ahmadreza221/aurora-cchp/docs/08_aurora1000_1MW_concept.md

# AURORA-1000: طرح مفهومی توربین گازی ۱ مگاواتی با گیربکس، متصل به شبکه

تاریخ: ۲۰۲۶-۱۰-۲۸ · محاسبه: `sim/mw1_concept_study.py` (نتایج: `sim/mw1_results.json`) · طرح: `sim/mw1_layout_sketch.py`
سایت: برازجان، ۵۰ m، گاز شهری (ایستگاه ۴ bar، حداقل ۳٫۵ bar، ظرفیت ۱۰۰۰ m³/h)، کار دائم ۲۴/۷

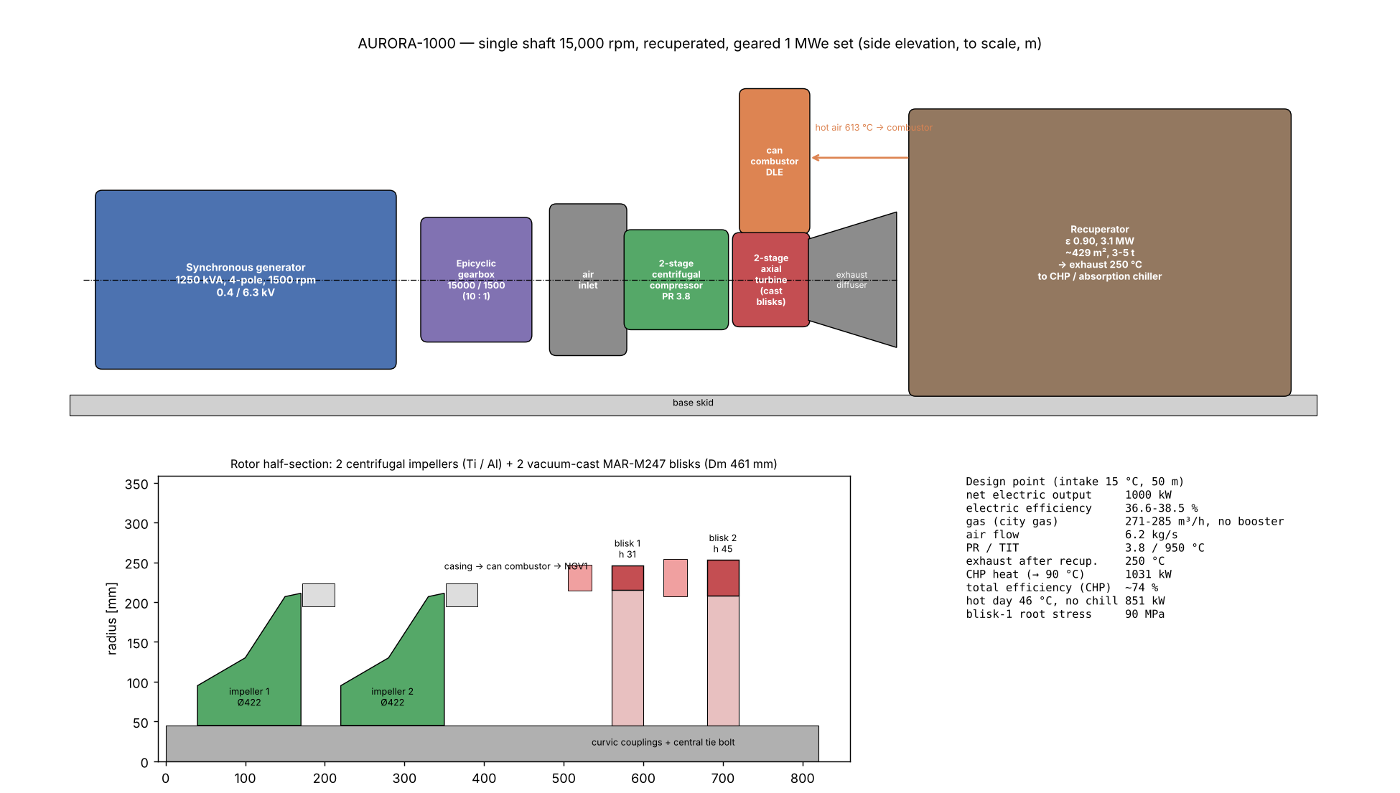
[picture p1: docs/img/mw1_layout.png]
چیدمان


## ۱. خلاصه و پیشنهاد

| | مقدار |
|---|---|
| معماری | **تک‌محور، با recuperator**، دور ثابت **۱۵٬۰۰۰ rpm**، گیربکس سیاره‌ای ۱۰:۱ به ژنراتور سنکرون ۱۵۰۰ rpm |
| کمپرسور | **دو پلهٔ گریز از مرکز** روی یک محور، Ø422 mm، نسبت فشار کل **۳٫۸** |
| توربین | **دو پلهٔ محوری**، هر پره و دیسک **یک‌تکه ریخته‌گری دقیق در خلأ** (blisk، MAR-M247)، Dm 463 mm؛ NGV1 ۴۸ / R1 ۵۹ / NGV2 ۲۴ / R2 ۳۶ پره (بخش ۱۲) |
| محفظهٔ احتراق | یک **محفظهٔ استوانه‌ای بیرونی (can)** با احتراق پیش‌مخلوط کم‌NOx (DLE)؛ ۷ پیش‌مخلوط‌کن، اسکرول دوشاخه با ۲۲ پرهٔ حذف چرخش، NOx ~۱۱ ppm (بخش ۱۶) |
| TIT | **۹۵۰ °C**، بدون خنک‌کاری پره‌ها |
| توان خالص برق | **۱۰۰۰ kW** (هوای ورودی خنک‌شده تا ۱۵ °C) |
| راندمان برق خالص | **۳۶٫۶ %** با بازده محتاطانهٔ اجزا؛ **۳۸٫۵ %** با بازده‌هایی که ابعادگذاری نشان می‌دهد |
| مصرف گاز | **۲۷۱–۲۸۵ m³/h** (حدود ۶٫۵–۶٫۹ هزار m³ در روز)؛ **بدون بوستر گاز** |
| گرمای قابل استفاده (CHP، اگزوز ۲۵۰ °C ← ۹۰ °C) | **~۹۴۰–۱۰۳۰ kW** ← راندمان کل **~۷۴ %** (چیلر جذبی یا آب گرم) |
| روز داغ ۴۶ °C بدون خنک‌کن ورودی | ~۸۵۰–۸۶۰ kW، ۳۳–۳۵ % |
| عمر پرهٔ پلهٔ اول (خزش، منحنی حداقل MAR-M247، ۱۰۰ MPa در ۸۶۵ °C) | **~۲٫۶×۱۰⁵ ساعت** (بیش از ۳۰ سال کار دائم؛ بخش ۱۲٫۳) |
| قطعات ریختگی خلأ | ۲ blisk توربین (۴۴ و ۵۳ kg) + ۲ حلقهٔ کامل NGV (۴۸ و ۲۴ پره) + لاینر محفظه (اختیاری) |
| ابعاد پکیج | ~۹ × ۲٫۵ × ۲٫۸ m (با recuperator)، حدود ۱۲–۱۶ تن |

**چرا این طرح؟**
- فشار گاز شهری شما (۳٫۵ bar) دقیقاً با سیکل recuperated با نسبت فشار ~۴ جور است. بیشترین فشار محفظه بدون بوستر **۳٫۶۷ bar** است و این طرح در **۳٫۵۵ bar** کار می‌کند. نسبت فشار بهینهٔ این سیکل ۴٫۴ است و ماندن روی ۳٫۸ فقط **۰٫۱۵ ٪** راندمان کم می‌کند (نمودار بخش ۲). پس کمپرسور گاز لازم نیست، که هم مصرف داخلی و هم قطعهٔ پرتعمیر را حذف می‌کند.
- دور ۱۵٬۰۰۰ rpm از توربین‌های هم‌کلاس پایین‌تر است: Kawasaki M1A-17 با ۲۲٬۰۰۰ و OPRA OP16 با ۲۶٬۰۰۰ rpm کار می‌کنند. همین دور پایین است که تنش ریشهٔ پرهٔ پلهٔ اول را به ۱۰۰ MPa نگه می‌دارد و بدون خنک‌کاری عمر بالا می‌دهد (برآورد مفهومی: در ۱۸٬۰۰۰ rpm عمر به ~۳×۱۰⁴ ساعت و در ۲۱٬۰۰۰ به ~۴×۱۰³ ساعت می‌افتد).
- بدون خنک‌کاری پره‌ها، ساخت ارزان است و قالب‌های ریخته‌گری ساده‌اند (بدون مغزهٔ سرامیکی کانال خنک‌کاری).

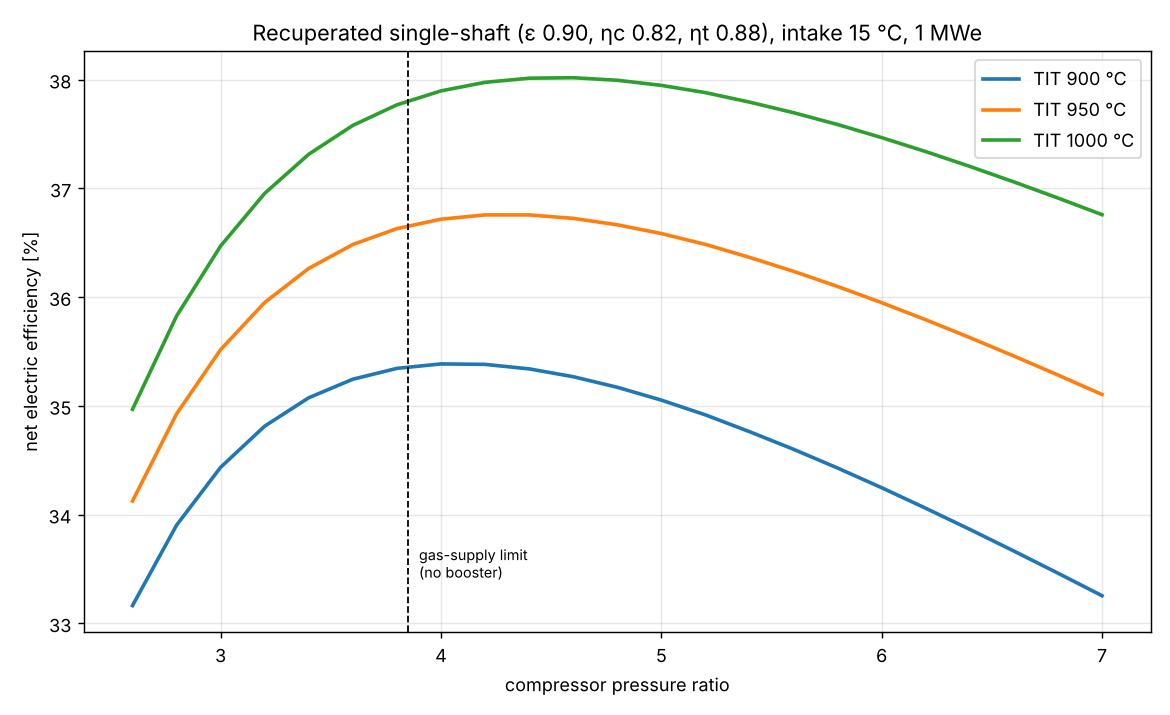
[picture p2: docs/img/mw1_eta_vs_pr.png]
راندمان در برابر نسبت فشار


## ۱٫۱ تصمیم‌های شما (۲۰۲۶-۱۰-۲۸) و اثرشان

| تصمیم | اثر |
|---|---|
| **۱ MW خالص** (کل مجموعه) | توربین گازی ~۹۲۴ kW + توربین بخار ~۷۶ kW؛ دبی هوا ۵٫۸ kg/s؛ ابعاد توربین ~۳ ٪ کوچک‌تر از جدول‌های بخش ۳ |
| **گرمای اضافه ← توربین بخار** | بهترین ترکیب: **recuperator کامل + بویلر بازیافت کم‌فشار (۵ bar) + توربین بخار کوچک** ← **۴۱٫۴ % برق خالص، ۲۵۲ m³/h گاز** (بخش ۸) |
| **شبکهٔ ۲۰ kV** | دو ژنراتور ۴۰۰ V روی یک تابلو LV، **یک ترانس ۱۶۰۰ kVA، 0.4/20 kV** و تابلو ۲۰ kV با حفاظت اتصال به شبکه (بخش ۳٫۴) |
| **recuperator خریداری می‌شود** | ε 0.90 (هرچه بیشتر بهتر: با ε 0.92 به ۴۲٫۱ ٪ می‌رسد) |

## ۲. مقایسهٔ معماری‌ها (۱۰۰۰ kW خالص، ورودی ۱۵ °C)

| معماری | دبی هوا kg/s | η برق | گاز m³/h | فشار محفظه bar | بوستر | دمای اگزوز | توضیح |
|---|---|---|---|---|---|---|---|
| سیکل ساده PR 10.5، TIT 1050 °C (مثل Kawasaki M1A-17 / OPRA OP16) | 4.4 | **26.2 %** | 398 | 10.1 | **20 kW لازم** | 560 °C | راندمان پایین، گاز ۴۰ ٪ بیشتر |
| **recuperated PR 3.8، TIT 950 °C (پیشنهادی)** | 6.6 | **36.6 %** | **285** | 3.55 | **ندارد** | 250 °C | ساده، ارزان، عمر بالا |
| recuperated PR 4.5 + بوستر | 6.2 | 36.7 % | 285 | 4.20 | 2 kW | 267 °C | +۰٫۱ ٪ ولی یک دستگاه اضافه |
| recuperated PR 3.8، TIT 1000 °C | 6.1 | 37.8 % | 276 | 3.55 | ندارد | 257 °C | +۱٫۲ ٪، ولی پوشش حرارتی و عمر کمتر |
| intercooled + recuperated، PR 7، دو محور (مثل Aurelia A400) | 4.5 | **40.0 %** | 261 | 6.5 | **7 kW** | 230 °C | بهترین راندمان، ولی ۲ محور، intercooler و بوستر |

**پیشنهاد:** نسل اول **recuperated تک‌محور PR 3.8** باشد. اگر بعداً راندمان بیشتر خواستید، همین کمپرسور دوپله جای intercooler بین دو پله را دارد. مسیر ارتقا به نسخهٔ intercooled (~۴۰ ٪) باز می‌ماند.

**مقایسهٔ صادقانه با موتور گازسوز (پیستونی):** موتورهای گازی ۱ MW (مثل Jenbacher و MWM) به **۴۰–۴۴ %** برق می‌رسند. برتری توربین در این‌هاست:
- تعمیرات خیلی کمتر: بدون تعویض روغن هر ۲–۴ هزار ساعت، بدون شمع و سرسیلندر؛ بازرسی بخش داغ هر ~۲۵–۳۰ هزار ساعت.
- لرزش کم، وزن و حجم کمتر.
- گرمای اگزوز تمیز و داغ برای چیلر جذبی.
- NOx پایین.
- کار دائم بی‌دردسر.

با CHP، راندمان کل هر دو در حدود ۷۵–۸۵ ٪ است.

## ۳. ساختار ماشین

### ۳٫۱ روتور (تک‌محور، دور ثابت ۱۵٬۰۰۰ rpm)

| بخش | مشخصه |
|---|---|
| کمپرسور پلهٔ ۱ | پروانهٔ گریز از مرکز Ø422 mm، U2 ≈ 332 m/s، Ns ≈ 0.70، فرز ۵ محوره از **Al 2618-T61** (طرح جزئی rev 1: Ø426 mm، U2 334 m/s، بخش ۱۳) |
| کمپرسور پلهٔ ۲ | همان قطر، دمای خروج ~۱۷۳ °C ← **Ti-6Al-4V** (آلومینیوم در کار دائم بالای ~۱۵۰ °C خزش دارد)؛ طرح جزئی rev 1: Ø476 mm، U2 374 m/s، بخش ۱۳ |
| دیفیوزر و کراس‌اوور | دیفیوزر پره‌دار، کانال برگشت بین دو پله (جای intercooler آینده) |
| بازده کمپرسور (برآورد) | η ≈ ۰٫۸۵ برای دو پله (۰٫۸۲۵ برای یک پلهٔ PR 3.8 با Ø607 mm و U2 477 m/s) |
| توربین | **۲ پلهٔ محوری**: ψ = 1.25، φ = 0.50، درجهٔ واکنش 0.45، Um = 364 m/s، Dm = 463 mm |
| ارتفاع پره | R1: ۳۵ mm (hub/tip 0.86)، R2: ۵۷ mm (hub/tip 0.78)؛ لقی نوک سرد ۰٫۵ / ۰٫۶ mm، در کار ۰٫۴۵ / ۰٫۵۵ mm |
| بازده توربین (برآورد) | η ≈ ۰٫۹۰–۰٫۹۲ |
| اتصال‌ها | blisk‌ها و پروانه‌ها با **کوپلینگ Curvic** و یک **پیچ مرکزی (tie bolt)** به هم بسته می‌شوند (روش Kawasaki و Solar) |
| یاتاقان‌ها | دو یاتاقان ژورنال **tilting-pad** روغنی + یاتاقان کف‌گرد (thrust) سمت سرد؛ روغن مشترک با گیربکس |

**چرا دو blisk جدا و نه یک قطعهٔ ریختگی دوپله؟** بین دو پلهٔ چرخان یک ردیف پرهٔ ثابت (NGV2) هست. اگر دو پله یک‌تکه ریخته شوند، NGV2 جای سوار شدن ندارد، مگر اینکه دوتکه و پیچی شود. این کار نشتی و پیچیدگی می‌آورد. روش رایج و ارزان‌تر این است: **دو blisk جدا، هر دو در یک ریخته‌گری خلأ و از یک بوته (یک ذوب و یک کیفیت)**، که بعد با کوپلینگ Curvic جفت می‌شوند. هر blisk حدود Ø۵۲۰ mm است و در توان ریخته‌گری‌های دقیق خلأ (investment casting) است.

### ۳٫۲ قطعات ثابت
- **NGV1 و NGV2:** ریخته‌گری خلأ از **MAR-M247**، **حلقهٔ کامل** (NGV1 ۴۸ پره، NGV2 ۲۴ پره؛ در صورت نیاز هر دو در ۸ سگمنت). NGV1 داغ‌ترین قطعه است؛ با پوشش آلومینایدی + TBC و بدون خنک‌کاری کار می‌کند (بخش ۱۲٫۹).
- **محفظهٔ احتراق:**
  - یک can بیرونی و عمودی (مثل Kawasaki M1A که یک can دارد)، احتراق پیش‌مخلوط کم‌NOx (DLE).
  - هوای ورودی ~۶۱۳ °C از recuperator می‌آید. هدف NOx زیر **۲۵ ppm** (۱۵ ٪ O2) است.
  - لاینر از Hastelloy X یا Haynes 230 با TBC.
  - خوبی can بیرونی: تعمیر و تعویض بدون باز کردن موتور.
- **بدنه:** چدن نشکن (کمپرسور) و فولاد مقاوم به حرارت (توربین، مثلاً 1.4828)؛ پوستهٔ توربین با عایق بیرونی.
- **recuperator:**
  - ۳٫۱ MW، ε = 0.90، NTU ≈ 7.3، سطح ~۴۳۰ m².
  - نوع **primary surface** یا plate-fin از فولاد ضدزنگ 347، وزن ۳–۵ تن.
  - **گران‌ترین قطعهٔ پکیج** است و باید از یک سازندهٔ مجرب خریده شود.

### ۳٫۳ گیربکس (مشخصات برای سفارش ساخت)

| مشخصه | مقدار |
|---|---|
| نوع | **سیاره‌ای ستاره‌ای (star epicyclic) یک‌پله**؛ یا دوپلهٔ موازی هلیکال دوبل (ارزان‌تر، بزرگ‌تر) |
| دور ورودی / خروجی | **15,000 / 1,500 rpm**، نسبت **10.0 : 1** |
| توان | **1,100 kW** پیوسته (۱٫۱۵ × توان شفت)، ضریب سرویس AGMA ≥ ۱٫۴ برای ژنراتور ۲۴/۷ |
| استاندارد | **API 613** (موازی) یا **API 677 / AGMA 6123** (سیاره‌ای) |
| راندمان | ≥ ۹۸٫۵ % (تلفات ~۱۶ kW به روغن) |
| یاتاقان‌ها | ژورنال هیدرودینامیک؛ روغن ISO VG 32 مشترک با توربین |
| کوپلینگ‌ها | ورودی: دیافراگمی یا دیسکی پرسرعت؛ خروجی: دیسکی |
| سازندگان نمونه | Flender، Renk، Allen Gears، Lufkin، ZF (گیربکس OPRA را ZF می‌سازد) |

### ۳٫۴ ژنراتور و اتصال به شبکه
- **ژنراتور سنکرون ۴ قطبی، ۱۲۵۰ kVA (cosφ 0.8)، ۱۵۰۰ rpm، ۵۰ Hz**، بدون جاروبک با AVR.
  - ولتاژ **۴۰۰ V**. توربین بخار هم یک ژنراتور ~۱۲۵ kVA و ۴۰۰ V دارد. هر دو روی یک تابلو LV (۲۵۰۰ A) جمع می‌شوند.
  - **ترانس افزاینده ۱۶۰۰ kVA، 0.4/20 kV، Dyn11، روغنی ONAN**.
  - **تابلو ۲۰ kV (RMU)** با دژنکتور، رلهٔ حفاظت اتصال به شبکه و کنتور دوطرفه.
  - ولتاژ ۶٫۳ kV برای ژنراتور لازم نیست. در این توان، ۴۰۰ V با ترانس ارزان‌تر و رایج‌تر است.
  - راندمان ~۹۷ ٪، خنک‌کاری هوا (IP23، یا IP54 برای گردوغبار برازجان).
- **سنکرون‌سازی و حفاظت:**
  - رلهٔ سنکرون (25)، حفاظت ولتاژ و فرکانس (27/59/81)، جریان معکوس توان (32)، اضافه‌جریان (50/51)، اتصال زمین (51N)، ROCOF و vector shift برای جزیره‌شدن.
  - مطابق الزامات اتصال شرکت توزیع (توانیر) و IEEE 1547.
- **بدون الکترونیک قدرت بزرگ:** ژنراتور مستقیم به شبکه وصل است. ساده و ارزان است و کیفیت برق عالی دارد. راه‌اندازی با **موتور استارتر AC + VFD کوچک** (~۶۰–۸۰ kW) روی گیربکس است، یا ژنراتور در حالت موتور با soft-start.

## ۴. عمر و دوام

| قطعه | شرایط | برآورد |
|---|---|---|
| blisk پلهٔ ۱ | تنش مقطع خالص ریشه ۱۰۰ MPa، فلز ~۸۶۵ °C | گسیختگی خزشی روی منحنی حداقل: **~۲٫۶×۱۰⁵ h** (مجاز ۱۰⁵ h: ۱۲۴ MPa) |
| blisk پلهٔ ۲ | تنش مقطع خالص ریشه ۱۸۸ MPa، فلز ~۷۲۳ °C | ~۲٫۷×۱۰⁷ h |
| NGV1 | داغ‌ترین قطعه، بدون تنش گریز از مرکز | عمر با **اکسیداسیون** و خستگی حرارتی محدود است؛ پوشش آلومینایدی + TBC؛ بازرسی و تعویض در ~۳۰ هزار ساعت |
| لاینر محفظه | | بازرسی ۸ هزار ساعت، تعویض ۲۵–۳۰ هزار ساعت |
| پروانه‌های کمپرسور | Ti / Al، U2 332 m/s | بیش از ۱۰۰ هزار ساعت (عمر ترک خستگی با تعداد روشن‌وخاموش) |
| گیربکس و یاتاقان‌ها | | بازرسی ۲۵ هزار ساعت، عمر طراحی ۱۰۰ هزار ساعت |
| **برنامهٔ تعمیرات** | | **بازرسی بخش داغ ~۲۵–۳۰ هزار ساعت، اورهال اساسی ~۶۰ هزار ساعت** (حدود ۷ سال کار دائم) |

- عددهای خزش از منحنی master Larson–Miller و منحنی حداقل MAR-M247 (بخش ۱۲٫۳) و FEA سه‌بعدی پره‌اند. برای سفارش ریخته‌گری باید با دادهٔ تأییدشدهٔ ریخته‌گر جایگزین شوند.
- ارتعاش پره‌ها و دیسک‌ها (مدل کامل cyclic)، دیسک‌ها و دینامیک روتور در **بخش ۱۲** (rev 5) بررسی شده‌اند.

## ۵. هزینه و زمان (برآورد اولیه، با عدم‌قطعیت ±۳۰–۵۰ ٪)

| بخش | نمونهٔ اول (دلار) | تولید سری (دلار) |
|---|---|---|
| هستهٔ موتور (روتور، ریخته‌گری‌ها، بدنه، محفظه، یاتاقان‌ها) | 300–450k | 150–220k |
| recuperator | 200–350k | 120–200k |
| گیربکس | 80–150k | 50–90k |
| ژنراتور، تابلو، سنکرون و حفاظت، ترانس | 120–200k | 90–140k |
| روغن، سوخت (DLE)، فیلتر و خنک‌کن ورودی، کنترل، پکیج و اگزوز | 150–250k | 100–150k |
| **جمع** | **~0.85–1.4 M$** | **~0.5–0.8 M$ (۵۰۰–۸۰۰ $/kW)** |

- **زمان:** طراحی جزئی و شبیه‌سازی ۶–۹ ماه؛ ساخت قطعات (ریخته‌گری خلأ ~۴–۶ ماه برای قالب و نمونه) و مونتاژ ۶–۹ ماه؛ تست ۳–۶ ماه. **جمعاً ~۱٫۵–۲ سال تا نمونهٔ کارکرده.**
- **ریسک‌های اصلی:**
  1. احتراق پیش‌مخلوط با هوای ۶۱۳ °C: ریسک flashback، نیاز به تست روی rig.
  2. رسیدن به بازده ۰٫۸۵ کمپرسور و ۰٫۹۰ توربین در نمونهٔ اول. واقع‌بینانه است که نمونهٔ اول **۳۳–۳۵ ٪** بدهد و بعد از بهینه‌سازی به ۳۶–۳۸ ٪ برسد.
  3. recuperator: عمر و نشتی در کار حرارتی دائم.
  4. تأیید اتصال به شبکه.

## ۶. استفاده از کارهای قبلی پروژه
- روش طراحی پره‌ها (مقاطع، فیلت، صاف‌سازی B-spline)، تحلیل FEA دیسک، خزش، ارتعاش (Campbell، تقارن چرخشی) و تحویل به فیوژن، همه از کار E1 آماده و آزموده‌اند.
- همین زنجیره برای blisk‌های AURORA-1000 اجرا می‌شود.
- طراحی CCHP (چیلر جذبی، برج خنک‌کن، خنک‌کن هوای ورودی) و برق و کنترل هم قابل استفادهٔ مستقیم است.

## ۷. قدم‌های بعدی پیشنهادی
1. **تأیید فرضیه‌ها با شما:**
   - توان دقیق (۱ MW خالص یا ناخالص؟)
   - CHP لازم است یا فقط برق؟
   - ولتاژ اتصال (۲۰ kV؟)
   - آیا سفارش recuperator از خارج ممکن است؟
2. طراحی meanline دقیق کمپرسور دوپله و توربین دوپله، با همان کیفیت E1.
3. طرح اولیهٔ محفظهٔ احتراق DLE و محاسبهٔ NOx.
4. دینامیک روتور (یاتاقان‌ها، سرعت بحرانی) و انتخاب نهایی ۱۵٬۰۰۰ rpm.
5. مدل سه‌بعدی، FEA blisk‌ها و ارتعاش، و تحویل به فیوژن.
6. درخواست قیمت از سازندگان گیربکس، recuperator و ژنراتور.

## ۸. توربین بخار برای گرمای اضافه (`sim/mw1_steam_bottoming.py`، بخار با IAPWS-97)

فرض‌ها:
- بویلر بازیافت (HRSG) یک‌فشاره با pinch 15 K و دودکش ≥ ۱۰۰ °C.
- توربین بخار کندانسی با η ایزنتروپیک 0.70 و چرخ‌دنده تا ۱۵۰۰ rpm.
- کندانسور ۵۰ °C با برج خنک‌کن (دمای مرطوب تابستان برازجان ~۲۸–۲۹ °C).
- مصرف پمپ‌ها و فن برج در حساب است.

همه برای **۱۰۰۰ kW خالص کل**:

| حالت | توربین گاز | توربین بخار | η برق | گاز m³/h | بخار | توضیح |
|---|---|---|---|---|---|---|
| A: فقط توربین گاز با recuperator | 1000 | — | 38.5 % | 271 | — | |
| **B: A + توربین بخار کوچک (پیشنهادی)** | **924** | **76** | **41.4 %** | **252** | **5 bar، 222 °C** | بویلر کم‌فشار، ساده |
| C: A + ORC به جای بخار (مقایسه) | 892 | 108 | 42.8 % | 244 | — | +۴۰ ٪ توان بیشتر از همان گرما، بدون آب و بویلر |
| D: recuperator نیمه (ε 0.6) + بخار | 778 | 222 | 35.2 % | 297 | 15 bar | بدتر |
| E: بدون recuperator، PR 3.8 + بخار | 564 | 436 | 34.3 % | 304 | 50 bar، 450 °C | سیکل ترکیبی کلاسیک: **بدتر** |
| F: بدون recuperator، PR 8 / 1000 °C + بوستر + بخار | 688 | 312 | 38.0 % | 274 | 50 bar | بویلر پرفشار + بوستر |
| G: بدون recuperator، PR 12 / 1100 °C (پرهٔ خنک‌شونده) + بخار | 701 | 299 | 38.8 % | 269 | 50 bar | پیچیده و گران |

**نتیجه‌ها:**
1. **سیکل ترکیبی کلاسیک (E، F، G) در این مقیاس بازنده است.** توربین بخار ۳۰۰–۴۰۰ کیلوواتی راندمان پایینی دارد، و بویلر ۵۰ bar و آب‌شیرین‌کن و اپراتور بویلر می‌خواهد. توربین گاز با recuperator به‌تنهایی (A) بهتر یا هم‌تراز است.
2. **بهترین راه: recuperator کامل و یک توربین بخار کوچک کم‌فشار** روی اگزوز ۲۵۰ °C (B). +۷۶ kW برق و **۷ ٪ گاز کمتر** (۲۵۲ به جای ۲۷۱ m³/h).
3. هرچه ε بیشتر، بهتر:

   | ε | 0.80 | 0.85 | 0.88 | 0.90 | 0.92 |
   |---|---|---|---|---|---|
   | η کل | 38.4 % | 39.7 % | 40.7 % | 41.4 % | 42.1 % |

   فشار بهینهٔ بخار در همهٔ این حالت‌ها ~۵ bar است.
4. **ORC از همان گرما ۴۰ ٪ برق بیشتر می‌دهد** (۱۰۸ در برابر ۷۶ kW) و آب، بویلر و تصفیه نمی‌خواهد. اگر قید «بخار» ندارید، ORC بهتر است. اگر بخار را ترجیح می‌دهید (مثلاً بعداً بخار فرایندی هم لازم دارید)، حالت B کاملاً عملی است.

**تجهیزات بخش بخار (حالت B):**

| تجهیز | مشخصه |
|---|---|
| بویلر بازیافت (HRSG) | لوله‌آتشی یا لوله‌آبی بسته‌ای، ~۶۰۰ kW حرارتی، ۵ bar، سوپرهیت ۲۲۰ °C، دودکش ~۱۲۰ °C |
| توربین بخار | ~۸۰–۹۰ kW ناخالص، کندانسی، تک‌پله یا اکسپندر پیچی بخار (screw expander)، با گیربکس به ۱۵۰۰ rpm. نمونه‌ها: Siemens SST-040 (از ~۷۵ kW)، اکسپندرهای پیچی Heliex و Kaishan |
| ژنراتور | ~۱۲۵ kVA، ۴۰۰ V، سنکرون یا آسنکرون، روی همان تابلو |
| کندانسور | آبی با برج خنک‌کن (مشترک با چیلر یا جدا) یا هواخنک (در برازجان کندانس ~۶۰ °C، توان ~۱۵ ٪ کمتر) |
| دی‌اریتور، پمپ تغذیه، تصفیهٔ آب (سختی‌گیر + RO) | استاندارد بویلرهای کم‌فشار |
| هزینهٔ تقریبی | **~۲۰۰–۳۰۰ هزار دلار** برای +۷۶ kW. صرفه‌اش به قیمت گاز و قیمت فروش برق بستگی دارد. ماژول ORC هم‌قیمت است، با توان بیشتر |

## ۹. تصمیم نهایی: فقط توربین گاز با recuperator + استفادهٔ مستقیم از گرما (CHP و CCHP)

تصمیم کاربر (۲۰۲۶-۱۰-۲۸): توربین بخار و ORC نمی‌صرفد. توربین گاز با recuperator می‌ماند و گرمای اگزوز مستقیم مصرف می‌شود.

- **راندمان برق** در این اندازه سقفی حدود ۳۸–۴۲ ٪ دارد. راندمان برق بالای ۵۵ ٪ فقط در نیروگاه‌های سیکل ترکیبی صدها مگاواتی دیده می‌شود.
- **هدف ۵۵ ٪+** با **راندمان کل** (برق + گرمای مفید، بر پایهٔ LHV سوخت) به دست می‌آید:

| گرمای اگزوز ۲۴۶ °C سرد تا | گرمای مفید | راندمان کل (برق ۳۸٫۵ ٪) |
|---|---|---|
| ۱۲۰ °C | 786 kW | 68.8 % |
| **۹۰ °C** (آب داغ ۹۵/۷۵ °C) | **970 kW** | **75.9 %** |
| ۷۰ °C | 1093 kW | 80.6 % |
| ۵۰ °C (مرحلهٔ دوم کم‌دما) | 1215 kW | 85.4 % |

- سوخت ۲۵۹۵ kW (LHV)، ۲۷۱ m³/h.
- میعان بخار آب اگزوز ممکن نیست، چون نقطهٔ شبنم ~۳۱ °C است و در برازجان آب سردتر از آن در دسترس نیست.
- با بازده محتاطانهٔ اجزا (برق ۳۶٫۶ ٪)، راندمان کل حدود ۱ ٪ کمتر است.

**طرح پیشنهادی استفاده از گرما:**
1. **مبدل اگزوز به آب داغ** (اکونومایزر لوله‌پره‌دار، آب تحت فشار ۹۵/۷۵ °C، ~۹۷۰ kW).
2. **تابستان: چیلر جذبی تک‌اثره LiBr، ~۶۵۰–۶۸۰ kW سرما (COP 0.7):**
   - **~۳۳۵ kW برای خنک کردن هوای ورودی توربین** از ۴۶ °C به ۱۵ °C. بدون این کار، توربین در روز داغ ۸۶۰ kW با ۳۵٫۲ ٪ می‌دهد؛ با آن، **۱۰۰۰ kW با ۳۸٫۵ ٪**. یعنی **+۱۴۰ kW برق** در گرم‌ترین ساعت‌ها، بیشتر از کل توربین بخار.
   - **~۳۲۰ kW سرمای اضافه** برای ساختمان، سردخانه یا فروش.
3. **زمستان:** آب داغ برای گرمایش یا شبکهٔ گرمایش (~۹۷۰ kW).
4. **همهٔ سال:** آب گرم مصرفی از مرحلهٔ دوم کم‌دما (تا ۵۰ °C، +~۲۵۰ kW).
5. **گزینهٔ ویژهٔ استان بوشهر:** آب‌شیرین‌کن حرارتی چنداثره (MED) با آب ۷۰ °C، ~۲۵۰–۳۰۰ m³ آب شیرین در روز.

**هزینهٔ تقریبی:**

| تجهیز | دلار |
|---|---|
| مبدل اگزوز | 40–70k |
| چیلر جذبی ۶۵۰ kW | 150–250k |
| برج خنک‌کن چیلر (~۱٫۶ MW دفع حرارت) | 40–60k |
| کویل و سیستم خنک‌کن ورودی | 20–30k |
| **جمع** | **~۲۵۰–۴۰۰k** |

با این هزینه، برق تابستان حفظ می‌شود و ~۳۲۰ kW سرمای اضافه می‌ماند، پس از بخش بخار بسیار باصرفه‌تر است.

## ۱۰. طرح انتخاب‌شده: AURORA-1000 CCHP با راندمان کل ~۷۵–۷۶ ٪ (`sim/mw1_meanline.py`)

تصمیم کاربر (۲۰۲۶-۱۰-۲۸): مدل ۷۶ ٪ اجرا می‌شود. سرمای چیلر جذبی برای خنک کردن هوای ورودی توربین و یک سردخانهٔ جدید مصرف می‌شود.

**ترازنامه** (توربین گاز ۱۰۲۰ kW خالص؛ ۲۰ kW آن برای پمپ‌ها و فن‌های CCHP، پس **۱۰۰۰ kW خالص به شبکه**):

| | مقدار |
|---|---|
| هوا / گاز | 6.32 kg/s / **276 m³/h** |
| راندمان برق | 38.5 % (هدف؛ محتاطانه ۳۶–۳۷ ٪) |
| آب داغ از اگزوز | **990 kW**، 11.8 kg/s، 95/75 °C |
| چیلر جذبی LiBr تک‌اثره | **~۶۹۰ kW سرما** (COP 0.70)، آب سرد 7/12 °C |
| خنک کردن هوای ورودی (۴۶ °C، ۳۰ ٪ ← ۱۵ °C) | پیک **338 kW** + **~۱۹۰ لیتر در ساعت آب میعان** (قابل استفاده) |
| سرمای سردخانه | **~۳۵۵ kW تابستان / ~۶۹۰ kW زمستان** |
| برج خنک‌کن | ~1.7 MW دفع حرارت |
| **راندمان کل** | **~۷۵ ٪** (برق ۱۰۰۰ + گرمای مفید ۹۹۰ kW بر سوخت ~۲۶۵۰ kW) |

**نکتهٔ سردخانه:** چیلر LiBr آب سرد را حداقل تا ~۵–۷ °C می‌رساند.

| نوع سردخانه | راه‌حل |
|---|---|
| **بالای صفر، +۸ تا +۱۳ °C** (موز، گوجه، مرکبات و سبزی‌های حساس به سرما) | مستقیم با همین آب سرد |
| **۰ تا +۴ °C** (میوه و خرما) یا **زیر صفر** (انجماد) | **۱)** چیلر جذبی **آمونیاک-آب** که با آب داغ ~۱۳۰–۱۵۰ °C از همان اگزوز کار می‌کند (تا −۳۰ °C، COP ~۰٫۵)؛ یا **۲)** کمپرسور برقی که کندانسورش با آب سرد LiBr خنک می‌شود (مصرف برقش ~۴۰–۵۰ ٪ کمتر) |

**طراحی اولیهٔ meanline در ۱۵٬۰۰۰ rpm:**

| بخش | مشخصه |
|---|---|
| کمپرسور پلهٔ ۱ (Al 2618) | PR 2.01، η 0.86، ورودی Ø256 mm (هاب Ø97)، Mrel نوک 0.71، خروجی Ø413 mm، U2 324 m/s، b2 35 mm، ۱۳ پره + ۱۳ اسپلیتر، backsweep 40° (طرح جزئی rev 1: **Ø426 mm، b2 33.5 mm**، ورودی Ø274 / هاب Ø120، بخش ۱۳) |
| کمپرسور پلهٔ ۲ (Ti-6Al-4V) | PR 1.92، η 0.85، ورودی Ø220 mm، Ø448 mm، U2 352 m/s، b2 19 mm، خروجی ۱۷۵ °C (طرح جزئی rev 1: **Ø476 mm، b2 16.5 mm**، ورودی Ø261 / هاب Ø160، بخش ۱۳) |
| توربین (۲ پله، ریختگی خلأ MAR-M247) | Dm 463 mm، Um 364 m/s، ψ 1.25، φ 0.50، درجهٔ واکنش 0.45، زاویهٔ خروج NGV 67° |
| پلهٔ ۱ | ۹۵۰ ← ۸۱۳ °C، ۳٫۵۵ ← ۲٫۰۴ bar، ارتفاع پره ۲۵/۳۱/۳۸ mm، **۴۷ NGV / ۵۹ پرهٔ روتور** (نهایی rev 5: **۴۸ NGV** با وتر محوری ۲۲ mm / ۵۹، بخش ۱۲)، گلوگاه ۱۷۷ cm² (طرح نهایی ۱۷۴)، دمای نسبی روتور ۸۷۷ °C |
| پلهٔ ۲ | ۸۱۳ ← ۶۷۲ °C، ۲٫۰۴ ← ۱٫۰۹ bar، ۳۸/۴۹/۶۳ mm، **۳۳ NGV / ۳۶ پره**، وتر ۳۷/۴۲ mm (نهایی rev 5: **۲۴ NGV** با وتر محوری ۴۹ mm / ۳۶ پره، بخش ۱۲) |

## ۱۱. سردخانهٔ مرکبات (تصمیم کاربر ۲۰۲۶-۱۰-۲۹)

**دمای نگهداری** (رطوبت نسبی ۸۵–۹۵ ٪): مرکبات به سرمازدگی حساس‌اند.

| محصول | دما |
|---|---|
| لیموترش و لیموی سبز | ۹–۱۳ °C |
| گریپ‌فروت | ۱۰–۱۵ °C |
| پرتقال | ۳–۹ °C (رقم‌های گرمسیری بیشتر ۵–۸ °C) |
| نارنگی | ۴–۷ °C |

**نتیجه:** چیلر جذبی LiBr کافی است و چیلر آمونیاکی لازم نیست.
- چیلر برای آب سرد **۵/۱۰ °C** سفارش داده شود (LiBr دمای پایین، COP ~۰٫۶۸).
- با کویل‌های هوای بزرگ و اختلاف دمای کم (برای حفظ رطوبت و جلوگیری از چروکیدگی میوه)، اتاق‌ها روی **+۷ تا +۱۲ °C** نگه داشته می‌شوند.
- برای اتاق‌های نارنگی و پرتقال ۴–۵ °C، یک چیلر برقی کوچک کمکی (~۵۰ kW) که کندانسورش با آب برج خنک می‌شود، فقط برای همان اتاق‌ها کافی است.

**هم‌زمانی خوب:** فصل برداشت مرکبات در جنوب (آبان تا اسفند) همان فصلی است که توربین به خنک‌کن ورودی نیاز ندارد. پس در اوج بار سردخانه **همهٔ ~۶۹۰ kW** سرما به سردخانه می‌رسد. در تابستان که هوا داغ است، سردخانه بار کمتری دارد و ~۳۵۵ kW کافی است.

**ظرفیت تقریبی:**
- بار نگهداری یک سردخانهٔ ۳۰۰۰ تنی در برازجان:
  - دیوار و سقف: ~۳۰ kW
  - تنفس میوه: ~۲۵ W/t، یعنی ~۷۵ kW
  - فن، در، روشنایی و افراد: ~۴۰ kW
  - **جمع ~۱۴۵ kW**
- پیش‌سرمایش میوهٔ ورودی (۳۰ ← ۸ °C، ~۸۴ kJ/kg) با ~۱۰۰ تن در روز در ۱۲ ساعت: **~۲۰۰ kW**.
- ← **سردخانهٔ ~۳۰۰۰–۴۰۰۰ تنی** با ورود روزانه تا ~۱۰۰ تن در فصل برداشت. در تابستان سردخانهٔ پر بدون ورود میوه هم با ۳۵۵ kW اداره می‌شود.

**منابع داده‌های مقایسه:** Kawasaki Technical Review No. 173 و بروشور M1A-17؛ برگهٔ مشخصات OPRA OP16؛ معرفی Aurelia A400 در Turbomachinery Magazine و پروژهٔ CORDIS FUTURBINE.

## ۱۲. طراحی دقیق توربین و تست‌های شبیه‌سازی (rev 5، ۲۰۲۶-۱۰-۳۰)

درخواست کاربر: «تمرکز روی خود توربین که کار دقیقی دربیاد و تست‌هایش زده شود؛ چیلر خریداری می‌شود.»

سیر بازنگری‌ها:
- **rev 3:** اولین طرح کامل با FEA پره، دیسک و روتور.
- **rev 4:** یک بازبینی مستقل ۳۶ یافتهٔ تأییدشده داشت. همه اصلاح شدند (بخش ۱۲٫۲): سینماتیک ردیف‌ها، گلوگاه‌ها، منحنی خزش، معیارهای LCF/Goodman/ترکیدن، نامیزانی API و غیره.
- **rev 5:** مدل کامل پره و دیسک (cyclic symmetry) برای همهٔ قطرهای گرهی حل شد. نشان داد تعداد پره‌های NGV که با مدل هاب صلب انتخاب شده بود (۴۳ / ۴۷) چهار تداخل دارد. تعداد پره‌ها به **NGV1 = ۴۸ و NGV2 = ۲۴** تغییر کرد (بخش ۱۲٫۴).
- **پاسخ اجباری R1 (۲۰۲۶-۱۰-۳۰):** CFD ناپایای سه ردیف + مودهای cyclic. EO96 بسته شد و NGV1 = ۴۸ می‌ماند. یک مورد تازه پیدا شد: EO24 روی مود flap اول R1 در راه‌اندازی (بخش ۱۲٫۴٫۱).
- **rev 6 (۲۰۲۶-۱۰-۳۰):** چهار راه‌حل EO24 با CFD در شرایط راه‌اندازی مقایسه شدند. **تصمیم: فاصلهٔ محوری R1 تا NGV2 به‌اندازهٔ ۲۵ mm بیشتر** (بخش ۱۲٫۴٫۲). عبورهای زیر باند حالا با نیروی راه‌اندازی و Goodman حالت عبور سنجیده می‌شوند. EO48 هم با این معیار قبول شد.
- **rev 6 در CAD (۲۰۲۶-۱۰-۳۰):** فاصلهٔ +۲۵ mm در توربین، روتور، بخش داغ و پکیج اعمال شد. CFD راه‌اندازی و نقطهٔ طراحی با هندسهٔ نهایی دوباره اجرا شدند (بخش ۱۲٫۴٫۳). روتور یک حلقهٔ فاصله‌انداز R1–R2 گرفت (بخش ۱۳٫۹) و پوستهٔ بخش داغ بلندتر شد (بخش ۱۴٫۱).

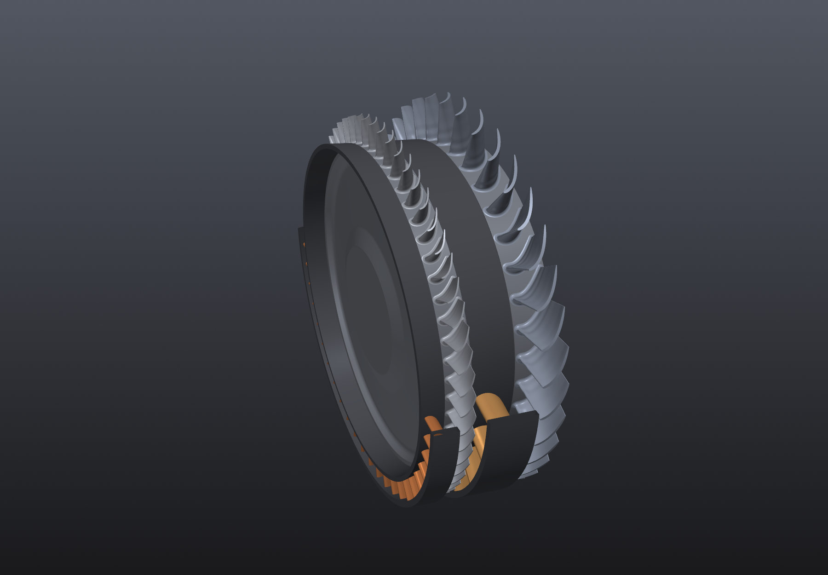
[picture p3: docs/img/a1000_turbine_render_iso.png]
توربین دوپله


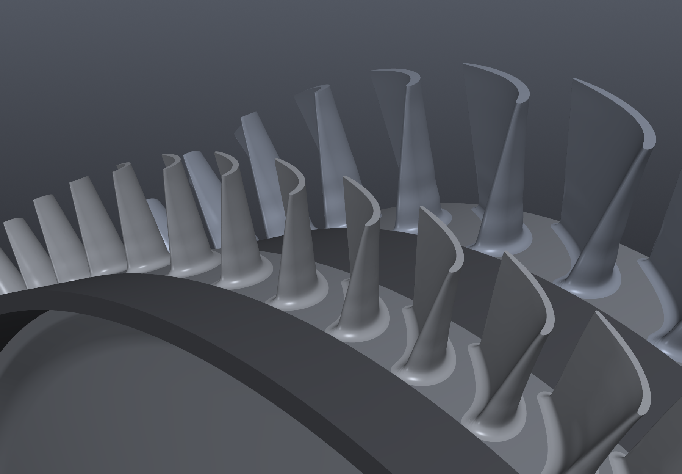
[picture p4: docs/img/a1000_turbine_render_blades.png]
پره‌های R1


### ۱۲٫۱ هندسهٔ نهایی ردیف‌ها (`cad/engine/a1000_turbine.py`، نتایج: `sim/a1000_turbine_design.json`)

| ردیف | تعداد | x LE–TE [mm] | شعاع هاب–نوک [mm] | وتر / ضخامت بیشینه | زاویهٔ جریان ورود / خروج | Zweifel | ماخ خروج |
|---|---|---|---|---|---|---|---|
| NGV1 (ثابت) | **48** | 0–22 | 218–246 | 33.8 / 6.8 mm | 0° / 68°→66° | 0.89–1.10 | 0.75–0.67 |
| R1 (blisk 1) | **59** | 30–56 | 214–249 | 31→30 / **7.5→1.8 mm** | 35°→2° / −64°→−66° | 0.94–1.09 | 0.59–0.67 |
| NGV2 (ثابت) | **24** | 65–114 | 210–254 | **72 / 14.4 mm** | −9° / 69°→65° | 0.80–1.11 | 0.83–0.69 |
| R2 (blisk 2) | **36** | 125–167 | 203–260 | 50→55 / **9.9→3.4 mm** | 43°→−9° / −63°→−67° | 0.96–1.02 | 0.60–0.75 |

- **سینماتیک:**
  - مرحلهٔ تکرارشونده در شعاع میانی: α1 = α3 = −8.5°، Cθ3 = −0.075 U، ψ = 1.25، درجهٔ واکنش 0.45، φ = 0.5.
  - گردابهٔ آزاد برای Cθ2 و Cθ3.
  - درجهٔ واکنش از هاب تا نوک: R1 از 0.36 تا 0.52، R2 از 0.28 تا 0.56.
- **گلوگاه‌ها:**
  - حل gauging با انحراف Ainley–Mathieson: با قانون کسینوس شروع می‌شود و بین ماخ 0.5 و 1 به آن نزدیک می‌شود.
  - ارتفاع خروجی NGV در لبهٔ فرار.
  - **NGV1:** ۱۷۴ cm² (meanline ۱۷۷)، ماخ گلوگاه **0.75**.
  - **NGV2:** ۲۷۸ cm² (۲۸۲)، ماخ **0.81**. هر دو با فاصلهٔ زیاد از خفگی.
- **لبهٔ فرار** همهٔ ردیف‌ها ۱٫۰ mm است، قابل ریخته‌گری.
- **جرم‌ها (MAR-M247، ۸٫۵۴ g/cc):**
  - پرهٔ R1 ۳۴٫۶ g و پرهٔ R2 ۱۳۹ g.
  - blisk 1: **۴۴٫۴ kg** و blisk 2: **۵۲٫۵ kg**.
  - NGV1: ۴۸ × ۴۱ g + حلقه‌ها ۵٫۳ kg = **۷٫۲ kg**.
  - NGV2: ۲۴ × ۲۹۰ g + حلقه‌ها ۱۰٫۱ kg = **۱۷٫۱ kg**.
- **طول مسیر گاز** از لبهٔ حملهٔ NGV1 تا لبهٔ فرار R2: **۱۶۷ mm**. نسبت به rev 4، ۱۹ mm بلندتر است: NGV1 ۴ mm کوتاه‌تر و NGV2 ۲۳ mm بلندتر.
- **اثر وترها روی بازده (ضریب نسبت ابعادی تلفات ثانویهٔ Kacker–Okapuu):**
  - NGV1 با ۴۸ پرهٔ کوتاه‌تر: h/c از 0.69 به 0.83، ضریب ×۰٫۸۵، حدود **+۰٫۳** واحد درصد بازده توربین.
  - NGV2 با ۲۴ پرهٔ بلند: h/c از 1.19 به 0.62، ضریب ×۱٫۷۵، حدود **−۰٫۸** واحد.
  - جمع: حدود **−۰٫۵ واحد درصد** بازده توربین، یعنی ~۰٫۳ واحد از راندمان برق. این مقدار به‌صورت گرمای بیشتر به CCHP می‌رسد.

### ۱۲٫۲ بازبینی مستقل rev 3 و اصلاح‌ها (فهرست کامل: `docs/a1000_review_rev3.json`)

| یافته‌ها | مشکل | اصلاح |
|---|---|---|
| 1 | ردیف‌ها چرخش خروجی روتور meanline را نداشتند: ψ واقعی 1.175 و درجهٔ واکنش 0.41 بود | سینماتیک مرحلهٔ تکرارشونده (α1 = α3 = −8.5°) ← ψ 1.25، R 0.45 |
| 2، 31 | گلوگاه‌ها ۵–۷٪ کوچک بودند (انحراف Carter) و NGVها نزدیک خفگی کار می‌کردند | انحراف Ainley–Mathieson و ارتفاع خروجی در لبهٔ فرار ← ماخ گلوگاه 0.75 / 0.81 |
| 3، 35 | لبهٔ فرار روتور ۰٫۷۵–۰٫۹۴ mm بود | لبهٔ فرار ثابت ۱٫۰ mm |
| 4، 19، 20، 28، 29 | مرتبهٔ ۲×NGV2 بالای همهٔ مودهای محاسبه‌شده بود («قبول» بدون چک)؛ روی R1 هم چک نمی‌شد | مرتبه‌های ضعیف در برابر همهٔ مودهای کوپل زیر ۱٫۰۵× مود ۶ پره، با شرط پوشش. میدان پتانسیل ۲×N2 روی R1 وقتی exp(−4πg/s) ≥ 0.05 است شمرده می‌شود (۲۴ پره: 0.16) |
| 5، 22 | حاشیه فقط در ۱۵٬۰۰۰ rpm چک می‌شد | حاشیه در کل باند شبکه، ۱۴٬۷۰۰ تا ۱۵٬۳۰۰ rpm |
| 6 | تنش مقطع خالص میانگین سادهٔ گره‌ها بود | P/A از سطح مقطع واقعی؛ بیشینهٔ دو عدد FE و P/A ملاک است |
| 7 | FE پرهٔ R2 روی CAD قدیمی اجرا شده بود | همهٔ FEها روی CAD rev 4. در rev 5 روتورها فقط محوری جابه‌جا شدند (جرم‌ها یکسان؛ تنش و فرکانس مستقل از جابه‌جایی) |
| 8، 10، 16، 21، 32 | شیار rim روی R1: سوراخ ته شیار چک نشده بود و خزش با تنش حرارتی فشاری حساب شده بود | **شیارها حذف شدند**. تنش حرارتی محیطی سکو به‌صورت LCF کرنش‌کنترل با Kt 1.3 چک می‌شود. خزش دیسک فقط با تنش مکانیکی (اولیه) |
| 9، 18 | تنش ترکیدن میانگین سادهٔ گره‌ها بود | میانگین سطحی تنش محیطی روی مقطع باربر |
| 11 | نامیزانی API نصف مقدار لازم بود | U = 6350 W/N در هر صفحه؛ برای مود اول، جمع بار دو یاتاقان |
| 12 | میرایی SFD خوش‌بینانه بود | حالت میرایی کم (۱٫۲×۱۰⁴ N·s/m) هم حل شد و قبول است |
| 13، 26، 30، 33، 34 | عددهای کهنه یا هاب صلب در گزارش؛ فهرست «کم‌حاشیه‌ترین‌ها» ناقص بود | گزارش بازنویسی شد. معیار ارتعاش مدل کامل پره و دیسک است |
| 14 | LCF بدون اثر تنش میانگین بود | Manson با تصحیح Morrow (ضریب ۲ روی کرنش و ۲۰ روی عمر)، مقایسه با حد پایین داده‌های Grainex |
| 15، 27 | برازش خزش خوش‌بینانه بود و ضریب ۱٫۵ بی‌صدا ۱٫۲۵ شده بود | منحنی master Larson–Miller و **منحنی حداقل** (۰٫۸× تنش، با ۱۰٪ کاهش بیشتر در P بالا). R1 باریک‌تر شد ← ۱۰۰ MPa در برابر مجاز ۱۲۴ MPa |
| 17 | Goodman با UTS در ۸۷۰ °C | نقطهٔ تقاطع = استحکام گسیختگی ۱۰⁵ ساعت (منحنی حداقل) |
| 23، 24 | تعداد خانواده‌ها چک نمی‌شد؛ ND حل‌نشده ۱۰۰٪ حاشیه می‌گرفت | پوشش فرکانسی چک می‌شود؛ ND حل‌نشده «نامعلوم» است |
| 25 | توضیح کد دربارهٔ EO86 غلط بود | اصلاح شد (rev 5 تعداد را عوض کرد) |
| 36 | سگمنت کردن NGV با تعداد اول پره‌ها نمی‌خواند | NGVها حلقهٔ کامل ریخته می‌شوند |

### ۱۲٫۳ تست ۱: تنش و خزش پره‌ها (`sim/engine/a1000_blade_fea.py`، CalculiX، C3D10)

مدل: پره روی سکوی صلب، NLGEOM گریز از مرکز، MAR-M247 در دمای نسبی گاز. ملاک خزش، تنش مقطع خالص ریشه در دمای T0 نسبی هاب است.

| در ۱۵٬۰۰۰ rpm | R1 | R2 |
|---|---|---|
| دمای فلز در ریشه (T0 نسبی هاب) | ۸۶۵ °C | ۷۲۳ °C |
| تنش مقطع خالص (P/A؛ FE باند بالای فیلت) | **100 MPa** (FE 94) | **188 MPa** (FE 181) |
| مجاز ۱۰⁵ ساعت (منحنی حداقل) | 124 MPa | 376 MPa |
| عمر گسیختگی خزشی (منحنی حداقل / تیپیک) | **2.6×10⁵ h** / 1.7×10⁶ h | 2.7×10⁷ h / 1.4×10⁸ h |
| von Mises بیشینه (موضعی، فیلت یا لبهٔ فرار) | 188 MPa ← حاشیهٔ تسلیم **3.6** | 362 MPa ← **2.1** |
| تنش ارتعاشی مجاز در ریشه (Goodman، HCF) | **32 MPa** | 85 MPa |
| خمش گازی (تخمین) | ~5 MPa | ~5 MPa |

- R1 در ریشه ۸۱٪ از ظرفیت خزشی ۱۰⁵ ساعت را مصرف می‌کند. برای همین تنش ارتعاشی مجازش فقط ۳۲ MPa است، و **دوری از تشدید روی R1 الزامی است**.
- **دادهٔ خزش MAR-M247:**
  - منحنی master از داده‌های منتشرشده بازسازی شده است. دسترسی شبکه به منابع اصلی (NASA، TMS، OSTI، DTIC) از این محیط بسته بود.
  - قبل از سفارش، باید **دادهٔ تأییدشدهٔ ریخته‌گر** گرفته شود: تست گسیختگی روی میله‌های هم‌ذوب HIP‌شده و روی نمونه‌های بریده از blisk.

### ۱۲٫۴ تست ۲: ارتعاش، مدل کامل پره و دیسک (`sim/engine/a1000_blisk_cyclic.py`) و انتخاب تعداد پرهٔ NGV

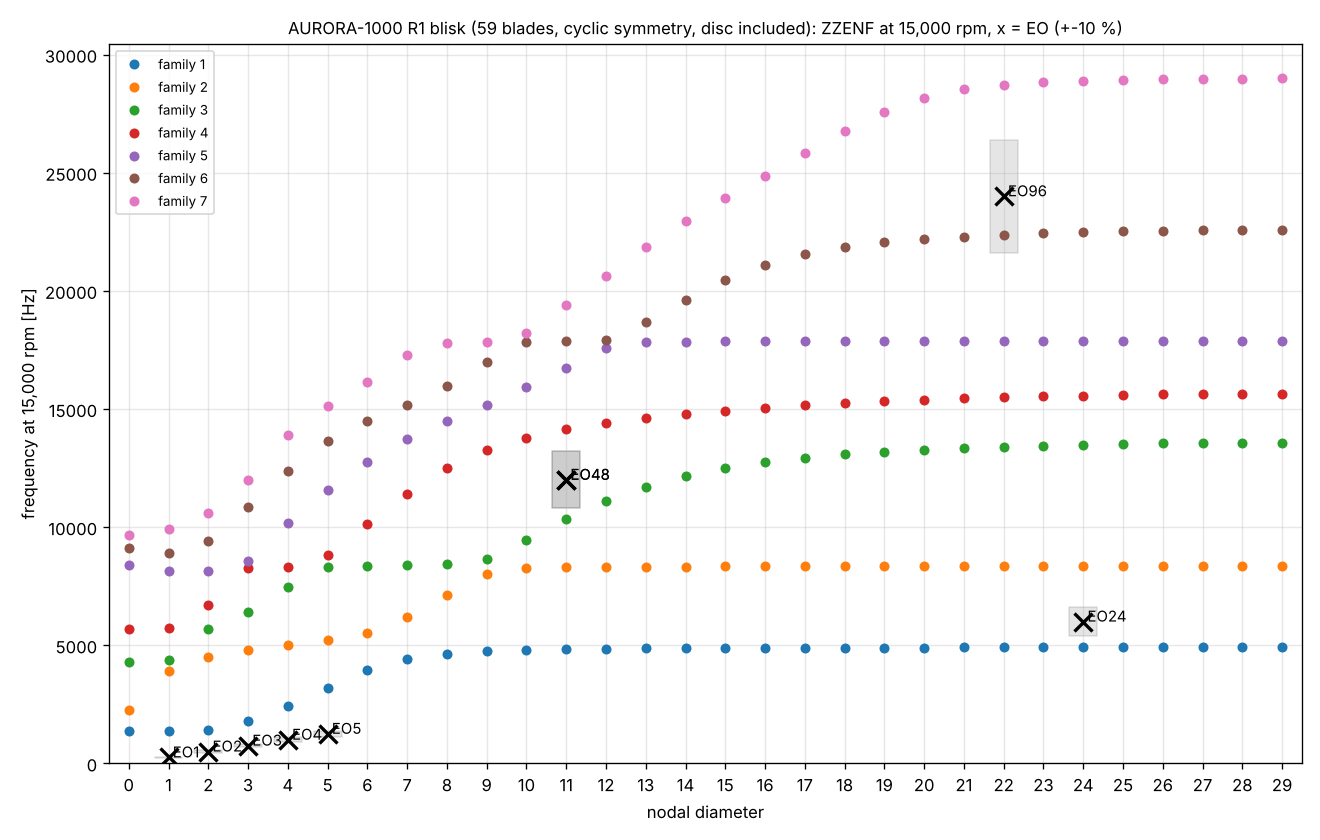
[picture p5: docs/img/a1000_R1_zzenf.png]
ZZENF R1


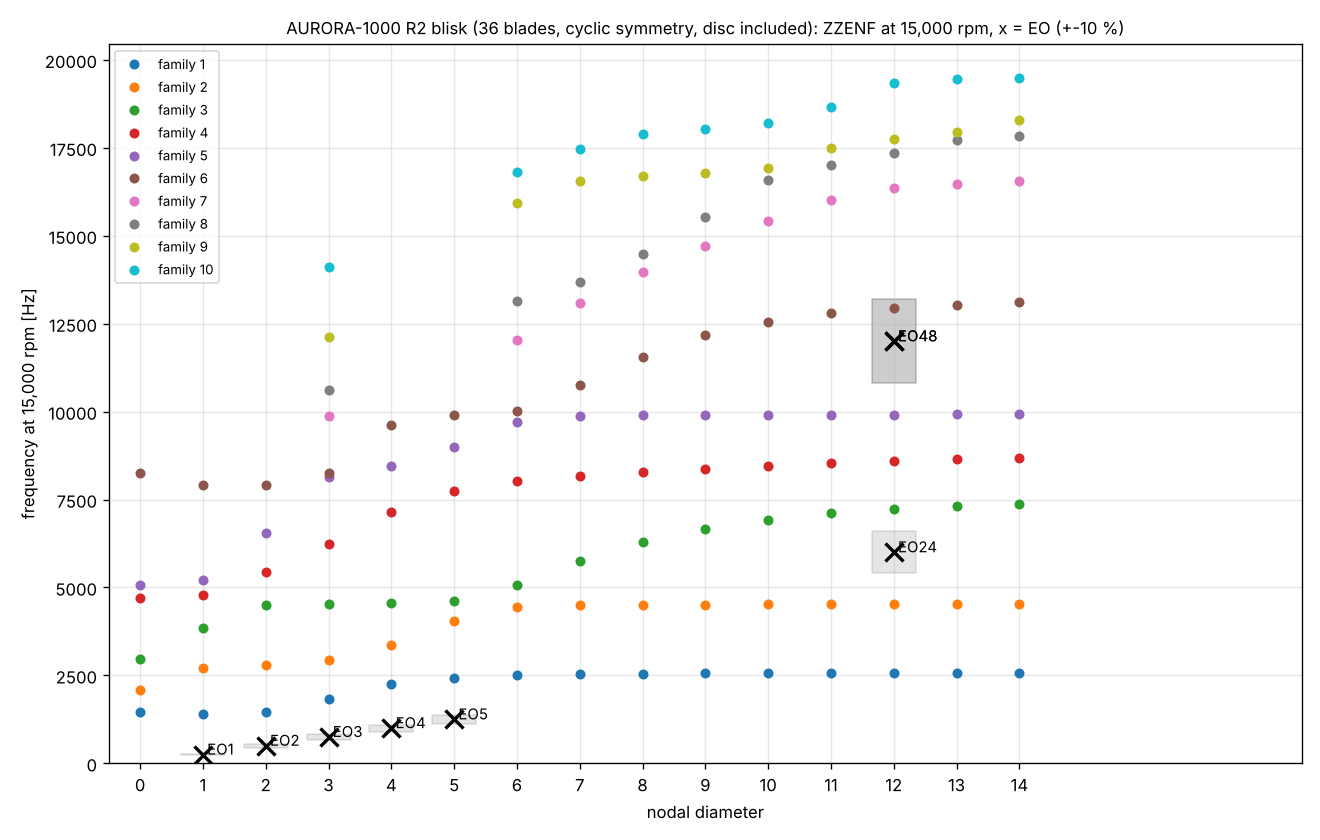
[picture p6: docs/img/a1000_R2_zzenf.png]
ZZENF R2


**مدل:**
- یک sector به اندازهٔ ۱/Z از دیسک (از r = 60 mm تا rim) همراه با سکو و پره.
- مش متناوب روی دو صفحهٔ برش و `*CYCLIC SYMMETRY MODEL`.
- پیش‌تنش NLGEOM در ۱۵٬۰۰۰ rpm، و E(T) برای میدان دمای دیسک و پره.
- **R1:** همهٔ قطرهای گرهی ND 0–29، هر کدام ۷ خانوادهٔ مود (ND1 با ۱۴ خانواده).
- **R2:** ND 0–14 با ۱۰ خانواده (ND 0–2 و ۴–۵ با ۶ خانواده).
- R1 در ND1 با ۱۴ و R2 در ND3 با ۱۰ خانواده دوباره حل شدند، تا مودهای پره‌ای ND پایین هم دیده شوند.
- اعتبارسنجی: مود flap با مدل تیر چک شد.
- دیسک فرکانس‌های ND پایین را تا ~۳ برابر کمتر از مدل هاب صلب می‌دهد. مدل هاب صلب (Campbell در `docs/img/a1000_R*_campbell.png`) فقط برای مقایسه نگه داشته شده است.

**معیارها** (حاشیه در کل باند شبکه، ۱۴٬۷۰۰ تا ۱۵٬۳۰۰ rpm؛ مرتبهٔ k در قطر گرهی n = k mod Z تحریک می‌کند):

| رده | مرتبه‌ها | حاشیهٔ لازم |
|---|---|---|
| قوی (۱×NPF ردیف کناری) | R1: N1 (دنباله)، N2 (میدان پتانسیل، فاصلهٔ ۹ mm)؛ R2: N2 | **۱۰٪ از همهٔ مودها** |
| ضعیف | ۲×NPF، دنبالهٔ N1 روی R2 (از دو ردیف گذشته)، ۲×N2 روی R1 (میدان پتانسیل ۲۴ پرهٔ بزرگ) | **۵٪** از مودهای زیر ۱٫۰۵× مود ۶ پره |
| برهم‌کنش دو ردیف ثابت | \|N1 − N2\| (دنبالهٔ N1 که پره‌های N2 خردش کرده‌اند) | بدون عبور در باند + تخمین پاسخ اجباری |
| EO 1–5 | محفظهٔ can، ورودی، ۵ پایهٔ اگزوز | ۱۰٪ |

**چرا تعداد پره‌ها عوض شد:** طرح ۴۳ / ۴۷ روی مدل کامل چهار تداخل داشت:
- R1 در EO47 فقط **−3.5%** با ND12 خانوادهٔ ۳ فاصله داشت.
- R1 در EO86 فقط **2.9%** با ND27 خانوادهٔ ۶ فاصله داشت.
- R2 در EO47 فقط **6.7%** با ND11 خانوادهٔ ۶ فاصله داشت.
- R2 در EO43 **0.0%**، یعنی تشدید، روی ND7 خانوادهٔ ۶.

ابزار `sim/engine/a1000_vane_count.py` همهٔ ترکیب‌های N1 و N2 از ۲۰ تا ۵۵ را بررسی کرد. در هر ترکیب وتر محوری طوری تنظیم شد که Zweifel ≤ 1.12 بماند. یافته‌ها:
- **NGV2 بین ۴۰ تا ۵۵ پره روی R2 ممکن نیست.** خانواده‌های ۵، ۶ و ۷ در ND 7–18 (۹٫۹، ۱۰٫۷–۱۳٫۲ و ۱۶–۱۷٫۵ kHz) پنجرهٔ ۱۰٪ برای EO 40–55 باقی نمی‌گذارند.
- **R2 یک خانوادهٔ مود پره‌ای تقریباً تخت در ۹٬۸۷ تا ۹٬۹۲ kHz در همهٔ ND ≥ 3 دارد** (ND3 خانوادهٔ ۷، ND5 خانوادهٔ ۶، ND7–14 خانوادهٔ ۵):
  - دنبالهٔ NGV1 که از دو ردیف گذشته به R2 می‌رسد، با ۳۷ تا ۴۲ پره در فاصلهٔ ۵٪ این خانواده می‌افتد (۳۹ پره: تشدید در ND3؛ ۴۰: −1.9%؛ ۴۲: −2.7%).
  - NGV1 با ۴۳ تا ۴۷ پره روی R1 رد می‌شود.
- **دو اصلاح روش در همین مرحله:**
  1. چک «ضعیف» اول روی ۶ خانوادهٔ اول هر ND انجام می‌شد. در ND پایین مودهای دیسک لابه‌لای مودهای پره می‌آیند، پس این روش مود پرهٔ R2 در ND3 (۹٬۸۷۳ Hz، خانوادهٔ ۷) و R1 در ND1 (۱۴٬۸۱۴ Hz، خانوادهٔ ۹) را نمی‌دید. حالا همهٔ مودهای زیر ۱٫۰۵× مود ۶ پره چک می‌شوند.
  2. مرتبهٔ برهم‌کنش |N1 − N2| اضافه شد.
  - با این اصلاح‌ها ترکیب میانی ۳۹ / ۲۹ (commit قبلی) رد شد: EO39 روی R2 در ND3 تشدید دارد و ۲×۲۹ = EO58 روی R1 در ND1 فقط ۰٫۲٪ فاصله دارد.
- **انتخاب: NGV1 = ۴۸ (وتر محوری ۲۲ mm) و NGV2 = ۲۴ (وتر محوری ۴۹ mm).** حاشیه‌ها در جدول زیر است.
  - ۴۸ = ۲×۲۴: هر کانال NGV2 دقیقاً دو دنبالهٔ NGV1 می‌گیرد، پس جای نسبی دو ردیف (clocking) را می‌شود برای بازده و کمترین تحریک تنظیم کرد.
  - مرتبهٔ برهم‌کنش |48 − 24| = 24 همان NPF ردیف دوم است و مرتبهٔ تازه‌ای نمی‌سازد.
- **تنها نقطهٔ مرزی:** ۲×N1 = EO96 روی R1، با خانوادهٔ ۶ در ND22 (۲۲٬۳۷۳ Hz).
  - حاشیه در لبهٔ باند **−4.9٪** و در ۱۵٬۰۰۰ rpm حدود ۶٫۸٪ است، در برابر ۵٪ لازم.
  - **با تحلیل پاسخ اجباری بسته شد (بخش ۱۲٫۴٫۱):** حتی در خود تشدید تنش ریشه ۱۰ MPa است، در برابر حد ۱۵٫۸ MPa. معیار این مرتبه حالا پاسخ اجباری است، نه حاشیهٔ فرکانسی.
  - همین تحلیل یک مشکل تازه نشان داد: **EO24 روی مود flap اول R1 در راه‌اندازی** (بخش ۱۲٫۴٫۱).
- **گزینه‌های دیگر:**
  - **۲۸ / ۲۴:** همهٔ چک‌های معلوم را قبول می‌کند، ولی NGV1 وتر محوری ۳۷ mm (h/c ~0.5) می‌خواهد و حدود ۰٫۶ واحد درصد بازده توربین بیشتر از دست می‌رود. چک ۲×N1 روی R1 در ND3 هم هنوز حل نشده است.
  - **۴۹ / ۲۴:** روی R2 در EO49 فقط ۴٫۴٪ و روی R1 در مرتبهٔ قوی ۱۰٫۳٪ حاشیه دارد. R1 به‌خاطر تنش ارتعاشی مجاز کمش (۳۲ MPa) ردیف حساس‌تر است.
- چون تعداد پره‌های NGV روی blisk‌ها اثری ندارد، اگر tip-timing نیاز نشان دهد، تغییر آن بعداً **فقط با ریختن دوبارهٔ NGVها** ممکن است. **blisk‌ها را می‌شود سفارش داد.**
  - استثنا: اگر برای EO24 روی R1 راه‌حل میرایی (شیار damper) انتخاب شود، نقشهٔ blisk R1 عوض می‌شود (بخش ۱۲٫۴٫۱).

**حاشیه‌های نهایی** (مدل کامل، باند ۱۴٬۷۰۰ تا ۱۵٬۳۰۰ rpm):

| ردیف | تحریک | EO | ND | نزدیک‌ترین مود | حاشیه | لازم |
|---|---|---|---|---|---|---|
| R1 | دنبالهٔ NGV1 (قوی) | 48 | 11 | خانوادهٔ ۳، ۱۰٬۳۴۲ Hz | −12.1% | 10% |
| R1 | میدان پتانسیل NGV2 (قوی) | 24 | 24 | خانوادهٔ ۱، ۴٬۹۰۸ Hz | −16.5% | 10% |
| R1 | ۲×NGV1 (ضعیف) | 96 | 22 | خانوادهٔ ۶، ۲۲٬۳۷۳ Hz | −4.9% (فقط برای مقایسه) | پاسخ اجباری: قبول |
| R1 | ۲×NGV2، میدان پتانسیل (ضعیف) | 48 | 11 | خانوادهٔ ۳ | −12.1% | 5% |
| R1 | EO 1–5 | 3 | 3 | خانوادهٔ ۱، ۱٬۷۷۹ Hz | 133% | 10% |
| R2 | دنبالهٔ NGV2 (قوی) | 24 | 12 | خانوادهٔ ۳، ۷٬۲۳۳ Hz (خانوادهٔ ۲: −23%) | +18.2% | 10% |
| R2 | دنبالهٔ NGV1 از دو ردیف + ۲×NGV2 (ضعیف) | 48 | 12 | خانوادهٔ ۶، ۱۲٬۹۴۴ Hz | +5.8% | 5% |
| R2 | EO 1–5 | 5 | 5 | خانوادهٔ ۱، ۲٬۴۳۵ Hz | 91% | 10% |

#### ۱۲٫۴٫۱ پاسخ اجباری R1 در EO24، EO48 و EO96 (۲۰۲۶-۱۰-۳۰)

> این بخش هندسهٔ rev 5 را توصیف می‌کند (فاصلهٔ R1–NGV2 ۹ تا ۱۷ mm). نیروی آن در `forcing_rev5.json` مانده است. دو تصویر زیر با هندسهٔ rev 6 (فاصلهٔ +۲۵ mm) به‌روز شده‌اند. نتایج rev 6 در بخش ۱۲٫۴٫۳ است.

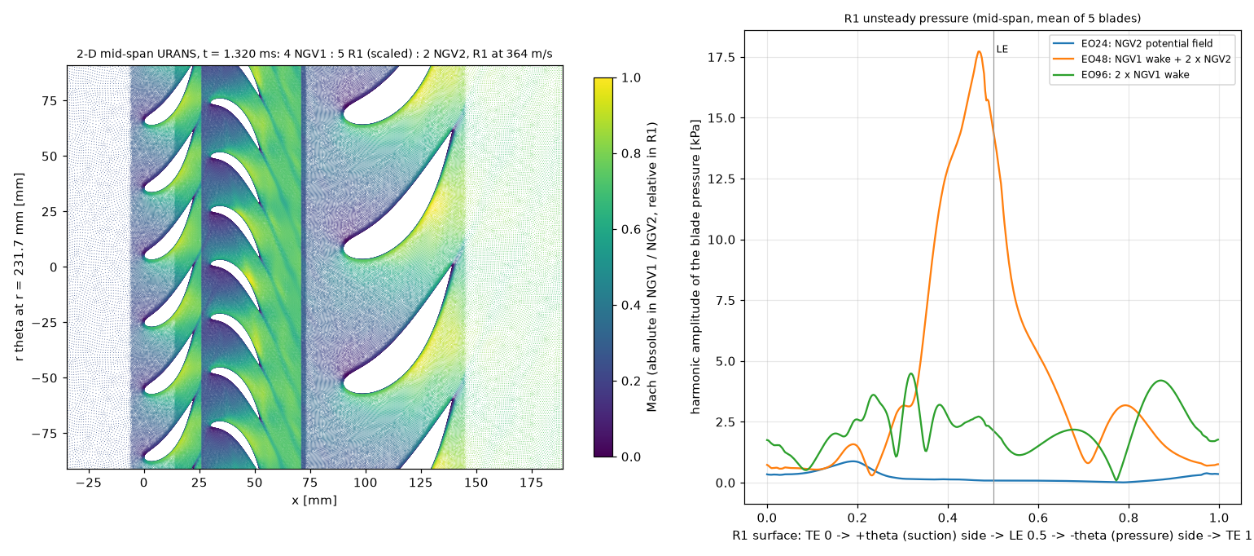
[picture p7: docs/img/a1000_r1_forcing_cfd.png]
CFD ناپایای سه ردیف و فشار ناپایا روی R1


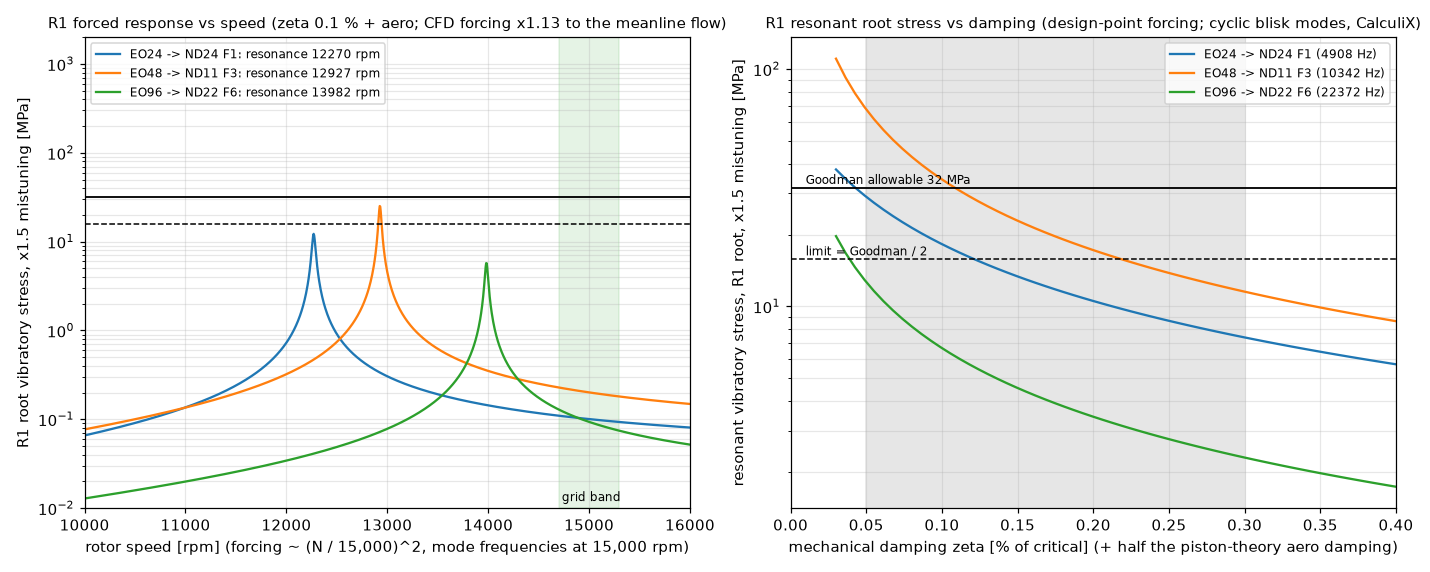
[picture p8: docs/img/a1000_R1_forced_response.png]
پاسخ اجباری R1


**روش، قدم ۱: نیروی ناپایا با CFD** (`sim/cfd/a1000_r1_forcing/make_case.py`):
- OpenFOAM v2606، `rhoPimpleFoam` (URANS تراکم‌پذیر، kOmegaSST).
- صفحهٔ پره‌به‌پره در شعاع میانی (۲۳۱٫۷ mm)، با سه ردیف NGV1، R1 و NGV2.
- سکتور ۳۰°: ۴ پرهٔ NGV1، ۵ پرهٔ R1 و ۲ پرهٔ NGV2.
  - گام R1 مقیاس شده است (۶۰ به‌جای ۵۹ پره، ۱٫۷٪ کوچک‌تر).
  - گام NGVها دقیق است، پس فرکانس‌های ۲۴، ۴۸ و ۹۶ برابر دور دقیق‌اند.
- R1 با ۳۶۴ m/s بین دو سطح لغزان (`cyclicPeriodicAMI`) حرکت می‌کند.
- شبه‌سه‌بعدی: ضخامت لایه به نسبت ارتفاع annulus بزرگ می‌شود، تا سرعت محوری مثل meanline بماند.
- ورودی 3.55 bar و 950 °C. فشار خروجی از meanline.
- مش ۲۲۹ هزار سلول شش‌وجهی. گام زمانی ۰٫۵ µs، یعنی ۸۳ گام در هر دورهٔ EO96.
- ۰٫۹۲ ms راه‌اندازی، بعد دو دورهٔ کامل EO24 (۰٫۳۴ ms) نمونه‌برداری. فشار سطح پره هر ۱ µs ثبت شد.
- نقطهٔ کار با طراحی می‌خواند:
  - ماخ خروج NGV1: 0.70 (طراحی 0.71).
  - زاویهٔ ورود نسبی R1: 22° (زاویهٔ فلز 19°).
  - زاویهٔ خروج نسبی R1: −65.6° (طراحی −65.1°).
- دبی معادل ۶٫۰۳ kg/s است، ۶٪ کمتر از meanline. نیرو با (۶٫۴۳ / ۶٫۰۳)² = ۱٫۱۳ بزرگ شد (محافظه‌کارانه).

**قدم ۲: مودها** (`sim/engine/a1000_r1_forced_response.py`):
- همان سکتور cyclic بخش ۱۲٫۴، با شکل مود و تنش برای ND24، ND11 و ND22.
- از هر جفت cos/sin، مود موج‌رونده با جهت درست ساخته شد. رابطهٔ cyclic جفت‌ها چک شد (خطا < ۱۰⁻⁴).
- جرم مودال با ماتریس جرم C3D10 خودمان حساب شد، مستقل از نرمال‌سازی CalculiX.

**قدم ۳: تصویر نیرو روی مود:**
- هارمونیک فشار مقطع میانی، روی همهٔ ارتفاع پره و هم‌فاز گذاشته شد. این برآورد بالاست.
- تنش ارتعاشی ریشه در تشدید = تنش مود × |Uᴴf| / (m · 2ζω²).

**قدم ۴: میرایی و معیار:**
- میرایی مکانیکی ۰٫۰۵ تا ۰٫۳٪ critical (blisk ریختگی، بدون اتصال اصطکاکی).
- به آن نصف میرایی آیرودینامیک piston theory اضافه شد (۰٫۰۱ تا ۰٫۰۷٪).
- ضریب mistuning ۱٫۵.
- حد: تنش ریشه ≤ Goodman / 2 = ۱۵٫۸ MPa (Goodman ریشه ۳۲ MPa، بخش ۱۲٫۳).
- **قبول** یعنی با کمترین میرایی هم زیر حد است. **رد** یعنی با بیشترین میرایی هم بالای حد است. بقیه **مرزی** است.

**نتیجه‌ها** (تنش ریشه با mistuning ×۱٫۵ و نیروی نقطهٔ طراحی):

| تحریک | دامنهٔ فشار روی پره (CFD) | مود | دور تشدید | در باند شبکه | در تشدید، ζ = ۰٫۰۵ / ۰٫۱ / ۰٫۳٪ | حکم |
|---|---|---|---|---|---|---|
| EO96: ۲×دنبالهٔ NGV1 | 2.2 kPa | ND22 F6، ۲۲٬۳۷۲ Hz | ۱۳٬۹۸۲ rpm | 0.11 MPa | **10** / 5.3 / 1.8 MPa | **قبول** |
| EO48: دنبالهٔ NGV1 + ۲×NGV2 | 6.4 kPa | ND11 F3، ۱۰٬۳۴۲ Hz | ۱۲٬۹۲۷ rpm | 0.20 MPa | 58 / 29 / 9.8 MPa | مرزی |
| EO24: میدان پتانسیل NGV2 | 4.9 kPa | ND24 F1 (flap)، ۴٬۹۰۸ Hz | ۱۲٬۲۷۰ rpm | 2.5 MPa | **644 / 407 / 165** MPa | **رد** |

- نیروی مماسی ناپایا نسبت به نیروی پایا: EO24 ۱۰٪، EO48 ۶٪، EO96 ۰٫۲٪. فشار EO96 در طول پره تغییر فاز می‌دهد و جمعش تقریباً صفر است.
- اختلاف دو دورهٔ نمونه‌برداری ۱۰ تا ۱۶٪ است. اختلاف بین ۵ پره ≤ ۳٪ است.
- بیشترین تنش EO96 در ۶۴٪ ارتفاع است (۱۴٫۵ MPa). آنجا تنش میانگین کمتر و تنش مجاز بیشتر است.
- هر سه تشدید پایین‌تر از باند شبکه‌اند و فقط در راه‌اندازی و توقف رد می‌شوند. در باند شبکه همهٔ تنش‌ها ≤ ۲٫۵ MPa است.

**تفسیر:**
- **EO96 بسته شد.** حتی در خود تشدید، با کمترین میرایی و نیروی نقطهٔ طراحی، تنش ۱۰ MPa است. پس حاشیهٔ ۴٫۹٪ مهم نیست.
  - تشدید در ۱۳٬۹۸۲ rpm است (شبکهٔ ۴۶٫۶ Hz). کار طولانی در فرکانس پایین شبکه هم مشکلی ندارد.
  - در برگهٔ چک، معیار EO96 از «حاشیهٔ ۵٪» به «پاسخ اجباری» عوض شد.
- **EO48 مرزی است.** با ζ ≥ ۰٫۱۸٪ قبول است. با نیروی کمتر هنگام راه‌اندازی (~(N/15000)² = ۰٫۷۴) با ζ ≥ ۰٫۱۴٪.
- **EO24 یک یافتهٔ تازه است.** مود flap اول R1 (ND24) در هر راه‌اندازی با ۱×NPF ردیف NGV2 تشدید دارد.
  - ۲۴ پرهٔ بزرگ NGV2 (گام ۶۱ mm، فاصله تا R1 از ۹ تا ۱۷ mm) میدان فشار قوی روی لبهٔ فرار R1 می‌سازند.
  - با نیروی راه‌اندازی (×۰٫۶۷) هم تنش 431 / 272 / 110 MPa است.
  - عبور سریع کمکی نمی‌کند. با میرایی ۰٫۱٪، دامنه در ~۲۵ ms ساخته می‌شود. با راه‌اندازی ۶۰ ثانیه‌ای بیش از ۹۵٪ تشدید پایا می‌رسد.
  - هر عبور ~۶۰۰ سیکل دارد. در ۱۰⁴ راه‌اندازی یعنی ~۱۰⁷ سیکل، که در محدودهٔ HCF است.
  - این مشکل به تعداد NGV1 ربطی ندارد. معیار قبلی (حاشیهٔ فرکانسی فقط در باند شبکه) عبورهای پایین‌تر از باند را چک نمی‌کرد.

**توصیه:**
1. **NGV1 = ۴۸ و NGV2 = ۲۴ از نظر EO96 بمانند.** تغییر تعداد NGV1 لازم نیست، و EO24 را هم حل نمی‌کند.
2. **EO24 روی R1 باید قبل از سفارش حلقهٔ NGV2 و فاصله‌انداز روتور بسته شود.** مقایسهٔ چهار راه‌حل و تصمیم در بخش ۱۲٫۴٫۲ است: **فاصلهٔ محوری R1 تا NGV2 به‌اندازهٔ ۲۵ mm بیشتر.**
3. **tip-timing در اولین راه‌اندازی** روی R1، با جاروی ۱۲٬۰۰۰ تا ۱۴٬۵۰۰ rpm.

#### ۱۲٫۴٫۲ EO24 روی R1: مقایسهٔ چهار راه‌حل و تصمیم (rev 6، ۲۰۲۶-۱۰-۳۰)

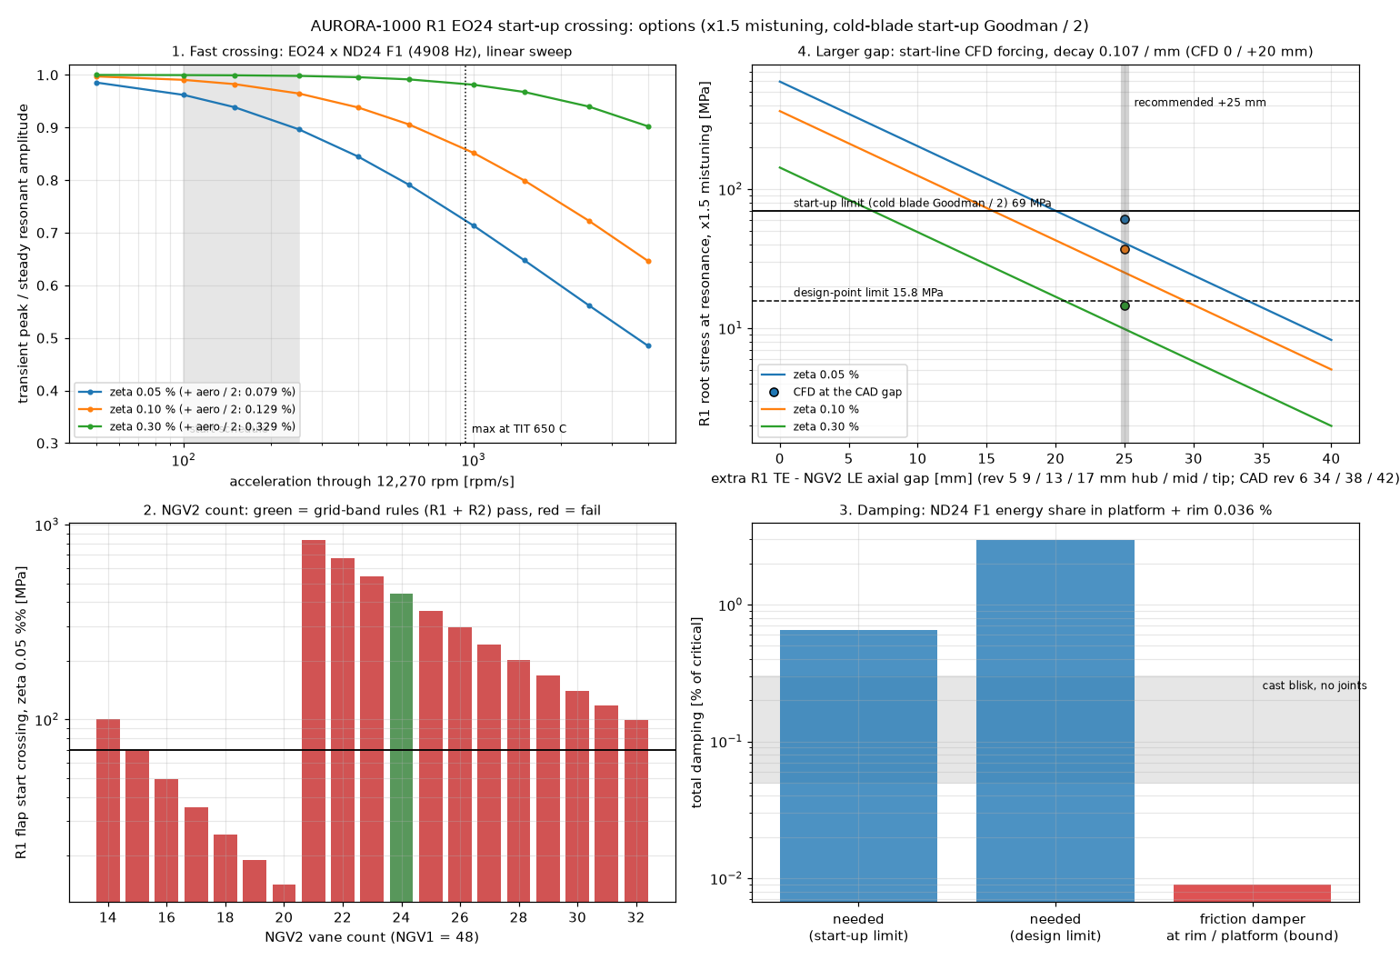
[picture p9: docs/img/a1000_R1_eo24_options.png]
گزینه‌های EO24


**ابزارها:**
- `sim/engine/a1000_startup.py`: خط راه‌اندازی. تطبیق کمپرسور و توربین بدون بار، با recuperator سرد.
  - کمپرسور: منحنی‌های سرعت عمومی یک جفت پروانهٔ backswept، مقیاس‌شده از نقطهٔ طراحی. نقشهٔ واقعی کمپرسور هنوز نیست.
  - توربین: meanline ردیف‌به‌ردیف (NGV1، R1، NGV2، R2) با زاویهٔ خروج ثابت، کالیبره با نقطهٔ طراحی (دبی و فشار خروج هر پله).
  - اینرسی روی محور سریع ۳٫۱ kg·m² (روتور + گیربکس + ژنراتور از راه ۱۰:۱).
- CFD در شرایط راه‌اندازی: همان `make_case.py`، با متغیرهای `A1000_CFD_*` برای دور، فشار و دمای ورودی، فشار خروجی و فاصلهٔ اضافه.
  - حالت `st`: فاصلهٔ فعلی. حالت `st_g20`: فاصلهٔ R1 تا NGV2 به‌اندازهٔ ۲۰ mm بیشتر.
  - هر دو روی مک مینی (OpenFOAM v2606، ۸ پردازنده) اجرا شدند. مک‌بوک با FEA جلسهٔ دیگر پر بود.
- `sim/engine/a1000_r1_eo24_options.py`: مقایسهٔ چهار گزینه، نمودار بالا و `fea/a1000_R1_eo24_options.json`.
- `sim/engine/a1000_vane_count.py --n1 48`: اسکن تعداد NGV2 با NGV1 = ۴۸.

**حالت عبور (۱۲٬۲۷۰ rpm روی خط راه‌اندازی، TIT ۶۵۰ °C):**
- فشار ورودی توربین ۲٫۴۷ bar (طراحی ۳٫۵۵) و فشار بعد از NGV2 ۱٫۱۹ bar.
- فشار دینامیکی NGV2 ۰٫۵۷ برابر طراحی است. حاشیهٔ surge ۲۰٪.
- توان اضافه ~۳۹۰ kW، یعنی شتاب تا ~۹۴۰ rpm/s. با TIT ۸۵۰ °C تا ~۱٬۴۰۰ rpm/s (حاشیهٔ surge ۹٪).
- در توقف (بعد از قطع سوخت) کاهش دور ~۲۸۰ rpm/s است و فشار دینامیکی ۰٫۸۸ برابر حالت راه‌اندازی.
- **CFD `st`:** همان مش ۲۲۹ هزار سلولی، R1 با ۲۹۸ m/s.
  - دبی معادل ۴٫۷۴ kg/s (meanline ۵٫۰۱؛ مثل طراحی ~۵٪ کمتر). ماخ خروج NGV1 ۰٫۶۷ و زاویهٔ ورود نسبی R1 ۲۳٫۴°.
  - EO24 روی R1: فشار ۳٫۶ kPa rms (طراحی ۴٫۹) و نیروی مماسی ۱۰۶ N/m (طراحی ۱۴۵).
  - **نیروی مودال ND24 F1 = ۰٫۶۳ برابر نقطهٔ طراحی.** فرض قبلی (N/15000)² = ۰٫۶۷ نزدیک بود. پس کم‌شدن فشار در راه‌اندازی مسئله را حل نمی‌کند.
  - EO48: ۳٫۸ kPa (طراحی ۶٫۴). EO96: ۱٫۸ kPa (طراحی ۲٫۲). اختلاف دو دورهٔ نمونه‌برداری ۷ تا ۱۶٪.
- نیروی EO24 بیشتر روی نیمهٔ جلویی پره است، نه فقط نزدیک لبهٔ فرار. یعنی میدان NGV2 از راه کانال R1 تا لبهٔ حمله هم می‌رسد. برای همین اثر فاصلهٔ بیشتر با CFD (`st_g20`) چک شد، نه فقط با تئوری.

**معیار تازهٔ عبورهای زیر باند:**
- تشدید زیر باند شبکه فقط در راه‌اندازی، توقف و trip دیده می‌شود. ژنراتور سنکرون است و زیر بار دور ثابت است. پس نیروی نقطهٔ طراحی هیچ‌وقت در این دور نمی‌رسد.
- Goodman نقطهٔ طراحی (۳۱٫۶ MPa) محور تنش متوسط را استحکام گسیختگی ۱۰⁵ ساعت گرفته است. این برای کار دائم درست است، نه برای عبور چندثانیه‌ای.
- معیار عبور: تنش ریشه در تشدید پایا (بدون اعتبار شتاب)، با mistuning ×۱٫۵ ≤ Goodman / 2 در همان حالت:
  - استحکام HCF پرهٔ ریختگی در دمای فلز (۱۵۲ MPa تا ۶۵۰ °C).
  - محور تنش متوسط = UTS. تنش متوسط ریشه ∝ N².
  - دمای فلز ۲۰ تا ۸۷۰ °C، از راه‌اندازی سرد تا trip داغ. پرهٔ سرد سفت‌تر است: F1 تا ۵٬۵۰۰ Hz، عبور تا ۱۳٬۷۵۰ rpm، با فشار دینامیکی ۱٫۳ برابر.
  - **حد: ۶۹ تا ۷۵ MPa** (به‌جای ۱۵٫۸ MPa).
- با این معیار و نیروی CFD راه‌اندازی:
  - **EO48 قبول شد:** ۵۷ / ۲۹ / ۱۰ MPa در برابر ۶۹. مورد «مرزی» بسته شد.
  - **EO96 قبول:** ۱۳ / ۷ / ۲ MPa.
  - **EO24 رد:** ۵۹۱ / ۳۶۳ / ۱۴۳ MPa با پرهٔ سرد و ۴۳۷ / ۲۶۸ / ۱۰۵ MPa با پرهٔ داغ.

**گزینهٔ ۱: عبور سریع و بدون بار از ۱۲٬۲۷۰ rpm**
- عبور خطی از تشدید با معادلهٔ پوش (envelope) نوسانگر مودال حل شد.

| شتاب [rpm/s] | قلهٔ گذرا / تشدید پایا (ζ = ۰٫۰۵ / ۰٫۱ / ۰٫۳٪) | سیکل بالای ۵۰٪ دامنهٔ پایا در هر عبور | زمان ماندن |
|---|---|---|---|
| ۱۵۰ (برنامهٔ عادی) | ۰٫۹۴ / ۰٫۹۸ / ۱٫۰۰ | ۱٬۱۵۰ / ۱٬۸۰۰ / ۴٬۶۰۰ | ۰٫۲۳ تا ۰٫۹۳ s |
| ۵۰۰ | ۰٫۸۲ / ۰٫۹۲ / ۰٫۹۹ | ۴۲۰ / ۵۸۰ / ۱٬۳۷۰ | ۰٫۰۹ تا ۰٫۲۸ s |
| ۱٬۰۰۰ (سریع) | ۰٫۷۱ / ۰٫۸۵ / ۰٫۹۸ | ۲۳۰ / ۳۳۰ / ۶۸۰ | ۰٫۰۵ تا ۰٫۱۴ s |
| ۱٬۵۰۰ (حد بالا) | ۰٫۶۵ / ۰٫۸۰ / ۰٫۹۷ | ۱۶۰ / ۲۴۰ / ۴۶۰ | ۰٫۰۳ تا ۰٫۰۹ s |

- در هر روشن‌وخاموش دو عبور هست (شتاب و توقف). در ۱۰⁴ بار یعنی ۰٫۳ تا ۹×۱۰⁷ سیکل بزرگ، یعنی ناحیهٔ HCF.
- حتی با ۱٬۵۰۰ rpm/s، قله فقط ۳ تا ۳۵٪ کم می‌شود. تنش هنوز ۱٫۴ تا ۸ برابر حد است.
- Miner (ضریب ۲ روی تنش، ۱۰⁴ راه‌اندازی): ۶ تا ۱۰⁹ (باید ≤ ۱ باشد).
- LCF: تنش ارتعاشی روی سیکل روشن‌وخاموش می‌نشیند. بازهٔ تنش ریشه به ۲۱۰ تا ۱٬۱۱۰ MPa می‌رسد. عمر LCF با ζ = ۰٫۰۵ تا ۰٫۱٪ فقط ۲۰۰ تا ۵٬۰۰۰ راه‌اندازی است (لازم ۱۰⁴).
- **نتیجه: رد.** شتاب سریع کمک کمی می‌کند، چون زمان ساخت دامنه (~۲۵ ms) از زمان عبور کوتاه‌تر است. شتاب بیشتر از ~۱٬۵۰۰ rpm/s هم با recuperator سرد و حاشیهٔ surge ممکن نیست.

**گزینهٔ ۲: تعداد پرهٔ NGV2 (NGV1 = ۴۸ ثابت)**
- اسکن NGV2 از ۱۴ تا ۳۲ پره. همهٔ قانون‌های باند شبکه برای R1 و R2 مثل قبل. EO96 با پاسخ اجباری بسته است.
- وتر محوری NGV2 با Zweifel تنظیم شد (۰٫۷۰ ≤ Zw ≤ ۱٫۱۲). برای بیش از ۲۷ پره وتر تا ×۰٫۸ کوتاه می‌شود.
- **فقط NGV2 = ۲۴ قانون‌های باند را قبول می‌کند.** بقیه رد می‌شوند:
  - ۱۸ تا ۲۳: EO N2 روی F1 خود R1 در باند (۶٫۶٪ تا ۰٪) یا 2×N2 روی R1 و R2.
  - ۲۵ تا ۳۲: 2×N2 روی R1، N2 روی R2 (۰ تا ۴٫۸٪)، یا مرتبهٔ |48 − N2|.
  - ۱۴ تا ۱۷: 2×N2 یا |48 − N2| در باند. وتر محوری هم ۶۸ تا ۸۳ mm می‌شود و تلفات ثانویه ×۱٫۴ تا ×۱٫۶.
- عبور F1 در راه‌اندازی (نیروی CFD راه‌اندازی، مقیاس‌شده با فاصلهٔ میرایی میدان پتانسیل و فشار دینامیکی در دور عبور):
  - N2 ≥ ۲۱ همیشه F1 را زیر باند رد می‌کند. با N2 بیشتر، عبور در دور کمتر است و میدان با گام کوچک‌تر سریع‌تر کم می‌شود. ولی تا ۳۲ پره هنوز بالای حد است.
  - N2 ≤ ۲۰ عبور هارمونیک اول ندارد. فقط ۲×N2 از F1 رد می‌شود: برای ۱۶ تا ۲۰ پره در ۷٬۳۰۰ تا ۹٬۲۰۰ rpm قبول است، برای ۱۴ و ۱۵ نه. ولی همین تعدادها قانون باند را رد می‌کنند.
- **نتیجه: با NGV1 = ۴۸ هیچ تعداد NGV2 هر دو شرط را ندارد. رد.**

**گزینهٔ ۳: میرایی اصطکاکی (damper زیر سکو، یا حلقهٔ damper در rim)**
- میرایی کل لازم: **۰٫۶۵٪** برای حد راه‌اندازی و **۲٫۹٪** برای حد نقطهٔ طراحی.
- مود ND24 F1 تقریباً فقط در پره است. سهم انرژی جنبشی سکو و rim **۰٫۰۳۶٪** و دیسک ۰٫۰۰۱٪ است. جابه‌جایی rim ۱٪ نوک پره است.
- سقف میرایی یک تماس اصطکاکی بهینه در این ناحیه ≈ ½ × ۰٫۵ × ۰٫۰۳۶٪ = **۰٫۰۰۹٪**. یعنی نزدیک صد برابر کمتر از لازم.
- damper زیر سکو در blisk فقط با شیار rim بین پره‌ها ممکن است: طراحی دوبارهٔ blisk، تمرکز تنش و LCF در ته شیار. حلقهٔ damper برای مودهای دیسک با ND پایین خوب است، نه برای flap پره با ND بالا.
- **نتیجه: رد.**

**گزینهٔ ۴: فاصلهٔ محوری بیشتر بین R1 و NGV2**
- فاصلهٔ فعلی: ۹ / ۱۳ / ۱۷ mm (هاب / میانه / نوک).
- **CFD `st_g20`** (۲۰ mm بیشتر، ۲۵۹ هزار سلول، همان شرایط راه‌اندازی):
  - نیروی مودال EO24 **×۰٫۱۲** شد، یعنی کاهش **۰٫۱۰۷ در هر mm**. تئوری میدان پتانسیل exp(−2πg/s) می‌گوید ۰٫۱۰۴. تطابق خوب است.
  - دامنهٔ باقی‌ماندهٔ EO24 (۰٫۴ kPa) نزدیک کف نویز CFD است (اختلاف دو دوره زیاد). پس ۰٫۱۲ حد بالای نسبت است.
  - EO48 و EO96 تقریباً عوض نشدند (۳٫۷ و ۱٫۶ kPa)، چون از دنبالهٔ NGV1 می‌آیند.
- فاصلهٔ اضافهٔ لازم (بدترین دمای پره):

| میرایی مکانیکی ζ | با حد راه‌اندازی (۶۹ MPa) | با حد نقطهٔ طراحی (۱۵٫۸ MPa) |
|---|---|---|
| ۰٫۰۵٪ | ۲۰ mm | ۳۴ mm |
| ۰٫۱٪ | ۱۵ mm | ۲۹ mm |
| ۰٫۳٪ | ۷ mm | ۲۱ mm |

- **انتخاب: +۲۵ mm**، یعنی فاصلهٔ ۳۴ / ۳۸ / ۴۲ mm (هاب / میانه / نوک). تنش ریشه با پرهٔ سرد: **۴۱ / ۲۵ / ۹٫۸ MPa** (ζ = ۰٫۰۵ / ۰٫۱ / ۰٫۳٪).
  - با کمترین میرایی زیر حد راه‌اندازی است.
  - با بیشترین میرایی حتی زیر حد سخت‌گیرانهٔ نقطهٔ طراحی (۱۵٫۸ MPa) است. این حاشیه برای عدم‌قطعیت CFD دوبعدی و دمای پره است.
  - **بعد از اعمال در CAD:** CFD با فاصلهٔ واقعی نیروی بیشتری داد: **۶۱ / ۳۷ / ۱۵ MPa**. هنوز قبول است (بخش ۱۲٫۴٫۳).
- اثر روی بقیهٔ طرح:
  - NGV2، R2، نیمهٔ عقبی پوسته، دیفیوزر اگزوز و یاتاقان عقب ۲۵ mm عقب‌تر می‌روند. موتور ۲۵ mm بلندتر می‌شود.
  - فاصله‌انداز R1–R2 روتور و دیافراگم NGV2 ۲۵ mm بلندتر. جرم روتور ~۲ kg بیشتر.
  - دینامیک روتور (مدل تیر `a1000_rotordynamics.py`، +۰ تا +۳۰ mm): مودهای صلب ۰٫۴ تا ۰٫۷٪ و مود خمشی **۳٫۶٪** پایین می‌آیند. روی مدل rev 1.1 (بخش ۱۳٫۸) یعنی مود سوم از ۲۱٬۶۲۰ به ~۲۰٬۸۰۰ rpm و حاشیه از ۳۷٪ به ~۳۲٪، در برابر ۲۱٪ لازم. قبول.
  - راندمان: اثر کمتر از ۰٫۱ واحد درصد (اصطکاک دیوارهٔ بیشتر در برابر برهم‌کنش ناپایای کمتر).
  - EO24 در باند شبکه هم از ۲٫۵ به ۰٫۲ MPa می‌رسد.
- **نتیجه: قبول. این راه‌حل پیشنهادی است.**

**جمع‌بندی:**

| گزینه | تنش ریشه در عبور (ζ = ۰٫۰۵ / ۰٫۳٪) | حد | هزینه | حکم |
|---|---|---|---|---|
| ۱. عبور سریع (۱٬۰۰۰ rpm/s) | ۴۲۲ / ۱۴۰ MPa | ۶۹ MPa | فقط کنترل | رد |
| ۲. تعداد NGV2 | هیچ تعدادی هر دو شرط را ندارد | | ریخته‌گری دوبارهٔ NGV2 | رد |
| ۳. damper اصطکاکی | ζ لازم ۰٫۶۵٪، ممکن ≤ ۰٫۰۱٪ | | blisk R1 جدید | رد |
| ۴. فاصلهٔ +۲۵ mm | ۴۱ / ۹٫۸ MPa (CFD با هندسهٔ CAD: ۶۱ / ۱۵) | ۶۹ (و ۱۵٫۸ با ζ = ۰٫۳٪) | ۲۵ mm طول، فاصله‌انداز و پوسته | **قبول** |

**یافتهٔ جانبی: عبورهای دیگر راه‌اندازی که هنوز حساب نشده‌اند** (از اسکن `--n1 48`):
- R1، دنبالهٔ NGV1 (EO48) روی ND11 F1 در ~۶٬۰۳۰ rpm و F2 در ~۱۰٬۳۷۰ rpm.
- R2، دنبالهٔ NGV2 (EO24، مرتبهٔ قوی) روی ND12 F1 در ~۶٬۴۴۰ rpm و F2 در ~۱۱٬۳۱۰ rpm. دنباله روی R2 معمولاً از میدان پتانسیل روی R1 قوی‌تر است.
- این‌ها به فاصلهٔ R1–NGV2 بستگی ندارند. پاسخ اجباری‌شان باید با CFD شامل R2 و مودهای F1 و F2 حساب شود (قدم بعد، بخش ۱۲٫۱۰).

#### ۱۲٫۴٫۳ اعمال فاصلهٔ +۲۵ mm در CAD و CFD با هندسهٔ نهایی (rev 6، ۲۰۲۶-۱۰-۳۰)

**هندسه** (`cad/engine/a1000_turbine.py`، `DGAP2 = 25`):
- NGV2 و R2 ۲۵ mm عقب‌تر رفتند. NGV2: x ۸۹٫۹۶ تا ۱۳۸٫۹۶ mm. R2: x ۱۴۹٫۹۶ تا ۱۹۱٫۹۶ mm.
- مقطع پره‌ها عوض نشد. CAD هر چهار ردیف همان rev 5 است و فقط جابه‌جا شده است.
- فاصله: **۳۴ / ۳۸ / ۴۲ mm** (هاب / میانه / نوک).
- مسیر جریان فقط روی فاصلهٔ باز کشیده شد: از وسط فاصلهٔ قبلی تا ۴ mm جلوی NGV2. شیب هاب و نوک در همین بخش کمتر شد.
  - روش اول (کشش از لبهٔ فرار R1 تا لبهٔ حمله NGV2) کنار گذاشته شد. مخروط نوک R1 را تا ۰٫۳۳ mm پایین می‌آورد و لبه‌های حلقهٔ NGV2 را ۰٫۳۴ mm کج می‌کرد.
  - `make_case.py` با فاصلهٔ CAD همین مسیر جریان را به کار می‌برد. با فاصله‌های دیگر (`A1000_CFD_DGAP`، مثلاً `st` و `st_g20`) همان کشش قبلی از لبهٔ فرار R1 تا NGV2 را نگه می‌دارد، تا آن نتیجه‌ها تکرارپذیر بمانند.
- `A.X_LE5`، `A.X_TE5` و `A.height5` هندسهٔ rev 5 را برای مقایسه نگه می‌دارند.

**CFD راه‌اندازی با هندسهٔ CAD** (`st_g25`، ۲۶۶ هزار سلول، همان شرایط `st`):
- جریان مثل `st`: ماخ خروج NGV1 ۰٫۶۷، زاویهٔ ورود نسبی R1 ۲۳٫۵° و دبی معادل ۴٫۷۴ kg/s.
- EO24 روی R1: فشار ۰٫۴۵ kPa rms و نیروی مماسی ۱۲ N/m. در `st` این عددها ۳٫۶ kPa و ۱۰۶ N/m بود.
- **نیروی مودال ND24 F1: ×۰٫۱۰۳ نسبت به `st`.** پیش‌بینی با کاهش ۰٫۱۰۷ در هر mm ×۰٫۰۶۹ بود. پس CFD ۱٫۵ برابر پیش‌بینی است (کاهش مؤثر ۰٫۰۹۱ در هر mm).
  - از ۲۰ به ۲۵ mm نیرو فقط ۱۳٪ کم شد. اختلاف دو دورهٔ نمونه‌برداری ۱۶۰٪ است. یعنی EO24 به کف نویز CFD رسیده است. عدد CFD حد بالاست.
- EO48 و EO96 عوض نشدند: ۳٫۷ و ۱٫۶ kPa.
- برگهٔ تست حالا تنش عبور EO24، EO48 و EO96 را مستقیم از همین نیرو (`forcing_st_g25.json`) حساب می‌کند، نه با نسبت.

**CFD نقطهٔ طراحی با هندسهٔ CAD** (`forcing.json`، ۲۶۶ هزار سلول، ۱۵٬۰۰۰ rpm):
- جریان مثل rev 5: ماخ خروج NGV1 ۰٫۷۰، زاویهٔ ورود نسبی R1 ۲۱٫۹° و دبی معادل ۶٫۰۳ kg/s.
- EO24: ۰٫۳۲ kPa و ۶٫۶ N/m (rev 5: ۴٫۹ kPa و ۱۴۵ N/m). این هم کف نویز است (اختلاف دو دوره ۳۴۰٪).
- EO48: ۶٫۴ kPa و EO96: ۲٫۴ kPa، مثل rev 5.
- فایل‌های rev 5 با نام `forcing_rev5.json` و `geometry_rev5.json` ماندند. بخش ۱۲٫۴٫۱ و اسکن تعداد پره (`a1000_vane_count.py`) از آن‌ها استفاده می‌کنند.

**تنش ریشه با هندسهٔ CAD** (mistuning ×۱٫۵، ζ = ۰٫۰۵ / ۰٫۱ / ۰٫۳٪):

| تحریک | عبور راه‌اندازی، پرهٔ سرد (`st_g25`) | حد | نیروی نقطهٔ طراحی، rev 6 (rev 5) | حکم |
|---|---|---|---|---|
| EO24 روی ND24 F1 | **۶۱ / ۳۷ / ۱۵ MPa** (پرهٔ داغ ۴۵ / ۲۸ / ۱۱ در برابر ۷۵) | ۶۹ MPa | ۲۹ / ۱۸ / ۷٫۴ (۶۴۴ / ۴۰۷ / ۱۶۵) | **قبول** |
| EO48 روی ND11 F3 | ۶۰ / ۳۰ / ۱۰ MPa | ۶۹ MPa | ۶۸ / ۳۴ / ۱۲ (۵۸ / ۲۹ / ۹٫۸) | قبول |
| EO96 روی ND22 F6 | ۱۲ / ۶٫۴ / ۲٫۲ MPa | ۶۷ MPa | ۱۳ / ۶٫۷ / ۲٫۳ (۱۰ / ۵٫۳ / ۱٫۸) | قبول |

- **EO24 با کمترین میرایی ۶۱ MPa در برابر ۶۹ MPa است.** حاشیه ۱۳٪ است، کمتر از ۴۱ MPa پیش‌بینی بخش ۱۲٫۴٫۲. با ζ = ۰٫۳٪ (۱۵ MPa) هنوز زیر حد نقطهٔ طراحی (۱۵٫۸ MPa) است.
- **EO48 کمی بیشتر شد:** در راه‌اندازی ۵۷ → ۶۰ MPa و در نقطهٔ طراحی ۱۷٪. فشار EO48 عوض نشد، ولی سهم ۲×NGV2 در فاصلهٔ کم بخشی از دنبالهٔ NGV1 را روی این مود خنثی می‌کرد. هنوز قبول است.
- در باند شبکه همهٔ تنش‌ها با mistuning ≤ ۰٫۲۴ MPa است. EO24 از ۲٫۵ به ۰٫۱ MPa رسید.
- چون EO24 در هر دو CFD به کف نویز رسیده، اندازه‌گیری tip-timing در اولین راه‌اندازی (بخش ۱۲٫۹، بند ۶) عدد واقعی را می‌دهد.

### ۱۲٫۵ تست ۳: دیسک‌ها (`sim/engine/a1000_disc_fea.py`، تقارن محوری CAX6)

مدل:
- نیروی گریز از مرکز + کشش پره‌ها + میدان دمای شعاعی (R1: ۴۵۰ ← ۸۰۰ °C؛ R2: ۴۲۰ ← ۶۹۰ °C).
- دو حل جدا: کل (با تنش حرارتی) و فقط مکانیکی (برای خزش).
- بدون شیار rim.

| | R1 | R2 |
|---|---|---|
| von Mises بیشینه در ۱۵k / trip ۱۶٫۵k | 460 / 521 MPa (۴۵۰ °C) | 466 / 524 MPa (۶۲۷ °C) |
| حاشیهٔ تسلیم در trip | **1.51** | **1.46** |
| ترکیدن (میانگین سطحی تنش محیطی، ۸۵٪ UTS) | **1.81×** دور کار | **1.74×** (لازم ≥ ۱٫۳۴×) |
| خزش (تنش مکانیکی، منحنی حداقل) | 173 MPa @ 800 °C ← **5.1×10⁵ h** | 240 MPa @ 690 °C ← 3.7×10⁷ h |
| LCF روشن‌وخاموش (Manson–Morrow، ضریب ۲ / ۲۰) | 1.7×10⁴ سیکل؛ سکو (Kt 1.3) 3.0×10⁴ | 1.5×10⁴؛ سکو 8.7×10⁵ (لازم ۱۰⁴) |
| رشد شعاعی rim (کل) | 1.94 mm | 1.63 mm |

### ۱۲٫۶ تست ۴: دینامیک روتور (`sim/engine/a1000_rotordynamics.py`)

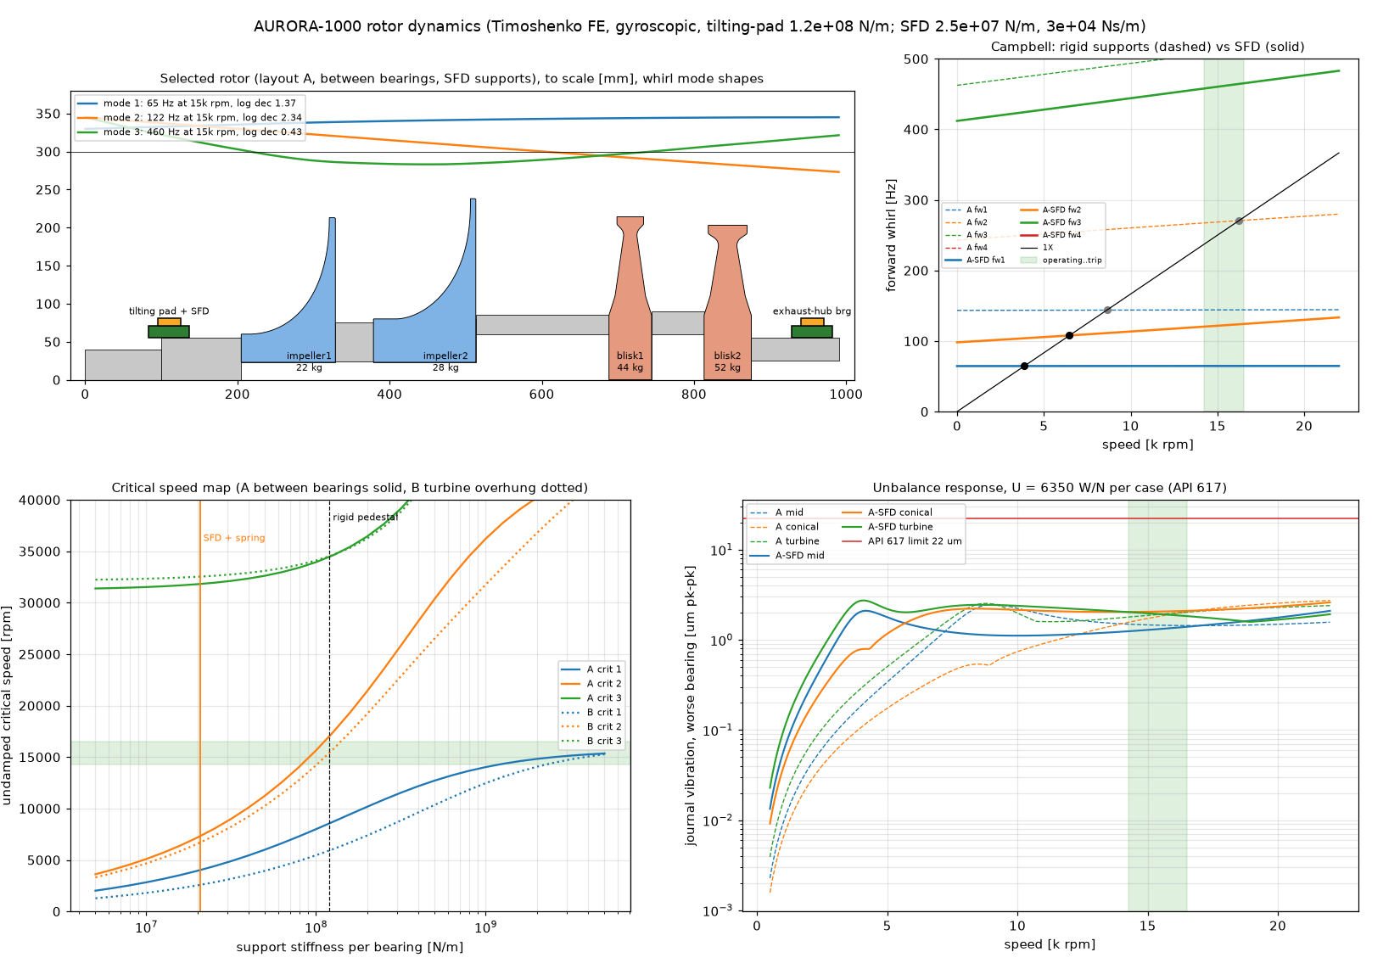
[picture p10: docs/img/a1000_rotordynamics.png]
دینامیک روتور


مدل:
- تیر Timoshenko با اثر ژیروسکوپی، در مختصات مختلط.
- روتور کامل **۱۹۶ kg**: کوپلینگ، collar کف‌گرد، دو پروانه، درام، دو blisk و پیچ مرکزی.
- دو یاتاقان tilting-pad Ø110×55 mm.
- در rev 5 فاصلهٔ دو blisk ۲۳ mm بیشتر شد (R1 ۴ mm جلوتر، R2 ۱۹ mm عقب‌تر).

| | A + SFD (**انتخاب**) | A + SFD با میرایی کم | A با تکیه‌گاه صلب | B: توربین آویزان |
|---|---|---|---|---|
| مودهای صلب [rpm] | 3,964 و 6,780 (AF 2.3 و 1.2) | 3,988 و 7,057 (AF 5.4 و 3.0) | 8,308 و **17,317** (فقط ۹٫۹٪ بالای MCS) | 5,902 و **17,124** (۸٫۷٪) |
| اولین مود خمشی | **23,191 rpm**، حاشیهٔ **۴۷٫۲٪** (API 617: ۲۳٫۹٪) | 22,846، ۴۵٫۱٪ (لازم ۲۵٫۷٪) | > 26,000 | 25,411 |
| ارتعاش نامیزانی API (۹۵٪ تا trip) | **2.5 µm** (حد ۲۲ µm) | 2.6 µm | 1.6 µm | 3.3 µm |

نتیجه: روتور نسبت به دو مود صلب **فوق‌بحرانی** است و هر دو را با میرایی زیاد هنگام راه‌اندازی رد می‌کند. نسبت به مود خمشی **زیربحرانی** است و فاصلهٔ زیادی دارد. مشخصات SFD: Ø150، طول ۳۰ mm، لقی ۰٫۱۵ mm، با فنر قفسه‌ای ۲٫۵×۱۰⁷ N/m.

### ۱۲٫۷ تست ۵: لقی نوک پره در کار

| | R1 | R2 |
|---|---|---|
| رشد rim دیسک (FEA، کل) | 1.94 mm | 1.63 mm |
| کشیدگی پره (FEA) + انبساط حرارتی پره | 0.02 + 0.44 mm | 0.07 + 0.58 mm |
| **رشد کل روتور** | **2.40 mm** | **2.28 mm** |
| لقی سرد / هدف در کار | 0.50 / 0.45 mm | 0.60 / 0.55 mm |
| دمای لازم حلقهٔ نگه‌دارندهٔ shroud (فولاد 1.4828) | **~۵۴۷ °C** | **~۴۹۷ °C** (حد ۶۰۰ °C) |

الزام: حلقهٔ shroud با هوای خروجی کمپرسور تا همین دماها گرم و کنترل شود. shroud از honeycomb سایشی (Hastelloy X) باشد تا برخورد سبک در گذرا بی‌خطر بماند.

### ۱۲٫۸ جمع‌بندی تست‌ها (`sim/engine/a1000_turbine_checks.py`)

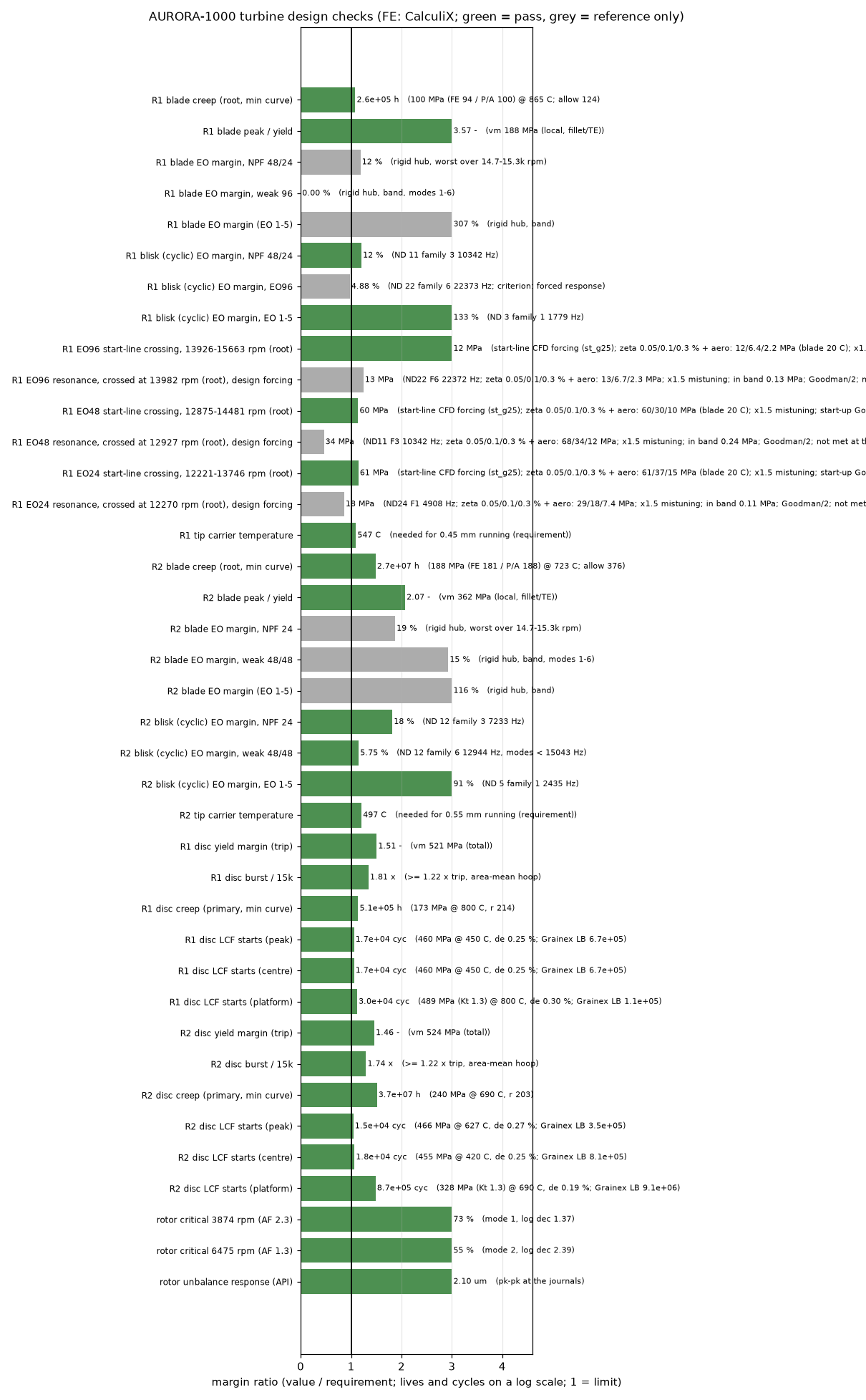
[picture p11: docs/img/a1000_turbine_checks.png]
برگهٔ تست‌ها


**همهٔ ۲۹ معیار قبول شدند** (rev 6 با هندسهٔ CAD، ۲۰۲۶-۱۰-۳۰). ردیف‌های خاکستری فقط برای مقایسه‌اند: حاشیه‌های مدل هاب صلب، حاشیهٔ فرکانسی EO96 و پاسخ با نیروی نقطهٔ طراحی برای عبورهای زیر باند.

- **عبورهای زیر باند (rev 6):** فقط در راه‌اندازی، توقف و trip رخ می‌دهند. با نیروی CFD راه‌اندازی در فاصلهٔ CAD (`st_g25`) و Goodman / 2 حالت عبور (۶۷ تا ۷۵ MPa) سنجیده می‌شوند (بخش ۱۲٫۴٫۲ و ۱۲٫۴٫۳).
- **EO24 روی R1:** ۶۱ / ۳۷ / ۱۵ MPa در برابر ۶۹ MPa. **قبول.** قبلاً با فاصلهٔ rev 5 تنها رد برگه بود (۱۴۳ MPa با بیشترین میرایی).
- **EO48 روی R1:** ۶۰ / ۳۰ / ۱۰ MPa در برابر ۶۹ MPa. قبول.
- **EO96 روی R1:** ۱۲ MPa در برابر ۶۷ MPa. قبول.
- **چرا ۲۹ معیار و نه ۳۰:**
  - ردیف «R1 cyclic، مرتبهٔ ضعیف ۴۸» حذف شد. این ردیف ۲×NGV2 را روی R1 می‌سنجید. میدان پتانسیل ۲×NGV2 در فاصلهٔ هاب ۳۴ mm به ۰٫۰۰۱ می‌رسد (با ۹ mm ۰٫۱۶ بود). زیر آستانهٔ ۰٫۰۵ دیگر مرتبه حساب نمی‌شود. EO48 روی R1 هنوز با ردیف NPF 48 (۱۰٪) و با پاسخ اجباری سنجیده می‌شود.
  - ردیف خاکستری «EO24 با فاصلهٔ پیشنهادی» هم حذف شد، چون حالا خود فاصلهٔ CAD است.
- سرعت‌های بحرانی برگه از مدل تیر (`a1000_rotordynamics.json`): ۳٬۸۷۴ و ۶٬۴۷۵ rpm. نامیزانی API ۲٫۱ µm. مود خمشی این مدل بالای ۲۶٬۰۰۰ rpm است. مدل جزئی روتور در بخش ۱۳٫۹ است.

کم‌حاشیه‌ترین‌ها:
1. R1 در EO24، عبور راه‌اندازی: ۶۱ در برابر ۶۹ MPa (حاشیهٔ ۱۳٪). عدد CFD حد بالاست (کف نویز). tip-timing در اولین راه‌اندازی آن را تأیید می‌کند.
2. R1 در EO48، عبور راه‌اندازی: ۶۰ در برابر ۶۹ MPa. با پرهٔ سرد عبور در ۱۴٬۴۸۰ rpm و نزدیک باند است.
3. R2 در EO48: ۵٫۸٪ در برابر ۵٪ (پاسخ اجباری R2 هنوز حساب نشده).
4. مرتبه‌های قوی: R1 ۱۲٫۱٪ و R2 ۱۸٫۲٪، در برابر ۱۰٪.
5. تنش ارتعاشی مجاز ریشهٔ R1 فقط ۳۲ MPa است، چون خزش ۸۱٪ ظرفیت را مصرف می‌کند.
6. عمر خزشی ریشهٔ R1: ۲٫۶×۱۰⁵ h در برابر هدف ۱۰⁵ (حساس به دادهٔ ماده).
7. LCF دیسک‌ها: R2 ۱٫۵×۱۰⁴ و R1 ۱٫۷×۱۰⁴ سیکل، در برابر ۱۰⁴ روشن‌وخاموش لازم.
8. حاشیهٔ تسلیم دیسک R2 در trip: ۱٫۴۶.

### ۱۲٫۹ الزامات ساخت و طراحی جزئی که از تست‌ها درآمد

1. **ریخته‌گری blisk‌ها:**
   - هر دو blisk از MAR-M247 equiaxed دانه‌ریز، ریخته‌گری دقیق در خلأ، از یک ذوب.
   - **HIP** برای بستن تخلخل.
   - بازرسی پرتونگاری و FPI ۱۰۰٪.
   - لبهٔ فرار ≥ ۱٫۰ mm و فیلت ریشهٔ ۳ / ۳٫۵ mm.
   - **دادهٔ تأییدشدهٔ خزش و LCF** از ریخته‌گر: میله‌های هم‌ذوب و نمونهٔ بریده از قطعه. عمر R1 (۲٫۶×۱۰⁵ h روی منحنی حداقل) به این داده حساس است.
2. **NGVها:**
   - **حلقهٔ کامل ریختگی:** NGV1 با ۴۸ پره (MAR-M247 + پوشش آلومینایدی + TBC) و NGV2 با ۲۴ پره.
   - اگر ریخته‌گر حلقهٔ کامل را نپذیرد، هر دو قابل سگمنت‌اند، مثلاً NGV1 در ۸ سگمنت ۶‌پره‌ای و NGV2 در ۸ سگمنت ۳‌پره‌ای. در این حالت درزهای سگمنت مسیر نشتی‌اند و آب‌بندی (strip seal) لازم دارند.
   - پره‌های NGV2 ضخیم‌اند (۱۴ mm). ترک خستگی حرارتی لبهٔ فرار در گذرا باید با تحلیل حرارتی گذرا چک شود.
3. **ماشین‌کاری:**
   - کوپلینگ‌های Curvic.
   - سنگ‌زنی نوک پره‌ها تا قطر نهایی.
   - بالانس دینامیکی هر blisk و بعد روتور کامل (G2.5).
   - **شیار rim لازم نیست.**
4. **هوای ثانویه:**
   - حلقهٔ shroud در ~۵۵۰ / ۵۰۰ °C نگه داشته شود.
   - دمای سکوی R1 ≤ ۸۰۰ °C (فرض FEA دیسک).
   - این دماها باید با تحلیل حرارتی مزدوج (CHT) تأیید شوند.
5. **یاتاقان‌ها:**
   - tilting-pad Ø110 با preload ~۰٫۳، روی SFD + فنر قفسه‌ای.
   - یاتاقان عقب در هاب دیفیوزر اگزوز با ۵ پایه.
6. **پایش و تست:**
   - دو پراب مجاورتی در هر یاتاقان؛ هشدار ~۲۵ µm و trip ~۴۰ µm (API 670).
   - در اولین تست موتور: **tip-timing روی هر دو blisk** (EO24، 48، 96 و EO 1–5) و جاروی دور ۱۴٬۵۰۰ تا ۱۵٬۵۰۰ rpm.
   - روی R1، tip-timing در راه‌اندازی هم لازم است: عبور EO24 در ~۱۲٬۲۲۰ تا ۱۳٬۷۵۰ (بسته به دمای پره)، EO48 در ~۱۲٬۹۰۰ تا ۱۴٬۴۸۰ و EO96 در ~۱۳٬۹۸۰ rpm (بخش ۱۲٫۴٫۲). روی R2 هم عبورهای EO24 در ~۶٬۴۴۰ و ~۱۱٬۳۱۰ rpm.
   - میرایی واقعی مود F1 از همین اندازه‌گیری درمی‌آید و حاشیهٔ فاصلهٔ +۲۵ mm را تأیید می‌کند.
7. **فاصلهٔ R1 تا NGV2 (rev 6):** ۲۵ mm بیشتر از rev 5، یعنی ۳۴ / ۳۸ / ۴۲ mm (هاب / میانه / نوک). **در CAD اعمال شد** (بخش ۱۲٫۴٫۳): توربین، روتور (فاصله‌انداز R1–R2، بخش ۱۳٫۹)، بخش داغ (بخش ۱۴٫۱) و پکیج.
   - تست ضربه (ping test) هر blisk بعد از ماشین‌کاری، برای مقایسه با فرکانس‌های این گزارش. هر دو blisk باید از نظر mistuning یکسان و کنترل‌شده باشند.

### ۱۲٫۱۰ محدودیت‌ها و قدم بعدی

- **داده‌های ماده:** تیپیک‌اند و منحنی خزش از داده‌های منتشرشده بازسازی شده است (بخش ۱۲٫۳). داده‌های تأییدشدهٔ ریخته‌گر جای آن را می‌گیرند.
- **میدان دما فرضی است:** پره در دمای نسبی گاز، دیسک با قانون توانی. CFD ردیف‌ها و CHT دیسک و shroud قدم بعدی است.
- **پاسخ اجباری R1 (بخش ۱۲٫۴٫۱)** با CFD دوبعدی مقطع میانی حساب شده است. محدودیت‌ها:
  - نیرو روی همهٔ ارتفاع پره یکسان و هم‌فاز فرض شده (برآورد بالا).
  - گام R1 در CFD ۱٫۷٪ کوچک‌تر است. اختلاف دو دورهٔ نمونه‌برداری ۱۰ تا ۱۶٪ است.
  - میرایی آیرودینامیک فقط با piston theory است (برای مود F1 احتمالاً کمتر از واقعی).
  - مودها بدون بازوهای فلنج rev 1 روتور (بخش ۱۳) حل شده‌اند. اثرشان روی ND 11، 22 و 24 کم است.
  - شرایط راه‌اندازی در rev 6 با CFD خود خط راه‌اندازی جایگزین شد (بخش ۱۲٫۴٫۲). خود خط راه‌اندازی با نقشهٔ عمومی کمپرسور ساخته شده و با نقشهٔ واقعی (بخش ۱۵) باید دوباره حساب شود.
  - اثر فاصلهٔ بیشتر با CFD دوبعدی مقطع میانی دیده شده است. در هاب گام NGV2 کوچک‌تر و فاصله کمتر است، در نوک برعکس.
  - پاسخ اجباری R2 (EO24، EO48) هنوز حساب نشده است.
- **EO24 روی R1 (rev 6):** فاصلهٔ +۲۵ mm انتخاب شد (بخش ۱۲٫۴٫۲) و در CAD اعمال شد (بخش ۱۲٫۴٫۳). CFD راه‌اندازی و نقطهٔ طراحی با هندسهٔ CAD دوباره اجرا شدند. مودهای cyclic R1 و R2 عوض نمی‌شوند، چون هندسهٔ blisk‌ها فقط جابه‌جا شده است. بستهٔ Fusion هنوز با هندسهٔ جدید ساخته نشده است (فایل‌های STEP آماده‌اند).
- **عبورهای راه‌اندازی که هنوز حساب نشده‌اند:** R1 در EO48 روی ND11 F1 و F2 (~۶٬۰۳۰ و ~۱۰٬۳۷۰ rpm)، و R2 در EO24 (دنبالهٔ NGV2) روی ND12 F1 و F2 (~۶٬۴۴۰ و ~۱۱٬۳۱۰ rpm). برای R2 یک CFD با ردیف R2 لازم است.
- **مودهای حل‌نشده:**
  - مودهای بالای R2 در ND 15–18 حل نشده‌اند، چون هیچ مرتبه‌ای از طرح فعلی به آن‌ها نمی‌رسد.
  - هارمونیک سوم NGV2 (۳×۲۴ = ۷۲ = ۲×۳۶) روی R2 قطر گرهی صفر را در ۱۸ kHz تحریک می‌کند. این بالای محدودهٔ چک ضعیف است و مودهای ND0 در این فرکانس حل نشده‌اند.
- **قدم بعد:**
  - CFD سه‌بعدی دو پله (راندمان، زاویه‌ها، گلوگاه، نیروی ناپایا).
  - CHT هوای ثانویه.
  - تحویل قطعات به فیوژن برای نقشه‌های ساخت (`fusion/A1000`، `fusion/HANDOFF.md`).

## ۱۳. روتور و یاتاقان‌ها، rev 1 (۲۰۲۶-۱۰-۳۰)

هندسه: `cad/engine/a1000_rotor.py` · محاسبه: `sim/engine/a1000_rotor_stack.py` (نتایج: `sim/engine/fea/a1000_rotor_stack.json`) · فیوژن: «AURORA-1000 Rotor and Bearings rev1» (کامل و نیم‌برش)

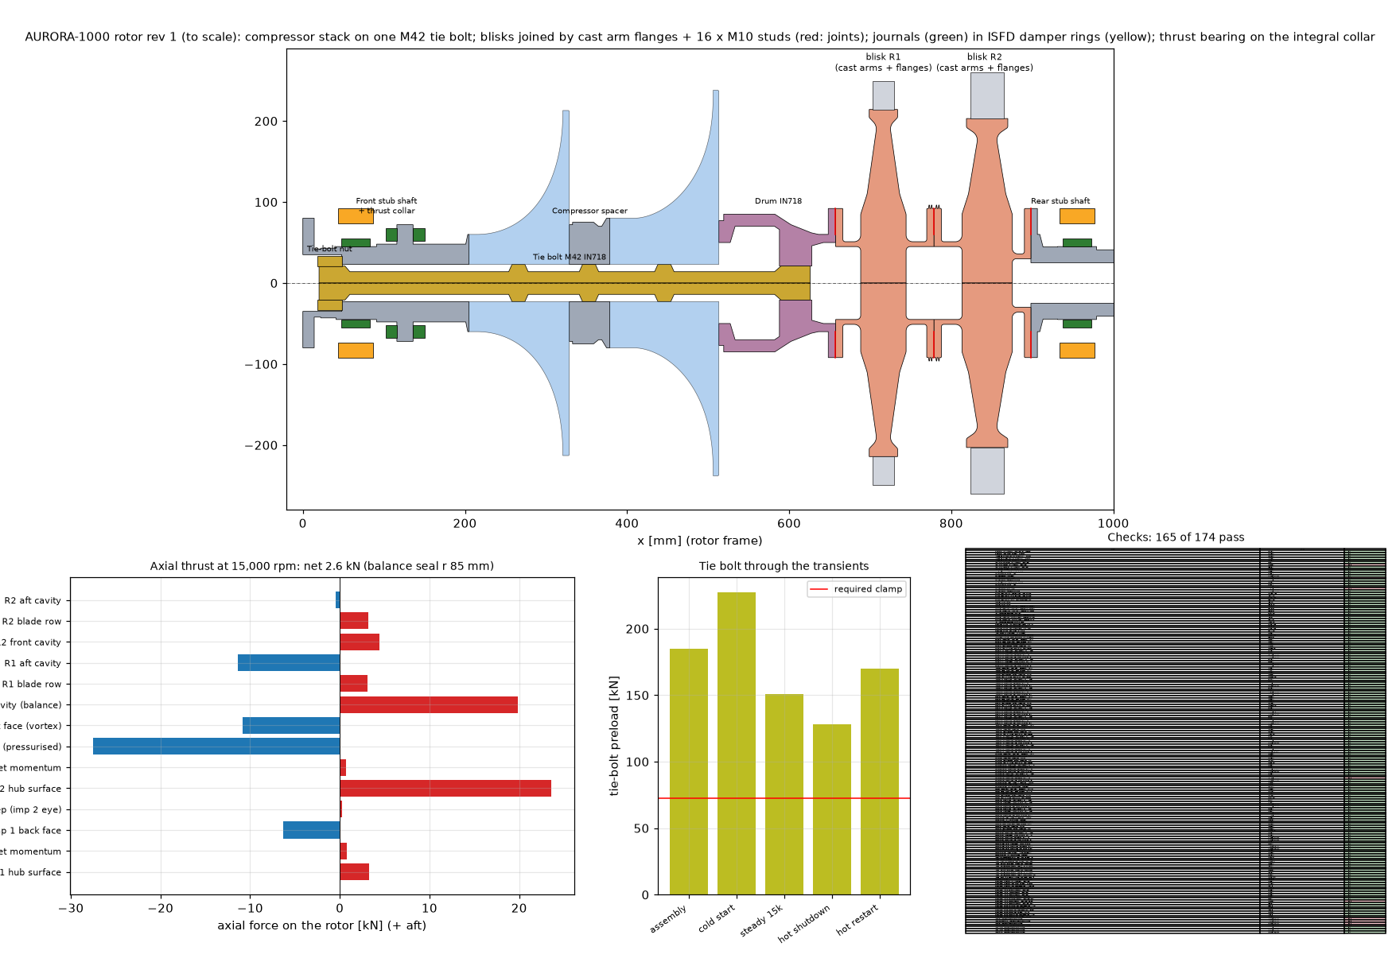
[picture p12: docs/img/a1000_rotor_stack.png]
روتور و چک‌ها


### ۱۳٫۱ مشکل اتصال blisk‌ها و راه‌حل

دیسک‌های rev 5 سوراخ وسط ندارند (bore-less). پس پیچ مرکزی نمی‌تواند از توربین رد شود. سوراخ‌دار کردن دیسک با FEA تست شد و رد شد:

| دیسک (۱۵٬۰۰۰ rpm) | تنش بیشینه | حاشیهٔ تسلیم در trip | عمر LCF |
|---|---|---|---|
| بدون سوراخ (rev 5) | ۴۵۸ / ۴۶۶ MPa | ۱٫۵۱ / ۱٫۴۶ | ۱٫۸×۱۰⁴ / ۱٫۵×۱۰⁴ |
| سوراخ Ø50 | ۹۱۹ / ۹۱۴ MPa | ۰٫۷۵ | ~۲۰۰ |
| سوراخ Ø50 + توپی ۳۰ mm پهن‌تر | ۷۷۱ / ۷۸۰ MPa | ۰٫۹۰ | ~۷۰۰ |

**راه‌حل:**
- هر blisk دو طرف هاب یک **بازوی کوتاه ریختگی** دارد (r 58–66) که به یک **فلنج** (r 58–92، ضخامت ۹ mm) می‌رسد.
- فلنج‌ها با **کوپلینگ Curvic پیچی** (۴۸ دندانه، r 62–90) و **۱۶ استاد M10 از IN718** به هم بسته می‌شوند: درام ← R1 ← R2 ← شفت عقب.
- مهره‌ها در فضای ۱۳ mm پشت هر فلنج‌اند و از بین ردیف پره‌ها شعاعی در دسترس‌اند. پس روتور بیرون از موتور مونتاژ و بالانس می‌شود.
- **نتیجه برای بقیهٔ طرح:** بدنهٔ توربین باید **افقی دوتکه** باشد و هر دو حلقهٔ NGV **دو نیمه** شوند. بخش ۱۲٫۹ اجازهٔ سگمنت را داده بود.
- جرم هر blisk حدود ۳٫۲ kg بیشتر می‌شود (R1 ۴۵٫۶، R2 ۵۰٫۷ kg برای دیسک با بازو).

FEA محوری دیسک با بازوها (CalculiX):

| | R1 | R2 | معیار |
|---|---|---|---|
| حاشیهٔ تسلیم در trip | ۱٫۳۹ | ۱٫۴۰ | ≥ ۱٫۰ |
| ترکیدن / ۱۵k | ۱٫۸۶ | ۱٫۷۸ | ≥ ۱٫۳۴ |
| LCF مرکز هاب | ۲٫۰×۱۰⁴ | ۲٫۰×۱۰⁴ | ≥ ۱۰⁴ |
| LCF ریشهٔ بازو (فیلت ۸ mm) | ۱٫۶×۱۰⁴ | ۱٫۶×۱۰⁴ | ≥ ۱۰⁴ |
| LCF سوراخ استاد (hoop ۱۲۲ MPa × Kt 2.6) | ۴×۱۰⁵ | ۳×۱۰⁵ | ≥ ۱۰⁴ |

### ۱۳٫۲ بخش کمپرسور: پیچ مرکزی

- **پیچ M42×3 از IN718** با ساق باریک‌شدهٔ Ø28 (برای انعطاف). از مهرهٔ جلوی شفت تا یک دیوارهٔ رزوه‌دار داخل درام می‌رود.
- **ترتیب قطعات:** شفت جلو (یاتاقان ۱ + فلنج کف‌گرد یکپارچه)، پروانهٔ ۱، فاصله‌انداز، پروانهٔ ۲، درام IN718.
- همهٔ اتصال‌ها **Curvic با ۳۶ دندانه** هستند. Curvic مرکزیت و گشتاور را منتقل می‌کند. سوراخ Ø46 پروانه‌ها چیزی را مرکز نمی‌کند.

| حالت | نیروی پیش‌بار |
|---|---|
| مونتاژ | ۱۸۵ kN |
| شروع سرد (پیچ هنوز سرد) | ۲۲۷ kN |
| کار دائم ۱۵k (با کوتاه‌شدن پواسونی هاب‌ها) | ۱۵۱ kN |
| خاموشی داغ | ۱۲۸ kN (کمترین) |
| **لازم** (گشتاور اتصال کوتاه ژنراتور ۵×، خمش ۳g، بار محوری) | **۷۱ kN** → ضریب ۱٫۸ |

- **تنها مورد رد:** Curvic جلوی **پروانهٔ ۱ اگر آلومینیومی بماند**: فشار دندانه ۲۳۲ MPa در برابر ۱۸۳ مجاز. با **Ti-6Al-4V** حاشیه کافی است (۰٫۴۷). پیشنهاد: پروانهٔ ۱ تیتانیوم، یا کوپلینگ محدودکنندهٔ گشتاور سمت ژنراتور. تصمیم با طراحی کمپرسور است.
- اندازهٔ Curvic‌ها با طراحی جزئی پروانه‌ها هماهنگ شد (هاب ورودی r 60 / 80).

### ۱۳٫۳ نیروی محوری و تعادل

- بدون تعادل، نیروی خالص **۱۲٫۵ kN** به عقب بود و یاتاقان کف‌گرد ۵۴ kW تلف می‌کرد.
- **راه‌حل:** پشت پروانهٔ ۲ یک لابیرنت در r 200 گذاشته شد. هوای خروجی کمپرسور در r 120 به حفرهٔ پشت پروانه دمیده می‌شود. همین هوا از آب‌بند درام (r 85) به حفرهٔ جلوی توربین می‌رود و purge لازم آن را هم می‌دهد.
- نیروی خالص: **۴٫۱ kN** در بار کامل، ۲٫۴ kN در ۶۰٪ و ۰٫۶ kN در بی‌باری.

### ۱۳٫۴ یاتاقان‌ها

| | مشخصه | نتیجه |
|---|---|---|
| ژورنال ۱ و ۲ | tilting-pad، ۵ پد، بار بین پدها، D100 × 45، preload 0.3، لقی ۷۰ µm (بخش ۱۳٫۱۰: D90 × 36؛ بخش ۱۹: **۴ پد × ۶۵°** تا درز افقی بین پدها بیفتد) | بار ۰٫۲۱ / ۰٫۳۵ MPa، فیلم ≥ ۶۴ µm، تلفات ۶٫۷ kW هر کدام، روغن ۱۲ l/min |
| دمپر | **ISFD** (حلقهٔ یکپارچهٔ واير‌کات با ۸ فنر S)، D160 × 35، لقی ۰٫۱۳ mm | سختی 3.1e7 N/m، میرایی 4.7e4 (فیلم کامل) / 2.4e4 Ns/m (π-film)، تنش فنر ۱۳۹ MPa متناوب |
| کف‌گرد | ۲ × ۸ پد، r 56–78، فلنج یکپارچه روی شفت جلو | ۰٫۸۲ MPa در ۱٫۵ × بار بیشینه، فیلم ۴۸ µm، تلفات ۱۳٫۴ kW |

- ژورنال ۱ پانزده mm جلوتر رفت (x 95) تا کف‌گرد پشتش جا شود.
- یاتاقان ۲ در هاب اگزوز است. محفظه‌اش باید عایق حرارتی و هوای بافر داشته باشد (طراحی بدنهٔ اگزوز).

### ۱۳٫۵ دینامیک روتور با هندسهٔ جزئی

روتور ۱۸۳ kg است. سختی پدها از مدل یاتاقان آمده و ISFD سری با آن است.

| حالت | سرعت‌های بحرانی | ارتعاش API |
|---|---|---|
| اسمی | ۴٬۱۰۰ (AF 2.3)، ۸٬۳۰۰، ۲۳٬۴۰۰ rpm (حاشیه ۴۹٪ / لازم ۲۴٪) | ۳٫۱ µm (حد ۲۲) |
| دمپر π-film | ۴٬۰۴۰، ۷٬۸۰۰، ۲۲٬۹۰۰ rpm (حاشیه ۴۵٪ / لازم ۲۵٪) | ۳٫۱ µm |

### ۱۳٫۶ تلفات و اثر بر راندمان

- تلفات یاتاقان‌ها و آب‌بندها **~۲۹ kW** است. اندازه‌های اولیه (یاتاقان‌های D110 و کف‌گرد بزرگ بدون تعادل) ۷۶ kW می‌دادند.
- محاسبهٔ سیکل (`eta_mech` = 0.994) فقط ~۶ kW در نظر گرفته بود. فرق آن حدود **۰٫۸ واحد درصد راندمان برق** است و باید در meanline اصلاح شود.
- روغن لازم برای یاتاقان‌ها ~۴۷ l/min است (بدون گیربکس).

### ۱۳٫۷ وضعیت و قدم بعد

- **۳۲ از ۳۳ چک قبول.** تنها رد: Curvic پروانهٔ ۱ با آلومینیوم (بخش ۱۳٫۲).
- **باز:**
  1. هندسهٔ CAD توربین (`cad/engine/a1000_turbine.py`) هنوز بازوها را ندارد. بازوها در `a1000_rotor.py` اضافه شده‌اند. تحلیل cyclic blisk‌ها با بازوها باید دوباره اجرا شود (اثر کم روی مودهای پره، اثر روی ND 0–1).
  2. بدنهٔ افقی دوتکه و NGVهای دونیمه.
  3. FEA سه‌بعدی Curvic‌ها و حلقهٔ ISFD.
  4. تحلیل حرارتی گذرا برای دمای پیچ مرکزی.
  5. بعد از آمدن هندسهٔ نهایی پروانه‌ها: دوباره اجرای نیروی محوری و دینامیک روتور.

## ۱۴. بخش داغ توربین، rev 1 (۲۰۲۶-۱۰-۳۰)

هندسه: `cad/engine/a1000_hot_section.py` · محاسبه: `sim/engine/a1000_hot_section_calc.py` (نتایج: `sim/engine/fea/a1000_hot_section.json`) · فیوژن: داخل «AURORA-1000 Package rev5»

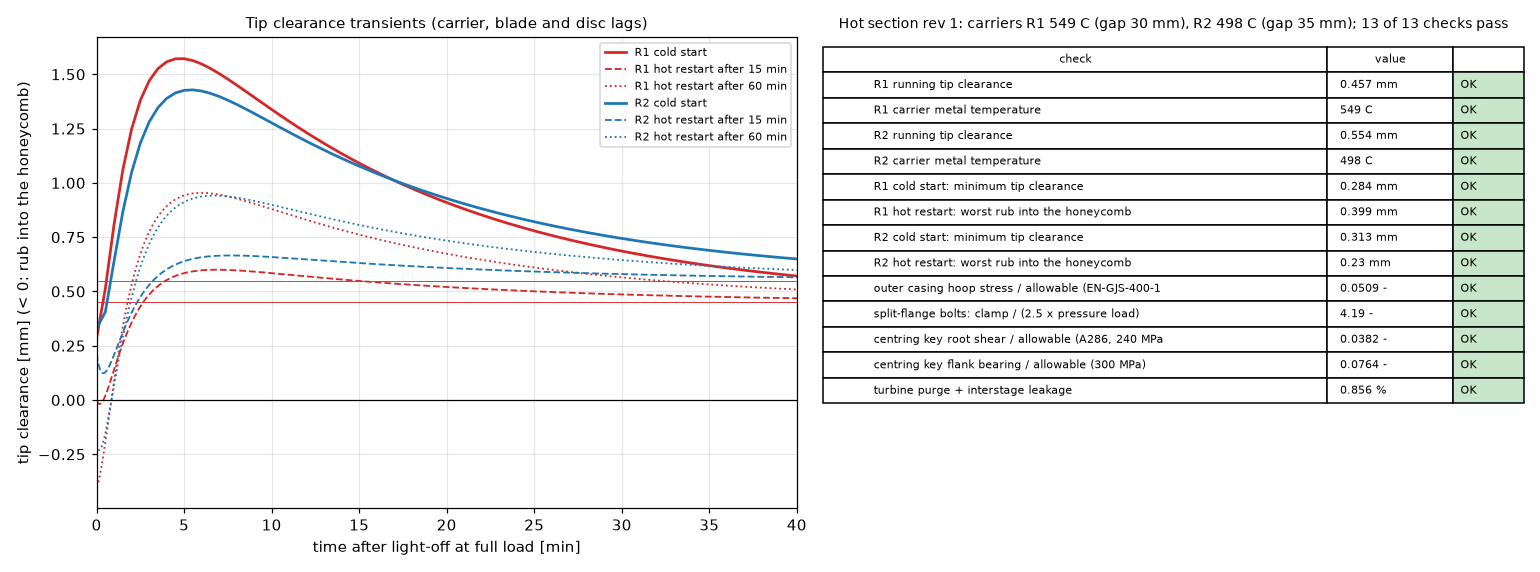
[picture p13: docs/img/a1000_hot_section.png]
بخش داغ


**چرا این شکل:** روتور rev 1 یکجا بیرون موتور مونتاژ و بالانس می‌شود (بخش ۱۳). پس بخش ثابت باید دورش باز شود.

| قطعه | جنس | کار |
|---|---|---|
| بدنهٔ بیرونی، **افقی دوتکه** (۲ × ۵۳ kg) | چدن نشکن EN-GJS-400-18LT | فشار، گشتاور NGVها و نیروی محوری را می‌گیرد. داخلش هوای خروجی کمپرسور (۳٫۸ bar، ۱۷۵ °C) در راه recuperator جریان دارد، پس بدنه سرد می‌ماند. |
| حلقه‌های نگه‌دارنده C1 و C2 (۱۲ و ۲۳ kg)، دونیمه | 1.4828 | NGV1 و shroud پلهٔ ۱ / NGV2 و shroud پلهٔ ۲. داغ کار می‌کنند و روی **۸ پین شعاعی** شناورند (بخش ۱۹: پین‌ها نصب‌شدنی نبودند؛ حالا **۴ کلید شعاعی**). |
| shroud لانه‌زنبوری ۴ mm روی پشت‌بند ۳ mm | Hastelloy X | سایش‌پذیر؛ در تماس پره‌ها خورده می‌شود و پره آسیب نمی‌بیند. |
| دیافراگم جلو و میانی، دونیمه | Hastelloy X | آب‌بند لانه‌زنبوری در r 93–96 روی فلنج‌های روتور |
| حلقه‌های NGV | | با وایرکات به دو نیمه بریده می‌شوند. درز با strip seal بسته می‌شود. |

**لقی نوک پره:**
- لقی کاری فقط وقتی به هدف (۰٫۴۵ / ۰٫۵۵ mm) می‌رسد که حلقه‌ها در **۵۴۷ و ۴۹۷ °C** کار کنند.
- بیرون حلقه‌ها کانالی است که هوای کمپرسور از آن رد می‌شود. پهنای کانال طوری انتخاب شد که این دماها دقیقاً حاصل شود: **۳۰ mm برای C1 و ۳۵ mm برای C2**.
- نتیجه: C1 در ۵۴۹ °C و لقی ۰٫۴۶ mm؛ C2 در ۴۹۸ °C و لقی ۰٫۵۵ mm. افت فشار هوای کمپرسور ۰٫۰۲–۰٫۰۴ ٪ است.

**گذرا:**
- **شروع سرد:** حلقه‌ها (ثابت زمانی ~۱۰۰ s) زودتر از دیسک (~۹۰۰ s) گرم می‌شوند. کمترین لقی ۰٫۲۸ mm است، پس تماسی نیست.
- **روشن کردن دوباره در حالت داغ:** اگر بین ۱۵ دقیقه تا ۲ ساعت بعد از خاموشی روشن شود، دیسک هنوز داغ است ولی حلقه سرد شده. پره حداکثر **۰٫۴ mm** در لانه‌زنبوری می‌ساید.
- **پیشنهاد:** در کنترل یک **مهلت قفل روشن‌شدن** گذاشته شود: بین ۱۵ دقیقه تا ۲ ساعت بعد از توقف، فقط بعد از چرخاندن خنک‌کننده با استارتر روشن شود. هر سایش، لقی کاری را دائم بیشتر می‌کند و راندمان را کم می‌کند.

**سایر چک‌ها (همه قبول، ۱۲ از ۱۲):**
- تنش حلقوی بدنهٔ بیرونی ۴ MPa.
- پیچ‌های درز افقی: ۳ × M16 در هر طرف (ضریب ۴٫۷).
- تنش برشی پین‌ها ۷ MPa. (بخش ۱۹: با ۴ کلید، برش ۹ MPa و فشار سطح ۲۳ MPa؛ ۱۳ از ۱۳.)
- حلقه‌ها در حالت داغ ۲٫۲ mm روی پین‌ها شعاعی جابه‌جا می‌شوند.
- نیروی محوری هر NGV ۳٫۴ kN و گشتاورشان ۶۵۰ / ۶۷۰ Nm است.

**هوای ثانویه (لابیرنت با لقی ۰٫۳ mm):**
- آب‌بند تعادل درام: ۰٫۵۸ ٪ هوا. همین هوا purge حفرهٔ جلوی توربین است.
- آب‌بند میانی: ۰٫۲۷ ٪.
- آب‌بند پشت پروانهٔ ۲: ۱٫۳۷ ٪. این هوا به خروجی پروانه برمی‌گردد و اتلافش کم است (~۲ kW).

**باز:**
1. منیفولد هوا در انتهای بدنه که هوای کمپرسور را به recuperator می‌برد (همراه طراحی اگزوز). **انجام شد: بخش ۱۸ (EX-401).**
2. شکل نهایی اسکرول ورودی NGV1 و اتصالش به C1.
3. تحلیل حرارتی دقیق (CHT) حلقه‌ها و دیافراگم‌ها.
4. strip seal درز NGVها.

### ۱۴٫۱ rev 6: فاصلهٔ +۲۵ mm بین R1 و NGV2 (۲۰۲۶-۱۰-۳۰)

- NGV2، shroud پلهٔ ۲ و C2 ۲۵ mm عقب رفتند.
- **بدنهٔ بیرونی:** x 678–878 ← **x 678–903**. هر نیمه ۵۳ ← ۵۸ kg.
- **C1 و پین‌ها جابه‌جا نشدند.** صفحهٔ پین در همان x 733.8 پشت R1 ماند. پس C1 همان قطعهٔ rev 1 است و C2 کل ۲۵ mm را می‌گیرد: x 734–875، ۲۳ ← ۲۷ kg. قلاب NGV2 روی حلقهٔ بیرونی NGV2 در جای جدیدش است.
- **دیوارهٔ مسیر گاز در فاصله:** فاصلهٔ باز بین shroud R1 و حلقهٔ NGV2 از ۲ به ۲۷ mm رسید. دو قطعهٔ جدید آن را می‌بندند:
  - **HS-222 پوشش بیرونی** (Hastelloy X، ۳ mm، ۲٫۰ kg) روی خط نوک، از shroud R1 تا حلقهٔ NGV2، با یک جان به سوراخ C2.
  - **HS-234 حلقهٔ داخلی** (Hastelloy X، ۳ mm، ۱٫۱ kg) روی خط هاب، ۱٫۵ mm پشت سکوی R1 (rim seal) تا حلقهٔ داخلی NGV2، با فلنج پیچی به جلوی آن.
  - ارتفاع کانال در فاصله تقریباً ثابت است (۳۸٫۱ ← ۳۸٫۲ mm). بقیهٔ مسیر همان rev 5 است (بخش ۱۲٫۴٫۳).
- **دیافراگم میانی:** آب‌بند لانه‌زنبوری حالا روی ۴ تیغهٔ حلقهٔ فاصله‌انداز روتور است (x 768–789، بخش ۱۳٫۹). همان r 92.6–96 و لقی ۰٫۳ mm. دیافراگم جلو تغییر نکرد.
- **بدنهٔ فشار اسکرول** (بخش ۱۶) به فلنج عقب همین بدنه پیچ می‌شود و ۲۵ mm بلندتر شد (x 430–928). خود اسکرول و NGV1 تکان نخوردند.
- **چک‌ها: ۱۲ از ۱۲ قبول.**
  - پیچ‌های درز افقی: باز هم ۳ × M16 در هر طرف. ضریب ۴٫۷ ← **۴٫۲** (نیروی درز ۱۲٫۵٪ بیشتر).
  - پین‌ها: وزن بخش داغ داخلی ۷۰ ← ۷۷ kg. تنش برشی ۷٫۵ ← ۷٫۶ MPa.
  - لقی نوک، گذراها، تنش بدنه و هوای ثانویه عوض نشدند.
- **تداخل** (FreeCAD، همهٔ قطعات روتور در برابر قطعات ثابت و NGVها): قطعات جدید یا جابه‌جاشده هیچ تداخلی ندارند.
  - یک تداخل قدیمی پیدا شد که به این تغییر ربطی ندارد: سکوی جلوی R1 و حلقهٔ داخلی NGV1 ۰٫۵ mm محوری روی هم می‌روند (از rev 5). علت: PLAT_OVH ۴٫۵ + ext حلقه ۴ = ۸٫۵ mm، بیشتر از GAP1 = ۸ mm.

## ۱۵. طراحی جزئی کمپرسور: دو پروانه با پرهٔ خط‌کشی‌شده، دیفیوزر و کانال برگشت (rev 1، ۲۰۲۶-۱۰-۳۰)

درخواست: کمپرسور از «پوستهٔ meanline» به طرح قابل ساخت برسد؛ قطعات ساده و مناسب CNC باشند و نتیجه در فیوژن دیده شود.

- **طراحی آیرودینامیکی:** `cad/engine/a1000_impeller.py` (نتایج: `sim/a1000_impeller_design.json`).
- **CAD در FreeCAD:** همان فایل با `--cad` و `--sector`.
- **تست‌ها با CalculiX:** `sim/engine/a1000_impeller_fea.py`.
- **دینامیک روتور:** `sim/engine/a1000_rotordynamics.py`.
- **فیوژن:** «AURORA-1000 Compressor rev1» و «AURORA-1000 Package rev5».
- رابط‌ها با پشتهٔ روتور بخش ۱۳ یکی است:
  - سوراخ Ø46 برای پیچ M42؛
  - Curvic پروانهٔ ۱: جلو r 44–58، عقب r 50–70؛
  - Curvic پروانهٔ ۲: جلو r 52–72، عقب r 55–75؛
  - سطوح x = 205.0 / 328.76 / 378.76 / 513.27.

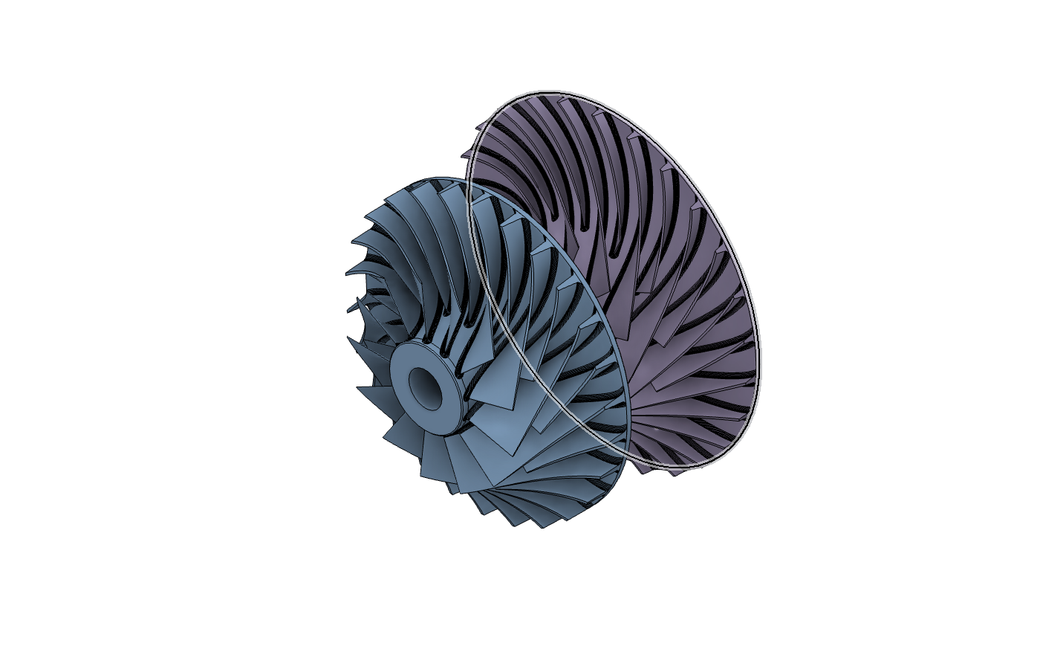
[picture p14: docs/img/a1000_impeller_fusion.png]
پروانه‌ها در فیوژن


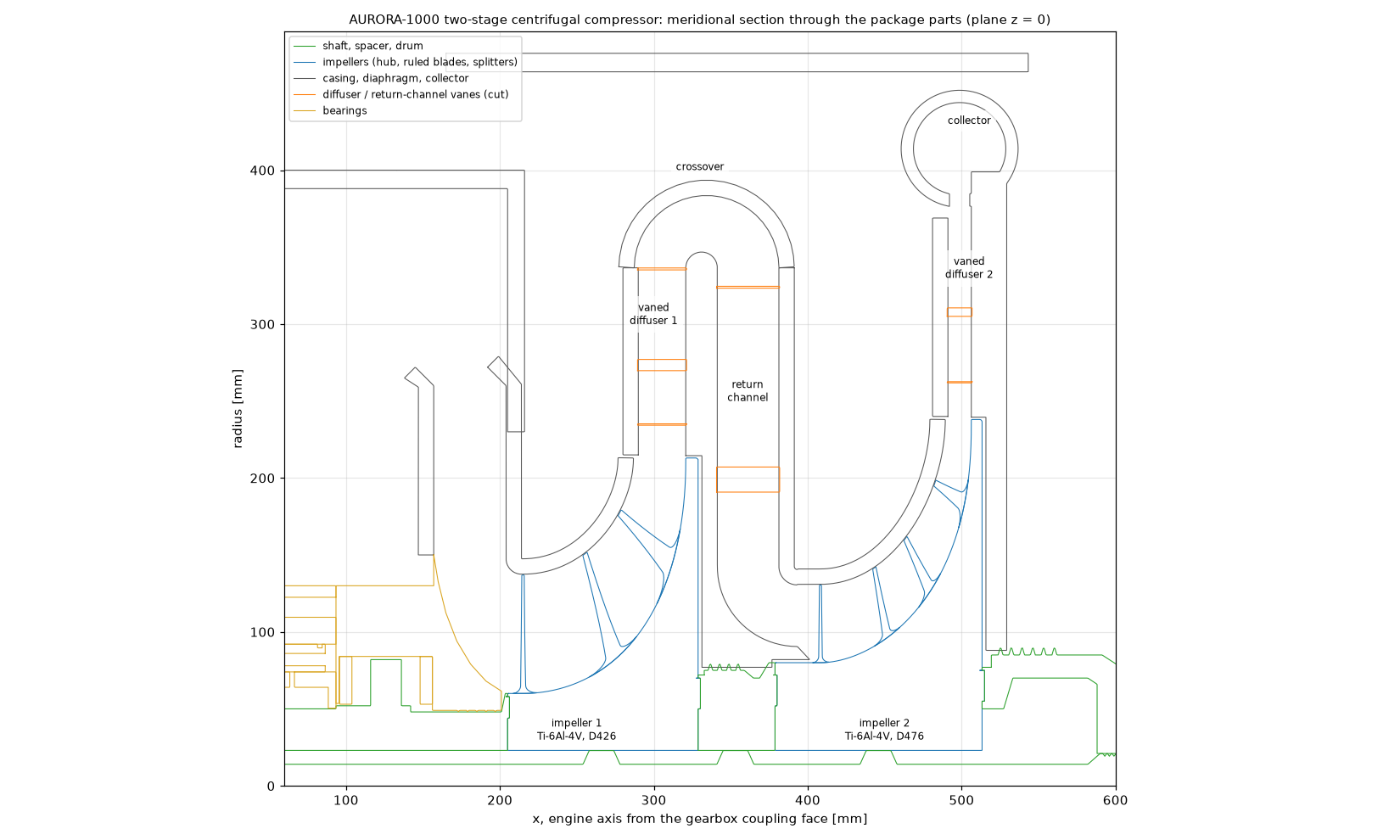
[picture p15: docs/img/a1000_compressor_section.png]
مقطع کمپرسور


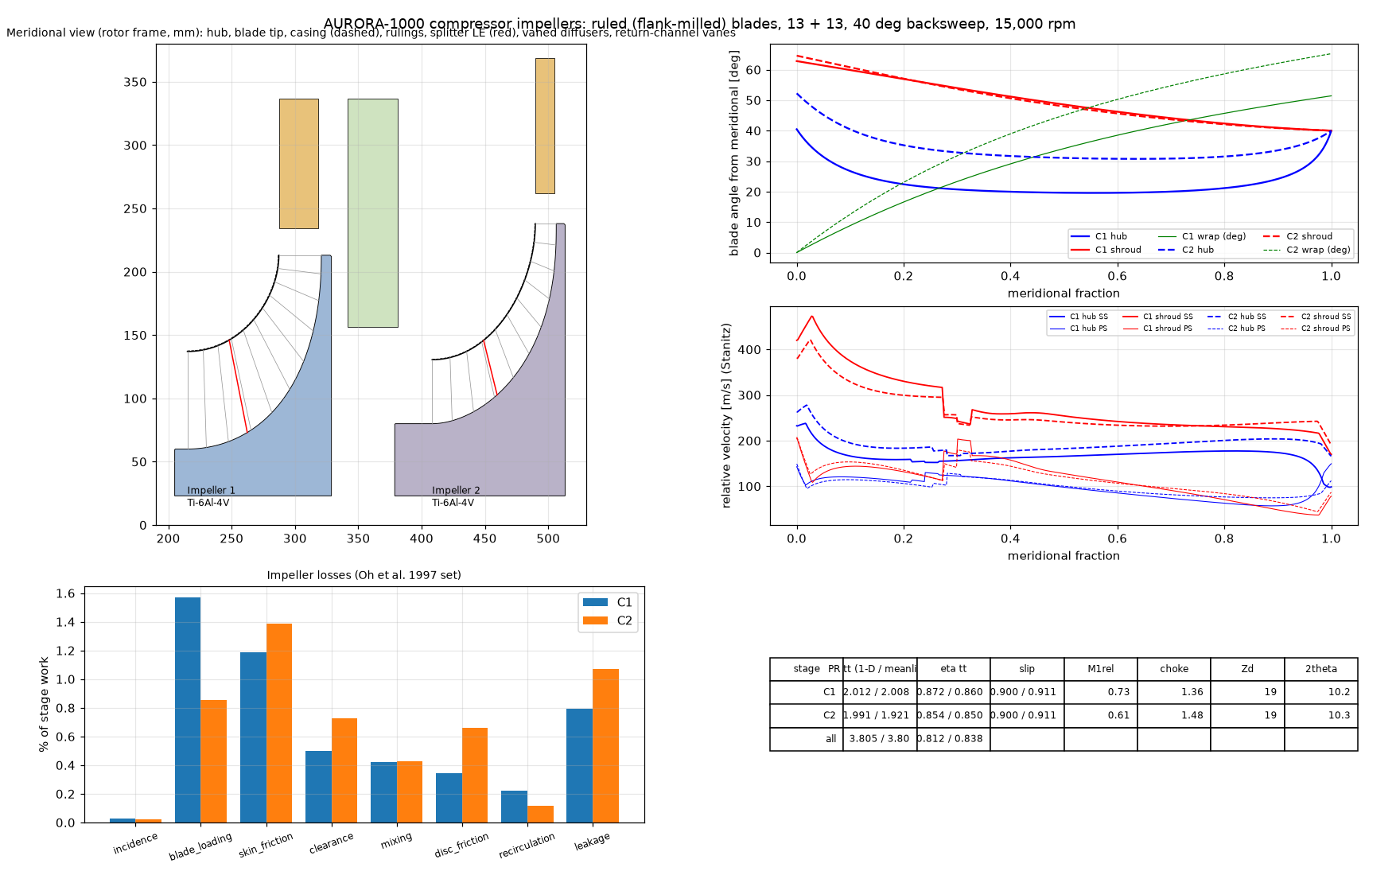
[picture p16: docs/img/a1000_impeller_design.png]
طراحی پروانه‌ها


### ۱۵٫۱ یافتهٔ اصلی ۱: با D2 مقدار meanline، نسبت فشار نمی‌رسد

- meanline کار پروانه را با `σ·(1 − φ2·tanβ2)` حساب کرده است.
- ضریب لغزش Wiesner این‌طور تعریف شده: `σ = 1 − c_slip/U2`، یعنی `c_θ2 = σ·U2 − c_m2·tanβ2`. در φ2 = 0.28 این حدود **۳٪ کار کمتر** می‌دهد.
- دو اثر دیگر:
  - splitterها از ۳۰٪ طول شروع می‌شوند، پس تعداد مؤثر پره ۲۲٫۱ است نه ۲۶ (σ = 0.900 به جای 0.911).
  - انسداد واقعی خروجی پره‌ها (ضخامت ۲٫۲ تا ۶ mm) حدود ۱۵٪ است نه ۸٪.
- نتیجه با D2 = 413 / 448 mm: نسبت فشار ۱٫۸۷ / ۱٫۸۳ و کل **۳٫۲۹ به جای ۳٫۸**.
- **تصمیم:** backsweep ۴۰°، ۱۳ + ۱۳ پره و ۱۵٬۰۰۰ rpm ثابت ماند. D2 آن‌قدر بزرگ شد که:
  - پلهٔ ۱ در خروج دیفیوزر به PR 2.008 برسد؛
  - فلنج کلکتور پلهٔ ۲ به ۳٫۸ برابر فشار ورودی برسد.
  - b2 از φ2 = c_m2/U2 = 0.30 به دست آمد.

| | meanline | طرح جزئی rev 1 |
|---|---|---|
| پلهٔ ۱ | D2 413، U2 324 m/s، b2 35.4 | **D2 426 mm، U2 334 m/s، b2 33.5 mm** |
| پلهٔ ۲ | D2 448، U2 352 m/s، b2 19.4 | **D2 476 mm، U2 374 m/s، b2 16.5 mm** |

بخش ۳٫۱ در مفهوم اولیه برای پلهٔ ۱ هم Ø422 mm و U2 ≈ 332 m/s داشت.

### ۱۵٫۲ یافتهٔ اصلی ۲: پروانهٔ ۱ از Ti-6Al-4V (به جای Al 2618-T61)

- در U2 = 334 m/s، سوراخ پیچ مرکزی در Al 2618 به تنش مماسی **۲۱۶ تا ۲۳۶ MPa** می‌رسد.
  - عمر روشن‌وخاموش (Manson–Morrow، ضریب ۲ روی کرنش و ۲۰ روی عمر) **۶٬۳۰۰ تا ۹٬۲۰۰ سیکل** است، در برابر ۱۰٬۰۰۰ لازم (بخش ۱۲).
  - Curvic جلوی پروانهٔ ۱ با آلومینیوم هم رد می‌شود (بخش ۱۳٫۲).
- یک گودی تراشکاری در سطح پشتی امتحان شد:
  - تنش سوراخ به ۱۶۶ MPa رسید؛
  - اما دیسک هاب نازک شد و خم شد: ۱٫۴ mm جابه‌جایی محوری نوک پره، ۲۶۶ MPa در کف گودی و حاشیهٔ تسلیم trip ۰٫۹۷.
  - کنار گذاشته شد.
- **با Ti-6Al-4V و همان هندسه:**
  - همهٔ چک‌های تنش با حاشیهٔ زیاد قبول‌اند (بخش ۱۵٫۷).
  - Curvic جلو ۰٫۴۷ مجاز است.
  - هزینه: جرم ۲۲٫۲ kg به جای ۱۳٫۸ و مادهٔ گران‌تر.
  - پره‌های تیتانیومی در ورودی در برابر ضربهٔ ذرات و سایش (غبار برازجان) هم مقاوم‌ترند.
- اگر تعداد روشن‌وخاموش واقعی سایت کمتر از ~۶٬۰۰۰ در عمر باشد (کار ۲۴/۷ با توقف کم)، آلومینیوم دوباره ممکن است. فقط پارامتر `mat` در `a1000_impeller.py` عوض می‌شود، ولی Curvic جلو باید جداگانه حل شود.

### ۱۵٫۳ هندسهٔ پروانه‌ها

- فضای هر دو پروانه همان قبلی است. پرهٔ پروانهٔ ۲ فقط ۱۰۰ mm طول محوری لازم دارد. بقیه یک دماغهٔ چرخان ۲۹٫۵ mm است که خم ۹۰° کانال برگشت روی آن قرار می‌گیرد.

| | پروانهٔ ۱ | پروانهٔ ۲ |
|---|---|---|
| جنس و ساخت | Ti-6Al-4V فورج، فرز ۵ محوره | Ti-6Al-4V فورج، فرز ۵ محوره |
| D2 / b2 | 426 / 33.5 mm | 476 / 16.5 mm |
| ورودی: شعاع هاب / نوک | 60 / 137 mm (meanline 48.6 / 128) | 80 / 130.5 mm (meanline 49.5 / 110) |
| طول محوری پره / D2 | 0.248 | 0.206 |
| زاویهٔ پیچش پره (wrap) | 51° | 65° |
| ضخامت پره هاب: LE / بیشینه / TE | 2.4 / 4.5 / 6.0 mm | 2.0 / 3.6 / 5.0 mm |
| ضخامت پره نوک: LE / بیشینه / TE | 1.4 / 2.4 / 2.2 mm | 1.2 / 2.0 / 1.8 mm |
| فیلت ریشه (= شعاع ساچمهٔ ابزار) | R5 | R4 |
| لقی سرد: ورودی شعاعی / خروجی محوری | 0.50 / 0.90 mm | 0.40 / 1.10 mm |
| جرم (هاب + ۱۳ پره + ۱۳ splitter) | **22.2 kg** | **28.4 kg** |

- **شعاع هاب ورودی:**
  - پروانهٔ ۱ پشت شفت جلو (r 60 در x 205) است.
  - پروانهٔ ۲ پشت خم کانال برگشت، روی فاصله‌انداز (r 80) است.
  - شعاع هاب meanline (48.6 / 49.5) با این‌ها جور نبود.
  - شعاع نوک دوباره برای کمترین ماخ نسبی بهینه شد: Mrel نوک ۰٫۷۳ / ۰٫۶۱ (meanline ۰٫۷۱ / ۰٫۵۵).
- **شکل پره، مناسب ساخت:**
  - هاب و shroud منحنی Bezier‌اند (هاب درجهٔ ۴ با یک قطب آزاد برای توزیع سطح مقطع). هر دو با یک پارامتر t پیش می‌روند.
  - **هر دو طرف پره خطوط راست از هاب به نوک‌اند** (ruled). کل سطح پره با پهلوی یک ابزار مخروطی ساچمه‌سر تراشیده می‌شود.
  - در القاگر خطوط پره شعاعی‌اند. پس نیروی گریز از مرکز ورودی پره را خم نمی‌کند، و زاویهٔ هاب مثل جریان با tanβ ∝ r عوض می‌شود.
  - در خروجی زاویهٔ هاب و نوک هر دو ۴۰° است، بدون rake.
  - پیچش نرمال‌ها در طول هر خط حداکثر ۳۴° / ۲۱° است. با ابزار R3 حدود ۰٫۱۳ / ۰٫۰۵ mm خطای flank milling می‌دهد، که CAM با تنظیم زاویهٔ ابزار کمتر می‌کند.
  - لبهٔ حمله بیضی ۲:۱ است.
  - لبهٔ فرار با استوانهٔ r2 بریده می‌شود: همان تراش قطر خارجی.
  - splitter همان خط میانی پرهٔ اصلی است، با نیم گام جابه‌جایی، و از ۳۰٪ طول نصف‌النهاری شروع می‌شود.
- **هاب قطعهٔ تراشکاری ساده است:**
  - دماغه (۱۰ / ۲۹٫۵ mm، هم‌سطح با شفت و فاصله‌انداز)؛
  - سطح جریان؛
  - نوار ۸ / ۷ mm در r2؛
  - سطح پشتی تخت؛
  - **دندانه‌های Curvic در دو سطح** (۳۶ دندانه، زاویهٔ فشار ۳۰°، هم‌جفت با قطعات روتور rev 1.1، نیم گام جابه‌جا). تداخل با شفت جلو، فاصله‌انداز و درام فقط ۴ تا ۹ mm³ تماس پهلوی دندانه است.

### ۱۵٫۴ القاگر، گلوگاه و بارگذاری پره

| | پروانهٔ ۱ | پروانهٔ ۲ |
|---|---|---|
| سرعت محوری ورودی c1 | 120 m/s | 106 m/s |
| زاویهٔ جریان / پره در هاب | 38.1° / 40.5° | 49.8° / 52.2° |
| زاویهٔ جریان / پره در نوک (incidence +2°) | 60.8° / 62.8° | 62.6° / 64.6° |
| ماخ نسبی نوک | 0.73 | 0.61 |
| سطح گلوگاه القاگر / سطح ورودی | 326 / 477 cm² | 205 / 334 cm² |
| گلوگاه / سطح capture (A1·cosβ1) | 1.17 | 1.16 |
| حاشیهٔ choke القاگر | **1.36** | **1.48** |
| حاشیهٔ choke گلوگاه دیفیوزر | 1.09 | 1.12 |
| Wss,max/W2 روی shroud (Stanitz، بعد از ۱۰٪ اول) | 2.38 | 1.91 |
| کمترین سرعت سمت فشار (هاب / shroud) | 57 / 37 m/s | 75 / 44 m/s |
| W1t/W2 | 1.60 | 1.34 |

- choke اول در گلوگاه دیفیوزر رخ می‌دهد. حاشیهٔ ۹ تا ۱۲٪ برای ماشین دور ثابت با ژنراتور شبکه کافی است.
- سطح مقطع نصف‌النهاری (با انسداد پره‌ها) بدون فرورفتگی کم می‌شود. کمینه در پلهٔ ۱ برابر ۰٫۸۷ است. در پلهٔ ۲ به ۰٫۷۱ می‌رسد، که همان نسبت سطح خروج به ورود است.

### ۱۵٫۵ عملکرد: لغزش و تلفات در برابر meanline (مدل یک‌بعدی)

**مدل‌ها:**
- لغزش: Wiesner با ۲۲٫۱ پرهٔ مؤثر.
- تلفات پروانه: مجموعهٔ Oh، Yoon و Chung (1997):
  - **داخلی:** برخورد، بارگذاری، اصطکاک (Haaland با Ra 1.6 µm)، لقی (Jansen)، اختلاط (Johnston–Dean).
  - **انگلی:** اصطکاک دیسک، بازگردش، نشتی (Aungier).
- فضای بدون پره: Stanitz با اصطکاک.
- دیفیوزر: کانال دوبعدی با بازده وابسته به 2θ.

| | پلهٔ ۱ | پلهٔ ۲ |
|---|---|---|
| ضریب لغزش σ (meanline) | 0.900 (0.911) | 0.900 (0.911) |
| کار اویلر / کل | 72.6 / 73.6 kJ/kg | 90.6 / 92.3 kJ/kg |
| بازده پروانه (tt) | 0.949 | 0.947 |
| ماخ / زاویهٔ خروج پروانه | 0.65 / 65.3° | 0.65 / 65.2° |
| **PR پله (tt، تا خروج دیفیوزر)** | **2.012** (meanline 2.008) | **1.991** (meanline 1.921؛ اضافه برای افت کلکتور) |
| **بازده پله (tt)** | **0.872** (meanline 0.860) | **0.854** (meanline 0.850) |
| دمای خروج | 87.7 °C | 178.4 °C |

**جمع کمپرسور تا فلنج کلکتور:**
- PR **3.805** (meanline ۳٫۸).
- بازده **0.812** در برابر ۰٫۸۳۸ meanline:
  - meanline فقط افت کانال برگشت (۱٫۵٪) را داشت؛ این‌جا ۲٫۰٪ است.
  - افت کلکتور ساده (۰٫۶ فشار دینامیکی خروج دیفیوزر) ۳٫۰٪ است و در meanline حساب نشده بود.
- **اثر روی چرخه:** راندمان برق از ۳۸٫۵٪ به **۳۷٫۴٪**، و توان خالص به ازای هر kg هوا ×0.97.
- **پیشنهاد:** یک ردیف پرهٔ deswirl پیش از کلکتور افت کلکتور را به حدود ۱٪ می‌رساند.
- بیشترین تلفات پروانه:
  - پلهٔ ۱: بارگذاری پره (۱٫۶٪ کار) و اصطکاک (۱٫۲٪).
  - پلهٔ ۲: اصطکاک (۱٫۴٪) و نشتی (۱٫۱٪)، چون b2 کوچک است.

### ۱۵٫۶ دیفیوزر پره‌دار، کانال برگشت و کلکتور

| | دیفیوزر ۱ | دیفیوزر ۲ |
|---|---|---|
| فضای بدون پره r3/r2، باریک‌شدن | 1.10، b3 = 0.92 b2 (30.8 mm) | 1.10، b3 = 15.2 mm |
| تعداد پره (بخش ۱۵٫۸) | **۱۹** | **۱۹** |
| پره: r3 → r4 | 234 → 337 mm | 262 → 369 mm |
| زاویهٔ پره ورود / خروج (از شعاع) | 67.6° / 53° | 66.7° / 53° |
| ماخ ورود / گلوگاه | 0.58 / 0.70 | 0.58 / 0.67 |
| AR، 2θ معادل، L/W1، solidity | 2.26، **10.2°**، 7.1، 2.6 | 2.11، **10.3°**، 6.2، 2.4 |
| Cp (ایده‌آل) | 0.62 (0.80) | 0.60 (0.78) |
| ساخت | پرهٔ ۲٫۵ محوره، یکپارچه با صفحهٔ دیفیوزر | همان |

**کانال برگشت (پلهٔ ۱ به ۲):**
- مسیر:
  - خم U (crossover) از r 337 با شعاع بیرونی ۴۷ mm؛
  - دیافراگم ۱۰ mm؛
  - کانال شعاعی ۴۰ mm (x 341 تا 381)؛
  - **۱۷ پرهٔ deswirl** از r ≈ 325 تا 157، با زاویهٔ ۶۲٫۵° تا صفر؛
  - خم ۹۰° (شعاع داخلی ۱۲ mm) به القاگر پلهٔ ۲.
- لبهٔ هاب ثابت دیافراگم با فاصلهٔ ۲ mm روی دماغهٔ چرخان پروانهٔ ۲ است. دیافراگم روی فاصله‌انداز (r 75) با لابیرنت آب‌بند می‌شود.
- افت فشار کل حدود **۲٫۰٪** است.

**کلکتور:** حلقوی دور خروج دیفیوزر ۲، با خروجی DN300 به recuperator.

**ورودی شعاعی پلهٔ ۱ (rev 1.1، با روتور rev 1.1):**
- یاتاقان‌های جلو جلوتر رفتند، و محفظهٔ کف‌گرد به یک **هاب ورودی** ختم می‌شود (`INLET_HUB` در `a1000_rotor.py`). این هاب از (x 157, r 150) تا (x 201, r 61.5) می‌رود و در x 205 به دماغهٔ پروانه (r 60) می‌رسد.
- **سمت shroud:**
  - دیوارهٔ شعاعی در x 204 با خم R10 به shroud القاگر (r 137.5) می‌رسد، پیش از لبهٔ حمله (x 215).
  - ورودی کانال در r 260 است، با لبهٔ گرد R12.
- **سمت هاب:** دیوارهٔ جلویی در x 157 از r 150 تا 260.
- plenum دور محفظه‌های یاتاقان جلو است و کانال بالای آن به فیلتر می‌رود.
- **سطح مقطع:**
  - در ورودی ۱٫۶۰ برابر سطح القاگر است.
  - در طول خم بین **۰٫۹۸ و ۱٫۰۱** می‌ماند: بدون کندشدن پیش از القاگر، c ≈ 120 m/s.
  - با هاب اول روتور rev 1.1 در r 95–130 تا ۰٫۹۱ کم می‌شد. هاب در آن ناحیه ۵ mm پُرتر شد (روتور d74155c).

### ۱۵٫۷ تست سازه‌ای با CalculiX: تنش، ترکیدن، خزش و LCF (`sim/engine/a1000_impeller_fea.py`)

**مدل:**
- قطاع ۱/۱۳ شامل هاب، یک پرهٔ اصلی و یک splitter با فیلت ریشه، با المان C3D10.
- مش تنش: ۲۳۳ / ۲۸۷ هزار گره. مش مودال: ۱۰۱ / ۱۲۱ هزار گره.
- **مرز قطاع:** پره‌ها ۵۱° تا ۶۵° می‌پیچند، پس صفحهٔ شعاعی از وسط پره‌ها رد می‌شد. مرز قطاع دو سطح پیچیده است که روی هاب وسط کانال بین splitter و پرهٔ اصلی می‌گذرد و هیچ پره‌ای را نمی‌برد. با `*CYCLIC SYMMETRY MODEL` بسته شده‌اند.
- **تکیه‌گاه:** رینگ Curvic عقب (شعاع‌های بخش ۱۳) جابه‌جایی محوری و مماسی را می‌گیرد؛ رشد شعاعی آزاد است.
- **دمای فلز (طراحی، ورودی ۱۵ °C):**
  - پروانهٔ ۱: سوراخ ۶۰ °C، نوک ۹۵ °C؛ پره ۲۰ تا ۸۸ °C.
  - پروانهٔ ۲: ۱۵۰ / ۱۸۵ °C؛ پره ۹۵ تا ۱۷۸ °C.
  - روز گرم بدون خنک‌کاری ورودی (۴۶ °C): ۳۹ تا ۵۰ K بیشتر.
- **حالت‌ها:**
  - ۱۵٬۰۰۰ rpm با و بدون کرنش حرارتی؛
  - روز گرم؛
  - trip ۱۶٬۵۰۰ rpm؛
  - تست چرخش ۱۱۵٪ MCS (۱۸٬۱۱۲ rpm) در ۲۰ °C.
- **ماده:** Ti-6Al-4V فورج، حداقل UTS 895 / YS 825 MPa در ۲۰ °C (۷۸۰ / ۶۹۰ در ۱۵۰ °C). خزش زیر ~۳۰۰ °C ناچیز است. معیار cold dwell: تنش پایدار محلی ≤ ۰٫۸ YS.
- **منحنی خزش Al 2618** (برای مقایسه در بخش ۱۵٫۲): Larson–Miller با C = 17.25، برازش‌شده روی ماتریس تست EN AW-2618A T61 از Han و همکاران (Data in Brief 62، 2025).

| | پروانهٔ ۱ (Ti) | پروانهٔ ۲ (Ti) | معیار |
|---|---|---|---|
| von Mises بیشینه در ۱۵k (محلی) | 378 MPa، ریشهٔ لبهٔ فرار پره، ۸۸ °C | 388 MPa، لبهٔ سوراخ، ۱۵۰ °C (پره 210) | |
| حاشیهٔ تسلیم محلی ۱۵k / **trip** | 1.99 / **1.64** | 1.78 / **1.48** | ≥ 1.0 |
| تنش مماسی سوراخ / میانگین مماسی هاب | 360 / 102 MPa | 389 / 100 MPa | |
| **ترکیدن / trip** (میانگین مماسی، ۸۵٪ UTS) | **2.44** (40,200 rpm) | **2.34** (38,600 rpm) | ≥ 1.22 |
| تست چرخش: YS / تنش حجمی (صدک ۹۹٫۵) | **2.59** (پیک محلی 563 MPa: 1.47) | **2.47** (پیک 551 MPa: 1.50) | ≥ 1.0 |
| **LCF روشن‌وخاموش** (Manson–Morrow، ۲ / ۲۰) | **3.6×10⁴** | **2.0×10⁴** | ≥ 10⁴ |
| cold dwell: پیک پایدار / YS در روز گرم | 0.54 | 0.59 | ≤ 0.8 |
| رشد نوک لبهٔ فرار در کار: شعاعی / محوری (trip) | +0.33 / **−0.25** (−0.29) mm | +0.47 / **−0.57** (−0.67) mm | |
| رشد شعاعی نوک لبهٔ حمله | 0.06 mm | 0.15 mm | |

**نکته‌ها:**
- پیک لبهٔ سوراخ و سطح پشتی، گوشهٔ تیز مدل است. در نقشه شعاع R2 گذاشته می‌شود.
- مدل FEA سطوح تخت دارد. دندانه‌های Curvic اثر موضعی دارند و فشار دندانه در بخش ۱۳٫۲ چک شده است.
- پیک ریشهٔ لبهٔ فرار جایی است که سطح بریدهٔ r2 به فیلت می‌رسد. لبه‌ها با R0.5 پرداخت می‌شوند.
- **لقی خروجی:** خم‌شدن پره زیر نیروی گریز از مرکز، نوک لبهٔ فرار را به shroud نزدیک می‌کند. پس لقی سرد محوری خروجی بیشتر از لقی ورودی است: **۰٫۹ / ۱٫۱ mm**. لقی در کار حدود ۰٫۵ تا ۰٫۶ mm می‌شود.

### ۱۵٫۸ ارتعاش: مودهای cyclic، Campbell/ZZENF و تعداد پره‌های دیفیوزر

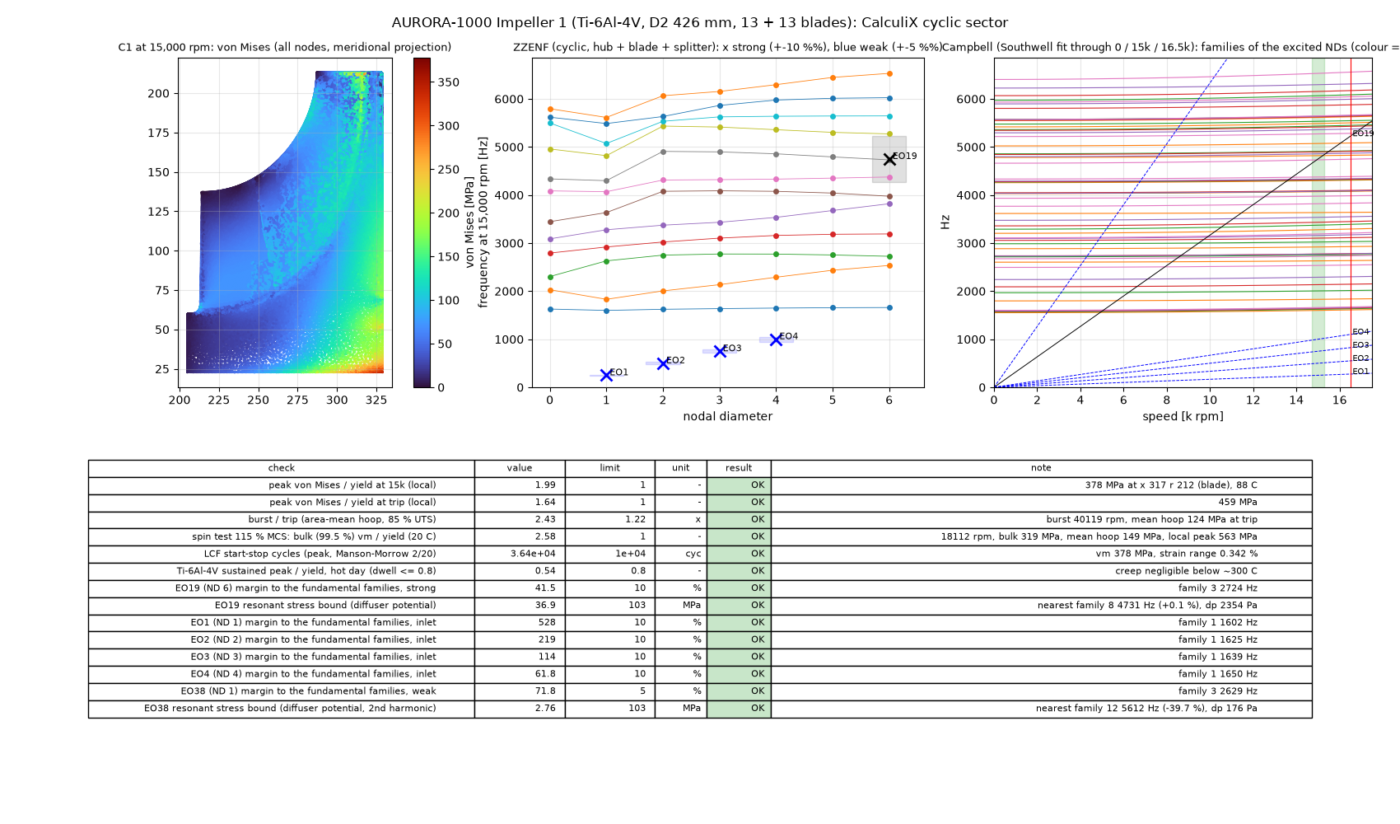
[picture p17: docs/img/a1000_impeller_C1_fea.png]
ZZENF و تست‌های پروانهٔ ۱


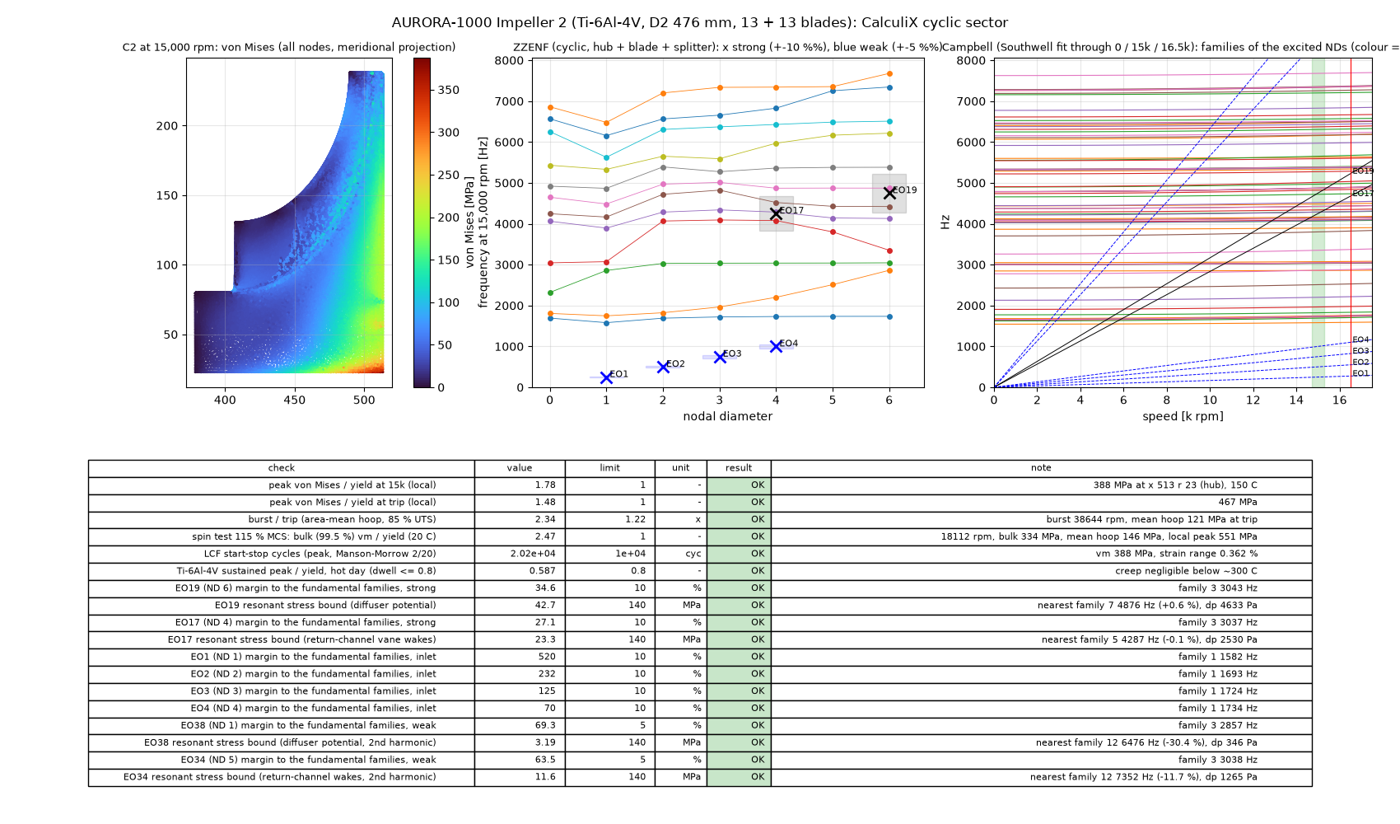
[picture p18: docs/img/a1000_impeller_C2_fea.png]
ZZENF و تست‌های پروانهٔ ۲


**مدل:**
- مودال با پیش‌تنش (NLGEOM)، ۱۲ خانواده برای هر قطر گرهی ND 0–6 (۱۳ قطاع)، در ۰ و ۱۵٬۰۰۰ rpm.
- Campbell بین این دو با Southwell رسم شده: `f² = f0² + S·N²`.
- پروانهٔ ۱:
  - ND 0 با Ti حل شد.
  - ND 1–6 از حل همان هندسه و مش با Al مقیاس شد: `√(E/ρ)`. جملهٔ سخت‌شدگی Southwell به ماده بستگی ندارد.
  - کنترل روی ND 0: اختلاف ۰ تا ۰٫۵٪.

**طیف:**
- خانوادهٔ اول (خمش اول پرهٔ اصلی) در همهٔ NDها **۱٫۶۰–۱٫۶۶ kHz** (پروانهٔ ۱) و **۱٫۵۸–۱٫۷۴ kHz** (پروانهٔ ۲) است.
- سخت‌شدگی دوران از ۰ تا ۱۵k حدود ۳ تا ۴٪ است.
- ۱۲ خانواده تا ۵٫۶–۶٫۵ / ۶٫۵–۷٫۴ kHz می‌رسند، یعنی حدود **۲٫۵ مود در هر kHz** در هر ND (پرهٔ اصلی، splitter و مودهای جفت‌شده با دیسک).
- **نتیجه:** هیچ تعداد پرهٔ دیفیوزر نیست که از همهٔ مودها ۱۰٪ فاصله بگیرد. در اسکن ۱۵ تا ۲۵ پره، بهترین فاصله تا نزدیک‌ترین مود ۰ تا ۸٪ است.

**معیارها** (هم‌روش برآورد پاسخ اجباری توربین، بخش ۱۲):
1. **فاصله از خانواده‌های پایه:** سه خانوادهٔ اول همان ND، یعنی خمش اول پره و splitter و اولین مود دیسک. لازم: ≥ ۱۰٪ برای مرتبه‌های قوی و ≥ ۵٪ برای ضعیف.
2. **کران بالای تنش ارتعاشی در تشدید با نزدیک‌ترین مود (هر خانواده‌ای)** ≤ نصف مجاز Goodman:
   - رابطه: `σ_vib = σ_TE × (Δp / q_cf) × 1/(2ζ) × 1.5`؛
   - σ_TE: تنش پایای ریشهٔ لبهٔ فرار از FEA؛
   - q_cf: بار گریز از مرکز صفحهٔ پره؛
   - Δp برای میدان پتانسیل دیفیوزر: `0.4 q3 exp(−k Z (r3/r2 − 1))`؛
   - Δp برای wake پره‌های بالادست: `0.05 q1`؛
   - میرایی ζ = 0.003، mistuning ×1.5، مشارکت مودی کامل.

**انتخاب:** **۱۹ پره برای هر دو دیفیوزر، ۱۷ پره برای کانال برگشت.**
- عدد اول‌اند.
- از ۱۲ تا ۱۴ و ۲۵ تا ۲۷ دور هستند، که ND 0–1 را تحریک می‌کنند (مودهای چتری و دیسک).
- از نظر آیرودینامیک بهینه‌اند (2θ ≈ ۱۰°).
- میدان پتانسیل در خروج پروانه به ۱۵٪ و هارمونیک دومش به ۲٪ کاهش می‌یابد.

| مرتبه (ND) | منبع | فاصله از خانواده‌های پایه (لازم) | نزدیک‌ترین مود در باند ±۲٪ | کران تنش ارتعاشی / مجاز |
|---|---|---|---|---|
| **پروانهٔ ۱** EO19 (6) | میدان پتانسیل دیفیوزر ۱ | 41 % (10 %) | خانوادهٔ ۸، 4,731 Hz (+0.1 %) | **37 / 103 MPa** |
| پروانهٔ ۱ EO38 (1) | هارمونیک دوم | 72 % (5 %) | خانوادهٔ ۱۲ (−40 %) | 2.8 / 103 MPa |
| پروانهٔ ۱ EO 1–4 | اعوجاج ورودی | ≥ 62 % (10 %) | زیر خانوادهٔ اول | — |
| **پروانهٔ ۲** EO19 (6) | میدان پتانسیل دیفیوزر ۲ (و wake دیفیوزر ۱) | 35 % (10 %) | خانوادهٔ ۷، 4,876 Hz (+0.6 %) | **43 / 140 MPa** |
| **پروانهٔ ۲** EO17 (4) | wake پره‌های کانال برگشت | 27 % (10 %) | خانوادهٔ ۵، 4,287 Hz (−0.1 %) | **23 / 140 MPa** |
| پروانهٔ ۲ EO34 (5) | هارمونیک دوم کانال برگشت | 64 % (5 %) | خانوادهٔ ۱۲ (−12 %) | 12 / 140 MPa |
| پروانهٔ ۲ EO38 (1) | هارمونیک دوم دیفیوزر ۲ | 69 % (5 %) | خانوادهٔ ۱۲ (−30 %) | 3 / 140 MPa |
| پروانهٔ ۲ EO 1–4 | اعوجاج ورودی | ≥ 70 % (10 %) | زیر خانوادهٔ اول | — |

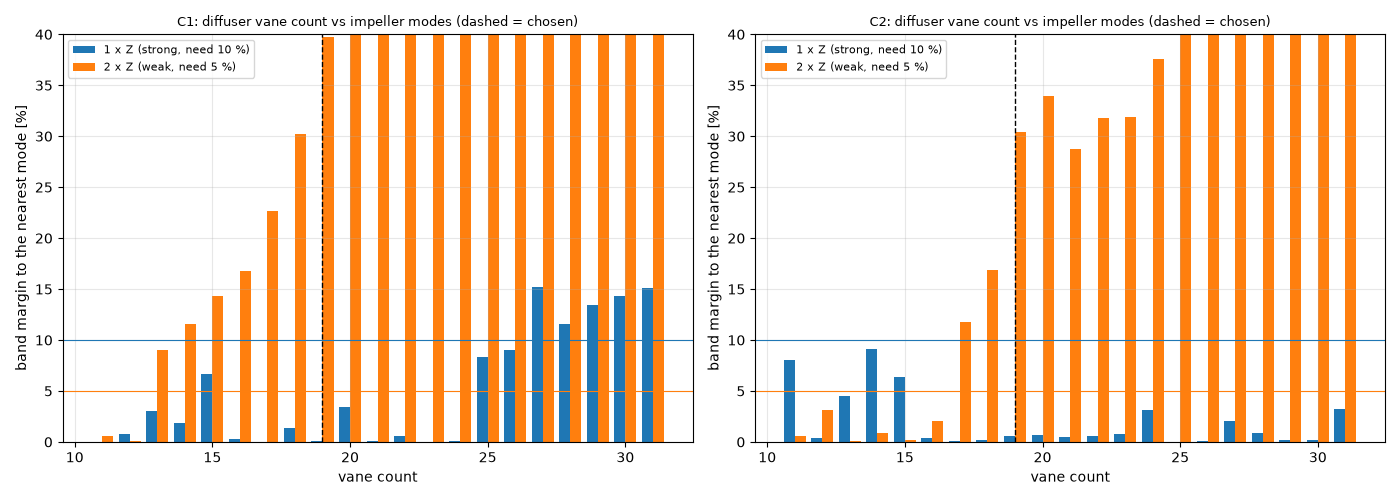
[picture p19: docs/img/a1000_impeller_vanes.png]
اسکن تعداد پره


**راه‌اندازی:** مرتبه‌های EO17 و EO19 خانواده‌های پایه را در **۵٬۲۰۰ تا ۸٬۶۰۰ rpm** قطع می‌کنند. در این بازه توقف نشود (دو بحرانی روتور هم در ۳٬۹۰۰ / ۶٬۵۰۰ rpm است). استارتر با شیب پیوسته از آن عبور می‌کند.

**کران تنش، برآورد بالا است، نه پاسخ اجباری واقعی.** تست ضربه، strain gauge یا tip-timing در اولین تست لازم است (بخش ۱۵٫۱۱).

### ۱۵٫۹ دینامیک روتور با پروانه‌های واقعی (`sim/engine/a1000_rotordynamics.py`)

**ورودی‌های مدل:**
- جرم، مرکز جرم و اینرسی پروانه‌ها از CAD گرفته می‌شود (`fusion/A1000C/parts.json`).
- بدنهٔ پروانه در مدل تیر، استوانه‌ای با قطر دماغه (2·r1h) روی سوراخ Ø46 است.
- مدل جزئی پشتهٔ روتور (بخش ۱۳٫۵، `a1000_rotor_stack.py`) همین ورودی را از `RD.rotor()` می‌گیرد و باید دوباره اجرا شود.

| آرایش A-SFD | پروانهٔ مفهومی (پیش از این) | پروانه‌های rev 1 (Ti / Ti) |
|---|---|---|
| جرم پروانه‌ها | 11.5 / 21.8 kg | 22.2 / 28.4 kg |
| جرم روتور | 196 kg | 213 kg |
| بحرانی ۱ (حاشیه / لازم API) | 3,964 rpm (72 % / 0) | **3,896 rpm (73 % / 0)** |
| بحرانی ۲ | 6,780 rpm (52 %) | **6,525 rpm (54 %)** |
| بحرانی خمشی ۳ | 23,191 rpm | **بالای 26,000 rpm** (whirl 473 Hz در 15k) |
| بیشینهٔ ارتعاش نامیزانی (95 % تا trip) | 2.5 µm | **2.1 µm** (حد API 22 µm) |

- حالت حساسیت (دمپر π-film) هم قبول است: 3,934 / 6,762 rpm.

### ۱۵٫۱۰ فیوژن و فایل‌ها

- **پروانه‌ها:**
  - مسیر: `a1000_impeller.py --cad` ← `python3 fusion/export_a1000_impellers.py` ← `fusion/A1000C/` (۶ قطعهٔ STEP و `parts.json`).
  - اسکریپت فیوژن: `fusion/AURORA1000_Compressor` ← طرح «AURORA-1000 Compressor rev1» (Default Project).
- **پکیج:**
  - `A1000_STEP=1 … a1000_viewer_export.py` پروانه‌ها را از `fusion/A1000C` می‌خواند.
  - پوستهٔ کمپرسور را از مسیر واقعی جریان می‌سازد: دیواره‌های shroud، دیفیوزرها، crossover، دیافراگم، کانال برگشت و کلکتور.
  - پره‌های دیفیوزر و کانال برگشت در گروه «Diffuser and return vanes» هستند.
  - قطعات روتور rev 1 و بخش داغ مثل قبل جایگزین می‌شوند.
- **شکل‌ها:**
  - مقطع: `cad/engine/a1000_compressor_section.py`.
  - تست‌ها: `docs/img/a1000_impeller_C1_fea.png`، `a1000_impeller_C2_fea.png` و `a1000_impeller_vanes.png`.

### ۱۵٫۱۱ محدودیت‌ها و قدم بعدی

1. **بازده کل کمپرسور ۰٫۸۱۲ است در برابر ۰٫۸۳۸ meanline** (بخش ۱۵٫۵):
   - حدود ۱٫۱ واحد درصد راندمان برق.
   - پیشنهاد: پرهٔ deswirl پیش از کلکتور، و CFD سه‌بعدی دو پله برای بازده، زاویه‌ها و حاشیهٔ surge/choke.
2. **دادهٔ ماده:** Ti-6Al-4V، مقادیر حداقل منتشرشده است. باید با دادهٔ تأییدشدهٔ فورج‌کار جایگزین شود: کشش، LCF و خستگی در ۲۰ تا ۲۵۰ °C.
3. **ورودی هوای پلهٔ ۱:**
   - تداخل محفظهٔ کف‌گرد با ورودی در روتور rev 1.1 حل شد (بخش ۱۵٫۶).
   - CFD ورودی و plenum (اعوجاج محیطی، EO 1–4) قدم بعد است.
4. **ارتعاش:** پاسخ اجباری فقط با یک کران بالای ساده تخمین زده شده (بخش ۱۵٫۸). لازم است:
   - تست ضربهٔ هر پروانه بعد از ماشین‌کاری؛
   - strain gauge یا tip-timing در اولین تست.
5. **ساخت:**
   - بالانس دینامیکی G2.5 و تست چرخش ۱۱۵٪ MCS (۱۸٬۱۱۲ rpm).
   - CMM پره (تلرانس پروفیل ±۰٫۰۵ mm).
   - FPI کامل.
   - شعاع R2 در لبهٔ سوراخ و سطح پشتی، و پرداخت R0.5 لبه‌های پره.

### ۱۳٫۸ به‌روزرسانی با پروانه‌های واقعی (۲۰۲۶-۱۰-۳۰، بعد از بخش ۱۵)

- **هر دو پروانه تیتانیوم شدند** (بخش ۱۵). Curvic جلوی پروانهٔ ۱ حالا قبول است (۰٫۴۷ حد مجاز). **۳۲ از ۳۲ چک قبول.**
- **نیروی محوری** با فشارهای واقعی پروانه‌ها: **۲٫۵ kN** به عقب. یاتاقان کف‌گرد در ۰٫۵ MPa کار می‌کند، با تلفات ۱۳ kW.
- **تداخل ورودی هوا حل شد:**
  - یاتاقان ۱ از x 95 به **x 65** و فلنج کف‌گرد از x 146 به **x 116–136** جلو رفتند.
  - پشت محفظهٔ کف‌گرد حالا **دماغهٔ هاب ورودی** است. از دیوارهٔ شعاعی در x 157 تا هاب القاگر (r 60) در x 201 خم می‌شود (`INLET_HUB` در `cad/engine/a1000_rotor.py`).
  - فاصلهٔ x 157–205 برای چرخش ورودی شعاعی به القاگر آزاد است. سمت بیرونی (bellmouth) بخش طراحی کمپرسور است.
- **دینامیک روتور** با پروانه‌های واقعی و یاتاقان جلوتر:
  - بحرانی‌ها **۳٬۹۱۰، ۸٬۱۱۰ و ۲۱٬۶۲۰ rpm**. حاشیهٔ مود سوم ۳۷٪ است، در برابر ۲۱٪ لازم.
  - ارتعاش API **۳٫۸ µm** است (حد ۲۲).
  - با دمپر π-film: ۳٬۸۵۰، ۷٬۶۰۰ و ۲۱٬۰۲۰ rpm، و ۴٫۰ µm.

### ۱۳٫۹ rev 1.2: حلقهٔ فاصله‌انداز R1–R2 برای فاصلهٔ +۲۵ mm توربین (۲۰۲۶-۱۰-۳۰)

- **علت:** در rev 6 توربین (بخش ۱۲٫۴٫۲) NGV2 و R2 ۲۵ mm عقب رفتند. فاصلهٔ وجه عقب هاب R1 تا وجه جلوی هاب R2 از ۴۴ به ۶۹ mm رسید.
- **دو راه مقایسه شد** (مدل جزئی روتور، SFD اسمی):

| | جرم روتور | مود خمشی |
|---|---|---|
| rev 1 (قبل از تغییر) | ۲۰۰٫۱ kg | ۲۱٬۶۲۰ rpm |
| بازوهای ریختگی، هر کدام ۱۲٫۵ mm بلندتر | ۲۰۰٫۸ kg | ۲۰٬۸۲۰ rpm |
| **حلقهٔ فاصله‌انداز IN718 (انتخاب)** | ۲۰۲٫۷ kg | ۲۰٬۹۱۰ rpm |

> در بخش ۲۱٫۱۱ (۲۰۲۶-۱۱-۰۱) این حلقه حذف شد. R1–R2 حالا یک اتصال با بازوهای بلندتر است.

- **انتخاب: حلقهٔ فاصله‌انداز RT-107.** دلیل‌ها:
  - blisk‌های ریختگی عوض نمی‌شوند. الگوی ریخته‌گری، FEA دیسک و مدل‌های cyclic و پاسخ اجباری معتبر می‌مانند.
  - مقطع حلقه (r 60–88) در خمش حدود ۵ برابر سفت‌تر از لولهٔ نازک بازو (r 58–66) است. مود خمشی کمتر پایین می‌آید، با وجود ۱٫۹ kg جرم بیشتر.
  - چهار تیغهٔ آب‌بند میانی روی یک قطعهٔ کارشده و قابل تعویض است، نه روی blisk.
  - حلقه و استادها هر دو IN718 هستند. پس در طول اضافه اختلاف انبساط ندارند.
  - هزینه: یک وجه Curvic بیشتر در استک و ~۱٫۹ kg بیشتر از راه بازوی بلندتر.
- **هندسهٔ حلقه** (`turbine_spacer_profile` در `cad/engine/a1000_rotor.py`):
  - IN718، طول ۲۵ mm بین دو وجه (x 766.3 تا 791.2).
  - دو وجه r 60–92 با Curvic ۴۸ دندانه (r 62–90)، مثل فلنج‌های blisk.
  - کمر r 60–88 با ۴ تیغهٔ آب‌بند تا r 92.3. لقی سرد ۰٫۳ mm تا honeycomb دیافراگم میانی (r 92.6).
  - ۱۶ سوراخ Ø10.5 روی PCD 152. جرم **۲٫۶ kg**.
- **استادهای R1–R2 باید بلندتر شوند:** از ۲۶ به **۵۱ mm** (طول گیر ۱۸ ← ۴۳ mm).
  - همان MJ10×1.25 از IN718 و همان پیش‌بار ۲۷ kN. استاد در Heli-Coil فلنج R2 بسته می‌شود، از حلقه و فلنج R1 رد می‌شود و مهره در حفرهٔ پشت R1 است، مثل قبل.
  - اختلاف انبساط فقط در دو فلنج MAR-M247 است. استاد بلندتر نرم‌تر است، پس افت دائمی نیرو ۲٫۸ ← **۱٫۴ kN** شد. افت گذرا (استاد ۶۰ K داغ‌تر) ۴٫۸ ← **۵٫۸ kN**.
  - کمترین گیره ۲۷۳ kN در برابر ۳۸ kN لازم: ضریب **۷٫۲** (rev 1: ۷٫۴؛ حد ۱٫۲۵). تنش استاد تغییر نکرد (۰٫۶۵ حد).
  - دو اتصال دیگر (درام–R1 و R2–شفت عقب) همان استاد ۲۶ mm را دارند.
- **FEA دیسک‌ها:** blisk‌ها و بازوها همان rev 1 هستند و نتایج عوض نشد (حاشیهٔ تسلیم در trip ۱٫۳۹ / ۱٫۴۰، LCF ریشهٔ بازو ۱٫۶×۱۰⁴).
- **دینامیک روتور:** روتور ۲۰۳ kg است (۲٫۹ kg بیشتر). یاتاقان ۲ از x 930 به **x 955** رفت.

| حالت | بحرانی‌ها [rpm] | حاشیهٔ مود خمشی / لازم (API 617) | ارتعاش API |
|---|---|---|---|
| اسمی، rev 1 | ۳٬۹۱۰ / ۸٬۱۱۰ / ۲۱٬۶۲۰ | ۳۷٫۳٪ / ۲۱٫۵٪ | ۳٫۸ µm |
| **اسمی، rev 1.2** | **۳٬۸۸۰ / ۸٬۰۱۰ / ۲۰٬۹۲۰** | **۳۲٫۸٪ / ۲۰٫۷٪** | **۴٫۰ µm** |
| π-film، rev 1.2 | ۳٬۸۲۰ / ۷٬۵۱۰ / ۲۰٬۳۰۰ | ۲۸٫۹٪ / ۲۳٫۲٪ | ۴٫۳ µm |

  - مود خمشی **۳٫۳٪** پایین آمد (با π-film ۳٫۴٪). برآورد جلسهٔ EO24 با مدل تیر ۳٫۶٪ بود (~۲۰٬۸۰۰ rpm و حاشیهٔ ~۳۲٪). نتیجهٔ مدل جزئی کمی بهتر از برآورد است.
  - مودهای صلب ۰٫۸ تا ۱٫۳٪ پایین آمدند و همچنان با میرایی زیاد رد می‌شوند.
  - حد ارتعاش API ۲۲ µm است. بیشترین مقدار ۴٫۳ µm است.
- **یاتاقان ۲:** بار ۱۲۱ ← ۱۲۲ kg، فیلم ۶۲ µm (بدون تغییر).
- **چک‌ها: ۳۲ از ۳۲ قبول.**

### ۱۳٫۱۰ rev 1.3: یاتاقان‌های کوچک‌تر برای کم کردن تلفات (۲۰۲۶-۱۰-۳۰)

- **علت:** تلفات یاتاقان‌ها و آب‌بندها ۲۸٫۶ kW بود. سیکل فقط ~۶ kW در نظر گرفته بود. با نتایج طراحی جزئی، موتور در TIT 970 °C (حد خزش R1) ۲۷ kW کم داشت (بخش ۱۷).
- **یاتاقان‌ها بزرگ‌تر از لازم بودند:** فشار ژورنال‌ها ۰٫۲۵ / ۰٫۳۷ MPa و کف‌گرد ۰٫۵ MPa بود. حد معمول پد بابیت ۲ MPa است.
- **روش:** روی مک‌بوک چند اندازه بررسی شد. برای هر ژورنال، مدل پد و دینامیک کامل روتور (دمپر کامل و π-film) اجرا شد.

**ژورنال‌ها (هر دو یکسان):**

| D × L [mm] | تلفات دو ژورنال | فشار ۱ / ۲ [MPa] | فیلم کمینه ۱ / ۲ [µm] | مود خمشی: حاشیه / لازم |
|---|---|---|---|---|
| ۱۰۰ × ۴۵ (rev 1.2) | ۱۳٫۵ kW | ۰٫۲۵ / ۰٫۳۷ | ۷۰ / ۶۲ | ۳۳٪ / ۲۱٪ |
| ۹۵ × ۴۰ | ۱۰٫۸ kW | ۰٫۲۹ / ۰٫۴۴ | ۶۶ / ۵۴ | ۳۴٪ / ۲۱٪ |
| ۹۰ × ۴۰ | ۹٫۷ kW | ۰٫۳۱ / ۰٫۴۶ | ۶۱ / ۵۰ | ۳۴٪ / ۲۱٪ |
| **۹۰ × ۳۶ (انتخاب)** | **۸٫۷ kW** | **۰٫۳۴ / ۰٫۵۲** | **۵۸ / ۴۷** | **۳۴٪ / ۲۲٪** |
| ۹۰ × ۳۲ | ۷٫۸ kW | ۰٫۳۸ / ۰٫۵۸ | ۵۵ / ۴۵ | ۳۴٪ / ۲۳٪ |
| ۸۵ × ۳۴ | ۷٫۴ kW | ۰٫۳۸ / ۰٫۵۸ | ۵۲ / ۴۲ | ۳۵٪ / ۲۲٪ |

- همهٔ گزینه‌ها چک فیلم (≥ ۲۵ µm) و حاشیهٔ سرعت‌های بحرانی را قبول می‌شوند.
- **D85 رد شد:** جیب مهرهٔ پیچ مرکزی (قطر ۷۰) زیر ژورنال ۱ است. دیوارهٔ آن به ۷٫۵ mm می‌رسید. با D90 دیواره ۱۰ mm است.
- **L/D = 0.4 انتخاب شد:** کوتاه‌تر از این برای ژورنال tilting-pad معمول نیست. L32 فقط ۰٫۹ kW کمتر می‌دهد.

**کف‌گرد (بار طراحی ۲٫۵ kN، اندازه برای ۱٫۵ برابر = ۳٫۷ kN):**

| پدها | تلفات | فشار در ۳٫۷ kN | فیلم در ۳٫۷ kN | بدون هوای پشت پروانه (۱۰٫۳ kN) |
|---|---|---|---|---|
| r 56–78، ۸ + ۸ (rev 1.2) | ۱۳٫۱ kW | ۰٫۵۰ MPa | ۶۲ µm | ۱٫۳۹ MPa، ۳۷ µm |
| r 56–78، ۸ + ۴ | ۱۰٫۰ kW | ۰٫۵۰ | ۶۲ | ۱٫۳۹، ۳۷ |
| r 54–72، ۸ + ۴ | ۶٫۶ kW | ۰٫۶۵ | ۵۱ | ۱٫۸۰، ۳۱ |
| **r 52–68، ۸ + ۴ (انتخاب)** | **۵٫۲ kW** | **۰٫۷۷** | **۴۵** | **۲٫۱۳، ۲۷** |
| r 50–66، ۸ + ۴ | ۴٫۸ kW | ۰٫۷۹ | ۴۲ | ۲٫۲۰، ۲۵ |

- **نیمی از تلفات کف‌گرد از سمت بی‌بار بود.** پدهای آن در لقی محوری ۰٫۳ mm کار می‌کنند و تقریباً همان تلفات سمت بار را دارند.
- نیرو در همهٔ حالت‌های کار به عقب است (طراحی، بار جزئی، idle). پس **سمت جلو فقط ۴ پد** دارد، با همان اندازه و فاصلهٔ ۹۰°. ظرفیت معکوس در ۲ MPa ۴٫۸ kN است، یعنی ~۲ برابر بار طراحی.
- r 50–66 فقط ۰٫۴ kW کمتر می‌دهد. شانهٔ شفت زیر پدها به r 46 می‌رسید، زیر آب‌بند ورودی (r 48).
- **حالت خرابی جدید در چک‌ها:**
  - اگر هوای پشت پروانهٔ ۲ قطع شود (شکستن لوله یا گرفتگی)، کل پشت پروانه تا آب‌بند تعادل یک حفرهٔ گردابی آزاد می‌شود. نیرو به **۱۰٫۳ kN** می‌رسد.
  - معیار: ≤ ۳٫۵ MPa و فیلم ≥ ۱۰ µm تا موتور trip کند (بدون ضریب ۱٫۵).
  - نتیجه: **۲٫۱۳ MPa و ۲۷ µm**.

**تغییرات هندسه (`cad/engine/a1000_rotor.py`):**

- ژورنال‌ها D90 × L36. لقی شعاعی یاتاقان ۶۳ µm و preload 0.3 (مثل قبل نسبت به شعاع).
- حلقهٔ ISFD و دمپر عوض نشدند (r 74–92، لقی ۰٫۱۳ mm).
- شفت جلو:
  - نشیمن آب‌بند جلوی ژورنال r 47 ← ۴۳.
  - گلوی پشت فلنج کوپلینگ r 45 ← ۴۲. دیوارهٔ جیب مهره آن‌جا ۷ mm است. تنش پیچشی ۱۱ MPa (اتصال کوتاه ژنراتور: ۶۳ MPa).
  - شانه‌های دو طرف فلنج کف‌گرد r 52 ← ۴۸.
  - فلنج کف‌گرد r 82 ← ۷۲ (۴ mm بالاتر از پدها).
- شفت عقب: گلو r 49.5 ← ۴۴٫۵، نشیمن آب‌بند عقب r 46 ← ۴۱.
- عوض نشدند: دماغهٔ هاب ورودی، دیوارهٔ عقب محفظهٔ کف‌گرد، محل فلنج کف‌گرد (x 116–136) و محل یاتاقان‌ها (x 65 و x 955).
- جرم روتور ۲۰۲٫۷ ← **۱۹۹٫۷ kg**.
- اسم قطعهٔ پدها: `TB thrust pads 8 + 4` (قبلاً `2 x 8`).

**نتیجه‌ها (`sim/engine/a1000_rotor_stack.py`):**

| | rev 1.2 | rev 1.3 |
|---|---|---|
| تلفات ژورنال‌ها | ۱۳٫۵ kW | ۸٫۷ kW |
| تلفات کف‌گرد | ۱۳٫۱ kW | ۵٫۲ kW |
| آب‌بندها (برآورد) | ۲٫۰ kW | ۲٫۰ kW |
| **جمع** | **۲۸٫۶ kW** | **۱۵٫۹ kW** |
| روغن یاتاقان‌ها | ۴۶ l/min | ۲۴ l/min |
| اثر بر راندمان برق در برابر سیکل | −۰٫۸۱ واحد | −۰٫۳۶ واحد |

| حالت | بحرانی‌ها [rpm] | حاشیهٔ مود خمشی / لازم | ارتعاش API |
|---|---|---|---|
| اسمی، rev 1.2 | ۳٬۸۸۰ / ۸٬۰۱۰ / ۲۰٬۹۲۰ | ۳۲٫۸٪ / ۲۰٫۷٪ | ۴٫۰ µm |
| **اسمی، rev 1.3** | **۳٬۷۶۰ / ۸٬۰۱۰ / ۲۱٬۲۵۰** | **۳۴٫۹٪ / ۲۱٫۸٪** | **۴٫۱ µm** |
| π-film، rev 1.3 | ۳٬۷۰۰ / ۷٬۴۶۰ / ۲۰٬۶۳۰ | ۳۱٫۰٪ / ۲۳٫۵٪ | ۴٫۴ µm |

- مود خمشی کمی بالا رفت، چون فلنج کف‌گرد و شفت‌ها سبک‌تر شدند.
- مود اول ۳٪ پایین آمد (پدها نرم‌تر شدند). همچنان با میرایی زیاد رد می‌شود (AF 2.8).
- **چک‌ها: ۳۴ از ۳۴ قبول.** دو چک جدید برای قطع هوای پشت پروانه اضافه شد.
- **باز:** برگشت لحظه‌ای نیروی محوری در trip (افت فشار کمپرسور زودتر از توربین) حساب نشده. ظرفیت سمت جلو (۴ پد) باید با یک مدل گذرا چک شود. ← انجام شد، بخش ۱۳٫۱۱.

### ۱۳٫۱۱ نیروی محوری گذرا و سمت جلوی کف‌گرد (۲۰۲۶-۱۰-۳۱)

مدل: `sim/engine/a1000_thrust_transient.py` (نتایج: `sim/engine/fea/a1000_thrust_transient.json`). `a1000_rotor_stack.py` آن را بعد از نتایج پایا اجرا می‌کند و چک‌هایش به فهرست چک روتور اضافه می‌شوند.

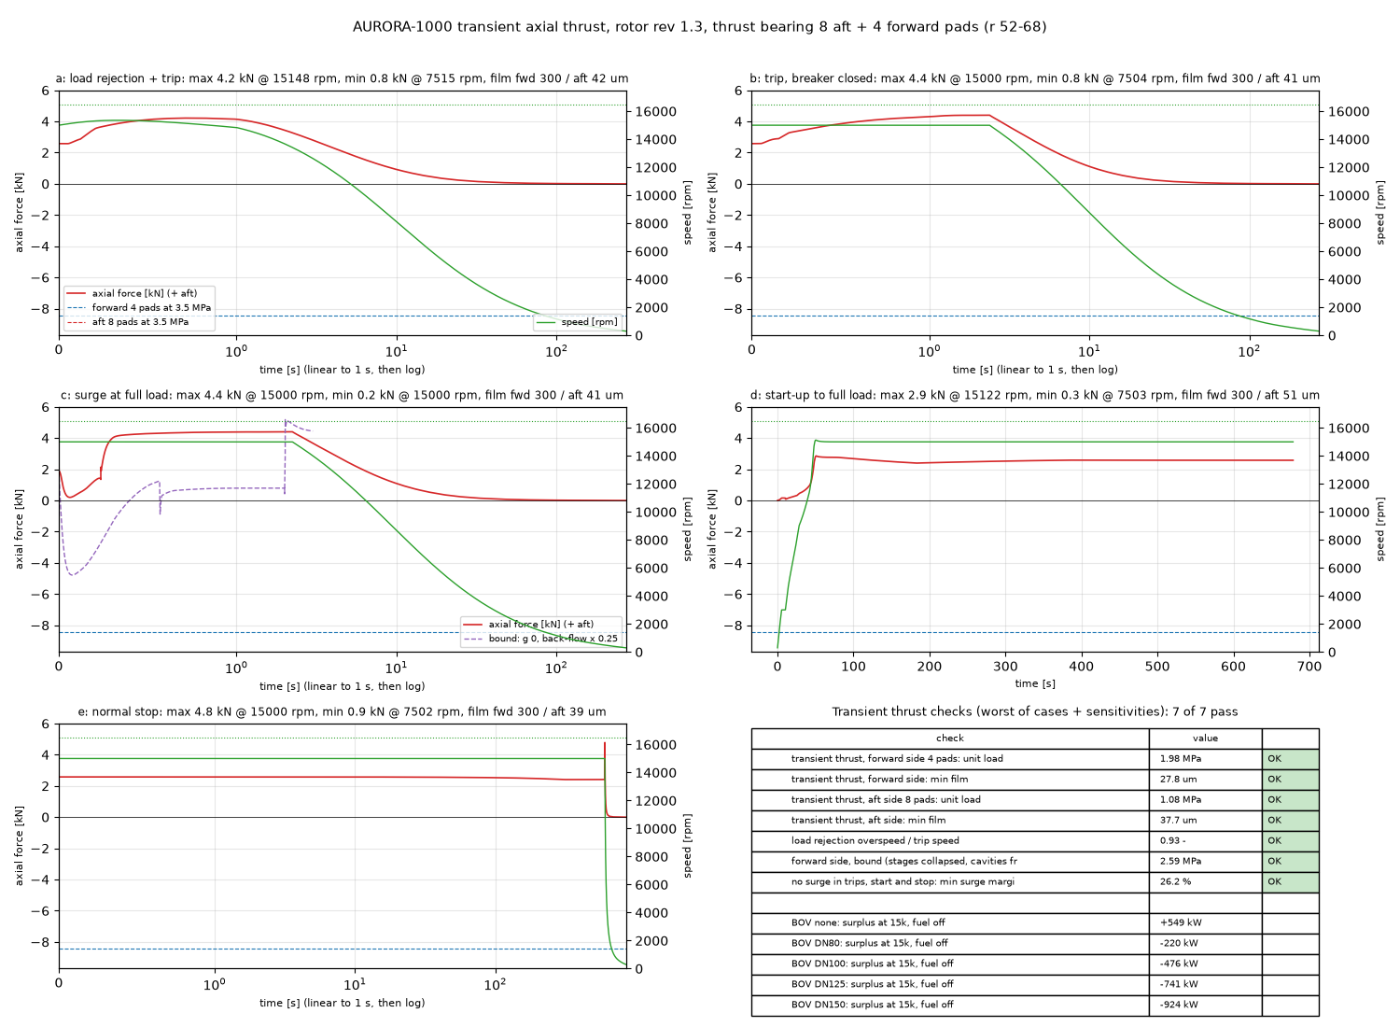
[picture p20: docs/img/a1000_thrust_transient.png]
نیروی محوری گذرا


- **سؤال (از بخش ۱۳٫۱۰):** در trip، surge، راه‌اندازی و توقف، نیروی محوری به جلو برمی‌گردد؟ سمت جلوی کف‌گرد با ۴ پد کافی است؟
- **مدل یکپارچه (lumped):**
  - کمپرسور: خطوط دور مدل راه‌اندازی، مقیاس‌شده به طراحی جزئی (PR 3.805). surge در قلهٔ خط دور. choke در گلوگاه دیفیوزرها (۱۱۰٪ دبی). فشار چشم و نوک هر پروانه از سهم طراحی آن از نسبت فشار کل.
  - دو حجم گاز:
    - A: کلکتور، بدنهٔ فشار اسکرول، بدنهٔ توربین و لوله تا recuperator، ~۰٫۹ m³.
    - B: سمت سرد recuperator، لولهٔ داغ، محفظه و اسکرول، ~۲٫۴ m³.
  - توربین: مدل ردیف‌به‌ردیف `a1000_startup.py`، جدول‌شده روی دور اصلاح‌شده و نسبت انبساط.
  - دو حفرهٔ روتور با حجم و جریان آب‌بندها، تا تأخیر حفره‌ها دیده شود:
    - پشت پروانهٔ ۲ (~۱ L): تغذیه از A، لابیرنت r 200 به نوک پروانه، آب‌بند تعادل r 85.
    - جلوی توربین (~۳ L): ورود از آب‌بند تعادل، خروج از rim seal به خروجی NGV1.
    - لابیرنت‌ها Martin هستند، مثل بخش ۱۴. سطح تغذیه و rim از فشارهای پایای بخش ۱۳٫۳ درآمد.
  - گرما: قطع سوخت (۳۰ ms تأخیر، ۶۰ ms تخلیهٔ لوله)، گرمای پس‌دادهٔ فلز اسکرول و لاینر، تأخیر ماتریس recuperator (~۷۵ s).
  - محور: J = ۳٫۱۰ kg m² (روتور، گیربکس و ژنراتور). با بریکر بسته، شبکه دور را ثابت نگه می‌دارد. رلهٔ توان معکوس: −۳٪ برای ۲ s.
  - نیرو: همان ۱۴ جملهٔ مدل پایا. هر جمله در نقطهٔ طراحی به مقدار پایایش مقیاس شد. ضریب‌ها ۰٫۹۲ تا ۱٫۰۳ هستند (فقط جملهٔ کوچک حفرهٔ پشت R2، ۱٫۳۶).
  - کنترل مدل: در ۹۵۰ °C نیرو همان **+۲٫۴۶ kN** است. در ۹۷۰ °C: **+۲٫۴۷ kN** و **۹۸۵ kW**. هوای recuperator ۶۲۶ °C است.
  - یاتاقان: بار واحد و فیلم سمت بارگرفته در **دور لحظه‌ای**. معیار گذرا برای هر دو سمت: ≤ ۳٫۵ MPa و ≥ ۱۰ µm (مثل حالت قطع هوای پشت پروانه).

**یافتهٔ اصلی: شیر تخلیهٔ کمپرسور (BOV) لازم است.**

- بعد از قطع سوخت، recuperator هنوز هوای ۶۲۶ °C می‌دهد. با همین هوا، توربین در ۱۵k **۵۴۹ kW بیشتر** از کمپرسور توان دارد.
- پس با بریکر باز، قطع سوخت موتور را نگه نمی‌دارد. بدون BOV دور در **۱٫۵ s به ۱۶٬۵۰۰ rpm** و در ۱۰ s به **۱۸٬۹۶۰ rpm** می‌رسد، و هنوز بالا می‌رود.
- **راه‌حل:** BOV از حجم A (کلکتور یا بدنهٔ فشار اسکرول) به دودکش، بعد از recuperator.

| BOV | توان اضافه در ۱۵k، بدون سوخت، recuperator داغ (گاز ۶۰ K گرم‌تر از هوای recuperator) | دبی تخلیه | فشار خروج کمپرسور |
|---|---|---|---|
| ندارد | **+۵۴۹ kW** (شتاب می‌گیرد) | — | ۳٫۶۴ bar |
| DN80 | −۲۲۰ kW | ۲٫۰ kg/s | ۲٫۶۶ bar |
| DN100 | −۴۷۶ kW | ۲٫۸ kg/s | ۲٫۳۰ bar |
| **DN125 (انتخاب)** | **−۷۴۱ kW** | **۳٫۶ kg/s** | **۱٫۹۰ bar** |
| DN150 | −۹۲۴ kW | ۴٫۲ kg/s | ۱٫۶۰ bar |

- DN125: تأخیر ۵۰ ms و باز شدن در ۱۵۰ ms. در هر trip و توقف باز می‌شود.
- در راه‌اندازی ۳۰٪ باز است و بین ۷۵ و ۸۵٪ دور بسته می‌شود (bleed راه‌اندازی). بدون آن، حاشیهٔ surge زیر ۵۰٪ دور به صفر می‌رسید.
- در بی‌باری با recuperator داغ، حتی سوخت صفر دور را نگه نمی‌دارد. پس governor بی‌باری باید BOV را هم باز کند. توقف عادی با بریکر بسته انجام می‌شود (حالت e).

**حالت‌ها:**

| حالت | شرح |
|---|---|
| a | قطع بار + trip در ۹۸۵ kW. بریکر باز، قطع سوخت و فرمان BOV، همه در t = 0. |
| b | trip با بریکر بسته. شبکه دور را نگه می‌دارد. توان معکوس در ۰٫۳۸ s، بریکر در ۲٫۳۸ s باز می‌شود، بعد توقف آزاد. |
| c | surge در بار کامل (بریکر بسته). افزایش فشار کمپرسور در ۲۰ ms تا ۴۰٪ می‌افتد. هوای plenum از کمپرسور برمی‌گردد. تشخیص، trip و BOV در ۰٫۱ s. بازیابی در ۰٫۲۴ s. |
| d | راه‌اندازی: استارتر تا ۲۰٪، purge، روشن شدن، شتاب با TIT ۶۵۰ °C، بی‌باری، سنکرون، افزایش بار در ۳۰۰ s تا ۹۸۵ kW. |
| e | توقف عادی: کاهش بار در ۳۰۰ s تا TIT ۶۵۰ °C، ۳۰۰ s خنک شدن، قطع سوخت و BOV با بریکر بسته، توان معکوس، توقف آزاد. |

**نتیجه‌ها (+ = به عقب):**

| حالت | بیشینهٔ نیرو | کمینهٔ نیرو (بالای ۵۰٪ دور) | بیشینهٔ دور | سمت عقب (۸ پد): فشار / فیلم | سمت جلو (۴ پد) |
|---|---|---|---|---|---|
| a | +۴٫۱۷ kN در ۱۵٬۱۰۰ rpm | +۰٫۷۶ kN در ۷٬۵۰۰ rpm | **۱۵٬۳۵۰ rpm** (۰٫۳۴ s) | ۰٫۸۶ MPa / ۴۲ µm | بار نمی‌گیرد |
| b | +۴٫۳۷ kN در ۱۵٬۰۰۰ | +۰٫۷۶ kN در ۷٬۵۰۰ | ۱۵٬۰۰۰ | ۰٫۹۱ / ۴۱ | بار نمی‌گیرد |
| c | +۴٫۳۸ kN در ۱۵٬۰۰۰ | **+۰٫۱۱ kN** در ۱۵٬۰۰۰ (۶۲ ms) | ۱۵٬۰۰۰ | ۰٫۹۱ / ۴۱ | بار نمی‌گیرد |
| d | +۲٫۷۷ kN در ۱۵٬۱۲۰ (بی‌باری، recuperator سرد) | +۰٫۲۷ kN در ۷٬۵۰۰ | ۱۵٬۱۳۰ | ۰٫۵۷ / ۵۲ | بار نمی‌گیرد |
| e | +۴٫۷۶ kN در ۱۵٬۰۰۰ | +۰٫۸۷ kN در ۷٬۵۰۰ | ۱۵٬۰۰۰ | ۰٫۹۹ / ۳۹ | بار نمی‌گیرد |

- زیر ۵۰٪ دور نیرو کمتر از ۰٫۹ kN است. فیلم کمینه همیشه در دور کامل است.
- **چرا نیرو به جلو برنمی‌گردد:**
  - در این روتور سهم کمپرسور رو به جلو است: پشت پروانهٔ ۲ با هوای فشرده −۲۷٫۵ kN.
  - سهم توربین رو به عقب است: حفرهٔ تعادل جلوی توربین +۱۹٫۹ kN.
  - در trip، BOV حجم A را خالی می‌کند. فشار پشت پروانه زودتر از حفرهٔ توربین می‌افتد، چون حفرهٔ توربین از حجم بزرگ B تغذیه می‌شود. پس نیرو **به عقب** می‌رود، نه جلو.
  - برگشت فقط در surge ممکن است: فشار داخل پروانه‌ها در چند ده ms می‌افتد، ولی پشت پروانهٔ ۲ هنوز از A پر است.
  - در surge پایه نیرو تا +۰٫۱۱ kN پایین می‌آید، ولی برنمی‌گردد. دلیل: حجم A هم از راه کمپرسور به عقب خالی می‌شود، و فشار پشت پروانه با آن پایین می‌آید.

**حساسیت (۳ ثانیهٔ اول a، b و c):**

| تغییر | کمینهٔ نیرو | سمت جلو: فشار / فیلم |
|---|---|---|
| حجم A یا B: ×۰٫۵ و ×۲ | a و b بدون تغییر؛ c از −۰٫۲۷ تا +۰٫۵۹ kN | ۰٫۱۱ MPa / ۱۱۸ µm |
| حجم حفره‌ها: ×۰٫۳۳ و ×۳ | c از −۰٫۱۳ تا +۰٫۷۷ kN | ناچیز |
| زمان باز شدن BOV: ۰٫۱ و ۰٫۴ s | بدون تغییر؛ دور بیشینه ۱۵٬۳۲۰ تا ۱۵٬۴۶۰ rpm | — |
| surge: سهم باقی‌ماندهٔ فشار ۰٫۶ / ۰٫۲ / ۰ | +۱٫۲۹ / −۱٫۲۲ / −۲٫۶۷ kN | ۰٫۵۰ / ۵۵ و ۱٫۱۱ / ۳۷ |
| surge: افت در ۱۰ / ۴۰ ms | −۰٫۱۶ / +۰٫۵۱ kN | ناچیز |
| surge: برگشت هوای plenum ×۰٫۲۵ | −۱٫۲۴ kN | ۰٫۵۱ / ۵۴ |
| **surge مرزی: فروپاشی کامل + برگشت ×۰٫۲۵** | **−۴٫۸۷ kN** | **۲٫۰۲ MPa / ۲۸ µm** |
| **کران بالا: فروپاشی کامل، plenum و حفره‌ها ثابت** | **−۶٫۳۷ kN** | **۲٫۶۴ MPa / ۲۴ µm** |

**نتیجه:**

- **سمت جلو با ۴ پد قبول است.** حتی در کران بالا: ۲٫۶۴ MPa (حد ۳٫۵) و ۲۴ µm (حد ۱۰). ظرفیت ۴ پد در ۳٫۵ MPa، ۸٫۴ kN است.
- سمت عقب: بدترین ۵٫۲ kN، ۱٫۰۸ MPa و ۳۸ µm.
- **روتور و یاتاقان عوض نشدند.** CAD، STEP و فیوژن دست نخوردند. پد بیشتر یا تغییر شعاع آب‌بند لازم نیست.
- BOV فقط در گذرا کار می‌کند. روی نقطهٔ کار و راندمان اثر ندارد.

**چک‌ها: ۷ چک گذرا به فهرست روتور اضافه شد. ۴۱ از ۴۱ قبول.**

| چک | مقدار | حد |
|---|---|---|
| بار واحد سمت جلو (بدترین حالت و حساسیت) | ۲٫۰۲ MPa | ≤ ۳٫۵ |
| فیلم سمت جلو | ۲۸ µm | ≥ ۱۰ |
| بار واحد سمت عقب | ۱٫۰۸ MPa | ≤ ۳٫۵ |
| فیلم سمت عقب | ۳۸ µm | ≥ ۱۰ |
| اضافه‌دور در قطع بار | ۱۵٬۳۵۰ rpm (۰٫۹۳) | ≤ ۱۶٬۵۰۰ |
| کران بالای سمت جلو | ۲٫۶۴ MPa، ۲۴ µm | ≤ ۳٫۵، ≥ ۱۰ |
| بدون surge در trip، راه‌اندازی و توقف | حاشیهٔ کمینه ۲۶٪ | > ۰ |

**باز:**

1. BOV DN125 و لولهٔ تخلیهٔ آن (۳٫۶ kg/s، با صداخفه‌کن) در طراحی اگزوز و کانال‌های recuperator دیده شود (فاز ۲). **انجام شد: بخش ۱۸ (EX-441).**
2. منطق کنترل: BOV در هر trip و توقف، bleed راه‌اندازی، governor بی‌باری با BOV، رلهٔ توان معکوس. در حالت b ژنراتور ۲ s با ~۷۵۰ kW موتوری کار می‌کند.
3. حجم‌ها، عمق surge و نقشهٔ کمپرسور فرض‌اند. بعد از فاز ۲ (حجم واقعی کانال‌ها) و فاز ۶ (نقشهٔ کمپرسور) دوباره اجرا شود.
4. حسگرها (فاز ۷): جابه‌جایی محوری روتور و دمای پد در هر دو سمت کف‌گرد.

## ۱۶. سیستم احتراق: محفظهٔ عمودی DLE و اسکرول ورودی NGV1، rev 1 (۲۰۲۶-۱۰-۳۰)

هندسه: `cad/engine/a1000_combustor.py` · محاسبه: `sim/engine/a1000_combustor.py` (نتایج: `sim/engine/fea/a1000_combustor.json`) · شیمی: `sim/engine/a1000_combustor_chem.py` (Cantera، GRI-Mech 3.0؛ نتایج: `sim/engine/fea/a1000_combustor_chem.json`) · فیوژن: `fusion/A1000_comb` (۱۶ قطعه) و داخل پکیج STEP

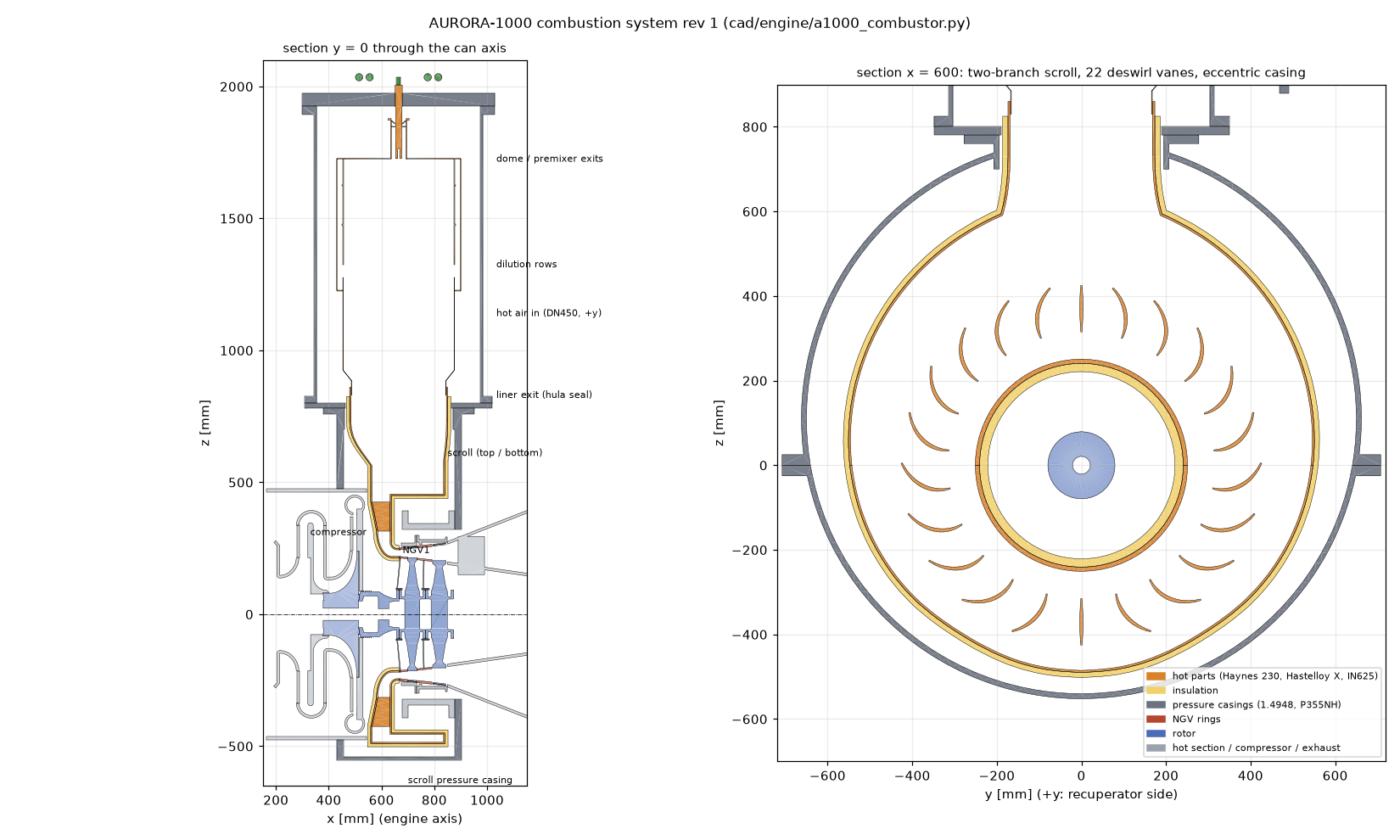
[picture p21: docs/img/a1000_combustor_section.png]
مقطع سیستم احتراق


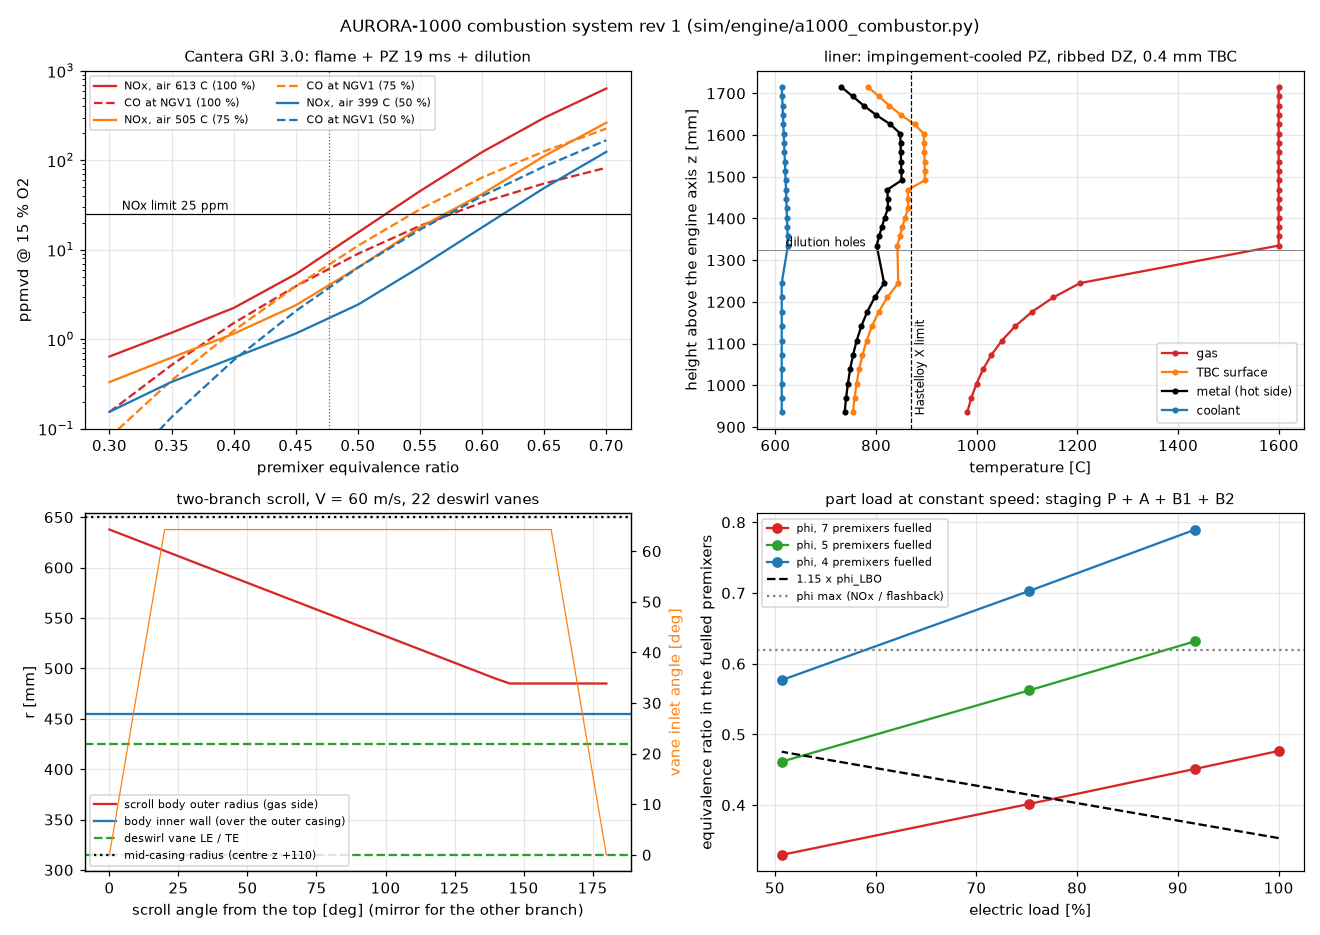
[picture p22: docs/img/a1000_combustor.png]
محاسبه‌ها


### ۱۶٫۱ نقطهٔ طراحی

| | مقدار |
|---|---|
| هوای ورودی محفظه (از recuperator) | **۶٫۲۲ kg/s، ۶۱۳ °C، ۳٫۶۹ bar** (۱٫۵٪ هوا قبل از recuperator به نشتی‌ها می‌رود) |
| فشار ورودی NGV1 (طراحی توربین) | ۳٫۵۴۷ bar، پس بودجهٔ افت فشار محفظه و اسکرول **۴٫۰٪** است |
| سوخت | ۰٫۰۵۸۹ kg/s، **۲۷۷ Sm³/h** گاز شهری، ۲۶۴۷ kW |
| نسبت هم‌ارزی کل | **۰٫۱۴۵** (افزایش دما فقط ۳۳۷ K است، چون هوا از recuperator داغ می‌آید) |
| ترکیب گاز (فرض) | CH4 ۸۷٫۵٪، C2H6 ۵٪، C3H8 ۲٪، N2 ۴٫۵٪، CO2 ۱٪ ← LHV ۳۴٫۴ MJ/Sm³ (مقدار پروژه ۳۴٫۵) |
| گاز «غنی» برای حساسیت | C2H6 ۱۰٪ و C3H8 ۵٪ (حالت بدتر برای اشتعال خودبه‌خودی و flashback) |

- آنالیز واقعی گاز سایت هنوز نیست. باید گرفته شود.

### ۱۶٫۲ چیدمان و دلیل هر انتخاب

**محفظه (can):**
- عمودی، بالای ورودی توربین، محور در x = 665.
- لاینر Ø420. ناحیهٔ اولیه (PZ) ۴۰۰ mm و ناحیهٔ رقیق‌سازی (DZ) ۴۰۰ mm است.
- **دیوارهٔ دوتایی دور لاینر:**
  - هوای داغ از پایین وارد می‌شود و در حلقهٔ بیرونی بالا می‌رود.
  - روی PZ، ۶۶٫۵٪ هوا از ۱۹۸۴ سوراخ Ø6 یک «پوستهٔ جت» (impingement sleeve) به پشت لاینر می‌خورد.
  - همین هوا در شکاف داخلی پایین می‌آید و از سوراخ‌های رقیق‌سازی وارد لاینر می‌شود.
  - بقیهٔ هوا (۳۰٫۵٪) به سر محفظه می‌رسد و به ۷ پیش‌مخلوط‌کن می‌رود.
- **چرا این شکل؟** هوای پیش‌مخلوط به لاینر داغ نمی‌خورد و گرم نمی‌شود. دمایش همان ۶۱۳ °C می‌ماند. این برای اشتعال خودبه‌خودی و flashback مهم است. در چیدمان معمول (یک حلقه، جریان معکوس) هوای پیش‌مخلوط حدود ۴۰ K گرم‌تر می‌شد.

**اسکرول (hot-gas casing):**
- گردن از خروجی لاینر پایین می‌آید و به یک **اسکرول دوشاخه** می‌رسد. هر شاخه از بالا تا پایین دور موتور می‌رود.
- اسکرول روی بدنهٔ بیرونی توربین (بخش ۱۴) نشسته است. فضای محوری جلوی NGV1 فقط ~۱۲۰ mm است (کمپرسور rev 1 تا x 543 می‌آید). پس بدنهٔ اسکرول به عقب و روی بدنهٔ توربین رفته است (x 564 تا 835).
- گاز از اسکرول از یک کانال شعاعی رو به داخل با **۲۲ پرهٔ حذف چرخش** می‌گذرد. بعد با یک خم شتاب‌دار وارد حلقهٔ NGV1 می‌شود (x 669، r 219–244).
- **چرا پره‌های حذف چرخش؟** NGV1 برای ورود محوری طراحی شده (بخش ۱۲). سرعت گاز در اسکرول عمدتاً محیطی است. بدون پره، گاز با زاویهٔ حدود ±۲۶° و در دو نیمه با جهت مخالف به NGV1 می‌رسید.
- جنس: Haynes 230، **بدون خنک‌کاری**. بیرونش ۱۲ mm عایق microporous در کاست فویلی است. دیواره نزدیک دمای گاز (~۹۴۵ °C) کار می‌کند. پس تنش حرارتی کم است.
- اسکرول و حلقهٔ پره‌ها **دو نیمهٔ افقی** دارند، مثل بدنهٔ توربین. روتور یکجا نصب می‌شود (بخش ۱۳).

**بدنهٔ فشار اسکرول (mid-casing):**
- استوانهٔ خارج از مرکز (R 650، مرکز ۱۱۰ mm بالاتر از محور)، P355NH، دوتکهٔ افقی. از x 430 (فلنج کمپرسور) تا x 903 (فلنج عقب بدنهٔ توربین) است.
- هوای کمپرسور (۱۷۵ °C، ۳٫۷۹ bar) از کلکتور وارد آن می‌شود و دور اسکرول می‌چرخد. بعد زیر بدنهٔ اسکرول در امتداد بدنهٔ توربین جلو می‌آید. سپس دور فلنج جلوی بدنهٔ توربین وارد کانال‌های C1 و C2 می‌شود.
- **نتیجه:** رابط بخش ۱۴ عوض نمی‌شود (همهٔ هوای کمپرسور از کانال‌ها رد می‌شود). دیوارهٔ داغ اسکرول فقط اختلاف فشار ~۰٫۲۴ bar را تحمل می‌کند. فشار ۲٫۸ bar(g) را بدنهٔ سرد می‌گیرد.
- بدنهٔ بیرونی توربین حالا داخل این بدنه است. دو طرفش فشار یکسان است.

### ۱۶٫۳ پیش‌مخلوط‌کن‌ها

| | مقدار |
|---|---|
| تعداد | **۷**: یک پیلوت در مرکز + ۶ اصلی روی دایرهٔ r 128 |
| نوع | چرخاننده (swirler) محوری ۱۰ پره با زاویهٔ ۳۵°، بدنهٔ مرکزی با جت هوای محوری |
| قطر خروج / بدنهٔ مرکزی | **Ø56 / Ø23 mm**، لولهٔ اختلاط ۱۲۳ mm |
| سرعت خروج، عدد چرخش | **۸۹ m/s**، S = 0.52 |
| افت فشار | **۲٫۸٪** |
| φ و دمای شعله در بار کامل | **۰٫۴۷۷**، T_ad = 1873 K (دمای مخلوط ۸۴۱ K) |
| زمان ماندن در پیش‌مخلوط‌کن | ۲٫۲۵ ms |
| تزریق سوخت | ۱۰ سوراخ Ø1.78 روی پره‌های چرخاننده، اختلاف فشار ۰٫۳ bar، نفوذ جت تا وسط کانال |
| حاشیهٔ فشار گاز بدون بوستر | **۰٫۱۳ bar** (ایستگاه حداقل ۳٫۵ barg، منهای ۰٫۴ bar شیرها) |
| جنس | IN625 |

- سوراخ‌ها کوچک‌اند. **فیلتر ۵ µm** روی خط گاز لازم است.

### ۱۶٫۴ flashback و اشتعال خودبه‌خودی (ریسک اصلی بخش ۵)

سرعت شعلهٔ آرام (S_L) با Cantera در هوای ۶۱۳ °C حساب شد:

| حالت | φ | S_L m/s | حاشیهٔ flashback لایهٔ مرزی | حاشیهٔ flashback هسته (U / S_T) |
|---|---|---|---|---|
| طراحی | 0.48 | 0.66 | ۹۰ | ۱۰٫۷ |
| اوج ناهمگنی (+۳σ) | 0.56 | 0.92 | ۴۵ | ۸٫۹ |
| روز داغ | 0.56 | 0.94 | ۴۴ | ۸٫۸ |
| گذرا (پرش سوخت) | 0.65 | 1.20 | ۲۷ | ۷٫۷ |
| **گاز غنی + گذرا** | 0.65 | 1.27 | **۲۴** | **۷٫۴** |
| معیار | | | ≥ ۳ | ≥ ۳ |

- معیار لایهٔ مرزی: گرادیان سرعت دیواره در برابر ۱۰ برابر مقدار Lewis–von Elbe (برای شعلهٔ محصور).
- عدد چرخش ۰٫۵۲ و جت هوای محوری بدنهٔ مرکزی، خطر CIVB را کم نگه می‌دارد.
- **قاعدهٔ طراحی:** در پیش‌مخلوط‌کن هیچ ناحیهٔ جریان برگشتی نباشد: لبهٔ پره‌ها تیز، دیواره‌ها صاف، نوک بدنهٔ مرکزی با جت هوا.

اشتعال خودبه‌خودی (کمترین زمان روی φ = 0.1 تا 1.0):

| هوا | گاز | τ اشتعال | نسبت به زمان ماندن | با فرض خطای ۱۰ برابری GRI |
|---|---|---|---|---|
| ۶۱۳ °C | معمولی | 2.1 s | ۹۳۴ | ۹۳ |
| ۶۱۹ °C (روز داغ) | غنی | 1.6 s | ۷۱۵ | ۷۱ |
| ۶۴۴ °C (روز داغ + ۲۵ K) | غنی | 0.85 s | ۳۷۸ | **۳۸** (معیار ≥ ۱۰) |

- GRI 3.0 زیر ۱۰۰۰ K برای گاز با C2+ زمان تأخیر را بلند پیش‌بینی می‌کند (۲ تا ۱۰ برابر). برای همین حاشیه با ضریب ۱۰ گزارش شد.
- **نکتهٔ ایمنی:** هوای recuperator بالای دمای اشتعال خودبه‌خودی گاز (~۵۴۰ °C) است. پس:
  - هیچ اتصال سوختی داخل محفظهٔ هوای داغ نباشد. منیفولدها روی درپوش بالا و بیرون‌اند.
  - بعد از trip، recuperator تا حدود یک ساعت داغ می‌ماند. روشن کردن دوباره فقط با purge کامل باشد و سوخت بدون شعله وارد نشود. این با مهلت قفل بخش ۱۴ هماهنگ شود.

### ۱۶٫۵ NOx و CO

مدل: شعلهٔ یک‌بعدی، بعد PFR در ناحیهٔ اولیه (۱۸٫۸ ms)، بعد رقیق‌سازی تا TIT و PFR در DZ و اسکرول (۲۵ ms). ناهمگنی مخلوط با توزیع گاوسی φ (S = σφ/φ) دیده شد.

| بار کامل | NOx ppm (۱۵٪ O2) | CO ppm |
|---|---|---|
| مخلوط کامل | 9.4 | 6.1 |
| S = 0.06 (هدف طراحی) | **11.3** | 6.7 |
| S = 0.10 | 15.5 | 7.7 |
| روز داغ، S = 0.10 | 15.1 | 7.6 |
| **هدف** | **< 25** | |

- **حساسیت به φ زیاد است:** در φ = 0.50 حدود ۱۵ ppm و در φ = 0.55 حدود ۴۲ ppm (۱۵ ms). علت NO حرارتی پس از شعله است. پس:
  - تقسیم سوخت بین پیش‌مخلوط‌کن‌ها باید یکنواخت باشد (±۳٪).
  - ناحیهٔ اولیه نباید بلندتر شود.
- شعلهٔ پیلوت انتشاری حدود **۲۵ g NOx/kg سوخت** می‌دهد. پس در بار ≥ ۵۰٪ سوخت انتشاری صفر است.

### ۱۶٫۶ خنک‌کاری و دمای لاینر

| | مقدار |
|---|---|
| لاینر | Hastelloy X 1.6 mm + TBC (YSZ) 0.4 mm |
| PZ | جت (impingement): ۱۹۸۴ × Ø6، x/d 2.9، z/d 3.7، ۶۴ m/s، افت ۰٫۸٪، h ≈ ۱۳۸۰ W/m²K (با کاهش ناشی از جریان عرضی) |
| DZ | جریان حلقهٔ بیرونی با رینگ‌های زبر، h ≈ ۲۴۰ W/m²K |
| **بیشترین دمای فلز** | **۸۵۱ °C** (حد ۸۷۰ °C) |
| بیشترین دمای سطح TBC | ۸۹۷ °C (حد ۱۱۵۰ °C) |
| گرمای گرفته‌شده از PZ | ۶۰ kW (هوای رقیق‌سازی ۱۲ K گرم می‌شود) |
| سوراخ‌های رقیق‌سازی | ۱۸ × Ø47 و ۱۸ × Ø33 در دو ردیف، افت ۱٫۹٪، J = 47 |

- حاشیهٔ دمای فلز فقط ۱۹ K است. نقطهٔ داغ در پایین PZ است، جایی که جریان عرضی جت‌ها را ضعیف می‌کند. اگر تست دمای بالاتری نشان دهد، افت فشار جت‌ها به ۱٫۰٪ برسد یا TBC به ۰٫۵ mm.

### ۱۶٫۷ افت فشار (درصد از ۳٫۶۹ bar)

| بخش | ٪ |
|---|---|
| نازل ورود هوای داغ DN450 | 0.16 |
| حلقهٔ بیرونی و چرخش سر محفظه | 0.04 |
| **پیش‌مخلوط‌کن‌ها** | **2.80** |
| گرما دادن در PZ و اختلاط جت‌های رقیق‌سازی | 0.28 |
| خروجی لاینر و گردن | 0.03 |
| تقسیم دوشاخهٔ اسکرول (با پرهٔ جداکننده) | 0.24 |
| اصطکاک اسکرول و حرکت گاز به جلو در بدنه | 0.19 |
| ۲۲ پرهٔ حذف چرخش | 0.05 |
| خم و ورود به NGV1 | 0.12 |
| **جمع** | **۳٫۹۰** (بودجه ۴٫۰۰؛ فشار NGV1 ۳٫۵۵۰ bar) |

### ۱۶٫۸ اسکرول: یکنواختی جریان و دما در NGV1

| | مقدار |
|---|---|
| دبی حجمی گاز | ۶٫۱۹ m³/s، سرعت محیطی اسکرول ۶۰ m/s |
| شعاع بیرونی بدنه | ۶۳۸ (بالا) ← ۵۴۳ (کنار) ← ۴۸۵ mm (پایین) |
| پره‌های حذف چرخش | ۲۲ عدد، r 425 → 315، ورود ۶۴°، خروج شعاعی (با جبران انحراف ۱۳°)، وتر ۱۳۰ mm، solidity 1.23، ضریب نفوذ Lieblein ۰٫۵۰، de Haller ۰٫۸۷ |
| اختلاف دبی دور حلقهٔ NGV1 | **۲٫۲٪** |
| چرخش باقی‌مانده در NGV1 | ۱٫۶° (اگر پره‌ها ۳° خطا داشته باشند) |
| pattern factor | خروجی لاینر ۰٫۱۰ ← ورودی NGV1 **۰٫۰۶۸** (اختلاط در اسکرول)؛ RTDF ≈ ۰٫۰۳۴ |
| داغ‌ترین نقطه در NGV1 | **~۹۷۳ °C** (میانگین ۹۵۰) |
| اتلاف گرما | اسکرول ۷٫۰ kW به هوای کمپرسور، محفظه ۱٫۲ kW؛ کمتر از ۰٫۵٪ مجاز سیکل، پس راندمان عوض نمی‌شود |

- **انتخاب تعداد پره (۲۲):**
  - نمودار Campbell blisk‌ها: EO22 حاشیهٔ ۱۰٫۸٪ با R1 و ۱۷٫۷٪ با R2 دارد.
  - EO24 عمداً کنار گذاشته شد (مشکل EO24 روی R1، بخش ۱۲٫۴٫۱).
  - یک پره در بالا (جداکنندهٔ دو شاخه) و یک پره در پایین است. هیچ پره‌ای روی خط جدایش افقی نیست.
- pattern factor با همبستگی Lefebvre و یک ضریب اختلاط برای اسکرول تخمین زده شد. **باید با CFD تأیید شود.**

### ۱۶٫۹ بار جزئی، مرحله‌بندی و روشن کردن

دور ثابت و دبی هوا ثابت است. پس با کم شدن بار، TIT پایین می‌آید و هوای recuperator هم سردتر می‌شود. سوخت در **چهار مدار** است: P (پیلوت مرکزی)، A (۳ اصلی یک‌درمیان)، B1 (۱ اصلی)، B2 (۲ اصلی).

| بار | TIT / هوا | پیش‌مخلوط‌کن روشن | φ | حد خاموشی ×۱٫۱۵ | NOx | CO |
|---|---|---|---|---|---|---|
| ۱۰۰٪ | 950 / 613 °C | ۷ (P+A+B1+B2) | 0.48 | 0.35 | 11.3 | 7 |
| ۹۲٪ | 900 / 577 °C | ۷ | 0.45 | 0.38 | 4.7 | 5 |
| ۷۵٪ | 800 / 505 °C | **۵** (P+A+B1) | 0.56 | 0.41 | 10.3 | 1 |
| ۵۱٪ | 650 / 399 °C | **۴** (P+A) | 0.58 | 0.48 | 8.0 | 0 |

- حد خاموشی از زمان خاموشی PSR (Cantera) آمده است. ناحیهٔ لنگر شعله ~۱٫۷ ms زمان ماندن دارد، با ضریب اطمینان ۳.
- حاشیهٔ خاموشی در بار کامل: φ / φ_LBO = **۱٫۵۵**.
- CO در CRN برای حالت‌های مرحله‌ای خیلی کم است. در عمل، CO در لبهٔ شعله‌های روشن کنار پیش‌مخلوط‌کن خاموش بیشتر می‌شود. باید در تست دیده شود.
- زیر ~۴۵٪ بار، سوخت انتشاری پیلوت کمک می‌کند. NOx آنجا تضمین نمی‌شود. برای CHP دائم، کار در ۷۰ تا ۱۰۰٪ است.
- **روشن کردن:**
  - در ~۲۰٪ دور. هوا ۱٫۲۶ kg/s، recuperator سرد.
  - نوک انتشاری پیلوت (φ محلی ~۱٫۵)، ~۲۴۰ kW سوخت، φ کل ۰٫۰۶۵.
  - جرقه‌زن در گوشهٔ گنبد، دو حسگر UV.
  - بعد شتاب تا دور کامل، بعد پیش‌مخلوط پیلوت، بعد A، B1، B2.

### ۱۶٫۱۰ سازه، انبساط و جرم

| قطعه | جنس | نتیجه |
|---|---|---|
| بدنهٔ محفظه، ID 620 × 10 mm | 1.4948 (304H) در ۶۴۰ °C | ضخامت لازم ۳٫۲ mm (خزش، R_u ~۶۰ MPa / ۱٫۵)؛ تنش حلقوی ۱۱ MPa |
| درپوش سر محفظه، ۵۰ mm | 1.4948 | لازم ۳۲ mm |
| لاینر | Hastelloy X | کمانش با فشار بیرونی: p_cr / Δp = ۱۰۲ (رینگ هر ۱۵۰ mm) |
| دیوارهٔ اسکرول ۵ mm با ریب هر ۷۰ mm | Haynes 230 در ۹۵۰ °C | خمش پنل ۲٫۳ MPa، غشایی ۲٫۶ MPa؛ مجاز (خزش ۱۰۵ h، فرض) ۳٫۰ MPa |
| بدنهٔ فشار اسکرول، ۱۲ mm | P355NH در ۲۰۰ °C | تنش حلقوی ۱۹ MPa؛ ۱۰ پیچ M20 10.9 در درز افقی |
| انبساط | | اسکرول شعاعی ۸٫۳ mm روی ۴ پین شعاعی؛ آب‌بند hula در خروجی لاینر: هم‌پوشانی ۳۰ mm سرد، ۴۲ mm گرم؛ فاصلهٔ مخروط لاینر تا گردن ۱۳ mm گرم؛ اختلاف شعاعی با حلقهٔ NGV1 ۰٫۴ mm (W-seal) |

**جرم (CAD):** کل ~۱٫۲۲ t. بدنهٔ فشار اسکرول ۵۵۵ kg، بدنهٔ محفظه + درپوش + کف ۴۳۷ kg، اسکرول و پره‌ها ۱۵۹ kg، لاینر و پوستهٔ جت ۳۲ kg، پیش‌مخلوط‌کن‌ها ۱۳ kg.

**تداخل CAD:** با روتور rev 1، بخش داغ rev 1، NGV1، کمپرسور rev 1.1، اگزوز و recuperator: **صفر** (فقط ۲–۳ mm³ خطای عددی بین اسکرول و عایق).

### ۱۶٫۱۱ رابط‌ها با بخش‌های دیگر

1. **کمپرسور (بخش ۱۵):**
   - کلکتور هوا را به جای خروجی DN300، از **دریچه‌هایی در بدنهٔ استوانه‌ای (x 455–540، r 476)** به بدنهٔ فشار اسکرول می‌دهد.
   - فلنج جلوی این بدنه در x 430، دور استوانهٔ کمپرسور (r 478) است.
   - کمپرسور باید عقب‌تر از x 543 نیاید. دیوارهٔ جلوی اسکرول با عایقش از x 547 شروع می‌شود.
2. **بخش داغ (بخش ۱۴):**
   - مسیر هوا عوض نشد.
   - صفحهٔ عقب بدنهٔ فشار اسکرول به فلنج عقب بدنهٔ توربین پیچ می‌شود (x_mc1 از CAS خوانده می‌شود).
   - **rev 6:** فلنج عقب بدنهٔ توربین از x 878 به **x 903** رفت (فاصلهٔ R1 تا NGV2 ۲۵ mm بیشتر، بخش ۱۴٫۱). بدنهٔ فشار اسکرول هم ۲۵ mm بلندتر شد (x 430 تا 928، ~۱۰ kg بیشتر). خود اسکرول (x 564 تا 835) و NGV1 جابه‌جا نشدند. محاسبه دوباره اجرا شد: باز هم ۳۰ از ۳۰ قبول؛ نیروی درز بدنهٔ فشار ۲۱۵ ← ۲۲۷ kN.
3. **recuperator:**
   - هوای کمپرسور حالا از انتهای اگزوز (منیفولد عقب، باز) به recuperator می‌رود. لوله در مدل مفهومی پکیج جابه‌جا شد (x 1080؛ در rev 6 همراه بدنه x 1105).
   - هوای داغ با **DN450** (۲۸ m/s) به نازل محفظه در z 1140 می‌رسد.
4. **ارتفاع پکیج:** بالای منیفولدهای سوخت در z ≈ ۲۰۶۵ mm است (بخش ۱۹: چهار مدار P، A، B1، B2؛ بالای خط B1 در z ≈ ۲۱۹۵). با کف skid در −۱۰۰۰، ارتفاع **~۳٫۱ m** می‌شود (طرح مفهومی ۲٫۸ m).

### ۱۶٫۱۲ چک‌ها: ۳۰ از ۳۰ قبول

افت فشار، حاشیهٔ فشار گاز، نفوذ جت سوخت، flashback (لایهٔ مرزی، هسته، CIVB)، اشتعال خودبه‌خودی، NOx و CO، حاشیهٔ خاموشی، پرهٔ حذف چرخش (DF و de Haller)، دمای فلز و TBC، نفوذ جت رقیق‌سازی، pattern factor، یکنواختی دبی، چرخش باقی‌مانده، اتلاف گرما، چهار نقطهٔ بار جزئی، ضخامت بدنه‌ها، کمانش لاینر، خزش دیوارهٔ اسکرول، و آب‌بند hula.

### ۱۶٫۱۳ محدودیت‌ها و قدم بعدی

1. **تست rig پیش‌مخلوط‌کن با هوای ۶۱۳ °C** (پیش از ساخت محفظهٔ کامل): flashback، خاموشی، NOx، و نوسان احتراق (acoustics، که این‌جا حساب نشده).
2. **CFD:**
   - اختلاط غیرواکنشی اسکرول و پره‌ها برای pattern factor واقعی و دبی دور حلقه.
   - CFD واکنشی برای PZ.
   - روی مک‌بوک با OpenFOAM.
3. **دادهٔ شیمی:** اشتعال خودبه‌خودی زیر ۱۰۰۰ K با مکانیزم جدیدتر (مثل AramcoMech) یا دادهٔ RCM دوباره چک شود.
4. **آنالیز گاز شهری سایت:** C2+، H2S، رطوبت، گردوغبار. عددهای گاز غنی بر اساس فرض‌اند.
5. **خزش Haynes 230 در ۹۵۰ °C:** داده با تأمین‌کننده تأیید شود. گزینهٔ ریخته‌گری 1.4852 با دیوارهٔ ضخیم‌تر هم هست.
6. **ارتعاش:** پاسخ اجباری EO22 از پره‌های حذف چرخش. همچنین مرتبهٔ تداخلی ۴۸ − ۲۲ = EO26، که حاشیه‌اش با R2 ND10 ۶٫۶٪ است (ضعیف ولی دیده شود).
7. **منطق کنترل:** چهار شیر مرحله‌بندی، purge، قفل روشن شدن در حالت داغ، و تشخیص flashback (ترموکوپل روی پیش‌مخلوط‌کن‌ها).
8. **فیوژن:** قطعه‌ها در `fusion/A1000_comb` و `pkg.json` هستند. سند «AURORA-1000 Package» در فیوژن هنوز دوباره ساخته نشده است.

## ۱۷. عملکرد نقطهٔ طراحی با نتایج طراحی جزئی (`sim/engine/a1000_performance.py`، ۲۰۲۶-۱۰-۳۰)

- **سؤال:** با نتایج واقعی کمپرسور، توربین، احتراق و یاتاقان‌ها، موتور هنوز ۱۰۰۰ kW می‌دهد؟
- **روش:**
  - سیکل `design_chilled` از `sim/mw1_concept_study.py`، با دبی هوای ثابت ۶٫۳۱۷ kg/s (اندازهٔ meanline).
  - هر قدم یک نتیجهٔ طراحی جزئی را جای فرض meanline می‌گذارد.
  - تلفات مکانیکی به kW وارد می‌شود، نه با `eta_mech`.
  - نتایج: `sim/engine/fea/a1000_performance.json`.

| قدم (تجمعی)، TIT 950 °C | توان به شبکه | راندمان برق (شبکه) | تغییر [واحد] |
|---|---|---|---|
| meanline (R38) | ۱۰۰۰٫۰ kW | ۳۷٫۷۷٪ | — |
| کمپرسور جزئی: PR 3.805، راندمان ۰٫۸۱۲ تا کلکتور (meanline ۰٫۸۳۸) | ۹۶۹٫۸ kW | ۳۶٫۶۷٪ | −۱٫۱۱ |
| توربین rev 5 (وتر بلندتر −۰٫۵ واحد)، فاصلهٔ +۲۵ mm (−۰٫۰۲) | ۹۵۸٫۲ kW | ۳۶٫۳۸٪ | −۰٫۲۸ |
| احتراق و اسکرول: افت فشار ۳٫۹۰٪ (فرض ۴٫۰٪) | ۹۵۹٫۷ kW | ۳۶٫۴۲٪ | +۰٫۰۴ |
| یاتاقان‌ها و آب‌بندها ۱۵٫۹ kW (rev 1.3، بخش ۱۳٫۱۰) | **۹۵۰٫۶ kW** | **۳۶٫۰۷٪** | −۰٫۳۵ |

- با یاتاقان‌های rev 1.2 (۲۸٫۶ kW) این عدد ۹۳۸٫۷ kW و ۳۵٫۶۲٪ بود.
- **بیشترین کمبود از کمپرسور است** (۳۰ kW). هر ۰٫۰۱ راندمان کمپرسور حدود ۱۰–۱۲ kW توان است.

**جبران با TIT، و حد خزش R1:**

- دمای ریشهٔ R1 با TIT بالا می‌رود. عمر خزش از منحنی کمینهٔ MAR-M247 است. هدف ۱۰۰٬۰۰۰ h است.

| | TIT | توان به شبکه | راندمان برق (شبکه) | ریشهٔ R1 | عمر خزش R1 |
|---|---|---|---|---|---|
| طراحی | ۹۵۰ °C | ۹۵۰٫۶ kW | ۳۶٫۰۷٪ | ۸۶۵ °C | ۲۶۰٬۰۰۰ h |
| **حد خزش** | **۹۷۰ °C** | **۹۸۵٫۰ kW** | **۳۶٫۵۸٪** | ۸۸۴ °C | ۱۰۰٬۰۰۰ h |
| ۱۰۰۰ kW | ۹۷۹ °C | ۱۰۰۰٫۰ kW | ۳۶٫۸۰٪ | ۸۹۳ °C | ۶۶٬۶۰۰ h |

- در ۹۷۰ °C: دمای اگزوز ۲۵۴ °C، گاز ۲۸۱ Sm³/h، آب گرم ۱۰۳۸ kW، سرمایش ۷۲۷ kW، راندمان کل ۷۵٫۱٪.
- **کمبود باقی‌مانده در حد خزش: ۱۵ kW** (پیش از rev 1.3 یاتاقان‌ها: ۲۷ kW).
- **گزینه‌ها:**
  1. بهبود راندمان کمپرسور (دیفیوزر و کانال برگشت، بخش ۱۵). ~۰٫۰۱۵ کافی است.
  2. روغن رقیق‌تر (VG22) یا روغن ورودی گرم‌تر: تلفات یاتاقان کمتر، ولی فیلم نازک‌تر. باید با مدل یاتاقان چک شود.
  3. TIT 979 °C با عمر ۶۶٬۶۰۰ h برای R1، یعنی تعویض R1 در بازرسی دوم بخش داغ.
  4. توان نامی ۹۸۵ kW.
- **تصمیم (۲۰۲۶-۱۰-۳۰): فعلاً گزینهٔ ۴.**
  - توان نامی **۹۸۵ kW** به شبکه، در TIT 970 °C.
  - کار روی بخش‌های دیگر ادامه پیدا می‌کند. گزینه‌های ۱ تا ۳ بعداً دوباره بررسی می‌شوند.

**هوای ثانویه:** سیکل ۱٫۵٪ نشت فرض کرده است. labyrinth‌های بخش داغ که از توربین رد می‌شوند ۰٫۸۴٪ هستند. ۰٫۶۶٪ برای اتصال‌ها و strip seal‌ها می‌ماند.

**هنوز در مدل نیست:**
- ~~افت plenum و خم ورودی شعاعی کمپرسور (افت ۱٫۰٪ سیکل نگه داشته شد).~~ **حساب شد: بخش ۲۰.**
- ~~دیفیوزر اگزوز و کانال‌های recuperator (۱٫۵٪ و ۲٫۵ / ۳٫۵٪ سیکل نگه داشته شد).~~ **حساب شد: بخش ۱۸.**
- اثر لقی نوک پره (۰٫۴۶ / ۰٫۵۵ mm) روی η_t. هنوز مدل تلفات ردیف‌به‌ردیف نداریم.
- اصطکاک دیسک‌ها در حفره‌های توربین.
- نشت strip seal نیمه‌های NGV (داخل سهم ۱٫۵٪).

## ۱۸. اگزوز: دیفیوزر، کلکتور و کانال‌های recuperator (فاز ۲، ۲۰۲۶-۱۰-۳۱)

طراحی و محاسبه: `sim/engine/a1000_exhaust.py` (نتایج: `sim/engine/fea/a1000_exhaust.json`) · CFD: `sim/cfd/a1000_exhaust/make_case.py` (OpenFOAM v2506؛ شبکهٔ درشت و متوسط روی مک‌بوک، شبکهٔ ریز روی سرور vast؛ نتایج: `sim/cfd/a1000_exhaust/results.json`) · CAD: `cad/engine/a1000_exhaust.py` → `fusion/A1000_exh/` (۱۵ قطعه، در `pkg.json`)

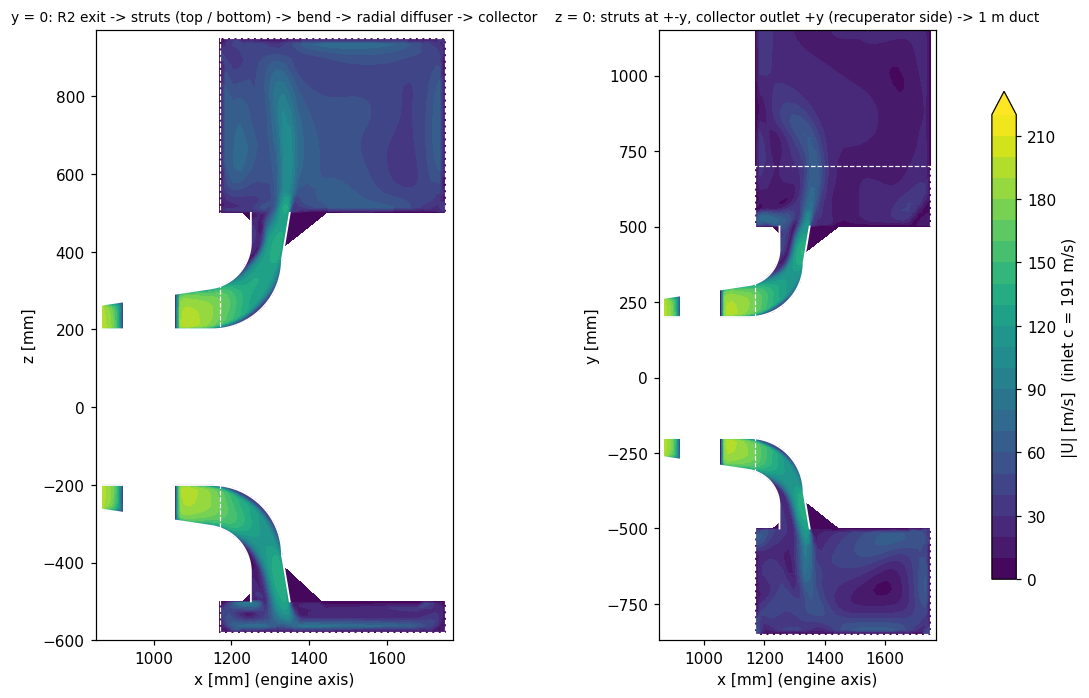
[picture p23: docs/img/a1000_exhaust_cfd.png]
CFD اگزوز: سرعت در صفحه‌های میانی


- **سؤال:** افت‌های فرضی سیکل واقعی‌اند؟ فرض‌ها: اگزوز ۱٫۵٪، سمت گاز recuperator ۳٫۵٪، سمت هوا ۲٫۵٪.
- **پاسخ کوتاه:**
  - دیفیوزر و کلکتور به‌تنهایی **۳٫۱۵ kPa** افت دارند (ζ = ۰٫۴۸۳ از فشار دینامیکی خروج R2). کل فرض اگزوز ۱٫۵۱ kPa بود.
  - سمت گاز در کل: **۵٫۹۵ kPa** به جای ۵٫۰۴ kPa. سمت هوا: **۲٫۷۷٪** به جای ۲٫۵٪.
  - توان به شبکه در TIT ۹۷۰ °C: **۹۸۵٫۰ ← ۹۶۸٫۵ kW**. راندمان برق: **۳۶٫۵۸ ← ۳۶٫۱۸٪**.

### ۱۸٫۱ شرایط خروج R2 (ایستگاه ۴، TIT ۹۷۰ °C)

| | مقدار |
|---|---|
| دبی گاز از توربین | ۶٫۲۷۶ kg/s (نشتی‌ها بعداً به گاز می‌پیوندند: ۶٫۳۷۰ kg/s در recuperator) |
| دما و فشار کل | ۶۸۸ °C، ۱٫۰۶۷ bar |
| حلقه (هاب / نوک) | r ۲۰۰٫۴ / ۲۶۴٫۰ mm، سطح ۰٫۰۹۲۸ m² |
| سرعت محوری | ۱۸۶ m/s |
| چرخش (swirl)، خلاف جهت دوران | −۱۱٫۸ تا −۱۰٫۳° (هاب تا نوک، از زاویه‌های خروج R2) |
| ماخ | ۰٫۳۱۳ |
| فشار دینامیکی q | **۶٫۵۳ kPa** (۶٫۱٪ از فشار کل) |
| فشار استاتیک | ۱٫۰۰۰ bar (زیر فشار محیط ۱٫۰۰۷ bar) |

- فشار دینامیکی خروج R2 بزرگ است: ۶٪ فشار. پس کیفیت دیفیوزر مستقیم روی توان اثر دارد.

### ۱۸٫۲ چیدمان و قطعات

**اصل‌ها:**
- قطعه‌های داغ آزاد رشد می‌کنند. موقعیت با پین شعاعی و spigot است، نه پیچ.
- کمترین قطعه و فلنج. همهٔ رابط‌ها ساده‌اند تا فاز ۷ (بدنهٔ یکپارچه) راحت باشد.
- هوای کمپرسور (۳٫۸ bar، ~۱۸۰ °C) از کانال‌های C1/C2 بخش داغ و سوراخ صفحهٔ عقب بدنهٔ اسکرول (r 322، x 928) بیرون می‌آید. **منیفولد هوا** همین‌جا آن را جمع می‌کند.

**مسیر گاز:**
1. خروج R2 (x 868): هاب r 200.4، نوک r 264.
2. **فریم اگزوز**: مخروط بیرونی ۸٫۵° با هاب استوانه‌ای، و **۴ پایهٔ توخالی** (x 920 تا 1145).
3. خم محوری به شعاعی: هاب R180 (سمت مقعر)، بدنه R120 (سمت محدب).
4. دیفیوزر شعاعی تا r 500 (پهنا ۸۰ ← ۱۰۰ mm).
5. **کلکتور** جعبه‌ای (x 1170 تا 1750)، باز به سمت +y، با کانال گذار و درز انبساط پارچه‌ای به recuperator.

- نسبت سطح: ورودی ۰٫۰۹۲۸، انتهای پایه‌ها ۰٫۱۶۶۸، خروج شعاعی ۰٫۳۱۴۲ m² (**AR ۳٫۳۹**).

| قطعه | جنس | جرم | کار |
|---|---|---|---|
| EX-401 منیفولد هوا | EN-GJS-400-18LT | ۱۳۸٫۱ kg | روی صفحهٔ عقب بدنهٔ اسکرول با ۲۴ × M16 و spigot. دریچهٔ ۱۵۰ × ۶۰۰ به لولهٔ DN350. حلقهٔ عقب با آب‌بند عقب. |
| EX-402 پین‌های شعاعی فریم ×۷ | A286 | ۶٫۴ kg | Ø24، از بیرون منیفولد در غلاف‌ها جا می‌روند. فریم را مرکز و محوری نگه می‌دارند. زیر دریچهٔ هوا پین نیست. |
| EX-410 فریم اگزوز (یک قطعه ریختگی) | 1.4848 | ۱۰۱٫۹ kg | مخروط، خم بدنه، فلنج شعاعی، ۴ پایهٔ توخالی، هاب و جای JB2. داغ و یکنواخت (~۶۸۰ °C). |
| EX-411 سپر حرارتی فریم | 1.4828 + کاغذ سرامیکی | ۲٫۲ kg | مخروط فریم را در هوای منیفولد داغ نگه می‌دارد تا با پایه‌ها هم‌دما بماند. |
| EX-412 حلقهٔ نگه‌دارندهٔ JB2 + ۸ خار | 1.4313 | ۹٫۴ kg | روی محفظهٔ کارتریج JB2 (r 130). خارها در شیارهای سرتاسری هاب می‌لغزند. |
| EX-413 آب‌بند ورقه‌ای جلو | Haynes 25 | ۱٫۱ kg | روی سطح عقب C2 (x 875). مثل CB-350. |
| EX-414 آب‌بند ورقه‌ای عقب | Haynes 25 | ۰٫۱ kg | بین حلقهٔ منیفولد و فلنج عقب فریم. |
| EX-420 کلکتور | 1.4828 ورق ۶ mm | ۴۴۶٫۸ kg | جعبه با دو چاه جلو و عقب، کلاهک هاب (خم R180 و دیوارهٔ عقب)، حلقهٔ جلو. روی خط مرکز تکیه دارد. |
| EX-421 درپوش دسترسی هاب | 1.4828 | ۵٫۶ kg | از چاه عقب باز می‌شود. بازدید JB2 بدون باز کردن کلکتور. |
| EX-430 کانال گذار + درز پارچه‌ای | 1.4828 + پارچه | ۱۳۰٫۵ kg | از دهانهٔ +y کلکتور تا ورودی گاز recuperator (y 1150). |
| EX-440 لولهٔ هوای سرد DN350 + سه‌راهی BOV | P265GH | ۱۹۷٫۹ kg | منیفولد ← recuperator. یک درز انبساط متعادل‌شده با فشار. |
| EX-441 BOV DN125 + لولهٔ تخلیهٔ DN200 | 1.4541 | ۱۸۱٫۰ kg | از لولهٔ سرد به پلنوم ورودی اکونومایزر (لولهٔ سوراخ‌دار داخل آن). |
| EX-450 لولهٔ هوای داغ DN450 | 1.4948 | ۳۳۸٫۲ kg | recuperator ← نازل محفظه (x 665، z 1140). جفت gimbal در ساق عمودی. |
| EX-460 recuperator (خریدنی) | AISI 347 | ~۲٬۵۰۰ kg | جای نازل‌ها تعیین شد. **۳۰۰ mm به سمت +y جابه‌جا شد** تا لوله‌ها جا شوند. |
| EX-470 اکونومایزر + دودکش DN800 (خریدنی) | — | ~۱٬۴۰۰ kg | روی خروجی گاز recuperator (بالای سر جلو). صداخفه‌کن در دودکش. |

- recuperator و اکونومایزر خریدنی‌اند. جرم آن‌ها برآورد است.

### ۱۸٫۳ پایه‌ها و یاتاقان JB2

**تعداد پایه‌ها:** میدان پتانسیل پایه‌ها روی R2 اثر می‌گذارد (EO = k × n). حاشیه از خانواده‌های اول تا سوم مدل cyclic R2، در باند ۱۴٬۷۰۰ تا ۱۵٬۳۰۰ rpm:

| پایه‌ها | EO n (لازم ۱۰٪) | EO 2n (۵٪) | EO 3n (۵٪) | EO 4n (۵٪) | نتیجه |
|---|---|---|---|---|---|
| ۴ | EO4: −۵۴٫۷٪ | EO8: −۲۰٫۰٪ | EO12: ۱۴٫۱٪ | EO16: −۹٫۹٪ | **قبول** |
| ۵ | EO5: −۴۷٫۶٪ | EO10: −۰٫۷٪ | EO15: −۱۵٫۵٪ | EO20: ۸٫۲٪ | رد |
| ۶ | EO6: −۳۸٫۹٪ | EO12: ۱۴٫۱٪ | EO18: ۱٫۴٪ | EO24: −۱۵٫۴٪ | رد |
| ۷ | EO7: −۲۹٫۶٪ | EO14: −۲۱٫۱٪ | EO21: ۱۳٫۷٪ | EO28: ۹٫۱٪ | **قبول** |
| ۸ | EO8: −۲۰٫۰٪ | EO16: −۹٫۹٪ | EO24: −۱۵٫۴٪ | EO32: ۷۱٫۹٪ | **قبول** |

- ۵ پایه (فرض قبلی پکیج) در EO10 با ND10 فقط ۰٫۷٪ فاصله دارد. ۶ پایه در EO18 فقط ۱٫۴٪.
- **۴ پایه** کمترین قطعه و کمترین انسداد را دارد و قبول است. هر ۴ پایه یک شکل‌اند.
- ND بالای ۱۴ در مدل cyclic حساب نشده بود. برای آن‌ها مقدار ND14 به کار رفت (خانواده‌ها از ND10 به بعد تخت‌اند).

**شکل پایه:** وتر ۲۲۵ mm، ضخامت ۴۹٫۵ mm (t/c ۰٫۲۲)، خمیده از −۱۲° (هم‌جهت با چرخش خروج R2) تا ۰° در لبهٔ فرار، لبهٔ فرار ۴ mm.

| پایه | سرویس |
|---|---|
| بالا (+z) | روغن ورودی DN15 به بوس ورودی JB2 (پدها + ISFD)، از سوراخ بالای حلقهٔ EX-412 |
| پایین (−z) | **خود حفرهٔ پایه، تخلیهٔ روغن JB2 است** (۳۶ × ~۱۲۰ mm، عمودی، بدون اوریفیس هوا). غلاف کوتاه DN25 از بوس تخلیه، و DN50 از ریشهٔ پایه به بیرون منیفولد. |
| −y | هواکش محفظهٔ یاتاقان DN25 به جداکنندهٔ مه روغن |
| +y | سیم‌های حسگر در لولهٔ ۱۲ mm (۲ پراب جابه‌جایی، ۲ ترموکوپل پد، یدکی) |
| +z، +y، −y | هوای بافر و خنک‌کاری از منیفولد: یک اوریفیس d 4 mm در ریشهٔ هر پایه |

- حفرهٔ داخلی پایه ۳۶٫۵ mm پهنا دارد و دیواره ۶٫۵ mm است. لوله‌ها در هوای بافر ~۱۸۰ °C هستند، نه در گاز.
- **بار:** ۵ برابر بار ایستای JB2 (۱٫۶۶ kN) و وزن هاب: ۱۰٫۰ kN. تنش در پایه‌ها ۲٫۳ MPa.
- **سختی تکیه‌گاه JB2** (پایه‌ها، خارها و پین‌ها سری): 6.5e+08 N/m، یعنی **۲۱ برابر ISFD** (3.1e7). پس مدل دینامیک روتور عوض نمی‌شود.
- **فریم شناور:** هوای کمپرسور بین دو آب‌بند فریم را **۲۵٫۳ kN** به عقب می‌راند (اختلاف فشار ۲٫۷۹ bar). هر پین ۸٫۳ kN، تنش برشی ۱۸٫۳ MPa.
- **هوای بافر هاب:** ۳ اوریفیس d 4 mm (خفه‌شده از P2): ۲۱٫۷ g/s، یعنی ۰٫۳۵٪ هوا. این مقدار داخل سهم ۰٫۶۶٪ درزها از نشتی ۱٫۵٪ سیکل است.
- خروج آن از یک لابیرنت ۵ دندانه روی فلنج عقب R2 (r 92، لانه‌زنبوری در دیوارهٔ جلوی هاب). فشار حفره: ۱٫۵۱ bar با لقی کاری ۰٫۲۵ mm و ۱٫۱۶ bar با ۰٫۵ mm. هدف جلسهٔ روغن‌کاری ۱٫۲–۱٫۵ bar است.
- محفظهٔ JB2 سرد می‌ماند: فاصلهٔ ۳۵ mm بین حلقه (r 150) و هاب داغ (r 185) با هوای بافر و عایق ۱۲ mm (طرف JB2) پر است.
- **زیر هر ۸ خار یک لایهٔ میکای ۳ mm** (k ≤ ۲ W/mK). خار فولادی بدون آن ~۱٫۹ kW از هاب ۶۴۰ °C به محفظه می‌برد و دیوارهٔ روغنی به ~۱۹۰ °C می‌رسد (بیشتر از حد ۱۵۰ °C). با میکا: ~۰٫۹ kW و ~۱۲۹ °C (محاسبهٔ جلسهٔ روغن‌کاری).

### ۱۸٫۴ CFD دیفیوزر و کلکتور

**روش:**
- simpleFoam پایا، تراکم‌ناپذیر، k-ω SST با تابع دیواره. ۳۶۰° کامل، چون کلکتور متقارن نیست.
- دامنه: خروج R2 ← ۴ پایه ← خم ← دیفیوزر شعاعی ← کلکتور ← ۱ m کانال مستقیم.
- ورودی: سرعت محوری یکنواخت از دبی، چرخش هر شعاع از زاویه‌های R2، شدت آشفتگی ۷٪. خروجی: فشار ثابت.
- خواص گاز در حالت استاتیک ایستگاه ۴. ماخ ورودی ۰٫۳۱ است. ضریب افت ζ نسبت به q ورودی است و روی q تراکم‌پذیر اعمال شد.
- شبکه: snappyHexMesh، سه سطح با نسبت ۱٫۳۳. نتیجه: میانگین ۳۰٪ آخر تکرارها، چون حل پایا کمی نوسان دارد.

**حلقهٔ طراحی (شبکهٔ درشت):**

| طرح | خم | AR | ζ | نتیجه |
|---|---|---|---|---|
| A | هاب R130، بدنه R35، خروج r 470 | ۳٫۸ | ۰٫۵۳۷ | جدایش در گوشهٔ محدب بدنه. جت در دیفیوزر شعاعی کنار دیوارهٔ عقب. |
| **B (انتخاب)** | هاب R180، بدنه R120، خروج r 500 | ۳٫۴ | **۰٫۴۶۴** | جدایش کمتر. جت هنوز کنار دیوارهٔ عقب است. |
| C | مثل B، با خم هم‌سطح، پهنای ۶۶ mm | ۲٫۲ | ۰٫۴۸۳ | جریان چسبیده‌تر، ولی سطح خروج کوچک‌تر. بدتر. |

**مطالعهٔ شبکه (طرح B):**

| شبکه | سلول | ζ | دامنهٔ نوسان | y+ میانگین (دیفیوزر / پایه‌ها) |
|---|---|---|---|---|
| درشت | ۳۵۴٬۲۰۴ | ۰٫۴۶۴ | ۰٫۴۵۰ تا ۰٫۴۷۱ | — |
| متوسط | ۸۳۲٬۰۲۴ | ۰٫۴۷۵ | ۰٫۴۶۱ تا ۰٫۴۹۰ | ۱۲۵ / ۸۱ |
| ریز | ۱٬۸۲۶٬۴۴۹ | ۰٫۴۸۳ | ۰٫۴۷۰ تا ۰٫۴۹۷ | ۹۲ / ۶۱ |

- همگرایی یکنواخت (مرتبهٔ ۱٫۲). مقدار برون‌یابی‌شده ۰٫۵۰۲، GCI شبکهٔ ریز ۴٫۸٪. **مقدار طراحی: ζ = ۰٫۴۸۳** (شبکهٔ ریز).
- با مقدار برون‌یابی‌شده، افت ۰٫۱۲ kPa بیشتر و توان ~۲ kW کمتر است. نوسان حل پایا (±۰٫۰۱۴) هم‌اندازهٔ همین است.

**مقطع‌ها (شبکهٔ ریز):**

| مقطع | ζ از ورودی | Cp | چرخش | سطح جریان برگشتی |
|---|---|---|---|---|
| x 900 | ۰٫۰۲۱ | ۰٫۱۱ | −۱۲٫۵° | ۰٪ |
| x 1000 | ۰٫۰۳۸ | ۰٫۱۵ | −۱۳٫۹° | ۱٪ |
| x 1148 | ۰٫۰۵۹ | ۰٫۳۲ | −۱۶٫۱° | ۱۱٪ |
| خروج کلکتور | ۰٫۴۸۳ | ۰٫۴۸ | — | — |

- تا انتهای پایه‌ها افت کم است (ζ ~۰٫۰۷). پایه‌ها فقط ~۰٫۰۳ به ζ اضافه می‌کنند.
- **بیشتر افت در خم و دیفیوزر شعاعی است.** جریان از سمت محدب بدنه جدا می‌شود و جت کنار دیوارهٔ عقب به کلکتور می‌ریزد.
- چرخش در دیفیوزر محوری از −۱۲ به −۱۶° می‌رسد. ۴ پایه با solidity ۰٫۶ آن را کامل نمی‌گیرند.
- **محافظه‌کارانه است:** ورودی یکنواخت است. جت نشتی نوک R2 که لایهٔ مرزی بدنه را انرژی می‌دهد مدل نشده. در توربین‌های صنعتی این جت جدایش بدنه را کم می‌کند.

### ۱۸٫۵ کانال‌ها و منیفولد هوا (همبستگی‌ها)

مراجع: Darcy-Weisbach با ضریب Haaland (زبری ۰٫۰۵ mm)؛ زانوها از Crane TP-410 (K = 14 f_T برای R/D 1.5 و 20 f_T برای R/D 1)؛ پلنوم، سه‌راهی و ورود به کانال از Idelchik (2008)؛ درز انبساط با غلاف داخلی از EJMA.

**سمت هوا** (P2 = ۳٫۷۹۵ bar، ۱۷۹ °C):

| بخش | K | q [Pa] | افت [Pa] |
|---|---|---|---|
| بدنهٔ اسکرول ← ورود کانال C1 (چرخش دور فلنج جلو) | ۰٫۵۰ | ۲٬۵۷۷ | ۱٬۲۸۹ |
| کانال‌های C1 و C2 (بخش ۱۴) | — | — | ۲۳۲ |
| خروج C2 ← منیفولد (حلقهٔ روی سپر حرارتی) | ۰٫۶۰ | ۱٬۵۰۷ | ۹۰۴ |
| منیفولد ← دریچهٔ ۱۵۰ × ۶۰۰ ← زانوی چهارگوش به گرد ← DN350 | ۱٫۸۰ | ۸۴۰ | ۱٬۵۱۳ |
| لولهٔ سرد DN350 (۲٫۰ m، زانو، سه‌راهی BOV، درز انبساط) | ۰٫۴۴ | ۸۴۰ | ۳۷۲ |
| لولهٔ داغ DN450 (۳٫۵ m، ۳ زانو، جفت gimbal)، ۲۹ m/s | ۰٫۹۶ | ۶۰۲ | ۵۷۶ |
| **کانال‌های ما** | | | **۴٬۸۸۵ (۱٫۲۹٪)** |
| هستهٔ recuperator، سمت هوا (فرض: ۱٫۵٪) | | | ۵٬۶۲۷ (۱٫۴۸٪) |

- بیشترین افت سمت هوا ورود به کانال C1 و جمع کردن هوا در منیفولد است، نه لوله‌ها. سرعت در کانال‌های بخش داغ ۳۴–۴۲ m/s است.
- ورود به C1 فقط برآورد است (K ۰٫۵). در فاز ۷ با CFD بدنهٔ یکپارچه چک شود.

**سمت گاز، پس از کلکتور:**

| بخش | افت [Pa] |
|---|---|
| هستهٔ recuperator، سمت گاز (فرض: ۲٫۰٪) | ۲٬۰۷۱ |
| اکونومایزر آب گرم (فرض) | ۵۰۰ |
| دودکش DN800 (۱۳٫۶ m/s) + صداخفه‌کن ۱۵۰ Pa + خروج، منهای مکش دودکش ۱۱ Pa | ۲۳۱ |

### ۱۸٫۶ افت فشار: فرض در برابر محاسبه

| | فرض سیکل | محاسبه | سهم ما (کانال، دیفیوزر، کلکتور) | سهم فروشنده (فرض) |
|---|---|---|---|---|
| سمت هوا dp_rec_c (از P2) | ۲٫۵٪ | **۲٫۷۷٪** | ۱٫۲۹٪ | ۱٫۴۸٪ (هستهٔ recuperator) |
| سمت گاز recuperator dp_rec_h (از P_atm) | ۳٫۵٪ | **۲٫۰۶٪** | — | ۲٫۰۶٪ (هسته) |
| اگزوز dp_exh (از P_atm) | ۱٫۵٪ | **۳٫۸۶٪** | ۳٫۳۶٪ (دیفیوزر + کلکتور ۳٫۱۳، دودکش ۰٫۲۳) | ۰٫۵۰٪ (اکونومایزر) |
| **کل سمت گاز** | ۵٫۰۴ kPa | **۵٫۹۵ kPa** | ۳٫۳۸ kPa | ۲٫۵۷ kPa |

- فرض ۱٫۵٪ اگزوز کم بود. خود دیفیوزر و کلکتور ۳٫۱٪ است.
- فرض ۳٫۵٪ برای recuperator گاز زیاد بود، اگر فروشنده ۲٫۰٪ بدهد. مجموع گاز ۰٫۹۲ kPa بیشتر شد.
- افت ورودی کمپرسور (۱٫۰٪) دست نخورد (فاز ۳).

### ۱۸٫۷ توان و راندمان (`sim/engine/a1000_performance.py`)

| | پیش از فاز ۲ | پس از فاز ۲ | تغییر |
|---|---|---|---|
| توان به شبکه در TIT ۹۷۰ °C | ۹۸۵٫۰ kW | **۹۶۸٫۵ kW** | −۱۶٫۵ kW |
| راندمان برق (شبکه) | ۳۶٫۵۸٪ | **۳۶٫۱۸٪** | −۰٫۴۰ واحد |
| دمای اگزوز به اکونومایزر | ۲۵۴ °C | ۲۵۴ °C | |
| گاز | ۲۸۱٫۵ Sm³/h | ۲۷۹٫۸ Sm³/h | |
| آب گرم / سرمایش | ۱٬۰۳۸ / ۷۲۷ kW | ۱٬۰۴۰ / ۷۲۸ kW | |
| راندمان کل | ۷۵٫۱٪ | ۷۵٫۰٪ | |
| TIT برای ۱٬۰۰۰ kW | ۹۷۹ °C (عمر R1 ۶۶٬۶۰۰ h) | ۹۸۹ °C (عمر R1 ۴۲٬۵۰۰ h) | |

- حساسیت: هر ۱ kPa افت بیشتر در سمت گاز **−۱۳٫۵ kW**. هر ۱٪ افت بیشتر در سمت هوا **−۱۵٫۰ kW**.
- توان نامی ۹۸۵ kW در TIT ۹۷۰ °C دیگر برقرار نیست. **کمبود ۱۷ kW** است. بعد از فاز ۶ (راندمان کمپرسور) دوباره تصمیم گرفته شود.

### ۱۸٫۸ انبساط حرارتی و درزهای انبساط

| رابط | راه‌حل | جابه‌جایی گرم [mm] |
|---|---|---|
| فریم ↔ منیفولد | ۷ پین شعاعی Ø24 (x 1085)، از بیرون. مرکز، گشتاور و نیروی محوری را می‌گیرند. | شعاعی ۳٫۳ |
| جلوی فریم ↔ سطح عقب C2 | آب‌بند ورقه‌ای Haynes 25، کورس ۴ mm | محوری ۲٫۹، شعاعی ۱٫۰ |
| فریم ↔ حلقهٔ عقب منیفولد | آب‌بند ورقه‌ای، لغزش شعاعی | شعاعی ۳٫۲ |
| فلنج فریم ↔ حلقهٔ جلوی کلکتور | spigot لغزان، درگیری ۲۵ mm، طناب سرامیکی | محوری ۳٫۷ |
| کلکتور ← ورودی گاز recuperator | درز پارچه‌ای چهارگوش ۵۴۰ × ۱۴۸۰، طول ۳۰۰ | y ۸ (کلکتور) + ~۱۰ (recuperator)، x ~۴ |
| لولهٔ سرد DN350 | یک درز متعادل‌شده با فشار (نیرویی به منیفولد نمی‌دهد) | محوری ~۸ |
| لولهٔ داغ DN450 | جفت gimbal (فشار ۳٫۶ bar را می‌گیرد) در ساق عمودی | رشد لوله ۳۷، نازل محفظه ۵٫۴ رو به بالا |
| لولهٔ تخلیهٔ BOV | یک درز جانبی مهارشده | کم (فقط در trip گرم می‌شود) |
| خروج گاز recuperator ← اکونومایزر | درز پارچه‌ای (فروشنده) | ~۱۰ |

- موتور: نقطهٔ ثابت جلو فرض شد (فاز ۷). فریم ۳٫۷ mm از پین‌ها به عقب و کلکتور از جلو ثابت است.
- کلکتور روی خط مرکز (z 0) دو بازو دارد و یک خار زیر آن. پس محور فریم و کلکتور در گرما هم‌مرکز می‌مانند.
- recuperator: نقطهٔ ثابت سمت عقب (کنار ورودی گاز و خروجی هوای داغ) پیشنهاد شد تا رابط‌های داغ کمترین حرکت را داشته باشند.

### ۱۸٫۹ مونتاژ و دمونتاژ

1. روتور با JB2 و حلقهٔ EX-412 در نیمه‌های پایین بدنه‌ها قرار می‌گیرد.
2. منیفولد (EX-401) با spigot و ۲۴ پیچ روی صفحهٔ عقب بدنهٔ اسکرول بسته می‌شود.
3. فریم (EX-410) با سپر و آب‌بند جلو از عقب به جلو سُر می‌خورد. خارهای JB2 در شیارهای هاب می‌روند. از حلقهٔ منیفولد رد می‌شود.
4. ۷ پین از بیرون منیفولد زده می‌شوند. درپوش‌های آن‌ها آب‌بند فشار هستند.
5. لوله‌های روغن و حسگر از بیرون در پایه‌ها جا می‌روند.
6. کلکتور (EX-420) از عقب جلو می‌آید: spigot روی فلنج فریم و لبهٔ کلاهک در هاب.
7. کانال گذار و درز پارچه‌ای، بعد لوله‌ها.

- دمونتاژ برعکس است. برای بازدید JB2 فقط درپوش EX-421 از چاه عقب باز می‌شود.
- برای بیرون آوردن روتور: کلکتور، پین‌ها و فریم به عقب. بعد نیمه‌های بالای بدنه‌ها.

### ۱۸٫۱۰ رابط‌ها و اثر روی بخش‌های دیگر

1. **صفحهٔ عقب بدنهٔ اسکرول (بخش ۱۶):** ۱۲ دندهٔ بیرونی آن (x 928–968) با منیفولد تداخل دارند. منیفولد حالا روی این صفحه است و داخل r 500 دو طرف صفحه هوای کمپرسور است. **دنده‌ها باید از r 565 شروع شوند** (فاز ۷). در CAD این تداخل هنوز دیده می‌شود.
2. **recuperator** ۳۰۰ mm به سمت +y رفت (y 1150–2350). کف skid زیر آن باید پهن‌تر شود (فاز ۷).
3. **نازل‌های recuperator** برای فروشنده: ورودی گاز در کنار سمت موتور، عقب (x 1110–1810)؛ خروجی گاز بالای سر جلو؛ ورودی هوا کنار، جلو (x −700، z −360)؛ خروجی هوای داغ بالای سر عقب (x 1500).
4. **سطح عقب C2** (x 875) سطح آب‌بند جلو است: صاف و سخت‌کاری‌شده.
5. **کارتریج JB2 (جلسهٔ بخش ۱۹):** قطر بیرونی ساده r 130 از x 911، شانه x 985–990 پشت حلقهٔ EX-412. بوس‌های تخلیه و هواکش پشت حلقه، در x ≥ 1004. سیم‌ها، روغن و هواکش در r 520 بیرون منیفولد به شیلنگ وصل می‌شوند.
6. **حجم‌ها برای مدل گذرای فاز ۱:** A ≈ ۰٫۵۵ m³ (منیفولد ۰٫۰۹، لولهٔ سرد ۰٫۲۱، بدنهٔ اسکرول ~۰٫۲۳). فرض فاز ۱ ۰٫۹ بود. حجم لولهٔ داغ در B ۰٫۵۳ m³ است. هر دو در بازهٔ حساسیت فاز ۱ (×۰٫۵ تا ×۲) هستند، پس نتیجهٔ نیروی محوری عوض نمی‌شود.
7. **BOV:** روی لولهٔ سرد، نزدیک recuperator (x −450). تخلیه به پلنوم اکونومایزر با لولهٔ سوراخ‌دار (کاهش صدا).

### ۱۸٫۱۱ چک‌ها

- تعداد پایه در برابر ارتعاش R2: قبول (جدول ۱۸٫۳).
- سختی تکیه‌گاه JB2: ۲۱ برابر ISFD. قبول (≥ ۱۰).
- تنش پایه‌ها و پین‌ها: ۲٫۳ و ۱۸٫۳ MPa. قبول.
- کورس آب‌بند جلو ۲٫۹ mm در برابر ۴ mm. قبول.
- تداخل CAD با روتور، بخش داغ و احتراق: ۴ مورد. همه از دنده‌های صفحهٔ عقب بدنهٔ اسکرول (رابط ۱). بین قطعه‌های اگزوز: ۰.

### ۱۸٫۱۲ باز

1. **افت فشار recuperator و اکونومایزر:** عدد فروشنده لازم است. فرض ۱٫۵٪ هوا، ۲٫۰٪ گاز و ۵۰۰ Pa.
2. **بهبود دیفیوزر:** CFD با پروفایل واقعی خروج R2 (جت نشتی نوک، دنبالهٔ پره‌ها) از CFD پله. گزینه‌ها: حلقهٔ تقسیم در خم، پایه‌های نازک‌تر، چرخش کمتر. هر ۰٫۱ در ζ حدود ۰٫۶۵ kPa و ۹ kW است.
3. **ورود به کانال C1 و منیفولد هوا:** CFD در فاز ۷ با بدنهٔ یکپارچه.
4. **دنده‌های صفحهٔ عقب بدنهٔ اسکرول** و **پهن کردن skid** (فاز ۷).
5. **مدل گذرای فاز ۱** با حجم‌های جدید دوباره اجرا شود، وقتی حجم سمت هوای recuperator از فروشنده آمد.
6. **صدا:** صداخفه‌کن دودکش و سوراخ‌های لولهٔ BOV طراحی شوند.
7. **پکیج فیوژن** هنوز با این قطعه‌ها دوباره ساخته نشده است. `pkg.json` به‌روز است.
8. **توان نامی:** با کمبود ۱۷ kW، تصمیم بخش ۱۷ بعد از فاز ۶ دوباره بررسی شود.

## ۱۹. بازبینی مونتاژ، روغن‌کاری و لوله‌کشی (۲۰۲۶-۱۰-۳۱)

مدل‌ها:
- بررسی مونتاژ: `cad/engine/a1000_assembly_check.py`، ترتیب جدید: `cad/engine/a1000_assembly_seq.py` (نتایج: `sim/engine/fea/a1000_assembly_check_new.json`، `a1000_assembly_check_v12.json`، `a1000_assembly_static.json`).
- روغن‌کاری، آب‌بندها و لوله‌ها: `sim/engine/a1000_lube_piping.py` (نتایج: `sim/engine/fea/a1000_lube_piping.json`).
- هندسه: `cad/engine/a1000_rotor.py` (یاتاقان‌ها)، `a1000_hot_section.py` (کلیدها)، `a1000_combustor.py` (سوخت، بوس‌ها، قلاب‌ها)، `a1000_turbine.py` (حلقهٔ NGV1)، `a1000_piping.py` (لوله‌ها، جدید).
- فیوژن: افزونهٔ `fusion/AURORA1000_Animate` با ترتیب جدید. بستهٔ فیوژن دوباره ساخته نشد (تصمیم با کاربر).

### ۱۹٫۱ روش

- برای هر قطعه جهت و مسیر نصب تعریف شد. قطعه روی این مسیر جابه‌جا می‌شود.
- در هر گام، حجم مشترک با همهٔ قطعه‌های نصب‌شده اندازه گرفته می‌شود. گام ۴۰ mm است و نزدیک انتها ۳۰، ۲۰، ۱۵، ۱۰، ۶، ۳، ۱٫۵ و ۰٫۵ mm.
- بیش از ۵ mm³ یعنی برخورد. پس فقط موقعیت نهایی چک نمی‌شود، کل مسیر چک می‌شود.
- قطعه‌هایی که در ماشین دونیمه‌اند (بدنه‌ها، حلقه‌های NGV، نگه‌دارنده‌ها، دیافراگم‌ها، یاتاقان‌های جلو) در صفحهٔ z = 0 بریده می‌شوند. هر نیمه مسیر خودش را دارد.
- قطعه‌های یکپارچه با هم چک نمی‌شوند: blisk با پره‌ها، NGV با پره‌ها، پروانه با پره‌ها، بدنهٔ کمپرسور با پره‌های دیفیوزر.
- مهره‌ها و پین‌ها می‌توانند شعاعی وارد شوند (هر قطعه در جهت شعاعی خودش).
- اجرا با FreeCAD. ترتیب قبلی افزونه (۴۰ حرکت) روی مک‌بوک اجرا شد. ترتیب جدید (۸۰ حرکت) و یک چک ایستا برای همهٔ جفت‌ها در موقعیت نهایی روی سرور vast اجرا شدند.

### ۱۹٫۲ عیب‌ها و اصلاح‌ها

| # | عیب | علت | اصلاح | وضعیت |
|---|---|---|---|---|
| 1 | لبهٔ جلوی سکوی دیسک R1 در حلقهٔ داخلی NGV1 فرو رفته است (۲٬۹۴۹ mm³، ۰٫۵ mm محوری). | بیرون‌زدگی سکو ۴٫۵ mm به‌اضافهٔ امتداد حلقه ۴ mm، در فاصلهٔ ۸ mm. | امتداد عقب حلقهٔ داخلی NGV1 از ۴ به ۲٫۵ mm. فاصلهٔ سرد ۱٫۰ mm است. در کار بازتر می‌شود و با لقی ۰٫۳ mm کف‌گرد هم ۰٫۷ mm می‌ماند. | اصلاح شد |
| 2 | محفظهٔ ژورنال ۱ یکپارچه بود و دیوارهٔ جلویش r 46 داشت. این محفظه بین فلنج کوپلینگ (r 80) و فلنج کف‌گرد (r 72) گیر است. حلقهٔ ISFD (r داخلی ۷۴) و صفحه‌های انتهایی نگه‌دارنده هم همین‌طور. محفظهٔ کف‌گرد هم فلنج کف‌گرد را از دو طرف می‌پوشاند. پس هیچ‌کدام نصب‌شدنی نبودند. | فلنج کوپلینگ و فلنج کف‌گرد هر دو با شفت جلو یکپارچه‌اند. | یک **محفظهٔ یاتاقان جلوی دوتکهٔ افقی** (FB-1 و FB-2) برای ژورنال ۱، کف‌گرد و دماغهٔ هاب ورودی. پایه‌ها در صفحهٔ درز هستند (تکیه روی خط مرکز). نگه‌دارندهٔ پدها، حلقهٔ ISFD و حلقه‌های کف‌گرد هم دونیمه‌اند. نیمه‌های پایین پیش از روتور سر جایشان هستند. | اصلاح شد |
| 3 | ژورنال‌های ۵ پدی: درز افقی همیشه یک پد را می‌بُرد (تعداد فرد). پدها در CAD هم ۱۸° از حالت «بار بین پدها» چرخیده بودند. | — | **۴ پد × ۶۵°، بار بین پدها**. درز از فاصلهٔ بین پدها رد می‌شود. چک‌های روتور دوباره اجرا شد (جدول ۱۹٫۶). | اصلاح شد |
| 4 | لقی آب‌بندهای روغن در CAD غلط بود: جلوی ژورنال ۱ ۲٫۲۵ mm، جلوی ژورنال ۲ ۰٫۷۵ mm، عقب ژورنال ۲ ۴٫۲۵ mm. باید ۰٫۲ mm باشد. | در rev 1.3 نشیمن‌های آب‌بند کوچک‌تر شدند (r 43 و r 44.5)، ولی دندانه‌ها هنوز برای r 45 ساخته می‌شدند. | آب‌بندها روی نشیمن واقعی دوباره ساخته شدند: ۰٫۲۰ / ۰٫۱۵ / ۰٫۲۰ mm. | اصلاح شد |
| 5 | مسیر روغن ناقص بود. سوراخ ورودی فقط به بیرون ISFD می‌رسید. کانالی به ۵ نازل بین پدها نبود. ورودی کف‌گرد و همهٔ بوس‌های تخلیه توپر بودند. | — | طراحی کامل تغذیه و تخلیه (بخش ۱۹٫۴). | اصلاح شد |
| 6 | آب‌بند عقب کف‌گرد هوای بافر نداشت. پشتش چشم پروانهٔ ۱ است که ۰٫۹۱ bar فشار دارد، یعنی کمتر از محیط. پس روغن به کمپرسور مکیده می‌شد. | — | آب‌بند بافردار: windback و ۳ دندانه، حلقهٔ بافر ۱٫۱۰ bar، ۴ دندانه. هوا از خروجی طبقهٔ ۱ کمپرسور می‌آید. | اصلاح شد |
| 7 | ژورنال ۲ در هاب داغ اگزوز بود، ولی سپر حرارتی و هوای خنک‌کن نداشت. آب‌بند عقبش باز بود. | — | محفظهٔ کارتریج قطر بیرونی سادهٔ r 130 دارد و در حلقهٔ EX-412 فاز ۲ می‌نشیند (شانه در x 985–990). سپر ۱۲ mm الیاف بین حلقه و هاب است. حلقهٔ آب‌بند جلو بافردار است و هوای هاب از ۴ روزنهٔ Ø5.5 به آن می‌رسد. درپوش انتهایی بسته است، چون شفت داخل محفظه تمام می‌شود. درگاه‌ها: روغن ورودی بالا (x 955)، تخلیه پایین و هواکش −y (x 1005، پشت حلقه). | اصلاح شد (با فاز ۲) |
| 8 | اگر آب‌بند جلوی ژورنال ۲ لقی درست داشته باشد، سوراخش از ژورنال کوچک‌تر می‌شود. پس محفظهٔ یکپارچه از عقب روی ژورنال نمی‌رفت. | نشیمن آب‌بند (r 44.5) جلوی ژورنال (r 45) است. | آب‌بند جلو یک **حلقهٔ جدای دونیمه** روی نشیمن است. محفظه از عقب رویش می‌لغزد. یک پله روی حلقه جلوی نصب برعکس را می‌گیرد. | اصلاح شد |
| 9 | ۸ پین شعاعی (HS-240) که نگه‌دارنده‌های C1 و C2 را مرکز می‌کنند نصب‌شدنی نبودند. هر پین ~۱۱۰ mm جابه‌جایی شعاعی لازم دارد، ولی اسکرول دور بدنهٔ توربین فقط ۹۹ mm جا می‌گذارد. پین‌ها ۲۲٫۵° از عمود فاصله دارند، پس نیمه‌ها نمی‌توانند عمودی پایین بیایند. | — | **۴ کلید شعاعی:** دو کلید عمودی روی نیمه‌های بدنه ریخته شده‌اند (بالا و پایین). دو کلید تکیه‌گاه در صفحهٔ درز به فلنج نگه‌دارندهٔ پایین پیچ شده‌اند. همه با پایین آمدن نیمه‌ها درگیر می‌شوند و از بیرون چیزی نصب نمی‌شود. یک لبهٔ مرکزکن (spigot) هم بین C1 و C2 گذاشته شد. چک بخش داغ: ۱۳ از ۱۳. | اصلاح شد |
| 10 | اتصال‌های پیچی توربین: استاد ۸ mm از فلنج بیرون می‌زند، مهره ۶ mm است و حفره ۱۳ mm. پس وقتی دیسک سر جایش است، مهره روی استاد سوار نمی‌شود. حرکت «استاد و مهره» در افزونه با فلنج R1 برخورد دارد (۲٬۰۴۲ mm³). | — | روش مونتاژ: دیسک ۶ mm عقب‌تر نگه داشته می‌شود. مهره‌ها شعاعی روی سر استادها سوار می‌شوند. بعد با سفت شدن مهره‌ها دیسک جلو می‌آید و Curvic درگیر می‌شود. در بررسی جدید چک شد. | اصلاح شد (روش، بدون تغییر هندسه) |
| 11 | ترتیب افزونه غلط بود: یاتاقان‌های جلو محوری از روی فلنج‌ها رد می‌شدند. نیمه‌های پایین اسکرول و بدنهٔ فشار بعد از نیمهٔ بالای بدنهٔ توربین می‌آمدند، در حالی که بیرون و زیر آن هستند. پین‌ها پیش از نیمهٔ بالا بودند. روتور سر جایش چیده می‌شد و پایین آورده نمی‌شد. | — | ترتیب جدید در ۶ مرحله (بخش ۱۹٫۳). روتور بالای پایه چیده و بالانس می‌شود و یکجا پایین می‌آید. | اصلاح شد |
| 12 | سوخت: CB-370 یک چنبره برای A و B داشت. ولی بخش ۱۶٫۹ چهار مدار دارد: P، A، B1 و B2. لوله‌های لنس هم به منیفولدها نمی‌رسیدند. | — | چهار مدار: حلقهٔ A، کمان B2 و خط‌های P و B1. روی هر لنس یک اتصال مخروطی ۲۴° است. صفحهٔ اتصال روی درپوش است. شیلنگ‌های فلزی تا بلوک شیرهای گاز می‌روند. | اصلاح شد |
| 13 | مخزن روغن (جعبهٔ ماژول روی skid، z −700 تا 0) بالاتر از تخلیهٔ یاتاقان‌ها بود (z −190 و −470). پس تخلیهٔ ثقلی ممکن نبود. تخلیهٔ گیربکس هم همین‌طور. | — | مخزن ۴۵۵ لیتری داخل شاسی، بین تیرهای x −540 و 200، با سطح بالای z −715. گیربکس مستقیم رو به پایین در آن تخلیه می‌شود. پمپ‌ها، فیلتر و خنک‌کن روی ماژول کنار skid می‌مانند. | اصلاح شد |
| 14 | قطعه‌های سنگین نقطهٔ بلند کردن نداشتند: CB-340 (۳۶۲ kg)، CB-341 (۲۱۷ kg)، CB-301 (۲۳۳ kg)، CB-303 (۱۶۳ kg)، HS-201 و HS-202 (۵۸ kg)، FB-1، محفظهٔ ژورنال ۲. | — | گوشواره، بوس پیچ چشمی و سوراخ رزوه‌دار اضافه شد. روتور (۲۰۰ kg، مرکز جرم در x 603) با تیر بلند می‌شود: جلو با آداپتور روی فلنج کوپلینگ (۱۲ × M12) و ۷۹ kg، عقب با طوقهٔ گیره روی r 41 شفت عقب و ۱۲۱ kg. | اصلاح شد |
| 15 | درزها جای‌گذاری نداشتند: درز بدنهٔ توربین، محفظهٔ جلو، نگه‌دارنده‌ها، حلقه‌های کف‌گرد و فلنج C1–C2. پیچ‌ها خودشان مرکز می‌کردند. | — | پین‌های راهنمای نامتقارن تا نیمه‌ها فقط یک‌جور جا بیفتند: Ø12/Ø16 در بدنه، Ø10/Ø12 در محفظهٔ جلو، Ø6/Ø8 در نگه‌دارنده. لبهٔ مرکزکن C1→C2. | اصلاح شد |
| 16 | پدها (محور گردش ۶۰٪ آفست) و حلقه‌های آب‌بند (windback جهت‌دار) می‌توانستند برعکس نصب شوند. | — | پین توقف هر پد ۱۲° پشت لبهٔ جلوست. حلقه‌های کف‌گرد پین آفست دارند. حلقهٔ آب‌بند ژورنال ۲ پله دارد. | اصلاح شد |
| 17 | در پیش‌نویس فاز ۲: تخلیهٔ ژورنال ۲ DN20 بود. این برای ~۱۲ l/min روغن کف‌دار ثقلی کوچک است. هواکش در +y بود، کنار لولهٔ DN350 هوای سرد. ۸ کلید فولادی حدود ۱٫۹ kW گرما از هاب ۶۴۰ °C به محفظه می‌بردند و دیوارهٔ زیر کلید به ۱۹۰ °C می‌رسید. | — | درخواست از فاز ۲ که در commit 6887ff7 اعمال شد: خود حفرهٔ استرات پایین تخلیه است (غلاف DN25 و DN50 تا بیرون). هواکش DN25 در −y است. زیر هر کلید ۳ mm میکا است، پس دیوارهٔ زیر کلید ۱۲۹ °C می‌شود. | اصلاح شد (فاز ۲) |
| 19 | رابط با ورودی فاز ۳ (بخش ۲۰): این قطعه‌های FB از x 141 عقب‌تر می‌رفتند و به دیوارهٔ هاب ورودی (x 143–157) یا شکاف ورودی شعاعی (x 157–204) می‌رسیدند: بوس تخلیه (r 38 در x 126) و پد آن (r 70)، بوس بلند کردن عقب (x 142)، گوشواره‌های درز (تا x 151)، بوس هواکش (x 132) و بوس هوای بافر (x 146). | — | قاعدهٔ مشترک: هیچ چیز FB در r > 130 عقب‌تر از x 141 نیست، جز سطح آب‌بند دماغه (x 157) و خود دماغه. تخلیه ۲ × DN40 در x 110 است. بوس هواکش در x 118، هوای بافر در x 125 و بوس‌های بلند کردن در (45، 0) و (118، ±60) هستند. گوشواره‌ها تا x 140 می‌روند. پایه‌ها سوراخ لوبیایی در جهت y و جای خار عرضی دارند، و FB-2 یک جای خار وسط پایین دارد. همهٔ لوله‌های FB از داخل تونل خشک plenum (r 284) به جلو می‌روند و در جلوی plenum بیرون می‌آیند. | اصلاح شد (با فاز ۳) |
| 18 | جاگیرها: بدنهٔ کمپرسور هنوز جاگیر است. از x 165 شروع می‌شود و با بدنهٔ ورودی (IN-501 و IN-502، هر کدام ~۱٬۰۱۵٬۰۰۰ mm³)، جعبهٔ plenum (IN-510 و IN-511، هر کدام ۹۹٬۰۰۰)، فاصله‌انداز RT-104 (۸٬۹۷۷) و درام (۸۶۳) هم‌پوشانی دارد. دنده‌های صفحهٔ عقب بدنهٔ اسکرول با منیفولد EX-401 (۱۴۲٬۰۰۰ و ۱۳۶٬۰۰۰) و لولهٔ EX-440 (۴۹٬۰۰۰) تداخل دارند (فاز ۲ هم ثبت کرد). plenum جاگیر حذف شد و قطعه‌های فاز ۳ جایش آمدند. | این‌ها هنوز مدل مفهومی‌اند و ساخته نشده‌اند. | بدنهٔ کمپرسور واقعی: سطح جلو x 222 برای r ≥ 150 و بوس spigot r 137.5–150 در x 214–222 (بخش ۲۰). دنده‌های اسکرول از r 565 شروع شوند. | باز (فاز ۷) |
| 20 | فایل STEP نیمهٔ پایین FB-2 خراب بود ("Invalid imbrication of wires"). booleanها روی آن شکست می‌خوردند، پس تداخل‌های FB-2 دیده نمی‌شد (فاز ۳ هم گزارش داد). | کانال محوری روغن کف‌گرد (r 100، d 8) درست روی لبهٔ سوراخ‌های d6 تغذیهٔ LEG تمام می‌شد. یعنی دو سطح مماس بودند. در حافظه سالم بود، ولی بعد از نوشتن STEP خراب شد. | کانال از هر طرف ۳ mm بلندتر شد. اسکریپت روتور حالا هر STEP را بعد از نوشتن دوباره می‌خواند و سالم بودنش را چک می‌کند. | اصلاح شد |
| 21 | تداخل‌هایی که پشت FB-2 خراب پنهان مانده بودند: بدنهٔ اتصال PL-02 و PL-03 داخل بوس‌های FB-2 بود (۴٬۴۰۶ و ۵٬۶۵۵ mm³). سر PL-07 هم ۱۲ mm داخل بوس هواکش FB-1 بود. | بدنهٔ اتصال روی سطح بوس مرکز شده بود، نه بیرون آن. ارتفاع بوس هواکش در اسکریپت لوله‌ها کهنه بود. | بدنهٔ اتصال (۱۱ mm) بیرون سطح بوس است و به براکت IN-502 نمی‌رسد. لوله از پنجرهٔ براکت رد می‌شود. PL-07 از روی بوس (z 154) شروع می‌شود. | اصلاح شد |
| 22 | لوله‌ها با هم و با ماژول: PL-09 جلوی plenum از روی رایزر PL-03 رد می‌شد (۲٬۳۰۱ mm³). سر PL-01 ۵ mm داخل ماژول روغن بود (۴٬۸۱۱ mm³). PL-05 به صفحهٔ جلوی plenum می‌چسبید (۵ mm³). | — | PL-09 در y −230 وارد تونل می‌شود و در x −120، داخل تونل، به سمت بوس می‌پیچد. PL-01 از سطح ماژول شروع می‌شود. PL-05 ۳ mm از صفحه فاصله دارد. | اصلاح شد |
| 23 | جرقه‌زن ۸٫۵° کج است، ولی در ترتیب مونتاژ همراه حسگرها عمودی پایین می‌آمد. ۲۰٬۹۶۹ mm³ از درپوش CB-303 عبور می‌کرد. | — | جرقه‌زن جدا و در امتداد محور خودش نصب می‌شود. حسگرهای UV عمودی‌اند. | اصلاح شد |
| 24 | ترتیب مونتاژ قطعه‌های ورودی فاز ۳ را نداشت. سه مانع داشت: نیمهٔ پایین plenum (IN-511) را نمی‌شود روی هسته پایین آورد؛ لوله‌های FB داخل تونل و زیر پایه‌های FB-2 هستند؛ و نیمهٔ پایین IN-502 نمی‌تواند عمودی روی نیمهٔ پایین spigot بدنهٔ کمپرسور بنشیند. | — | IN-502 ۱۵ mm جلوتر پایین می‌آید و بعد روی spigot عقب می‌رود. بعد FB-2 روی براکت‌ها می‌نشیند. IN-501 بعد از نیمهٔ بالای بدنهٔ کمپرسور می‌آید. در مرحلهٔ F هسته روی جرثقیل منتظر می‌ماند. اول شاسی، تکیه‌گاه لوله‌ها، ماژول روغن و IN-511 می‌آیند، بعد هسته. هر لولهٔ FB دو تکه است: تکهٔ تونل از دهانهٔ باز تونل وارد می‌شود (پیش از گیربکس)، و تکهٔ بیرونی از بالا. اتصال دو تکه در دهانهٔ تونل است. بعد گیربکس و ژنراتور، کوپلینگ‌ها از بالا از تونل باز، و IN-510. | اصلاح شد |
| 25 | چک‌کننده: جهت شعاعی هر قطعه از مرکز جعبهٔ دربرگیرنده حساب می‌شد. پین‌های EX-402 سر دارند، پس این جهت ۰٫۴° خطا داشت. روی لقی ۰٫۱ mm سوراخ، برخورد کاذب ۵۴۱ mm³ نشان می‌داد. | — | جهت از مرکز جرم حساب می‌شود. | اصلاح شد |
| 26 | اولین اجرای مرحلهٔ F شش مسیر نشدنی نشان داد. ۱) کوپلینگ پرسرعت که از بالا می‌آید از وسط PL-07 رد می‌شد (۱۲۹٬۶۴۲ mm³)، چون PL-07 روی کوپلینگ به جلو می‌رفت. ۲) سر برداشت PL-09 از بالا از وسط محفظهٔ احتراق می‌گذشت (۳۵٬۸۶۰ mm³). ۳) PL-06 از کنار به پایه‌های IN-511 و CB-341 می‌خورد. ۴) شیلنگ PL-04 بین دنده‌های CB-340 پایین می‌رود و از کنار جا نمی‌شد. ۵) بلوک شیر گاز زیر جمع‌کنندهٔ اگزوز است و از بالا نمی‌آمد. ۶) تکهٔ تونل PL-02 و PL-03 وقتی ۴۰ mm کنار می‌لغزید به براکت IN-502 می‌خورد. | — | ۱) PL-07 از بالای FB-1 فوراً به y 146 می‌رود: ۴ mm کنار کوپلینگ و ۷ mm زیر لبهٔ بدنهٔ ورودی. ۲) PL-09 چهار تکه است. سر برداشت با بلوک شیر از −y زیر کف محفظه وارد می‌شود. ۳) PL-06 پیش از plenum و هسته، از بالا روی تکیه‌گاه‌ها گذاشته می‌شود. ۴) و ۵) شیلنگ جدا؛ لولهٔ صلب PL-04 و بلوک شیر از −y. ۶) تکه‌های تونل در ارتفاع خودشان از پنجرهٔ براکت رد می‌شوند. | اصلاح شد |

### ۱۹٫۳ ترتیب مونتاژ جدید (`cad/engine/a1000_assembly_seq.py`)

| مرحله | کار |
|---|---|
| A | چیدن روتور روی میز، کنار موتور. شفت جلو، پروانهٔ ۱، فاصله‌انداز، پروانهٔ ۲، درام، پیچ مرکزی و مهره. استادهای درام–R1، بعد R1 تا ۶ mm مانده به جا. مهره‌ها شعاعی سوار می‌شوند و R1 را جلو می‌کشند. همین برای R1–R2 و R2–شفت عقب. بالانس روتور به‌صورت یک واحد. |
| B | پوستهٔ پایین روی پایه: CB-341، نیمهٔ پایین اسکرول و پره‌ها، پین‌های پایین اسکرول از بیرون، HS-202 (کلید پایین ریخته روی آن)، نیمهٔ پایین بدنهٔ کمپرسور، نیمهٔ پایین بدنهٔ ورودی IN-502 (۱۵ mm جلوتر پایین می‌آید و روی spigot عقب می‌رود)، FB-2 روی براکت‌های IN-502، نیمه‌های پایین ژورنال ۱ و کف‌گرد. بعد **نیم‌مجموعهٔ پایین** شامل C1، C2، NGV1، NGV2، shroudها، liner‌ها، دیافراگم‌ها و کلیدهای تکیه‌گاه. این نیم‌مجموعه روی میز سوار می‌شود: قلاب نگه‌دارنده‌ها محوری روی حلقه‌های NGV می‌لغزد. |
| C | روتور بالانس‌شده یکجا پایین می‌آید. جلویش روی پدهای پایین ژورنال ۱ می‌نشیند و عقبش روی ابزار نگه‌دارندهٔ محوری (tail-stock). |
| D | نیمه‌های بالا: ژورنال ۱ و کف‌گرد، FB-1، نیم‌مجموعهٔ بالا، بدنهٔ کمپرسور، IN-501، HS-201 (کلید بالا در شیار)، اسکرول، CB-340، پین‌های بالای اسکرول. بعد از عقب: منیفولد هوا و قاب اگزوز (فاز ۲) که روی میلهٔ ابزار می‌لغزد. حلقهٔ آب‌بند دونیمهٔ ژورنال ۲. کارتریج ژورنال ۲ همراه حلقهٔ نگه‌دارندهٔ فاز ۲. درپوش. جمع‌کنندهٔ اگزوز. |
| E | محفظهٔ احتراق از بالا: بدنه و کف، لاینر با پوستهٔ جت، درپوش با پیش‌مخلوط‌کن‌ها، جرقه‌زن در امتداد محور کج خودش، حسگرهای UV، منیفولدهای سوخت. |
| F | هسته روی جرثقیل منتظر می‌ماند. شاسی با مخزن، تکیه‌گاه لوله‌ها، ماژول روغن و نیمهٔ پایین plenum (IN-511) می‌آیند. هسته در IN-511 پایین می‌آید. بلوک روغن FB جلوی plenum. لوله‌های FB هر کدام دو تکه‌اند: تکهٔ تونل از دهانهٔ باز تونل و تکهٔ بیرونی از بالا. بعد گیربکس، استارتر، ژنراتور، کوپلینگ‌ها از بالا از تونل باز، نیمهٔ بالای plenum (IN-510) و IN-520، recuperator و کانال‌ها. در آخر بقیهٔ لوله‌ها. شیلنگ‌ها انعطاف دارند، پس فقط جای نهایی‌شان چک می‌شود. |

- ژورنال ۲ بدون باز کردن بدنه بیرون می‌آید: درپوش دسترسی هاب و درپوش انتهایی برداشته می‌شوند. ابزار tail-stock عقب روتور را نگه می‌دارد و کارتریج از عقب بیرون کشیده می‌شود.
- افزونهٔ فیوژن همین ترتیب را در ۶ مرحله نشان می‌دهد. قطعه‌هایی که در ماشین دونیمه‌اند در بستهٔ فعلی یکپارچه‌اند، پس یکپارچه نشان داده می‌شوند.

### ۱۹٫۴ روغن‌کاری (`sim/engine/a1000_lube_piping.py`، ۲۹ از ۲۹ قبول)

**روغن و ماژول:** ISO VG 32 در ۵۰ °C. فشار هدر در موتور ۲٫۰ bar(g)، با PCV روی ماژول. فیلتر دوقلو ۱۰ µm مطلق (β 200). خنک‌کن هوایی برای ۴۰ °C محیط. دو پمپ AC (اصلی و یدک) و یک پمپ DC برای توقف و روغن‌کاری بعد از خاموشی. روغن ماژول ۶۵ l/min است (توربین ۳۳ و گیربکس ۳۲). گرما ۳۲٫۶ kW.

| یاتاقان | گرما | روغن طراحی | تغذیه | روزنهٔ تنظیم دبی |
|---|---|---|---|---|
| ژورنال ۱ | ۴٫۳۶ kW | ۹٫۴ l/min | ۴ میلهٔ پاشش بین پدها × ۲ جت Ø1.5، ۱۰ m/s، رو به لبهٔ جلوی پد بعدی و ۱۵° رو به سطح | ۲ × Ø3.2 در لوله‌های انتقال |
| ژورنال ۲ | ۴٫۳۶ + ۱٫۲۹ kW (گرمای هاب و شفت) | ۱۱٫۹ l/min | ۴ × ۲ جت Ø1.7 | ۲ × Ø3.7 |
| کف‌گرد | ۶٫۰۴ kW | ۱۲٫۱ l/min | شیار لبهٔ جلو (LEG): ۸ پد بارگرفته Ø1.6 (۹٫۲ l/min) و ۴ پد بی‌بار Ø1.3 (۲٫۹ l/min) | Ø5.4 در اتصال ورودی |

- **کانال‌ها:** شیار ۱۰ × ۶ در محفظه، دور حلقهٔ ISFD و بین دو O-ring. از آن‌جا ۲ لولهٔ انتقال (Ø12/Ø8، با O-ring) از فاصلهٔ بین فنرهای S رد می‌شوند. روزنه‌ها داخل همین لوله‌ها هستند. بعد شیار ۸ × ۵ روی نگه‌دارنده و میله‌های پاشش با سوراخ Ø4. سرعت‌ها ≤ ۲ m/s.
- **ISFD:** از همان شیار با فشار خط تغذیه می‌شود: ۲ روزنهٔ Ø1.1 و ۰٫۶ l/min. دو انتهای سطح فیلم با رینگ پیستونی چدنی (لقی ۰٫۱۵ mm) بسته است. فشار سطح ۱٫۵۱ bar(g) است. فشار فشردگی در دو برابر دامنهٔ API ۱٫۳۴ bar است، پس فیلم کامل می‌ماند.
- **ضدچرخش (گشتاور × ۳ برای راه‌اندازی):** پد با پین محور و پین توقف Ø4 (۳ MPa). نگه‌دارنده در ISFD با پین شعاعی Ø6. ISFD در محفظه با پین Ø8. حلقه‌های کف‌گرد با ۲ پین Ø6. همه زیر ۳ MPa.
- **تخلیهٔ ثقلی (API 614: نیمه‌پر، ≤ ۰٫۳ m/s، شیب ≥ ۱:۵۰، با ۳۰٪ کف):**
  - محفظهٔ جلو: دو خروجی عمودی DN40 زیر حفرهٔ کف‌گرد، با ظرفیت ۱٫۹ برابر جریان طراحی وقتی عمق روغن کف حفره ۱۲ mm است. با این عمق، فلنج کف‌گرد در روغن نمی‌چرخد. بعد DN65 با شیب ۲٫۶٪ داخل تونل plenum، و عمودی به مخزن جلوی plenum. سرعت ۰٫۲۳ m/s است.
  - ژورنال ۲ DN50، ۰٫۲۱ m/s، شیب ۱۱٪.
  - داخل محفظهٔ جلو: سوراخ‌های محوری Ø16 در دیوارهٔ جداکننده و یک سوراخ Ø14 در کف، از حفرهٔ جلو تا حفرهٔ کف‌گرد.
- **هواکش:** هر حفره هواکش جدا از بالا به مخزن دارد: محفظهٔ جلو DN25 (۷٫۸ m/s)، ژورنال ۲ DN32 (۴٫۳ m/s). مخزن جداکنندهٔ مه روغن دارد (المنت coalescing و فن کوچک، ۱۰ mbar مکش). ۱۱٫۹ g/s هوا از آن بیرون می‌رود.
- **آب‌بندها:**

| جا | نوع | لقی | هوا به حفره |
|---|---|---|---|
| جلوی ژورنال ۱ (سمت کوپلینگ) | windback و ۳ دندانه، بدون بافر (حفره ۱۰ mbar زیر محیط است) | ۰٫۲۰ | ۱٫۸ g/s |
| عقب کف‌گرد (چشم پروانه، ۰٫۹۱ bar) | windback و ۳ دندانه، بافر ۱٫۱۰ bar، ۴ دندانه | ۰٫۱۵ | ۴٫۴ g/s (۵٫۲ g/s به ورودی) |
| جلوی ژورنال ۲ (حفرهٔ پشت R2، ۱٫۰۴ bar) | حلقهٔ دونیمه: ۳ دندانه، بافر ۱٫۱۵ bar، windback | ۰٫۲۰ | ۵٫۷ g/s |
| عقب ژورنال ۲ | درپوش بسته، آب‌بند شفت لازم نیست | — | ۰ |

  - هوای بافر کف‌گرد ۹٫۶ g/s از خروجی طبقهٔ ۱ است (۱٫۸ bar، ۸۹ °C).
  - بافر ژورنال ۲ از هوای هاب فاز ۲ می‌آید (۳ روزنهٔ d 4 از P2، ۲۱٫۷ g/s). فشار هاب ۱٫۱۶ bar است وقتی لابیرنت هاب ساییده شده و ۱٫۵۱ bar وقتی نو است.
  - ۴ روزنهٔ Ø5.5 فشار حلقهٔ بافر را ۱٫۰۸ تا ۱٫۲۶ bar نگه می‌دارند. این دست‌کم ۳٪ بالای حفرهٔ پشت R2 است.
  - هوای واردشده به حفرهٔ ژورنال ۲ ۴٫۱ تا ۷٫۵ g/s است. سرعتش در هواکش DN25 حداکثر ۹٫۴ m/s است.
  - حاشیهٔ ۸٪ در کل بازهٔ فشار هاب با هواکش DN25 ممکن نیست. پس اگر بافر ضعیف شد، لقی لابیرنت هاب در بازرسی دیده شود.
  - هزینهٔ کل هوای آب‌بندها ~۳٫۸ kW است (حد ۰٫۵٪ = ۴٫۹ kW). این مقدار در waterfall عملکرد نیست و باید در فاز ۶ وارد شود.
  - جهت windbackها: جلوی ژورنال ۱ و ژورنال ۲ راست‌گرد، عقب کف‌گرد چپ‌گرد (چرخش +θ). همه روغن را به داخل حفره برمی‌گردانند.
- **ژورنال ۲ در هاب داغ (با نشیمن فاز ۲):**
  - هاب ۶۴۰ °C است. هوای هاب از منیفولد قاب می‌آید (۱۷۵ °C). حدود ۱۵ g/s آن از کانال r 150–167 رد می‌شود. سپر ۱۲ mm الیاف سرامیکی در فویل 1.4828 است و در r 167–181 قرار دارد، با شیار برای ۸ کلید.
  - گرمای وارد به روغن: کلیدها ۰٫۹۳ kW (با لایهٔ عایق)، هوا ۰٫۰۷ kW، شفت ۰٫۲۸ kW.
  - دیوارهٔ خیس ۱۰۲ °C است و زیر کلید ۱۲۹ °C. حد کک شدن ۱۵۰ °C است. بدون لایهٔ عایق زیر کلید ۱۹۰ °C می‌شد.
  - بعد از خاموشی داغ، روغن‌کاری ۳ l/min برای ۴۰ دقیقه لازم است. با آن ۸۰ °C، بدون آن ~۱۵۲ °C.

### ۱۹٫۵ لوله‌ها (`cad/engine/a1000_piping.py`)

| خط | سرویس | اندازه و جنس | از → به | انعطاف | جداشدن |
|---|---|---|---|---|---|
| PL-01 | هدر روغن و بلوک توزیع FB | لوله ۳۵ × ۲، 1.4404 | ماژول → بلوک جلوی plenum (x −190، y −400، z −400) | — | اتصال ۲۴° |
| PL-02 / 03 | روغن ژورنال ۱ و کف‌گرد | ۱۵ × ۱٫۵ و ۱۸ × ۱٫۵ | بلوک → به جلو داخل تونل plenum (r 193 و 177) → بوس‌های FB-2 (سمت −y) | سرد، صلب | اتصال روی بوس و جلوی plenum |
| PL-04 | روغن ژورنال ۲ | ۱۸ × ۱٫۵ | نازل جدای ماژول → کنار −y → پشت دنده‌های CB-340 → استرات بالا (r 590) | شیلنگ فلزی در خروجی استرات (بین دنده‌ها پایین می‌رود؛ لولهٔ صلب از −y می‌آید) | شیلنگ |
| PL-05 | تخلیهٔ محفظهٔ جلو | ۲ × DN40 + DN65 | FB-2 → داخل تونل (۲٫۶٪) → عمودی به مخزن جلوی plenum | — | اتصال سوکتی روی FB-2 |
| PL-06 | تخلیهٔ ژورنال ۲ | DN50 (شیلنگ PTFE بیرون منیفولد) | حفرهٔ استرات پایین → مخزن، ۱۱٪ | شیلنگ | شیلنگ |
| PL-07 / 08 | هواکش‌ها | DN25 و DN32 | PL-07: از بالای FB-1 فوراً به کنار (y 146، کنار کوپلینگ که از بالا می‌آید و زیر لبهٔ بدنهٔ ورودی)، از تونل جلو، جلوی plenum پایین به مخزن. PL-08: استرات −y → مخزن. هر دو با شیب پیوسته. | شیلنگ در خروجی استرات −y | اتصال و شیلنگ |
| PL-09 | هوای بافر | لوله ۲۲ × ۱٫۵ | برداشت DN25 روی کانال برگشت → کنار plenum در سمت −y (y −720، z 560) → پایین جلوی plenum (x −170) → در y −230 داخل تونل → در x −120 به سمت بوس ۲۲۵° FB-2 | — | چهار تکه با اتصال: سر برداشت، مسیر کنار plenum، رایزر، تکهٔ تونل |
| PL-10 | سوخت P، A، B1، B2 | شیلنگ فلزی ۱۸ و ۲۸ | بلوک شیرهای گاز → انتهای لوله‌های پایین‌روی CB-370 (z 900) | شیلنگ (محفظه ۱۴ mm بالا می‌رود) | اتصال ۲۴° در z 900 و روی درپوش |
| PL-12 | تخلیهٔ محفظهٔ احتراق | ۱۸ × ۱٫۵ | کف اسکرول (غلاف لغزشی در CB-341) و کف CB-341 → ظرف تخلیه | غلاف لغزشی | اتصال |
| PL-13 | روغن گیربکس | ۲۸ × ۲ | ماژول → گیربکس | — | اتصال |
| LO-100 | مخزن روغن | ۴۵۵ l، 1.4301 | داخل شاسی | — | — |
| PL-90 | پایه‌ها | S235 | — | — | — |

- **سوخت:** افت خط و pigtail حداکثر ۰٫۰۵ bar است. حاشیهٔ فشار گاز بعد از این افت ۰٫۱۰ bar می‌ماند (لازم ≥ ۰٫۰۵). سرعت‌ها ≤ ۲۰ m/s.
- **BOV DN125:** همان EX-441 فاز ۲ است (انشعاب از لولهٔ DN350 هوای سرد). تکرار نشد.
- **هوای خنک‌کن دیسک:**
  - حفرهٔ جلوی توربین از آب‌بند تعادل درام تغذیه می‌شود (بخش ۱۳٫۳). لوله لازم نیست.
  - حفرهٔ پشت R2 از کانال سپر ژورنال ۲ تغذیه می‌شود (هوای منیفولد قاب).
- **قاعده‌ها:**
  - همهٔ لوله‌های روغن، سوخت و تخلیه در سمت −y و زیر موتورند. +y برای کانال‌های recuperator خالی می‌ماند.
  - لوله‌های یاتاقان جلو از داخل تونل خشک plenum به جلو می‌روند. هیچ لوله‌ای از هوای فیلترشده رد نمی‌شود.
  - هیچ لوله‌ای از مسیر بالا بردن نیمه‌های بالا رد نمی‌شود، جز آن‌هایی که به همان قطعه وصل‌اند و اول باز می‌شوند.
  - اتصال‌ها: لوله 1.4404 بدون درز (EN 10216-5) با اتصال مخروطی ۲۴° (ISO 8434-1، سری L). لوله‌های DN با فلنج EN 1092-1 PN16. شیلنگ‌ها ISO 10380.

### ۱۹٫۶ نتیجهٔ چک‌ها

| چک | نتیجه |
|---|---|
| روتور (`a1000_rotor_stack.py`) با ژورنال‌های ۴ پدی | **۴۱ از ۴۱**. فیلم ۶۳ / ۵۵ µm (قبلاً ۵۹ / ۴۷). تلفات همان ۸٫۷ kW. بحرانی‌ها ۳٬۸۹۵ / ۸٬۲۸۲ / ۲۱٬۲۰۲ rpm. حاشیهٔ مود خمشی ۳۴٫۶٪ (لازم ۲۰٫۲٪). API ۴٫۰ µm. |
| روغن‌کاری، آب‌بند و لوله | ۲۹ از ۲۹ (یک چک تازه: ظرفیت دو خروجی DN40 زیر FB-2) |
| بخش داغ با کلیدها | ۱۳ از ۱۳ (برش کلید ۹ MPa، فشار سطح ۲۳ MPa) |
| محفظهٔ احتراق | ۳۰ از ۳۰ (بدون تغییر) |
| تداخل ایستا (همهٔ جفت‌ها در موقعیت نهایی) | ۱۱۴ قطعه (با قطعه‌های ورودی فاز ۳). **هیچ تداخلی در قطعه‌های این بخش و قطعه‌های ورودی نماند.** ۱۳ جفت باقی‌اند: ۳ تماس طراحی‌شدهٔ دندانه‌های Curvic (۵–۹ mm³)؛ ۶ جفت جاگیر بدنهٔ کمپرسور با بدنهٔ ورودی، plenum، RT-104 و درام (فاز ۷)؛ ۴ جفت دنده‌های صفحهٔ عقب بدنهٔ اسکرول با منیفولد و لولهٔ فاز ۲ (فاز ۷). قبل از اصلاح: R1 و NGV1 ۲٬۹۴۹ mm³؛ در اولین چک طرح جدید ۳۵ جفت خطا در قطعه‌های جدید؛ و بعد از تغییر FB برای فاز ۳، تداخل‌های پنهان پشت FB-2 خراب و در لوله‌ها (بندهای ۲۰ تا ۲۲ جدول ۱۹٫۲). همه رفع شدند. زمان: ۲۶ دقیقه روی vast با ۱۰ پردازه. |
| مسیر مونتاژ، ترتیب قبلی (۶ حرکت از ۴۰ که عیب را نشان می‌دهند) | استاد و مهرهٔ درام–R1: ۲٬۰۴۲ mm³. کف‌گرد محوری از جلو: محفظه ۱۷۳٬۷۵۶، حلقه‌ها ۶۹٬۹۴۴، پدها ۷٬۸۴۱. ژورنال ۱ محوری از جلو: محفظه ۱۱۹٬۱۱۰، نگه‌دارنده ۶۵٬۰۶۸، ISFD ۲۸٬۰۹۰، پدها ۶٬۵۷۲. ژورنال ۲ از عقب: بدون برخورد. پین‌ها ا| مسیر مونتاژ، ترتیب جدید (۸۰ حرکت) | همهٔ ۸۰ حرکت چک شدند (`sim/engine/fea/a1000_assembly_check_new.json`). **در مسیر قطعه‌های این بخش، لوله‌ها و قطعه‌های ورودی هیچ برخوردی نماند.** ۸ حرکت در مسیر برخورد دارند. همه از جاگیر بدنهٔ کمپرسور یا موارد شناخته‌شدهٔ فاز ۷ هستند (بند ۱۸): B5b و D4b (بدنهٔ ورودی با جاگیر)؛ C1 و D4 (جاگیر با RT-104 و درام: ۳۵ و ۶ mm³ در مسیر، ۴٬۴۸۹ و ۴۳۲ mm³ در انتها)؛ F6 و F19 (plenum با جاگیر، ۱۷٬۶۲۵ mm³)؛ D9 (دنده‌های اسکرول با EX-401)؛ F20 (EX-440 با اسکرول). در انتهای A3 تا A5 فقط تماس دندانه‌های Curvic (۵–۹ mm³) هست. نیم‌مجموعهٔ بالای استاتور (D3) و نیمهٔ بالای اسکرول (D6) بدون برخورد گذشتند. ۲۹ حرکت مرحلهٔ F (پکیج، لوله‌ها، ورودی) با مسیر نهایی لوله‌ها دوباره اجرا شدند (بند ۲۶). |جدول اضافه می‌شود. |

### ۱۹٫۷ رابط‌ها و کارهای باز

1. **فاز ۲ (اگزوز):** بند ۱۷ جدول ۱۹٫۲ (تخلیه، هواکش، عایق زیر کلیدها). فشار کانال سپر ~۱٫۳۵ bar باشد.
2. **فاز ۳ و ۷ (بدنه و ورودی):** (بندهای ۱۸ و ۱۹ جدول ۱۹٫۲)
   - فاز ۳ (بخش ۲۰): بدنهٔ ورودی IN-501 و IN-502 دونیمه است. دیوارهٔ هاب روی قطر بیرونی FB است و روی سطح دماغه آب‌بند می‌شود. plenum تونل خشک r 284 دارد. براکت‌های L زیر پایه‌های FB-2 هستند.
   - خارهای پایه‌ها و خار وسط پایین روی IN-502 باشند.
   - بدنهٔ کمپرسور واقعی (فاز ۷) جای جاگیر فعلی را بگیرد.
   - بوس برداشت هوای طبقهٔ ۱ (DN25) روی کانال برگشت.
   - تکیه‌گاه‌های موتور روی شاسی.
3. **فاز ۸ (پیچ‌ها):** پیچ‌های درز FB (۳ × M12 هر طرف)، پایه‌ها (M16 در سوراخ لوبیایی)، درپوش ژورنال ۲ (M8)، کلیدهای تکیه‌گاه (۲ × M8)، فلنج C1–C2، دیوارهٔ داخل CB-341. ترتیب سفت کردن مهره‌های روتور (دیسک ۶ mm عقب، سفت کردن ضربدری).
4. **فاز ۹ (حسگرها):** پروب‌های ژورنال ۲ و ترموکوپل پدها از استرات +y. دمای تخلیهٔ هر حفره. فشار هدر. اختلاف فشار فیلتر. سطح مخزن. فشار حلقهٔ بافر.
5. **منطق کنترل:** روغن‌کاری قبل از راه‌اندازی، روغن‌کاری ۴۰ دقیقه بعد از خاموشی داغ، پمپ DC، trip با فشار کم هدر، شیرهای تخلیهٔ محفظهٔ احتراق (در روشن شدن بسته، fail-open).
6. **فیوژن:** بستهٔ v12 هنوز قطعه‌های قدیمی را دارد. `pkg.json` به‌روز است (۱۱۴ قطعه، با قطعه‌های ورودی فاز ۳). ساخت دوباره فقط با اجازهٔ کاربر. افزونه ترتیب تازه را دارد.

## ۲۰. ورودی هوا: plenum، کانال شعاعی با پایه‌ها، خم و دهانه تا چشم پروانهٔ ۱ (فاز ۳، ۲۰۲۶-۱۰-۳۱)

طراحی و محاسبه: `sim/engine/a1000_inlet.py` (نتایج: `sim/engine/fea/a1000_inlet.json`) · CFD: `sim/cfd/a1000_inlet/make_case.py` (OpenFOAM v2506 روی سرور ابری، NP 32، نتایج: `sim/cfd/a1000_inlet/results.json`) · CAD: `cad/engine/a1000_inlet.py` → `fusion/A1000_inl/` (۵ قطعه، در `pkg.json`)

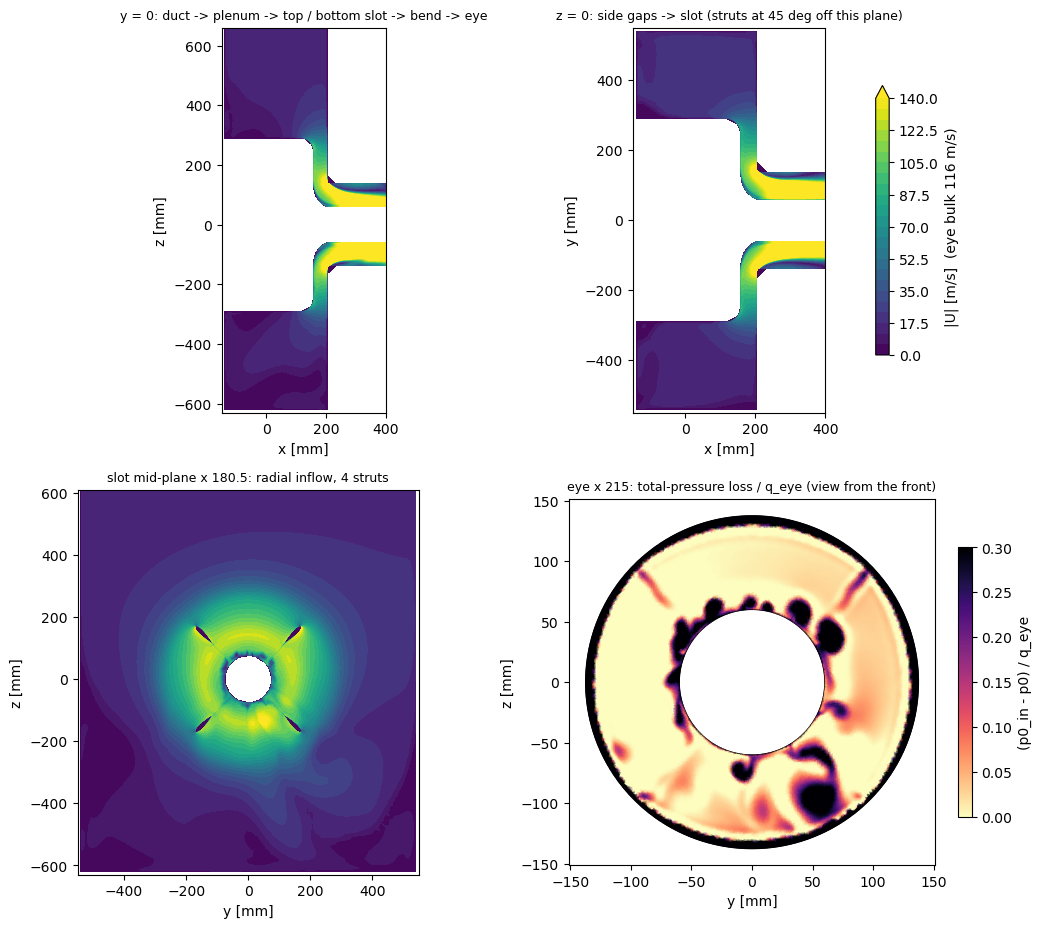
[picture p24: docs/img/a1000_inlet_cfd.png]
CFD ورودی: سرعت در صفحه‌های میانی و افت فشار کل در چشم


- **سؤال:** فرض ۱٫۰٪ افت ورودی سیکل واقعی است؟ شفت و کوپلینگ از جلو بیرون می‌روند، پس ورودی شعاعی است. این ورودی چطور ساخته شود؟
- **پاسخ کوتاه:**
  - سهم ما (plenum، کانال شعاعی، پایه‌ها، خم و دهانه): **ζ = ۰٫۰۷۱** از فشار دینامیکی چشم، یعنی **۵۶۰ Pa**.
  - سهم فروشنده (فرض): خانهٔ فیلتر F7 + F9، خنک‌کن هوای ورودی و صداخفه‌کن. ۶۰۰ Pa تمیز، ۱٬۰۳۰ Pa کثیف، **۸۱۵ Pa** در میانهٔ عمر فیلتر.
  - جمع: **۱٬۳۷۵ Pa = ۱٫۳۶٪** به جای ۱٫۰٪.
  - توان به شبکه در TIT ۹۷۰ °C: **۹۶۸٫۵ ← ۹۶۳٫۱ kW**. راندمان برق: **۳۶٫۱۸ ← ۳۶٫۰۵٪**.
  - **یافتهٔ اصلی:** خم شعاعی به محوری با چیدمان فعلی روتور خیلی تند است. بین دیوارهٔ جلوی کانال (x 157، پشت کف‌گرد) و لبهٔ حملهٔ پروانه (x 215) فقط ۵۸ mm جا هست. چشم ۷۷٫۵ mm ارتفاع دارد. گوشهٔ سمت shroud فقط R10 است. جریان در لبهٔ حمله نزدیک نوک هنوز ~۴۰° رو به داخل است و در CFD بدون پره روی shroud جدا می‌شود.
  - اگر یاتاقان‌های جلو و کوپلینگ ۲۵ mm جلوتر بروند (تغییر روتور، نسخهٔ E)، افت در مش درشت **۵۵٪ کمتر** است (ζ ۰٫۰۴۶ در برابر ۰٫۱۰۴) و زاویهٔ نوک ۲۵° می‌شود: **+۳ تا +۵ kW**. این تصمیم با کاربر است (بخش ۲۰٫۱۱).

### ۲۰٫۱ شرایط چشم پروانهٔ ۱ (ایستگاه ۱)

| | مقدار |
|---|---|
| دبی هوا | ۶٫۳۱۷ kg/s (۵٫۲۶ m³/s در plenum) |
| هوا | ۱۵ °C، رطوبت ۹۰٪ (بعد از خنک‌کن ورودی)، فشار محیط ۱٫۰۰۷ bar |
| چشم | هاب r 60، shroud r 137٫5، لبهٔ حمله x 215، سطح ۰٫۰۴۸۱ m² |
| سرعت محوری متوسط | ۱۱۶ m/s |
| ماخ | ۰٫۳۴۴ |
| چگالی استاتیک | ۱٫۱۳۳ kg/m³ |
| فشار دینامیکی q | **۷٫۸۵ kPa** (۷٫۸٪ از فشار کل) |

- q چشم بزرگ است. هر ۰٫۰۱ در ζ یعنی ۷۸ Pa و ۱٫۲ kW توان.

### ۲۰٫۲ چیدمان و قطعات

**اصل‌ها:**
- همهٔ قطعه‌ها در صفحهٔ z = 0 دونیمه‌اند، مثل یاتاقان جلو (FB-1 / FB-2). نیمه‌های بالا رو به بالا برداشته می‌شوند.
- موقعیت با spigot و پین است. رابط‌ها فلنجی و تخت‌اند تا فاز ۷ (بدنهٔ یکپارچه) ساده باشد.
- **تونل خشک:** دیوارهٔ داخلی plenum یک استوانهٔ r 290 دور FB و کوپلینگ است. فشار آن محیط است و جلویش (x −140) باز است. همهٔ لوله‌ها و سیم‌های FB از جلوی تونل بیرون می‌روند. هیچ لوله‌ای از هوای فیلترشده رد نمی‌شود. پس آب‌بند و پایهٔ توخالی لازم نیست.

**مسیر هوا:**
1. فلنج خانهٔ فیلتر روی سقف plenum (۱۰۸۰ × ۳۴۴ mm، ۱۴ m/s).
2. **plenum** جعبه‌ای: x −140 تا 204، y ±540، z −620 تا 600. هوا از دو طرف تونل پایین می‌آید (~۱۵ m/s).
3. لبهٔ گرد جلو R40 و **کانال شعاعی** بین دیوارهٔ هاب (x 157) و دیوارهٔ shroud (x 204)، پهنای ۴۷ mm. سطح ورود کانال (r 250) ۱٫۵۴ برابر چشم است.
4. **۴ پایه** در کانال (r 165 تا 240).
5. خم: سمت هاب همان دماغهٔ FB است (بخش ۱۵٫۶)، سمت shroud گوشهٔ R10 تا r 137٫5 در x 214.
6. چشم پروانه (x 215).

| قطعه | جنس | جرم | کار |
|---|---|---|---|
| IN-501 بدنهٔ ورودی، نیمهٔ بالا | EN-GJS-400-18 | ۵۶٫۶ kg | دیوارهٔ هاب x 143–157 (سوراخ r 130٫5 روی FB، O-ring طنابی روی سطح دماغهٔ FB)، لبهٔ R40 و حلقهٔ تونل، ۲ پایه (۴۵° و ۱۳۵°)، دیوارهٔ shroud x 204–222 با گوشهٔ R10 تا چشم، فرورفتگی spigot r 150 روی بدنهٔ کمپرسور، ۲۴ × M12 از پشت. |
| IN-502 بدنهٔ ورودی، نیمهٔ پایین | EN-GJS-400-18 | ۵۹٫۰ kg | مثل IN-501 با پایه‌های ۲۲۵° و ۳۱۵°، و **دو براکت L برای پایه‌های FB-2** (سطح z −20، هر کدام ۲ × M16، پنجره برای اتصال‌های روغن). |
| IN-510 جعبهٔ plenum، نیمهٔ بالا | S235JR ورق ۶ mm | ۸۴٫۲ kg | فلنج خانهٔ فیلتر روی سقف، نیم‌تونل r 290، فلنج‌های درز، ۲ گوشوارهٔ بلند کردن. روی لبهٔ بدنه (۲۴ × M10، هم‌سطح) و حلقهٔ تونل (۱۶ × M10) پیچ می‌شود. حلقهٔ فلنج تونل r 253–284 است. |
| IN-511 جعبهٔ plenum، نیمهٔ پایین | S235JR ورق ۶ mm | ۱۰۸٫۳ kg | نیم‌تونل پایین بدون هیچ سوراخ، ۴ پایه روی شاسی، تخلیهٔ آب در پایین‌ترین نقطه (شستشو و قطره‌های کویل). |
| IN-520 رابط خانهٔ فیلتر | S235JR + پارچه | ۵۱٫۸ kg | قاب ۳۰۰ mm با درز انبساط پارچه‌ای تا کانال فروشنده. |

- جمع جرم: **۳۶۰ kg**. سنگین‌ترین قطعه ۱۰۸ kg است.
- ریخته‌گری بدنه ساده است: دو دیوارهٔ تخت، یک لبهٔ گرد و ۴ پایهٔ توپر. ماشین‌کاری: spigot، سطح پشت، سطح آب‌بند روی FB، سطح براکت‌ها و سطح درز.

### ۲۰٫۳ پایه‌ها و یاتاقان جلو

**تعداد پایه:** wake و میدان پتانسیل پایه‌ها پروانهٔ ۱ را با EO = k × n تحریک می‌کنند. حاشیه از سه خانوادهٔ اول مدل cyclic پروانهٔ ۱ (بخش ۱۵٫۸)، در ۱۴٬۷۰۰ تا ۱۵٬۳۰۰ rpm:

| پایه‌ها | EO n (لازم ۱۰٪) | EO 2n (لازم ۵٪) | نتیجه |
|---|---|---|---|
| ۳ | EO3: −۵۳٫۳٪ | EO6: −۷٫۸٪ | قبول |
| **۴** | **EO4: −۳۸٫۱٪** | **EO8: −۱۶٫۲٪** | **قبول** |
| ۵ | EO5: −۲۳٫۰٪ | EO10: −۸٫۰٪ | قبول |
| ۶ | EO6: −۷٫۸٪ | EO12: +۱۱٫۸٪ | رد |
| ۷ | EO7: +۳٫۳٪ | EO14: +۳۰٫۴٪ | رد |
| ۸ | EO8: −۱۶٫۲٪ | EO16: +۴۱٫۴٪ | قبول |

- **۴ پایه** در ۴۵°، ۱۳۵°، ۲۲۵° و ۳۱۵°. صفحهٔ درز بین پایه‌ها می‌گذرد، پس هیچ پایه‌ای دونیمه نیست. هر نیمه دو پایه دارد و یک قطعهٔ صلب است.
- شکل: متقارن، وتر شعاعی ۷۵ mm (r 240 تا 165)، ضخامت ۱۵٫۸ mm (t/c ۰٫۲۱)، لبهٔ فرار ۲ mm. پهنای پایه همان پهنای کانال است (۴۷ mm). انسداد ۵٫۰٪.
- **بار:** ۵ برابر بار ایستای JB1 و وزن FB و نیم کوپلینگ: ۸٫۰ kN عمودی. نیروی محوری کف‌گرد (کران بالای فاز ۱): ۶٫۴ kN. تنش برشی پایه‌ها ۳٫۰ MPa و تنش محوری ۲٫۰ MPa.
- **سختی تکیه‌گاه FB** (پایه‌ها، براکت‌ها و حلقهٔ دیوارهٔ هاب سری؛ حلقه برآورد): 6.2e+08 N/m، یعنی **۲۰ برابر ISFD**. پس مدل دینامیک روتور عوض نمی‌شود.
- **پایه‌های FB-2:** روی دو براکت L نیمهٔ پایین (y ±160 تا 215، x 55 تا 143). FB حدود ۴۵ K گرم‌تر از بدنهٔ ورودی است. فاصلهٔ دو پایه ۰٫۱۸ mm رشد می‌کند. پس سوراخ‌های M16 در جهت y شیاری‌اند (جلسهٔ بخش ۱۹، commit a709525).
  - **موقعیت محوری:** زیر هر پایه یک خار عرضی ۱۶ × ۶ (x 87–103). شیار هم‌جفت آن روی سطح هر دو براکت IN-502 است.
  - **موقعیت جانبی:** جای خار وسط پایین FB-2 (x 40–80، y ±10). نگه‌دارندهٔ این خار روی IN-502 هنوز نیست. زیر FB-2 بوس‌های تخلیهٔ DN40 (y ±32، x 79–141) و خط هوای بافر (۲۲۵°) راه یک براکت از دیوارهٔ هاب را می‌گیرند. با فاز ۷ و ۸ طراحی شود.
- **سرویس‌ها:** پایه‌ها توپرند. روغن JB1 و کف‌گرد، هوای بافر، تخلیهٔ DN65، هواکش DN25 و سیم‌های حسگر از FB **رو به جلو در تونل** می‌روند. در x −140 تا −240 (جلوی plenum، پشت گیربکس) بیرون می‌آیند. تخلیه در تونل تا z ~−260 پایین می‌رود، با شیب ≥ ۱:۵۰ جلو می‌آید و جلوی plenum عمودی به مخزن می‌رود.
  - جلسهٔ بخش ۱۹ همین مسیر را پذیرفت (commit a709525): PL-01، 02، 03، 05، 07 و 09 در تونل (r 284) جلو می‌روند. تخلیه حالا ۲ × DN40 در x 110 است که به DN65 می‌رسد.

### ۲۰٫۴ CFD

**مدل:**
- RANS پایا، تراکم‌ناپذیر (simpleFoam)، k-ω SST با تابع دیواره، کل ۳۶۰°.
- دامنه: ۴۰۰ mm کانال بالای فلنج فیلتر (سرعت یکنواخت، شدت آشفتگی ۵٪، مقیاس ۵۰ mm)، plenum با تونل، کانال شعاعی با ۴ پایه، خم، و چشم بدون پره تا x 400 (فشار ثابت در خروجی).
- چگالی: چگالی استاتیک چشم. پس سرعت چشم درست است و سرعت‌های plenum ۶٪ بیشتر (محافظه‌کارانه). ζ از 0.5 c² چشم است و روی فشار دینامیکی تراکم‌پذیر چشم (۷٫۸۵ kPa) اعمال می‌شود.
- **ζ** = افت فشار کل جرمی از ورودی تا صفحهٔ لبهٔ حمله (x 215)، از مقدار سلول‌ها، میانگین ۳۰٪ آخر تکرارها (حل پایا نوسان دارد).
- مش snappyHexMesh. کانال و خم سطح ۳، دیواره‌های خم و پایه‌ها سطح ۴. سلول پایه ۲۸ / ۲۱ / ۱۵٫۷۵ mm (نسبت ۱٫۳۳).

**دور طراحی (مش درشت، ~۱٫۱ میلیون سلول):**

| نسخه | تغییر | ζ (بازهٔ نوسان) | DC60 | swirl قطاع‌ها | نتیجه |
|---|---|---|---|---|---|
| **A** | ۴ پایه، گوشهٔ R10 (هندسهٔ بخش ۱۵٫۶) | ۰٫۱۰۴ (۰٫۰۹۷–۰٫۱۱۲) | ۰٫۰۳۳ | −۱۱٫۸ تا +۸٫۰° | **انتخاب** |
| B | A + تیغهٔ جداکنندهٔ پایین plenum (y = 0) | ۰٫۱۰۸ | ۰٫۰۵۱ | −۸٫۶ تا +۸٫۲° | رد: افت و DC60 بیشتر |
| C | A + حلقهٔ هادی حلقوی در خم (روی پایه‌ها) | ۰٫۲۱۳ | ۰٫۰۵۸ | −۱۲٫۹ تا +۸٫۶° | رد: خود حلقه جدا می‌شود، جدایش shroud می‌ماند |
| E | **اگر FB و کف‌گرد ۲۵ mm جلوتر بروند** (دیوارهٔ هاب x 132، گوشهٔ R35) | ۰٫۰۴۶ (۰٫۰۳۷–۰٫۰۵۶) | ۰٫۰۵۷ | −۱۱٫۱ تا +۵٫۸° | بهترین، ولی تغییر روتور |

- نسخهٔ D (حلقهٔ بلندتر) بعد از نتیجهٔ C متوقف شد.
- **چرا خم تند است:**
  - سمت هاب ثابت است: دماغهٔ FB از (x 157، r 150) شروع می‌شود، چون کف‌گرد تا x 156 است.
  - سمت shroud تا لبهٔ حمله فقط ۱۰ mm جا دارد. گوشهٔ بزرگ‌تر یعنی کانال باریک‌تر (R20 → پهنای ۳۷ mm و سطح ۰٫۷۶ چشم).
  - در A (مش ریز)، در x 215 جریان در r 100 تا 135 با ۲۰ تا ۴۰° رو به داخل می‌آید (بالا ۳۳ تا ۴۰°، پایین ۱۹ تا ۳۴°). از x ~۲۲۰، در ۵ تا ۸ mm کنار shroud جریان برگشتی است (در چشم بدون پره).
  - به همین دلیل ζ تا خروجی (x 400) حدود ۰٫۳۵ است: در لولهٔ خالی بعد از چشم، جدایش shroud بزرگ می‌شود. این عدد واقعی نیست، چون آن‌جا پروانه است. ζ در لبهٔ حمله مبناست.
  - با پروانه، پره‌های القاگر جریان را می‌کشند. پس اندازهٔ واقعی جدایش را فقط CFD پله با پروانه نشان می‌دهد (فاز ۶).

**مطالعهٔ مش (نسخهٔ A):**

| مش | سلول‌ها | ζ (بازهٔ نوسان) | ζ تا خروجی x 400 | y+ میانگین خم |
|---|---|---|---|---|
| درشت | ۱٬۰۵۵٬۲۹۶ | ۰٫۱۰۴ (۰٫۰۹۷–۰٫۱۱۲) | ۰٫۳۵۳ | ۲۱۳ |
| متوسط | ۲٬۲۴۶٬۴۹۶ | ۰٫۰۸۰ (۰٫۰۷۴–۰٫۰۸۷) | ۰٫۳۵۶ | ۱۶۴ |
| ریز | ۴٬۸۰۷٬۹۱۶ | ۰٫۰۷۱ (۰٫۰۶۴–۰٫۰۷۸) | ۰٫۳۴۷ | ۱۲۲ |

- مش متوسط از جواب درشت و مش ریز از جواب متوسط شروع شدند (۱۵۰۰ و ۱۰۰۰ تکرار). مش ریز ۸ وجه با skewness بالای ۴ دارد (از ۴٫۸ میلیون).
- هم‌گرایی یکنوا. مرتبهٔ ظاهری ۳٫۲۵، مقدار Richardson ۰٫۰۶۵، GCI مش ریز ۱۰٫۳٪.
- **مقدار طراحی: ζ = ۰٫۰۷۱** (مش ریز).

**تفکیک افت (فشار کل جرمی روی استوانهٔ r 270، جلوی پایه‌ها):**

| بخش | ζ | Pa |
|---|---|---|
| plenum و لبهٔ ورود (تا r 270) | ۰٫۰۱۴ | ۱۱۰ |
| کانال شعاعی، پایه‌ها، خم و دهانه تا لبهٔ حمله | ۰٫۰۵۷ | ۴۵۰ |
| **جمع** | **۰٫۰۷۱** | **۵۶۰** |

- سهم plenum در هر سه مش ۰٫۰۱۳ تا ۰٫۰۱۶ است. پس plenum کوچک ولی کافی است. **بیشتر افت در کانال و خم است.**
- تفکیک کانال از خم روی استوانهٔ r 152 بین مش‌ها پایدار نبود (این استوانه از گوشهٔ shroud رد می‌شود). پس فقط جمع آن گزارش شد.

### ۲۰٫۵ اعوجاج در چشم (مش ریز، صفحهٔ x 215)

| معیار | مقدار | توضیح |
|---|---|---|
| DC60 | **۰٫۰۴۶** | (میانگین فشار کل − کمینهٔ میانگین قطاع ۶۰°) / q. حد معمول کمپرسور گریز از مرکز ~۰٫۱ تا ۰٫۲ |
| انحراف فشار کل قطاع‌های ۵° | −۰٫۱۶ تا +۰٫۱۵ q | |
| زاویهٔ swirl قطاع‌ها (جرمی، کل ارتفاع) | **−۱۰٫۷ تا +۹٫۰°** | + هم‌جهت چرخش. میانگین −۰٫۵° |
| swirl محلی (rms) | ۱۹٫۱° | |
| سرعت محوری قطاع‌ها / میانگین | ۰٫۹۱ تا ۱٫۱۳ | |
| شاخص یکنواختی سرعت محوری | ۰٫۹۰۶ | ۱ = کاملاً یکنواخت |
| سطح جریان برگشتی | ۱٫۴۷٪ | |

**نیم‌رخ شعاعی (میانگین محیطی، هاب ← نوک):**

| r [mm] | سرعت محوری / میانگین | افت فشار کل / q | swirl [°] |
|---|---|---|---|
| ۶۰–۷۵ | ۰٫۷۶ | +۰٫۰۲ | +۱٫۳ |
| ۷۶–۹۱ | ۰٫۹۳ | −۰٫۰۸ | +۱٫۵ |
| ۹۱–۱۰۶ | ۱٫۰۳ | −۰٫۰۷ | −۰٫۵ |
| ۱۰۷–۱۲۲ | ۱٫۱۵ | −۰٫۰۶ | −۱٫۰ |
| ۱۲۲–۱۳۷ | ۱٫۰۲ | +۰٫۲۲ | −۱٫۶ |

- **اعوجاج محیطی کم است** (DC60 ۰٫۰۴۶). تونل گرد است و هوا از دو طرف متقارن پایین می‌آید. swirl قطاع‌ها دو علامتی است: جریان پایین‌روندهٔ چپ و راست در کانال شعاعی دو گردابهٔ مخالف می‌سازد.
- مرتبه‌های پایین (EO 1 تا 4) از خانوادهٔ اول پروانهٔ ۱ ≥ ۶۲٪ دورند (بخش ۱۵٫۸). پس تحریک خطرناک نیست.
- **اعوجاج شعاعی بزرگ است:** نزدیک هاب (r 60–76) سرعت محوری ۲۴٪ کمتر از میانگین است و در r 107–122، ۱۵٪ بیشتر. در ۱۵ mm کنار shroud افت فشار کل ۰٫۲۲ q است. این یعنی incidence بیشتر در هاب، کمتر در میانهٔ نوک، و لایهٔ کم‌انرژی کنار shroud. جریان نزدیک نوک هنوز رو به داخل است. اثر آن روی بازده و حاشیهٔ surge باید در فاز ۶ با CFD پله دیده شود.
- swirl متوسط کوچک است: −۰٫۵° در مش ریز (−۱٫۹ و −۴٫۵° در درشت و متوسط، خلاف چرخش). جهت جریان زیر تونل ناپایدار است. بیشترین اثر (مش متوسط) کار پروانهٔ ۱ را ~۲٪ بیشتر می‌کند (U·cθ ≈ ۱٫۵ kJ/kg در شعاع rms). تیغهٔ پایین (B) آن را تقریباً صفر می‌کرد (−۰٫۴°)، ولی افت و DC60 بیشتری داشت. در فاز ۶ با CFD پله دیده شود.

### ۲۰٫۶ افت فشار: فرض در برابر محاسبه

**سهم فروشنده (فرض، در ۵٫۳ m³/s):**

| جزء | تمیز [Pa] | تعویض [Pa] | طراحی (میانهٔ عمر) [Pa] |
|---|---|---|---|
| کلاهک، لوور باران، توری | ۵۰ | ۵۰ | ۵۰ |
| مرحلهٔ ۱: F7 (ePM1 55٪) کیسه‌ای فشرده | ۹۰ | ۲۵۰ | ۱۷۰ |
| مرحلهٔ ۲: F9 (ePM1 85٪) V-cell | ۱۳۰ | ۴۰۰ | ۲۶۵ |
| خنک‌کن هوای ورودی (کویل آب سرد، ۱۵ °C) + قطره‌گیر | ۱۸۰ | ۱۸۰ | ۱۸۰ |
| صداخفه‌کن ورودی | ۱۰۰ | ۱۰۰ | ۱۰۰ |
| کانال، گذار و درز پارچه‌ای تا فلنج plenum | ۵۰ | ۵۰ | ۵۰ |
| **جمع** | **۶۰۰** | **۱٬۰۳۰** | **۸۱۵** |

- مبنای توان نامی: میانهٔ عمر فیلتر (تمیز + ۵۰٪ افزایش).

| | فرض سیکل | تمیز | طراحی | کثیف |
|---|---|---|---|---|
| فروشنده [Pa] | — | ۶۰۰ | ۸۱۵ | ۱٬۰۳۰ |
| سهم ما (CFD) [Pa] | — | ۵۶۰ | ۵۶۰ | ۵۶۰ |
| **dp_inlet** | **۱٫۰٪** | **۱٫۱۵٪** | **۱٫۳۶٪** | **۱٫۵۸٪** |

- فرض ۱٫۰٪ کم بود. خود plenum و خم ما ۰٫۵۶٪ است.

### ۲۰٫۷ توان و راندمان (`sim/engine/a1000_performance.py`)

| | پیش از فاز ۳ | پس از فاز ۳ | تغییر |
|---|---|---|---|
| dp_inlet | ۱٫۰٪ | ۱٫۳۶٪ | |
| توان به شبکه در TIT ۹۷۰ °C | ۹۶۸٫۵ kW | **۹۶۳٫۱ kW** | −۵٫۳ kW |
| راندمان برق (شبکه) | ۳۶٫۱۸٪ | **۳۶٫۰۵٪** | −۰٫۱۳ واحد |
| دمای اگزوز | ۲۵۴ °C | ۲۵۴ °C | |
| گاز | ۲۷۹٫۸ Sm³/h | ۲۷۹٫۳ Sm³/h | |
| راندمان کل | ۷۵٫۰٪ | ۷۵٫۰٪ | |
| TIT برای ۱٬۰۰۰ kW | ۹۸۹ °C | ۹۹۲ °C (عمر R1 ۳۶٬۷۸۲ h) | |

- حساسیت: هر ۰٫۱٪ افت ورودی بیشتر **−۱٫۵ kW** و −۰٫۰۴ واحد راندمان.
- فیلتر تمیز: ۹۶۶٫۳ kW. فیلتر در لحظهٔ تعویض: ۹۶۰٫۰ kW.
- **با نسخهٔ E** (یاتاقان‌ها ۲۵ mm جلوتر): ۹۶۶ kW با ζ مش درشت E (+۳ kW). اگر E هم مثل A با ریز شدن مش ۳۱٪ کم شود، +۵ kW.

### ۲۰٫۸ مونتاژ و دمونتاژ

1. شاسی: نیمهٔ پایین plenum (IN-511) روی شاسی، پیش از هستهٔ موتور (مرحلهٔ F بخش ۱۹٫۳).
2. هستهٔ موتور: نیمهٔ پایین بدنهٔ ورودی (IN-502) با spigot r 150 و ۱۲ پیچ از پشت روی نیمهٔ پایین بدنهٔ کمپرسور. بعد FB-2 روی براکت‌ها (مرحلهٔ B).
3. روتور پایین می‌آید. FB-1 و نیمه‌های بالای یاتاقان (مرحلهٔ D).
4. نیمهٔ بالای بدنهٔ ورودی (IN-501) از بالا، پیچ‌های درز (۲ × M12 جلو، ۲ × M10 روی حلقهٔ تونل) و ۱۲ پیچ از پشت.
5. هسته روی شاسی پایین می‌آید. نیمهٔ پایین بدنهٔ ورودی در U نیمهٔ پایین plenum می‌نشیند. پیچ‌های لبه و حلقهٔ تونل.
6. کوپلینگ از بالا، از داخل تونل باز.
7. نیمهٔ بالای plenum (IN-510) از بالا، فلنج‌های درز، بعد IN-520 و کانال فیلتر.

- **دسترسی به یاتاقان جلو و کوپلینگ:** IN-520 و IN-510 باز می‌شوند (فلنج سقف و فلنج‌های درز). کوپلینگ و بالای FB-1 در تونل باز دیده می‌شوند. بعد IN-501 و FB-1 بالا می‌روند. روتور برای این کار جابه‌جا نمی‌شود.
- برای بیرون آوردن روتور: نیمه‌های بالای plenum، بدنهٔ ورودی، FB و بدنه‌های دیگر (ترتیب بخش ۱۹٫۳).

### ۲۰٫۹ رابط‌ها و اثر روی بخش‌های دیگر

1. **FB-1 / FB-2 (جلسهٔ بخش ۱۹):** دیوارهٔ هاب x 143–157 است. **هیچ چیز FB در r > 130 عقب‌تر از x 141 نیست**، جز سطح دماغه.
   - در نسخهٔ اول FB، گوشوارهٔ عقب (تا x 160) وارد جریان خم می‌شد. لبه‌های درز، بوس هواکش، بوس هوای بافر و بوس و پد تخلیه هم با دیوارهٔ هاب یا کانال شعاعی تداخل داشتند.
   - جلسهٔ بخش ۱۹ همه را جلو برد (commit a709525). پایه‌ها شیار M16 در جهت y و جای خار عرضی دارند. FB-2 یک جای خار وسط پایین دارد.
   - جلسهٔ بخش ۱۹ فایل STEP خراب FB-2 را اصلاح کرد (commit b697b4f). تداخل CAD با FB-1 و FB-2 حالا صفر است.
2. **لوله‌های FB:** از تونل خشک جلو می‌روند و در x −140 تا −240 بیرون می‌آیند (بخش ۲۰٫۳).
   - شاخه‌های DN40 تخلیهٔ PL-05 در x 83–88 حدود ۱ mm داخل لبهٔ حلقهٔ فلنج تونل IN-511 (r 250) بودند (۵ mm³).
   - قطر داخلی حلقهٔ فلنج جعبه به r 253 رسید. حالا ۳ mm فاصله هست. حلقهٔ بدنهٔ ورودی همان r 250 می‌ماند.
   - تداخل لوله‌ها با قطعه‌های ورودی: صفر.
3. **بدنهٔ کمپرسور (فاز ۷):**
   - سطح جلو x 222 برای r ≥ 150، با برآمدگی spigot r 137٫5–150 در x 214–222. shroud القاگر از x 214، هم‌سطح انتهای دهانه (پلهٔ پایین‌دست، نه رو به جریان).
   - ۲۴ پیچ M12 روی r 440 از پشت.
   - جاگیر فعلی بدنهٔ کمپرسور از x 165 شروع می‌شود و با بدنهٔ ورودی و plenum تداخل دارد (~۱٫۰ میلیون mm³). در فاز ۷ حذف می‌شود.
4. **فضای اطراف:** لولهٔ DN350 هوای سرد (y 760، z −360) → plenum تا y ±540. ماژول روغن (x ≤ −150) → plenum از x −146، فلنج درز جلو تا |y| ≤ 440. گیربکس (x ≤ −240) → ۱۰۰ mm جا برای خروج لوله‌ها از تونل.
5. **خانهٔ فیلتر (فروشنده):** فلنج ۱۰۸۰ × ۳۴۴ mm روی z 612. فیلتر، کویل، قطره‌گیر و صداخفه‌کن طبق جدول ۲۰٫۶.
6. **آب:** هوای ۱۵ °C با رطوبت ۹۰٪ و قطره‌های کویل. تخلیهٔ پایین IN-511 به ظرف تخلیه. دمای استاتیک چشم ۸ °C است، پس یخ نمی‌زند.

### ۲۰٫۱۰ چک‌ها

- تعداد پایه در برابر ارتعاش پروانهٔ ۱: قبول (جدول ۲۰٫۳).
- سختی تکیه‌گاه FB: ۲۰ برابر ISFD. قبول (≥ ۱۰).
- تنش پایه‌ها: ۳٫۰ MPa برشی. قبول.
- مطالعهٔ مش: GCI مش ریز ۱۰٫۳٪.
- تداخل CAD بین قطعه‌های ورودی: ۰. با روتور، FB-1، FB-2، پروانه‌ها، لولهٔ DN350 و لوله‌های بخش ۱۹: ۰ (بعد از commit b697b4f و حلقهٔ r 253). تنها تداخل: جاگیر بدنهٔ کمپرسور (فاز ۷).

### ۲۰٫۱۱ باز

1. **خم تند (مهم‌ترین):**
   - با روتور فعلی چیزی در بخش ثابت آن را درست نمی‌کند. حلقهٔ هادی (C) و تیغهٔ پایین (B) امتحان شدند و بدتر بودند.
   - **گزینهٔ ۱ (پیشنهاد):** JB1، کف‌گرد و کوپلینگ ۲۵ mm جلوتر (شفت جلو ۲۵ mm بلندتر بین کف‌گرد و پروانه). افت در مش درشت ۵۵٪ کمتر (+۳ تا +۵ kW)، زاویهٔ نوک ۲۵°. دهانهٔ بزرگ‌تر (R35) و دماغهٔ کشیده‌تر. باید دینامیک روتور، FB و جای گیربکس دوباره دیده شوند.
   - **گزینهٔ ۲:** لبهٔ حملهٔ نوک القاگر ~۱۰ mm عقب‌تر (sweep). جا برای گوشهٔ R20 باز می‌شود. با فاز ۶.
   - در هر حال: CFD پله با پروانهٔ ۱ و این ورودی (فاز ۶)، برای اثر واقعی جدایش نوک روی بازده و surge.
2. **افت فروشنده:** عدد خانهٔ فیلتر، کویل و صداخفه‌کن از فروشنده.
3. ~~**FB-2:** فایل STEP نامعتبر است (چک بولی). بعد از اصلاح، چک تداخل دوباره اجرا شود.~~ **اصلاح شد** (b697b4f). چک دوباره اجرا شد و تداخل صفر است.
4. **فاز ۷ و ۸:** پیچ‌های درز بدنهٔ ورودی (M12 و M10)، ۲۴ × M12 به بدنهٔ کمپرسور، ۲۴ × M10 جعبه، خارهای عرضی پایه‌ها، و نگه‌دارندهٔ خار وسط پایین FB-2 روی IN-502 (بخش ۲۰٫۳).
5. **فیلت ریشهٔ پایه‌ها** (R5) برای کم کردن گردابه‌های نعل‌اسبی کنار هاب (۸ لکهٔ افت در چشم، دو تا پشت هر پایه).
6. **پکیج فیوژن** دوباره ساخته نشد. `pkg.json` به‌روز است.

## ۲۱. FEA سه‌بعدی اتصال‌های روتور و حلقه‌های ISFD (فاز ۴، ۲۰۲۶-۱۰-۳۱)

مدل و محاسبه: `sim/engine/a1000_joint_fea.py` (CalculiX 2.17 روی سرور ابری) · نتایج: `sim/engine/fea/a1000_joint_fea.json` · هندسه: `cad/engine/a1000_rotor.py` · چک‌ها در بخش ۹ فهرست `a1000_rotor_stack.py`

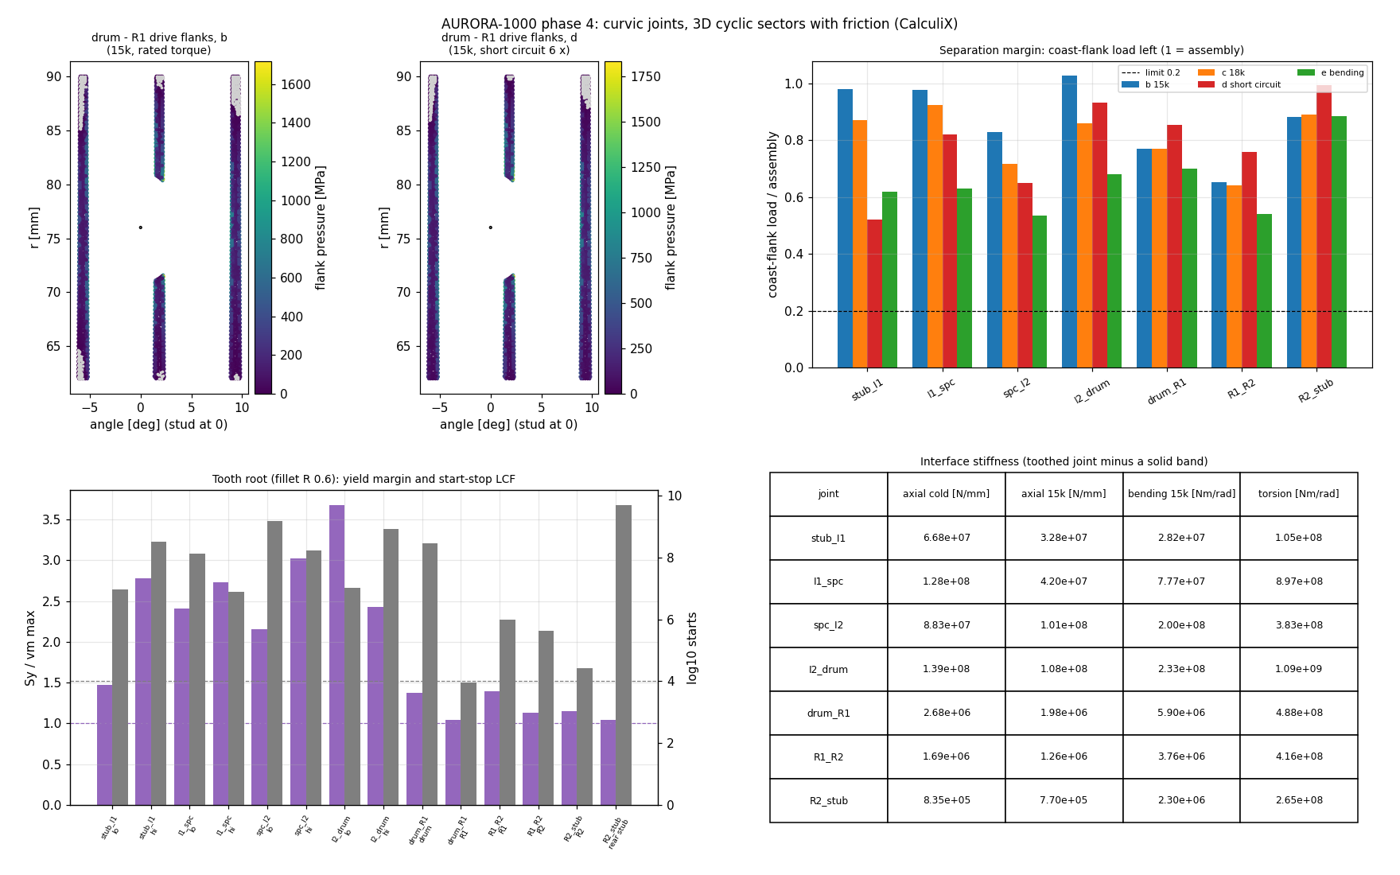
[picture p25: docs/img/a1000_joint_fea.png]
اتصال‌های Curvic: فشار پهلو، حاشیهٔ جدایش، تنش ریشه و سختی


- **سؤال:** اتصال‌های Curvic، فلنج‌های پیچی توربین و فنرهای ISFD با FEA سه‌بعدی قبول‌اند؟ سختی اتصال‌ها چقدر است؟
- **پاسخ کوتاه:**
  - **به‌روزرسانی ۲۰۲۶-۱۱-۰۱ (بخش ۲۱٫۱۱):** بازوها و فلنج‌های دیسک‌های ریختگی دوباره طراحی شدند و RT-107 حذف شد. R1–R2 و R2–شفت عقب حالا قبول‌اند (۱۰۹ از ۱۱۰ چک). drum–R1 با ۹٬۰۸۶ کمی کم است. گیرهٔ گذرای R1–R2 و LCF لبه و سکو هنوز بازند. بندهای زیر نتیجهٔ rev 6 است.
  - **ISFD رسم‌شده رد شد.** سختی آن ۱٫۳۶×۱۰⁹ N/m بود، یعنی ۴۳ برابر مقدار دینامیک روتور. فاصلهٔ فیلم دمپر هم نداشت. حالا **۴ فنر سنجاق‌سری و ۴ پد دمپر** دارد و سختی‌اش ۳٫۱۲×۱۰⁷ N/m است، در همان فضا (بخش ۲۱٫۶).
  - **Curvic شفت جلو–پروانهٔ ۱ رد شد.** باند r 44–58 روی لبهٔ مخروطی نازک نوک شفت می‌نشست. تماس به شعاع داخلی می‌رفت، تنش ریشه ۱٬۱۲۰ MPa و عمر ۳٬۱۰۰ راه‌اندازی بود. باند به **r 35–47** آمد و حالا قبول است.
  - **چهار Curvic کمپرسور** با هندسهٔ نهایی قبول‌اند. کمترین سهم بار باقی‌مانده روی پهلوی بی‌بار ۰٫۵۲ است (حد ۰٫۲).
  - **drum–R1 و R2–شفت عقب** از نظر جدایش، استاد و سختی قبول‌اند. ولی **عمر LCF ریشهٔ دندانهٔ فلنج‌های ریختگی MAR-M247** ۹٬۰۷۰ و ۷٬۴۰۰ راه‌اندازی است (حد ۱۰⁴). شعاع ریشهٔ بزرگ‌تر این را حل نمی‌کند (بخش ۲۱٫۳).
  - **R1–R2 در دمای واقعی محفظهٔ بین دو دیسک (~۷۱۰ °C، بخش ۲۲) رد می‌شود.** تماس به ۲۴ تا ۴۸٪ پهلو جمع می‌شود، تنش ریشه ۱٬۵۶۰ تا ۱٬۷۸۰ MPa است و عمر ۱٬۴۰۰ تا ۹٬۰۰۰ راه‌اندازی. این دو مورد آخر تغییر کوچک هندسه نیستند و به تصمیم بخش ۲۱٫۱۰ نیاز دارند.
  - سختی محوری سطح دندانه‌ها در کمپرسور ۳×۱۰⁷ تا ۱٫۴×۱۰⁸ N/mm است، یعنی ۲ تا ۷ برابر فرض قبلی (۲×۱۰⁷). در توربین ۷×۱۰⁶ تا ۳٫۵×۱۰⁷ N/mm است. با نرمی خمشی همهٔ اتصال‌ها، مود خمشی روتور از ۲۱٬۴۴۰ به **۲۰٬۵۵۰ rpm** می‌آید. حاشیه ۳۰٫۵٪ است (لازم ۱۸٫۴٪).

### ۲۱٫۱ مدل اتصال‌های Curvic

**هندسه:**
- قطاع چرخه‌ای سه‌بعدی با المان C3D10.
  - کمپرسور: یک گام دندانه (۱۰°، ۳۶ دندانه).
  - توربین: ۳ دندانه و ۱ استاد (۲۲٫۵°، ۴۸ دندانه، ۱۶ استاد).
- از هر طرف یک تکه از قطعه مدل شد:
  - کمپرسور: ۲۴ mm هاب. شفت جلو با پروفیل واقعی (لولهٔ r 23–48 و لبهٔ مخروطی تا r 60).
  - توربین: فلنج و بازوی ریختگی تا سطح هاب دیسک، درام تا گردن r 50–60، شفت عقب، و حلقهٔ RT-107 کامل (هر دو وجه Curvic در یک مدل).
- **دندانه:** پهلوی تخت با زاویهٔ ۳۰° به محور. ارتفاع کل h از CAD (۲٫۴ تا ۳٫۲ mm). ضخامت در صفحهٔ گام نصف گام. لقی ریشه ۰٫۳ mm، **فیلت ریشه R0.6**، پخ نوک ۰٫۱۵ mm.
- دندانه‌های CAD فقط نمادین‌اند: نوکشان روی کف طرف مقابل است و پهلوها به هم نمی‌رسند. نقشه باید فرم واقعی Curvic گلیسون را بدهد.
- هندسه در فضای «بازشده» (x، r، s = r θ) ساخته شد. در این فضا صفحهٔ پهلو و مرز قطاع هر دو صفحهٔ تخت‌اند. بعد هر گره به فضای واقعی برده شد. پس دو پهلوی جفت دقیقاً روی هم‌اند و تماس از اول بسته است.
- **استاد:** استوانهٔ هم‌سطح تنش M10 (Ø8.8). در سمت رزوه ۰٫۴ d درون فلنج جوش‌خورده است (مدل رزوه). مهره با معادله به سطح پشت فلنج بسته است. پیش‌بار با یک مقطع برش در وسط استاد (گره‌های دوتایی و معادله) اعمال و بعد قفل می‌شود.

**تماس و مرز:**
- تماس سطح‌به‌سطح با اصطکاک ۰٫۲ (پهلوی سنگ‌خورده، خشک). penalty ۲×۱۰⁶ N/mm³.
- مرزهای قطاع با معادلهٔ استوانه‌ای به هم بسته‌اند (مش متناوب).
- یک طرف در x و θ ثابت است. طرف دیگر نیروی گیره، نیروی محوری و گشتاور را می‌گیرد.
- **رشد شعاعی هر قطعه:**
  - دیسک‌ها: روی سطح برش، از FEA محوری دیسک با بازوها (بخش ۱۳٫۱).
  - بقیه: از دیسک چرخان.
  - پروانه‌ها: رشد کل پروانه به‌صورت انبساط مصنوعی در صفحه به کل تکهٔ هاب داده شد. اعمال آن فقط روی سطح برش، تکهٔ کوتاه هاب را مخروطی می‌کرد و تماس را به لبهٔ بیرونی دندانه می‌برد. این خطای مدل اول بود.

**مراحل بار (هر مدل یک مسیر، با اصطکاک):**

| حالت | شرح |
|---|---|
| a | مونتاژ سرد: گیرهٔ پیچ مرکزی ۱۸۵ kN، یا ۱۶ استاد × ۲۷ kN (R1–R2: Waspaloy × ۲۰ kN؛ تنش استاد به ۲۴ kN بخش ۲۲ مقیاس شد) |
| — | گام‌های کوچک برای سختی: کشش محوری اضافه (۱۰٪ گیرهٔ مونتاژ) و گشتاور کوچک، سرد و در ۱۵k |
| b | ۱۵٬۰۰۰ rpm، دمای طراحی، گشتاور نامی، نیروی محوری روتور؛ گیرهٔ پیچ مرکزی ۱۵۱ kN منهای سهم نیروی محوری |
| c | ۱۸٬۰۰۰ rpm (۱۲۰٪)؛ گیرهٔ پیچ مرکزی ۱۳۵ kN |
| d | ۱۵k و اتصال کوتاه ژنراتور: ۶ برابر گشتاور نامی کوپلینگ، بین اتصال‌ها به نسبت لختی |
| e | ۱۵k و خمش: عبور از بحرانی ۱ و ۲ با مدار دمپر برابر لقی آن (حد فیزیکی، دمپر می‌نشیند) + ۳ g؛ به‌صورت کشش معادل روی پرباربترین دندانه (M r_o A / I) |

- **دما:** دمای فلز در محل اتصال.
  - کمپرسور: ۶۰ تا ۲۳۰ °C، هر قطعه دمای خودش.
  - drum–R1: ۴۸۰ °C. فاز ۵ ~۳۹۰ °C داده است، پس این عدد محافظه‌کارانه است.
  - R1–R2: ۷۳۰ °C (فاز ۵: ۷۱۱ °C).
  - R2–شفت عقب: ۴۸۵ °C.
- ممان حالت e:

| اتصال | ممان دینامیکی [N·m] | ۳ g [N·m] | جمع |
|---|---|---|---|
| stub_I1 | ۷۵۴ | ۲۱۸ | ۹۷۲ |
| I1_spc | ۱٬۲۸۵ | ۴۰۰ | ۱٬۶۸۵ |
| spc_I2 | ۱٬۲۲۲ | ۴۵۱ | ۱٬۶۷۳ |
| I2_drum | ۱٬۲۳۱ | ۵۵۳ | ۱٬۷۸۵ |
| drum_R1 | ۱٬۱۳۳ | ۵۶۷ | ۱٬۷۰۰ |
| R1–R2 (دو وجه) | ۷۴۹ / ۷۱۸ | ۴۸۶ / ۴۴۷ | ۱٬۲۳۵ / ۱٬۱۶۵ |
| R2_stub | ۴۰۳ | ۱۹۱ | ۵۹۴ |

- **کمپرسور:** حالت e مستقیم با ممان واقعی حل شد.
- **توربین:** در اجراهای توربین ممان صفر وارد شده بود، چون فایل ممان هنوز روی سرور نبود. پس e از برهم‌نهی ساخته شد: e = b + (F_bend / ΔF)(b_ΔF − b). گام b_ΔF همان ۱۵k با کشش محوری اضافهٔ ΔF است و حل شده است. برای توربین این تقریباً درون‌یابی است (F_bend ≤ ۱٫۱۹ ΔF).
- آزمون در کمپرسور: با ۳٫۳ برابر برون‌یابی، برهم‌نهی افت پهلوی بی‌بار را ۱٫۷ برابر کمتر از حل مستقیم داد (۰٫۶۵ در برابر ۰٫۵۳ در spc_I2). برای همین کمپرسور مستقیم حل شد.

### ۲۱٫۲ تماس پهلوها و حاشیهٔ جدایش

- **حاشیهٔ جدایش** = بار پهلوی بی‌بار (coast) در هر حالت، تقسیم بر همان در مونتاژ. صفر یعنی دندانه از یک طرف جدا شده و مرکزیت از دست می‌رود. حد ۰٫۲.
- در اتصال‌های داغ، b افت پیش‌بار استاد در دمای کار را هم دارد.

| اتصال | فشار متوسط پهلو [MPa] (b / d) | p95 / p99 [MPa] | سهم لغزش در b | بار پهلوی بی‌بار باقی‌مانده: b / c / d / e | بدترین |
|---|---|---|---|---|---|
| stub_I1 | ۲۱۹ / ۲۰۳ | ۹۰۸ / ۱٬۴۳۷ | ۱۰۰٪ | ۰٫۹۸ / ۰٫۸۷ / ۰٫۵۲ / ۰٫۶۲ | **۰٫۵۲** |
| I1_spc | ۱۰۹ / ۱۱۶ | ۶۳۱ / ۹۰۷ | ۱۰۰٪ | ۰٫۹۸ / ۰٫۹۳ / ۰٫۸۲ / ۰٫۶۳ | **۰٫۶۳** |
| spc_I2 | ۱۱۷ / ۱۳۸ | ۷۷۵ / ۱٬۱۰۱ | ۱۰۰٪ | ۰٫۸۳ / ۰٫۷۲ / ۰٫۶۵ / ۰٫۵۳ | **۰٫۵۳** |
| I2_drum | ۱۰۸ / ۱۱۴ | ۸۱۸ / ۱٬۰۹۳ | ۱۰۰٪ | ۱٫۰۳ / ۰٫۸۶ / ۰٫۹۳ / ۰٫۶۸ | **۰٫۶۸** |
| drum_R1 | ۱۵۲ / ۱۷۵ | ۸۸۷ / ۱٬۱۸۲ | ۱۰۰٪ | ۰٫۷۲ / ۰٫۶۸ / ۰٫۷۹ / ۰٫۶۴ | **۰٫۶۴** |
| R1_R2 (وجه R1) | ۳۶۲ / ۳۶۸ | ۱٬۹۱۲ / ۳٬۲۶۵ | ۱۰۰٪ | ۱٫۲۱ / ۱٫۱۱ / ۱٫۲۳ / ۱٫۱۲ | ۱٫۱۱ |
| R1_R2 (وجه R2) | **۶۲۹** / ۶۲۳ | **۲٬۸۱۵** / ۴٬۰۹۳ | ۱۰۰٪ | ۱٫۰۲ / ۰٫۹۵ / ۱٫۰۲ / ۰٫۹۴ | ۰٫۹۴ |
| R2_stub | ۱۶۷ / ۱۸۷ | ۸۸۴ / ۱٬۳۳۵ | ۹۹٪ | ۰٫۸۷ / ۰٫۸۲ / ۰٫۹۸ / ۰٫۸۴ | **۰٫۸۲** |

- **فشار متوسط** در همهٔ اتصال‌ها جز R1–R2 زیر ۰٫۶ Sy است.
- **فشار لبه:** پهلوی تخت مدل در لبه‌های بالا و پایین ناحیهٔ تماس پیک دارد. p99 تا ۱٬۴۰۰ MPa است (R1–R2: ۴٬۰۹۰). این اثر هندسهٔ کامل بدون تاج است. Curvic سنگ‌خورده با جفت مقعر/محدب تماس وسط پهلو می‌دهد. نقشه باید تاج یا آزادسازی لبه بدهد. چک روی p95 است (≤ ۱٫۶ Sy).
- **لغزش:** در ۱۵k تقریباً همهٔ پهلوها لغزش شعاعی دارند. دلیل، رشد شعاعی متفاوت دو طرف است. مثلاً پروانهٔ ۲ و spacer: ۱۷۲ در برابر ۸۱ µm. دندانهٔ شعاعی برای همین ساخته شده است.
  - لغزش در هر راه‌اندازی تا ۱۰۲ µm است (spc_I2). در ۱۰⁴ راه‌اندازی، با پوشش پهلو، سایش چند µm است.
  - لغزش چرخه‌ای در هر دور (خمش ثقلی ۱ g، از گام باربرداری): صدک ۹۹ زیر ۰٫۱ µm است، جز موارد زیر:
    - I2_drum: ۷٫۵ µm در یک ناحیه. **پوشش ضد fretting روی پهلوهای تیتانیومی لازم است** (CuNiIn + MoS₂، حد ۲۵ µm).
    - drum–R1: ۱٫۴ µm.
    - R1–R2: ۱۱٫۸ µm.
- **مرکزیت:** spigot نداریم و دندانه‌های شعاعی مرکز می‌کنند. در همهٔ حالت‌ها هر دو پهلوی هر دندانه تماس دارند. کمترین سهم یک دندانه ۰٫۵۲ است. پس مرکزیت می‌ماند.

**Curvic شفت جلو–پروانهٔ ۱ (تغییر):**

| | باند r 44–58 (قبلی) | باند r 35–47 (جدید، مش متوسط) |
|---|---|---|
| توزیع فشار در مونتاژ | ۴۲۰ MPa در r 44 تا ۲۲۰ در r 58 | تقریباً یکنواخت |
| فشار متوسط پهلو در ۱۵k | ۳۶۵ MPa | ۲۱۹ MPa |
| تنش ریشهٔ شفت (vm، داخل دندانه) | ۱٬۱۲۰ MPa، حاشیه ۰٫۶۱ | ۴۶۴ MPa، حاشیه ۱٫۴۸ |
| LCF ریشهٔ شفت | ۳٬۱۰۰ راه‌اندازی | ۹٫۰×۱۰⁶ |
| کمترین سهم پهلوی بی‌بار | — | ۰٫۵۲ (اتصال کوتاه) |

### ۲۱٫۳ تنش ریشهٔ دندانه

- ارزیابی روی سطح فیلت، ۱ mm دورتر از لبه‌های تیز مدل (دو سر باند و لبهٔ سوراخ استاد). پیک روی این لبه‌ها تکین است. در نقشه این لبه‌ها R0.5 می‌گیرند.
- معیارها:
  - حالت‌های a، b و e با Sy مقایسه شدند.
  - حالت‌های یک‌باره (c اضافه‌دور و d اتصال کوتاه) با UTS مقایسه شدند، چون تسلیم موضعی در آن‌ها مجاز است.
  - LCF: Manson با تصحیح میانگین Morrow، ضریب ۲ روی کرنش و ۲۰ روی عمر، مثل بقیهٔ سند. دامنه a ← b برای هر راه‌اندازی است، و a ← d برای اتصال کوتاه (حد ۱۰۰ بار).

| قطعه | ماده، دما | تنش ریشه b (vm) | حاشیهٔ تسلیم (a، b، e) | c / d: vm و حاشیه تا UTS | LCF راه‌اندازی | LCF اتصال کوتاه |
|---|---|---|---|---|---|---|
| stub_I1 شفت | 34CrNiMo6، ۶۰ °C | ۴۶۴ MPa | ۱٫۴۸ | ۶۲۴ MPa، ۱٫۴۲ | ۹٫۰×۱۰⁶ | ۸٫۱×۱۰⁵ |
| stub_I1 پروانه | Ti64، ۷۵ °C | ۲۷۶ MPa | ۲٫۷۸ | ۳۷۰ MPa، ۲٫۲۹ | ۳٫۳×۱۰⁸ | ۲٫۴×۱۰⁴ |
| I1_spc پروانه | Ti64، ۷۵ °C | ۳۱۹ MPa | ۲٫۴۱ | ۲۷۹ MPa، ۳٫۰۴ | ۱٫۳×۱۰⁸ | ۳٫۲×۱۰⁶ |
| I1_spc spacer | 17-4PH، ۱۲۰ °C | ۳۴۷ MPa | ۲٫۷۳ | ۳۸۴ MPa، ۲٫۶۴ | ۷٫۹×۱۰⁶ | ۱٫۸×۱۰⁸ |
| spc_I2 spacer | 17-4PH، ۱۲۰ °C | ۴۴۰ MPa | ۲٫۱۵ | ۵۹۲ MPa، ۱٫۷۲ | ۱٫۵×۱۰⁹ | ۲٫۳×۱۰⁸ |
| spc_I2 پروانه | Ti64، ۱۶۰ °C | ۱۴۵ MPa | ۳٫۰۲ | ۲۶۷ MPa، ۲٫۸۸ | ۱٫۷×۱۰⁸ | ۲٫۱×۱۰⁵ |
| I2_drum پروانه | Ti64، ۱۶۰ °C | ۱۸۵ MPa | ۳٫۶۸ | ۲۲۱ MPa، ۳٫۴۸ | ۱٫۰×۱۰⁷ | ۱٫۰×۱۰⁶ |
| I2_drum درام | IN718، ۲۳۰ °C | ۴۱۲ MPa | ۲٫۴۳ | ۴۸۳ MPa، ۲٫۴۶ | ۸٫۵×۱۰⁸ | ۲٫۷×۱۰⁸ |
| drum_R1 درام | IN718، ۴۸۰ °C | ۵۹۲ MPa | ۱٫۴۵ | ۶۰۸ MPa، ۱٫۸۶ | ۹٫۸×۱۰⁶ | ۷٫۶×۱۰⁵ |
| **drum_R1 فلنج R1** | MAR-M247، ۴۸۰ °C | ۷۰۳ MPa | ۱٫۱۱ | ۸۱۹ MPa، ۱٫۲۱ | **۹٫۱×۱۰³** | ۲٫۵×۱۰³ |
| **R1_R2 فلنج R1** | MAR-M247، ۷۳۰ °C | ۱٬۵۶۳ MPa | **۰٫۴۸** | ۱٬۶۳۴ MPa، ۰٫۵۷ | **۱٫۹×۱۰³** | ۱٫۳×۱۰³ |
| **R1_R2 حلقه** | Waspaloy، ۷۳۰ °C | ۱٬۷۷۵ MPa | **۰٫۳۷** | ۱٬۸۱۲ MPa، ۰٫۵۶ | **۹٫۰×۱۰³** | ۸٫۰×۱۰³ |
| **R1_R2 فلنج R2** | MAR-M247، ۷۳۰ °C | ۱٬۶۲۸ MPa | **۰٫۴۶** | ۱٬۶۳۸ MPa، ۰٫۵۷ | **۱٫۴×۱۰³** | ۱٫۲×۱۰³ |
| **R2_stub فلنج R2** | MAR-M247، ۴۸۵ °C | ۵۷۳ MPa | ۱٫۳۶ | ۶۷۷ MPa، ۱٫۴۶ | **۷٫۴×۱۰³** | ۶٫۶×۱۰³ |
| R2_stub شفت عقب | IN718، ۴۸۵ °C | ۶۹۱ MPa | ۱٫۱۷ | ۶۹۶ MPa، ۱٫۶۳ | ۵٫۸×۱۰⁹ | ۴٫۳×۱۰⁸ |

- **مطالعهٔ شعاع ریشه (drum–R1، R1.0 در برابر R0.6، همان مش و بار):**
  - IN718: دامنه ×۰٫۸۶ و vm ×۰٫۵۹.
  - MAR-M247: دامنه فقط ×۰٫۹۴ است و پیک در ۱۵k ×۱٫۰۶ می‌شود.
  - پس در فلنج‌های ریختگی، تنش ریشه از فیلت نیست. از مخروطی شدن فلنج روی بازوی کوتاه (r 58–66، ۱۳ mm) و کشش محیطی آن است.
  - شعاع ریشه این عمر را درست نمی‌کند.
- **LCF ریشهٔ فلنج‌های MAR-M247** (۷٬۴۰۰ و ۹٬۰۷۰ راه‌اندازی) در همان حد عمر ریشهٔ بازو (بخش ۱۳٫۱: ۱٫۶×۱۰⁴) و عمر گذرای ریشهٔ بازو در بخش ۲۲ (۱٬۵۰۰ تا ۲٬۸۰۰) است. همه از یک ناحیه‌اند: بازو و فلنج ریختگی.

### ۲۱٫۴ فلنج‌های پیچی توربین: استادها، باز شدن فلنج، مرکزیت

| | drum–R1 (IN718، ۴۸۰ °C) | R2–شفت عقب (IN718، ۴۸۵ °C) | R1–R2 (Waspaloy، ۷۳۰ °C، به ۲۴ kN مقیاس شد) |
|---|---|---|---|
| نیروی استاد: مونتاژ / ۱۵k / ۱۸k | ۲۷٫۱ / ۲۰٫۶ / ۱۹٫۶ kN | ۲۷٫۱ / ۲۱٫۴ / ۲۰٫۵ kN | ۲۴٫۳ / ۲۴٫۱ / ۲۳٫۱ kN |
| تنش متوسط در ۱۵k | ۳۳۷ MPa | ۳۵۰ MPa | ۳۹۴ MPa |
| خمش استاد (بیشینه روی متوسط) | ۸۰ MPa (کنار مهره) | ۸۱ MPa | **۲۹۶ تا ۳۶۷ MPa** |
| پیک (متوسط + خمش) / ۰٫۹ Sy | ۵۶۰ MPa در مونتاژ، ۰٫۶۵ | ۵۵۳ MPa، ۰٫۶۴ | **۷۵۶ MPa، ۱٫۲۶** |
| تنش متوسط / (گسیختگی ۱۰⁵ h ÷ ۱٫۵) | ۰٫۶۹ | ۰٫۷۰ | بخش ۲۲ (آسودگی تنش و سفت کردن دوباره) |
| کمترین سهم پهلوی بی‌بار (کل / یک دندانه) | ۰٫۶۴ / ۰٫۵۹ | ۰٫۸۲ / ۰٫۷۳ | ۰٫۹۴ / ۰٫۷۱ |
| لغزش شعاعی در هر راه‌اندازی (صدک ۹۹) | ۱۲ µm | ۹ µm | ۹۲ µm |

- **افت پیش‌بار در کار:** استاد IN718 بیشتر از فلنج MAR-M247 منبسط می‌شود. در drum–R1 در ۴۸۰ °C نیروی استاد از ۲۷ به ۲۰٫۶ kN می‌رسد، یعنی ۲۴٪. محاسبهٔ سادهٔ بخش ۱۳٫۹ فقط ۱٫۴ kN افت می‌داد. ولی گیرهٔ باقی‌مانده هنوز بیش از ۵ برابر لازم است. فاز ۵ این سختی‌ها را به کار برده است.
- **باز شدن فلنج:** در هیچ حالتی تماس دندانه‌ها باز نمی‌شود. کمترین سهم پهلوی بی‌بار ۰٫۶۴ است.
- **spigot:** این اتصال‌ها spigot ندارند و Curvic مرکز می‌کند. لغزش شعاعی در هر راه‌اندازی کم است و دندانه‌ها درگیر می‌مانند.
- **خزش:** برای IN718 از Larson–Miller معمول (C = 20) استفاده شد. استحکام گسیختگی ۱۰⁵ ساعت در ۴۸۰ °C حدود ۹۸۰ MPa است (داده‌های معمول؛ داده‌های گواهی‌شدهٔ تأمین‌کننده جایگزین شوند).

### ۲۱٫۵ سختی اتصال‌ها (برای فاز ۵ و دینامیک روتور)

- سختی سطح تماس = مدل دندانه‌دار منهای همان مدل با باند توپر چسبیده. یعنی فقط نرمی دندانه‌ها و تماس. همهٔ اعداد برای کل حلقه‌اند. R1–R2 هر دو وجه را سری دارد.
- سختی خمشی = سختی محوری × (ri² + ro²) / 4. این برای توزیع خطی فشار روی حلقهٔ دندانه و دامنهٔ کوچک حول نقطهٔ کار است.

| اتصال | محوری سرد [N/mm] | محوری ۱۵k [N/mm] | خمشی ۱۵k [N·m/rad] | پیچشی [N·m/rad] |
|---|---|---|---|---|
| stub_I1 (r 35–47) | ۶٫۷×۱۰⁷ | ۳٫۳×۱۰⁷ | ۲٫۸×۱۰⁷ | ۱٫۱×۱۰⁸ |
| I1_spc | ۱٫۳×۱۰⁸ | ۴٫۲×۱۰⁷ | ۷٫۸×۱۰⁷ | ۹٫۰×۱۰⁸ |
| spc_I2 | ۸٫۸×۱۰⁷ | ۱٫۰×۱۰⁸ | ۲٫۰×۱۰⁸ | ۳٫۸×۱۰⁸ |
| I2_drum | ۱٫۴×۱۰⁸ | ۱٫۱×۱۰⁸ | ۲٫۳×۱۰⁸ | ۱٫۱×۱۰⁹ |
| drum_R1 | ۱٫۰×۱۰⁷ | ۶٫۷×۱۰⁶ | ۲٫۰×۱۰⁷ | ۷٫۴×۱۰⁸ |
| R1_R2 (دو وجه) | ۳٫۵×۱۰⁷ | ۱٫۸×۱۰⁷ | ۵٫۳×۱۰⁷ | ۶٫۳×۱۰⁸ |
| R2_stub | ۹٫۸×۱۰⁶ | ۱٫۳×۱۰⁷ | ۳٫۹×۱۰⁷ | ۷٫۶×۱۰⁸ |

- فرض قبلی پشتهٔ پیچ مرکزی (۰٫۵×۱۰⁻⁷ mm/N برای هر تماس، یعنی ۲×۱۰⁷ N/mm) برای کمپرسور ۲ تا ۷ برابر نرم‌تر از FE بود. فاز ۵ اعداد FE را به کار برده است (بخش ۲۲).
- اتصال‌های داغ نرم‌ترند، چون سوراخ استادها دندانه‌ها را قطع می‌کنند و فلنج‌ها نازک‌اند.
- **دینامیک روتور با این فنرها** (هر اتصال یک فنر خمشی ۲ mm در مدل تیر، تکیه‌گاه اسمی):

| | بحرانی ۱ | بحرانی ۲ | مود خمشی | حاشیه / لازم |
|---|---|---|---|---|
| اتصال‌های صلب | ۳٬۹۴۲ | ۸٬۹۲۱ | ۲۱٬۴۴۲ rpm | ۳۶٫۱٪ / ۱۹٫۵٪ |
| با فنر اتصال‌ها | ۳٬۹۰۱ | ۸٬۹۴۶ | **۲۰٬۵۵۰ rpm** | **۳۰٫۵٪ / ۱۸٫۴٪** |

### ۲۱٫۶ حلقه‌های ISFD یاتاقان‌های ۱ و ۲ (مدل دوبعدی، CPS6)

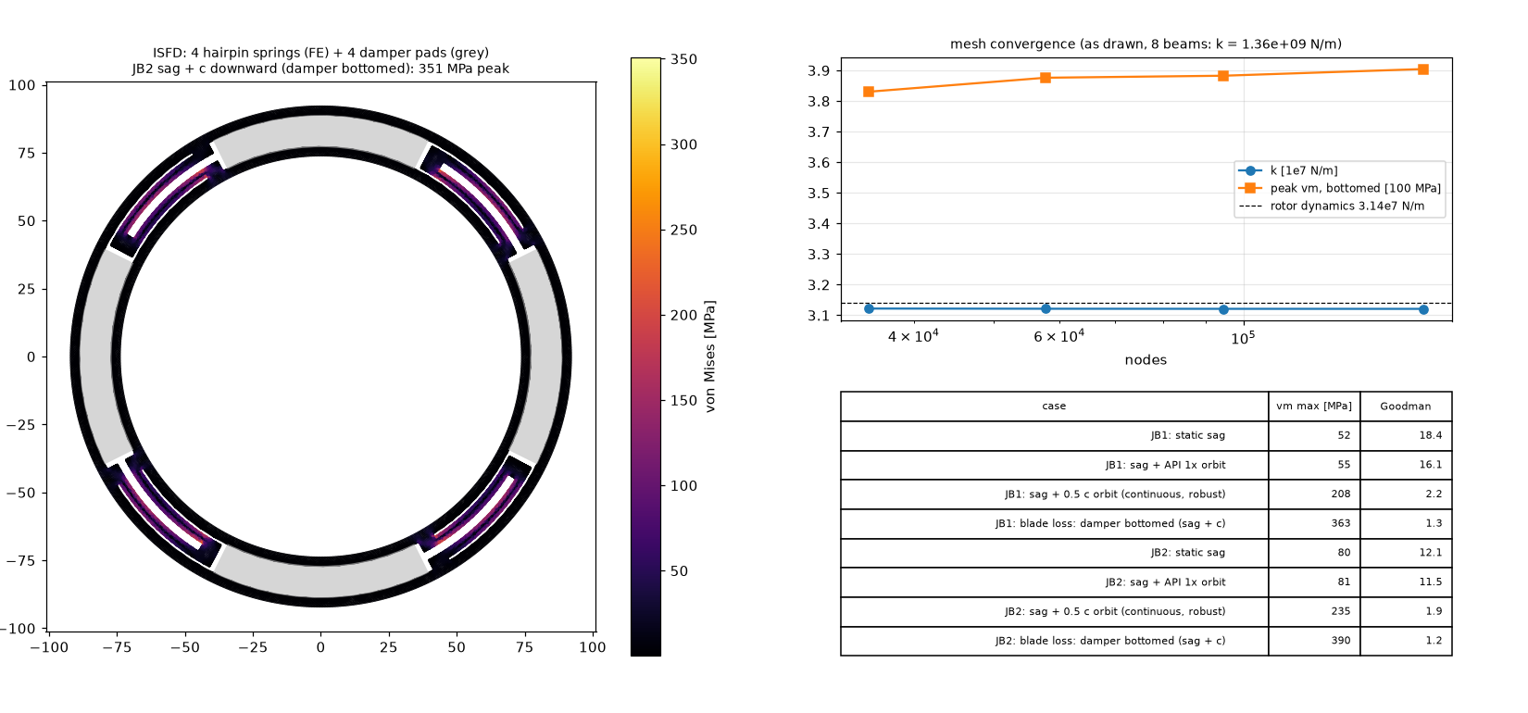
[picture p26: docs/img/a1000_isfd_fea.png]
ISFD با فنرهای سنجاق‌سری: تنش در حالت نشستن دمپر، همگرایی مش و حالت‌ها


**مدل:**
- مقطع حلقه در صفحهٔ عمود بر محور، تنش صفحه‌ای با ضخامت ۴۳ mm (طول حلقه). فنرها در طول محوری ثابت‌اند (وایرکات).
- قطر داخلی حلقهٔ داخلی صلب جابه‌جا می‌شود (نگه‌دارندهٔ پد سفت است). قطر بیرونی ثابت است (نشیمن در محفظه).
- فیلت ریشهٔ همهٔ گوشه‌های داخلی R0.8 (شعاع گوشهٔ وایرکات).
- ماده 17-4PH H1100: YS ۷۹۵، UTS ۹۶۵ MPa. حد خستگی طراحی ۳۰۰ MPa (۱۰⁷، R = −1؛ صاف ~۴۵۰ × ۰٫۷۵ سطح وایرکات با برش پرداخت × ۰٫۹ اندازه).

**یافتهٔ اصلی: حلقهٔ رسم‌شده ۴۳ برابر سفت‌تر است.**

| | حلقهٔ رسم‌شده (rev 1.3، بخش ۱۹) | مقدار دینامیک روتور |
|---|---|---|
| فنرها | ۸ تیر محیطی، t ۴٫۲، ۳۰°، اتصال کوتاه ۳° به هر حلقه | — |
| سختی شعاعی (FE) | **۱٫۳۶×۱۰⁹ N/m** | ۳٫۱۴×۱۰⁷ N/m (فرمول تیر) |
| تنش در نشستن دمپر | ۲٬۳۲۰ MPa | — |
| فاصلهٔ فیلم ۰٫۱۳ mm | **ندارد** (تیرها ۱٫۹ mm از هر دو حلقه فاصله دارند) | R80 × L35 × c0.13 |
| آب‌بند انتها | شیار رینگ پیستونی در حلقهٔ بیرونی؛ از فنرها رد نمی‌شود، پس چیزی را نمی‌بندد | — |

- **علت:** فرمول n/2 · E w t³/l³ فقط خمش تیر را می‌بیند. ولی وقتی حلقهٔ داخلی در جهت مماس بر یک فنر جابه‌جا می‌شود، آن تیر در طول خودش کشیده یا فشرده می‌شود. پس مثل میله کار می‌کند و خیلی سفت است.
- با این حلقه تکیه‌گاه عملاً صلب است. در بخش ۱۲٫۶ حالت «تکیه‌گاه صلب» دومین بحرانی را ۱۷٬۳۱۷ rpm داد، یعنی فقط ۱۰٪ بالای MCS. پس این حلقه قبول نیست.

**اصلاح (کمترین تغییر، همان فضای r 74–92 × ۴۳ mm، همان محفظه‌ها):**
- **۴ فنر سنجاق‌سری:** بازوی داخلی از یک پایه روی حلقهٔ داخلی شروع می‌شود، در انتهای ۳۴° برمی‌گردد (خم U) و بازوی بیرونی به پایه‌ای روی حلقهٔ بیرونی، در همان زاویهٔ شروع، می‌رسد. حالا بار شعاعی و بار مماسی هر دو بازوها را خم می‌کنند.
- بازو t ۲٫۵۶ mm، فاصلهٔ بازو تا حلقه ۱٫۶ mm، بین دو بازو ۳٫۷ mm. حلقه‌ها ۳ mm. مرکز فنرها در ۴۵، ۱۳۵، ۲۲۵ و ۳۱۵°.
- **۴ پد دمپر** روی حلقهٔ داخلی، بین فنرها (هر کدام ۵۳°، مرکز ۰، ۹۰، ۱۸۰ و ۲۷۰°). فیلم روی سوراخ حلقهٔ بیرونی است: **R89، L43، c0.13**. بار ثقل رو به وسط پد پایین است.
- انتهای پدها **باز** است. رینگ پیستونی لازم نیست. روغن از دو انتها به حفرهٔ یاتاقان می‌ریزد.
- درز افقی یاتاقان ۱ از وسط پدهای ۰ و ۱۸۰° می‌گذرد.
- لوله‌های انتقال روغن از وسط پدهای ۹۰ و ۲۷۰° رد می‌شوند. سوراخشان در حلقهٔ بیرونی Ø13 است تا پد بتواند c جابه‌جا شود.
- تغذیهٔ پدها: ۲ روزنهٔ Ø1.4 کنار درز. فشار سطح ۰٫۶ bar(g)، دبی ۲٫۱ l/min هر دمپر.
- جرم هر حلقه ۲٫۲۰ ← ۲٫۶۰ kg.

**نتیجه‌ها (FE ریزترین مش):**

| | JB1 | JB2 | معیار |
|---|---|---|---|
| سختی شعاعی | ۳٫۱۲×۱۰⁷ N/m (هر دو؛ ناهمسانی < ۰٫۰۰۱٪) | | ۳٫۱۴×۱۰⁷ ± ۱۰٪ |
| افتادگی استاتیک | ۲۵ µm | ۳۸ µm | — |
| تنش، افتادگی + مدار API (۱٫۰ / ۰٫۵ µm) | ۵۵ MPa، گودمن ۱۶٫۱ | ۸۱ MPa، گودمن ۱۱٫۵ | ≥ ۱٫۵ |
| تنش، افتادگی + مدار ۰٫۵ c پیوسته (محافظه‌کارانه) | ۲۰۸ MPa، گودمن ۲٫۱۹ | ۲۳۵ MPa، گودمن ۱٫۹۴ | ≥ ۱٫۵ |
| کندن پره: دمپر می‌نشیند (افتادگی + c) | ۳۶۳ MPa | ۳۹۰ MPa | ≤ ۰٫۹ YS = ۷۱۶ |
| میرایی (۴ پد، یاتاقان کوتاه) | فیلم کامل ۵٫۷×۱۰⁴، π-film ۲٫۹×۱۰⁴ N·s/m | | قبلاً ۴٫۷ / ۲٫۴×۱۰⁴ |

- **همگرایی مش:** از ۳۵ تا ۱۶۵ هزار گره، سختی ۰٫۰۳٪ و تنش بیشینه ۲٪ تغییر کرد.
- مدار API دمپر از مدل روتور (درجهٔ آزادی محفظه، ۹۵ تا ۱۱۰٪ دور) آمده است. این مدار خیلی کوچک‌تر از ارتعاش ژورنال است.
- در کندن پره، نیروی نامیزانی خیلی بیشتر از k·c است. پس دمپر می‌نشیند و جابه‌جایی فنر به افتادگی + c محدود می‌شود.

- **دینامیک روتور با ISFD جدید** (`a1000_rotor_stack.py`، اتصال‌های صلب): بحرانی‌ها ۳٬۹۴۲ / ۸٬۹۲۱ / ۲۱٬۴۴۲ rpm. حاشیهٔ مود خمشی ۳۶٫۱٪ است (لازم ۱۹٫۵٪) و پاسخ API ۳٫۹ µm. با π-film: ۲۰٬۶۹۰ rpm و ۳۱٫۴٪.
- **روغن‌کاری** (`a1000_lube_piping.py`): ۲۹ از ۲۹ قبول. روغن ماژول ۶۵ ← ۶۸ l/min. چک فیلم کامل حالا با مدار خود دمپر حساب می‌شود (۲ برابر پاسخ API در درجهٔ آزادی محفظه)، نه با ارتعاش ژورنال. فشار فشردگی ۰٫۳۹ bar است، در برابر ۰٫۶۰ bar سطح.

### ۲۱٫۷ همگرایی مش

| مدل | مش | گره | تنش اصلی ریشه در ۱۵k | فشار متوسط پهلو | سهم پهلوی بی‌بار در d |
|---|---|---|---|---|---|
| stub_I1 | درشت / متوسط | ۳۰٫۸ / ۶۳٫۶ هزار | ۲۶۴ / ۲۶۸ MPa (**۱٫۳٪**) | ۲۴۴ / ۲۱۹ MPa | ۰٫۴۷ / ۰٫۵۲ |
| drum_R1 | خیلی درشت / درشت | ۵۹ / ۱۱۵ هزار | ۷۶۲ / ۸۴۷ MPa (**۱۰٫۱٪**) | ۱۶۰ / ۱۵۲ MPa | ۰٫۸۱ / ۰٫۷۹ |
| ISFD (دوبعدی) | ۴ مش | ۳۵ تا ۱۶۵ هزار | سختی ۰٫۰۳٪، تنش بیشینه ۰٫۶٪ | — | — |

- کمپرسور همگراست. اعداد نهایی stub_I1 از مش متوسط‌اند و بقیهٔ کمپرسور از مش درشت. مش درشت vm بالاتری می‌دهد، پس محافظه‌کارانه است.
- **توربین همگرا نیست:** تنش ریشهٔ فلنج R1 در آخرین ریزسازی ۱۰٪ بالا رفت. پس عمر LCF فلنج‌های MAR-M247 در مش ریزتر از ۹٬۰۷۰ کمتر می‌شود. این نتیجهٔ بخش ۲۱٫۳ را بدتر می‌کند، نه بهتر.
- مدل‌های توربین به خاطر حافظه و زمان SPOOLES درشت‌اند. SPOOLES تنها حل‌کنندهٔ مستقیم این نسخهٔ CalculiX است و با اصطکاک نامتقارن کار می‌کند. هر تکرار نیوتن ۳ تا ۵ دقیقه و هر مدل ۲ تا ۵ ساعت طول کشید.

### ۲۱٫۸ تغییرات طراحی

| قطعه | قبل | بعد | دلیل |
|---|---|---|---|
| Curvic شفت جلو–پروانهٔ ۱ (`CURVIC_C['stub_I1']`) | r 44–58 | **r 35–47**، همان ۳۶ دندانه | دندانه‌های بیرونی روی لبهٔ نازک نوک شفت بودند (بخش ۲۱٫۲) |
| ISFD هر دو یاتاقان (`ISFD`, `SFD`, `ISFD_CLOCK`) | ۸ تیر محیطی t ۴٫۲، بدون فیلم | **۴ فنر سنجاق‌سری t ۲٫۵۶ + ۴ پد R89 × L43 × c0.13** | سختی ۴۳ برابر؛ فیلم نبود (بخش ۲۱٫۶) |
| تغذیهٔ ISFD (`a1000_lube_piping.py`) | رینگ پیستونی، ۰٫۶ l/min | پد باز، ۲ روزنهٔ Ø1.4، ۲٫۱ l/min، سطح ۰٫۶ bar(g) | — |
| پهلوهای Curvic تیتانیومی پروانه‌ها | — | پوشش CuNiIn + MoS₂ | لغزش چرخه‌ای I2_drum |

- STEP دوباره ساخته شد: `RT_101` (شفت جلو)، هاب پروانهٔ ۱ (`fusion/A1000C/A1000_C1_hub.step`)، دو حلقهٔ ISFD (نام جدید؛ دو فایل ۸ فنری حذف شدند). `parts.json` و `pkg.json` به‌روزند. بستهٔ فیوژن دوباره ساخته نشد (تصمیم با کاربر).
- محفظه‌ها (FB-1، FB-2، کارتریج JB2) عوض نشدند، چون ISFD همان r 74–92 × ۴۳ mm است.
- پیچ مرکزی با باند جدید: نیروی لازم stub_I1 از ۵۷ به ۷۱ kN رسید. بیشینهٔ لازم همچنان I2_drum با ۷۳ kN است. ضریب ۱٫۷۶ (حد ۱٫۲۵). فشار Curvic جلوی پروانهٔ ۱ ۰٫۷۲ حد است.
- **الزامات نقشه:**
  - فرم Curvic گلیسون با تاج یا آزادسازی لبه روی پهلو.
  - شعاع ریشه ≥ R0.6. لبه‌های انتهای دندانه‌ها و لبهٔ سوراخ استادها در باند دندانه R0.5.
  - پوشش ضدسایش روی پهلوهای تیتانیومی.
  - ISFD: وایرکات با برش پرداخت (لایهٔ ذوب‌شده برداشته شود)، فیلت R0.8 در همهٔ گوشه‌های داخلی، فاصلهٔ فیلم ۰٫۱۳ ± ۰٫۰۱ mm.

### ۲۱٫۹ چک‌ها: ۱۰۳ از ۱۲۰ قبول

| گروه | قبول | رد |
|---|---|---|
| Curvic کمپرسور (۴ اتصال: جدایش، تماس، فشار، لغزش، ریشه، LCF) | ۵۲ از ۵۲ | — |
| ISFD (سختی، همگرایی، کندن پره، گودمن، فیلم) | ۹ از ۹ | — |
| drum–R1 | ۱۵ از ۱۶ | LCF ریشهٔ فلنج R1: ۹٬۰۷۰ |
| R2–شفت عقب | ۱۵ از ۱۶ | LCF ریشهٔ فلنج R2: ۷٬۴۲۵ |
| R1–R2 | ۱۰ از ۲۴ | فشار پهلو، تسلیم و LCF ریشهٔ هر سه قطعه، خمش استاد، لغزش چرخه‌ای |
| همگرایی مش | ۱ از ۲ | drum_R1: ۱۰٫۱٪ |
| دینامیک روتور با فنر اتصال‌ها | ۱ از ۱ | — |

- **بعد از طراحی دوباره (بخش ۲۱٫۱۱): ۱۰۹ از ۱۱۰.** تنها رد: LCF ریشهٔ فلنج R1 در drum–R1 (۹٬۰۸۶). فهرست روتور: ۱۶۵ از ۱۷۴.
- این چک‌ها در بخش ۹ فهرست روتور (`a1000_rotor_stack.py`) هم هستند. کل فهرست روتور با چک‌های فاز ۵: ۱۶۵ از ۱۸۶. ۴ مورد دیگر LCF دیسک در بخش ۲۲ است.

### ۲۱٫۱۰ باز: تصمیم لازم و کارهای بعد

> بندهای ۱ تا ۳ با طراحی دوبارهٔ بخش ۲۱٫۱۱ جواب گرفتند. کارهای باقی‌مانده در انتهای بخش ۲۱٫۱۱ است.

1. **R1–R2 در ۷۱۰ °C (رد).**
   - علت: فلنج‌ها، حلقهٔ RT-107 و استادها در دمای محفظهٔ بین دو دیسک هستند، ولی روی هاب‌هایی نشسته‌اند که مثل دیسک ~۴۷۰ °C رشد می‌کنند. بازوی کوتاه (۱۳ mm) مخروطی می‌شود و تماس به لبهٔ پهلو جمع می‌شود.
   - مدل حرارتی فاز ۵ هم برای همین اتصال حاشیهٔ باز شدن منفی داده است.
   - مدل من بازو را هم در ۷۳۰ °C می‌گیرد و شیب دمای واقعی بازو را ندارد. پس عدد تنش احتمالاً بزرگ‌تر از واقعی است. ولی جهت نتیجه همین است.
   - **گزینه‌ها:** (الف) هوای purge بین دو دیسک، با TBC سکوی R1 که فاز ۵ اضافه کرد؛ (ب) طراحی دوبارهٔ اتصال R1–R2: بازوی بلندتر و نرم‌تر، یا اتصال در شعاع کمتر و سردتر؛ (ج) هر دو.
   - این با پیشنهاد طراحی دوبارهٔ دیسک در بخش ۲۲ (عمر ریشهٔ بازو) یکی است. باید با هم تصمیم گرفته شوند.
2. **LCF ریشهٔ دندانهٔ فلنج‌های ریختگی** (drum–R1: ۹٬۰۷۰، R2–شفت عقب: ۷٬۴۰۰، و در مش ریزتر کمتر).
   - شعاع ریشه کمک نمی‌کند. علت مخروطی شدن فلنج روی بازو است.
   - راه‌ها: فلنج ضخیم‌تر یا بازوی کوتاه‌تر و ضخیم‌تر (با طراحی دوبارهٔ دیسک)، یا حلقهٔ فلنج کارشده (IN718) جدا از ریخته‌گری.
   - هر دو تغییر الگوی ریخته‌گری‌اند. پس در همان تصمیم بند ۱ می‌آیند.
3. drum–R1 در ۴۸۰ °C حل شد. فاز ۵ ~۳۹۰ °C داده است. پس افت پیش‌بار استاد و اختلاف انبساط در واقعیت کمتر است. بعد از تصمیم بند ۱ و ۲ دوباره اجرا شود.
4. حالت e در توربین با برهم‌نهی است (بخش ۲۱٫۱). در اجرای بعدی مستقیم حل شود.
5. ماده‌ها: مقادیر معمول (IN718، MAR-M247، Ti-6Al-4V، 17-4PH، 34CrNiMo6، Waspaloy). داده‌های گواهی‌شدهٔ تأمین‌کننده جایگزین شوند.
6. مدل پایهٔ دینامیک روتور هنوز اتصال‌ها را صلب می‌گیرد. اثر فنر اتصال‌ها فقط در جدول ۲۱٫۵ است: ۴٪ پایین‌تر و همچنان قبول.
7. فاز ۸ (پیچ‌ها و ترتیب سفت کردن): گشتاور سفت کردن استادها و پیچ مرکزی، ترتیب ضربدری.

### ۲۱٫۱۱ طراحی دوبارهٔ بازوها و فلنج‌ها (تصمیم کاربر، ۲۰۲۶-۱۱-۰۱)

**سؤال:** با تغییر بازو و فلنج دیسک‌های ریختگی، سه مشکل حل می‌شود؟ (۱) R1–R2 در ۷۱۰ °C، (۲) LCF ریشهٔ دندانهٔ فلنج‌های MAR-M247، (۳) LCF گذرای ریشهٔ بازو در بخش ۲۲٫۱۲.

**پاسخ کوتاه:**
- **R1–R2 حل شد.** همهٔ چک‌های سه‌بعدی آن قبول‌اند. عمر ریشه از ۱٬۴۰۰ به ۴٫۴×۱۰⁵ رسید.
- **R2–شفت عقب حل شد.** عمر ریشهٔ فلنج R2 از ۷٬۴۰۰ به ۲٫۶×۱۰⁴ رسید.
- **drum–R1 تغییر نکرد:** ۹٬۰۸۶ (حد ۱۰⁴). قله در مونتاژ و کنار سوراخ استاد است.
- **LCF گذرای بدنه خیلی بهتر شد:** R1 از ۲٬۸۱۶ به ۶٬۸۶۴ و R2 از ۱٬۵۰۵ به ۵٬۸۷۷. حالا لبه (rim) حاکم است، نه بازو.
- **دو پسرفت:**
  - گیرهٔ گذرای R1–R2 از ۱٫۲۹ به ۰٫۸۸ رسید (حد ۱٫۲۵). علت حذف حلقهٔ Waspaloy از طول گیره است.
  - چک دوبعدی پایای ریشهٔ بازو از ۱٫۶×۱۰⁴ به ۸٬۶۰۰ (R1) و ۳٬۹۰۰ (R2) رسید. ریشه حالا در شعاع کمتر هاب است، جایی که تنش خود هاب بیشتر است.
- فهرست روتور: **۱۶۵ از ۱۷۴** قبول (قبلاً ۱۶۵ از ۱۸۶). ۹ رد باقی است.

**علت مشترک (تشخیص):**
- فلنج سنگین (r 58–92) روی بازوی لوله‌ای کوتاه و سفت (r 58–66، ۱۳ mm) بود.
- در گذرا، گاز حفره فلنج و بازو را در ۱–۲ دقیقه گرم یا سرد می‌کند. ثابت زمانی هاب توپر ۱۵ دقیقه است.
- رشد شعاعی فلنج داغ، یا انقباض فلنج سرد در توقف، با بازوی کوتاه به ریشه منتقل می‌شد. بازهٔ تنش در هر چهار ریشه ۵۳۴–۷۷۷ MPa بود.
- همین سازوکار در R1–R2 (۷۱۰ °C) فلنج‌ها را مخروطی می‌کرد.
- تنش ریشهٔ دندانه کنار سوراخ استادها از تنش محیطی خود فلنج می‌آید. بیشتر آن نیروی گریز از مرکز فلنج است. هر چه حلقهٔ فلنج کامل‌تر باشد (سوراخ کوچک‌تر)، این تنش کمتر است.

**غربال دوبعدی** (مدل محوری جدا، میدان دمای تقریبی قلهٔ راه‌اندازی: هاب سرد، بازو و فلنج داغ؛ ۱۵k):

| گونه | بازو: r داخلی، دیواره، طول [mm] | تنش ریشه (vm) [MPa] | مخروطی شدن فلنج [mrad] |
|---|---|---|---|
| rev 6 | r 58، ۸، ۱۳ | ۱٬۰۲۷ | ۱۰٫۵ |
| فقط شعاع کمتر | r 45، ۸، ۱۳ | ۹۳۷ | ۸٫۴ |
| شعاع کمتر، دیوارهٔ نازک | r 45، ۵، ۱۳ | ۸۰۲ | ۹٫۲ |
| مخروطی ۷۲ ← ۵۰ | —، —، ۱۳ | ۱٬۲۹۷ | ۹٫۱ |
| مخروطی ۴۲ ← ۶۰ | —، —، ۱۵ | ۷۵۹ | ۱۱٫۶ |
| **بازوی بلند** | r 45، ۵، **۲۵** | **۴۳۹** | ۴٫۷ |
| عقب R2 (جای محوری ۱۵ mm) | r 45، ۶، ۱۵ | ۷۵۸ | ۸٫۹ |
| **عقب R2 در شعاع کمتر** | **r 30**، ۵، ۱۵ | **۵۴۲** | ۴٫۷ |

- طول بازو اهرم اصلی است. مخروطی کردن در همان طول کمکی نکرد.
- شعاع فیلت ریشه اثری ندارد.
- پشت R2 فقط ۱۵ mm جای محوری دارد (JB2). پس بازوی عقب به شعاع کمتر رفت.

**هندسهٔ جدید** (`cad/engine/a1000_rotor.py`: `ARM`، `X_J`، `joint_side`، `arm_r`، `FIN12`، `STUD_R12`):

| | قبل (rev 6) | بعد |
|---|---|---|
| بازوی جلوی R1 | r 58–66، ۱۳ mm | **r 45–51، ۲۲ mm** (درام ۹ mm کوتاه‌تر) |
| R1–R2 | دو فلنج + حلقهٔ RT-107 (Waspaloy، ۴ تیغه) + دو Curvic | **یک اتصال.** بازوها r 45–51، هر کدام ۲۵٫۵ mm. RT-107 حذف شد. ۲ تیغهٔ آب‌بند روی لبهٔ هر فلنج (r 96.3). |
| بازوی عقب R2 | r 58–66، ۱۳ mm | **r 30–36، ۱۵ mm**. فلنج عقب R2 و فلنج شفت عقب ۸ mm. |
| فلنج‌ها | r 58–92 | r 45–92 (عقب R2: r 30–92). باند Curvic و استادها بدون تغییر: r 62–90، ۱۶ × M10 روی r 76. |
| مهرهٔ R1–R2 | مهرهٔ ساده | **مهرهٔ انبساطی** Waspaloy با دامن ۱۲ mm زیر رزوه (Ø15). استاد ۱۲ mm بلندتر و نرم‌تر می‌شود. دامن هم‌جنس استاد است، پس اختلاف انبساط اضافه ندارد. |
| دیافراگم میانی (HS-232/233) | honeycomb r 92.6 | honeycomb r 96.6–100 روی تیغه‌های لبهٔ فلنج‌ها (`SEAL12`) |

- جرم: R1 ۴۵٫۳ ← ۴۶٫۱ kg، R2 ۵۰٫۵ ← ۵۱٫۱ kg، درام ۱۳٫۳ ← ۱۲٫۱ kg، شفت عقب ۵٫۱ ← ۵٫۰ kg، RT-107 حذف. روتور ۱۹۸ kg.
- **ترتیب مونتاژ** (`a1000_assembly_seq.py`، گام‌های A12–A14):
  1. R2 با ۲۰ mm فاصله پارک می‌شود.
  2. مهره‌های انبساطی به‌صورت شعاعی پشت فلنج R1 گذاشته می‌شوند.
  3. R2 جلو می‌رود تا استادها به رزوه برسند. مهره‌ها R2 را تا جا می‌کشند.
- **چک مونتاژ:** حرکت روتور (۱۱ حرکت) بدون برخورد. چک ایستا تمیز است (فقط ۵ هم‌پوشانی قدیمی).
- **آب‌بند میانی** (`a1000_hot_section_calc.py`): نشتی ۰٫۲۶۶ ← ۰٫۲۷۸٪ هوا (شعاع بزرگ‌تر). ۱۳ از ۱۳ قبول.
- STEP دوباره ساخته شد: درام، شفت عقب، دو دیسک با بازو، استادهای RT-111/112/113، HS-230 تا ۲۳۳. `parts.json` و `pkg.json` به‌روزند. بستهٔ فیوژن دوباره ساخته نشد (تصمیم با کاربر).

**FEA سه‌بعدی اتصال‌ها روی هندسهٔ جدید** (همان مدل بخش ۲۱٫۱. دما از گذرای نهایی: drum–R1 ۳۸۱، R1–R2 ۷۲۲، R2–شفت عقب ۴۷۴ °C):

| | rev 6 | بعد |
|---|---|---|
| R1–R2: فشار متوسط پهلو | ۶۲۹ MPa (۱٫۵۸ حد) | ۲۰۳ MPa (۰٫۴۵) |
| R1–R2: p95 پهلو / ۱٫۶ Sy | ۲٫۶۵ | ۰٫۷۴ |
| R1–R2: حاشیهٔ تسلیم ریشه (R1 / R2) | ۰٫۴۸ / ۰٫۴۶ | ۱٫۴۰ / ۱٫۱۳ |
| R1–R2: LCF ریشه (R1 / R2) | ۱٬۸۷۴ / ۱٬۴۳۸ | ۹٫۶×۱۰⁵ / ۴٫۴×۱۰⁵ |
| R1–R2: استاد، پیک / ۰٫۹ Sy | ۱٫۲۶ | ۰٫۹۵ |
| R1–R2: لغزش در هر دور (صدک ۹۹) | ۱۱٫۸ µm | ۱٫۲ µm |
| R2–شفت عقب: LCF ریشهٔ فلنج R2 | ۷٬۴۲۵ | ۲٫۶×۱۰⁴ |
| drum–R1: LCF ریشهٔ فلنج R1 | ۹٬۰۷۰ | **۹٬۰۸۶ (رد)** |
| drum–R1: کمترین سهم پهلوی بی‌بار | ۰٫۶۴ | ۰٫۷۰ |
| مود خمشی با فنر اتصال‌ها | ۲۰٬۵۵۰ rpm، ۳۰٫۵٪ | ۱۹٬۹۷۷ rpm، ۲۶٫۸٪ (لازم ۲۰٫۰٪) |
| چک‌های فاز ۴ | ۱۰۳ از ۱۲۰ | **۱۰۹ از ۱۱۰** |

- تعداد چک‌ها کمتر شد، چون R1–R2 یک وجه و دو قطعه دارد. چک مش drum–R1 هم برای هندسهٔ جدید اجرا نشد.
- **drum–R1:** بازهٔ ریشه ۴۶۴ ← ۳۶۶ MPa کم شد. ولی vm در مونتاژ ۷۵۶ MPa است، کنار سوراخ استاد (پیش‌بار ۲۷ kN). تنش میانگین بالا عمر را نگه داشته است.
- **سختی اتصال‌های داغ** ۴ تا ۱۲ برابر نرم‌تر از rev 6 شد. علت: فلنج حالا بین بازو (r 45–51) و باند (r 62–90) مخروطی می‌شود. این نرمی در تفاضل «دندانه‌دار منهای توپر» آمده است.
  - دینامیک روتور این مقادیر را به کار برد (۱۹٬۹۷۷ rpm، قبول).
  - مدل دوبعدی فاز ۵ خودش فلنج را دارد. پس مقادیر محلی rev 6 را نگه داشت تا نرمی دو بار شمرده نشود (`model.k_joint_note` در JSON).

**گذرای فاز ۵ روی هندسهٔ جدید** (پیکربندی اصلاح، همان ۹ حالت و AS/BS؛ `sim/engine/fea/a1000_tiebolt_thermal.json`):

| | rev 6 (بخش ۲۲) | بعد |
|---|---|---|
| LCF بدنهٔ R1 (چرخهٔ استاندارد) | ۲٬۸۱۶ (ریشهٔ بازو) | **۶٬۸۶۴** (rim، r 213) |
| LCF بدنهٔ R2 | ۱٬۵۰۵ (ریشهٔ بازو) | **۵٬۸۷۷** (rim، r 202) |
| ناحیهٔ بازو و هاب (r < 110): R1 / R2 | — | ۱۰٬۶۴۶ (مرکز هاب) / ۷٬۵۱۵ (ریشهٔ بازوی عقب، r 41) |
| سکوی R1 / R2 | ۴٬۶۸۴ / ۳٬۳۴۳ | ۴٬۵۴۳ / ۳٬۲۲۰ |
| گیرهٔ R1–R2 / لازم (۵۰٪ آسودگی) | ۱٫۲۹ | **۰٫۸۸ (رد)** |
| دمای استاد R1–R2 | ۷۱۱ °C | ۷۲۲ °C (حد ۷۶۰) |
| پیچ مرکزی: کمترین / لازم | ۱٫۵۹ | ۱٫۵۸ |
| چک‌ها | ۲۲ از ۲۶ | ۱۹ از ۲۴ |

- **گیرهٔ R1–R2:**
  - نیروی پایای استاد در کار ۱۸٫۳ kN است (۷۶٪ پیش‌بار). افت E در ۷۲۰ °C حدود ۱۹٪ است و بقیه اختلاف انبساط.
  - در C2 (قطع بدون BOV، ۱۳۰ s) به ۱۴٫۰ kN می‌رسد.
  - قاعدهٔ فاز ۵ آسودگی را ۵۰٪ پیش‌بار مونتاژ می‌گیرد (۱۲ kN). پس ۲٫۰ kN برای هر استاد می‌ماند.
  - در rev 6 حلقهٔ Waspaloy هم‌جنس استاد در طول گیره بود و افت پایا کمتر بود.
  - اگر آسودگی ۵۰٪ نیروی داغ پایا باشد (آسودگی روی تنش داغ اتفاق می‌افتد)، ۴٫۸ kN می‌ماند و ضریب **۲٫۱** می‌شود. انتخاب قاعده تصمیم است.
  - راه طراحی بدون تغییر قاعده: ۱۶ × M12 Waspaloy. تخمین ضریب ۱٫۲۷ است. ولی سوراخ‌ها و دندانه‌ها عوض می‌شوند و فاز ۴ و ۵ باید دوباره اجرا شوند.
- **همگرایی:** مش ریز و نصف گام در گذر اول طراحی جدید چک شد (بازوی عقب r 45، مهرهٔ ساده). پیش‌بار ۰٫۰۸٪ و ۰٫۰۱٪ تغییر کرد. گذر نهایی دوباره چک نشد.

**فهرست روتور** (`a1000_rotor_stack.py`): ۱۶۵ از ۱۷۴. نُه رد:

| رد | مقدار | علت |
|---|---|---|
| گیرهٔ R1–R2 (پشته و گذرا، ۲ چک) | ۰٫۸۸ | بالا |
| LCF دوبعدی ریشهٔ بازوی R1 | ۸٬۶۲۶ | میدان دمای فرضی. ۵۰۷ MPa روی سطح هاب در انتهای فیلت (r 58) |
| LCF دوبعدی ریشهٔ بازوی R2 | ۳٬۹۳۵ | ۵۷۳ MPa در r 42 (بازوی عقب r 30). گذرای واقعی: ۷٬۵۱۵ |
| LCF ریشهٔ فلنج R1 در drum–R1 | ۹٬۰۸۶ | تنش میانگین کنار سوراخ استاد |
| LCF گذرای بدنه و سکوی R1 و R2 (۴ چک) | ۳٬۲۲۰ تا ۶٬۸۶۴ | rim و سکو (موضوع بخش ۲۲) |

- حاشیهٔ تسلیم در trip: R1 ۱٫۳۵، R2 ۱٫۱۹. ترکیدن: ۱٫۸۹ و ۱٫۸۱. LCF سوراخ استاد فلنج: بیش از ۳×۱۰⁷.
- دینامیک روتور (اتصال صلب): ۳٬۸۷۶ / ۸٬۸۹۰ / ۲۱٬۰۳۳ rpm. حاشیهٔ مود خمشی ۳۳٫۵٪ (لازم ۱۹٫۰٪).

**باز (برای جلسهٔ بعد):**
1. **rim و سکوی R1 و R2** (۳٬۲۲۰ تا ۶٬۸۶۴). حالا این‌ها حاکم‌اند. موضوع گذرای بخش ۲۲ است.
2. **ریشهٔ بازوی عقب R2:** گذرا ۷٬۵۱۵، دوبعدی ۳٬۹۳۵. جای محوری فقط ۱۵ mm است. ایده: شیار حلقوی در سطح عقب هاب R2 تا بازو بلندتر شود، بدون جابه‌جایی اتصال.
3. **گیرهٔ R1–R2:** تصمیم قاعدهٔ آسودگی، یا ۱۶ × M12.
4. **ریشهٔ فلنج R1 در drum–R1** (۹٬۰۸۶): پیش‌بار ۲۷ ← ۲۲ kN (ضریب گیره ۵٫۵ است)، یا فلنج ۹ ← ۱۰ mm. مدل سه‌بعدی باید دوباره اجرا شود.
5. همگرایی مش اتصال‌های داغ جدید اجرا نشد. در rev 6 آخرین ریزسازی ۱۰٪ تنش ریشه را بالا برد.
6. بستهٔ فیوژن دوباره ساخته نشد.

## ۲۲. تحلیل حرارتی–سازه‌ای گذرای روتور: پیش‌بار پیچ مرکزی، استادها و اتصال‌ها (فاز ۵، ۲۰۲۶-۱۰-۳۱)

مدل: `sim/engine/a1000_tiebolt_thermal.py` · نتایج: `sim/engine/fea/a1000_tiebolt_thermal.json` · چک‌ها در فهرست روتور (`a1000_rotor_stack.py`، بخش ۱۰)

> **توجه (۲۰۲۶-۱۱-۰۱):** اعداد متن این بخش برای rev 1.3 است، قبل از طراحی دوبارهٔ بازوها. نتیجهٔ گذرا روی هندسهٔ جدید در بخش ۲۱٫۱۱ است. دو نمودار زیر و JSON حالا هندسهٔ جدید را نشان می‌دهند. پیکربندی baseline در JSON همان rev 1.3 است و دوباره اجرا نشد.

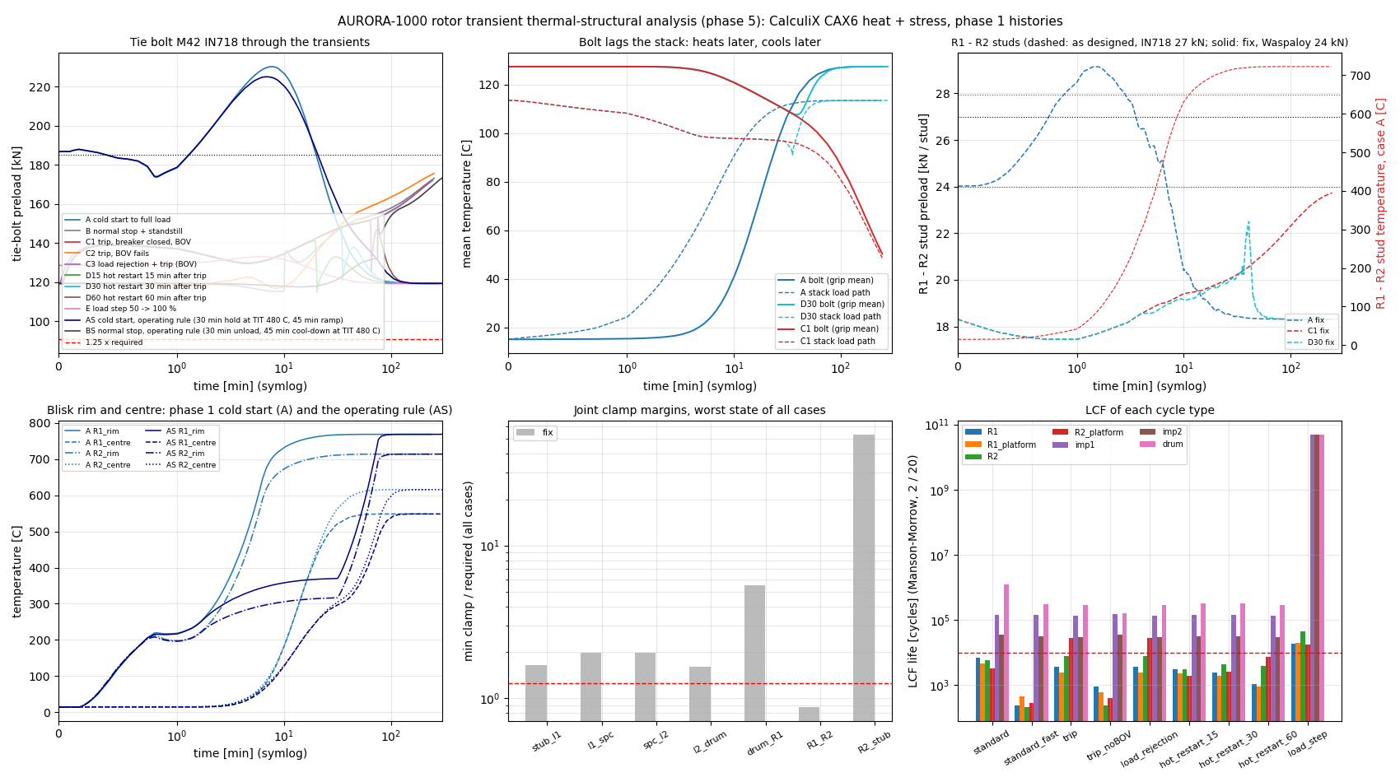
[picture p27: docs/img/a1000_tiebolt_thermal.png]
پیش‌بار، دما، حاشیهٔ اتصال‌ها و LCF در گذراها


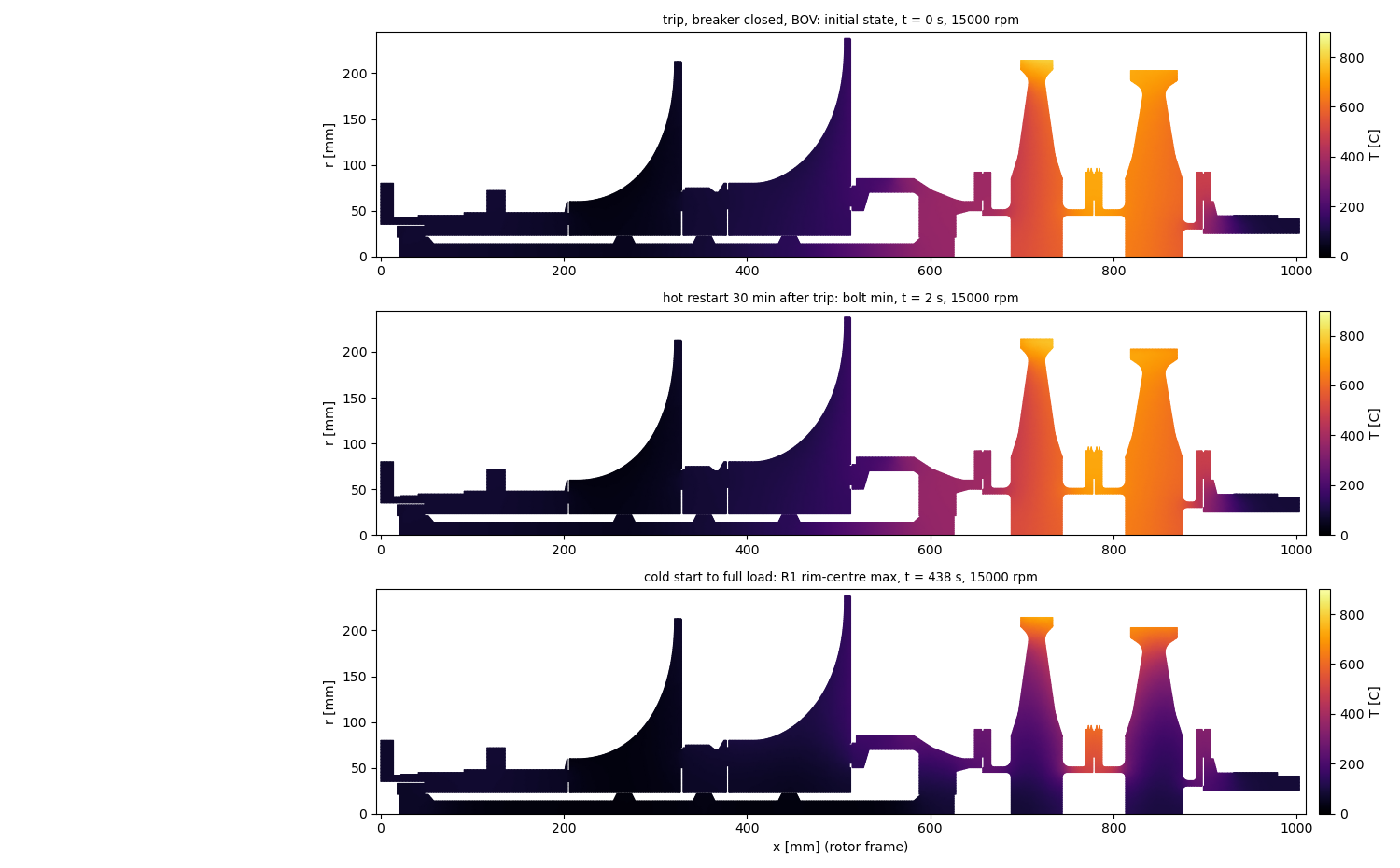
[picture p28: docs/img/a1000_tiebolt_fields.png]
میدان دما در سه لحظه


**نتیجه در چند خط:**

- **پیچ مرکزی در همهٔ گذراها قبول است.** کمترین پیش‌بار ۱۱۶ kN است، در خنک شدن پیش از توقف (لازم ۷۳ kN، ضریب ۱٫۵۹). بیشینه ۲۳۰ kN است، در راه‌اندازی سرد. روشن کردن داغ برای پیچ بحرانی نیست.
- **اتصال R1–R2 در ~۷۱۰ °C کار می‌کند.** حفره‌های میانی purge ندارند. استاد و حلقهٔ IN718 (حد ۶۵۰ °C) رد می‌شوند.
  - Waspaloy مشکل دمای پیچ را حل می‌کند. ولی مدل سه‌بعدی فاز ۴ نشان می‌دهد خود اتصال در این دما از نظر تنش رد است (بخش ۲۲٫۱۶). این هم به تصمیم سیستمی نیاز دارد.
- **خستگی سکوی R1 در کار پایا:** با میدان دمای واقعی ~۶٬۰۰۰ چرخه است (هدف ۱۰٬۰۰۰). با TBC ۱۵٬۰۰۰ می‌شود.
- **خستگی گذرای blisk‌ها رد است.** با راه‌اندازی سریع فاز ۱، عمر R1 و R2 فقط ۴۵–۴۴۰ شروع است. با قاعدهٔ کار انتخاب‌شده ۱٬۵۰۰–۴٬۷۰۰ شروع می‌شود. هدف ۱۰٬۰۰۰ است.
  - قله در چند دقیقهٔ اول بار کمینه است: بازوهای کوتاه و rim با گاز حفره گرم می‌شوند، ولی هاب توپر هنوز سرد است.
  - قاعدهٔ کار تا این حد کمک می‌کند. برای ۱۰٬۰۰۰ شروع، بازو و هاب دیسک باید دوباره طراحی شوند (کار جدید، بخش ۲۲٫۱۶).
- **اصلاح، بدون تغییر هندسه:**
  - استادها، مهره‌ها و حلقهٔ فاصله‌انداز R1–R2 از Waspaloy، با ۲۴ kN؛
  - پوشش TBC به ضخامت ۰٫۴ mm روی سکوی R1؛
  - قاعدهٔ راه‌اندازی و توقف برای سیستم کنترل (بخش ۲۲٫۱۳).
- purge میانی بررسی و رد شد، چون R1 را بدتر می‌کند.
- **چک‌ها:** ۲۲ از ۲۶ چک جدید قبول. چهار رد: LCF گذرای R1 و R2. فهرست روتور: ۶۳ از ۶۷.

### ۲۲٫۱ سؤال و روش

- **سؤال (از بخش ۱۳٫۷، باز ۴):** پیش‌بار پیچ مرکزی M42 و استادهای M10 در گذراها چقدر عوض می‌شود؟ گیرهٔ هر اتصال Curvic کافی می‌ماند؟ دیسک‌ها در هر چرخه چه تنش حرارتی می‌بینند؟
- مدل پایای بخش ۱۳٫۲ فقط چند حالت را با کسر دما حدس زده بود (مثلاً «پیچ ۸۵٪ داغ، استک ۴۰٪»). حالا دما از مدل گذرای کامل روتور می‌آید.
- **سه گام:**
  1. مدل حرارتی گذرای تقارن محوری کل روتور در CalculiX (CAX6، حدود ۶۴ هزار گره).
  2. پیش‌بار پیچ و استادها در هر لحظه، با دمای FE و مدل فنری اتصال.
  3. مدل تنش کامل (CalculiX، CAX6) در لحظه‌های بحرانی: میدان دما، نیروی گریز از مرکز، کشش پره‌ها و پیش‌بار پیچ.
- **محرک‌ها:** تاریخچهٔ زمانی فاز ۱ (`a1000_thrust_transient.py`): دور، دبی و دمای طبقه‌های کمپرسور، فشارها، دبی آب‌بند تعادل، TIT، دمای خروج توربین و دبی توربین.
- همهٔ اجراها روی سرور ابری انجام شد (`/root/runs/p5_work`). هر کار حرارتی و تنش یک تا چهار رشته داشت و ده‌ها کار هم‌زمان اجرا شدند.

### ۲۲٫۲ مدل حرارتی

| بخش مدل | چطور مدل شد |
|---|---|
| قطعه‌ها | شفت جلو، پروانهٔ ۱، فاصله‌انداز، پروانهٔ ۲، درام، R1 و R2 با بازوها، حلقهٔ فاصله‌انداز R1–R2، شفت عقب. پره‌ها مدل نشدند، اثرشان در ضریب انتقال حرارت سکو و هاب است. |
| Curvic‌ها | فقط از نوار دندانه به هم وصل‌اند: لایه‌ای به ارتفاع دندانه، رسانایی ۰٫۴ فلز (نیمی از سطح در تماس). بقیهٔ صفحهٔ اتصال شکاف است. |
| پیچ مرکزی + مهره | جسم جدا. فقط در سطح مهره (x 48) به شفت جلو و در رزوهٔ دیوارهٔ درام (x 590–626) به درام وصل است. |
| حفره‌های بسته | سوراخ پیچ، جیب مهره، داخل درام و حفره‌های زیر بازوهای توربین با گاز پر شدند. رسانایی معادل = هدایت گاز (Nu = 1) + تابش خطی بین دیواره‌ها (ε ۰٫۳۵–۰٫۶). |
| حرکت هوا در حفره‌ها | لحاظ نشد. کران پایدار، چون انتقال کمتر یعنی تأخیر بیشتر پیچ. |
| زمین‌های مرکزگیر پیچ | ۳ زمین با لقی ۰٫۱ mm (سرد) تا ~۰٫۲ mm (۱۵k). در مش ۱ mm پهن، با رسانایی شکاف ۰٫۱۵ mm. |
| مواد | k و cp تابع دما برای IN718، MAR-M247، Ti-6Al-4V، 17-4PH و 34CrNiMo6. |

### ۲۲٫۳ شرایط مرزی (۴۷ ناحیه روی سطح روتور)

| ناحیه | دمای مرجع | h در بار نامی [W/m²K] | رابطه |
|---|---|---|---|
| هاب پروانهٔ ۱ / ۲ (مسیر جریان) | دمای کل نسبی: T01 + (ωr)²/2cp (rothalpy) → ۲۳–۶۴ / ۱۰۰–۱۴۷ °C | ۱٬۵۰۰ × (ṁ/ṁ_d)^0.8 | کانال درهم (Dittus-Boelter، ~۶۵۰) × ۲٫۳ برای پره‌ها به‌صورت پره‌ی خنک‌کن (fin) |
| پشت پروانهٔ ۱ / ۲ (حفرهٔ روتور–استاتور) | هوای نوک پروانه + اصطکاک | ۳۲۰–۸۱۰ (تابع r) | دیسک آزاد درهم با چرخش هسته: Nu_r = 0.0238 Re_r^0.8، β ۰٫۴–۰٫۴۵ (Owen & Rogers) |
| پشت پروانهٔ ۲ زیر r 200 | هوای خروجی کمپرسور ۱۸۹ °C | ۶۱۰–۷۹۰ | همان |
| آب‌بند تعادل درام (r 85) | ۱۷۹ °C | ۱٬۵۲۰ | استوانهٔ چرخان: Nu_D = 0.133 Re_ω^(2/3) Pr^(1/3) (Becker / Kays-Bjorklund) × ۲ برای لابیرنت |
| حفرهٔ جلوی توربین (درام، جلوی R1) | هوای کمپرسور + ۴۰ K اصطکاک = ۲۱۹ °C (با موازنه ۳۸۵ °C) | ۴۱۰–۶۲۰ | دیسک آزاد / استوانهٔ چرخان |
| سکوی R1 / R2 | دمای کل نسبی گاز در هاب: TIT − ۸۵ K n² / خروج طبقهٔ ۱ − ۹۰ K n² → ۸۸۵ / ۷۳۸ °C | ۱٬۶۲۵ / ۱٬۴۲۵ × (ṁ/ṁ_d)^0.8 | دیوارهٔ کانال ۱٬۱۸۰ + پره‌ها به‌صورت fin (۵۹ / ۳۶ × √(hPkA)) |
| **حفره‌های میانی** (پشت R1، زیر NGV2، جلوی R2) | **بدون purge: گاز خروج طبقهٔ ۱ − ۳۰ K = ۷۹۸ °C** (با موازنه ۷۳۲ °C، بخش ۲۲٫۵) | ۲۲۰–۸۸۰ | دیسک آزاد / استوانهٔ چرخان × ۲ روی تیغه‌ها |
| حفرهٔ پشت R2 | هوای بافر هاب (۱۷۹ + ۴۵ °C) با ۴۰٪ گاز اگزوز = ۴۰۶ °C (با موازنه ۵۰۲ °C) | ۱۷۰–۳۰۰ | دیسک آزاد |
| ژورنال‌ها و فلنج کف‌گرد | فیلم روغن ۷۵ / ۸۰ / ۸۵ °C | ۳٬۰۰۰ | |
| مه روغن داخل محفظه‌ها | ۷۰–۸۵ °C | ۳۰۰ × n^0.7 | |

- **توقف:** روغن پس از توقف ۴۰ دقیقه با ۳ l/min (بخش ۱۹)، بعد قطع.
- **در حالت ایستاده:** هر ناحیه فقط جابه‌جایی طبیعی و تابش به قطعهٔ ثابت کنارش دارد (۶–۳۰ W/m²K).
- دمای قطعهٔ ثابت در کار با تأخیر ۳۰۰ s دنبال دمای مرجع می‌رود. بعد از توقف با ثابت زمانی ۲۵–۶۰ دقیقه به ۳۰ °C محفظه می‌رسد. پس بدنه و NGVهای داغ گرما را به روتور پس می‌دهند (soak-back).
- ورودی هوا ۱۵ °C (ISO، مثل فاز ۱).

### ۲۲٫۴ حالت‌ها

| حالت | شرح |
|---|---|
| A | راه‌اندازی سرد تا بار کامل (فاز ۱، حالت d): استارتر، purge، روشن شدن، شتاب، بی‌باری، سنکرون، افزایش بار در ۳۰۰ s. بعد ۴ h بار کامل. |
| B | توقف عادی (فاز ۱، حالت e): کاهش بار، ۳۰۰ s خنک شدن، قطع سوخت و BOV، توقف آزاد. بعد ۴ h ایستاده. |
| C1 | trip از بار کامل با بریکر بسته و BOV (فاز ۱، حالت b)، بعد ۴ h ایستاده. |
| C2 | همان، ولی BOV باز نمی‌شود. recuperator داغ توربین را می‌چرخاند. حدود ۳۰۰ s بعد توان معکوس، بریکر باز می‌شود. |
| C3 | قطع بار + trip با بریکر باز و BOV (فاز ۱، حالت a، اوج ۱۵٬۳۵۰ rpm). |
| D15 / D30 / D60 | روشن کردن داغ ۱۵ / ۳۰ / ۶۰ دقیقه بعد از trip C1. recuperator و دیواره‌های محفظه هنوز داغ‌اند (ثابت زمانی ۳ h و ۱ h در حالت ایستاده). توالی راه‌اندازی A، ولی بریکر در ۹۹٪ دور بسته می‌شود. |
| E | پلهٔ بار ۵۰ → ۱۰۰٪ (TIT از ۶۵۰ تا ۹۷۰ °C در ۱۰ s) از کار پایا در ۵۰٪. |
| AS / BS | قاعدهٔ کار (بخش ۲۲٫۱۳): راه‌اندازی سرد با ۳۰ دقیقه بار کمینه (TIT ۴۸۰ °C) و ۴۵ دقیقه افزایش بار؛ توقف با ۳۰ دقیقه کاهش بار و ۴۵ دقیقه خنک شدن در بار کمینه. |

- **دو پیکربندی:** «پایه» (طرح فعلی) و «اصلاح» (بخش ۲۲٫۷ و ۲۲٫۸). حالت‌های A تا E در هر دو حساب شدند. AS و BS فقط با اصلاح.

### ۲۲٫۵ دمای حفره‌ها: موازنهٔ انرژی

- در حفره‌های کم‌دبی، هوا از دیواره‌های روتور گرما می‌گیرد. پس دمای آن فقط با هوای ورودی تعیین نمی‌شود.
- مثال: حفرهٔ جلوی توربین ۳۷ g/s هوا دارد (m·cp ≈ ۳۷ W/K)، ولی hA دیواره‌های روتور ~۷۰ W/K است.
- **روش:** هوای کاملاً مخلوط، سمت استاتور بی‌دررو (کران پایین دمای هوا، یعنی سمت محافظه‌کار برای گرادیان R1):
  T_air = (ṁ cp T_in + W + Σ hA T_wall) / (ṁ cp + Σ hA)
- دمای دیواره از گذر اول (بدون موازنه) آمد. پاسخ دیواره به دمای هوا (dT_wall/dT_air) با دو حل پایا در بار نامی کالیبره شد. بعد گذر نهایی.
- حل سوم پایا چک است: اختلاف ۲–۷ K.

| حفره | دبی | هوای ورودی | بدون موازنه | **با موازنه** |
|---|---|---|---|---|
| جلوی توربین (FC) | ۳۷ g/s آب‌بند تعادل | ۱۷۹ °C + اصطکاک | ۲۱۹ °C | **۳۸۵ °C** |
| میانی (IS، بدون purge) | تبادل گاز در دو rim، ۳ × نشتی آب‌بند میانی | خروج طبقهٔ ۱: ۸۲۸ °C | ۷۹۸ °C | **۷۳۲ °C** |
| پشت R2 | ۱۴ g/s هوای بافر هاب + ۴۰٪ گاز | ۴۰۶ °C | ۴۰۶ °C | **۵۰۲ °C** |

### ۲۲٫۶ دمای پایا در بار نامی (TIT ۹۷۰ °C)

| قطعه | فرض قبلی | فاز ۵، طرح فعلی | فاز ۵، با اصلاح |
|---|---|---|---|
| پروانهٔ ۱ (سوراخ / نوک) | ۷۵ °C (بخش ۱۳٫۲) | ۳۷ / ۶۶ °C | همان |
| پروانهٔ ۲ (سوراخ / نوک) | ۱۶۰ °C | ۱۲۲ / ۱۵۱ °C | همان |
| درام (لوله / دیوارهٔ رزوه) | ۲۳۰ °C | ۲۵۴ / ۳۶۷ °C | همان |
| پیچ مرکزی (میانگین) / مسیر بار استک | ۱۱۶ °C | ۱۲۸ / ۱۱۶ °C | همان |
| R1: rim / مرکز | ۸۰۰ / ۴۵۰ °C (بخش ۱۲٫۵) | ۷۹۵ / ۵۵۶ °C | **۷۷۰** / ۵۵۴ °C |
| R2: rim / مرکز | ۶۹۰ / ۴۲۰ °C | ۷۱۴ / ۶۰۷ °C | همان |
| استادهای درام–R1 | ۴۸۰ °C (بخش ۱۳٫۹) | ۳۹۴ °C | همان |
| استادها و حلقهٔ R1–R2 | ۵۰۰ °C | **۷۱۲ °C** | ۷۱۱ °C (Waspaloy) |
| استادهای R2–شفت عقب | ۴۶۰ °C | ۴۸۱ °C | همان |

- دیوارهٔ رزوهٔ درام (۳۶۷ °C) داغ‌تر از فرض است. هوای حفرهٔ جلوی توربین (۳۸۵ °C با موازنه) آن را گرم می‌کند. سر عقب پیچ داغ است. ولی کل پیچ و استک تقریباً هم‌دما هستند.
- مرکز دیسک‌ها داغ‌تر از فرض بخش ۱۲٫۵ است: R1 ۱۰۶ K و R2 ۱۸۷ K. علت: حفره‌های جلو و میانی داغ‌اند.

### ۲۲٫۷ یافتهٔ ۱: اتصال R1–R2 در ~۷۱۰ °C است، نه ۵۰۰ °C

- حفره‌های دو طرف NGV2 هوای purge ندارند. نشتی آب‌بند میانی گاز داغ خروج R1 است (همان فرض `a1000_hot_section_calc.py`).
- با موازنهٔ انرژی، گاز حفره **۷۳۲ °C** است. حلقهٔ فاصله‌انداز و استادهای R1–R2 (IN718) به **۷۱۲ °C** می‌رسند.
- مدل پایای بخش ۱۳٫۹ ۵۰۰ °C فرض کرده بود. حد کار IN718 برای پیچ ۶۵۰ °C است. بالاتر از آن فاز δ تشکیل می‌شود و پیش‌بار با خزش شل می‌شود.
- **گیرهٔ این اتصال خیلی بیشتر از لازم است:** لازم ۳۸ kN، پیش‌بار ۴۳۲ kN (۱۶ × ۲۷).

**سه راه بررسی شد (حل پایا در بار نامی + گذر اول گذرا):**

| | پایه (طرح فعلی) | purge میانی (۰٫۴۵٪ هوا از هستهٔ پره‌های NGV2) | **اصلاح انتخاب‌شده** |
|---|---|---|---|
| گاز حفرهٔ میانی | ۷۳۲ °C | ۴۸۶ °C | ۷۳۱ °C |
| استاد و حلقهٔ R1–R2 | ۷۱۲ °C (IN718: رد) | ۴۸۱ °C | ۷۱۱ °C (Waspaloy: قبول) |
| دمای rim / مرکز R1 | ۷۹۵ / ۵۵۶ °C | ۷۵۲ / ۴۰۴ °C | ۷۶۹ / ۵۵۲ °C |
| بازهٔ تنش سکوی R1 (بدون Kt) | ۴۹۳ MPa | ۶۸۵ MPa | ۴۲۵ MPa |
| LCF سکوی R1 (Kt 1.3، روش بخش ۱۲٫۸) | ۶٬۰۰۰ | ۱٬۳۰۰ | **۱۵٬۰۰۰** |
| تغییر | — | پره‌های NGV2 با هسته، اوریفیس، دیافراگم با محفظه؛ ~−۷ kW | جنس دو قطعه + پوشش سکو |

- **purge رد شد.** اتصال را خنک می‌کند، ولی وجه پشت R1 را هم خنک می‌کند. گرادیان rim به مرکز R1 بیشتر می‌شود و عمر سکو به ۱٬۳۰۰ چرخه می‌رسد. تغییر استاتور هم لازم دارد.

- **اصلاح انتخاب‌شده برای اتصال:** جنس استادها، مهره‌ها و حلقه Waspaloy، با پیش‌بار ۲۴ kN. Waspaloy برای بستن تا ~۷۶۰ °C به کار می‌رود.
  - شل شدن ۵۰٪ در نظر گرفته شد. در هر بازرسی بخش داغ گشتاور دوباره بسته می‌شود.
  - گیرهٔ این اتصال آن‌قدر زیاد است که حتی با ۵۰٪ شل شدن کافی می‌ماند (بخش ۲۲٫۱۰).

### ۲۲٫۸ یافتهٔ ۲: عمر خستگی سکوی R1 با میدان دمای واقعی

- بخش ۱۲٫۵ یک میدان دمای فرضی ملایم داشت: مرکز ۴۵۰ °C، rim ۸۰۰ °C، سهمی. بازهٔ hoop سکو ۳۷۶ MPa بود و عمر ۳۰ هزار شروع.
- مدل فاز ۵ مرکز R1 را ۵۵۶ °C می‌دهد و جان را ۵۶۲ °C (داغ‌تر از فرض). ولی rim (۷۹۵ °C) سریع‌تر از متوسط دیسک گرم است: اختلاف ~۲۴۰ K. hoop سکو در کار پایا ۴۹۱− MPa است.
- **بازهٔ پایا (سکون ↔ بار کامل):** سکوی R1 ۴۹۳ MPa، با Kt 1.3 ۶۴۱ MPa در ۷۹۳ °C → **~۶٬۰۰۰ شروع** (هدف ۱۰٬۰۰۰).
- **اصلاح:** TBC به ضخامت ۰٫۴ mm (MCrAlY + 7YSZ، k ≈ ۱ W/mK) روی سکو و فیلت ریشهٔ پره‌ها. فرایند همان NGV1 است (بخش ۳٫۲).
  - ضریب انتقال حرارت مؤثر سکو ۱٬۶۲۵ → ۹۸۵ W/m²K. دمای rim ۷۹۵ → ۷۷۰ °C.

| TBC روی سکوی R1 | دمای rim / مرکز | بازهٔ hoop سکو | LCF سکو (Kt 1.3) | بیشینهٔ بدنه |
|---|---|---|---|---|
| ندارد | ۷۹۵ / ۵۵۶ °C | ۴۹۳ MPa | ۶٫۰×۱۰³ | ۴۷۲ MPa (زیر سکو)، ۷٫۹×۱۰³ |
| ۰٫۲۵ mm | ۷۷۸ / ۵۵۶ °C | ۴۴۸ MPa | ۱٫۱×۱۰⁴ | ۴۴۱ MPa (ریشهٔ بازو)، ۲٫۵×۱۰⁴ |
| **۰٫۴ mm (انتخاب)** | **۷۷۰ / ۵۵۶ °C** | **۴۲۵ MPa** | **۱٫۵×۱۰⁴** | ۴۳۹ MPa، ۲٫۶×۱۰⁴ |

### ۲۲٫۹ پیش‌بار پیچ مرکزی (پیکربندی اصلاح؛ پیچ در دو پیکربندی یکی است)

| حالت | کمینه [kN] (زمان) | بیشینه [kN] (زمان) | دمای پیچ [°C] |
|---|---|---|---|
| A راه‌اندازی سرد | ۱۲۰ (پایا) | **۲۳۰** (۴۶۰ s) | ۱۵–۱۲۸ |
| B توقف عادی | **۱۱۶** (۵۴۰ s) | ۱۷۲ (ایستاده) | ۵۰–۱۲۸ |
| C1 trip با BOV | ۱۲۰ (۲ s) | ۱۷۱ (ایستاده) | ۵۳–۱۲۸ |
| C2 trip بدون BOV | ۱۱۸ (۵۱۰ s) | ۱۷۵ | ۴۵–۱۲۸ |
| C3 قطع بار + trip | ۱۲۰ (۰ s) | ۱۷۱ | ۵۳–۱۲۸ |
| D15 / D30 / D60 روشن کردن داغ | ۱۱۶ / ۱۲۰ / ۱۲۰ | ۱۴۲ / ۱۴۷ / ۱۵۱ | ۱۰۳–۱۲۸ |
| E پلهٔ بار | ۱۲۰ | ۱۳۴ (۳۶۰ s) | ۱۱۳–۱۲۸ |
| AS / BS با قاعدهٔ کار | ۱۲۰ / ۱۱۹ (۹۰۰ s) | ۲۲۵ (۴۰۸ s) / ۱۷۴ | ۱۵–۱۲۷ |

- **ترکیب پیش‌بار در کار پایا:** مونتاژ ۱۸۵ kN. چرخش در ۱۵k ۲۴٫۴− kN (FE، کوتاه‌شدن پواسونی هاب‌ها). دما ۴۱− kN، چون پروانه‌های تیتانیوم کمتر از پیچ IN718 بلند می‌شوند. نتیجه **۱۲۰ kN**. مدل پایای بخش ۱۳٫۲ ۱۵۱ kN داده بود.
- **کمینه:** ۱۱۶ kN، وقتی موتور در بار کمینه خنک می‌شود (B، ۵۴۰ s). حاشیه ۱٫۵۹ در برابر ۷۳ kN لازم. در دور trip (۱۶٬۵۰۰ rpm) چرخش ۵٫۱ kN بیشتر کم می‌کند: ۱۱۱ kN، ضریب ۱٫۵۲.
- **بیشینه:** ۲۳۰ kN در راه‌اندازی سرد. استک زودتر از پیچ گرم می‌شود (۳۷۴ MPa در ساق، ۰٫۴۹ حد). نزدیک برآورد «شروع سرد» بخش ۱۳٫۲ (۲۲۷ kN).
- **چرا پیچ عقب نمی‌ماند:**
  - سه زمین مرکزگیر با لقی ~۰٫۱۵ mm، رزوهٔ دیوارهٔ درام و سطح مهره گرما را خوب می‌رسانند. ثابت زمانی پیچ ~۱۰ دقیقه است.
  - استک هم کند است (پروانه‌ها ~۱۰ دقیقه، درام ~۲۰ دقیقه).
  - در توقف و روشن کردن داغ، پیچ ۵–۱۵ K داغ‌تر از استک می‌ماند. ولی برداشته شدن بار چرخش (+۲۳ kN) اثر آن را پاک می‌کند.
  - پس روشن کردن داغ برای پیچ بحرانی نیست.
- **مدل فنری در برابر FE:** در ۱۰۰ لحظهٔ بحرانی حداکثر اختلاف ۴٫۹٪ است. کالیبره با FE: بستن ۰٫۹۲۱ mm برای ۱۸۵ kN.
- **خزش:** پیچ حداکثر ۱۲۸ °C است. شروع شل شدن IN718 ۵۹۳ °C است. خزش وجود ندارد.

### ۲۲٫۱۰ استادها و اتصال‌های داغ (پیکربندی اصلاح)

| اتصال | جنس، پیش‌بار | دمای پایا / بیشینه | پیش‌بار کمینه هر استاد | گیره پس از شل شدن / لازم | تنش بیشینه / 0.7 Sy |
|---|---|---|---|---|---|
| درام–R1 | IN718، ۲۷ kN | ۳۹۲ / ۴۳۵ °C | ۲۱٫۸ kN (D15) | **۵٫۱۷** (۱۰٪ شل شدن) | ۰٫۷۰ |
| R1–R2 | **Waspaloy، ۲۴ kN** | ۷۱۱ / ۷۱۱ °C (حد ۷۶۰) | ۱۵٫۰ kN (C2) | **۱٫۲۹** (۵۰٪ شل شدن) | ۰٫۹۴ |
| R2–شفت عقب | IN718، ۲۷ kN | ۴۸۱ / ۴۸۲ °C | ۲۲٫۲ kN | **۵۱** | ۰٫۷۰ |

- در طرح فعلی (IN718، ۲۷ kN) استادهای R1–R2 در ۷۱۲ °C کار می‌کنند. چک دمای ۶۵۰ °C رد است.
- بدترین حالت اتصال R1–R2 trip بدون BOV است (C2). recuperator داغ موتور را ۵ دقیقه در دور کامل نگه می‌دارد، ولی گاز سرد می‌شود. حلقه و فلنج‌ها زودتر از استادها سرد می‌شوند.
- تأخیر استاد در سوراخش ۴۵ s در نظر گرفته شد.
- مسیر بار استاد بر اساس محل محوری جدا شد (فلنج، نوار Curvic، حلقه)، نه بر اساس مش. مش ریز همان نتیجه را با ۰٫۰۲٪ اختلاف داد.

### ۲۲٫۱۱ Curvic‌ها: گیرهٔ باقی‌مانده، باز شدن و لغزش

| اتصال | گیرهٔ کمینه / لازم (معیار بخش ۱۳٫۲) | حالت | کسر گیرهٔ مونتاژ |
|---|---|---|---|
| شفت جلو–پروانهٔ ۱ | ۲٫۰۵ | B، ۵۴۰ s | ۶۳٪ |
| پروانهٔ ۱–فاصله‌انداز | ۱٫۹۹ | B، ۵۴۰ s | ۶۳٪ |
| فاصله‌انداز–پروانهٔ ۲ | ۱٫۹۹ | B، ۵۴۰ s | ۶۳٪ |
| پروانهٔ ۲–درام | ۱٫۶۱ | B، ۵۴۰ s | ۶۳٪ |
| درام–R1 | ۵٫۱۷ | D15 | ۸۱٪ |
| R1–R2 | ۱٫۲۹ | C2، ۱۴۰ s | ۶۳٪ |
| R2–شفت عقب | ۵۱ | C2 | ۸۲٪ |

- **همهٔ اتصال‌ها با معیار گیرهٔ کل قبول‌اند.** معیار: خمش 3g، جدا شدن دندانه با گشتاور اتصال کوتاه ۵×، و نیروی محوری.
- **سختی تماس از فاز ۴:** برای هر هفت اتصال، سختی محوری سطح تماس از مدل سه‌بعدی فاز ۴ آمد (`a1000_joint_fea.json`، میانگین سرد و ۱۵k).
  - Curvic‌های کمپرسور ۳٫۳×۱۰⁷ تا ۱٫۴×۱۰⁸ N/mm هستند، یعنی ۴٫۵ تا ۷ برابر برآورد قبلی (۲۴۵۰ N/mm بر mm²).
  - درام–R1 نرم‌تر است (۸٫۶×۱۰⁶ N/mm)، چون سوراخ استادها دندانه‌ها را بریده است.
  - R1–R2 (دو سطح سری) ۱٫۸–۳٫۵×۱۰⁷ و R2–شفت عقب ۱٫۰–۱٫۳×۱۰⁷ N/mm.
- **اثر سختی جدید:** سیستم پیچ–استک کمی سفت‌تر شد. پیش‌بار کمینه ۱۱۹ → ۱۱۶ kN، بیشینه ۲۲۸ → ۲۳۰ kN. حاشیهٔ Curvic‌ها ۰٫۰۴ کمتر شد.
- **پخش محلی تماس (مدل لایهٔ دوبعدی):** نوار Curvic یک لایهٔ چسبیده است. این مدل نشان می‌دهد تماس در شعاع یکنواخت نیست. با لایهٔ سفت‌تر، کشش موضعی بیشتر شد:

| اتصال | تماس محلی کمینه | حالت |
|---|---|---|
| شفت جلو–پروانهٔ ۱ | ۲− MPa | A، ۱۰ s |
| پروانهٔ ۱–فاصله‌انداز | ۲۳− MPa | B، ۵۴۰ s |
| فاصله‌انداز–پروانهٔ ۲ | ۳۲− MPa | A، ۱۰۰ s |
| پروانهٔ ۲–درام | ۶۴− MPa | C1، ۹۰۰ s (درام هنوز از R1 گرما می‌گیرد، پشت پروانهٔ ۲ سرد شده) |
| R1–R2 | ۱۲− MPa | C2، ۲۶۰ s |

- شفت جلو–پروانهٔ ۱ با نوار قبلی (r 44–58) حساب شد. **فاز ۴ نوار را به r 35–47 برد.**
- این مدل برای تماس دندانه معتبر نیست: لغزش و چرخش روی سطح ۳۰° را ندارد.
- مدل سه‌بعدی فاز ۴ در حالت‌های خودش (۱۵k، ۱۸k، اتصال کوتاه ۶×، خمش) حاشیهٔ جدا شدن ۰٫۵۲ تا ۱٫۰۳ می‌دهد. یعنی همه مثبت.
- **فاز ۴ باید این حاشیه‌ها را با گیرهٔ کمینهٔ فاز ۵ هم چک کند:** ۱۱۶ kN، یعنی ۶۳٪ گیرهٔ مونتاژ. سه حالت جدول بالا هم چک شوند.

### ۲۲٫۱۲ تنش حرارتی دیسک‌ها و LCF

**روش:**
- تنش کامل (دما + گریز از مرکز + پیش‌بار) در همهٔ لحظه‌های بحرانی هر چرخه، به‌علاوهٔ حالت سکون.
- برای هر گره، بیشترین بازهٔ von Mises بین هر دو حالت چرخه.
- عمر با Manson-Morrow و ضریب‌های ۲ روی کرنش و ۲۰ روی عمر (روش بخش ۱۲٫۸).
- سکو: Kt 1.3 در فیلت پره، بدون اصلاح تنش میانگین (TMF، مثل `a1000_turbine_checks.py`).
- گره‌های مصنوعی حذف شدند: گوشه‌های تیز شیار نوار Curvic (ریشهٔ دندانه کار فاز ۴ است)، دو گوشهٔ تیز انتهای سکو، و گره‌های مرز با گاز یا نوار.

**تنش‌های بیشینه (پیکربندی اصلاح):**

| حالت | مرکز R1 (vM) | سکوی R1 (hoop) | بیشینهٔ R1 (vM) | مرکز R2 | سکوی R2 (hoop) | بیشینهٔ R2 |
|---|---|---|---|---|---|---|
| کار پایا | ۳۵۸ | ۴۲۶− | ۴۳۶ | ۳۷۷ | ۶۴− | ۴۶۸ |
| A راه‌اندازی سرد (۴۶۰ s) | **۶۷۰** | **۸۰۳−** | **۱٬۰۱۵** (ریشهٔ بازوی عقب) | **۷۰۱** | ۶۶۷− | **۱٬۰۷۴** (ریشهٔ بازوی جلو) |
| B توقف (کاهش بار) | ۳۵۸ | +۱۳۸ (ایستاده) | ۵۲۴ | ۳۷۷ | **+۴۵۸** | ۵۱۹ |
| C2 trip بدون BOV | ۳۵۸ | +۴۵۰ | ۴۶۲ | ۳۷۷ | **+۸۰۹** | ۷۳۳ |
| E پلهٔ بار (۶۰ s) | ۳۷۳ | ۵۷۶− | ۵۷۶ | ۳۸۷ | ۳۴۶− | ۵۰۱ |
| AS قاعدهٔ کار (۴۰۸ s) | **۴۹۵** | ۴۳۰− (پایا) | **۵۶۲** (ریشهٔ بازو) | **۵۱۲** | ۲۶۷− (۱۰۰ s) | **۵۹۳** (ریشهٔ بازو) |
| BS قاعدهٔ کار (پایان کاهش بار) | ۳۵۸ | +۱۴۲ | ۴۶۵ | ۳۷۷ | **+۴۰۲** | ۴۸۱ |

(همه به MPa.)

**یافتهٔ ۳: راه‌اندازی سرد فاز ۱ برای دیسک‌های بی‌سوراخ خیلی سریع است.**
- در توالی فاز ۱ (حالت d)، از روشن شدن تا بار کامل ~۶ دقیقه طول می‌کشد. TIT در ۳۰۰ s از ۶۵۰ به ۹۷۰ °C می‌رسد.
- rim و بازوهای نازک (در گاز داغ میانی) در ۱–۲ دقیقه گرم می‌شوند. هاب ضخیم ۴۰–۴۶ mm ثابت زمانی ~۱۵ دقیقه دارد.
- اختلاف دمای rim و مرکز R1 تا **۶۶۰ K** می‌رسد. در کار پایا ۲۴۰ K است.
- در ۴۶۰ s ریشهٔ بازوها به ۱٬۰۱۵ / ۱٬۰۷۴ MPa می‌رسد. این بالاتر از تسلیم MAR-M247 (~۷۸۰) است.
- در توقف و trip برعکس است: rim زودتر سرد می‌شود و کشش می‌گیرد (سکوی R2 تا +۴۵۸، در C2 تا +۸۰۹ MPa).

| چرخه | R1 بدنه | سکوی R1 | R2 بدنه | سکوی R2 | پروانه‌ها، درام |
|---|---|---|---|---|---|
| فقط پایا (سکون → بار کامل) | ۲٫۸×۱۰⁴ | ۱٫۵×۱۰⁴ | ۱٫۶×۱۰⁴ | ۱٫۹×۱۰⁷ | ≥ ۳×۱۰⁴ |
| پایا + سکون بعد از توقف (soak) | ۵٫۰×۱۰³ | ۳٫۲×۱۰³ | ۱٫۶×۱۰⁴ | ۲٫۶×۱۰⁶ | |
| **A + B فاز ۱ (سریع)** | **۷۷** | **۴۴۰** | **۴۵** | **۳۱۰** | ≥ ۳٫۳×۱۰⁴ |
| AS + C1 / AS + C3 (trip با BOV) | ۴٫۲×۱۰³ | ۲٫۵×۱۰³ | ۲٫۱×۱۰³ | ۳٫۲×۱۰⁴ | |
| AS + C2 (BOV خراب) | ۹۶۰ | ۵۸۰ | ۴۲۰ | ۴۲۰ | |
| AS + D15 / D30 / D60 (روشن کردن داغ سریع فاز ۱) | ۱٫۶ / ۱٫۹ / ۱٫۱ ×۱۰³ | ۲٫۴ / ۲٫۰ / ۰٫۹ ×۱۰³ | ۱٫۳ / ۱٫۶ / ۲٫۲ ×۱۰³ | ۲٫۳ / ۳٫۲ / ۳٫۸ ×۱۰³ | |
| E پلهٔ بار ۵۰ ↔ ۱۰۰٪ | ۱٫۶×۱۰⁴ | ۲٫۰×۱۰⁴ | ۴٫۴×۱۰⁴ | ۱٫۷×۱۰⁴ | |
| قاعدهٔ ۱: بار کمینه TIT ۶۵۰ °C (۲۰ / ۳۰ / ۱۵ / ۲۰ دقیقه) | ۷۶۰ | ۲٬۷۸۰ | ۳۰۰ | ۱٬۴۵۰ | |
| قاعدهٔ ۲: TIT ۴۸۰ °C (۳۰ / ۴۵ / ۲۰ / ۳۰) | ۱٬۶۶۰ | ۳٬۵۳۰ | ۸۴۵ | ۲٬۱۳۰ | |
| قاعدهٔ ۳: TIT ۴۸۰ °C (۴۵ / ۶۰ / ۳۰ / ۴۵) | ۲٬۸۳۰ | ۴٬۶۸۰ | ۱٬۵۳۰ | ۳٬۳۴۰ | |
| **قاعدهٔ انتخاب‌شده: TIT ۴۸۰ °C (۳۰ / ۴۵ / ۳۰ / ۴۵)** | **۲٬۸۲۰** | **۴٬۶۸۰** | **۱٬۵۰۰** | **۳٬۳۴۰** | ≥ ۳×۱۰⁴ |

(اعداد قاعده: نگه‌داشتن در بار کمینه / افزایش بار / کاهش بار / خنک شدن، به دقیقه. قاعده‌های ۱ تا ۳ با سختی پنج اتصال فاز ۴ حساب شدند؛ ردیف انتخاب‌شده با هر هفت اتصال.)

- **بدون قاعده، عمر خستگی blisk‌ها ۲۰ تا ۲۰۰ برابر کمتر از هدف ۱۰٬۰۰۰ شروع است.** فقط با حالت‌های پایا، همه قبول‌اند (≥ ۱٫۵×۱۰⁴).
- **قاعدهٔ ۱ (بار کمینه با TIT ۶۵۰ °C) کم کمک کرد.** TIT ۶۵۰ °C حدود ۴۰٪ بار است. rim و بازوها باز هم در چند دقیقه داغ می‌شدند.
- **بار کمینهٔ واقعی TIT ~۴۸۰ °C است.** بی‌باری در دور کامل ~۴۴۰ °C است. پایین‌تر از آن در دور ثابت ممکن نیست.
- **قلهٔ راه‌اندازی در ۵–۷ دقیقهٔ اول بار کمینه است.** هاب هنوز ۱۵–۵۰ °C است، بازوها و rim ۳۰۰–۴۰۰ °C. پس نگه‌داشتن یا افزایش بار طولانی‌تر کمکی نمی‌کند. در قاعده‌های ۲ و ۳ همان لحظه‌ها حاکم‌اند.
- توقف کندتر کمک می‌کند: کشش معکوس rim در پایان کاهش بار کمتر می‌شود.
- حتی با توقف بی‌نهایت کند، قلهٔ راه‌اندازی به‌تنهایی عمر R2 را به ~۳٬۵۰۰ شروع محدود می‌کند (برآورد).
- **محل:** فیلت ریشهٔ بازوها روی وجه هاب (r 66). بازو لوله‌ای کوتاه است: ۱۳ mm طول، دیوارهٔ ۸ mm، فیلت ~۶ mm (طول بازو بیشتر از این اجازه نمی‌دهد). بازو با گاز حفره گرم می‌شود و هاب توپر ۴۰–۴۶ mm سرد می‌ماند.
- **پس برای ۱۰٬۰۰۰ شروع، طراحی دیسک باید عوض شود** (بخش ۲۲٫۱۶). این کار روی طراحی blisk، فاصله‌انداز R1–R2 و اتصال‌های فاز ۴ اثر دارد. در فاز ۵ انجام نشد.
- پروانه‌ها، درام، حلقهٔ فاصله‌انداز و شفت عقب در همهٔ چرخه‌ها قبول‌اند.

### ۲۲٫۱۳ اصلاح‌ها و قاعده‌های کار

**تغییر قطعه‌ها (هندسه عوض نشد، STEP لازم نیست):**

| قطعه | قبل | بعد | دلیل |
|---|---|---|---|
| استادها و مهره‌های R1–R2 (RT-112) | IN718 (مهره Waspaloy)، ۲۷ kN | **Waspaloy، ۲۴ kN** (۳۹۲ MPa)، ۵۰٪ شل شدن در نظر، گشتاور دوباره در بازرسی بخش داغ | اتصال در ۷۱۰ °C. حد بستن Waspaloy ~۷۶۰ °C است. |
| حلقهٔ فاصله‌انداز R1–R2 (RT-107) | IN718 | **Waspaloy** | همان دما. با استادها هم‌جنس است، پس در طول حلقه اختلاف انبساط ندارد. |
| Heli-Coil‌های فلنج R2 | — | Nimonic 90 | همان دما |
| سکوی R1 و فیلت ریشهٔ پره‌ها | بدون پوشش | **TBC ۰٫۴ mm** (MCrAlY + 7YSZ، همان فرایند NGV1) | rim ۷۹۵ → ۷۷۰ °C. LCF پایا ۶٬۰۰۰ → ۱۵٬۰۰۰. |

- در کد: `STUD_R12`، `TBC_R1` و `TSPC['mat']` در `cad/engine/a1000_rotor.py`.
- `a1000_rotor_stack.py` (بخش ۴) دمای اتصال‌ها و نوسان پیش‌بار استادها را از JSON فاز ۵ می‌خواند.

**قاعده‌های کار برای سیستم کنترل:**

| # | قاعده | دلیل |
|---|---|---|
| 1 | **راه‌اندازی:** بعد از سنکرون، **۳۰ دقیقه در بار کمینه** (TIT ≈ ۴۸۰ °C، کمی بالای بی‌باری). بعد افزایش بار تا نامی در **≥ ۴۵ دقیقه**. همین برای روشن کردن داغ. | LCF blisk‌ها (بخش ۲۲٫۱۲): قلهٔ بازوها ۱٬۰۱۵ → ۵۶۰ MPa |
| 2 | **توقف عادی:** کاهش بار در **≥ ۳۰ دقیقه**، بعد **۴۵ دقیقه خنک شدن** در بار کمینه، بعد قطع سوخت. | کشش معکوس rim در توقف |
| 2b | **شمارش:** کنترل شروع‌های سرد، روشن کردن داغ و tripها را بشمارد (نرم‌افزار، بدون حسگر). تا اصلاح دیسک، عمر blisk‌ها با قاعدهٔ ۱ و ۲ ~۱٬۵۰۰ شروع (R2) است. | عمر محدود blisk‌ها |
| 3 | **پلهٔ بار ۵۰ → ۱۰۰٪ در ۱۰ s مجاز است** (LCF هر دو blisk ≥ ۱٫۶×۱۰⁴). | حالت E |
| 4 | **برای پیچ و اتصال‌ها قفل روشن شدن لازم نیست.** قفل لقی نوک بخش ۱۴ (۱۵ دقیقه تا ۲ ساعت، یا چرخاندن خنک‌کننده) سر جایش می‌ماند. روشن کردن داغ هم با قاعدهٔ ۱: روشن کردن داغ سریع ۱٫۵ تا ۲٫۵ چرخهٔ استاندارد مصرف می‌کند. | حالت‌های D |
| 5 | **روشن کردن داغ:** با recuperator داغ، بی‌باری بدون BOV دور را نگه نمی‌دارد. سنکرون‌کننده بریکر را در ~۹۹٪ دور ببندد، یا governor بی‌باری BOV را باز کند. | دور تا ۱۰۶٪ رفت |
| 6 | **BOV در هر trip باید باز شود** (موقعیت شیر با feedback و تست دوره‌ای). هر trip بدون BOV ۳ تا ۸ چرخهٔ استاندارد از عمر blisk‌ها مصرف می‌کند. اتصال R1–R2 هم بدترین حالتش را آن‌جا دارد. | حالت C2 |
| 7 | **بازرسی بخش داغ:** گشتاور استادهای R1–R2 دوباره بسته شود. TBC سکوی R1 دیده شود. | ۵۰٪ شل شدن در نظر گرفته شده |
| 8 | حسگر جدید لازم نیست. | — |

### ۲۲٫۱۴ مش و گام زمانی

| چک (حالت E، گذر اول، ۱ ساعت اول) | تغییر پیش‌بار پیچ و استاد | تغییر دما |
|---|---|---|
| مش ریز (۱۰۹ هزار گره، ×۰٫۷۵ اندازهٔ المان) | ۰٫۰۶٪ | ≤ ۱٫۴ K |
| نصف گام زمانی و DELTMX ۵ K (به جای ۱۰) | ۰٫۰۱٪ | ≤ ۰٫۷ K |

- AS و BS (۵–۶ ساعت شبیه‌سازی) با گام درشت‌تر حساب شدند: ضریب گام ۶ (به جای ۲) و DELTMX ۳۰ K. همین تنظیم روی حالت E: تغییر پیش‌بار < ۰٫۰۲٪، دمای R1 ۲٫۶ K.

- مدل تنش: کالیبراسیون پیش‌بار، ۱۸۵٫۰ kN در مونتاژ. چرخش ۱۵k: ۲۴٫۴− kN. دور trip: ۲۹٫۵− kN.
- حساسیت لقی زمین‌های پیچ (کاملاً باز) اجرا نشد. سرور با فاز ۴ پر بود.
- برای کمینهٔ پیش‌بار مهم نیست، چون کمینه در کار پایا است.

### ۲۲٫۱۵ چک‌ها

| چک | مقدار | حد | نتیجه |
|---|---|---|---|
| پیچ مرکزی: پیش‌بار کمینه / لازم | ۱٫۵۹ | ≥ ۱٫۲۵ | قبول |
| پیچ مرکزی: تنش بیشینهٔ ساق / 0.75 Sy | ۰٫۴۹ | ≤ ۱ | قبول |
| پیچ مرکزی: دمای بیشینه (شروع شل شدن IN718) | ۱۲۸ °C | ≤ ۵۹۳ °C | قبول |
| مدل فنری در برابر FE | ۴٫۹٪ | ≤ ۱۰٪ | قبول |
| گیرهٔ کمینه / لازم: شفت جلو–پروانهٔ ۱ | ۲٫۰۵ | ≥ ۱٫۲۵ | قبول |
| گیرهٔ کمینه / لازم: پروانهٔ ۱–فاصله‌انداز | ۱٫۹۹ | ≥ ۱٫۲۵ | قبول |
| گیرهٔ کمینه / لازم: فاصله‌انداز–پروانهٔ ۲ | ۱٫۹۹ | ≥ ۱٫۲۵ | قبول |
| گیرهٔ کمینه / لازم: پروانهٔ ۲–درام | ۱٫۶۱ | ≥ ۱٫۲۵ | قبول |
| گیرهٔ کمینه / لازم: درام–R1 | ۵٫۱۷ | ≥ ۱٫۲۵ | قبول |
| گیرهٔ کمینه / لازم: R1–R2 | ۱٫۲۹ | ≥ ۱٫۲۵ | قبول |
| گیرهٔ کمینه / لازم: R2–شفت عقب | ۵۱٫۴۹ | ≥ ۱٫۲۵ | قبول |
| دمای استاد درام–R1 (IN718) | ۴۳۵ °C | ≤ ۶۵۰ °C | قبول |
| تنش استاد درام–R1 / 0.7 Sy (دوبعدی) | ۰٫۷۰ | ≤ ۱ | قبول |
| دمای استاد R1–R2 (Waspaloy) | ۷۱۱ °C | ≤ ۷۶۰ °C | قبول |
| تنش استاد R1–R2 / 0.7 Sy (دوبعدی) | ۰٫۹۴ | ≤ ۱ | قبول |
| دمای استاد R2–شفت عقب (IN718) | ۴۸۲ °C | ≤ ۶۵۰ °C | قبول |
| تنش استاد R2–شفت عقب / 0.7 Sy (دوبعدی) | ۰٫۷۰ | ≤ ۱ | قبول |
| LCF بدنهٔ R1 (شروع استاندارد با قاعدهٔ کار) | ۲٬۸۱۶ | ≥ ۱۰٬۰۰۰ | **رد** |
| LCF سکوی R1 (شروع استاندارد با قاعدهٔ کار) | ۴٬۶۸۴ | ≥ ۱۰٬۰۰۰ | **رد** |
| LCF بدنهٔ R2 (شروع استاندارد با قاعدهٔ کار) | ۱٬۵۰۵ | ≥ ۱۰٬۰۰۰ | **رد** |
| LCF سکوی R2 (شروع استاندارد با قاعدهٔ کار) | ۳٬۳۴۳ | ≥ ۱۰٬۰۰۰ | **رد** |
| LCF پروانهٔ ۱ (شروع استاندارد با قاعدهٔ کار) | ۱۴۶٬۲۸۸ | ≥ ۱۰٬۰۰۰ | قبول |
| LCF پروانهٔ ۲ (شروع استاندارد با قاعدهٔ کار) | ۳۵٬۸۴۱ | ≥ ۱۰٬۰۰۰ | قبول |
| LCF درام (شروع استاندارد با قاعدهٔ کار) | ۱٬۱۶۷٬۳۷۸ | ≥ ۱۰٬۰۰۰ | قبول |
| مش ریز: تغییر پیش‌بار | ۰٫۰۶٪ | ≤ ۳٪ | قبول |
| نصف گام زمانی: تغییر پیش‌بار | ۰٫۰۱٪ | ≤ ۳٪ | قبول |

- ۲۲ از ۲۶ چک فاز ۵ قبول‌اند. چهار چک LCF blisk‌ها رد‌اند (بخش ۲۲٫۱۲).
- چک دوبعدی تنش استاد R1–R2 قبول است، ولی مدل سه‌بعدی فاز ۴ با خمش فلنج ۱٫۲۶ × 0.9 Sy می‌دهد (بخش ۲۲٫۱۶).
- فهرست کامل روتور (`a1000_rotor_stack.py`، با بخش ۱۰): ۶۳ از ۶۷ قبول. چهار رد همان چک‌های LCF‌اند.

### ۲۲٫۱۶ رابط‌ها و باز

1. **فاز ۴ (نتیجهٔ سه‌بعدی اتصال R1–R2، بخش ۲۱):**
   - فلنج‌ها، حلقه و استادها در ۷۱۱–۷۳۰ °C روی هاب‌هایی با رشد ~۴۷۰ °C نشسته‌اند. بازوها مخروطی می‌شوند.
   - تماس دندانه به ۴۸٪ و ۲۴٪ دو سطح می‌رسد. ریشهٔ دندانه ۱٬۵۶۰–۱٬۷۸۰ MPa است، LCF ۱٬۴۰۰–۹٬۰۰۰ شروع.
   - اوج استاد ۷۵۶ MPa در ۲۴ kN است، ۱٫۲۶ × 0.9 Sy. چک دوبعدی این بخش (۰٫۹۴) خمش فلنج را ندارد.
   - جدا شدن نیست (بار سمت دیگر دندانه ≥ ۰٫۹۴). مشکل تنش است.
   - پس اصلاح Waspaloy فقط دمای پیچ را حل می‌کند. **اتصال R1–R2 هم مثل ریشهٔ بازوها به تصمیم سیستمی نیاز دارد** (بند ۲).
   - حاشیهٔ جدا شدن Curvic‌ها را با گیرهٔ کمینهٔ فاز ۵ (۱۱۶ kN، ۶۳٪ مونتاژ) و حالت‌های جدول بخش ۲۲٫۱۱ چک کند.
2. **حفرهٔ میانی و طراحی دیسک (کار جدید، لازم):** دو مشکل یک علت دارند: گاز داغ حفره‌ها بازوها و فلنج‌ها را سریع‌تر و بیشتر از هاب توپر گرم می‌کند.
   - LCF گذرای ریشهٔ بازوهای R1 و R2 با بهترین قاعدهٔ کار هم رد است (بخش ۲۲٫۱۲).
   - اتصال R1–R2 در مدل سه‌بعدی فاز ۴ رد است (بند ۱).
   - یک گزینه: purge میانی با TBC روی سکوی R1. purge به‌تنهایی سکوی R1 را بدتر کرد (بخش ۲۲٫۷)، ولی ترکیب آن با TBC حساب نشده است.
   - گزینه‌های دیگر:
     - بازوی بلندتر و نازک‌تر با فیلت بزرگ‌تر. فضای محوری از حلقهٔ فاصله‌انداز R1–R2، درام و شفت عقب گرفته می‌شود.
     - هاب سبک‌تر یا با سوراخ و مسیر هوا، تا هاب سریع‌تر گرم شود.
     - گرم کردن در دور کم (اینورتر دور متغیر دارد): TIT و h کمتر. مدل فاز ۱ فعلاً فقط دور ثابت را دارد.
   - بعد از تغییر، حالت‌های A، B، AS و BS این بخش و اتصال‌های داغ فاز ۴ دوباره اجرا شوند.
   - مرکز دیسک‌ها ۱۰۰–۱۹۰ K داغ‌تر از فرض بخش ۱۲٫۵ است. FEA دیسک (بخش ۱۲٫۵ و ۱۳٫۱) با میدان دمای این بخش دوباره اجرا شود.
   - CHT برای rim R1 و حفرهٔ جلوی توربین، تا گرمای ورودی rim و دمای هوای حفره تأیید شود.
3. **داده‌های purge:** پیکربندی purge (بخش ۲۲٫۷، برچسب `_p`) در کد هست (`CONFIGS['purge']`). نتایج حرارتی‌اش روی سرور ابری در `/root/runs/p5_work` مانده است (`meta_p*.json`، `p5_*_p*.frd`). برای بند ۲ قابل استفاده است.
4. **فاز ۶:** فعلاً اثری روی عملکرد نیست (purge نیست). TBC مسیر گاز را عوض نمی‌کند. اگر بند ۲ به purge برسد، ~۰٫۴۵٪ هوا و ~۷ kW کم می‌شود.
5. **فاز ۸:**
   - گشتاور استادهای Waspaloy برای ۲۴ kN؛
   - ترتیب بستن و گشتاور دوباره در بازرسی؛
   - Heli-Coil از Nimonic 90.
6. **فاز ۹:** حسگر جدید لازم نیست. برای تست نمونه، دمای حفرهٔ میانی و حفرهٔ جلوی توربین یک بار اندازه گرفته شود تا مدل تأیید شود.
