ahmadreza221/aurora-cchp/docs/06_master_design.md

# GR180-CCHP — طرح جامع (master design): مختصات، رابط‌ها، تقسیم کار، BOM

تاریخ: ۲۰۲۶-۱۰-۲۱ · هدف کاربر: «همهٔ قطعات (ساختنی و خریدنی) در مدل سه‌بعدی و فهرست خرید؛ طرح کامل».
باتری اصلی: **۲۰ kWh** (تصمیم کاربر) + باتری ۴۸ V کنترل.

## ۱. دستگاه‌های مختصات (برای همهٔ طراحان، اجباری)

| قاب | مبدأ | محورها | واحد |
|---|---|---|---|
| **ROOF** (قاب سایت) | گوشهٔ جنوب‌غربی بام، روی سطح تمام‌شدهٔ بام | x شرق، y شمال، z بالا | m |
| **ENG** (قاب موتور، همان `build_gr180.py`) | صفحهٔ جلویی زبانهٔ تونل (x = 0) روی محور موتور | x در جهت جریان (به شرق)، y شمال، z بالا | mm |
| **PKG** (اسکید پکیج موتور EP-1) | گوشهٔ جنوب‌غربی-پایین اسکید | مثل ROOF | m |

- **تبدیل ENG → ROOF:** `X = 1.680 + x/1000`، `Y = 7.850 + y/1000`، `Z = 0.600 + z/1000`. محور موتور افقی و شرقی است.
- **پکیج EP-1** در ROOF: x از ۱.۳۰ تا ۲.۷۰، y از ۷.۶۰ تا ۸.۵۰، z از ۰ تا ۱.۳۰ (`docs/hvac/04_roof_layout.md`). اگر لازم شد تا ۱.۶ × ۱.۰ m بزرگ‌تر می‌شود و جلسهٔ تأسیسات جانمایی را تطبیق می‌دهد.
- **ساختمان:** سالن ۱۰ × ۱۰ × ۲.۵ m زیر بام (کف سالن z ≈ −۲.۸، سقف عایق‌دار). اتاق برق داخل ساختمان با مسیر کابل ~۳۰ m تا بام (محل دقیق را جلسهٔ برق تعیین می‌کند).

## ۲. نقطهٔ طراحی پیوسته (همهٔ زیرسیستم‌ها بر این مبنا)
ورودی ۱۵ °C (کویل آب سرد)، ارتفاع ۵۰ m، 115k rpm، TIT ۸۰۰ °C (`sim/life_study.py`، `sim/gg_turbine_design.json`):

| ایستگاه | مقدار |
|---|---|
| دبی هوا / گاز | 0.395 / 0.397 kg/s |
| خروجی کمپرسور (رفت به recuperator) | 165 °C، P ≈ 3.10 × 1.0 bar، ~3.05 bar abs |
| خروجی سرد recuperator (ورود محفظه) | **566 °C**، ~2.98 bar abs |
| ورودی توربین هسته | 800 °C، 2.87 bar abs |
| خروجی توربین هسته (ورود interduct) | 667 °C، P0 1.48 bar، Cx ≈ 300 m/s، هاب r 19.0 / نوک r 35.15 mm، بدون swirl |
| توربین قدرت (FPT) | ورود 667 °C / ~1.46 bar، خروج ~1.06 bar، **۲۵.۶ kW شفت**، دور طراحی ~۶۰k rpm |
| خروج FPT = ورود گرم recuperator | **610 °C** |
| خروج گرم recuperator → D-101 → HX-1 | **262 °C** |
| recuperator | ۱۵۹ kW، ε = 0.90، Δp ≤ ۲.۵ % سرد / ۳.۵ % گرم |
| سوخت | **2.24 g/s ≈ 11.7 m³/h گاز شهری** (۱۱۲ kW) |
| ژنراتور PMG | ۳۰ kW نامی، ۶۰k rpm، خنک‌کاری گلیکول ۳۵–۴۰ °C |

## ۳. رابط‌های پکیج EP-1 (در قاب ROOF، m)

| رابط | محل | اندازه | طرف مقابل |
|---|---|---|---|
| ورود هوا از IF-1 | وجه غربی x = 1.30، y = 7.85، z = 0.60 | DN200 (یا ۲۰۰ × ۲۰۰) | IF-1 (تأسیسات) |
| خروج اگزوز (بعد از recuperator) | وجه شرقی x = 2.70، y = 8.25، z = 0.80 | DN250، فلنج PN6 | کانال داغ → D-101 (تأسیسات) |
| ورود گاز | وجه جنوبی x = 1.60، y = 7.60، z = 0.30 | DN20 | قطار گاز (پکیج) ← رایزر گاز |
| گلیکول رفت/برگشت | وجه جنوبی x = 2.40، y = 7.60، z = 0.25 / 0.40 | DN25 | DC-1 / HX-4 |
| خروجی برق PMG | جعبه ترمینال شرقی | ۳ فاز ~۳۶۰ V، ۱–۲ kHz | یکسوساز B3 در RP-1 روی اسکید (جلسهٔ برق) |
| نازل اطفای حریق | سقف پکیج | DN15 | سیستم اطفا (تأسیسات) |
| سیگنال‌ها | جعبه اتصال JB-E روی اسکید | طبق I/O | ECU (برق) |

## ۴. تقسیم کار و فایل‌ها

| زیرسیستم | مسئول | اسکریپت/مدل | خروجی STEP |
|---|---|---|---|
| E1 هستهٔ GR180 + **توربین و NGV جدید برای ریخته‌گری** + FEA | این جلسه | `build_gr180.py`، `cad/engine/gg_turbine.py` | `cad_out/v13A/`، `cad_out/engine/` |
| E2 محفظهٔ احتراق recuperated + بدنهٔ فشاری + collector کمپرسور | زیرعامل موتور | `cad/engine/combustor_casing.py` | `cad_out/engine/` |
| E3 interduct + FPT + یاتاقان و شفت + **PMG** + collector اگزوز | زیرعامل موتور | `cad/engine/fpt_pmg.py` | `cad_out/engine/` |
| E4 **recuperator** | زیرعامل موتور | `cad/engine/recuperator.py` | `cad_out/engine/` |
| E5 روغن مداربسته، استارتر پین‌دار، قطار گاز، اسکید، **جعبه با درها، HMI و حفاظ ترکیدن** | زیرعامل موتور (بعد از E2–E4) | `cad/engine/package.py` | `cad_out/engine/` |
| P تأسیسات بام (چیلرها، برج، پمپ‌ها، مخازن، لوله‌کشی، دانیج، **اطفای حریق**) | جلسهٔ تأسیسات | `cad/plant/*.py` | `cad_out/plant/` |
| EL تابلوها، اینورتر، **باتری ۲۰ kWh**، ۴۸ V، یکسوساز، بردها، HMI، سینی کابل | جلسهٔ برق | `cad/electrical/*.py`، `electronics/` | `cad_out/electrical/` |
| S مونتاژ سایت (ساختمان + بام + اتاق برق + مسیرها) | این جلسه | `cad/site/site_assembly.py` | `cad_out/site/` |

**قواعد مدل:**
- قطعات خریدنی با **مدل پوش (envelope)** از دیتاشیت: ابعاد بیرونی، فلنج‌ها، نقاط اتصال و وزن.
- هر اسکریپت یک فایل `*_interfaces.json` می‌نویسد (نام رابط، موقعیت در ROOF، جهت، اندازه).
- همه با FreeCAD (`freecadcmd`) و `LANG=en_US.UTF-8`.

## ۵. فهرست قطعات (BOM)

`docs/bom/<subsystem>_bom.csv` با ستون‌های زیر:

```
tag,description,qty,make_or_buy,material_or_spec,size_or_rating,supplier_candidates,mass_kg,model_file,notes
```

- **make:** روش ساخت (5-axis / تراش+سنگ / SLM-IN718 / SLM-AlSi10Mg / ریخته‌گری IN713LC / ورق+TIG / بازوی رباتیک / پرینت پلاستیک).
- **buy:** مشخصات خرید و تأمین‌کنندهٔ پیشنهادی (اروپایی/چینی/داخلی؛ **بدون آمریکایی**).
- BOM کلی: `docs/bom/MASTER_BOM.csv` (ادغام خودکار، `cad/site/merge_bom.py`).

## ۶. تعریف «تمام‌شده»
1. هر قطعه یک مدل در STEP و یک سطر در BOM دارد.
2. مونتاژ سایت بدون تداخل باشد. فاصله‌های سرویس رعایت شود (درها باز شوند، قطعات قابل بیرون‌کشیدن باشند).
3. محاسبات هر زیرسیستم (اسکریپت قابل اجرا) با نقطهٔ طراحی بخش ۲ هم‌خوان باشد.
4. نقشه/مقطع و تصویر رندر برای هر زیرسیستم و کل سایت.
