ahmadreza221/aurora-cchp/docs/variant_e/00_overview.md

# GR180 نسخهٔ E — توربین‌ژنراتور گازی تک‌شفت ۲۵۰ kW پیوسته (خلاصهٔ طرح)

تاریخ: 2026-10-24 · دستگاه مختصات: ENG (mm، x = محور موتور رو به پایین‌دست، **x = 0 نوک پروانهٔ کمپرسور**، z بالا، محور 950 mm بالای کف)

- **مبنا:** معماری D2 (پاد ژنراتور جلو + کوپلینگ quill شش‌گوش، پلنوم ورودی بسته، کمپرسور شعاعی، توربین شعاعی با چرخ خریدنی، دیفیوزر اگزوز، شاسی RHS روی ضربه‌گیر، یاتاقان هیبرید جت روغن روی SFD) در مقیاس ۱۰ برابر و با قطعات صنعتی.
- **اعداد ماشینی:**
  - `sim/variant_e/e_cycle.json`: چرخه، جدول دما، تطبیق 770/850 و بودجهٔ راندمان
  - `e_compressor.json`، `e_turbine.json`، `e_combustor.json`، `e_ducts.json`، `e_pmg.json`، `e_rotor.json`
  - خلاصهٔ CAD: `e_cad_summary.json`
- **مدل‌ها:** `cad/variant_e/e_layout.py` (همهٔ ابعاد) و `e_core.py`، `e_can.py`، `e_exhaust.py`، `e_generator.py`، `e_intake_frame.py`، `e_check.py`.
  - خروجی: `cad_out/variant_e/<SUBSYSTEM>/*.step`، یک فایل برای هر قطعه، به‌علاوهٔ `e_interfaces.json`.
- **BOM:** `docs/bom/variant_e_bom.csv` (۹۱ ردیف، ساخته‌شده با `sim/variant_e/e_bom.py`).
- علامت «(تخمین)» یعنی محاسبهٔ مهندسی ما، نه دادهٔ سازنده. ابعاد چرخ‌ها، یاتاقان‌ها و آهنرباها «پوش» هستند تا نقشهٔ سازنده برسد.

## ۱. خلاصه

- **نقطهٔ طراحی آیرودینامیک:**
  - 30 °C، ارتفاع 50 m، رطوبت 40 %
  - **TIT 770 °C**، PR 4.0، هوای **3.0 kg/s**، **35,000 rpm**
  - ژنراتور دوقطبی، **583 Hz**
- **برق خالص:**
  - **ریت: 250 kW پیوسته در 30 °C.**
  - با بازده‌های «انتظاری» همان سخت‌افزار در 770 °C حدود **285 kW** می‌دهد. پس 250 kW با **TIT ≈ 730 °C** به دست می‌آید (عمر بیشتر).
  - با بازده‌های «بدبینانه» برای 250 kW به **TIT ≈ 790 °C** نیاز است. این هنوز داخل ریت سخت‌افزار (850 °C) است.
- **راندمان برقی خالص** (بعد از همهٔ مصرف‌های جانبی، حتی بوستر گاز):
  - در 250 kW: **13.7 %**
  - در 770 °C: **14.6 %**
  - حالت بدبینانه در 30 °C: **12.0 %**؛ بدترین حالت (بدبینانه در 45 °C و 770 °C): **11.0 %**
  - هدف 10.8 % برآورده می‌شود: حاشیهٔ **3.8 واحد** (انتظاری)، **2.9** (کار در 250 kW) و **1.2** (بدبینانه در 30 °C).
- **گاز:** **190 m³/h** در 250 kW و 204 m³/h در 770 °C (LHV 34.5 MJ/m³). فشار لازم پشت اسکید **3.73 barg** است.
- **سخت‌افزار برای 850 °C** (حاشیهٔ هوای گرم و پیک):
  - مواد بخش داغ برای 850 °C انتخاب شده‌اند.
  - تطبیق نازل و توربین و حاشیهٔ سرج در هر دو دما چک شده است.
  - ژنراتور و مبدل **315 kW الکتریکی** دارند.
  - در 40–45 °C با TIT 842–850 °C، توان **300–311 kW** است.
- **ساده‌سازی اصلی نسبت به D2** (و نسبت به یک موتور جت کوچک):
  - **روتور کوتاه پشت‌به‌پشت** مثل CHRA توربوشارژر، به‌جای شفت بلند داخل محفظهٔ حلقوی.
  - **یک محفظهٔ احتراق قوطی‌ای عمودی** روی توربین.
  - **پوستهٔ فشاری سرد**: هوای کمپرسور (212 °C) دور قطعات داغ شناور جریان دارد.
  - **کلکتور متقارن محوری**: خم 90° + ۲۳ پرهٔ deswirl، بدون حلزونی و بدون لولهٔ رانش.
  - **یک نوع یاتاقان** (7008 هیبرید) در هر ۵ محل.
  - همهٔ پره‌های ساختنی **2.5D** هستند.
- **CAD:**
  - ۵۷ قطعه و **۰ هم‌پوشانی** در ۲۰۰ جفت بررسی‌شده (۷۳ سطح تماس).
  - ابعاد **4.37 × 1.90 × 2.25 m** (طول × عرض × ارتفاع از کف، بدون خانهٔ فیلتر).
  - جرم مدل **2.13 t**. با اقلام BOM خارج از CAD (کابینت درایو، روغن، گلیکول، گاز) **≈ 3.5 t**، بدون محفظهٔ آکوستیک.

## ۲. اعداد نقطهٔ طراحی (30 °C، 50 m، 770 °C، 35,000 rpm، بازده انتظاری)

| ایستگاه / مورد | مقدار |
|---|---|
| هوا | **3.000 kg/s** (2.62 m³/s جلوی کمپرسور)، رطوبت 0.0106 kg/kg |
| افت ورودی (فیلتر نیمه‌عمر + پلنوم + دهانه) | 252 Pa = **0.25 %** (تمیز 0.18 %، موقع تعویض 0.31 %) |
| کمپرسور | PR **4.00**، η_tt **0.80 در چرخه** (meanline 0.85)، T2 = 212 °C، P2 = 4.02 bar، توان 559 kW |
| مسیر پوستهٔ سرد + لاینر + ترانزیشن/پلنوم | `e_ducts`: 0.50 % + 3.0 % + 0.48 % = 4.0 %. چرخه محافظه‌کارانه 4.8 % فرض کرده ← ورود نازل **3.83 bar، 770 °C** |
| سوخت | **0.0411 kg/s = 204.0 m³/h**، 1955 kW (FAR 0.0138، η_b 0.995، تلفات حرارتی 0.6 %) |
| توربین | η_ts **0.81 در چرخه** (meanline 0.86)، PR_ts 3.95، توان 867 kW؛ خروج exducer: 198 m/s، p6 = 0.969 bar (Cp دیفیوزر 0.62) |
| اگزوز | **3.03 kg/s در 524 °C**؛ گرمای قابل‌بازیافت تا 90 °C: **1.45 MW** (CHP یا چیلر جذبی) |
| شفت به ژنراتور | **305.8 kW**، گشتاور 83 N·m (یاتاقان‌های هسته 2.4 kW کم شده) |
| ژنراتور / مبدل | تلفات 7.6 kW (η 0.976) / تلفات 9.0 kW (η 0.97) ← **برق ناخالص 289.2 kW** |
| مصرف جانبی | 4.3 kW: پمپ‌های روغن 0.7، پمپ گلیکول 0.4، فن‌های رادیاتور 1.1، فن محفظه 1.0، ECU/جرقه/شیرها 0.4، بوستر در 3.5 barg 0.7 |
| **برق خالص / راندمان** | **284.9 kW / 14.57 %** (ریت 250 kW با TIT 730 °C: 13.74 %، 190 m³/h) |
| ژنراتور: ریت پیوسته | 335 kW شفت = **315 kW الکتریکی** سمت شبکه (سقف کنترل) |

## ۳. توان در دماهای مختلف (برق خالص پس از همهٔ مصرف‌های جانبی؛ 50 m، 40 % RH)

**الف) TIT 770 °C، دور 100 %، سقف 315 kW الکتریکی.** بالاتر از سقف، TIT پایین می‌آید و دور ثابت می‌ماند.

| دمای هوا | 0 °C | 15 °C | **30 °C** | 40 °C | 45 °C |
|---|---|---|---|---|---|
| TIT (°C) | 684 (سقف) | 741 (سقف) | **770** | 770 | 770 |
| هوا (kg/s) / PR | 3.47 / 4.39 | 3.21 / 4.21 | **3.00 / 4.00** | 2.88 / 3.85 | 2.82 / 3.78 |
| **برق خالص (kW)** | **309.5** | **310.0** | **285.1** | **255.1** | **241.4** |
| بدون سقف ژنراتور (kW) | 396.8 | 336.6 | 285.1 | 255.1 | 241.4 |
| **گاز (m³/h)** | 207.0 | 210.4 | **204.1** | 194.3 | 190.0 |
| **راندمان برقی (%)** | 15.60 | 15.38 | **14.58** | 13.70 | 13.26 |
| اگزوز (°C / kg/s) | 440 / 3.49 | 492 / 3.24 | 524 / 3.03 | 531 / 2.91 | 534 / 2.85 |
| گرما تا 90 °C (kW) | 1343 | 1433 | 1446 | 1410 | 1393 |
| حاشیهٔ سرج (دور ثابت) | 21.8 % | 18.6 % | 17.0 % | 16.8 % | 16.7 % |

**ب) کار پیوسته با 250 kW** (پیشنهاد برای ۲۴/۷، عمر بالا): TIT همان مقداری است که 250 kW لازم دارد.

| دمای هوا | 0 °C | 15 °C | **30 °C** | 40 °C | 45 °C |
|---|---|---|---|---|---|
| TIT لازم (°C) | 630 | 679 | **730** | 764 | 781 |
| گاز (m³/h) | 185.8 | 187.3 | **189.9** | 192.2 | 193.6 |
| راندمان برقی (%) | 14.04 | 13.92 | **13.74** | 13.57 | 13.47 |
| اگزوز (°C) | 401 | 446 | 494 | 526 | 543 |
| حاشیهٔ سرج | 24.2 % | 21.0 % | 18.4 % | 17.0 % | 16.4 % |

**ج) پیک / هوای گرم با TIT تا 850 °C** (همان سخت‌افزار، سقف 315 kW):
- 30 °C: TIT 801، **310.5 kW**، 15.08 %
- 40 °C: TIT 842، **310.9 kW**، 14.82 %، اگزوز 586 °C
- 45 °C: TIT 850، **301.9 kW**، 14.53 %، 216.8 m³/h، اگزوز 596 °C، حاشیهٔ سرج 14.2 %

**د) حالت بدبینانه، با همان دبی طراحی** (η_c 0.78، η_ts 0.79، افت ورودی 0.4 %، لاینر 3.5 %، Cp دیفیوزر 0.50، فشار پشت CHP 1.8 kPa، تلفات +30 %):

| دمای هوا | 0 °C | 15 °C | 30 °C | 40 °C | 45 °C |
|---|---|---|---|---|---|
| برق خالص در 770 °C (kW) | 286.8 | 259.5 | 233.1 | 216.2 | 208.2 |
| راندمان (%) | 13.74 | 12.89 | 11.96 | 11.31 | 10.98 |

- با TIT 850 °C در 30 °C: 302 kW و 13.3 %.
- **پس 250 kW در 30 °C حتی با بدترین بازده‌ها با TIT ≈ 790 °C تأمین است.**

## ۴. بودجهٔ راندمان: چگونه به ≥ 10.8 % می‌رسیم

- برایتون ایده‌آل با گاز واقعی، PR 4 و 770 °C: **31.0 %**. طرح: **14.57 %**.
- سهم هر تلفات = راندمانی که اگر **فقط همان** تلفات حذف شود اضافه می‌شود:

| تلفات | سهم (واحد درصد) | توضیح |
|---|---|---|
| بازده توربین (η_ts 0.81) | 9.9 | بزرگ‌ترین بخش؛ هر 0.01 در η_t ≈ 0.5 واحد راندمان و ~10 kW |
| بازده کمپرسور (η_c 0.80) | 4.5 | هر 0.01 ≈ 0.2 واحد و ~7 kW |
| افت مسیر احتراق (4.8 %) | 1.24 | لاینر 3 % بزرگ‌ترین سهم |
| مبدل (3 %) | 0.46 | دیود + AFE |
| ژنراتور | 0.38 | باد 2.2، یاتاقان 1.7، آهن 1.6، مس 1.3، روتور 1.1 kW |
| فشار پشت CHP (1.2 kPa) | 0.34 | هر 1 kPa ≈ 0.28 واحد و ~2 % توان |
| نشتی آب‌بندها + هوای بافر | 0.24 | |
| جانبی‌ها | 0.22 | |
| احتراق + تلفات حرارتی پوسته | 0.16 | |
| یاتاقان‌های هسته | 0.12 | |
| افت ورودی (0.25 %) | 0.06 | در دبی ثابت. با کمپرسور واقعی دبی هم کم می‌شود، پس اثر واقعی بیشتر است |
| **دیفیوزر اگزوز** | **−1.37 اگر حذف شود** | دیفیوزر 10° (Cp 0.62) خودش 1.4 واحد سود دارد |

- **حاشیه تا 10.8 %:**
  - انتظاری 3.8 واحد
  - در 250 kW پیوسته 2.9 واحد
  - بدبینانه در 30 °C 1.2 واحد
  - بدبینانه در 45 °C 0.2 واحد
- **مقایسه با اسکن کاربر** (`concept_study.cycle`، PR 4، 850 °C، 0.78/0.84): راندمان شفت 14.8 % و برقی 13.4 %.
  - مدل ما با گاز واقعی، دیفیوزر واقعی، ژنراتور 0.976 و مبدل 0.97 در 770 °C و 0.80/0.81 به **14.6 %** می‌رسد.
  - همان ورودی‌ها در `concept_study` فقط 11.5 % می‌دهند. دلیل: cp_g 1148، η_b 0.97 + 2 % تلفات، ژنراتور × مبدل 0.912 و فشار خروج 1.02 بدون دیفیوزر.

## ۵. چیدمان (از جلو به عقب، ENG mm)

**مسیر هوا:**
1. خانهٔ فیلتر (کار تأسیسات) روی رابط 3×3 سلول بالای پلنوم
2. پلنوم 1.9 × 1.9 × 1.3 m (سرعت 0.7 m/s)
3. دور پاد ژنراتور
4. دهانهٔ بیضوی
5. کمپرسور
6. ۱۷ پرهٔ دیفیوزر
7. خم 90°
8. ۲۳ پرهٔ deswirl
9. حلقه r 261..305
10. **پوستهٔ فشاری سرد** دور پلنوم داغ
11. بالا رفتن در حلقهٔ محفظهٔ احتراق تا گنبد
12. لاینر
13. ترانزیشن مخروطی Ø210 → Ø270
14. پلنوم داغ ۳۶۰°
15. ۱۹ پرهٔ نازل
16. توربین
17. حلقهٔ شراود/دیفیوزر
18. مخروط 10° به طول 1074
19. زانوی پره‌دار DN450
20. فلنج DN450 PN6 رو به بالا، به CHP

| بخش | x (mm) | نکته |
|---|---|---|
| پلنوم ورودی | −2060 … −150 | جعبهٔ استیل 3 mm؛ دیوارهٔ عقب = فلنج دهانهٔ کمپرسور |
| پاد ژنراتور (روی دو زین، داخل پلنوم) | −900 … −370 | OD 320؛ یاتاقان‌ها x −830 و −400؛ quill Ø30 تا x −117 |
| محافظ quill (ثابت، Ø76 = ادامهٔ هاب) | −370 … −98 | |
| پروانهٔ کمپرسور D2 270 | −94 … +30 | لبهٔ ورود x −81 (Ø173/76)؛ نوک x 0 |
| دیفیوزر / خم / deswirl / پوستهٔ بیرونی | −7 … +115 | پایه‌های ثابت موتور: x 50..95، y ±(314..400) |
| محفظهٔ یاتاقان (هستهٔ کارتریج) | 45 … 235 | جفت tandem جلو x 60، یاتاقان عقب x 205 |
| سپر حرارتی، نازل، چرخ توربین D4 288 | 235 … 360 | پشت چرخ x 250، خروج exducer x 342 |
| پوستهٔ فشاری سرد OD 760 | 115 … 480 | پایه‌های لغزنده x 270..300 |
| محفظهٔ احتراق (عمودی، محور x 285) | z 440 … 1300 | DN300، لاینر Ø210 × 588 |
| دیفیوزر اگزوز + زانو | 485 … 2270 | خروجی فلنج DN450 در x 1950، z 492 |
| شاسی RHS 200×100 روی ۸ ضربه‌گیر | −2100 … 2250 | کف z −950 |

## ۶. اجزای اصلی، ساخت/خرید و تأمین‌کننده‌ها (بدون آمریکایی)

| جزء | انتخاب | خرید/ساخت | کاندیدا (تأیید با استعلام) |
|---|---|---|---|
| **چرخ کمپرسور** | Al 2618 فورج + فرز ۵محور، D2 ≈ 270 mm، 9+9 پره backswept −38°، Ns 0.78، M1t,rel 1.04، U2 493 m/s | **خرید** (قطعهٔ یدکی TC) و سوراخ H6 روی شفت Ø40 | Accelleron TPS52/57-F (CH)، MAN ES / PBS Turbo TCR16/18 (DE/CZ)، MHI MET18–22 (JP)، سازندگان چینی |
| **چرخ توربین** | ریختگی IN713LC (یا K418 / MAR-M247)، D4 ≈ 288، exducer 232/75، ۱۲ پره، U4 528 m/s | **خرید** + جوش اصطکاکی/EB به شفت ما توسط سازنده | Accelleron TPS57/61-F، MAN/PBST TCR18/20، MHI، IHI (JP)، Changzhou E&E Turbo-Power (CN) |
| **ژنراتور** | PM دوقطبی 335 kW، روتور Ø120 (220 m/s)، Sm2Co17 + غلاف کربن 6 mm، استاتور 125/240 × 190، ۲۴ شیار | طراحی ما؛ **«قطعات فعال» (استاتور سیم‌پیچی‌شده + روتور آهنربا) خرید** | e+a Elektromaschinen (CH)؛ گزینهٔ کامل: Safran GENeUS 300 (FR، 300 kW، 550–800 VDC، ~40k rpm؛ ریت ۲۴/۷ و صادرات پرسیده شود) |
| **مبدل** | پل دیودی ← باس DC 620–850 V ← **AFE صنعتی 400 V** + LCL؛ اینورتر استارت ≤ 500 Hz؛ chopper ترمز | **خرید** | ABB ACS880-207 / -104 (FI/CH)، Danfoss VACON NXA/NXI (DK/FI)، Siemens SINAMICS S120 (DE)، Ingeteam (ES)، Inovance / INVT (CN) |
| **یاتاقان‌ها** | ۵ × هیبرید 7008 (40×68×15): جفت tandem 25° جلو، 15° عقب، ژنراتور 25° + 15°؛ 78–82 % حد دور روغن | **خرید** | Schaeffler FAG HCB7008 (DE)، SKF (SE)، GMN (DE)، NSK (JP)، ZWZ/LYC (CN) |
| محفظهٔ احتراق | لولهٔ DN300 + فلنج‌های PN10 (استاندارد)، لاینر 2.4951، سوئیرلر محوری، لانس گاز مرکزی | ساخت (لوله/فلنج خرید) | ورق VDM Metals (DE)؛ شمع NGK (JP) + کویل MOTORTECH (DE)؛ UV: DURAG / Siemens (DE) |
| نازل ۱۹پره، پلنوم داغ، شراود | 2.4665 (alloy X) و 2.4856 | ساخت | VDM Metals (DE)، Aubert & Duval (FR) |
| روغن، گلیکول، گاز | پمپ‌ها، فیلتر 10 µm، آکومولاتور rundown، کولر صفحه‌ای، dry cooler 35 kW، قطار گاز EN 161 + بوستر on-demand | خرید | Rickmeier/KRACHT، HYDAC (DE)؛ Alfa Laval (SE)، Kelvion (DE)؛ Güntner (DE)، LU-VE (IT)؛ Dungs (DE)، Pietro Fiorentini، Madas (IT)؛ بوستر Haug (CH)، Mehrer (DE) |
| فیلتر هوا | ۹ × (G4 پنل + F7 V-cell 592×592) با 31 % دبی اسمی | خرید | Camfil (SE)، Freudenberg Viledon (DE)، MANN+HUMMEL (DE) |

**آمریکایی‌های حذف‌شده عمداً:**
- Napier: از 2013 متعلق به Wabtec آمریکا
- Garrett، BorgWarner، Cummins Holset، Calnetix
- Arnold Magnetics
- Haynes و Special Metals: به‌جای آن‌ها با شمارهٔ مواد DIN از VDM خرید می‌کنیم
- Honeywell / Elster / Kromschröder، Maxitrol
- SWEP (متعلق به Dover)
- Unifrax
- Woodward / Altronic

**دادهٔ تأییدشده از بازار:**
- Accelleron TPS-F: موتورهای 400–3300 kW، PR تا 5.2 با چرخ آلومینیومی، راندمان کمپرسور «بیش از 84 %»، توربین mixed-flow با رینگ نازل، یاتاقان لغزشی روی SFD. نمودار دبی حجمی، 2.6 m³/s را بین TPS52 و TPS57 می‌گذارد.
- MAN TCR: موتورهای 390–6700 kW، PR 4.7 تا 5.4. TCR22 برای ورودی توربین 650 °C ریت شده است.
- **قطر دقیق چرخ‌ها منتشر نشده و اعداد ما «تخمین» است.**

## ۷. ساده‌سازی برای CNC و مونتاژ آسان

1. **روتور مثل CHRA توربوشارژر**، دو چرخ overhung و دو محل یاتاقان بین آن‌ها:
   - دهانهٔ یاتاقان 145 mm است. نیازی به شفت بلند داخل محفظهٔ حلقوی نیست؛ آن در این اندازه زیر دور کار مود خمشی می‌داد.
   - «کارتریج هسته» (محفظهٔ یاتاقان + روتور + صفحهٔ پشت + سپر حرارتی) یک واحد بالانس‌شده و قابل تعویض است.
2. **قطعات تقریباً همه دوار-متقارن هستند** و با تراش CNC از دیسک/حلقهٔ فورج یا میله ساخته می‌شوند:
   - درپوش ورودی، پوستهٔ بیرونی، صفحهٔ پشت، محفظهٔ یاتاقان، کارتریج‌ها
   - پوستهٔ پاد و سپرهای انتهایی، شراود، نازل
3. **همهٔ پره‌های ساختنی 2.5D هستند:**
   - ۱۷ پرهٔ گوه‌ای دیفیوزر و ۱۹ پرهٔ نازل: فرز ۳محور، پاکت‌کاری
   - ۲۳ پرهٔ deswirl: محور چهارم
   - **فرز ۵محور فقط برای چرخ‌های خریدنی** لازم است.
4. **بدون حلزونی ریختگی و بدون لولهٔ رانش:** هوای کمپرسور با یک خم متقارن و پره‌های deswirl مستقیم وارد پوستهٔ سرد می‌شود. یک لوله، یک bellows و دو زانوی DN250 حذف شد.
5. **پوستهٔ فشاری سرد:**
   - قطعات داغ (پلنوم، نازل، ترانزیشن، لاینر) ورق نازک شناورند و فقط Δp محفظهٔ احتراق (~0.12–0.2 bar) را می‌بینند.
   - مخزن تحت فشار در 212 °C از ورق P265GH رول‌شده و لوله و فلنج استاندارد DN300 ساخته می‌شود.
   - هیچ ظرف تحت فشاری در 850 °C نداریم.
6. **یک نوع یاتاقان، یک قطر کارتریج SFD (84) و یک O-ring در هر ۵ محل.**
7. **ژنراتور روی پایه‌های خودش** با تراز معمولی مثل هر ماشین کوپل‌شده (شیم و jack bolt):
   - کوپلینگ: سوکت AF24 که روی شش‌گوش crowned دماغهٔ شفت هسته **می‌لغزد** (لقی محوری ±1 mm).
   - بدون تنظیم و بدون کوپلینگ گران.
   - quill با فلنج پیچ می‌شود و قطعهٔ یدکی ساده است.
8. **فرایندهای غیرمعمول فقط جایی که لازم است:**
   - جوش اصطکاکی/EB چرخ توربین: کار سازندهٔ چرخ، به روش توربوشارژر
   - نیتراته‌کردن شش‌گوش‌ها: سایش
   - پیچیدن غلاف کربن: نگه‌داشتن آهنربا در 220 m/s
   - ورق 0.20 mm: تلفات آهن در 583 Hz
   - بالانس G1: دور 35k
   - ساچمهٔ Si3N4 یاتاقان‌ها: خرید

## ۸. ترتیب مونتاژ و باز کردن

**مونتاژ:**
1. **شفت و چرخ:** سازنده چرخ توربین را به شفت E-R101 جوش می‌دهد. ژورنال‌ها نسبت به چرخ سنگ زده می‌شوند و spin test در 120 % (42,000 rpm) انجام می‌شود.
2. **کارتریج هسته (عمودی، توربین پایین):**
   - سپر حرارتی را از جلو روی شفت بیندازید تا پشت چرخ.
   - کارتریج SFD عقب و فنر موجی را از جلو در محفظهٔ یاتاقان بگذارید.
   - شفت را با فشرده‌کن رینگ‌های پیستونی از عقب وارد کنید. سپر را به فلنج عقب بپیچید (12 × M10 A286).
   - روی شفت به ترتیب: یاتاقان عقب (IR گرم، js5)، بوش فاصله، کارتریج جلو و جفت tandem، و حلقهٔ slinger.
   - صفحهٔ پشت (12 × M12)، پروانهٔ کمپرسور (H6/h5، گرم) و **مهرهٔ M33 با پیش‌بار 60 kN** (کشش هیدرولیکی).
   - بالانس کارتریج کامل (روش VSR توربوشارژر، G1). load washer تراست نصب شود.
3. **پشتهٔ داغ:** نازل روی سپر و شراود با شیم برای لقی نوک 0.55 mm. پلنوم داغ از عقب روی لبهٔ نازل و شراود می‌نشیند.
4. **پوسته‌ها:**
   - پوستهٔ بیرونی روی پایه‌های ثابت، سپس کارتریج هسته از عقب در آن، سپس درپوش ورودی (لقی نوک 0.45 mm با شیم).
   - پوستهٔ سرد از عقب روی پشتهٔ داغ، با 16 × M20 به پوستهٔ بیرونی. پدهای آن روی پایه‌های لغزنده قرار می‌گیرند.
5. **محفظهٔ احتراق:**
   - پوستهٔ DN300 روی stub.
   - ترانزیشن از بالا داخل دهانهٔ پلنوم (رینگ پیستونی).
   - لاینر با سه آویز، سوئیرلر، لانس، درپوش، شمع و UV.
6. **اگزوز:** مخروط با collar لغزان روی دنبالهٔ شراود، روی دو زین. زانو روی زین سوم. فلنج DN450 به CHP.
7. **پاد ژنراتور (جدا روی میز):**
   - ژاکت در پوسته؛ استاتور shrink شده در ژاکت.
   - روتور با یاتاقان‌ها و کارتریج‌ها؛ quill پیچ می‌شود.
   - spin test (42k) و تست الکتریکی (back-EMF، عایق).
   - روی دو زین داخل پلنوم: تراز با ساعت اندیکاتور (≤ 0.1 mm و ≤ 0.05°)، لغزاندن سوکت روی شش‌گوش، کنترل لقی ±1 mm، پیچ‌کردن فلنج محافظ.
8. **پلنوم و قاب فیلتر:** شاسی، ضربه‌گیرها، سپس سیستم‌های جانبی (روغن، گلیکول، قطار گاز، کابینت درایو) و کابل‌کشی.

**باز کردن برای سرویس:**

| کار | روش | زمان (تخمین) |
|---|---|---|
| **برداشتن ژنراتور** | باز کردن درِ پلنوم، فلنج محافظ و پیچ‌های زین. پاد ~150 mm جلو می‌لغزد (سوکت از شش‌گوش خارج می‌شود). بیرون آوردن از در یا از دهانهٔ فیلتر با جرثقیل | 2–3 h |
| **لاینر و لانس** | باز کردن درپوش DN300؛ درپوش + لانس + لاینر با هم بالا می‌آیند. پوسته و موتور دست نمی‌خورند | ~1 h |
| **بخش داغ** | برداشتن مخروط اگزوز (collar لغزان)، باز کردن فلنج جلوی پوستهٔ سرد و لغزاندن آن ~400 mm به عقب. پلنوم داغ، شراود و نازل از روی فلنج محفظهٔ یاتاقان برداشته می‌شوند. چرخ توربین روی روتور می‌ماند | ~1 شیفت |
| **کارتریج هسته** | پس از برداشتن بخش داغ: کارتریج کامل از عقبِ پوستهٔ بیرونی بیرون می‌آید. تعویض با کارتریج یدکی بالانس‌شده | ~1 شیفت |

## ۹. تطبیق 770/850 °C، حاشیهٔ سرج و عمر

- **تطبیق:**
  - گلوگاه نازل ثابت است (۱۹ پره، گلوگاه ~12 mm، M3 0.93).
  - با بالا رفتن TIT در دور ثابت، کمپرسور روی خط دور بالا می‌رود: دبی −1.5 %، PR از 4.00 به 4.09.
  - تابع دبی توربین تقریباً choked است.
- **حاشیهٔ سرج** (دور ثابت، (PR_s − PR)/PR، نقشهٔ عمومی TC با 14 % افزایش فشار تا سرج — **تخمین تا نقشهٔ سازنده**):

| حالت | حاشیهٔ سرج |
|---|---|
| 30 °C، 770 °C | **17.0 %** |
| 30 °C، 850 °C (بدون سقف) | **14.4 %** |
| 30 °C، سقف 315 kW (TIT 801) | 15.9 % |
| 45 °C، 850 °C | 14.2 % |
| هوای سرد با TIT کاهش‌یافته | 18.6–24 % |

- **قانون کنترل:** سقف توان با **کم کردن TIT** گرفته می‌شود، نه با کم کردن دور.
  - کم کردن دور در هوای سرد با T3/T1 بالا حاشیه را به ~5–10 % می‌رساند.
  - دور فقط برای بار جزئی کم می‌شود.

**عمر بخش داغ (تخمین، `e_turbine.json` و `e_combustor.json`):**

| قطعه / سازوکار | TIT 770 °C | TIT 850 °C | پایه |
|---|---|---|---|
| چرخ توربین، خزش (IN713LC، LMP، SF 1.25 روی تنش): ریشهٔ پره 544 MPa و لبهٔ دیسک 353 MPa | فلز 560/603 °C ← **≫ 100 kh** (محدود به LCF و تعداد استارت) | فلز 624/666 °C ← ~0.9 Mh | T0rel ورود روتور 628 / 691 °C |
| پرهٔ نازل، خزش (alloy X، SF 1.5) | ~8 Mh | **58 kh** | گاز اوج با PF 0.15: 854 / 946 °C |
| پرهٔ نازل، اکسایش/TMF (نصف شدن به‌ازای هر 30 K) | **~80 kh** | **~9.5 kh** | |
| لاینر، اکسایش/TMF (دیواره ~745 / 812 °C) | **~69 kh** | ~15 kh | |
| **اورهال بخش داغ** | **~60–70 kh** (بازرسی بوروسکوپ هر 8000 h) | **~10 kh** اگر پیوسته باشد | هر ساعت در 850 °C ≈ **7 ساعت** در 770 °C برای لاینر و نازل؛ برای خزش چرخ ≈ 97 ساعت ولی تعیین‌کننده نیست |

- **نتیجه:** با کار پیوسته در 730–770 °C عمر ~60–80 kh در دسترس است. اعداد کاربر (50–80 kh) تأیید می‌شود.
- 850 °C فقط برای ساعت‌های گرم یا پیک است (مثلاً 1000 h در سال ≈ 7000 h معادل).

## ۱۰. روتور، یاتاقان، تراست و کوپلینگ (`e_rotor.json`)

- **جرم روتورها:** هسته 26.6 kg (چرخ توربین 15، کمپرسور 5.6) و ژنراتور با quill 25.0 kg.
- **سرعت‌های بحرانی** (FE تیر + ژیروسکوپی، SFD با O-ring 3 N/µm، پین شش‌گوش):
  - همهٔ مودهای صلب **≤ 14.3k** (≤ 41 %) هستند.
  - اولین مود خمشی **53.7k** است، یعنی **+54 %** بالای دور کار.
  - **هیچ مودی در بازهٔ 55–108 % نیست** (با 1.5 تا 6 N/µm هم همین).
  - تحلیل میرا در 35k: نزدیک‌ترین مود بالا 45.7k با ζ 0.033.
- **تراست محوری:**
  - مقادیر: 770 °C: **−205 N**؛ 850 °C: −602 N؛ دور آرام: −182 N. همیشه رو به جلو.
  - فنر 300 N روی یاتاقان عقب هر دو محل را بارگذاری می‌کند.
  - تنظیم با شعاع labyrinth پشت پروانه (r 35؛ ±5 mm ≈ ∓100 N) و اندازه‌گیری با load washer.
- **یاتاقان‌ها** (7008 هیبرید، n·dm 1.89e6، 78–82 % حد دور روغن):

| محل | L10m (aISO 3) |
|---|---|
| جفت جلوی هسته | ≥ 390 kh (در 850 °C پیوسته 79 kh) |
| عقب هسته | 109 kh |
| ژنراتور | 146–191 kh |

  - اصطکاک ~0.8 kW برای هر یاتاقان.
  - **برنامه: تعویض هر ۵ عدد در 24,000 h** با روند ارتعاش.
  - **آکومولاتور rundown اجباری است:** ایستادن از 35k در قطع برق 3–5 دقیقه طول می‌کشد.
- **quill:** Ø30 × 208.
  - تنش برشی τ 17 MPa نامی و 86 MPa در اتصال کوتاه (×5).
  - مود خمشی 83k.
  - تماس شش‌گوش AF24: 26 MPa نامی و 132 MPa در خطا (نیتراته).
  - گشتاور ژنراتور فقط از شش‌گوش وارد شفت می‌شود، نه از مهره (قانون D2).
- **شفت هسته:**
  - گشتاور توربین در پیک 265 N·m، τ در Ø40 = 21 MPa.
  - گیرهٔ 60 kN ظرفیت اصطکاکی 423 N·m دارد، در برابر 152 N·m گشتاور کمپرسور.

## ۱۱. ژنراتور و تبدیل توان (`e_pmg.json`)

| مورد | مقدار |
|---|---|
| ریت | 335 kW شفت پیوسته (= 315 kW الکتریکی)، 2 قطب، **583 Hz**، 91 N·m |
| روتور | Ø120 (220 m/s)، آهنربای Sm2Co17 80/108 × 190 روی بدنهٔ یکپارچهٔ Ø80، غلاف کربن 6 mm (تنش 688 MPa در 100 % و 991 MPa در 120 %؛ SF 1.41) |
| استاتور | 125/240 × 190، ۲۴ شیار، ورق 0.20 NO20، Litz دو مسیر موازی، ژاکت گلیکول 30 L/min (ΔT 2 K) |
| الکتریکی | B گپ 0.63 T، E_LL 608 V، I 335 A، J 5.5 A/mm²، x 0.46 pu |
| تلفات (kW) | مس 1.3، آهن 1.6، روتور 1.1، باد 2.2، یاتاقان 1.7 ← η 0.977 (الکترومغناطیسی 0.988) |
| تبدیل | پل دیودی (از ~79 % دور هدایت می‌کند) ← DC 617–635 V در بار کامل و 820 V بی‌بار ← AFE 400 V. استارت: اینورتر ≤ 500 Hz تا 55 % دور (روشن‌شدن ~22 %) |

- **چرا 35,000 rpm و دوقطبی؟**
  - فرکانس خروجی ماشین زیر **600 Hz** می‌ماند.
  - مبدل‌های فرکانس ≥ 600 Hz کالای دو منظوره هستند (فهرست Wassenaar، 3A225)، و درایوهای صنعتی استاندارد هم ≤ 500–599 Hz دارند.
  - در طرح ما هیچ مبدلی بالای 600 Hz کار نمی‌کند: پل دیودی است و خروجی 50 Hz است.
  - Ns کمپرسور (0.78) و U/C0 توربین (0.63) هم در همین دور خوب هستند.

## ۱۲. ابعاد و جرم (`e_cad_summary.json`)

- **ابعاد کل:** **4370 × 1900 × 2250 mm** (طول شاسی تا زانو × عرض پلنوم × ارتفاع از کف تا اسکنر UV).
  - خانهٔ فیلتر و کلاهک روی رابط 1830 × 1830 حدود 0.6–0.9 m اضافه می‌کند.
  - محور 950 mm بالای کف است.

| زیرسیستم | جرم (kg) | زیرسیستم | جرم (kg) |
|---|---|---|---|
| ROTOR | 27 | GENERATOR (با دو زین 81 kg) | 245 |
| COMPRESSOR (کاور، صفحهٔ پشت، پوستهٔ بیرونی) | 143 | EXHAUST | 139 |
| BEARING | 47 | INTAKE (پلنوم 3 mm + قاب) | 369 |
| TURBINE (سپر، نازل، شراود، پلنوم، پوستهٔ سرد) | 192 | FRAME | 859 |
| COMBUSTOR | 104 | **جمع CAD** | **2125** |

- **خارج از CAD در BOM: ~1.39 t.**
  - کابینت درایو 450
  - dry cooler گلیکول 180
  - بوستر 120
  - واحد روغن ~110
  - فیلترها 90
  - کابل 60
  - عایق 45، و بقیه
- **جمع ≈ 3.5 t** بدون محفظهٔ آکوستیک (~1.5 t، طراحی نشده) و باتری اختیاری.
- **BOM:** ۹۱ ردیف (۵۷ قطعهٔ CAD + ۳۴ ردیف دیگر)؛ ۴۷ ساخت، ۴۲ خرید، ۲ سرویس.

## ۱۳. برنامهٔ تست (خلاصه)

1. **تست قطعات:**
   - spin چرخ‌ها 120 % و روتور ژنراتور 42k
   - بالانس کارتریج هسته (VSR) و پاد
   - سفتی O-ringهای SFD
   - تست نشتی قطار گاز
   - تست دبی لانس
   - تست لاینر روی سکوی احتراق اتمسفری و تحت فشار
2. **موتورکردن با اینورتر استارت تا 55 %** بدون سوخت: روغن، ارتعاش، عبور از مودهای ≤ 14k، تراست (load washer)، Δp ورودی.
3. **روشن‌شدن در ~22 %**، سپس افزایش دور با TIT ≤ 650 °C، سپس بار مقاومتی با TIT 700 → 730 → 770 °C.
   - اندازه‌گیری: نقشهٔ کمپرسور (خط کار و سرج)، Cp دیفیوزر، الگوی دما در دهانهٔ نازل، η.
4. **۱۰۰ h** در 250 kW، سپس بازرسی بوروسکوپ؛ **۱۰۰۰ h** با پایش، سپس کار ۲۴/۷. 850 °C فقط پس از تأیید الگوی دما و عمر.

## ۱۴. ریسک‌ها و کارهای باز

1. **تأمین چرخ‌ها:**
   - قطرها و پره‌ها تخمین هستند.
   - سازندگان TC ممکن است چرخ را برای کاربرد غیر توربوشارژر نفروشند.
   - داده‌های لازم: حداکثر دور مجاز در دمای فلز ~700 °C، burst/FEA، Campbell (۱۹ پرهٔ نازل، ۱۷ پرهٔ دیفیوزر، ۲۳ پرهٔ deswirl، ۱/rev داغ از قوطی تکی)، مدارک مواد.
   - **بدیل:** ریخته‌گری به نقشهٔ ما توسط سازندهٔ چینی یا ریخته‌گر کاربر.
2. **بازده چرخ‌ها خارج از نقطهٔ طراحی خودشان:**
   - چرخه 0.80 و 0.81 فرض کرده و meanline 0.85 و 0.86 می‌دهد.
   - حالت بدبینانه هنوز ≥ 11 % است.
   - **نقشهٔ واقعی کمپرسور و توربین لازم است.** حاشیهٔ سرج فعلاً از نقشهٔ عمومی است.
3. **قوطی تکی ← پلنوم ۳۶۰°:** نایکنواختی محیطی دما (hot streak) روی نازل و چرخ. **CFD با OpenFOAM** لازم است. طراحی سخت‌افزار با PF 0.15 است.
4. **ژنراتور:**
   - FEM الکترومغناطیسی لازم است: تلفات روتور با هارمونیک‌های پل دیودی، دمای آهنربا، اندوکتانس.
   - **پنجرهٔ ولتاژ DC (617–820 V) برای AFE 400 V تنگ است.** بدیل‌ها: سیم‌پیچی 12 پالسه، یا AFE 690 V + ترانس (−1 % راندمان).
5. **یاتاقان غلتشی در 35k برای ۲۴/۷:**
   - عمر وابسته به تمیزی روغن و تراست است.
   - **آکومولاتور rundown، سنسور ارتعاش و load washer اجباری‌اند.**
   - گزینهٔ نسل بعد: یاتاقان مغناطیسی یا foil.
6. **NOx:**
   - منطقهٔ اولیهٔ نفوذی با φ 0.65 و 1545 °C ← **60–120 ppm @15 % O2 (تخمین)**.
   - حد مجاز محل باید روشن شود. نسخهٔ بعد: سوئیرلر پیش‌مخلوط فقیر (≤ 25 ppm).
7. **فشار گاز:** پشت اسکید 3.73 barg لازم است. در حداقل 3.5 barg بوستر on-demand (~0.7 kW) کار می‌کند. **فشار واقعی سایت (gauge) تأیید شود.**
8. **جزئیات بعدی:**
   - اتصال صفحهٔ پشت به پوستهٔ بیرونی: چند پرهٔ deswirl ضخیم با پیچ شعاعی
   - مسیر لوله‌های روغن از داخل پره‌های بالا و پایین
   - پیچ‌ها، گشتاورها و O-ringها در مدل
   - محفظهٔ آکوستیک و اطفای حریق
   - خانهٔ فیلتر
   - هماهنگی فشار پشت CHP (≤ 1.2 kPa) با تأسیسات
9. **وزن پلنوم:** 369 kg، با ورق 3 mm. با ورق 2 mm و تقویت‌کننده به ~250 kg می‌رسد.
10. **صادرات و تحریم:** درایوها، AFE، یاتاقان‌ها و آهنرباها از تأمین‌کنندگان اروپایی، ژاپنی و چینی هستند. برای هر کدام بدیل چینی هم آمده است: Inovance/INVT، ZWZ/LYC و Ningbo.

## ۱۵. commitها (شاخهٔ main-smmbai)

- `f715c37` — چرخه: نقطهٔ طراحی، جدول دما، تطبیق، بودجهٔ راندمان
- `4904fc6` — اندازه‌گذاری اولیه: کمپرسور، توربین، محفظهٔ احتراق، کانال‌ها، ژنراتور، روتور
- `3b05f8e` — CAD: ۵۷ قطعه، ۰ هم‌پوشانی
- commit این سند و BOM
