ahmadreza221/aurora-cchp/docs/variant_c/00_concept.md

# نسخه‌ی C: توربو‌ژنراتور جمع‌وجور (چیدمان توربوپراپ، بدون استفاده از گرمای اگزوز)

تاریخ: ۲۰۲۶-۱۰-۲۳ · درخواست کاربر: «مثل KingTech K-60TP جمع‌وجور، برای کار دائم، برق برای شبکه، ساختار همان توربین نسخه‌ی اول».
طرح‌های A و B دست نخورده‌اند. سند فیوژن: **GR180-C Compact turbo-generator** (Default Project).

## ۱. چیدمان (از جلو به عقب، محور افقی)

| بخش | منبع | توضیح |
|---|---|---|
| هسته‌ی GR180 (دماغه، ورودی، کمپرسور، دیفیوزر، تونل، یاتاقان‌های 608، استارتر) | v13A | بدون تغییر |
| توربین و NGV هسته | E1 | بدون تغییر (IN713LC، شفت جوشی 42CrMo4) |
| محفظه‌ی احتراق ساده | E2-B | ۷ انژکتور گاز، ورودی هوای 165 °C، سوخت ~6 g/s |
| کانال رابط + توربین قدرت (FPT) + دیفیوزر شعاعی | E3 | بدون تغییر |
| **اگزوز جمع‌وجور** | `cad/variant_b/e3b_exhaust.py` با `sim/variant_c/c_exhaust_results.json` | جعبه‌ی مربعی 336 mm + کلاهک مستطیل‌به‌گرد + خروجی **DN200 رو به بالا** |
| **ژنراتور ۱ (PMG ۳۰ kW، ۶۰k rpm) جای گیربکس** | E3 | مستقیم روی شفت FPT، بدون گیربکس؛ یکسوساز + اینورتر برای شبکه |
| **شاسی کوتاه** | `cad/variant_c/c_frame.py` | سه پایه‌ی قبلی تا z −250 کوتاه شدند + دو ریل RHS 60×40 |

## ۲. ابعاد و جرم (تقریبی)

- طول: ~530 mm (دماغه تا درپوش ژنراتور) · ارتفاع: ~700 mm (زیر ریل تا فلنج خروجی) · محور تا زیر ریل 310 mm.
- جرم: ~75–85 kg (اگزوز با عایق ~32 kg، بخش E3 ~20 kg، E2-B ~10 kg، هسته و E1 ~6 kg، شاسی ~15 kg).
- مقایسه: کلکتور طرح A/B به‌تنهایی Ø470 × 375 mm بود.

## ۳. عملکرد (پیوسته، TIT 800 °C، 115k rpm)

| هوای ورودی | توان شفت FPT | برق خالص (PMG + اینورتر − مصرف جانبی) | گاز | راندمان برق |
|---|---|---|---|---|
| 15 °C | ~30.7 kW | **≈ 28 kW** | 31.6 m³/h | ~9 ٪ |
| 30 °C | ~26.2 kW | **≈ 24 kW** | 28.9 m³/h | ~8.5 ٪ |
| 40 °C | ~23.3 kW | **≈ 21 kW** | 27.3 m³/h | ~8 ٪ |

- افت فشار اگزوز جمع‌وجور 0.89 ٪ (حد سرعت جانبی کمی بالاتر از طرح B پذیرفته شد)؛ هزینه‌اش ~0.3–0.5 kW نسبت به جعبه‌ی بزرگ‌تر.
- اگزوز ~605 °C دور ریخته می‌شود؛ خروجی DN200 بعداً می‌تواند به آبگرم‌کن/بویلر برود.

## ۴. چرا بدون گیربکس

گیربکس ۲۰:۱ با ورودی ۶۰k rpm برای ۳۰ kW پیوسته سفارشی و پرسرویس است و ژنراتور ۳۰۰۰ rpm حدود ۱۵۰–۲۰۰ kg است؛ PMG مستقیم هم‌اندازه‌ی گیربکس قرمز K-60TP است.

## ۵. موارد باز (برای ساخت)

1. هم‌پوشانی کوچک داخلی 0.5 cm³ بین بدنه‌ی اگزوز و واحد عقب (E3B-110/112) باید رفع شود.
2. ضخامت عایق 70 mm برای پوسته‌ی 60 °C در محفظه‌ی 40 °C؛ اگر داخل جعبه‌ی تهویه‌دار باشد می‌شود نازک‌تر کرد.
3. لوله‌ی روغن، گاز، سیم‌کشی و جعبه‌ی تقسیم هنوز مدل نشده‌اند (مثل لوله‌های عکس K-60TP).
4. پایه‌ها فعلاً از طرح‌های قبلی کوتاه شده‌اند؛ یک شاسی یکپارچه‌ی تمیز در مرحله‌ی بعد.
