ahmadreza221/aurora-cchp/docs/electrical/00_electrical_control_architecture.md

# GR180-CCHP — معماری سیستم برق و کنترل (سند اصلی)

تاریخ: ۲۰۲۶-۱۰-۲۱ · وضعیت: **پیش‌نویس برای تأیید کاربر** · مبنا: `docs/03_system_spec.md` (v3.2) و `docs/02_concept_decision.md`

## ۰. نقشهٔ اسناد

| فایل | محتوا |
|---|---|
| **00** (همین) | مبنای طراحی، معماری بردها و تابلوها، شبکهٔ ارتباطی، تصمیم‌های کلیدی، هم‌خوانی با سند 03، **سؤال‌های باز** |
| [01_power_single_line.md](01_power_single_line.md) | تک‌خطی قدرت (rev 3): اینورتر هیبرید HV با **شبکهٔ پشتیبان خودکار و zero-export**، ATS و bypass، رفتار انتقال، باتری ۲۰ kWh، باس 48 V؛ حفاظت؛ ترمز FPT؛ بارهای واقعی و surge هر فاز؛ زمین با چاه ارت، صاعقه و SPD؛ صادرات بعدی |
| [02_io_list.md](02_io_list.md) + [02_io_list.csv](02_io_list.csv) | ~۱۹۶ نقطهٔ I/O در گروه‌های A تا L (L = آتش)، با برد و کانال و بودجهٔ کانال هر برد (تولیدشده از `calc/io_list.py`) |
| [03_control_philosophy.md](03_control_philosophy.md) | لایه‌های کنترل و ایمنی، ماشین حالت، توالی‌ها، گاورنرها، **load following با zero-export**، خاموشی‌ها، جدول trip (T01–T52)، SMCU (NXP S32K144)، SR1 (SI01–SI20، O1–O7)، life counter |
| [04_component_selection.md](04_component_selection.md) | **قطعات اروپایی** (جدول جایگزینی قطعات آمریکایی)، بردها با شمارهٔ LCSC، تجهیزات میدانی، اینورتر و باتری، پایش از راه دور (IP ثابت، Telegram و SMS)، آتش |
| [05_cable_schedule.md](05_cable_schedule.md) | جدول کابل‌ها: بام ↔ اتاق برق (~۳۰ m)، شبکه و ATS، باتری‌ها، چاه ارت و هم‌بندی، کابل‌های مقاوم در برابر آتش |
| [06_energy_management.md](06_energy_management.md) | **EMS:** مُدها و merit order، کار **بار-جزئی** در v1 (zero-export / backup) و صادرات در v2، **پایش و کنترل هر فاز** (§۷)، رابط با B6، قیود چیلر، هشدار Telegram و SMS |
| [07_fire_protection.md](07_fire_protection.md) | **اعلام و اطفای حریق (بخش برق):** ناحیه‌های FZ1–FZ3، پنل FCP (EN 54 / EN 12094-1)، توالی آزادسازی، abort و قفل، اینترلاک‌ها (گاز، موتور، تهویه، درها، باتری) |
| [08_b6_bop_controller.md](08_b6_bop_controller.md) | **B6: کنترلر HVAC/BOP خودمان** (ماژولار روی ریل DIN، بدون PLC)، پیکربندی B6-R/B6-E، HMI لمسی Riverdi + TouchGFX |
| [calc/electrical_sizing.py](calc/electrical_sizing.py) | PMG/یکسوساز، overspeed FPT، مقاومت ترمز، پیش‌شارژ، **surge هر فاز با بارهای واقعی**، باتری، UPS، افت ولتاژ → [خروجی](calc/electrical_sizing_out.txt) |
| [calc/ems_study.py](calc/ems_study.py) | مُدهای EMS روی مدل HVAC + **نقطهٔ کار بار-جزئی v1 و صادرات v2** → [خروجی](calc/ems_study_out.txt) |
| [`electronics/`](../../electronics/README.md) | KiCad: B1 ECU و بردهای دیگر (شماتیک با مولد netlist `electronics/tools/schgen.py`)، outline و STEP بردها |
| `cad/electrical/` → `cad_out/electrical/` | **مدل سه‌بعدی FreeCAD:** اتاق برق، تابلوهای بام RP-1/RP-2، RB-1، JB-E، سینی‌ها و رایزر، بردها داخل تابلوها؛ `electrical_interfaces.json`؛ رندرها و پلان‌ها |
| `docs/bom/electrical_bom.csv` | **BOM برق** (ستون‌های docs/06 §۵): همهٔ اقلام خریدنی، تابلوها، PCBها (با ارجاع به BOM قطعات)، کابل‌ها، سینی‌ها، تجهیزات میدانی |

**اجرا:**
```bash
python3 docs/electrical/calc/electrical_sizing.py
```
```bash
python3 docs/electrical/calc/io_list.py
```
```bash
LANG=en_US.UTF-8 /Applications/FreeCAD.app/Contents/Resources/bin/freecadcmd cad/electrical/el_build.py
```
```bash
python3 cad/electrical/el_bom.py
```

## ۱. مبنای طراحی (rev 3، با پاسخ‌های کاربر)

| موضوع | مقدار | مرجع |
|---|---|---|
| نقطهٔ کار طراحی | N1 = 115k rpm، TIT 800 °C، ورودی سرد‌شده تا 15 °C | 03 §۱، docs/06 §۲ |
| ITT / TOT / سوخت در نقطهٔ طراحی | ≈ 667 °C / ≈ 610 °C / 2.24 g/s | `sim/life_study.point` |
| توان شفت FPT / DC تحویلی | 25.6 kW / **24.0 kW** | calc §۱ |
| **بار واقعی سایت (کاربر)** | 1 پمپ 3 kW روی VFD، 3 کولر دیواری 12,000 BTU (~1.2 kWe هر کدام)، روشنایی، کامپیوترها، یخچال، تلویزیون: **~5 kW معمول، ~8 kW پیک**. بیشتر سرمایش را چیلرهای جذبی می‌دهند | کاربر، 06 §۵-ب |
| کمکی پلانت | HVAC ~3.3 kW (BALANCED، rev B) + کنترل ~0.3 kW | docs/hvac، ems_study |
| **کار v1** | **موازی با شبکه با zero-export**؛ شبکه منبع پشتیبان خودکار؛ در قطع شبکه، جزیره (backup) با باتری و توربین. توربین بار را دنبال می‌کند: **100k rpm، TIT 645–750 °C، 8.6–13.6 kW، η 12.6–17.5 %** | 01 §۳، 06 §۵-ب |
| **کار v2 (هدف نهایی)** | صادرات به شبکه پس از مجوز DG: 115k / 800 °C، صادرات ~11–14 kW؛ اینورتر قابل گواهی grid-tie | 01 §۳-ه |
| **باتری (تصمیم کاربر)** | **HV LFP ۲۰ kWh** (Deye BOS-G20) + باتری 48 V کنترل (~5 kWh) | docs/06، 01 §۷ |
| **قطعات (تصمیم کاربر)** | **اروپایی در همه‌جا؛ بدون قطعهٔ آمریکایی** | 04 §۰ |
| **زمین (کاربر)** | **چاه ارت اختصاصی** با هادی که کنار ژنراتور بالا آمده | 01 §۹ |
| **پایش (کاربر)** | اینترنت ثابت با **IP ثابت**؛ هشدار **Telegram و SMS** | 04 §۱۰، 06 §۱۱ |
| **BOP (کاربر)** | **بدون PLC:** برد B6 خودمان + نمایشگر لمسی خودمان | 08 |
| **آتش (کاربر)** | آشکارسازی و کنترل آزادسازی با ما؛ مخزن، لوله و نازل با HVAC | 07، docs/hvac/08 |
| صدا | قید نیست، کمتر بهتر | 01 §۱۰ |
| رِیتینگ ماژولار الکترونیک | **30 kW** | 03 §۰ |
| FPT / PMG | 55–65k rpm، ~30 kW، 2 قطب → 1.0 kHz در 60k، E_LL ≈ 360 V rms | calc §۱ |
| باس DC | **720–780 V** (PV emulation؛ چاپر 800–830 V؛ OVP 900 V) | 01 §۱ |
| سایت | بام بتن مسلح (مقاوم)، برازجان، تا ~46 °C، شرجی و نمکی؛ سالن عایق‌دار؛ **اتاق برق ~۳۰ m از بام** | کاربر |
| گاز | 4 bar (حداقل 3.5)، بدون بوستر | 03 §۰ |
| **یاتاقان‌های هسته (قطعی)** | 608 هیبرید سرامیکی با **روغن تحت فشار مدار بسته** (پمپ، فیلتر 10 µm، خنک‌کن OC-1 روی گلیکول، scavenge، breather) | 03 T15–T18c |
| **استارتر (قطعی)** | BLDC با کلاچ یک‌طرفه و پین در سوراخ عرضی Ø3 دماغه؛ **ساعت‌گرد از دید ورودی**؛ رزوهٔ جلو M6 چپ‌گرد؛ M5 هوای پشتیبان | 03 §۳-۴ |
| **CAD فاز ۱ (v13A)** | انجام شده؛ 115k rpm / TIT 800 °C | `docs/05_phase1_core_v13A.md` |

## ۲. معماری کلی و محل بردها

```
 ┌──────────────────────────── ROOF (بام، قاب ROOF) ───────────────────────────────┐
 │  EP-1 (x 1.3–2.7، y 7.6–8.5): سنسورها، استارتر، پمپ روغن، شیرها، جرقه، UV، PMG؛ JB-E روی وجه شمالی │
 │  قاب FR-E1 + سایه‌بان (x 1.25–2.95، y 9.28–9.80):                                   │
 │    RP-2 (PEB، IP66، cold plate گلیکول): B3 یکسوساز SiC + B3b + K-DC/K-PRE/K-BR + SPD-DC1 + DCD-1 │
 │    RP-1 (IP66، کنترل): B2 · B4 · SR1 (Pilz) · DC-DC 48→24 · سوییچ فیبر · SPD داده      │
 │    MEB-R (شینهٔ زمین + لینک تست) ◄── هادی چاه ارت (≥ 50 mm²)                         │
 │  RB-1 مقاومت‌های ترمز (x 5.95–6.55) · BOP-R (HVAC): B6-R + HMI Riverdi                │
 └───────────────┬─────── سینی T-R1 لبهٔ شمالی (قدرت | داده در لولهٔ فولادی) ───────────┘
                 │  ~30 m تا اتاق برق، مرز LPZ: SPD روی همهٔ کابل‌های فلزی؛ Ethernet فیبر
 ┌───────────────┴──────────── ELECTRICAL ROOM (اتاق برق، داخل، 3.5 × 3.0 m فرضی) ─────────┐
 │  CP-E: B1 (STM32H743 + NXP S32K144) · B5 (i.MX 8M Plus) + HMI 10.1" · سوییچ · روتر (IP ثابت + LTE/SMS) │
 │  HI-1 Deye SUN-30K-SG01HP3-EU-BM3 (GRID / LOAD / GEN / 2 BAT / 3 MPPT) · BAT-1 BOS-G20 20.48 kWh · DCJ-1 │
 │  MDB: ورودی شبکه، SPD T1+2، JT-920، CT zero-export، ATS-1 (I = LOAD، II = شبکه)، K-NPE، JT-901 │
 │  AUX-DB · B6-E · باس 48 V (2 شارژر + LFP 48 V 100 Ah) · MET · FCP (بیرون در)            │
 └───────────────┬──────────────────────────────────────────────────────────────────────┘
                 │ W005 / W109
 ┌───────────────┴──────────── HALL (سالن) ────────────────────────────────────────────┐
 │  تابلوی شرکت: K-LS1..4، K-SP1..3 (3 کولر)، JT-911..914، پمپ 3 kW (VFD)، یخچال، روشنایی، IT  │
 └──────────────────────────────────────────────────────────────────────────────────────┘
```

**چرا B2، B3 و B4 روی بام هستند؟** (بازنویسی دقیق «الکترونیک داخل ساختمان» در brief)

سند 03 §۹ فقط **اینورتر، باتری، ECU و HMI** را از بام منع کرده است. این‌ها همه داخل‌اند. سه برد دیگر روی بام می‌مانند:

| برد | دلیل ماندن روی بام |
|---|---|
| **B3** | باید کنار PMG باشد. کابل 1 kHz با PWM SiC (dv/dt بالا) در 30 m موج بازتابی روی سیم‌پیچ و EMI شدید می‌سازد. **DC 750 V** را راحت‌تر می‌شود پایین برد. |
| **B2** | ترموکوپل سیگنال µV دارد. 12 ترموکوپل × 30 m سیم جبرانی، هم گران است و هم نویزپذیر. دیجیتال‌کردن کنار سنسور و ارسال روی CAN-FD کیفیت بهتری دارد. |
| **B4** | جریان استارتر 48 V تا 60 A است و کابل‌های شیر و پمپ کوتاه می‌شوند. |

**محیط پنل‌های بام:**
- سایه‌بان، و IP55 (RP-1، BOP-R) / IP65 (PEB).
- **مبدل هوا-به-آب روی مدار گلیکول الکترونیک** (~35–40 °C؛ بالای نقطهٔ شبنم ~23 °C، پس بدون میعان)، با هدف دمای داخل پنل ≤ 50 °C.
- هیتر ضدمیعان با کنترل نقطهٔ شبنم.
- قطعات −40…+85/105 °C و **پوشش conformal روی همهٔ بردها** (03 §۹).
- پیچ‌ها و یراق از استیل 316.

## ۳. بردها و تابلوها (قطعات اروپایی، 04)

| برد/تابلو | محل | وظیفه | قطعات کلیدی | تغذیه | ارتباط |
|---|---|---|---|---|---|
| **B1 ECU** | CP-E (ER) | ماشین حالت، گاورنر N1/سوخت، محدودکننده‌ها، trip، life counter، EMS (شامل کنترل فازی)؛ **SMCU مستقل** (overspeed، شعله، watchdog) | STM32H743IIT6، **NXP S32K144**، 2× ST M95M04، STWD100، NXP TJA1052i ×2، ST485E + STISO621 ×3، ⚑ RTL8201F، Infineon ISO1I813T ×4، Finder ×16 | 24 V از باس 48 V | CAN-FD ×2 (#1 موتور، #2 BMS)، RS-485 ×3 (HI-1، کنتورها/VFD، JT-901)، Ethernet، 6 SPD-IN، 32 DI، 16 رله |
| **B2 I/O سنسور** | RP-1 | 12 TC، 16 RTD، 24 ورودی 4–20 mA، 8 کانال سریع/IEPE، 6 پالس، 32 DI؛ FFT ارتعاش؛ رأی‌گیری ITT | STM32H743VIT6، 2× **STM32F373** (AFE)، ISO1I813T ×4، ST26C31 | 24 V | CAN-FD، RS-422 (N1-A) |
| **B3 یکسوساز** | RP-2 | FOC PMG، حلقهٔ N2، PV emulation، چاپر، کنتاکتورها، Riso، OVP سخت‌افزاری | **STM32G474** (HRTIM)، 7× Infineon CoolSiC 1200 V، **Infineon 1ED3491**، RECOM، شانت Isabellenhütte، LEM | 24 V + خودتغذیه | CAN-FD، B3 HEALTHY |
| **B3b ترمز مستقل** | RP-2 | پل دیودی + چاپر IGBT + R_BR2 با K-BR NC؛ **بدون نرم‌افزار** | Semikron SKD 30/12، IKW40N120H3، ST STGAP2، ST VIPer26K | از PMG | وضعیت به B3 / B1 |
| **B4 درایورها** | RP-1 | استارتر BLDC (60 A)، پمپ روغن، scavenge، پمپ گلیکول، فن‌ها، شیرها (از SR1)، شیر تناسبی، جرقه | STM32G474RET6، **Infineon 6EDL7141** ×4، IPB017N10N5، ST VNI4140K / IPS1025H | 48 V | CAN-FD |
| **B5 HMI** | CP-E | نمایش، لاگ، آلارم، **Telegram و SMS**، دسترسی از راه دور، بهینه‌ساز اختیاری EMS | **NXP i.MX 8M Plus** (Toradex Verdin / Phytec)، 10.1" DATA MODUL / Distec، NVMe Swissbit | 24 V | Ethernet، CAN-FD (شنود) |
| **SR1** | RP-1 | زنجیرهٔ ایمنی سخت‌افزاری (PL e)، شامل K-EX، K-VS و ورودی‌های آتش | Pilz PNOZmulti 2 | 24 V | SI01–SI20، O1–O7 |
| **B6-R / B6-E** | BOP-R بام / ER | **کنترلر HVAC/BOP خودمان، بدون PLC** (08): ماژولار روی ریل DIN + HMI لمسی Riverdi | STM32H743 (CPU)، STM32F373 (AI)، STM32G0B1 (DI/DO)، STM32G474 (AO)، ISO1I813T، Finder | 24 V | Modbus TCP (B1 client)، RS-485 ×3، M-Bus |
| **FCP** | راهروی بیرون ER | اعلام و کنترل اطفای گواهی‌دار (07) | Siemens / Minimax / Bosch / Hekatron | 230 V + باتری EN 54-4 | رله‌ها به SR1 و B1؛ دیالر GSM |
| **MDB / AUX-DB / DCJ-1** | ER | ورودی شبکه، ATS، توزیع، کمکی‌ها، اتصال DC | ABB / Siemens / Hager / Socomec؛ Rittal | — | کنتورهای Modbus |

**شناسهٔ کانال‌ها** در I/O list دقیقاً همین تقسیم‌بندی را دنبال می‌کند. بودجهٔ کانال هر برد در انتهای [02_io_list.md](02_io_list.md) آمده است.

## ۴. شبکهٔ ارتباطی

```
                        ┌────────────── CAN-FD #1 «موتور» 1/5 Mbit/s (W101، ~40 m) ───────────────┐
  B1 ECU (ER) ═════════╪══ B2 (RP-1) ══ B4 (RP-1) ══ B3 (PEB) [ترمیناتور در B1 و B3]                │
    │  SPD-IN: N1-A (RS-422 از B2، W102a) · N1-B، N2-B، UV (مستقیم، تغذیه از SMCU، W102b)            │
    │  CAN #2 ──── BMS باتری HV ۲۰ kWh (listen-only روی باس BMS ↔ HI-1)، BMS 48 V
    │  Modbus TCP (B1 client) ── B6-E (ER) و B6-R (BOP-R بام، از فیبر W104)  [docs/hvac] + رجیسترهای EMS                                           │
    │  RS-485 #1 ── اینورتر هیبرید HI-1 (Modbus)  ·  RS-485 #3 ── JT-901 (4 Hz، کنترل فازی)        │
    │  RS-485 #2 ── کنتورها، VFDها، سنسور اتاق                                                     │
    │  Ethernet ─── سوییچ ER ── B5 HMI ── روتر (اینترنت ثابت + IP ثابت، LTE، SMS) ── WireGuard ── VPS (Telegram) │
    │                     └──── فیبر W104 ──── سوییچ بام ── مانیتور سرویس، کنترلر HVAC، سرویس بردها │
    └─ حلقهٔ ایمنی W103 ─── SR1 (RP-1)                                                          │
```

| مسیر | نرخ و محتوا | حفاظت داده |
|---|---|---|
| Modbus TCP ↔ B6-R/B6-E | وضعیت HVAC 1 Hz؛ ECU/EMS → B6: رجیسترهای EMS (06 §۴)، setpoint T1، وضعیت موتور؛ B6-R → ECU: موقعیت درخواستی D-101 | heartbeat؛ قطع > 5 s → D-101 به دودکش؛ > 60 s → B6-R حالت محلی امن و EMS آلارم T47 |
| CAN-FD #1 | B1 → B4: فرمان‌ها 1 kHz. B1 ↔ B3: P_ref، N2_ref، وضعیت 1 kHz. B2 → B1: TC 10 Hz، فشار 50 Hz، ویژگی‌های ارتعاش 100 Hz. heartbeat همه 100 Hz | CRC-16 + شمارنده + timeout در payload (E2E، به سبک AUTOSAR)؛ هر گره watchdog ارتباطی دارد و در قطع به حالت امن خودش می‌رود |
| ورودی‌های سرعت | capture مستقیم در H7 و SMCU (هر کدام گیرندهٔ جدا) | ایزولهٔ گالوانیک در B1 |
| RS-485 / Modbus | 1–5 Hz | timeout → آلارم و کنترل افتی محلی (droop) |
| Ethernet | Modbus TCP (فرمان/وضعیت)، UDP 100 Hz (روند)، HTTP (رکورد trip) | VLAN OT، فایروال، VPN؛ **غیرایمنی** |

**بودجهٔ زمانی گاورنر N1:**
- capture پالس: ≤ 0.5 ms (یک دور در 120k)
- محاسبه: 1 ms
- فرمان CAN به B4: ≤ 0.2 ms
- حلقهٔ جریان شیر: 0.2 ms
- **جمع ≤ 2 ms**، بسیار سریع‌تر از ثابت زمانی شیر و گاز (~30–100 ms).

## ۵. تغذیهٔ الکترونیک و دامنه‌های ایزوله

| باس | منبع | مصرف‌کننده‌ها |
|---|---|---|
| **48 V اضطراری** | 2× شارژر (N+1) + LFP 48 V 100 Ah، مستقل از باتری HV ۲۰ kWh و اینورتر | B4 (استارتر، روغن، خنک‌کن، فن‌ها)، منطق B3، DC-DC‌ها |
| **24 V بام** | DC-DC 48→24 در RP-1 | B2، شیرها (از مسیر SR1)، جرقه، سنسورها، SR1 |
| **24 V ER** | DC-DC 48→24 در ER | B1، B5، شبکه |

**دامنه‌های ایزوله:**
- B1: فیلدباس‌ها و ورودی‌های سرعت و DI
- B2: آنالوگ (SPI ایزوله) و DI
- B3: کنترلر روی پتانسیل DC−؛ ایزولاسیون تقویت‌شده فقط در ارتباط، تغذیه و رلهٔ HEALTHY؛ هر گیت 5.2 kV (RECOM)

**خودمختاری:** طبق calc §۷:
- **6.2 h** در حالت کار
- **10 h** در blackout (post-lube + تهویه + کنترل)
- استارتر: 50 Wh برای هر استارت

## ۶. تصمیم‌های کلیدی (خلاصه)

| # | تصمیم | سند |
|---|---|---|
| D1 | یکسوساز ما به **درگاه PV (MPPT) اینورتر هیبرید** با PV emulation وصل می‌شود؛ باتری HV روی درگاه باتری همان اینورتر است | 01 §۱ |
| D2 | **باس اضطراری 48 V** با باتری LFP جدا: کنترل، ایمنی، post-lube، تهویه و **استارتر**. black start سطح ۲ (بدون شبکه و با باتری HV خالی): توربین از 48 V استارت می‌شود و اینورتر از ورودی DC بیدار می‌شود | 01 §۳-ب |
| D3 | **ترمز FPT دولایه و سخت‌افزاری**: چاپر B3 + B3b مستقل با K-BR NC؛ R_BR1 ≥ 400 kJ. یافته: بدون ترمز، FPT در ~130 ms به 110 % می‌رسد | 01 §۵ |
| D4 | PMG **2 قطب**، E_LL ≈ 360 V در 60k؛ SiC 1200 V، f_sw ≈ 32–40 kHz | calc §۱ |
| D5 | **VFD برای پمپ 3 kW**؛ کولرهای 12,000 BTU بدون soft starter (LRA کوچک)، هر کدام روی یک فاز با رلهٔ مجوز K-SP؛ استارت پله‌ای | 01 §۶ |
| D6 | **HI-1 = Deye SUN-30K-SG01HP3-EU-BM3** (چین، غیرآمریکایی؛ تنها گزینهٔ این اندازه با درگاه LOAD بدون وقفه و 2× 50 A باتری) + **BAT-1 = Deye BOS-G20** (20.48 kWh HV LFP، تصمیم کاربر) → ~20 kW از باتری در backup. گزینهٔ اروپایی SMA Hybrid X 30 با انتقال ~2 s (سؤال باز ۱) | 01 §۱، §۷، 04 §۸ |
| D7 | **ایمنی سه‌لایه**: SR1 گواهی‌دار (PL e) → SMCU متنوع → ECU. شیرها فقط با اجازهٔ هر دو باز می‌شوند. هدف SIL 2 / PL d | 03 §۱، §۸، §۹ |
| D8 | آستانهٔ overspeed مستقل N1 = **120,000 rpm** (هرگز بالاتر از تست راتن)؛ N2 = **71,500 rpm** | 03 §۷ |
| D9 | life counter مبتنی بر **همان مدل LMP خزش `sim/life_study.py`** + LCF + recuperator + روغن، با EEPROM دوگانهٔ ST M95M04 (wear-leveling) و کپی در SMCU | 03 §۱۰ |
| D10 | B2، B3 و B4 روی بام (کنار سنسورها، PMG و عملگرها)؛ B1، B5، اینورتر و باتری داخل | §۲ |
| D11 | ارتباط بام ↔ ER: CAN-FD ایزوله + سیگنال‌های سرعت مستقل + حلقهٔ ایمنی + **فیبر برای Ethernet**؛ دو لولهٔ فولادی ارت‌شده؛ SPD در مرز LPZ | 05 |
| D12 | پایش از راه دور: **IP ثابت + WireGuard روی روتر سایت**؛ داده و آلارم روی B5؛ **Telegram از رلهٔ VPS خارج از کشور** و **SMS از مودم LTE روتر** (+ دیالر مستقل FCP)؛ اولویت‌های P1–P4 | 04 §۱۰، 06 §۱۱ |
| D13 | زمین با **چاه ارت اختصاصی** (MEB-R روی بام، هادی ≥ 50 mm²، MET در ER با 1×25)؛ داخل نیروگاه TN-S با یک پیوند N-PE (K-NPE در backup، از شبکه در حالت موازی)؛ ATS چهارپل؛ باس DC شناور با Riso؛ LPS با هادی‌های پایین‌روی جدا و هم‌بندی در پای ساختمان؛ SPD با مفهوم LPZ | 01 §۹ |
| D14 | هم‌ترازی با `docs/hvac` (قرارداد v3، 17:50): تگ‌ها همان `docs/hvac/io_list.csv`؛ ZC-101 روی B4 (مالک ECU) با موقعیت درخواستی از B6-R؛ K-EX = SR1-O6 با گروه D (TSHH/PSH/FSL-111) که موتور را متوقف نمی‌کند؛ B6 روی Modbus TCP؛ BMS روی CAN #2 | 03 §۵، §۹ |
| D15 | **مدیریت انرژی (EMS)** در B1 (قاعده‌محور، بدون پیش‌بینی) + بهینه‌ساز اختیاری روی B5: مُدهای AUTO / MAX-POWER / BALANCED / MAX-COOLING. در کمبود برق، اول سهم سالن و CH-2 و بعد T1 = 12 °C و peak TIT. **CH-1 برای کویل ورودی هرگز به‌خاطر برق خاموش نمی‌شود** (خاموشی کامل سرمایش −6.2 kW). حفاظت چیلرها با B6-R | 06 |
| D17 | **قطعات اروپایی در همه‌جا، بدون قطعهٔ آمریکایی:** ST، Infineon، NXP، Nexperia، RECOM، Würth، Finder، LEM و غیره. استثنای غیرآمریکایی آسیایی فقط برای PHY اترنت و فلش (⚑) | 04 §۰ |
| D18 | **شبکه = منبع پشتیبان خودکار با zero-export** تا مجوز DG: اینورتر هیبرید موازی با شبکه، درگاه LOAD در قطع شبکه جزیره می‌سازد؛ **ATS-1** (I = LOAD، II = شبکهٔ مستقیم) در خرابی اینورتر بار را به شبکه می‌برد؛ JT-920 مستقل صادرات را پایش می‌کند | 01 §۳ |
| D19 | **کار بار-جزئی در v1:** توربین بار واقعی (8.6–13.6 kW) را در 100k rpm و TIT 645–750 °C دنبال می‌کند؛ کمبود سرمایش سالن را کولرهای شرکت می‌پوشانند (حلقهٔ خودتنظیم). 115k / 800 °C فقط برای صادرات (v2) | 03 §۵، 06 §۵-ب |
| D20 | **کنترل هر فاز:** JT-901 در 4 Hz، سطوح ALM-1 / SHED-1 / SHED-2، رله‌های مجوز K-SP1..3 برای سه کولر (یکی در هر فاز) با آزادسازی پلکانی پس از برگشت برق | 06 §۷ |
| D21 | **B6 خودمان، بدون PLC:** CPU + ماژول‌های I/O روی ریل DIN با T-bus (CAN 1 Mbit/s)، B6-R = CPU + 11 ماژول، B6-E = CPU + 5 ماژول؛ HMI Riverdi 10.1" با TouchGFX | 08 |
| D22 | **آتش:** پنل گواهی‌دار FCP (EN 54-2/4 + EN 12094-1)؛ double-knock، تأخیر 30 s، abort، مهار با در باز، قفل سرویس؛ اینترلاک‌ها: SR1 SI19/SI20 (گروه A)، O7 (فن‌های جعبه)، قطع تهویهٔ ER، HI-1 OFF و ATS → 0 در FZ2؛ AT-885 (H₂/CO باتری) | 07 |
| D23 | **SMCU = NXP S32K144** (تنوع سازنده با ECU ST) | 03 §۸ |
| D24 | B6 ↔ B1 فقط **Modbus TCP**؛ CAN #2 فقط BMS؛ TE-GLY ALM 58 / FSD 65 °C؛ تگ‌های آتش FCP / FZ1–FZ3 / 87x–89x (توافق نهایی با HVAC) | 06 §۴، 07 |
| D25 | **مدل سه‌بعدی برق** در قاب ROOF (`cad/electrical/el_build.py`)، بدون تداخل با تجهیزات HVAC؛ BOM از همان دادهٔ `el_items.py` | docs/06 §۴–۶ |
| D16 | تصمیم‌های قطعی مکانیک در کنترل منعکس شد: روغن مدار بسته برای 608 هیبرید (PDT-703، PT-709، LT-707، TE-708، M-711)؛ استارتر BLDC با کلاچ یک‌طرفه و قفل جهت ساعت‌گرد؛ air-start M5 پشتیبان | 03 §۳-۴، §۷ |

## ۷. هم‌خوانی با سند 03

| مورد در 03 | در این مجموعه | وضعیت |
|---|---|---|
| §۵ «PMG → SiC rectifier → DC bus 700–800 V → hybrid inverter» | باس 720–780 V روی درگاه PV | ✔ (دقیق‌تر شد: درگاه PV) |
| §۵ «HV LiFePO4 10–15 kWh (BMS)» | روی درگاه باتری اینورتر؛ **۲۰ kWh** (تصمیم کاربر) | ✔ |
| §۵ «ECU <-CAN-> rectifier، inverter (Modbus/CAN)، BMS، HMI» | CAN-FD موتور، Modbus اینورتر، CAN BMS، Ethernet به HMI | ✔ |
| §۵ «hard-wired safety chain cuts gas on trip» | SR1 + SSV1/SSV2 + XV-610 | ✔ |
| §۵ جدول بردها B1–B5 | همان، به‌علاوهٔ B3b و SR1 | ✔ (+ اضافه) |
| §۵ B4 «پمپ خنک‌کن تبخیری» | خنک‌کن تبخیری در §۸ حذف شده (کویل آب سرد)؛ کویل از HVAC کنترل می‌شود | ✔ |
| §۶ جعبه: ناحیهٔ تابلوی برق IP54، کلید درها، E-stop و مانیتور روی در | RP-1/RP-2 با IP55، PEB با IP65؛ کلید درها در SR1؛ مانیتور سرویس IP65 | ✔ (IP بالاتر به‌خاطر بام، 03 §۹: IP55) |
| §۸ کابل 4×10 + ارت (~6 m)، CAN/RS485 شیلددار جدا | مسیر واقعی بام ↔ ER ~۳۰ m (کاربر)؛ W001 1×16 DC، W006 5G10، W007 2×25؛ مسیرهای c2 جدا | ✔ (طول به‌روز شد) |
| §۹ اینورتر، باتری، ECU و HMI روی بام نمی‌روند؛ مانیتور دوم روی بام؛ conformal coating؛ صاعقه‌گیر و ارت | همه رعایت شده | ✔ |
| §۴ life counter و کنترل گرم/سردشدن recuperator | 03-control §۱۰ و نرخ TOT ≤ 15 K/min | ✔ |
| `docs/hvac` (session موازی): تگ‌ها، D-101، K-EX، B6-R/B6-E، DC-1، EMS، آتش | تگ‌ها مطابق `docs/hvac/io_list.csv` (قرارداد v3، دور ۳)؛ ZC-101 روی B4 AO01 و ZT-101 روی B2 AI16 (HVAC اصلاح کرد)؛ B6 روی Modbus TCP؛ رجیسترهای EMS + افزوده‌های HVAC در 06 §۴؛ TE-GLY 58/65 °C؛ آتش: FCP و FZ1–FZ3 با تگ‌های 87x–89x، مخزن و نازل با HVAC (docs/hvac/08) | ✔ |
| §۱ حالت پیک 815 °C | peak mode با شمارش عمر | ✔ |

## ۸. استانداردهای مرجع

| حوزه | استانداردها |
|---|---|
| ایمنی ماشین و کنترل | IEC 60204-1، ISO 13849-1/2، IEC 62061، IEC 61508 |
| ایمنی توربین گازی | **ISO 21789** |
| احتراق و سوخت | EN 746-2 (قیاسی)، EN 161 / EN 16678، EN 1643، EN 1854، EN 676 (قیاسی برای TSA) |
| فضای قابل انفجار | IEC 60079-10-1 / -14 |
| صاعقه | IEC 62305-1..4 |
| تأسیسات برقی | IEC 60364، **مبحث ۱۳ مقررات ملی ساختمان** |
| گاز ساختمان | **مبحث ۱۷** و ضوابط شرکت گاز |
| کابل و اینورتر | EN 50618 (کابل DC)، IEC 62109 و EN 50549-1 / VDE-AR-N 4105 / IEC 62116 (اینورتر)، IEC 62619 (باتری) |
| آتش | EN 54 (اجزا)، **EN 12094-1** (کنترل اطفا)، ISO 14520 / NFPA 2001، CEN/TS 54-14، EN 50200 / IEC 60331 (کابل آتش)، مبحث ۳ |
| سوییچ و تابلو | IEC 61439-1/2/3، IEC 60947-6-1 (ATS) |
| EMC | IEC 61000-6-2/-4 |
| آلارم و امنیت OT | ISA-18.2، IEC 62443 |
| اتصال به شبکه (v2) | ضوابط اتصال تولید پراکندهٔ توانیر |

## ۹. کارهای بعدی

1. **تأیید کاربر** بر D17–D25 و سؤال‌های §۱۰.
2. **انتخاب نهایی اینورتر HI-1** (04 §۸): نمایندگی و سرویس در بوشهر، گواهی‌ها برای مجوز DG، و پذیرش انتقال backup (seamless یا چند ثانیه).
3. **KiCad:** تکمیل شماتیک‌های B1، B2، B3، B4 و B6 (مولد netlist)، layout، و بررسی مستقل طرح B3 توسط متخصص الکترونیک قدرت.
4. **firmware:** ماشین حالت روی STM32H7 + HIL با مدل‌های `sim/`؛ TouchGFX برای B6؛ B5 (Linux، gr180-notify).
5. **تست میز:** B3 + اینورتر + باتری (01 §۸)، شامل zero-export، انتقال backup، و تست فازی با کولرها (06 §۱۳).
6. **بازدید سایت:** مسیر کابل ~۳۰ m، محل و ابعاد اتاق برق، تابلوی شرکت، سیستم زمین شبکه، چاه ارت (مقاومت و مقطع هادی)، صاعقه‌گیر موجود.
7. **هماهنگی‌ها:**
   - HVAC: فضای ریل B6-R در BOP-R و برش در برای HMI (`electrical_interfaces.json`)، جدول حالت امن خروجی‌های B6، اتصال گلیکول RP-2.
   - پکیج موتور (E5): JB-E روی وجه شمالی EP-1، ترمینال PMG در وجه شرقی، سنسورهای N1-B و N2-B و پنجرهٔ UV، فن‌ها از طریق K-VS.
   - سایت (S): رایزر سقف ER و فضای اتاق برق.

## ۱۰. سؤال‌های باز برای کاربر

**پاسخ داده شد (این دور):** قطعات اروپایی؛ چاه ارت اختصاصی؛ کار ۲۴ ساعته با هدف صادرات؛ اینترنت ثابت با IP ثابت و هشدار Telegram و SMS؛ صدا؛ B6 و HMI خودمان؛ آشکارسازی و آزادسازی آتش با ما؛ بارهای واقعی؛ باتری ۲۰ kWh با شبکهٔ پشتیبان و zero-export؛ بام بتنی؛ اتاق برق ~۳۰ m؛ سالن عایق‌دار.

**باقی‌مانده:**
1. **اینورتر HI-1:** گزینهٔ مرجع (Deye، چینی، انتقال backup بدون وقفه، سرویس در ایران) یا گزینهٔ اروپایی (Kostal، SMA یا Fronius، با انتقال backup چندثانیه‌ای)؟ (04 §۸)
2. **اتصال موازی با شبکه در zero-export:** آیا شرکت توزیع برای کار موازی **بدون صادرات** هم مجوز می‌خواهد؟ زمان‌بندی مجوز DG برای صادرات؟
3. **سیستم زمین شبکه:** TN-C-S یا TT؟ (روی پیوند N-PE و RCDها اثر دارد، 01 §۹.)
4. **اتاق برق:** محل و ابعاد واقعی (فرض مدل: 3.5 × 3.0 m، ارتفاع آزاد 2.5 m، طبقهٔ همکف). محل تابلوی شرکت و فاصلهٔ آن از اتاق برق؟ (حجم اتاق، مقدار گاز اطفای FS-2 را تعیین می‌کند.)
5. **چاه ارت:** مقطع و جنس هادی موجود و آخرین اندازه‌گیری مقاومت؟ ساختمان صاعقه‌گیر دارد؟ زمین ساختمان به چاه هم‌بند شود؟ (توصیه: بله)
6. **بارها:** گروه‌بندی K-LS1..4 و **اولویت آسایش هر کولر** (کدام اتاق‌ها هرگز حذف نشوند)؟ فاز فعلی هر کولر؟
7. **فهرست کشیک** برای SMS و Telegram و escalation (P1 تا P4)؟
8. **FCP:** سازندهٔ ترجیحی با سرویس محلی (Siemens یا Bosch)؟ الزام آتش‌نشانی محلی به اتصال به مرکز پایش؟ در آتش اتاق برق، بارهای حیاتی شرکت فیدر مستقیم شبکه از بیرون ER بخواهند؟
9. **ایمنی عملکردی:** هدف SIL 2 / PL d، ارزیاب مستقل، و استارت از راه دور فقط در REMOTE؟
10. **FPT و PMG (تیم مکانیک):** PMG دو قطب با E_LL ≈ 360 V در 60k؟ J واقعی؟ spin test تا ≥ ۱۲۰ ٪؟ شیر bypass گاز قبل از FPT؟
11. **سیستم روغن:** فشار کار و حداقل مجاز، نوع روغن، دبی، حجم مخزن، دمای مجاز.
12. **استارتر:** موتور BLDC مشخص و نوع کلاچ sprag؛ دور cut-out ~45k؛ نصب کپسول هوای فشرده برای XV-021؟
13. **گاز:** فشار 4 bar نسبی؟ الزامات شرکت گاز (شیر قطع رایزر، double-block-and-bleed، کنترلر شعلهٔ گواهی‌دار)؟
14. **حداقل بار پایدار توربین (P_min):** با تست تعیین می‌شود (فرض ~6 kW در 100k / ~600 °C). در بار کمتر، کار پیوسته با مازاد به باتری و EH-950، یا توقف برنامه‌ریزی‌شده و برق از شبکه؟ (پیش‌فرض: کار پیوسته)
15. **EMS:** سؤال‌های [06](06_energy_management.md) §۱۴.
