ahmadreza221/aurora-cchp/docs/01_analysis_review_v12.md

# GR180 — آنالیز کامل، بازبینی طراحی v12 و مسیر تبدیل به ژنراتور برق

تاریخ: ۲۰۲۶-۱۰-۲۱ · مبنا: پوشه `GR180-v12-backup-20261021-1404` (= `build_gr180_v12.py` در `~/Desktop/GR180-3D`)
ابزارهای شبیه‌سازی: `sim/measure_geometry.py` (FreeCAD)، `sim/gr180_cycle.py` (سیکل ترمودینامیکی)، `sim/gr180_rotor.py` (دینامیک روتور)

---

## ۱. پروژه چیست

GR180 یک **توربوجت تک‌محوره (single-spool)** در کلاس ۱۸۰ نیوتن است که به‌صورت کامل و پارامتریک در FreeCAD با یک اسکریپت پایتون ساخته می‌شود.

| بخش | مشخصات در CAD v12 |
|---|---|
| کمپرسور | چرخ Schwitzer 316954 تراش‌خورده به Ø74، با ۷ پرهٔ اصلی و ۷ splitter، اینداکسر Ø55.9، **b2 = 2.9 mm** و جرم ۱۰۴ g |
| دیفیوزر | پره‌دار با ۱۳ پره، **ارتفاع کانال 7.0 mm**، گلوگاه اندازه‌گیری‌شده 13×6.65×7.0 = **605 mm²** |
| محفظهٔ احتراق | حلقوی، لاینر بیرونی Ø95.5 و درونی Ø41.7، ۱۲ لولهٔ vaporiser Ø6، سوخت گاز متان با مانیفولد ~۳ barg |
| NGV | ۱۵ پره، حلقه Ø44.5/Ø70.5، **گلوگاه اندازه‌گیری‌شده 1212 mm²** (زاویهٔ مؤثر خروج 58.9°) |
| توربین | Ø70.3 با ۲۳ پره و جرم ۹۱ g (Inconel)، گلوگاه روتور 1512 mm² |
| شفت و یاتاقان | شفت Ø8/Ø14 از silver steel، دو بلبرینگ هیبرید 608، فاصلهٔ یاتاقان‌ها 98.2 mm، کل روتور **۳۳۷ g** |
| دور طراحی | ~120,000 rpm (سرعت نوک کمپرسور 465 m/s و نوک توربین 442 m/s) |
| تجهیزات جانبی | استارتر Permax 280 با Bendix، سنسور دور Hall، جرقه‌زن 1/4-32، EGT نوع K، روغن‌کاری total-loss با دو حلقهٔ جت |

**ساختار فایل‌ها:** ۳۷ قطعه، هرکدام با خروجی `.FCStd`، `.step` و `.stl`. کل مدل را `build_gr180.py` می‌سازد (۷۷۷ خط). `verify_gr180.py` تداخل‌ها و چرخش روتور را بررسی می‌کند و `GR180Tools/` نوار ابزار انیمیشن مونتاژ است. نسخه‌های v6 تا v11 به‌صورت کپی فایل نگه داشته شده‌اند.

---

## ۲. یافته‌های بازبینی (به ترتیب اهمیت)

### 🔴 بحرانی: روی کارکرد موتور اثر مستقیم دارند

> **به‌روزرسانی ۲۰۲۶-۱۰-۲۱:** نقشهٔ اصلی (`~/Downloads/GR1802009/GR180 Compressor.pdf`) تأیید کرد که **b2 = 6.48 mm** است (ضخامت لبهٔ دیسک 1.2 و فاصلهٔ نوک تا پشت پروانه 7.68). پس C1 خطای خواندن نقشه در CAD بوده، نه طراحی. تراز محوری پروانه با intake و دیفیوزر باید در CAD اصلاح شود. جزئیات در `docs/02_concept_decision.md`.

**C1. ناسازگاری دبی کمپرسور، دیفیوزر و تراست.**
- در CAD، عرض خروجی پروانه **b2 = 2.9 mm** است ولی ارتفاع کانال دیفیوزر **7.0 mm** است (نسبت ۲٫۴؛ قاعدهٔ طراحی ۱٫۰ تا ۱٫۱۵). یعنی جریان بلافاصله بعد از پروانه یک انبساط ناگهانی (dump) دارد.
- شبیه‌سازی سیکل نشان می‌دهد برای ۱۷۶٫۵ N، با NGV و نازل فعلی، حدود **0.41 kg/s** هوا و PR≈3.2 لازم است.
- پروانه با b2=2.9 mm در φ2=0.3 فقط **~0.14 kg/s** عبور می‌دهد و حدود **0.24 kg/s** خفه می‌شود. برای 0.41 kg/s عرض b2 باید **~8.7 mm** باشد.
- در مقابل، گلوگاه دیفیوزر (605 mm²) با 0.41 kg/s به ماخ ~0.77 می‌رسد که با ابعاد فعلی دیفیوزر سازگار است.
- **نتیجه:** احتمالاً b2=2.9 در مدل اشتباه است. این عدد از تلاقی پوستهٔ intake با r=37 به‌دست آمده، نه از اندازه‌گیری مستقیم. **قبل از هر کاری b2 واقعی چرخ را اندازه بگیرید.**
- اگر b2 واقعاً 2.9 باشد، تراست واقعی تقریباً نصف است و ارتفاع دیفیوزر باید به ~3.0–3.2 mm کم شود.

**C2. یک مود خمشی/مخروطی نزدیک دور کاری.** طبق `sim/gr180_rotor.py`:

| یاتاقان | سرعت‌های بحرانی forward (rpm) |
|---|---|
| جلو نرم (O-ring، 0.5 N/µm) و عقب 10 N/µm | 13k، 70k، **115k** ← |
| هر دو 10 N/µm | 51k، 71k، **126k** ← |
| هر دو 30 N/µm | 69k، **114k** ←، 148k |

- مود سوم در بازهٔ **۱۱۰ تا ۱۲۶ هزار دور** است، یعنی در ±۲۰٪ دور کاری. Campbell را در `sim/gr180_campbell.png` ببینید.
- مدل تقریبی است: سختی مجموعه‌های clamp‌شده و سختی یاتاقان‌ها با قضاوت مهندسی انتخاب شده‌اند.
- **اقدام:**
  - روی شفت مونتاژشده تست ضربه بزنید (tap test با میکروفون یا شتاب‌سنج گوشی، به‌صورت free-free).
  - میراگر O-ring جلو را حتماً نگه دارید.
  - **هیچ جرمی به این شفت اضافه نکنید** (بخش ۴ را ببینید).

**C3. لقی نوک توربین در v12 فقط 0.10 mm است.** این مقدار برای Ø70 در 120k rpm با رشد حرارتی و گریز از مرکز کم است و معمولاً 0.2–0.3 mm لازم است.
- در `~/Desktop/GR180-3D/build_gr180.py` تغییرات v13 شروع شده و حفرهٔ NGV به Ø70.8 (لقی 0.25) رسیده است. **این فایل با این backup فرق دارد.**

**C4. توربین فقط روی 7.7 mm از نشیمن Ø8 مرکز می‌شود.**
- شفت Ø8 تا x=115 ادامه دارد ولی هاب توربین تا x=121.8 است، پس 6.8 mm از سوراخ Ø8 روی رزوهٔ M6 است.
- این وضعیت از اضافه‌شدن spacer 6.3 در v11 به‌وجود آمده.
- نتیجه: مرکزیت و تکرارپذیری بالانس ضعیف می‌شود.
- **پیشنهاد:** شروع رزوه را به ≥122 ببرید و شفت را بلندتر کنید، یا هاب را کوتاه‌تر کنید.

**C5. عمر یاتاقان‌ها برای کار ژنراتوری.**
- 608 در 120k rpm به n·dm ≈ **1.8×10⁶** می‌رسد.
- با روغن‌کاری total-loss، عمر معمول موتورهای مدلی چند ده ساعت است، در حالی که ژنراتور صدها تا هزاران ساعت کار می‌کند.

### 🟠 مهم

| # | مورد | جزئیات |
|---|---|---|
| I1 | چک کامل تداخل v12 انجام نشده | `verify_pair.log` بعد از جفت‌های بلبرینگ قطع شده و خط `pairwise done` ندارد. `run1` هم با exit 143 کشته شده. دیفیوزر، CC، NGV، اگزوز و casing در v12 جفت‌به‌جفت چک نشده‌اند (رزوه‌های helical، booleanها را خیلی کند کرده‌اند). |
| I2 | رزوهٔ M3 در Intake outer (PCD82) | گیر رزوه 1.9 mm (0.63d) است و طبق چک خود اسکریپت **FAIL** شده. راه‌حل: پیچ سرتاسری با مهره یا boss موضعی ضخیم‌تر. |
| I3 | ۱.۴ mm از لبهٔ فرار نوک پرهٔ توربین بدون shroud است | shroud NGV در x=118.8 تمام می‌شود ولی TE نوک پره در ~120.2 است. نتیجه نشت بیشتر روی نوک و ۱ تا ۲ درصد افت راندمان است. |
| I4 | زاویهٔ NGV در README گمراه‌کننده است | در README «68°/64°» نوشته شده (زاویهٔ camber فرضی)، ولی زاویهٔ مؤثر از گلوگاه اندازه‌گیری‌شده **58.9°** است. معیار تطبیق، همان مساحت 1212 mm² است. |
| I5 | فاصلهٔ محوری NGV تا روتور ~5.5 mm است | به‌خاطر sleeve فرضی Ø13×6 جلوی توربین. باید با نقشهٔ TW70 تأیید شود (مقدار معمول ۱ تا ۳ mm). |
| I6 | تأمین گاز | در تمام‌بار ~**31 Nm³/h** متان در ≥3 barg لازم است. گاز شهری معمولاً چند ده میلی‌بار است، پس کمپرسور booster یا CNG لازم است. |
| I7 | استارتر Permax 280 | برای روتور ۳۳۷ گرمی با کمپرسور Ø74 احتمالاً ضعیف است (کلاس 400/480 یا brushless متداول‌تر است). |
| I8 | تنش روتور | سرعت نوک توربین 442 m/s است که برای موتورهای مدلی (عمر ده‌ها ساعت) عادی است. برای کار دائم باید de-rate شود (دور و TIT پایین‌تر) و **حفاظ ترکیدن (containment)** اجباری است. |

### 🟡 فرایند و کد

- **P1. مسیر خروجی hard-coded است:** `OUT=~/Desktop/GR180-3D` در build، verify، `_v12/*.py` و `GR180Tools`. اجرای build از این backup **فایل‌های پوشهٔ اصلی را بازنویسی می‌کند**. همین الان دو نسخه داریم که از هم جدا شده‌اند (v13 در GR180-3D).
- **P2. git وجود ندارد.** نسخه‌ها با کپی فایل نگه داشته می‌شوند و حجم پروژه 312 MB است (tgzها و STLها).
- **P3. README قدیمی شده:** بخش اول هنوز یاتاقان جلو را در x 0–7 و spacer 1.5 را نشان می‌دهد که در v12 حذف شده‌اند.
- **P4.** اسکریپت ۷۷۷ خطی پر از عدد ثابت (magic number) است. فایل پارامتری مشترک بین CAD و شبیه‌سازی وجود ندارد.

---

## ۳. نتایج شبیه‌سازی (موتور فعلی)

نقطهٔ کار هم‌خوان با هندسهٔ CAD (NGV=1212 mm²، نازل Ø55.4) برای ۱۷۶٫۵ N:

| η کمپرسور | PR | هوا (kg/s) | TIT | EGT | متان (g/s) | توان سوخت |
|---|---|---|---|---|---|---|
| 0.68 | 3.18 | 0.400 | 864 °C | 718 °C | 6.60 | 330 kW |
| **0.72** | **3.20** | **0.412** | **800 °C** | **662 °C** | **6.26** | **313 kW** |
| 0.76 | 3.21 | 0.425 | 743 °C | 611 °C | 5.93 | 297 kW |

- ضریب کار μ≈0.73 است که برای پروانهٔ backswept قابل‌قبول است.
- ماخ نسبی نوک اینداکسر 1.23 است (transonic، در مرز).
- ماخ خروجی NGV 0.83 است، پس NGV خفه نیست.
- بار توربین ψ=1.17 است.
- ⚠️ بدون رفع C1 این اعداد فقط سقف تئوری‌اند.

---

## ۴. گزینه‌های تبدیل به ژنراتور

سوخت ورودی در تمام‌بار ~**۳۰۰ kW** است. چیزی که می‌شود از آن برق گرفت انرژی جت است (~37 kW جنبشی).

| معماری | توان شفت (تئوری) | برق | راندمان برق | چالش اصلی |
|---|---|---|---|---|
| **A.** ژنراتور PM روی همین شفت (بدون گیربکس) | 19–29 kW | 17–26 kW | 5.6–8.3 % | توربین جدید لازم است (ψ از 1.17 به 1.6)، جرم ژنراتور سرعت بحرانی را به **۱۱۸ تا ۱۲۷ هزار دور** می‌آورد، و محیط آن داغ است ❌ |
| **B.** توربین قدرت آزاد (FPT) + گیربکس دومرحله‌ای → 3000 rpm | 22–29 kW | 19–25 kW | 6.1–7.9 % | FPT با ~60–70k rpm نسبت **20 تا 23:1** لازم دارد. پینیون پرسرعت باید سنگ‌خورده باشد و روغن‌کاری جت داشته باشد. در عوض ژنراتور معمولی 50 Hz بدون اینورتر کار می‌کند. |
| **C.** FPT + ژنراتور پرسرعت PM (مستقیم، یا یک طبقه 2.5–3:1 به ~24k rpm) + یکسوساز/اینورتر | 22–29 kW | 20–26 kW | 6.4–8.3 % | سادگی مکانیکی. موتور BLDC کلاس RC/EV پرسرعت به‌عنوان ژنراتور کار می‌کند و پیچیدگی به الکترونیک منتقل می‌شود. ✅ برای نمونهٔ اول |
| **C + recuperator** | ~21 kW | ~19 kW | **~15 %** | مبدل حرارتی بزرگ (ε=0.85) لازم است و هوای ورودی محفظه به 550 °C می‌رسد، پس محفظه باید بازطراحی شود. |
| **CHP** (هر گزینه + مبدل آب گرم) | | | + ~200 kW حرارت | برای کاربرد گرمایشی منطقی‌ترین حالت است. |

> واقعیت: راندمان برق سیکل ساده **۶ تا ۸ درصد** است، در حالی که ژنراتور گازسوز پیستونی ۲۵ تا ۳۵ درصد راندمان دارد. اعداد بالا سقف تئوری‌اند. یک FPT کوچک در عمل η≈0.55–0.65 دارد، پس برای نمونهٔ اول **۱۰ تا ۱۸ kW برق** واقع‌بینانه است. مدل باید با تست روی استند (تراست، دور، EGT، P2، دبی سوخت) کالیبره شود.

**پیشنهاد:** معماری **B یا C (توربین قدرت آزاد)**.
- هستهٔ GR180 دست‌نخورده می‌ماند و فقط NGVِ FPT هم‌اندازهٔ نازل فعلی طراحی می‌شود تا نقطهٔ کار عوض نشود.
- شفت جدید FPT را می‌شود از اول با یاتاقان‌های بزرگ‌تر و عمر بیشتر طراحی کرد.
- اگر خروجی 50 Hz مستقیم بدون اینورتر مهم است، B (گیربکس) را انتخاب کنید. در غیر این صورت C ساده‌تر و ارزان‌تر است.

---

## ۵. نقشهٔ راه

0. **نظم پروژه:**
   - یک پوشهٔ اصلی و `git init`.
   - مسیر خروجی نسبی به‌جای `~/Desktop/GR180-3D`.
   - فایل `params` مشترک بین CAD و شبیه‌سازی.
   - تکمیل v13 و اجرای کامل چک تداخل.
1. **تأیید هسته:** اندازه‌گیری b2 و ارتفاع دیفیوزر، رفع C1، C3 و C4، و tap test روتور.
2. **مشخصات هدف:** توان برق، ولتاژ/فرکانس، ساعت کار، کاربرد CHP یا نه، منبع گاز.
3. **طراحی FPT:**
   - meanline، NGV هم‌سطح با A9=2411 mm²، و روتور.
   - CAD پارامتریک در همان اسکریپت و مدل روتور شفت جدید.
4. **انتقال قدرت:** گیربکس (نسبت، پینیون، روغن‌کاری) یا ژنراتور پرسرعت، به‌علاوهٔ الکترونیک قدرت.
5. **کنترل و ایمنی:**
   - ECU با گاورنر دور و محدودکنندهٔ EGT.
   - دو شیر قطع گاز، تشخیص شعله، حفاظ ترکیدن و استند تست.
6. **ساخت و تست** و کالیبره‌کردن مدل‌ها با داده‌های واقعی.

---

## ۶. اجرای شبیه‌سازی‌ها

```bash
GR180_ROOT="$PWD" /Applications/FreeCAD.app/Contents/Resources/bin/freecadcmd sim/measure_geometry.py   # ~4 min, read-only
uv run sim/gr180_cycle.py      # cycle + generator variants -> sim/gr180_cycle.png
uv run sim/gr180_rotor.py      # critical speeds + Campbell -> sim/gr180_campbell.png
```

همهٔ فرض‌ها در دیکشنری `A` (سیکل) و `cases` و `CLAMPED` (روتور) در بالای اسکریپت‌ها قابل‌تغییرند.
