ahmadreza221/aurora-cchp/docs/variant_e/02_generator.md

# GR180 نسخهٔ E — ژنراتور پرسرعت آهنربای دائم (ساخت خودمان): طراحی قابل‌ساخت

تاریخ: 2026-10-24 · دستگاه مختصات ENG (mm، x محور موتور رو به پایین‌دست، x = 0 نوک پروانهٔ کمپرسور، z بالا) · شاخهٔ `main-smmbai`

- **عدد اصلی همه‌چیز:** `cad/variant_e/eg_layout.py` (هندسهٔ الکترومغناطیسی، سیم‌پیچی، مکانیک، رابط‌ها).
- **تحلیل‌ها (`sim/variant_e/`):**
  - `eg_fem2d.py` (کتابخانهٔ FEM دوبعدی غیرخطی، مش gmsh) و `eg_bridge.py` (مدل زمانی ژنراتور + پل دیودی + لینک DC)
  - `eg_em.py` → `eg_em.json`: طراحی الکترومغناطیسی، FEM، پنجرهٔ DC، تلفات، اتصال کوتاه، دی‌مغناطیس
  - `eg_sleeve.py` → `eg_sleeve.json`: غلاف کربن در برابر Inconel 718
  - `eg_thermal.py` → `eg_thermal.json`: سیستم خنک‌کاری، شبکهٔ حرارتی، کنترل
  - `eg_rotor.py` → `eg_rotor.json`: روتوردینامیک در سیستم شفت E، پیچش، یاتاقان، بالانس
  - `eg_joints.py` → `eg_joints.json`: پیچ‌ها، گشتاورها، انطباق‌ها، O-ringها
  - `eg_bom.py` → `docs/bom/variant_e_generator_bom.csv` (۹۷ ردیف)
- **CAD:** `cad/variant_e/eg_generator.py` (۶۰ قطعه، هر قطعه یک STEP در `cad_out/variant_e/GENERATOR/E-G2xx_*.step`) و `eg_check.py` (بررسی تداخل).
  - کلید `GEN_DETAILED = True` در `e_layout.py`: `e_generator.py` به‌جای پاد پوشی قبلی این ژنراتور را می‌سازد و اعداد ژنراتور در `e_layout` (GEN، GSHAFT، POD، X_GF، X_GR، QUILL) جایگزین می‌شوند. زیرسیستم‌های دیگر دست نخورده‌اند. با `False` پاد قبلی (E-G1xx) برمی‌گردد.
- اجرای همه: `~/micromamba/envs/gr180/bin/python sim/variant_e/eg_em.py` (حدود ۸ دقیقه)، سپس `eg_sleeve`، `eg_thermal`، `eg_rotor`، `eg_joints`؛ `LANG=en_US.UTF-8 freecadcmd cad/variant_e/e_generator.py` و `eg_check.py`؛ در پایان `python3 sim/variant_e/eg_bom.py`.

## ۱. خلاصه

| مورد | مقدار |
|---|---|
| نوع | PM سطحی دوقطبی، **35,000 rpm، 583.3 Hz**، حلقهٔ Sm2Co17 با مغناطش موازی (قطری) |
| ریت | **335 kW شفت پیوسته** در هر دمای محیط 0–45 °C (طرح: 306 kW در 770 °C، 332.4 kW در پیک 850 °C/سقف 315 kW برق) |
| روتور | قطر 120 (سرعت نوک 220 m/s)، آهنربا 74/106 × 272، صفحهٔ ضد جریان گردابی CuCr1Zr به ضخامت 1.5 mm، غلاف کربن T800S به ضخامت 7 mm |
| استاتور | 126/262 × 270، ورق 0.10 mm NO10 چسبی، ۲۴ شیار باز 8.6 × 37 |
| سیم‌پیچی | دولایه، گام 1–11 (10/12)، ۲۴ کویل فرم‌دار × ۲ دور، ۲ مسیر موازی ← **۸ دور سری در هر فاز**؛ هادی Litz مستطیلی فشرده 1260 × 0.20 mm (39.6 mm² مس)، کلاس H، VPI |
| ولتاژ | E_LL = **624 V** در آهنربای 100 °C (642 V در 20 °C)، L_s = **98 µH** (پیچ انتهایی 10 µH)، x = 0.36 pu در 335 kW |
| تبدیل | پل دیودی ۶پالسه ← **AFE استاندارد 400 V**: V_dc = 682 / 696 / 714 V در 335 / 306 / 270 kW شفت (پنجرهٔ 660–760 V) |
| تلفات در 335 kW | **4.94 kW** ← **η = 98.53 %** (الکترومغناطیسی 99.38 %). در 306 kW: 4.77 kW و 98.44 % |
| دما (کنترل‌شده) | سیم‌پیچ داخل شیار 81–83 °C، سر سیم‌پیچ 96–98 °C (نقطهٔ داغ تخمینی ≤ 103 °C)، آهنربا 83–84 °C، یاتاقان 66 °C — **برای 0، 15، 30 و 45 °C محیط تقریباً یکسان** |
| خنک‌کاری | حلقهٔ گلیکول اختصاصی با تأمین ثابت **55 °C** (شیر سه‌راهه + خنک‌کن خشک EC)، هوای فیلترشدهٔ پلنوم با دمندهٔ EC با دور متغیر از فاصلهٔ هوایی |
| روتوردینامیک | هیچ مودی بین 14.0k و 57.2k rpm نیست (بازهٔ 55–108 % خالی). خمش آزاد روتور ژنراتور 99.6k (روتور صلب). پیچش quill 163 Hz |
| ابعاد پاد | 807 × 395 × 490 mm (از کلاهک هوا تا انتهای محافظ quill؛ با جعبه ترمینال)؛ OD بدنه 330 |
| جرم | پاد با روتور و محافظ: **171 kg** (روتور 26.6). با زین‌ها، تیر پایه و دمنده: **278 kg** |
| CAD | ۶۰ قطعه (با همهٔ پیچ‌ها، Helicoilها، پین‌ها و O-ringها) و **۰ هم‌پوشانی** در ۶۹۱ جفت (با خودش و با همهٔ قطعات دیگر E)، ۹۳ سطح تماس |

**تصمیم‌های اصلی**
1. **طول پشته 270 mm و ۸ دور سری** تا ولتاژ DC در همهٔ نقطه‌های کار وسط پنجرهٔ یک AFE استاندارد 400 V باشد (بخش ۴). با 250 یا 260 mm، ولتاژ در 332 kW به 620/651 V می‌رسد و زیر حد 660 V است.
2. **شیار باز + یک هادی Litz مستطیلی فشرده در هر دور** (ترانهاده از ساخت). گزینهٔ «۴ کابل Litz گرد موازی در شیار نیمه‌بسته» رد شد: اختلاف شار نشتی بین کابل‌های موازی جریان گردشی تا ~140 A می‌دهد. با گپ مغناطیسی 25 mm، شیار باز فقط 1.2 % EMF کم می‌کند.
3. **صفحهٔ CuCr1Zr 1.5 mm زیر آهنرباها:** هارمونیک‌های 5 و 7 جریان پل دیودی در قاب روتور با 6f (3.5 kHz) دیده می‌شوند. بدون صفحه، شفت فولادی **953 W** تلفات گردابی دارد (گرمایی که باید از غلاف کربن خارج شود). با صفحه: **55 W**.
4. **آهنربای لایه‌ای 2 mm:** تلفات آهنربا 947 W (۱۲ قطعهٔ تمام‌طول) ← 236 W (برش 10 mm) ← **14 W** (لایه‌های 2 mm).
5. **غلاف کربن، نه Inconel 718:** در 220 m/s، تنش خودی Inconel 396 MPa (570 در 120 %) است. برای هر ضخامتی که جا شود، von Mises در تست چرخش از Rp0.2 بیشتر می‌شود، و غلاف رسانا ~7 kW تلفات گردابی دارد (بخش ۷).
6. **توپی‌های فرورفته (re-entrant) در سپرها:** یاتاقان‌ها داخل محدودهٔ سر سیم‌پیچ‌اند. دهانهٔ یاتاقان 385 mm است (قبلاً 430) و شفت 468 mm (قبلاً 495).
7. **quill توخالی روی مخروط 1:10 شفت** با پیچ کشش مرکزی M12 که از داخل quill سفت می‌شود. چون یاتاقان عقب باید از انتهای شفت رد شود، فلنج پیچی قبلی با این آرایش سازگار نیست.
8. **دمای ثابت:** تأمین گلیکول همیشه 55 °C (در 45 °C محیط هنوز 8 K اختلاف دارد). دور دمنده دمای روتور را روی 85 °C نگه می‌دارد. بنابراین دمای استاتور و روتور به دمای محیط وابسته نیست (بخش ۹).

## ۲. نقطه‌های کار (از `e_cycle.json`)

| حالت | توان شفت (kW) | V_dc (V) آهنربای 100 °C | I_rms (A) | هارمونیک 5 / 7 | ریپل گشتاور 6f |
|---|---|---|---|---|---|
| 250 kW خالص (TIT 730، 30 °C) | 269.6 | 714 | 285 | 12.2 / 6.0 % | 8.8 % |
| 770 °C، 30 °C | 305.8 | 696 | 330 | 10.5 / 5.3 % | 8.2 % |
| پیک 850 °C / سقف 315 kW برق | 332.4 | 683 | 364 | 9.5 / 4.8 % | 7.9 % |
| ریت حرارتی | 335.0 | 682 | 367 | 9.4 / 4.8 % | 7.8 % |

- جریان سینوسی نیست. شکل شبه‌مربعی پل دیودی با هم‌پوشانی کموتاسیون بزرگ (حدود 33° تأخیر) است: THD 11–14 %، و ریپل گشتاور قله‌به‌قله 16 %.
- ریپل 6f در 3.5 kHz است، یعنی 21 برابر بالاتر از مود پیچشی quill (163 Hz)، پس عملاً منتقل نمی‌شود.

## ۳. طراحی الکترومغناطیسی و تأیید با FEM

### ۳.۱ هندسه

| بخش | اندازه |
|---|---|
| شفت 42CrMo4 QT زیر صفحه | Ø71 |
| صفحهٔ CuCr1Zr (43 MS/m) | 71/74 × 296، shrink 0.08–0.12 |
| آهنربا Sm2Co17 | 74.06/106 × 272 (۱ mm بیرون‌زدگی در هر طرف پشته)، ۱۲ قطعهٔ 30°، هر کدام از ۱۳۶ لایهٔ 2 mm |
| حلقه‌های انتهایی 1.4404 | 74/106 × 12 (صفحات بالانس) |
| غلاف | T800S/اپوکسی Tg ≥ 190 °C، 106/120 × 296 |
| فاصلهٔ هوایی مکانیکی | 3.0 mm (برای عبور هوا و رشد روتور) |
| استاتور | قطر داخلی 126، خارجی 262.24 (سنگ برای shrink)، پشته 270، یوغ 31 mm، دندانه 7.9 در دهانه تا 17.6 در ریشه |
| شیار | باز 8.6 × 37، ناحیهٔ گوه 3.8 mm با دو شیار دم‌چلچله‌ای برای گوهٔ EP GC 203 |

### ۳.۲ روش FEM (`eg_fem2d.py`)

- **مدل:** مقطع دوبعدی کامل 360°، المان مثلثی خطی (حدود ۱۷,۵۰۰ گره و ۳۵,۰۰۰ المان، 0.7 mm در فاصلهٔ هوایی)، و حل نیوتن-رافسون روی منحنی B-H.
  - ورق NO10 با ضریب انباشت 0.95، و شفت 42CrMo4.
  - آهنربای خطی با μr = 1.05.
- **چرخش روتور:** روتور (شفت، حلقهٔ کامل آهنربا و غلاف) متقارن محوری است. بنابراین چرخش روتور معادل چرخش بردار Br است: نه مش جدید لازم است و نه sliding band.
- **گشتاور:** به روش Arkkio در لایهٔ میانی فاصلهٔ هوایی. با جریان i_q، گشتاور FEM دقیقاً با 1.5·ψ·i_q برابر است (116.95 در برابر 117.00 N·m).
- **تلفات گردابی روتور:** حل هارمونیک-زمانی مختلط در قاب روتور، برای 6f، 12f و 18f (هارمونیک‌های 5/7، 11/13 و 17/19 جریان) با رسانایی صفحه، شفت و آهنربا.
- **پیچ انتهایی:** مدل رشته‌ای سه‌بعدی ۴۸ سر کویل (شکل الماسی، زاویهٔ 32°، بیرون‌زدگی 88 mm) با انتگرال‌های Neumann و تصویر 0.4 در سطح ورق‌ها:
  - **L_ew = 10.4 µH** (بازهٔ 9.5–11.8 برای تصویر 0 تا 1)
  - فرمول تجربی λ_w = 0.3 حدود 30 µH می‌داد که بیش از حد بدبینانه است.
- **طول مؤثر سه‌بعدی:** L_eff = L + 4 mm (پراکندگی انتهایی منهای نشت انتهای آهنربا به شفت)، با عدم قطعیت ±2 % روی EMF که در تست بی‌باری اندازه‌گیری می‌شود.

### ۳.۳ نتایج

| مورد | مقدار |
|---|---|
| B گپ (اصلی، وسط گپ) | 0.557 T؛ هارمونیک‌های 3/5/7 زیر 0.06 %؛ شیار 23/25: 11.5 % (فقط در سطح استاتور) |
| شار پیوندی (پیک فاز) | 0.1391 Wb-دور (دوبعدی 0.1371) |
| EMF | E_ph = 360.5 V، **E_LL = 624.4 V** (100 °C)؛ 642.4 V (20 °C)؛ 619.9 V (120 °C) |
| هارمونیک EMF | عملاً صفر. حلقهٔ موازی‌مغناطیس میدان دوقطبی خالص می‌دهد و هارمونیک شیار فقط در مؤلفهٔ اصلی EMF اثر دارد |
| گشتاور cogging | 0.004 N·m قله‌به‌قله (حلقهٔ کامل، بدون لبهٔ قطب) |
| ضریب سیم‌پیچی | k_w1 = 0.925، k_w5 = 0.053، k_w7 = 0.041 |
| اندوکتانس | L_d = L_q = 86.3 µH (دوبعدی) → L_s = 98.0 µH (با 3D و پیچ انتهایی)، X_s = 0.359 Ω |
| بار الکتریکی / چگالی جریان | A = 44.5 kA/m، J = 4.63 A/mm² در 335 kW |
| مقاومت | MLT = 1.104 m، R_ph = 2.07 mΩ (20 °C)، 2.64 mΩ در 90 °C (با کابل‌های خروجی) |
| بار 335 kW (FEM با جریان واقعی پل) | گشتاور −90.4 N·m (مدار: −90.3)، B ماکزیمم دندانه 1.40 T، صدک ۹۵: 0.97 T، یوغ 0.94–1.31 T |

**مطالعهٔ طول پشته** (همان مقطع، صفحهٔ 1.5 mm):

| پشته (mm) | E_LL (V) | V_dc در 270 kW | V_dc در 332 kW |
|---|---|---|---|
| 250 | 579 | 651 | 620 ✗ |
| 260 | 602 | 682 | 651 ✗ |
| **270** | **624** | **714** | **683 ✓** |
| 280 | 647 | 745 | 715 (نزدیک سقف در بار کم) |

## ۴. پل دیودی، پنجرهٔ ولتاژ DC و AFE

**پنجره:**
- AFE استاندارد کلاس 400 V، مثلاً ABB ACS880-207، Danfoss VACON NXA، Siemens S120 ALM یا Inovance (CN).
- برای صادرات به شبکهٔ 400 V با +10 % باید V_dc ≥ √2 × 440 × 1.06 = **660 V** باشد.
- سقف کاری **760 V** است (زیر آستانهٔ chopper ترمز ~780–800 V؛ با datasheet تأیید شود).

**مدل:** `eg_bridge.py`
- ژنراتور: EMF از FEM، L_s، R
- ۶ دیود (1.0 V + 1 mΩ)
- لینک DC سخت که AFE آن را نگه می‌دارد
- حل اویلر ضمنی با نیوتن در هر گام؛ پس از ۲۰ تناوب پایا است
- بدون چوک DC (اندوکتانس 98 µH ژنراتور کافی است)

| حالت | آهنربای 20 °C | آهنربای 100 °C | آهنربای 120 °C |
|---|---|---|---|
| 270 kW (250 خالص) | 741 V | 714 V | 707 V |
| 306 kW (770 °C) | 724 V | 696 V | 689 V |
| 332 kW (850 °C) | 712 V | 683 V | 676 V |
| 335 kW | 711 V | 682 V | 675 V |

- **نتیجه:** AFE استاندارد 400 V در هر سه نقطهٔ خواسته‌شده (770 °C، 850 °C و استارت) و در کل بازهٔ دمای آهنربا کار می‌کند. حاشیهٔ پایین ≥ 15 V و حاشیهٔ بالا ≥ 19 V است.
- **توان در 100 % دور برحسب V_dc** (آهنربای 100 °C):

| V_dc (V) | 660 | 680 | 700 | 720 | 740 | **760** | 780 | 800 | 840 |
|---|---|---|---|---|---|---|---|---|---|
| P_dc (kW) | 371 | 331 | 291 | 250 | 209 | **167** | 125 | 84 | 10 |

- **بار جزئی:** زیر ~167 kW در 100 % دور، V_dc باید از 760 V بیشتر شود، که مجاز نیست. پس دور کم می‌شود. این با قانون کنترل نسخهٔ E هم سازگار است، چون دور فقط برای بار جزئی کم می‌شود:
  - 150 kW در 99.1 % دور
  - 100 kW در 96.2 %
  - 60 kW در 93.8 %
  - بی‌باری (FSNL) حداکثر در **86 %** دور (√2·E = 883 V)
- **حلقهٔ کنترل:**
  - کنترل‌کنندهٔ دور، مقدار مرجع V_dc را به AFE می‌دهد. با پل دیودی، V_dc جریان و گشتاور ژنراتور را تعیین می‌کند.
  - کنترل‌کنندهٔ سوخت، TIT و توان را تعیین می‌کند.
- **استارت:**
  - K2 (اینورتر استارت + فیلتر سینوسی) بسته و K1 (پل) باز است. موتورکردن 0 → 55 % (321 Hz، ≤ 500 Hz) و روشن‌شدن در ~22 %.
  - ولتاژ لازم در 55 %: 356 V، در برابر 430 V که اینورتر از 660 V DC می‌دهد.
  - سپس K2 باز و K1 بسته می‌شود. پل خودبه‌خود قطع است: √2·E(55 %) = 500 V < 660 V.
  - GT با سوخت شتاب می‌گیرد در حالی که AFE ولتاژ را روی 760 V نگه می‌دارد. تا 86 % دور صادراتی نیست؛ بعد بار با دور بالا می‌رود.
  - **فیلتر سینوسی** اجباری است: بدون آن، لبه‌های PWM هم عایق Litz و هم تلفات روتور را زیاد می‌کنند.
- **گزینهٔ 690 V با ترانس** (برای مقایسه):

| | AFE 400 V (انتخاب) | AFE کلاس 690 V + ترانس 400/525 V |
|---|---|---|
| سیم‌پیچی | ۸ دور، پشته 270 | ۱۲ دور (۳ دور در کویل)، پشته 239 |
| E_LL | 624 V | 832 V |
| V_dc در 270/306/332 kW | 714 / 696 / 683 | 927 / 900 / 880 (پنجرهٔ 870–1100) |
| کمترین صادرات در 100 % دور | 167 kW | 29 kW |
| FSNL | ≤ 86 % دور | ≤ 93.5 % |
| هزینه | — | ترانس 350 kVA (~4 kW تلفات = −0.2 واحد راندمان خالص، ~1.1 t، قیمت)، AFE گران‌تر |

**توصیه:** AFE استاندارد 400 V + برنامهٔ دور در بار جزئی، چون کار پیوستهٔ ۲۴/۷ در 250–315 kW است. گزینهٔ 690 V فقط وقتی لازم است که کار طولانی در بار کم و دور کامل بخواهیم.

**اجزای سمت ژنراتور (BOM):**
- کنتاکتورهای K1 (500 A) و K2 (150 A) با قفل مکانیکی
- فیلتر سینوسی برای اینورتر استارت
- پایش عایق روی لینک DC، چون سیستم IT است (Bender iso685)
- chopper ترمز در BOM اصلی است (E-D102)

## ۵. مشخصات سفارش قطعات خریدنی

### ۵.۱ ورق‌های استاتور (E-G202)

- **فولاد:**
  - ورق NO 3 %Si با ضخامت **0.10 mm** و کاملاً پرداخت‌شده؛ مثلاً NO10 (Surahammar/Cogent SE)، Baosteel B10AV1200 (CN)، یا ورق نازک JFE / Nippon Steel (JP).
  - **تلفات تضمینی** (Epstein، IEC 60404-2): W10/400 ≤ 10 W/kg و W10/1000 ≤ 30 W/kg.
  - J5000 ≥ 1.60 T.
  - پوشش self-bonding (backlack) کلاس ≥ 180 °C.
- **برش:**
  - لیزر fine-cut با burr ≤ 0.02 mm؛ یا wire-EDM شیارها روی پشتهٔ چسبیده (بهترین گزینه).
  - هر ورق: OD 262.6 (برای سنگ)، قطر داخلی 126.00 ± 0.02، ۲۴ شیار 8.60 (+0.05/0) × 37.0 با دو شیار گوه 0.8 × 2.0.
- **پشته:**
  - 270.0 ± 0.3 mm (حدود ۲۸۰۰ ورق)، چسبیده روی ماندرل.
  - **بدون جوش، بدون interlock و بدون خار.**
  - تعامد پیشانی‌ها ≤ 0.1، هم‌خطی شیارها ≤ 0.05.
- **پس از چسب:** سنگ OD به 262.240 (0/−0.025). قطر داخلی بدون سنگ است (کنترل 126.00 +0.05/0).
- **کنترل:** گزارش Epstein بچ ورق، مقاومت بین‌لایه (IEC 60404-11) ≥ 10 Ω·cm²، تست تلفات حلقه‌ای پشته در 583 Hz و 1.0 T.
- **تأمین:** Kienle+Spiess (DE)، Euro Group (IT)، Surahammar/Cogent (SE)، JFE (JP)، Baosteel (CN).
- **بدیل:** NO20 (0.20 mm) فقط با +~0.8 kW تلفات آهن (حدود +0.25 واحد).

### ۵.۲ آهنرباها (E-G212)

- **گرید:**
  - Sm2Co17، کلاس YXG-32H: Br 1.10–1.13 T، HcJ ≥ 1990 kA/m (25 kOe)، (BH)max ≥ 230 kJ/m³.
  - α(Br) ≈ −0.035 %/K، β(HcJ) ≥ −0.20 %/K.
  - **squareness: Hk ≥ 0.70 HcJ** (برای اتصال کوتاه، بخش ۸).
  - T_max 300 °C یا بیشتر.
- **شکل:**
  - ۱۲ قطعهٔ کمانی 30° (29.4° + لایهٔ چسب)، شعاع داخلی 37.03 (+0.02/0)، شعاع خارجی 53.0 + 0.4 برای سنگ مخروطی پس از چسب.
  - طول 272 ± 0.1.
  - هر قطعه **از ۱۳۶ لایهٔ 2.00 ± 0.02 mm** با اپوکسی عایق ساخته می‌شود؛ مقاومت بین لایه‌ها ≥ 1 kΩ توسط سازنده گزارش شود.
- **مغناطش:**
  - حلقه موازی (قطری) است: هر قطعهٔ k (مرکز در θk = 15° + 30°k) جهت مغناطش 0° سراسری دارد، یعنی زاویهٔ −θk نسبت به خط شعاعی خودش.
  - ۶ زاویهٔ متمایز (15، 45، 75، 105، 135، 165°)، هر کدام ۲ عدد، با تلرانس ±1°.
  - قطعه‌ها پیش‌مغناطیس و شماره‌گذاری شده تحویل شوند، با علامت N.
- **کنترل:** Br و HcJ نمونهٔ هر بچ (هیسترزیس‌گراف، IEC 60404-5)، شار هر قطعه با Helmholtz (±1.5 %)، گزارش ابعاد و زاویه.
- **تأمین:** Shin-Etsu (JP)، Ningbo Yunsheng (CN)، Hangzhou Permanent Magnet Group (CN)، Xiamen Tungsten (CN)، VAC (DE).

### ۵.۳ غلاف کربن (E-G214) — بخش ۷

- **الیاف و رزین:** T800S (یا T700S) 24K، Vf 0.60 ± 0.02، اپوکسی Tg ≥ 190 °C (DMA)، تخلخل ≤ 1 %.
- **چیدمان:** 88 % حلقوی + 12 % ±15° (دو لایهٔ 0.4 mm در داخل و خارج).
- **ابعاد:** ID مخروطی 1:500 روی ماندرل سنگ‌خورده؛ پس از پرس، OD 120 h6 سنگ می‌شود؛ طول 296.
- **انطباق:** تداخل قطری 0.57 ± 0.02 mm.
- **کنترل:**
  - C-scan فراصوتی
  - تست کشش حلقوی split-disk روی ۲ حلقهٔ شاهد از همان پیچش
  - تست چرخش داغ (بخش ۱۸)
- **تأمین:** e+a (CH)، BUCCI Composites (IT)، CompoTech (CZ)؛ الیاف Toray (JP) یا Zhongfu Shenying (CN).

### ۵.۴ سیم Litz (E-G310)

- **ساختار:** 1260 × 0.20 mm (7 × 180)، مستطیلی فشرده.
  - لخت: 7.30 × 7.65، ضریب مس 0.71.
  - با عایق: 7.70 × 8.05 (نوار پلی‌ایمید 2 × 25 µm نیم‌پوش + روکش نخ شیشه).
- **رشته:** مینای grade 2، کلاس حرارتی 200 (IEC 60317-0-2).
- **مقاومت DC:** ≤ 0.443 mΩ/m در 20 °C.
- **طول:** حدود 65 m.
- **تأمین:** Elektrisola (DE)، Pack Feindrähte (DE)، Rudolf Pack (DE)، Furukawa (JP).

### ۵.۵ یاتاقان‌ها و قطعات استاندارد

- **یاتاقان‌ها:** 7008-E (جلو، locating) و 7008-C (عقب، شناور)، هیبرید با ساچمهٔ Si3N4، P4.
  - FAG HCB7008 (DE)، SKF (SE)، GMN (DE)، NSK (JP)، ZWZ/LYC (CN).
  - همان شمارهٔ هسته است.
  - ساچمهٔ سرامیکی جریان یاتاقان ناشی از ولتاژ مشترک AFE را هم قطع می‌کند.
- **مهره‌های دقیق:** M35×1.5 با OD 52 × 12 (Spieth MSF / SKF KMD 7).
- **فنر موجی:** 300 N (Lesjöfors، Scherdel).

## ۶. مشخصات سیم‌پیچی (برای کارگاه سیم‌پیچی)

| مورد | مشخصه |
|---|---|
| شیار / لایه | ۲۴ شیار باز، دولایه، در هر شیار ۴ هادی روی هم (۲ هادی در هر لایه = یک ضلع کویل ۲دوره) |
| کویل | ۲۴ کویل الماسی فرم‌دار، **۲ دور**، گام **1–11** (10 شیار = 150° الکتریکی) |
| گروه‌ها | فاز A: کویل‌های 1–4 (+) و 13–16 (−)؛ فاز B: 9–12 (+) و 21–24 (−)؛ فاز C: 17–20 (+) و 5–8 (−). شمارهٔ کویل = شیار ضلع بالایی |
| مسیرها | ۲ مسیر موازی (هر گروه قطبی یک مسیر، ۴ کویل سری = ۸ دور). دو مسیر در حلقهٔ اتصال جلو موازی می‌شوند |
| خروجی | ۶ سیم U1 V1 W1 / U2 V2 W2 (هر کدام 2 × 70 mm² سیلیکون 180 °C)؛ **ستاره در جعبه ترمینال** با شینهٔ مسی روی U2 V2 W2 (تست فاز به فاز ممکن است) |
| عایق شیار | لاینر U شکل APA (آرامید/پلی‌ایمید/آرامید) 0.31 mm با کاف 5 mm بیرون از پشته؛ جداکنندهٔ لایه‌ها APA 0.5؛ فیلر بالا 0.2؛ گوهٔ EP GC 203 به ضخامت 3 mm. **مواد با نام تجاری آمریکایی استفاده نمی‌شود:** آرامید Metastar (CN) یا Teijin (JP)، پلی‌ایمید Kaneka/Ube (JP)، لمینیت Krempel (DE) |
| سر سیم‌پیچ | بخش صاف 12 mm، زاویهٔ عبور 32°، دماغه ~68 mm، بیرون‌زدگی **88 mm**؛ کاغذ آرامید 0.25 بین گروه‌های فاز؛ ۲ حلقهٔ نگه‌دارندهٔ شیشه-اپوکسی در هر طرف با بند نخ شیشه |
| اتصال‌ها | سر Litz با جوش فراصوتی یا crimp + جوش مقاومتی در کفشک لوله‌ای مسی (Schunk Sonosystems، DE). لحیم معمولی روی مینای کلاس 200 کار نمی‌کند |
| PT100 | ۶ عدد در شیار (تخت 3 × 10 × 100، کلاس A، 3 سیمه، بین لایه‌ها در وسط پشته، ۲ عدد در هر فاز، در شیارهای 2/10/18 و 14/22/6؛ ۳ کاری + ۳ یدک) + ۴ عدد در سر سیم‌پیچ (۲ عدد در دماغهٔ عقب که داغ‌ترین نقطه است، ۲ عدد جلو)، چسبیده و بسته‌شده پیش از VPI |
| VPI | رزین کلاس H بدون حلال (Elantas / Von Roll)، ۲ سیکل و پخت 160 °C؛ کانال گلیکول ژاکت پیش از VPI بسته شود |
| ترتیب | اول stator در ژاکت shrink شود (بخش ۱۶)، بعد سیم‌پیچی؛ ۱۰ ضلع بالایی اول بلند نگه داشته شوند (lifting the throw) |
| تست‌ها | مقاومت هر کویل پیش از اتصال (±1 %)؛ پس از VPI: IR ≥ 1 GΩ در 1 kV DC (40 °C)؛ hipot 2.3 kV AC یک دقیقه (2U + 1 kV)؛ surge 3.5 kV (IEC 60034-15)؛ اختلاف مقاومت فازها ≤ 1 %؛ PD inception ≥ 1.5 kV |

## ۷. غلاف نگه‌دارنده: کربن در برابر Inconel 718 (`eg_sleeve.json`)

**مدل:**
- المان محدود محوری یک‌بعدی تنش-صفحه‌ای با چهار لایه: شفت، صفحهٔ مسی، آهنربای قطعه‌قطعه (بدون ظرفیت حلقوی کششی) و غلاف ارتوتروپیک.
- انطباق‌ها به‌صورت قید تماسی با ضریب لاگرانژ مدل شده‌اند. اگر فشار تماس کششی شود، قید آزاد و دوباره حل می‌شود.
- بارها: حرارتی و گریز از مرکز.

**معیارها:**
- تماس آهنربا/صفحه ≥ 10 MPa در 108 % (trip) با روتور سرد 0 °C؛ این حاشیه آسودگی خزش رزین را پوشش می‌دهد.
- تماس ≥ 0 در **تست چرخش داغ 120 %** (روتور 100 °C).
- تنش حلقوی ≤ 0.40 UTS_eff در 100 % داغ و ≤ 0.60 در تست.

| گزینه | تداخل قطری (mm) | تنش حلقوی 100 % داغ (MPa) | تست چرخش (MPa) | SF روی UTS |
|---|---|---|---|---|
| T700S، 6 mm | 0.797 | 1165 | 1203 | 1.93 |
| T700S، 7 mm | 0.643 | 991 | 1027 | 2.28 |
| T800S، 6 mm | 0.696 | 1191 | 1234 | 2.16 |
| **T800S، 7 mm (انتخاب)** | **0.563** | **1018 (40 % UTS_eff)** | **1060** | **2.53 / 2.43** |
| T800S، 8 mm | 0.464 | 890 | 930 | 2.89 (ولی گپ مغناطیسی +1 mm و −3 % EMF) |
| Inconel 718، 5 / 7 / 9 mm | 0.98 / 0.67 / 0.50 | von Mises 1955 / 1443 / 1157 | همان | **0.53 / 0.71 / 0.89 روی Rp0.2** ✗ |

**انتخاب T800S به ضخامت 7 mm:**
- تماس در trip سرد 14 MPa و در تست داغ 17 MPa است. در 120 % سرد (که شرط تست نیست) تماس باز می‌شود.
- فشار آهنربا روی صفحه بین 59 MPa (100 % داغ) و 159 MPa (ایستا داغ) است و همیشه فشاری می‌ماند.
- **Inconel:**
  - تنش خودی 396 MPa در 100 % و 570 MPa در 120 %.
  - تلفات گردابی غلاف رسانا ~0.4 kW از هارمونیک‌های جریان و **~6.8 kW** از هارمونیک شیار (چون غلاف در r = 60 نزدیک دندانه‌هاست).
  - بنابراین رد شد.

**مونتاژ غلاف** (پیمانکار غلاف):
1. ماندرل و OD روتور هر دو مخروطی 1:500.
2. روتور در بخار LN2 تا **−150 °C** سرد می‌شود (غوطه‌وری نه، به‌خاطر شوک حرارتی SmCo). این 0.18 mm انقباض قطری می‌دهد.
3. غلاف در 20 °C با پرس سروهیدرولیک فشار داده می‌شود، تا کورسی که تداخل را می‌سازد (~280 mm). نیرو و کورس ثبت می‌شود.
4. نیروی پرس ~**320 kN** است (μ 0.05 با فیلم خشک PTFE؛ بدون سرمایش 465 kN). تنش محوری در لبهٔ فشار 128 MPa است که با لایه‌های ±15° مجاز است.
5. حلقهٔ فشار دوتکه روی کل پیشانی غلاف می‌نشیند.
6. پس از گرم‌شدن: سنگ OD و کنترل تماس با فراصوت.

## ۸. تلفات، راندمان، اتصال کوتاه و دی‌مغناطیس

| تلفات (W) | 270 kW (250 خالص) | 306 kW (770 °C) | 332 kW (850 °C) | 335 kW |
|---|---|---|---|---|
| مس DC (90 °C، با هارمونیک‌ها) | 643 | 862 | 1047 | 1066 |
| مجاورت Litz (FEM میدان شیار) | 6 | 9 | 11 | 11 |
| آهن NO10 (برتوتی هارمونیکی، ×1.25 دندانه / ×1.15 یوغ) | 965 | 927 | 894 | 891 |
| آهنربا (لایهٔ 2 mm) | 16 | 17 | 17 | 17 |
| صفحهٔ Cu + شفت | 55 | 56 | 56 | 55 |
| غلاف/حلقه‌ها | 5 | 5 | 5 | 5 |
| باد (گپ 1194 + پیشانی‌ها 52 + پله‌ها/لابیرنت‌ها 61) | 1307 | 1307 | 1307 | 1307 |
| یاتاقان‌ها (2 × 7008، جت روغن) | 1586 | 1586 | 1586 | 1586 |
| **جمع** | **4584** | **4768** | **4922** | **4938** |
| **راندمان ژنراتور** | **98.30 %** | **98.44 %** | **98.52 %** | **98.53 %** |

**نکات:**
- تلفات آهن در بار کمتر از بی‌باری است (1076 W). علت: جریان پل دیودی ~33° پس‌فاز است و میدان آرمیچر مؤلفهٔ ضدمغناطیس دارد.
- **باد:**
  - فرمول اولیهٔ `e_pmg.py` ضریب ½ را نداشت. درست آن P = ½ C_M π ρ ω³ R⁴ L (Bilgen–Boulos) است و ضریب جریان محوری Yamada هم اعمال شده.
  - گپ 3 mm و سرعت هوای محوری 36 m/s.
- **مقایسه با بودجهٔ چرخه** (`e_cycle`، 7.55 kW در 305.8 kW): این طرح 4.77 kW تلفات دارد، یعنی **حدود +2.8 kW برق بیشتر**.

**اتصال کوتاه سه‌فاز ناگهانی در 35k** (حل بستهٔ dq):
- I_ss = 1004 A rms (2.75 pu)
- پیک گذرا 2807 A
- **گشتاور پیک 295 N·m (3.2 × ریت)** که با فرکانس 583 Hz متناوب است.
- ضریب انتقال به quill 0.08 است، پس τ quill = 26 MPa، با حد 5 × ریت = 103 MPa.

**دی‌مغناطیس:**
- **اتصال کوتاه دائم** در 150 °C: B∥ حداقل −0.07 T، **۰ % حجم زیر زانو**.
- **اولین پیک گذرای اتصال کوتاه ناگهانی** (i_d = −2Ψ/L، بدترین لحظه): 2.3 % حجم آهنربا (لایهٔ سطحی روی محور d) در 100 °C زیر زانوی تخمینی است (Hk = 0.7 HcJ). در 150 °C این عدد 9.7 % است.
- **نتیجه:**
  - squareness بالا (Hk ≥ 0.70 HcJ) سفارش شود.
  - دمای روتور زیر 100 °C نگه داشته شود (کنترل در 85 °C است).
  - پس از هر اتصال کوتاه، EMF در تست بی‌باری اندازه‌گیری شود.
  - افت تخمینی EMF در بدترین حالت ≤ 0.5 % است.

## ۹. سیستم خنک‌کاری و کنترل دما (`eg_thermal.json`)

### ۹.۱ مفهوم: دو حلقهٔ مستقل که دمای استاتور و روتور را ثابت نگه می‌دارند

- **استاتور: حلقهٔ گلیکول اختصاصی** (MEG 35 %، 30 L/min).
  - **دمای تأمین همیشه 55 °C.** این دما در 45 °C محیط (+2 K هوای برگشتی) با 8 K اختلاف هنوز قابل رسیدن است.
  - پس استاتور در 0 °C و در 45 °C همان سیال را می‌بیند.
  - حلقهٔ E-W100 اصلی (مبدل و روغن) جدا می‌ماند، چون مبدل‌ها معمولاً ≤ 40–45 °C ورودی می‌خواهند.
- **روتور، فاصلهٔ هوایی و سر سیم‌پیچ: هوای فیلترشدهٔ پلنوم.** هوای پلنوم از قبل G4 + F7 است و یک کارتریج F9 هم روی دمنده هست.
  - مسیر: دمندهٔ EC پرفشار ← کلاهک جلو ← ۱۲ سوراخ سپر جلو ← سر سیم‌پیچ جلو ← فاصلهٔ هوایی ← سر سیم‌پیچ عقب ← ۱۲ سوراخ سپر عقب ← پلنوم.
  - **دور دمنده عملگر دمای روتور است.**
  - **چرا نه هوای کمپرسور:** 212 °C است.
  - **چرا نه مکش دهانهٔ کمپرسور** (~10–15 kPa زیر فشار پلنوم):
    - حفرهٔ ژنراتور زیرفشار می‌شود و مه روغن یاتاقان‌ها را به سیم‌پیچ می‌کشد.
    - دبی قابل کنترل نیست.
    - در توقف و موتورکردن جریانی ندارد.
  - با دمنده، حفره ~3 kPa بالای محفظه‌های یاتاقان است. همین هوای بافر لابیرنت‌ها را تأمین می‌کند.
  - داخل محافظ quill با ۴ شکاف به پلنوم وصل است، پس مکش دهانه روی آب‌بند عقب اثر ندارد.
- **یاتاقان‌ها:** جت روغن از سیستم اصلی، ورودی 55 °C.

### ۹.۲ ژاکت گلیکول (E-G201)

- **کانال:**
  - مارپیچ **دوراهه** 18 × 8 mm، گام هر راه 46 mm، 6.5 دور، طول هر راه 5.8 m.
  - در هر دو سر یک شیار توزیع (manifold) دارد. ورودی عقب (سمت هوای داغ) و خروجی جلو است، پس جریان غیرهمسو با هوا است.
- **هیدرولیک:**
  - 15 L/min در هر راه: v = **1.74 m/s**، Re = 16,100.
  - Gnielinski × ضریب Dean 1.27 ← **h = 7200 W/m²K**. بازده فین دیواره‌ها 0.75.
  - Δp ژاکت **28 kPa**.
  - ΔT گلیکول در 335 kW فقط ~1 K است، یعنی ژاکت تقریباً هم‌دما است.
- **آب‌بندی:**
  - در هر سر ۲ O-ring EPDM و بینشان یک شیار نشتی 2 × 1 mm.
  - شیار نشتی با G1/8 به یک سوئیچ شناور وصل است: اگر O-ring نشت کند، گلیکول به‌جای استاتور به آشکارساز می‌رسد.

### ۹.۳ مسیر هوا و دمنده

| دبی (kg/s) | m³/h | Δp (Pa) | توان دمنده (W) | آهنربا در 45 °C، 335 kW (°C) | نقطهٔ داغ سیم‌پیچ (°C) |
|---|---|---|---|---|---|
| 0.015 | 46 | 466 | 14 | 104 | 119 |
| 0.025 | 76 | 1075 | 54 | 94 | 110 |
| 0.035 | 107 | 1897 | 134 | 86 | 104 |
| 0.045 | 137 | 2927 | 265 | 82 | 98 |
| 0.050 (حداکثر طراحی) | 152 | 3475 | 349 | — | — |

- **تجزیهٔ Δp در 0.05 kg/s:** گپ 2798، سوراخ‌های سپرها 275، F9 168 و کانال 234 Pa. سرعت محوری در گپ 39 m/s و h گپ ~520 W/m²K.
- **دمنده:** EC پرفشار 160 m³/h در 4 kPa با موتور 0.55 kW (ebm-papst، Elektror، Becker، FPZ). در کار عادی 42–78 % دور است، یعنی 25–170 W.

### ۹.۴ خنک‌کن خشک و پمپ

- **گرمای حلقه:** گرمای واقعی به گلیکول در 335 kW و 45 °C برابر 1.63 kW است. بقیه به هوا (1.5 kW)، روغن (1.6 kW) و پلنوم می‌رود.
- **خنک‌کن خشک:**
  - طراحی برای **150 %** = 2.4 kW، با هوای 47 °C و تأمین 55 °C.
  - UA ≥ 450 W/K، یک فن EC Ø450–500 (2000 m³/h، 150 W).
  - در 45 °C محیط فن روی 85 % و ~90 W کار می‌کند؛ در 30 °C روی 14 % (عملاً صفر W).
  - Güntner (DE)، LU-VE (IT)، Thermokey (IT)، Kelvion (DE).
- **پمپ:**
  - 30 L/min در 103 kPa (ژاکت 28، خنک‌کن 30، لوله‌ها 20، شیر 15، صافی 10).
  - ECM با سیگنال 0–10 V و ~150 W (Grundfos MAGNA3 25-120 یا Wilo Stratos MAXO).
- **سایر اجزای حلقه:** شیر سه‌راههٔ DN25 kvs 6.3 (ESBE/Belimo)، منبع انبساط 12 L، هیتر 2 kW (استارت سرد و جلوگیری از میعان)، و فلومتر vortex.

### ۹.۵ شبکهٔ حرارتی (۶۰ گره)

**ساختار:**
- ۵ برش محوری. در هر برش: گلیکول، دیوارهٔ ژاکت، یوغ، دندانه، مس لایهٔ پایین و بالا، هوای گپ، غلاف، آهنربا و شفت.
- در هر طرف: سر سیم‌پیچ، هوای فضای انتهایی، سپر، انتهای شفت و یاتاقان؛ به‌علاوهٔ بدنه.
- مقاومت‌ها: لاینر APA (k 0.2)، Litz با رزین (k_eq 1.5)، تماس shrink (3000 W/m²K)، CFRP عرضی (0.7) و چسب آهنربا.
- انتقال حرارت: گپ (Dittus-Boelter روی سرعت مؤثر × 1.2 تیلور)، سر سیم‌پیچ (41.4 + 6.22 v)، و دیسک دوار.
- تلفات مس وابسته به دما است.

**پایا، با کنترل فعال** (تأمین 55 °C و دمنده روی دمای روتور 85 °C):

| حالت | دمنده | مس شیار max | سر سیم‌پیچ جلو/عقب | نقطهٔ داغ تخمینی | آهنربا max | یاتاقان | هوای خروجی |
|---|---|---|---|---|---|---|---|
| 335 kW، 0 °C | 42 % | 81.4 | 60.0 / 97.5 | 102.5 | 82.8 | 64.8 | 87.6 |
| 335 kW، 15 °C | 49 % | 81.6 | 65.0 / 97.3 | 102.3 | 83.3 | 65.0 | 87.4 |
| 335 kW، 30 °C | 59 % | 81.9 | 70.3 / 96.9 | 101.9 | 83.7 | 65.3 | 87.2 |
| **335 kW، 45 °C** | **78 %** | **82.1** | **75.9 / 96.2** | **101.2** | **84.2** | **65.6** | **86.8** |
| 306 kW، 30 °C | 57 % | 79.6 | 66.7 / 92.8 | 97.8 | 83.5 | 65.3 | 86.4 |
| 270 kW، 30 °C | 54 % | 77.2 | 62.9 / 88.4 | 93.4 | 83.2 | 65.2 | 85.6 |
| 335 kW، 45 °C، **دمنده خراب** (فقط نشتی) | 8 % | 102.3 | 104.9 / 122.8 | 127.8 | 124.5 | 66.5 | 116.0 |
| 335 kW، 45 °C، **پمپ گلیکول خاموش** | 100 % | 114.4 | 89.8 / 117.3 | 122.3 | 91.6 | 67.1 | 97.6 |

- **نتیجه:** در کل بازهٔ 0–45 °C، سیم‌پیچ داخل شیار ±0.4 K، سر سیم‌پیچ ±0.7 K و آهنربا ±0.7 K تغییر می‌کند. **دمای ماشین مستقل از دمای محیط است.**
- حد کلاس H (180 °C) با بیش از 75 K و حد روتور (150 °C) با بیش از 65 K فاصله دارند.
- حتی با خرابی دمنده یا پمپ در 45 °C و بار کامل، ماشین زیر آلارم‌ها (130/140 °C) می‌ماند. بنابراین این خرابی‌ها «آلارم + کاهش بار کنترل‌شده» هستند، نه trip فوری.

### ۹.۶ گذرا

| سناریو | نتیجه |
|---|---|
| استارت سرد → 335 kW در 30 °C | ۹۰ % افزایش دما در 26–31 دقیقه؛ پایا: مس 81.4، سر سیم‌پیچ 95.7، آهنربا 83.7 °C |
| استارت سرد در 0 / 45 °C | پایای 3–4 ساعت: مس 80.6 / 81.9، آهنربا 82.9 / 84.1 |
| افزایش محیط 30 → 45 °C در 30 دقیقه در بار کامل | تغییر مس 0.8 K، سر سیم‌پیچ 0.7، آهنربا 0.7؛ دمای تأمین ≤ 0.6 K |
| بار 335 → 150 → 335 kW در 30 °C | بدون L3: مس 72–82 °C (9.4 K)؛ با L3: 76–84 °C (8.0 K)؛ آهنربا 3–4 K |
| خرابی دمنده در 2 h (45 °C) | آهنربا به 126 °C و سر سیم‌پیچ به 125 °C می‌رسد؛ در 1.5 h آلارم نمی‌خورد |
| خرابی پمپ در 2 h (45 °C) | مس در 2 h به 106 °C می‌رسد (پایا 114)؛ آلارم نمی‌خورد |

### ۹.۷ راهبرد کنترل

- **L1 دمای تأمین گلیکول:**
  - سنسور: PT100 TT-G03 پس از شیر سه‌راهه.
  - PI با kp 0.25 /K و Ti 60 s.
  - تقسیم بازه (split range): خروجی 0–1 شیر سه‌راهه است (bypass ← خنک‌کن) و 1–2 فن EC از 15 تا 100 %.
  - پمپ با دبی ثابت 30 L/min کار می‌کند (فلومتر FT-G01).
- **L2 دمای روتور:**
  - سنسورها: پیرومتر IR 8–14 µm روی پیشانی غلاف کربن (ε ≈ 0.9) از درگاه M12 سپر در r 58، و مشاهده‌گر EMF (V_dc، I_dc، دور ← E ← Br ← T؛ 1 % EMF ≈ 29 K).
  - PI با Ti 300 s روی دور دمنده (35–100 %)، با نقطهٔ تنظیم **85 °C**.
- **L3 کف دمای سیم‌پیچ (اختیاری، برای بار جزئی):**
  - SP گلیکول = 55 + 13 × (1 − (P/335)²) °C، به‌صورت پیش‌خور از توان AFE.
  - به‌علاوهٔ یک تریم PI کند (Ti 1200 s، ±5 K) روی بیشترین PT100 شیار به‌سمت 82 °C.
  - هدف: کاهش چرخهٔ حرارتی VPI و Litz.
- **قفل‌ها (interlock):**
  - شرط استارت: دبی گلیکول OK، دمنده روشن، و دمای تأمین > 20 °C (وگرنه هیتر 2 kW).
  - دمنده تا 15 دقیقه پس از توقف روشن می‌ماند.

### ۹.۸ سنسورها، آلارم و trip

| سیگنال | آلارم | trip / اقدام |
|---|---|---|
| PT100 شیار (۶، ۳ فعال) | 140 °C | 155 °C (کلاس H 180؛ مقدار کامل‌بار ~82 °C) |
| PT100 سر سیم‌پیچ (۴، ۲ فعال) | 140 °C | 155 °C |
| روتور (IR + EMF) | 130 °C | 150 °C (حد رزین CFRP و چسب آهنربا؛ SmCo خودش تا 300 °C) |
| PT100 حلقهٔ بیرونی یاتاقان (۲) | 100 °C | 110 °C |
| PT100 تخلیهٔ روغن (۲) | 90 °C | 100 °C |
| دمای تأمین گلیکول | 60 °C (کم: 40 °C) | 65 °C |
| دبی گلیکول | < 24 L/min | < 15 L/min به مدت 10 s ← کاهش بار به 40 % و سپس trip در 155 °C سیم‌پیچ |
| Δp هوا (فیلتر + ژنراتور) | < 60 % مقدار اسمیِ وابسته به دور، یا فیلتر > 200 Pa | trip از طریق سیگنال روتور |
| سطح منبع انبساط / شناور نشتی | پایین / هر نشتی | خیلی پایین |
| ارتعاش (۲ شتاب‌سنج روی سپرها) | 4.5 mm/s | 7.1 mm/s |
| عایق (IMD روی لینک DC) | 100 kΩ | 30 kΩ |

## ۱۰. قطعات، مواد خام و روش ساخت

| تگ | قطعه | مادهٔ خام | روش (CNC ۵محور کاربر مگر خلافش ذکر شود) | نکته |
|---|---|---|---|---|
| E-G200 | بدنه (24.5 kg) | 6082-T6 حلقهٔ فورج/لولهٔ ضخیم d340/280 × 480 | تراش: سوراخ‌های 290 H7 و 286 H7 **در یک بستن**؛ ۵محور برای پورت‌ها و سوراخ‌ها | هم‌محوری ≤ 0.02؛ ۳۲ Helicoil M10؛ پورت‌های G3/4 گلیکول (+y)، G1/8 نشتی، پنجرهٔ سیم، ۴ Helicoil M8 جعبه، سوراخ پین ضدچرخش ژاکت |
| E-G201 | ژاکت (6.6 kg) | لولهٔ 6082-T6 d300/250 × 350 | تراش؛ مارپیچ دوراهه تک‌ابزار (مثل رزوهٔ درشت) | ID 262 H6، OD 290 g6 روی لندها، ۴ شیار O-ring، ۲ شیار نشتی، ۲ رزوهٔ M10 بیرون‌کش |
| E-G202 | پشتهٔ استاتور (66.2 kg) | خرید (بخش ۵.۱) | — | OD سنگ‌خورده |
| E-G203 | صفحات انتهایی | ورق EP GC 203، 1.5 mm | فرز/واترجت | |
| E-G204/205/206 | سیم‌پیچی، سر سیم‌پیچ، گوه‌ها | خرید + کارگاه (بخش ۶) | — | |
| E-G210 | شفت (11.1 kg) | 42CrMo4 +QT، میلهٔ d80 × 500 (UT) | تراش؛ سنگ ژورنال‌ها، لندها و مخروط بین مرغک‌ها در یک نصب | run-out ≤ 2 µm؛ مخروط/ژورنال ≤ 3 µm؛ MPI |
| E-G211 | صفحهٔ مسی | CuCr1Zr (CW106C) d80/68 | تراش، shrink در 220 °C، سنگ OD 74 h5 روی شفت | |
| E-G212 | آهنرباها | خرید (بخش ۵.۲) | چسب روی صفحه با قالب Al غیرمغناطیسی؛ سنگ مخروطی OD | |
| E-G213 | حلقه‌های انتهایی | 1.4404 d110 | تراش؛ ۱۲ سوراخ اصلاح بالانس | |
| E-G214 | غلاف | پیمانکار (بخش ۵.۳) | — | |
| E-G217 | quill توخالی (1.9 kg) | 34CrNiMo6 +QT d60 × 280 | سوراخ عمیق d19، تراش و سنگ، لپ مخروط روی شفت، broach چرخشی AF24، نیتراته پلاسما، ساچمه‌زنی کمر | |
| E-G222/223 | کارتریج‌های SFD | 1.4542 H1025 d90 | تراش + سنگ داخل و خارج | مثل E-B120 هسته |
| E-G226 | شیم جلو | 1.4034 سخت | سنگ تخت به ضخامت لازم | |
| E-G227 | لولهٔ فاصله | 6082 | تراش | |
| E-G230/231 | سپرها (هر کدام 3.9 kg) | 6082-T6 دیسک فورج d340 × 110 | تراش (spigot و سوراخ توپی در یک بستن) + سوراخ‌کاری ۵محور: گالری روغن، درگاه‌های IR، ۱۲ سوراخ هوا | سوراخ 84.24 H6 هم‌محور با spigot ≤ 0.01؛ نوک دندانه‌های لابیرنت d50.60 |
| E-G232 | درپوش یاتاقان جلو | 6082 d110 × 70 | تراش | ۲ درگاه سنسور دور، O-ring شعاعی |
| E-G233 | درپوش آب‌بند عقب | CuSn12 (سایش‌پذیر) | تراش | لابیرنت ۵شیار روی توپی quill |
| E-G234 | کلاهک هوا | 6082 d290 | تراش (یا ورق 4 mm + بوس جوشی) | |
| E-G235 | محافظ quill | لولهٔ 1.4301 76.1 × 5 + فلنج | تراش + TIG | ۴ شکاف تهویه |
| E-G240/241 | جعبه ترمینال/درپوش | بلوک 6082 | فرز ۳محور (کف زینی با ball-end) | |
| E-G242 | بلوک ترمینال | PEEK + پیچ‌های برنجی M12 | فرز | creepage ≥ 12.5 |
| E-G260/261/262 | زین‌ها، تسمه‌ها، تیر پایه | S355، RHS 200×100×6.3 | جوش MAG + تراش cradle | تیر پایه از کف پلنوم به کراس‌های شاسی در x −1050، −600 و −200 پیچ می‌شود |

## ۱۱. اتصال‌ها: پیچ، گشتاور، Helicoil، پین و جک (`eg_joints.json`)

- **فرض‌ها:**
  - همهٔ پیچ‌های داخل آلومینیوم A4-80 هستند و در **HELICOIL plus** (Böllhoff، DE) بسته می‌شوند.
  - μ 0.12 با Loctite 243.
  - پیش‌بار k × Rp0.2 × A_s با k = 0.5 در Al و 0.6 در فولاد.

| اتصال | پیچ | تعداد | رزوهٔ مقابل | پیش‌بار (kN) | گشتاور (N·m) | قفل |
|---|---|---|---|---|---|---|
| سپر جلو/عقب ← بدنه | ISO 4762 M10×35 A4-80 | 2 × 16 | HELICOIL M10 × 1.5D، کور 22 | 17.4 | **29** (ضربدری، ۳ مرحله) | Loctite 243 |
| پین سپر/بدنه | ISO 8734 8 m6 × 24 | 4 | پرس در بدنه، F7 در سپر | — | — | — |
| جک سپرها | M10 (ابزار ISO 4017 M10×40) | 2 در هر سپر | رزوه در فلنج سپر | — | — | — |
| درپوش یاتاقان جلو | ISO 4762 M6×20 | 6 | HELICOIL M6 × 1.5D | 6.0 | **6.2** | Loctite 243 |
| درپوش عقب + فلنج محافظ | ISO 4762 M6×30 | 6 | HELICOIL M6 × 1.5D | 6.0 | **6.2** | Loctite 243 |
| کلاهک هوا | ISO 4762 M6×45 (از داخل بوس‌ها) | 8 | HELICOIL M6 × 1D | 4.8 | **5.0** | واشر فوم EPDM |
| جعبه ترمینال ← بدنه | ISO 4762 M8×25 | 4 | HELICOIL M8 × 1.5D | 11.0 | **14.9** | Loctite 243 + واشر سیلیکون |
| درپوش جعبه | ISO 7380-1 M5×10 A4-70 | 8 | HELICOIL M5 × 1.5D | 2.2 | **1.9** | واشر IP65 |
| بلوک PEEK | ISO 4762 M6×20 A4-70 | 4 | رزوهٔ مستقیم در Al (12) | 2.7 | 2.8 | Loctite 243 |
| کابلشوهای قدرت | مهرهٔ M12 برنجی + واشر بشقابی | 6 | پیچ برنجی پرسی در PEEK | — | **15** | واشر بشقابی |
| **پیچ کشش quill** | ISO 4762 **M12×1.25×25 12.9** | 1 | M12×1.25 در شفت، 24 عمق | **55.7** | **90.5** (MoS2) | drive-up 0.6 ± 0.1 mm |
| **مهره‌های دقیق یاتاقان** | M35×1.5، OD 52 × 12 | 2 | رزوهٔ 6g شفت | 9.0 | **47** | ۲ پیچ قفل شعاعی M5، 4 N·m |
| پیچ چرخ سرعت | ISO 4762 M8×16 12.9 | 1 | M8 در سر شفت | — | 30 | Nord-Lock |
| تسمه‌های زین | ISO 4017 M12×80 8.8 + مهره | 4 | سوراخ رد | 27 | **53** | Nord-Lock |
| زین ← تیر پایه | ISO 4017 M16×40 8.8 | 4 | مهره داخل RHS | 60 | **156** | پس از تراز |
| تیر پایه ← کف/شاسی | ISO 4017 M16×50 8.8 | 6 | از کف پلنوم + دابلر | 60 | **156** | Nord-Lock |
| پین ضدچرخش کارتریج | ISO 8734 4 m6 × 10 | 2 | پرس در شانهٔ توپی، شیار 4.2 در کارتریج | — | — | — |
| پین ضدچرخش ژاکت | ISO 8734 8 m6 × 18 (شعاعی) | 1 | بدنه ← شیار ژاکت | — | — | گشتاور استاتور را منتقل می‌کند |
| رزوه‌های جک | ژاکت 2 × M10، درپوش جلو 2 × M6، توپی quill M14 (از داخل quill)، کارتریج‌ها با پولی‌کش Kukko 21-5 | | | | | |

- **Helicoilها:** M10 × 1.5D (32)، M8 × 1.5D (4)، M6 × 1.5D (12)، M6 × 1D (8)، M5 × 1.5D (8)، M12×1 × 1.5D (درگاه‌های IR).

## ۱۲. انطباق‌ها (ISO 286)

| اتصال | سوراخ | محور | نتیجه |
|---|---|---|---|
| IR یاتاقان روی ژورنال d40 | P4 (0/−6) | 40 js4 (±3.5) | −3.5 … +9.5 µm (IR تا 80 °C گرم شود) |
| OR در کارتریج | 68 H4 (0/+8) | OR P4 (0/−7) | لقی 0 … 15 µm (عقب شناور؛ جلو با درپوش بسته) |
| لایهٔ SFD | 84.24 H6 | کارتریج 84.000 (0/−10) | فیلم شعاعی 0.120 … 0.136 mm |
| صفحهٔ Cu روی شفت | 71 H6 | 71 +0.120/+0.100 | تداخل 0.081 … 0.120؛ صفحه 220 °C |
| آهنربا روی صفحه | 74.06 (+0.02/0) | 74.00 h5 | فاصلهٔ چسب 0.06 … 0.093 (Loctite AA 326 + 7649، Henkel DE) |
| حلقه‌های انتهایی | 74 H7 | 74 h5 | Loctite 648 + گیرهٔ محوری غلاف |
| غلاف روی آهنربا | مخروط 1:500 | مخروط 1:500 | تداخل 0.57 ± 0.02 (کورس پرس) |
| استاتور در ژاکت (shrink) | 262.000 (+0.032/0) | 262.240 (0/−0.025) | 0.183 … 0.240؛ ژاکت 180 °C؛ در 60 °C هنوز 0.08 … 0.13 |
| ژاکت در بدنه | 290 H7 | 290 g6 | لقی 17 … 101 µm + O-ringها |
| spigot سپر جلو / عقب | 290 H7 / 286 H7 | 290 g6 / 286 g6 | لقی 17 … 101 + ۲ پین 8 m6 |
| quill روی مخروط | 1:10 لپ‌شده (تماس ≥ 85 %) | 1:10 سنگ | drive-up 0.6 mm ≈ تداخل قطری 0.06؛ ظرفیت 716 N·m |
| سوکت quill روی شش‌گوش هسته | AF 24.020 … 24.040 | AF 23.990 … 24.000 (crowned) | 0.020 … 0.050 روی تخت‌ها؛ لغزش ±1 mm |
| لابیرنت‌ها | d50.60 (+0.05/0) | 50 h6 | شعاعی 0.30 … 0.33 (orbit SFD + حرارت)؛ بیرونی: توپی quill 56 h6 در 56.60 |
| چرخ سرعت | 38 H6 / 30 H6 | k5 | گیره بین IR (یا مهره) و پیچ |

**موقعیت محوری:**
- یاتاقان جلو (7008-E) locating است. کارتریج آن با شیم E-G226 (0.5–2.0 mm) بین شانهٔ توپی و درپوش بسته می‌شود.
- مرکز آهنربا نسبت به مرکز پشته ±0.3 mm تنظیم می‌شود (اندازه‌گیری با عمق‌سنج از پیشانی درپوش عقب).
- OR یاتاقان عقب در کارتریج شناور است، با فنر موجی 300 N.
- رشد حرارتی روتور نسبت به بدنه ~+0.35 mm رو به عقب است. این را OR شناور و لغزش ±1 mm سوکت جذب می‌کنند.

## ۱۳. O-ringها (ISO 3601-1 کلاس A، شیار ISO 3601-2)

| آب‌بند | O-ring | ماده | تعداد | شیار | فشردگی / کشش |
|---|---|---|---|---|---|
| لندهای ژاکت (۲ + ۲، با شیار نشتی بینشان) | 280 × 3.55 | EPDM 70 (پراکسیدی، گلیکول) | 4 | کف d284.30، عرض 4.8 | 19.7 % / 1.5 % |
| spigot سپر جلو | 280 × 3.55 | FKM 75 | 1 | کف d284.30 | 19.7 % / 1.5 % |
| spigot سپر عقب | 275 × 3.55 | FKM 75 | 1 | کف d280.30 | 19.7 % / 1.9 % |
| کارتریج‌های SFD (۲ در هر کارتریج) | 77.5 × 2.65 | FKM 75 | 4 | کف d79.58، عرض 3.6 | **12.1 %** (فنر مرکزکننده ~3 N/µm؛ روی میز اندازه‌گیری شود) / 2.7 % |
| درپوش جلو و عقب (شعاعی روی spigot) | 80 × 1.78 | FKM 75 | 2 | کف d81.20، عرض 2.4 | 14.6 % / 1.5 % |
| اتصالات گلیکول G3/4 و نشتی G1/8 | ED-ring (ISO 1179-2 فرم E) | EPDM | 4 | — | — |

- برای EPDM فقط گریس سیلیکونی استفاده شود.

## ۱۴. روتوردینامیک (`eg_rotor.json`)

- **مدل:** تیر FE روتور هسته (`e_rotor.core_rotor`، بدون تغییر) + روتور ژنراتور جزئی:
  - صفحهٔ Cu با نیم سفتی
  - آهنربای لایه‌ای فقط جرم
  - CFRP با E محوری 12 GPa
  - quill توخالی 30/19
  - ژیروسکوپی، مفصل pin در شش‌گوش (x −128.5)، و ۴ تکیه‌گاه SFD با O-ring
- **روتور ژنراتور:** 26.7 kg (quill 1.93)، x_cg −568، دهانهٔ یاتاقان 385 mm، Ip/It = 0.072.
- **سرعت‌های بحرانی** (SFD 3 N/µm):

| مود | 3.0k | 4.7k | 5.8k | 14.0k | **57.2k** | 89.8k | 144k |
|---|---|---|---|---|---|---|---|
| محل | هسته (توربین) | ژنراتور جلو | quill | ژنراتور عقب | هسته (دماغه) | خمش ژنراتور | خمش دوم ژنراتور |

- **نتایج:**
  - **هیچ مودی در 19.25k–37.8k (55–108 %) نیست.** این برای سفتی SFD 1.5، 3 و 6 N/µm و با UMP هم برقرار است.
  - نزدیک‌ترین مود بالا 57.2k (+63 %) است. در 35k، مود میرا 46.6k (هسته) ζ 0.032 دارد و مودهای ژنراتور 72.8k ζ 0.013.
- **روتور صلب:** خمش آزاد بدون quill 99.6k = 2.85 × دور کار. بنابراین بالانس دوصفحه‌ای در دور کم معتبر است. با quill، اولین مود 17.2k است که مود کنسول quill است؛ در کار، سوکت روی شش‌گوش pin است.
- **کشش مغناطیسی نامتقارن (UMP):** سفتی منفی 0.13 N/µm، یعنی 13 N در 0.1 mm خروج از مرکز. ناچیز است.
- **پیچش:**
  - quill: k = 29.7 kN·m/rad.
  - J ژنراتور 0.0358، J هسته 0.139 kg·m².
  - **f = 163 Hz**، که 1× در 28 % دور هنگام استارت (موتورکردن، گشتاور کم) عبور می‌کند و 6f اینورتر در 4.6 % دور.
  - τ quill: 20.5 MPa نامی و 103 MPa در 5× (مجاز ~230 استاتیک).
- **مخروط quill:** پیش‌بار 56 kN، ظرفیت **716 N·m** (1.57 × پنج برابر ریت)، فشار تماس 125 MPa، تنش حلقوی توپی 247 MPa (34CrNiMo6 QT).
- **یاتاقان‌ها:**

| محل | Fr (N) | Fa (N) | L10m aISO 3 (h) | اصطکاک (W) |
|---|---|---|---|---|
| جلو (7008-E، locating) | 243 | 350 | 148,000 | 804 |
| عقب (7008-C، شناور) | 276 | 300 | 104,000 | 781 |

  - تعویض هر 24,000 h همراه با یاتاقان‌های هسته.
- **روغن:** ISO VG 32 سنتتیک، جت d1.2 با 2.5 L/min در 2.5 barg (رو به فاصلهٔ IR و قفسه، 15°)، و تغذیهٔ SFD از همان گالری.
  - مسیر تغذیه: پورت M10×1 بالای سپر ← سوراخ شعاعی ← گالری محوری d4 در دیوارهٔ توپی ← جت.
  - مسیر تخلیه: کف توپی ← گالری d8 ← G3/8 پایین سپر.

## ۱۵. بالانس (ISO 21940-11)

- **هدف:** **G1.0** برای روتور مونتاژ‌شده (شفت، صفحه، آهنربا، حلقه‌ها، غلاف، مهره‌ها، فاصله‌انداز، چرخ سرعت؛ با quill به‌عنوان کنترل).
  - U = **7.3 g·mm** (e_per 0.27 µm): جلو 3.0 و عقب 4.3 g·mm.
- **پذیرش پس از تست چرخش:** G2.5 (18.2 g·mm).
- **صفحه‌ها:** حلقه‌های انتهایی در x −734.5 و −450.5. اصلاح با ۱۲ سوراخ شعاعی d4 (حداکثر 3 عمق) در r 50 (یا وزنهٔ M5).
- **ترتیب:**
  1. شفت + صفحه، G2.5
  2. با آهنربا، حلقه‌ها و غلاف: G1 روی ژورنال‌ها (ماشین soft-bearing، 600–1500 rpm)
  3. quill روی مخروط با علامت زاویه: کنترل G1
  4. تست چرخش داغ
  5. کنترل دوباره و run-out سوکت ≤ 10 µm
- **ماشین:** Schenck (DE)، CIMAT (PL)، یا ماشین خودمان.

## ۱۶. ترتیب مونتاژ (کارگاه)

**آ. آماده‌سازی بدنه و سپرها**
1. Helicoilها: ۳۲ × M10 در پیشانی‌های بدنه، M8 جعبه، و M6/M12 روی سپرها. با تپ STI و ابزار Böllhoff؛ زبانه شکسته شود.
2. پرس ۴ پین 8 m6 در بدنه.
3. پرس پین‌های ضدچرخش 4 m6 در شانهٔ توپی‌ها.
4. فیتینگ‌های نشتی.
5. تست فشار بدنه و ژاکت در کارگاه بعداً انجام می‌شود (مرحلهٔ پ).

**ب. واحد استاتور**
1. ژاکت در فر تا **180 °C** (30 دقیقه) گرم شود.
2. پشتهٔ استاتور (20 °C، روی ماندرل بالابر) را تا وسط ژاکت پایین بیندازید. شیار پین ژاکت بالا باشد.
3. سرد شود. قطر داخلی را کنترل کنید (126 +0.05/0) و ببینید ورق‌ها باز نشده باشند.
4. کارگاه سیم‌پیچی (بخش ۶):
   - کانال گلیکول را بپوشانید.
   - لاینر، کویل‌ها (۱۰ ضلع بلند)، جداکننده، گوه‌ها، اتصال‌ها، سیم‌های خروجی، PT100ها و حلقه‌های نگه‌دارنده.
   - VPI در دو سیکل، سپس پخت.
5. تست‌های الکتریکی بخش ۶.

**پ. استاتور در بدنه**
1. O-ringهای EPDM را با گریس سیلیکونی جا بزنید.
2. واحد را از جلو با فیکسچر فشار روی پیشانی ژاکت وارد کنید (**هرگز روی سیم‌پیچی**)، تا پیشانی عقب ژاکت به شانهٔ x −422.5 برسد. شیار پین در بالا (+y) باشد.
3. پین شعاعی E-G208 را از بیرون بزنید و خار DIN 472 290 را جا بیندازید.
4. سیم‌ها از پنجره بالا بیرون می‌آیند.
5. **تست فشار حلقهٔ گلیکول:** 4.5 bar (1.5 × فشار شیر اطمینان 3 bar) به مدت 30 دقیقه؛ خروجی‌های نشتی باید خشک بمانند.

**ت. روتور** (کارگاه + پیمانکار)
1. کنترل شفت (MPI، ابعاد).
2. shrink صفحهٔ CuCr1Zr در 220 °C، سپس سنگ OD 74 h5 بین مرغک‌ها.
3. **چسب آهنرباها:**
   - ۱۲ قطعه به ترتیب شماره و زاویه، با قالب نگه‌دارندهٔ Al غیرمغناطیسی.
   - نیروهای مغناطیسی جذب شدید دارند: قطعه‌ها یکی‌یکی با اسلاید وارد شوند.
   - پخت چسب، سپس حلقه‌های انتهایی با Loctite 648.
4. سنگ OD آهنربا و حلقه‌ها به مخروط 1:500 (چرخ الماسی، خنک‌کاری).
5. پرس غلاف (بخش ۷)، سپس سنگ OD 120 h6.
6. پیش‌بالانس و **تست چرخش داغ 120 %** (بخش ۱۸)، بعد بالانس G1.
7. یاتاقان‌ها **روی شفت نصب نمی‌شوند**. توپی‌های فرورفته باید از روی ژورنال‌ها رد شوند؛ یاتاقان‌ها بعداً از بیرون نصب می‌شوند.

**ث. نصب روتور در پاد**
1. سپر عقب را روی بدنه ببندید: O-ring FKM، ۲ پین، ۱۶ × M10 به 29 N·m، ضربدری در ۳ مرحله.
2. **ورود روتور:**
   - غلاف PTFE 0.5 mm را در دهانهٔ استاتور بگذارید.
   - روتور با میلهٔ کنسول ابزار E-G371 (پیچ‌شده به سر جلو) و جرثقیل از جلو وارد شود.
   - انتهای عقب از لابیرنت توپی عقب (r 25.3 روی لند r 25) با بوش راهنما رد می‌شود.
3. بوش موقت عقب (84.24 g6 / 40 F7، با روکش PTFE) را از پشت در توپی عقب بگذارید.
4. سپر جلو را روی سر جلو بلغزانید (راهنما روی لند d50) و ببندید. بوش موقت جلو را بگذارید.
5. غلاف PTFE را بیرون بکشید. روتور اکنون روی دو بوش موقت است. کشش مغناطیسی 0.13 N/µm است.
6. **عقب:**
   - بوش موقت را بردارید.
   - کارتریج عقب (O-ringهای FKM، شیار روی پین) را از پشت وارد کنید، سپس فنر موجی.
   - یاتاقان 7008-C را با گرم‌کن القایی تا 80 °C روی ژورنال بلغزانید تا به شانه برسد. OR وارد کارتریج می‌شود.
   - مهرهٔ M35×1.5 را به 47 N·m ببندید، با پیچ‌های قفل 4 N·m.
   - لولهٔ فاصله را بگذارید، سپس درپوش عقب (O-ring شعاعی) با ۶ پیچ M6 موقت.
7. **جلو:**
   - بوش موقت را بردارید.
   - موقعیت محوری آهنربا نسبت به پشته را اندازه بگیرید و **شیم را سنگ بزنید**.
   - شیم + کارتریج جلو (O-ringها، پین) را بگذارید.
   - یاتاقان 7008-E را گرم کنید (جهت تماس علامت‌دار) و نصب کنید.
   - فاصله‌انداز E-G219، مهره 47 N·m، و چرخ سرعت + M8 با Nord-Lock.
   - درپوش جلو (O-ring شعاعی) با ۶ × M6 به 6.2 N·m. این درپوش کارتریج و OR را می‌بندد.
8. **کنترل‌ها:**
   - چرخش آزاد با آچار AF6 روی سر پیچ چرخ سرعت (از سوراخ d16 درپوش).
   - لقی محوری صفر (پیش‌بار).
   - IR، مقاومت و PT100ها.
9. **quill:**
   - مخروط‌ها را چربی‌زدایی کنید.
   - توپی را با علامت زاویه بنشانید.
   - پیچ M12×1.25×25 را از داخل quill بگذارید و با سری AF10 × 300 به **90 N·m** ببندید (MoS2).
   - drive-up را با ساعت اندیکاتور کنترل کنید (0.6 ± 0.1 mm). run-out سوکت باید ≤ 10 µm باشد.
10. محافظ quill را روی درپوش عقب ببندید (۶ × M6×30 از فلنج محافظ و درپوش، 6.2 N·m).
11. نصب کلاهک هوا، پیرومترها، سنسورهای دور، شتاب‌سنج‌ها، جعبه ترمینال (سیم‌ها روی پیچ‌های M12 به 15 N·m و شینهٔ ستاره)، فیتینگ‌ها، دمنده و فیلتر.
12. تست پاد: عایق، فشار گلیکول، دبی روغن جت‌ها روی میز، اجرای دمنده، و چرخش.

**ج. نصب روی موتور** (ابزار: جرثقیل 2 t پلنوم، ساعت اندیکاتور، آچارها)
1. تیر پایه را روی کف پلنوم به کراس‌های شاسی ببندید (۶ × M16، 156 N·m). زین‌ها را بگذارید.
2. پاد را روی زین‌ها بگذارید و تسمه‌ها را شل ببندید.
3. **تراز:** نسبت به شش‌گوش هسته با ساعت روی سوکت؛ هم‌محوری ≤ 0.1 mm و زاویه ≤ 0.05°. از jack bolt در x/y و شیم در z استفاده کنید.
4. روتور را با AF6 بچرخانید تا تخت‌ها هم‌راستا شوند. پاد را جلو بدهید تا سوکت 23 mm روی شش‌گوش بنشیند. لغزش ±1 mm را کنترل کنید.
5. پیچ‌های زین (156 N·m) و تسمه‌ها (53 N·m) را ببندید.
6. **اتصال‌ها:**
   - گلیکول: ۲ × G3/4
   - نشتی ← سوئیچ شناور
   - روغن: ۲ تغذیهٔ M10×1 و ۲ تخلیهٔ G3/8
   - کانال هوا
   - کابل‌های قدرت (6 × 95 mm² EMC، E-G190) و کابل‌های سنسور

## ۱۷. باز کردن و سرویس

| کار | روش | زمان (تخمین) |
|---|---|---|
| **برداشتن پاد** | LOTO (مبدل خاموش و ایزوله، ۵ دقیقه صبر خازن، روتور ایستاده)؛ بستن شیرهای گلیکول و روغن؛ قطع اتصال‌ها و درپوش روی دهانه‌ها؛ باز کردن تسمه‌ها و پیچ‌های زین؛ پاد **150 mm جلو** روی ریل‌های زین می‌لغزد و سوکت از شش‌گوش جدا می‌شود؛ بلند کردن 171 kg با جرثقیل از در یا دهانهٔ فیلتر؛ روی شش‌گوش هسته درپوش محافظ | 2–3 h |
| تعویض یاتاقان‌ها (24,000 h، روی میز) | جلو: درپوش ← چرخ سرعت ← مهره ← بوش موقت جلو از ابزار E-G371 نگه‌دارندهٔ روتور ← پولی‌کش یاتاقان. عقب: محافظ ← quill (M14 جک از داخل quill) ← درپوش عقب ← فاصله ← مهره ← یاتاقان. یاتاقان‌ها، O-ringهای SFD و فنر موجی نو شوند؛ شیم دوباره اندازه شود | 1 شیفت |
| بیرون آوردن روتور | پس از یاتاقان‌ها: سپر جلو (جک M10)، غلاف PTFE در گپ، بیرون کشیدن روتور با میلهٔ کنسول | 2 h |
| بیرون آوردن استاتور (نادر) | سپرها باز شوند؛ خار؛ پین شعاعی؛ کشیدن ژاکت + استاتور با ۲ × M10 جلو و جک هیدرولیک 2 t | 2 h |
| فیلتر F9 | با Δp > 200 Pa یا سالانه | 10 min |

## ۱۸. برنامهٔ تست

1. **قطعات:**
   - تلفات حلقه‌ای پشته (583 Hz، 1 T)
   - شار هر آهنربا
   - حلقه‌های شاهد غلاف (split-disk)
   - MPI شفت و quill، سختی نیتراته
   - تست فشار ژاکت و بدنه: 4.5 bar (1.5 × فشار شیر اطمینان 3 bar)
   - O-ringهای SFD: سفتی روی میز (هدف ~3 N/µm)
2. **تست چرخش روتور:**
   - روتور تا 100 °C پیش‌گرم شود، سپس در پیت خلأ **42,000 rpm (120 %) به مدت ۲ دقیقه**.
   - **پذیرش:** رشد دائم OD ≤ 5 µm (لیزر، پیش و پس)، تغییر بالانس < G1، و تماس آهنربا/غلاف با فراصوت سالم.
   - سرویس: Schenck RoTec (DE).
3. **تست‌های استاتور:** مقاومت، IR/PI، hipot 2.3 kV، surge 3.5 kV، PD inception، PT100ها و نشتی گلیکول.
4. **بی‌باری (back-EMF):**
   - پاد روی موتور (یا میز) با اینورتر استارت + فیلتر سینوسی تا 50 % دور موتور می‌شود، سپس K2 باز می‌شود.
   - در کاهش دور، ولتاژ ترمینال باز و دور ثبت می‌شود.
   - **پذیرش:** ثابت EMF ≥ 0.98 × FEM. در دمای آهنربای ثبت‌شده: 624 V در 35k و 100 °C، یا 642 V در 20 °C (اصلاح با −0.035 %/K). شکل موج THD < 1 %.
   - از کاهش دور، J·dω/dt تلفات باد و یاتاقان را می‌دهد.
5. **اتصال کوتاه:**
   - در 20–30 % دور با کنتاکتور اتصال کوتاه 1.2 kA، به مدت ≤ 5 s.
   - چون I_sc ≈ Ψ/L_s تقریباً مستقل از دور است، این تست L_s = 98 µH (±10 %) را می‌دهد.
   - سپس ثابت EMF دوباره کنترل شود (دی‌مغناطیس نشده باشد).
6. **heat run:** در موتور، 250 ← 306 ← 335 kW، هر کدام تا پایداری (< 1 K در 30 دقیقه).
   - ثبت همهٔ PT100ها، IR، گلیکول و هوا، و مقایسه با `eg_thermal`.
   - آزمون حلقه‌های کنترل: تغییر SP و قطع موقت دمنده.
7. **تست بار:**
   - راندمان به روش کالریمتری (گلیکول + روغن + هوا) و الکتریکی (V_dc·I_dc).
   - هارمونیک‌های جریان (5 و 7) با پروب.
   - **نقشهٔ V_dc برحسب بار و دور** (پنجرهٔ AFE).
   - load rejection در 50 % و سپس 100 % (chopper).
   - ارتعاش: ≤ 2.8 mm/s روی سپرها.
8. **۱۰۰ h** در 250 kW، سپس بازرسی (روغن، فیلتر، ارتعاش)؛ بعد کار ۲۴/۷.

## ۱۹. CAD و تداخل (`eg_check.py` ← `sim/variant_e/eg_check.json`)

- **قطعات:**
  - ۶۰ قطعهٔ STEP (۲۹ ساختنی، باقی خریدنی یا پیمانکاری)، همه valid.
  - پیچ‌ها (۳۲ × M10، ۲۰ × M6، ۵ × M8، ۴ × M16)، ۳۲ Helicoil، پین‌ها، O-ringها، سنسورها و فیتینگ‌ها همه بدنهٔ ساده دارند.
- **بررسی تداخل:**
  - ۶۹۱ جفت قطعه و ۲,۰۰۰+ جفت solid بررسی شد: ژنراتور با خودش و با همهٔ ۴۰ قطعهٔ دیگر E (روتور، کمپرسور، یاتاقان، توربین، محفظهٔ احتراق، اگزوز، ورودی، شاسی).
  - **۰ هم‌پوشانی** (> 1 mm³) و ۹۳ سطح تماس.
  - تماس با بیرون: سوکت quill با شش‌گوش هسته، و تیر پایه با کف پلنوم.
- **جرم:**
  - روتور 26.6 kg، استاتور و پاد 142.0، محافظ 2.3 ← **پاد 171 kg**
  - زین‌ها، تسمه‌ها و تیر 81.5، دمنده و فیلتر 25.7 ← **جمع 278 kg** (پاد قبلی با زین 245 kg)
- **ابعاد پاد:** x −905 … −98 (کلاهک هوا تا نوک محافظ)، y −181 … 214 (با فیتینگ‌ها)، z −190 … 300 (جعبه ترمینال).

## ۲۰. BOM (`docs/bom/variant_e_generator_bom.csv`)

- **۹۷ ردیف:** ۶۰ قطعهٔ CAD + ۳۷ ردیف دیگر:
  - مواد خام فورج و میله
  - Litz، عایق‌ها، رزین، کابل‌ها و PT100ها
  - خدمات: مغناطش و لایه‌ای کردن آهنربا، پیچش و پرس غلاف، تست چرخش، بالانس، سنگ پشته
  - حلقهٔ گلیکول: خنک‌کن، پمپ، شیر، منبع، فلومتر، لوله، MEG، سنسورها، نشتی
  - سنسورهای هوا
  - K1/K2، فیلتر سینوسی، IMD، گلندها
  - مواد مصرفی و ابزارهای مونتاژ
- **بدون تأمین‌کنندهٔ آمریکایی** و بدون نام تجاری آمریکایی (کنترل خودکار در `eg_bom.py`). مثلاً به‌جای آرامید و پلی‌ایمید با نام تجاری آمریکایی، Metastar/Teijin و Kaneka/Ube آمده است.
- **جایگزینی در BOM اصلی:** این فهرست ردیف‌های E-G110 … E-G180 و سهم ژنراتور از E-W100 در `variant_e_bom.csv` را جایگزین می‌کند. اجرای دوبارهٔ `e_check.py` و `e_bom.py` با کار یکپارچه‌سازی است و در این مرحله انجام نشد.

## ۲۱. ریسک‌ها و کارهای باز

1. **EMF سه‌بعدی (±2 %):**
   - فرض L + 4 mm است. حاشیهٔ V_dc در 332 kW تا 660 V فقط 23 V است.
   - چاره‌ها: گرید Br بالاتر (1.12 typ)، تریم دور +1 %، یا AFE کلاس 380–500 V.
   - در تست بی‌باری اندازه‌گیری شود.
2. **L_ew با مدل رشته‌ای (±30 %)** ← L_s ±3 %. در تست اتصال کوتاه اندازه‌گیری شود.
3. **غلاف کربن در 40 % UTS_eff** در کار پیوستهٔ داغ: کیفیت پیچش، حلقه‌های شاهد، خزش رزین و آسودگی تداخل (حاشیهٔ 10 MPa) مهم‌اند. پیمانکار باید سابقهٔ پرس مخروطی سرد (320 kN) داشته باشد.
4. **دی‌مغناطیس سطحی در اولین پیک اتصال کوتاه ناگهانی:** 2.3 % حجم در 100 °C. squareness گرید باید تضمین شود و روتور ≤ 100 °C بماند.
5. **Litz مستطیلی 1260 × 0.2 و کویل‌های فرم‌دار:** زمان تحویل و برگشت فنری Litz هنگام فرم‌دهی. یک کویل نمونه پیش از سفارش کامل ساخته شود.
6. **مدل دوبعدی تلفات روتور** (صفحهٔ Cu، اثر انتهایی): با IR و heat run کالیبره شود.
7. **مدل حرارتی** (k_eq Litz، تماس shrink، h سر سیم‌پیچ) با heat run کالیبره شود. هم‌اکنون حاشیهٔ حرارتی بیش از 75 K است.
8. **بار جزئی:** زیر 167 kW دور باید کم شود. هماهنگی کنترل سوخت و دور و حاشیهٔ سرج در دور کمتر (`00_overview` بخش ۹) لازم است. یا گزینهٔ 690 V با ترانس.
9. **رابط‌های جدید:**
   - محافظ quill جدید (فلنج روی درپوش عقب، x −337.5)
   - پاد از x −905 تا −345.5 (قبلاً −900 … −370)
   - تیر پایه با پیچ از کف پلنوم به کراس‌های x −1050/−600/−200 (سوراخ در کف و نقشهٔ INTAKE به‌روز شود)
   - حلقهٔ گلیکول جدا از E-W100
   - BOM اصلی و `e_check` به‌روز شوند
10. **یاتاقان غلتشی در 35k برای ۲۴/۷:** همان ریسک کل نسخهٔ E است (آکومولاتور rundown، پایش ارتعاش، تمیزی روغن).

## ۲۲. commitها (شاخهٔ main-smmbai)

- `fb4bc94` — طراحی EM + FEM (`eg_layout`، `eg_fem2d`، `eg_bridge`، `eg_em`)
- `89cda1f` — غلاف CFRP در برابر Inconel (`eg_sleeve`)
- `c9f9d10` — خنک‌کاری و شبکهٔ حرارتی (`eg_thermal`)
- `22bbfca` — روتوردینامیک، اتصال‌ها، چیدمان مکانیکی؛ به‌روزرسانی EM
- `cce6462` — CAD ۶۰ قطعه، تداخل ۰، BOM
- commit این سند
