ahmadreza221/aurora-cchp/docs/variant_d/03_rotor_turbine_generator.md

# GR180 نسخهٔ D2 — روتور، توربین شعاعی و ژنراتور (D2R)

تاریخ: 2026-10-23 · دستگاه مختصات: ENG (mm، x = محور موتور رو به عقب، z بالا) · مبنا: `01_research_decisions.md`
اعداد ماشینی: `sim/variant_d/d2r_turbine.json`، `d2r_rotor.json`، `d2r_pmg.json`، رابط‌ها: `sim/variant_d/d2r_interfaces.json`
مدل‌ها: `cad/variant_d/d2r_*.py` ← `cad_out/variant_d/D2/{TURBINE,ROTOR,GENERATOR}/*.step` · BOM: `docs/bom/variant_d2_rotor_bom.csv`
علامت «(تخمین)» یعنی محاسبهٔ مهندسی ما، نه دادهٔ سازنده.

## خلاصه

| موضوع | نتیجه |
|---|---|
| چرخ توربین | **خرید** چرخ توربوشارژر IN713C، **D4 78 / exducer 70/21 (trim 80)**، ۱۱ پره بدون splitter، U4 = 470 m/s |
| راندمان | η_ts = **0.755** (ورود نازل ← استاتیک exducer)، 0.745 با افت پلنوم، **0.80 با دیفیوزر خروجی** (Cp 0.5)، η_tt ≈ 0.89 |
| حلقهٔ نازل | **۱۷ پره** (اول، فرد، مضرب ۱۱ نیست، بدون 4/rev)، r 56.6 → 42.9، b = 14، α3 = 68°، گلوگاه 5.35 mm |
| برق خالص (چرخهٔ ساده، eps 0) | 0 °C: **32.9** · 15 °C: **27.6** · 30 °C: **23.0** · 40 °C: **20.3** · 45 °C: **19.0 kW** (بدون اعتبار دیفیوزر: 27.4 / 22.6 / 18.5 / 16.0 / 14.9) |
| سرعت‌های بحرانی (1–2 N/µm) | زیر دور کار: ≤ **73k** (مودهای صلب روی SFD، با میرایی) · بالای دور کار: **136–138k** (+19 %) · در باند 85–95k: **هیچ** |
| تراست محوری | **−40 N** (رو به جلو) در نقطهٔ طراحی؛ حساسیت −67 تا +42 N؛ قابل تنظیم روی میز تست |
| PMG | ۲ قطب SmCo، روتور Ø36 (آهنربا 20/30 + غلاف کربن 3 mm)، استاتور 39/88 × 80، ۱۲ شیار، 425 V خط به خط، 38 A، **28 kW پیوسته / 31 kW اوج**، η الکترومغناطیسی 0.99 |
| تداخل | ۰ هم‌پوشانی (به‌جز سطوح تماس) میان ۴۵ قطعهٔ D2R، هستهٔ v13A، پوستهٔ پاد و قطعات intake/exhaust/frame |

---

## ۱. توربین شعاعی برای چرخ خریدنی

### ۱.۱ چرا D4 78 با trim بالا

- در 115k rpm، Ø78 یعنی U4 = 470 m/s. این در محدودهٔ چرخ‌های توربوشارژر (~480 m/s) است.
- دبی حجمی خروجی زیاد است (~0.97 m³/s). پس **trim بالا لازم است**:

| چرخ | η_ts | با دیفیوزر | c6 (m/s) |
|---|---|---|---|
| 76/64.5 (HX40 استاندارد، trim 72) | exducer خفه می‌شود | — | — |
| 78/68 (trim 76) | 0.719 | 0.777 | 332 |
| **78/70 (trim 80) — انتخاب** | **0.755** | **0.803** | **297** |
| 78/71.5 (trim 84) | 0.776 | 0.819 | 276 |
| 80/69.7 | 0.753 | 0.803 | 300 |

- بزرگ‌ترین بخش افت، **انرژی جنبشی خروج** است: 44 kJ/kg (حدود 16 % از Δh_is). سهم بقیه:
  - گذرگاه روتور 14.3 · نازل 6.7 · برخورد 1.9 · لقی نوک 1.1 · لبهٔ فرار 0.7 · اصطکاک دیسک 0.4 kJ/kg
- پس **دیفیوزر خروجی مهم است**. شراود ما در x 176 با ID 70.7 تمام می‌شود. دیفیوزر 14° × L80 عامل اگزوز (rev 2، EX-110) درست پشت فلنج شروع می‌شود (Cp واقعی آن در تست کنترل شود؛ با Cp 0.35، η برابر 0.785 است).
- اگر چرخ trim 84 با سرعت مجاز ≥ 121k پیدا شد، بهتر است (+0.02 در η).

### ۱.۲ اعداد meanline (طراحی: 0.40 kg/s، 85 kW، TIT 800 °C، P0 هسته 2.87 bar)

- ψ = 0.965، φ = 0.63، U/C0 = 0.626، Ns = 0.97، b4 = 14 mm (b4/D4 = 0.18)
- ورود روتور: α4 = 67.6°، β4 = −5° (بهینه −24°)، M4 = 0.81، P4 = 1.83 bar، T4 = 695 °C
- خروج: c6 = 297 m/s، Mrel نوک = 0.90، T6 = 576 °C، P6 = 1.00 bar
- PR_ts لازم از خروج محفظه: 2.87 (موجود در چرخه 2.875)

### ۱.۳ حلقهٔ نازل و ارتعاش

- **۱۷ پره**، ورود 45° و خروج 68°، ضخامت بیشینه ~2.8 mm و TE 0.6 mm، وتر ~25 mm، صلبیت 1.57، M3 = 0.74.
- تحریک پره‌های چرخ: 17 × 1917 Hz = **32.6 kHz**.
- اندرکنش با ۱۱ پره:
  - |17 − 11| = 6 و |17 − 22| = 5 قطر گرهی (کم‌خطر).
  - فقط هارمونیک دوم پره‌های نازل (|34 − 33| = 1) ضعیف است.
- **۷ پایه** در پایهٔ یاتاقان عقب (عدد فرد، مضرب ۱۱ یا ۱۷ نیست)، در ناحیهٔ کم‌سرعت جلوی پلنوم.
- ⚠️ **دیاگرام کمپبل چرخ خریدنی (۷×، ۱۷× و ۳۴×) باید از سازنده گرفته شود.**

### ۱.۴ مسیر گاز و قطعات (پوشهٔ `TURBINE/`)

1. خروج محفظه: حلقهٔ r 22.25..35.35.
2. **T-116**، تکیه‌گاه سمت توربین: جای NGV در v13A را می‌گیرد. ۷ پایهٔ صاف، فلنج در درز فلنج عقب پوسته (x 116–118).
3. کانال برگشت بین دیوارهٔ جلوی **T-120** (x 118–121) و سپر حرارتی **T-115**.
4. پلنوم ۳۶۰° (پوستهٔ r 70..73 یعنی OD 146، x 118–155) با دو پد نگهدارنده در y ±(73..85)، و یک پیچ M10 عمودی در x 135، y ±79.
5. **T-110**، نازل ۱۷پره (x 135–149).
6. **T-101**، چرخ (پشت چرخ در x 133، صفحهٔ خروج x 169).
7. **T-121**، شراود exducer + فلنج پیچی OD 104، تا **x 176**.

| قطعه | جرم (kg) | ساخت |
|---|---|---|
| T-101 چرخ | 0.42 | خرید + جوش اصطکاکی به استاب Ø18 شفت ما توسط سازنده |
| T-110 نازل | 0.31 | فرز ۵محور IN718 یا SLM IN718 + HIP + ماشین‌کاری |
| T-115 سپر حرارتی | 0.18 | ورق IN625 1 mm، دوجداره با کاغذ سرامیکی |
| T-116 تکیه‌گاه ۷پایه | 0.21 | ریخته‌گری IN713LC (کاربر) یا SLM IN718؛ سنگ‌زنی spigot و سوراخ آب‌بند |
| T-120 پوسته/پلنوم | 0.90 | ریختهٔ 1.4848 یا ورق 1.4828 + TIG |
| T-121 شراود | 0.39 | تراش IN625، کانتور نوک ±0.02 |

**رابط اگزوز (قرار مشترک با عامل اگزوز، commit 7bd203a):** فلنج پیچی روی T-121 در **x 176**: سوراخ 70.7، OD 104، 6 × M6 روی PCD 94 (+ واشر گرافیت/میکا). EX-111 به آن پیچ می‌شود. خروج exducer در x 169 با ID 70.7 است.
**نگهداری:** پوستهٔ ورقی 0.3 mm هسته نباید بار انتهای داغ را بگیرد. پدهای T-120 (y ±79) روی پایه‌های لغزندهٔ FR-131 قاب می‌نشینند. `cad/variant_d/d2_interference.py` با این توربین ۰ هم‌پوشانی می‌دهد.

---

## ۲. روتور و یاتاقان‌ها (پوشهٔ `ROTOR/`)

### ۲.۱ شفت پیوسته (R-101)، از جلو به عقب

| بخش | x (mm) | قطر |
|---|---|---|
| شش‌گوش نر **crowned AF6** (نیتراته)، درایو quill | −56 … −44.5 | AF6 (گوشه Ø6.8) |
| رزوهٔ **M8×1 LH** (مهرهٔ R-105، AF13 × 7.5) | −44.5 … −37 | Ø8 |
| نشیمن واشر R-104 | −37 … −34.5 | Ø8 |
| **نشیمن کمپرسور، ژورنال‌ها، بخش کشش** | −34.5 … 103.8 | **Ø10** |
| رانر آب‌بند + شانهٔ IR (۴ دندانه تا Ø15.2) | 103.8 … 112 | Ø14 |
| استاب توربین (heat dam)، جوش به چرخ | 112 … 133 | Ø18 |

- **سوراخ کمپرسور: برقوی 7 → 10 H6، بدون بوش.**
  - نشیمن Ø10 سفتی خمشی را 2.4 برابر Ø8 می‌کند و مود خمشی دماغه را از ~100k (Ø8، درست زیر دور کار) به ≥ 136k می‌برد.
  - تنش حلقوی بور کمتر از 2 % بالا می‌رود.
  - دیوارهٔ spigot عقب (r 5..6.49) فقط نیروی clamp را می‌گیرد (~111 MPa).
  - کمپرسور حدود 4 g سبک می‌شود و دوباره بالانس می‌شود.
- **بدنهٔ «Ø16» یک بوش clamp‌شده است (R-102، Ø16/10 × 88، 17-4PH).**
  - شفت یکپارچهٔ Ø16 قابل مونتاژ نیست: چرخ به استاب جوش شده و سوراخ یاتاقان‌ها Ø10 است.
  - به روش توربوشارژر، همهٔ قطعات از دماغه سوار می‌شوند: کمپرسور ← شیم ← IR جلو ← بوش ← IR عقب ← شانهٔ Ø14.
  - مهرهٔ M8 LH با پیش‌بار **6 kN** همه را می‌بندد (~10 N·m؛ با کشش اندازه‌گیری شود).
- **مسیر گشتاور:**
  - گشتاور ژنراتور و استارت فقط از **شش‌گوش AF6** وارد شفت می‌شود، نه از مهره و نه از رزوهٔ LH.
  - کمپرسور مثل v13A با اصطکاک clamp می‌چرخد: ظرفیت 11 N·m در برابر 4.9 N·m لازم.
- **تنش‌ها:**
  - گشتاور توربین 7.06 N·m ← τ در ژورنال Ø10 = 36 MPa
  - کشش در Ø10 = 76 MPa، در ریشهٔ M8 = 173 MPa (42CrMo4 QT، Rp0.2 ≥ 750)

### ۲.۲ یاتاقان‌ها و SFD

- ۲ یاتاقان هیبرید 10×22×6 تماس‌زاویه‌ای 15° کلاس P4:
  - جلو در x 6.8: **locating** برای تراست رو به جلو.
  - عقب در x 100.8: شناور، با فنر موجی 40 N که شفت را رو به جلو هل می‌دهد. پس هر دو یاتاقان همیشه بار دارند.
- **کارتریج‌های SFD** (R-112 / R-113، 17-4PH):
  - land Ø27.80 در سوراخ 28 H6 تونل، یعنی لایهٔ روغن **0.10 mm**.
  - ۲ O-ring FKM (25 × 1.5) در هر کارتریج: سفتی تکیه‌گاه 1–2 N/µm (روی میز اندازه‌گیری شود).
  - سوراخ جت Ø0.8 بالا، تخلیه پایین، پین ضدچرخش.
- **کارتریج جلو:** OR بین لبهٔ جلوی کارتریج و حلقهٔ نگه‌دارنده (R-114) قفل است.
  - تراست جلو مسیر OR ← لبه ← حلقهٔ آب‌بند/نگه‌دارنده R-131 را طی می‌کند (پرس + Loctite 638؛ ظرفیت ~1.5 kN).
  - تراست عقب به شانهٔ تونل در x 11 می‌رسد.
- **میرایی SFD (تخمین):** 114 N·s/m (کوتاه، باز) تا 7400 N·s/m (بسته). در محاسبه 300 N·s/m فرض شد.
- **تونل جدید (R-120):**
  - فلنج و الگوی پیچ v13A حفظ شده است.
  - سوراخ‌های 28 H6 جلو (x 2–11) و عقب (x 95.8–107.3) و سوراخ میانی 18 در یک بستن سنگ زده می‌شوند (هم‌محوری 5 µm).
  - انتهای عقب (r 17.5) در spigot پایهٔ T-116 می‌نشیند.

### ۲.۳ آب‌بندها (labyrinth + هوای بافر)

جهت جریان هوا در همهٔ آب‌بندها **به داخل محفظهٔ روغن** است. محفظه با breather به مخزن و جداکنندهٔ مه تخلیه می‌شود.

| آب‌بند | جای | نشتی (g/s، تخمین) |
|---|---|---|
| جلوی هسته | ۳ دندانه، ID 22.4، دور boss کمپرسور (R-131)؛ بافر = هوای پشت کمپرسور | 3.4 |
| عقب هسته | ۴ دندانه روی رانر Ø14 در سوراخ T-116؛ بافر = هوای خروجی کمپرسور از ۶ سوراخ Ø2 در T-116 | 2.6 |
| ژنراتور جلو و عقب | ۳+۲ دندانه؛ بافر = هوای فیلترشدهٔ ورودی (~5 kPa) | 0.6 / 0.8 |

- جمع نشتی هسته ~6 g/s (حدود 1.5 % هوا). اگر در تست زیاد بود: لقی 0.15 mm یا رینگ پیستونی توربوشارژری روی استاب.
- هوای بافر عقب پشت چرخ را هم خنک می‌کند و از لبهٔ پشت چرخ وارد ورودی روتور می‌شود.

### ۲.۴ تراست محوری

- کمپرسور −243 N، توربین +202 N، **خالص −40 N (رو به جلو)**.
- حساسیت:
  - چرخش حفرهٔ کمپرسور 0.35 تا 0.55: −67 تا −7 N
  - فشار حفرهٔ پشت چرخ +0.05 تا +0.2 bar: −20 تا +42 N
- **قانون طراحی:** خالص رو به جلو در بازهٔ 20–80 N، در همهٔ نقاط.
  - تنظیم با سوراخ‌های T-116 (در صورت نیاز M4 با پیچ اوریفیس).
  - اندازه‌گیری با load washer (R-150) پشت کارتریج جلو.
- **عمر یاتاقان جلو** (C ≈ 3.0 kN، تخمین):

| Fa (N) | L10 پایه (h) |
|---|---|
| 60 | 6300 |
| 80 | 2840 (با aISO 4 ≈ 11,400) |
| 100 | 1500 |
| 140 | 580 |

  پس **|تراست| ≤ 60 N** شرط عمر 8000 ساعته است.
- اصطکاک لغزش شش‌گوش quill (μ 0.15) تا 53 N نیروی محوری اضافه می‌دهد. پوشش DLC و μ ≤ 0.1 لازم است.

### ۲.۵ دینامیک روتور (مدل جفت‌شدهٔ هسته + ژنراتور + quill)

- **روش:** تیر FE با ژیروسکوپی. quill در سر موتور مفصلی است (برش منتقل می‌شود، گشتاور خمشی نه). ۴ یاتاقان روی SFD.
- **جرم‌ها:** روتور هسته 0.80 kg (چرخ 0.45)، روتور ژنراتور با quill 0.67 kg.

| حالت | سرعت‌های بحرانی forward (k rpm) |
|---|---|
| **پایه 1 N/µm** | 8، 17، 20، 36، 70 ‖ **137**، 196 |
| **پایه 2 N/µm** | 11، 23، 27، 49، 73 ‖ **138**، 197 |
| stack شل (اثر بوش 0.3) | … 62 ‖ 129 (+12 %) |
| stack کامل (1.0) | … 78 ‖ 143 |
| چرخ 0.55 kg | … 73 ‖ 140 |
| کمپرسور clamp‌شده | … 77 ‖ 161 |
| مرجع: تکیه‌گاه سفت 10 N/µm | 20، 47، 48، **92**، **104** ← رد |

- **نتیجه:** با 1–2 N/µm همهٔ مودهای صلب **زیر 73k** هستند (عبور در استارت با میرایی SFD، ζ = 0.09–0.43). اولین مود بالای دور کار **136–138k** است (خمش quill و دماغه، +19 %).
- در باند **85–95k هیچ مودی نیست**. تحلیل میرا در 115k: نزدیک‌ترین مود 131–133k با ζ ≈ 0.05.
- اثر بستن stack مهم است. **آزمون ضربه (ping test) روتور مونتاژشده** لازم است. اگر مود بالایی زیر 130k شد، کمر quill از 58 به 50 mm کوتاه شود.
- **quill** (Ø6 × 58، 17-4PH H900، پرداخت + ساچمه‌زنی):
  - τ = 50 MPa نامی و 200 MPa در خطای ×4
  - خمش اول (مفصلی-گیردار) ~215k
  - سفتی محوری 100 N/µm؛ لقی محوری ±0.5 mm

---

## ۳. ژنراتور داخل پاد (پوشهٔ `GENERATOR/`)

> **به‌روزرسانی 2026-10-23:** جزئیات قابل‌ساخت پاد در `05_generator_detail.md` آمده است. پوستهٔ فنجانی، درپوش جلو، اتصال‌دهنده‌ها، انطباق‌ها، ترتیب مونتاژ و BOM `variant_d2_generator_bom.csv` را آن‌جا ببینید. طول کمر quill حالا 54 mm است.

### ۳.۱ اندازه و الکترومغناطیس (`sim/variant_d/d2r_pmg.py`)

| مورد | مقدار |
|---|---|
| توان شفت | **28 kW** پیوسته (سایت 30 °C؛ چرخه 25.9 kW) · **31 kW** اوج (ورودی 15 °C). بالاتر از آن TIT یا توان محدود شود |
| گشتاور | 2.33 N·m · 2 قطب · 1917 Hz |
| روتور | Ø36: آهنربای Sm2Co17 حلقهٔ 20/30 × 82 (۲ نیمه × ۴ قطعه، مغناطش قطری) روی حامل فولادی Ø20/10، غلاف کربن T700 به ضخامت 3 mm (تداخل 0.08)، حلقه‌های انتهایی Ti |
| سرعت سطح روتور | 217 m/s |
| استاتور | ID 39 / OD 88 × 80، ۱۲ شیار، ورق 0.10 mm (NO10 / 10JNEX900)، یوغ 7.2، دندانه 3.6 mm |
| فاصلهٔ هوایی | مکانیکی 1.5 mm |
| سیم‌پیچ | Litz، ۱۲ کویل × ۵ دور، ۲۰ دور در فاز، گام 5/6، کلاس H، رزین‌ریزی خلأ |
| میدان | B فاصلهٔ هوایی 0.52 T (Br در 150 °C = 1.03) |
| ولتاژ و جریان | **E خط به خط 425 V**، **I 38 A** (اوج 42)، A = 37 kA/m، J = 5.5 A/mm² |
| تلفات (W) | مس 107 · آهن 71 (تخمین) · گردابی روتور 80 · باد 289 · یاتاقان‌ها 360 |
| راندمان | الکترومغناطیسی 0.99؛ با باد و یاتاقان 0.97 (در چرخه 0.95 فرض شده: محافظه‌کارانه) |
| خنک‌کاری | ژاکت گلیکول ~360 W، 1.8 L/min، ΔT 3.4 K، ورود 35–40 °C؛ آهنربا ~130–150 °C (تخمین) |
| غلاف کربن | تنش حلقوی 417 MPa در 115k و 600 MPa در 138k؛ مجاز 1600 MPa؛ **SF 2.7** |

- **چرا کربن و نه Inconel:** با غلاف Inconel 718، تنش در 110 % سرعت ~900 MPa می‌شد (SF ~1.15) و تلفات گردابی هم داشت. سفتی خمشی روتور از حامل فولادی می‌آید. مود ژنراتور با کربن ≥ 196k است.
- **مبدل:** سمت ماشین AFE چهارربعی با FOC بدون سنسور (استارت با موتورکردن 5–8 kW)، f_out ≥ 2 kHz، کلیدزنی SiC ≥ 24 kHz، DC ~650–750 V.

### ۳.۲ ساختار مکانیکی

- **شفت سرتاسری Ø10 (G-224):** یقهٔ یکپارچه + کمر quill Ø6 × 58 + توپی سوکت OD 12 با شش‌گوش ماده AF6 (wire-EDM + نیتراته/DLC)، از x −277 تا −45.5.
  - یاتاقان‌ها، اسپیسرهای آب‌بند و حامل آهنربا **از جلو** سوار می‌شوند. مهرهٔ دقیق KM0 در جلو آن‌ها را به یقه می‌بندد.
  - دلیل: سر ژنراتور در این طرح یکپارچه است، نه «مخروط + مهره». پشت یاتاقان عقب تا صفحهٔ پشت پاد (x −123) جایی برای مهره نیست. یکپارچه بودن یعنی اتصالی که سایش (fretting) بخورد وجود ندارد.
- **یاتاقان‌ها:** 10×22×6 هیبرید در x −266 (locating) و −136 (شناور + فنر 40 N)، در کارتریج‌های SFD (G-232/233)، با جت روغن و تخلیه به کف پاد.
- **سپرهای انتهایی (Al 6082):**
  - G-202 جلو: x −272..−258
  - G-204 عقب: x −146..−123، صفحهٔ عقبش روی صفحهٔ پشت پاد می‌نشیند
  - G-203: درپوش محفظهٔ یاتاقان جلو با پیکاپ Hall سرعت و فاز (آهنربا در مهرهٔ KM0)
- **ژاکت گلیکول (G-201):** بوش Al با شیار مارپیچ 8 × 3 mm، ۹ دور، پرس‌شده در سوراخ 98 پاد، ۲ O-ring در هر سر. پاد OD 110 دیوارهٔ بیرونی ژاکت است.
- **جعبه ترمینال (G-240):** 64 × 52 × 30 روی پاد (x −232..−168): ۳ پیچ M6 روی PEEK، PT100/PTC، گلند M32 EMC. دو اتصال گلیکول G1/4 در x −250 و −152.
- **کوپلینگ سمت موتور:**
  - شش‌گوش نر **crowned AF6** روی دماغهٔ شفت موتور (x −56..−44.5) در سوکت ماده‌ی توپی quill (x −57.5..−45.5).
  - لقی محوری ±0.5 mm. فشار تماس 34 MPa نامی و 136 MPa در خطا.
  - درگیری 11.5 mm؛ فاصلهٔ توپی تا مهرهٔ M8: 1.8 mm.
- **G-150:** لولهٔ محافظ ثابت (Ø20) دور quill در دهانهٔ ورودی، از x −108 تا −64.
- **اصلاح پوستهٔ پاد (G-299):** سوراخ‌ها در STEP مفهومی D-101 بریده نشده‌اند و باید اضافه شوند:
  - ۲ پورت G1/4
  - سوراخ کابل M20
  - ۲ تخلیهٔ روغن G1/8 (x −266 و −136، پایین)
  - ۲ ورود جت از بالا

---

## ۴. بررسی تداخل

- **اسکریپت:** `cad/variant_d/d2r_check.py`
- **دامنه:** ۴۵ قطعهٔ D2R در برابر هم، در برابر هستهٔ v13A، پوستهٔ پاد (D-101، D-102) و ۱۶ قطعهٔ INTAKE/EXHAUST/FRAME عامل دیگر (rev 2). D-150 با INT-115 جایگزین شده است.
  - از هستهٔ v13A کنار گذاشته شده‌اند: Shaft، NoseCone، Turbine، TurbineNut، NGV، Exhaust، 608ها، O-ring، WaveSpring، ShaftTunnel، Starter، RPM_Magnet، Balance_Slug، EGT_Probe، Compressor (جایگزین R-100)، و دو لولهٔ روغن‌کاری 608 از SupplyLines.
- **نتیجه:** ۳۲۵ جفت بررسی شد: **۰ هم‌پوشانی** بالای 0.5 mm³ و ۶۹ سطح تماس (فیت‌ها و درزها). `d2_interference.py` عامل دیگر هم با توربین ما ۰ هم‌پوشانی می‌دهد.
- **خروجی:** `cad_out/variant_d/D2/d2r_check.json`

## ۵. ترتیب مونتاژ

1. **روتور هسته:**
   - سازنده چرخ را به استاب Ø18 شفت R-101 جوش می‌دهد. ژورنال‌ها نسبت به چرخ سنگ زده می‌شوند.
   - بالانس شفت+چرخ (G1، دو صفحه).
2. **زیرمونتاژها (روی میز):**
   - **عقب:** یاتاقان عقب و فنر R-117 از جلو در کارتریج R-113 (کارتریج جلو باز است و لبه فقط عقب دارد).
   - **جلو:** یاتاقان جلو در کارتریج R-112 بین لبهٔ جلو و حلقهٔ R-114. O-ringها روی هر دو کارتریج.
3. **روی شفت، از دماغه به ترتیب:**
   - سپر T-115 و تکیه‌گاه T-116 (سوراخ آب‌بند 15.7 از روی دندانه‌های Ø15.2 رد می‌شود).
   - زیرمونتاژ عقب (IR روی ژورنال، js5) تا شانهٔ x 103.8.
   - بوش R-102.
4. **ورود روتور به تونل:**
   - تونل R-120 از قبل به دیفیوزر/پوسته بسته شده است.
   - شفت از عقب وارد می‌شود: کارتریج عقب تا شانهٔ x 95.8، و spigot تکیه‌گاه T-116 روی انتهای تونل.
   - زیرمونتاژ جلو از جلو تا شانهٔ x 11، سپس حلقهٔ R-131 (پرس + Loctite).
   - شیم R-103 (برای لقی نوک کمپرسور انتخاب می‌شود)، کمپرسور R-100، واشر R-104، و مهرهٔ R-105 با 6 kN.
   - بالانس نهایی مونتاژ (G1) و علامت‌گذاری زاویه‌ها.
5. **سمت توربین:**
   - فلنج T-116 در درز پوسته (x 116).
   - نازل T-110 که از قبل با ۳ پیچ M4 به دیوارهٔ عقب T-120 بسته شده است.
   - T-120 با ۴ پیچ M5 A286 بلند (درز پوسته | T-116 | T-120).
   - T-121 با شیم برای لقی نوک 0.35 mm.
   - EX-111 با 6 پیچ M6 A286 و واشر به فلنج T-121.
6. **ژنراتور (جدا، روی میز):**
   - ژاکت G-201 در پاد. استاتور و سیم‌پیچ در ژاکت.
   - سپر عقب G-204 با کارتریج G-233 (جلو باز) و فنر G-234 در پاد.
   - روتور: روی G-224 از جلو به ترتیب یاتاقان عقب، اسپیسر G-227، حامل+آهنربا+غلاف، و اسپیسر G-226. بالانس جداگانهٔ G1.
   - روتور از جلو از سوراخ استاتور وارد می‌شود؛ یاتاقان عقب در G-233 می‌نشیند.
   - سپر جلو G-202 با زیرمونتاژ کارتریج G-232 و یاتاقان جلو روی ژورنال، سپس مهرهٔ KM0 و درپوش G-203.
   - تست چرخش تا 138k (spin proof) و تست الکتریکی (back-EMF، عایق).
7. **اتصال پاد به هسته:** پاد با سه پایه و spigot (هم‌محوری ≤ 0.05 mm، زاویه ≤ 0.1°). سوکت quill روی شش‌گوش دماغه، و لقی محوری ±0.5 بررسی شود. G-150 نصب شود.

## ۶. کارهای باز

1. **انتخاب چرخ مشخص** (78/70، trim ≥ 80، سرعت مجاز ≥ 121k، دادهٔ burst و نقشه) و اجرای دوبارهٔ `d2r_turbine.py` با b4 و زاویه‌های واقعی؛ دیاگرام کمپبل چرخ (۷×، ۱۷×، ۳۴×).
2. **CFD پلنوم ۳۶۰° و کانال برگشت:** یکنواختی ورود نازل و اثر ردّ ۷ پایه.
3. **تطبیق دبی (matching) گلوگاه نازل:** پارامتر m√T/P در طراحی 4.6e-5 و در چرخهٔ 15 °C 4.4e-5 است. سطح گلوگاه با نقشهٔ کمپرسور v13A تنظیم شود.
4. **اندازه‌گیری‌ها:** تراست (load washer) و سفتی O-ringهای SFD روی میز؛ ping test روتور مونتاژشده (اثر stack).
5. **مدار روغن کامل:** پمپ رفت 2.5 barg و ~1.2 L/min برای ۴ یاتاقان، پمپ برگشت، فیلتر 10 µm، کولر روی گلیکول، breather و جداکنندهٔ مه. مسیر لوله‌ها از پرهٔ دیفیوزر (مسیر SupplyLines در v13A).
6. **FEM الکترومغناطیسی PMG:** تلفات آهن در 1.9 kHz، تلفات گردابی آهنربا، دمای آهنربا. طول end-turn دوقطبی (~15 mm فرض شد) کنترل شود.
7. **پوشش شش‌گوش quill (DLC)** و آزمون سایش در هوای ورودی (بدون مه روغن).
   - اصطکاک لغزش (±35–53 N) روی روتور ژنراتور با فنر 40 N برابر است. یا فنر ژنراتور ~60 N شود، یا بعداً یک عضو نرم محوری (دیافراگم نازک) جای لغزش شش‌گوش را بگیرد.
8. **پاسخ نامیزانی (unbalance response)** و بهینه‌سازی لقی SFD برای ζ ≥ 0.1 در مود 131–138k.
9. **سوراخ‌کاری پوستهٔ پاد D-101** (G-299) و هماهنگی با عامل intake/frame: پدهای T-120 روی FR-131، فلنج اگزوز x 176، و فضای جعبه ترمینال و پورت‌های گلیکول در پلنوم ورودی rev 2.
10. **ریسک‌ها:**
    - η واقعی چرخ خریدنی ممکن است 0.02–0.04 کمتر باشد (هر 0.01 ≈ 1 kW)
    - راندمان برق چرخهٔ ساده فقط ~8–9 % است (بدون recuperator)
    - نشتی labyrinthها
    - عمر یاتاقان در صورت تراست بالای 60 N
