ahmadreza221/aurora-cchp/docs/variant_d/02_intake_exhaust_frame.md

# GR180 نسخهٔ D2 — ورودی هوا با جعبه‌فیلتر V-cell، اگزوز کوتاه و شاسی (ویرایش ۳)

تاریخ: ۲۰۲۶-۱۰-۲۳ · قاب ENG (mm؛ x محور موتور رو به پایین‌دست، z بالا).

**تغییرات ویرایش ۳ (نظر کاربر):**
1. **ورودی:** لولهٔ کناری DN150 حذف شد. یک **جعبه‌فیلتر کوچک با فیلتر V-cell F7 به ابعاد 592 × 592 × 292** مستقیم روی پلنوم ورودی نشست.
2. **اگزوز:** لوله و فلنج DN125 حذف شد. اگزوز در **خروجی دیفیوزر** با یک فلنج حلقه‌ای باریک (OD 128) تمام می‌شود.
3. **پاد ژنراتور:** یک تکیه‌گاه گهواره‌ای (فقط باربر وزن) گرفت.

| فایل | کار |
|---|---|
| `sim/variant_d/d2_intake_exhaust_calc.py` (+ `.json`) | افت فشار ورودی (پوسته + فیلتر تمیز و کثیف)، دیفیوزر و kW، جرم و مرکز ثقل پاد، رشد حرارتی، بار پایه‌ها |
| `cad/variant_d/d2_common.py` | توابع مشترک، مجموعهٔ قطعات مرجع D2 (شامل ROTOR/TURBINE/GENERATOR)، تست تداخل |
| `cad/variant_d/d2_intake.py` | INT → `cad_out/variant_d/D2/INTAKE/` |
| `cad/variant_d/d2_exhaust.py` | EX → `cad_out/variant_d/D2/EXHAUST/` |
| `cad/variant_d/d2_frame.py` | FR → `cad_out/variant_d/D2/FRAME/` (+ `d2_interfaces.json` با بخش keep_out) |
| `cad/variant_d/d2_interference.py` | تست تداخل → `D2/d2_interference.json` |
| `docs/bom/variant_d2_intake_exhaust_frame_bom.csv` | فهرست قطعات (بدون تأمین‌کنندهٔ آمریکایی) |

- **اجرا** (به همین ترتیب). هر اسکریپت STEPهای قدیمی پوشهٔ خودش را پاک می‌کند:

  ```
  python3 sim/variant_d/d2_intake_exhaust_calc.py
  LANG=en_US.UTF-8 freecadcmd cad/variant_d/d2_intake.py
  LANG=en_US.UTF-8 freecadcmd cad/variant_d/d2_exhaust.py
  LANG=en_US.UTF-8 freecadcmd cad/variant_d/d2_frame.py
  LANG=en_US.UTF-8 freecadcmd cad/variant_d/d2_interference.py
  ```

- همهٔ اعداد **تخمین** یک‌بعدی‌اند (±30 %؛ پلنوم با یک ورودی ±50 %).

---

## ۱. ورودی هوا و جعبه‌فیلتر (INT)

### پلنوم (همان ویرایش ۲، دهانه به بالا رفت)
- **پلنوم بسته:** قطر بیرونی 180 mm، از x = −130 تا x = −2.4، دور شکاف شعاعی بین پاد و دیسک (x = −108…−46.3).
- **دهانهٔ بالایی 112 × 170** در مرکز x = −71.
  - یک یقهٔ کوتاه (گردن صاف و هرم 45° تا 188 × 246) با فلنج 236 × 294 در z = 130.
  - طول دهانه را طول پلنوم محدود می‌کند. جلوتر از آن پورت گلیکول و جعبه ترمینال پاد هستند.
- ۳ استرات INT-115 (هیچ عضو چهارتایی نیست)، دیسک و دامن، حلقهٔ پشتی دوتکه با پایه (نقطهٔ ثابت)، و فرینگ دم پاد، مثل قبل.
- **بوش‌های عبور لوله‌ها** به زیر یقه منتقل شدند: سوخت 185° و 275°، کابل سنسور دور 300°.

### جهت جعبه: **بالا (+z)، سطح فیلتر رو به بالا**
- **فوت‌پرینت:** جعبهٔ 603 × 603 روی پاد و پلنوم، در همان پهنای پکیج می‌نشیند و جای کف اضافه نمی‌گیرد.
- **چرا نه کناری (+y)؟** مربع 592 کنار محوری که فقط 239 mm از کف بالاتر است جا نمی‌شود. جعبه باید روی کف بایستد و حدود 0.6 × 0.45 m به فوت‌پرینت اضافه می‌کرد.
- **آب‌بندی:** هدر فیلتر رو به بالاست. هم وزن و هم فشار سمت کثیف آن را روی واشر می‌فشارد.
- **تعویض:** ۴ قفل اهرمی باز، درپوش برداشته، فیلتر مستقیم بالا کشیده می‌شود. فیلتر نو در ۴ ریل گوشه می‌لغزد و روی واشر EPDM می‌نشیند. بدون ابزار.
- **جای جعبه:** جلو، روی پاد خنک (دیوارهٔ داخلی x −490 تا 110). محفظهٔ داغ توربین از x = 118 شروع می‌شود.
  - اگر محفظهٔ توربین عایق نباشد، یک ورق بازتابندهٔ 0.5 mm استیل روی دیوارهٔ پشتی جعبه لازم است.

### چیدمان جعبه (از بالا به پایین)

| بخش | z (mm) |
|---|---|
| درپوش با توری درشت آلومینیومی | 485–527 |
| لبهٔ جعبه | 497 |
| هدر V-cell (روی نشیمن نبشی با واشر 10 × 3) | 467–492 |
| بدنهٔ V | 200–467 |
| محفظهٔ تمیز (70 mm) | 131.5–200 |
| کف جعبه با دهانهٔ 188 × 246 (توری FOD) | 130 |

- **یقهٔ مخروطی 45°** به دهانهٔ پلنوم وصل می‌شود.
- **درین:** G1/4 در گوشهٔ جلوی کف.
- **ساختار:** جعبه و درپوش از آلومینیوم 5754 به ضخامت 1.5 mm (خم، پرچ و درزگیر).
- **تکیه‌گاه:** جعبه روی **۴ ستون شاسی** (FR-160) و ۲ ناودانی کف قرار می‌گیرد. **بارش روی پلنوم نیست.** فلنج یقه فقط آب‌بند (EPDM) است.
- **ابعاد کل جعبه:** x −493 تا 113، y ±303 (با قفل‌ها ±320)، z 105 تا 527. **بالای جعبه 527 mm بالای محور** است، یعنی **حدود 766 mm از کف**.
- **جرم:**

  | بخش | جرم |
  |---|---|
  | جعبه | 6.2 kg |
  | درپوش | 2.3 kg |
  | قفل‌ها | 0.7 kg |
  | فیلتر | ~5.5 kg |
  | ستون‌ها | 1.8 kg |
  | پلنوم و قطعات ورودی | 4.3 kg |

- **فاصله‌ها:**
  - کف جعبه (ناودانی‌ها از z = 105) تا بالای جعبه ترمینال پاد (z = 85): 20 mm. تا اتصالات گلیکول (z = 67): 38 mm.
  - فضای z 55–105 بالای پاد برای کابل و شیلنگ‌های پاد رزرو است.
  - تداخل با شاسی، جعبه ترمینال (G-240) و اتصالات گلیکول (G-241) صفر است.
- **فضای سرویس** (در `d2_interfaces.json` → `keep_out`، برای جلسهٔ تجهیزات جانبی):
  - بالای درپوش تا z = 887، در کل فوت‌پرینت جعبه + 100 mm.
  - حلقهٔ 100 mm دور جعبه در z 440–530 برای قفل‌ها.

### افت فشار (0.395 kg/s، 30 °C، 1228 m³/h؛ سرعت روی سطح فیلتر 0.97 m/s)

| جزء | Δp (Pa) |
|---|---|
| توری ورودی | 0.3 |
| **فیلتر F7 تمیز** (90 Pa در 3400 m³/h، خطی) | **33** |
| محفظهٔ تمیز → دهانهٔ یقه | 9 |
| توری FOD روی کف (K 0.34) | 11 |
| یقهٔ مخروطی 45° (K 0.1) | 19 |
| ورود ناگهانی یقه به پلنوم (K 1.0، 18 m/s) | 187 |
| توزیع دور پاد | 109 |
| چرخش به شکاف | 32 |
| ۳ استرات | 15 |
| چرخش دور لبه به چشم | 60 |
| **پوسته (بدون فیلتر)** | **441** |
| **کل با فیلتر تمیز** | **473 (0.47 %، ~0.16 kW)** |
| **کل با فیلتر کثیف** (تعویض در ~165 Pa، معادل 450 Pa در دبی نامی) | **603 (0.60 %، ~0.21 kW)** |

- بزرگ‌ترین جزء، ورود ناگهانی یقه به پلنوم است.
- ورودی یک‌طرفه در چشم اعوجاج دارد. با ۴ پراب و پورت فشار پلنوم (x = −110، 225°) در تست بررسی شود.

### ساخت و مونتاژ
1. **پلنوم INT-110:** استیل 2 mm. یقه از ۴ ورق خم‌شده TIG می‌شود.
2. **جعبهٔ INT-150 و درپوش INT-151:** لیزر و پرس‌برک آلومینیوم، پرچ و درزگیر MS. ناودانی‌های کف با رزوه‌پرچ M8.
3. **مونتاژ پلنوم و پاد:** ترتیب مثل ویرایش ۲ (بست حلقهٔ پشتی، دیسک و دامن، مدول پاد و استرات‌ها، پیچ‌های M6 استرات).
4. **نصب جعبه:**
   - ستون‌های FR-160 روی شاسی.
   - جعبه روی ستون‌ها (۸ پیچ M8 با واشر لاستیکی).
   - فلنج یقه با واشر EPDM و ۸ پیچ M6 به کف جعبه.
   - توری FOD روی کف.
   - فیلتر داخل، درپوش و ۴ قفل.
5. **درین:** شیلنگ به درین پکیج.

---

## ۲. اگزوز: فقط دیفیوزر کوتاه (EX)

- **مسیر:**
  - فلنج پیچی T-121 (x = 176، bore 70.7، 6×M6 روی PCD 94).
  - **دیفیوزر مخروطی 2θ = 18°، L = 80، Ø70.7 → Ø96.0.**
  - **فلنج حلقه‌ای باریک OD 128 × 6** (6×M6 روی PCD 116) در x = 264، برای وقتی که بعداً لوله لازم شد.
- **طول کل 88 mm** (x 176 تا 264). **بیشترین شعاع 64 mm** (فلنج انتهایی). هیچ چیز از دیفیوزر بیرون نمی‌زند.
- **روی دیفیوزر:**
  - دو پایهٔ خط مرکز نزدیک ورودی (x 194–218، تا y = ±100، شیار x).
  - ترموکوپل M14×1.5 در x = 229.
  - دو پورت فشار در x = 192 و x = 246.
  - درین G1/4 پایین در x = 246.
  - عایق 30 mm.

### افت و kW (q6 = 18.0 kPa در exducer)

| گزینه | Δp0 کل با تخلیه | Cp | هزینه در برابر ایده‌آل | سود در برابر meanline |
|---|---|---|---|---|
| **فقط دیفیوزر 18°/L80 (ویرایش ۳)** | 5.55 kPa (4.7 %) | 0.69 | **4.1 kW** | +9.2 kW |
| دیفیوزر + لولهٔ DN125 (ویرایش ۲) | 3.55 kPa | 0.80 | 2.6 kW | +10.7 kW |

- **سؤال کاربر («فرق چندانی ندارد؟»):** حذف لوله **حدود 1.5 kW** هزینه دارد، نه صفر.
  - انبساط ناگهانی به DN125 (نسبت سطح حدود 2) حدود نصف فشار دینامیکی خروج دیفیوزر (q حدود 3.7 kPa) را برمی‌گرداند (Borda).
  - اگر بعداً لوله‌ای حدود DN125 روی حلقه بسته شود، همین 1.5 kW برمی‌گردد.
- **هزینه بر حسب طول دیفیوزر:**

  | L (mm) | هزینه (kW) |
  |---|---|
  | 0 | 9.7 |
  | 40 | 5.2 |
  | 60 | 4.6 |
  | 80 | 4.1 |

- **هشدار:** جت خروجی حدود 135 m/s و 576 °C است. ناحیهٔ پشت آن (x 264 تا 664، r 150) باید خالی بماند، یا لوله/دودکش وصل شود.

---

## ۳. شاسی، تکیه‌گاه پاد و ستون‌های جعبه (FR)

### تکیه‌گاه‌های موتور
- **ثابت:** پایهٔ FR-120 زیر حلقهٔ پشتی ورودی (x = −2.4).
- **لغزنده، ستون‌های ساده FR-131:**
  - زیر پدهای محفظهٔ توربین (x = 135، y = ±79).
  - زیر پایه‌های دیفیوزر (x = 206).
  - رشد محوری 0.9 mm در توربین و 1.6 mm در دیفیوزر.

### تکیه‌گاه پاد ژنراتور (FR-170/171)
- **وضع پاد:**
  - جرم پاد **4.8 kg**، مرکز ثقل در **x ≈ −198**.
  - بدون تکیه‌گاه، ۳ استرات Ø8 گشتاور 4.3 N·m و همهٔ ارتعاش را تحمل می‌کردند.
- **انتخاب: تکیه‌گاه فقط باربر وزن، نرم در z و آزاد در x و y.**
  - **مکان:** گهوارهٔ 140° زیر پاد در x = −205 (مرکز ثقل)، با آستر PTFE/EPDM. از یاتاقان‌ها (x = −266 و −136)، جعبه ترمینال و پورت‌های گلیکول (همه بالا) دور است.
  - **پایه:** روی بالشتک الاستومری (~40 N/mm)، صفحهٔ لغزندهٔ PTFE و پیچ جک M16، روی ستونی بر تیر عرضی جلو.
  - **پیش‌بار** برابر وزن پاد (~47 N، فشردگی 1.2 mm) با پیچ جک تنظیم می‌شود.
- **چرا این گزینه، نه «تکیه‌گاه سفت + استرات سبک»؟**
  - ۳ استرات **تنها مکان‌دهندهٔ پاد** می‌مانند. زنجیرهٔ هم‌محوری پاد → استرات → حلقهٔ پشتی → هسته کوتاه و سفت است.
  - هم‌محوری quill (هدف 0.05 mm) یک بار روی میز تنظیم می‌شود.
  - گهواره نرم و لغزنده است، پس **هیچ درجهٔ آزادی‌ای دوبار مقید نمی‌شود**. خیز شاسی یا ضربه‌گیرها هم به quill نمی‌رسد: هر 0.1 mm حرکت فقط 4 N بار را عوض می‌کند.
  - گهوارهٔ سفت، هم‌محوری را به شاسی و ضربه‌گیرها وابسته می‌کرد و با استرات‌ها مقیدسازی دوباره می‌ساخت.
  - بالشتک الاستومری ارتعاش پاد را هم میرا می‌کند.

### ستون‌های جعبه‌فیلتر (FR-160)
- ۴ ستون:
  - جفت جلو RHS 30×30 روی تیر عرضی جلو در x = −205، y = ±130.
  - جفت عقب RHS 30×20 روی ریل‌ها در x = 100، y = ±90 (بیرون از ترانس جرقهٔ جلسهٔ تجهیزات جانبی، x ≤ 90).
- زیر ناودانی‌های کف جعبه (z = 105).

### شاسی
- **قاب:** RHS 60×40×3.
  - ریل‌ها در y = ±90، از x −185 تا 220.
  - تیر عرضی جلو در x −225 تا −185 (برای گهوارهٔ پاد و ستون‌های جعبه) و تیر عرضی عقب در x 220 تا 260، هر دو ±150. تیر میانی در x = 0.
  - **تغییر نسبت به ویرایش ۲:** تیرهای عرضی قبلاً در x −160 تا −120 و 300 تا 340 بودند. براکت‌های اسکید جانبی AX-610 باید به محل جدید منتقل شوند.
  - **بلند کردن:** با ۴ گوش در سر تیرهای عرضی (y = ±150)، **بعد از برداشتن جعبه‌فیلتر** (۸ پیچ M8 و ۸ پیچ M6). جعبه ±301.5 بیرون می‌زند و به اسلینگ می‌خورد.
- **ابعاد:** فوت‌پرینت شاسی x −225 تا 260 و y ±160 (جعبه‌فیلتر در ارتفاع z ≥ 105 تا y ±303 بیرون می‌زند). **محور 239 mm بالای کف.**
  - شاسی عقب کوتاه‌تر شد و حلقهٔ اگزوز (x = 264) فقط 4 mm بیرون می‌زند.
- **ضربه‌گیرها:** ۴ عدد، حدود 136 N هر کدام.
- **جرم:** شاسی و همهٔ تکیه‌گاه‌ها حدود 15.8 kg.

---

## ۴. تست تداخل
- `d2_interference.py` ۲۳ قطعهٔ جدید را با ۶۵ قطعهٔ مرجع بررسی می‌کند:
  - هستهٔ v13A بدون قطعات جایگزین‌شده.
  - پوستهٔ پاد D-101/D-102.
  - قطعات D2R در ROTOR، TURBINE و GENERATOR (فلنج پیچی x = 176 و پدها، commit 03352b0).
  - قطعات جدید با هم.
- **نتیجه: 0 تداخل.** فقط قطعات جایگزین‌شدهٔ D-160 و D-150 با قطعات نو هم‌پوشانی دارند.

## ۵. کارهای باز
1. **مدل V-cell:** اندازهٔ بدنه زیر هدر (≤ 570 × 570) با مدل انتخابی (Camfil یا Freudenberg) تأیید شود.
2. **پاد:** وجه پشتی پاد نقطهٔ اتصال ریشهٔ ۳ استرات و ۳ سوراخ M4 فرینگ لازم دارد. زیر پاد در x −220 تا −190 هیچ پورت درینی نباشد.
3. **تأسیسات / تجهیزات جانبی:**
   - ناحیه‌های keep_out در `d2_interfaces.json` رعایت شود: جعبه، فضای سرویس، مسیر سرویس پاد، جت اگزوز، ستون‌ها، گهواره و پایه‌ها.
   - اسکید AX-610 زیر لبهٔ بیرون‌زدهٔ جعبه (y −301…−160) باید زیر z = 105 بماند.
4. **تست:** اعوجاج ورودی (۴ پراب)، افت فیلتر (Δp بین بالا و پایین جعبه)، و Cp دیفیوزر (دو پورت).
