ahmadreza221/aurora-cchp/docs/variant_d/01_research_decisions.md

# GR180 نسخهٔ D2 — تحقیق و تصمیم‌ها (ساخت اول)

تاریخ: 2026-10-23 · اعداد ماشینی: `sim/variant_d/d_decisions.json` · دستگاه مختصات: ENG (mm، x = محور موتور)

**مبنا:** هستهٔ v13A (کمپرسور Ø74، 0.395 kg/s، PR 3.1، 115k rpm) + توربین شعاعی (طرح فعلی Ø96، ~1 kg، TIT 800 °C) + ژنراتور PM ~25 kW در پاد جلو.
کار توربین 85 kW = کمپرسور 59.5 + ژنراتور 25.5 kW. گشتاور در 115k: توربین **7.06 N·m**، ژنراتور **2.12 N·m**.
هوای سایت (30 °C، 50 m): ρ = 1.158 kg/m³ ← **0.341 m³/s = 1228 m³/h = 20.5 m³/min**.
علامت «(تخمین)» یعنی محاسبهٔ مهندسی ما است، نه دادهٔ سازنده.

## جدول تصمیم‌ها

| # | موضوع | تصمیم | عدد کلیدی |
|---|---|---|---|
| 1 | اتصال ژنراتور ↔ موتور | **شفت quill** (نه دیافراگم، نه مغناطیسی، نه یک‌روتوره) | کمر Ø6 × 58 mm، 17-4PH H900؛ τ = 50 MPa در گشتاور نامی؛ مود خمشی quill حدود 200k rpm (تخمین) |
| 2 | یاتاقان‌ها | **هیبرید سرامیکی تماس‌زاویه‌ای 15°، 10×22×6 (کلاس 71900)**، روی SFD نرم، **روغن‌کاری جت مداربسته** | ۴ عدد: هسته x 6.8 / 100.8، ژنراتور x −266 / −136؛ 85 % حد سرعت با روغن؛ n·dm = 1.84e6 |
| 2b | شفت | **608 و Ø8 کنار می‌روند.** ژورنال Ø10، بدنه Ø16، استاب توربین Ø18، نشیمن کمپرسور Ø8 | توربین با جوش اصطکاکی/EB به شفت (روش توربوشارژر) |
| 3 | چرخ توربین | **خرید چرخ آمادهٔ توربوشارژر (IN713C/K418) با D4 76–80 mm**، نه Ø96 سفارشی | U4 در 115k: 458–482 m/s (در برابر 578)؛ جرم 0.4–0.55 kg (تخمین) |
| 4 | ورودی و فیلتر | **کارتریج استوانه‌ای استاندارد توربین گازی، هم‌محور، دور پاد ژنراتور** | رابط: حلقهٔ tube-sheet با دهانهٔ **ID 324 mm** (کارتریج OD 445 × 660)؛ جفت F9: Δp اولیه ~70 Pa |
| 5 | اگزوز | **زانوی 90° رو به بالا، DN200**، فلنج EN 1092-1 PN6 | 28 m/s، کل افت با زانو و تخلیه 0.22 % (DN150: 0.65 %) |
| 6 | استارت | **موتورکردن ژنراتور با مبدل** (active front end)؛ دریچهٔ M5 فقط برای تست هسته | توان استارت حدود 5–8 kW کوتاه‌مدت (تخمین)؛ فرکانس خروجی ≥ 2 kHz |

---

## ۱. اتصال ژنراتور به موتور

| گزینه | دینامیک روتور در 115k | هم‌راستایی / رشد حرارتی | مونتاژ و سرویس | هزینه | نتیجه |
|---|---|---|---|---|---|
| (a) **شفت quill** | دو روتور جدا. هر کدام دو یاتاقان و بالانس خودش را دارد. quill از نظر جانبی نرم است و مودها را از هم جدا می‌کند | خطای هم‌مرکزی را با خمش جذب می‌کند. رشد محوری را سر لغزنده می‌گیرد | پاد و هسته جدا تست و تعویض می‌شوند | ارزان (یک قطعهٔ تراش + سنگ) | **انتخاب** |
| (b) کوپلینگ دیافراگمی/دیسکی | خوب، ولی جرم هاب‌ها overhung است | خیلی خوب | قطعهٔ کاتالوگی برای 115k نیست. Voith تا ~80k rpm می‌سازد [3] | سفارشی و گران | رد |
| (c) کوپلینگ مغناطیسی | آهنربا و غلاف اضافی در 115k، تلفات eddy | خوب (بدون تماس) | پیچیده | گران | رد: برای 2 N·m سودی ندارد |
| (d) یک روتور سرتاسری (سبک Capstone) | Capstone ژنراتور، کمپرسور و توربین را روی یک شفت و یاتاقان هوایی دارد [1][2] | ۳ یاتاقان یا بیشتر روی یک خط، یعنی over-constrained. نیاز به line-bore مشترک پاد و هسته | بالانس و تست جدای ژنراتور ممکن نیست. هسته باید از نو طراحی شود | زیاد | برای نسل بعد (با foil bearing) |

**مشخصات quill (تخمین):**
- گشتاور نامی 2.12 N·m، گشتاور طراحی خطا (اتصال کوتاه PMG) ×4 = 8.5 N·m.
- با کمر Ø6: τ = 50 MPa در نامی و 200 MPa در خطا. 17-4PH H900 یا 34CrNiMo6 QT، ساچمه‌زنی، شعاع کمر R ≥ 3.
- فرکانس خمشی اول quill (دو سر لولا، L = 58): حدود **215k rpm** (حدود 1.8× دور کار). Ø5 فقط ~180k می‌دهد.
- **سر ژنراتور** صلب است (مخروط + مهره). **سر موتور** شش‌گوش crowned با AF7 (نیتراته یا DLC) در سوکت شش‌گوش، با لقی محوری ±0.5 mm برای رشد حرارتی. روغن‌کاری با مه روغن محفظهٔ یاتاقان جلو.
  - دلیل: quill دو سر صلب از نظر محوری خیلی سفت است (EA/L ≈ 94 N/µm). 0.1 mm رشد حرارتی چند kN نیرو به یاتاقان‌ها می‌دهد. منبع [4] هم می‌گوید با یاتاقان معمولی، کوپلینگ باید آزادی محوری و زاویه‌ای داشته باشد.
- ⚠️ **گشتاور ژنراتور و استارت نباید از اصطکاک مهرهٔ کمپرسور یا رزوهٔ LH دماغه بگذرد** (هشدار سند 05). درایو مثبت لازم است: شفت جدید M8×1 LH + شش‌گوش AF7 روی دماغه، و سوراخ کمپرسور از Ø7 به Ø8 برقو شود.
- هدف هم‌راستایی پاد و هسته (سه پایه + spigot): خطای هم‌مرکزی ≤ 0.05 mm و زاویه ≤ 0.1°.

## ۲. یاتاقان‌ها و قطر شفت

**داده‌های سرعت** (GMN، تک‌یاتاقان با پیش‌بار فنری، روغن [5][6]):

| یاتاقان | d×D×B | حد روغن (HY) | حد گریس (HY) | 115k نسبت به حد روغن |
|---|---|---|---|---|
| S608 C | 8×22×7 | 145k | 110k | 79 % |
| **S61900 C (≈71900)** | **10×22×6** | **135k** | **100k** | **85 %** |
| S6000 C (≈7000) | 10×26×8 | 120k | 89k | 96 % ✗ |
| S61901 C (≈71901) | 12×24×6 | 120k (FAG HCB71901: 140k) | 91k | 96 % / 82 % |
| S61902 C (≈71902) | 15×28×7 | 99k (FAG HCB71902: 120k، C = 5.1 kN [7]) | 74k | ✗ |

- **تصمیم:** هیبرید 15° کلاس P4 با ابعاد **10×22×6**.
  - گزینه‌ها: FAG HCB71900-C-T-P4S (DE)، SKF 71900 CE/HCP4A (SE)، GMN HY S61900 C TA (DE)، NSK 7900C هیبرید (JP)، LYC/ZWZ/HRB B71900C (CN).
  - **OD 22 مثل 608 است.** پس قطر نشیمن فقط در حد کارتریج SFD تغییر می‌کند.
- **گریس ممنوع:** حد گریس هیبرید 100k کمتر از 115k است. هوا-روغن هم برای کار 24/7 به هوای فشرده و جداکنندهٔ مه نیاز دارد. **جت روغن مداربسته** انتخاب شد:
  - روغن سنتتیک توربین ISO VG 32، 2.5 barg، حدود 0.3 L/min برای هر یاتاقان (تخمین؛ E3: 1.29 L/min برای دو یاتاقان).
  - فیلتر 10 µm، کولر روغن روی گلیکول، پمپ برگشت. جت‌های Ø0.8 هستهٔ v13A حفظ می‌شوند.
- **عمر (تخمین):**
  - C ≈ 3.0 kN (برای 10×22×6؛ از روی 5.1 kN اندازهٔ 15 mm). با P ≈ 100 N: L10 پایه ≈ **3900 h**.
  - با ضریب aISO 3 تا 5 (روغن تمیز، هیبرید) ≈ 12,000–20,000 h.
  - **برنامه: تعویض یاتاقان هر 8000 h** (حدود یک سال کار 24/7) + پایش ارتعاش.
  - مقایسه: توربوجت‌های مدل TBO حدود 25 h دارند [8]. یاتاقان هیبرید با روغن جت در توربوشارژر تا 120k rpm تست شده است [9].
- **پیش‌بار و تراست:**
  - پیش‌بار سبک ~30 N (تخمین).
  - **یاتاقان جلو locating است**، چون لقی نوک کمپرسور 0.149 mm بحرانی است. یاتاقان عقب در کارتریج شناور است و فنر دارد.
  - تراست خالص آیرودینامیکی با طراحی back-face توربین **≤ 80 N رو به جلو** نگه داشته شود و در تست با load-washer اندازه‌گیری شود.
- **تکیه‌گاه:** کارتریج SFD با دو O-ring از جنس FKM (مثل B1/B2 در E3) و سفتی 1–2 N/µm.
- **Foil air bearing:** برای ساخت اول نه. نیاز به طراحی سفارشی، پوشش، یاتاقان تراست foil و تحمل سایش استارت/توقف دارد. مزیتش (بدون روغن، مناسب 24/7) برای فاز ۳ و همراه با روتور یکپارچه است [2].

**دینامیک روتور** (تخمین؛ همان روش `sim/gr180_rotor.py`: تیر FE + ژیروسکوپی، فقط هسته + چرخ). سرعت‌های بحرانی forward بر حسب rpm:

| حالت | سفتی تکیه‌گاه 1 N/µm | 2 N/µm | 10 N/µm |
|---|---|---|---|
| A: v13A، Ø8/608 + چرخ Ø96 1.0 kg | 5k، 21k، 67k، 224k | 7k، 29k، 74k، 228k | 9k، 52k، **109k**، 251k |
| B: Ø10/16/18 + چرخ Ø96 1.0 kg | 5k، 21k، 77k، 262k | 7k، 29k، 81k، 264k | 11k، 57k، **108k**، 283k |
| C: Ø10/16/18 + چرخ Ø82 0.55 kg، overhang 44 | 7k، 21k، 87k، **288k** | 10k، 29k، 91k، 290k | 17k، 57k، **115k** ✗، 306k |

- تکیه‌گاه سفت (≥ 5 N/µm) یک مود را دقیقاً روی 90–135k می‌گذارد.
- **تکیه‌گاه نرم و میرا (1–2 N/µm)** سه مود را زیر 91k می‌برد (عبور با میرایی SFD) و مود خمشی اول را به 2.5× دور کار می‌رساند (حالت C).
- **چرا Ø8/608 کنار می‌رود** (حتی با این‌که حالت A از نظر مود هم قابل قبول است):
  1. در D2 کل 85 kW از ژورنال عقب می‌گذرد: τ = 70 MPa در Ø8، در برابر 36 MPa در Ø10، به‌علاوهٔ خمش چرخ سنگین‌تر.
  2. چرخ شعاعی با جوش به استاب شفت وصل می‌شود، پس شفت به‌هرحال نو است.
  3. Ø10 سفتی خمشی ژورنال را 2.4 برابر می‌کند، در همان OD 22.
- **حداقل قطرها:** ژورنال Ø10 (k5)، بدنه Ø16، استاب توربین Ø18، نشیمن کمپرسور Ø8.
- **ژنراتور:** همان یاتاقان 10×22×6 هیبرید در x −266 و −136 (دهانه 130 mm)، با SFD و جت روغن از همان مدار.

## ۳. چرخ توربین شعاعی: خرید یا سفارشی؟

- **داده‌های بازار:**
  - BorgWarner S400 با چرخ 95.7/88 mm: حداکثر 96,445 rpm، یعنی U ≈ 483 m/s [10].
  - Holset HX40 Super با چرخ 76/64 mm: حداکثر 120,000 rpm، یعنی U ≈ 478 m/s [11] (داده از خرده‌فروش و فروم، تأییدنشده).
  - نتیجه: چرخ‌های توربوشارژر برای حدود **480 m/s** درجه‌بندی شده‌اند.
- **Ø96 در 115k = 578 m/s.** این 20 % سرعت و 44 % تنش گریز از مرکز بیشتر از هر چرخ آماده است، و برای IN713LC در 800 °C پرریسک است (یادداشت RT2 هم همین را می‌گوید).
- **تصمیم:** چرخ آمادهٔ توربوشارژر (به‌صورت shaft & wheel با جوش اصطکاکی، IN713C/K418) با **D4 76–80 mm، exducer 64–70 mm**:

| D4 | U4 (m/s) | ψ | U/C0 | η_ts (تخمین) |
|---|---|---|---|---|
| 76 | 458 | 1.01 | 0.63 | 0.76 |
| 80 | 482 | 0.92 | 0.66 | 0.78 |

  - بارگذاری بالاتر و η کمی پایین‌تر است، ولی چرخ آزموده، ارزان و سبک است (0.4–0.55 kg) و دینامیک روتور را بهتر می‌کند (حالت C).
- **خانواده‌های کاندید** (بدون شرکت آمریکایی برای خرید):
  - هندسهٔ کلاس HX40 (76/64): نسخهٔ IN713C/K418 ساخت سازندگان چینی.
  - MHI TD07/TD08 (JP) و IHI RHF/RHG بزرگ (JP): اندازه‌ها از نقشهٔ سازنده تأیید شود [12].
  - **Changzhou E&E Turbo-Power (CN):** چرخ 20–270 mm، IN713C، جوش اصطکاکی/EB، ریخته‌گری سفارشی هم دارد [13].
- **شرط خرید:**
  - حداکثر سرعت مجاز سازنده برای همان قطر ≥ **121k rpm**.
  - دادهٔ burst یا FEA از سازنده.
  - **spin proof در 120 % (138k)** پیش از نصب.
  - TIT اولیه ≤ 780 °C.
- **کار بعدی:** meanline و حلقهٔ نازل شعاعی برای D4 76–80 (α4 ≈ 75°) از نو حساب شود. Ø96 سفارشی فقط اگر η چرخ آماده کم درآمد.

## ۴. ورودی هوا و فیلتر

- **دبی:** 1228 m³/h. فیلترهای موتور دیزلی (مثل MANN+HUMMEL Entaron HD) برای 2–13 m³/min ساخته می‌شوند و افت چند kPa دارند [14]، که برای توربین گازی زیاد است.
- **کارتریج استوانه‌ای توربین گازی Camfil CamPulse GTC (SE)** [15]:
  - استوانهٔ OD 445 / ID 324 × 660 mm.
  - جفت Cyl/Cyl: 2500 m³/h با Δp اولیه 140 Pa، کلاس F9 (ePM1 85 %)، افت نهایی توصیه‌شده 1000 Pa.
  - Tenkay 34″ (Ø324 × 864): 1150 m³/h با 115 Pa.
- **تصمیم:** کارتریج **هم‌محور با موتور و دور پاد ژنراتور**. سمت تمیز کارتریج همان پلنوم ورودی است و هوای ورودی پاد را هم خنک می‌کند (مثل Capstone [1]).
  - **رابط: حلقهٔ tube-sheet با دهانهٔ ID 324 mm**، واشر PU/EPDM، یوغ و درپوش انتهایی. این قالب 324/445 × 660 در کارتریج‌های GT اروپایی (Camfil، MANN+HUMMEL Vokes، Freudenberg Viledon) رایج است؛ تطبیق دقیق با نقشهٔ سازنده تأیید شود.
  - **جفت F9 پیشنهاد می‌شود:** Δp اولیه حدود **70 Pa** (تخمین خطی از 140 Pa در 2500 m³/h)، تعویض در 500 Pa. بودجهٔ افت ورودی 1000 Pa (≈ 1 %).
  - یک استوانه هم کافی است: حدود 140 Pa (تخمین).
  - سرعت در حلقهٔ بین Ø324 و پاد Ø110: 4.7 m/s (q ≈ 13 Pa).
- **ساخت اول:** توری استیل FOD روی شکاف شعاعی + حلقهٔ tube-sheet آماده. کارتریج بعداً اضافه می‌شود.

## ۵. اگزوز

- دبی 0.4 kg/s در 600 °C ← ρ = 0.407 kg/m³، **Q = 0.983 m³/s**.

| خروجی | سرعت | فشار دینامیکی q | افت زانو (K = 0.25) | کل با 1 m لوله و تخلیه | درصد |
|---|---|---|---|---|---|
| DN150 | 48.7 m/s | 483 Pa | 121 Pa | 664 Pa | 0.65 % |
| **DN200** | **28.3 m/s** | **164 Pa** | **41 Pa** | **221 Pa** | **0.22 %** |
| DN250 | 18.1 m/s | 67 Pa | 17 Pa | 89 Pa | 0.09 % |

- **تصمیم: DN200.** زانوی 90° رو به بالا با R/D ≈ 1.0. فلنج EN 1092-1 PN6 DN200 (OD 320، PCD 280، 8×M16؛ از استاندارد، از حافظه).
  - DN150 به‌تنهایی 0.65 % افت دارد. با بازیافت حرارت CHP پایین‌دست، از سقف 1 % رد می‌شود.
  - هر 1 % فشار پشت توربین ≈ 1.2–1.5 % از 85 kW، یعنی حدود 1 kW از 25 kW خالص (تخمین).
- دیفیوزر فعلی (خروجی Ø144) مستقیم به زانو می‌رسد. افت انبساط ناگهانی Ø144 → Ø210 حدود 0.2 % است (تخمین). بهتر است دیفیوزر تا ورودی زانو ادامه یابد.
- بعد از زانو: **بلوز DN200 استیل** (محوری + جانبی؛ Witzenmann یا BOA، DE). وزن کانال روی تکیه‌گاه خودش است، نه روی موتور.
- جنس: 1.4828 / 1.4841 یا 321، عایق‌دار.

## ۶. استارت

- **تصمیم: موتورکردن PMG با مبدل.** همان روش میکروتوربین‌های تک‌شفت: اینورتر از ~2 Hz فرکانس را بالا می‌برد، ژنراتور در نقش استارتر است، و بعد از self-sustaining مبدل به حالت تولید برمی‌گردد [16][17].
- **مزایا:** بدون کمپرسور هوا و مخزن، قابل تکرار و خودکار (برای ری‌استارت 24/7 مهم است)، و بدون قطعهٔ اضافه روی روتور.
- **الزامات مبدل:**
  - مبدل سمت ماشین **چهارربعی (AFE، نه پل دیودی)** با FOC بدون سنسور.
  - فرکانس خروجی **≥ 2 kHz**: PMG دوقطبی در 115k = 1917 Hz.
  - توان استارت (تخمین، توان کمپرسور ∝ N³): در 25 % ← 0.9 kW، در 35 % ← 2.6 kW، در 50 % ← 7.4 kW.
  - light-off حدود 25 %، self-sustain حدود 45–55 % (تخمین). پس **5–8 kW کوتاه‌مدت** (چند ده ثانیه).
  - منبع DC برای استارت بدون شبکه (باتری/UPS).
  - دمای سیم‌پیچ و جریان استارت محدود شود.
- **دریچهٔ M5 استارت هوایی:** فقط برای تست هستهٔ v13A به‌صورت توربوجت، پیش از آماده‌شدن ژنراتور. در D2 با درپوش بسته شود.

## کارهای بعدی
1. meanline و نازل شعاعی برای چرخ آمادهٔ D4 76–80. انتخاب چرخ مشخص با نقشه و دادهٔ burst سازنده.
2. مدل کامل دینامیک روتور: شفت جدید + چرخ واقعی + SFD (تحلیل پاسخ نامیزانی، نه فقط مودها).
3. طراحی quill، سوکت شش‌گوش و درایو دماغه. اصلاح سوراخ کمپرسور به Ø8.
4. مدار روغن (۴ یاتاقان + کولر + پمپ برگشت).
5. CAD: tube-sheet با ID 324، زانوی DN200 رو به بالا، کارتریج‌های SFD.

## منابع
1. Capstone (ساختار تک‌شفت، ژنراتور با خنک‌کاری هوای ورودی): https://en.wikipedia.org/wiki/Capstone_Green_Energy (شرکت آمریکایی؛ فقط مرجع فنی، نه تأمین‌کننده)
2. Capstone، یاتاقان هوایی بدون روغن: https://ir.capstonegreenenergy.com/press-releases/detail/1554
3. Voith، کوپلینگ دیافراگمی تا 80,000 rpm: https://voith.com/corp-en/drives-transmissions/turbo-gear-units/diaphragm-couplings.html
4. ISMB3، انواع کوپلینگ و quill: https://www.magneticbearings.org/app/uploads/publications/ismb3/ismb3_submission_21.pdf · TAMU Turbomachinery Symp.، quill در برابر gear coupling: https://oaktrust.library.tamu.edu/bitstream/1969.1/163575/1/T18101-110.pdf
5. GMN، جدول یاتاقان‌های اسپیندل (سرعت روغن/گریس، HY): https://www.gmn.de/en/ball-bearings/standard-bearings/spindle-ball-bearings/
6. GMN، مبنای حد سرعت: https://www.gmn.de/wp-content/uploads/2015/08/Kugellager_Katalog_Tabelle_Drehzahlfaktoren_e.pdf
7. FAG HCB71902-C-T-P4S-UL (C 5.1 kN، 75k/120k): https://shop.rolling.hu/catalog-item/INA_MED/spindle-bearings/26512
8. عمر توربوجت مدل (~25 h تا اورهال؛ تأییدنشده): https://philip.greenspun.com/blog/2021/04/06/could-we-revive-family-four-seat-aircraft-with-crummier-jet-engines
9. یاتاقان هیبرید سرامیکی توربوشارژر تا 120,000 r/min: https://journals.nwpu.edu.cn:443/jxkxyjs/article/id/5555
10. S400 با چرخ 96/88 mm، حداکثر 96,445 rpm: https://www.full-race.com/borgwarner-airwerks-s480sx4-t6-80mm-s400sx4-11096-turbo
11. HX40 Super با چرخ 76/64 mm، حداکثر 120k: https://www.turbozentrum.de/Holset-Super-HX40-Turbo-14cm_1 · https://www.dsmtuners.com/threads/holset-turbos-faq.362444/
12. چرخ TD08H (MHI): https://www.leadturbo.ca/en/Product-Detail/49188-01813-TW-Turbine-Wheel-for-TD08H-Turbocharger-Isuzu-6WF1-CT-Hino
13. Changzhou E&E Turbo-Power: https://automechanika.messefrankfurt.com/frankfurt/en/exhibitor-search.detail.html/changzhou-ee-turbo-power-co-ltd/mf_1_0015027529_3969343_10000007202401.html
14. MANN+HUMMEL Entaron HD 13 (7.5–13 m³/min): https://oem.mann-hummel.com/en/shop/product.html/entaron-hd-13-4523192910.html
15. Camfil CamPulse GTC (445/324 × 660، 2500 m³/h / 140 Pa؛ Tenkay 1150 m³/h / 115 Pa): https://www.camfil.com/en-au/products/turbomachinery-filters/cartridge-filters/synthetic-gtc/campulse-gtc-_-15850
16. ژنراتور به‌عنوان استارتر با اینورتر (US6064122): https://image-ppubs.uspto.gov/dirsearch-public/print/downloadPdf/6064122
17. سیستم استارت میکروتوربین (EP1191207B1): https://patents.google.com/patent/EP1191207B1/en
