ahmadreza221/aurora-cchp/docs/engine/E3_fpt_pmg.md

# E3 — interduct، توربین قدرت آزاد (FPT)، روتور FPT/PMG، یاتاقان‌ها، ژنراتور ۳۰ kW و collector اگزوز

تاریخ: ۲۰۲۶-۱۰-۲۱ · زیرسیستم E3 از `docs/06_master_design.md` §۴ · قاب‌ها: ENG (mm) و ROOF (m) طبق §۱ همان سند.

| فایل | نقش |
|---|---|
| `sim/engine/e3_fpt_pmg_calc.py` | محاسبهٔ کامل (meanline، سازه، ارتعاش پره، تراست، PMG، غلاف، یاتاقان، rotordynamics، حرارت، آب‌بندی). **منبع واحد هندسه** برای CAD. اجرا: `uv run sim/engine/e3_fpt_pmg_calc.py` (بدون numpy هم اجرا می‌شود ولی تحلیل ویژه‌مقدار و نمودارها حذف می‌شوند) |
| `cad/engine/fpt_pmg.py` | مدل پارامتری FreeCAD (Part). اجرا: `LANG=en_US.UTF-8 …/freecadcmd cad/engine/fpt_pmg.py` |
| `cad_out/engine/E3/` | STEP هر قطعه (`E3-xxx_*.step`)، `E3_assembly.step` (ENG)، `E3_assembly_ROOF.step` (ROOF، mm)، `E3_assembly.FCStd`، `E3_interfaces.json`، `E3_section.png`، `E3_campbell.png`، `E3_unbalance.png`، `E3_blade_campbell.png`، `E3_calc_results.json`، `E3_calc_report.txt`، `E3_massprops.json`، `E3_checks.json` |
| `docs/bom/engine_E3_bom.csv` | BOM با ستون‌های §۵ سند 06 و جرم از CAD: ۴۴ سطر قطعهٔ مدل‌شده (`model_file` = STEP) + ۱۱ سطر اقلام بدون مدل (E3-601…611: گسکت، پیچ‌ها، O-ring، اوریفیس buffer، اتصالات روغن/گلیکول، هارنس، عایق، خدمات بالانس/spin) |

**ترتیب اجرا (دو مرحله‌ای):** calc → CAD (جرم و اینرسی واقعی روتور را در `E3_massprops.json` می‌نویسد) → دوباره calc (J و rotordynamics با جرم CAD) → دوباره CAD. اعداد این سند از مرحلهٔ دوم‌اند.

---

## ۰. خلاصهٔ طراحی

| موضوع | مقدار |
|---|---|
| دور طراحی / حداکثر گاورنر / trip / طراحی overspeed / spin test | **60k** / 65k / 71.5k / **72k (120 %)** / **78k** rpm |
| باند کار پیوسته N2 | **48–65k rpm** (0–48k فقط عبور در استارت؛ B3 روی بار N2 ≥ 48k نگه می‌دارد) |
| جهت چرخش FPT | **پادساعت‌گرد از دید ورودی** (خلاف GG، counter-rotating) |
| Interduct | L 70 mm، AR 1.35، 2θ_eq 7.9°، **افت P0 1.48 %** (مجاز سیکل 1.5 %) |
| FPT | تک‌طبقهٔ محوری، **NGV 23 (SLM IN718) / روتور 19 (blisk IN718)**، r_mean 42.5 mm، U 267 m/s، U/C0 0.66، ψ 0.92، φ 0.46 |
| راندمان | **η_tt 0.833؛ η_ts 0.783** (از P01 تا فشار استاتیک فلنج H1، شامل دیفیوزر و collector؛ هدف ≥ 0.78) |
| خروج | T0 611 °C، swirl صفر، Cx 127 m/s → دیفیوزر محوری-شعاعی AR 2.28 → plenum → DN250 (17.7 m/s) |
| توان | آیرودینامیک 25.41 kW − یاتاقان/آب‌بندی 0.54 kW = **شفت 24.86 kW** (سیکل 25.64 kW، −3.0 %؛ با فشار ورودی خودِ سیکل: 25.63 kW) → **ترمینال PMG 24.11 kW** |
| روتور | یک شفت: blisk (غرب) – B1 – PMG – B2 (شرق)؛ جرم 2.23 kg، طول 261 mm، **J = 6.47×10⁻⁴ kg·m²** |
| یاتاقان‌ها | B1: **71905 هیبرید** (locating)، B2: **7005 هیبرید** (floating، فنر 200 N)؛ هر دو روی **squeeze-film damper** با O-ring؛ جت روغن |
| بحرانی‌ها | **10.1k (conical، ζ 0.28) و 14.0k (cylindrical، ζ 0.44)** زیر باند؛ **خمشی اول 92.3k = 28 % بالای 72k** → طراحی supercritical با میرایی |
| PMG | **2 قطب، 1.0 kHz @ 60k**، SmCo + غلاف کربنی 3 mm، 24 شیار، E_LL 358 V، 49 A، **η 97.5 %**، ژاکت گلیکول SLM AlSi10Mg |
| خروجی اگزوز H1 | DN250 PN6 (OD 375، PCD 335، 12 × M16)، رو به **+y (شمال)**، مرکز فلنج **ENG (300, 250, 0)** = **ROOF (1.980, 8.100, 0.600)** |
| فلنج جلو E2/E3 (**مطابق E2**، `sim/engine/e2_design.json`) | سطح x = **116.0** (ROOF X 1.796)، OD 176، PCD 160، **16 × M8**، رینگ E3 IN718 به ضخامت 8 (x 116–124)، spigot نر Ø120 h7 × 3 (x 113–116)؛ piston ring آب‌بند slip در بدنهٔ E2 |
| ابعاد کلی E3 (CAD bbox) | ENG x 112.5…487.5 (لبهٔ OD فلنج H1 تا لبهٔ دیگر آن؛ spigot جلو در 113، درپوش انتهایی 467.6)، y −235…+250، z −400…+235 → **ROOF X 1.7925…2.1675، Y 7.615…8.100، Z 0.200…0.835 m** (درون x 1.30–2.70) |

---

## ۱. ورودی‌ها و فرض‌های مرزی

| ورودی | مقدار | منبع |
|---|---|---|
| خروج توربین هسته | ṁ 0.3972 kg/s، T0 940.2 K (667 °C)، P0 147,815 Pa، Cx 300 m/s، بدون swirl، هاب r 19.0 / پوسته r 35.35 mm، x ≈ 118.3 | `sim/gg_turbine_design.json` |
| مهرهٔ GG و انتهای شفت | x تا 126.8 / 127.8، 115k rpm، ساعت‌گرد از ورودی | `build_gr180.py`، `asm_parts` |
| فلنج عقب بدنهٔ فشاری E2 | رینگ x 106–116 (سطح مونتاژ **x 116.0**)، OD 176، PCD 160، 16 × M8، recess spigot Ø120 × 3، شیار piston ring x 112.5–114.5 (r 40)، گسکت Ø137 × 8؛ W 34.4 kN، سطح پیچ لازم 313 / موجود 525 mm² | `sim/engine/e2_design.json`، `e2_results.json` (flange_E2E3) |
| فشار پشت FPT (استاتیک فلنج H1) | 106,266 Pa = Pa(50 m) × (1 + 0.035 + 0.015 + 0.005) | `concept_study.cycle` |
| توان شفت لازم سیکل | 25.64 kW (η_pt 0.78، مکانیکی 0.985، P4 = P3·…·0.985) | `life_study.point(115k, 800 °C, 15 °C, 50 m)` |

**نکتهٔ هماهنگی با E1:** سیکل P4 = 146,981 Pa را با η_t هسته 0.82 فرض کرده، ولی meanline جدید E1 (η_tt 0.809) فشار P03 × 0.985 = 145,598 Pa می‌دهد (**0.94 % کمتر**). همین بخش اصلی کسری 3 % توان شفت است. FPT خودش هدف η_ts ≥ 0.78 را برآورده می‌کند.

---

## ۲. چیدمان محوری (ENG، mm؛ ROOF X = 1.680 + x/1000)

| x | جزء |
|---|---|
| 113.0–116.0 | spigot نر Ø120 h7 × 3 داخل recess بدنهٔ E2 (آب‌بند slip = piston ring در شیار E2، x 112.5–114.5، r 40) |
| 116.0–119.3 | بور slip ID 73.2 روی shroud نازل GG (OD 72.7؛ لقی شعاعی 0.25)؛ بدون رینگ در سمت E3 |
| 118.3 | لبهٔ فرار روتور E1 (هاب r 19.0) |
| **119.3** | ورود interduct = لبهٔ مخروط ثابت هاب (فاصلهٔ محوری 1.0 mm) |
| **116.0–124.0** | رینگ فلنج E2/E3 (IN718، 8 mm؛ OD 176، 16 × Ø9 روی PCD 160؛ مطابق E2) |
| 133.0 | ترموکوپل‌های ورود FPT (TE-510A/B) و tap فشار P45 (PT-524) |
| 139–145 / 145–151 | فلنج میانی interduct / درپوش غربی درام collector |
| **189.3–201.3** | NGV (23 پره، b_ax 12) |
| 193–199 | مهرهٔ FPT (M10×1.25 RH، 15 AF) |
| **204.8–216.8** | پره‌های روتور (19 پره)؛ رینگ دیسک 203.5–218.5 |
| 222.0 | سطح Hirth (24 دندانه) blisk ↔ heat-dam sleeve |
| 224.5–231.3 | ۴ دندانهٔ labyrinth (r 14.0، لقی 0.15) |
| 232–235 / 235–239 | حلقهٔ buffer air / windback روغن (لقی 0.15) |
| 231 / 253 | دیواره‌های غربی/شرقی دیفیوزر شعاعی (پهنا 22، تا r 125) |
| **244–253 (مرکز 248.5)** | **B1** 71905 در کارتریج SFD |
| 145–299 | درام collector (R 215) |
| 262–270 | دیوارهٔ جلوی هوزینگ PMG (آب‌بند روغن سمت PMG) |
| 278–313 / 376–411 | سرسیم‌پیچ جلو / عقب |
| **312.8–375.8** | پک استاتور (63 mm)؛ آهنربا 310.8–377.8؛ غلاف 306.8–381.8 |
| 336–342 | فلنج نگهدارندهٔ PMG برای مخروط مانع حرارتی |
| 412.6–418.6 | دیوارهٔ عقب / هوزینگ B2 |
| **423.6–435.6 (مرکز 429.6)** | **B2** 7005 در کارتریج SFD + فنر موجی 200 N |
| 436.6–442.6 / 444.6–450.6 | مهرهٔ قفل M20×1 / چرخ هدف N2 (۲ دندانه) |
| 441.6–467.6 | درپوش انتهایی + ۲ سنسور N2 |

فاصلهٔ یاتاقان‌ها 181.1 mm؛ overhang دیسک از B1: 38 mm.

---

## ۳. Interduct (داکت S شکل رو به بیرون)

- دیواره‌ها با منحنی هموار `3ξ² − 2ξ³` (شیب صفر در دو سر، ورودی و خروجی محوری). هاب r 19.0 → 31.0؛ پوسته r 35.35 → 46.5؛ طول 70 mm.
- **مخروط/بولت ثابت هاب:** خودِ دیوارهٔ داخلی (1.2 mm، SLM) است که از رینگ داخلی NGV کنسول به جلو آمده و حفره‌ای بسته دور مهره و انتهای شفت GG می‌سازد. لقی‌ها: لبه تا هاب روتور E1 در محور 1.0 mm (تا توربین v13A: 1.45 mm)، تا مهرهٔ GG 12.0 mm، تا شفت 13.8 mm. دیوارهٔ پشتی حفره در x 189.3–191.3.
- رشد حرارتی: دیوارهٔ بیرونی از فلنج به عقب و بولت از NGV به جلو تقریباً هم‌دما (~650 °C) رشد می‌کنند، پس جابه‌جایی لبه نسبت به فلنج تقریباً صفر است.

| معیار جدایش | مقدار | حد |
|---|---|---|
| AR (سطح عمود بر جریان) | 1.352 | — |
| زاویهٔ مخروط معادل کل 2θ_eq | **7.93°** | ≤ 8° |
| حداکثر زاویهٔ معادل موضعی | 11.9° | ≤ 12° |
| ΔR_mean/L | 0.165 | ≤ 0.35 (ITD متعارف) |
| L/h0 | 4.28 | — |
| حداکثر شیب دیواره | 14.4° | — |

M از 0.499 به 0.343 و V از 293 به 203 m/s می‌رسد. پروفیل در این ناحیه بدون جدایش است، با فرض جریان ورودی بدون swirl.

**افت:** K = اصطکاک 0.024 + diffusion (η_d = 0.85، Sovran–Klomp) 0.068 + انحنا 0.008 + حفرهٔ لبه 0.005 = **0.105 q_in → ΔP0 = 2,186 Pa = 1.48 %** → P01 = 145,629 Pa.

---

## ۴. FPT — طراحی meanline (سه شعاع، free vortex، swirl خروجی صفر)

روش و مدل افت مثل `sim/gg_turbine_meanline.py`: Soderberg + تصحیح aspect-ratio و Reynolds، blockage لبهٔ فرار، و تلفات لقی نوک (Δη = 1.5·δ/h). کار اویلر W طوری حل می‌شود که فشار استاتیک فلنج H1 برابر فشار پشت سیکل شود. η_ts هم از همان زنجیره به دست می‌آید.

**حلقهٔ جریان:** NGV: هاب 31.0؛ نوک 46.5 → 51.5. روتور: هاب 31.0 → 27.5؛ نوک 51.5 → 56.0 (flare شدید برای کم‌کردن انرژی جنبشی خروج). لقی نوک 0.30 mm. b_ax: NGV 12؛ روتور 13 (هاب) → 9 (نوک).

**تعداد پره‌ها (Zweifel 0.89 / 0.91):** **NGV 23، روتور 19.** هر دو اول‌اند، نسبت به هم اول‌اند، و عامل مشترکی با NGV 21 (3·7) و روتور 29 هسته ندارند.

| شعاع | r2 mm | U2 m/s | α2° | β2° | β3° | واکنش R | M2 | Mw2 | Mw3 | T0rel °C |
|---|---|---|---|---|---|---|---|---|---|---|
| hub | 31.0 | 195 | 64.5 | 41.2 | −53.6 | 0.068 | 0.640 | 0.366 | 0.370 | 627 |
| mean | 42.5 | 267 | 56.8 | −8.1 | −65.3 | 0.471 | 0.497 | 0.275 | 0.527 | 641 |
| tip | 51.5 | 324 | 51.6 | −37.3 | −70.1 | 0.617 | 0.436 | 0.341 | 0.646 | 656 |

(زاویه‌ها از محور، علامت + در جهت چرخش FPT.) Cx2 160 و Cx3 127 m/s. p2 121.1، p3 104.9، P03 108.4 kPa؛ T03 = 884.4 K (611 °C)، که با 610 °C ورود گرم recuperator می‌خواند.

| تلفات (kJ/kg) | مقدار |
|---|---|
| NGV (ζ 0.142، Re 4.8e4) | 6.05 |
| روتور (ζ 0.122، Re 4.6e4) | 5.66 |
| لقی نوک (1.8 %) | 1.20 |
| اصطکاک دیسک (22 W) | 0.06 |
| خروج (بعد از دیفیوزر و collector) | 4.93 |
| Δh_is,ts | 81.71 |

**η_tt = 0.833، η_ts = 0.783.** حساسیت به دور (مسیر ثابت، با تلفات incidence): 50k 0.771 · 55k 0.786 · 60k 0.783 · 65k 0.763. منحنی در 55–62k تخت است.

**بررسی متقابل:** نمودار Smith برای ψ ≈ 0.9 و φ ≈ 0.46 حدود η ≈ 0.92 می‌دهد (اندازهٔ بزرگ، بدون لقی). کسر اثر Re (~5 %) و لقی (~2 %) به ~0.85 می‌رسد که با Soderberg (0.833) هم‌خوان است. Soderberg در Re پایین محافظه‌کار است.

---

## ۵. دیفیوزر اگزوز و collector شعاعی، فلنج H1

- **دیفیوزر محوری-شعاعی:** دیوارهٔ shroud با خم R 10 به دیوارهٔ غربی x 231 می‌رسد. هاب با «زنگ» R 34 (پشت دیسک) به دیوارهٔ شرقی x 253 می‌رسد. کانال 22 mm تا r 125 ادامه دارد. AR = 2.28 و Cp = 0.60 × (1 − 1/AR²) = **0.484**. دادهٔ دیفیوزرهای محوری-شعاعی Cp/Cp_ideal = 0.55–0.75 است.
- **Plenum (درام):** R 215، x 151–299، سرعت محیطی ~45 m/s (K 0.5). درام دور NGV/shroud را هم می‌گیرد، پس پوستهٔ FPT در گاز ~610 °C یکنواخت می‌ماند و کنترل لقی نوک بهتر می‌شود.
- **خروجی:** دهانهٔ مستطیل گردگوشه 120 × 240 روی درام، transition مایل به یک لولهٔ DN250 (273 × 6.3) و فلنج **EN 1092-1 PN6 DN250 type 01** (OD 375، PCD 335، 12 × M16). سطح فلنج در **y = +250** است، یعنی **مرز E3/E4: ROOF y 8.100**. مرکز فلنج **x = 300**. سرعت 17.7 m/s و فشار استاتیک 106.27 kPa.
- **انتخاب x = 300 و y = 250:** E4 در `E4_interfaces.json` بدنهٔ اصلی خود را از ROOF y 8.10 شروع کرده و تا 8.04 فقط spool دارد. اگر فلنج در y 305 بود، 55 mm در بدنهٔ E4 فرو می‌رفت. y 190 هم ممکن نیست چون درام (R 215) تا y 215 می‌رسد. transition مایل است (دهانه x 225 → فلنج x 300) تا OD فلنج (375) از spoolهای C1 (x 15، z +137.5؛ فاصلهٔ لبه‌ها **72 mm**) و C2 (x 60، z −167.5؛ **35 mm**) طبق مختصات E4 رد شود. فاصلهٔ فلنج تا زانوی E4 (ROOF y 8.365) برابر 265 mm است (≥ 165 لازم). **bellows DN250 سمت E4** (رشد حرارتی E3 حدود +1.8 mm در x و +1.5 mm در y).
- **هشدار C1/C2:** E2 در `e2_design.json` نازل C1 را در (x −7، z −90) و C2 را در (x 68، z +72) گذاشته، یعنی برعکس E4 (C1 بالا z +137.5، C2 پایین z −167.5). اگر موقعیت E2 بماند، spool C2 (OD 140) در صفحهٔ y 230–250 حدود **14 mm با فلنج H1 هم‌پوشانی** دارد؛ C1 در موقعیت E2 با 75 mm فاصله مشکلی ندارد. راه‌حل‌ها: C2 طبق E4 در z منفی بماند (ترجیح E3)، یا H1 به x ≈ 336 برود (ممکن، transition مایل‌تر). **E2/E4 باید پیش از قطعی‌شدن H1 حل کنند.**
- مواد: ورق 1.4828 (کلاس 310S) 2.5–3 mm با TIG؛ زنگ هاب spun؛ فلنج 1.4541. جرم درام ~21 kg + درپوش 7.8 kg. **عایق بیرونی (E5)** لازم است: سطح 610 °C.

---

## ۶. سازهٔ blisk و NGV؛ مواد

**blisk:** IN718 (AMS 5662/5663؛ میله یا فورج از VDM Metals (DE)، Aubert & Duval (FR) یا GH4169 (CN)). 5-axis CNC، دیسک با سوراخ مرکزی Ø10.5، Hirth 24 دندانه در پشت، کلمپ با stud IN718 (M10، ~25 kN) که در شفت پیچ می‌شود. Hirth مرکزیت را با اختلاف انبساط IN718/فولاد حفظ می‌کند. جرم CAD 418 g. ضخامت پره: t/c 0.22 در ریشه تا 0.05 در نوک (نسبت سطح ~0.4).

| حالت | تنش ریشهٔ پره (cf + گاز) | دما | YS 0.2 % | SF |
|---|---|---|---|---|
| 60k | 264 + 11 = **275 MPa** | 627 °C | 876 | **3.18** |
| 72k (120 %) | 381 + 10 = **391 MPa** | 627 °C | 876 | **2.24** |
| 78k spin (RT) | **447 MPa** | 20 °C | 1034 | **2.31** |

| دیسک | hoop سوراخ | von Mises max | hoop متوسط (مکانیکی) | SF تسلیم | burst (Robinson، 0.85·UTS) |
|---|---|---|---|---|---|
| 60k (سوراخ 500 / رینگ 600 °C) | 321 | 321 | 140 | 2.90 | 155k = **2.15 × 72k** |
| 72k | 422 | 422 | 202 | 2.20 | 155k |
| 78k RT | 388 | 388 | 237 | 2.66 | 164k |

- **خزش (LMP، C = 20، تنش × 1.5):** ریشه در 627 °C → **7.8×10⁴ h**؛ میانهٔ پره 1.3×10⁶ h.
- **محدودیت دمایی IN718:** T0 نسبی در نوک لبهٔ حمله 656 °C (فلز ~654 °C) کمی بالای حد پایداری بلندمدت ~650 °C است (رشد γ″ و δ). تنش نوک تقریباً صفر و ریشه 627 °C است، پس قابل قبول است. ولی در **حالت پیک TIT 815 °C** دمای نوک ~+13 K بالا می‌رود: ECU ساعت‌های این حالت را می‌شمارد و حد آن را تعیین می‌کند. جایگزین در صورت نیاز: GH4738 (هم‌ارز Waspaloy، CN) ماشین‌کاری، یا چرخ ریختگی IN713LC از ریخته‌گر E1.
- **NGV (درون ماژول interduct):** SLM IN718 در iDesign3D. پره 23 تایی با t/c 0.22، TE 0.5 mm، تنش کم و دمای 667 °C. پرینت با محور عمودی و خروجی رو به پایین. سطح فشار پره‌ها ~25° overhang دارد که نیازمند ساپورت است و با wire-EDM + AFM برداشته می‌شود. تنش‌زدایی و سپس solution + aging (AMS 5662 HT). سطوح فلنج و آب‌بندی ماشین‌کاری می‌شوند. **HIP ندارد** (قطعهٔ ثابت است و مجاز).

---

## ۷. ارتعاش پره (مدل تیر مخروطی با سفتی گریز از مرکز)

| | 0 rpm | 60k | 72k |
|---|---|---|---|
| 1F | 3.19 kHz | 3.68 kHz | 3.87 kHz |
| 2F | 15.1 kHz | 15.6 kHz | 15.8 kHz |

- عبور گذر NGV (EO 23) از 2F در 40k و GG NGV (EO 21) در 44k: **هر دو بیرون باند پیوسته 48–65k** (فقط گذرای استارت). در 60k فاصلهٔ EO23 (23 kHz) از 2F برابر **47 %** است.
- **1F × EO4 در 53.8k** درون باند است. منبع EO4 در E3 عمداً وجود ندارد: strut ندارد، فقط ۲ TC در 180° و ۱ tap فشار، و collector EO1–2 می‌دهد. **E2** (`e2_design.json`) حالا **۷ انژکتور** دارد (۲۰۲۶-۱۰-۲۲؛ ۸ انژکتور با 2F پرهٔ توربین هسته در 113.8k تشدید داشت، `sim/engine/e1_blade_modal.py`): EO7 × 1F در ~31k (خارج باند) و در باند کاری EO7 = 5.6–7.6 kHz بین 1F و 2F می‌افتد؛ قابل قبول (درخواست قبلی «≠ 4 و 5» برآورده است).
- لازم: **FEA مودال blisk** (CalculiX؛ مدهای کوپل دیسک-پره، نمودار ZZENF، EO 23 → ND 4) + آزمون ping + tip-timing در استند.

---

## ۸. سیستم روتور

### ۸-۱ ساختار
یک شفت 34CrNiMo6 (1.6582، Q+T 1000–1100 MPa، سنگ‌زنی h5، لنگی ≤ 3 µm). شفت مسیر برگشت شار روتور 2 قطب هم هست. از غرب به شرق:
مهرهٔ FPT → blisk → Hirth → **heat-dam sleeve** (IN718، ۴ دندانهٔ labyrinth، slinger روغن) → حلقهٔ داخلی B1 → شانهٔ Ø30 → آهنرباها روی Ø30 → B2 → مهرهٔ قفل M20×1 → چرخ هدف N2 (۲ دندانه).
پشتهٔ کلمپ با stud IN718 به شانهٔ Ø30 فشرده می‌شود. اصطکاک (μ 0.2 × 25 kN × r 11 mm ≈ 55 N·m) بیش از ۱۰ برابر گشتاور نامی (4.8 N·m) را منتقل می‌کند. مرکزیت روی Hirth است.

### ۸-۲ آب‌بندی و تراست
- حفرهٔ جلوی دیسک: لبهٔ رینگ داخلی NGV با فاصلهٔ 0.5 mm. پشت دیسک: لبهٔ زنگ هاب با فاصلهٔ 0.5 mm.
- **سمت گاز:** labyrinth با ۴ دندانه (r 14.0، لقی 0.15) → **حلقهٔ buffer air در 1.15 bar** (bleed خروجی کمپرسور از E2، اوریفیس 2.4 mm + فیلتر 40 µm؛ 0.69 g/s به حفرهٔ پشت دیسک و 0.91 g/s به محفظهٔ B1) → windback روغن (لقی 0.15) → محفظهٔ B1.
- محفظهٔ PMG بین دو آب‌بند روغن (windback + labyrinth روی Ø30، لقی 0.15) خشک می‌ماند و هوای خنک‌کاری گپ کمی پرفشارش می‌کند.
- **تراست (+ = شرق):** پره‌ها +116، دیسک +10، labyrinth −6، آب‌بند روغن +12 → **+132 N**.
- آرایش **X (face-to-face)** با فنر در B2 که شفت را به غرب می‌راند: **B1 (locating) = 200 − 132 = 68 N**، **B2 = 200 N** (ثابت، فنر). کمینهٔ بار B1 حدود 45 N است و برقرار است. چون تراست از بار B1 کم می‌کند، بیشینهٔ بار هیچ یاتاقانی از نیروی فنر بالاتر نمی‌رود.

### ۸-۳ یاتاقان‌ها و روغن‌کاری

| | B1 (غرب، locating) | B2 (شرق، floating) |
|---|---|---|
| نوع | 71905 هیبرید (25×42×9، 15°، Si3N4، P4) | 7005 هیبرید (25×47×12، 15°، P4) |
| تأمین‌کننده (غیرآمریکایی) | GMN (DE)، FAG HCB71905 (DE)، SKF (SE)، ZYS (CN) | GMN، FAG HCB7005، SKF، ZYS |
| بار محوری / P | 68 N / 102 N | 200 N / 271 N |
| L10h / L_nm (a_ISO ≈ 6) | 85,000 / 513,000 h | **19,600 / 117,000 h** |
| n·dm (60k / 72k) | 2.01 / 2.41 ×10⁶ | 2.16 / 2.59 ×10⁶ |
| اصطکاک (جت کنترل‌شده، f0 1.5) | 220 W | 308 W |

- روغن: سنتتیک استری کلاس MIL-PRF-23699 (برند غیرآمریکایی، مثلاً Shell AeroShell 560، یا Sinopec 4109 چینی)، ~7 cSt در 90 °C. جت 3 × Ø0.8 به شکاف حلقهٔ داخلی و قفسه. **B1 0.64 + B2 0.65 = 1.29 L/min در 2.5 barg** (شامل 0.1 L/min تغذیهٔ SFD هر کدام)، ΔT 20 K، گرما 334 + 338 W.
- **برنامهٔ تعمیرات:** تعویض کارتریج یاتاقان‌ها و O-ringها در overhaul **24,000 h** (حدود ۳ سال کار ۲۴/۷)، با پایش روند ارتعاش، دمای یاتاقان و ذرات روغن.

### ۸-۴ Squeeze-film damper
هر یاتاقان در یک کارتریج 17-4PH (H1150) با land آب‌بندی SFD: B1 به قطر 50 و B2 به قطر 55، طول 12، لقی شعاعی 0.075. مرکزیت با ۲ O-ring FKM (~2 N/µm). میرایی π-film حدود 1,070 / 1,420 N·s/m. **چرا SFD:** روی housing صلب، مدهای صلب در 41k و 52k rpm وسط باند کاری می‌افتند. با SFD به 10–14k (زیر باند، با میرایی بالا) می‌روند.

### ۸-۵ مانع حرارتی FPT → یاتاقان/PMG
| مسیر گرما | مقدار |
|---|---|
| از سوراخ دیسک (500 °C) از طریق Hirth (تماس 50 %)، sleeve IN718 و شفت تا ناحیهٔ خنک‌شده با جت | 52 W → حلقهٔ داخلی B1 حدود **108 °C** |
| heat shield (1.4828 0.8 + کاغذ سرامیکی 3) پشت دیسک | 15 W |
| زنگ هاب داغ تا دماغهٔ هوزینگ B1 (کاغذ سرامیکی 3 + هوای 1.5) | 47 W |
| collector تا هوزینگ PMG از طریق مخروط IN625 (1.5 mm، ۶ پنجره) + اسپیسر میکا | **117 W** (به گلیکول) |

دمای فلز هوزینگ B1 حدود 110–130 °C است: برای O-ring از نوع FKM و سنسور PT1000 مناسب است.

---

## ۹. Rotordynamics

مدل: تیر Euler–Bernoulli با اینرسی دورانی و ماتریس gyroscopic (مثل `sim/gr180_rotor.py`)، دیسک‌های lumped با جرم از CAD، آهنربا و غلاف به‌صورت جرم بدون سفتی، UMP (سفتی منفی 0.13 N/µm). تکیه‌گاه هر طرف: یاتاقان 30 N/µm → جرم کارتریج → (O-ring ‖ SFD). مقدار ویژهٔ میرا در مختصات مختلط.

| مد | دور بحرانی رو به جلو | نوع | ζ / log dec | حاشیه |
|---|---|---|---|---|
| 1 | **10,100 rpm** | conical (دیسک) | 0.28 / 1.82 | 79 % زیر 48k |
| 2 | **14,000 rpm** | cylindrical | 0.44 / 3.07 | 71 % زیر 48k |
| 3 | **92,300 rpm** | خمشی اول (85 % انرژی کرنشی در شفت) | 0.10 / 0.63 | **28 % بالای 72k** |

- خمشی غیرچرخان (تکیه‌گاه آزاد): 80.8k (+12 %). اثر gyroscopic دیسک مد رو به جلو را تا 92.3k بالا می‌برد.
- **پاسخ نابالانسی G6.3 (بدتر از بالانس هدف G1):** پیک دامنهٔ دیسک **1.1 µm** در 11.5k. در 60k: 0.58 µm، خروج از مرکز SFD 0.007 و نیروی یاتاقان 4 N. این در برابر لقی نوک 300 µm، گپ PMG 1.5 mm و labyrinth 150 µm بسیار کوچک است.
- نمودارها: `E3_campbell.png`، `E3_unbalance.png`.

**داده برای تحلیل runaway برق (جایگزین فرض 8×10⁻⁴):**

| | مقدار |
|---|---|
| **J (FPT + PMG + شفت، از CAD)** | **6.47 × 10⁻⁴ kg·m²** (blisk 3.04e-4، آهنربا 1.61e-4، شفت 1.17e-4، غلاف و رینگ‌ها 0.39e-4) |
| انرژی جنبشی | 12.8 kJ @ 60k؛ 18.4 kJ @ 72k |
| زمان رسیدن به 105 / 110 / 120 % با 25.6 kW | **51 / 105 / 219 ms** (قبلاً 63 / 130 / 271) |
| همان با 30 kW | 44 / 89 / 187 ms |

---

## ۱۰. overspeed و spin test (مشخصات)

| آزمون | شرایط | پذیرش |
|---|---|---|
| **spin اثبات blisk** (بعد از ماشین‌کاری نهایی، قبل از بالانس نهایی) | چاله‌خلأ، دمای اتاق، **78,000 rpm** (130 % طراحی = 120 % حداکثر گاورنر 65k = 109 % trip)، شتاب ≤ 2 krpm/s، نگه‌داری 60 s، ۳ چرخه | رشد دائم قطر سوراخ و رینگ ≤ 0.02 mm (CMM قبل و بعد)، FPI تمیز، تغییر بالانس ≤ G1 |
| **spin روتور PM** (شفت + آهنربا + غلاف) | چاله با گرمکن، **150 °C**، 78k، 60 s | رشد دائم OD غلاف ≤ 5 µm، بدون جداشدن آهنربا، EMF بدون تغییر. در 78k/150 °C تماس‌ها مثبت‌اند (غلاف 642 MPa، مجاز 1100). **در RT به 78k نروید**: تماس شفت/آهنربا −14 MPa می‌شود و فقط چسب نگهش می‌دارد |
| بالانس | blisk G1.0 (دو صفحه)؛ روتور مونتاژشده G1.0؛ trim در 60k داخل هوزینگ با VE-011/012 و پالس N2 | ≤ 1.5 mm/s RMS روی هوزینگ |
| روی استند | trip SMCU در 71.5k با load rejection؛ تست ترمز B3b | N2 حداکثر < 72k |
| حاشیه‌ها | burst blisk 155k = 2.15 × 72k؛ پره در 72k SF 2.24؛ دیسک 2.20 | ≥ 1.4 / ≥ 1.2 |

**ورودی برای containment (E5):** انرژی دورانی blisk در 72k برابر **8.6 kJ** است. حلقهٔ containment برای ترکیدن سه‌قطعه‌ای دیسک (~1/3 انرژی به‌صورت انتقالی) در صفحهٔ x 199–222 طراحی شود. یادآوری از سند برق: **شیر bypass/dump گاز قبل از FPT** به‌عنوان لایهٔ سوم در برابر runaway به E2 و E5 پیشنهاد می‌شود.

---

## ۱۱. ژنراتور PMG (30 kW پیوسته @ 60k)

### ۱۱-۱ انتخاب ۲ قطب
- **2 قطب → 1.0 kHz @ 60k (1.19 kHz @ 71.5k).** با یکسوساز SiC در f_sw 32–40 kHz (≥ 30 f_e)، با `docs/electrical` (D4) هم‌خوان است.
- 4 قطب 2 kHz و f_sw ≥ 65 kHz لازم دارد. تلفات آهن تقریباً ۲.۵ برابر می‌شود (f^1.6) و PWM SiC در 1200 V سخت‌تر می‌شود. مزیتش (سرسیم‌پیچ و یوغ کوتاه‌تر) برای طول روتور کمتر از عیب‌هایش است.
- در 2 قطب، شفت فولادی مغناطیسی خود یوغ روتور است. آهنربای موازی-مغناطیسی هارمونیک فضایی ندارد (B کاملاً سینوسی).

### ۱۱-۲ ابعاد و پارامترها (تحلیلی، حل دقیق دوبعدی میدان 2 قطب بین شفت و استاتور آهنی)

| پارامتر | مقدار |
|---|---|
| روتور | شفت r 15 → Sm2Co17 (موازی، 8 × 8 قطعه، تا r 22) → غلاف CF (r 22–25) → گپ مکانیکی 1.5 → بور استاتور Ø53 |
| آهنربا | VACOMAX 225 HR (DE) یا Ningbo Ninggang / Chengdu Galaxy (CN)؛ Br 1.06 T (20 °C) و 1.019 T در 130 °C |
| B1 در گپ / دندانه / یوغ | 0.539 / 1.31 / 1.30 T |
| استاتور | 24 شیار، q = 4، دو لایه، گام 10/12، k_w 0.925؛ **7 هادی در شیار → 28 دور سری در هر فاز**؛ پک **63 mm**، OD **117.7** |
| لمینیشن | **0.10 mm NO10** (JFE 10JNEX900 (JP)، Baosteel B10AT (CN)، Cogent (UK))؛ گزینهٔ Co-Fe (VACOFLUX 48, DE) برای B بالاتر |
| سیم‌پیچ | Litz (~7 mm²/هادی، مثلاً 270 × 0.18)، کلاس H، VPI + پاتینگ سرسیم‌پیچ، 3 × PT1000 (TE-760…762) |
| EMF | **E_LL 358 V rms @ 60k** (هدف 360) |
| جریان | **I 49.2 A rms @ 30 kW**، J 7.0 A/mm²، بار الکتریکی 49.7 kA/m، تنش برشی 17.2 kPa، گشتاور 4.77 N·m |
| امپدانس | **L_s ≈ 322 µH** (X 2.02 Ω @ 1 kHz)، R_ph 37.9 mΩ (120 °C) |
| اتصال‌کوتاه / ولتاژ | I_sc ≈ 102 A (2.1 pu)؛ \|V_ph\| در بار نامی 228 V rms |
| دمغناطیس | H در اتصال‌کوتاه سه‌فاز 199 kA/m در برابر Hcj(130 °C) 1088 kA/m → **SF 5.5** |

**توجه به تیم برق:** فرض L_s = 100 µH در `electrical_sizing.py` باید به ~320 µH اصلاح شود. نتیجه: |E + jωLI| در 60k حدود 323 V پیک است و مدولاسیون ~0.78 (هنوز زیر حد 416 V). جریان اتصال‌کوتاه دائم هم کمتر می‌شود که برای سایز کابل بهتر است.

### ۱۱-۳ تلفات و راندمان

| | W |
|---|---|
| مس (DC + AC، k_ac 1.10) | 303 |
| آهن (Steinmetz برازش NO10، build factor 1.5) | 167 |
| windage (گپ Taylor–Couette + سطوح انتهایی + جریان هوای خنک‌کاری) | 188 |
| جریان گردابی روتور (SmCo قطعه‌ای، غلاف نارسانا) | 40 (برآورد؛ FEA) |
| stray | 60 |
| **جمع** | **758 → η_PMG = 97.5 %** |

یاتاقان‌ها (528 W) جداگانه به‌عنوان تلفات مکانیکی شمرده شده‌اند. زنجیرهٔ کامل: آیرو 25.41 → شفت 24.86 → ترمینال 24.11 kW. سیکل 0.985 × 0.95 = 0.936 را فرض کرده بود؛ اینجا 0.949 است.

### ۱۱-۴ خنک‌کاری
- **ژاکت SLM AlSi10Mg** (3dfast) با کانال مارپیچ داخلی 12 × 6 mm، ۶ دور با گام 15 (در CAD به‌صورت ۶ شیار حلقوی هم‌ارز مقطع). استاتور shrink-fit در بور ماشین‌کاری‌شده. تست نشتی 6 bar.
- گلیکول 30 % PG، **8 L/min، ورود 40 °C** (طراحی ۳۵–۴۰). گرما 844 W، ΔT 1.6 K، سرعت کانال 1.9 m/s، h ≈ 5,600 W/m²K، Δp ≈ 20 kPa.
- دمای سیم‌پیچ **74 °C**، نقطهٔ داغ سرسیم‌پیچ 89 °C. اگر ورود 55 °C باشد (DC-1 تابستان): 104 °C، با حاشیهٔ زیاد تا کلاس H (آلارم 140 / CSD 155 °C).
- **هوای گپ:** دمندهٔ EC ‏48 V (ebm-papst / Micronel) با 4 g/s از سمت شرق به گپ می‌دمد و از ۶ سوراخ Ø8 در x 274 خارج می‌شود. windage را می‌برد و دمای آهنربا و غلاف را ~120–130 °C نگه می‌دارد. اپوکسی غلاف باید high-Tg (≥ 180 °C) باشد.

### ۱۱-۵ غلاف کربنی (FE یک‌بعدی متقارن محوری: شفت | SmCo قطعه‌ای | CF ارتوتروپ)
T700S-class، hoop-wound، **3.0 mm، تداخل قطری 0.18 mm**؛ مجاز بلندمدت hoop 1100 MPa (UTS ~2200).

| حالت | hoop غلاف | تماس آهنربا/غلاف | تماس شفت/آهنربا |
|---|---|---|---|
| 0 rpm، 20 °C | 447 | 53.7 | 78.5 |
| 60k، 130 °C | 600 | 70.5 | 49.8 |
| **72k، 150 °C** | **635 (SF 1.73)** | 73.3 | 30.4 |
| 78k، 150 °C (spin) | 642 | 73.1 | 16.6 |
| 78k، 20 °C | 495 | 52.0 | −14.2 (→ spin گرم) |

### ۱۱-۶ خرید ژنراتور آماده به‌جای ساخت؟
| گزینه (غیرآمریکایی) | توضیح |
|---|---|
| **e+a Elektromaschinen und Antriebe (CH)** | ماشین‌های PM پرسرعت سفارشی، ده‌ها kW تا بیش از 100k rpm. **بهترین گزینهٔ اروپایی برای «کیت استاتور + روتور»** طبق نقشهٔ شفت ما |
| Aeristech (UK)، Turbo Power Systems (UK) | ماشین‌های 10–50 kW در 60–120k برای e-turbo و میکروتوربین؛ دسترسی و تحریم بررسی شود |
| IHI، Mitsubishi Heavy (JP) | موتورهای کمپرسور هوای fuel-cell (20–30 kW، > 80k rpm)؛ معمولاً به‌صورت مجموعهٔ کامل فروخته می‌شوند |
| سازندگان چینی موتور کمپرسور fuel-cell (20–40 kW، 80–120k rpm) و موتور دمندهٔ maglev (مثل Tianjin Emaging Technology) | قیمت و دسترسی خوب. اغلب روتور یکپارچه با یاتاقان هوایی یا مغناطیسی دارند؛ کیت جداگانه را باید استعلام کرد |
| Celeroton (CH)، SycoTec (DE) | سرعت مناسب ولی توان < 2–5 kW، **مناسب نیست** |

**توصیه:** روتور، شفت، یاتاقان و هوزینگ را خودمان بسازیم، چون شفت با FPT مشترک است و SFD و مانع حرارتی یکپارچه‌اند. ژنراتور مستقل یعنی کوپلینگ و ۲ یاتاقان اضافه، و حاشیهٔ rotordynamics کمتر. **استاتور پیچیده‌شده** (لمینیشن + Litz + VPI) و **آهنرباهای قطعه‌ای** را از متخصص بخریم: e+a، یا سازندهٔ چینی موتور پرسرعت طبق مشخصات بخش ۱۱-۲.

---

## ۱۲. درگاه‌ها، سنسورها و پایه‌ها (مختصات در `E3_interfaces.json`)

| تگ | محل (ENG mm) | توضیح |
|---|---|---|
| TE-510A/B (E3-501/502) | x 133، θ 45° / 225°، شعاع بیرونی 52 | ترموکوپل K کلاس 1، MI 1.5 Inconel 600، غوطه‌وری تا میانهٔ دهانه (ورود FPT) |
| PT-524 (E3-503) | x 133، θ 135° | tap استاتیک P45 (0–4 bar abs) |
| TE-505A/B (E3-504/505) | روی transition خروجی، y 214، z ±145 | TOT = ورود گرم recuperator؛ MI 3 mm، غوطه‌وری 60 mm |
| PT-525 (E3-506، **تگ جدید پیشنهادی**) | y 214، z +146 | فشار استاتیک خروج FPT/collector |
| SE-002B1/B2 (E3-507/508) | x 447.6، θ 45° / 135° | دو سنسور مستقل M12×1 (Hall یا القایی، کلاس Jaquet / Baumer)، چرخ ۲ دندانه → 2 ppr، 2.0 kHz @ 60k، گپ 1.0 mm |
| VE-011 (E3-509) | x 350، −y | شتاب‌سنج IEPE روی ژاکت PMG نزدیک B1 (MMF KS80D (DE) / Hansford (UK)) |
| VE-012 (E3-510) | x 429.6، −y | شتاب‌سنج روی هوزینگ B2 |
| TE-720 / TE-721 | B1 (کابل از پنجرهٔ مخروط) / B2 +y | PT1000 روی حلقهٔ بیرونی یاتاقان |
| TE-760…762 | داخل استاتور | PT1000 سیم‌پیچ، از جعبه ترمینال |
| روغن B1 تغذیه / تخلیه | x 266 بالا / پایین (دیوارهٔ جلوی PMG) | M10×1 / M16×1.5؛ لوله‌ها از پنجره‌های مخروط با شیب ≥ 5° برای تخلیه |
| روغن B2 تغذیه / تخلیه | x 429.6 بالا / پایین | همان |
| buffer air | x 266، θ 45° | 1.6 g/s از bleed کمپرسور (E2) |
| گلیکول ورود / خروج | x 392 پایین / x 298 بالا | G1/2 (خروج در نقطهٔ بالا برای هواگیری) |
| هوای گپ | x 415.6، +y | دمنده 48 V |
| جعبه ترمینال (E3-307) | x 380–448 روی سقف ژاکت (z 93–172)، گلند M40 رو به شرق (سطح گلند x 460، z +111) | سه فاز (3 × M8 روی بورد PEEK) + PE + کانکتور M12 برای RTDها |
| پایهٔ جلو (E3-401) | x 225 زیر درام | **flexure** 1.4828 با ضخامت 8 mm (کورس محوری ±2 mm)، base 48 × 260 با ۴ سوراخ M12 شیاردار |
| پایهٔ عقب (E3-402) | x 402.6 زیر PMG | flexure S355 با ضخامت 10، base 50 × 220 |

**فرض پایه:** سطح بالای ریل اسکید در ENG z = −400 (ROOF Z 0.200)؛ E5 تأیید کند. نقطهٔ ثابت محوری موتور = بدنهٔ E2. هر دو پایهٔ E3 در جهت محور انعطاف‌پذیرند (درام داغ ~1.3 mm رشد می‌کند).

---

## ۱۳. رابط‌ها و هماهنگی

| رابط | وضعیت |
|---|---|
| **فلنج E2/E3** | `cad_out/engine/E2/E2_interfaces.json` هنوز منتشر نشده، ولی E2 فلنج را در `sim/engine/e2_design.json` (۲۰۲۶-۱۰-۲۱) تعریف کرده و **E3 همان را اعمال کرد:** سطح مونتاژ **x = 116.0** (ROOF X 1.796)، OD 176، PCD 160، **16 × M8** (سوراخ Ø9، فاز 11.25° دو طرف خط قائم — E2 تأیید کند)، پیچ 1.4980/A286 یا IN718 با مهرهٔ نقره‌اندود، رینگ E3 از IN718 به ضخامت 8 mm (x 116–124)، spigot نر Ø120 h7 × 3 (x 113–116) داخل recess E2، گسکت Ø137 × 8 (KLINGER Milam PSS 1 mm / Thermiculite 815). محاسبهٔ E2: W 34.4 kN، سطح پیچ لازم 313 mm² / موجود 525 mm². **slip joint:** piston ring در شیار رینگ عقب E2 (x 112.5–114.5، r 40) روی shroud نازل GG؛ E3 فقط بور ID 73.2 (x 116–119.3، لقی شعاعی 0.25) دارد و رینگی ندارد. **پیشنهاد قبلی E3 (x 122، OD 150، PCD 135، 12 × M6) منسوخ شد** — سطح ریشهٔ پیچ آن (12 × 17.9 = 215 mm²) از 313 mm² لازم کمتر بود. **E2 باید درگاه bleed خروجی کمپرسور برای buffer air را اضافه کند.** |
| **H1 → E4** | E4 فرض کرده بود x 450 و سطح y 190. **E3 ثابت کرد: مرکز فلنج ENG (300, 250, 0) = ROOF (1.980, 8.100, 0.600)، نرمال +y، DN250 PN6 (OD 375، PCD 335، 12 × M16).** E4 باید spool و زانوی خود را جابه‌جا کند و bellows بگذارد؛ تعارض موقعیت C1/C2 بین E2 و E4 (بخش ۵) باید پیش از قطعی‌شدن H1 حل شود. |
| روغن و گلیکول (E5) | 1.29 L/min روغن در 2.5 barg، 0.67 kW گرما؛ گلیکول 8 L/min، 0.84 kW، Δp 20 kPa |
| برق (B3) | E_LL 358 V، 1.0 kHz، 49 A، L_s 322 µH، J 6.47e-4، N2-B با 2 ppr |
| containment و عایق (E5) | blisk در x 199–222 با 8.6 kJ در 72k؛ پوستهٔ collector 610 °C |

---

## ۱۴. مدل CAD و بررسی‌ها

- **اجزا:** ماژول interduct+NGV (E3-101)، shroud + دیوارهٔ غربی دیفیوزر (102)، blisk (103)، مهره (104)، stud (105)، heat-dam sleeve (106)، heat shield (107)، بدنهٔ collector (110)، درپوش غربی درام (111)، مخروط مانع حرارتی (112)، عایق (113)، شفت (201)، آهنربا (202)، غلاف CF (203)، رینگ‌های انتهایی (204)، B1 و B2 (205/206)، کارتریج‌های SFD (207/208)، فنر (209)، مهرهٔ قفل (210)، چرخ N2 (211)، هوزینگ B1 (301)، هوزینگ و ژاکت PMG (302)، هستهٔ استاتور (303)، سیم‌پیچ (304)، هوزینگ B2 (305)، درپوش انتهایی (306)، جعبه ترمینال (307)، پایه‌ها (401/402)، سنسورها (501–512)، دمنده (701).
- **اجرای نهایی CAD** (۲۰۲۶-۱۰-۲۱، پس از اعمال فلنج E2): ۴۴ قطعه همه `valid`، هر کدام یک STEP؛ `E3_assembly.step` (ENG)، `E3_assembly_ROOF.step`، `E3_assembly.FCStd`؛ خروجی بدون خطا (`E3_build.log`).
- **تداخل با هستهٔ GG** (`cad_out/v13A/asm_parts`، Shape.common): **Turbine، TurbineNut، NGV، Shaft، ShaftTunnel، Casing: بدون تداخل (0 mm³).** هم‌پوشانی فقط با قطعات جت قدیمی که E2/E3 جایگزینشان می‌کنند: Exhaust قدیمی با E3-101 (10.5 cm³، بیشترش رینگ فلنج جدید x 116–124) و با TCهای ورودی (0.9 mm³)، EGT_Probe با E3-101 (0.12 cm³)، Fasteners فلنج عقب قدیمی با رینگ فلنج E3-101 (0.10 cm³ — پیچ‌های قدیمی حذف می‌شوند و پیچ‌های E2 جایشان را می‌گیرند).
- **داخلی E3:** ۷ هم‌پوشانی > 1 mm³، همه عمدی (جوش درام/درپوش 1.9 cm³، درام/پایهٔ جلو 3.0 cm³، ژاکت/هوزینگ B2 و ژاکت/پایهٔ عقب و نشیمن سنسورها)؛ **هیچ تداخل غیرمنتظره‌ای نیست.**
- **لقی‌های کارکردی (CAD، mm):** نوک blisk / shroud **0.28**؛ رینگ blisk / لبهٔ رینگ داخلی NGV 0.50؛ رینگ / زنگ هاب 0.52؛ دندانه‌های labyrinth / هوزینگ B1 0.15؛ غلاف CF / بور استاتور 1.50؛ شفت / آب‌بند جلوی PMG 0.15؛ شفت / آب‌بند B2 0.15؛ هدف N2 / سنسور 4.0 (محوری؛ گپ کاری 1.0 شعاعی)؛ blisk / heat shield 0.86؛ مهرهٔ FPT / دیوارهٔ پشتی NGV 1.70؛ **بولت ثابت interduct تا مهرهٔ GG 12.0، تا توربین v13A 1.45 (تا TE هاب E1 در x 118.3: 1.0)، تا شفت GG 13.8**؛ بور slip تا shroud نازل GG 0.25 شعاعی.
- **روتور از CAD:** جرم 2.234 kg، **J = 6.466×10⁻⁴ kg·m²** (با حلقه‌های داخلی یاتاقان)؛ y_cg بلیسک −0.018 mm (عدم تقارن مش لافت؛ بالانس G1 آن را می‌پوشاند).
- جرم E3 (مدل‌ها + اقلام فهرست) **59.3 kg** (مدل‌ها 54.0 + اقلام 5.3). سنگین‌ترین: درام 19.2 kg، درپوش غربی 7.8، پایه‌ها 7.9، PMG (ژاکت+استاتور+سیم‌پیچ) 6.7، ماژول interduct+NGV 2.6.
- **برش نیم‌مقطع:** `E3_section.png` (z = 0؛ بالا: کل E3 با توربین/مهره/NGV/شفت GG به رنگ خاکستری؛ پایین: جزئیات خروج GG → interduct → NGV → blisk → دیفیوزر، heat shield، labyrinth، حلقهٔ buffer، کارتریج B1)؛ داده‌ها در `E3_section_xy.json`.

---

## ۱۵. ساخت و کنترل کیفیت (خلاصه)
| قطعه | روش |
|---|---|
| blisk | فورج IN718 → خشن‌تراشی → HT → 5-axis نهایی → FPI، CMM → spin 78k → بالانس G1 |
| ماژول interduct+NGV، هوزینگ B1 و B2 | SLM (IN718: iDesign3D؛ 316L: 3dfast) → تنش‌زدایی و HT → ماشین‌کاری نشیمن‌ها → تست نشتی (هوزینگ‌ها با روغن 6 bar) |
| ژاکت PMG | SLM AlSi10Mg (3dfast) → T6 → بور برای shrink fit → تست فشار گلیکول |
| شفت | تراش CNC → Q+T → سنگ‌زنی سیلندری h5، لنگی ≤ 3 µm |
| collector | ورق 1.4828 با ربات (برش و جوش) → تنش‌زدایی → تست نشتی 0.3 bar |
| مونتاژ روتور | آهنربا با چسب دمابالا → پرس یا shrink غلاف → مغناطیس‌کردن → spin گرم 78k → بالانس |

---

## ۱۶. فرض‌ها
1. مدل افت Soderberg (سبک پروژه)؛ η دیفیوزر محوری-شعاعی 0.60؛ K plenum 0.5؛ K_tip 1.5.
2. دماهای دیسک: سوراخ 500 °C و رینگ 600 °C (FEA حرارتی لازم است). خواص IN718 از کمینه‌های AMS 5662؛ منحنی LMP عمومی.
3. سفتی یاتاقان 30 N/µm؛ O-ring 2 N/µm (باید اندازه‌گیری شود)؛ لزجت روغن 7 cSt.
4. PMG: تحلیلی؛ تلفات گردابی روتور 40 W و build factor آهن 1.5 برآوردی‌اند.
5. ضریب‌های حرارتی (تماس Hirth 3000 W/m²K، جت روغن 3000 W/m²K) برآوردی‌اند.
6. پایه‌ها: سطح ریل اسکید z = −400 (ROOF 0.200).
7. هندسهٔ نهایی E1: TE در x 118.3 با هاب r 19.0. در صورت تغییر، لبهٔ interduct جابه‌جا می‌شود (پارامتر `X['id0']`).

## ۱۷. موارد باز (برای هماهنگی و فاز بعد)
1. **E2:** فلنج E2/E3 طبق `e2_design.json` در E3 اعمال شد (x 116، OD 176، PCD 160، 16 × M8، spigot Ø120 × 3، piston ring در E2). E2 باید `E2_interfaces.json` را منتشر کند و فاز زاویه‌ای پیچ‌ها (E3: 11.25°)، نوع گسکت و عمق recess را تأیید کند؛ درگاه bleed خروجی کمپرسور برای buffer air (1.6 g/s) هنوز در E2 نیست.
2. **E4:** جابه‌جایی H1 به (300, 250, 0) در ENG و افزودن bellows.
2b. **E2/E4:** تعارض موقعیت C1/C2 (E2: C1 در z −90، C2 در z +72؛ E4: C1 در z +137.5، C2 در z −167.5). اگر C2 در z مثبت بماند، spool آن ~14 mm با فلنج H1 هم‌پوشانی دارد → یا C2 طبق E4 پایین بماند یا H1 به x ≈ 336 برود.
3. **E1/سیکل:** کمبود 0.94 % P03 → توان شفت −3 %. با η_t هدف 0.82، توان به 25.6 kW برمی‌گردد.
4. **برق:** J = 6.47e-4، L_s ≈ 322 µH، E_LL 358 V؛ تکرار `electrical_sizing.py` §1–§3.
5. CFD (OpenFOAM) برای interduct، طبقه و دیفیوزر/collector؛ FEA مودال و حرارتی blisk (CalculiX)؛ FEA الکترومغناطیسی PMG.
6. اندازه‌گیری سفتی و میرایی O-ring و SFD؛ مدل Timoshenko + انعطاف Hirth.
7. دسترسی به چالهٔ spin (78k، گرم 150 °C) در ایران، یا خدمات خارجی (Schenck RoTec).
8. محدودیت دمای IN718 در نوک (656 °C) در حالت پیک: life counter.
9. اتصال‌ها: محاسبهٔ VDI 2230 برای stud FPT و پیچ‌های داغ.
10. مونتاژ: ماژول داغ (interduct + NGV + shroud + درپوش) از غرب داخل درام می‌رود؛ کارتریج سرد (PMG + یاتاقان‌ها + روتور) از شرق از راه مخروط.
