ahmadreza221/aurora-cchp/docs/electrical/02_io_list.md

# GR180-CCHP — فهرست ورودی/خروجی (I/O list)

تاریخ: ۲۰۲۶-۱۰-۲۱ · **فایل تولیدشده** از `docs/electrical/calc/io_list.py` (منبع واحد). نسخهٔ CSV: [`02_io_list.csv`](02_io_list.csv). معماری و بردها: [`00_electrical_control_architecture.md`](00_electrical_control_architecture.md)؛ آستانه‌های trip: [`03_control_philosophy.md`](03_control_philosophy.md)؛ کابل‌ها: [`05_cable_schedule.md`](05_cable_schedule.md).

**قواعد عمومی**

- همهٔ ترموکوپل‌ها **ungrounded** هستند (جلوگیری از حلقهٔ زمین با AFE غیرایزولهٔ STM32F373)؛ اتصال TC به مس فقط روی ترمینال‌های ایزوترمال B2، کنار CJC.
- سیگنال‌های 4–20 mA از B2 تغذیهٔ حلقه می‌گیرند (24 V محدود‌شده با PTC + TVS)؛ مقاومت شانت 50 Ω دقیق 0.1 %.
- تجهیزات داخل ناحیهٔ گاز در صورت طبقه‌بندی Zone 2 (IEC 60079-10-1) باید **Ex ec / Ex nA** یا ATEX Cat 3 باشند؛ هدف طراحی تهویه، ناحیهٔ «NE» است.
- «role»: C کنترل، P حفاظت (ارجاع به جدول trip)، M پایش/life counter.
- مکان: `R-ENG` = بام: ناحیهٔ موتور (داغ)؛ `R-GAS` = بام: ناحیهٔ گاز؛ `R-AIR` = بام: ورودی هوا؛ `R-CHP` = بام: ناحیهٔ آب/CHP؛ `R-ELC` = بام: تابلوی RP-1 روی اسکید؛ `R-ROOF` = بام: بیرون اسکید؛ `ER` = داخل: اتاق برق و باتری؛ `HALL` = داخل: سالن / تابلوی شرکت.

## A. سرعت روتورها و ارتعاش

| Tag | شرح | مکان | نوع سیگنال | رنج | دقت | نرخ نمونه | کانکتور | برد / کانال | نقش | یادداشت |
|---|---|---|---|---|---|---|---|---|---|---|
| `SE-001A` | N1-A: دور هستهٔ GR180 — Hall Melexis US5881 (جایگزین هم‌پایهٔ A1120 در v11) روی intake، آهنربای nose cone | R-ENG | پالس 1 ppr، open-collector 24 V → line driver RS-422 روی B2 | 0–2.0 kHz (0–120k rpm) | ±0.01 % (timer capture) | هر پالس؛ گاورنر 1 kHz | M8 3-pin → B2؛ RS-422 روی W102a | **B2** FI01 + RS422-OUT1 → B1 SPD-IN1 (H7 TIM + SMCU) | کنترل، حفاظت | گاورنر N1، trip N1 در ECU |
| `SE-001B` | N1-B: سنسور Hall دوم، ۱۸۰° از N1-A، تغذیه و کابل مستقل | R-ENG | پالس open-collector، تغذیهٔ 12 V از ناحیهٔ SMCU روی B1، pull-up در B1 (بدون الکترونیک فعال روی بام) | 0–2.0 kHz | ±0.01 % | هر پالس | M8 3-pin → کابل W102b | **B1** SPD-IN2 (SMCU اصلی + H7 مقایسه) | حفاظت | overspeed مستقل؛ اختلاف N1A/N1B > 2 % → trip |
| `SE-002A` | N2-A: دور FPT/PMG از فرکانس back-EMF (PLL در B3) | R-ELC | داخلی B3 → CAN-FD | 0–80k rpm | ±0.05 % | 10 kHz (B3)، 1 kHz روی CAN | — | **B3** internal | کنترل، حفاظت | حلقهٔ سرعت N2 در B3 |
| `SE-002B` | N2-B: سنسور مستقل دور FPT (Hall + آهنربا یا هدف ۲ دندانه روی انتهای سرد شفت PMG) | R-ENG | پالس open-collector 1–2 ppr، تغذیه از B1 (SMCU) | 0–2.6 kHz | ±0.01 % | هر پالس | M8 3-pin → کابل W102b | **B1** SPD-IN3 (SMCU اصلی + H7) | حفاظت | overspeed N2 مستقل از B3؛ اختلاف N2A/N2B > 3 % → trip |
| `M-020` | استارتر BLDC هسته (1.5–2 kW، Hall داخلی) با کلاچ یک‌طرفه و پین در سوراخ عرضی Ø3 دماغه؛ چرخش ساعت‌گرد از دید ورودی (قطعی) | R-ENG | درایو BLDC سه‌فاز 48 V، 60 A پیک، 3× Hall (تأیید جهت) | 0–50k rpm (سمت هسته) | ±1 % سرعت | حلقهٔ سرعت 1 kHz | کابل قدرت 3×6 mm² + Hall M12 (≤ 2 m) | **B4** MD1 | کنترل، حفاظت | جهت معکوس قفل؛ cut-out ~45k؛ گشتاور فقط از پین (نه اصطکاک، رزوهٔ M6 LH) |
| `XV-021` | شیر برقی air-start پشتیبان روی درگاه M5 (اختیاری؛ فقط در MAINT با کپسول هوا) | R-ENG | DO 24 V، NC | باز/بسته | — | — | EN 175301-803 | **B4** DO11 | کنترل | فقط اگر کپسول هوای فشرده نصب شود |
| `VE-010` | ارتعاش هسته (فلنج یاتاقان جلو/intake، سمت سرد) | R-ENG | IEPE 100 mV/g، 4 mA constant current | ±50 g، 2 Hz–10 kHz | ±5 % | 25.6 kS/s (FFT، 1× = 1.9 kHz) | M12 2-pin یا کابل یکپارچه | **B2** VIB1 (ADC H7، منبع جریان LM317) | حفاظت، پایش | trip و روند (trend)؛ دمای نصب ≤ 120 °C |
| `VE-011` | ارتعاش FPT/PMG (هوزینگ یاتاقان سمت توربین) | R-ENG | IEPE 100 mV/g | ±50 g، 2 Hz–10 kHz | ±5 % | 25.6 kS/s | M12 2-pin | **B2** VIB2 | حفاظت، پایش | 1× FPT = 1.0–1.1 kHz |
| `VE-012` | ارتعاش PMG سمت آزاد / محوری (رزرو) | R-ENG | IEPE 100 mV/g | ±50 g | ±5 % | 25.6 kS/s | M12 2-pin | **B2** VIB3 | پایش | رزرو |

## B. دماهای مسیر گاز و یاتاقان

| Tag | شرح | مکان | نوع سیگنال | رنج | دقت | نرخ نمونه | کانکتور | برد / کانال | نقش | یادداشت |
|---|---|---|---|---|---|---|---|---|---|---|
| `TE-502` | T2: دمای خروجی کمپرسور | R-ENG | TC type K class 1 (IEC 60584-1)، MI Ø1.5–3، غلاف Inconel 600، ungrounded | 0–300 °C (طراحی ~165) | ±1.5 K | 10 Hz | هد TC + کابل KX شیلددار → ترمینال ایزوترمال B2 | **B2** TC01 (AFE STM32F373) | پایش | راندمان کمپرسور، سرج |
| `TE-503` | T2r: خروجی سمت سرد recuperator / ورودی محفظه | R-ENG | TC type K class 1 (IEC 60584-1)، MI Ø1.5–3، غلاف Inconel 600، ungrounded | 0–700 °C (طراحی ~565) | ±1.5 K / 0.4 % | 10 Hz | هد TC + KX | **B2** TC02 | پایش، حفاظت | ε recuperator؛ آلارم > 600 °C |
| `TE-504A` | ITT-1: دمای بین‌توربینی (خروجی توربین هسته، محل EGT راتن) | R-ENG | TC type K class 1 (IEC 60584-1)، MI Ø1.5–3، غلاف Inconel 600، ungrounded، Ø1.5 (پاسخ سریع) | 0–1000 °C (طراحی ~667 @ TIT 800) | ±1.5 K / 0.4 % | 10 Hz | هد TC + KX | **B2** TC03 | کنترل، حفاظت | رأی‌گیری 2oo3 → محدودکنندهٔ ITT و trip |
| `TE-504B` | ITT-2 (۱۲۰°) | R-ENG | TC type K class 1 (IEC 60584-1)، MI Ø1.5–3، غلاف Inconel 600، ungrounded، Ø1.5 | 0–1000 °C | ±1.5 K / 0.4 % | 10 Hz | هد TC + KX | **B2** TC04 | کنترل، حفاظت |  |
| `TE-504C` | ITT-3 (۲۴۰°) | R-ENG | TC type K class 1 (IEC 60584-1)، MI Ø1.5–3، غلاف Inconel 600، ungrounded، Ø1.5 | 0–1000 °C | ±1.5 K / 0.4 % | 10 Hz | هد TC + KX | **B2** TC05 | کنترل، حفاظت | تشخیص light-off و flame-out از نرخ تغییر ITT |
| `TE-505` | TOT: خروجی FPT = ورودی سمت داغ recuperator | R-ENG | TC type K class 1 (IEC 60584-1)، MI Ø1.5–3، غلاف Inconel 600، ungrounded | 0–900 °C (طراحی ~610) | ±1.5 K / 0.4 % | 10 Hz | هد TC + KX | **B2** TC06 | کنترل، حفاظت | محدودیت نرخ گرم‌شدن recuperator؛ trip > 660 °C |
| `TE-101` | دمای گاز اگزوز ورودی HX-1، بعد از recuperator (تگ مشترک با docs/hvac) | R-CHP | TC type K class 1 (IEC 60584-1)، MI Ø1.5–3، غلاف Inconel 600، ungrounded | 0–600 °C (طراحی ~262) | ±1.5 K | 2 Hz | هد TC + KX | **B2** TC07 | حفاظت، پایش | H 320 °C = عیب recuperator (ALM)؛ محاسبهٔ گرما در EMS و B6-R |
| `TE-512` | رزرو (خروجی گاز HX-1 = TE-102 و دودکش مشترک = TE-103 روی B6-R هستند) | R-ENG | TC type K class 1 (IEC 60584-1)، MI Ø1.5–3، غلاف Inconel 600، ungrounded | — | — | — | — | **B2** TC08 | پایش | رزرو |
| `TE-508` | دمای هوزینگ یاتاقان عقب هسته (سمت داغ) | R-ENG | TC type K class 1 (IEC 60584-1)، MI Ø1.5–3، غلاف Inconel 600، ungrounded | 0–300 °C | ±1.5 K | 2 Hz | هد TC + KX | **B2** TC09 | حفاظت، پایش | آلارم 140 / trip 160 °C (موقت، با تست تأیید شود) |
| `TE-509` | دمای هوای ناحیهٔ داغ جعبه (کنار محفظه) | R-ENG | TC type K class 1 (IEC 60584-1)، MI Ø1.5–3، غلاف Inconel 600، ungrounded | 0–250 °C | ±1.5 K | 1 Hz | هد TC + KX | **B2** TC10 | حفاظت، پایش | آلارم نشتی گاز داغ / عایق |
| `TE-510` | رزرو: interduct/ورودی NGV FPT یا مسیر bypass | R-ENG | TC type K class 1 (IEC 60584-1)، MI Ø1.5–3، غلاف Inconel 600، ungrounded | 0–1000 °C | ±1.5 K | 10 Hz | هد TC + KX | **B2** TC11 | پایش | رزرو |
| `TE-511` | رزرو | R-ENG | TC type K class 1 (IEC 60584-1)، MI Ø1.5–3، غلاف Inconel 600، ungrounded | — | — | — | — | **B2** TC12 | پایش | رزرو |

## C. فشارهای مسیر هوا و گاز داغ

| Tag | شرح | مکان | نوع سیگنال | رنج | دقت | نرخ نمونه | کانکتور | برد / کانال | نقش | یادداشت |
|---|---|---|---|---|---|---|---|---|---|---|
| `PT-521` | P2: فشار خروجی کمپرسور (sense line ≥ 300 mm برای خنک‌شدن) | R-ENG | 4–20 mA، 2-wire (loop 24 V از B2)، پاسخ < 1 ms | 0–6 bar abs (طراحی ~3.1) | ±0.25 % FS | 2 kS/s (تشخیص سرج) | M12 4-pin A | **B2** FAI1 (ADC H7) | کنترل، حفاظت | سرج، برنامهٔ شتاب W_f/P2 |
| `PT-522` | P3: بعد از سمت سرد recuperator / ورودی محفظه | R-ENG | 4–20 mA، 2-wire (loop 24 V از B2) | 0–6 bar abs (~2.9) | ±0.25 % FS | 50 Hz | M12 4-pin A | **B2** AI01 (ADC H7) | پایش | ΔP recuperator و محفظه |
| `PT-524` | P45: فشار interduct (بین توربین هسته و FPT) | R-ENG | 4–20 mA، 2-wire (loop 24 V از B2) | 0–4 bar abs | ±0.25 % FS | 50 Hz | M12 4-pin A | **B2** AI02 | پایش | نسبت فشار FPT |
| `PT-101` | فشار برگشتی اگزوز بعد از recuperator، قبل از diverter D-101 (تگ مشترک با docs/hvac) | R-CHP | 4–20 mA، 2-wire (loop 24 V از B2) | −0.5…+2.5 kPa g | ±0.5 % FS | 10 Hz | M12 4-pin A | **B2** AI03 | حفاظت، پایش | ALM 1.0 kPa؛ FSD 1.5 kPa |
| `PDT-526` | ΔP دهانهٔ bellmouth ورودی کمپرسور (دبی جرمی هوا) | R-AIR | 4–20 mA، 2-wire (loop 24 V از B2) | 0–25 mbar | ±0.25 % FS | 10 Hz | M12 4-pin A | **B2** AI04 | پایش | heat-rate و پایش عملکرد |

## D. قطار سوخت گاز (fuel gas train) و جرقه/شعله

| Tag | شرح | مکان | نوع سیگنال | رنج | دقت | نرخ نمونه | کانکتور | برد / کانال | نقش | یادداشت |
|---|---|---|---|---|---|---|---|---|---|---|
| `XV-610` | شیر قطع اصلی گاز روی رایزر (بیرون جعبه)، NC، 24 VDC، EN 161 کلاس A | R-ROOF | DO 24 V، 0.5 A (از خروجی ایمن SR1 → B4) | باز/بسته | — | — | EN 175301-803 A | **B4** DO01 (via SR1-O3) | کنترل، حفاظت | روی نشت گاز، آتش و ESD بسته می‌شود |
| `ZSC-610` | سوییچ وضعیت بسته XV-610 | R-ROOF | DI 24 V (NC = closed) | — | — | 10 Hz | M12 | **B2** DI01 | پایش |  |
| `PT-601` | فشار گاز تغذیه (قبل از SSVها) | R-GAS | 4–20 mA، 2-wire (loop 24 V از B2)، سازگار با متان | 0–10 barg (طراحی 4، حداقل 3.5) | ±0.25 % FS | 10 Hz | M12 4-pin A | **B2** AI05 | حفاظت، پایش | آلارم < 3.5، start inhibit < 3.2 |
| `PSL-602` | کلید فشار پایین گاز (EN 1854)، تنظیم 3.0 barg | R-GAS | کنتاکت NC دوکاناله | — | — | سخت‌افزاری | EN 175301-803 | **SR1** SI07 + B2 DI02 (کپی) | حفاظت | زنجیرهٔ ایمنی |
| `PSH-603` | کلید فشار بالای گاز، تنظیم 5.0 barg (خرابی رگولاتور) | R-GAS | کنتاکت NC | — | — | سخت‌افزاری | EN 175301-803 | **SR1** SI07 (سری با PSL) + B2 DI03 | حفاظت | زنجیرهٔ ایمنی |
| `PT-604` | فشار بعد از رگولاتور (ورودی شیر تناسبی) | R-GAS | 4–20 mA، 2-wire (loop 24 V از B2) | 0–6 barg (~3.0) | ±0.25 % FS | 10 Hz | M12 4-pin A | **B2** AI06 | پایش |  |
| `XV-611` | SSV1: شیر قطع ایمنی اول (EN 161 کلاس A، pmax ≥ 6 bar، 24 VDC، بسته‌شدن < 1 s) | R-GAS | DO 24 V از SR1 کانال A در سری با B4 | باز/بسته | — | — | EN 175301-803 A | **B4** DO02 (via SR1-O1) | کنترل، حفاظت | double block |
| `XV-612` | SSV2: شیر قطع ایمنی دوم (مثل SSV1) | R-GAS | DO 24 V از SR1 کانال B در سری با B4 | باز/بسته | — | — | EN 175301-803 A | **B4** DO03 (via SR1-O2) | کنترل، حفاظت | double block |
| `ZSC-611` | proof-of-closure SSV1 | R-GAS | DI 24 V | — | — | 10 Hz | M12 | **B2** DI04 + SR1 SI08 (پایش) | حفاظت | پیش‌شرط استارت |
| `ZSC-612` | proof-of-closure SSV2 | R-GAS | DI 24 V | — | — | 10 Hz | M12 | **B2** DI05 + SR1 SI08 | حفاظت |  |
| `XV-621` | شیر vent بین SSV1 و SSV2 (NO، energize-to-close) → دودکش امن | R-GAS | DO 24 V از SR1 | باز/بسته | — | — | EN 175301-803 A | **B4** DO04 (via SR1-O1) | حفاظت | double-block-and-bleed |
| `PT-613` | فشار فضای بین SSV1 و SSV2 (آزمون نشتی شیرها، valve proving) | R-GAS | 4–20 mA، 2-wire (loop 24 V از B2) | 0–6 barg | ±0.25 % FS | 10 Hz | M12 4-pin A | **B2** AI07 | حفاظت | proving قبل از هر استارت و بعد از توقف |
| `FCV-620` | شیر تناسبی سوخت (metering) — PWM جریان‌کنترل | R-GAS | PWM 24 V، 0–1 A، dither 200 Hz | 0–100 % | ±1 % جریان | حلقهٔ جریان 5 kHz | EN 175301-803 / M12 | **B4** PO01 | کنترل | حلقهٔ بیرونی با FT-606 |
| `PT-605` | فشار مانیفولد گاز (بعد از شیر تناسبی، قبل از انژکتورها) | R-GAS | 4–20 mA، 2-wire (loop 24 V از B2) | 0–6 barg (~2.5) | ±0.25 % FS | 1 kS/s | M12 4-pin A | **B2** FAI2 | کنترل، پایش | تخمین دبی، تشخیص گرفتگی انژکتور |
| `FT-606` | دبی‌سنج جرمی حرارتی گاز (thermal MFM) | R-GAS | 4–20 mA (+ Modbus RTU) | 0–20 Nm³/h (0–4 g/s) | ±1 % RD | 50 Hz | M12 5-pin | **B2** AI08 | کنترل، پایش | طراحی 11.2 Nm³/h؛ heat-rate و life |
| `TE-607` | دمای گاز | R-GAS | PT1000 class A، 3-wire | -10–+70 °C | ±0.3 K | 1 Hz | M12 4-pin | **B2** RTD02 (AFE STM32F373) | پایش | جبران چگالی |
| `FQ-608` | کنتور گاز شرکت گاز (پالس LF reed) | R-ROOF | پالس خشک | 0.1 m³/پالس | کلاس کنتور | هر پالس | کابل کنتور | **B2** FI04 | پایش | حسابداری انرژی |
| `IGN-630` | اگزایتر جرقه (24 VDC، ≥ 8 kV، 50–200 جرقه/ثانیه) | R-ENG | DO 24 V، 2 A (از SR1-O4) | روشن/خاموش | — | — | M12 / ترمینال | **B4** DO05 | کنترل | کابل HV سیلیکونی ≤ 1 m، دور از سیگنال |
| `BE-631` | سنسور شعلهٔ UV پشت پنجرهٔ کوارتز: Durag D-LX 100 UV (آلمان)؛ رلهٔ شعلهٔ failsafe + 4–20 mA شدت | R-ENG | رلهٔ شعله (NO، تغذیهٔ 24 V از ناحیهٔ SMCU) + 4–20 mA شدت | شعله دارد/ندارد؛ 0–100 % شدت | — | پاسخ ≤ 1 s (تنظیمی) | M12 5-pin → کابل W102b | **B1** SPD-IN4 (SMCU + H7، به‌عنوان DI) + B2 AI21 (شدت) | کنترل، حفاظت | flame-out در SMCU و ECU؛ روند شدت برای تشخیص کثیفی پنجره |

## E. سیستم روغن

| Tag | شرح | مکان | نوع سیگنال | رنج | دقت | نرخ نمونه | کانکتور | برد / کانال | نقش | یادداشت |
|---|---|---|---|---|---|---|---|---|---|---|
| `PT-701` | فشار روغن تغذیه (بعد از فیلتر، به جت‌ها) | R-ENG | 4–20 mA، 2-wire (loop 24 V از B2) | 0–10 barg | ±0.25 % FS | 50 Hz | M12 4-pin A | **B2** AI09 | کنترل، حفاظت | PID سرعت پمپ روغن؛ آلارم/trip (مقادیر با طراحی سیستم روغن) |
| `PSL-702` | کلید فشار پایین روغن (مکانیکی، مستقل از PT-701) | R-ENG | کنتاکت NC | تنظیم ~1.0 barg (TBD) | — | سخت‌افزاری | EN 175301-803 | **SR1** SI09 + B2 DI06 | حفاظت | زنجیرهٔ ایمنی (Stop cat 0) |
| `PDT-703` | ΔP فیلتر روغن 10 µm (ترانسمیتر) | R-ENG | 4–20 mA، 2-wire (loop 24 V از B2) | 0–2.5 bar | ±0.5 % FS | 1 Hz | M12 4-pin A | **B2** AI17 | حفاظت، پایش | ALM 1.0 bar؛ CSD 1.5 bar (bypass فیلتر ~1.7 bar = روغن فیلترنشده) |
| `TE-704` | دمای مخزن روغن | R-ENG | PT1000 class A، 3-wire | -10–150 °C | ±0.3 K | 1 Hz | M12 4-pin | **B2** RTD03 | کنترل، حفاظت | گرمکن و مجوز استارت |
| `TE-705` | دمای روغن برگشتی یاتاقان‌های هسته | R-ENG | PT1000 class A، 3-wire | 0–200 °C | ±0.5 K | 2 Hz | M12 4-pin | **B2** RTD04 | حفاظت، پایش |  |
| `TE-706` | دمای روغن برگشتی یاتاقان‌های FPT/PMG | R-ENG | PT1000 class A، 3-wire | 0–200 °C | ±0.5 K | 2 Hz | M12 4-pin | **B2** RTD05 | حفاظت، پایش |  |
| `TE-708` | دمای روغن تغذیه بعد از خنک‌کن روغن-گلیکول (ورودی جت‌های یاتاقان؛ شیر ترموستاتیک مکانیکی) | R-ENG | PT1000 class A، 3-wire | 0–150 °C | ±0.3 K | 2 Hz | M12 4-pin | **B2** RTD12 | کنترل، حفاظت | ALM 75 °C، FSD 90 °C؛ مجوز استارت ≥ 10 °C |
| `PT-709` | فشار محفظهٔ یاتاقان‌ها / مخزن روغن (breather با جداکنندهٔ مه روغن) | R-ENG | 4–20 mA، 2-wire (loop 24 V از B2) | −50…+500 mbar g | ±0.5 % FS | 10 Hz | M12 4-pin A | **B2** AI18 | حفاظت، پایش | ALM 100 mbar، CSD 200 mbar (نشت هوای کمپرسور از آب‌بندی یا گرفتگی breather) |
| `LT-707` | سطح پیوستهٔ مخزن روغن | R-ENG | 4–20 mA، 2-wire (loop 24 V از B2) | 0–100 % | ±1 % FS | 1 Hz | M12 4-pin A | **B2** AI19 | حفاظت، پایش | روند مصرف روغن؛ افت سریع → ALM نشتی؛ افزایش در کار → خرابی scavenge → CSD |
| `LSL-707` | سطح پایین مخزن روغن (float) | R-ENG | DI 24 V | — | — | 1 Hz | M12 | **B2** DI08 | حفاظت | start inhibit / آلارم |
| `M-710` | پمپ روغن فشار (gear pump + BLDC 48 V) | R-ENG | درایو BLDC سه‌فاز 48 V، 10 A + Hall | 0–4000 rpm | — | حلقهٔ سرعت 1 kHz | M12 power + Hall | **B4** MD2 | کنترل | pre-lube، post-lube از UPS 48 V |
| `M-711` | پمپ scavenge: برگشت روغن از محفظه‌های یاتاقان به مخزن (gear pump + BLDC 48 V) | R-ENG | درایو BLDC 48 V، 5 A + tach | 0–4000 rpm | — | حلقهٔ سرعت 1 kHz | M12 power + Hall | **B4** MD4 | کنترل، حفاظت | دبی scavenge ≥ 2× دبی تغذیه؛ خرابی → ALM و CSD (با LT-707) |
| `EH-712` | گرمکن مخزن روغن 200 W | R-ENG | DO 24 V → SSR | روشن/خاموش | — | — | ترمینال | **B4** DO06 | کنترل | استارت زمستان |
| `TE-720` | دمای یاتاقان FPT سمت توربین (PT1000 جاسازی‌شده) | R-ENG | PT1000 class A، 3-wire | 0–200 °C | ±0.5 K | 2 Hz | M12 4-pin | **B2** RTD06 | حفاظت، پایش | آلارم 120 / trip 135 °C (موقت) |
| `TE-721` | دمای یاتاقان PMG سمت آزاد | R-ENG | PT1000 class A، 3-wire | 0–200 °C | ±0.5 K | 2 Hz | M12 4-pin | **B2** RTD07 | حفاظت، پایش |  |

## F. مدار خنک‌کاری PMG و الکترونیک قدرت + سیم‌پیچ ژنراتور

| Tag | شرح | مکان | نوع سیگنال | رنج | دقت | نرخ نمونه | کانکتور | برد / کانال | نقش | یادداشت |
|---|---|---|---|---|---|---|---|---|---|---|
| `M-751` | پمپ مدار بستهٔ خنک‌کاری PMG + B3 + خنک‌کن روغن (گلیکول ~30 %) | R-ENG | BLDC 48 V، PWM + tach | 0–100 % | — | 10 Hz | M12 5-pin | **B4** MD3 | کنترل | بعد از توقف 15 min ادامه |
| `FT-752` | دبی مدار خنک‌کاری (توربینی/vortex) | R-ENG | پالس 24 V | 1–30 L/min | ±2 % | هر پالس | M12 | **B2** FI03 | حفاظت | دبی کم → آلارم 5 s، CSD 30 s |
| `TE-GLY` | دمای رفت گلیکول مدار کمکی به PMG، B3 و خنک‌کن روغن (خروجی HX-4 / DC-1؛ تگ مشترک با docs/hvac) | R-ENG | PT1000 class A، 3-wire | 0–120 °C | ±0.3 K | 1 Hz | M12 4-pin | **B2** RTD08 | حفاظت، پایش | طراحی 55 °C (DC-1، docs/hvac)؛ ALM 58 °C؛ FSD 65 °C؛ گرمای مدار ~3.1 kW |
| `DC-1-FAN` | فن EC dry cooler مدار گلیکول DC-1 (تگ مشترک با docs/hvac) | R-CHP | تغذیه از BOP-R + فرمان 0–10 V و tach از B4 | 0–100 % | — | 1 Hz | M12 5-pin | **B4** FAN3 | کنترل | PI روی TE-GLY؛ DC-1 اصلی؛ HX-4 فقط trim اختیاری (XV-305 NC روی B6-R) وقتی برج کار می‌کند |
| `XV-307` | شیر برقی آب پدهای پیش‌سرمایش adiabatic در DC-1 (آب نرم‌شده؛ تگ مشترک با docs/hvac)، NC | R-CHP | DO 24 V، NC، ≤ 0.5 A | باز/بسته | — | — | EN 175301-803 A | **B4** DO12 | کنترل | باز وقتی TT-OA > 35 °C یا TE-GLY > 42 °C؛ بسته در یخ‌زدگی (TT-OA < 3 °C) و ESD |
| `TE-754` | دمای برگشت مایع خنک‌کن (بعد از PMG) | R-ENG | PT1000 class A، 3-wire | 0–100 °C | ±0.3 K | 1 Hz | M12 4-pin | **B2** RTD09 | پایش | تلفات PMG |
| `PT-755` | فشار مدار خنک‌کاری (تشخیص نشتی) | R-ENG | 4–20 mA، 2-wire (loop 24 V از B2) | 0–4 barg | ±0.5 % FS | 2 Hz | M12 4-pin A | **B2** AI10 | حفاظت، پایش |  |
| `LSL-756` | سطح پایین منبع انبساط | R-ENG | DI 24 V | — | — | 1 Hz | M12 | **B2** DI09 | حفاظت |  |
| `TE-760` | دمای سیم‌پیچ PMG فاز U (PT1000 جاسازی، عایق تقویت‌شده) | R-ENG | PT1000 class A، 3-wire، ورودی ایزولهٔ B3 | 0–220 °C | ±1 K | 2 Hz | کانکتور ترمینال ژنراتور | **B3** RTD-W1 | حفاظت | کلاس H: آلارم 140، CSD 155 °C |
| `TE-761` | دمای سیم‌پیچ PMG فاز V | R-ENG | PT1000 class A، 3-wire | 0–220 °C | ±1 K | 2 Hz | — | **B3** RTD-W2 | حفاظت |  |
| `TE-762` | دمای سیم‌پیچ PMG فاز W | R-ENG | PT1000 class A، 3-wire | 0–220 °C | ±1 K | 2 Hz | — | **B3** RTD-W3 | حفاظت |  |

## G. جعبه (enclosure)، ایمنی، نشت گاز، آتش، درها

| Tag | شرح | مکان | نوع سیگنال | رنج | دقت | نرخ نمونه | کانکتور | برد / کانال | نقش | یادداشت |
|---|---|---|---|---|---|---|---|---|---|---|
| `ESD-R` | E-stop روی بام: در جلوی جعبه + کنار تابلوی BOP-R، دو شستی سری (تگ مشترک با docs/hvac) | R-ELC | 2× NC دوکاناله | — | — | سخت‌افزاری | M12 8-pin | **SR1** SI01 + B2 DI10 (وضعیت) | حفاظت | Stop cat 0 |
| `ESD-E` | E-stop اتاق برق | ER | 2× NC دوکاناله | — | — | سخت‌افزاری | ترمینال | **SR1** SI02 (کابل W103) + B1 DI01 | حفاظت | Stop cat 0 |
| `ESD-H` | E-stop سالن/دفتر (اختیاری) | HALL | 2× NC | — | — | سخت‌افزاری | ترمینال | **SR1** SI03 (سری با SI02) | حفاظت |  |
| `ZS-811` | کلید درِ چپ جعبه (کدشدهٔ مغناطیسی، 2 کانال) | R-ENG | 2× OSSD/NC | — | — | سخت‌افزاری | M12 8-pin | **SR1** SI04 + B2 DI11 | حفاظت | Stop cat 1، تأخیر 3 s |
| `ZS-812` | کلید درِ راست جعبه | R-ENG | 2× OSSD/NC | — | — | سخت‌افزاری | M12 8-pin | **SR1** SI05 + B2 DI12 | حفاظت | Stop cat 1 |
| `ZS-813` | کلید سقف برداشتنی / دریچهٔ سرویس | R-ENG | 2× OSSD/NC | — | — | سخت‌افزاری | M12 8-pin | **SR1** SI06 + B2 DI13 | حفاظت | Stop cat 1 |
| `ZS-814` | درِ تابلوی برق RP-1 (قفل کلیدی، فقط آلارم) | R-ELC | DI 24 V | — | — | 1 Hz | M12 | **B2** DI14 | پایش | بدون trip؛ ثبت دسترسی |
| `AT-821` | آشکارساز متان NDIR — ناحیهٔ قطار گاز (بالا) | R-GAS | 4–20 mA + رله 10 % و 20 % LEL | 0–100 % LEL | ±3 % LEL | 2 Hz | M20 گلند / M12 | **B2** AI11 + DI15 (10 %) + SR1 SI10 (20 %) | حفاظت | 10 % → آلارم + تهویه max؛ 20 % → ESD + XV-610 |
| `AT-822` | آشکارساز متان NDIR — سقف ناحیهٔ موتور | R-ENG | 4–20 mA + رله 10/20 % | 0–100 % LEL | ±3 % LEL | 2 Hz | M20 / M12 | **B2** AI12 + DI16 + SR1 SI10 | حفاظت |  |
| `PDSL-831` | اثبات تهویهٔ جعبه (ΔP switch) | R-ENG | کنتاکت NC | تنظیم 50 Pa | — | سخت‌افزاری | M12 | **SR1** SI11 (تأخیر 10 s) + B2 DI17 | حفاظت | purge جعبه قبل از استارت |
| `M-832` | فن تهویهٔ جعبه 1 (EC 48 V) | R-ENG | تغذیهٔ 48 V سوییچ‌شده + 0–10 V + tach | 0–100 % | — | 1 Hz | M12 5-pin | **B4** FAN1 | کنترل | Ex ec در صورت طبقه‌بندی Zone 2 |
| `M-833` | فن تهویهٔ جعبه 2 (افزونه) | R-ENG | مثل M-832 | 0–100 % | — | 1 Hz | M12 5-pin | **B4** FAN2 | کنترل | N+1 |
| `TE-834` | دمای هوای جعبه (ناحیهٔ موتور) | R-ENG | PT1000 class A، 3-wire | 0–120 °C | ±0.5 K | 1 Hz | M12 4-pin | **B2** RTD10 | حفاظت، پایش | آلارم 60، CSD 70 °C |
| `TE-835` | دمای هوای تابلوی RP-1 | R-ELC | سنسور روی برد B2 | 0–85 °C | ±1 K | 1 Hz | — | **B2** internal | حفاظت، پایش | آلارم 50 °C |
| `TSH-836` | آشکارساز حرارتی آتش (ثابت 90 °C + rate-of-rise) | R-ENG | کنتاکت NC | — | — | سخت‌افزاری | ترمینال | **SR1** SI12 + B2 DI18 | حفاظت | ESD + بستن XV-610 |
| `XA-840` | چراغ وضعیت سه‌رنگ + آژیر روی جعبه | R-ELC | DO 24 V ×4 | — | — | — | M12 | **B4** DO07–DO10 | پایش |  |
| `HS-841` | کلید سلکتور کلیدی OFF / LOCAL / REMOTE / MAINT | R-ELC | DI 24 V ×2 (کدشده) | — | — | 10 Hz | ترمینال | **B2** DI19–DI20 | کنترل | استارت از راه دور فقط در REMOTE |
| `HS-842` | شستی reset ایمنی (محلی، روی بام) | R-ELC | NO | — | — | سخت‌افزاری | ترمینال | **SR1** RESET + B2 DI21 | حفاظت | reset تریپ‌های ایمنی فقط محلی |
| `XS-850` | B3 HEALTHY (سخت‌افزاری، dynamic) | R-ELC | خروجی رله/OSSD از B3 | — | — | سخت‌افزاری | ترمینال | **SR1** SI13 + B1 DI02 | حفاظت | افت → B3b ترمز + ESD |
| `XS-851` | SMCU PERMIT کانال A و B (پالسی، از B1) | ER | 2× خروجی dynamic → رله force-guided | — | — | سخت‌افزاری | کابل W103 | **SR1** SI14 | حفاظت | watchdog سخت‌افزاری |
| `XS-852` | ECU RUN PERMIT (H7 از طریق watchdog خارجی STWD100) | ER | خروجی رله | — | — | سخت‌افزاری | کابل W103 | **SR1** SI15 | حفاظت |  |
| `XS-853` | بازخورد وضعیت SR1 (خروجی‌های ایمن روشن/خاموش، خطا) | R-ELC | DO SR1 → DI | — | — | 100 Hz | کابل W103 | **B1** DI03–DI04 (H7 و SMCU) | حفاظت | تست دوره‌ای زنجیره |
| `TSH-860` | کلید حرارتی مقاومت ترمز (NC، 200 °C) | R-ROOF | کنتاکت NC | — | — | سخت‌افزاری | ترمینال | **B3** DI-R1 (+ مدل حرارتی) | حفاظت | آلارم → CSD |

## H. ورودی هوا و محیط

| Tag | شرح | مکان | نوع سیگنال | رنج | دقت | نرخ نمونه | کانکتور | برد / کانال | نقش | یادداشت |
|---|---|---|---|---|---|---|---|---|---|---|
| `TE-501` | T1: دمای هوای ورودی کمپرسور (پایین‌دست کویل CC-1، کنار bellmouth) | R-AIR | PT1000 class A، 3-wire | -20–+60 °C (طراحی 15) | ±0.3 K | 2 Hz | M12 4-pin | **B2** RTD01 | کنترل، پایش | دور اصلاح‌شده و P_max؛ جدا از TE-221 کنترل کویل (B6-R) |
| `PDT-222` | ΔP فیلترهای ورودی G4 و F8، دو کانال (تگ مشترک با docs/hvac) | R-AIR | 4–20 mA، 2-wire (loop 24 V از B2) | 0–500 Pa ×2 | ±1 % FS | 1 Hz | M12 4-pin A | **B2** AI13–AI14 | حفاظت، پایش | هر طبقه: ALM طبق docs/hvac؛ مجموع > 400 Pa → DRT، > 480 Pa → CSD |
| `MT-501` | رطوبت نسبی هوای ورودی کمپرسور بعد از کویل و قطره‌گیر (ترانسمیتر T/RH) | R-AIR | 4–20 mA، 2-wire (loop 24 V از B2) | 0–100 % RH | ±2 % RH | 1 Hz | M12 4-pin A | **B2** AI20 | کنترل، پایش | EMS: بار نهان کویل و نقطهٔ شبنم؛ RH > 98 % پایدار → ALM حمل قطره |
| `PDT-223` | ΔP سمت هوای کویل CC-1 و قطره‌گیر (تگ مشترک با docs/hvac) | R-AIR | 4–20 mA، 2-wire (loop 24 V از B2) | 0–500 Pa | ±1 % FS | 1 Hz | M12 4-pin A | **B2** AI15 | حفاظت، پایش | H 300 Pa → ALM؛ EMS: افت توان |
| `TE-221` | دمای هوای بعد از کویل CC-1 — کنترل TV-221 (HVAC؛ setpoint از EMS) | R-AIR | RTD روی B6-R → Modbus TCP | -10–+70 °C | ±0.3 K | 1 Hz | — | **B6-R** via Modbus TCP | پایش | T1 اصلی برای ECU همان TE-501 روی B2 است |
| `TE-104` | دمای هوای ورودی پشت لوور، قبل از کویل (تشخیص بازچرخش اگزوز؛ docs/hvac) | R-AIR | RTD روی B6-R → Modbus TCP | -10–+70 °C | ±0.3 K | 1 Hz | — | **B6-R** via Modbus TCP | پایش | TE-104 − TT-OA > 3 K → ALM بازچرخش؛ بار کویل در EMS |
| `TT-OA` | دمای هوای بیرون (radiation shield؛ docs/hvac) | R-ROOF | 4–20 mA روی B6-R → Modbus TCP | -20–+60 °C | ±0.3 K | 0.1 Hz | — | **B6-R** via Modbus TCP | کنترل، پایش | EMS: P_max(T)، نقطهٔ سربه‌سر کویل؛ HVAC: changeover فصلی |
| `MT-OA` | رطوبت نسبی هوای بیرون (docs/hvac) | R-ROOF | 4–20 mA روی B6-R → Modbus TCP | 0–100 % RH | ±2 % RH | 0.1 Hz | — | **B6-R** via Modbus TCP | کنترل، پایش | wet-bulb → ظرفیت چیلر و برج در EMS |

## I. اگزوز، بازیافت گرما و رابط HVAC/BOP (تگ‌ها و منطق طبق docs/hvac)

| Tag | شرح | مکان | نوع سیگنال | رنج | دقت | نرخ نمونه | کانکتور | برد / کانال | نقش | یادداشت |
|---|---|---|---|---|---|---|---|---|---|---|
| `ZC-101` | فرمان diverter D-101 (دودکش ↔ HX-1) — مالک ECU؛ موقعیت درخواستی از B6-R (PI روی TE-111) روی Modbus TCP | R-CHP | AO 0–10 V (اکچویتور 24 VAC spring-return، تغذیه از K-EX) | 0–100 % | ±2 % | 1 Hz | M12 5-pin | **B4** AO01 | کنترل | قطع Modbus > 5 s → دودکش؛ purge 50 %؛ light-off فقط در bypass |
| `ZT-101` | فیدبک موقعیت D-101 | R-CHP | AI 2–10 V | 0–100 % | ±2 % | 1 Hz | M12 | **B2** AI16 | حفاظت | اختلاف > 10 % برای 30 s → ALM |
| `ZSO-101` | D-101 کاملاً در مسیر دودکش (bypass) — کنتاکت ۱ به B2، کنتاکت ۲ به SR1 | R-CHP | DI 24 V + کنتاکت ایمن | — | — | 10 Hz | M12 | **B2** DI22 + SR1 SI16 | حفاظت | مجوز light-off؛ با ZSH-101: «هر دو مسیر بسته» → FSD |
| `ZSH-101` | D-101 کاملاً در مسیر HX-1 (روی B6-R، docs/hvac) | R-CHP | DI روی B6-R → Modbus TCP | — | — | 1 Hz | — | **B6-R** via Modbus TCP | حفاظت | ZSO-101 = 0 و ZSH-101 = 0 به‌مدت 30 s → ALM |
| `K-EX` | رلهٔ ایمنی تغذیهٔ 24 VAC اکچویتور D-101 (خروجی SR1-O6، گروه D) — افتادن = D-101 با فنر به دودکش | R-CHP | خروجی ایمن SR1 → کنتاکتور force-guided | — | — | سخت‌افزاری | ترمینال BOP-R / W116 | **SR1** O6 | حفاظت | قطع با TSHH-111، PSH-111، FSL-111 (10 s)، E-stop و هر trip موتور؛ گروه D موتور را متوقف نمی‌کند |
| `TSHH-111` | ترموستات حد بالای آب داغ 98 °C، reset دستی (docs/hvac) | R-CHP | کنتاکت NC (کنتاکت دوم: وضعیت به B6-R) | 98 °C | — | سخت‌افزاری | ترمینال BOP-R / W116 | **SR1** SI17 | حفاظت | گروه D → O6 (K-EX)؛ فقط بازیافت گرما قطع می‌شود |
| `PSH-111` | سوییچ فشار بالای مدار آب داغ 5.0 bar (docs/hvac) | R-CHP | کنتاکت NC | 5.0 bar | — | سخت‌افزاری | ترمینال BOP-R / W116 | **SR1** SI17 (سری با TSHH-111) | حفاظت | قبل از PSV 5.5 bar |
| `FSL-111` | فلوسوییچ مدار اولیهٔ آب داغ (docs/hvac) | R-CHP | کنتاکت NC | — | — | سخت‌افزاری | ترمینال BOP-R / W116 | **SR1** SI18 (تأخیر 10 s) | حفاظت | بی‌دبی → D-101 به دودکش؛ reset خودکار با برگشت دبی |
| `ENG-RUN` | سیگنال سخت‌افزاری «موتور روشن / گرما موجود» به B6-R (docs/hvac) | ER | کنتاکت خشک رله | — | — | — | W103 → W116 | **B1** RO08 | کنترل | پشتیبان Modbus TCP برای حالت محلی امن B6-R |
| `BOP-BUS` | بردهای BOP: B6-R (BOP-R روی بام) و B6-E (اتاق برق) طبق docs/hvac — همهٔ نقاط HVAC، وضعیت چیلرها، heat meterها، کویل ورودی، DHW | R-CHP | Modbus TCP روی شبکهٔ OT (فیبر W104 به بام، سوییچ ER) | — | — | 1 Hz | Ethernet | **B1** ETH (Modbus TCP client) | کنترل، پایش | فهرست کامل در docs/hvac/io_list.csv؛ نقاط مصرفی EMS در گروه K |
| `EH-950` | گرمکن برقی منبع DHW (TK-DHW داخل ساختمان؛ dump مفید، 6 kW، SSR سه‌فاز) — قلم جدید، به docs/hvac اضافه شود | ER | DO 24 V → SSR (برق از AUX-DB) | 0–6 kW (PWM 1 s) | — | 1 Hz | ترمینال | **B1** RO10 | کنترل | فقط وقتی SOC > 90 % و مازاد؛ قطع در TE-132 (B6-E) > 75 °C؛ کنتور JT-905 |

## J. برق: یکسوساز B3، اینورتر، باتری، UPS، کنتورها، load shedding

| Tag | شرح | مکان | نوع سیگنال | رنج | دقت | نرخ نمونه | کانکتور | برد / کانال | نقش | یادداشت |
|---|---|---|---|---|---|---|---|---|---|---|
| `B3-VDC` | ولتاژ باس DC یکسوساز (تقسیم‌کنندهٔ مستقیم روی پتانسیل DC− + LEM DVL 1000 مستقل) | R-ELC | داخلی B3 | 0–1000 V | ±0.5 % | 40 kHz (کنترل) | — | **B3** internal | کنترل، حفاظت | چاپر 800–830 V، OVP سخت‌افزاری 900 V |
| `B3-IPH` | جریان سه فاز PMG (شانت Isabellenhütte + TSZ122 → ADC STM32G474؛ LEM HO پایش مستقل) | R-ELC | داخلی B3 | ±150 A | ±0.5 % | 40 kHz | — | **B3** internal | کنترل، حفاظت | desat + OCP سخت‌افزاری |
| `B3-IDC` | جریان DC خروجی | R-ELC | داخلی B3 | ±60 A | ±0.5 % | 10 kHz | — | **B3** internal | کنترل، پایش | انرژی تولیدی |
| `B3-RISO` | مقاومت عایقی باس DC نسبت به زمین (اندازه‌گیری با مقاومت سوییچ‌شده) | R-ELC | داخلی B3 | 0–10 MΩ | ±10 % | قبل از وصل + هر 10 s | — | **B3** internal | حفاظت | < 100 kΩ آلارم، < 50 kΩ مانع وصل |
| `B3-K` | کنتاکتورهای DC اصلی (+/−) و پیش‌شارژ — فرمان و بازخورد | R-ELC | داخلی B3 | — | — | — | — | **B3** internal | کنترل |  |
| `B3-CHOP` | چاپر مقاومت ترمز (duty، دمای مدل‌شده) | R-ELC | داخلی B3 | 0–100 % | — | 40 kHz | — | **B3** internal | کنترل، حفاظت |  |
| `B3B-ST` | ترمز مستقل PMG (B3b): وضعیت کنتاکتور NC و چاپر | R-ELC | DI از B3b | — | — | 100 Hz | ترمینال | **B3** DI-B1 | حفاظت | مستقل از کنترلر B3 |
| `INV-MB` | اینورتر هیبرید HI-1: P/Q/I هر فاز در درگاه‌های GRID و LOAD، توان ورودی DC (B3)، V/I/SOC باتری، وضعیت رلهٔ شبکه، حالت (grid/backup)، حدها و خطاها | ER | Modbus RTU (RS-485) یا Modbus TCP / SunSpec (طبق مدل) | — | — | 1 Hz (توان‌ها 4 Hz) | ترمینال / RJ45 | **B1** RS485-1 | کنترل، پایش | load following، zero-export، SOC، کنترل فازی (06 §۷) |
| `INV-DO` | فرمان remote ON/OFF اینورتر HI-1 (کنتاکت خشک / DRM0) | ER | رله | — | — | — | ترمینال | **B1** RO05 | کنترل |  |
| `INV-DI` | رلهٔ خطای اینورتر HI-1 | ER | DI 24 V | — | — | 10 Hz | ترمینال | **B1** DI05 | حفاظت | load rejection |
| `BMS-CAN` | BMS باتری اصلی HV LFP ۲۰ kWh: SOC، SOH، CVL/CCL/DCL، دمای سلول، آلارم‌ها (باس CAN بین BMS و HI-1) | ER | CAN 500 kbit/s (listen-only) یا از رجیسترهای HI-1 | — | — | 1 Hz | RJ45/ترمینال | **B1** CAN2 | پایش |  |
| `BMS-WAKE` | روشن‌کردن BMS باتری HV (کنتاکت خشک موازی کلید باتری) | ER | رله | — | — | — | ترمینال | **B1** RO06 | کنترل | black start |
| `UPS-DCOK` | DC-OK دو شارژر 48 V | ER | DI 24 V ×2 | — | — | 1 Hz | ترمینال | **B1** DI06–DI07 | پایش |  |
| `UPS-BMS` | BMS باتری 48 V (SOC، ولتاژ، دما) | ER | CAN/RS-485 | — | — | 1 Hz | RJ45 | **B1** CAN2 | حفاظت، پایش | < 46 V → CSD |
| `XS-IPR` | trip رلهٔ حفاظت رابط شبکه (Ziehl UFR1001E / Bender GridGuard) — v2 grid-tie | HALL | DI 24 V | — | — | 10 Hz | کابل W106 | **B1** DI23 | حفاظت، پایش | v2: قطع AC-IN و ثبت رویداد |
| `JT-901` | کنتور درگاه LOAD اینورتر = کل بار پشتیبانی‌شده (هر فاز: I/P/Q)، Janitza UMG 96-PA کلاس 0.5S | ER | Modbus RTU (بخش اختصاصی، 38.4 kbit/s) | 3~، CT 100/5 A | ±0.5 % | 4 Hz | ترمینال | **B1** RS485-3 | کنترل، حفاظت، پایش | کنترل فازی 06 §۷ (U_ph، SHED) |
| `JT-902` | کنتور انرژی AUX-DB (مصرف داخلی) | ER | Modbus RTU | — | ±1 % | 1 Hz | ترمینال | **B1** RS485-2 | پایش | برق خالص |
| `VFD-P1..Pn` | VFD پمپ ۳ kW شرکت (Danfoss/ABB، سه‌فاز 400 V، Modbus RTU): فرمان، سرعت، جریان، خطا | HALL | Modbus RTU | — | — | 1 Hz | ترمینال | **B1** RS485-2 | کنترل، پایش | استارت فقط با مجوز فازی EMS (06 §۷-۴) |
| `K-LS1..4` | کنتاکتورهای load shedding تابلوی شرکت (۴ گروه) | HALL | RO → رله واسط 24 VDC | — | — | — | کابل W109 | **B1** RO01–RO04 | کنترل |  |
| `ZS-LS1..4` | کنتاکت کمکی کنتاکتورهای load shedding | HALL | DI 24 V ×4 | — | — | 10 Hz | کابل W109 | **B1** DI08–DI11 | پایش |  |
| `ZS-ATS` | موقعیت ATS-1 (I = درگاه LOAD اینورتر، II = شبکهٔ مستقیم / bypass، 0) — Socomec ATyS | ER | DI 24 V ×2 | — | — | 1 Hz | ترمینال | **B1** DI12–DI13 | پایش | روی II = بار بدون پشتیبان نیروگاه؛ آلارم P2 |
| `XA-ATS` | خطا یا حالت دستی ATS-1 | ER | DI 24 V | — | — | 1 Hz | ترمینال | **B1** DI25 | پایش | P2 |
| `ZS-NPE` | وضعیت کنتاکتور پیوند N-PE سمت LOAD در حالت backup (فرمان از سیگنال island اینورتر) | ER | DI 24 V | — | — | 10 Hz | ترمینال | **B1** DI24 | حفاظت، پایش | در backup باید بسته و در اتصال به شبکه باز باشد؛ مغایرت → P1 (01 §۹) |
| `XS-SPD` | وضعیت SPDها (همه با کنتاکت سیگنال) | ER | DI 24 V | — | — | 0.1 Hz | ترمینال | **B1** DI14 (ER) / B2 DI23 (بام) | پایش |  |
| `SD-E` | آتش تأییدشدهٔ FZ2 اتاق برق/باتری — خروجی رلهٔ FCP (تگ مشترک با docs/hvac) | ER | کنتاکت NC پایش‌شده | — | — | سخت‌افزاری | ترمینال | **SR1** SI20 + B1 DI15 | حفاظت | گروه A: ESD + قطع گاز؛ B1: HI-1 خاموش، BMS باز، ATS → 0 (07 §۴) |
| `TT-ER` | دما و رطوبت اتاق برق | ER | Modbus RTU | 0–50 °C | ±0.5 K | 0.1 Hz | ترمینال | **B1** RS485-2 | پایش | باتری ≤ 30 °C |
| `XS-GRID` | حضور و سلامت شبکه (رلهٔ پایش ولتاژ و فرکانس سه‌فاز سمت برق شهر) | HALL | DI 24 V | — | — | 10 Hz | ترمینال | **B1** DI16 | پایش |  |
| `XA-BLD` | آلارم مشترک به ساختمان / نگهبانی | ER | رله | — | — | — | ترمینال | **B1** RO07 | پایش |  |

## K. مدیریت انرژی (EMS): کنتورهای فیدر، کنترل هر فاز، نقاط HVAC مصرفی EMS و رجیسترهای فرمان (06_energy_management.md)

| Tag | شرح | مکان | نوع سیگنال | رنج | دقت | نرخ نمونه | کانکتور | برد / کانال | نقش | یادداشت |
|---|---|---|---|---|---|---|---|---|---|---|
| `JT-903` | کنتور فیدر فن‌کویل‌های سالن و ERV (AUX-DB) | ER | Modbus RTU (RS-485) | 1~/3~، تا 10 A | کلاس 1 | 1 Hz | ترمینال | **B1** RS485-2 | کنترل، پایش | هزینهٔ برق سرمایش سالن |
| `JT-904` | کنتور فیدر کمکی‌های داخلی B6-E (FCU-E، AC-E، EF-E، RO-1، P-7، P-9) | ER | Modbus RTU | 1~، تا 16 A | کلاس 1 | 1 Hz | ترمینال | **B1** RS485-2 | کنترل، پایش | بارهای قابل تعویق |
| `JT-905` | کنتور فیدر گرمکن EH-950 | ER | Modbus RTU | 3~، تا 10 A | کلاس 1 | 1 Hz | ترمینال | **B1** RS485-2 | پایش | انرژی dump مفید |
| `JT-911..914` | کنتورهای سه‌فاز گروه‌های بار شرکت، هم‌راستای K-LS1..4، جریان هر فاز (Carlo Gavazzi EM24، CT split-core در تابلوی شرکت) | HALL | Modbus RTU | 3~، CT 63/5 A | کلاس 1 | 1 Hz | کابل W106 | **B1** RS485-2 | کنترل، پایش | تقاضای واقعی هر گروه؛ مبنای EMS و load shedding |
| `JT-920` | کنتور ورودی شبکهٔ شهری (نقطهٔ اتصال): import/export هر فاز — پایش zero-export و بعداً صادرات | HALL | Modbus RTU | 3~، CT 100/5 A | کلاس 0.5S | 1 Hz | کابل W106 | **B1** RS485-2 | کنترل، پایش | export > 0 به‌مدت 5 s → P2 و کاهش P_ref (مستقل از CT اینورتر) |
| `K-SP1..3` | رله‌های مجوز کمپرسور سه کولر دیواری 12,000 BTU (کنتاکتور 16 A در تغذیهٔ یونیت بیرونی؛ هر کولر روی یک فاز) | HALL | RO → کنتاکتور 24 VDC | — | — | — | کابل W109 | **B1** RO09، RO11، RO12 | کنترل | بی‌برق = باز؛ آزادسازی پلکانی پس از برگشت برق و حذف در backup (06 §۷) |
| `ZS-SP1..3` | کنتاکت کمکی K-SP1..3 (بسته بودن با فرمان «باز» = کلید bypass دستی فعال → P3) | HALL | DI 24 V ×3 | — | — | 10 Hz | کابل W109 | **B1** DI26–DI28 | پایش |  |
| `EM-HVAC` | کنتور تابلوی BOP-R (پمپ‌ها، VFDها، برج، چیلرها) — docs/hvac | R-CHP | روی B6-R → Modbus TCP | 3~ | کلاس 1 | 1 Hz | — | **B6-R** via Modbus TCP | کنترل، پایش | P_aux HVAC در EMS |
| `HM-1/2/4` | کنتورهای انرژی حرارتی: HM-1 گرمای ورودی چیلرها، HM-2 سرمایش ساختمان، HM-4 سرمایش کویل ورودی — docs/hvac | R-CHP | M-Bus روی B6-R → Modbus TCP | kW، m³/h، °C | کلاس 2 (EN 1434) | 0.1 Hz | — | **B6-R** via Modbus TCP | کنترل، پایش | Q_COIL، Q_HALL، ظرفیت چیلر |
| `TE-211..213` | دماهای آب سرد: بالای TK-1 (رفت)، پایین TK-1، برگشت مصرف‌کننده‌ها — docs/hvac | R-CHP | RTD روی B6-R → Modbus TCP | -10–+60 °C | ±0.3 K | 1 Hz | — | **B6-R** via Modbus TCP | پایش | کمبود آب سرد → اولویت کویل |
| `FT-211` | دبی ثانویهٔ آب سرد — docs/hvac | R-CHP | روی B6-R → Modbus TCP | m³/h | ±1 % | 1 Hz | — | **B6-R** via Modbus TCP | پایش |  |
| `TE-301/302، FT-301` | دمای رفت/برگشت و دبی آب خنک‌کن — docs/hvac | R-CHP | روی B6-R → Modbus TCP | 0–60 °C، m³/h | ±0.3 K | 1 Hz | — | **B6-R** via Modbus TCP | پایش | ظرفیت چیلر و حد تبلور (≥ 26 °C) |
| `VFD-HVAC` | VFD و ECMهای HVAC (P-5، P-6، فن برج): دور، توان، خطا — docs/hvac | R-CHP | Modbus RTU bus-1 روی B6-R → Modbus TCP | kW، % | — | 1 Hz | — | **B6-R** via Modbus TCP | پایش | سود هر گام merit order |
| `TE-H1` | دما و رطوبت مرجع سالن — docs/hvac | HALL | Modbus RTU bus-2 روی B6-R → Modbus TCP | 0–50 °C، 0–100 % | ±0.3 K، ±3 % | 0.1 Hz | — | **B6-R** via Modbus TCP | کنترل، پایش | گارد آسایش e_H |
| `FCU-1..4` | کنترلرهای فن‌کویل سالن (دما، setpoint، فن، شیر) — docs/hvac | HALL | Modbus RTU bus-2 روی B6-R → Modbus TCP | — | — | 0.1 Hz | — | **B6-R** via Modbus TCP | کنترل | FCU_SHED_MASK |
| `CH-STATE` | وضعیت چیلرها CH-1/2: RUN/ALM + OFF / STARTING / RUN / DILUTION / LOCKOUT و زمان باقی‌ماندهٔ حداقل کار/توقف | R-CHP | روی B6-R → Modbus TCP | — | — | 1 Hz | — | **B6-R** via Modbus TCP | کنترل، حفاظت | EMS فقط درخواست می‌دهد |
| `EMS-CMD` | رجیسترهای فرمان EMS به B6: EMS_MODE، CH_STAGE_MAX، T1_SP، Q_HALL_MAX_PCT، FCU_SHED_MASK، AUX_P_MAX_KW، DEFER_EN، CW_SP_OFFSET، PURGE_POS_REQ، START_GRANT، HEARTBEAT | ER | Modbus TCP (B1 client → B6-R/B6-E) | 06 §۴ | — | 1 Hz (heartbeat) | Ethernet | **B1** ETH | کنترل | قطع > 60 s → حالت محلی B6 |
| `EMS-STS` | رجیسترهای وضعیت از B6: REQ_GRANTED، Q_COIL/Q_HALL/Q_CH_AVAIL، P_HVAC، P_HVAC_PRED/Q_HALL_PRED/T1_ACHIEVABLE[m]، CHW_RESERVE_KWH، WB_OUT/WB_TOWER، HALL_CO2، COP_CH1/2، START_REQ، HVAC_FAULT | ER | Modbus TCP | 06 §۴ | — | 1 Hz | Ethernet | **B1** ETH | کنترل، پایش |  |

## L. اعلام و اطفای حریق: پنل FCP (EN 54-2/4 + EN 12094-1)، دتکتورها، رهاسازی، abort و اینترلاک‌ها (07_fire_protection.md)

| Tag | شرح | مکان | نوع سیگنال | رنج | دقت | نرخ نمونه | کانکتور | برد / کانال | نقش | یادداشت |
|---|---|---|---|---|---|---|---|---|---|---|
| `TSH-871` | FZ1 جعبهٔ موتور: دتکتور حرارتی EN 54-5 کلاس CS (ثابت + ROR)، آدرس‌پذیر | R-ENG | حلقهٔ آدرس‌پذیر FCP | — | — | — | کابل W120 (FE180) | **FCP** LOOP1 | حفاظت | یک knock؛ با TSH-872 یا BS-873 = تأیید |
| `TSH-872` | FZ1 جعبهٔ موتور: دتکتور حرارتی دوم (سمت قطار گاز) | R-ENG | حلقهٔ آدرس‌پذیر FCP | — | — | — | کابل W120 | **FCP** LOOP1 | حفاظت |  |
| `BS-873` | FZ1 جعبهٔ موتور: دتکتور شعلهٔ IR3 (EN 54-10 کلاس 1، کور به سطوح داغ) | R-ENG | حلقهٔ آدرس‌پذیر FCP (ماژول ورودی) | — | — | — | کابل W120 | **FCP** LOOP1 | حفاظت | دید به محفظهٔ احتراق و قطار گاز |
| `SD-881` | FZ2 اتاق برق: دتکتور دود نوری EN 54-7 (۱) | ER | حلقهٔ آدرس‌پذیر FCP | — | — | — | کابل W120 | **FCP** LOOP2 | حفاظت | double-knock با SD-882 |
| `SD-882` | FZ2 اتاق برق: دتکتور دود نوری EN 54-7 (۲) | ER | حلقهٔ آدرس‌پذیر FCP | — | — | — | کابل W120 | **FCP** LOOP2 | حفاظت |  |
| `SD-883` | FZ2 ناحیهٔ باتری: دتکتور دود نوری EN 54-7 | ER | حلقهٔ آدرس‌پذیر FCP | — | — | — | کابل W120 | **FCP** LOOP2 | حفاظت |  |
| `TSH-884` | FZ2 اتاق برق: دتکتور حرارتی EN 54-5 A1R | ER | حلقهٔ آدرس‌پذیر FCP | — | — | — | کابل W120 | **FCP** LOOP2 | حفاظت |  |
| `AT-885` | گاز خروجی باتری H₂ + CO (هشدار زودهنگام thermal runaway) — Dräger Polytron 8100 EC (H₂) + CO | ER | 4–20 mA + دو رله | 0–100 % LEL H₂؛ 0–500 ppm CO | ±5 % | 1 Hz | ترمینال | **B1** DI22 (رلهٔ A1) + FCP LOOP2 (رلهٔ A2) + B6-E AI (4–20 mA) | حفاظت، پایش | A1: توقف شارژ (HI-1)، تهویهٔ باتری حداکثر، P1؛ A2: پیش‌آلارم FZ2 |
| `SD-886` | FZ3 تابلوهای بام RP-1 و BOP-R: دتکتور دود داخل تابلو (فقط اعلام) | R-ELC | حلقهٔ آدرس‌پذیر FCP | — | — | — | کابل W120 | **FCP** LOOP1 | حفاظت، پایش | تأیید → CSD موتور (XS-873) |
| `HS-891` | شستی‌های اعلام دستی قرمز EN 54-11 (درِ ER، دسترسی بام، سالن) | ER | حلقهٔ آدرس‌پذیر FCP | — | — | — | کابل W120 | **FCP** LOOP1/LOOP2 | حفاظت | آلارم عمومی؛ رهاسازی نمی‌کند |
| `ZS-897` | درِ اتاق برق باز (FZ2) — مهار رهاسازی خودکار | ER | کنتاکت مغناطیسی → ورودی FCP | — | — | — | کابل W121 | **FCP** EXT2-IN | حفاظت | در باز: فقط رهاسازی دستی |
| `ZS-898` | درهای جعبهٔ موتور باز (FZ1، کنتاکت سیگنال ZS-811..814 سری) — مهار رهاسازی خودکار | R-ENG | کنتاکت → ورودی FCP | — | — | — | کابل W121 | **FCP** EXT1-IN | حفاظت | در باز: فقط رهاسازی دستی |
| `XV-497` | دمپر موتوری کانال EF-E اتاق برق (spring-close) + ZSC-497 — docs/hvac/08 (تگ HVAC) | ER | DO 24 VAC + DI روی B6-E؛ تغذیه از طریق XS-874 | — | — | 1 Hz | — | **B6-E** via Modbus TCP | حفاظت | FCP با XS-874 تغذیه را مستقیم قطع می‌کند |
| `TE-499` | دمای کابینت سیلندرهای FS-1 روی بام — docs/hvac/08 (تگ HVAC) | R-ROOF | PT1000 روی B6-R → Modbus TCP | 0–80 °C | ±0.5 K | 0.1 Hz | — | **B6-R** via Modbus TCP | پایش | ALM 50 °C (حد نگهداری FK-5-1-12) |
| `HS-892` | شستی رهاسازی دستی زرد FZ1 (بیرون جعبه، مسیر دسترسی بام) | R-ROOF | ورودی پایش‌شدهٔ ماژول اطفای FCP | — | — | — | کابل W121 (FE180) | **FCP** EXT1-IN | حفاظت | شروع شمارش معکوس 30 s |
| `HS-893` | شستی رهاسازی دستی زرد FZ2 (بیرون درِ اتاق برق) | ER | ورودی پایش‌شدهٔ ماژول اطفای FCP | — | — | — | کابل W121 | **FCP** EXT2-IN | حفاظت |  |
| `HS-894` | شستی abort / hold آبی FZ1 (نگه‌داشتنی) | R-ROOF | ورودی پایش‌شدهٔ ماژول اطفای FCP | — | — | — | کابل W121 | **FCP** EXT1-IN | حفاظت | تا وقتی فشرده است شمارش متوقف می‌ماند |
| `HS-895` | شستی abort / hold آبی FZ2 | ER | ورودی پایش‌شدهٔ ماژول اطفای FCP | — | — | — | کابل W121 | **FCP** EXT2-IN | حفاظت |  |
| `HS-896` | کلید کلیدی حالت رهاسازی هر ناحیه: AUTO+MANUAL / فقط MANUAL / BLOCKED | ER | ورودی FCP | — | — | — | ترمینال | **FCP** EXT-MODE | حفاظت | BLOCKED → XS-876 (P2) |
| `XY-888A` | سولنوئید رهاسازی FS-1A، FZ1 شات اصلی (24 VDC، پایش‌شده؛ سیلندر، لوله و نازل: docs/hvac/08) | R-ROOF | خروجی رهاسازی ماژول اطفای FCP (EN 12094-1) | — | — | — | کابل W121 | **FCP** EXT1-REL | حفاظت | پس از شمارش 30 s |
| `XY-888B` | سولنوئید رهاسازی FS-2، FZ2 اتاق برق و باتری | ER | خروجی رهاسازی ماژول اطفای FCP | — | — | — | کابل W121 | **FCP** EXT2-REL | حفاظت |  |
| `PS-889A` | کلید فشار تخلیهٔ عامل FZ1 (agent released) | R-ROOF | ورودی FCP | — | — | — | کابل W121 | **FCP** EXT1-IN | حفاظت | تابلوی «گاز تخلیه شد، وارد نشوید» |
| `PS-889B` | کلید فشار تخلیهٔ عامل FZ2 | ER | ورودی FCP | — | — | — | کابل W121 | **FCP** EXT2-IN | حفاظت |  |
| `PSL-890A` | افت فشار سیلندر FS-1A (supervisory) | R-ROOF | ورودی FCP | — | — | — | کابل W121 | **FCP** EXT1-IN | پایش | P2 |
| `PSL-890B` | افت فشار سیلندر FS-2 (supervisory) | ER | ورودی FCP | — | — | — | کابل W121 | **FCP** EXT2-IN | پایش | P2 |
| `ZSC-899A` | شیر lock-off دستی FZ1 بسته (نگهداری) | R-ROOF | ورودی FCP | — | — | — | کابل W121 | **FCP** EXT1-IN | پایش | BLOCKED → XS-876 |
| `ZSC-899B` | شیر lock-off دستی FZ2 بسته | ER | ورودی FCP | — | — | — | کابل W121 | **FCP** EXT2-IN | پایش |  |
| `XY-888C` | سولنوئید رهاسازی FS-1B، FZ1 شات رزرو (پیشنهاد HVAC، پذیرفته) | R-ROOF | خروجی رهاسازی ماژول اطفای FCP | — | — | — | کابل W121 | **FCP** EXT1-REL2 | حفاظت | دستی، یا خودکار در re-flash پس از 10 min |
| `PSL-890C` | افت فشار سیلندر FS-1B (supervisory؛ پیشنهاد HVAC، پذیرفته) | R-ROOF | ورودی FCP | — | — | — | کابل W121 | **FCP** EXT1-IN | پایش | P2 |
| `FD-837` | دمپرهای تهویهٔ جعبهٔ موتور (فشار-عمل، با فشار گاز اطفا بسته می‌شوند؛ بدون برق) — کلید وضعیت بسته | R-ENG | کنتاکت → DI 24 V | باز/بسته | — | 1 Hz | M12 | **B2** DI24 | پایش | تأیید بسته‌شدن پس از تخلیه |
| `XA-879` | آژیر و فلاشر EN 54-3/23 و تابلوهای «گاز در حال تخلیه / وارد نشوید» هر ناحیه | ER | خروجی‌های پایش‌شدهٔ FCP | — | — | — | کابل W120 | **FCP** NAC1–NAC4 | حفاظت | لحن جدا برای پیش‌آلارم و رهاسازی |
| `K-VS` | قطع تهویهٔ جعبه برای اطفا: تغذیهٔ 48 V فن‌های M-832/833 | R-ELC | خروجی ایمن SR1 → کنتاکتور | — | — | سخت‌افزاری | ترمینال RP-1 | **SR1** O7 | حفاظت | فقط SI19 (آتش FZ1) آن را می‌اندازد؛ دمپرهای جعبه فشار-عمل‌اند (ZSC-496) |
| `XS-871` | FCP: پیش‌آلارم (یک knock در هر ناحیه) | ER | کنتاکت رلهٔ FCP | — | — | 1 Hz | ترمینال | **B1** DI17 | پایش | P2؛ ثبت رویداد |
| `XS-872` | FCP: آتش تأییدشدهٔ FZ1 جعبهٔ موتور (double-knock یا دستی) = شروع شمارش رهاسازی | R-ENG | کنتاکت NC پایش‌شدهٔ FCP | — | — | سخت‌افزاری | کابل W121 | **SR1** SI19 + B1 DI18 | حفاظت | گروه A: ESD + XV-610 + O7 (فن‌ها)؛ ECU: پمپ روغن تا N1 < 20 %، بدون post-lube |
| `XS-873` | FCP: آتش تأییدشدهٔ FZ3 (تابلوهای بام) | R-ELC | کنتاکت رلهٔ FCP | — | — | 1 Hz | ترمینال | **B1** DI19 | حفاظت | CSD موتور، قطع فیدر BOP-R پس از توقف |
| `XS-874` | FCP: قطع تهویهٔ ER در FZ2 (سخت‌افزاری در مدار کنتاکتورهای EF-E، FCU-E، AC-E و تغذیهٔ XV-497) | ER | کنتاکت رلهٔ FCP | — | — | — | ترمینال | **FCP** REL3 | حفاظت | مستقل از B6-E؛ XV-497 با فنر بسته می‌شود |
| `XS-875` | FCP: عامل اطفا تخلیه شد (هر ناحیه) | ER | کنتاکت رلهٔ FCP | — | — | 1 Hz | ترمینال | **B1** DI20 | حفاظت | P1؛ قفل استارت تا reset دستی |
| `XS-876` | FCP: خطا، ناحیهٔ غیرفعال، BLOCKED یا lock-off | ER | کنتاکت رلهٔ FCP | — | — | 1 Hz | ترمینال | **B1** DI21 | پایش | P2؛ استارت موتور با FCP خراب ممنوع |

## بودجهٔ کانال هر برد (شمرده‌شده از همین فهرست)

| نوع | کانال استفاده‌شده | ظرفیت برد | ذخیره |
|---|---|---|---|
| B2 TC (AFE STM32F373) | 12 | 12 | 0 |
| B2 RTD (AFE STM32F373) | 11 | 16 | 5 |
| B2 AI 4–20 mA (ADC H7) | 21 | 24 | 3 |
| B2 fast AI / IEPE (ADC H7) | 5 | 8 | 3 |
| B2 frequency/pulse | 3 | 6 | 3 |
| B2 DI 24 V (ISO1I813T ×4) | 23 | 32 | 9 |
| B4 DO 24 V high-side | 12 | 16 | 4 |
| B4 PWM current out | 1 | 4 | 3 |
| B4 AO 0–10 V | 1 | 4 | 3 |
| B4 BLDC drives (MD) + fans | 7 | 8 | 1 |
| B1 speed/pulse inputs SPD-IN (×2 MCU) | 4 | 6 | 2 |
| B1 DI 24 V (ISO1I813T ×4) | 28 | 32 | 4 |
| B1 relay out (Finder 34.51 + 2× ULN2803A) | 12 | 16 | 4 |
| SR1 safety inputs (2-ch) | 20 | 24 | 4 |
| SR1 safe outputs | 2 | 8 | 6 |
| تگ‌های مشترک با docs/hvac (هم‌نام) | 29 | — | — |

> ظرفیت‌ها حدود ۲۰–۳۰ ٪ ذخیره دارند. هر تغییر I/O فقط در `calc/io_list.py` انجام شود و فایل دوباره ساخته شود.
