ahmadreza221/aurora-cchp/docs/electrical/01_power_single_line.md

# GR180-CCHP — دیاگرام تک‌خطی قدرت (single-line)، حالت‌های کاری، حفاظت، زمین و صاعقه

تاریخ: ۲۰۲۶-۱۰-۲۱ (rev 3: **باتری HV ۲۰ kWh** و **شبکه به‌عنوان منبع پشتیبان خودکار با zero-export** (تصمیم کاربر)، بارهای واقعی، ATS، قطعات اروپایی، چاه ارت)

**مبنا و اسناد مرتبط:**
- مبنا: `docs/03_system_spec.md` §۵، §۸، §۹ و `docs/06_master_design.md`
- محاسبات: [`calc/electrical_sizing.py`](calc/electrical_sizing.py) → [`calc/electrical_sizing_out.txt`](calc/electrical_sizing_out.txt)؛ نقطهٔ کار: [`calc/ems_study.py`](calc/ems_study.py)
- سند اصلی: [`00_electrical_control_architecture.md`](00_electrical_control_architecture.md)
- مدل سه‌بعدی: `cad/electrical/el_build.py` → `cad_out/electrical/`

## ۱. تصمیم معماری (rev 3)

**خواستهٔ کاربر:**
- باتری اصلی **HV LFP ۲۰ kWh** + باتری 48 V کنترل
- **شبکه به‌عنوان منبع پشتیبان خودکار**، با **zero-export** تا صدور مجوز تولید پراکنده (DG)
- هدف نهایی: **صادرات به شبکه** (اینورتر قابل گواهی grid-tie)
- کار ۲۴ ساعته
- قطعات اروپایی تا جای ممکن، **بدون قطعهٔ آمریکایی**
- بارهای واقعی: 1 پمپ 3 kW روی VFD، 3 کولر دیواری 12,000 BTU، روشنایی، کامپیوترها، یخچال، تلویزیون. **~5 kW معمول و ~8 kW پیک.**

**معماری: اینورتر هیبرید HV با سه درگاه AC (GRID، LOAD، GEN) و ورودی DC.**

| بخش | انتخاب | چرا |
|---|---|---|
| **HI-1 اینورتر هیبرید** | **Deye SUN-30K-SG01HP3-EU-BM3** (چین، غیرآمریکایی؛ مرجع): 30 kW، درگاه GRID + **درگاه LOAD (UPS)** + GEN، 3 MPPT (150–850 V، بار کامل 360–850 V، 3× 36 A، حداکثر 1000 V)، **2 ورودی باتری 50 A** (160–800 V)، 100 % نامتعادل (هر فاز ≤ 50 % نامی)، پیک 1.5× نامی برای 10 s، zero-export با CT/meter، گواهی EN 50549 / VDE-AR-N 4105 / IEC 62116 / IEC 62109 | **تنها گزینهٔ این اندازه با درگاه LOAD بدون وقفه** (datasheet 09/2026؛ زمان انتقال در datasheet نیامده، فروشنده‌ها < 4 ms گفته‌اند، **باید تأیید شود**) |
| **BAT-1 باتری اصلی** | **Deye BOS-G20**: 4× BOS-GM5.1 (5.12 kWh، 51.2 V) + جعبهٔ کنترل HVB750V/100A-EU در رک 3U-LRACK؛ **20.48 kWh**، 204.8 V (166–234 V)، 100 A اسمی (125 A برای 2 min)، 530 × 1629 × 602 mm، 240 kg | در لیست سازگاری Deye؛ با دو ورودی 50 A موازی (طبق دفترچه، تأیید شود) → **~20 kW** از باتری (calc §۶) |
| **ATS-1** | Socomec ATyS p M 4P 63 A (فرانسه): منبع I = درگاه LOAD اینورتر، منبع II = شبکهٔ مستقیم | **bypass خودکار** در خرابی اینورتر؛ موقعیت 0 در آتش اتاق برق |
| باس اضطراری 48 V | LFP 48 V 100 Ah (Pylontech US5000) + 2× شارژر Victron Smart IP43 48/13 + DC-DC 48→24 V (PULS) | مستقل از HI-1 و BAT-1؛ کنترل، ایمنی، استارتر، post-lube |

**گزینه‌های اروپایی** (اگر کاربر انتقال backup چندثانیه‌ای را بپذیرد؛ 04 §۸):

| گزینه | انتقال backup | محدودیت |
|---|---|---|
| SMA Sunny Tripower Hybrid X 30 + SMA Backup (آلمان) | خودکار، **پس از 1–600 s** قطع شبکه (پیش‌فرض 2 s)؛ بدون وقفه نیست | فقط باتری‌های SMA (Home Storage، Storage M) در 20–30 kW |
| KOSTAL PLENTICORE G3 L 20 + BackUp Switch (آلمان) | < 5 s دستی، < 30 s با جعبهٔ خودکار | جریان باتری 30 A (با BYD HVM 22.1 حدود 12 kW)؛ درگاه backup جدا ندارد |
| Fronius GEN24 10 Plus / SMA STP Smart Energy 10 | ~10 s / 30 ms تا 10 s | **فقط 10 kW** |

**پیوستگی با طرح قبل:**
- **B3 دقیقاً همان می‌ماند.** با PV emulation (V_mp 720 V، V_oc 780 V) به دو MPPT موازی HI-1 می‌رود. 720 V داخل بازهٔ بار کامل 360–850 V است و V_oc < 850 V.
- **چاپر 800–830 V و OVP سخت‌افزاری 900 V < 1000 V** حداکثر ورودی اینورتر است.
- 24 kW در 720 V = 33 A، که در یک MPPT (36 A) جا می‌شود. دو MPPT موازی برای حاشیه استفاده می‌شوند.
- **کنترل توان:** در zero-export یا وقتی باتری پر است، HI-1 نقطهٔ MPPT را به سمت V_oc می‌برد. B3 این را می‌بیند (V_dc بالا می‌رود) و ECU سوخت را کم می‌کند (03 §۴). منطق قبلی بدون تغییر می‌ماند.

## ۲. دیاگرام تک‌خطی

```
═══════════════════════════════════ ROOF (قاب ROOF) — LPZ 0B، تابلوها LPZ 1 ═══════════════════════════════════
 GR180 → FPT ══shaft══ PMG ~30 kW، 2-pole، 1.0 kHz @60k، E_LL ≈ 360 V rms
                         │ 3~، W008 ≤ 3 m، بدون فیوز
           [K-BR NC] ────┤        ┌────────── RP-2 (PEB، IP66، cold plate گلیکول B3 → PMG → OC-1) ──────────┐
           B3b: SKD 30/12 →       │ B3: STM32G474 + 6× CoolSiC 1200 V + 1ED3491؛ DC link 600 µF (WIMA/EPCOS) │
                IGBT → R_BR2 8 Ω  │  ├─ chopper SiC → R_BR1 18–20 Ω (RB-1، ≥ 400 kJ)                       │
                                  │  ├─ Riso + فیلتر CM                                                    │
                                  │  └─ K-PRE (2× 50 Ω) ‖ K-DC+ / K-DC− (Schaltbau C195)                   │
                                  └────┬──────────────────────────────────────────────────────────────────┘
                                       │ DC 720–780 V
                 [DCD-1 1000 V 50 A، قفل‌شو] ── [SPD-DC1 T1+2] ── W001 2× 1×16 H1Z2Z2-K + PE، ~35 m، سینی T-R1
 RP-1: B2، B4، SR1، DC-DC 48→24 ◄── W007 2× 1×25 (باس 48 V)       BOP-R (HVAC) ◄── W006 5G10 (از AUX-DB)
 MEB-R ◄── هادی چاه ارت W118 (≥ 1×50، لینک تست) ── چاه ارت اختصاصی
═══════════════════════════════ ورود به ساختمان: SPD روی همهٔ کابل‌های فلزی؛ Ethernet فیبر ═══════════════════════════════
 ELECTRICAL ROOM (ER)               │
                 [DCJ-1: SPD-DC2 T2 + فیوز gPV 2P + ایزولاتور] ── W002 → MPPT1 ‖ MPPT2
                                    │
 شبکهٔ شهری ── کنتور شرکت برق ── W018 ── MDB ──┬── MCCB ورودی 63 A 4P ── SPD T1+2 ── JT-920 (کلاس 0.5S) ── CT zero-export
                                               │
                                               ├── W019 ── [MCB/RCD] ── GRID ┐
                                               │                     ┌───────┴────────────────────────────────┐
                                               │                     │ HI-1 Deye SUN-30K-SG01HP3-EU-BM3          │
                                               │                     │  رلهٔ شبکهٔ داخلی (anti-islanding)        │
                                               │                     │  BAT1 ‖ BAT2 ── W003 ── BAT-1 BOS-G20      │
                                               │                     │  (20.48 kWh، CAN BMS؛ B1 listen-only)      │
                                               │                     │  GEN: رزرو                                │
                                               │                     └───────┬────────────────────────────────┘
                                               │                        LOAD │ W004 ── MCCB 63 A ── JT-901 (4 Hz، هر فاز)
                                               │                             │
                                               └── W020 ── منبع II ──[ATS-1 4P 63 A]── منبع I ┘
                                                                      │  (break-before-make، قفل مکانیکی؛ position-0 از FCP)
                                                         K-NPE (پیوند N-PE در backup) ── MET
                                                                      │ باس پشتیبانی‌شده
                     ┌────────────────────────────────────────────────┼─────────────────────────────────┐
                Q1 50 A 4P ── W005 5G10 ~22 m ── تابلوی شرکت      Q2 32 A 4P ── AUX-DB (JT-902)
                  (K-LS1..4، JT-911..914، K-SP1..3 →                ├─ W006 → BOP-R بام (EM-HVAC)
                   سه کولر 12,000 BTU، یکی در هر فاز؛                ├─ 2× شارژر 48 V ── باس 48 V ── LFP 48 V 100 Ah
                   پمپ 3 kW روی VFD؛ یخچال، روشنایی، IT، TV)         │     ├─ DC-DC 48→24: B1، B5، شبکه
                                                                   │     └─ W007 → RP-1 بام
                                                                   ├─ FCU-E / EF-E / AC-E (JT-904)، فن‌کویل‌ها و ERV سالن (JT-903)
                                                                   ├─ EH-950 گرمکن 6 kW DHW (JT-905)
                                                                   └─ FCP (مدار اختصاصی قفل‌شده؛ باتری EN 54-4)
```

**نکات کلیدی:**
- **بدون فیوز بین PMG و B3.** بار ژنراتور تنها ترمز FPT است (§۵).
- **ATS-1 هرگز درگاه LOAD را با شبکه موازی نمی‌کند** (break-before-make). اینورتر شبکه را فقط از درگاه GRID خودش و با رلهٔ داخلی موازی می‌کند.
- **CT zero-export** در ورودی شبکه، بالادست هر دو شاخه (GRID و ATS منبع II) نصب می‌شود. پس حتی وقتی ATS روی II است، اینورتر صادرات را درست می‌بیند.
- **JT-920** صادرات را مستقل از CT اینورتر پایش می‌کند (03 T52).
- **کنتورها و EMS:** JT-901 (کل بار، 4 Hz)، JT-902..905، JT-911..914، JT-920، و Modbus اینورتر (06 §۳، §۷).

## ۳. حالت‌های کاری و رفتار انتقال

### ۳-الف. کار عادی v1: موازی با شبکه، zero-export

| موضوع | رفتار |
|---|---|
| مسیر توان | توربین → B3 → MPPT → درگاه LOAD (بار) + باتری؛ کمبود از شبکه (import)، **صادرات = 0** |
| نقطهٔ کار توربین | بار را دنبال می‌کند: 8.6–13.6 kW در **100k rpm و TIT 645–750 °C** (06 §۵-ب) |
| SOC | 60–80 % (ذخیره برای قطع شبکه) |
| گذراها و جریان هجومی | **شبکه** می‌گیرد |
| trip توربین | بار بدون وقفه از شبکه و باتری؛ ECU طبق 03 §۶ |
| ATS-1 | روی I |
| N-PE | از شبکه (TN-C-S) یا الکترود (TT)؛ K-NPE باز است |

### ۳-ب. قطع شبکه → backup (جزیره)

| # | رویداد | پاسخ |
|---|---|---|
| 1 | شبکه قطع می‌شود (ولتاژ، فرکانس یا ROCOF خارج از حد) | HI-1 رلهٔ شبکه را باز می‌کند (anti-islanding طبق EN 50549 / IEC 62116؛ ≤ 2 s) و درگاه LOAD را **بدون وقفه** (طبق فروشنده < 4 ms؛ تأیید شود) از باتری و توربین تغذیه می‌کند |
| 2 | پیوند N-PE | سیگنال island اینورتر K-NPE را می‌بندد (ZS-NPE → B1؛ مغایرت = P1) |
| 3 | EMS | SOC_target 80 %؛ کنترل فازی در حالت backup (06 §۷)؛ آلارم P2 «قطع شبکه» |
| 4 | توربین | ادامه با load following؛ کمبود → merit order (06 §۶-۲) |
| 5 | برگشت شبکه | HI-1 پس از پایداری شبکه (60–300 s طبق grid code) هم‌زمان‌سازی می‌کند و رله را می‌بندد؛ K-NPE باز می‌شود؛ بدون وقفه برای بار |

### ۳-ج. خرابی اینورتر

- **خرابی HI-1 یا قطع درگاه LOAD:** ATS-1 پس از 1–3 s (تنظیمی) به II می‌رود. بارها مستقیم از شبکه برق می‌گیرند و قطعی کوتاه است.
- **توربین:** خروجی DC جایی برای رفتن ندارد. چاپر B3 بار را می‌گیرد، ECU سوخت را به idle می‌برد و پس از 60 s خاموشی کنترل‌شده انجام می‌دهد (T36).
- **برگشت:** پس از رفع خطا، ATS برمی‌گردد. مدت برگشت قابل تنظیم است و یک قطعی کوتاه دارد.
- **اگر شبکه هم نباشد:** بارها بی‌برق می‌شوند تا تعمیر.

### ۳-د. Black start بدون شبکه

**سطح ۱ (باتری اصلی سالم):**
1. باس 48 V همیشه روشن است (B1، B5، SR1، B2/B4، FCP).
2. B1 با BMS-WAKE باتری HV را روشن می‌کند. HI-1 از باتری، درگاه LOAD را می‌سازد.
3. K-LS1..4 و K-SP1..3 باز می‌مانند.
4. استارت موتور (03 §۳)، سپس B3 → MPPT.
5. بارها پله‌ای وصل می‌شوند (06 §۷-۴).

**سطح ۲ (باتری HV خالی یا BMS خاموش، بدون شبکه):**
1. موتور با 48 V استارت می‌شود (استارتر، روغن و کنترل همه روی باس 48 V).
2. FPT ابتدا روی R_BR1 بار می‌شود (چاپر B3 در حالت تنظیم V_dc).
3. B3 باس DC را در V_oc نگه می‌دارد تا HI-1 **از ورودی DC بیدار شود** (Deye: استارت PV در 180 V).
4. HI-1 باتری را شارژ و بیدار می‌کند، سپس درگاه LOAD را می‌سازد.
5. **این رفتار باید در تست میز تأیید شود** (§۸). اگر HI-1 بدون باتری روشن نشود، bootstrap دستی لازم است: شارژ مستقیم BMS طبق دستور سازنده.
- **پیشگیری:** EMS نمی‌گذارد SOC زیر 20 % برود (در backup، حذف بار در 30 / 20 %) و ذخیرهٔ بیدارشدن BMS حفظ می‌شود.

### ۳-ه. پس‌زدن بار و trip

| رویداد | پاسخ سخت‌افزاری (< 20 ms) | پاسخ ECU / EMS |
|---|---|---|
| HI-1 ورودی DC را قطع می‌کند (خطا، اشباع باتری در backup) | V_dc بالا می‌رود → چاپر B3 (800 V روشن، 830 V کامل)؛ N2 با گشتاور B3 نگه داشته می‌شود | سوخت به idle؛ اگر تا 60 s برنگشت، CSD |
| B3 خراب | B3-HEALTHY می‌افتد → K-BR → B3b؛ SR1 → ESD | ثبت و خاموشی |
| trip توربین با شبکه | بار از شبکه (بدون وقفه) | ثبت؛ استارت دوباره طبق سیاست |
| trip توربین در backup | باتری (~20 kW از BOS-G20) کل بار را می‌گیرد | SOC < 30 % → گروه ۴ و ۳؛ < 20 % → فقط گروه ۱ |
| خطای HI-1 | ATS-1 → II (با شبکه) | §۳-ج |

### ۳-و. صادرات به شبکه (v2، هدف نهایی)

- **مجوز DG:** حد صادرات طبق مجوز در HI-1 (Export Limit) تنظیم می‌شود. توربین در 115k / 800 °C کار می‌کند و صادرات ~11–14 kW است (06 §۵-ب).
- **حفاظت رابط (NS protection):** حفاظت داخلی HI-1 (EN 50549-1 / VDE-AR-N 4105). اگر شرکت توزیع رلهٔ خارجی بخواهد: **Ziehl UFR1001E** یا **Bender VMD460-NA** (آلمان) با کلید کوپلاژ در MDB.
- **کنتور دوطرفه** شرکت برق، به‌علاوهٔ JT-920 خودمان.
- **عدم‌تعادل تزریق:** HI-1 متقارن تزریق می‌کند؛ عدم‌تعادل بار از شبکه تأمین می‌شود (06 §۷-۶).
- **گواهی‌ها:** EN 50549، VDE-AR-N 4105، IEC 62116، IEC 61727 و IEC 62109 در datasheet آمده‌اند. پذیرش آن‌ها با شرکت توزیع (توانیر) و ساتبا چک شود.

## ۴. تجهیزات حفاظتی

| تجهیز | محل | مشخصه | هدف |
|---|---|---|---|
| desat + OCP سخت‌افزاری B3 | RP-2 | گیت‌درایور Infineon 1ED3491 (DESAT، soft-off) یا ST STGAP2SiC؛ مقایسه‌گر جریان فاز 120 A پیک | حفاظت SiC |
| OVP سخت‌افزاری باس DC | RP-2 | مقایسه‌گر مستقل از MCU: چاپر کامل در 830 V، trip در 900 V | حداکثر ورودی HI-1 1000 V |
| چاپر + R_BR1 | RP-2 + RB-1 | 18 Ω، 36 kW/10 s، ≥ 400 kJ، 6 kW پیوسته، کلید حرارتی NC 200 °C (Danotherm/Frizlen/Cressall) | load rejection |
| K-BR (NC) + B3b + R_BR2 | RP-2 | پل دیودی Semikron 1200 V، IGBT Infineon IKW40N120H3، R_BR2 8 Ω | ترمز مستقل |
| K-PRE + R_PRE، K-DC± | RP-2 | Schaltbau C195 (≥ 1000 V DC)؛ 2× 50 Ω 50 W | پیش‌شارژ و جداسازی |
| Riso | B3 | مقاومت سوییچ‌شده؛ قبل از هر وصل و هر 10 s | باس DC شناور |
| DCD-1 / DCJ-1 | بام / ER | ایزولاتور DC-PV2 1000 V 50 A (ABB یا Santon)؛ فیوز gPV 1000 V 50 A (Mersen یا SIBA) | سرویس و حفاظت کابل |
| SPD-DC1 / DC2 | بام / ER | Type 1+2 / Type 2، Ucpv ≥ 1000 V (DEHN، Phoenix، OBO، Citel) | صاعقه |
| **حفاظت باتری HV** | ER | جعبهٔ کنترل HVB750V/100A-EU (کنتاکتور، فیوز و BMS داخلی) + کیت کابل سازنده (W003) | اتصال‌کوتاه DC |
| MCCB ورودی شبکه | MDB | 63 A 4P (یا طبق انشعاب) + SPD T1+2 | انشعاب و W018 |
| MCB/RCD درگاه GRID | MDB | طبق دستور سازنده (RCD نوع A/B طبق مدل) | W019 |
| MCCB درگاه LOAD | MDB | 63 A 4P | کابل W004 |
| Q1 فیدر شرکت | MDB | 50 A 4P، منحنی C | کابل 5G10 |
| **ATS-1** | MDB | Socomec ATyS p M 4P 63 A، break-before-make، I = LOAD، II = شبکه، 0 با فرمان FCP | bypass خودکار در خرابی اینورتر |
| K-NPE | MDB | کنتاکتور 2P، فقط در backup بسته (سیگنال island اینورتر)، وضعیت ZS-NPE | یک پیوند N-PE |
| RCD | AUX-DB، BOP-R، تابلوی شرکت | 30 mA نوع A برای سوکت‌ها و مدارهای تک‌فاز اپراتوری؛ نوع B 300 mA برای VFD؛ **در TT اجباری** (§۹) | ایمنی اشخاص |
| MPCB | BOP-R، تابلوی شرکت | برای هر موتور | اضافه‌بار |
| حفاظت 48 V اضطراری | ER و RP-1 | فیوز باتری 125 A، MCB DC دوپل برای هر انشعاب | اتصال‌کوتاه |
| SPD AC | MDB ورودی شبکه (Type 1+2)، BOP-R (Type 1+2)، تابلوی شرکت (Type 2) | Up ≤ 1.5 kV؛ DEHN DEHNshield / DEHNguard | ضربه |
| SPD داده | دو سر کابل‌های داده بام↔ER | CAN، RS-422، حلقهٔ ایمنی (DEHN BLITZDUCTOR، Phoenix TERMITRAB) | صاعقهٔ القایی |
| رلهٔ حفاظت رابط (v2، اگر لازم باشد) | MDB | Ziehl UFR1001E یا Bender VMD460-NA | grid code |

## ۵. ترمز FPT و خطر runaway — یافتهٔ مهم

نتیجهٔ `calc/electrical_sizing.py` §۲. فرض: J (FPT + PMG + شفت) = 8×10⁻⁴ kg·m²، تا وقتی CAD برسد.

| توان FPT | زمان رسیدن به ۱۰۵ ٪ | ۱۱۰ ٪ | ۱۲۰ ٪ |
|---|---|---|---|
| 25.6 kW (v1) | 63 ms | 130 ms | 271 ms |
| 30 kW | 54 ms | 111 ms | 232 ms |

بعد از قطع سوخت، recuperator داغ تا چند ثانیه توان می‌دهد (۲۶ / ۷۷ / ۲۵۶ kJ برای τ = 1 / 3 / 10 s).

**الزام‌ها:**
1. ترمز **سخت‌افزاری و محلی** باشد (< 20 ms).
2. **دولایه** باشد: چاپر B3 + B3b مستقل.
3. ظرفیت انرژی مقاومت‌ها **≥ ۴۰۰ kJ** باشد.
4. **برای تیم مکانیک:**
   - spin test و containment FPT تا ≥ ۱۲۰ ٪ (78k)
   - بررسی شیر bypass گاز قبل از FPT
   - استخراج J واقعی از CAD
5. پیک EMF یکسوشده در 71.5k = 607 V < 720 V است، پس ترمز «خودبه‌خود» دیودی وجود ندارد و B3b لازم است.

## ۶. بارهای واقعی، پمپ VFD، surge و عدم‌تعادل هر فاز

**بارها (کاربر):**
- 1 پمپ 3 kW روی **VFD** (سه‌فاز 400 V؛ جریان استارت ≤ 1.1× FLC؛ VFD اروپایی Danfoss FC 51 / ABB ACS380 با چوک DC و فیلتر C2؛ RCD نوع B)
- 3 کولر دیواری 12,000 BTU دور ثابت (~1.2 kWe؛ RLA ~5.5 A، LRA ~27 A)، **هر کدام روی یک فاز** با رلهٔ مجوز K-SP
- روشنایی، کامپیوترها، یخچال (LRA ~8 A)، تلویزیون
- **~5 kW معمول، ~8 kW پیک.** بیشتر سرمایش سالن با چیلرهای جذبی است.

**نتیجهٔ calc §۵** (حالت backup = بدترین؛ با شبکه، جریان هجومی را شبکه می‌گیرد):

| فاز | بار در حال کار | استارت دوبارهٔ کولر | دو کولر هم‌زمان روی یک فاز | پمپ VFD |
|---|---|---|---|---|
| L1 | 19.5 A | — | — | — |
| L2 | 19.7 A | — | — | — |
| L3 (بدترین) | 21.9 A | **43.4 A → در حد پیوسته** (Deye 30K: 43 A نامی، 60 A نامتعادل، 65 A پیک) | 70.4 A → **بیش از 0.85 × پیک** | 22.5 A → OK |

- **عدم‌تعادل در کار عادی:** 12 % (قاعده ≤ 30 %).
- **soft starter لازم نیست.** قاعدهٔ مهم: **فقط یک کولر در هر فاز** (06 §۷-۶) و آزادسازی پلکانی K-SP پس از برگشت برق (06 §۷-۴).
- **گزینه‌های اروپایی در backup:**
  - SMA Hybrid X: استارت کولر در حد پیوسته است، ولی ظرفیت پیک اعلام نشده.
  - Kostal G3 L 20: استارت کولر روی L3 **بیش از حد** است (35 A پیک)، پس کولر سوم باید روی فاز سبک‌تر برود یا در backup حذف شود.

## ۷. سایز اینورتر و باتری (calc §۵–۶)

- **HI-1 Deye SUN-30K-SG01HP3-EU-BM3:**
  - 30 kW / 33 kVA؛ هر فاز ≤ 15 kW (50 % نامی)؛ پیک 45 kW برای 10 s.
  - رِیتینگ ماژولار 30 kW. در v1 بار فقط ~12 kW است و ظرفیت برای صادرات v2 می‌ماند.
- **BAT-1 BOS-G20 (20.48 kWh):**
  - دو ورودی 50 A موازی (100 A × 205 V) → **~19.9 kW** از باتری.
  - بدترین حالت در backup (trip توربین، بار پیک + کمکی 11.6 kW) پوشش داده می‌شود.
  - انرژی قابل استفاده 18.4 kWh → **1.6 h** در 11.6 kW، **2.1 h** در 8.6 kW (بار معمول + کمکی) بدون توربین.
  - **SUN-25K-AM2** فقط یک ورودی 50 A دارد → ~10 kW → **کمبود** در همین حالت (calc §۶). به همین دلیل 30K-BM3 انتخاب شد.
- **باس 48 V (calc §۷):** 100 Ah → 6.2 h در کار، 10 h در blackout.

## ۸. تست‌های میز قبل از موتور

1. **B3 + HI-1:**
   - منبع DC قابل‌برنامه یا B3 با prime mover القایی
   - MPPT روی منحنی PV emulation و زمان اتصال
   - **zero-export:** کاهش MPPT و پاسخ B3/ECU
   - Riso و نشتی مود مشترک
2. **انتقال‌ها:**
   - قطع شبکه → backup: **اندازه‌گیری زمان انتقال درگاه LOAD** با آنالایزر کیفیت توان، و رفتار کولرها و کامپیوترها
   - برگشت شبکه
   - خرابی HI-1 → ATS-1 روی II
   - کنتاکتور K-NPE
3. **black start سطح ۱ و ۲.** سطح ۲ یعنی **بیدارشدن HI-1 از ورودی DC بدون باتری**؛ اگر ممکن نیست، روش bootstrap سازنده.
4. **load rejection:** قطع ورودی DC در 24 kW؛ ثبت V_dc، چاپر و N2.
5. **EMS:** قواعد کنترل فازی در backup با کولرها، یخچال و پمپ (06 §۱۳).

## ۹. زمین (earthing) با چاه ارت اختصاصی، هم‌پتانسیل، صاعقه و ضربه

**وضع موجود:** یک **چاه ارت اختصاصی** حفر شده و هادی آن کنار ژنراتور (روی بام) بالا آمده است.

**طرح:**
1. **شینهٔ اصلی زمین بام (MEB-R)** روی قاب FR-E1 کنار RP-2 (PEB):
   - هادی چاه ارت با یک **لینک تست قابل‌بازشدن** به آن وصل می‌شود.
   - هادی چاه: مس ≥ 50 mm² (اگر کوچک‌تر است، تعویض یا موازی شود) با محافظ مکانیکی در مسیر.
2. **هم‌پتانسیل روی بام (W119):** شاسی اسکید، RP-2، RP-1، قاب FR-E1، BOP-R، جعبهٔ مقاومت‌ها، چیلرها، برج، رایزر گاز (بعد از اتصال عایقی، طبق مبحث ۱۷) و سینی‌ها با Cu ≥ 16 mm² (اتصال LPS ≥ 50 mm²) به MEB-R وصل می‌شوند.
3. **اتاق برق:**
   - شینهٔ MET-ER با هادی ≥ 25 mm² (W113) موازی مسیر کابل‌ها به MEB-R وصل است.
   - شیلد کابل‌ها در دو سر به همین سیستم می‌رود.
4. **نوع سیستم (rev 3: موازی با شبکه، backup در قطع شبکه):**
   - **با شبکه:** پیوند N-PE از شبکه می‌آید: در TN-C-S، PEN در MET بسته می‌شود؛ در TT، نوترال شبکه زمین نمی‌شود و همهٔ مدارها RCD دارند. K-NPE باز است.
   - **در backup:** درگاه LOAD شبکه‌ای جدا می‌سازد. **K-NPE** (فرمان از سیگنال island اینورتر) نوترال را در MET به PE وصل می‌کند، پس داخل نیروگاه **TN-S** است. بدنه‌ها به چاه ارت زمین شده‌اند.
   - **هرگز دو پیوند N-PE هم‌زمان نباشد.** ZS-NPE وضعیت را به B1 می‌دهد (03 T51).
   - **توصیهٔ قوی:** زمین ساختمان یا شرکت و LPS به همین چاه **هم‌بند (bond)** شوند (IEC 60364-5-54، IEC 62305-3، مبحث ۱۳). یک سیستم زمین واحد یعنی بارهای شرکت هم TN-S می‌شوند.
   - **اگر زمین شرکت جدا بماند (TT):**
     - بارهای شرکت از دید منبع جزیره **TT** هستند و **RCD برای هر مدار شرکت اجباری** است (30 mA برای سوکت‌ها و تک‌فازها، 300 mA نوع B برای VFDها).
     - شرط: `R_A × I_Δn ≤ 50 V`.
     - پایش ولتاژ بین دو زمین در فرمان SPD لحاظ شود.
5. **مقاومت چاه:**
   - هدف ≤ 2 Ω (حداکثر 10 Ω برای LPS)
   - اندازه‌گیری با روش سه‌قطبی fall-of-potential یا clamp، **سالانه** و پس از هر تعمیر
   - ثبت در HMI
6. **DC 720–780 V:** شناور (IT) با پایش Riso. هیچ قطب زمین نمی‌شود. **باتری HV:** شناور طبق Deye (پایش عایق داخلی اینورتر). **باتری 48 V:** منفی در یک نقطه به PE.
7. **صاعقه (IEC 62305):**
   - ارزیابی ریسک IEC 62305-2؛ پیش‌فرض LPL II.
   - **سیستم صاعقه‌گیر ایزوله:** دکل‌های هوایی با فاصلهٔ جداسازی s از اسکید و چیلرها.
   - **هادی‌های پایین‌روی LPS** جدا از هادی چاه نیروگاه کشیده می‌شوند و در **پای ساختمان به چاه و حلقهٔ زمین هم‌بند** می‌شوند (یک سیستم زمین مشترک).
   - هادی چاه ارت به‌عنوان هادی پایین‌روی صاعقه استفاده نمی‌شود و ≥ 1 m از کابل‌های داده فاصله دارد.
8. **SPD (مفهوم LPZ):**
   - AC: Type 1+2 در ورودی شبکهٔ MDB و BOP-R؛ Type 2 در تابلوی شرکت
   - DC: Type 1+2 در بام و Type 2 در ER
   - داده: CAN، RS-422، حلقهٔ ایمنی
   - اتصال SPD به MEB-R یا MET با طول ≤ 0.5 m
   - Ethernet بام↔ER فیبر است.
   - SPD Type 1+2 در ورودی شبکهٔ MDB.
9. **صادرات (v2):**
   - ساختار زمین همان حالت موازی می‌ماند.
   - شرکت توزیع ممکن است اندازه‌گیری مقاومت زمین، رلهٔ رابط خارجی یا پایش جریان نشتی بخواهد.
   - هماهنگی RCDها با جریان نشتی اینورتر طبق دستور سازنده (Deye: RCD نوع A 300 mA یا نوع B).

## ۱۰. صدا

صدا قید نیست، ولی کمتر بهتر است:
- فرکانس سوییچینگ B3 در 32–40 kHz است و شنیده نمی‌شود.
- فن‌ها از نوع EC با کنترل دور هستند.
- HI-1 فن هوشمند دارد (Deye 30K: ≤ 65 dB). در اتاق برق خنک (25 °C) و روی دیوار جدا از اتاق‌های کار نصب می‌شود.
- جعبهٔ مقاومت ترمز بی‌صداست و فقط در گذرا گرم می‌شود.
