ahmadreza221/aurora-cchp/docs/electrical/05_cable_schedule.md

# GR180-CCHP — جدول کابل‌ها (بام ↔ اتاق برق، اتاق برق ↔ سالن، داخل اسکید)

تاریخ: ۲۰۲۶-۱۰-۲۱ (rev 3: اینورتر هیبرید HV با شبکهٔ پشتیبان و ATS، چاه ارت، کابل‌های آتش) · مبنا: [`01_power_single_line.md`](01_power_single_line.md)، [`02_io_list.md`](02_io_list.md) · افت ولتاژ: [`calc/electrical_sizing_out.txt`](calc/electrical_sizing_out.txt) §۸

**فرض‌ها (در بازدید سایت تأیید شود):**
- طول مسیر **پنل‌های بام (RP-1، RP-2، BOP-R) ↔ اتاق برق (ER): ~۳۰ m** (تأیید کاربر)، شامل رایزر. BOP-R تابلوی BOP روی بام در `docs/hvac` است. مسیر سه‌بعدی در `cad/electrical/cable_route.py`.
- **اتاق برق (فرض مدل سه‌بعدی):** 3.5 × 3.0 m، ارتفاع آزاد 2.5 m، طبقهٔ همکف هم‌تراز سالن (کف z = −2.8 در قاب ROOF)، در x −20.5 تا −17.0 و y 7.0 تا 10.0. مسیر: سینی بام در لبهٔ شمالی، سپس رایزر از سقف به ER.
- طول **ER ↔ تابلوی شرکت در سالن: ~۲۰ m** (از همان فرض؛ عدد قبلی ۶ m مربوط به وقتی بود که اتاق برق کنار سالن فرض می‌شد). **در بازدید تأیید شود.**
- **RP-2 = تابلوی یکسوساز (PEB)** شامل B3، B3b، کنتاکتورها، DCD-1 و SPD-DC1. **RP-1 = تابلوی کنترل بام** شامل B2، B4، SR1 و DC-DC. **RB-1 = جعبهٔ مقاومت‌های ترمز.**
- طول‌ها با ~۱۵ ٪ اضافه برای حلقه و سرکابل گرد شده‌اند.

## ۱. کلاس‌بندی و قواعد مسیر (EN 50174-2 / IEC 61000-5-2)

| کلاس | محتوا | قاعده |
|---|---|---|
| **c1** | آنالوگ حساس: TC، RTD، IEPE، 4–20 mA | دورترین از c4. شیلد TC و IEPE فقط در سمت B2 زمین می‌شود؛ 4–20 mA در دو سر |
| **c2** | داده: CAN، RS-485، سرعت (RS-422 / open-collector)، Ethernet مسی | جفت تابیده با شیلد کلی؛ شیلد در دو سر با گلند EMC 360°، به‌همراه هادی هم‌پتانسیل موازی |
| **c3** | DC 24/48 V کنترل و قدرت، حلقهٔ ایمنی | — |
| **c4** | AC 400 V، **DC 750 V**، **PMG 1 kHz با PWM SiC**، کابل چاپر | فاصله از c1/c2: **≥ 300 mm** در سینی باز، یا لولهٔ فولادی بسته جدا (آنگاه ≥ 50 mm)؛ از c3 ≥ 100 mm؛ تقاطع عمود |

**مسیر بام ↔ ER (مرز LPZ):** دو لولهٔ فولادی گالوانیزه (یا داکت درپوش‌دار دو خانه) که **در دو سر به سیستم هم‌پتانسیل وصل‌اند**:

| لوله | کلاس | کابل‌ها |
|---|---|---|
| A | c4 + c3 | W001، W006، W007 |
| B | c2 + c3 | W101، W102a، W102b، W103، W104 (فیبر) |

- **W102b** (سرعت ایمنی) کابلی جدا از W102a است (تنوع در برابر آسیب مشترک).
- هادی هم‌پتانسیل **W113** در طول مسیر کشیده می‌شود.
- **SPD** در ورود به ER برای همهٔ کابل‌های فلزی c2/c3/c4 (به‌جز فیبر) نصب می‌شود.

**روی بام:**
- ورود کابل به پنل‌ها **فقط از پایین**، با حلقهٔ چکه (drip loop)، گلند IP68 برنجی نیکل‌دار EMC برای شیلددارها و پلی‌آمید UV-پایدار برای بقیه. در Zone 2 گلند Ex.
- کابل‌های ناحیهٔ موتور برای ≥ 125–180 °C (سیلیکون / FEP / PTFE) و با ≥ 100 mm فاصله از پوستهٔ داغ و سپر حرارتی.
- کابل‌های بیرون جعبه روکش UV-پایدار (PE/PUR سیاه) دارند.
- **برچسب:** شمارهٔ کابل در دو سر (حرارتی UV-پایدار)، سرسیم (ferrule) روی همهٔ رشته‌ها، و نقشهٔ ترمینال برای هر پنل.

## ۲. کابل‌های قدرت

| ID | از → به | کارکرد | کلاس | نوع | رشته × مقطع | طول | بار / افت | یادداشت |
|---|---|---|---|---|---|---|---|---|
| W001 | RP-2/DCD-1 (بام) → DCJ-1 (ER) | DC اصلی 720–780 V | c4 | **H1Z2Z2-K** (EN 50618، 1.5 kV DC، UV و ازن، 90/120 °C) | 2× 1×**16** mm² + PE 1×16 | ~35 m | 41.7 A (30 kW)؛ ΔV 0.45 %، تلفات 134 W | لولهٔ A؛ سرکابل پرسی، **بدون MC4** در این مسیر؛ SPD-DC1/DC2 در دو سر |
| W002 | DCJ-1 → ورودی‌های DC (MPPT) اینورتر HI-1 | DC به 2 MPPT موازی | c4 | H1Z2Z2-K | 2× (2× 1×6 mm²) | ~3 m | ≤ 21 A برای هر MPPT در 30 kW | کانکتور PV طبق HI-1 (MC4-Evo2 / Stäubli)؛ فیوز gPV 25 A برای هر شاخه |
| W003 | HI-1 BAT ↔ جعبهٔ کنترل باتری HV (BMS) | DC باتری HV (160–800 V طبق مدل) | c4 | کیت کابل سازندهٔ باتری، 1 kV | 2× 1×35 | ≤ 3 m | ≤ 50 A (20 kW در ~400 V) | کیت سازنده + کابل CAN/RS-485 BMS (W107) |
| W004 | HI-1 LOAD (backup) → MCCB → ATS-1 منبع I (داخل MDB) | AC 400 V پشتیبانی‌شده | c4 | N2XH-J 0.6/1 kV (LSZH) | **5G16** | ~3 m | 43.5 A (30 kVA) | MCCB 63 A 4P در خروجی LOAD |
| W005 | MDB (Q1، بعد از ATS-1) → تابلوی شرکت (سالن) | فیدر شرکت | c4 | N2XH-J یا NYY-J 0.6/1 kV | **5G10** | ~22 m | بار واقعی ~8 kW پیک → 12 A؛ ΔV < 0.1 % | ظرفیت آینده تا 43 A |
| W018 | ورودی شبکه (کنتور شرکت برق) → تابلوی ورودی MDB-G | شبکهٔ شهری | c4 | NYY-J 0.6/1 kV | 5G16 (یا طبق انشعاب) | طبق سایت | انشعاب موجود | MCCB اصلی + SPD Type 1+2 + کنتور JT-920 + CT zero-export اینورتر |
| W019 | MDB-G → درگاه GRID اینورتر HI-1 | شبکه به HI-1 | c4 | N2XH-J | 5G16 | ~3 m | 43.5 A | MCB/RCD طبق دستور سازنده (RCD نوع A/B طبق مدل) |
| W020 | MDB-G → ATS-1 منبع II (bypass خودکار) | شبکهٔ مستقیم | c4 | N2XH-J | 5G16 | ~3 m | — | ATS قفل مکانیکی break-before-make؛ هرگز موازی با LOAD |
| W022 | باتری 48 V (100 Ah) → شینهٔ 48 V اضطراری | DC 48 V | c3 | H07RN-F | 2× 1×35 | ≤ 2 m | ≤ 100 A (استارتر از راه W007) | فیوز Class-T / NH 125 A کنار باتری |
| W006 | AUX-DB → BOP-R (بام) | AC کمکی HVAC (پمپ‌ها، VFDهای P-6 و برج، چیلرها، dry cooler DC-1، هیترها، B6-R) | c4 | NYY-J (روکش UV) در لولهٔ A | **5G10** | ~35 m | ~10 kW متصل، ~3.3 kW تابستان (docs/hvac rev B)؛ 20 A → ΔV 0.54 %؛ MCB 32 A | SPD Type 1+2 در BOP-R |
| W007 | باس 48 V (ER) → RP-1 | قدرت اضطراری 48 V | c3 | H07RN-F 1×25 (قرمز/آبی) | 2× 1×**25** | ~35 m | پیک استارتر 58 A → ΔV 6.0 %؛ دائم 15 A → 1.5 % | فیوز 80 A در ER؛ مبدل‌های بام 36–75 V را تحمل می‌کنند |
| W008 | RP-2 (B3) ↔ ترمینال PMG | 3~ PMG، 1 kHz + PWM 40 kHz | c4 | کابل سروو/VFD متقارن شیلددار مقاوم به حرارت (کلاس ÖLFLEX HEAT 180 EMC) | 3× 16 mm² + 3G2.5 + شیلد | ≤ 3 m | ~50 A rms | **کوتاه‌ترین مسیر**؛ شیلد 360° در دو سر؛ ≥ 500 mm از کابل‌های سنسور؛ **بدون فیوز** |
| W009 | RP-2 → RB-1 (R_BR1) | چاپر DC | c4 | سیلیکون/FEP 1.8 kV DC با بافت شیلد | 2× 1×6 + PE | ~6 m | 36 kW / 800 V ≈ 45 A پالسی | — |
| W010 | B3b (RP-2) → RB-1 (R_BR2) | چاپر ترمز مستقل | c4 | مثل W009 | 2× 1×6 + PE | ~6 m | — | — |
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
