ahmadreza221/aurora-cchp/_audit/Front.jpg

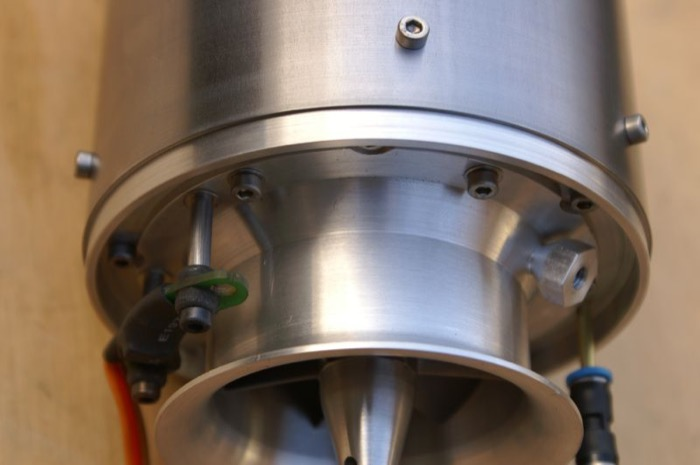
_audit/Front.jpg
