ahmadreza221/aurora-cchp/_audit/Oil lube 2.jpg

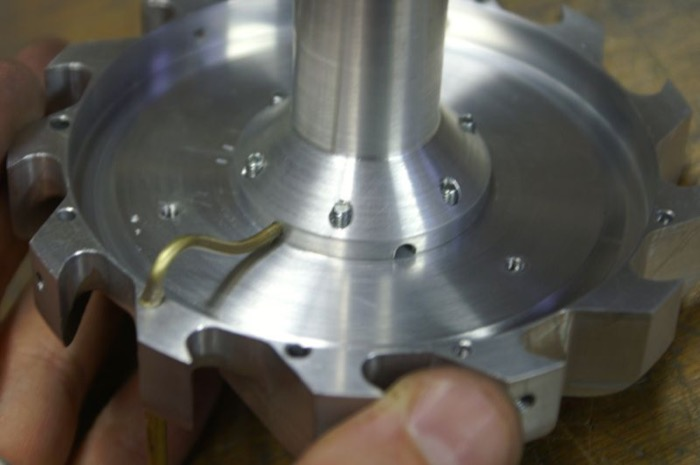
_audit/Oil lube 2.jpg
