ahmadreza221/aurora-cchp/_audit/Oil lube.jpg

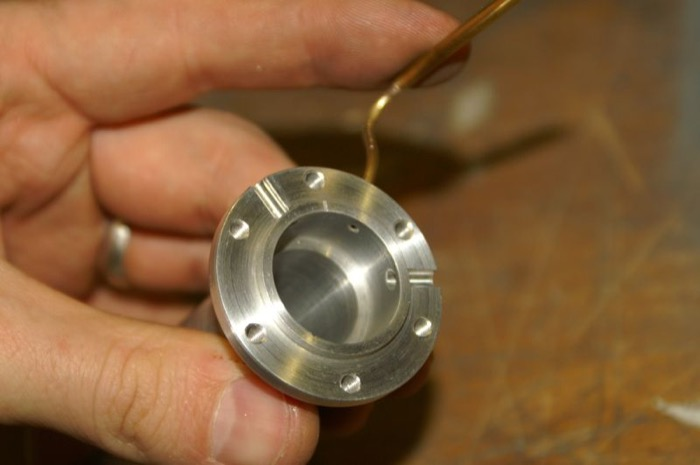
_audit/Oil lube.jpg
