ahmadreza221/aurora-cchp/_audit/Rear.jpg

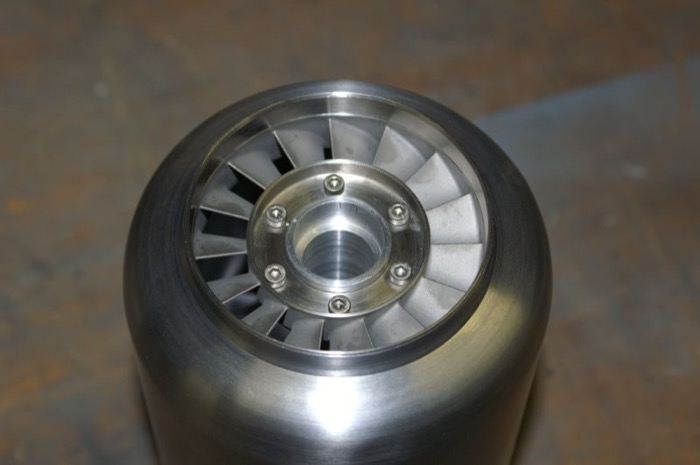
_audit/Rear.jpg
