ahmadreza221/aurora-cchp/docs/img/a1000_R1_campbell.png

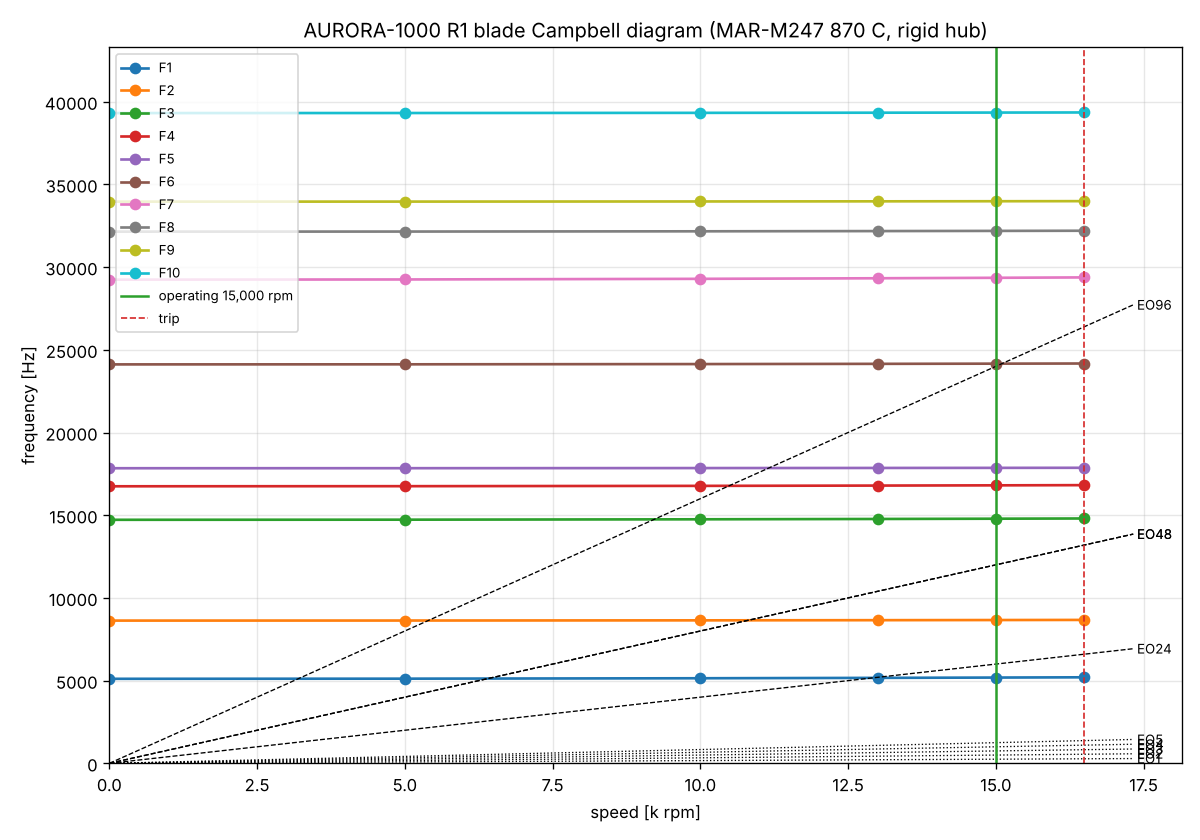
docs/img/a1000_R1_campbell.png
