ahmadreza221/aurora-cchp/previews/GR180_Exhaust_iso.png

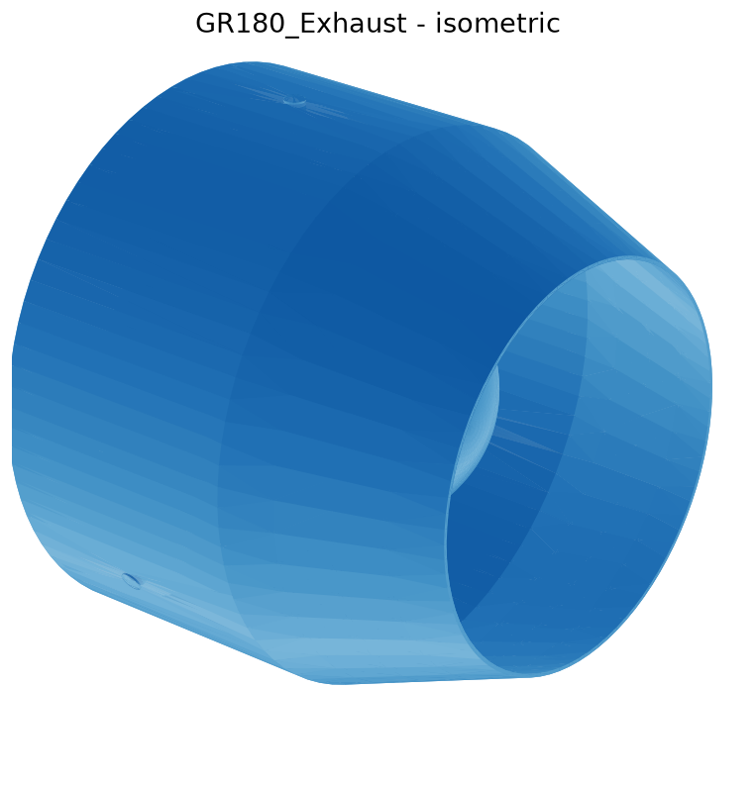
previews/GR180_Exhaust_iso.png
