ahmadreza221/aurora-cchp/previews/GR180_Exhaust_section.png

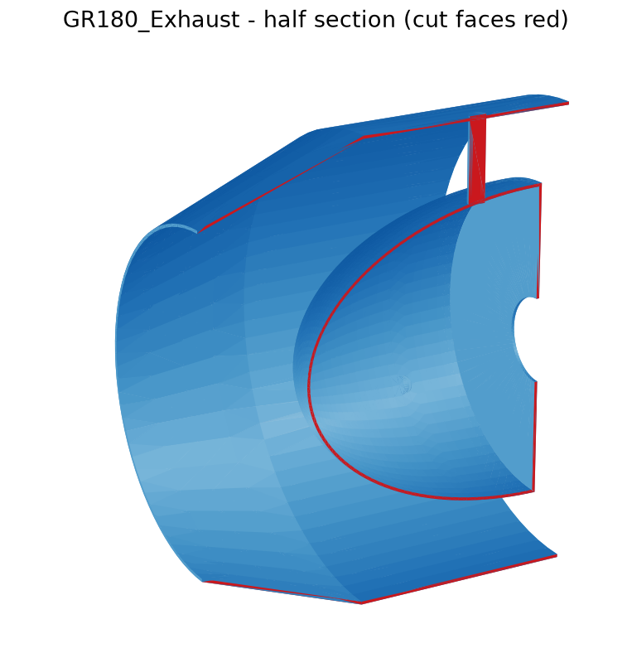
previews/GR180_Exhaust_section.png
