ahmadreza221/aurora-cchp/previews/GR180_fuel_system.png

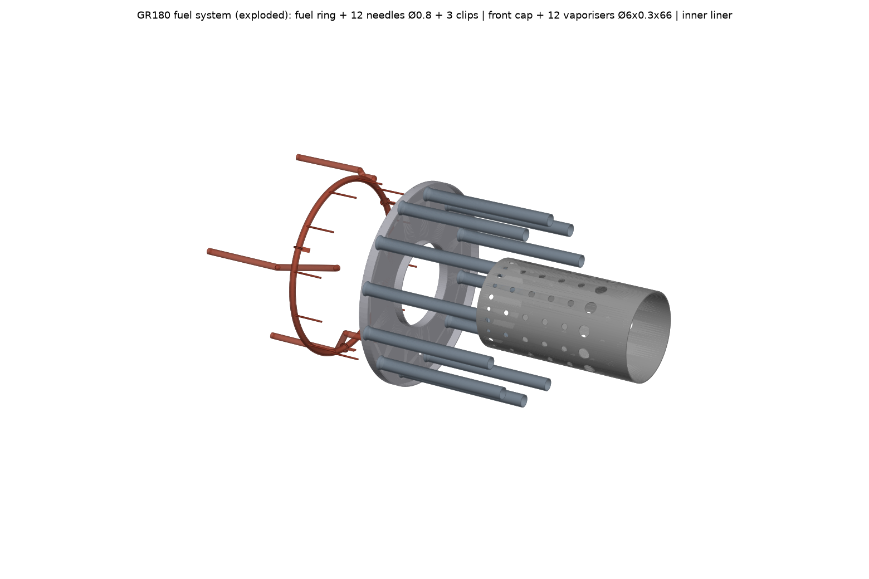
previews/GR180_fuel_system.png
