ahmadreza221/aurora-cchp/previews/GR180_full_iso.png

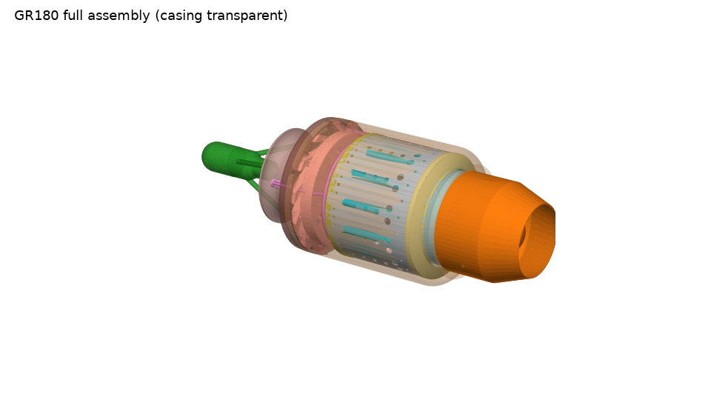
previews/GR180_full_iso.png
