ahmadreza221/aurora-cchp/previews/GR180_full_section.png

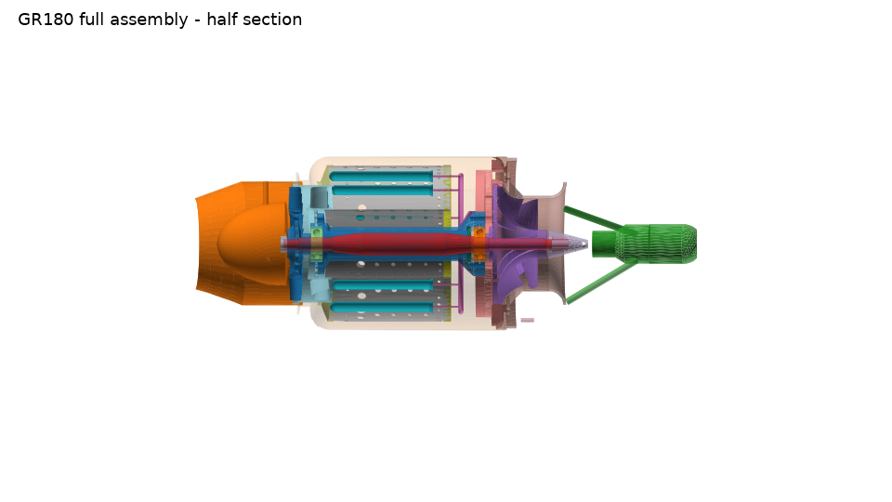
previews/GR180_full_section.png
