ahmadreza221/aurora-cchp/previews/GR180_NGV_placeholder_iso.png

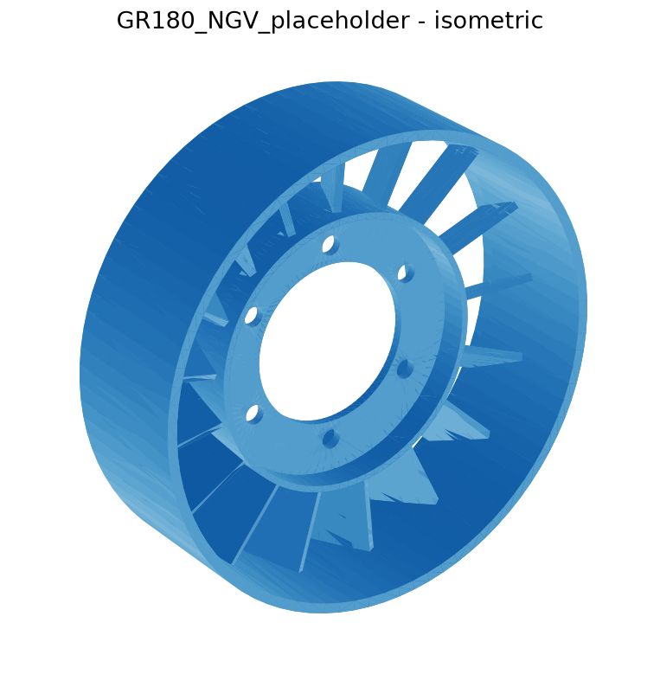
previews/GR180_NGV_placeholder_iso.png
