ahmadreza221/aurora-cchp/previews/GR180_NGV_placeholder_section.png

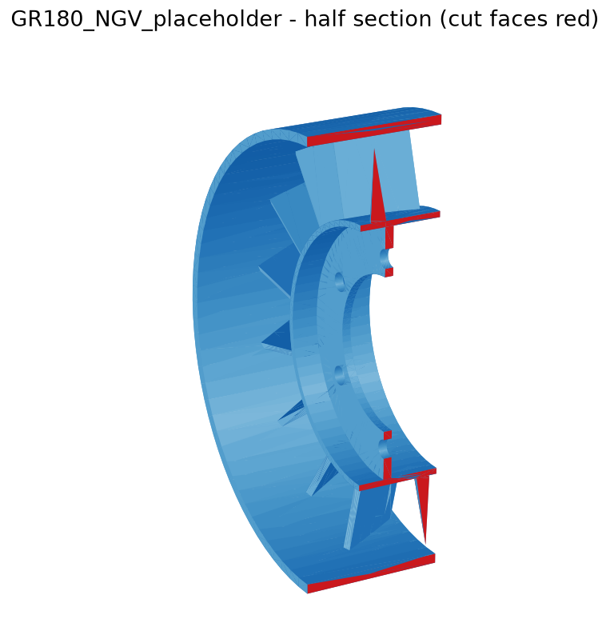
previews/GR180_NGV_placeholder_section.png
