ahmadreza221/aurora-cchp/previews/GR180_Starter_iso.png

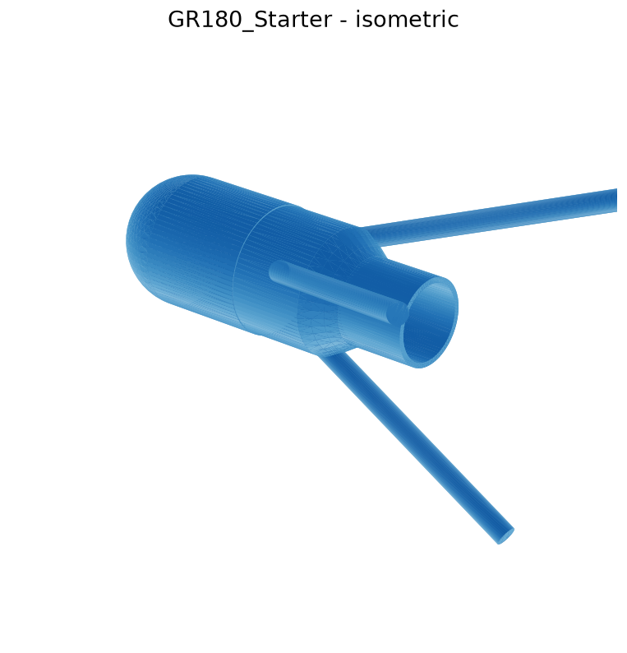
previews/GR180_Starter_iso.png
