ahmadreza221/aurora-cchp/previews/GR180_Starter_section.png

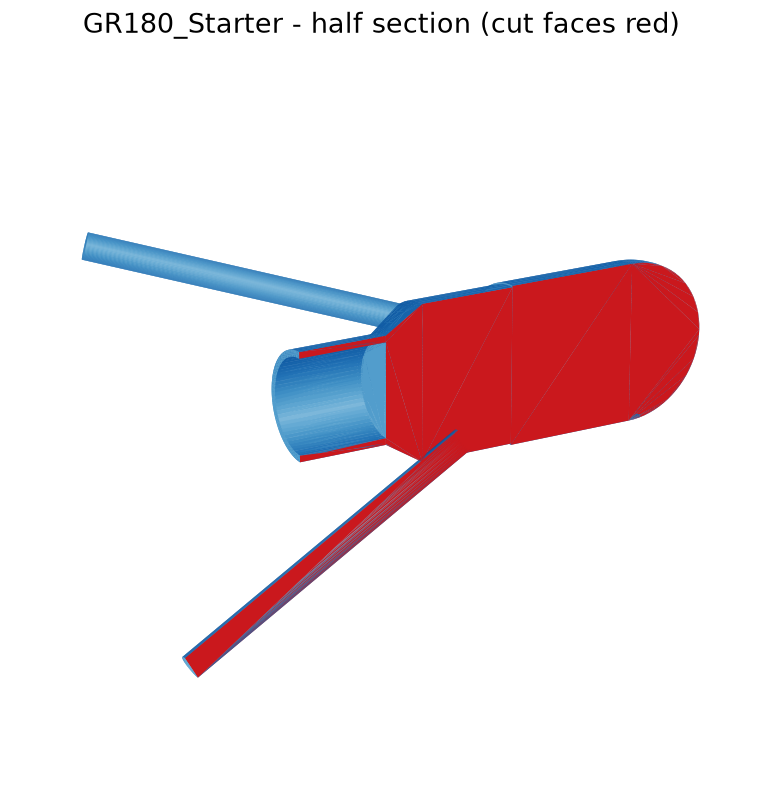
previews/GR180_Starter_section.png
