ahmadreza221/aurora-cchp/previews/GR180_Supply_lines_iso.png

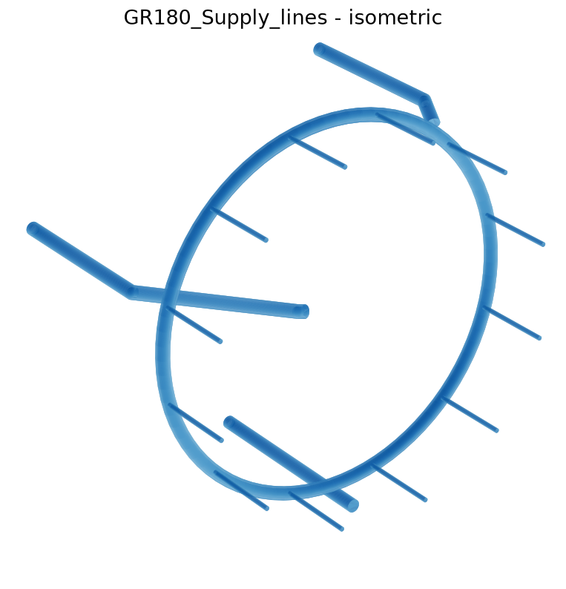
previews/GR180_Supply_lines_iso.png
