ahmadreza221/aurora-cchp/previews/GR180_Supply_lines_section.png

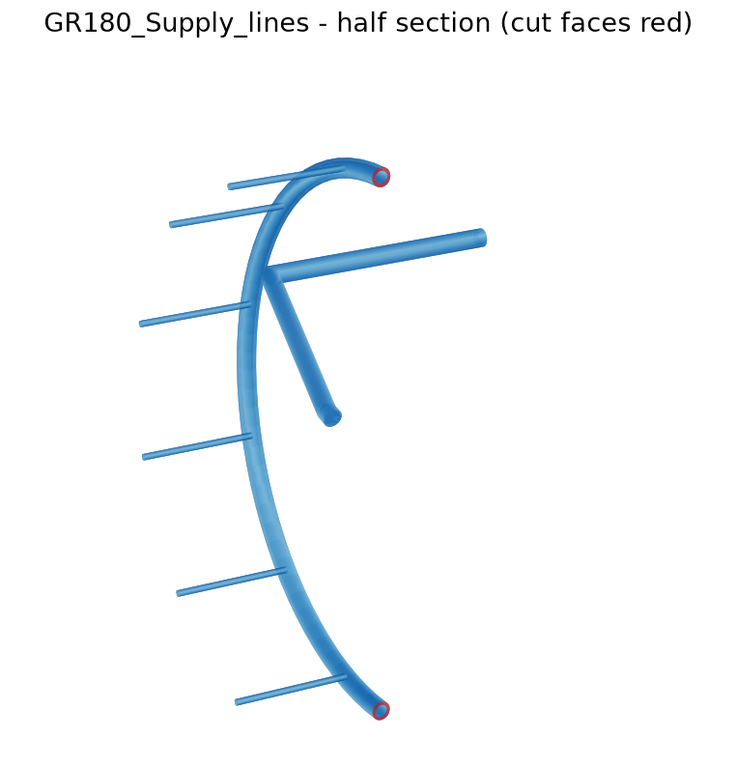
previews/GR180_Supply_lines_section.png
