ahmadreza221/aurora-cchp/previews/GR180_Turbine_placeholder_iso.png

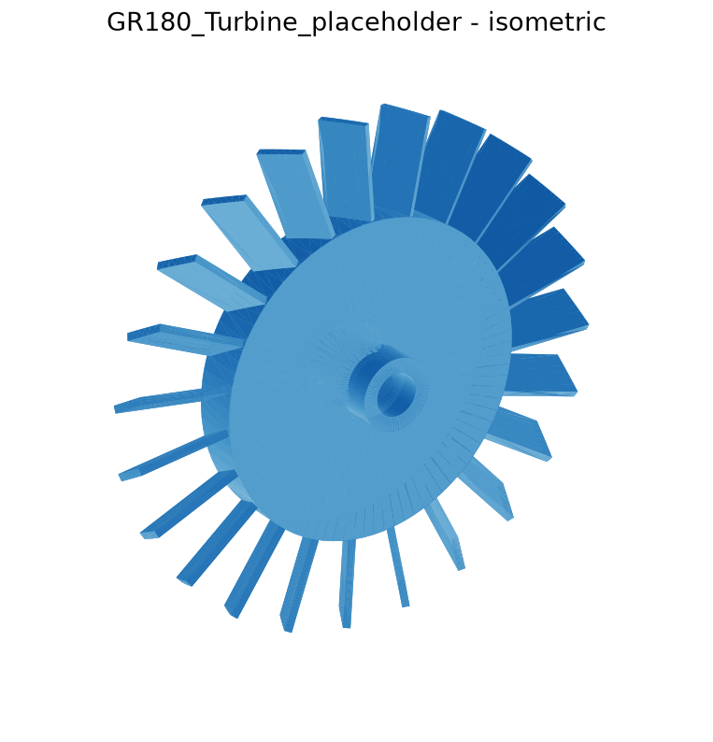
previews/GR180_Turbine_placeholder_iso.png
