ahmadreza221/aurora-cchp/previews/GR180_Turbine_placeholder_section.png

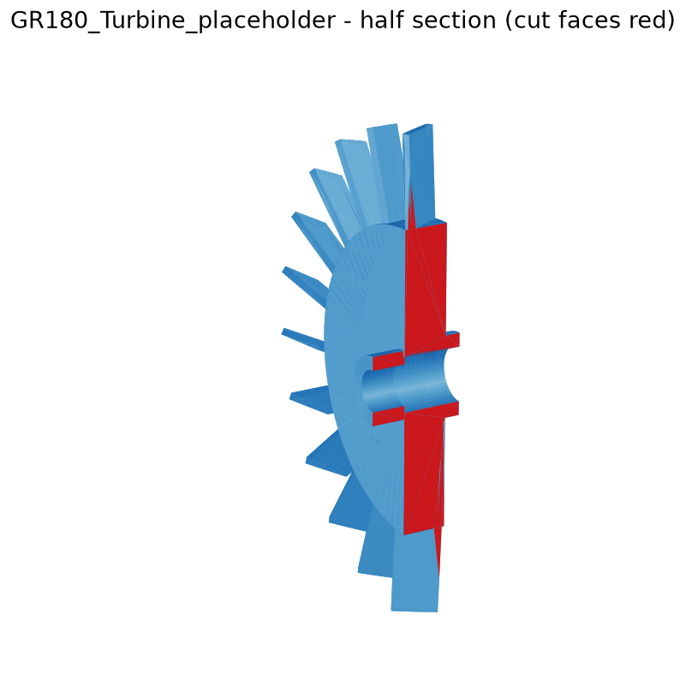
previews/GR180_Turbine_placeholder_section.png
