ahmadreza221/aurora-cchp/previews/grid.png

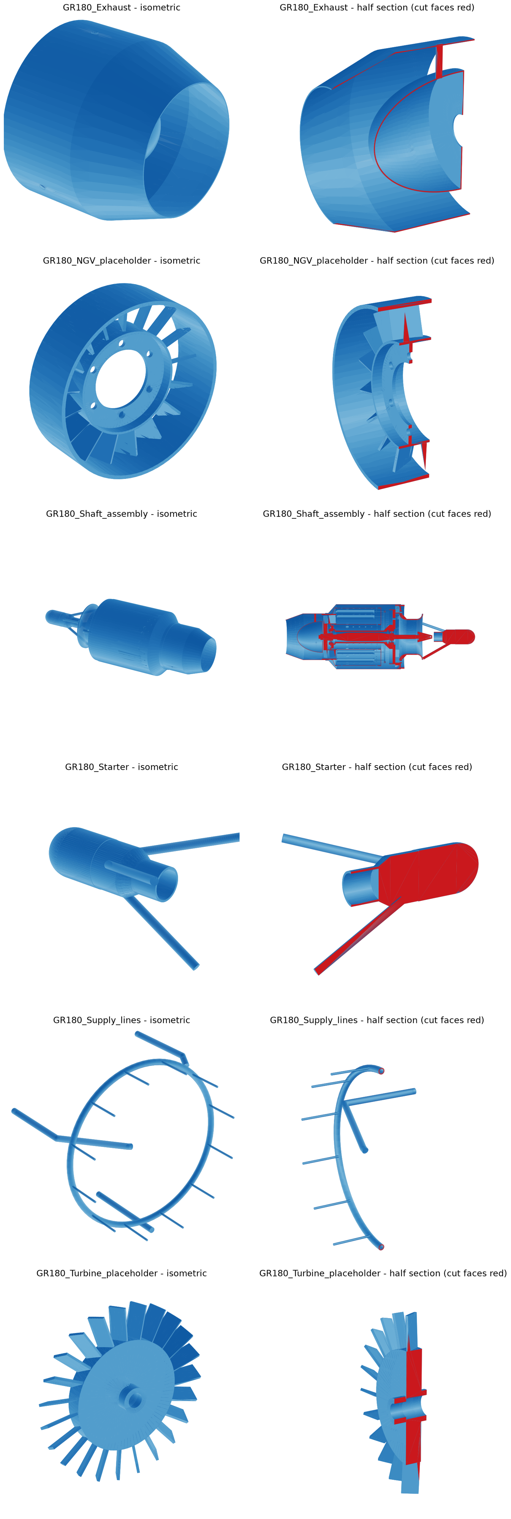
previews/grid.png
