ahmadreza221/aurora-cchp/sim/gr180_campbell.png

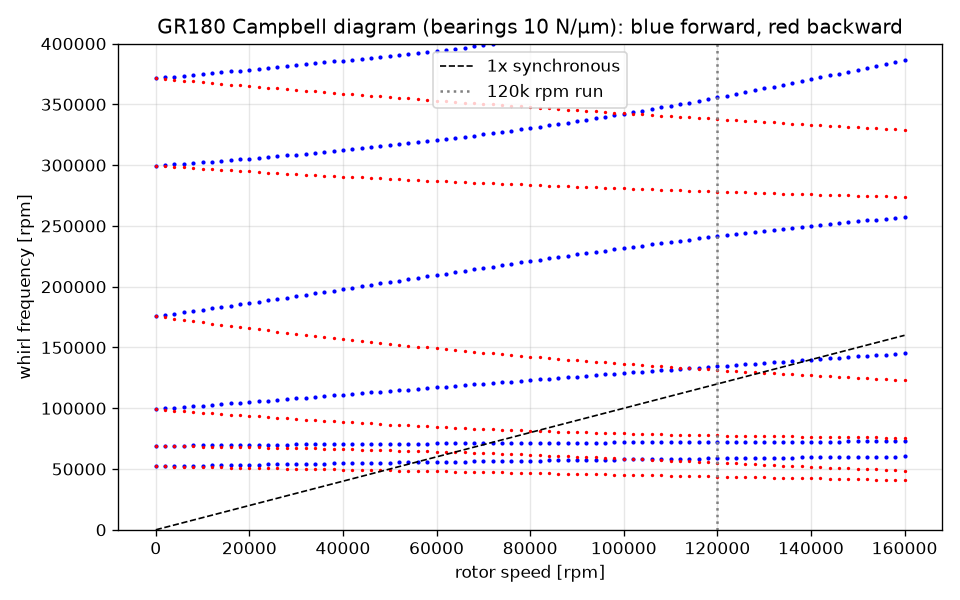
sim/gr180_campbell.png
