ahmadreza221/aurora-cchp/sim/gr180_cycle.png

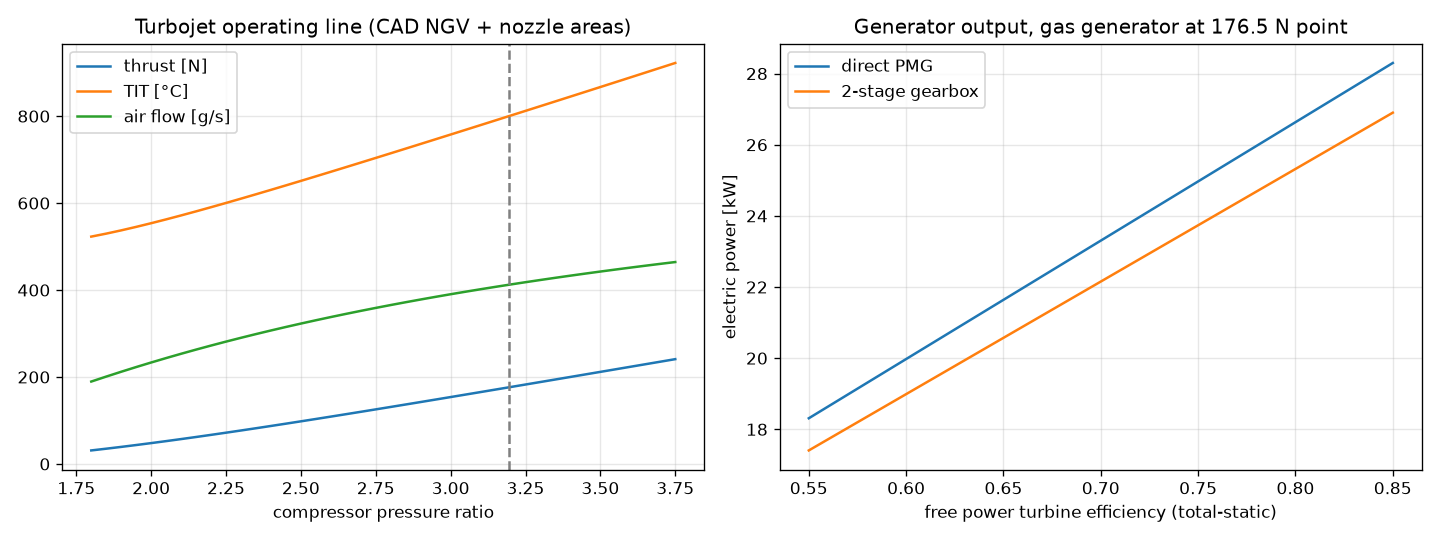
sim/gr180_cycle.png
