ahmadreza221/aurora-cchp/docs/bom/variant_e_generator_bom.csv

tag | description | qty | make_or_buy | material_or_spec | size_or_rating | supplier_candidates | mass_kg | model_file | notes
E-G200 | Pod Housing: pod housing: thick tube OD 330, bore 290 H7 (front, jacket seat) / 286 H7 (rear) turned in ONE setting (coaxial <= 0.02), jacket shoulder x -422.5, DIN 472 circlip groove, 2 x 16 HELICOIL M10 + 2 dowels per end face, glycol ports G3/4 (+y), leak-off G1/8 (low -y), lead window (top), 4 x HELICOIL M8 for the terminal box, jacket anti-rotation dowel hole | 1 | make: 6082-T6 forged ring / thick tube d340/280 x 480, CNC turning (both bores one clamping) + 5-axis for ports / holes | EN AW-6082-T6 | 466 x 343 x 330 mm (bbox) | own 5-axis CNC (user) | 24.48 | cad_out/variant_e/GENERATOR/E-G200_Pod_Housing.step | bores Ra 0.8, coaxiality 290 H7 / 286 H7 <= 0.02, end faces perpendicular <= 0.02; HELICOIL plus M10 x 1.5D; mass from CAD volume
E-G201 | Glycol Jacket: glycol jacket sleeve: ID 262 H6 (stator shrink 0.18-0.24), OD 290 g6 lands, double-start helical channel 18 x 8 lead 46 (2 x 6.5 turns), front / rear manifold grooves, 2 + 2 O-ring grooves (bottom d284.3) with leak-off grooves, 2 x M10 pull-out threads, anti-rotation dowel slot | 1 | make: 6082-T6 tube d300/250 x 350, CNC turning; helix single-point turned (2-start, like a coarse thread) | EN AW-6082-T6 | 340 x 290 x 290 mm (bbox) | own 5-axis CNC (user) | 6.55 | cad_out/variant_e/GENERATOR/E-G201_Glycol_Jacket.step | CAD shows the helix as 12 rings of the same section; h 7200 W/m2K, 28 kPa at 30 L/min (eg_thermal.json); mass from CAD volume
E-G207 | Jacket Circlip DIN472 290: internal circlip DIN 472 290 x 4 (axial stop of the jacket, front) | 1 | buy (Hugro DE / Wuerth DE) | steel (42CrMo4 QT / 34CrNiMo6 QT / S355 / 1.4034 per part) | 4 x 299 x 299 mm (bbox) |  | 0.35 | cad_out/variant_e/GENERATOR/E-G207_Jacket_Circlip_DIN472_290.step | mass from override (bought / envelope)
E-G208 | Jacket Dowel d8: radial anti-rotation dowel ISO 8734 8 m6 x 18 (housing -> jacket slot), reacts the stator torque | 1 | buy (Bossard CH, Halder DE) | steel (42CrMo4 QT / 34CrNiMo6 QT / S355 / 1.4034 per part) | 8 x 18 x 8 mm (bbox) |  | 0.01 | cad_out/variant_e/GENERATOR/E-G208_Jacket_Dowel_d8.step | mass from override (bought / envelope)
E-G202 | Stator Core NO10: stator core 24 open slots 8.6 x 37 (+ wedge notches), bore 126, OD 262.24 ground (shrink), stack 270 of 0.10 mm NO10, self-bonding varnish (backlack), no welds / keys | 1 | buy: bonded lamination stack to our drawing (laser cut + backlack bonded, OD ground) | NO10 0.10 mm, backlack bonded | 270 x 262 x 262 mm (bbox) | order spec docs/variant_e/02_generator.md section 5; Kienle+Spiess (DE), Euro Group (IT), Surahammar / Cogent (SE), JFE (JP), Baosteel (CN) | 66.17 | cad_out/variant_e/GENERATOR/E-G202_Stator_Core_NO10.step | mass from CAD volume
E-G203 | Stator End Plates x2: insulating end plates 1.5 mm (glass-epoxy EP GC 203), slotted like the core, protect the coils at the slot exits | 2 | make: CNC milled / waterjet from EP GC 203 sheet | glass-epoxy EP GC 203 (IEC 60893) | 273 x 258 x 258 mm (bbox) | own 5-axis CNC (user) | 0.18 | cad_out/variant_e/GENERATOR/E-G203_Stator_End_Plates_x2.step | mass from CAD volume
E-G204 | Winding Slot Conductors: winding, slot parts: 96 compacted rectangular Litz conductors 7.7 x 8.05 insulated (1260 x 0.20 mm, Cu 39.6 mm2) - 24 diamond coils x 2 turns, double layer, pitch 1-11, 2 parallel paths (pole groups), 8 series turns / phase; APA 0.31 liner, APA 0.5 separator | 1 | make: rewind shop (form-wound coils, VPI class H) | Cu Litz 1260 x 0.20 + insulation | 273 x 199 x 199 mm (bbox) | own 5-axis CNC (user) | 10.72 | cad_out/variant_e/GENERATOR/E-G204_Winding_Slot_Conductors.step | winding spec docs/variant_e/02_generator.md section 6; mass from CAD volume
E-G205 | Winding End Turns Leads: end windings (VPI baskets, overhang 88 mm), front connection ring (series / parallel connections, brazed Cu lugs, glass-tape bound), 6 leads 2 x 70 mm2 silicone (U1 V1 W1 U2 V2 W2) through the lead window; 6 slot + 4 end-winding PT100 embedded | 1 | make: rewind shop | Cu Litz + VPI resin | 446 x 236 x 294 mm (bbox) | own 5-axis CNC (user) | 15.15 | cad_out/variant_e/GENERATOR/E-G205_Winding_End_Turns_Leads.step | mass from CAD volume
E-G206 | Slot Wedges x24: 24 slot wedges glass-epoxy EP GC 203, dovetail 10.1 x 1.9 in the notches, 273 long, driven in before VPI | 24 | make: milled strip (wedge profile: Krempel DE / Von Roll CH) | glass-epoxy EP GC 203 (IEC 60893) | 273 x 133 x 133 mm (bbox) | own 5-axis CNC (user) | 0.4 | cad_out/variant_e/GENERATOR/E-G206_Slot_Wedges_x24.step | mass from CAD volume
E-G210 | Generator Shaft: generator shaft one piece: magnet body d71 (screen seat 71 +0.10/+0.12), seal lands d50 h6, journals d40 js4, threads M35x1.5 (2), spacer seat d38, speed-wheel stub d30 k5, rear 1:10 taper d33 -> d30.6 x 24 for the quill hub, M12x1.25 pull-bolt thread, centres | 1 | make: 42CrMo4 +QT (Rm 1000) bar d80, CNC turn, grind journals / lands / taper in one setting between centres | steel (42CrMo4 QT / 34CrNiMo6 QT / S355 / 1.4034 per part) | 468 x 71 x 71 mm (bbox) | own 5-axis CNC (user) | 11.09 | cad_out/variant_e/GENERATOR/E-G210_Generator_Shaft.step | run-out journals <= 2 um, taper / journals coaxial <= 3 um; magnetic particle test; balance as an assembly; mass from CAD volume
E-G211 | Cu Eddy Screen: eddy-current screen sleeve 71/74 x 296 CuCr1Zr (CW106C, 43 MS/m): screens the steel shaft from the 6f / 12f bridge harmonics (950 -> 55 W) | 1 | make: CuCr1Zr tube / bar (KME DE, Wieland DE, Aurubis DE), turn; shrink 0.08-0.12 at 220 C, OD finish-ground 74 h5 on the shaft | CuCr1Zr (CW106C) | 296 x 74 x 74 mm (bbox) | own 5-axis CNC (user) | 0.9 | cad_out/variant_e/GENERATOR/E-G211_Cu_Eddy_Screen.step | mass from CAD volume
E-G212 | Magnet Segments x12: 12 Sm2Co17 arc segments 30 deg, r 37.03-53.0 x 272, each laminated from 136 slices 2.0 mm (insulating bond), parallel (diametral) magnetisation of the ring = segment-specific magnetisation angle (marked), bonded on the screen | 12 | buy: magnet maker to our drawing (order spec section 5) | Sm2Co17 laminated | 272 x 106 x 106 mm (bbox) | VAC (DE) VACOMAX / Shin-Etsu (JP) / Ningbo Yunsheng, Hangzhou Permanent Magnet Group, Xiamen Tungsten (CN) | 10.11 | cad_out/variant_e/GENERATOR/E-G212_Magnet_Segments_x12.step | mass from CAD volume
E-G213 | Magnet End Rings x2: end rings 74/106 x 12 (1.4404, non-magnetic): axial stop of the magnet stack, sleeve support, balance planes (12 x d4 radial correction holes, <= 3 deep) | 2 | make: 1.4404 bar d110, CNC turn; OD ground with the magnets (1:500 taper) | 1.4301 / 1.4404 / A4 | 296 x 106 x 106 mm (bbox) | own 5-axis CNC (user) | 0.85 | cad_out/variant_e/GENERATOR/E-G213_Magnet_End_Rings_x2.step | mass from CAD volume
E-G214 | CFRP Sleeve: retention sleeve 106/120 x 296: T800S-class carbon / high-Tg epoxy (Tg >= 190 C), 88 % hoop + 12 % +/-15 deg, taper press-fit 0.57 mm diametral interference (rotor chilled to -150 C), OD ground 120 h6 after pressing | 1 | buy: CFRP winding shop to our spec (eg_sleeve.json) + hot spin test 42,000 rpm | T800S / high-Tg epoxy | 296 x 120 x 120 mm (bbox) | Toray T800S / T700S (JP) or Zhongfu Shenying SYT55 (CN) fibre; winding: e+a (CH), BUCCI Composites (IT), CompoTech (CZ) | 1.16 | cad_out/variant_e/GENERATOR/E-G214_CFRP_Sleeve.step | mass from CAD volume
E-G215 | Precision Locknuts M35x1.5 x2: precision lock nuts M35x1.5 OD 52 x 12 with 2 radial clamping screws (bearing IR clamp 9 kN, 47 N.m) | 2 | buy: Spieth MSF 35x1.5 (DE) / SKF KMD 7 (SE) / GMN (DE) | steel (42CrMo4 QT / 34CrNiMo6 QT / S355 / 1.4034 per part) | 432 x 52 x 52 mm (bbox) |  | 0.24 | cad_out/variant_e/GENERATOR/E-G215_Precision_Locknuts_M35x1.5_x2.step | mass from override (bought / envelope)
E-G216 | Speed Phase Wheel: speed / phase wheel d60 x 10, 4 notches (2.33 kHz) + 1 deeper phase notch, on the d30 k5 stub, M8 centre screw | 1 | make: 1.4057 QT, turn + mill | steel (42CrMo4 QT / 34CrNiMo6 QT / S355 / 1.4034 per part) | 10 x 60 x 60 mm (bbox) | own 5-axis CNC (user) | 0.16 | cad_out/variant_e/GENERATOR/E-G216_Speed_Phase_Wheel.step | mass from CAD volume
E-G216b | Speed Wheel Screw M8: ISO 4762 M8x16 12.9 + Nord-Lock (speed wheel) | 1 | buy | steel (42CrMo4 QT / 34CrNiMo6 QT / S355 / 1.4034 per part) | 20 x 13 x 13 mm (bbox) |  | 0.01 | cad_out/variant_e/GENERATOR/E-G216b_Speed_Wheel_Screw_M8.step | mass from override (bought / envelope)
E-G219 | Front IR Spacer: spacer ring 52/38 x 7.5 between the front bearing IR and the lock nut (ground faces) | 1 | make: 1.4034 hardened, ground | steel (42CrMo4 QT / 34CrNiMo6 QT / S355 / 1.4034 per part) | 8 x 52 x 52 mm (bbox) | own 5-axis CNC (user) | 0.06 | cad_out/variant_e/GENERATOR/E-G219_Front_IR_Spacer.step | mass from override (bought / envelope)
E-G217 | Quill Hollow Taper AF24: hollow quill d30/19 x 180 with taper hub (1:10 bore, OD 56) and AF24 socket (rotary-broached, plasma-nitrided), float +/-1 mm on the crowned core hex | 1 | make: 34CrNiMo6 QT bar d60, deep-drill d19, turn + grind, lap the taper to the shaft, broach the hex, nitride, shot-peen the waist | steel (42CrMo4 QT / 34CrNiMo6 QT / S355 / 1.4034 per part) | 262 x 56 x 56 mm (bbox) | own 5-axis CNC (user) | 1.87 | cad_out/variant_e/GENERATOR/E-G217_Quill_Hollow_Taper_AF24.step | eg_rotor.json: tau 20.5 MPa rated, 103 MPa at 5 x; taper T_cap 716 N.m; mass from CAD volume
E-G218 | Quill Pull Bolt M12x1.25: quill pull bolt ISO 4762 M12x1.25x25 12.9 (56 kN, 90 N.m with MoS2), head on the hub wall inside the quill bore, tightened through the hollow quill | 1 | buy (Bossard CH / Wuerth DE) | steel (42CrMo4 QT / 34CrNiMo6 QT / S355 / 1.4034 per part) | 36 x 18 x 18 mm (bbox) |  | 0.05 | cad_out/variant_e/GENERATOR/E-G218_Quill_Pull_Bolt_M12x1.25.step | mass from override (bought / envelope)
E-G220 | Bearing 7008E front: hybrid angular-contact 7008-E (25 deg) P4, locating | 1 | buy | hybrid: Si3N4 balls, 100Cr6 / Cronidur rings, P4 | 15 x 68 x 68 mm (bbox) |  | 0.21 | cad_out/variant_e/GENERATOR/E-G220_Bearing_7008E_front.step | FAG HCB7008-E/C-T-P4S hybrid (or SKF 7008 CE/HCP4A, GMN HY S 7008, NSK 7008 hybrid, ZWZ / LYC hybrid); mass from override (bought / envelope)
E-G221 | Bearing 7008C rear: hybrid angular-contact 7008-C (15 deg) P4, floating + 300 N wave spring | 1 | buy | hybrid: Si3N4 balls, 100Cr6 / Cronidur rings, P4 | 15 x 68 x 68 mm (bbox) |  | 0.21 | cad_out/variant_e/GENERATOR/E-G221_Bearing_7008C_rear.step | FAG HCB7008-E/C-T-P4S hybrid (or SKF 7008 CE/HCP4A, GMN HY S 7008, NSK 7008 hybrid, ZWZ / LYC hybrid); mass from override (bought / envelope)
E-G222 | SFD Cartridge Front: front SFD cartridge (locating): OD 84.000 (0/-10) in 84.24 H6 (film 0.12-0.136), bore 68 H4, lip, 2 FKM O-ring grooves, d1.2 jet / feed, drain slot, pin slot | 1 | make: 1.4542 (17-4PH) H1025 bar d90, turn + internal / external grinding (same family as the core E-B120) | 1.4542 (17-4PH) H1025 | 24 x 84 x 84 mm (bbox) | own 5-axis CNC (user) | 0.36 | cad_out/variant_e/GENERATOR/E-G222_SFD_Cartridge_Front.step | mass from CAD volume
E-G223 | SFD Cartridge Rear: rear SFD cartridge (floating bearing): same OD / O-rings, lip for the wave spring, pin slot | 1 | make: 1.4542 H1025, turn + grind | 1.4542 (17-4PH) H1025 | 27 x 84 x 84 mm (bbox) | own 5-axis CNC (user) | 0.38 | cad_out/variant_e/GENERATOR/E-G223_SFD_Cartridge_Rear.step | mass from CAD volume
E-G224 | Wave Spring 300N: crest-to-crest wave spring 300 N (rear outer ring preload) | 1 | buy: Lesjofors (SE) / Scherdel (DE) / TFC (UK) | steel (42CrMo4 QT / 34CrNiMo6 QT / S355 / 1.4034 per part) | 4 x 68 x 68 mm (bbox) |  | 0.01 | cad_out/variant_e/GENERATOR/E-G224_Wave_Spring_300N.step | mass from override (bought / envelope)
E-G226 | Front Cartridge Shim: ground shim 84/69 x 0.5-2.0 (set at assembly): axial rotor position (magnet centre +/-0.3 mm to the stack) | 1 | make: 1.4034 hardened, surface-ground | 1.4301 / 1.4404 / A4 | 1 x 84 x 84 mm (bbox) | own 5-axis CNC (user) | 0.01 | cad_out/variant_e/GENERATOR/E-G226_Front_Cartridge_Shim.step | mass from override (bought / envelope)
E-G227 | Rear Spacer Tube: rear spacer tube 84/60 x 24.5: clamps the rear cartridge between the hub shoulder and the rear seal cap | 1 | make: 6082-T6, turn | EN AW-6082-T6 | 24 x 84 x 84 mm (bbox) | own 5-axis CNC (user) | 0.18 | cad_out/variant_e/GENERATOR/E-G227_Rear_Spacer_Tube.step | mass from CAD volume
E-G230 | Front End Bell: front end bell: disk + re-entrant hub (SFD bore 84.24 H6, 5-tooth labyrinth on the d50 land), spigot 290 g6 + FKM O-ring, 16 x d11 + 2 dowels + 2 x M10 jacking, 12 x d22 cooling-air inlets, 2 IR-pyrometer ports M12x1, oil feed (top, M10x1 ISO 6149) -> axial gallery -> jet, oil drain (bottom, G3/8), HELICOILs for cap / hood | 1 | make: 6082-T6 forged disc d340 x 110, CNC turning (spigot + hub bore one clamping) + 5-axis drilling | EN AW-6082-T6 | 93 x 330 x 330 mm (bbox) | own 5-axis CNC (user) | 3.86 | cad_out/variant_e/GENERATOR/E-G230_Front_End_Bell.step | hub bore 84.24 H6 coaxial to the spigot <= 0.01; labyrinth teeth tips d50.60; mass from CAD volume
E-G231 | Rear End Bell: rear end bell: disk + re-entrant hub (SFD bore 84.24 H6 for the floating bearing, labyrinth nose), spigot 286 g6 + O-ring, 16 x d11 + 2 dowels + 2 x M10 jacking, 12 x d22 cooling-air outlets to the plenum, 2 IR ports, oil feed / drain galleries, 6 x HELICOIL M6 for the seal cap + guard | 1 | make: 6082-T6 forged disc d340 x 110, CNC turning + 5-axis drilling | EN AW-6082-T6 | 93 x 330 x 330 mm (bbox) | own 5-axis CNC (user) | 3.9 | cad_out/variant_e/GENERATOR/E-G231_Rear_End_Bell.step | mass from CAD volume
E-G232 | Front Bearing Cap: front bearing cap: spigot clamps the front cartridge + bearing OR, covers nut / speed wheel, 2 axial speed-probe ports M12x1, d16 turning access, spigot O-ring 80 x 1.78, 6 x M6 | 1 | make: 6082-T6 bar d110 x 70, CNC turning | EN AW-6082-T6 | 59 x 102 x 102 mm (bbox) | own 5-axis CNC (user) | 0.57 | cad_out/variant_e/GENERATOR/E-G232_Front_Bearing_Cap.step | mass from CAD volume
E-G233 | Rear Seal Cap: rear seal cap: spigot clamps spacer + rear cartridge, 5-groove labyrinth on the quill hub d56 (0.30 radial), flange shared with the guard (6 x M6x30), spigot O-ring 80 x 1.78 | 1 | make: CuSn12 (rub-tolerant), CNC turning | CuSn12 | 24 x 102 x 102 mm (bbox) | own 5-axis CNC (user) | 0.81 | cad_out/variant_e/GENERATOR/E-G233_Rear_Seal_Cap.step | mass from CAD volume
E-G234 | Air Inlet Hood: cooling-air inlet hood: annular chamber r 66-138 over the 12 front air inlets, axial DN80 spigot, 8 internal bosses, 8 x M6x45 to the front end bell, EPDM foam gasket | 1 | make: 6082-T6 turned from bar d290 (or spun 4 mm + welded bosses) | EN AW-6082-T6 | 66 x 276 x 280 mm (bbox) | own 5-axis CNC (user) | 1.27 | cad_out/variant_e/GENERATOR/E-G234_Air_Inlet_Hood.step | mass from CAD volume
E-G235 | Quill Guard Tube: stationary quill guard d76/66 to x -98 (continues the impeller hub line) with flange on the rear seal cap and 4 vent slots 40 x 15 (guard interior at plenum pressure: no compressor-eye suction on the rear seal) | 1 | make: 1.4301 tube 76.1 x 5 + turned flange, TIG | 1.4301 / 1.4404 / A4 | 240 x 102 x 102 mm (bbox) | own 5-axis CNC (user) | 2.29 | cad_out/variant_e/GENERATOR/E-G235_Quill_Guard_Tube.step | mass from CAD volume
E-G270 | Screws ISO4762 M10x35 x32: ISO 4762 M10x35 A4-80, end bells -> housing (2 x 16), 29 N.m, Loctite 243 | 32 | buy (Bossard CH / Wuerth DE / Boellhoff DE) | 1.4301 / 1.4404 / A4 | 514 x 320 x 320 mm (bbox) |  | 0.96 | cad_out/variant_e/GENERATOR/E-G270_Screws_ISO4762_M10x35_x32.step | mass from override (bought / envelope)
E-G271 | HELICOIL M10 1.5D x32: HELICOIL plus M10 x 1.5D 1.4301 in the housing end faces | 32 | buy (Boellhoff DE) | 1.4301 / 1.4404 / A4 | 466 x 315 x 315 mm (bbox) |  | 0.1 | cad_out/variant_e/GENERATOR/E-G271_HELICOIL_M10_1.5D_x32.step | mass from override (bought / envelope)
E-G272 | Dowels ISO8734 8x24 x4: ISO 8734 8 m6 x 24 (1.4034 hardened) end bell / housing location | 4 | buy (Bossard CH / Halder DE) | steel (42CrMo4 QT / 34CrNiMo6 QT / S355 / 1.4034 per part) | 482 x 38 x 316 mm (bbox) |  | 0.04 | cad_out/variant_e/GENERATOR/E-G272_Dowels_ISO8734_8x24_x4.step | mass from override (bought / envelope)
E-G273 | Screws M6x20 front cap x6: ISO 4762 M6x20 A4-80 (front bearing cap), 6.0 N.m, HELICOIL M6 x 1.5D | 6 | buy | 1.4301 / 1.4404 / A4 | 26 x 91 x 104 mm (bbox) |  | 0.04 | cad_out/variant_e/GENERATOR/E-G273_Screws_M6x20_front_cap_x6.step | mass from override (bought / envelope)
E-G274 | Screws M6x30 rear cap guard x6: ISO 4762 M6x30 A4-80 (guard flange + rear seal cap -> rear hub), 6.0 N.m, HELICOIL M6 x 1.5D | 6 | buy | 1.4301 / 1.4404 / A4 | 34 x 91 x 104 mm (bbox) |  | 0.05 | cad_out/variant_e/GENERATOR/E-G274_Screws_M6x30_rear_cap_guard_x6.step | mass from override (bought / envelope)
E-G276 | Screws M6x45 hood x8: ISO 4762 M6x45 A4-80 (hood through its bosses into the front end bell), 4.5 N.m, HELICOIL M6 x 1D | 8 | buy | 1.4301 / 1.4404 / A4 | 52 x 239 x 239 mm (bbox) |  | 0.1 | cad_out/variant_e/GENERATOR/E-G276_Screws_M6x45_hood_x8.step | mass from override (bought / envelope)
E-G280 | O-rings Jacket 280x3.55 EPDM x4: ISO 3601-1 280 x 3.55 EPDM 70 (glycol), jacket lands, squeeze 19.7 %, stretch 1.5 % | 4 | buy (Freudenberg DE / Trelleborg SE / COG DE) | EPDM 70 (peroxide) | 335 x 290 x 290 mm (bbox) |  | 0.05 | cad_out/variant_e/GENERATOR/E-G280_O-rings_Jacket_280x3.55_EPDM_x4.step | mass from override (bought / envelope)
E-G281 | O-rings Spigots FKM x2: ISO 3601-1 280 x 3.55 (front) / 275 x 3.55 (rear) FKM 75, end-bell spigots | 2 | buy | FKM 75 | 457 x 290 x 290 mm (bbox) |  | 0.03 | cad_out/variant_e/GENERATOR/E-G281_O-rings_Spigots_FKM_x2.step | mass from override (bought / envelope)
E-G282 | O-rings SFD 77.5x2.65 FKM x4: ISO 3601-1 77.5 x 2.65 FKM 75, SFD centring (squeeze 12 %, ~3 N/um per cartridge - measure) | 4 | buy | FKM 75 | 401 x 84 x 84 mm (bbox) |  | 0.01 | cad_out/variant_e/GENERATOR/E-G282_O-rings_SFD_77.5x2.65_FKM_x4.step | mass from override (bought / envelope)
E-G283 | O-rings Caps 80x1.78 FKM x2: ISO 3601-1 80 x 1.78 FKM 75, radial on the front bearing cap / rear seal cap spigots (squeeze 14.6 %, stretch 1.5 %) | 2 | buy | FKM 75 | 489 x 84 x 84 mm (bbox) |  | 0.0 | cad_out/variant_e/GENERATOR/E-G283_O-rings_Caps_80x1.78_FKM_x2.step | mass from override (bought / envelope)
E-G284 | Cartridge Pins ISO8734 4x10 x2: ISO 8734 4 m6 x 10 anti-rotation pins (cartridges) | 2 | buy | steel (42CrMo4 QT / 34CrNiMo6 QT / S355 / 1.4034 per part) | 360 x 4 x 4 mm (bbox) |  | 0.0 | cad_out/variant_e/GENERATOR/E-G284_Cartridge_Pins_ISO8734_4x10_x2.step | mass from override (bought / envelope)
E-G240 | Terminal Box: terminal box 130 x 200 x 135 with a 10 mm saddle floor (r 165), 3 x M40 EMC glands (+y) for 6 x 95 mm2 cables, 2 x M25 signal glands, star bar, IP65 | 1 | make: 6082-T6 block, 3-axis milling (saddle face by ball-end) | EN AW-6082-T6 | 130 x 200 x 154 mm (bbox) | own 5-axis CNC (user) | 2.43 | cad_out/variant_e/GENERATOR/E-G240_Terminal_Box.step | mounted on 4 HELICOIL M8 in the housing; flat silicone gasket; mass from CAD volume
E-G241 | Terminal Box Lid: terminal box lid 6 mm, 8 x M5, IP65 gasket | 1 | make: 6082 plate, laser + mill | EN AW-6082-T6 | 130 x 200 x 6 mm (bbox) | own 5-axis CNC (user) | 0.42 | cad_out/variant_e/GENERATOR/E-G241_Terminal_Box_Lid.step | mass from CAD volume
E-G242 | PEEK Terminal Block 6 Studs: PEEK terminal block 100 x 120 x 20 with 6 brass studs M12 (U1 V1 W1 / U2 V2 W2), star bar on U2 V2 W2, creepage >= 12.5 mm | 1 | make: PEEK plate milled + CuZn39Pb3 studs | PEEK + CuZn39Pb3 | 100 x 120 x 60 mm (bbox) | own 5-axis CNC (user) | 0.35 | cad_out/variant_e/GENERATOR/E-G242_PEEK_Terminal_Block_6_Studs.step | mass from CAD volume
E-G243 | Screws M8 terminal box x4: ISO 4762 M8x25 A4-80, terminal box -> housing, 14 N.m, HELICOIL M8 x 1.5D | 4 | buy | 1.4301 / 1.4404 / A4 | 103 x 167 x 32 mm (bbox) |  | 0.06 | cad_out/variant_e/GENERATOR/E-G243_Screws_M8_terminal_box_x4.step | mass from override (bought / envelope)
E-G250 | Cooling Air Blower EC: EC high-pressure radial blower 160 m3/h at 4 kPa, 0.55 kW, integrated EC drive 0-10 V (speed = rotor-temperature actuator), outlet DN80 axial | 1 | buy: ebm-papst (DE) / Elektror (DE) / Becker (DE) / FPZ (IT) | steel (42CrMo4 QT / 34CrNiMo6 QT / S355 / 1.4034 per part) | 235 x 300 x 300 mm (bbox) |  | 18.0 | cad_out/variant_e/GENERATOR/E-G250_Cooling_Air_Blower_EC.step | mass from override (bought / envelope)
E-G250b | Blower Stand: blower stand (S355 angle frame 40 x 4) on the saddle base beam, 4 x M8 | 1 | make: S355, MAG | steel (42CrMo4 QT / 34CrNiMo6 QT / S355 / 1.4034 per part) | 190 x 220 x 397 mm (bbox) | own 5-axis CNC (user) | 6.0 | cad_out/variant_e/GENERATOR/E-G250b_Blower_Stand.step | mass from override (bought / envelope)
E-G251 | F9 Filter Cartridge: ePM1 80 % (F9) filter cartridge d200 x 230 on the blower inlet (plenum air already G4 + F7), dp switch | 1 | buy: Camfil (SE) / Freudenberg Viledon (DE) / MANN+HUMMEL (DE) | ePM1 80 % (F9) | 230 x 200 x 200 mm (bbox) |  | 1.2 | cad_out/variant_e/GENERATOR/E-G251_F9_Filter_Cartridge.step | mass from override (bought / envelope)
E-G252 | Air Bellows DN80: DN80 stainless bellows + 2 hose clamps (blower -> hood, decouples blower vibration) | 1 | buy: Witzenmann (DE) / BOA (DE) | 1.4301 / 1.4404 / A4 | 10 x 84 x 84 mm (bbox) |  | 0.5 | cad_out/variant_e/GENERATOR/E-G252_Air_Bellows_DN80.step | mass from override (bought / envelope)
E-G253 | IR Pyrometers x4: 4 IR pyrometers 8-14 um (2 per end, 1 used + 1 spare) on the CFRP sleeve ends, M12x1 heads, 4-20 mA | 4 | buy: Optris CSmicro LT (DE) / Calex PyroMini (UK) | 1.4301 / 1.4404 / A4 | 584 x 94 x 94 mm (bbox) |  | 0.2 | cad_out/variant_e/GENERATOR/E-G253_IR_Pyrometers_x4.step | mass from override (bought / envelope)
E-G254 | Speed Probes x2: 2 eddy-current speed + phase probes M12x1 (axial, gap 1.5 mm to the speed wheel) | 2 | buy: Jaquet (CH) DSE / Braun (DE) A5S | 1.4301 / 1.4404 / A4 | 66 x 12 x 60 mm (bbox) |  | 0.12 | cad_out/variant_e/GENERATOR/E-G254_Speed_Probes_x2.step | mass from override (bought / envelope)
E-G255 | Accelerometers x2: 2 IEPE accelerometers 100 mV/g on the end-bell rims (+y), M6 studs | 2 | buy: Bruel & Kjaer (DK) / Hansford (UK) / MMF (DE) | 1.4301 / 1.4404 / A4 | 506 x 40 x 22 mm (bbox) |  | 0.1 | cad_out/variant_e/GENERATOR/E-G255_Accelerometers_x2.step | mass from override (bought / envelope)
E-G256 | Fittings Glycol Oil x8: fittings: 2 x G3/4 glycol (ISO 1179-2 ED), 2 x G1/8 leak-off to the float switch, 2 x M10x1 oil feed (ISO 6149-3), 2 x G3/8 oil drain | 8 | buy: Hydac (DE) / Voss (DE) / Ham-Let (IL) | 1.4301 / 1.4404 / A4 | 502 x 395 x 385 mm (bbox) |  | 1.2 | cad_out/variant_e/GENERATOR/E-G256_Fittings_Glycol_Oil_x8.step | mass from override (bought / envelope)
E-G260 | Saddles x2: 2 saddles (S355 plate welded, cradle r 165 machined, shim packs under the feet, x / y jack bolts M16, x-slots for the 150 mm slide-out) | 2 | make: S355J2 plate 12/15, MAG, machine cradle + feet | steel (42CrMo4 QT / 34CrNiMo6 QT / S355 / 1.4034 per part) | 320 x 300 x 427 mm (bbox) | own 5-axis CNC (user) | 50.11 | cad_out/variant_e/GENERATOR/E-G260_Saddles_x2.step | mass from CAD volume
E-G261 | Saddle Clamp Straps x2: 2 clamp straps 50 x 6 (S355) with ears, 2 x M12 each (strap preload limited: Al housing) | 2 | make: S355 strip, rolled + welded ears | steel (42CrMo4 QT / 34CrNiMo6 QT / S355 / 1.4034 per part) | 300 x 350 x 272 mm (bbox) | own 5-axis CNC (user) | 3.2 | cad_out/variant_e/GENERATOR/E-G261_Saddle_Clamp_Straps_x2.step | mass from override (bought / envelope)
E-G262 | Saddle Base Beam: saddle base beam RHS 200 x 100 x 6.3 (S355J2H) x 970 on the plenum floor, bolted through the floor onto the frame cross members x -1050 / -600 / -200, carries saddles + blower | 1 | make: RHS cut + plates, MAG, galvanised | steel (42CrMo4 QT / 34CrNiMo6 QT / S355 / 1.4034 per part) | 970 x 200 x 100 mm (bbox) | own 5-axis CNC (user) | 27.53 | cad_out/variant_e/GENERATOR/E-G262_Saddle_Base_Beam.step | mass from CAD volume
E-G263 | Saddle Bolts M16 x4: ISO 4017 M16x40 8.8 + nuts inside the RHS (hand holes) + Nord-Lock (saddles -> base beam, 2 per saddle at y +/-60), 156 N.m | 4 | buy | steel (42CrMo4 QT / 34CrNiMo6 QT / S355 / 1.4034 per part) | 286 x 146 x 36 mm (bbox) |  | 0.64 | cad_out/variant_e/GENERATOR/E-G263_Saddle_Bolts_M16_x4.step | mass from override (bought / envelope)
E-G300 | raw material: 6082-T6 forged ring d340/280 x 480 (housing) + 2 forged discs d340 x 110 (end bells) + tube d300/250 x 350 (jacket) + bar d130 (caps, hood, box) | 1 | buy | EN AW-6082-T6 (EN 755 / EN 586 forgings) | ~160 kg stock | Hydro (NO), Constellium (FR), Otto Fuchs (DE), AMAG (AT) | 160.0 |  | machined on the user 5-axis CNC; ~25 % yield
E-G301 | raw material: 42CrMo4 +QT bar d80 x 500 (shaft), 34CrNiMo6 +QT d60 x 280 (quill), 1.4404 d110 x 40 (end rings), 1.4542 d90 x 80 (cartridges) | 1 | buy | EN 10083-3, ultrasonic tested (EN 10228-3 class 3) | see description | Deutsche Edelstahlwerke (DE), Saarstahl (DE), Ugitech (FR), Ovako (SE) | 35.0 |  | 3.1 certificates
E-G302 | raw material: CuCr1Zr (CW106C) tube / bar d80/68 x 310, solution annealed + aged | 1 | buy | EN 12163 / 12167, 75 % IACS, Rp0.2 >= 270 | d80 x 310 | KME (DE), Wieland (DE), Aurubis (DE) | 3.5
E-G310 | compacted rectangular Litz conductor 1260 x 0.20 mm (7 x 180 bunches), bare 7.30 x 7.65, insulated 7.70 x 8.05 (polyimide tape 2 x 25 um half-lap + glass serving) | 65 | buy | strands IEC 60317-0-2 grade 2, thermal class 200; Cu fill 0.71; DC R <= 0.443 mOhm/m at 20 C | m | Elektrisola (DE), Pack Feindraehte (DE), Rudolf Pack (DE), Furukawa Magnet Wire (JP) | 25.5 |  | length = 24 coils x 2 turns x MLT 1.104 m + 12 % + leads; polyimide film Kaneka Apical / Ube Upilex (JP)
E-G311 | slot liner + layer separator: aramid / polyimide / aramid (APA) laminate 0.31 mm (liners) and 0.50 mm (separators), class H 180 | 2 | buy | IEC 60626-3, class H | 2 m2 | Krempel (DE) AKAFLEX APA with Yantai Tayho Metastar (CN) / Teijin (JP) aramid + Kaneka (JP) polyimide; Von Roll (CH) | 1.2 |  | US trademark aramid / polyimide papers excluded on purpose
E-G312 | end-winding insulation: aramid paper 0.25 phase separators, glass-fibre tape (bands), polyester-free glass lacing cord, Litz lead sleeving (glass / silicone) | 1 | buy | class H | set | Krempel (DE), Von Roll (CH), Isovolta (AT) | 1.5
E-G313 | VPI resin class H (solvent-free epoxy / polyesterimide), 2 cycles + bake 160 C | 1 | buy / service | IEC 60455, class H 180 | ~20 kg in tank / 3 kg retained | Elantas (DE) Elmotherm / Von Roll (CH) Damisol, at the rewind shop | 3.0 |  | stator wound in the jacket after the shrink fit
E-G314 | lead cables 6 x 2 x 70 mm2 silicone (SiHF / Radox 180 C) 1 m + Cu tube lugs brazed to the coil ends, star bar Cu 30 x 5 | 1 | buy | EN 50525, 1.8 / 3 kV | 6 x 2 x 70 mm2 x 1 m | Huber+Suhner (CH) Radox, Lapp (DE) Oelflex Heat, Klauke (DE) lugs | 9.0
E-G315 | winding PT100: 6 slot RTDs (flat 3 x 10 x 100, class A, 3-wire, between the layers at mid-stack, 2 per phase) + 4 end-winding RTDs (coil noses) | 10 | buy | IEC 60751 class A, 3-wire, PTFE / glass leads 1.5 m | -50..200 C | Jumo (DE), WIKA (DE), Heraeus Nexensos (DE) | 0.2 |  | 3 slot + 2 end-winding duty, rest spare
E-G320 | magnetising + laminating of the 12 Sm2Co17 arc segments (136 x 2 mm slices each, insulating epoxy >= 1 kOhm, ground to arc 37.03 / 53.0 + taper allowance), marked magnetisation angle | 1 | service (magnet maker) | Br 1.10-1.13 T, HcJ >= 1990 kA/m, Hk/HcJ >= 0.70, (BH)max >= 230 kJ/m3, tol. arc +/-0.02, length +/-0.05 | 12 segments | Shin-Etsu (JP), Ningbo Yunsheng (CN), Hangzhou Permanent Magnet Group (CN), VAC (DE) | 0.0 |  | order spec docs/variant_e/02_generator.md section 5
E-G321 | CFRP sleeve winding on a 1:500 tapered mandrel + post-cure + ID / OD grinding, rotor press-fit (rotor chilled -150 C, 320 kN press, stroke-controlled interference 0.57 +/-0.02) | 1 | service | T800S (or T700S) / epoxy Tg >= 190 C, Vf 0.60, 88 % hoop + 12 % +/-15 deg | ID 106 x 7 x 296 | e+a Elektromaschinen (CH), BUCCI Composites (IT), CompoTech (CZ), Toray (JP) fibre | 0.0 |  | eg_sleeve.json
E-G322 | hot spin test 120 % (42,000 rpm, rotor 100 C, vacuum pit, 2 min) + OD growth / balance check before / after | 1 | service | IEC 60034-1 clause 9.7 / API 541-like | 42,000 rpm | Schenck RoTec (DE) spin test centre, e+a (CH) | 0.0 |  | acceptance: no permanent OD growth > 5 um, balance change < G1
E-G323 | balancing of the rotor assembly G1 (2 planes, soft-bearing machine), re-check after the spin test (acceptance G2.5) | 1 | service | ISO 21940-11 | U_G1 = 7.3 g mm | Schenck (DE), CIMAT (PL), own machine | 0.0 |  | eg_rotor.json
E-G324 | stator stack: OD cylindrical grinding after bonding (262.240 0/-0.025) | 1 | service | Ra 0.8 | d262 x 270 | lamination maker or local grinding shop | 0.0
E-G330 | dry cooler for the generator loop: dry cooler, 1 x EC axial fan d450-500 (2000 m3/h, 150 W), Cu tube / Al fin coil 2 rows ~0.6 m2 face, UA >= 450 W/K at full fan, MEG 35 %, dp <= 30 kPa at 30 L/min; candidates Guentner (DE) GDF / GFH compact, LU-VE (IT) EHL, Thermokey (IT), Kelvion (DE) | 1 | buy | design duty 2439 W at 47 C air, glycol 55 C supply | UA >= 450 W/K | Guentner (DE), LU-VE (IT), Thermokey (IT), Kelvion (DE) | 45.0 |  | replaces the generator share of E-W100
E-G331 | glycol pump ECM wet-rotor 30 L/min at 105 kPa, 0-10 V speed | 1 | buy | PN10, 110 C | 147 W | Grundfos (DK) MAGNA3 25-120 / Wilo (DE) Stratos MAXO | 9.0
E-G332 | 3-way mixing valve DN25 kvs 6.3 + modulating actuator 0-10 V (30 s) | 1 | buy | PN10 | DN25 | ESBE (SE) VRG131 + ARA, Belimo (CH) | 3.0 |  | L1 supply-temperature loop
E-G333 | expansion vessel 12 L + safety valve 3 bar + fill / drain + automatic air vent + Y-strainer 0.5 mm + 2 kW immersion heater (cold start / anti-condensation) | 1 | buy | PN6 | 12 L | Reflex (DE), Flamco (NL), Afriso (DE) | 12.0
E-G334 | glycol vortex flow meter + flow switch, 4-20 mA | 1 | buy | 5-60 L/min | DN20 | Huba Control (CH) 210, SIKA (DE) VVX | 0.6 |  | FT-G01
E-G335 | glycol piping DN25 stainless 1.4404 press-fit (2 x 10 m) + insulated hoses to the pod (2 x 1.5 m, EPDM), isolating ball valves | 1 | buy | PN10 | 2 x 10 m | Geberit Mapress (CH), Viega (DE) | 25.0
E-G336 | MEG 35 % vol inhibited (first fill ~30 L) | 30 | buy | Antifrogen N / Glysantin G48 | L | Clariant (CH/DE), BASF (DE) | 31.0
E-G337 | glycol PT100 sensors (pod in / out, supply after the valve, return) in thermowells | 4 | buy | IEC 60751 class A, 4-wire | G1/2 thermowell | Jumo (DE), WIKA (DE) | 0.6 |  | TT-G01..04
E-G338 | leak detection: expansion-tank level switch + float switch on the pod leak-off drains | 2 | buy | 24 V dc | - | Jola (DE), Kobold (DE) | 0.4 |  | LS-G01 / LS-G02
E-G340 | cooling-air dp transmitter (filter + generator) 0-5 kPa + filter dp switch | 2 | buy | 4-20 mA | 0-5 kPa | Huba Control (CH) 699, Kalinsky (DE) | 0.4 |  | PDT-A01
E-G341 | cooling-air PT100 (blower outlet, generator air outlet) | 2 | buy | class A | M10 probe | Jumo (DE) | 0.2
E-G350 | contactor K1 (generator -> diode bridge) 500 A AC-1 / 690 V and K2 (generator -> start inverter) 150 A, mechanically interlocked | 1 | buy | IEC 60947-4-1 | 500 A + 150 A | ABB (CH/SE) AF-series, Siemens (DE) 3RT | 12.0 |  | K2 opens before K1 closes at 55 % speed
E-G351 | sine filter for the start inverter (<= 500 Hz output, 150 A, f_sw 4-8 kHz): protects the Litz winding from PWM edges and keeps the start rotor losses low | 1 | buy | dU/dt < 500 V/us, THD_u < 5 % | 150 A, 690 V | Schaffner (CH) FN5040HV, Block (DE), Mdexx (DE) | 45.0 |  | only in the start path
E-G352 | insulation monitoring device on the IT DC link (generator + bridge + AFE) | 1 | buy | IEC 61557-8 | 0-1000 V dc | Bender (DE) iso685 | 0.5 |  | alarm 100 kOhm / trip 30 kOhm
E-G353 | cable glands M40 EMC (3) + M25 signal (2) + EMC screen clamps | 5 | buy | IP68 | M40 / M25 | Pflitsch (DE) blueglobe, Lapp (DE) Skintop | 0.6 |  | power cables: E-G190 of variant_e_bom.csv
E-G354 | signal cabling: 22 x PT100 / IR / speed / vibration cores, screened, to the ECU / PLC | 1 | buy | LiYCY | ~25 m | Lapp (DE), Helukabel (DE) | 4.0
E-G360 | adhesives / locking: Loctite AA 326 + 7649 (magnets), 648 (end rings), 243 (screws), MoS2 paste (pull bolt), PTFE dry film (sleeve press), silicone grease (EPDM O-rings) | 1 | buy | - | set | Henkel (DE), Klueber Lubrication (DE), OKS (DE) | 1.0
E-G361 | oil-jet nozzles d1.2 (2) + oil hoses DN8 / DN12 to the lube unit (feed 2 x, drain 2 x) | 1 | make / buy | 1.4404, ISO 6149-3 | set | own CNC; hoses Hydac (DE) | 1.5 |  | generator jets 2.5 L/min each at 2.5 barg from E-L100
E-G370 | tool: stator shrink oven / heater ring 180 C for the jacket + lifting mandrel for the stator stack | 1 | make / buy | - | d300 | local | 0.0
E-G371 | tool: rotor insertion guide (PTFE film 0.5 mm in the gap + guide plates on both spigots with bronze bushes on the journals) - magnetic pull 0.13 N/um | 1 | make | Al + PTFE | - | own CNC | 0.0
E-G372 | tool: LN2-vapour chill box for the rotor (-150 C) + 100 t servo press with stroke / force recording + split push ring for the sleeve | 1 | service / make | - | - | sleeve supplier or local press shop | 0.0
E-G373 | tool: AF10 x 300 hex bit + torque wrench 20-200 N.m (pull bolt through the hollow quill), M14 jacking screw, KMD hook spanner, bearing induction heater 80 C | 1 | buy | - | - | Hazet (DE), Gedore (DE), SKF (SE) TIH | 0.0
E-G374 | tool: pod slide-out rails + 2 t chain hoist / jib in the plenum, alignment dial-indicator bracket on the quill socket | 1 | make | S355 | - | own | 0.0
