ahmadreza221/aurora-cchp/docs/bom/variant_e_bom.csv

tag | description | qty | make_or_buy | material_or_spec | size_or_rating | supplier_candidates | mass_kg | model_file | notes
E-B110 | Bearing Housing: bearing housing: front flange to the back plate (12 x M12), bores 84.24 H6 for the SFD cartridges ground in one setting, rear flange for the heat shield / nozzle stack (12 x M10), seal bore d50.8 (piston rings), oil-jet drillings, drain d16 at the bottom | 1 | make (42CrMo4 forged bar d340 x 200, CNC turning + drilling) | steel (42CrMo4 QT / P265GH / S355 per part) | 190 x 330 x 330 mm (bbox) | precision CNC turning + internal grinding | 46.11 | cad_out/variant_e/BEARING/E-B110_Bearing_Housing.step | subsystem BEARING, mass from CAD volume
E-B120 | SFD Cartridge Front: front SFD cartridge for the tandem pair: OD 84 (0.12 mm film), 2 O-ring grooves (FKM 84x3), jet holes, anti-rotation pin | 1 | make | 1.4542 (17-4PH) H1025 | 32 x 84 x 84 mm (bbox) | precision CNC turning + internal grinding | 0.49 | cad_out/variant_e/BEARING/E-B120_SFD_Cartridge_Front.step | subsystem BEARING, mass from CAD volume
E-B121 | SFD Cartridge Rear: rear SFD cartridge (floating bearing), same OD/O-rings as the front | 1 | make | 1.4542 (17-4PH) H1025 | 26 x 84 x 84 mm (bbox) | precision CNC turning + internal grinding | 0.4 | cad_out/variant_e/BEARING/E-B121_SFD_Cartridge_Rear.step | subsystem BEARING, mass from CAD volume
E-B122 | Wave Spring Rear: wave spring 300 N preload on the rear bearing outer ring (envelope) | 1 | buy | steel (42CrMo4 QT / P265GH / S355 per part) | 6 x 68 x 68 mm (bbox) | Lesjofors (SE), Scherdel (DE) | 0.02 | cad_out/variant_e/BEARING/E-B122_Wave_Spring_Rear.step | crest-to-crest wave spring, Lesjofors (SE) / Scherdel (DE); subsystem BEARING, mass from override (bought / envelope)
E-K110 | Combustor Casing DN300: can casing DN300 (323.9 x 7.1) z 460..1160 + 2 weld-neck flanges PN10 (OD 445, 12 x M20), igniter boss M18x1.5 | 1 | make (EN 10216-2 P265GH pipe + EN 1092-1 flanges, welded; PED) | steel (42CrMo4 QT / P265GH / S355 per part) | 445 x 445 x 740 mm (bbox) | pipe / flange fabrication (PED), sheet laser + rolling + TIG; alloy sheet VDM Metals (DE) | 62.76 | cad_out/variant_e/COMBUSTOR/E-K110_Combustor_Casing_DN300.step | subsystem COMBUSTOR, mass from CAD volume
E-K111 | Top Cover: blind-flange top cover DN300 PN10 with the gas-lance bore d32, UV sight port, 3 liner hanger seats; lift off with the liner + injector for inspection (no engine strip) | 1 | make (EN 1092-1 blind flange, drilled) | steel (42CrMo4 QT / P265GH / S355 per part) | 445 x 445 x 25 mm (bbox) | pipe / flange fabrication (PED), sheet laser + rolling + TIG; alloy sheet VDM Metals (DE) | 29.38 | cad_out/variant_e/COMBUSTOR/E-K111_Top_Cover.step | subsystem COMBUSTOR, mass from CAD volume
E-K120 | Liner D210: liner d210 x 1.5, L 588 + dome: primary 8 x d23.3, secondary 12 x d17.4, dilution 10 x d28, 4 film-cooling rows | 1 | make (2.4951 alloy 75 (VDM) sheet, flat patterns laser-cut, rolled + TIG; dome turned) | 2.4951 (alloy 75) | 210 x 210 x 591 mm (bbox) | pipe / flange fabrication (PED), sheet laser + rolling + TIG; alloy sheet VDM Metals (DE) | 5.28 | cad_out/variant_e/COMBUSTOR/E-K120_Liner_D210.step | subsystem COMBUSTOR, mass from CAD volume
E-K121 | Axial Swirler: axial swirler hub 50 / tip 110, 12 flat vanes 45 deg (envelope) | 1 | make (turned rings + laser-cut vanes, brazed) | 2.4665 (alloy X) | 110 x 110 x 16 mm (bbox) | pipe / flange fabrication (PED), sheet laser + rolling + TIG; alloy sheet VDM Metals (DE) | 0.99 | cad_out/variant_e/COMBUSTOR/E-K121_Axial_Swirler.step | subsystem COMBUSTOR, mass from CAD volume
E-K122 | Liner Hangers x3: 3 liner hanger rods d12 from the dome to the cover (liner hangs, grows downward into the transition collar) | 3 | make | 2.4665 (alloy X) | 151 x 132 x 69 mm (bbox) | pipe / flange fabrication (PED), sheet laser + rolling + TIG; alloy sheet VDM Metals (DE) | 0.19 | cad_out/variant_e/COMBUSTOR/E-K122_Liner_Hangers_x3.step | subsystem COMBUSTOR, mass from CAD volume
E-K130 | Transition Cone: diffusing conical transition d210 -> d270 (2 mm alloy X), collar slides over the liner, piston-ring seal in the hot-plenum inlet | 1 | make (rolled cone + turned collar, TIG) | 2.4665 (alloy X) | 274 x 274 x 215 mm (bbox) | pipe / flange fabrication (PED), sheet laser + rolling + TIG; alloy sheet VDM Metals (DE) | 2.64 | cad_out/variant_e/COMBUSTOR/E-K130_Transition_Cone.step | subsystem COMBUSTOR, mass from CAD volume
E-K140 | Gas Lance: central gas lance d30: 8 radial jets d4.5 into the swirler exit, flanged head with G3/4 gas inlet | 1 | make (1.4404 + 2.4665 tip) | 1.4301 / 1.4404 | 60 x 110 x 170 mm (bbox) | pipe / flange fabrication (PED), sheet laser + rolling + TIG; alloy sheet VDM Metals (DE) | 2.0 | cad_out/variant_e/COMBUSTOR/E-K140_Gas_Lance.step | subsystem COMBUSTOR, mass from CAD volume
E-K150 | Igniter: spark igniter M18x1.5 in a cooled sleeve, primary zone | 1 | buy (industrial gas-engine plug NGK / MOTORTECH + HV capacitive coil) | 1.4301 / 1.4404 | 18 x 150 x 18 mm (bbox) | NGK (JP) industrial plug + MOTORTECH (DE) coil | 0.4 | cad_out/variant_e/COMBUSTOR/E-K150_Igniter.step | subsystem COMBUSTOR, mass from override (bought / envelope)
E-K160 | UV Flame Scanner: UV flame scanner on the cover sight port (envelope) | 1 | buy (DURAG D-LX 100 class / Siemens QRA) | EN AW-6082-T6 (wheel: 2618-T61) | 50 x 50 x 95 mm (bbox) | DURAG (DE), Siemens (DE) | 0.8 | cad_out/variant_e/COMBUSTOR/E-K160_UV_Flame_Scanner.step | subsystem COMBUSTOR, mass from override (bought / envelope)
E-C110 | Inlet Shroud Cover: inlet cover: elliptic bellmouth (r 305 -> 92), shroud contour (0.45 mm tip gap), diffuser front wall x -7.4, front flange to the plenum rear wall (16 x M12) | 1 | make (6082-T6 forged disc d660 x 150, CNC turning; shroud finish-turned with the wheel drawing) | EN AW-6082-T6 (wheel: 2618-T61) | 143 x 660 x 660 mm (bbox) | CNC turning + 4-axis milling shop; forgings: local or Otto Fuchs (DE) | 49.5 | cad_out/variant_e/COMPRESSOR/E-C110_Inlet_Shroud_Cover.step | subsystem COMPRESSOR, mass from CAD volume
E-C130 | Back Plate Diffuser Deswirl: back plate: wheel back-face wall (2 mm gap), 17 straight wedge diffuser vanes (r 146 -> 236, 2.5D), inner wall of the bend, 23 deswirl vanes in the annulus r 261..305 (4th-axis 2.5D), back-face labyrinth bore r 36 | 1 | make (6082-T6 forged disc d620 x 120, CNC turning + 2.5D / 4-axis milling) | EN AW-6082-T6 (wheel: 2618-T61) | 119 x 610 x 608 mm (bbox) | CNC turning + 4-axis milling shop; forgings: local or Otto Fuchs (DE) | 26.77 | cad_out/variant_e/COMPRESSOR/E-C130_Back_Plate_Diffuser_Deswirl.step | subsystem COMPRESSOR, mass from CAD volume
E-C150 | Outer Casing Bend: outer casing: outer wall of the 90 deg bend (R60) + annulus r 305, rear flange to the cool casing (16 x M20), front spigot on the inlet cover; 2 trunnion pads = FIXED engine support | 1 | make (P355NL1 forged ring d820 x 160, CNC turning + milling of the pads) | steel (42CrMo4 QT / P265GH / S355 per part) | 155 x 800 x 800 mm (bbox) | CNC turning + 4-axis milling shop; forgings: local or Otto Fuchs (DE) | 66.33 | cad_out/variant_e/COMPRESSOR/E-C150_Outer_Casing_Bend.step | subsystem COMPRESSOR, mass from CAD volume
E-X110 | Diffuser Cone: 10 deg conical diffuser d262 -> d428 (3 mm 1.4828), slip collar d282 with piston ring over the shroud tail, end flange; outside 100 mm ceramic blanket + 1.4301 cladding (not modelled) | 1 | make (rolled 1.4828 sheet + turned collar / flange, TIG) | 1.4828 (309-type heat resistant) | 990 x 540 x 540 mm (bbox) | sheet fabrication (1.4828), local | 38.88 | cad_out/variant_e/EXHAUST/E-X110_Diffuser_Cone.step | subsystem EXHAUST, mass from CAD volume
E-X120 | Elbow DN450 Flange: 90 deg elbow DN450 (457 x 6.3), R 450, inlet flange to the cone, outlet flange DN450 PN6 EN 1092-1 (verify: OD 640, PCD 585, 16 x M20) facing up | 1 | make (5-segment mitred 1.4828 pipe or bought EN 10253 elbow + flanges) | 1.4828 (309-type heat resistant) | 795 x 640 x 773 mm (bbox) | sheet fabrication (1.4828), local | 87.2 | cad_out/variant_e/EXHAUST/E-X120_Elbow_DN450_Flange.step | subsystem EXHAUST, mass from CAD volume
E-X121 | Elbow Turning Vanes x2: 2 turning vanes in the elbow (3 mm, at R 370 / 530), welded to the elbow sides | 2 | make (rolled strip) | 1.4828 (309-type heat resistant) | 532 x 390 x 532 mm (bbox) | sheet fabrication (1.4828), local | 13.07 | cad_out/variant_e/EXHAUST/E-X121_Elbow_Turning_Vanes_x2.step | subsystem EXHAUST, mass from CAD volume
E-F110 | Base Frame RHS: welded base frame RHS 200 x 100 x 6.3 (S355J2H, EN 10219): 2 rails x -2100..2250 at y +/-550, 5 outriggers under the plenum, 6 cross members; lifting at the 4 rail ends (lugs not modelled) | 1 | make (MAG on a table, hot-dip galvanised) | steel (42CrMo4 QT / P265GH / S355 per part) | 4350 x 1900 x 200 mm (bbox) | steel fabrication shop, hot-dip galvanising | 695.14 | cad_out/variant_e/FRAME/E-F110_Base_Frame_RHS.step | subsystem FRAME, mass from CAD volume
E-F120 | Fixed Pedestals x2: 2 FIXED pedestals under the outer-casing trunnion pads (x 50..95): 2 x M20 + 2 dowels each | 2 | make (S355 plate box) | steel (42CrMo4 QT / P265GH / S355 per part) | 45 x 800 x 620 mm (bbox) | steel fabrication shop, hot-dip galvanising | 12.39 | cad_out/variant_e/FRAME/E-F120_Fixed_Pedestals_x2.step | subsystem FRAME, mass from CAD volume
E-F121 | Sliding Pedestals x2: 2 SLIDING pedestals under the cool-casing pads: PTFE / bronze slide plate, M20 shoulder bolts in x-slots (thermal growth ~2 mm) | 2 | make (S355) | steel (42CrMo4 QT / P265GH / S355 per part) | 30 x 840 x 630 mm (bbox) | steel fabrication shop, hot-dip galvanising | 10.39 | cad_out/variant_e/FRAME/E-F121_Sliding_Pedestals_x2.step | subsystem FRAME, mass from CAD volume
E-F122 | Exhaust Saddles x3: 3 saddles under the diffuser cone (2) and the elbow (1): slide plates, insulated pads | 3 | make (S355) | steel (42CrMo4 QT / P265GH / S355 per part) | 762 x 320 x 524 mm (bbox) | steel fabrication shop, hot-dip galvanising | 112.94 | cad_out/variant_e/FRAME/E-F122_Exhaust_Saddles_x3.step | subsystem FRAME, mass from CAD volume
E-F130 | AV Mounts x8: 8 rubber-metal AV mounts (~800 kg rated each, f_n ~10 Hz), M16 | 8 | buy (Trelleborg SE / Freudenberg (Vibracoustic) DE / Getzner AT) | NR / steel | 4270 x 1220 x 100 mm (bbox) | Trelleborg (SE), Vibracoustic (DE), Getzner (AT) | 28.0 | cad_out/variant_e/FRAME/E-F130_AV_Mounts_x8.step | subsystem FRAME, mass from override (bought / envelope)
E-G110 | Pod Housing: pod housing tube OD 320 / bore 280 H7 with 2 glycol ports G1/2 | 1 | make (6082-T6 thick tube or forged ring, CNC turning) | EN AW-6082-T6 (wheel: 2618-T61) | 365 x 320 x 345 mm (bbox) | CNC turning shop; Al bar / tube local | 18.64 | cad_out/variant_e/GENERATOR/E-G110_Pod_Housing.step | subsystem GENERATOR, mass from CAD volume
E-G111 | Front End Bell: front end bell: SFD bore 84.24 (locating bearing), oil jet + drain, Hall speed pickup, spigot into the housing | 1 | make (6082-T6 bar d330, CNC turning) | EN AW-6082-T6 (wheel: 2618-T61) | 100 x 320 x 320 mm (bbox) | CNC turning shop; Al bar / tube local | 20.5 | cad_out/variant_e/GENERATOR/E-G111_Front_End_Bell.step | subsystem GENERATOR, mass from CAD volume
E-G112 | Glycol Jacket: glycol jacket sleeve (helical groove 12 x 6, 4 O-rings), stator shrunk in | 1 | make (6082 tube, turned) | EN AW-6082-T6 (wheel: 2618-T61) | 345 x 280 x 280 mm (bbox) | CNC turning shop; Al bar / tube local | 15.22 | cad_out/variant_e/GENERATOR/E-G112_Glycol_Jacket.step | subsystem GENERATOR, mass from CAD volume
E-G113 | Rear End Bell: rear end bell: SFD bore (floating bearing + wave spring), labyrinth to the rotor, guard-tube flange face | 1 | make (6082-T6, CNC turning) | EN AW-6082-T6 (wheel: 2618-T61) | 65 x 320 x 320 mm (bbox) | CNC turning shop; Al bar / tube local | 13.3 | cad_out/variant_e/GENERATOR/E-G113_Rear_End_Bell.step | subsystem GENERATOR, mass from CAD volume
E-G120 | Stator Core: stator core 24 slots, bore 125, OD 240, stack 190 (0.20 mm NO20 laminations, bonded) | 1 | buy (lamination stack from a motor-lamination maker: Surahammar SE / Kienle+Spiess DE / Baosteel CN) | 0.20 mm NO20 electrical steel | 190 x 240 x 240 mm (bbox) | Surahammars Bruk (SE), Kienle+Spiess (DE), Euro Group (IT), Baosteel (CN) | 38.33 | cad_out/variant_e/GENERATOR/E-G120_Stator_Core.step | subsystem GENERATOR, mass from CAD volume
E-G121 | Winding End Turns: Litz winding 3-ph, 2 parallel paths, end turns (envelopes), VPI class H, 3 x PT100 | 1 | make (winding shop) - or with the active-parts kit (e+a CH) | Cu Litz, class H | 345 x 236 x 236 mm (bbox) | winding shop (local) or e+a (CH) active-parts kit | 21.54 | cad_out/variant_e/GENERATOR/E-G121_Winding_End_Turns.step | subsystem GENERATOR, mass from CAD volume
E-G130 | Generator Shaft: generator shaft, integral d80 magnet body, d40 journals, quill flange face (6 x M8 + 2 dowels) | 1 | make (42CrMo4 QT, turn + grind) | steel (42CrMo4 QT / P265GH / S355 per part) | 495 x 80 x 80 mm (bbox) | CNC turning shop; Al bar / tube local | 14.25 | cad_out/variant_e/GENERATOR/E-G130_Generator_Shaft.step | subsystem GENERATOR, mass from CAD volume
E-G131 | Magnets Sleeve: Sm2Co17 segments 80/108 x 190 + T700 carbon sleeve 6 mm (OD 120) + 1.4404 end rings (envelope) | 1 | buy magnets (VAC DE / Shin-Etsu JP / Chinese 2:17) + sleeve winding (e+a CH or local CFRP shop) | Sm2Co17 + carbon/epoxy | 214 x 120 x 120 mm (bbox) | magnets VAC (DE) / Shin-Etsu (JP) / Ningbo Ketian (CN); sleeve: e+a (CH) or a CFRP winding shop; Toray T700 fibre (JP) | 9.41 | cad_out/variant_e/GENERATOR/E-G131_Magnets_Sleeve.step | subsystem GENERATOR, mass from CAD volume
E-G135 | KM7 Nut Speed Wheel: precision locknut KM7 + 2-tooth speed / phase wheel | 1 | buy nut (SKF KMT 7 / FAG) + make wheel | steel (42CrMo4 QT / P265GH / S355 per part) | 32 x 70 x 70 mm (bbox) | SKF (SE) / FAG (DE) KM7 locknut | 0.35 | cad_out/variant_e/GENERATOR/E-G135_KM7_Nut_Speed_Wheel.step | subsystem GENERATOR, mass from override (bought / envelope)
E-G140 | Bearing 7008E front: hybrid 7008-E locating | 1 | buy | hybrid: Si3N4 balls, 100Cr6 / Cronidur rings, P4 | 15 x 68 x 68 mm (bbox) | same as E-R110a | 0.21 | cad_out/variant_e/GENERATOR/E-G140_Bearing_7008E_front.step | FAG HCB7008-C/E-T-P4S (or SKF 7008 CE/HCP4A, GMN HY, NSK 7008 hybrid); subsystem GENERATOR, mass from override (bought / envelope)
E-G141 | Bearing 7008C rear: hybrid 7008-C floating + wave spring | 1 | buy | hybrid: Si3N4 balls, 100Cr6 / Cronidur rings, P4 | 15 x 68 x 68 mm (bbox) | same as E-R110a | 0.21 | cad_out/variant_e/GENERATOR/E-G141_Bearing_7008C_rear.step | FAG HCB7008-C/E-T-P4S (or SKF 7008 CE/HCP4A, GMN HY, NSK 7008 hybrid); subsystem GENERATOR, mass from override (bought / envelope)
E-G142 | SFD Cartridge Front: front SFD cartridge (same OD as the core cartridges) | 1 | make | 1.4542 (17-4PH) H1025 | 30 x 84 x 84 mm (bbox) | CNC turning shop; Al bar / tube local | 0.47 | cad_out/variant_e/GENERATOR/E-G142_SFD_Cartridge_Front.step | subsystem GENERATOR, mass from CAD volume
E-G143 | SFD Cartridge Rear: rear SFD cartridge | 1 | make | 1.4542 (17-4PH) H1025 | 27 x 84 x 84 mm (bbox) | CNC turning shop; Al bar / tube local | 0.42 | cad_out/variant_e/GENERATOR/E-G143_SFD_Cartridge_Rear.step | subsystem GENERATOR, mass from CAD volume
E-G150 | Quill AF24 Socket: quill d30 x 208 with flange (6 x M8 12.9 + 2 dowels to the shaft) and AF24 socket (rotary-broached, nitrided), float +/-1 mm | 1 | make (34CrNiMo6 QT, turn + grind + broach; shot-peened waist) | steel (42CrMo4 QT / P265GH / S355 per part) | 268 x 70 x 70 mm (bbox) | CNC turning shop; Al bar / tube local | 2.3 | cad_out/variant_e/GENERATOR/E-G150_Quill_AF24_Socket.step | subsystem GENERATOR, mass from CAD volume
E-G160 | Quill Guard Tube: stationary quill guard d76 (continues the impeller hub line), flanged to the rear end bell | 1 | make (1.4301 tube + turned flange) | 1.4301 / 1.4404 | 272 x 120 x 120 mm (bbox) | CNC turning shop; Al bar / tube local | 2.93 | cad_out/variant_e/GENERATOR/E-G160_Quill_Guard_Tube.step | subsystem GENERATOR, mass from CAD volume
E-G170 | Terminal Box: terminal box: 3 power studs M12 on PEEK, PT100 / PTC, M50 EMC glands for 3 x 240 mm2 (or 2 x 120 per phase) | 1 | make (6082 block, milled) | EN AW-6082-T6 (wheel: 2618-T61) | 140 x 160 x 121 mm (bbox) | CNC turning shop; Al bar / tube local | 6.47 | cad_out/variant_e/GENERATOR/E-G170_Terminal_Box.step | subsystem GENERATOR, mass from CAD volume
E-G180 | Pod Saddles x2: 2 saddle feet on the plenum floor (shims + jack bolts for alignment to the core shaft; slide-out rails for removal) | 2 | make (S355 plate, welded) | steel (42CrMo4 QT / P265GH / S355 per part) | 380 x 240 x 537 mm (bbox) | CNC turning shop; Al bar / tube local | 80.58 | cad_out/variant_e/GENERATOR/E-G180_Pod_Saddles_x2.step | subsystem GENERATOR, mass from CAD volume
E-I110 | Intake Plenum: clean-air plenum 1910 x 1900 x 1300 (3 mm 1.4301, stiffened), rear wall with the bellmouth opening d644, top opening 1830 x 1830; V ~0.7 m/s inside; generator pod on its feet inside; access door (not modelled) | 1 | make (sheet metal, laser + brake + MAG, bolted panels) | 1.4301 / 1.4404 | 1910 x 1900 x 1300 mm (bbox) | sheet-metal shop (laser, brake, MAG) | 318.25 | cad_out/variant_e/INTAKE/E-I110_Intake_Plenum.step | subsystem INTAKE, mass from CAD volume
E-I120 | Filter Interface Frame: filter-bank interface: 3 x 3 holding-frame grid 610 pitch for 592 x 592 cells (G4 panel + F7 V-cell), knife-edge seal face; filter house / weather hood bolts on top (plant scope) | 1 | make (flat bar + angle, welded) | 1.4301 / 1.4404 | 1910 x 1900 x 15 mm (bbox) | sheet-metal shop (laser, brake, MAG) | 50.35 | cad_out/variant_e/INTAKE/E-I120_Filter_Interface_Frame.step | subsystem INTAKE, mass from CAD volume
E-R100 | Compressor Wheel D270 env: compressor impeller D2 270, inducer 173/76, b2 15.5, 9+9 backswept -38 deg (ENVELOPE, blades filled) | 1 | buy (TC-class spare wheel, bored H6 to d40) | EN AW-6082-T6 (wheel: 2618-T61) | 124 x 270 x 270 mm (bbox) | Accelleron (CH) TPS52/57-F spare wheel; MAN ES / PBS Turbo (DE/CZ) TCR16/18; MHI-MME (JP) MET18-22; Chinese TC makers (milled 2618 wheels) | 5.6 | cad_out/variant_e/ROTOR/E-R100_Compressor_Wheel_D270_env.step | Al 2618-T61; Accelleron TPS52/57-F, MAN/PBST TCR16/18, MHI MET18-22 class (diameter ESTIMATE); subsystem ROTOR, mass from override (bought / envelope)
E-R101 | Core Shaft: core shaft: crowned AF24 drive hex, M33x2 clamp thread, d40 seat + journals, d50 seal runner (3 piston-ring grooves), d50/30 heat dam; 42CrMo4 QT, journals ground, hex gas-nitrided; turbine wheel friction-welded at x 248 by the supplier | 1 | make (turn + grind) / weld by wheel supplier | steel (42CrMo4 QT / P265GH / S355 per part) | 388 x 50 x 50 mm (bbox) | precision CNC turning + grinding shop (user), heat treat + nitriding (local) | 3.75 | cad_out/variant_e/ROTOR/E-R101_Core_Shaft.step | subsystem ROTOR, mass from CAD volume
E-R102 | Spacer Sleeve: clamped spacer sleeve d60/40 x 122.5 between the bearings (stiffens the stack) | 1 | make (turn + grind faces) | 1.4542 (17-4PH) H1025 | 122 x 60 x 60 mm (bbox) | precision CNC turning + grinding shop (user), heat treat + nitriding (local) | 1.5 | cad_out/variant_e/ROTOR/E-R102_Spacer_Sleeve.step | subsystem ROTOR, mass from CAD volume
E-R103 | Slinger Seal Ring: oil slinger + back-face labyrinth ring d70/40 x 15 (r_seal 35, thrust trim) | 1 | make | 1.4542 (17-4PH) H1025 | 15 x 70 x 70 mm (bbox) | precision CNC turning + grinding shop (user), heat treat + nitriding (local) | 0.3 | cad_out/variant_e/ROTOR/E-R103_Slinger_Seal_Ring.step | subsystem ROTOR, mass from CAD volume
E-R104 | Clamp Nut M33: clamp nut M33x2, OD 56 x 18, 60 kN preload (hydraulic stretch or heat) | 1 | make (34CrNiMo6) | steel (42CrMo4 QT / P265GH / S355 per part) | 18 x 56 x 56 mm (bbox) | precision CNC turning + grinding shop (user), heat treat + nitriding (local) | 0.24 | cad_out/variant_e/ROTOR/E-R104_Clamp_Nut_M33.step | subsystem ROTOR, mass from CAD volume
E-R110a | Bearing 7008E front1: hybrid ceramic angular-contact spindle bearing 40x68x15, front tandem pair #1 (envelope) | 1 | buy | hybrid: Si3N4 balls, 100Cr6 / Cronidur rings, P4 | 15 x 68 x 68 mm (bbox) | Schaeffler FAG (DE), SKF (SE), GMN (DE), NSK (JP), ZWZ / LYC (CN) | 0.21 | cad_out/variant_e/ROTOR/E-R110a_Bearing_7008E_front1.step | FAG HCB7008-C/E-T-P4S (or SKF 7008 CE/HCP4A, GMN HY, NSK 7008 hybrid); subsystem ROTOR, mass from override (bought / envelope)
E-R110b | Bearing 7008E front2: hybrid ceramic angular-contact spindle bearing 40x68x15, front tandem pair #2 (envelope) | 1 | buy | hybrid: Si3N4 balls, 100Cr6 / Cronidur rings, P4 | 15 x 68 x 68 mm (bbox) | same as E-R110a | 0.21 | cad_out/variant_e/ROTOR/E-R110b_Bearing_7008E_front2.step | FAG HCB7008-C/E-T-P4S (or SKF 7008 CE/HCP4A, GMN HY, NSK 7008 hybrid); subsystem ROTOR, mass from override (bought / envelope)
E-R111 | Bearing 7008C rear: hybrid ceramic angular-contact spindle bearing 40x68x15, rear floating (envelope) | 1 | buy | hybrid: Si3N4 balls, 100Cr6 / Cronidur rings, P4 | 15 x 68 x 68 mm (bbox) | same as E-R110a | 0.21 | cad_out/variant_e/ROTOR/E-R111_Bearing_7008C_rear.step | FAG HCB7008-C/E-T-P4S (or SKF 7008 CE/HCP4A, GMN HY, NSK 7008 hybrid); subsystem ROTOR, mass from override (bought / envelope)
E-T101 | Turbine Wheel D288 env: radial/mixed-flow turbine wheel D4 288, b4 30, exducer 232/75, 12 blades, nose cone (ENVELOPE, blades filled) | 1 | buy (TC-class cast wheel, friction-welded to E-R101 by the supplier) | IN713LC / K418 cast | 112 x 288 x 288 mm (bbox) | Accelleron (CH) TPS57/61-F; MAN ES / PBST (DE/CZ) TCR18/20; MHI (JP); IHI (JP); Changzhou E&E Turbo-Power (CN, cast K418 + friction welding) | 15.0 | cad_out/variant_e/ROTOR/E-T101_Turbine_Wheel_D288_env.step | cast IN713LC / K418 (MAR-M247 option); TPS57/61-F, TCR18/20 class (ESTIMATE); subsystem ROTOR, mass from override (bought / envelope)
E-T110 | Heat Shield Support: turbine-end heat shield + nozzle support: 2 x 1.5 mm IN625 discs with ceramic paper, bolted to the bearing-housing rear flange; bore r 27 round the seal runner | 1 | make (sheet + TIG, turned rims) | 2.4856 | 12 x 428 x 428 mm (bbox) | CNC shop; alloy plate / forgings VDM Metals (DE), Aubert & Duval (FR); sheet fabrication + TIG (local) | 4.5 | cad_out/variant_e/TURBINE/E-T110_Heat_Shield_Support.step | subsystem TURBINE, mass from override (bought / envelope)
E-T120 | Nozzle Ring 19v: 19-vane radial nozzle ring: straight 2.5D vanes (r 206 -> 158, alpha3 75 deg, throat ~12 mm, b 30) between two side plates | 1 | make (2.4665 forged ring, 3-axis pocket milling; cover plate bolted) | 2.4665 (alloy X) | 36 x 428 x 428 mm (bbox) | CNC shop; alloy plate / forgings VDM Metals (DE), Aubert & Duval (FR); sheet fabrication + TIG (local) | 5.27 | cad_out/variant_e/TURBINE/E-T120_Nozzle_Ring_19v.step | subsystem TURBINE, mass from CAD volume
E-T130 | Shroud Diffuser Inlet: turbine shroud (0.55 mm tip gap, shimmed) + diffuser inlet ring to x 495 (5 deg); piston-ring seal in the cool-casing rear wall; flange to the nozzle front plate | 1 | make (2.4856 forged ring, CNC turning) | 2.4856 | 214 x 428 x 428 mm (bbox) | CNC shop; alloy plate / forgings VDM Metals (DE), Aubert & Duval (FR); sheet fabrication + TIG (local) | 35.47 | cad_out/variant_e/TURBINE/E-T130_Shroud_Diffuser_Inlet.step | subsystem TURBINE, mass from CAD volume
E-T140 | Hot Plenum: floating 360 deg hot plenum (3 mm alloy X): round top inlet d280 for the transition (piston ring), inner slot feeding the nozzle ring; radially free inside the cool casing | 1 | make (rolled + pressed sheet, TIG; inner rings turned) | 2.4665 (alloy X) | 290 x 690 x 690 mm (bbox) | CNC shop; alloy plate / forgings VDM Metals (DE), Aubert & Duval (FR); sheet fabrication + TIG (local) | 33.2 | cad_out/variant_e/TURBINE/E-T140_Hot_Plenum.step | subsystem TURBINE, mass from CAD volume
E-T150 | Cool Pressure Casing: cool pressure casing OD 760 x 8 (compressor air ~212 C, 4 bar round the hot parts): front flange to the outer casing, rear wall with the shroud seal bore, DN300 PN10 combustor stub, 2 SLIDING support pads | 1 | make (P265GH plate rolled + welded, flanges turned; PED cat. II) | steel (42CrMo4 QT / P265GH / S355 per part) | 445 x 840 x 840 mm (bbox) | CNC shop; alloy plate / forgings VDM Metals (DE), Aubert & Duval (FR); sheet fabrication + TIG (local) | 113.93 | cad_out/variant_e/TURBINE/E-T150_Cool_Pressure_Casing.step | subsystem TURBINE, mass from CAD volume
E-R105 | piston rings for the turbine-end seal runner d50 (3 grooves) | 3 | buy | TC piston ring, spheroidal cast iron / Ni-resist | d50.8 x 2 | TC maker spare (Accelleron / MAN-PBST), Chinese TC aftermarket | 0.01 |  | seal bore E-B110 x 222..235
E-R106 | balancing: rotor G1 (core) / G1 (generator) as assemblies, high-speed balance of the core stack | 1 | service | ISO 21940-11 G1 | 35,000 rpm | Schenck (DE) service / own balancing machine | 0.0 |  | mark angles; re-balance after any wheel change
E-R107 | friction / EB weld of the turbine wheel to E-R101 + journals ground to the wheel | 1 | service | turbo practice | - | wheel supplier (Changzhou E&E CN / TC maker) | 0.0 |  | spin test 120 % (42,000 rpm) after welding
E-B130 | O-rings for the 4 SFD cartridges | 8 | buy | FKM 75 ShA | 84 x 3 (ID 78) | Freudenberg (DE), Trelleborg (SE), ERIKS (NL) | 0.01 |  | stiffness ~3 N/um per cartridge - measure on a rig
E-B131 | oil-jet nozzles (core 3, generator 2) + gallery plugs | 5 | make | 1.4404, d1.2 jets | M8x1 | precision CNC | 0.01 |  | 2.5 barg, ~2.5 L/min per bearing
E-B132 | anti-rotation pins for the cartridges | 4 | buy | ISO 8734 hardened dowel | d4 x 12 | Bossard (CH), Wurth (DE) | 0.0
E-B133 | load washer behind the front cartridge (thrust measurement, rig + field) | 1 | buy | piezo / strain-gauge ring | ID 70 OD 84, 5 kN | Kistler (CH), HBK (DE) | 0.05 |  | net thrust must stay forward at all points
E-H100 | flange bolts: inlet cover / plenum (16 x M12), outer casing / cool casing (16 x M20 A193 B16 + nuts), BH / back plate (12 x M12), BH / heat shield (12 x M10 A286) | 1 | buy | ISO 4762 / 4014 12.9, A193 B16, A286 hot | set | Bossard (CH), Wurth (DE), Bohlhoff (DE) | 8.0 |  | torques in the assembly procedure (docs/variant_e/00 section 7)
E-H101 | gaskets: cool-casing flange (spiral wound), DN300 PN10 x 2 (spiral wound), DN450 PN6 exhaust (graphite / mica), cone/elbow flange | 5 | buy | EN 1514-2 spiral wound 1.4541/graphite | DN300, DN450, d800 | Klinger (AT), Frenzelit (DE) | 3.0
E-H102 | piston-ring seals hot side: transition / plenum (d274), shroud / cool-casing rear wall (d282), cone collar (d282) | 3 | buy / make | 2.4665 split ring | d274-282 x 3 | local CNC | 0.2 |  | allow 2-4 mm thermal growth
E-H103 | thermal insulation: hot plenum / cool casing inside (ceramic paper), exhaust cone + elbow outside (100 mm blanket + 1.4301 cladding) | 1 | buy | AES / PCW blanket 128 kg/m3 | ~8 m2 | Morgan Thermal Ceramics (UK), Promat (BE), RATH (AT) | 45.0 |  | touch temperature < 60 C
E-L100 | lube-oil unit: 80 L tank, pressure + scavenge gear-pump set 30 L/min (motor 0.75 kW), duplex 10 um filter, relief / pressure-control valve, heater 1 kW | 1 | buy | ISO VG 32 synthetic turbine oil | 30 L/min, 2.5 barg | Rickmeier / KRACHT (DE) pumps, HYDAC / Argo-Hytos (DE) filters | 85.0 |  | feed/drain lines through the top / bottom deswirl vanes; breather to a mist separator
E-L101 | rundown oil accumulator / gravity tank for coast-down after a black-out (35k -> 0 in ~3-5 min) | 1 | buy | bladder accumulator 10 L + check valve | 10 L, 4 bar | HYDAC (DE), Bosch Rexroth (DE) | 15.0 |  | mandatory for rolling bearings at 35k without grid
E-L102 | oil / glycol plate heat exchanger (~8 kW) + thermostatic valve | 1 | buy | brazed plate 1.4401 | 8 kW | Alfa Laval (SE), Kelvion (DE), Funke (DE) | 6.0
E-L103 | oil-mist separator on the bearing-chamber vent | 1 | buy | coalescer | 100 L/min air | Hengst (DE), UT99 (CH) | 4.0
E-L104 | synthetic turbine oil first fill | 90 | buy | ISO VG 32 (Shell Turbo T32 / Castrol Perfecto T32 / TotalEnergies Preslia GT) | L | Shell (NL/UK), Castrol (UK), TotalEnergies (FR) | 78.0 |  | change by analysis, ~8000 h
E-W100 | glycol loop: pump (0.4 kW), 3-way valve, expansion vessel, dry cooler ~35 kW (PMG 4 + converter 10 + oil 8 kW + margin) with EC fans | 1 | buy | MEG 35 % | 30-60 L/min, inlet <= 45 C | Grundfos (DK) / Wilo (DE); Guntner (DE), LU-VE (IT), Thermokey (IT) | 180.0 |  | fans ~1.1 kW in the aux budget
E-G190 | power cables PMG -> drive cabinet (3 x 2 x 120 mm2, EMC screened, 1 kV) + glands | 1 | buy | NSGAFOU / EMC | ~15 m | Nexans (FR), Lapp (DE), Prysmian (IT) | 60.0
E-D100 | drive cabinet: 6-pulse diode bridge (or 12-pulse) 500 A, DC link, 400 V-class IGBT active front end supply unit + LCL filter (~350 kVA), DC fuses, main breaker | 1 | buy | 400 V 50 Hz grid side, DC 620-850 V | 315 kW continuous, eta 0.97 | ABB ACS880-207 (FI/CH), Danfoss VACON NXA (DK/FI), Siemens SINAMICS S120 ALM (DE), Ingeteam (ES), Inovance (CN); diodes Semikron Danfoss / Infineon (DE) | 450.0 |  | no frequency changer >= 600 Hz (dual-use 3A225); grid code / protection relay per the utility
E-D101 | start inverter module on the DC bus (<= 500 Hz, ~45-75 kW) + contactor to the PMG terminals | 1 | buy | standard inverter unit | 45-75 kW, f_out <= 320 Hz | ABB ACS880-104, Danfoss VACON NXI, Siemens S120 Motor Module | 60.0 |  | motors to ~55 % speed, light-off ~22 %, opens before the diode bridge conducts (~79 %)
E-D102 | braking chopper + resistor (load rejection, ~350 kW for 3 s) | 1 | buy | IGBT chopper + air resistor | 350 kW / 3 s | Danotherm (DK), Cressall (UK), ABB / Danfoss option | 90.0 |  | clamps the DC bus at ~860 V, fuel cut within 0.1 s
E-D103 | black-start battery on the DC bus (optional) | 1 | buy | LFP 50 kWh, 650-800 V | 50 kWh | BYD (CN), CATL (CN), Northvolt (SE) | 450.0 |  | only if the site must start without the grid
E-C100 | engine control unit (own board, KiCad) + safety PLC: speed / TIT / overspeed / flame / gas / oil / vibration trips, sequencer, power control | 1 | make + buy | own STM32-class ECU + SIL2 safety relay / PLC | - | own design; PLC: Siemens S7-1500F (DE), B&R (AT), Pilz (DE) | 15.0 |  | overspeed trip 37,800 rpm (108 %) independent of the ECU
E-S100 | speed pickups (2 core on the nut wheel / 2 generator on the speed wheel) | 4 | buy | eddy-current / Hall, 1-4 kHz | M12 x 1 | Jaquet (CH), Braun (DE) | 0.4
E-S101 | EGT thermocouples in the diffuser inlet (TIT calculated from EGT + P3) | 6 | buy | type K mineral-insulated d3, 2.4816 sheath | 0-1000 C | JUMO (DE), Endress+Hauser (CH), Thermo-Electra (NL) | 0.6
E-S102 | pressure transmitters: P1 (plenum), P2, P3, P4 (nozzle), p6, filter dp, gas, oil | 8 | buy | 4-20 mA, 0.25 % | various | WIKA (DE), Keller (CH), Danfoss (DK) | 2.0
E-S103 | vibration: 2 accelerometers on the bearing housing, 2 on the pod; bearing RTDs PT100 x 5 | 9 | buy | IEPE 100 mV/g; PT100 class A | - | Hansford (UK), Bruel & Kjaer Vibro (DE/DK), IFM (DE) | 1.0 |  | trend for the bearing exchange plan
E-S104 | gas flow meter (thermal mass or Coriolis), gas temperature | 1 | buy | DN25-40 | 0-300 m3/h | Endress+Hauser (CH), KROHNE (DE) | 6.0 |  | heat-rate monitoring
E-F100 | gas train: ball valve, filter 50 um, 2 safety shut-off valves (class A), pressure regulator, metering valve (actuated), pressure switches, vent valve, flame arrestor | 1 | buy | EN 161 / EN 88-1 / EN 746-2 | DN40, 200-240 m3/h, 3.5-5 barg in | Dungs (DE), Pietro Fiorentini (IT), Madas (IT), Siemens (DE) VGD + SKP actuators | 45.0 |  | leak test 1.5 x; gas need 3.73 barg at the skid
E-F101 | gas booster (on demand when the supply < 3.8 barg), oil-free, with bypass | 1 | buy | oil-free piston / scroll gas compressor, ATEX | ~240 m3/h, +0.5..1 bar, ~1-3 kW | Haug Kompressoren (CH), Mehrer (DE), Bauer (DE) | 120.0 |  | runs ~never at 4 barg nominal supply
E-I130 | filter cells: 9 x G4 panel 592 x 592 x 48 + 9 x F7 (ISO ePM1 55 %) V-cell 592 x 592 x 292 | 18 | buy | EN ISO 16890 | 3400 m3/h rated each (used at 31 %) | Camfil (SE), Freudenberg Viledon (DE), MANN+HUMMEL (DE) | 90.0 |  | change F7 at ~120 Pa (our flow); filter house + weather hood = plant scope
E-I131 | plenum access door with seal + latch, intake silencer splitters (optional) | 1 | make | 1.4301 | 600 x 1000 | sheet-metal shop | 25.0 |  | pod removal path
E-P100 | acoustic / weather enclosure with ventilation fan (~1 kW) and fire detection | 1 | make / buy | galvanised steel + mineral wool | ~5 x 2.6 x 3 m | local package builder | 1500.0 |  | NEXT STEP - not designed in this round
E-P101 | exhaust CHP heat exchanger / absorption-chiller generator (DN450 inlet), stack | 1 | buy | ~1.4 MW at 525 C -> 90 C | 3.0 kg/s | plant scope (docs/hvac) | 0.0 |  | back pressure <= 1.2 kPa (cycle basis)
