ahmadreza221/aurora-cchp/docs/bom/variant_d2_generator_bom.csv

tag | description | qty | make_or_buy | material_or_spec | size_or_rating | supplier_candidates | mass_kg | model_file | notes
G-200 | Pod housing (cup): OD 110, front flange OD 128, jacket bore 98 H7 / 96 H7, integral rear wall with the rear bearing seat 28 H6, labyrinth bores, quill-guard counterbore, port bosses, lead-out slot, strut / fairing / box threads | 1 | make: CNC lathe (bores 98/96/28 and the 28 H6 seat in ONE clamping from the front) + 4th-axis milling of the bosses and holes | EN AW-6082-T6 (AlSi1MgMn), bar d130 x 160 (or forged ring d130/40 x 160) | d128 x 152 (x -260..-108) | bar: Hydro (NO), Constellium (FR), Alu Menziken (CH); machining: precision CNC shop | 1.4624 | cad_out/variant_d/D2/POD/G-200_Pod_Housing.step | coaxiality 28 H6 to 98 H7 <= 0.01; Helicoils: 6 x M5 (flange), 3 x M6 2D (struts), 3 x M4 (fairing), 4 x M4 (box), 1 x M6 (VE-012); hard-anodise not needed; O-ring bores Ra 0.8, edges of cross holes deburred R0.3
G-202 | Front cover / end bell: front bearing seat 28 H6, chamber for the locknut, labyrinth bore, M16x1.5 access plug, oil jet / drain, PT100, accelerometer pad, Hall sensor port, face O-ring groove, 6 x d5.5 + 2 dowels + 2 x M5 jack-off threads | 1 | make: CNC lathe (28 H6 seat and d98 g6 spigot in one clamping) + 4th-axis milling of bosses / holes; inclined d2 jet drilling | EN AW-6082-T6, bar d130 x 32 | d128 x 28 (x -286..-258) | bar: Hydro (NO), Constellium (FR); machining: precision CNC shop | 0.6979 | cad_out/variant_d/D2/POD/G-202_Front_Cover.step | replaces front end shield + bearing cover + nose cap (3 parts -> 1); spigot d98 g6 x 2 + 2 dowels -> front/rear bearing seats coaxial <= 0.015
G-201 | Glycol jacket sleeve: helical groove 8 x 3 mm, pitch 10.5, 8 turns (thread-milled / single-point turned), 2 O-ring grooves; stator shrunk in | 1 | make: CNC lathe (helix single-point turned like a coarse thread) | EN AW-6082-T6, tube d100/80 x 100 (or bar d100) | d98 / 96 / ID 88 H6 x 96 | tube: Alu Menziken (CH), Hydro (NO) | 0.2079 | cad_out/variant_d/D2/GENERATOR/G-201_Glycol_Jacket_Sleeve.step | press fit in G-200: d98 n6 / H7 (front land) and d96 n6 / H7 (rear land); stator shrink fit 0.10-0.13 mm diametral (heat sleeve to 130 C)
G-210 | Stator core 12 slots, ID 39 / OD 88 x 80, self-bonding laminations (no welding seams, no key) | 1 | buy as a bonded stack (laser cut 0.10 mm + backlack bonding) to our drawing | NO10 / 10JNEX900 0.10 mm, backlack bonded | 88 h6 / 39 x 80 | Kienle + Spiess (DE), Euro Group (IT); steel Cogent / Surahammar (SE), JFE (JP) | 1.672 | cad_out/variant_d/D2/GENERATOR/G-210_Stator_Core_12slot.step | OD ground 88.110-88.130 after bonding (shrink fit 0.098-0.130 in 88 H6)
G-211 | Stator winding: 3-ph double layer, 12 coils x 5 turns, 5/6 pitch, Litz, slot liners Nomex 0.2, vacuum-potted end turns, 3 x PT100 + 1 PTC in the end turns, leads 3 x 6 mm2 + 8 signal wires out through the lead-out slot | 1 | make: local motor-rewind shop (wound after the core is shrunk into G-201) | Litz 0.1 mm strands, class H | 20 turns/phase, 425 V ll at 115k, 38 A | Litz: Pack Feindraehte (DE), Elektrisola (DE); resin Elantas (DE); Nomex alt.: Krempel (DE) | 0.6859 | cad_out/variant_d/D2/GENERATOR/G-211_Stator_Winding_Litz.step | end-turn envelope modelled solid
G-230 | SFD bearing cartridge (identical part front / rear): bore 22 H5, land 27.80 g5 (0.10 mm film in the 28 H6 seat), 2 O-ring grooves, d0.8 oil jet from the land, 3 mm drain slot, lip with an anti-rotation slot | 2 | make: lathe + internal / external grinding | 17-4PH H1025 (1.4542) bar d30 | d27.8 / 22 x 9.5 | bar: Deutsche Edelstahlwerke (DE), Ugitech (FR); precision CNC shop | 0.0127 | cad_out/variant_d/D2/GENERATOR/G-230_SFD_Cartridge_x2.step | front: lip forward + 1.5 mm ground shim G-232 (locating by the rear spring preload); rear: lip rearward + wave spring G-233
G-232 | Ground shim 22/19.2 x 1.5 (front cartridge, between the lip and the outer ring; grind to set the rotor axial position) | 1 | make: surface-ground washer | 1.4034 hardened or 100Cr6 | 22 / 19.2 x 1.50 (+/-0.005) | precision CNC shop | 0.0011 | cad_out/variant_d/D2/GENERATOR/G-232_Front_Bearing_Shim.step | set the magnet-to-stator axial centring to +/-0.3 mm
G-233 | Single-turn wave spring OD 21.8 / ID 19.2, 60 N at 1.5 mm working height (rear bearing preload) | 1 | buy | 17-7PH / 1.4568 | bore 22, 60 N | TFC (UK) Crest-to-Crest, Gutekunst (DE) | 0.0011 | cad_out/variant_d/D2/GENERATOR/G-233_Wave_Spring_Rear_60N.step | constant-force preload; replace with the bearings
G-231 | Spindle bearing 10x22x6 hybrid (Si3N4 balls) 15 deg, P4, single, universal | 2 | buy | rings 100Cr6, balls Si3N4, PEEK/phenolic cage | 71900 C / P4, n.dm 1.84e6 | FAG HCB71900-C-T-P4S (DE), SKF 71900 CE/HCP4A (SE), GMN HY S61900 C TA (DE), NSK (JP) | 0.0086 | cad_out/variant_d/D2/GENERATOR/G-231_Bearing_71900_hybrid_x2.step | shaft d10 js4, cartridge bore 22 H5; replace every 8000 h
G-234 | Anti-rotation pin, cartridge -> housing / cover | 2 | buy | ISO 8734 2 m6 x 6, 1.4034 hardened | d2 x 6 | Bossard (CH), Boellhoff (DE), Halder (DE) | 0.0001 | cad_out/variant_d/D2/GENERATOR/G-234_Dowel_ISO8734_2x6_x2.step | pressed into the housing / cover, 1 mm into the lip slot
G-235 | SFD centring O-rings (4 = 2 per cartridge) | 4 | buy | ISO 3601-1 23.6 x 1.80 class A, FKM 75 ShA | groove d24.9 x 2.4 wide, squeeze 14 %, stretch 5.5 % | Freudenberg (DE), Trelleborg (SE), COG (DE) | 0.0005 | cad_out/variant_d/D2/GENERATOR/G-235_O-ring_23.6x1.8_FKM_x4.step | sets 1-2 N/um support stiffness (measure); replace at every bearing change
G-236 | Jacket O-rings: front 92.5 x 2.65 (bore 98), rear 90 x 2.65 (bore 96; stepped bore so no O-ring crosses a port) | 2 | buy | ISO 3601-1 92.5 x 2.65 + 90 x 2.65 class A, EPDM 70 (glycol) | groove depth 2.05, width 3.6, squeeze 23 % | Freudenberg (DE), Trelleborg (SE), COG (DE) | 0.0024 | cad_out/variant_d/D2/GENERATOR/G-236_O-rings_Jacket_92.5x2.65_90x2.65.step
G-237 | Face O-ring front cover / housing (seals the rotor cavity) | 1 | buy | ISO 3601-1 103 x 1.80 class A, FKM 75 | groove d102.6 / 107.8 x 1.30 deep | Freudenberg (DE), COG (DE) | 0.0019 | cad_out/variant_d/D2/GENERATOR/G-237_O-ring_Face_103x1.8.step
G-220 | Magnet carrier d20 / bore 10 x 112 | 1 | make: lathe + cylindrical grind (OD 20 h5, bore 10 H5) | 42CrMo4 QT (1.7225), bar d22 | d20/10 x 112 | Ovako (SE), DEW (DE); precision CNC shop | 0.2072 | cad_out/variant_d/D2/GENERATOR/G-220_Magnet_Carrier.step | bore 10 -0.004/-0.010 on the shaft 10 js4 (2.8-11.3 um interference): heat the carrier assembly to 150 C; 60 N.m slip torque
G-221 | Rotor magnets Sm2Co17, ring 20/30 x 82 as 2 half shells x 4 axial pieces, diametral (2-pole) magnetisation | 1 | buy | Sm2Co17, Br >= 1.08 T, Hcj >= 1800 kA/m, Ni-free (bonded) | ID 20.05 / OD 30.08 (ground for the sleeve) x 82 | VAC VACOMAX (DE), Magnetfabrik Bonn (DE), Shin-Etsu (JP) | 0.2705 | cad_out/variant_d/D2/GENERATOR/G-221_Magnets_Sm2Co17.step | bonded with Loctite AA 326 + activator 7649 (Henkel DE)
G-222 | Retaining sleeve, hoop-wound carbon fibre 3 mm, pressed on the ground magnets (0.08 mm diametral interference) | 1 | buy (wound tube, ID ground) + press on a 1:200 conical mandrel | T700 / T800 carbon-epoxy, Tg >= 180 C | ID 30.00 / OD 36.00 x 88 | fibre Toray (JP); tubes CG Tec (DE), Carbon-Werke (DE) | 0.0438 | cad_out/variant_d/D2/GENERATOR/G-222_Carbon_Sleeve.step | hoop 417 MPa at 115k / 600 MPa at 138k, allowable 1600 MPa; OD finish-ground after pressing
G-223 | Magnet end rings = balance planes 1 / 2 (radial d2 balance drillings, max 1.5 deep) | 2 | make: lathe | 1.4404 (non-magnetic), bar d32 | d30/20 x 3 | precision CNC shop | 0.0094 | cad_out/variant_d/D2/GENERATOR/G-223_End_Rings_x2.step | pressed on the carrier, Loctite 648
G-224 | Generator through-shaft d10 + collar d14 (3 teeth) + quill waist d6 x 54 + socket hub OD 12 with internal AF6 x 12 (30 deg lead-in) + AF5 turning socket in the front end; one piece | 1 | make: lathe + cylindrical grinding (journals d10 js4, waist polished Ra 0.2, R3 fillets, shot-peened); AF6 and AF5 rotary-broached; socket plasma-nitrided | 17-4PH H1025 (1.4542), bar d16 x 245 | d14 / 10 / 6 x 235.5 | bar: DEW (DE), Ugitech (FR); rotary broach Hommel+Keller (DE); nitriding Buderus / Bodycote-EU (DE) | 0.1262 | cad_out/variant_d/D2/GENERATOR/G-224_Gen_Shaft_Quill_d6x54.step | the quill is a fuse: tau 50 MPa rated, 200 MPa at a x4 fault; a broken quill = replace this part (rebalance the rotor)
G-225 | Rotor locknut M10x0.75, OD 18 x 6 with AF16 flats, 2 radial M3 locking set screws (ISO 4026 M3x4 A4 with a brass pad), 2 x Sm2Co5 d3 x 2 Hall-target magnets bonded in the front face at r 7 | 1 | make: lathe + mill flats (OD 18 passes the cartridge lip; standard KM0 + MB0 washer would not) | 17-4PH H1025, bar d20 | M10x0.75 6H, 10 N.m (stack clamp ~6 kN), set screws 0.6 N.m | precision CNC shop; set screws Bossard (CH) | 0.0067 | cad_out/variant_d/D2/GENERATOR/G-225_Locknut_M10x0.75_OD18.step | right-hand thread is fine (no drive torque through it)
G-226 | Seal spacer d14 / 10 x 6 with 3 labyrinth teeth d15.2 (identical front / rear) | 2 | make: lathe + grind faces | 17-4PH H1025, bar d16 | d15.2/10 x 6 | precision CNC shop | 0.0039 | cad_out/variant_d/D2/GENERATOR/G-226_Seal_Spacer_x2.step | faces parallel 2 um (stack element); radial clearance to the d15.7 bores 0.25
G-150 | Quill guard: plain tube 20 x 1.5 x 52, pressed 8 mm into the housing rear-face counterbore (Loctite 638), stationary | 1 | make: cut from tube + face | EN AW-6060-T66 tube 20 x 1.5 | d20 x 1.5 x 52 | Alu Menziken (CH), local | 0.0122 | cad_out/variant_d/D2/GENERATOR/G-150_Quill_Guard_Tube.step | was a flanged part with 3 screws
G-240 | Terminal box body: milled pocket 58 x 46 x 32, 3 mm walls, saddle r 56 underside, opening over the lead-out slot, 4 corner columns (M3 Helicoil for the lid), 4 x d4.5 floor holes, M25 + M16 gland holes in the front face | 1 | make: 3-axis CNC mill from a block | EN AW-6082-T6, block 70 x 55 x 50 | 64 x 52 x 36 | precision CNC shop | 0.1017 | cad_out/variant_d/D2/GENERATOR/G-240_Terminal_Box_Body.step | IP66 with gaskets G-243 / G-244
G-241 | Terminal box lid 64 x 52 x 3 | 1 | make: laser / mill | EN AW-5754 sheet 3 mm | 64 x 52 x 3 | local | 0.0267 | cad_out/variant_d/D2/GENERATOR/G-241_Terminal_Box_Lid.step | 4 x d3.4
G-242 | Phase terminal block 28 x 32 x 10 with 3 pressed-in M6 brass studs (G-251, triangle pitch 14-17), 2 x M4 to the box floor | 1 | make: mill | PEEK natural (or PA66-GF30) | 28 x 32 x 10 | Ensinger (DE), Roechling (DE) | 0.0103 | cad_out/variant_d/D2/GENERATOR/G-242_Terminal_Block_PEEK.step
G-243 | Box base gasket, 1 mm EPDM die-cut frame (saddle) | 1 | buy (die-cut) | EPDM 60 ShA sheet 1 mm | 64 x 52 frame 3 wide | Freudenberg (DE), local gasket cutter | 0.0009 | cad_out/variant_d/D2/GENERATOR/G-243_Gasket_Box_Base.step
G-244 | Lid gasket 1 mm EPDM die-cut | 1 | buy (die-cut) | EPDM 60 ShA 1 mm | 64 x 52 | local gasket cutter | 0.0009 | cad_out/variant_d/D2/GENERATOR/G-244_Gasket_Box_Lid.step
G-245 | Lead-out seal: silicone potting in the 8 x 24 slot round the 3 phase leads + signal wires | 1 | make in place (pot after winding) | RTV-2 silicone, 200 C | 8 x 24 x 6 | Wacker Elastosil RT 601 (DE) | 0.0015 | cad_out/variant_d/D2/GENERATOR/G-245_Lead-out_Seal.step
G-250 | Front cover -> housing: 6 x ISO 4762 M5 x 12 A4-80 + 6 x Helicoil M5 x 1.5D (free-running, 1.4301) in G-200 | 6 | buy | ISO 4762 A4-80 + HELICOIL plus free-running M5 x 1.5D (DIN 8140, 1.4301) | 4.2 N.m (preload ~4.3 kN), Loctite 243 | Bossard (CH), Boellhoff (DE), Wuerth (DE) | 0.0041 | cad_out/variant_d/D2/GENERATOR/G-250_Screws_ISO4762_M5x12_x6.step | tighten crosswise in 2 steps
G-252 | Cover / housing alignment dowels | 2 | buy | ISO 8734 4 m6 x 12, 1.4034 hardened | d4 x 12 (8 in G-200, 4 in G-202) | Bossard (CH), Halder (DE) | 0.0012 | cad_out/variant_d/D2/GENERATOR/G-252_Dowels_ISO8734_4x12_x2.step | pressed in G-200 (H7), slip in G-202 (H7)
G-253 | Terminal box -> housing: 4 x ISO 7380 M4 x 10 A4-80 + 4 x Helicoil M4 x 1D (blind 5.0) in G-200 | 4 | buy | ISO 7380-1 A4-80, Helicoil M4 x 4 | 1.7 N.m, Loctite 243 | Bossard (CH), Wuerth (DE) | 0.0018 | cad_out/variant_d/D2/GENERATOR/G-253_Screws_ISO7380_M4x10_x4.step
G-254 | Lid screws 4 x ISO 7380 M3 x 8 A4-80 + 4 x Helicoil M3 x 1.5D in the box columns | 4 | buy | ISO 7380-1 A4-80 | 0.6 N.m | Bossard (CH), Wuerth (DE) | 0.0008 | cad_out/variant_d/D2/GENERATOR/G-254_Screws_ISO7380_M3x8_x4.step
G-255 | PEEK block -> box floor: 2 x ISO 7380 M4 x 14 A2-70, tapped direct in the 4 mm Al floor, Loctite 243 | 2 | buy | ISO 7380-1 A2-70 | 0.8 N.m | Bossard (CH), Wuerth (DE) | 0.0021 | cad_out/variant_d/D2/GENERATOR/G-255_Screws_ISO7380_M4x12_x2.step
G-251 | 3 x M6 x 20 brass studs (knurled, pressed in G-242) + 6 x ISO 4032 M6 brass nuts + 6 x ISO 7089 washers + 3 spring washers; winding leads and the power cable on DIN 46234 M6 ring lugs | 3 | buy | CuZn39Pb3 brass studs / nuts, Sn-plated | M6, nuts 2.0 N.m | Wuerth (DE), Bossard (CH); lugs Klauke (DE) | 0.0076 | cad_out/variant_d/D2/GENERATOR/G-251_Phase_Studs_M6_x3.step
G-256 | EMC cable glands: M25 x 1.5 (power, clamping 11-17, 360 deg shield contact) + M16 x 1.5 (PT100/PTC signal) with lock nuts | 2 | buy | nickel-plated brass, IP68 | M25x1.5 / M16x1.5 | Lapp SKINTOP MS-SC-M (DE), Pflitsch blueglobe (DE) | 0.0261 | cad_out/variant_d/D2/GENERATOR/G-256_Cable_Glands_M25_M16.step | power cable 3 x 6 mm2 + PE shielded (e.g. Lapp OELFLEX SERVO 2YSLCY-JB 4G6) -> AUX EL-513 re-route to the front face z 76
G-257 | Glycol ports: 2 x straight hose nipple G1/4 male (ISO 228-1, ED seal ISO 1179-2 form E) for 8 mm ID hose + hose clips | 2 | buy | 1.4404 or nickel-plated brass, EPDM ED ring | G1/4 - 8 mm, 15 N.m | Landefeld (DE), Riegler (DE); clips Oetiker (CH) | 0.021 | cad_out/variant_d/D2/GENERATOR/G-257_Glycol_Hose_Nipples_G14_x2.step | at 135 deg, x -244 (in) / -170.5 (out), towards the AUX skid
G-258 | Front access plug DIN 908 M16 x 1.5 with ED sealing ring: remove to turn the rotor with an AF5 key (hex alignment) or to push the front cartridge out | 1 | buy | DIN 908 steel zinc-plated + ED ring NBR/FKM | M16x1.5, 25 N.m | Landefeld (DE), Riegler (DE) | 0.0153 | cad_out/variant_d/D2/GENERATOR/G-258_Plug_DIN908_M16x1.5.step
G-259 | 2 x ISO 4026 M5 x 6 A4 set screws + Loctite 542 sealing the jacket jack-out holes in the rear face | 2 | buy | ISO 4026 A4 | M5 x 6, 1.3 N.m | Bossard (CH), Wuerth (DE) | 0.0009 | cad_out/variant_d/D2/GENERATOR/G-259_Jack-hole_Plugs_M5_x2.step | remove only to push the jacket + stator out
G-260 | Helicoil plus free-running inserts (1.4301): 6 x M5x1.5D (flange), 3 x M6x2D (struts), 3 x M4x1.5D (fairing), 4 x M4x1D (box), 2 x M6x1D (VE-011/012), 4 x M3x1.5D (lid), 2 x M5x1.5D (jack-off, G-202) | 24 | buy | DIN 8140, 1.4301 | M3..M6 | Boellhoff HELICOIL (DE) | 0.01 |  | install with the Boellhoff hand tool, break the tang; tap STI per Boellhoff table
G-261 | Adhesives / thread-lockers: Loctite 243 (screws), 638 (guard tube), 648 (end rings), 542 (jack plugs), AA 326 + 7649 (magnets) | 1 | buy | Henkel Loctite |  | Henkel (DE) | 0
G-262 | Hall target magnets in the locknut: 2 x Sm2Co5 d3 x 2 (N/S opposite), bonded Loctite AA 326 | 2 | buy | SmCo5 | d3 x 2 | VAC (DE), Magnetfabrik Bonn (DE) | 0.0003 |  | 2 pulses/rev; balance-neutral pair
G-263 | Ring lugs DIN 46234 M6 for 6 mm2 (3 winding + 3 cable) + 8-pole spring terminal block for 3 x PT100 + PTC (Phoenix Contact PTFIX / WAGO 2002) | 1 | buy | Sn-plated Cu / PA |  | Klauke (DE), Phoenix Contact (DE), WAGO (DE) | 0.03
G-265 | Locknut locking set screws ISO 4026 M3 x 4 A4 with brass pads (2 per G-225) | 2 | buy | ISO 4026 A4 + brass pad | M3, 0.6 N.m | Bossard (CH), Wuerth (DE) | 0.0003
G-266 | Assembly greases: silicone grease for EPDM / FKM O-rings (Kluber Unisilkon L 250 L) and press paste for the carbon sleeve (Kluber Altemp Q NB 50) | 1 | buy | Kluber Lubrication |  | Kluber (DE) | 0 |  | no mineral grease on EPDM
G-264 | Generator rotor balancing service: 2 planes (G-223 end rings), G1 target / G2.5 limit at 115k, on its own bearings | 1 | service | ISO 21940-11 | U_per <= 0.056 g.mm total (G1) | Schenck RoTec (DE) machine or local turbo-balancing shop | 0 |  | re-balance after any magnet / sleeve / shaft work
