ahmadreza221/aurora-cchp/docs/bom/variant_d2_rotor_bom.csv

tag | description | qty | make_or_buy | material_or_spec | size_or_rating | supplier_candidates | mass_kg | model_file | notes
T-101 | Turbine shaft&wheel, radial inflow D4 78 / exducer 70 (trim 80), 11 blades, no splitters | 1 | buy (catalogue turbo wheel) + friction/EB weld to our R-101 d18 stub by the supplier | IN713C or K418 investment cast, HIP optional; weld per turbo practice | D4 78, b4 ~14, D6 70/21, rated >= 121k rpm (U4 470 m/s), spin proof 138k (120 %) | Changzhou E&E Turbo-Power (CN, wheels + friction welding); MHI TD08-class / IHI RHF-class wheels (JP) via EU distributors; Kinugawa (JP) | 0.416 | cad_out/variant_d/D2/TURBINE/T-101_Turbine_Wheel_D78_11bl.step | buy condition: supplier max speed >= 121k for this diameter, burst/FEA data, drawing of b4/blade angles -> re-run sim/variant_d/d2r_turbine.py; balance G1 with R-101
T-110 | Radial nozzle ring, 17 vanes (r 56.6 -> 42.9, b 14, alpha3 68 deg, throat 5.35) with front and rear side plates | 1 | make: 5-axis milling from forged bar (or SLM IN718 + HIP + finish machining) | IN718 (AMS 5662) aged | OD 116, ID 80, 20 mm | SLM: iDesign3D Tehran (IN718), Madatech (Ni alloy); bar: VDM Metals (DE), Aubert & Duval (FR); 5-axis: user precision CNC shop | 0.306 | cad_out/variant_d/D2/TURBINE/T-110_Radial_Nozzle_Ring_17v.step | vane count 17: prime, not a multiple of the 11 blades, no 4/rev; 3 x M4 A286 to the housing rear wall (T-130)
T-115 | Heat shield: turning-duct inner wall + nozzle back wall (1 mm air gap to T-110) | 1 | make: spun / deep-drawn sheet + TIG, ceramic-paper filled double wall | IN625 sheet 1.0 mm (2.4856) | OD 116, x 118-131 | VDM Metals (DE) sheet; local metal spinning | 0.179 | cad_out/variant_d/D2/TURBINE/T-115_Heat_Shield.step | inner rim slides on T-116 (thermal growth); 3 spacer tabs to T-110
T-116 | Turbine-end bearing support (replaces the v13A NGV): inner/outer rings, 7 straight struts, hub spigot on the tunnel, rear labyrinth stator d15.7, flange in the casing joint | 1 | make: investment cast IN713LC (user arranges castings) or SLM IN718 + HIP, then turning/grinding of the spigot, seal bore and flange | IN713LC / IN718 | OD 96 flange, x 95-118 | castings via the user; SLM iDesign3D (IR); grinding: precision CNC shop | 0.205 | cad_out/variant_d/D2/TURBINE/T-116_Turbine_End_Support_7struts.step | 6 x d2 buffer/cooling-air holes in the hub (re-drill to M4 orifice screws if thrust trim is needed); 7 struts (odd, not 11/17)
T-120 | Turbine housing / 360 deg plenum (shell OD 146 x 37, 2 support pads y +/-79 with M10, front wall bolted in the casing rear-flange joint, rear wall carries T-110 and T-121, TIT boss) | 1 | make: investment or sand cast + machining, or fabricated 3 mm sheet + TIG and machined rings | GX40CrNiSi25-20 (1.4848) cast or 1.4828 sheet | OD 146 x 37 (x 118-155), pads to y +/-85 | foundry via the user; sheet Outokumpu 253MA (FI/SE); local TIG shop | 0.895 | cad_out/variant_d/D2/TURBINE/T-120_Turbine_Housing_Plenum.step | pads sit on the FRAME slide pedestals FR-131 (x slides); insulate 50 mm
T-121 | Exducer shroud with the exhaust flange at x 176 (bore 70.7, OD 104, 6 x M6 PCD 94); collar 6 x M5 to T-120 | 1 | make: lathe + CNC contour turning, tip contour to +/-0.02 | IN625 bar or 1.4848 | OD 104, x 149-176 | VDM Metals (DE) bar; precision CNC shop | 0.387 | cad_out/variant_d/D2/TURBINE/T-121_Exducer_Shroud_Exhaust_Flange.step | tip clearance 0.35 mm set by shims under the collar; exhaust EX-111 bolts to the x 176 flange
T-130 | Bolts: 4 x M5x20 (casing / T-116 / T-120 joint), 6 x M5x12 (shroud collar), 3 x M4x10 (nozzle ring) | 13 | buy | A286 (1.4980) + silver-plated nuts | M5 / M4 | Bossard (CH), Boellhoff (DE), Wuerth (DE) | 0.05 |  | replace the 4 v13A rear-flange bolts (longer stack)
T-131 | Exhaust flange bolts 6 x M6x25 + nuts + graphite/mica gasket OD 104 / ID 72 | 1 | buy | A286 bolts, silver-plated nuts, graphite-laminate 1.4401 insert gasket | M6, PCD 94 | Bossard (CH), Boellhoff (DE); gasket Frenzelit (DE) | 0.06 |  | joint T-121 <-> EX-111
T-132 | TIT thermocouple, K type, 3 mm sheathed, M8x1 gland, tip in the plenum | 2 | buy | Inconel 600 sheath, class 1 | 0-1100 C | Roessel Messtechnik (DE), TC Mess- und Regeltechnik (DE) | 0.03 |  | one spare; replaces the v13A EGT probe
T-133 | Ceramic insulation paper 3 mm for T-115 and the housing gasket | 1 | buy | AES/PCW paper 1260 C | 0.1 m2 | Morgan Advanced Materials Superwool (UK), Rath (AT) | 0.02
R-100 | v13A compressor rework: bore reamed 7 -> 10 H6, faces re-trued, re-balanced | 1 | make (rework) | as-built compressor (2618-T61 / 7075-T6) | bore 10 H6, Ra 0.4 | precision CNC shop + balancing service (Schenck RoTec (DE) machine or local) | 0.081 | cad_out/variant_d/D2/ROTOR/R-100_Compressor_v13A_bored_d10.step | no sleeve: d10 seat raises the nose bending mode from ~100k (d8) to >=136k; bore hoop stress +<2 %
R-101 | Engine shaft: crowned AF6 nose hex, M8x1 LH, d10 seat/journals, d14 seal runner with 4 labyrinth teeth, d18 stub (welded to T-101) | 1 | make: lathe + cylindrical grinding (journals k5, runout 2 um), hex milled + crowned + nitrided; weld by the wheel supplier, final grind after welding | 42CrMo4 QT (1.7225) or 17-4PH H1025 | d10 x 189 (x -56..133) | bar: Deutsche Edelstahlwerke (DE), Ovako (SE); grinding: precision CNC shop | 0.1443 | cad_out/variant_d/D2/ROTOR/R-101_Engine_Shaft_d10.step | all rotor parts slide on from the nose; generator torque enters at the AF6 hex only
R-102 | Body sleeve d16/d10 x 88 (clamped between the bearing inner rings = the d16 body) | 1 | make: lathe + grind faces parallel 2 um | 17-4PH H1025 | d16/10 x 88 | precision CNC shop | 0.0841 | cad_out/variant_d/D2/ROTOR/R-102_Body_Sleeve_d16.step | tie-bolt stack effectiveness to be confirmed by a ping test
R-103 | Shim compressor -> front IR | 1 | make: ground washer | 100Cr6 hardened | d13/10 x 0.5 | precision CNC shop | 0.0002 | cad_out/variant_d/D2/ROTOR/R-103_Shim_IR_Spacer.step | select thickness for the compressor tip clearance
R-104 | Clamp washer under the nut | 1 | make: ground washer | 17-4PH H900 | d17.8/8.2 x 1.5 | precision CNC shop | 0.0023 | cad_out/variant_d/D2/ROTOR/R-104_Clamp_Washer.step
R-105 | Clamp nut M8x1 LH, AF13 x 7.5, RPM magnet pocket + balance slug | 1 | make | A286 or 17-4PH | M8x1 LH | precision CNC shop | 0.0056 | cad_out/variant_d/D2/ROTOR/R-105_Clamp_Nut_M8x1_LH.step | preload 6 kN (~10 N.m, measure stretch); friction capacity 11 N.m vs compressor 4.9 N.m
R-110 | Bearing 10x22x6 hybrid angular contact 15 deg P4 (core front locating + core rear floating) | 2 | buy | Si3N4 balls, 100Cr6/M50 rings, phenolic/PEEK cage | 71900 C, n.dm 1.84e6, oil-jet limit ~135k | FAG HCB71900-C-T-P4S (DE), SKF 71900 CE/HCP4A (SE), GMN HY S61900 C TA (DE), NSK 7900C hybrid (JP), ZWZ/LYC B71900C hybrid (CN) | 0.0087 | cad_out/variant_d/D2/ROTOR/R-110_Bearing_Front_71900_hybrid.step | same part as G-230; replace at 8000 h
R-112 | SFD cartridge front (bore 22 H5 locating, land 27.80, 2 O-ring grooves, jet + drain holes) | 1 | make: lathe + internal/external grinding | 17-4PH H1025 | d27.8/22 x 8.2 | precision CNC shop | 0.013 | cad_out/variant_d/D2/ROTOR/R-112_SFD_Cartridge_Front.step | film 0.10 mm in the tunnel bore 28 H6; anti-rotation pin
R-113 | SFD cartridge rear (bore 22 H5/h5 sliding, land 27.80) | 1 | make: lathe + grinding | 17-4PH H1025 | d27.8/22 x 11.5 | precision CNC shop | 0.0196 | cad_out/variant_d/D2/ROTOR/R-113_SFD_Cartridge_Rear.step
R-114 | Retaining ring for the locating outer ring (bore 22) | 1 | buy | spring steel, spiral flat-wire ring | bore 22 | TFC (UK), Seeger-Orbis (DE) | 0.0006 | cad_out/variant_d/D2/ROTOR/R-114_Retaining_Ring_Front_OR.step
R-116 | SFD O-rings (2 per cartridge, core) | 4 | buy | FKM 75 ShA | 25.0 x 1.5 | Freudenberg (DE), Trelleborg (SE), COG (DE) | 0.001 | cad_out/variant_d/D2/ROTOR/R-116_SFD_O-rings_FKM_x4.step | set the 1-2 N/um support stiffness; measure on a rig; same for G-232/233 (4 more)
R-117 | Wave spring core rear (preload 40 N forward) | 1 | buy | 17-7PH | 22 x 19.2, 40 N at 1.5 mm | TFC (UK), Gutekunst (DE) | 0.0011 | cad_out/variant_d/D2/ROTOR/R-117_Wave_Spring_Rear_40N.step
R-120 | Shaft tunnel D2: v13A front flange/bolt pattern, cartridge bores 28 H6 front (x 2-11) and rear (x 95.8-107.3), mid bore 18, oil drillings | 1 | make: lathe, bores ground coaxial 5 um in one setting | 1.4057 or 17-4PH | OD 40 flange, L 105 | precision CNC shop | 0.1711 | cad_out/variant_d/D2/ROTOR/R-120_Shaft_Tunnel_D2.step | replaces v13A ShaftTunnel; x 0 datum now on the R-131 front face (x -0.2)
R-121 | Rear-bearing oil feed tube along the tunnel top (compressor-air annulus) | 1 | make: bent + brazed | 1.4571 tube 4 x 0.5 | L 75 | tube Alleima (SE); fittings Voss (DE) | 0.0032 | cad_out/variant_d/D2/ROTOR/R-121_Rear_Oil_Feed_Tube_d4.step | replaces the v13A lube lines (SupplyLines x 2)
R-122 | Rear-bearing scavenge tube along the tunnel bottom | 1 | make: bent + brazed | 1.4571 tube 6 x 0.5 | L 75 | tube Alleima (SE); fittings Voss (DE) | 0.005 | cad_out/variant_d/D2/ROTOR/R-122_Rear_Scavenge_Tube_d6.step | to the scavenge pump
R-131 | Front seal & retainer ring: 3-tooth labyrinth ID 22.4 round the compressor boss, retains the front cartridge | 1 | make: lathe | 17-4PH | d27.9/22.4 x 3 | precision CNC shop | 0.0034 | cad_out/variant_d/D2/ROTOR/R-131_Front_Seal_Retainer_Ring.step | pressed + Loctite 638 (Henkel, DE)
R-140 | Rotor balancing: engine rotor (shaft+wheel, then + compressor + nut) G1, two planes | 1 | service | ISO 21940 G1 | 115k service speed | Schenck RoTec (DE) or local turbo-balancing shop | 0 |  | mark angular positions; balance generator rotor separately (G-220..G-227)
R-150 | Load washer for the thrust measurement behind the front cartridge (test rig only) | 1 | buy | piezo load washer | 0-2 kN | Kistler 9001A (CH), HBM/HBK KMR (DE) | 0.01 |  | set the T-116 orifice screws for -20..-80 N net
G-* | Generator pod (all G- parts, fasteners and seals): superseded here, see docs/bom/variant_d2_generator_bom.csv (d2g rev 2026-10-23) | 0 | see generator BOM |  |  |  | 0
