ahmadreza221/aurora-cchp/docs/bom/variant_d2_intake_exhaust_frame_bom.csv

tag | description | qty | make_or_buy | material_or_spec | size_or_rating | supplier_candidates | mass_kg | model_file | notes
INT-110 | Plenum can + top collar weldment | 1 | make | 1.4301 2 mm: rolled can OD180 x 122 (x -128..-8.4) + 2 mm laser front wall ID112 + 6 mm inner bolt ring (6 x M5 clearance r84); top opening 112 x 170 with straight collar + 45 deg frustum to 188 x 246 (4 folded plates) + 2 mm flange 236 x 294 (8 x M6); 3 bulkhead bosses d16 (185/275/300 deg) + P-tap (225 deg); TIG, pickled | OD180 x 122; collar flange top z 130 | local sheet-metal + TIG shop; sheet Outokumpu (FI) / Aperam (BE) / Acerinox (ES) | 2.43 | cad_out/variant_d/D2/INTAKE/INT-110_Plenum_Can_TopCollar.step | replaces D-160; the collar flange only seals (EPDM), the box is carried by FR-160
INT-111 | Dish + skirt weldment | 1 | make | 1.4301 2 mm spun dish r47.5..68 flush with the v13A intake flange (x -46.3), rolled R6 rim lip; rolled 2 mm skirt D124 + 3 mm ring r54..70 (6 x M5); 3 strut holes d9.5; 3 strut-screw bosses d12 (M6 clearance, x -23); 3 bulkhead bosses d16; TIG | D142 x 38 | local spinning + TIG | 0.53 | cad_out/variant_d/D2/INTAKE/INT-111_Dish_Skirt.step
INT-112 | Rear ring 2 halves + foot (fixed support) | 1 | make | 1.4301 6 mm laser-cut, split at z 0 (2 side ears M6), bore 107.7 H9 on the casing / IntakeOuter lap joint with 0.5 mm graphite tape, 6 + 6 x M5 tapped (skirt r63, can r84); lower half with foot 80 x 34, 2 x M10 to FR-120 | OD180, foot to z -114 | local laser + CNC | 0.87 | cad_out/variant_d/D2/INTAKE/INT-112_Rear_Ring_2halves_Foot.step | = the FIXED point of the engine (x -5)
INT-115 | Pod struts x3 (replace D-150) | 1 | make | 3 x d8 17-4PH H1025 (or 1.4301) rods on the D-150 axes (90/210/330 deg), root on the pod rear plate x -108 (M5 stud or TIG), trimmed at x -18; end blocks 10 x 12 x 10.5 TIG-welded, M6 tapped radially at x -23 | 3 x d8 x ~92 | local CNC + TIG | 0.12 | cad_out/variant_d/D2/INTAKE/INT-115_Pod_Struts_x3.step | the ONLY locator of the pod (FR-170 is weight relief); 3, never 4
INT-120 | Pod tail fairing (3 segments) | 1 | make | 1.4301 1.5 mm spun quarter-torus R15 + foot ring r44.5..46, cut into 3 at the struts, 3 x M4 countersunk into the pod rear face | D122 x 24 | local spinning | 0.15 | cad_out/variant_d/D2/INTAKE/INT-120_Pod_Tail_Fairing.step
INT-140 | FOD guard panel (box floor) | 1 | make | woven 1.4301 mesh 8 mm opening / 1.0 mm wire (f 0.79) on a 3 x 15 flat frame 208 x 266, 6 x M5 into the box floor over the collar opening | 208 x 266 | mesh: GKD (DE) / Haver & Boecker (DE) / Chinese Anping makers | 0.18 | cad_out/variant_d/D2/INTAKE/INT-140_FOD_Guard_Panel.step | K 0.34, ~11 Pa; catches anything dropped while the cell is out
INT-150 | Filter box body | 1 | make | aluminium 5754 H22 1.5 mm folded box 603 x 603, walls z 131.5..497, floor with collar opening 188 x 246 + 8 x M6; angle seat 13 mm at z 464 with EPDM 10 x 3 gasket; 4 corner guide rails L12 x 12 x 2; 2 floor channels (x -220..-190 and 85..110, 25 high, M8 rivnuts) for FR-160; G1/4 drain boss at the floor corner; blind rivets + MS-polymer seal | 603 x 603 x 392 (inner 600 x 600), x -491.5..111.5 | local sheet-metal shop (laser + press brake); alu sheet Hydro (NO) / Novelis Koblenz (DE) / Chinese | 6.19 | cad_out/variant_d/D2/INTAKE/INT-150_Filter_Box.step | ON TOP of the plenum, forward over the cool pod; rear wall 6.5 mm in x from the turbine housing - add a 0.5 mm stainless reflector if the housing is not insulated
INT-151 | Lid with inlet grille | 1 | make | aluminium 1.5 mm lid 607 x 607 x 42: skirt over the box rim, EPDM rim gasket, inner pressing lip with 10 mm EPDM foam on the cell header, coarse expanded-alu grille 10 x 5 (~70 % open) | 607 x 607 x 42 | local sheet-metal shop; expanded metal Metall-Ziegler (DE) / RMIG (DK) | 2.34 | cad_out/variant_d/D2/INTAKE/INT-151_Lid_Grille.step | lift off after opening the 4 latches
INT-152 | F7 V-cell filter | 1 | buy | V-cell with header, ISO 16890 ePM1 50-65 % (F7), 4 V-banks, plastic frame, 592 x 592 x 292, body <= 570 x 570 (verify) | ~3400 m3/h at ~90 Pa initial; at 1228 m3/h ~33 Pa clean, change at ~165 Pa | Camfil Opakfil / CamCube (SE), Freudenberg Viledon MaxiPleat / MV (DE), MANN+HUMMEL (DE), Nordic Air Filtration (DK) | 5.54 | cad_out/variant_d/D2/INTAKE/INT-152_V-Cell_F7_592x592x292_env.step | envelope; header up
INT-153 | Toggle latches x4 | 4 | buy | stainless over-centre toggle latch ~500 N with keeper, riveted on the box walls, hooks on the lid skirt | 4 x ~40 x 18 x 32 | Elesa+Ganter GN 831 (DE/IT), Kipp (DE) | 0.73 | cad_out/variant_d/D2/INTAKE/INT-153_Toggle_Latches_x4_env.step | no tools
INT-160 | Seals + gaskets (intake) | 1 | buy | EPDM lip seal ring 110 x 2 (front wall on the pod shell); EPDM 3 mm flat gasket for the collar flange 236 x 294; EPDM 10 x 3 seat gasket (2.4 m); EPDM foam 10 x 10 lid lip (2.3 m); graphite tape 0.5 mm | set | Freudenberg Simrit (DE), Trelleborg (SE), Klinger (AT) | 0.2
INT-161 | Intake fasteners and bulkheads | 1 | buy | A4-70: 12 x M5 (skirt/can to rear ring), 2 x M6 ears, 3 x M6 strut screws, 3 x M4 fairing, 8 x M6 collar flange, 6 x M5 guard; 2 x G1/4 bulkhead unions (fuel lines) + 1 x M12 cable gland (RPM sensor); alu blind rivets + M8 rivnuts | set | Bossard (CH) / Würth (DE); Hy-Lok (KR), Ham-Let (IL); Lapp (DE) | 0.5
EX-110 | Diffuser weldment (coaxial) | 1 | make | 1.4828 2 mm: diffuser cone 2theta 18 deg L80 (D70.7 -> D96.0) rolled from a laser blank; bosses TC M14x1.5 (x 229), 2 static taps M8 (x 192 / 246), drain G1/4 at the bottom (x 246); TIG full penetration, stress relief, leak test 0.3 bar | D100 x 80 | local rolling + TIG; sheet Outokumpu 253MA / 1.4828 (FI/SE) | 0.41 | cad_out/variant_d/D2/EXHAUST/EX-110_Diffuser_Weldment.step | exhaust ends here (x 264): Cp_system 0.69, cost vs ideal 4.1 kW, +9.2 kW vs the meanline dump
EX-111 | Inlet flange 6 x M6 (to T-121) | 1 | make | 1.4828 8 mm laser + turned, bore 70.7, OD 104, 6 x d6.6 on PCD 94 (30 deg start) = T-121 pattern; A286 M6 x 25 + Thermiculite 866 / mica gasket | OD104 x 8 | local laser + lathe | 0.28 | cad_out/variant_d/D2/EXHAUST/EX-111_Inlet_Flange_6xM6.step | bore follows the turbine (GR180_D2_EXD_D)
EX-112 | End ring flange (slim) | 1 | make | 1.4828 6 mm laser-cut ring OD128, 6 x d6.6 on PCD 116 (30 deg), fillet-welded on the diffuser exit | OD128 x 6 | local laser | 0.23 | cad_out/variant_d/D2/EXHAUST/EX-112_End_Ring_Flange.step | blank = free discharge; a pipe (ideally DN125: +1.5 kW back) can be bolted on later
EX-113 | Support lugs (centre-line) | 1 | make | 2 x 10 mm 1.4828 laser plates 24 x ~60, contoured to the cone, TIG near the diffuser inlet (x 194..218), x-slot 16 x 11 at y +/-90 | x 194..218, y to +/-100 | local laser + TIG | 0.2 | cad_out/variant_d/D2/EXHAUST/EX-113_Support_Lugs.step | slide in x on FR-131 (growth ~1.6 mm)
EX-120 | Insulation jacket (removable) | 1 | buy | 30 mm AES / ceramic-fibre blanket on the diffuser, 1.4301 foil + mesh skin, lacing hooks, split at y 0; cut-outs for lugs, pedestals, TC, taps, drain | x 188..255, D157 | Morgan Thermal Ceramics (UK) / Rath (AT) / Chinese AES blanket makers | 0.19 | cad_out/variant_d/D2/EXHAUST/EX-120_Insulation_Jacket_env.step
EX-130 | Exhaust gaskets + bolts | 1 | buy | Thermiculite 866 ring 104/71 (inlet); 6 x M6 A286 (inlet) + 6 x M6 A286 spare set for the end ring | set | Flexitallic (UK) / Klinger (AT); Bossard (CH) | 0.08
EX-132 | Thermocouple + taps | 1 | buy | K-type 3 mm MI thermocouple with M14x1.5 gland; 2 x M8 static taps with 1/8 tube; G1/4 drain plug / small valve | EGT after the diffuser | TC Direct (UK), Rössel Messtechnik (DE), JUMO (DE) | 0.1
FR-110 | Base frame (welded RHS) | 1 | make | S355 RHS 60x40x3 (EN 10219): 2 rails L405 at y +/-90, front cross member L300 (x -225..-185), rear cross member L300 (x 220..260), mid member at x 0; 4 x 8 mm mount pads (M10); MAG on a flat table (1 mm), galvanised or 2K epoxy | 485 x 300 x 68 | local fabricator / robot weld cell; RHS ArcelorMittal (LU) / Tata Steel EU (NL) | 9.11 | cad_out/variant_d/D2/FRAME/FR-110_Base_Frame_RHS.step | frame top z -126, floor z -239: axis 239 mm above the floor
FR-120 | Front pedestal (fixed) | 1 | make | S355 12 mm plate 90 x 46 + 2 x 8 mm gussets, welded on the mid member; 2 x M10 8.8 into the INT-112 foot (face x -2.4) | 90 x 50 x 46 | local laser + MAG | 0.45 | cad_out/variant_d/D2/FRAME/FR-120_Front_Pedestal_Fixed.step | axial / lateral / vertical FIXED point
FR-131 | Slide pedestals x4 (plain) | 1 | make | 4 x RHS 40x40x3 S355 posts on the rails + 12 mm top: 6 mm calcium-silicate board (Promat / Skamol) + 2 mm PTFE or graphite-bronze slide plate on S355; 2 under the D2R turbine pads (x-slot 12 x 11 at x 135, y +/-79), 2 under the diffuser lugs (x 206, M10 hole) | posts 40 x 40 x ~110 | local + slide plates igus (DE) / Federal-Mogul DEVA (DE) / Ampep (UK) | 2.03 | cad_out/variant_d/D2/FRAME/FR-131_Slide_Pedestals_x4.step | M10 A286 shoulder bolts + Belleville washers, hand-tight
FR-140 | Anti-vibration mounts x4 | 4 | buy | cylindrical rubber-metal mount D50 x 35 with base flange, M10, natural rubber ~55 Sh, ~40 kg rated (136 N static per mount est) | f_n ~11 Hz (est), run 1917 Hz | Paulstra / Hutchinson (FR), AMC Mecanocaucho (ES), Getzner (AT), Chinese equivalents | 0.5 | cad_out/variant_d/D2/FRAME/FR-140_AV_Mounts_x4_env.step | plus an earth strap across one mount
FR-150 | Lifting lugs x4 | 1 | make | S355 10 mm plates 40 x 90, hole D25 (0.5 t bow shackle) at the cross member ends (y +/-150) | 4 x 40 x 90 x 10 | local | 0.98 | cad_out/variant_d/D2/FRAME/FR-150_Lifting_Lugs_x4.step | lift with the filter box removed (its overhang would touch the slings); 4-leg sling + spreader
FR-160 | Filter box posts x4 | 1 | make | front pair RHS 30x30x2 S355 on the front cross member (x -205, y +/-130), rear pair RHS 30x20x2 on the rails (x 100, y +/-90, clear of the AUX ignition transformer); 5 mm top plates 25 x 50, 2 x M8 each into the box floor-channel rivnuts with rubber washers | posts 30 x 30 x 226 | local | 1.8 | cad_out/variant_d/D2/FRAME/FR-160_Filter_Box_Posts_x4.step | carry box + lid + cell (~15 kg)
FR-170 | Pod cradle (weight relief) | 1 | make | 1.4301 6 mm rolled 140 deg saddle band 30 wide + 50 x 18 base block, lined with 1 mm PTFE-faced EPDM (r 55.1), at the pod CG x -205 | R55 x 30 | local rolling + TIG | 0.38 | cad_out/variant_d/D2/FRAME/FR-170_Pod_Cradle.step | under the pod; clear of bearings (x -266 / -136), terminal box and glycol ports (top)
FR-171 | Pod weight-relief pedestal | 1 | make | RHS 40x40x3 S355 post on the front cross member + 8 mm top plate with M16 jack screw + lock nut; NR 50 Sh elastomer pad D50 x 15 (~40 N/mm) + 2 mm PTFE slide disc; preload = pod weight ~47 N (1.2 mm squeeze) | 60 x 60 x 52 | local + elastomer pad Getzner / Paulstra | 0.59 | cad_out/variant_d/D2/FRAME/FR-171_Pod_Weight_Relief_Pedestal.step | free in x / y, soft in z: no double constraint with the struts
FR-180 | Frame fasteners | 1 | buy | 8.8 zinc-flake: 2 x M10 front pedestal, 4 x M10 mount nuts, 8 x M8 box posts; A286: 4 x M10 shoulder bolts + Belleville stacks for the slide pedestals; M16 jack screw + nut | set | Bossard (CH) / Würth (DE) / Böllhoff (DE) | 0.5
