ahmadreza221/aurora-cchp/docs/bom/variant_c_exhaust_bom.csv

tag | description | qty | make_or_buy | material_or_spec | size_or_rating | supplier_candidates | mass_kg | model_file | notes
E3B-110 | Collector Body | 1 | make | laser cut + press-brake (U-shell 3 mm, 2 bends R20; end plates 3 mm), hood rect-to-round 2 halves bump-bent, stub rolled 219.1 x 3 or 1.4828 welded tube, PN6 flange; TIG / robot MAG-free (TIG or plasma) welding, captive A286 M8 studs; stress relief 900 C, leak test 0.3 bar | 345 x 560 x 573 mm (bbox) | local sheet-metal + robot weld shop; sheet Outokumpu 153MA/253MA or 1.4828 (FI/SE), Aperam (BE); flange EU/IR | 15.923 | cad_out/variant_b/E3B/E3B-110_Collector_Body.step | insulate outside (E3B-114)
E3B-111 | West Cover 2halves | 1 | make | 1.4828 plate 5 mm laser cut in 2 halves, drilled; split joint mica strip + 2 bolted straps | 5 x 330 x 330 mm (bbox) | local laser | 3.049 | cad_out/variant_b/E3B/E3B-111_West_Cover_2halves.step | fitted round the interduct before the body
E3B-112 | Rear Unit Bell Disc Cone | 1 | make | hub bell 1.4828 2.5 mm metal-spun (as E3-110 bell), disc 4 mm laser + faced, cone IN625 1.5 mm spun, 6 windows laser; TIG; face disc after welding | 117 x 344 x 344 mm (bbox) | local spinning + TIG; IN625 sheet VDM Metals (DE) | 3.409 | cad_out/variant_b/E3B/E3B-112_Rear_Unit_Bell_Disc_Cone.step | carried by the cold cartridge; nuts from the east (accessible)
E3B-113 | Rear HeatShield | 1 | buy | ceramic-fibre paper 2.5 mm (1260 C grade) + 0.1 mm 1.4828 foil, 4 notches | 3 x 232 x 232 mm (bbox) | Unifrax / Morgan Thermal Ceramics (EU), Chinese | 0.017 | cad_out/variant_b/E3B/E3B-113_Rear_HeatShield.step
E3B-401 | Front Support Portal | 1 | make | S355J2 (or 1.4301) plate 8 mm laser-cut portal + 2 pads 10 mm + base 10 mm, MAG/TIG; M12 tapped pads | 60 x 568 x 400 mm (bbox) | local | 6.126 | cad_out/variant_b/E3B/E3B-401_Front_Support_Portal.step | centre-line support: axis stays put when the box grows 2 mm
E3B-504 | TE-505A FPT exit TOT | 1 | buy | type K class 1, MI 3 mm Inconel 600, ungrounded, immersion 60 mm, compression fitting on a 1/2" nipple (TOT = HRSG inlet) | 16 x 160 x 16 mm (bbox) | Roessel / Electronic Sensor (DE), Jaquet / Baumer (CH), WIKA (DE), Endress+Hauser (CH) | 0.016 | cad_out/variant_b/E3B/E3B-504_TE-505A_FPT_exit_TOT.step | moved from E3-504/505/506
E3B-505 | TE-505B FPT exit TOT | 1 | buy | type K class 1, MI 3 mm Inconel 600, ungrounded, immersion 60 mm, compression fitting on a 1/2" nipple (TOT = HRSG inlet) | 16 x 160 x 16 mm (bbox) | Roessel / Electronic Sensor (DE), Jaquet / Baumer (CH), WIKA (DE), Endress+Hauser (CH) | 0.016 | cad_out/variant_b/E3B/E3B-505_TE-505B_FPT_exit_TOT.step | moved from E3-504/505/506
E3B-506 | PT-525 FPT exit tap | 1 | buy | static tap 1.6 mm + 1/4" tube to PT-525 (FPT exit / HRSG inlet static, 0-1.2 bar abs or dp to ambient) | 22 x 6 x 6 mm (bbox) | Roessel / Electronic Sensor (DE), Jaquet / Baumer (CH), WIKA (DE), Endress+Hauser (CH) | 0.002 | cad_out/variant_b/E3B/E3B-506_PT-525_FPT_exit_tap.step | moved from E3-504/505/506
E3B-114 | Insulation Jacket | 1 | buy | microporous panels 70 mm in 0.5 mm 1.4301 cassettes with quick-release latches; inner face ceramic paper | 359 x 476 x 573 mm (bbox) | Promat MICROTHERM (BE), Morgan WDS (DE/UK), Chinese microporous | 9.67 | cad_out/variant_b/E3B/E3B-114_Insulation_Jacket.step | skin <= 60 C at 40 C enclosure air (calc)
E3B-601 | gasket west cover / box west plate (ring OD 330 x ID 280, 1 mm) | 1 | buy | Thermiculite 815 / KLINGER Milam PSS | 1 mm | Flexitallic (UK) / Klinger (AT) | 0.05
E3B-602 | gasket box east plate / rear disc (ring OD 344 x ID 300, 1 mm) | 1 | buy | Thermiculite 815 / KLINGER Milam PSS | 1 mm | Flexitallic (UK) / Klinger (AT) | 0.05
E3B-603 | gasket cover / E3-101 mid flange (ring OD 150 x ID 85, 1 mm) | 1 | buy | KLINGER Milam PSS (mica) | 1 mm | Klinger (AT) | 0.01
E3B-604 | outlet flange gasket DN200 PN6 | 1 | buy | Thermiculite 815 / Milam PSS ring | DN200 PN6, 1.5 mm | Flexitallic (UK) / Klinger (AT) | 0.05 |  | HRSG/stack side
E3B-605 | hot nuts M8 for the 32 captive studs + washers | 32 | buy | 1.4980 (A286-class) silver-plated nuts | M8 | Boellhoff (DE) / Chinese GH2132 | 0.25 |  | anti-seize Ni
E3B-606 | cover-to-mid-flange screws M6 x 16 | 12 | buy | 1.4980 / A286-class | M6 x 16 | Boellhoff (DE) | 0.06 |  | into tapped E3-101 mid flange
E3B-607 | cone-to-PMG screws M5 x 12 + mica spacer ring 3 mm | 12 | buy | A4-70 screws, phlogopite mica ring OD 86 / ID 76 | M5 | Wuerth (DE); mica Elmelin (UK) | 0.05 |  | thermal barrier
E3B-608 | split-joint strap set (2 straps + 4 x M6 + mica strip) | 1 | make | 1.4828 strip 3 x 30 |  | local | 0.1 |  | west cover split line
E3B-609 | support bolting: 4 x M12 base (skid), 2 x M12 lug + 2 mica/Monolux washers | 1 | buy | 8.8 Zn-flake / A4-70 | M12 | Wuerth (DE) | 0.4 |  | lug slots let the box grow in y
E3B-610 | drain plug G1/2 + seal | 1 | buy | 1.4571 + graphite seal | G1/2 | Voss (DE) / Hy-Lok (KR) | 0.05
E3B-611 | outlet bolting M16 (HRSG side) studs + nuts | 8 | buy | 1.4980/A286-class studs, silver-plated nuts | M16 x 70 | Boellhoff (DE) | 0.9 |  | supplied with the HRSG duct
