ahmadreza221/aurora-cchp/docs/bom/plant_bom.csv

tag | description | qty | make_or_buy | material_or_spec | size_or_rating | supplier_candidates | mass_kg | model_file | notes
IF-1 | engine air intake module: acoustic rain louver, lined plenum, G4 + F8 filters, CHW coil CC-1 (10 rows, 21 kW to 12 C), droplet eliminator, SS304 drain pan with LSH-221, DN200 outlet + flexible connector | 1 | buy | galvanised + powder-coated casing, Cu/Cu or epoxy-coated Al-fin coil, 50 mm acoustic lining | 0.37 m3/s, coil 0.40 x 0.40 m face, 21 kW | Trox / Gebhardt (DE) casing; Lu-Ve (IT) or domestic coil makers; Camfil (SE) filters | 150 | cad_out/plant/items/IF-1.step | CC-1 coil + filters inside; PDT-222/223, TE-221/222, MT-501 ports
EP-1 | engine package GR180 + FPT + PMG + recuperator + enclosure (PLACEHOLDER box; model by engine-package session, cad_out/engine/) | 1 | make | see docs/06_master_design.md section 4 (E1-E5) | 1.40 x 0.90 x 1.30 m envelope | engine package session | 450 | cad_out/plant/items/EP-1.step | not counted in plant BOM mass; interfaces per docs/06 section 3
D-101 | exhaust diverter damper, 3-way single blade, DN250, 650 C, leakage <= 1 %, 24 VAC modulating actuator with spring return to BYPASS <= 15 s, dual limit switches (ZSO-101), heat-break shaft | 1 | buy | body 316L fabricated; actuator Belimo-class spring-return | DN250 / 650 C / ZC-101 2-10 V | body: domestic stainless fabricator; actuator Belimo (CH), Siemens (DE) | 60 | cad_out/plant/items/D-101.step
HX-1 | exhaust/water economiser, spiral finned-tube, 8 tubes x 15 rows x 0.6 m, 42 m2, vertical up-flow, headers outside gas, inspection door, condensate drain, PSV-111 DN20 5.5 bar on outlet header; + stack support frame | 1 | buy | all 316L, tube 25.4 x 1.65, fin 11 x 0.8 mm 5 fpi HF-welded; casing 100 mm rock wool + Al | 69 kW, gas 400 C design / water PN10 120 C | domestic boiler/HX makers (316L finned tube imported); Kelvion (DE), Bosal (BE) | 429 | cad_out/plant/items/HX-1.step | thermal design sim/hvac/hvac_design.py section [2]; frame 80 kg
ST-1 | stack DN250 double wall with bypass tee, sampling port (TE-103), drain, top +4.2 m; incl. absorptive straight-through silencer SL-101 (1.2 m, IL 15-20 dB(A), dp <= 50 Pa) | 1 | buy | inner 316L, 50 mm insulation, outer 1.4301; silencer: perforated 316L + basalt wool 650 C | DN250, +4.2 m above roof | Jeremias, Schiedel (DE), Kemper (DE); domestic stainless fabricators | 140 | cad_out/plant/items/ST-1.step
NP-1 | condensate neutraliser pot (MgO / limestone granulate), to roof drain | 1 | buy | PP/316L body | 10 L | Neutrakon (DE) or domestic | 15 | cad_out/plant/items/NP-1.step
LLH-1 | hydraulic separator (low-loss header) DN65 with integral air vent, dirt leg and drain (light option; replaces 200 L buffer) | 1 | buy | steel PN10, 50 mm stone wool + Al | DN65 / 13 m3/h / body DN200 x 1.0 m | Reflex, Sinusverteiler (DE), Caleffi (IT); domestic | 45 | cad_out/plant/items/LLH-1.step
ET-1 | HW expansion set: diaphragm vessel 35 L / 10 bar + 20 L intermediate (cooling) vessel, cap valve, drain | 1 | buy | EN 13831 | 35 L + 20 L | Reflex (N 35 + V 20), Zilmet (IT), Flamco (NL), Varem (IT) | 45 | cad_out/plant/items/ET-1.step
PS-1 | hydronic pump skid PS-1: galvanised frame on spring isolators, carrying P-2A/B, P-5A/B, FT-211, HM-2/4, AS-2, ET-2 25 L, closed-loop fill unit FU-1 (BA backflow preventer, FQ-410, XV-410, dosing pot), JB-PS1 | 1 | make | S235 galvanised UPN120 frame, prefabricated and pressure-tested | 2.8 x 1.1 m | domestic HVAC skid fabricator | 180 | cad_out/plant/items/PS-1.step | pumps, valves and pipes listed separately
PS-3 | changeover + DHW/heating module PS-3 (prefabricated): P-3 (ECM 1.3 m3/h), TV-131 3-way limiter, V-PRI DHW priority, HX-3 heating PHE 15 kW, V-CO1/V-CO2 summer/winter 3-way DN50 with end switches, HM-3 port | 1 | buy | insulated sheet housing, SS316 brazed PHE, Belimo-class valves | 0.60 x 0.40 x 1.20 m | domestic HVAC module builders; components Grundfos (DK), Belimo (CH), SWEP (SE) | 120 | cad_out/plant/items/PS-3.step
CH-1 | single-effect LiBr absorption chiller, hot-water driven, outdoor, SC10 class 35 kW; Modbus (generator T, crystallisation margin, dilution state); rev B purchase spec: dp HW <= 50 / CHW <= 40 / CW <= 50 kPa, CW 80-85 % flow allowed | 1 | buy | factory package | SC10 class 35 kW | Yazaki WFC-SC10/SC5 (JP, reference); EAW Wegracal SE 30/15 (DE); Thermax (IN); Broad, Shuangliang (CN) | 560 | cad_out/plant/items/CH-1.step | nozzle sizes per final datasheet; reducers at nozzles counted in fittings
CH-2 | single-effect LiBr absorption chiller, hot-water driven, outdoor, SC5 class 17.6 kW; Modbus (generator T, crystallisation margin, dilution state); rev B purchase spec: dp HW <= 50 / CHW <= 40 / CW <= 50 kPa, CW 80-85 % flow allowed | 1 | buy | factory package | SC5 class 17.6 kW | Yazaki WFC-SC10/SC5 (JP, reference); EAW Wegracal SE 30/15 (DE); Thermax (IN); Broad, Shuangliang (CN) | 420 | cad_out/plant/items/CH-2.step | nozzle sizes per final datasheet; reducers at nozzles counted in fittings
TK-1 | CHW buffer / decoupler 300 L (light option; base 500 L), 6 nozzles, TE-211/212/214 wells, vent, drain | 1 | buy | steel PN10, 50 mm elastomeric + Al | 300 L, Ø0.55 m | Reflex (DE), Caleffi (IT); domestic pressure-vessel makers | 430 | cad_out/plant/items/TK-1.step
CT-1 | cooling tower, FRP round counterflow, 60 ton class, low-head distribution (<= 25 kPa), low-noise EC/VFD fan 1.5 kW (wide blades), basin splash mats, drift <= 0.002 %, vibration switch VS-301, covered basin, EH-301 1.5 kW basin heater, LT-301/LSLL-301/TE-303 | 1 | buy | FRP UV-resistant, SS304 fittings | 111 kW @ 35.8/31.8 C, WB 28.5, 60 % fan, 24.2 m3/h | Liang Chi LBC-60, Kuken, Shinwa (TW); Truwater (MY); Gohl, Jaeggi (EU); domestic FRP towers | 820 | cad_out/plant/items/CT-1.step
PS-2 | condenser-water pump skid PS-2: galvanised frame on spring isolators, P-6A/B, IP55 VFD cabinet (2 x 1.5 kW HVAC VFD, Modbus, DC choke), HX-4 bracket | 1 | make | S235 galvanised, prefabricated | 1.35 x 0.9 m | domestic skid fabricator; VFD Danfoss FC 102 (DK), ABB ACH580 (FI), Siemens G120P (DE) | 120 | cad_out/plant/items/PS-2.step
HX-4 | glycol/condenser-water brazed PHE, optional trim (XV-305 NC); glycol 45/40 C, CW 32/35 C | 1 | buy | SS316 brazed | 2.7 kW, 0.9 m3/h CW | SWEP (SE), Alfa Laval (SE), Kaori (TW) | 15 | cad_out/plant/items/HX-4.step | on PS-2 west end
WT-1 | cooling-water treatment skid: chemical bund, 3 x 60 L drums, DP-1..3 diaphragm dosing pumps, EC/pH/ORP controller WT-1 (AIT-301/302/303), sample cell, coupon rack, F-SS centrifugal separator 2.2 m3/h with XV-303 purge, XV-302 blowdown + FQ-302 | 1 | buy | PP/PE bund, SS fittings | 1.2 x 0.7 x 1.3 m | ProMinent DULCOMETER (DE), Emec, Seko (IT); Netafim/Arkal or Amiad (separator); domestic skid | 300 | cad_out/plant/items/WT-1.step
DC-1 | engine glycol dry cooler, 2 EC fans (fan on B4 FAN3), coastal-coated Cu/Al coil, adiabatic pre-cooling pads both long sides with XV-307 + drain | 1 | buy | Cu/Al epoxy coil, galvanised casing | 4.0 kW @ 46 C dry (glycol 52 C) / 38.5 C with pads; 2600 m3/h | Guentner (DE), LU-VE (IT), Alfa Laval (SE); domestic air-cooler makers | 90 | cad_out/plant/items/DC-1.step | interface with engine glycol loop M-751 (docs/electrical)
RS-1 | roof penetration: insulated upstand curb 0.7 x 0.7 m + weather hood open to the west, sealing boots per pipe | 1 | make | concrete/steel upstand, galvanised hood, EPDM boots | 0.7 x 0.7 m, 8 pipes | site contractor | 60 | cad_out/plant/items/RS-1.step
BOP-R | roof BOP/MCC panel envelope (B6-R + touch display, PSU 24 V, meters EM-HVAC / JT-191..196, MCB/MCCB, SPD, RCD) with sun canopy; contents per docs/electrical | 1 | buy | IP55, filtered fan, canopy | 1.2 x 0.45 x 2.0 m | Rittal (DE) or domestic panel builder; switchgear Schneider, ABB, Siemens | 220 | cad_out/plant/items/BOP-R.step
FS-1 | FZ1 cylinder cabinet: 2 x FK-5-1-12 cylinders 8 L (>= 1.52 kg each, N2 25 bar) main + reserve, solenoid + manual actuators, discharge hoses, check valves, manifold, PSL-890A/C, lock-off valve (ZSC-899A), TE-499 | 1 | buy | galvanised + white, 25 mm insulation, vented, shaded | 0.60 x 0.45 x 1.40 m | listed systems: Siemens Sinorix 1230 (DE), Minimax MX 1230 (DE); listed Chinese makers | 80 | cad_out/plant/items/FS-1.step
FCU-1 | under-ceiling exposed fan coil 600 CFM class, EC motor, 2-pipe, drain pan + condensate pump-free gravity drain, Modbus room controller with RH (FCU-1..4 controllers) | 1 | buy | galvanised casing, Cu/Al coil | 5.9 kW nominal / 5.1 kW site, 0.76 m3/h | Saravel, Iran Radiator (IR); Gree, Midea (CN); Daikin (JP), Sabiana (IT) | 30 | cad_out/plant/items/FCU-1.step
FCU-2 | under-ceiling exposed fan coil 600 CFM class, EC motor, 2-pipe, drain pan + condensate pump-free gravity drain, Modbus room controller with RH (FCU-1..4 controllers) | 1 | buy | galvanised casing, Cu/Al coil | 5.9 kW nominal / 5.1 kW site, 0.76 m3/h | Saravel, Iran Radiator (IR); Gree, Midea (CN); Daikin (JP), Sabiana (IT) | 30 | cad_out/plant/items/FCU-2.step
FCU-3 | under-ceiling exposed fan coil 600 CFM class, EC motor, 2-pipe, drain pan + condensate pump-free gravity drain, Modbus room controller with RH (FCU-1..4 controllers) | 1 | buy | galvanised casing, Cu/Al coil | 5.9 kW nominal / 5.1 kW site, 0.76 m3/h | Saravel, Iran Radiator (IR); Gree, Midea (CN); Daikin (JP), Sabiana (IT) | 30 | cad_out/plant/items/FCU-3.step
FCU-4 | under-ceiling exposed fan coil 600 CFM class, EC motor, 2-pipe, drain pan + condensate pump-free gravity drain, Modbus room controller with RH (FCU-1..4 controllers) | 1 | buy | galvanised casing, Cu/Al coil | 5.9 kW nominal / 5.1 kW site, 0.76 m3/h | Saravel, Iran Radiator (IR); Gree, Midea (CN); Daikin (JP), Sabiana (IT) | 30 | cad_out/plant/items/FCU-4.step
EJ-101 | exhaust expansion joint DN250, 316L multi-ply, 650 C, DN250, on L-EX-01 (exhaust EP-1 -> D-101) | 1 | buy | exhaust expansion joint DN250, 316L multi-ply, 650 C | DN250 | Witzenmann (DE), Kompaflex (CH); domestic | 13.5 | cad_out/plant/piping/HD-1.step | inline on route HD-1
AS-1 | microbubble + dirt + magnetic separator, DN50, on L-HW-01 (HW primary supply HX-1 -> LLH-1) | 1 | buy | microbubble + dirt + magnetic separator | DN50 | Spirotech SpiroCombi (NL), Caleffi DISCALDIRT (IT), Flamco (NL) | 13.5 | cad_out/plant/piping/HW-01S.step | inline on route HW-01S
P-1A/B | twin in-line circulator ECM, duty/standby, Modbus, DN50, on L-HW-01 (HW primary return LLH-1 -> P-1 -> HX-1) | 1 | buy | twin in-line circulator ECM, duty/standby, Modbus | DN50 | Grundfos MAGNA3 D (DK), Wilo Stratos MAXO-D (DE) | 36.5 | cad_out/plant/piping/HW-01R.step | inline on route HW-01R
FT-111 | electromagnetic flow meter, 4-20 mA + Modbus, DN50, on L-HW-01 (HW primary return LLH-1 -> P-1 -> HX-1) | 1 | buy | electromagnetic flow meter, 4-20 mA + Modbus | DN50 | Endress+Hauser (CH/DE), Krohne (DE), Siemens SITRANS FM (DE) | 10.0 | cad_out/plant/piping/HW-01R.step | inline on route HW-01R
HM-1 | ultrasonic thermal energy meter with pair of PT500 sensors, M-Bus, DN50, on L-HW-01 (HW primary return LLH-1 -> P-1 -> HX-1) | 1 | buy | ultrasonic thermal energy meter with pair of PT500 sensors, M-Bus | DN50 | Kamstrup MULTICAL 603 (DK), Siemens UH50 (DE), Danfoss Sonometer (DK) | 3.5 | cad_out/plant/piping/HW-01R.step | inline on route HW-01R
P-2A | in-line wet-rotor/dry-runner circulator, ECM, Modbus, DN50, on L-HW-03 (HW supply CH-1 generator (P-2A)) | 1 | buy | in-line wet-rotor/dry-runner circulator, ECM, Modbus | DN50 | Grundfos MAGNA3 / TPE3 (DK), Wilo Stratos MAXO (DE), DAB (IT) | 18.5 | cad_out/plant/piping/HWS-1.step | inline on route HWS-1
HM-11 | ultrasonic thermal energy meter with pair of PT500 sensors, M-Bus, DN50, on L-HW-03 (HW return CH-1 generator) | 1 | buy | ultrasonic thermal energy meter with pair of PT500 sensors, M-Bus | DN50 | Kamstrup MULTICAL 603 (DK), Siemens UH50 (DE), Danfoss Sonometer (DK) | 3.5 | cad_out/plant/piping/HWR-1.step | inline on route HWR-1
P-2B | in-line wet-rotor/dry-runner circulator, ECM, Modbus, DN40, on L-HW-04 (HW supply CH-2 generator (P-2B)) | 1 | buy | in-line wet-rotor/dry-runner circulator, ECM, Modbus | DN40 | Grundfos MAGNA3 / TPE3 (DK), Wilo Stratos MAXO (DE), DAB (IT) | 16.0 | cad_out/plant/piping/HWS-2.step | inline on route HWS-2
HM-12 | ultrasonic thermal energy meter with pair of PT500 sensors, M-Bus, DN40, on L-HW-04 (HW return CH-2 generator) | 1 | buy | ultrasonic thermal energy meter with pair of PT500 sensors, M-Bus | DN40 | Kamstrup MULTICAL 603 (DK), Siemens UH50 (DE), Danfoss Sonometer (DK) | 3.0 | cad_out/plant/piping/HWR-2.step | inline on route HWR-2
MV-CH1E | motorised ball valve on/off with end switches, 24 VAC, DN50, on L-CH-01 (CHW CH-1 evaporator out -> TK-1) | 1 | buy | motorised ball valve on/off with end switches, 24 VAC | DN50 | Belimo (CH), Siemens (DE) | 3.5 | cad_out/plant/piping/CHP-1O.step | inline on route CHP-1O
HM-21 | ultrasonic thermal energy meter with pair of PT500 sensors, M-Bus, DN50, on L-CH-01 (CHW CH-1 evaporator out -> TK-1) | 1 | buy | ultrasonic thermal energy meter with pair of PT500 sensors, M-Bus | DN50 | Kamstrup MULTICAL 603 (DK), Siemens UH50 (DE), Danfoss Sonometer (DK) | 3.5 | cad_out/plant/piping/CHP-1O.step | inline on route CHP-1O
P-4A | in-line wet-rotor/dry-runner circulator, ECM, Modbus, DN50, on L-CH-01 (CHW TK-1 -> P-4A -> CH-1 evaporator) | 1 | buy | in-line wet-rotor/dry-runner circulator, ECM, Modbus | DN50 | Grundfos MAGNA3 / TPE3 (DK), Wilo Stratos MAXO (DE), DAB (IT) | 18.5 | cad_out/plant/piping/CHP-1I.step | inline on route CHP-1I
MV-CH2E | motorised ball valve on/off with end switches, 24 VAC, DN40, on L-CH-02 (CHW CH-2 evaporator out -> TK-1) | 1 | buy | motorised ball valve on/off with end switches, 24 VAC | DN40 | Belimo (CH), Siemens (DE) | 3.0 | cad_out/plant/piping/CHP-2O.step | inline on route CHP-2O
HM-22 | ultrasonic thermal energy meter with pair of PT500 sensors, M-Bus, DN40, on L-CH-02 (CHW CH-2 evaporator out -> TK-1) | 1 | buy | ultrasonic thermal energy meter with pair of PT500 sensors, M-Bus | DN40 | Kamstrup MULTICAL 603 (DK), Siemens UH50 (DE), Danfoss Sonometer (DK) | 3.0 | cad_out/plant/piping/CHP-2O.step | inline on route CHP-2O
P-4B | in-line wet-rotor/dry-runner circulator, ECM, Modbus, DN40, on L-CH-02 (CHW TK-1 -> P-4B -> CH-2 evaporator) | 1 | buy | in-line wet-rotor/dry-runner circulator, ECM, Modbus | DN40 | Grundfos MAGNA3 / TPE3 (DK), Wilo Stratos MAXO (DE), DAB (IT) | 16.0 | cad_out/plant/piping/CHP-2I.step | inline on route CHP-2I
P-5A/B | twin in-line circulator ECM, duty/standby, Modbus, DN50, on L-CH-03 (CHW secondary supply header PS-3 -> P-5 -> PS-1) | 1 | buy | twin in-line circulator ECM, duty/standby, Modbus | DN50 | Grundfos MAGNA3 D (DK), Wilo Stratos MAXO-D (DE) | 36.5 | cad_out/plant/piping/CHW-S.step | inline on route CHW-S
FT-211 | electromagnetic flow meter, 4-20 mA + Modbus, DN50, on L-CH-03 (CHW secondary supply header PS-3 -> P-5 -> PS-1) | 1 | buy | electromagnetic flow meter, 4-20 mA + Modbus | DN50 | Endress+Hauser (CH/DE), Krohne (DE), Siemens SITRANS FM (DE) | 10.0 | cad_out/plant/piping/CHW-S.step | inline on route CHW-S
HM-2 | ultrasonic thermal energy meter with pair of PT500 sensors, M-Bus, DN50, on L-CH-03 (CHW secondary return header PS-1 -> PS-3) | 1 | buy | ultrasonic thermal energy meter with pair of PT500 sensors, M-Bus | DN50 | Kamstrup MULTICAL 603 (DK), Siemens UH50 (DE), Danfoss Sonometer (DK) | 3.5 | cad_out/plant/piping/CHW-R.step | inline on route CHW-R
AS-2 | microbubble + dirt + magnetic separator, DN50, on L-CH-03 (CHW secondary return header PS-1 -> PS-3) | 1 | buy | microbubble + dirt + magnetic separator | DN50 | Spirotech SpiroCombi (NL), Caleffi DISCALDIRT (IT), Flamco (NL) | 13.5 | cad_out/plant/piping/CHW-R.step | inline on route CHW-R
TV-221 | pressure-independent control valve, 0-10 V actuator with feedback, DN25, on L-CH-04 (CHW to intake coil CC-1) | 1 | buy | pressure-independent control valve, 0-10 V actuator with feedback | DN25 | Belimo EPIV/PIQCV (CH), Danfoss AB-QM + NovoCon (DK), IMI TA (CH) | 2.2 | cad_out/plant/piping/CC-S.step | inline on route CC-S
HM-4 | ultrasonic thermal energy meter with pair of PT500 sensors, M-Bus, DN40, on L-CH-04 (CHW return from CC-1) | 1 | buy | ultrasonic thermal energy meter with pair of PT500 sensors, M-Bus | DN40 | Kamstrup MULTICAL 603 (DK), Siemens UH50 (DE), Danfoss Sonometer (DK) | 3.0 | cad_out/plant/piping/CC-R.step | inline on route CC-R
FQ-301 | water meter with pulse output, DN20, on L-MU-01 (tower make-up (softened / RO blend) RS-1 -> CT-1) | 1 | buy | water meter with pulse output | DN20 | Zenner (DE), Diehl Metering (DE), B Meters (IT) | 2.0 | cad_out/plant/piping/MU-1.step | inline on route MU-1
XV-301 | motorised ball valve on/off with end switches, 24 VAC, DN20, on L-MU-01 (tower make-up (softened / RO blend) RS-1 -> CT-1) | 1 | buy | motorised ball valve on/off with end switches, 24 VAC | DN20 | Belimo (CH), Siemens (DE) | 2.0 | cad_out/plant/piping/MU-1.step | inline on route MU-1
XV-307 | motorised ball valve on/off with end switches, 24 VAC, DN15, on L-MU-02 (softened water to DC-1 pads + closed-loop fill) | 1 | buy | motorised ball valve on/off with end switches, 24 VAC | DN15 | Belimo (CH), Siemens (DE) | 1.8 | cad_out/plant/piping/PW-1.step | inline on route PW-1
BS-1 | basket strainer DN100 with dp gauge, DN100, on L-CW-01 (CW tower basin -> PS-2 suction header) | 1 | buy | basket strainer DN100 with dp gauge | DN100 | Zetkama (PL), Genebre (ES); domestic | 45 | cad_out/plant/piping/CW-S.step | inline on route CW-S
FT-301 | electromagnetic flow meter, 4-20 mA + Modbus, DN100, on L-CW-01 (CW tower basin -> PS-2 suction header) | 1 | buy | electromagnetic flow meter, 4-20 mA + Modbus | DN100 | Endress+Hauser (CH/DE), Krohne (DE), Siemens SITRANS FM (DE) | 16.0 | cad_out/plant/piping/CW-S.step | inline on route CW-S
P-6A | in-line wet-rotor/dry-runner circulator, ECM, Modbus, DN65, on L-CW-01 (CW pump branch P-6A) | 1 | buy | in-line wet-rotor/dry-runner circulator, ECM, Modbus | DN65 | Grundfos MAGNA3 / TPE3 (DK), Wilo Stratos MAXO (DE), DAB (IT) | 22.2 | cad_out/plant/piping/CW-P-6A.step | inline on route CW-P-6A
P-6B | in-line wet-rotor/dry-runner circulator, ECM, Modbus, DN65, on L-CW-01 (CW pump branch P-6B) | 1 | buy | in-line wet-rotor/dry-runner circulator, ECM, Modbus | DN65 | Grundfos MAGNA3 / TPE3 (DK), Wilo Stratos MAXO (DE), DAB (IT) | 22.2 | cad_out/plant/piping/CW-P-6B.step | inline on route CW-P-6B
MV-CH2C | motorised butterfly valve on/off with end switches (staging), DN65, on L-CW-03 (CW return CH-2 (MV-CH2C)) | 1 | buy | motorised butterfly valve on/off with end switches (staging) | DN65 | Belimo (CH), Siemens (DE), Genebre (ES) | 4.2 | cad_out/plant/piping/CW-2R.step | inline on route CW-2R
MV-CH1C | motorised butterfly valve on/off with end switches (staging), DN80, on L-CW-01 (CW return CH-1 -> TV-301 -> tower) | 1 | buy | motorised butterfly valve on/off with end switches (staging) | DN80 | Belimo (CH), Siemens (DE), Genebre (ES) | 5.0 | cad_out/plant/piping/CW-R.step | inline on route CW-R
TV-301 | 3-way modulating valve (tower bypass), 0-10 V, DN100, on L-CW-01 (CW return CH-1 -> TV-301 -> tower) | 1 | buy | 3-way modulating valve (tower bypass), 0-10 V | DN100 | Belimo (CH), Siemens (DE) | 26.0 | cad_out/plant/piping/CW-R.step | inline on route CW-R
XV-305 | motorised ball valve on/off with end switches, 24 VAC, DN25, on L-CW-05 (HX-4 -> XV-305 -> CW discharge) | 1 | buy | motorised ball valve on/off with end switches, 24 VAC | DN25 | Belimo (CH), Siemens (DE) | 2.2 | cad_out/plant/piping/CW-H4O.step | inline on route CW-H4O
HV-601 (manual, yellow) | ball valve, full bore, PN16, lever, DN20, on L-NG-01 (natural gas from building riser stub -> EP-1 gas train) | 1 | buy | ball valve, full bore, PN16, lever | DN20 | Genebre (ES), Giacomini (IT), KSB (DE); domestic | 2.0 | cad_out/plant/piping/GAS-1.step | inline on route GAS-1
PS-889A | discharge pressure switch (FK-5-1-12 released), DN15, on L-FS-01 (FK-5-1-12 discharge FS-1 -> EP-1 roof (FZ1)) | 1 | buy | discharge pressure switch (FK-5-1-12 released) | DN15 | per listed fire system | 1.8 | cad_out/plant/piping/FZ1.step | inline on route FZ1
PICV-FCU-1 | pressure-independent control valve, 0-10 V actuator with feedback, DN20, on L-CH-06/07 (hall branch supply FCU-1) | 1 | buy | pressure-independent control valve, 0-10 V actuator with feedback | DN20 | Belimo EPIV/PIQCV (CH), Danfoss AB-QM + NovoCon (DK), IMI TA (CH) | 2.0 | cad_out/plant/piping/FCU-1-S.step | inline on route FCU-1-S
PICV-FCU-2 | pressure-independent control valve, 0-10 V actuator with feedback, DN20, on L-CH-06/07 (hall branch supply FCU-2) | 1 | buy | pressure-independent control valve, 0-10 V actuator with feedback | DN20 | Belimo EPIV/PIQCV (CH), Danfoss AB-QM + NovoCon (DK), IMI TA (CH) | 2.0 | cad_out/plant/piping/FCU-2-S.step | inline on route FCU-2-S
PICV-FCU-3 | pressure-independent control valve, 0-10 V actuator with feedback, DN20, on L-CH-06/07 (hall branch supply FCU-3) | 1 | buy | pressure-independent control valve, 0-10 V actuator with feedback | DN20 | Belimo EPIV/PIQCV (CH), Danfoss AB-QM + NovoCon (DK), IMI TA (CH) | 2.0 | cad_out/plant/piping/FCU-3-S.step | inline on route FCU-3-S
PICV-FCU-4 | pressure-independent control valve, 0-10 V actuator with feedback, DN20, on L-CH-06/07 (hall branch supply FCU-4) | 1 | buy | pressure-independent control valve, 0-10 V actuator with feedback | DN20 | Belimo EPIV/PIQCV (CH), Danfoss AB-QM + NovoCon (DK), IMI TA (CH) | 2.0 | cad_out/plant/piping/FCU-4-S.step | inline on route FCU-4-S
V-BALL-DN20-H | ball valve, full bore, PN16, lever, DN20 (untagged isolation/strainer items) | 8 | buy | ball valve, full bore, PN16, lever | DN20 PN16 | Genebre (ES), Giacomini (IT), KSB (DE); domestic | 17.6 | cad_out/plant/piping/ | routes: FCU-1-R, FCU-1-S, FCU-2-R, FCU-2-S, FCU-3-R, FCU-3-S, FCU-4-R, FCU-4-S
V-BALL-DN40 | ball valve, full bore, PN16, lever, DN40 (untagged isolation/strainer items) | 4 | buy | ball valve, full bore, PN16, lever | DN40 PN16 | Genebre (ES), Giacomini (IT), KSB (DE); domestic | 13.6 | cad_out/plant/piping/ | routes: CC-R, CC-S, HWR-2, HWS-2
V-BALL-DN50 | ball valve, full bore, PN16, lever, DN50 (untagged isolation/strainer items) | 2 | buy | ball valve, full bore, PN16, lever | DN50 PN16 | Genebre (ES), Giacomini (IT), KSB (DE); domestic | 8.0 | cad_out/plant/piping/ | routes: HWR-1, HWS-1
V-BUTT-DN65 | butterfly valve, lug type, EPDM liner, lever/gear, PN16, DN65 (untagged isolation/strainer items) | 3 | buy | butterfly valve, lug type, EPDM liner, lever/gear, PN16 | DN65 PN16 | Genebre (ES), Zetkama (PL), KSB (DE) | 14.7 | cad_out/plant/piping/ | routes: CW-2, CW-P-6A, CW-P-6B
V-BUTT-DN80 | butterfly valve, lug type, EPDM liner, lever/gear, PN16, DN80 (untagged isolation/strainer items) | 1 | buy | butterfly valve, lug type, EPDM liner, lever/gear, PN16 | DN80 PN16 | Genebre (ES), Zetkama (PL), KSB (DE) | 5.8 | cad_out/plant/piping/ | routes: CW-1
V-CHEC-DN65 | silent check valve, wafer, PN16, DN65 (untagged isolation/strainer items) | 2 | buy | silent check valve, wafer, PN16 | DN65 PN16 | Genebre (ES), Zetkama (PL), Socla (FR) | 9.8 | cad_out/plant/piping/ | routes: CW-P-6A, CW-P-6B
V-FLEX-DN20 | flexible connector (stainless braided / gas-approved), DN20 (untagged isolation/strainer items) | 1 | buy | flexible connector (stainless braided / gas-approved) | DN20 PN16 | Witzenmann (DE), domestic | 2.2 | cad_out/plant/piping/ | routes: GAS-1
V-YSTR-DN40 | Y-strainer 1 mm (20 mesh), PN16, with drain plug, DN40 (untagged isolation/strainer items) | 2 | buy | Y-strainer 1 mm (20 mesh), PN16, with drain plug | DN40 PN16 | Genebre (ES), Zetkama (PL); domestic | 6.8 | cad_out/plant/piping/ | routes: CHP-2I, HWS-2
V-YSTR-DN50 | Y-strainer 1 mm (20 mesh), PN16, with drain plug, DN50 (untagged isolation/strainer items) | 2 | buy | Y-strainer 1 mm (20 mesh), PN16, with drain plug | DN50 PN16 | Genebre (ES), Zetkama (PL); domestic | 8.0 | cad_out/plant/piping/ | routes: CHP-1I, HWS-1
PIPE-CS40-DN20 | pipe CS40 DN20 (length incl. 5 % cut allowance) | 17.4 | buy | carbon steel EN 10216-2 P235GH / A106 Gr.B, Sch40 seamless, welded, PN16 | DN20 / OD 26.9 mm | domestic mills (Safa, Isfahan) / EU | 29.4 | cad_out/plant/piping/ | unit: m
PIPE-CS40-DN25 | pipe CS40 DN25 (length incl. 5 % cut allowance) | 58.0 | buy | carbon steel EN 10216-2 P235GH / A106 Gr.B, Sch40 seamless, welded, PN16 | DN25 / OD 33.7 mm | domestic mills (Safa, Isfahan) / EU | 145.0 | cad_out/plant/piping/ | unit: m
PIPE-CS40-DN32 | pipe CS40 DN32 (length incl. 5 % cut allowance) | 2.4 | buy | carbon steel EN 10216-2 P235GH / A106 Gr.B, Sch40 seamless, welded, PN16 | DN32 / OD 42.4 mm | domestic mills (Safa, Isfahan) / EU | 8.2 | cad_out/plant/piping/ | unit: m
PIPE-CS40-DN40 | pipe CS40 DN40 (length incl. 5 % cut allowance) | 51.9 | buy | carbon steel EN 10216-2 P235GH / A106 Gr.B, Sch40 seamless, welded, PN16 | DN40 / OD 48.3 mm | domestic mills (Safa, Isfahan) / EU | 210.1 | cad_out/plant/piping/ | unit: m
PIPE-CS40-DN50 | pipe CS40 DN50 (length incl. 5 % cut allowance) | 22.5 | buy | carbon steel EN 10216-2 P235GH / A106 Gr.B, Sch40 seamless, welded, PN16 | DN50 / OD 60.3 mm | domestic mills (Safa, Isfahan) / EU | 122.6 | cad_out/plant/piping/ | unit: m
PIPE-CS40-DN65 | pipe CS40 DN65 (length incl. 5 % cut allowance) | 10.6 | buy | carbon steel EN 10216-2 P235GH / A106 Gr.B, Sch40 seamless, welded, PN16 | DN65 / OD 76.1 mm | domestic mills (Safa, Isfahan) / EU | 91.7 | cad_out/plant/piping/ | unit: m
PIPE-DUCT-DN250 | pipe DUCT DN250 (length incl. 5 % cut allowance) | 3.8 | buy | exhaust duct DN250, inner 316L 0.8 mm + 50 mm mineral wool + 1.4301 outer skin, clamp-band joints | DN250 / OD 273.0 mm | Jeremias, Schiedel (DE); domestic | 107.3 | cad_out/plant/piping/ | unit: m
PIPE-GAS-DN20 | pipe GAS DN20 (length incl. 5 % cut allowance) | 2.6 | buy | carbon steel Sch40 seamless, welded, yellow (EN 1775 / national gas code) | DN20 / OD 26.9 mm | domestic mills | 4.3 | cad_out/plant/piping/ | unit: m
PIPE-PE100-DN65 | pipe PE100 DN65 (length incl. 5 % cut allowance) | 7.1 | buy | PE100 SDR11 PN16 black, UV-stabilised, butt/electro-fusion; steel spools at valves | DN65 / OD 75.0 mm | domestic PE pipe makers | 10.4 | cad_out/plant/piping/ | unit: m
PIPE-PE100-DN80 | pipe PE100 DN80 (length incl. 5 % cut allowance) | 2.1 | buy | PE100 SDR11 PN16 black, UV-stabilised, butt/electro-fusion; steel spools at valves | DN80 / OD 90.0 mm | domestic PE pipe makers | 4.5 | cad_out/plant/piping/ | unit: m
PIPE-PE100-DN100 | pipe PE100 DN100 (length incl. 5 % cut allowance) | 10.4 | buy | PE100 SDR11 PN16 black, UV-stabilised, butt/electro-fusion; steel spools at valves | DN100 / OD 110.0 mm | domestic PE pipe makers | 32.6 | cad_out/plant/piping/ | unit: m
PIPE-PPR-DN15 | pipe PPR DN15 (length incl. 5 % cut allowance) | 10.0 | buy | PP-R PN16 (EN ISO 15874), fusion-welded | DN15 / OD 20.0 mm | domestic PP-R makers; Aquatherm (DE) | 1.7 | cad_out/plant/piping/ | unit: m
PIPE-PPR-DN20 | pipe PPR DN20 (length incl. 5 % cut allowance) | 10.8 | buy | PP-R PN16 (EN ISO 15874), fusion-welded | DN20 / OD 25.0 mm | domestic PP-R makers; Aquatherm (DE) | 2.5 | cad_out/plant/piping/ | unit: m
PIPE-PVC-DN20 | pipe PVC DN20 (length incl. 5 % cut allowance) | 12.2 | buy | PVC-U drain pipe, solvent-cemented, fall >= 1 % | DN20 / OD 25.0 mm | domestic | 2.4 | cad_out/plant/piping/ | unit: m
PIPE-PVC-DN25 | pipe PVC DN25 (length incl. 5 % cut allowance) | 2.6 | buy | PVC-U drain pipe, solvent-cemented, fall >= 1 % | DN25 / OD 32.0 mm | domestic | 0.8 | cad_out/plant/piping/ | unit: m
PIPE-PVC-DN50 | pipe PVC DN50 (length incl. 5 % cut allowance) | 1.4 | buy | PVC-U drain pipe, solvent-cemented, fall >= 1 % | DN50 / OD 63.0 mm | domestic | 1.1 | cad_out/plant/piping/ | unit: m
PIPE-SS304-DN25 | pipe SS304 DN25 (length incl. 5 % cut allowance) | 29.5 | buy | stainless 1.4301 press-fit system (EN 10312), EPDM seals, glycol 40 % | DN25 / OD 33.7 mm | Geberit Mapress (CH/DE), Viega Sanpress (DE) | 25.1 | cad_out/plant/piping/ | unit: m
PIPE-SS316D-DN25 | pipe SS316D DN25 (length incl. 5 % cut allowance) | 0.6 | buy | stainless 316L Sch10S, TIG-welded (acidic start-up condensate) | DN25 / OD 33.7 mm | domestic stainless fabricators | 0.8 | cad_out/plant/piping/ | unit: m
PIPE-SS316F-DN15 | pipe SS316F DN15 (length incl. 5 % cut allowance) | 3.3 | buy | stainless 316 Sch80 seamless, listed threaded/press fittings, FK-5-1-12 system pressure | DN15 / OD 21.3 mm | per listed fire system | 5.3 | cad_out/plant/piping/ | unit: m
ELB-CS40-DN20-90 | elbow 90 deg, CS40 DN20 (long radius 1.5D / PE moulded) | 9 | buy | carbon steel EN 10216-2 P235GH / A106 Gr.B, Sch40 seamless, welded, PN16 | DN20 | as pipe | 2.2 | cad_out/plant/piping/
ELB-CS40-DN25-90 | elbow 90 deg, CS40 DN25 (long radius 1.5D / PE moulded) | 25 | buy | carbon steel EN 10216-2 P235GH / A106 Gr.B, Sch40 seamless, welded, PN16 | DN25 | as pipe | 7.5 | cad_out/plant/piping/
ELB-CS40-DN32-90 | elbow 90 deg, CS40 DN32 (long radius 1.5D / PE moulded) | 7 | buy | carbon steel EN 10216-2 P235GH / A106 Gr.B, Sch40 seamless, welded, PN16 | DN32 | as pipe | 2.7 | cad_out/plant/piping/
ELB-CS40-DN40-90 | elbow 90 deg, CS40 DN40 (long radius 1.5D / PE moulded) | 35 | buy | carbon steel EN 10216-2 P235GH / A106 Gr.B, Sch40 seamless, welded, PN16 | DN40 | as pipe | 16.8 | cad_out/plant/piping/
ELB-CS40-DN50-90 | elbow 90 deg, CS40 DN50 (long radius 1.5D / PE moulded) | 19 | buy | carbon steel EN 10216-2 P235GH / A106 Gr.B, Sch40 seamless, welded, PN16 | DN50 | as pipe | 11.4 | cad_out/plant/piping/
ELB-CS40-DN65-90 | elbow 90 deg, CS40 DN65 (long radius 1.5D / PE moulded) | 2 | buy | carbon steel EN 10216-2 P235GH / A106 Gr.B, Sch40 seamless, welded, PN16 | DN65 | as pipe | 1.6 | cad_out/plant/piping/
ELB-DUCT-DN250-90 | elbow 90 deg, DUCT DN250 (long radius 1.5D / PE moulded) | 1 | buy | exhaust duct DN250, inner 316L 0.8 mm + 50 mm mineral wool + 1.4301 outer skin, clamp-band joints | DN250 | as pipe | 3.0 | cad_out/plant/piping/
ELB-GAS-DN20-90 | elbow 90 deg, GAS DN20 (long radius 1.5D / PE moulded) | 3 | buy | carbon steel Sch40 seamless, welded, yellow (EN 1775 / national gas code) | DN20 | as pipe | 0.7 | cad_out/plant/piping/
ELB-PE100-DN65-90 | elbow 90 deg, PE100 DN65 (long radius 1.5D / PE moulded) | 6 | buy | PE100 SDR11 PN16 black, UV-stabilised, butt/electro-fusion; steel spools at valves | DN65 | as pipe | 4.7 | cad_out/plant/piping/
ELB-PE100-DN80-90 | elbow 90 deg, PE100 DN80 (long radius 1.5D / PE moulded) | 1 | buy | PE100 SDR11 PN16 black, UV-stabilised, butt/electro-fusion; steel spools at valves | DN80 | as pipe | 1.0 | cad_out/plant/piping/
ELB-PE100-DN100-90 | elbow 90 deg, PE100 DN100 (long radius 1.5D / PE moulded) | 6 | buy | PE100 SDR11 PN16 black, UV-stabilised, butt/electro-fusion; steel spools at valves | DN100 | as pipe | 7.2 | cad_out/plant/piping/
ELB-PPR-DN15-90 | elbow 90 deg, PPR DN15 (long radius 1.5D / PE moulded) | 6 | buy | PP-R PN16 (EN ISO 15874), fusion-welded | DN15 | as pipe | 1.1 | cad_out/plant/piping/
ELB-PPR-DN20-90 | elbow 90 deg, PPR DN20 (long radius 1.5D / PE moulded) | 9 | buy | PP-R PN16 (EN ISO 15874), fusion-welded | DN20 | as pipe | 2.2 | cad_out/plant/piping/
ELB-PVC-DN20-90 | elbow 90 deg, PVC DN20 (long radius 1.5D / PE moulded) | 8 | buy | PVC-U drain pipe, solvent-cemented, fall >= 1 % | DN20 | as pipe | 1.9 | cad_out/plant/piping/
ELB-PVC-DN25-90 | elbow 90 deg, PVC DN25 (long radius 1.5D / PE moulded) | 4 | buy | PVC-U drain pipe, solvent-cemented, fall >= 1 % | DN25 | as pipe | 1.2 | cad_out/plant/piping/
ELB-PVC-DN50-65 | elbow 65 deg, PVC DN50 (long radius 1.5D / PE moulded) | 1 | buy | PVC-U drain pipe, solvent-cemented, fall >= 1 % | DN50 | as pipe | 0.6 | cad_out/plant/piping/
ELB-PVC-DN50-90 | elbow 90 deg, PVC DN50 (long radius 1.5D / PE moulded) | 1 | buy | PVC-U drain pipe, solvent-cemented, fall >= 1 % | DN50 | as pipe | 0.6 | cad_out/plant/piping/
ELB-SS304-DN25-90 | elbow 90 deg, SS304 DN25 (long radius 1.5D / PE moulded) | 16 | buy | stainless 1.4301 press-fit system (EN 10312), EPDM seals, glycol 40 % | DN25 | as pipe | 4.8 | cad_out/plant/piping/
ELB-SS316D-DN25-90 | elbow 90 deg, SS316D DN25 (long radius 1.5D / PE moulded) | 1 | buy | stainless 316L Sch10S, TIG-welded (acidic start-up condensate) | DN25 | as pipe | 0.3 | cad_out/plant/piping/
ELB-SS316F-DN15-90 | elbow 90 deg, SS316F DN15 (long radius 1.5D / PE moulded) | 3 | buy | stainless 316 Sch80 seamless, listed threaded/press fittings, FK-5-1-12 system pressure | DN15 | as pipe | 0.5 | cad_out/plant/piping/
TEE-CS40-DN40x20 | reducing tee CS40 DN40 x DN20 | 1 | buy | carbon steel EN 10216-2 P235GH / A106 Gr.B, Sch40 seamless, welded, PN16 | DN40xDN20 | as pipe | 0.8 | cad_out/plant/piping/
TEE-CS40-DN40x25 | reducing tee CS40 DN40 x DN25 | 8 | buy | carbon steel EN 10216-2 P235GH / A106 Gr.B, Sch40 seamless, welded, PN16 | DN40xDN25 | as pipe | 6.4 | cad_out/plant/piping/
TEE-CS40-DN40x40 | equal tee CS40 DN40 x DN40 | 2 | buy | carbon steel EN 10216-2 P235GH / A106 Gr.B, Sch40 seamless, welded, PN16 | DN40xDN40 | as pipe | 1.6 | cad_out/plant/piping/
TEE-CS40-DN50x20 | reducing tee CS40 DN50 x DN20 | 2 | buy | carbon steel EN 10216-2 P235GH / A106 Gr.B, Sch40 seamless, welded, PN16 | DN50xDN20 | as pipe | 2.0 | cad_out/plant/piping/
TEE-CS40-DN50x40 | reducing tee CS40 DN50 x DN40 | 4 | buy | carbon steel EN 10216-2 P235GH / A106 Gr.B, Sch40 seamless, welded, PN16 | DN50xDN40 | as pipe | 4.0 | cad_out/plant/piping/
TEE-CS40-DN65x25 | reducing tee CS40 DN65 x DN25 | 2 | buy | carbon steel EN 10216-2 P235GH / A106 Gr.B, Sch40 seamless, welded, PN16 | DN65xDN25 | as pipe | 2.6 | cad_out/plant/piping/
TEE-CS40-DN65x40 | reducing tee CS40 DN65 x DN40 | 2 | buy | carbon steel EN 10216-2 P235GH / A106 Gr.B, Sch40 seamless, welded, PN16 | DN65xDN40 | as pipe | 2.6 | cad_out/plant/piping/
TEE-CS40-DN65x50 | reducing tee CS40 DN65 x DN50 | 2 | buy | carbon steel EN 10216-2 P235GH / A106 Gr.B, Sch40 seamless, welded, PN16 | DN65xDN50 | as pipe | 2.6 | cad_out/plant/piping/
TEE-PE100-DN100x100 | equal tee PE100 DN100 x DN100 | 1 | buy | PE100 SDR11 PN16 black, UV-stabilised, butt/electro-fusion; steel spools at valves | DN100xDN100 | as pipe | 2.0 | cad_out/plant/piping/
TEE-PE100-DN100x25 | reducing tee PE100 DN100 x DN25 | 2 | buy | PE100 SDR11 PN16 black, UV-stabilised, butt/electro-fusion; steel spools at valves | DN100xDN25 | as pipe | 4.0 | cad_out/plant/piping/
TEE-PE100-DN100x32 | reducing tee PE100 DN100 x DN32 | 2 | buy | PE100 SDR11 PN16 black, UV-stabilised, butt/electro-fusion; steel spools at valves | DN100xDN32 | as pipe | 4.0 | cad_out/plant/piping/
TEE-PE100-DN100x65 | reducing tee PE100 DN100 x DN65 | 6 | buy | PE100 SDR11 PN16 black, UV-stabilised, butt/electro-fusion; steel spools at valves | DN100xDN65 | as pipe | 12.0 | cad_out/plant/piping/
TEE-PE100-DN100x80 | reducing tee PE100 DN100 x DN80 | 1 | buy | PE100 SDR11 PN16 black, UV-stabilised, butt/electro-fusion; steel spools at valves | DN100xDN80 | as pipe | 2.0 | cad_out/plant/piping/
TEE-PPR-DN20x15 | reducing tee PPR DN20 x DN15 | 1 | buy | PP-R PN16 (EN ISO 15874), fusion-welded | DN20xDN15 | as pipe | 0.4 | cad_out/plant/piping/
RED-CS40-DN40x25 | concentric reducer CS40 DN40 x DN25 at equipment nozzle | 2 | buy | carbon steel EN 10216-2 P235GH / A106 Gr.B, Sch40 seamless, welded, PN16 | DN40xDN25 | as pipe | 0.8 | cad_out/plant/piping/ | final nozzle sizes per datasheets
RED-PE100-DN100x80 | concentric reducer PE100 DN100 x DN80 at equipment nozzle | 1 | buy | PE100 SDR11 PN16 black, UV-stabilised, butt/electro-fusion; steel spools at valves | DN100xDN80 | as pipe | 0.4 | cad_out/plant/piping/ | final nozzle sizes per datasheets
FLG-DN32-weld-neck | flange set DN32 weld-neck PN16 + gasket + bolt set (A4 or galv.) | 2 | buy | EN 1092-1 PN16, EPDM/graphite gasket | DN32 | domestic / EU | 0.8 | cad_out/plant/piping/
FLG-DN40-weld-neck | flange set DN40 weld-neck PN16 + gasket + bolt set (A4 or galv.) | 32 | buy | EN 1092-1 PN16, EPDM/graphite gasket | DN40 | domestic / EU | 15.4 | cad_out/plant/piping/
FLG-DN50-weld-neck | flange set DN50 weld-neck PN16 + gasket + bolt set (A4 or galv.) | 51 | buy | EN 1092-1 PN16, EPDM/graphite gasket | DN50 | domestic / EU | 30.6 | cad_out/plant/piping/
FLG-DN65-PE | flange set DN65 PE stub-end + backing ring + gasket + bolt set (A4 or galv.) | 6 | buy | EN 1092-1 PN16, EPDM/graphite gasket | DN65 | domestic / EU | 4.7 | cad_out/plant/piping/
FLG-DN65-weld-neck | flange set DN65 weld-neck PN16 + gasket + bolt set (A4 or galv.) | 14 | buy | EN 1092-1 PN16, EPDM/graphite gasket | DN65 | domestic / EU | 10.9 | cad_out/plant/piping/
FLG-DN80-PE | flange set DN80 PE stub-end + backing ring + gasket + bolt set (A4 or galv.) | 5 | buy | EN 1092-1 PN16, EPDM/graphite gasket | DN80 | domestic / EU | 4.8 | cad_out/plant/piping/
FLG-DN100-PE | flange set DN100 PE stub-end + backing ring + gasket + bolt set (A4 or galv.) | 10 | buy | EN 1092-1 PN16, EPDM/graphite gasket | DN100 | domestic / EU | 12.0 | cad_out/plant/piping/
INS-DW50-DN250 | pipe insulation integral double-wall insulation (part of the duct) on DN250 | 3.9 | buy | integral double-wall insulation (part of the duct) | DN250, 48 mm | Rockwool, Isover (EU) / Armacell, K-Flex (EU); domestic equivalents | 0.0 | cad_out/plant/piping/ | unit: m incl. 8 % for fittings
INS-EL19-DN25 | pipe insulation elastomeric (k <= 0.036) 19 mm, indoor on DN25 | 42.8 | buy | elastomeric (k <= 0.036) 19 mm, indoor | DN25, 19 mm | Rockwool, Isover (EU) / Armacell, K-Flex (EU); domestic equivalents | 8.1 | cad_out/plant/piping/ | unit: m incl. 8 % for fittings
INS-EL19-DN40 | pipe insulation elastomeric (k <= 0.036) 19 mm, indoor on DN40 | 10.8 | buy | elastomeric (k <= 0.036) 19 mm, indoor | DN40, 19 mm | Rockwool, Isover (EU) / Armacell, K-Flex (EU); domestic equivalents | 2.6 | cad_out/plant/piping/ | unit: m incl. 8 % for fittings
INS-EL25H-DN15 | pipe insulation elastomeric 25 mm over self-regulating heat tracing 20 W/m + aluminium cladding on DN15 | 10.3 | buy | elastomeric 25 mm over self-regulating heat tracing 20 W/m + aluminium cladding | DN15, 25 mm | Rockwool, Isover (EU) / Armacell, K-Flex (EU); domestic equivalents | 6.5 | cad_out/plant/piping/ | unit: m incl. 8 % for fittings
INS-EL25H-DN20 | pipe insulation elastomeric 25 mm over self-regulating heat tracing 20 W/m + aluminium cladding on DN20 | 11.1 | buy | elastomeric 25 mm over self-regulating heat tracing 20 W/m + aluminium cladding | DN20, 25 mm | Rockwool, Isover (EU) / Armacell, K-Flex (EU); domestic equivalents | 7.6 | cad_out/plant/piping/ | unit: m incl. 8 % for fittings
INS-EL40-DN20 | pipe insulation elastomeric (k <= 0.036) 40 mm + 0.8 mm aluminium / GRP cladding, roof on DN20 | 17.0 | buy | elastomeric (k <= 0.036) 40 mm + 0.8 mm aluminium / GRP cladding, roof | DN20, 40 mm | Rockwool, Isover (EU) / Armacell, K-Flex (EU); domestic equivalents | 19.4 | cad_out/plant/piping/ | unit: m incl. 8 % for fittings
INS-EL40-DN40 | pipe insulation elastomeric (k <= 0.036) 40 mm + 0.8 mm aluminium / GRP cladding, roof on DN40 | 33.3 | buy | elastomeric (k <= 0.036) 40 mm + 0.8 mm aluminium / GRP cladding, roof | DN40, 40 mm | Rockwool, Isover (EU) / Armacell, K-Flex (EU); domestic equivalents | 47.5 | cad_out/plant/piping/ | unit: m incl. 8 % for fittings
INS-EL40-DN50 | pipe insulation elastomeric (k <= 0.036) 40 mm + 0.8 mm aluminium / GRP cladding, roof on DN50 | 10.6 | buy | elastomeric (k <= 0.036) 40 mm + 0.8 mm aluminium / GRP cladding, roof | DN50, 40 mm | Rockwool, Isover (EU) / Armacell, K-Flex (EU); domestic equivalents | 16.9 | cad_out/plant/piping/ | unit: m incl. 8 % for fittings
INS-MW50-DN25 | pipe insulation stone wool pipe section 50 mm, 100 kg/m3, + 0.6 mm aluminium cladding on DN25 | 14.8 | buy | stone wool pipe section 50 mm, 100 kg/m3, + 0.6 mm aluminium cladding | DN25, 50 mm | Rockwool, Isover (EU) / Armacell, K-Flex (EU); domestic equivalents | 31.2 | cad_out/plant/piping/ | unit: m incl. 8 % for fittings
INS-MW50-DN40 | pipe insulation stone wool pipe section 50 mm, 100 kg/m3, + 0.6 mm aluminium cladding on DN40 | 9.3 | buy | stone wool pipe section 50 mm, 100 kg/m3, + 0.6 mm aluminium cladding | DN40, 50 mm | Rockwool, Isover (EU) / Armacell, K-Flex (EU); domestic equivalents | 22.5 | cad_out/plant/piping/ | unit: m incl. 8 % for fittings
INS-MW50-DN50 | pipe insulation stone wool pipe section 50 mm, 100 kg/m3, + 0.6 mm aluminium cladding on DN50 | 12.5 | buy | stone wool pipe section 50 mm, 100 kg/m3, + 0.6 mm aluminium cladding | DN50, 50 mm | Rockwool, Isover (EU) / Armacell, K-Flex (EU); domestic equivalents | 33.6 | cad_out/plant/piping/ | unit: m incl. 8 % for fittings
INS-MW50-DN65 | pipe insulation stone wool pipe section 50 mm, 100 kg/m3, + 0.6 mm aluminium cladding on DN65 | 9.5 | buy | stone wool pipe section 50 mm, 100 kg/m3, + 0.6 mm aluminium cladding | DN65, 50 mm | Rockwool, Isover (EU) / Armacell, K-Flex (EU); domestic equivalents | 28.7 | cad_out/plant/piping/ | unit: m incl. 8 % for fittings
HT-1 | self-regulating heat tracing 20 W/m + controller + RCD 30 mA (make-up, pad/fill water) | 22.8 | buy | self-regulating cable, IP67 kit, ambient thermostat 3 C | 20 W/m | Eltherm (DE), Heat Trace Ltd (UK); Chinese | 3.0 | cad_out/plant/piping/ | unit: m
SUP-147 | hall hanger M10 rod + insulated clamp DN20 | 3 | buy | recycled-rubber base / galvanised post, U-bolt, EPDM liner (CHW: insulated support block) | - | Big Foot Systems (UK), Kee Safety (UK), Sikla (DE); domestic | 24 | cad_out/plant/structure.step | auto-placed
SUP-148 | hall hanger M10 rod + insulated clamp DN25 | 19 | buy | recycled-rubber base / galvanised post, U-bolt, EPDM liner (CHW: insulated support block) | - | Big Foot Systems (UK), Kee Safety (UK), Sikla (DE); domestic | 152 | cad_out/plant/structure.step | auto-placed
SUP-149 | hall hanger M10 rod + insulated clamp DN40 | 3 | buy | recycled-rubber base / galvanised post, U-bolt, EPDM liner (CHW: insulated support block) | - | Big Foot Systems (UK), Kee Safety (UK), Sikla (DE); domestic | 24 | cad_out/plant/structure.step | auto-placed
SUP-150 | roof pipe stand, rubber base + galv. post + U-bolt, h 0.6 m | 1 | buy | recycled-rubber base / galvanised post, U-bolt, EPDM liner (CHW: insulated support block) | - | Big Foot Systems (UK), Kee Safety (UK), Sikla (DE); domestic | 8 | cad_out/plant/structure.step | auto-placed
SUP-151 | roof pipe stand, rubber base + galv. post + U-bolt, h 0.7 m | 5 | buy | recycled-rubber base / galvanised post, U-bolt, EPDM liner (CHW: insulated support block) | - | Big Foot Systems (UK), Kee Safety (UK), Sikla (DE); domestic | 40 | cad_out/plant/structure.step | auto-placed
SUP-152 | roof pipe stand, rubber base + galv. post + U-bolt, h 0.9 m | 2 | buy | recycled-rubber base / galvanised post, U-bolt, EPDM liner (CHW: insulated support block) | - | Big Foot Systems (UK), Kee Safety (UK), Sikla (DE); domestic | 16 | cad_out/plant/structure.step | auto-placed
SUP-153 | roof pipe support, recycled-rubber base + galv. post/clamp, h <= 0.6 m | 41 | buy | recycled-rubber base / galvanised post, U-bolt, EPDM liner (CHW: insulated support block) | - | Big Foot Systems (UK), Kee Safety (UK), Sikla (DE); domestic | 328 | cad_out/plant/structure.step | auto-placed
DUN-HEA140 | roof dunnage beams HEA140 under all equipment, hot-dip galvanised, on EPDM bearing pads; structural engineer to confirm bearing points over RC beams | 43.1 | make | S275 HEA140, HDG | 24.7 kg/m | domestic steel; galvaniser | 1066 | cad_out/plant/structure.step | unit: m
DUN-PAD | EPDM bearing pad 200 x 200 x 22 mm under dunnage | 72 | buy | EPDM 60 ShA | 200x200x22 | domestic | 86.4 | cad_out/plant/structure.step
ISO-SPR | spring isolator, 25 mm static deflection, levelling bolt, seismic restraint (PS-1, PS-2, CT-1 ring) | 20 | buy | housed open spring + neoprene cup | 150-400 kg each | Getzner (AT), Christie & Grey (UK); domestic | 60 | cad_out/plant/items/ | +6 under CT-1 base ring
ISO-PAD | neoprene/ribbed isolation pad under equipment feet | 16 | buy | neoprene 2-layer ribbed | 160x160x25 | Getzner (AT); domestic | 12.8 | cad_out/plant/items/
WALK | GRP walkway grating tiles on adjustable roof pads (anti-slip, yellow) | 8.6 | buy | GRP 38 mm moulded grating | m2 | Fibrelite (UK), Kee Safety (UK); domestic GRP | 155 | cad_out/plant/structure.step | unit: m2
STILE-0 | GRP step-over stile with handrail over pipe crossing | 1 | buy | GRP grating 38 mm, SS fixings, h 0.50 m | 0.82 x 0.62 m deck | Kee Safety (UK), Fibrelite (UK), domestic GRP fabricators | 41 | cad_out/plant/structure.step | auto-placed where low pipes cross a walkway
STILE-1 | GRP step-over stile with handrail over pipe crossing | 1 | buy | GRP grating 38 mm, SS fixings, h 0.50 m | 1.32 x 0.62 m deck | Kee Safety (UK), Fibrelite (UK), domestic GRP fabricators | 51 | cad_out/plant/structure.step | auto-placed where low pipes cross a walkway
STILE-2 | GRP step-over stile with handrail over pipe crossing | 1 | buy | GRP grating 38 mm, SS fixings, h 0.50 m | 0.96 x 0.70 m deck | Kee Safety (UK), Fibrelite (UK), domestic GRP fabricators | 44 | cad_out/plant/structure.step | auto-placed where low pipes cross a walkway
STILE-3 | GRP step-over stile with handrail over pipe crossing | 1 | buy | GRP grating 38 mm, SS fixings, h 0.50 m | 0.98 x 0.70 m deck | Kee Safety (UK), Fibrelite (UK), domestic GRP fabricators | 45 | cad_out/plant/structure.step | auto-placed where low pipes cross a walkway
STILE-4 | GRP step-over stile with handrail over pipe crossing | 1 | buy | GRP grating 38 mm, SS fixings, h 0.50 m | 0.90 x 0.70 m deck | Kee Safety (UK), Fibrelite (UK), domestic GRP fabricators | 43 | cad_out/plant/structure.step | auto-placed where low pipes cross a walkway
TE-101 | instrument: دمای گاز اگزوز ورودی HX-1 (بعد از recuperator) | 1 | buy | type K, Inconel sheath | 0-600 °C | WIKA, JUMO, Endress+Hauser (DE/CH), Huba (CH), Vaisala (FI), Kobold (DE) | 0.5 | not modelled (installed on line/equipment; < 1 kg) | location: duct before D-101; board B2 (io_list.csv)
TE-102 | instrument: دمای گاز خروجی HX-1 | 1 | buy | type K, Inconel sheath | 0-400 °C | WIKA, JUMO, Endress+Hauser (DE/CH), Huba (CH), Vaisala (FI), Kobold (DE) | 0.5 | not modelled (installed on line/equipment; < 1 kg) | location: HX-1 outlet; board B6-R (io_list.csv)
TE-103 | instrument: دمای دودکش مشترک | 1 | buy | type K, Inconel sheath | 0-600 °C | WIKA, JUMO, Endress+Hauser (DE/CH), Huba (CH), Vaisala (FI), Kobold (DE) | 0.5 | not modelled (installed on line/equipment; < 1 kg) | location: ST-1; board B6-R (io_list.csv)
PT-101 | instrument: فشار برگشتی اگزوز قبل از diverter D-101 | 1 | buy | 4-20 mA transmitter | -0.5..+2.5 kPa | WIKA, JUMO, Endress+Hauser (DE/CH), Huba (CH), Vaisala (FI), Kobold (DE) | 0.5 | not modelled (installed on line/equipment; < 1 kg) | location: duct before D-101; board B2 (io_list.csv)
PDT-102 | instrument: افت فشار سمت گاز HX-1 | 1 | buy | 4-20 mA transmitter | 0-1 kPa | WIKA, JUMO, Endress+Hauser (DE/CH), Huba (CH), Vaisala (FI), Kobold (DE) | 0.5 | not modelled (installed on line/equipment; < 1 kg) | location: across HX-1; board B6-R (io_list.csv)
ZT-101 | instrument: فیدبک موقعیت D-101 | 1 | buy | AI-V | 2-10 V = 0-100 % | WIKA, JUMO, Endress+Hauser (DE/CH), Huba (CH), Vaisala (FI), Kobold (DE) | 0.5 | not modelled (installed on line/equipment; < 1 kg) | location: D-101; board B2 (io_list.csv)
TE-104 | instrument: دمای هوای ورودی موتور پشت لوور (تشخیص recirculation) | 1 | buy | PT1000 class A, 316 thermowell, 3-wire | -10..+70 °C | WIKA, JUMO, Endress+Hauser (DE/CH), Huba (CH), Vaisala (FI), Kobold (DE) | 0.5 | not modelled (installed on line/equipment; < 1 kg) | location: IF-1 inlet; board B6-R (io_list.csv)
TE-111 | instrument: دمای رفت آب داغ (خروجی HX-1) | 1 | buy | PT1000 class A, 316 thermowell, 3-wire | 0-150 °C | WIKA, JUMO, Endress+Hauser (DE/CH), Huba (CH), Vaisala (FI), Kobold (DE) | 0.5 | not modelled (installed on line/equipment; < 1 kg) | location: HX-1 outlet; board B6-R (io_list.csv)
TSHH-111 | instrument: ترموستات حد بالا آب داغ 98 °C (manual reset) | 1 | buy | SAFE-DI | NC contact x2 | WIKA, JUMO, Endress+Hauser (DE/CH), Huba (CH), Vaisala (FI), Kobold (DE) | 0.5 | not modelled (installed on line/equipment; < 1 kg) | location: HX-1 outlet; board SR1 (io_list.csv)
PSH-111 | instrument: سوئیچ فشار بالای مدار آب داغ 5.0 bar | 1 | buy | SAFE-DI | NC contact | WIKA, JUMO, Endress+Hauser (DE/CH), Huba (CH), Vaisala (FI), Kobold (DE) | 0.5 | not modelled (installed on line/equipment; < 1 kg) | location: HX-1 outlet; board SR1 (io_list.csv)
TE-112 | instrument: دمای برگشت آب به HX-1 | 1 | buy | PT1000 class A, 316 thermowell, 3-wire | 0-150 °C | WIKA, JUMO, Endress+Hauser (DE/CH), Huba (CH), Vaisala (FI), Kobold (DE) | 0.5 | not modelled (installed on line/equipment; < 1 kg) | location: HX-1 inlet; board B6-R (io_list.csv)
PT-111 | instrument: فشار استاتیک مدار آب داغ | 1 | buy | 4-20 mA transmitter | 0-10 bar | WIKA, JUMO, Endress+Hauser (DE/CH), Huba (CH), Vaisala (FI), Kobold (DE) | 0.5 | not modelled (installed on line/equipment; < 1 kg) | location: P-1 suction; board B6-R (io_list.csv)
FSL-111 | instrument: فلوسوئیچ مدار اولیه (paddle/thermal) | 1 | buy | SAFE-DI | NC contact | WIKA, JUMO, Endress+Hauser (DE/CH), Huba (CH), Vaisala (FI), Kobold (DE) | 0.5 | not modelled (installed on line/equipment; < 1 kg) | location: HX-1 inlet; board SR1 (io_list.csv)
TE-113 | instrument: دمای بالای LLH-1 | 1 | buy | PT1000 class A, 316 thermowell, 3-wire | 0-150 °C | WIKA, JUMO, Endress+Hauser (DE/CH), Huba (CH), Vaisala (FI), Kobold (DE) | 0.5 | not modelled (installed on line/equipment; < 1 kg) | location: LLH-1; board B6-R (io_list.csv)
TE-114 | instrument: دمای برگشت مصرف‌کننده‌ها به LLH-1 | 1 | buy | PT1000 class A, 316 thermowell, 3-wire | 0-150 °C | WIKA, JUMO, Endress+Hauser (DE/CH), Huba (CH), Vaisala (FI), Kobold (DE) | 0.5 | not modelled (installed on line/equipment; < 1 kg) | location: LLH-1; board B6-R (io_list.csv)
TE-131 | instrument: دمای رفت شاخهٔ DHW/گرمایش | 1 | buy | PT1000 class A, 316 thermowell, 3-wire | 0-150 °C | WIKA, JUMO, Endress+Hauser (DE/CH), Huba (CH), Vaisala (FI), Kobold (DE) | 0.5 | not modelled (installed on line/equipment; < 1 kg) | location: PS-1; board B6-R (io_list.csv)
TE-132 | instrument: دمای بالای مخزن DHW | 1 | buy | PT1000 class A, 316 thermowell, 3-wire | 0-100 °C | WIKA, JUMO, Endress+Hauser (DE/CH), Huba (CH), Vaisala (FI), Kobold (DE) | 0.5 | not modelled (installed on line/equipment; < 1 kg) | location: DHW tank (indoor); board B6-E (io_list.csv)
TE-133 | instrument: دمای پایین مخزن DHW | 1 | buy | PT1000 class A, 316 thermowell, 3-wire | 0-100 °C | WIKA, JUMO, Endress+Hauser (DE/CH), Huba (CH), Vaisala (FI), Kobold (DE) | 0.5 | not modelled (installed on line/equipment; < 1 kg) | location: DHW tank (indoor); board B6-E (io_list.csv)
TE-231 | instrument: دمای رفت گرمایش (ثانویهٔ HX-3) | 1 | buy | PT1000 class A, 316 thermowell, 3-wire | 0-100 °C | WIKA, JUMO, Endress+Hauser (DE/CH), Huba (CH), Vaisala (FI), Kobold (DE) | 0.5 | not modelled (installed on line/equipment; < 1 kg) | location: PS-1; board B6-R (io_list.csv)
TE-201 | instrument: دمای خروجی آب سرد CH-1 | 1 | buy | PT1000 class A, 316 thermowell, 3-wire | -10..+60 °C | WIKA, JUMO, Endress+Hauser (DE/CH), Huba (CH), Vaisala (FI), Kobold (DE) | 0.5 | not modelled (installed on line/equipment; < 1 kg) | location: CH-1; board B6-R (io_list.csv)
TE-202 | instrument: دمای خروجی آب سرد CH-2 | 1 | buy | PT1000 class A, 316 thermowell, 3-wire | -10..+60 °C | WIKA, JUMO, Endress+Hauser (DE/CH), Huba (CH), Vaisala (FI), Kobold (DE) | 0.5 | not modelled (installed on line/equipment; < 1 kg) | location: CH-2; board B6-R (io_list.csv)
TE-203 | instrument: دمای خروجی آب خنک‌کن CH-1 | 1 | buy | PT1000 class A, 316 thermowell, 3-wire | 0-60 °C | WIKA, JUMO, Endress+Hauser (DE/CH), Huba (CH), Vaisala (FI), Kobold (DE) | 0.5 | not modelled (installed on line/equipment; < 1 kg) | location: CH-1; board B6-R (io_list.csv)
TE-204 | instrument: دمای خروجی آب خنک‌کن CH-2 | 1 | buy | PT1000 class A, 316 thermowell, 3-wire | 0-60 °C | WIKA, JUMO, Endress+Hauser (DE/CH), Huba (CH), Vaisala (FI), Kobold (DE) | 0.5 | not modelled (installed on line/equipment; < 1 kg) | location: CH-2; board B6-R (io_list.csv)
FS-201 | instrument: فلوسوئیچ آب سرد CH-1 | 1 | buy | switch, dry contact | dry contact | WIKA, JUMO, Endress+Hauser (DE/CH), Huba (CH), Vaisala (FI), Kobold (DE) | 0.5 | not modelled (installed on line/equipment; < 1 kg) | location: CH-1; board B6-R (io_list.csv)
FS-202 | instrument: فلوسوئیچ آب سرد CH-2 | 1 | buy | switch, dry contact | dry contact | WIKA, JUMO, Endress+Hauser (DE/CH), Huba (CH), Vaisala (FI), Kobold (DE) | 0.5 | not modelled (installed on line/equipment; < 1 kg) | location: CH-2; board B6-R (io_list.csv)
FS-301 | instrument: فلوسوئیچ آب خنک‌کن CH-1 | 1 | buy | switch, dry contact | dry contact | WIKA, JUMO, Endress+Hauser (DE/CH), Huba (CH), Vaisala (FI), Kobold (DE) | 0.5 | not modelled (installed on line/equipment; < 1 kg) | location: CH-1; board B6-R (io_list.csv)
FS-302 | instrument: فلوسوئیچ آب خنک‌کن CH-2 | 1 | buy | switch, dry contact | dry contact | WIKA, JUMO, Endress+Hauser (DE/CH), Huba (CH), Vaisala (FI), Kobold (DE) | 0.5 | not modelled (installed on line/equipment; < 1 kg) | location: CH-2; board B6-R (io_list.csv)
TE-211 | instrument: دمای بالای مخزن TK-1 (رفت به مصرف) | 1 | buy | PT1000 class A, 316 thermowell, 3-wire | -10..+60 °C | WIKA, JUMO, Endress+Hauser (DE/CH), Huba (CH), Vaisala (FI), Kobold (DE) | 0.5 | not modelled (installed on line/equipment; < 1 kg) | location: TK-1; board B6-R (io_list.csv)
TE-212 | instrument: دمای پایین مخزن TK-1 | 1 | buy | PT1000 class A, 316 thermowell, 3-wire | -10..+60 °C | WIKA, JUMO, Endress+Hauser (DE/CH), Huba (CH), Vaisala (FI), Kobold (DE) | 0.5 | not modelled (installed on line/equipment; < 1 kg) | location: TK-1; board B6-R (io_list.csv)
TE-213 | instrument: دمای برگشت آب سرد از مصرف‌کننده‌ها | 1 | buy | PT1000 class A, 316 thermowell, 3-wire | -10..+60 °C | WIKA, JUMO, Endress+Hauser (DE/CH), Huba (CH), Vaisala (FI), Kobold (DE) | 0.5 | not modelled (installed on line/equipment; < 1 kg) | location: header; board B6-R (io_list.csv)
TE-214 | instrument: دمای وسط مخزن TK-1 (لایه‌بندی، ذخیرهٔ سرما) | 1 | buy | PT1000 class A, 316 thermowell, 3-wire | -10..+60 °C | WIKA, JUMO, Endress+Hauser (DE/CH), Huba (CH), Vaisala (FI), Kobold (DE) | 0.5 | not modelled (installed on line/equipment; < 1 kg) | location: TK-1; board B6-R (io_list.csv)
PT-211 | instrument: فشار استاتیک مدار آب سرد | 1 | buy | 4-20 mA transmitter | 0-10 bar | WIKA, JUMO, Endress+Hauser (DE/CH), Huba (CH), Vaisala (FI), Kobold (DE) | 0.5 | not modelled (installed on line/equipment; < 1 kg) | location: P-5 suction; board B6-R (io_list.csv)
DPT-211 | instrument: اختلاف فشار index (پای رایزر سالن) | 1 | buy | 4-20 mA transmitter | 0-2.5 bar | WIKA, JUMO, Endress+Hauser (DE/CH), Huba (CH), Vaisala (FI), Kobold (DE) | 0.5 | not modelled (installed on line/equipment; < 1 kg) | location: hall riser; board B6-R (io_list.csv)
ZT-221 | instrument: فیدبک موقعیت TV-221 | 1 | buy | AI-V | 2-10 V | WIKA, JUMO, Endress+Hauser (DE/CH), Huba (CH), Vaisala (FI), Kobold (DE) | 0.5 | not modelled (installed on line/equipment; < 1 kg) | location: CC-1; board B6-R (io_list.csv)
TE-221 | instrument: دمای هوای بعد از کویل CC-1 | 1 | buy | PT1000 class A, 316 thermowell, 3-wire | -10..+70 °C | WIKA, JUMO, Endress+Hauser (DE/CH), Huba (CH), Vaisala (FI), Kobold (DE) | 0.5 | not modelled (installed on line/equipment; < 1 kg) | location: IF-1 after coil; board B6-R (io_list.csv)
TE-222 | instrument: دمای آب خروجی کویل CC-1 | 1 | buy | PT1000 class A, 316 thermowell, 3-wire | -10..+60 °C | WIKA, JUMO, Endress+Hauser (DE/CH), Huba (CH), Vaisala (FI), Kobold (DE) | 0.5 | not modelled (installed on line/equipment; < 1 kg) | location: CC-1; board B6-R (io_list.csv)
MT-501 | instrument: رطوبت نسبی هوای بعد از کویل CC-1 | 1 | buy | 4-20 mA transmitter | 0-100 % | WIKA, JUMO, Endress+Hauser (DE/CH), Huba (CH), Vaisala (FI), Kobold (DE) | 0.5 | not modelled (installed on line/equipment; < 1 kg) | location: IF-1 after coil; board B2 (io_list.csv)
LSH-221 | instrument: سطح بالای سینی کندانس CC-1 (float) | 1 | buy | switch, dry contact | dry contact | WIKA, JUMO, Endress+Hauser (DE/CH), Huba (CH), Vaisala (FI), Kobold (DE) | 0.5 | not modelled (installed on line/equipment; < 1 kg) | location: CC-1; board B6-R (io_list.csv)
PDT-222 | instrument: افت فشار فیلترهای G4 و F8 ورودی هوا | 1 | buy | 4-20 mA transmitter | 0-500 Pa (x2) | WIKA, JUMO, Endress+Hauser (DE/CH), Huba (CH), Vaisala (FI), Kobold (DE) | 0.5 | not modelled (installed on line/equipment; < 1 kg) | location: IF-1; board B2 (io_list.csv)
PDT-223 | instrument: افت فشار سمت هوای کویل CC-1 | 1 | buy | 4-20 mA transmitter | 0-500 Pa | WIKA, JUMO, Endress+Hauser (DE/CH), Huba (CH), Vaisala (FI), Kobold (DE) | 0.5 | not modelled (installed on line/equipment; < 1 kg) | location: IF-1; board B2 (io_list.csv)
TT-OA | instrument: دمای هوای بیرون (radiation shield، سایه) | 1 | buy | 4-20 mA transmitter | -20..+60 °C | WIKA, JUMO, Endress+Hauser (DE/CH), Huba (CH), Vaisala (FI), Kobold (DE) | 0.5 | not modelled (installed on line/equipment; < 1 kg) | location: roof north side; board B6-R (io_list.csv)
MT-OA | instrument: رطوبت نسبی هوای بیرون | 1 | buy | 4-20 mA transmitter | 0-100 % | WIKA, JUMO, Endress+Hauser (DE/CH), Huba (CH), Vaisala (FI), Kobold (DE) | 0.5 | not modelled (installed on line/equipment; < 1 kg) | location: roof north side; board B6-R (io_list.csv)
TE-H1 | instrument: دما/رطوبت مرجع سالن | 1 | buy | BUS | Modbus RTU bus-2 | WIKA, JUMO, Endress+Hauser (DE/CH), Huba (CH), Vaisala (FI), Kobold (DE) | 0.5 | not modelled (installed on line/equipment; < 1 kg) | location: hall; board B6-R (io_list.csv)
AT-H1 | instrument: CO2 سالن (NDIR) | 1 | buy | BUS | Modbus RTU bus-2 | WIKA, JUMO, Endress+Hauser (DE/CH), Huba (CH), Vaisala (FI), Kobold (DE) | 0.5 | not modelled (installed on line/equipment; < 1 kg) | location: hall; board B6-R (io_list.csv)
TE-301 | instrument: دمای آب خنک‌کن رفت به چیلرها (خروجی برج) | 1 | buy | PT1000 class A, 316 thermowell, 3-wire | 0-60 °C | WIKA, JUMO, Endress+Hauser (DE/CH), Huba (CH), Vaisala (FI), Kobold (DE) | 0.5 | not modelled (installed on line/equipment; < 1 kg) | location: PS-2; board B6-R (io_list.csv)
TE-302 | instrument: دمای برگشت آب خنک‌کن به برج | 1 | buy | PT1000 class A, 316 thermowell, 3-wire | 0-60 °C | WIKA, JUMO, Endress+Hauser (DE/CH), Huba (CH), Vaisala (FI), Kobold (DE) | 0.5 | not modelled (installed on line/equipment; < 1 kg) | location: CT-1 inlet; board B6-R (io_list.csv)
TE-303 | instrument: دمای حوضچهٔ برج | 1 | buy | PT1000 class A, 316 thermowell, 3-wire | -10..+60 °C | WIKA, JUMO, Endress+Hauser (DE/CH), Huba (CH), Vaisala (FI), Kobold (DE) | 0.5 | not modelled (installed on line/equipment; < 1 kg) | location: CT-1 basin; board B6-R (io_list.csv)
TT-306 | instrument: دمای هوای ورودی برج (سایه، کنار لوور برج) | 1 | buy | 4-20 mA transmitter | -20..+60 °C | WIKA, JUMO, Endress+Hauser (DE/CH), Huba (CH), Vaisala (FI), Kobold (DE) | 0.5 | not modelled (installed on line/equipment; < 1 kg) | location: CT-1 inlet; board B6-R (io_list.csv)
MT-306 | instrument: رطوبت نسبی هوای ورودی برج | 1 | buy | 4-20 mA transmitter | 0-100 % | WIKA, JUMO, Endress+Hauser (DE/CH), Huba (CH), Vaisala (FI), Kobold (DE) | 0.5 | not modelled (installed on line/equipment; < 1 kg) | location: CT-1 inlet; board B6-R (io_list.csv)
VS-301 | instrument: سوئیچ ارتعاش فن برج | 1 | buy | switch, dry contact | dry contact | WIKA, JUMO, Endress+Hauser (DE/CH), Huba (CH), Vaisala (FI), Kobold (DE) | 0.5 | not modelled (installed on line/equipment; < 1 kg) | location: CT-1; board B6-R (io_list.csv)
LT-301 | instrument: سطح حوضچهٔ برج (hydrostatic) | 1 | buy | 4-20 mA transmitter | 0-500 mm | WIKA, JUMO, Endress+Hauser (DE/CH), Huba (CH), Vaisala (FI), Kobold (DE) | 0.5 | not modelled (installed on line/equipment; < 1 kg) | location: CT-1 basin; board B6-R (io_list.csv)
LSLL-301 | instrument: سطح خیلی پایین حوضچه (float) | 1 | buy | switch, dry contact | dry contact | WIKA, JUMO, Endress+Hauser (DE/CH), Huba (CH), Vaisala (FI), Kobold (DE) | 0.5 | not modelled (installed on line/equipment; < 1 kg) | location: CT-1 basin; board B6-R (io_list.csv)
AIT-301 | instrument: هدایت الکتریکی آب برج (کنترلر) | 1 | buy | 4-20 mA transmitter | 0-5000 µS/cm | WIKA, JUMO, Endress+Hauser (DE/CH), Huba (CH), Vaisala (FI), Kobold (DE) | 0.5 | not modelled (installed on line/equipment; < 1 kg) | location: side-stream; board B6-R (io_list.csv)
AIT-302 | instrument: ORP / کلر آزاد | 1 | buy | 4-20 mA transmitter | 0-1000 mV | WIKA, JUMO, Endress+Hauser (DE/CH), Huba (CH), Vaisala (FI), Kobold (DE) | 0.5 | not modelled (installed on line/equipment; < 1 kg) | location: side-stream; board B6-R (io_list.csv)
AIT-303 | instrument: pH آب برج | 1 | buy | 4-20 mA transmitter | 0-14 | WIKA, JUMO, Endress+Hauser (DE/CH), Huba (CH), Vaisala (FI), Kobold (DE) | 0.5 | not modelled (installed on line/equipment; < 1 kg) | location: side-stream; board B6-R (io_list.csv)
LSL-DP | instrument: سطح پایین مخازن مواد شیمیایی (x3) | 1 | buy | switch, dry contact | dry contact (x3) | WIKA, JUMO, Endress+Hauser (DE/CH), Huba (CH), Vaisala (FI), Kobold (DE) | 0.5 | not modelled (installed on line/equipment; < 1 kg) | location: WT-1; board B6-R (io_list.csv)
AIT-401 | instrument: هدایت permeate | 1 | buy | 4-20 mA transmitter | 0-200 µS/cm | WIKA, JUMO, Endress+Hauser (DE/CH), Huba (CH), Vaisala (FI), Kobold (DE) | 0.5 | not modelled (installed on line/equipment; < 1 kg) | location: RO-1; board B6-E (io_list.csv)
AIT-402 | instrument: هدایت آب جبرانی blend | 1 | buy | 4-20 mA transmitter | 0-2000 µS/cm | WIKA, JUMO, Endress+Hauser (DE/CH), Huba (CH), Vaisala (FI), Kobold (DE) | 0.5 | not modelled (installed on line/equipment; < 1 kg) | location: blend tank; board B6-E (io_list.csv)
LT-401 | instrument: سطح مخزن blend/permeate | 1 | buy | 4-20 mA transmitter | 0-1.5 m | WIKA, JUMO, Endress+Hauser (DE/CH), Huba (CH), Vaisala (FI), Kobold (DE) | 0.5 | not modelled (installed on line/equipment; < 1 kg) | location: blend tank; board B6-E (io_list.csv)
LSL-400 | instrument: سطح پایین مخزن آب شهری | 1 | buy | switch, dry contact | dry contact | WIKA, JUMO, Endress+Hauser (DE/CH), Huba (CH), Vaisala (FI), Kobold (DE) | 0.5 | not modelled (installed on line/equipment; < 1 kg) | location: city tank; board B6-E (io_list.csv)
LSL-403 | instrument: سطح پایین نمک مخزن brine سختی‌گیر | 1 | buy | switch, dry contact | dry contact | WIKA, JUMO, Endress+Hauser (DE/CH), Huba (CH), Vaisala (FI), Kobold (DE) | 0.5 | not modelled (installed on line/equipment; < 1 kg) | location: water room; board B6-E (io_list.csv)
TE-499 | instrument: دمای کابینت سیلندرهای FS-1 روی بام | 1 | buy | PT1000 class A, 316 thermowell, 3-wire | 0-80 °C | WIKA, JUMO, Endress+Hauser (DE/CH), Huba (CH), Vaisala (FI), Kobold (DE) | 0.5 | not modelled (installed on line/equipment; < 1 kg) | location: FS-1 cabinet; board B6-R (io_list.csv)
TE-GLY | instrument: دمای رفت گلیکول به PMG / B3 / خنک‌کن روغن | 1 | buy | PT1000 class A, 316 thermowell, 3-wire | 0-120 °C | WIKA, JUMO, Endress+Hauser (DE/CH), Huba (CH), Vaisala (FI), Kobold (DE) | 0.5 | not modelled (installed on line/equipment; < 1 kg) | location: DC-1 outlet; board B2 (io_list.csv)
SOFT-1 | twin alternating water softener, meter-initiated, 2 x 25 L resin, brine tank 100 L (LSL-403), 50 um prefilter; hardness < 100 ppm (pref. < 17), regeneration waste to sewer | 1 | buy | FRP vessels, Runxin/Canature valve | 0.5 m3/h | BWT (AT); Runxin, Canature (CN); resin Lanxess Lewatit (DE); domestic assemblers | 120 | cad_out/plant/indoor_water_dhw.step | indoor, local frame; position by site / electrical session
RO-1 | RO unit 400 L/h permeate, ULP membranes, VFD pump, 5 um cartridge, antiscalant dosing (only if chiller maker requires <= 800 uS/cm) | 1 | buy | skid, SS/PVC | 400 L/h, ~0.7 kWh/m3 | Toray (JP), LG Chem (KR), Vontron (CN) membranes; domestic skid | 90 | cad_out/plant/indoor_water_dhw.step | indoor, local frame; position by site / electrical session
TK-401 | blend / make-up tank 500 L with LT-401, AIT-402, TV-401 blend valve | 1 | buy | PE tank | 500 L | domestic | 540 | cad_out/plant/indoor_water_dhw.step | indoor, local frame; position by site / electrical session
P-9 | make-up booster pump with pressure vessel, ECM/VFD (to roof) | 1 | buy | multistage | 0.5 m3/h @ 25 m | Grundfos SCALA2/CMBE (DK), Wilo (DE), DAB (IT) | 25 | cad_out/plant/indoor_water_dhw.step | indoor, local frame; position by site / electrical session
TK-DHW | DHW storage tank 500 L, 316L or enamelled, T&P valve, potable expansion vessel, TMV 50 C | 1 | buy | EN 12897 | 500 L | domestic tank makers; Caleffi TMV (IT) | 650 | cad_out/plant/indoor_water_dhw.step | indoor, local frame; position by site / electrical session
HX-2 | double-wall DHW charging PHE 30 kW, 90/70 -> 50/62 C | 1 | buy | SS316 double wall | 30 kW | Alfa Laval (SE), SWEP (SE), Kelvion (DE) | 40 | cad_out/plant/indoor_water_dhw.step | indoor, local frame; position by site / electrical session
P-7 | DHW charging / circulation pump, bronze or stainless | 1 | buy | ECM | 1 m3/h | Grundfos COMFORT/UP-B (DK), Wilo Star-Z (DE) | 5 | cad_out/plant/indoor_water_dhw.step | indoor, local frame; position by site / electrical session
FCU-E | electrical-room wall fan coil 400 CFM, EC, drain pan + condensate pump, 2-way valve; NOT above electrical equipment | 1 | buy | hydronic | 3.9 kW nominal | as FCU-1..4 | 25 | cad_out/plant/indoor_electrical_room.step | indoor, local frame; position by site / electrical session
AC-E | standby DX split 12 kBTU/h, T3 compressor (52 C), dry-contact enable | 1 | buy | inverter split | 3.5 kW | Gree, Midea (CN), LG, Samsung (KR) | 45 | cad_out/plant/indoor_electrical_room.step | indoor, local frame; position by site / electrical session
EF-E | electrical-room / battery exhaust fan with XV-497 spring-close damper + ZSC-497 | 1 | buy | EC fan + damper | 300 m3/h | ebm-papst (DE), Systemair (SE); Belimo damper | 12 | cad_out/plant/indoor_electrical_room.step | indoor, local frame; position by site / electrical session
LD-E | leak-detection cable under FCU-E and pipes + module | 1 | buy | sensing cable | 10 m | TTK FG-SYS (FR); Chinese | 2 | cad_out/plant/indoor_electrical_room.step | indoor, local frame; position by site / electrical session
FS-2 | FZ2 cylinder ~25 kg FK-5-1-12 (40 L class) with solenoid + manual actuator, PSL-890B, LLI, lock-off ZSC-899B, wall bracket | 1 | buy | listed system | 24.7 kg agent for 31.5 m3 (ASSUMED room) | Siemens Sinorix 1230, Minimax MX 1230 (DE) | 60 | cad_out/plant/indoor_electrical_room.step | indoor, local frame; position by site / electrical session
FZ2-PIPE | FZ2 discharge piping DN25 Sch80 316 (~6 m) + 1 x 360 deg nozzle at ceiling centre + pressure relief vent | 1 | buy | listed fittings | DN25 | per listed system | 25 | cad_out/plant/indoor_electrical_room.step | indoor, local frame; position by site / electrical session
FX-1..3 | portable extinguishers: roof 1 x CO2 5 kg + 1 x ABC 6 kg; electrical room 1 x CO2 5 kg | 1 | buy | EN 3 | 3 pcs | domestic certified | 40 | cad_out/plant/indoor_electrical_room.step | indoor, local frame; position by site / electrical session
CHEM | water-treatment chemicals (phosphonate/polymer/TTA inhibitor, BCDMH or NaOCl+NaBr, isothiazolinone/DBNPA, molybdate for closed loops, MgO granulate) - first fill + 3 months | 1 | buy | service contract | lot | Kurita (JP), BWA (UK); domestic | 200 | cad_out/plant/indoor_water_dhw.step | indoor, local frame; position by site / electrical session
GLY | propylene glycol 40 % premix for engine loop (~60 L incl. perimeter piping) | 1 | buy | inhibited MPG | 60 L | Clariant Antifrogen (DE); domestic | 62 | not modelled (fluid)
