ahmadreza221/aurora-cchp/docs/bom/engine_E3_bom.csv

tag | description | qty | make_or_buy | material_or_spec | size_or_rating | supplier_candidates | mass_kg | model_file | notes
E3-101 | Interduct NGV module | 1 | make | SLM IN718 (iDesign3D, Tehran); stress relief + solution/age AMS 5662; flanges & seal lands machined 5-axis | 90 x 176 x 176 mm | iDesign3D (IR) | 2.633 | cad_out/engine/E3/E3-101_Interduct_NGV_module.step | NGV 23 vanes; integral stationary hub cone over the GG nut; 2 TC + 1 P boss
E3-102 | Shroud DiffuserWestWall | 1 | make | IN718 ring (5-axis/turn) + IN625 1.5-3 mm radial wall, EB/TIG weld | 30 x 250 x 250 mm | local 5-axis shop; IN718 bar VDM Metals (DE) / GH4169 (CN) | 1.409 | cad_out/engine/E3/E3-102_Shroud_DiffuserWestWall.step | tip gap 0.30 mm cold (0.35 at assembly, check growth)
E3-110 | Collector Body | 1 | make | 1.4828/310S sheet 2.5-3 mm, TIG; DN250 PN6 flange 1.4541; hub bell spun | 375 x 485 x 470 mm | local fabrication (robotic weld OK) | 19.23 | cad_out/engine/E3/E3-110_Collector_Body.step | insulate outside (E5): 610 C surface
E3-111 | Collector WestCover | 1 | make | 1.4828 plate 6 mm laser + machined, 24 x M8 to drum flange | 6 x 470 x 470 mm | local | 7.763 | cad_out/engine/E3/E3-111_Collector_WestCover.step | hot module (interduct+NGV+shroud) slides in from the west
E3-112 | Support Cone | 1 | make | IN625 1.5 mm spun cone + flange, 6 windows; mica spacer 3 mm | 37 x 199 x 199 mm | local spinning | 0.416 | cad_out/engine/E3/E3-112_Support_Cone.step | thermal barrier hot collector -> cold PMG housing; ~120 W
E3-113 | Insulation HubCylinder | 1 | buy | microporous panel 6 mm (+ 3 mm ceramic paper on the hub bell, not modelled) | 40 x 195 x 195 mm | Promat (BE) / Morgan Thermal Ceramics (UK) / Chinese | 0.045 | cad_out/engine/E3/E3-113_Insulation_HubCylinder.step
E3-107 | Heat Shield | 1 | make | 1.4828 0.8 mm + ceramic paper 3 mm (Unifrax/Thermal Ceramics EU) | 1 x 48 x 48 mm | local sheet | 0.006 | cad_out/engine/E3/E3-107_Heat_Shield.step
E3-103 | FPT Blisk | 1 | make | IN718 forged disc AMS 5662/5663 (VDM Metals DE, Aubert & Duval FR, GH4169 CN); 5-axis CNC; Hirth 24T; balance G1.0; spin test 78k | 23 x 113 x 113 mm | local 5-axis + balancing service | 0.418 | cad_out/engine/E3/E3-103_FPT_Blisk.step | 19 blades; FPI + CMM; spin-pit proof test 78k rpm RT
E3-104 | FPT Nut | 1 | make | IN718, M10x1.25 RH, 15 AF, silver plated | 6 x 15 x 17 mm | local | 0.006 | cad_out/engine/E3/E3-104_FPT_Nut.step | drag tightens (CCW rotor seen from intake, nut at the west end)
E3-105 | Tie Stud | 1 | make | IN718 stud M10x1.25 rolled thread, stretch-controlled preload ~25 kN | 46 x 10 x 10 mm | local | 0.03 | cad_out/engine/E3/E3-105_Tie_Stud.step
E3-106 | HeatDam Sleeve | 1 | make | IN718, Hirth 24T, 4 labyrinth teeth r 14.0, slinger | 22 x 35 x 35 mm | local 5-axis/turn | 0.054 | cad_out/engine/E3/E3-106_HeatDam_Sleeve.step | heat dam between blisk and B1
E3-201 | Shaft | 1 | make | 34CrNiMo6 (1.6582) Q+T, CNC turn + cylindrical grind (h5, runout <= 3 um) | 231 x 30 x 30 mm | local | 1.109 | cad_out/engine/E3/E3-201_Shaft.step | magnetic return path of the 2-pole rotor
E3-202 | PM Magnets | 1 | buy | Sm2Co17 (VACOMAX 225 HR class), 8 axial x 8 segments, parallel (2-pole) magnetised | 67 x 44 x 44 mm | Vacuumschmelze VACOMAX 225 HR (DE); Ningbo Ninggang / Chengdu Galaxy (CN) | 0.453 | cad_out/engine/E3/E3-202_PM_Magnets.step | magnetise after assembly or assemble with fixture
E3-203 | CF Sleeve | 1 | make | T700S-class carbon / high-Tg epoxy, hoop wound, 3 mm, 0.18 mm interference (press/thermal) | 75 x 50 x 50 mm | Toray T700S (JP) / Zhongfu SYT49 (CN); local filament winding | 0.052 | cad_out/engine/E3/E3-203_CF_Sleeve.step | spin test with PM rotor 78k
E3-204 | Magnet EndRings | 1 | make | Ti-6Al-4V rings, bonded | 75 x 44 x 44 mm | local | 0.029 | cad_out/engine/E3/E3-204_Magnet_EndRings.step
E3-205 | Bearing B1 71905 hybrid | 1 | buy | 71905 class 25x42x9, 15 deg, hybrid Si3N4 balls, P4, outer-ring-guided PEEK/phenolic cage (locating) | 9 x 42 x 42 mm | GMN (DE) HY series, Schaeffler FAG HCB71905 (DE), SKF 71905 CE/HCP4A (SE), ZYS H71905C (CN) | 0.043 | cad_out/engine/E3/E3-205_Bearing_B1_71905_hybrid.step | locating bearing; ~68 N axial
E3-206 | Bearing B2 7005 hybrid | 1 | buy | 7005 class 25x47x12, 15 deg, hybrid Si3N4 balls, P4, outer-ring-guided cage (floating, spring preloaded) | 12 x 47 x 47 mm | GMN (DE), FAG HCB7005 (DE), SKF 7005 CE/HCP4A (SE), ZYS (CN) | 0.081 | cad_out/engine/E3/E3-206_Bearing_B2_7005_hybrid.step | floating, 200 N spring preload; L10 19560 h, Lnm ~117359 h
E3-210 | B2 Locknut | 1 | buy | precision locknut M20x1 (KMT/KMD 4 class) | 6 x 32 x 32 mm | SKF (SE) / GMN (DE) / Chinese | 0.023 | cad_out/engine/E3/E3-210_B2_Locknut.step
E3-211 | N2 Target 2tooth | 1 | make | 1.4542 2-tooth target wheel | 6 x 28 x 34 mm | local | 0.019 | cad_out/engine/E3/E3-211_N2_Target_2tooth.step | 2 ppr -> 2.0 kHz @ 60k (SE-002B)
E3-207 | B1 SFD Cartridge | 1 | make | 1.4542 (17-4PH H1150), SFD land OD 50 g5 (c 0.075), 2 FKM O-rings 2.62 | 17 x 50 x 50 mm | local | 0.074 | cad_out/engine/E3/E3-207_B1_SFD_Cartridge.step | O-ring centring ~2 N/um
E3-208 | B2 SFD Cartridge | 1 | make | 1.4542 (17-4PH H1150), SFD land OD 55 g5 | 21 x 55 x 55 mm | local | 0.105 | cad_out/engine/E3/E3-208_B2_SFD_Cartridge.step
E3-209 | B2 Preload WaveSpring | 1 | buy | wave spring 17-7PH, 200 N at 3.0 mm | 3 x 47 x 47 mm | TFC (UK) / Chinese wave-spring makers | 0.009 | cad_out/engine/E3/E3-209_B2_Preload_WaveSpring.step
E3-301 | B1 Bearing Housing | 1 | make | SLM 316L (3dfast) with oil/buffer galleries + jets, stress relieved, bores machined | 39 x 120 x 120 mm | 3dfast (IR) | 0.636 | cad_out/engine/E3/E3-301_B1_Bearing_Housing.step | labyrinth lands r 14.15, windback r 13.65, buffer annulus
E3-302 | PMG Housing Jacket | 1 | make | SLM AlSi10Mg (3dfast), internal helical channel 12x6 (6 turns), T6, bore for stator shrink fit | 155 x 168 x 168 mm | 3dfast (IR) | 1.849 | cad_out/engine/E3/E3-302_PMG_Housing_Jacket.step | glycol 8 L/min; leak test 6 bar
E3-303 | Stator Core | 1 | buy | 0.10 mm NO10 Si-steel (JFE 10JNEX900 / Baosteel B10AT class), bonded stack 63 mm, 24 slots | 63 x 118 x 118 mm | JFE 10JNEX900 (JP), Baosteel B10AT (CN), Cogent (UK) | 2.63 | cad_out/engine/E3/E3-303_Stator_Core.step | or Co-Fe (VACOFLUX 48, DE) for higher B
E3-304 | Stator Winding | 1 | make | Litz wire (e.g. 270 x 0.18 mm, ~7 mm2) class H, 2-layer lap 10/12, VPI + potting, 3 x PT1000 | 133 x 94 x 94 mm | Elektrisola / Rudolf Pack (DE); local winding shop | 2.244 | cad_out/engine/E3/E3-304_Stator_Winding.step | or buy stator wound to spec (see doc)
E3-305 | B2 Housing EndShield | 1 | make | SLM 316L (3dfast), oil galleries, bores machined | 35 x 161 x 152 mm | 3dfast (IR) | 1.172 | cad_out/engine/E3/E3-305_B2_Housing_EndShield.step
E3-306 | End Cover | 1 | make | AlSi10Mg / 6082-T6, 2 x M12x1 sensor bosses | 28 x 85 x 82 mm | local | 0.089 | cad_out/engine/E3/E3-306_End_Cover.step
E3-307 | Terminal Box | 1 | buy | AlSi10Mg cast / Al box IP66, 3 x M8 studs on PEEK board, PT1000 connector, M40 EMC gland (east) | 80 x 100 x 79 mm | Rittal/ Spelsberg (DE), Phoenix Contact (DE), Lapp (DE) | 0.269 | cad_out/engine/E3/E3-307_Terminal_Box.step
E3-401 | Foot Front Flexure | 1 | make | 1.4828 flexure plate 8 mm + base 10 mm | 48 x 260 x 207 mm | local | 2.99 | cad_out/engine/E3/E3-401_Foot_Front_Flexure.step | axially compliant (+-2 mm)
E3-402 | Foot Rear Flexure | 1 | make | S355J2 plate 10 mm flexure + base, clamp band | 50 x 220 x 340 mm | local | 4.926 | cad_out/engine/E3/E3-402_Foot_Rear_Flexure.step
E3-501 | TE-510A FPT inlet TC | 1 | buy | type K class 1, MI 1.5 mm Inconel 600, ungrounded, immersion mid-span (Roessel / Electronic Sensor) | 10 x 35 x 35 mm | Roessel / Electronic Sensor (DE), Jaquet / Baumer (CH), MMF (DE), Hansford (UK) | 0.005 | cad_out/engine/E3/E3-501_TE-510A_FPT_inlet_TC.step | tag per docs/electrical/02_io_list
E3-502 | TE-510B FPT inlet TC | 1 | buy | type K class 1, MI 1.5 mm Inconel 600, ungrounded, immersion mid-span (Roessel / Electronic Sensor) | 10 x 35 x 35 mm | Roessel / Electronic Sensor (DE), Jaquet / Baumer (CH), MMF (DE), Hansford (UK) | 0.005 | cad_out/engine/E3/E3-502_TE-510B_FPT_inlet_TC.step | tag per docs/electrical/02_io_list
E3-503 | PT-524 P45 tap | 1 | buy | static tap 1.6 mm + 1/8" tube to PT-524 (0-4 bar abs) | 8 x 18 x 18 mm | Roessel / Electronic Sensor (DE), Jaquet / Baumer (CH), MMF (DE), Hansford (UK) | 0.003 | cad_out/engine/E3/E3-503_PT-524_P45_tap.step | tag per docs/electrical/02_io_list
E3-504 | TE-505A FPT exit TOT | 1 | buy | type K class 1, MI 3 mm Inconel 600, immersion 60 mm (TOT = recuperator hot inlet) | 10 x 10 x 90 mm | Roessel / Electronic Sensor (DE), Jaquet / Baumer (CH), MMF (DE), Hansford (UK) | 0.005 | cad_out/engine/E3/E3-504_TE-505A_FPT_exit_TOT.step | tag per docs/electrical/02_io_list
E3-505 | TE-505B FPT exit TOT | 1 | buy | type K class 1, MI 3 mm Inconel 600, immersion 60 mm (TOT = recuperator hot inlet) | 10 x 10 x 90 mm | Roessel / Electronic Sensor (DE), Jaquet / Baumer (CH), MMF (DE), Hansford (UK) | 0.005 | cad_out/engine/E3/E3-505_TE-505B_FPT_exit_TOT.step | tag per docs/electrical/02_io_list
E3-506 | PT-525 FPT exit tap | 1 | buy | static tap (proposed new tag PT-525, FPT exit/collector static) | 8 x 8 x 18 mm | Roessel / Electronic Sensor (DE), Jaquet / Baumer (CH), MMF (DE), Hansford (UK) | 0.003 | cad_out/engine/E3/E3-506_PT-525_FPT_exit_tap.step | tag per docs/electrical/02_io_list
E3-507 | SE-002B1 N2 speed | 1 | buy | M12x1 Hall/inductive speed sensor, 2 ppr on the 2-tooth target, gap 1.0 mm (Jaquet DSD / Baumer class) | 14 x 51 x 51 mm | Roessel / Electronic Sensor (DE), Jaquet / Baumer (CH), MMF (DE), Hansford (UK) | 0.023 | cad_out/engine/E3/E3-507_SE-002B1_N2_speed.step | tag per docs/electrical/02_io_list
E3-508 | SE-002B2 N2 speed | 1 | buy | M12x1 Hall/inductive speed sensor, 2 ppr on the 2-tooth target, gap 1.0 mm (Jaquet DSD / Baumer class) | 14 x 51 x 51 mm | Roessel / Electronic Sensor (DE), Jaquet / Baumer (CH), MMF (DE), Hansford (UK) | 0.023 | cad_out/engine/E3/E3-508_SE-002B2_N2_speed.step | tag per docs/electrical/02_io_list
E3-509 | VE-011 vib FPT side | 1 | buy | IEPE 100 mV/g accelerometer, M5 stud (MMF KS80D / Hansford HS-100 class), radial horizontal | 20 x 25 x 20 mm | Roessel / Electronic Sensor (DE), Jaquet / Baumer (CH), MMF (DE), Hansford (UK) | 0.024 | cad_out/engine/E3/E3-509_VE-011_vib_FPT_side.step | tag per docs/electrical/02_io_list
E3-510 | VE-012 vib PMG end | 1 | buy | IEPE 100 mV/g accelerometer, radial horizontal at B2 | 20 x 25 x 20 mm | Roessel / Electronic Sensor (DE), Jaquet / Baumer (CH), MMF (DE), Hansford (UK) | 0.024 | cad_out/engine/E3/E3-510_VE-012_vib_PMG_end.step | tag per docs/electrical/02_io_list
E3-511 | TE-721 B2 RTD | 1 | buy | PT1000 class A, 3-wire, spring-loaded on the B2 outer ring | 10 x 32 x 10 mm | Roessel / Electronic Sensor (DE), Jaquet / Baumer (CH), MMF (DE), Hansford (UK) | 0.004 | cad_out/engine/E3/E3-511_TE-721_B2_RTD.step | tag per docs/electrical/02_io_list
E3-512 | TE-720 B1 RTD | 1 | buy | PT1000 class A, 3-wire, embedded in the B1 housing at the outer ring, lead via cone window | 5 x 14 x 5 mm | Roessel / Electronic Sensor (DE), Jaquet / Baumer (CH), MMF (DE), Hansford (UK) | 0.001 | cad_out/engine/E3/E3-512_TE-720_B1_RTD.step | tag per docs/electrical/02_io_list
E3-701 | GapAir Fan 48V | 1 | buy | 48 V EC radial blower 4 g/s @ 2 kPa + G4 filter (ebm-papst / Micronel class) | 60 x 30 x 60 mm | ebm-papst (DE) / Micronel (CH) | 0.076 | cad_out/engine/E3/E3-701_GapAir_Fan_48V.step | PMG gap cooling + seal pressurisation of the PMG cavity
E3-601 | flange gaskets (E2/E3, mid-flange, NGV/shroud, drum cover, H1) | 6 | buy | KLINGER Milam PSS 1 mm (mica) / Thermiculite 815 | per flange | Klinger (AT) / Flexitallic (UK) | 0.3
E3-602 | hot bolting M5/M6/M8/M16 + nuts (incl. E2/E3 flange 16 x M8 x 45 per E2) | 144 | buy | 1.4980 (A286-equiv.) / IN718 studs, silver-plated nuts | M5-M16 | Boellhoff (DE) / Chinese GH2132 | 1.7 |  | torque per VDI 2230 (calc pending)
E3-603 | cold bolting (PMG/B1/B2/cover/box/feet) | 60 | buy | A4-70 / 8.8 Zn-flake | M5-M12 | Wuerth (DE) | 0.6
E3-604 | FKM O-rings (SFD centring 4, housings/ports 12) | 16 | buy | FKM 75 Sh A, 200 C | various | Freudenberg (DE) / Trelleborg (SE) | 0.05 |  | replace at bearing overhaul
E3-605 | E2/E3 flange gasket (mean dia 137 x 8 wide, per E2 flange calc) | 1 | buy | KLINGER Milam PSS 1 mm (mica) / Thermiculite 815 | ID 129 / OD 145 | Klinger (AT) / Flexitallic (UK) | 0.01 |  | slip-joint piston ring is E2 scope (E2 rear-ring groove x 112.5-114.5)
E3-606 | buffer-air orifice 2.4 mm + 40 um filter + check valve | 1 | buy | SS316 | 1/4" tube | Hy-Lok (KR) / Voss (DE) | 0.15 |  | from E2 compressor-delivery port
E3-607 | oil fittings + tubes (2 supply, 2 scavenge, 2 buffer) | 1 | buy | SS316 compression fittings, 6/12 mm tube |  | Hy-Lok (KR) / Voss (DE) / Dk-Lok (KR) | 0.8 |  | routed through cone windows (B1)
E3-608 | glycol fittings G1/2 + hose | 2 | buy | brass/SS, EPDM hose | G1/2 | Voss (DE) / Gates EU | 0.3
E3-609 | phase leads + PT1000 harness inside PMG | 1 | buy | silicone/PTFE 16 mm2 class H, PT1000 3-wire |  | Lapp (DE) / HELUKABEL (DE) | 0.4
E3-610 | external insulation blanket collector + interduct (E5 scope, listed for mass) | 1 | buy | removable blanket, silica fabric + 50 mm |  | EU/Chinese | 4.0 |  | surface < 60 C in the enclosure
E3-611 | balancing / spin-test / NDT services (blisk, PM rotor, assembled rotor) | 1 | buy | G1.0 two-plane balance; spin pit 78k; FPI; CMM |  | Schenck RoTec (DE) / local service | 0 |  | see doc section spin test
