ahmadreza221/aurora-cchp/docs/bom/electrical_bom.csv

tag | description | qty | make_or_buy | material_or_spec | size_or_rating | supplier_candidates | mass_kg | model_file | notes
HI-1 | three-phase hybrid inverter: GRID port (zero export via CT/meter), backup LOAD port (UPS), GEN port, 2 HV battery inputs, 3 MPPT (B3 DC, PV emulation 720 V) | 1 | buy | EN 50549, VDE-AR-N 4105, IEC 62116/61727, IEC 62109-1/2; 100 % unbalanced (each phase <= 50 % rated); peak 1.5x rated 10 s; MPPT 150-850 V (full load 360-850 V), 1000 V max, 3x 36 A; battery 160-800 V, 2x 50 A; IP65 | 30 kW / 33 kVA, grid pass-through 200 A | Deye SUN-30K-SG01HP3-EU-BM3 (CN; reference - only candidate with a seamless LOAD port at this size). European alternatives with non-seamless backup: SMA Sunny Tripower Hybrid X 30 + SMA Backup (DE), KOSTAL PLENTICORE G3 L 20 + BackUp Switch (DE) | 80.0 | cad_out/electrical/EL_ER.step | datasheet: Deye SUN-30K-SG01HP3-EU-BM3 527x894x294 mm, 80 kg (09/2026); UPS transfer time not in the datasheet (retailers: < 4 ms) - verify; both battery inputs paralleled to the one BOS-G20 stack per the Deye manual (verify)
BAT-1 | main battery HV LFP 20.48 kWh (user decision): 4x BOS-GM5.1 + HV control box HVB750V/100A-EU in 3U-LRACK | 1 | buy | LFP, 204.8 V nominal (166-234 V), 100 A nominal / 125 A 2 min, >= 6000 cycles, IEC 62619, VDE 2510-50, UN38.3, CAN to HI-1 | 20.48 kWh, ~20 kW | Deye BOS-G20 (CN, on the Deye compatibility list); alt. BYD Battery-Box Premium HVM 22.1 (CN) only with Kostal/Fronius/SMA | 240.0 | cad_out/electrical/EL_ER.step | datasheet: Deye BOS-G20 = 4x BOS-GM5.1 + HVB750V/100A-EU in 3U-LRACK, 530x1629x602 mm, 240 kg
BAT-2 | 48 V essential-bus battery (controls, safety, post-lube, starter) in steel box with Class-T fuse | 1 | buy | LFP 48 V 100 Ah, CAN/RS-485 BMS | 4.8-5.1 kWh | Pylontech US5000 (CN); Victron Lithium NG 2x 25.6 V 100 Ah (NL); BMZ (DE) | 55.0 | cad_out/electrical/EL_ER.step
CHG-48 | 48 V battery chargers 230 VAC -> 54 V, N+1 with ORing (wall, next to BAT-2) | 2 | buy | LFP charge profile, relay/Bluetooth status | 13 A each | Victron Smart IP43 Charger 48/13 (NL) | 2.7 | cad_out/electrical/EL_ER.step | datasheet: Victron Smart IP43 Charger 48/13 (249x180x116 mm)
DCDC-24 | DC-DC 48 V -> 24 V DIN rail (ER and RP-1) | 2 | buy | input 36-75 V, isolated | 24 V 10 A | PULS CD10.242 (DE); Traco TEP (CH) | 0.52 | cad_out/electrical/EL_ER.step, cad_out/electrical/EL_ROOF.step
MDB | main distribution board: grid incomer MCCB 63 A 4P, SPD T1+2, zero-export CT, JT-920, HI-1 GRID MCB/RCD, LOAD MCCB 63 A, ATS-1, K-NPE, Q1 50 A, Q2 32 A, JT-901 | 1 | make | Rittal AX 1213.000 1000x1200x300 + IEC 61439-2 assembly | 400/230 V 63 A, Icw per site | Rittal; ABB / Siemens / Schneider / Hager devices | 110.0 | cad_out/electrical/EL_ER.step
ATS-1 | automatic transfer switch, source I = HI-1 LOAD port, source II = grid (bypass on inverter fault), position 0 on FZ2 fire | 1 | buy | IEC 60947-6-1, mechanically interlocked break-before-make, position-0 input | 63 A 4P | Socomec ATyS p M 4P 63 A 9384 4006 (FR); ABB TruONE (CH/SE) | 4.3 | cad_out/electrical/EL_ER.step | dims 324x245 mm (distributor; depth to confirm)
K-NPE | N-PE bonding contactor on the LOAD side in backup mode (driven by the inverter island signal) | 1 | buy | AC-1, aux contact | 40 A 2P | Siemens 3RT / ABB AF / Schneider TeSys | 0.4 | cad_out/electrical/EL_ER.step | 01 §9
AUX-DB | plant auxiliary board: BOP-R feeder 32 A + RCD, FCP circuit (locked), chargers, FCU-E/EF-E/AC-E, EH-950 SSR feeder, JT-902..905 | 1 | make | Rittal AX 1058.000 600x800x250 + IEC 61439-3 | 32 A | Rittal; ABB / Siemens / Hager | 50.0 | cad_out/electrical/EL_ER.step
DCJ-1 | DC junction: SPD-DC2 Type 2 1000 V, gPV fuses 2P, isolator, W001 -> W002 split to 2 MPPT | 1 | make | Rittal AX 400x500x200 | 1000 V DC 50 A | Mersen / SIBA fuses; DEHN / Phoenix / OBO / Citel SPD | 9.0 | cad_out/electrical/EL_ER.step
SPD-AC | AC surge protective devices: T1+2 at MDB grid incomer and BOP-R/RP-2, T2 at company DB | 3 | buy | IEC 61643-11, TN-S 3+1 | Iimp 12.5 kA/pole (T1) | DEHN DEHNcombo / DEHNguard; Phoenix FLT-SEC; OBO; Citel | 1.0 | cad_out/electrical/EL_ER.step
SPD-DC | PV DC surge protective devices 1000 V: SPD-DC1 T1+2 (RP-2), SPD-DC2 T2 (DCJ-1) | 2 | buy | EN 50539-11 / IEC 61643-31 | Ucpv >= 1000 V | DEHN DEHNcombo YPV; Phoenix VAL-MS DC-PV | 0.6 | cad_out/electrical/EL_ER.step, cad_out/electrical/EL_ROOF.step
SPD-DATA | data / safety-loop SPDs at both ends of roof <-> ER copper cables (CAN, RS-422, W103 safety loop) | 12 | buy | IEC 61643-21 | — | DEHN BLITZDUCTOR XT; Phoenix TERMITRAB / PLUGTRAB | 0.1
JT-901 | meter HI-1 LOAD port (all loads), per-phase I/P/Q at 4 Hz | 1 | buy | class 0.5S, Modbus RTU | 3~ CT 100/5 A | Janitza UMG 96-PA (DE) | 0.5 | cad_out/electrical/EL_ER.step
JT-920 | grid incomer meter (zero-export supervision, later export) | 1 | buy | class 0.5S, bidirectional, Modbus RTU | 3~ CT 100/5 A | Janitza UMG 96-PA (DE); Carlo Gavazzi EM24 (CH/IT) | 0.5 | cad_out/electrical/EL_ER.step
JT-902..905 | sub-meters AUX-DB (total), hall FCU+ERV, indoor HVAC aux, EH-950 | 4 | buy | class 1, Modbus RTU, DIN | 1~/3~ | Carlo Gavazzi EM340 / EM111; ABB B23 | 0.3 | cad_out/electrical/EL_ER.step
JT-911..914 | company load-group meters with split-core CTs (per phase) | 4 | buy | class 1, Modbus RTU | 3~ CT 63/5 A | Carlo Gavazzi EM24-DIN + CTV split-core | 0.4 |  | in the company DB (hall)
CT-ZE | zero-export CT / smart meter of the hybrid inverter at the grid incomer | 1 | buy | per inverter make | 3~ | inverter make (CHNT DTSU666 for Deye; KOSTAL Smart Energy Meter for Kostal) | 0.5 | cad_out/electrical/EL_ER.step
IPR-1 | interface protection relay (NS protection) for grid export, v2 | 1 | buy | EN 50549-1 / VDE-AR-N 4105, 27/59/81, ROCOF | 3~ | Ziehl UFR1001E (DE); Bender GridGuard (DE) | 0.3 |  | v2 only, if the DSO requires an external relay
MON-GRID | grid presence / phase monitoring relay (XS-GRID) | 1 | buy | 3~ U/f window relay | 400 V | Finder 70.31 (IT); Ziehl (DE) | 0.1 | cad_out/electrical/EL_ER.step
K-LS1..4 | load-shedding contactors in the company DB | 4 | buy | AC-3 + aux contact, 24 VDC coil | 25-40 A 4P | Siemens 3RT / ABB AF / Schneider TeSys | 0.5 |  | company DB (hall)
K-SP1..3 | start-permission contactors for the 3 wall split ACs (outdoor unit supply), with manual bypass switch | 3 | buy | AC-3, 24 VDC coil, aux contact | 16 A 2P | Finder 22.32 / Siemens 5TT | 0.2 |  | company DB (hall); 06 §7
MET | main earth terminal bar ER | 1 | buy | Cu bar on insulators | 500x50x10 | DEHN / OBO | 3.0 | cad_out/electrical/EL_ER.step
CP-E | ECU cabinet: B1, B5, HMI-B5 on door, chargers, DC-DC, switch, router, relays, 48 V MCBs, terminals | 1 | make | Rittal VX25 600x2000x500 IP55 + IEC 61439 | 24/48 VDC | Rittal; Phoenix / Weidmüller / WAGO terminals; Finder relays | 180.0 | cad_out/electrical/EL_ER.step
RP-1 | roof control cabinet: B2, B4, SR1 (Pilz PNOZmulti 2), DC-DC 48/24, fibre switch, data SPD, terminals | 1 | make | Rittal AX 600x800x400 (stainless 1.4301 variant) IP66, under the FR-E1 canopy | 24/48 VDC | Rittal; Pilz; Phoenix | 65.0 | cad_out/electrical/EL_ROOF.step
RP-2 | roof PEB rectifier cabinet: B3 power stage on glycol cold plate, B3 controller, B3b, K-DC+/K-DC-/K-PRE, K-BR, CM choke, SPD-DC1 | 1 | make | Rittal AX 800x1000x300 (stainless variant) IP66 + glycol cold plate | 30 kW, 1000 V DC | Rittal; Schaltbau; Semikron; Infineon | 120.0 | cad_out/electrical/EL_ROOF.step
B6-E-BOX | B6-E indoor HVAC controller enclosure with DIN rail, 24 V PSU, terminals | 1 | make | Rittal AX 600x600x210 | 24 VDC | Rittal; Phoenix | 25.0 | cad_out/electrical/EL_ER.step
SR1 | configurable safety relay PL e: PNOZ m B0 base (772100) + 2x PNOZ m EF 16DI (772140) + PNOZ m EF 4DI4DOR (772143): SI01..SI24, O1..O8 | 1 | buy | EN ISO 13849 PL e / IEC 62061 SIL CL 3 | 24 V | Pilz PNOZmulti 2 (DE); Phoenix PSR-TRISAFE; Siemens 3SK2 | 0.85 | cad_out/electrical/EL_ROOF.step
K-VS | enclosure-fan cut-off contactor for extinguishing (SR1 O7) | 1 | buy | force-guided aux, 24 VDC | 48 VDC 20 A | Finder / Siemens 3RT DC | 0.3 | cad_out/electrical/EL_ROOF.step
B1 | PCB assembly — ECU: STM32H743 + NXP S32K144 SMCU, 4-layer | 1 | make | FR-4 Tg170, ENIG, IPC-A-610 class 2, conformal coat IPC-CC-830 (roof boards); European parts (04) | 220 x 160 mm | JLCPCB / Eurocircuits (BE) / Würth Elektronik (DE) PCB + assembly; consigned EU parts | 0.13 | cad_out/electrical/EL_ER.step | component BOM: electronics/b1_ecu/out/*_bom.csv; KiCad project electronics/b1_ecu
B2 | PCB assembly — sensor I/O: STM32H743 + 2x STM32F373 AFE | 1 | make | FR-4 Tg170, ENIG, IPC-A-610 class 2, conformal coat IPC-CC-830 (roof boards); European parts (04) | 220 x 160 mm | JLCPCB / Eurocircuits (BE) / Würth Elektronik (DE) PCB + assembly; consigned EU parts | 0.13 | cad_out/electrical/EL_ROOF.step | component BOM: electronics/b2_sio/out/*_bom.csv; KiCad project electronics/b2_sio
B4 | PCB assembly — drivers: STM32G474 + 4x 6EDL7141 BLDC + 16 HS outputs | 1 | make | FR-4 Tg170, ENIG, IPC-A-610 class 2, conformal coat IPC-CC-830 (roof boards); European parts (04) | 200 x 160 mm | JLCPCB / Eurocircuits (BE) / Würth Elektronik (DE) PCB + assembly; consigned EU parts | 0.12 | cad_out/electrical/EL_ROOF.step | component BOM: electronics/b4_drv/out/*_bom.csv; KiCad project electronics/b4_drv
B3-CTRL | PCB assembly — rectifier controller on DC- potential: STM32G474 (HRTIM) | 1 | make | FR-4 Tg170, ENIG, IPC-A-610 class 2, conformal coat IPC-CC-830 (roof boards); European parts (04) | 160 x 100 mm | JLCPCB / Eurocircuits (BE) / Würth Elektronik (DE) PCB + assembly; consigned EU parts | 0.09 | cad_out/electrical/EL_ROOF.step | component BOM: electronics/b3_rect/out/*_bom.csv; KiCad project electronics/b3_rect
B3-PWR | PCB assembly — SiC power stage: 7x IMZA120R020M1H on cold plate, DC link, gate drivers | 1 | make | FR-4 Tg170, ENIG, IPC-A-610 class 2, conformal coat IPC-CC-830 (roof boards); European parts (04) | 300 x 220 mm | JLCPCB / Eurocircuits (BE) / Würth Elektronik (DE) PCB + assembly; consigned EU parts | 0.2 | cad_out/electrical/EL_ROOF.step | component BOM: electronics/b3_rect/out/*_bom.csv; KiCad project electronics/b3_rect
B3B | PCB assembly — independent brake: Semikron SKD 30/12 + IGBT + STGAP2 | 1 | make | FR-4 Tg170, ENIG, IPC-A-610 class 2, conformal coat IPC-CC-830 (roof boards); European parts (04) | 200 x 120 mm | JLCPCB / Eurocircuits (BE) / Würth Elektronik (DE) PCB + assembly; consigned EU parts | 0.1 | cad_out/electrical/EL_ROOF.step | component BOM: electronics/b3_rect/out/*_bom.csv; KiCad project electronics/b3_rect
B5 | HMI: Toradex Verdin iMX8M Plus SoM on Toradex Mallow carrier (bought for v1; custom carrier later) | 1 | buy | Toradex Mallow carrier board (Verdin), 24 V input via DIN DC-DC | 100 x 72 mm | Toradex (CH) | 0.15 | cad_out/electrical/EL_ER.step | v1 bought; custom KiCad carrier in a later revision
B6-CPU | PCB assembly — B6 CPU module, 90 mm DIN housing | 2 | make | FR-4 Tg170, ENIG, IPC-A-610 class 2, conformal coat IPC-CC-830 (roof boards); European parts (04) | 100 x 90 mm | JLCPCB / Eurocircuits (BE) / Würth Elektronik (DE) PCB + assembly; consigned EU parts | 0.07 | cad_out/electrical/EL_ROOF.step | component BOM: electronics/b6_bop/out/*_bom.csv; KiCad project electronics/b6_bop
B6-AIT16 | PCB assembly — B6 16x RTD/TC module | 3 | make | FR-4 Tg170, ENIG, IPC-A-610 class 2, conformal coat IPC-CC-830 (roof boards); European parts (04) | 100 x 45 mm | JLCPCB / Eurocircuits (BE) / Würth Elektronik (DE) PCB + assembly; consigned EU parts | 0.06 | cad_out/electrical/EL_ROOF.step | component BOM: electronics/b6_bop/out/*_bom.csv; KiCad project electronics/b6_bop
B6-AIU16 | PCB assembly — B6 16x 4-20 mA / 0-10 V module | 3 | make | FR-4 Tg170, ENIG, IPC-A-610 class 2, conformal coat IPC-CC-830 (roof boards); European parts (04) | 100 x 45 mm | JLCPCB / Eurocircuits (BE) / Würth Elektronik (DE) PCB + assembly; consigned EU parts | 0.06 | cad_out/electrical/EL_ROOF.step | component BOM: electronics/b6_bop/out/*_bom.csv; KiCad project electronics/b6_bop
B6-DI16 | PCB assembly — B6 16x DI module | 4 | make | FR-4 Tg170, ENIG, IPC-A-610 class 2, conformal coat IPC-CC-830 (roof boards); European parts (04) | 100 x 45 mm | JLCPCB / Eurocircuits (BE) / Würth Elektronik (DE) PCB + assembly; consigned EU parts | 0.06 | cad_out/electrical/EL_ROOF.step | component BOM: electronics/b6_bop/out/*_bom.csv; KiCad project electronics/b6_bop
B6-DO16 | PCB assembly — B6 16x relay module | 4 | make | FR-4 Tg170, ENIG, IPC-A-610 class 2, conformal coat IPC-CC-830 (roof boards); European parts (04) | 100 x 67 mm | JLCPCB / Eurocircuits (BE) / Würth Elektronik (DE) PCB + assembly; consigned EU parts | 0.06 | cad_out/electrical/EL_ROOF.step | component BOM: electronics/b6_bop/out/*_bom.csv; KiCad project electronics/b6_bop
B6-AO8 | PCB assembly — B6 8x AO module | 2 | make | FR-4 Tg170, ENIG, IPC-A-610 class 2, conformal coat IPC-CC-830 (roof boards); European parts (04) | 100 x 45 mm | JLCPCB / Eurocircuits (BE) / Würth Elektronik (DE) PCB + assembly; consigned EU parts | 0.06 | cad_out/electrical/EL_ROOF.step | component BOM: electronics/b6_bop/out/*_bom.csv; KiCad project electronics/b6_bop
DIN-HSG-B6 | B6 module DIN housings with T-bus connectors (90 / 67.5 / 45 mm) | 18 | buy | Phoenix Contact ICS / ME-MAX housings + ME 22,5 TBUS | per module width | Phoenix Contact (DE) | 0.08 | cad_out/electrical/EL_ROOF.step, cad_out/electrical/EL_ER.step
HMI-B5 | 10.1" industrial touch display on CP-E door (B5 HMI) | 1 | buy | IPS 1280x800 LVDS, PCAP, optical bonding, >= 500 nit | 10.1" | DATA MODUL easyTOUCH eTD101W3201 (DE); Distec POS-PRO 10.1 (DE) | 0.93 | cad_out/electrical/EL_ER.step | datasheet: DATA MODUL easyTOUCH 10.1" eTD101W3201 259x177x18.9 mm
SOM-B5 | NXP i.MX 8M Plus system-on-module for B5 (4 GB, 32 GB eMMC, industrial temp.) | 1 | buy | Toradex Verdin iMX8M Plus Q 4GB IT | SODIMM-260 | Toradex (CH); Phytec phyCORE-i.MX 8M Plus (DE) | 0.02 | cad_out/electrical/EL_ER.step
NVME-B5 | industrial NVMe SSD with power-loss protection | 1 | buy | M.2 2280 | 256 GB | Swissbit (CH) | 0.01 | cad_out/electrical/EL_ER.step
HMI-B6R | B6 touch HMI on BOP-R door: STM32 embedded display, TouchGFX firmware (ours) | 1 | buy | STM32H757, IPS 1280x800, PCAP, optical bonding | 10.1" | Riverdi RVT101HVSNWC00-B (PL) | 0.52 | cad_out/electrical/EL_ROOF.step | datasheet: Riverdi RVT101HVSNWC00-B 257.96x168.6x15.5 mm (sun-readable variant to confirm)
NET-SW | managed industrial Ethernet switch with SFP (ER and RP-1) | 2 | buy | VLAN, -40..+70 C | 4-5 ports + SFP | Westermo Lynx L205-S1 (SE); Phoenix FL SWITCH 2105 (DE) | 0.7 | cad_out/electrical/EL_ER.step, cad_out/electrical/EL_ROOF.step
RTR-1 | router: fixed internet (static IP) WAN + LTE failover, WireGuard server, SMS modem | 1 | buy | Teltonika RUTX11 | LTE Cat 6 | Teltonika (LT) | 0.5 | cad_out/electrical/EL_ER.step
VPS | VPS outside Iran: Telegram relay + data mirror + backup (service) | 1 | buy | Linux VPS, 2 vCPU | yearly | Hetzner (DE); OVH (FR) | 0 |  | service
RB-1 | braking resistors R_BR1 18-20 ohm (>= 400 kJ, 36 kW/10 s, 6 kW cont.) + R_BR2 8 ohm in one IP23 enclosure with rain hood, thermal switch TSH-860 | 1 | make | stainless edge-wound / grid elements, 1000 V DC insulation; reference envelope Schneider VW3A7790 (3x6.7 ohm, 20 kW, IP23) | 1000 V DC | Danotherm (DK); Frizlen (DE); Cressall (UK); Schneider VW3A7790 (FR) as R_BR1 basis | 95.0 | cad_out/electrical/EL_ROOF.step | make: R_BR1 + R_BR2 resistor banks in one IP23 enclosure; footprint from Schneider VW3A7790 (1060x565x540, 3x6.7 ohm 20 kW IP23) + R_BR2 tier — confirm with Danotherm / Frizlen
DCD-1 | DC isolator 1000 V 50 A 2P lockable IP66 (roof, before W001) | 1 | buy | IEC 60947-3 DC-PV2 | 1000 V 50 A | ABB OTDC; Santon (NL) | 4.0 | cad_out/electrical/EL_ROOF.step
K-DC | DC main contactors K-DC+ / K-DC- and pre-charge K-PRE | 3 | buy | C195 A/24EV, 24 V DC coil, aux contact | >= 1000 V DC 50 A | Schaltbau C195 (DE) | 2.0 | cad_out/electrical/EL_ROOF.step | datasheet 143x142x68 mm
K-BR | PMG brake contactor with NC main contacts (independent brake B3b) | 1 | buy | AC-1 NC | 400 V 63 A | Siemens 3RT / ABB / Schneider | 0.9 | cad_out/electrical/EL_ROOF.step
JB-E | junction box on EP-1 north face (sensor / valve wiring, M12 bulkheads) | 1 | make | Rittal KX stainless 400x300x150 IP66 | — | Rittal; Phoenix; Lapp | 8.0 | cad_out/electrical/EL_ROOF.step | package interface docs/06 §3
MEB-R | roof main earth bar with test link for the earth-well conductor | 1 | buy | Cu bar + disconnecting test link | 400x50x10 | DEHN / OBO | 2.5 | cad_out/electrical/EL_ROOF.step
FR-E1 | support frame + 4 mm sun canopy for RP-1 / RP-2 / DCD-1 / MEB-R | 1 | make | hot-dip galvanised steel S235, 60x60 posts, C-channel rails, bolted to concrete blocks (no roof penetration) | 1.7 x 0.5 x 2.05 m | local fabrication | 85.0 | cad_out/electrical/EL_ROOF.step
T-R1 | roof tray 200x60 with divider along the north edge (behind the FR-E1 posts), supports every 1.5 m; c2 data cables in a separate earthed 50 mm steel conduit strapped to the tray (05 §1) | 22.1 | buy | perforated cable tray HDG, with divider and lid on the roof | 200 x 60 mm | OBO Bettermann MKS 620/630 FS, ladder LG 60 NS FS 300 (DE); Niedax (DE) | 80.4 | cad_out/electrical/EL_ROUTE.step | qty in m (+10 %)
T-R2 | roof tray east: RB-1 (W009/W010), BOP-R (W006, W115, W116), FS-1 (W121) | 4.9 | buy | perforated cable tray HDG, with divider and lid on the roof | 150 x 60 mm | OBO Bettermann MKS 620/630 FS, ladder LG 60 NS FS 300 (DE); Niedax (DE) | 17.8 | cad_out/electrical/EL_ROUTE.step | qty in m (+10 %)
C-R3 | walk-over cable cover across the EP-1 service strip: RP-1 -> JB-E, RP-2 -> PMG terminal (W008, W011) | 0.9 | buy | walk-over cable cover, aluminium, anti-slip | 300 x 50 mm | OBO Bettermann MKS 620/630 FS, ladder LG 60 NS FS 300 (DE); Niedax (DE) | 2.4 | cad_out/electrical/EL_ROUTE.step | qty in m (+10 %)
V-R4 | roof penetration sleeve with rain cap into the ER ceiling | 1 | buy | roof penetration sleeve 300x300 with rain cap + fire-stop | 300 x 300 mm | OBO Bettermann MKS 620/630 FS, ladder LG 60 NS FS 300 (DE); Niedax (DE) | 9.2 | cad_out/electrical/EL_ROUTE.step
L-E1 | ER cable ladder under the ceiling, drops to HI-1, BAT-1, DCJ-1, MDB, CP-E | 3.4 | buy | cable ladder HDG | 300 x 60 mm | OBO Bettermann MKS 620/630 FS, ladder LG 60 NS FS 300 (DE); Niedax (DE) | 15.5 | cad_out/electrical/EL_ROUTE.step | qty in m (+10 %)
L-E2 | ER cable ladder, west wall | 2.7 | buy | cable ladder HDG | 300 x 60 mm | OBO Bettermann MKS 620/630 FS, ladder LG 60 NS FS 300 (DE); Niedax (DE) | 12.2 | cad_out/electrical/EL_ROUTE.step | qty in m (+10 %)
T-H1 | ER -> hall company DB (W005, W109) in the corridor ceiling | 20.1 | buy | perforated cable tray HDG, with divider and lid on the roof | 200 x 60 mm | OBO Bettermann MKS 620/630 FS, ladder LG 60 NS FS 300 (DE); Niedax (DE) | 73.0 | cad_out/electrical/EL_ROUTE.step | qty in m (+10 %)
CND-C2 | separate earthed steel conduit for c2 data cables along T-R1 (05 §1) | 25 | buy | galvanised steel conduit EN 61386 | 50 mm | OBO; Dietzel (AT) | 30.0 |  | qty in m
W001 | H1Z2Z2-K 1x16 (DC 720-780 V roof -> ER) | 80 | buy | EN 50618, 1.5 kV DC | 1x16 mm2 | Lapp (DE); Helukabel (DE); Prysmian (IT); Nexans (FR) |  |  | qty in m incl. 15 % (05 §6)
W002/W009/W010 | H1Z2Z2-K / silicone 1x6 | 30 | buy | EN 50618 | 1x6 mm2 | Lapp (DE); Helukabel (DE); Prysmian (IT); Nexans (FR) |  |  | qty in m incl. 15 % (05 §6)
W003 | HV battery cable kit (manufacturer) | 1 | buy | kit | 2x 1x35 mm2 | Lapp (DE); Helukabel (DE); Prysmian (IT); Nexans (FR) |  |  | kit
W004/W019/W020 | N2XH-J 5G16 LSZH | 15 | buy | 0.6/1 kV | 5G16 | Lapp (DE); Helukabel (DE); Prysmian (IT); Nexans (FR) |  |  | qty in m incl. 15 % (05 §6)
W018 | NYY-J 5G16 grid incomer (per site) | 10 | buy | 0.6/1 kV | 5G16 | Lapp (DE); Helukabel (DE); Prysmian (IT); Nexans (FR) |  |  | qty in m incl. 15 % (05 §6)
W005 | N2XH-J / NYY-J 5G10 to company DB | 25 | buy | 0.6/1 kV | 5G10 | Lapp (DE); Helukabel (DE); Prysmian (IT); Nexans (FR) |  |  | qty in m incl. 15 % (05 §6)
W006 | NYY-J 5G10 UV-resistant AUX-DB -> BOP-R | 40 | buy | 0.6/1 kV | 5G10 | Lapp (DE); Helukabel (DE); Prysmian (IT); Nexans (FR) |  |  | qty in m incl. 15 % (05 §6)
W007 | H07RN-F 1x25 48 V roof feeder | 80 | buy | 450/750 V | 1x25 | Lapp (DE); Helukabel (DE); Prysmian (IT); Nexans (FR) |  |  | qty in m incl. 15 % (05 §6)
W022 | H07RN-F 1x35 48 V battery | 5 | buy | 450/750 V | 1x35 | Lapp (DE); Helukabel (DE); Prysmian (IT); Nexans (FR) |  |  | qty in m incl. 15 % (05 §6)
W008 | symmetric shielded VFD/servo cable, heat resistant (PMG) | 4 | buy | ÖLFLEX HEAT 180 EMC class | 3x16 + 3G2.5 | Lapp (DE); Helukabel (DE); Prysmian (IT); Nexans (FR) |  |  | qty in m incl. 15 % (05 §6)
W011 | silicone shielded 1x10 (PMG -> K-BR -> B3b) | 6 | buy | 1.8 kV | 1x10 | Lapp (DE); Helukabel (DE); Prysmian (IT); Nexans (FR) |  |  | qty in m incl. 15 % (05 §6)
W012-W016 | engine package power/control cables (BLDC, valves, igniter, fans) | 40 | buy | oil/UV resistant, shielded | 3G1.0..3x6 | Lapp (DE); Helukabel (DE); Prysmian (IT); Nexans (FR) |  |  | qty in m incl. 15 % (05 §6)
W113 | H07V-K green-yellow 1x25 (MEB-R -> MET) | 45 | buy | 450/750 V | 1x25 | Lapp (DE); Helukabel (DE); Prysmian (IT); Nexans (FR) |  |  | qty in m incl. 15 % (05 §6)
W118 | earth-well conductor Cu 1x50 + mechanical protection | 10 | buy | bare / H07V-K | 1x50 | Lapp (DE); Helukabel (DE); Prysmian (IT); Nexans (FR) |  |  | qty in m incl. 15 % (05 §6)
W119 | H07V-K green-yellow 1x16 roof bonding | 30 | buy | 450/750 V | 1x16 | Lapp (DE); Helukabel (DE); Prysmian (IT); Nexans (FR) |  |  | qty in m incl. 15 % (05 §6)
W101 | CAN cable 120 ohm 2x2x0.5 shielded | 100 | buy | UNITRONIC BUS CAN class | 2x2x0.5 | Lapp (DE); Helukabel (DE); Prysmian (IT); Nexans (FR) |  |  | qty in m incl. 15 % (05 §6)
W102/W105/W106/W123 | LiYCY-TP 2x2x0.5 / 4x2x0.5 | 130 | buy | shielded twisted pair | 2x2x0.5, 4x2x0.5 | Lapp (DE); Helukabel (DE); Prysmian (IT); Nexans (FR) |  |  | qty in m incl. 15 % (05 §6)
W103 | LiYCY 12x1.0 safety loop | 40 | buy | shielded | 12x1.0 | Lapp (DE); Helukabel (DE); Prysmian (IT); Nexans (FR) |  |  | qty in m incl. 15 % (05 §6)
W116 | LiYCY 18x1.0 RP-1 <-> BOP-R | 15 | buy | shielded | 18x1.0 | Lapp (DE); Helukabel (DE); Prysmian (IT); Nexans (FR) |  |  | qty in m incl. 15 % (05 §6)
W109/W124 | LiYCY 25x0.75 + 12x0.75 | 35 | buy | shielded | 25x0.75 | Lapp (DE); Helukabel (DE); Prysmian (IT); Nexans (FR) |  |  | qty in m incl. 15 % (05 §6)
W104 | fibre OM3 4-core armoured outdoor | 45 | buy | LC duplex | 4 x 50/125 | Lapp (DE); Helukabel (DE); Prysmian (IT); Nexans (FR) |  |  | qty in m incl. 15 % (05 §6)
W112/W115 | Cat6A S/FTP | 30 | buy | LSZH | Cat6A | Lapp (DE); Helukabel (DE); Prysmian (IT); Nexans (FR) |  |  | qty in m incl. 15 % (05 §6)
W120 | fire-resistant cable PH120 2x1.5 shielded (FCP loops) | 250 | buy | EN 50200 PH120 / IEC 60331 | 2x1.5 | Lapp (DE); Helukabel (DE); Prysmian (IT); Nexans (FR) |  |  | qty in m incl. 15 % (05 §6)
W121 | fire-resistant cable PH120 2x1.5 / 4x1.5 (release circuits, interface relays) | 150 | buy | EN 50200 PH120 | 2x1.5, 4x1.5 | Lapp (DE); Helukabel (DE); Prysmian (IT); Nexans (FR) |  |  | qty in m incl. 15 % (05 §6)
KX | thermocouple extension KX class 1 2x0.5, FEP in hot zone | 60 | buy | IEC 60584-3 | 2x0.5 | Lapp (DE); Helukabel (DE); Prysmian (IT); Nexans (FR) |  |  | qty in m incl. 15 % (05 §6)
FCP | fire detection + extinguishing control panel (2 extinguishing zones FZ1/FZ2 + detection zone FZ3), GSM/IP dialler | 1 | buy | EN 54-2/4 + EN 12094-1, addressable, 2 loops | 230 VAC + 2x 12 V battery | Siemens Sinteso XC10 (DE/CH, reference) or FC2020 + extinguishing module; Minimax FMZ 5000 (DE); Bosch FPA-1000 (DE); Hekatron Integral (DE) | 6.5 | cad_out/electrical/EL_ER.step | datasheet: Siemens Sinteso XC10 extinguishing control panel 505x375x125 mm
SE-001A | N1-A: دور هستهٔ GR180 — Hall Melexis US5881 (جایگزین هم‌پایهٔ A1120 در v11) روی intake، آهنربای nose cone | 1 | buy | پالس 1 ppr، open-collector 24 V → line driver RS-422 روی B2 | 0–2.0 kHz (0–120k rpm) | Melexis US5881 (BE) / Micro-Epsilon DZ140 (DE) |  | in the EP-1 package model (E5) | field device per 02_io_list (B2 FI01 + RS422-OUT1 → B1 SPD-IN1 (H7 TIM + SMCU)); supplied by EL, installed by E5/HVAC; their BOMs must not duplicate
SE-001B | N1-B: سنسور Hall دوم، ۱۸۰° از N1-A، تغذیه و کابل مستقل | 1 | buy | پالس open-collector، تغذیهٔ 12 V از ناحیهٔ SMCU روی B1، pull-up در B1 (بدون الکترونیک فعال روی بام) | 0–2.0 kHz | Melexis US5881 (BE) / Micro-Epsilon DZ140 (DE) |  | in the EP-1 package model (E5) | field device per 02_io_list (B1 SPD-IN2 (SMCU اصلی + H7 مقایسه)); supplied by EL, installed by E5/HVAC; their BOMs must not duplicate
SE-002B | N2-B: سنسور مستقل دور FPT (Hall + آهنربا یا هدف ۲ دندانه روی انتهای سرد شفت PMG) | 1 | buy | پالس open-collector 1–2 ppr، تغذیه از B1 (SMCU) | 0–2.6 kHz | Melexis US5881 (BE) / Micro-Epsilon DZ140 (DE) |  | in the EP-1 package model (E5) | field device per 02_io_list (B1 SPD-IN3 (SMCU اصلی + H7)); supplied by EL, installed by E5/HVAC; their BOMs must not duplicate
VE-010 | ارتعاش هسته (فلنج یاتاقان جلو/intake، سمت سرد) | 1 | buy | IEPE 100 mV/g، 4 mA constant current | ±50 g، 2 Hz–10 kHz | Hansford HS-100 (UK); IFM VSA (DE) |  | in the EP-1 package model (E5) | field device per 02_io_list (B2 VIB1 (ADC H7، منبع جریان LM317)); supplied by EL, installed by E5/HVAC; their BOMs must not duplicate
VE-011 | ارتعاش FPT/PMG (هوزینگ یاتاقان سمت توربین) | 1 | buy | IEPE 100 mV/g | ±50 g، 2 Hz–10 kHz | Hansford HS-100 (UK); IFM VSA (DE) |  | in the EP-1 package model (E5) | field device per 02_io_list (B2 VIB2); supplied by EL, installed by E5/HVAC; their BOMs must not duplicate
VE-012 | ارتعاش PMG سمت آزاد / محوری (رزرو) | 1 | buy | IEPE 100 mV/g | ±50 g | Hansford HS-100 (UK); IFM VSA (DE) |  | in the EP-1 package model (E5) | field device per 02_io_list (B2 VIB3); supplied by EL, installed by E5/HVAC; their BOMs must not duplicate
TE-502 | T2: دمای خروجی کمپرسور | 1 | buy | TC type K class 1 (IEC 60584-1)، MI Ø1.5–3، غلاف Inconel 600، ungrounded | 0–300 °C (طراحی ~165) | WIKA TC80 (DE); Rössel (DE); JUMO (DE); TC Direct (UK) |  | in the EP-1 package model (E5) | field device per 02_io_list (B2 TC01 (AFE STM32F373)); supplied by EL, installed by E5/HVAC; their BOMs must not duplicate
TE-503 | T2r: خروجی سمت سرد recuperator / ورودی محفظه | 1 | buy | TC type K class 1 (IEC 60584-1)، MI Ø1.5–3، غلاف Inconel 600، ungrounded | 0–700 °C (طراحی ~565) | WIKA TC80 (DE); Rössel (DE); JUMO (DE); TC Direct (UK) |  | in the EP-1 package model (E5) | field device per 02_io_list (B2 TC02); supplied by EL, installed by E5/HVAC; their BOMs must not duplicate
TE-504A | ITT-1: دمای بین‌توربینی (خروجی توربین هسته، محل EGT راتن) | 1 | buy | TC type K class 1 (IEC 60584-1)، MI Ø1.5–3، غلاف Inconel 600، ungrounded، Ø1.5 (پاسخ سریع) | 0–1000 °C (طراحی ~667 @ TIT 800) | WIKA TC80 (DE); Rössel (DE); JUMO (DE); TC Direct (UK) |  | in the EP-1 package model (E5) | field device per 02_io_list (B2 TC03); supplied by EL, installed by E5/HVAC; their BOMs must not duplicate
TE-504B | ITT-2 (۱۲۰°) | 1 | buy | TC type K class 1 (IEC 60584-1)، MI Ø1.5–3، غلاف Inconel 600، ungrounded، Ø1.5 | 0–1000 °C | WIKA TC80 (DE); Rössel (DE); JUMO (DE); TC Direct (UK) |  | in the EP-1 package model (E5) | field device per 02_io_list (B2 TC04); supplied by EL, installed by E5/HVAC; their BOMs must not duplicate
TE-504C | ITT-3 (۲۴۰°) | 1 | buy | TC type K class 1 (IEC 60584-1)، MI Ø1.5–3، غلاف Inconel 600، ungrounded، Ø1.5 | 0–1000 °C | WIKA TC80 (DE); Rössel (DE); JUMO (DE); TC Direct (UK) |  | in the EP-1 package model (E5) | field device per 02_io_list (B2 TC05); supplied by EL, installed by E5/HVAC; their BOMs must not duplicate
TE-505 | TOT: خروجی FPT = ورودی سمت داغ recuperator | 1 | buy | TC type K class 1 (IEC 60584-1)، MI Ø1.5–3، غلاف Inconel 600، ungrounded | 0–900 °C (طراحی ~610) | WIKA TC80 (DE); Rössel (DE); JUMO (DE); TC Direct (UK) |  | in the EP-1 package model (E5) | field device per 02_io_list (B2 TC06); supplied by EL, installed by E5/HVAC; their BOMs must not duplicate
TE-101 | دمای گاز اگزوز ورودی HX-1، بعد از recuperator (تگ مشترک با docs/hvac) | 1 | buy | TC type K class 1 (IEC 60584-1)، MI Ø1.5–3، غلاف Inconel 600، ungrounded | 0–600 °C (طراحی ~262) | WIKA TC80 (DE); Rössel (DE); JUMO (DE); TC Direct (UK) |  | in the EP-1 package model (E5) | field device per 02_io_list (B2 TC07); supplied by EL, installed by E5/HVAC; their BOMs must not duplicate
TE-512 | رزرو (خروجی گاز HX-1 = TE-102 و دودکش مشترک = TE-103 روی B6-R هستند) | 1 | buy | TC type K class 1 (IEC 60584-1)، MI Ø1.5–3، غلاف Inconel 600، ungrounded | — | WIKA TC80 (DE); Rössel (DE); JUMO (DE); TC Direct (UK) |  | in the EP-1 package model (E5) | field device per 02_io_list (B2 TC08); supplied by EL, installed by E5/HVAC; their BOMs must not duplicate
TE-508 | دمای هوزینگ یاتاقان عقب هسته (سمت داغ) | 1 | buy | TC type K class 1 (IEC 60584-1)، MI Ø1.5–3، غلاف Inconel 600، ungrounded | 0–300 °C | WIKA TC80 (DE); Rössel (DE); JUMO (DE); TC Direct (UK) |  | in the EP-1 package model (E5) | field device per 02_io_list (B2 TC09); supplied by EL, installed by E5/HVAC; their BOMs must not duplicate
TE-509 | دمای هوای ناحیهٔ داغ جعبه (کنار محفظه) | 1 | buy | TC type K class 1 (IEC 60584-1)، MI Ø1.5–3، غلاف Inconel 600، ungrounded | 0–250 °C | WIKA TC80 (DE); Rössel (DE); JUMO (DE); TC Direct (UK) |  | in the EP-1 package model (E5) | field device per 02_io_list (B2 TC10); supplied by EL, installed by E5/HVAC; their BOMs must not duplicate
TE-510 | رزرو: interduct/ورودی NGV FPT یا مسیر bypass | 1 | buy | TC type K class 1 (IEC 60584-1)، MI Ø1.5–3، غلاف Inconel 600، ungrounded | 0–1000 °C | WIKA TC80 (DE); Rössel (DE); JUMO (DE); TC Direct (UK) |  | in the EP-1 package model (E5) | field device per 02_io_list (B2 TC11); supplied by EL, installed by E5/HVAC; their BOMs must not duplicate
TE-511 | رزرو | 1 | buy | TC type K class 1 (IEC 60584-1)، MI Ø1.5–3، غلاف Inconel 600، ungrounded | — | WIKA TC80 (DE); Rössel (DE); JUMO (DE); TC Direct (UK) |  | in the EP-1 package model (E5) | field device per 02_io_list (B2 TC12); supplied by EL, installed by E5/HVAC; their BOMs must not duplicate
PT-521 | P2: فشار خروجی کمپرسور (sense line ≥ 300 mm برای خنک‌شدن) | 1 | buy | 4–20 mA، 2-wire (loop 24 V از B2)، پاسخ < 1 ms | 0–6 bar abs (طراحی ~3.1) | Keller (CH); WIKA (DE); Danfoss (DK); Huba (CH) |  | in the EP-1 package model (E5) | field device per 02_io_list (B2 FAI1 (ADC H7)); supplied by EL, installed by E5/HVAC; their BOMs must not duplicate
PT-522 | P3: بعد از سمت سرد recuperator / ورودی محفظه | 1 | buy | 4–20 mA، 2-wire (loop 24 V از B2) | 0–6 bar abs (~2.9) | Keller (CH); WIKA (DE); Danfoss (DK); Huba (CH) |  | in the EP-1 package model (E5) | field device per 02_io_list (B2 AI01 (ADC H7)); supplied by EL, installed by E5/HVAC; their BOMs must not duplicate
PT-524 | P45: فشار interduct (بین توربین هسته و FPT) | 1 | buy | 4–20 mA، 2-wire (loop 24 V از B2) | 0–4 bar abs | Keller (CH); WIKA (DE); Danfoss (DK); Huba (CH) |  | in the EP-1 package model (E5) | field device per 02_io_list (B2 AI02); supplied by EL, installed by E5/HVAC; their BOMs must not duplicate
PT-101 | فشار برگشتی اگزوز بعد از recuperator، قبل از diverter D-101 (تگ مشترک با docs/hvac) | 1 | buy | 4–20 mA، 2-wire (loop 24 V از B2) | −0.5…+2.5 kPa g | Keller (CH); WIKA (DE); Danfoss (DK); Huba (CH) |  | in the EP-1 package model (E5) | field device per 02_io_list (B2 AI03); supplied by EL, installed by E5/HVAC; their BOMs must not duplicate
PDT-526 | ΔP دهانهٔ bellmouth ورودی کمپرسور (دبی جرمی هوا) | 1 | buy | 4–20 mA، 2-wire (loop 24 V از B2) | 0–25 mbar | Keller (CH); WIKA (DE); Danfoss (DK); Huba (CH) |  |  | field device per 02_io_list (B2 AI04); supplied by EL, installed by E5/HVAC; their BOMs must not duplicate
ZSC-610 | سوییچ وضعیت بسته XV-610 | 1 | buy | DI 24 V (NC = closed) | — | per 04 §7 |  |  | field device per 02_io_list (B2 DI01); supplied by EL, installed by E5/HVAC; their BOMs must not duplicate
PT-601 | فشار گاز تغذیه (قبل از SSVها) | 1 | buy | 4–20 mA، 2-wire (loop 24 V از B2)، سازگار با متان | 0–10 barg (طراحی 4، حداقل 3.5) | Keller (CH); WIKA (DE); Danfoss (DK); Huba (CH) |  | in the EP-1 package model (E5) | field device per 02_io_list (B2 AI05); supplied by EL, installed by E5/HVAC; their BOMs must not duplicate
PSL-602 | کلید فشار پایین گاز (EN 1854)، تنظیم 3.0 barg | 1 | buy | کنتاکت NC دوکاناله | — | Keller (CH); WIKA (DE); Danfoss (DK); Huba (CH) |  | in the EP-1 package model (E5) | field device per 02_io_list (SR1 SI07 + B2 DI02 (کپی)); supplied by EL, installed by E5/HVAC; their BOMs must not duplicate
PSH-603 | کلید فشار بالای گاز، تنظیم 5.0 barg (خرابی رگولاتور) | 1 | buy | کنتاکت NC | — | Keller (CH); WIKA (DE); Danfoss (DK); Huba (CH) |  | in the EP-1 package model (E5) | field device per 02_io_list (SR1 SI07 (سری با PSL) + B2 DI03); supplied by EL, installed by E5/HVAC; their BOMs must not duplicate
PT-604 | فشار بعد از رگولاتور (ورودی شیر تناسبی) | 1 | buy | 4–20 mA، 2-wire (loop 24 V از B2) | 0–6 barg (~3.0) | Keller (CH); WIKA (DE); Danfoss (DK); Huba (CH) |  | in the EP-1 package model (E5) | field device per 02_io_list (B2 AI06); supplied by EL, installed by E5/HVAC; their BOMs must not duplicate
ZSC-611 | proof-of-closure SSV1 | 1 | buy | DI 24 V | — | per 04 §7 |  | in the EP-1 package model (E5) | field device per 02_io_list (B2 DI04 + SR1 SI08 (پایش)); supplied by EL, installed by E5/HVAC; their BOMs must not duplicate
ZSC-612 | proof-of-closure SSV2 | 1 | buy | DI 24 V | — | per 04 §7 |  | in the EP-1 package model (E5) | field device per 02_io_list (B2 DI05 + SR1 SI08); supplied by EL, installed by E5/HVAC; their BOMs must not duplicate
PT-613 | فشار فضای بین SSV1 و SSV2 (آزمون نشتی شیرها، valve proving) | 1 | buy | 4–20 mA، 2-wire (loop 24 V از B2) | 0–6 barg | Keller (CH); WIKA (DE); Danfoss (DK); Huba (CH) |  | in the EP-1 package model (E5) | field device per 02_io_list (B2 AI07); supplied by EL, installed by E5/HVAC; their BOMs must not duplicate
PT-605 | فشار مانیفولد گاز (بعد از شیر تناسبی، قبل از انژکتورها) | 1 | buy | 4–20 mA، 2-wire (loop 24 V از B2) | 0–6 barg (~2.5) | Keller (CH); WIKA (DE); Danfoss (DK); Huba (CH) |  | in the EP-1 package model (E5) | field device per 02_io_list (B2 FAI2); supplied by EL, installed by E5/HVAC; their BOMs must not duplicate
TE-607 | دمای گاز | 1 | buy | PT1000 class A، 3-wire | -10–+70 °C | WIKA (DE); JUMO (DE) |  | in the EP-1 package model (E5) | field device per 02_io_list (B2 RTD02 (AFE STM32F373)); supplied by EL, installed by E5/HVAC; their BOMs must not duplicate
FQ-608 | کنتور گاز شرکت گاز (پالس LF reed) | 1 | buy | پالس خشک | 0.1 m³/پالس | Bürkert 8746 (DE); E+H t-mass (CH) |  |  | field device per 02_io_list (B2 FI04); supplied by EL, installed by E5/HVAC; their BOMs must not duplicate
BE-631 | سنسور شعلهٔ UV پشت پنجرهٔ کوارتز: Durag D-LX 100 UV (آلمان)؛ رلهٔ شعلهٔ failsafe + 4–20 mA شدت | 1 | buy | رلهٔ شعله (NO، تغذیهٔ 24 V از ناحیهٔ SMCU) + 4–20 mA شدت | شعله دارد/ندارد؛ 0–100 % شدت | Durag D-LX 100 UV (DE); Siemens QRA2 (DE) |  | in the EP-1 package model (E5) | field device per 02_io_list (B1 SPD-IN4 (SMCU + H7، به‌عنوان DI) + B2 AI21 (شدت)); supplied by EL, installed by E5/HVAC; their BOMs must not duplicate
PT-701 | فشار روغن تغذیه (بعد از فیلتر، به جت‌ها) | 1 | buy | 4–20 mA، 2-wire (loop 24 V از B2) | 0–10 barg | Keller (CH); WIKA (DE); Danfoss (DK); Huba (CH) |  | in the EP-1 package model (E5) | field device per 02_io_list (B2 AI09); supplied by EL, installed by E5/HVAC; their BOMs must not duplicate
PSL-702 | کلید فشار پایین روغن (مکانیکی، مستقل از PT-701) | 1 | buy | کنتاکت NC | تنظیم ~1.0 barg (TBD) | Keller (CH); WIKA (DE); Danfoss (DK); Huba (CH) |  | in the EP-1 package model (E5) | field device per 02_io_list (SR1 SI09 + B2 DI06); supplied by EL, installed by E5/HVAC; their BOMs must not duplicate
PDT-703 | ΔP فیلتر روغن 10 µm (ترانسمیتر) | 1 | buy | 4–20 mA، 2-wire (loop 24 V از B2) | 0–2.5 bar | Keller (CH); WIKA (DE); Danfoss (DK); Huba (CH) |  | in the EP-1 package model (E5) | field device per 02_io_list (B2 AI17); supplied by EL, installed by E5/HVAC; their BOMs must not duplicate
TE-704 | دمای مخزن روغن | 1 | buy | PT1000 class A، 3-wire | -10–150 °C | WIKA (DE); JUMO (DE) |  | in the EP-1 package model (E5) | field device per 02_io_list (B2 RTD03); supplied by EL, installed by E5/HVAC; their BOMs must not duplicate
TE-705 | دمای روغن برگشتی یاتاقان‌های هسته | 1 | buy | PT1000 class A، 3-wire | 0–200 °C | WIKA (DE); JUMO (DE) |  | in the EP-1 package model (E5) | field device per 02_io_list (B2 RTD04); supplied by EL, installed by E5/HVAC; their BOMs must not duplicate
TE-706 | دمای روغن برگشتی یاتاقان‌های FPT/PMG | 1 | buy | PT1000 class A، 3-wire | 0–200 °C | WIKA (DE); JUMO (DE) |  | in the EP-1 package model (E5) | field device per 02_io_list (B2 RTD05); supplied by EL, installed by E5/HVAC; their BOMs must not duplicate
TE-708 | دمای روغن تغذیه بعد از خنک‌کن روغن-گلیکول (ورودی جت‌های یاتاقان؛ شیر ترموستاتیک مکانیکی) | 1 | buy | PT1000 class A، 3-wire | 0–150 °C | WIKA (DE); JUMO (DE) |  | in the EP-1 package model (E5) | field device per 02_io_list (B2 RTD12); supplied by EL, installed by E5/HVAC; their BOMs must not duplicate
PT-709 | فشار محفظهٔ یاتاقان‌ها / مخزن روغن (breather با جداکنندهٔ مه روغن) | 1 | buy | 4–20 mA، 2-wire (loop 24 V از B2) | −50…+500 mbar g | Keller (CH); WIKA (DE); Danfoss (DK); Huba (CH) |  | in the EP-1 package model (E5) | field device per 02_io_list (B2 AI18); supplied by EL, installed by E5/HVAC; their BOMs must not duplicate
LT-707 | سطح پیوستهٔ مخزن روغن | 1 | buy | 4–20 mA، 2-wire (loop 24 V از B2) | 0–100 % | Baumer (CH); Gems-free: WIKA (DE) |  | in the EP-1 package model (E5) | field device per 02_io_list (B2 AI19); supplied by EL, installed by E5/HVAC; their BOMs must not duplicate
LSL-707 | سطح پایین مخزن روغن (float) | 1 | buy | DI 24 V | — | Baumer (CH); Gems-free: WIKA (DE) |  | in the EP-1 package model (E5) | field device per 02_io_list (B2 DI08); supplied by EL, installed by E5/HVAC; their BOMs must not duplicate
TE-720 | دمای یاتاقان FPT سمت توربین (PT1000 جاسازی‌شده) | 1 | buy | PT1000 class A، 3-wire | 0–200 °C | WIKA (DE); JUMO (DE) |  | in the EP-1 package model (E5) | field device per 02_io_list (B2 RTD06); supplied by EL, installed by E5/HVAC; their BOMs must not duplicate
TE-721 | دمای یاتاقان PMG سمت آزاد | 1 | buy | PT1000 class A، 3-wire | 0–200 °C | WIKA (DE); JUMO (DE) |  | in the EP-1 package model (E5) | field device per 02_io_list (B2 RTD07); supplied by EL, installed by E5/HVAC; their BOMs must not duplicate
FT-752 | دبی مدار خنک‌کاری (توربینی/vortex) | 1 | buy | پالس 24 V | 1–30 L/min | IFM SM (DE); Bürkert (DE) |  | in the EP-1 package model (E5) | field device per 02_io_list (B2 FI03); supplied by EL, installed by E5/HVAC; their BOMs must not duplicate
TE-GLY | دمای رفت گلیکول مدار کمکی به PMG، B3 و خنک‌کن روغن (خروجی HX-4 / DC-1؛ تگ مشترک با docs/hvac) | 1 | buy | PT1000 class A، 3-wire | 0–120 °C | WIKA (DE); JUMO (DE) |  | in the EP-1 package model (E5) | field device per 02_io_list (B2 RTD08); supplied by EL, installed by E5/HVAC; their BOMs must not duplicate
TE-754 | دمای برگشت مایع خنک‌کن (بعد از PMG) | 1 | buy | PT1000 class A، 3-wire | 0–100 °C | WIKA (DE); JUMO (DE) |  | in the EP-1 package model (E5) | field device per 02_io_list (B2 RTD09); supplied by EL, installed by E5/HVAC; their BOMs must not duplicate
PT-755 | فشار مدار خنک‌کاری (تشخیص نشتی) | 1 | buy | 4–20 mA، 2-wire (loop 24 V از B2) | 0–4 barg | Keller (CH); WIKA (DE); Danfoss (DK); Huba (CH) |  | in the EP-1 package model (E5) | field device per 02_io_list (B2 AI10); supplied by EL, installed by E5/HVAC; their BOMs must not duplicate
LSL-756 | سطح پایین منبع انبساط | 1 | buy | DI 24 V | — | Baumer (CH); Gems-free: WIKA (DE) |  | in the EP-1 package model (E5) | field device per 02_io_list (B2 DI09); supplied by EL, installed by E5/HVAC; their BOMs must not duplicate
TE-760 | دمای سیم‌پیچ PMG فاز U (PT1000 جاسازی، عایق تقویت‌شده) | 1 | buy | PT1000 class A، 3-wire، ورودی ایزولهٔ B3 | 0–220 °C | WIKA (DE); JUMO (DE) |  | in the EP-1 package model (E5) | field device per 02_io_list (B3 RTD-W1); supplied by EL, installed by E5/HVAC; their BOMs must not duplicate
TE-761 | دمای سیم‌پیچ PMG فاز V | 1 | buy | PT1000 class A، 3-wire | 0–220 °C | WIKA (DE); JUMO (DE) |  | in the EP-1 package model (E5) | field device per 02_io_list (B3 RTD-W2); supplied by EL, installed by E5/HVAC; their BOMs must not duplicate
TE-762 | دمای سیم‌پیچ PMG فاز W | 1 | buy | PT1000 class A، 3-wire | 0–220 °C | WIKA (DE); JUMO (DE) |  | in the EP-1 package model (E5) | field device per 02_io_list (B3 RTD-W3); supplied by EL, installed by E5/HVAC; their BOMs must not duplicate
ESD-R | E-stop روی بام: در جلوی جعبه + کنار تابلوی BOP-R، دو شستی سری (تگ مشترک با docs/hvac) | 1 | buy | 2× NC دوکاناله | — | Schmersal (DE); Euchner (DE); Pilz (DE); Siemens 3SU1 |  |  | field device per 02_io_list (SR1 SI01 + B2 DI10 (وضعیت)); supplied by EL, installed by E5/HVAC; their BOMs must not duplicate
ESD-E | E-stop اتاق برق | 1 | buy | 2× NC دوکاناله | — | Schmersal (DE); Euchner (DE); Pilz (DE); Siemens 3SU1 |  |  | field device per 02_io_list (SR1 SI02 (کابل W103) + B1 DI01); supplied by EL, installed by E5/HVAC; their BOMs must not duplicate
ESD-H | E-stop سالن/دفتر (اختیاری) | 1 | buy | 2× NC | — | Schmersal (DE); Euchner (DE); Pilz (DE); Siemens 3SU1 |  |  | field device per 02_io_list (SR1 SI03 (سری با SI02)); supplied by EL, installed by E5/HVAC; their BOMs must not duplicate
ZS-811 | کلید درِ چپ جعبه (کدشدهٔ مغناطیسی، 2 کانال) | 1 | buy | 2× OSSD/NC | — | Schmersal (DE); Euchner (DE); Pilz (DE); Siemens 3SU1 |  | in the EP-1 package model (E5) | field device per 02_io_list (SR1 SI04 + B2 DI11); supplied by EL, installed by E5/HVAC; their BOMs must not duplicate
ZS-812 | کلید درِ راست جعبه | 1 | buy | 2× OSSD/NC | — | Schmersal (DE); Euchner (DE); Pilz (DE); Siemens 3SU1 |  | in the EP-1 package model (E5) | field device per 02_io_list (SR1 SI05 + B2 DI12); supplied by EL, installed by E5/HVAC; their BOMs must not duplicate
ZS-813 | کلید سقف برداشتنی / دریچهٔ سرویس | 1 | buy | 2× OSSD/NC | — | Schmersal (DE); Euchner (DE); Pilz (DE); Siemens 3SU1 |  | in the EP-1 package model (E5) | field device per 02_io_list (SR1 SI06 + B2 DI13); supplied by EL, installed by E5/HVAC; their BOMs must not duplicate
ZS-814 | درِ تابلوی برق RP-1 (قفل کلیدی، فقط آلارم) | 1 | buy | DI 24 V | — | Schmersal (DE); Euchner (DE); Pilz (DE); Siemens 3SU1 |  |  | field device per 02_io_list (B2 DI14); supplied by EL, installed by E5/HVAC; their BOMs must not duplicate
AT-821 | آشکارساز متان NDIR — ناحیهٔ قطار گاز (بالا) | 1 | buy | 4–20 mA + رله 10 % و 20 % LEL | 0–100 % LEL | Dräger Polytron 5310 (DE); Crowcon Xgard IQ (UK) |  | in the EP-1 package model (E5) | field device per 02_io_list (B2 AI11 + DI15 (10 %) + SR1 SI10 (20 %)); supplied by EL, installed by E5/HVAC; their BOMs must not duplicate
AT-822 | آشکارساز متان NDIR — سقف ناحیهٔ موتور | 1 | buy | 4–20 mA + رله 10/20 % | 0–100 % LEL | Dräger Polytron 5310 (DE); Crowcon Xgard IQ (UK) |  | in the EP-1 package model (E5) | field device per 02_io_list (B2 AI12 + DI16 + SR1 SI10); supplied by EL, installed by E5/HVAC; their BOMs must not duplicate
PDSL-831 | اثبات تهویهٔ جعبه (ΔP switch) | 1 | buy | کنتاکت NC | تنظیم 50 Pa | Keller (CH); WIKA (DE); Danfoss (DK); Huba (CH) |  | in the EP-1 package model (E5) | field device per 02_io_list (SR1 SI11 (تأخیر 10 s) + B2 DI17); supplied by EL, installed by E5/HVAC; their BOMs must not duplicate
TE-834 | دمای هوای جعبه (ناحیهٔ موتور) | 1 | buy | PT1000 class A، 3-wire | 0–120 °C | WIKA (DE); JUMO (DE) |  | in the EP-1 package model (E5) | field device per 02_io_list (B2 RTD10); supplied by EL, installed by E5/HVAC; their BOMs must not duplicate
TSH-836 | آشکارساز حرارتی آتش (ثابت 90 °C + rate-of-rise) | 1 | buy | کنتاکت NC | — | per 04 §7 |  | in the EP-1 package model (E5) | field device per 02_io_list (SR1 SI12 + B2 DI18); supplied by EL, installed by E5/HVAC; their BOMs must not duplicate
XA-840 | چراغ وضعیت سه‌رنگ + آژیر روی جعبه | 1 | buy | DO 24 V ×4 | — | Werma (DE); Pfannenberg (DE) |  |  | field device per 02_io_list (B4 DO07–DO10); supplied by EL, installed by E5/HVAC; their BOMs must not duplicate
HS-841 | کلید سلکتور کلیدی OFF / LOCAL / REMOTE / MAINT | 1 | buy | DI 24 V ×2 (کدشده) | — | Schmersal (DE); Euchner (DE); Pilz (DE); Siemens 3SU1 |  |  | field device per 02_io_list (B2 DI19–DI20); supplied by EL, installed by E5/HVAC; their BOMs must not duplicate
HS-842 | شستی reset ایمنی (محلی، روی بام) | 1 | buy | NO | — | Schmersal (DE); Euchner (DE); Pilz (DE); Siemens 3SU1 |  |  | field device per 02_io_list (SR1 RESET + B2 DI21); supplied by EL, installed by E5/HVAC; their BOMs must not duplicate
TSH-860 | کلید حرارتی مقاومت ترمز (NC، 200 °C) | 1 | buy | کنتاکت NC | — | per 04 §7 |  |  | field device per 02_io_list (B3 DI-R1 (+ مدل حرارتی)); supplied by EL, installed by E5/HVAC; their BOMs must not duplicate
TE-501 | T1: دمای هوای ورودی کمپرسور (پایین‌دست کویل CC-1، کنار bellmouth) | 1 | buy | PT1000 class A، 3-wire | -20–+60 °C (طراحی 15) | WIKA (DE); JUMO (DE) |  |  | field device per 02_io_list (B2 RTD01); supplied by EL, installed by E5/HVAC; their BOMs must not duplicate
PDT-222 | ΔP فیلترهای ورودی G4 و F8، دو کانال (تگ مشترک با docs/hvac) | 1 | buy | 4–20 mA، 2-wire (loop 24 V از B2) | 0–500 Pa ×2 | Keller (CH); WIKA (DE); Danfoss (DK); Huba (CH) |  |  | field device per 02_io_list (B2 AI13–AI14); supplied by EL, installed by E5/HVAC; their BOMs must not duplicate
MT-501 | رطوبت نسبی هوای ورودی کمپرسور بعد از کویل و قطره‌گیر (ترانسمیتر T/RH) | 1 | buy | 4–20 mA، 2-wire (loop 24 V از B2) | 0–100 % RH | E+E EE33 (AT); Vaisala HMP7 (FI) |  |  | field device per 02_io_list (B2 AI20); supplied by EL, installed by E5/HVAC; their BOMs must not duplicate
PDT-223 | ΔP سمت هوای کویل CC-1 و قطره‌گیر (تگ مشترک با docs/hvac) | 1 | buy | 4–20 mA، 2-wire (loop 24 V از B2) | 0–500 Pa | Keller (CH); WIKA (DE); Danfoss (DK); Huba (CH) |  |  | field device per 02_io_list (B2 AI15); supplied by EL, installed by E5/HVAC; their BOMs must not duplicate
TSH-871 | FZ1 جعبهٔ موتور: دتکتور حرارتی EN 54-5 کلاس CS (ثابت + ROR)، آدرس‌پذیر | 1 | buy | حلقهٔ آدرس‌پذیر FCP | — | EN 54-5 heat detector (FCP make) |  | in the EP-1 package model (E5) | field device per 02_io_list (FCP LOOP1); supplied by EL, installed by E5/HVAC; their BOMs must not duplicate
TSH-872 | FZ1 جعبهٔ موتور: دتکتور حرارتی دوم (سمت قطار گاز) | 1 | buy | حلقهٔ آدرس‌پذیر FCP | — | EN 54-5 heat detector (FCP make) |  | in the EP-1 package model (E5) | field device per 02_io_list (FCP LOOP1); supplied by EL, installed by E5/HVAC; their BOMs must not duplicate
BS-873 | FZ1 جعبهٔ موتور: دتکتور شعلهٔ IR3 (EN 54-10 کلاس 1، کور به سطوح داغ) | 1 | buy | حلقهٔ آدرس‌پذیر FCP (ماژول ورودی) | — | IR3 flame detector EN 54-10 (Siemens / Bosch / Hekatron) |  | in the EP-1 package model (E5) | field device per 02_io_list (FCP LOOP1); supplied by EL, installed by E5/HVAC; their BOMs must not duplicate
SD-881 | FZ2 اتاق برق: دتکتور دود نوری EN 54-7 (۱) | 1 | buy | حلقهٔ آدرس‌پذیر FCP | — | EN 54-7 optical smoke detector (FCP make) |  |  | field device per 02_io_list (FCP LOOP2); supplied by EL, installed by E5/HVAC; their BOMs must not duplicate
SD-882 | FZ2 اتاق برق: دتکتور دود نوری EN 54-7 (۲) | 1 | buy | حلقهٔ آدرس‌پذیر FCP | — | EN 54-7 optical smoke detector (FCP make) |  |  | field device per 02_io_list (FCP LOOP2); supplied by EL, installed by E5/HVAC; their BOMs must not duplicate
SD-883 | FZ2 ناحیهٔ باتری: دتکتور دود نوری EN 54-7 | 1 | buy | حلقهٔ آدرس‌پذیر FCP | — | EN 54-7 optical smoke detector (FCP make) |  |  | field device per 02_io_list (FCP LOOP2); supplied by EL, installed by E5/HVAC; their BOMs must not duplicate
TSH-884 | FZ2 اتاق برق: دتکتور حرارتی EN 54-5 A1R | 1 | buy | حلقهٔ آدرس‌پذیر FCP | — | EN 54-5 heat detector (FCP make) |  |  | field device per 02_io_list (FCP LOOP2); supplied by EL, installed by E5/HVAC; their BOMs must not duplicate
AT-885 | گاز خروجی باتری H₂ + CO (هشدار زودهنگام thermal runaway) — Dräger Polytron 8000 | 1 | buy | 4–20 mA + دو رله | 0–100 % LEL H₂؛ 0–500 ppm CO | Dräger Polytron 8000 H2 + CO (DE) |  |  | field device per 02_io_list (B1 DI22 (رلهٔ A1) + FCP LOOP2 (رلهٔ A2) + B6-E AI (4–20 mA)); supplied by EL, installed by E5/HVAC; their BOMs must not duplicate
SD-886 | FZ3 تابلوهای بام RP-1 و BOP-R: دتکتور دود داخل تابلو (فقط اعلام) | 1 | buy | حلقهٔ آدرس‌پذیر FCP | — | EN 54-7 optical smoke detector (FCP make) |  |  | field device per 02_io_list (FCP LOOP1); supplied by EL, installed by E5/HVAC; their BOMs must not duplicate
HS-891 | شستی‌های اعلام دستی قرمز EN 54-11 (درِ ER، دسترسی بام، سالن) | 1 | buy | حلقهٔ آدرس‌پذیر FCP | — | EN 54-11 / EN 12094-3 manual stations (FCP make) |  |  | field device per 02_io_list (FCP LOOP1/LOOP2); supplied by EL, installed by E5/HVAC; their BOMs must not duplicate
ZS-897 | درِ اتاق برق باز (FZ2) — مهار رهاسازی خودکار | 1 | buy | کنتاکت مغناطیسی → ورودی FCP | — | per 04 §7 |  |  | field device per 02_io_list (FCP EXT2-IN); supplied by EL, installed by E5/HVAC; their BOMs must not duplicate
ZS-898 | درهای جعبهٔ موتور باز (FZ1، کنتاکت سیگنال ZS-811..814 سری) — مهار رهاسازی خودکار | 1 | buy | کنتاکت → ورودی FCP | — | per 04 §7 |  | in the EP-1 package model (E5) | field device per 02_io_list (FCP EXT1-IN); supplied by EL, installed by E5/HVAC; their BOMs must not duplicate
HS-892 | شستی رهاسازی دستی زرد FZ1 (بیرون جعبه، مسیر دسترسی بام) | 1 | buy | ورودی پایش‌شدهٔ ماژول اطفای FCP | — | EN 54-11 / EN 12094-3 manual stations (FCP make) |  |  | field device per 02_io_list (FCP EXT1-IN); supplied by EL, installed by E5/HVAC; their BOMs must not duplicate
HS-893 | شستی رهاسازی دستی زرد FZ2 (بیرون درِ اتاق برق) | 1 | buy | ورودی پایش‌شدهٔ ماژول اطفای FCP | — | EN 54-11 / EN 12094-3 manual stations (FCP make) |  |  | field device per 02_io_list (FCP EXT2-IN); supplied by EL, installed by E5/HVAC; their BOMs must not duplicate
HS-894 | شستی abort / hold آبی FZ1 (نگه‌داشتنی) | 1 | buy | ورودی پایش‌شدهٔ ماژول اطفای FCP | — | EN 54-11 / EN 12094-3 manual stations (FCP make) |  |  | field device per 02_io_list (FCP EXT1-IN); supplied by EL, installed by E5/HVAC; their BOMs must not duplicate
HS-895 | شستی abort / hold آبی FZ2 | 1 | buy | ورودی پایش‌شدهٔ ماژول اطفای FCP | — | EN 54-11 / EN 12094-3 manual stations (FCP make) |  |  | field device per 02_io_list (FCP EXT2-IN); supplied by EL, installed by E5/HVAC; their BOMs must not duplicate
HS-896 | کلید کلیدی حالت رهاسازی هر ناحیه: AUTO+MANUAL / فقط MANUAL / BLOCKED | 1 | buy | ورودی FCP | — | EN 54-11 / EN 12094-3 manual stations (FCP make) |  |  | field device per 02_io_list (FCP EXT-MODE); supplied by EL, installed by E5/HVAC; their BOMs must not duplicate
XA-879 | آژیر و فلاشر EN 54-3/23 و تابلوهای «گاز در حال تخلیه / وارد نشوید» هر ناحیه | 1 | buy | خروجی‌های پایش‌شدهٔ FCP | — | Werma (DE); Pfannenberg (DE) |  |  | field device per 02_io_list (FCP NAC1–NAC4); supplied by EL, installed by E5/HVAC; their BOMs must not duplicate
