ahmadreza221/aurora-cchp/docs/bom/engine_E4_bom.csv

tag | description | qty | make_or_buy | material_or_spec | size_or_rating | supplier_candidates | mass_kg | model_file | notes
E4-CORE-A | Recuperator core module A, brazed plate-fin, 40 cold + 41 hot layers, counterflow + crossflow cold windows | 1 | make: fin forming + stacking + vacuum braze BNi-2 1040 C + He leak test | 347H (1.4912/UNS S34709) sheets, 347 fins | 268x280x420 mm | IR: MAPNA turbine-blade vacuum-furnace shop (PARTO) - confirm; CN: stainless PFHE brazers (Hangzhou/Wuxi) to our drawing | 70.8 | E4_core.step | eps_net 0.905 with module B; 3.5 barg design, 5.3 barg hydro
E4-CORE-B | Recuperator core module B (identical to A) | 1 | make: as A | as A | as A | as A | 70.8 | E4_core.step | interchangeable
E4-FIN-C | Cold offset-strip fin stock p 1.2 / t 0.10 / h 2.0 / strip 3.0 mm | 9.9 m2 | make: OSF fin-forming die (5-axis/wire-EDM tool) or buy formed fin | 347 foil 0.10 mm (EN 1.4550) |  | foil: Outokumpu (FI), Aperam (FR/BE), TISCO (CN) | 0 | E4_core_detail_sample.step | mass 9.8 kg included in E4-CORE-A/B
E4-FIN-H | Hot offset-strip fin stock p 1.6 / t 0.12 / h 3.8 / strip 3.2 mm | 10.0 m2 | make: OSF fin-forming die | 347 foil 0.12 mm |  | as E4-FIN-C | 0 | E4_core_detail_sample.step | mass 29.0 kg included in E4-CORE-A/B; 0.12 mm = oxidation allowance
E4-FIN-D | Cold distributor fin (plain, 45 deg cut) p 2.0 / t 0.15 mm | 4.2 m2 | make: fin-forming die | 347 foil 0.15 mm |  | as E4-FIN-C | 0 |  | mass 8.4 kg included in E4-CORE-A/B
E4-PS | Parting sheets 0.40 mm, cap sheets 2.0 mm, side/end bars 5 mm | set | make: laser cut, flattened, degreased | 347H |  | Outokumpu, Aperam, Acerinox (ES) | 0 |  | mass 89.6 kg included in E4-CORE-A/B
E4-BRZ | Braze filler BNi-2 amorphous foil 38 um (AWS A5.8 BNi-2 / ISO 17672 Ni 620) | 37.9 m2 | buy | BNi-2 | 38 um | Vacuumschmelze VITROBRAZE (DE), AT&M/Antai (CN) | 0 |  | mass 4.8 kg included in E4-CORE-A/B; stop-off on bars
E4-HDR-CI | cold-inlet header R55 x 1.5 (165 C) | 1 | make: rolled half-pipe + TIG to core end bars | 347H 1.5 mm | R55 x 536 | IR sheet-metal + TIG shop (precision fabrication), material Outokumpu/Aperam/Acerinox | 1.3 | E4_headers_plenums.step
E4-HDR-CO | cold-outlet header R55 x 1.5 (566 C) | 1 | make: rolled half-pipe + TIG, PWHT none (stabilised) | 347H 1.5 mm | R55 x 536 | IR sheet-metal + TIG shop (precision fabrication), material Outokumpu/Aperam/Acerinox | 1.2 | E4_headers_plenums.step
E4-PLN | hot-inlet plenum 3 mm 347H with ribs (610 C) | 1 | make: laser-cut sheet + TIG, ribs | 347H 3 mm | 926x286x178 | IR sheet-metal + TIG shop (precision fabrication), material Outokumpu/Aperam/Acerinox | 19.0 | E4_headers_plenums.step
E4-SKT-H | hot-end U-skirt 1.2 mm 347H (compliant core/plenum joint) | 1 | make: formed U-lip 1.2 mm + TIG | 347H 1.2 mm | ring 548x292 | IR sheet-metal + TIG shop (precision fabrication), material Outokumpu/Aperam/Acerinox | 0.4 | E4_headers_plenums.step
E4-PPL | perforated distributor plate 2 mm, phi 0.55 (holes not modelled) | 1 | make: laser-perforated sheet | 347H 2 mm, phi 0.55 | 536x280 | IR sheet-metal + TIG shop (precision fabrication), material Outokumpu/Aperam/Acerinox | 2.4 | E4_headers_plenums.step
E4-VAN | turning vanes x3, 2.5 mm IN625 | 1 | make: formed plates | IN625 2.5 mm | 3 vanes | IR sheet-metal + TIG shop (precision fabrication), material Outokumpu/Aperam/Acerinox | 2.5 | E4_headers_plenums.step
E4-HOD | outlet hood 3 mm 347H (215 C) | 1 | make: sheet + TIG | 347H 3 mm | 542x286x295 | IR sheet-metal + TIG shop (precision fabrication), material Outokumpu/Aperam/Acerinox | 13.8 | E4_headers_plenums.step
E4-SKT-C | cold-end skirt 1.2 mm 347H | 1 | make: formed 1.2 mm + TIG | 347H 1.2 mm | ring | IR sheet-metal + TIG shop (precision fabrication), material Outokumpu/Aperam/Acerinox | 0.4 | E4_headers_plenums.step
E4-SP-C1 | cold-inlet spool DN100: flange PN16 + 2-ply bellows 321 + stub | 1 | make spool; buy bellows | 321/1.4541 pipe 114.3x2, 2-ply 321 bellows with liner | DN100 PN16, 250 C, bellows axial +-5 / lateral +-11 mm | Witzenmann (DE), BOA (DE), Kompaflex (CH), Belman (DK), Aerosun (CN) | 5.8 | E4_ducts.step
E4-SP-C2 | cold-outlet spool DN125: flange PN16 + 2-ply bellows IN625 + stub | 1 | make spool; buy bellows | 347H pipe 139.7x2, 2-ply IN625 bellows with liner | DN125 PN16, 620 C, bellows axial +-6 / lateral +-11 mm | Witzenmann (DE), BOA (DE), Kompaflex (CH), Belman (DK), Aerosun (CN) | 7.6 | E4_ducts.step
E4-SP-H1 | hot-inlet spool DN250: flange PN6, collar, 2-ply IN625 bellows, 3-piece elbow R190, stub (321H) | 1 | make spool + 3-piece mitre elbow; buy bellows | 321H pipe 273x3, 2-ply IN625 bellows with liner | DN250 PN6, 680 C, bellows axial +-7 / lateral +-7 mm | Witzenmann (DE), BOA (DE), Kompaflex (CH), Belman (DK), Aerosun (CN) | 19.8 | E4_ducts.step
E4-SP-EX | exhaust duct DN250 x3 321: 2 mitred bends R200, 2-ply 321 bellows, flange PN6 | 1 | make duct; buy bellows | 321H pipe 273x3, 2-ply 321 bellows with liner | DN250 PN6, 450 C, axial +-10 / lateral +-10 mm | Witzenmann (DE), BOA (DE), Kompaflex (CH), Belman (DK), Aerosun (CN) | 27.6 | E4_ducts.step
E4-SUP-1 | FIXED leg (pinned, under H1): SHS 50x4 347H + pad + base plate | 1 | make (welded SHS, plates); buy pad + slide plate | 347H SHS 50x4 + lug; S355 galv base 150x150x12; calcium-silicate pad 25 mm; graphite-bronze slide plate (sliding legs) | static ~881 N | pads: Skamol (DK), Promat (DE); slide plates: KS Gleitlager (DE) | 6.5 | E4_supports.step
E4-SUP-2 | guided leg (x free): SHS 50x4 347H + pad + base plate | 1 | make (welded SHS, plates); buy pad + slide plate | 347H SHS 50x4 + lug; S355 galv base 150x150x12; calcium-silicate pad 25 mm; graphite-bronze slide plate (sliding legs) | static ~881 N | pads: Skamol (DK), Promat (DE); slide plates: KS Gleitlager (DE) | 6.5 | E4_supports.step
E4-SUP-3 | sliding leg: SHS 50x4 347H + pad + base plate | 1 | make (welded SHS, plates); buy pad + slide plate | 347H SHS 50x4 + lug; S355 galv base 150x150x12; calcium-silicate pad 25 mm; graphite-bronze slide plate (sliding legs) | static ~881 N | pads: Skamol (DK), Promat (DE); slide plates: KS Gleitlager (DE) | 6.5 | E4_supports.step
E4-SUP-4 | sliding leg: SHS 50x4 347H + pad + base plate | 1 | make (welded SHS, plates); buy pad + slide plate | 347H SHS 50x4 + lug; S355 galv base 150x150x12; calcium-silicate pad 25 mm; graphite-bronze slide plate (sliding legs) | static ~881 N | pads: Skamol (DK), Promat (DE); slide plates: KS Gleitlager (DE) | 6.5 | E4_supports.step
E4-SUP-S1 | sway strut M16 + clevis to E5 frame at y 8600 (free in z) | 1 | make (rod + clevis lug); buy clevis pins | A4-70 rod M16, 347H lug on hood | L ~90 mm | local machining; clevis: Würth (DE) | 0.8 | E4_supports.step | E5 provides the frame member at y 8.600
E4-SUP-S2 | sway strut M16 + clevis to E5 frame at y 8600 (free in z) | 1 | make (rod + clevis lug); buy clevis pins | A4-70 rod M16, 347H lug on hood | L ~90 mm | local machining; clevis: Würth (DE) | 0.8 | E4_supports.step | E5 provides the frame member at y 8.600
TE-502 | T2 cold-in TC boss M14x1.5 (top header) | 1 | make boss; buy instrument (per docs/electrical) | 347H/316L |  | TC: Rössel (DE), TC Mess- und Regeltechnik (DE), local IR; bosses machined | 0.47 | E4_ports.step
TE-503 | T2r cold-out TC boss M14x1.5 (bottom header) | 1 | make boss; buy instrument (per docs/electrical) | 347H/316L |  | TC: Rössel (DE), TC Mess- und Regeltechnik (DE), local IR; bosses machined | 0.47 | E4_ports.step
TE-505 | TOT hot-in TC boss M14x1.5 (H1 collar, top) | 1 | make boss; buy instrument (per docs/electrical) | 347H/316L |  | TC: Rössel (DE), TC Mess- und Regeltechnik (DE), local IR; bosses machined | 0.47 | E4_ports.step
TE-512 | hot-out TC boss M14x1.5 (exhaust duct, top) | 1 | make boss; buy instrument (per docs/electrical) | 347H/316L |  | TC: Rössel (DE), TC Mess- und Regeltechnik (DE), local IR; bosses machined | 0.29 | E4_ports.step
PT-E4-1 | cold-in pressure tap 1/4 (top header) | 1 | make boss; buy instrument (per docs/electrical) | 347H/316L |  | local machining; DN15/DN50 fittings EN stock | 0.19 | E4_ports.step
PT-E4-2 | cold-out pressure tap 1/4 (bottom header) | 1 | make boss; buy instrument (per docs/electrical) | 347H/316L |  | local machining; DN15/DN50 fittings EN stock | 0.19 | E4_ports.step
PT-E4-3 | hot-in pressure tap 1/4 (plenum south wall) | 1 | make boss; buy instrument (per docs/electrical) | 347H/316L |  | local machining; DN15/DN50 fittings EN stock | 0.19 | E4_ports.step
PT-E4-4 | hot-out pressure tap 1/4 (hood north wall) | 1 | make boss; buy instrument (per docs/electrical) | 347H/316L |  | local machining; DN15/DN50 fittings EN stock | 0.19 | E4_ports.step
DR-E4-H | hot-side drain DN15 + cap (plenum low point, bottom-flush, to north) | 1 | make | 347H/316L |  | local machining; DN15/DN50 fittings EN stock | 0.16 | E4_ports.step
DR-E4-C | cold-side drain DN15 + cap (header low point, 45 deg down-south) | 1 | make | 347H/316L |  | local machining; DN15/DN50 fittings EN stock | 0.25 | E4_ports.step
BS-E4-1 | borescope port DN50 + blind (hot face, plenum) | 1 | make | 347H/316L |  | local machining; DN15/DN50 fittings EN stock | 5.59 | E4_ports.step
BS-E4-2 | borescope port DN50 + blind (cold face, hood) | 1 | make | 347H/316L |  | local machining; DN15/DN50 fittings EN stock | 5.59 | E4_ports.step
E4-INS | microporous insulation (MICROTHERM class) | 1 | buy + fit (removable boxes on flanges/bellows) | microporous silica, 0.5 mm 1.4301 cladding | 70/70/20 mm (610/core/215 C) | Promat MICROTHERM/PROMALIGHT (BE/DE), Luyang (CN); cladding local IR | 58.6 | E4_insulation.step | skin <= 60 C at 40 C enclosure air
E4-CLD | cladding 0.5 mm 1.4301 | 1 | buy + fit (removable boxes on flanges/bellows) | 1.4301 0.5 mm | 70/70/20 mm (610/core/215 C) | Promat MICROTHERM/PROMALIGHT (BE/DE), Luyang (CN); cladding local IR | 15.5 | E4_insulation.step | skin <= 60 C at 40 C enclosure air
E4-BLT | Bolting kits for 4 flanged joints (C1 8xM16, C2 8xM16, H1 12xM16, EXH 12xM16) + 2 borescope blinds 8xM16 | 6 | buy | studs 1.7709 (21CrMoV5-7) + nuts 1.7258 on H1/C2 (hot), A4-70 on C1/EXH/blinds; nickel anti-seize | EN 1092-1 / EN 1515 | Würth (DE), Bossard (CH), IR fastener stockists | 3.5 | E4_ducts.step | mating flanges on the engine side belong to E2/E3, on EXH to HVAC
E4-GSK | Gaskets spiral-wound 321 + mica (H1, C2) / graphite (C1, EXH) | 4 | buy | EN 1514-2 | DN100/125/250 | Klinger (AT), Kempchen (DE), Donit (SI) | 1.2 |  | spares: 2 sets
E4-TC | Thermocouples type K class 1 MI 3 mm Inconel 600 sheath (TE-502, TE-503, TE-505, TE-512) | 4 | buy (electrical scope) | IEC 60584-1 | 0-900 C | see docs/electrical/02_io_list | 0 | E4_ports.step | counted in the electrical BOM (mass 0 here)
E4-PDT | Differential pressure transmitters cold side (PT-E4-1/2) and hot side (PT-E4-3/4) | 2 | buy (electrical scope, NEW I/O) | 4-20 mA, 0-10 kPa / 0-5 kPa |  | Endress+Hauser (CH/DE), WIKA (DE), Keller (CH) | 1.6 |  | add to docs/electrical I/O list: fouling + leak monitoring
