ahmadreza221/aurora-cchp/electronics/b1_ecu/out/b1_ecu_bom.csv

Refs | Value | Footprint | MPN | Manufacturer | LCSC | Qty | DNP
BT1 | CR2032 | Battery:BatteryHolder_Keystone_3034_1x20mm | CR2032 | Renata (CH) |  | 1
C1 | 100u/50V | Capacitor_THT:CP_Radial_D8.0mm_P3.50mm | 860020675017 | Wuerth |  | 1
C2 | 1u/50V | Capacitor_SMD:C_0805_2012Metric |  |  |  | 1
C3,C82,C90,C92,C94,C96 | 100n/50V | Capacitor_SMD:C_0603_1608Metric |  |  |  | 6
C4,C16,C99,C102 | 10n | Capacitor_SMD:C_0402_1005Metric |  |  |  | 4
C5,C85,C86,C87 | 1n | Capacitor_SMD:C_0402_1005Metric |  |  |  | 4
C6,C13 | 10u/50V | Capacitor_SMD:C_1206_3216Metric |  |  |  | 2
C7 | 22u/10V | Capacitor_SMD:C_0805_2012Metric |  |  |  | 1
C8,C10,C12,C18,C19,C20,C21,C22,C23,C24,C25,C26,C27,C28,C29,C30,C38,C39,C40,C41,C42,C43,C44,C45,C49,C50,C53,C54,C58,C59,C62,C63,C64,C67,C68,C69,C72,C73,C74,C76,C77,C84,C88,C89,C91,C93,C95,C97,C100,C103 | 100n | Capacitor_SMD:C_0402_1005Metric |  |  |  | 50
C9,C11 | 10u/10V | Capacitor_SMD:C_0805_2012Metric |  |  |  | 2
C14 | 22u/25V | Capacitor_SMD:C_1206_3216Metric |  |  |  | 1
C15 | 1u | Capacitor_SMD:C_0402_1005Metric |  |  |  | 1
C17 | 1000u/6.3V hold-up | Capacitor_THT:CP_Radial_D10.0mm_P5.00mm | 860080675015 | Wuerth |  | 1
C31 | 10u | Capacitor_SMD:C_0805_2012Metric |  |  |  | 1
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
