ahmadreza221/aurora-cchp/fusion/A1000_comb/CB_310_Premixers_x7__pilot___6_mains__IN625.step

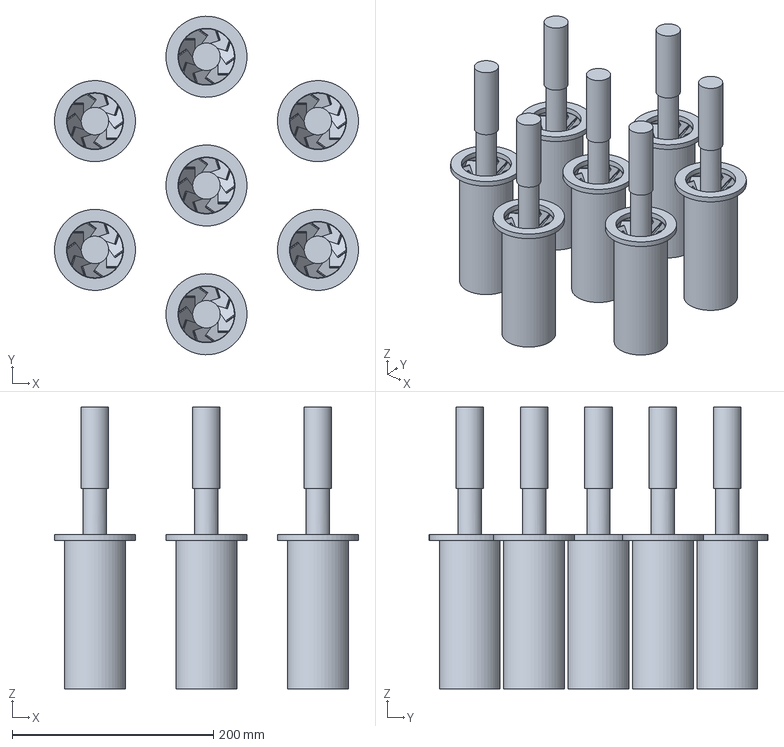
[picture p51: CAD file, 2026-10-30]
fusion/A1000_comb/CB_310_Premixers_x7__pilot___6_mains__IN625.step
302.2 x 336.6 x 280.0 mm
