ahmadreza221/aurora-cchp/fusion/A1000/A1000_N1_rings.step

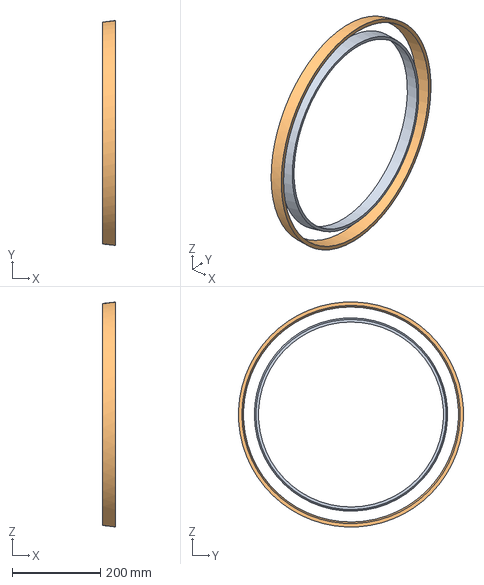
[picture p52: CAD file, 2026-10-31]
fusion/A1000/A1000_N1_rings.step
30.0 x 510.9 x 510.9 mm
