ahmadreza221/aurora-cchp/fusion/A1000_comb/CB_341_Scroll_pressure_casing_lower_half__P355NH.step

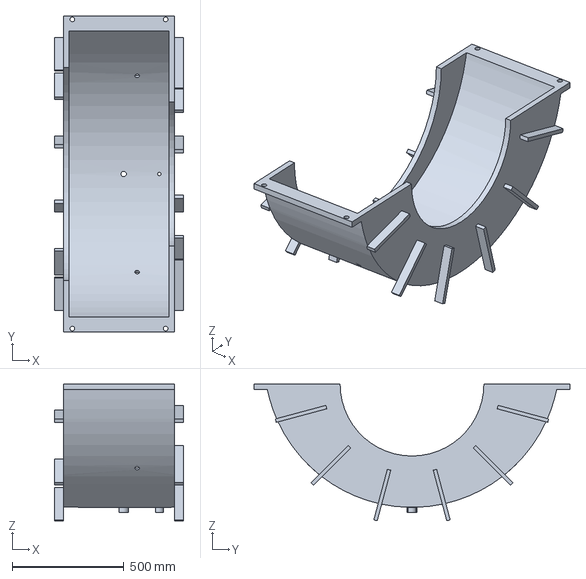
[picture p53: CAD file, 2026-10-31]
fusion/A1000_comb/CB_341_Scroll_pressure_casing_lower_half__P355NH.step
578.0 x 1415.2 x 612.5 mm
