ahmadreza221/aurora-cchp/fusion/A1000_exh/EX_411_Frame_heat_shield__1_4828.step

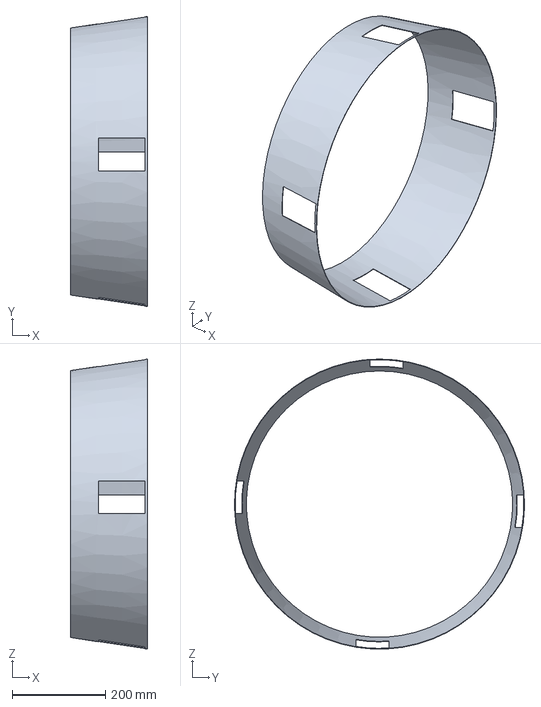
[picture p54: CAD file, 2026-10-31]
fusion/A1000_exh/EX_411_Frame_heat_shield__1_4828.step
165.0 x 623.6 x 623.3 mm
