ahmadreza221/aurora-cchp/fusion/A1000_hot/HS_233_Interstage_seal_honeycomb.step

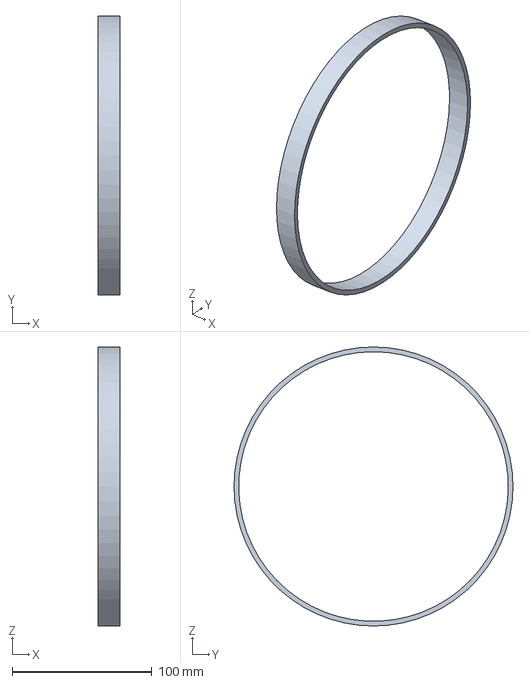
[picture p55: CAD file, 2026-11-01]
fusion/A1000_hot/HS_233_Interstage_seal_honeycomb.step
16.0 x 200.0 x 200.0 mm
