ahmadreza221/aurora-cchp/fusion/A1000_inl/IN_511_Plenum_box__lower_half___feet__S235JR.step

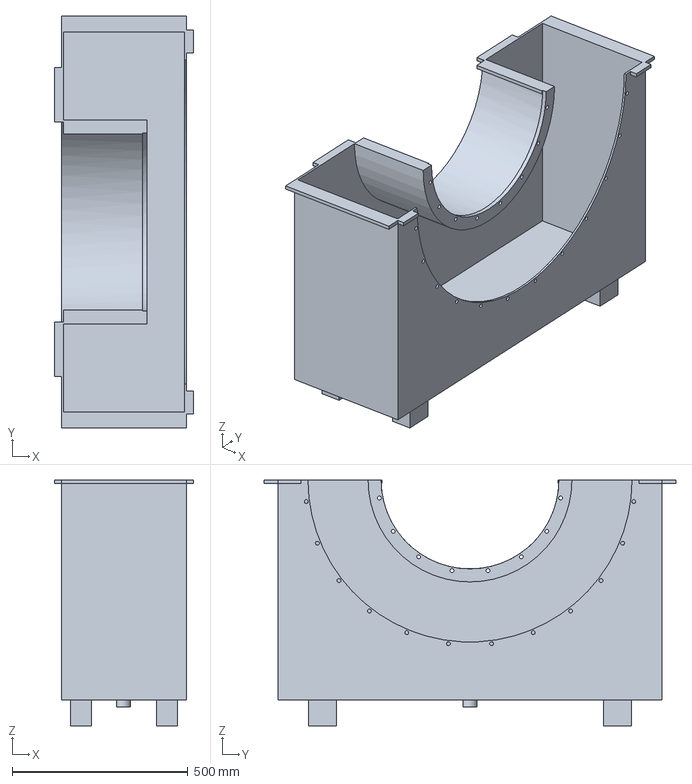
[picture p56: CAD file, 2026-10-31]
fusion/A1000_inl/IN_511_Plenum_box__lower_half___feet__S235JR.step
396.0 x 1172.0 x 700.0 mm
