ahmadreza221/aurora-cchp/fusion/A1000_pipe/PL_03_Oil_to_TB__tube_18_x_1_5__orifice_5_4_mm.step

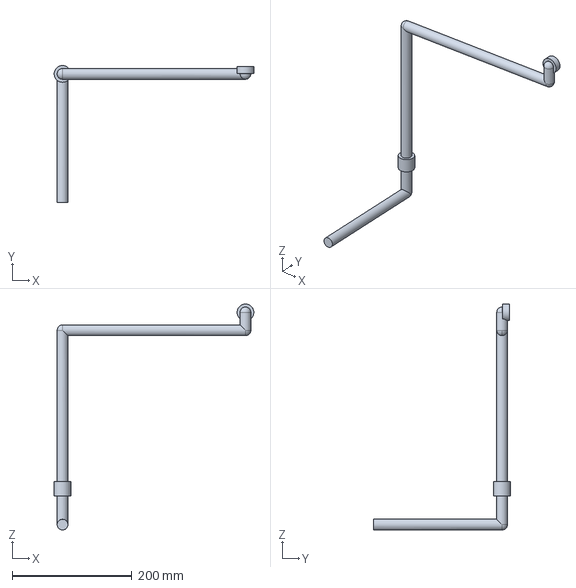
[picture p57: CAD file, 2026-10-31]
fusion/A1000_pipe/PL_03_Oil_to_TB__tube_18_x_1_5__orifice_5_4_mm.step
334.0 x 229.0 x 378.0 mm
