ahmadreza221/aurora-cchp/fusion/A1000_pkg/Turbine_casing___shroud_carrier.step

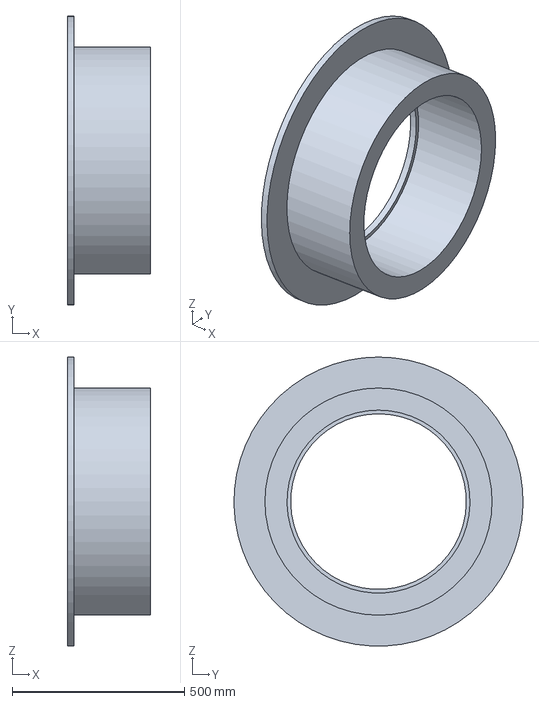
[picture p58: CAD file, 2026-10-30]
fusion/A1000_pkg/Turbine_casing___shroud_carrier.step
242.0 x 839.7 x 839.4 mm
