ahmadreza221/aurora-cchp/fusion/A1000_rotor/RT_111_Studs___nuts_drum___R1__16_x_M10.step

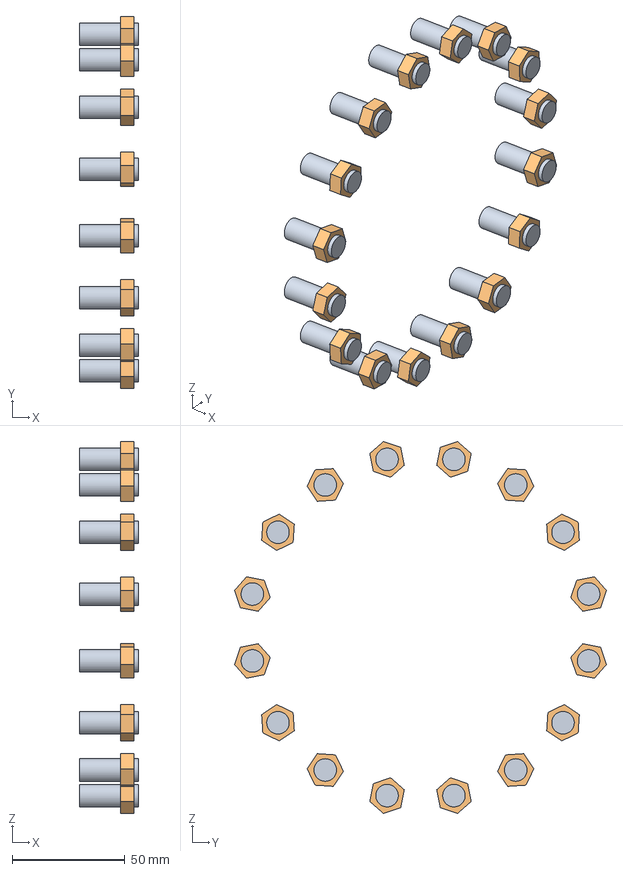
[picture p59: CAD file, 2026-11-01]
fusion/A1000_rotor/RT_111_Studs___nuts_drum___R1__16_x_M10.step
26.0 x 164.9 x 164.9 mm
