ahmadreza221/aurora-cchp/fusion/A1000C/A1000_C1_hub.step

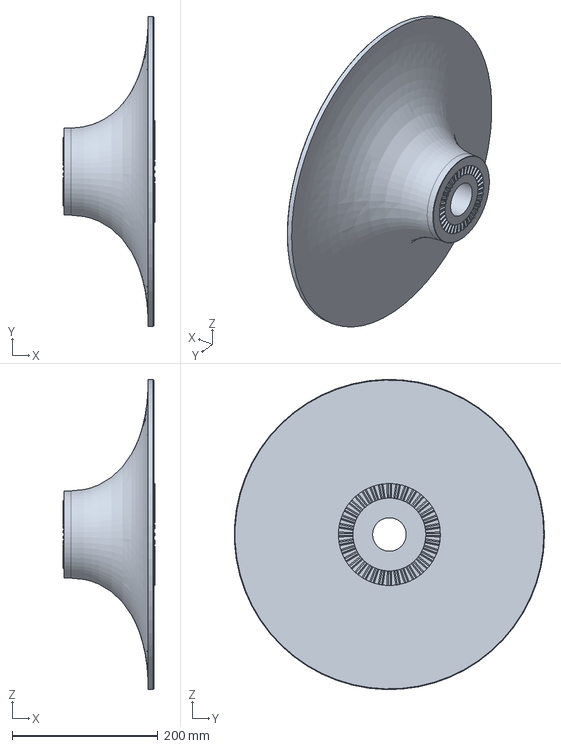
[picture p60: CAD file, 2026-10-31]
fusion/A1000C/A1000_C1_hub.step
126.5 x 425.7 x 425.8 mm
