ahmadreza221/aurora-cchp/fusion/E1/E1_ngv_rings_cast.step

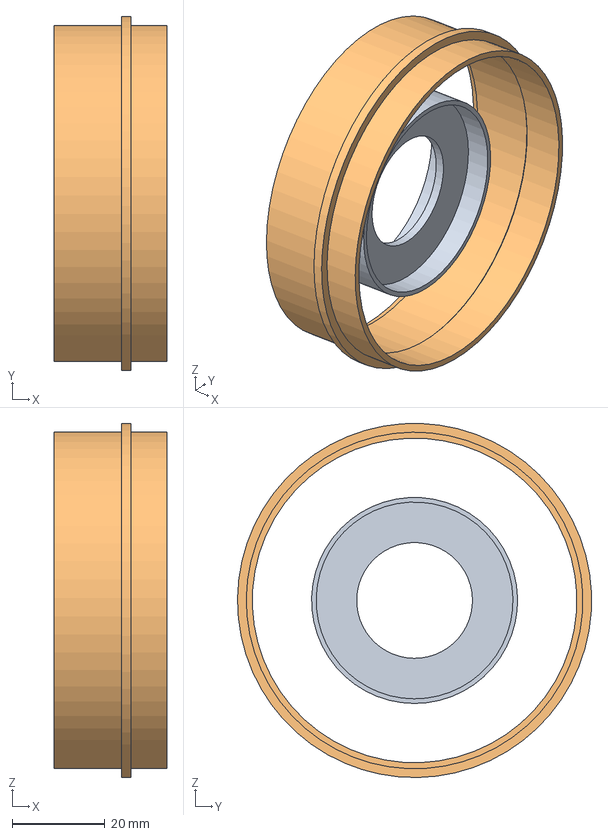
[picture p61: CAD file, 2026-10-23]
fusion/E1/E1_ngv_rings_cast.step
24.3 x 76.5 x 76.5 mm
