ahmadreza221/aurora-cchp/fusion/A1000/A1000_N2_rings.step

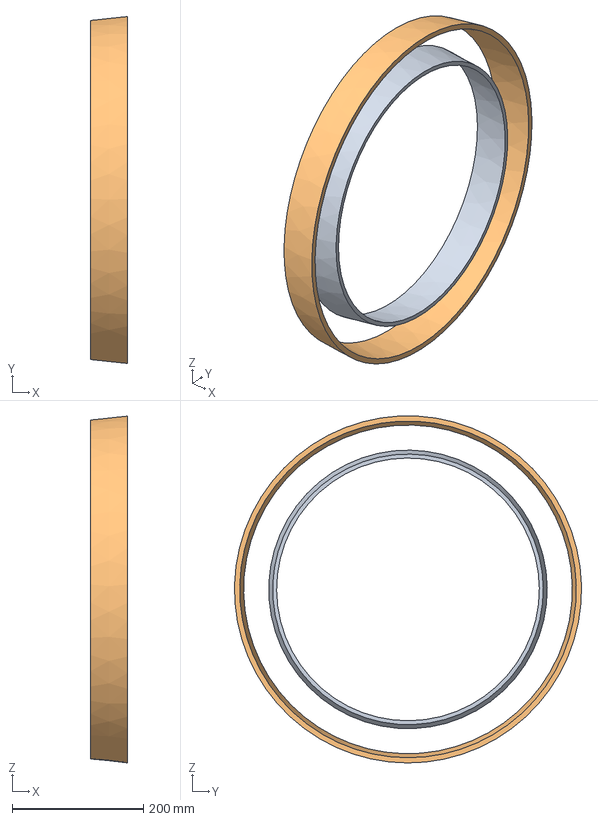
[picture p62: CAD file, 2026-10-30]
fusion/A1000/A1000_N2_rings.step
57.0 x 529.7 x 529.5 mm
