ahmadreza221/aurora-cchp/fusion/A1000_comb/CB_303_Head_cover__1_4948.step

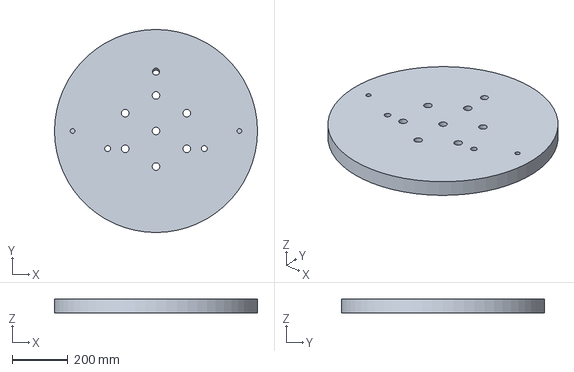
[picture p63: CAD file, 2026-10-31]
fusion/A1000_comb/CB_303_Head_cover__1_4948.step
730.0 x 730.0 x 50.0 mm
