ahmadreza221/aurora-cchp/fusion/A1000_exh/EX_420_Exhaust_collector__1_4828.step

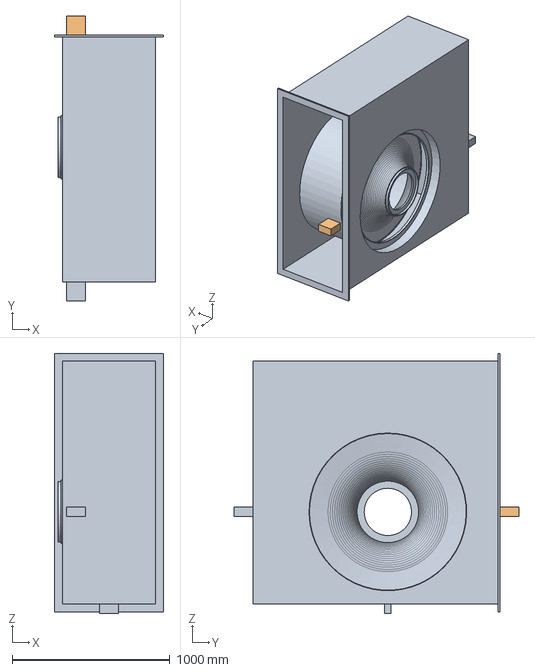
[picture p64: CAD file, 2026-10-31]
fusion/A1000_exh/EX_420_Exhaust_collector__1_4828.step
692.0 x 1808.0 x 1652.0 mm
