ahmadreza221/aurora-cchp/fusion/A1000_hot/HS_231_Front_seal_honeycomb.step

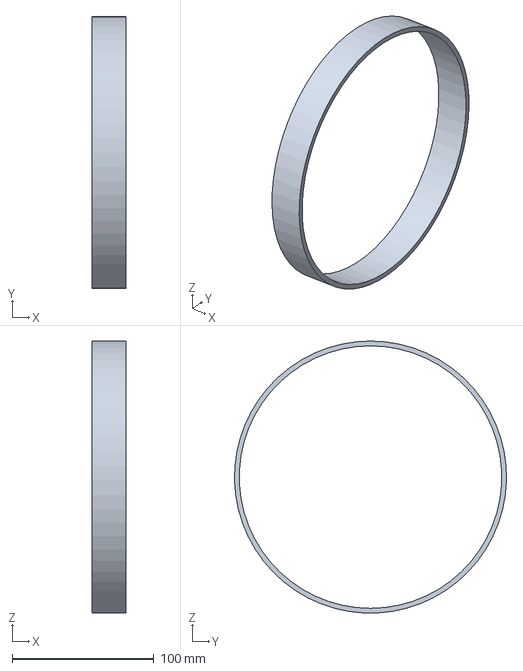
[picture p65: CAD file, 2026-11-01]
fusion/A1000_hot/HS_231_Front_seal_honeycomb.step
24.0 x 191.9 x 191.9 mm
