ahmadreza221/aurora-cchp/fusion/A1000_inl/IN_510_Plenum_box__upper_half___filter_house_flange__S235JR.step

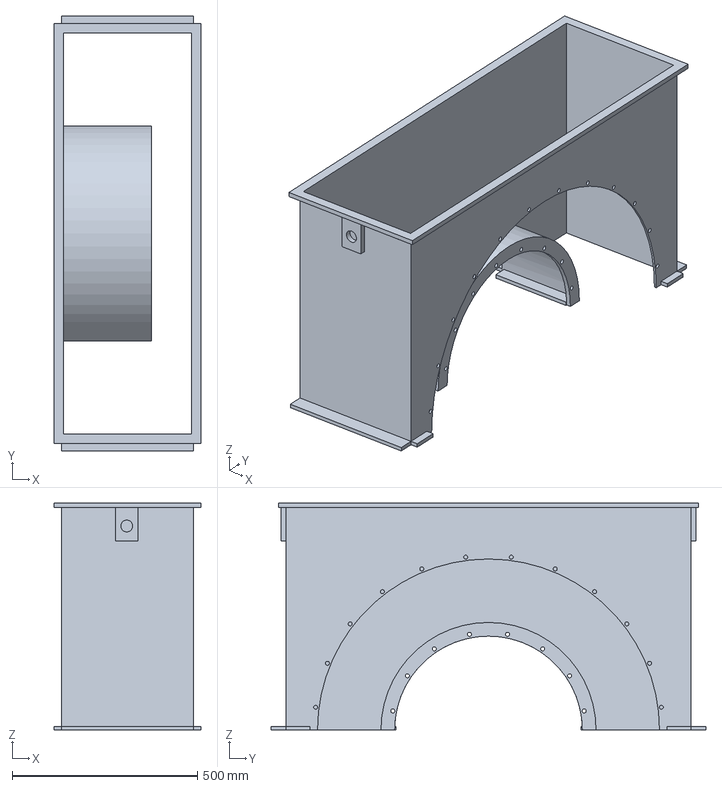
[picture p66: CAD file, 2026-10-31]
fusion/A1000_inl/IN_510_Plenum_box__upper_half___filter_house_flange__S235JR.step
396.0 x 1172.0 x 612.0 mm
