ahmadreza221/aurora-cchp/fusion/A1000_pipe/PL_01_Oil_supply_header___FB_distribution_block__tube_35_x_2.step

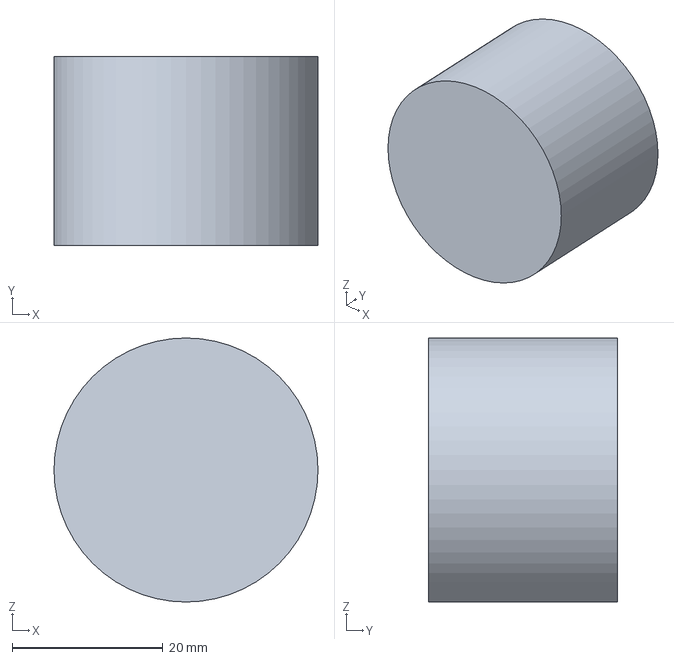
[picture p67: CAD file, 2026-10-31]
fusion/A1000_pipe/PL_01_Oil_supply_header___FB_distribution_block__tube_35_x_2.step
35.0 x 25.0 x 35.0 mm
