ahmadreza221/aurora-cchp/fusion/A1000_pkg/Turbine_interstage_spacer.step

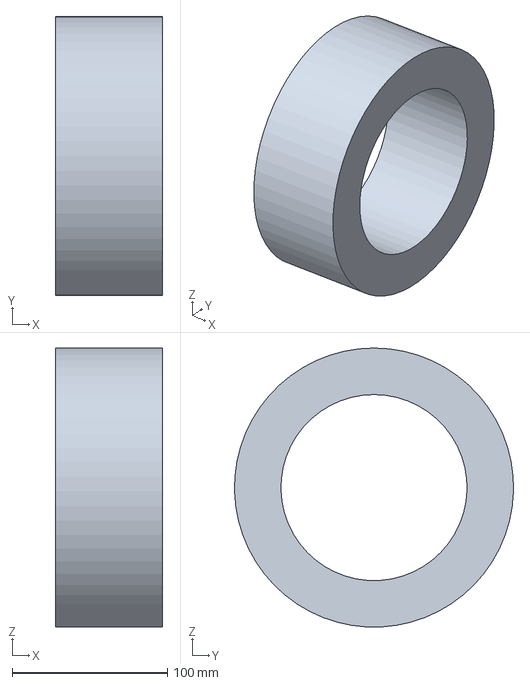
[picture p68: CAD file, 2026-10-30]
fusion/A1000_pkg/Turbine_interstage_spacer.step
69.0 x 179.9 x 179.9 mm
