ahmadreza221/aurora-cchp/fusion/A1000_rotor/RT_112_Studs___nuts_R1___R2__16_x_M10.step

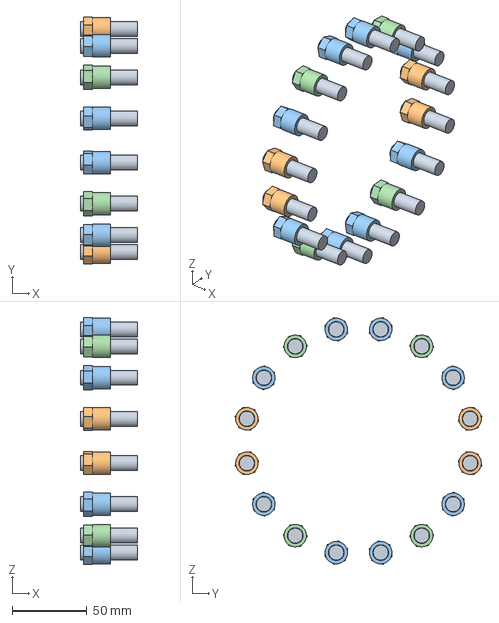
[picture p69: CAD file, 2026-11-01]
fusion/A1000_rotor/RT_112_Studs___nuts_R1___R2__16_x_M10.step
38.0 x 164.9 x 164.9 mm
