ahmadreza221/aurora-cchp/fusion/A1000C/A1000_C2_hub.step

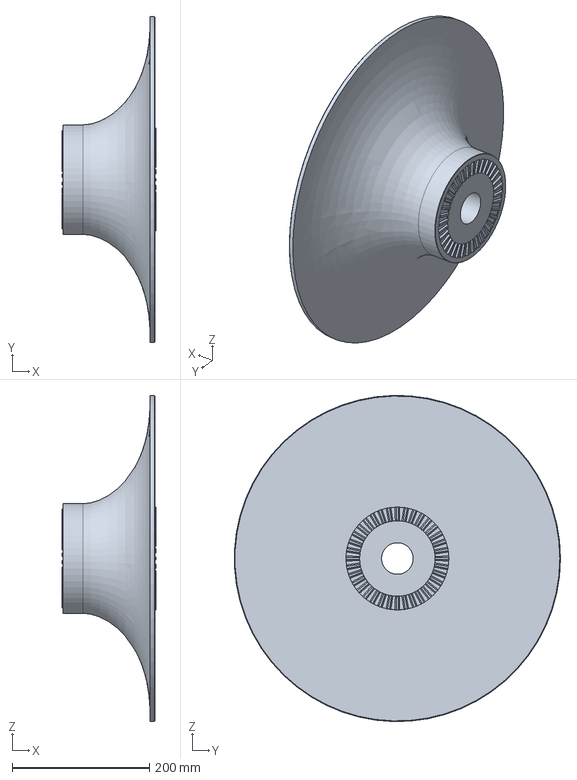
[picture p70: CAD file, 2026-10-30]
fusion/A1000C/A1000_C2_hub.step
137.4 x 475.7 x 475.8 mm
