ahmadreza221/aurora-cchp/fusion/E1/E1_ngv_vane_cast.step

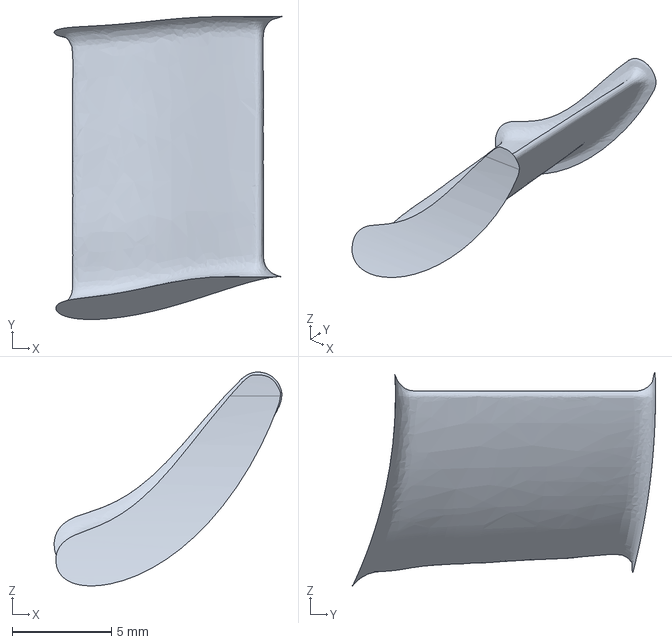
[picture p71: CAD file, 2026-10-23]
fusion/E1/E1_ngv_vane_cast.step
11.5 x 15.3 x 10.8 mm
