ahmadreza221/aurora-cchp/fusion/A1000/A1000_N2_vane.step

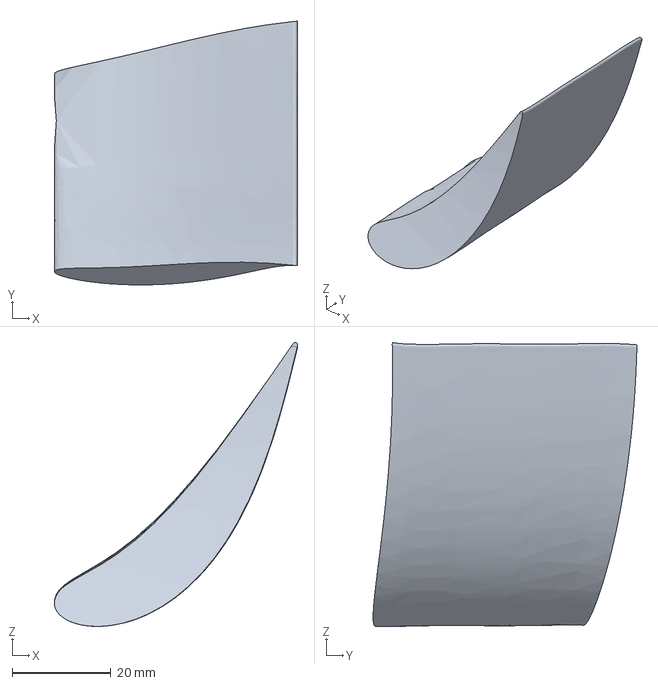
[picture p72: CAD file, 2026-10-30]
fusion/A1000/A1000_N2_vane.step
49.3 x 53.5 x 57.6 mm
