ahmadreza221/aurora-cchp/fusion/A1000_comb/CB_301_Can_casing__1_4948.step

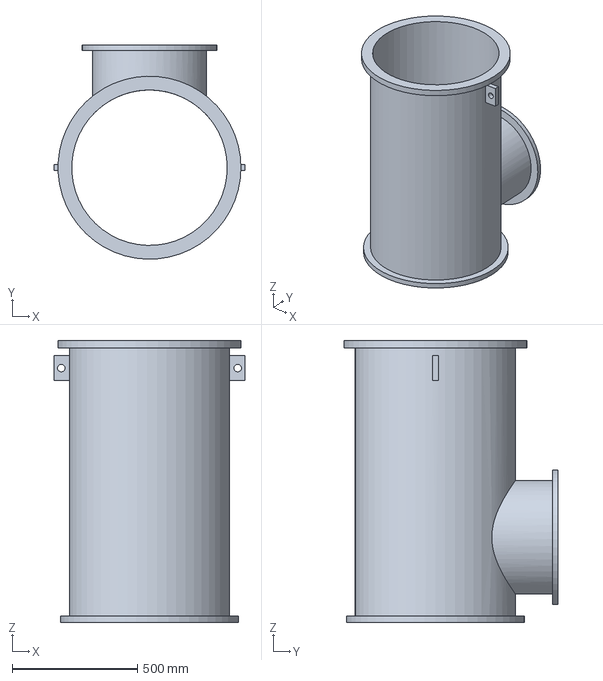
[picture p73: CAD file, 2026-10-31]
fusion/A1000_comb/CB_301_Can_casing__1_4948.step
760.0 x 854.8 x 1125.0 mm
