ahmadreza221/aurora-cchp/fusion/A1000_exh/EX_401_Air_manifold_casing__EN_GJS_400_18LT.step

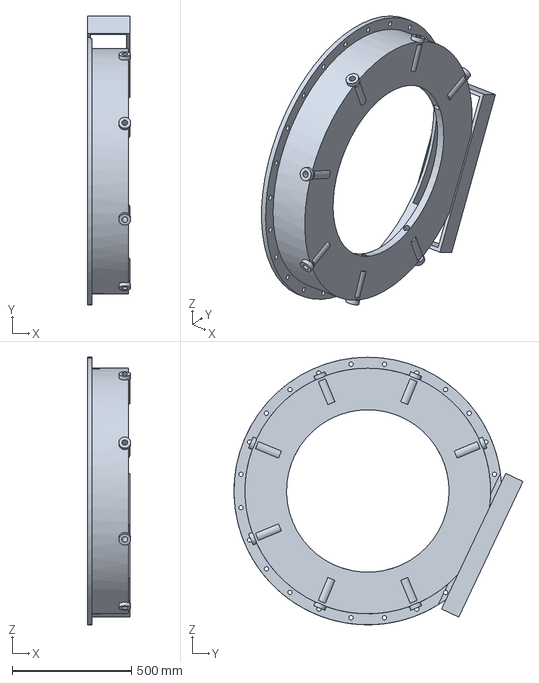
[picture p74: CAD file, 2026-10-31]
fusion/A1000_exh/EX_401_Air_manifold_casing__EN_GJS_400_18LT.step
182.0 x 1209.5 x 1119.9 mm
