ahmadreza221/aurora-cchp/fusion/A1000_hot/HS_230_Front_diaphragm__Hastelloy_X.step

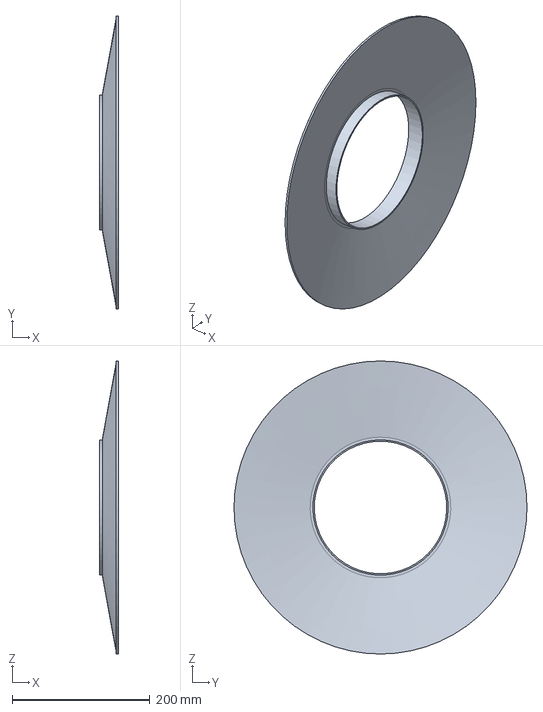
[picture p75: CAD file, 2026-11-01]
fusion/A1000_hot/HS_230_Front_diaphragm__Hastelloy_X.step
27.0 x 424.8 x 424.8 mm
