ahmadreza221/aurora-cchp/fusion/A1000_inl/IN_502_Inlet_casing__lower_half___FB_2_foot_brackets__EN_GJS_400_18.step

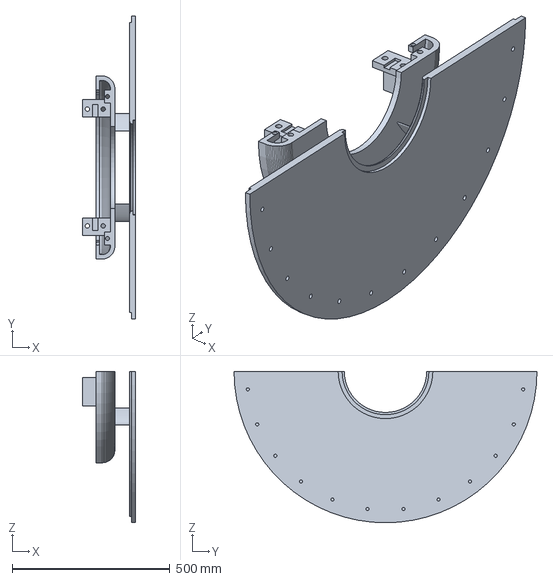
[picture p76: CAD file, 2026-10-31]
fusion/A1000_inl/IN_502_Inlet_casing__lower_half___FB_2_foot_brackets__EN_GJS_400_18.step
167.0 x 960.0 x 480.0 mm
