ahmadreza221/aurora-cchp/fusion/A1000_pipe/PL_07_FBH_vent_DN25__forward_through_the_tunnel__to_the_reservoir.step

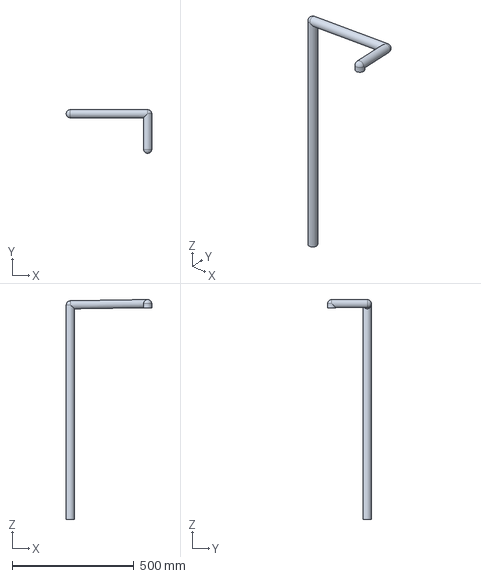
[picture p77: CAD file, 2026-10-31]
fusion/A1000_pipe/PL_07_FBH_vent_DN25__forward_through_the_tunnel__to_the_reservoir.step
351.7 x 179.7 x 903.9 mm
