ahmadreza221/aurora-cchp/fusion/A1000_pkg/Turbine_casing_insulation.step

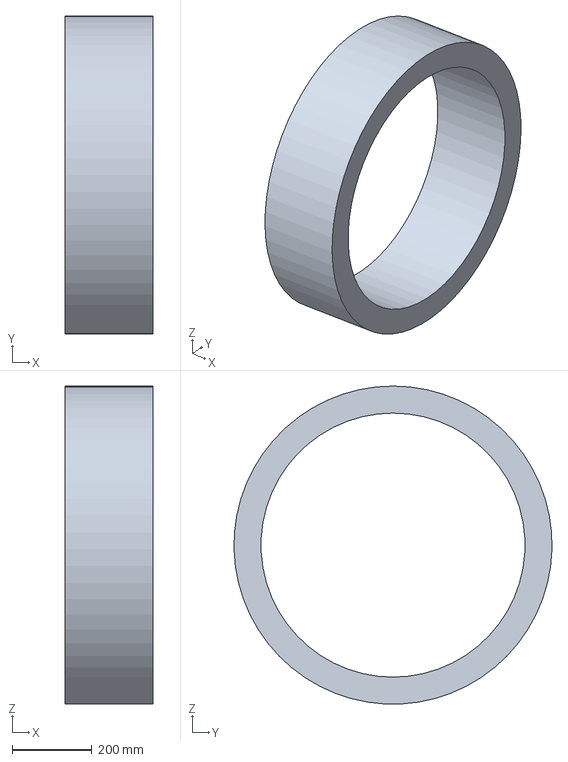
[picture p78: CAD file, 2026-10-30]
fusion/A1000_pkg/Turbine_casing_insulation.step
222.0 x 799.7 x 799.4 mm
