ahmadreza221/aurora-cchp/fusion/A1000_rotor/A1000_R2_disc_with_arms__cast_MAR_M247.step

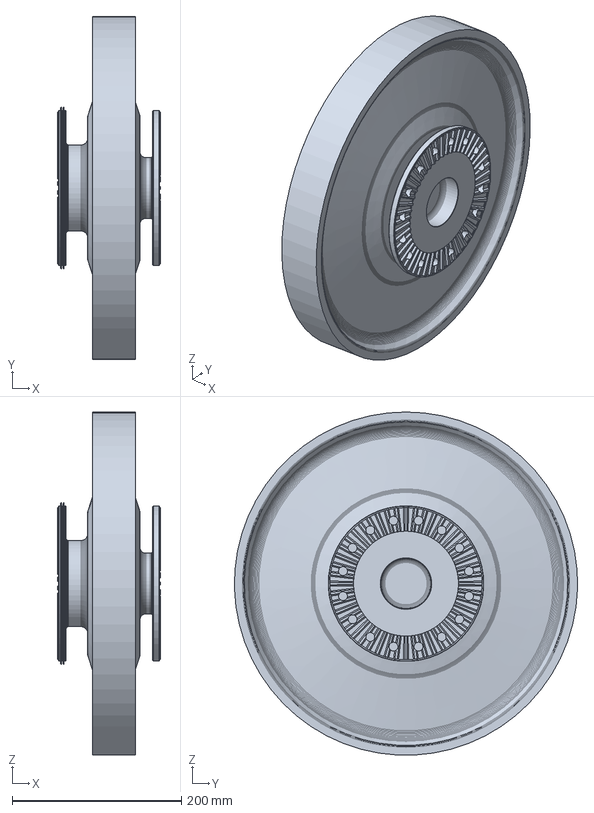
[picture p79: CAD file, 2026-11-01]
fusion/A1000_rotor/A1000_R2_disc_with_arms__cast_MAR_M247.step
122.1 x 405.9 x 405.8 mm
