ahmadreza221/aurora-cchp/fusion/A1000C/A1000_C2_blade.step

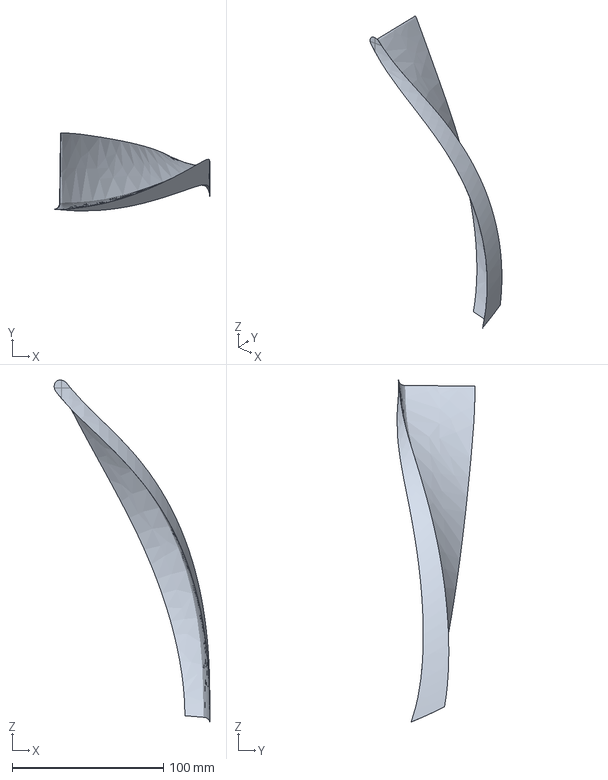
[picture p80: CAD file, 2026-10-30]
fusion/A1000C/A1000_C2_blade.step
103.0 x 51.6 x 226.2 mm
