ahmadreza221/aurora-cchp/fusion/E1/E1_blade_cast.step

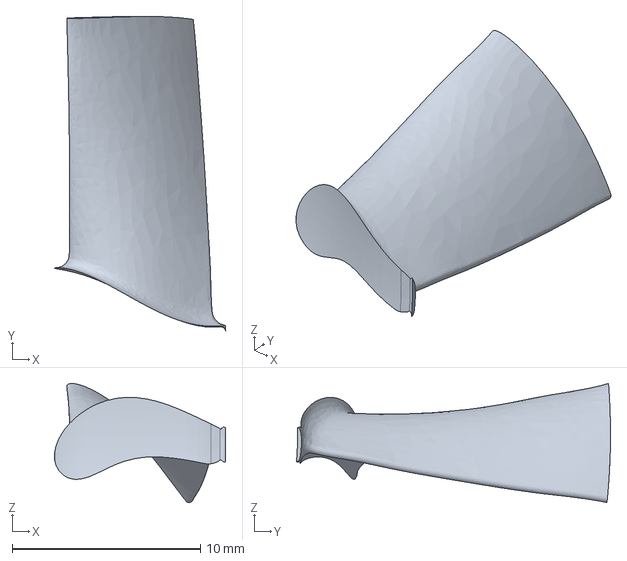
[picture p81: CAD file, 2026-10-22]
fusion/E1/E1_blade_cast.step
9.09 x 16.7 x 6.33 mm
