ahmadreza221/aurora-cchp/fusion/A1000/A1000_R2_blade.step

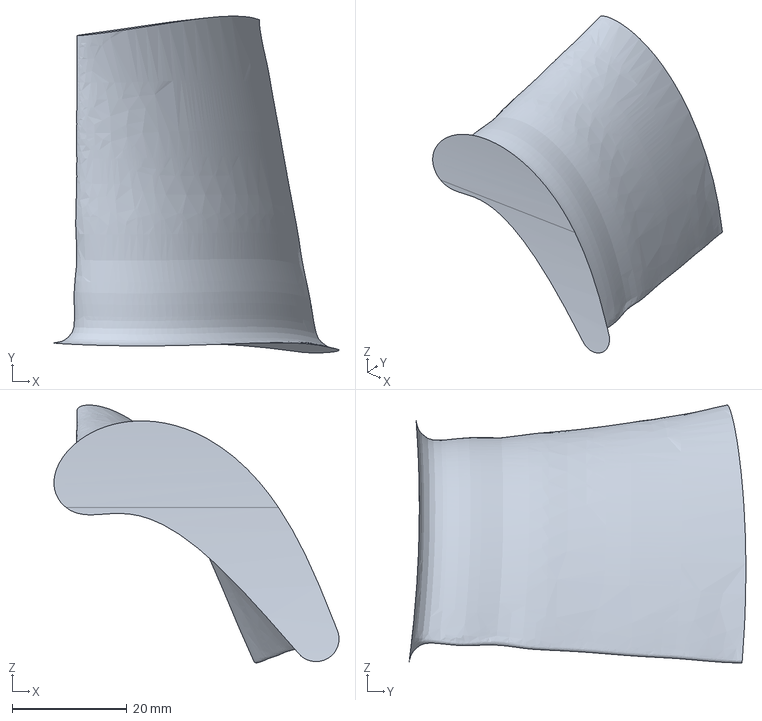
[picture p82: CAD file, 2026-10-30]
fusion/A1000/A1000_R2_blade.step
49.7 x 58.8 x 45.0 mm
