ahmadreza221/aurora-cchp/fusion/A1000_comb/CB_340_Scroll_pressure_casing_upper_half__P355NH.step

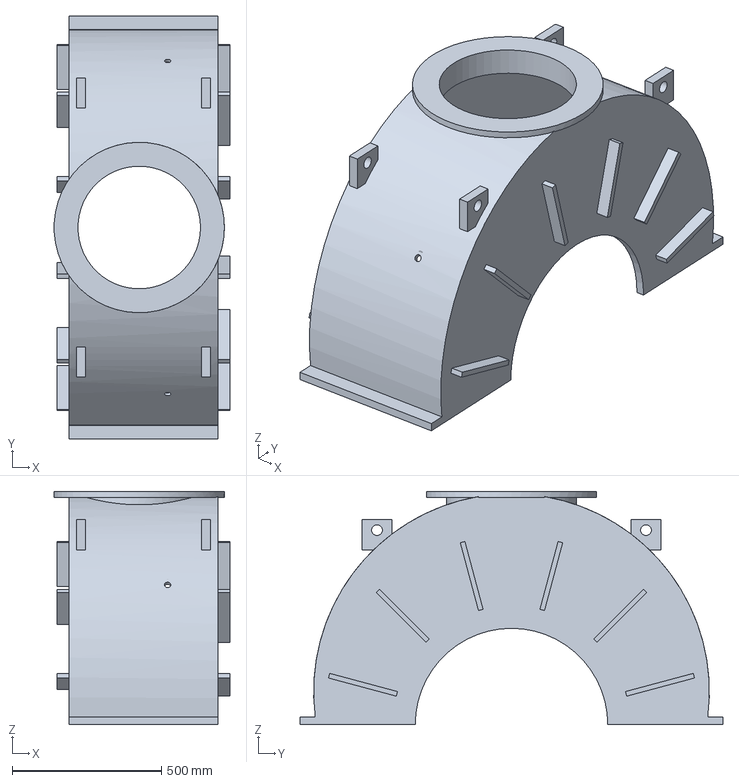
[picture p83: CAD file, 2026-10-31]
fusion/A1000_comb/CB_340_Scroll_pressure_casing_upper_half__P355NH.step
587.5 x 1415.2 x 780.0 mm
