ahmadreza221/aurora-cchp/fusion/A1000_exh/EX_450_Hot_air_pipe_DN450___gimbal_pair__1_4948.step

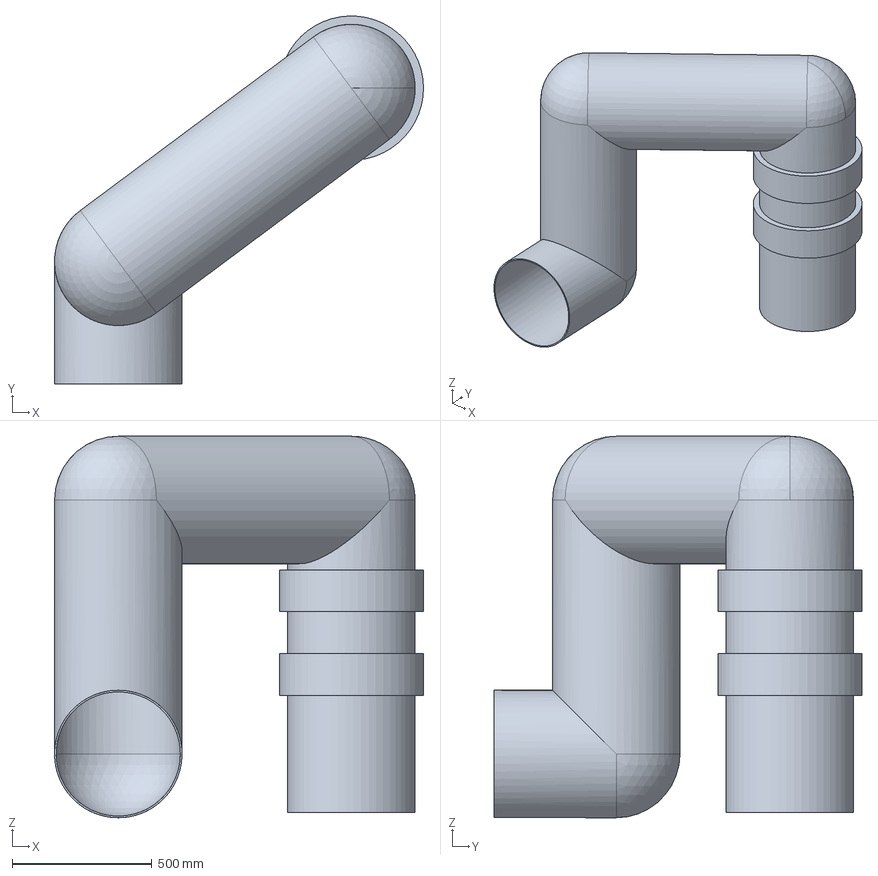
[picture p84: CAD file, 2026-10-31]
fusion/A1000_exh/EX_450_Hot_air_pipe_DN450___gimbal_pair__1_4948.step
1322.0 x 1318.4 x 1367.0 mm
