ahmadreza221/aurora-cchp/fusion/A1000_hot/HS_232_Interstage_diaphragm__Hastelloy_X.step

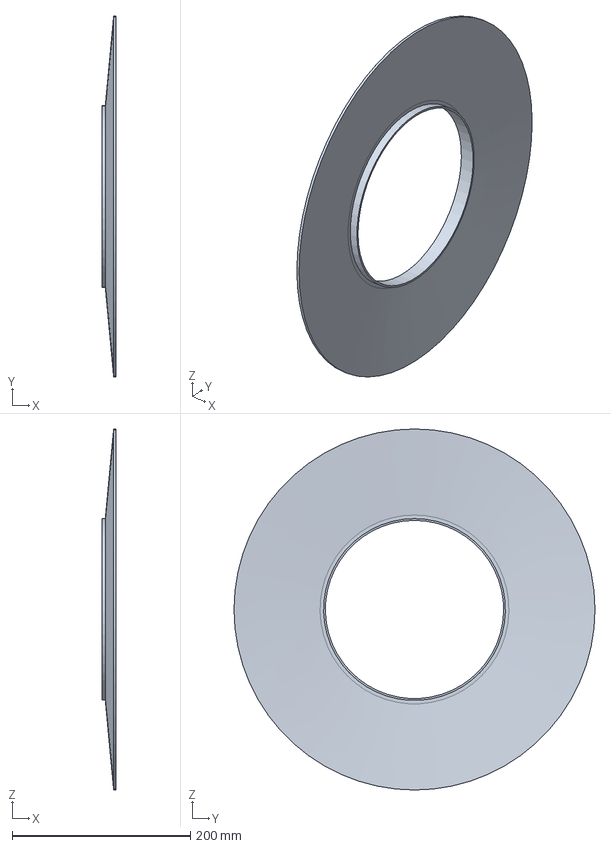
[picture p85: CAD file, 2026-11-01]
fusion/A1000_hot/HS_232_Interstage_diaphragm__Hastelloy_X.step
16.0 x 405.2 x 405.2 mm
