ahmadreza221/aurora-cchp/fusion/A1000_inl/IN_520_Filter_house_adapter___fabric_joint.step

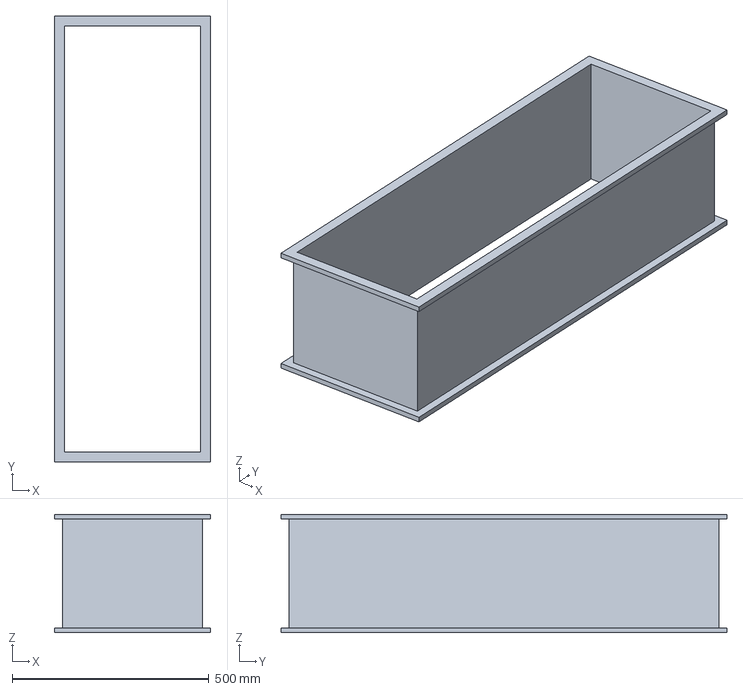
[picture p86: CAD file, 2026-10-31]
fusion/A1000_inl/IN_520_Filter_house_adapter___fabric_joint.step
396.0 x 1132.0 x 300.0 mm
