ahmadreza221/aurora-cchp/fusion/A1000_pipe/PL_02_Oil_to_JB1__tube_15_x_1_5__orifice_3_2_mm.step

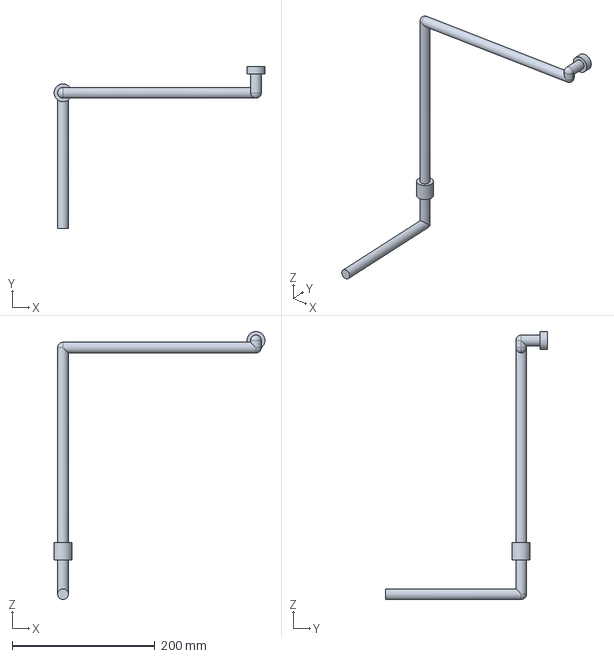
[picture p87: CAD file, 2026-10-31]
fusion/A1000_pipe/PL_02_Oil_to_JB1__tube_15_x_1_5__orifice_3_2_mm.step
295.0 x 227.0 x 375.0 mm
