ahmadreza221/aurora-cchp/fusion/A1000_pkg/Recuperator_ducts.step

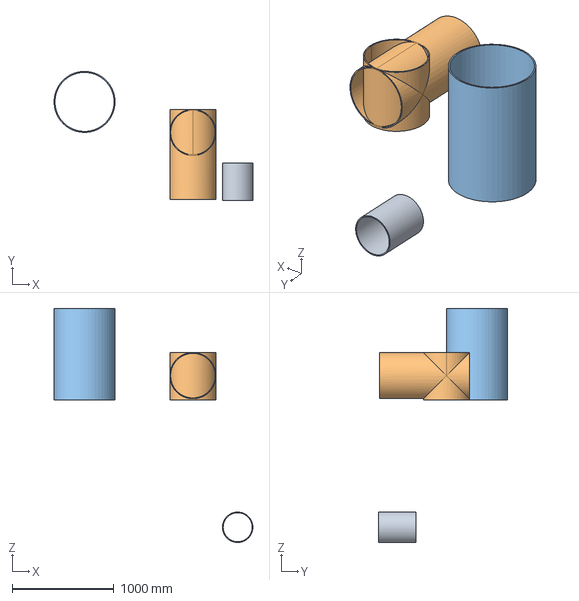
[picture p88: CAD file, 2026-10-30]
fusion/A1000_pkg/Recuperator_ducts.step
1954.4 x 1269.9 x 2299.7 mm
