ahmadreza221/aurora-cchp/fusion/A1000_rotor/RT_105_Drum_IN718.step

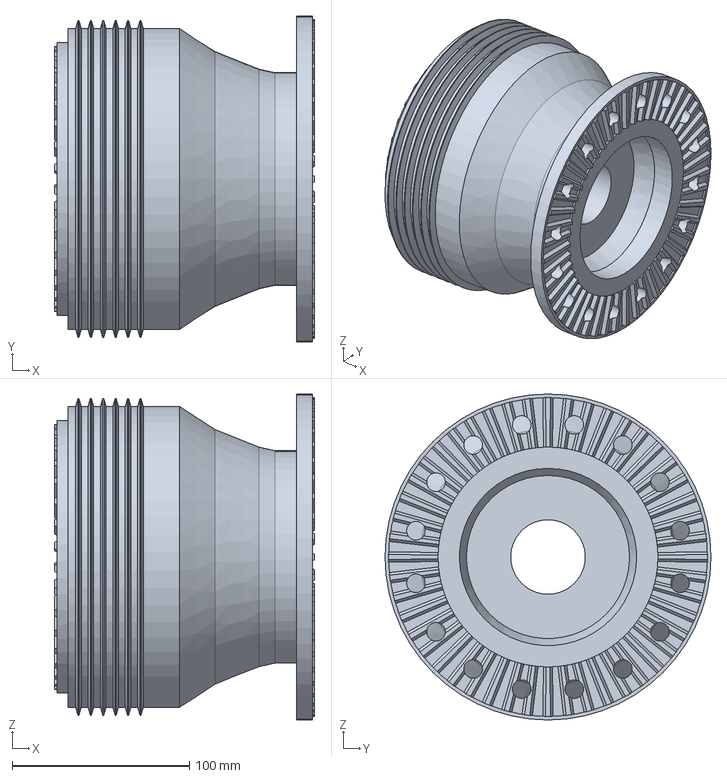
[picture p89: CAD file, 2026-11-01]
fusion/A1000_rotor/RT_105_Drum_IN718.step
146.9 x 184.0 x 184.0 mm
