ahmadreza221/aurora-cchp/fusion/A1000C/A1000_C1_splitter.step

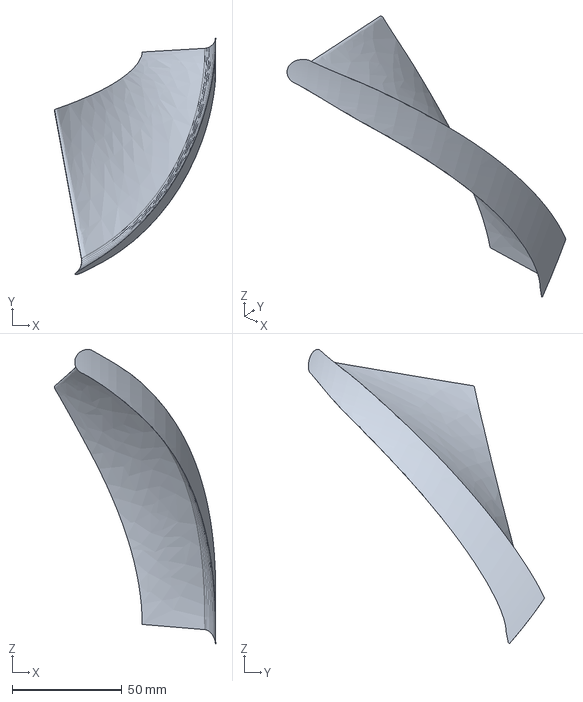
[picture p90: CAD file, 2026-10-30]
fusion/A1000C/A1000_C1_splitter.step
73.5 x 107.6 x 133.9 mm
