ahmadreza221/aurora-cchp/fusion/E1/E1_disc_boreless_cast.step

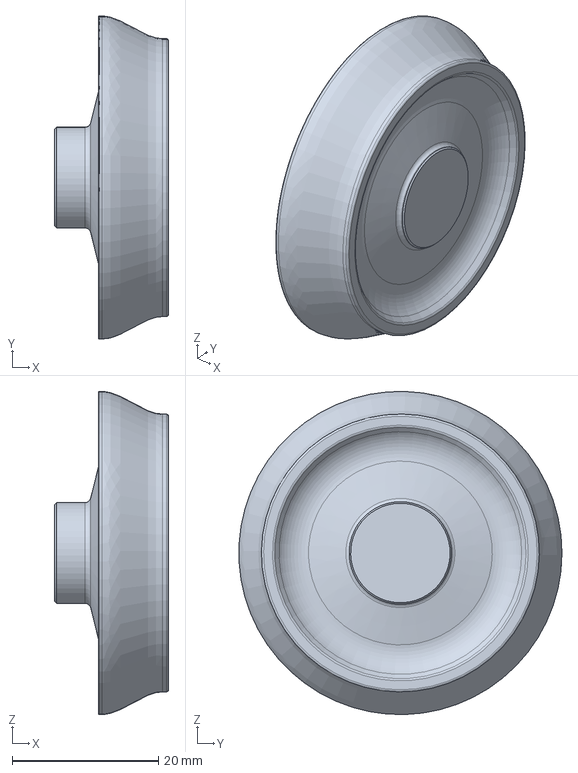
[picture p91: CAD file, 2026-10-22]
fusion/E1/E1_disc_boreless_cast.step
15.6 x 44.2 x 44.2 mm
