ahmadreza221/aurora-cchp/fusion/A1000/A1000_R2_disc.step

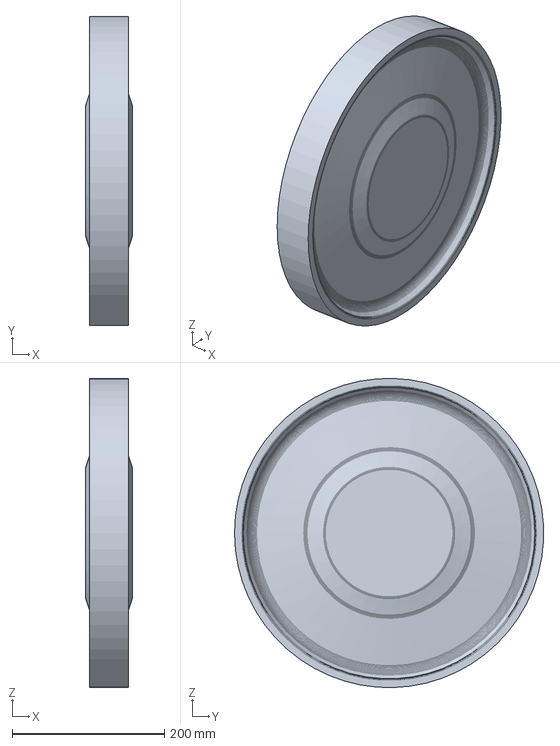
[picture p92: CAD file, 2026-10-30]
fusion/A1000/A1000_R2_disc.step
62.0 x 405.8 x 405.9 mm
