ahmadreza221/aurora-cchp/fusion/A1000_comb/CB_370_Fuel_manifolds_P___A___B1___B2__pigtails__bulkhead__1_4404.step

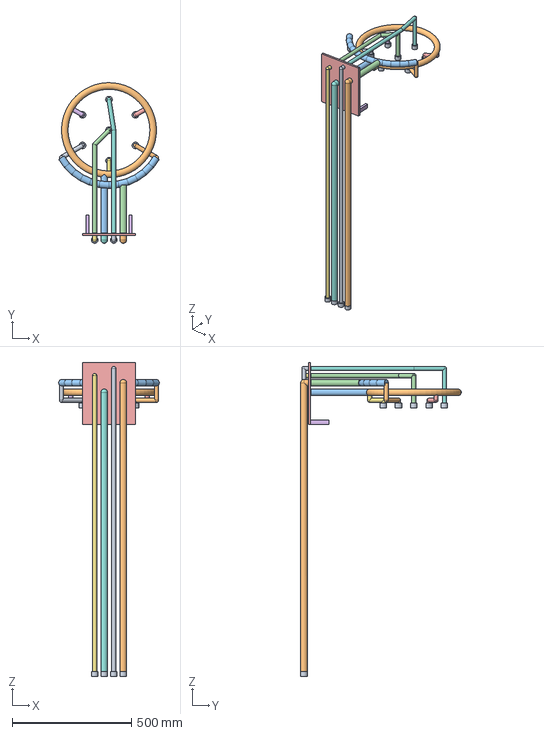
[picture p93: CAD file, 2026-10-31]
fusion/A1000_comb/CB_370_Fuel_manifolds_P___A___B1___B2__pigtails__bulkhead__1_4404.step
421.3 x 672.9 x 1315.0 mm
