ahmadreza221/aurora-cchp/fusion/A1000_exh/EX_421_Hub_access_cover__1_4828.step

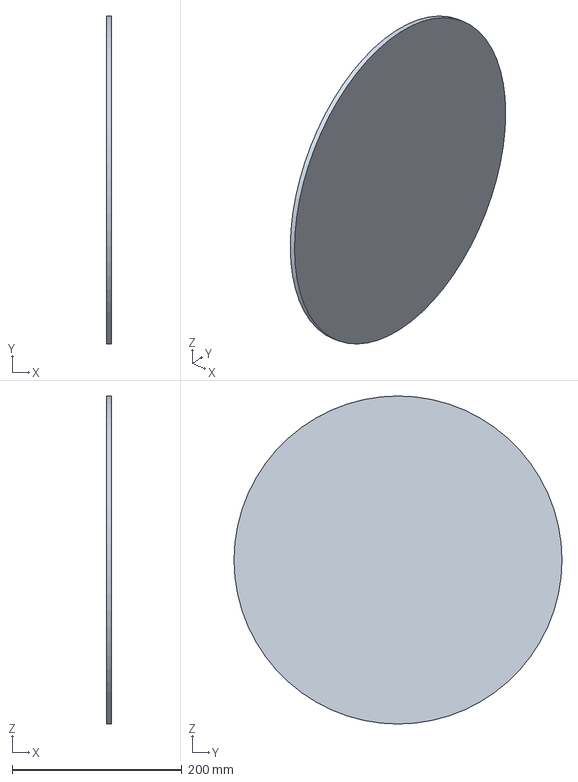
[picture p94: CAD file, 2026-10-31]
fusion/A1000_exh/EX_421_Hub_access_cover__1_4828.step
6.00 x 386.8 x 386.8 mm
