ahmadreza221/aurora-cchp/fusion/A1000_hot/HS_202_Outer_casing_lower_half__EN_GJS_400_18LT.step

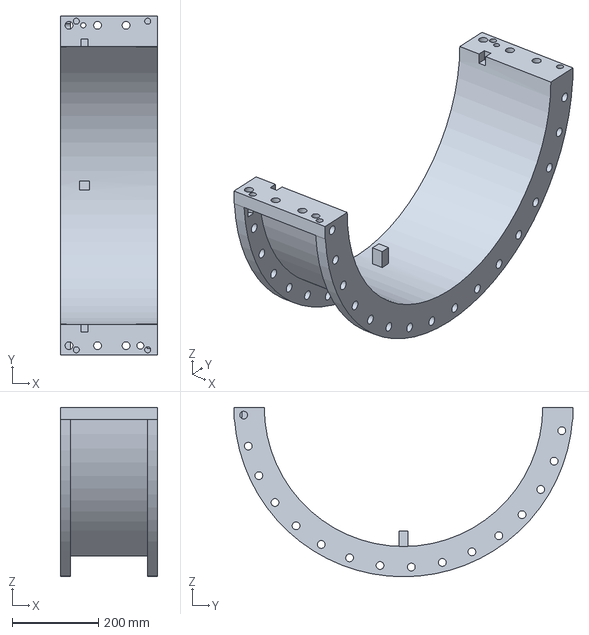
[picture p95: CAD file, 2026-10-31]
fusion/A1000_hot/HS_202_Outer_casing_lower_half__EN_GJS_400_18LT.step
225.0 x 784.0 x 392.0 mm
