ahmadreza221/aurora-cchp/fusion/A1000_inl/IN_501_Inlet_casing__upper_half__EN_GJS_400_18.step

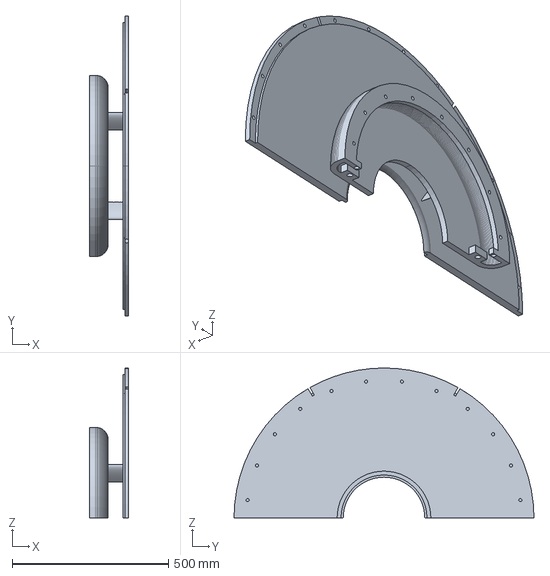
[picture p96: CAD file, 2026-10-31]
fusion/A1000_inl/IN_501_Inlet_casing__upper_half__EN_GJS_400_18.step
125.0 x 960.0 x 480.0 mm
