ahmadreza221/aurora-cchp/fusion/A1000_pipe/PL_09_Buffer_air_from_stage_1_to_the_TB_rear_seal__tube_22.step

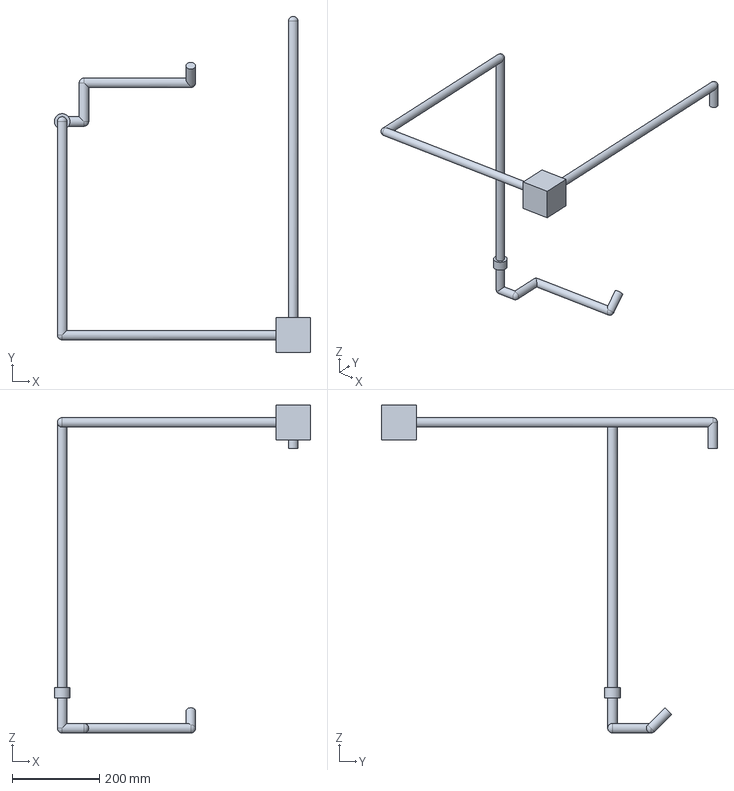
[picture p97: CAD file, 2026-10-31]
fusion/A1000_pipe/PL_09_Buffer_air_from_stage_1_to_the_TB_rear_seal__tube_22.step
588.0 x 771.0 x 752.4 mm
