ahmadreza221/aurora-cchp/fusion/A1000_pkg/Exhaust_collector.step

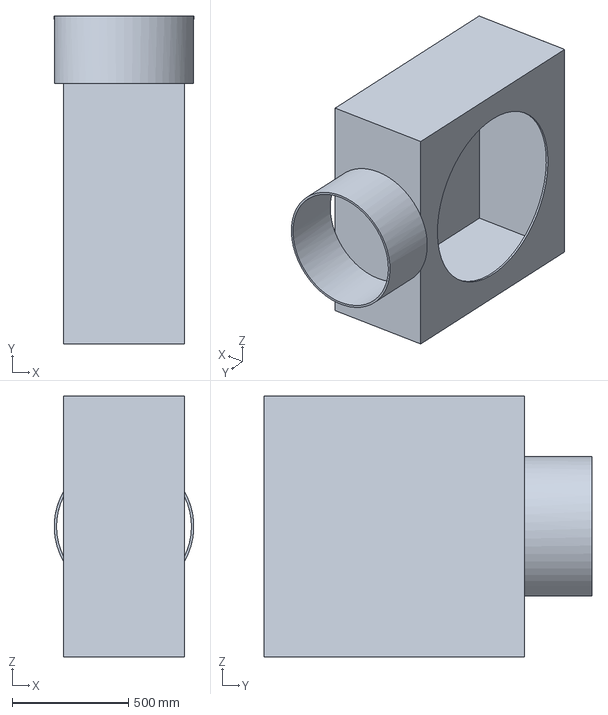
[picture p98: CAD file, 2026-10-30]
fusion/A1000_pkg/Exhaust_collector.step
599.7 x 1410.0 x 1120.0 mm
