ahmadreza221/aurora-cchp/fusion/A1000_rotor/RT_106_Rear_stub_shaft.step

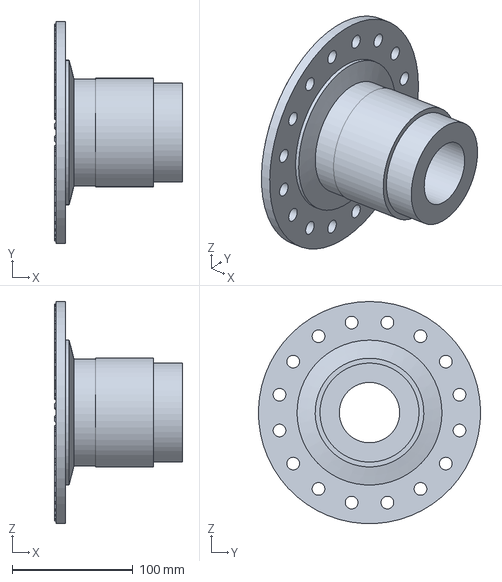
[picture p99: CAD file, 2026-11-01]
fusion/A1000_rotor/RT_106_Rear_stub_shaft.step
106.3 x 183.9 x 183.9 mm
