ahmadreza221/aurora-cchp/fusion/A1000C/A1000_C2_splitter.step

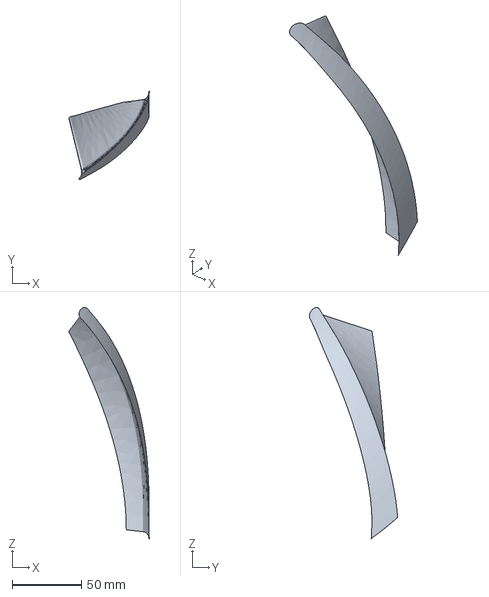
[picture p100: CAD file, 2026-10-30]
fusion/A1000C/A1000_C2_splitter.step
57.9 x 63.6 x 166.5 mm
