ahmadreza221/aurora-cchp/fusion/E1/E1_blade_final.step

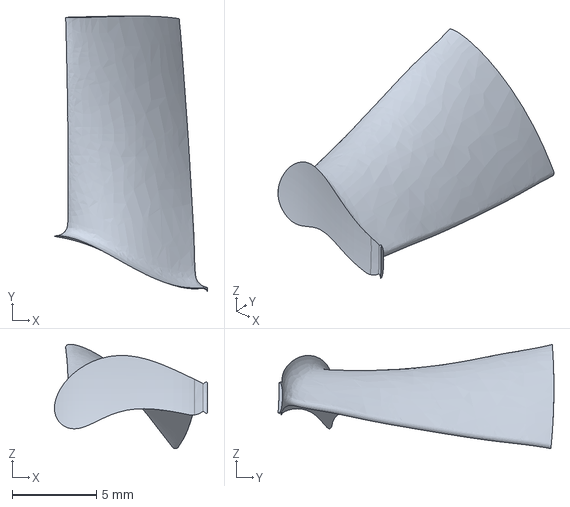
[picture p101: CAD file, 2026-10-22]
fusion/E1/E1_blade_final.step
9.09 x 16.4 x 6.20 mm
