ahmadreza221/aurora-cchp/fusion/A1000/A1000_R1_disc.step

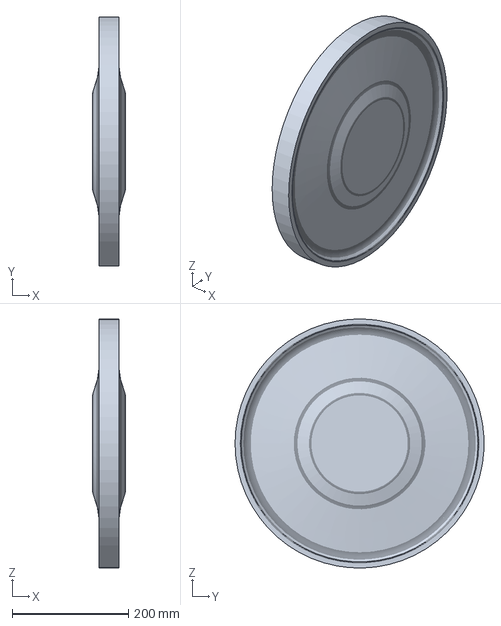
[picture p102: CAD file, 2026-10-29]
fusion/A1000/A1000_R1_disc.step
56.0 x 428.2 x 428.3 mm
