ahmadreza221/aurora-cchp/fusion/A1000_comb/CB_320_Liner__Hastelloy_X___TBC.step

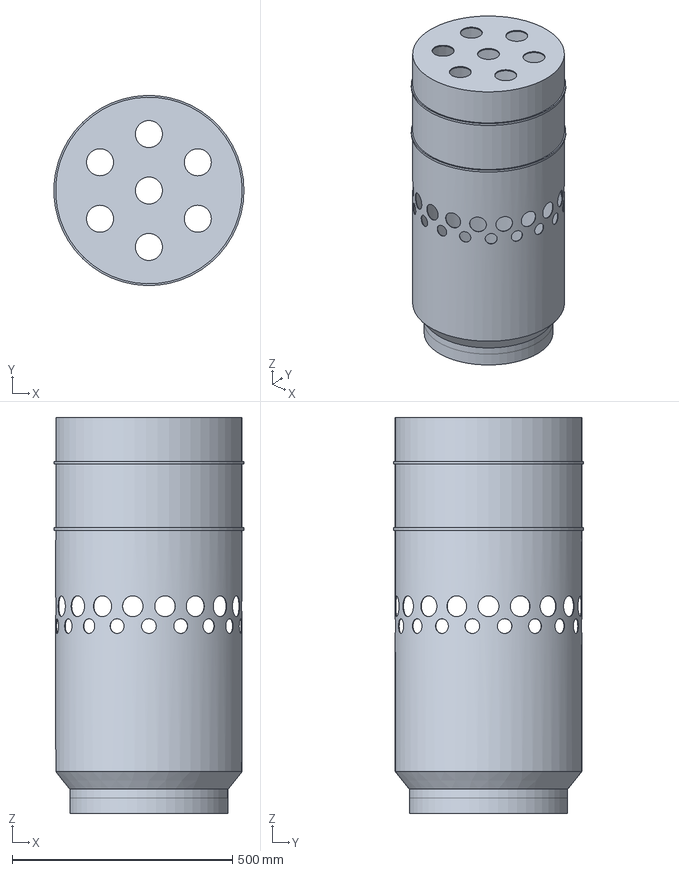
[picture p103: CAD file, 2026-10-30]
fusion/A1000_comb/CB_320_Liner__Hastelloy_X___TBC.step
430.8 x 431.0 x 898.0 mm
