ahmadreza221/aurora-cchp/fusion/A1000_exh/EX_460_Recuperator__bought_in.step

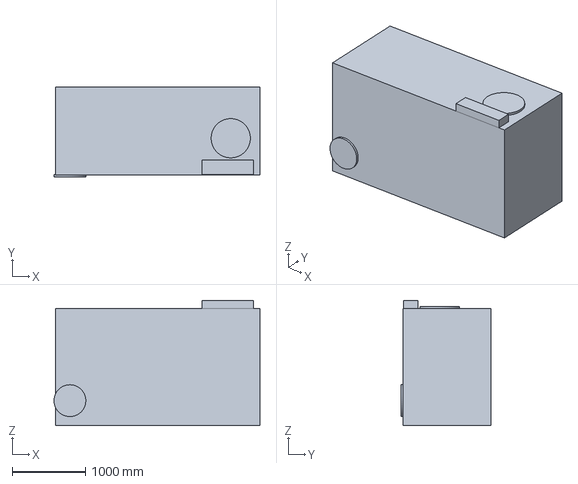
[picture p104: CAD file, 2026-10-31]
fusion/A1000_exh/EX_460_Recuperator__bought_in.step
2817.7 x 1230.0 x 1710.0 mm
