ahmadreza221/aurora-cchp/fusion/A1000_pipe/PL_05_FBH_drain_2_x_DN40___DN65__forward_through_the_tunnel_to_the_reservoir.step

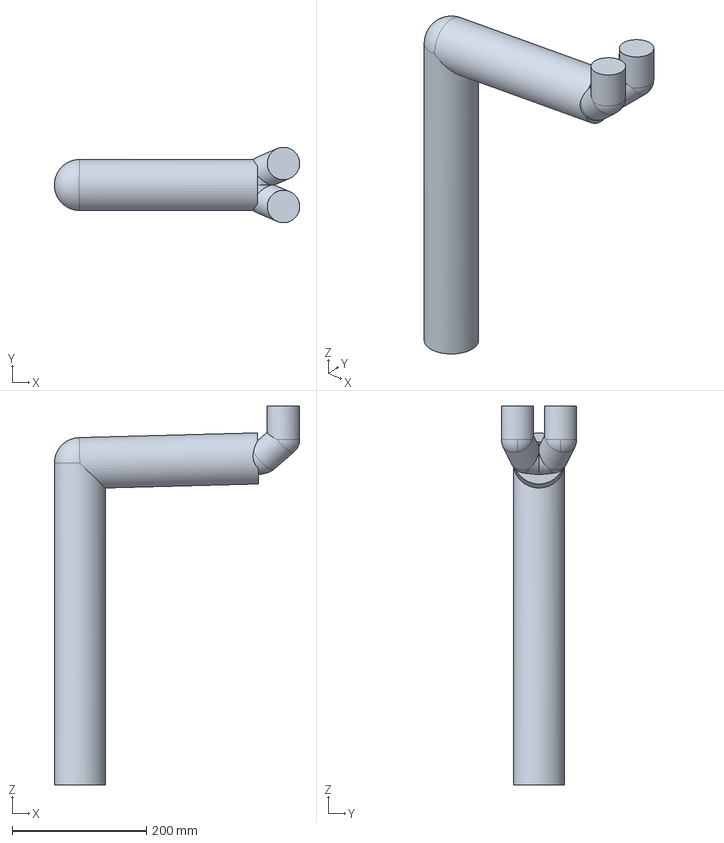
[picture p105: CAD file, 2026-10-31]
fusion/A1000_pipe/PL_05_FBH_drain_2_x_DN40___DN65__forward_through_the_tunnel_to_the_reservoir.step
365.2 x 112.3 x 564.0 mm
