ahmadreza221/aurora-cchp/fusion/A1000_pkg/Rear_stub_shaft.step

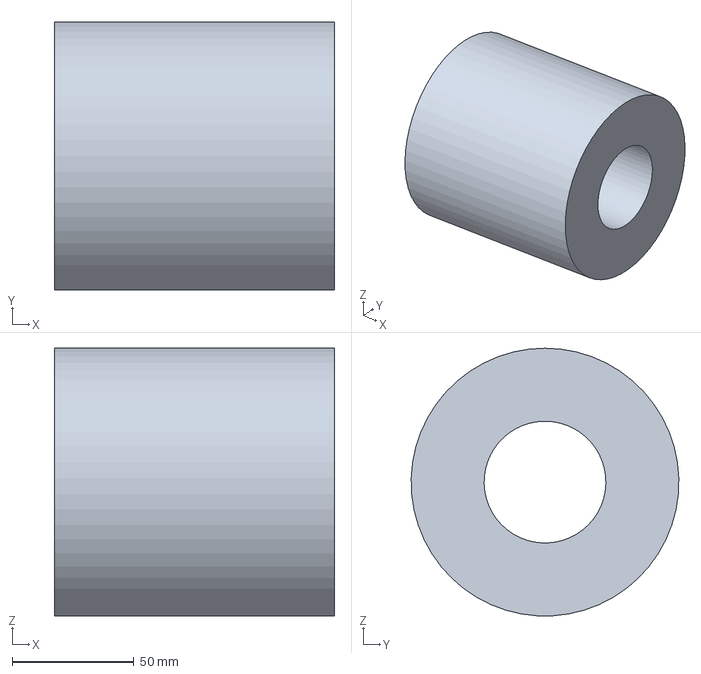
[picture p106: CAD file, 2026-10-30]
fusion/A1000_pkg/Rear_stub_shaft.step
115.0 x 110.0 x 109.9 mm
