ahmadreza221/aurora-cchp/fusion/A1000_rotor/A1000_R1_disc_with_arms__cast_MAR_M247.step

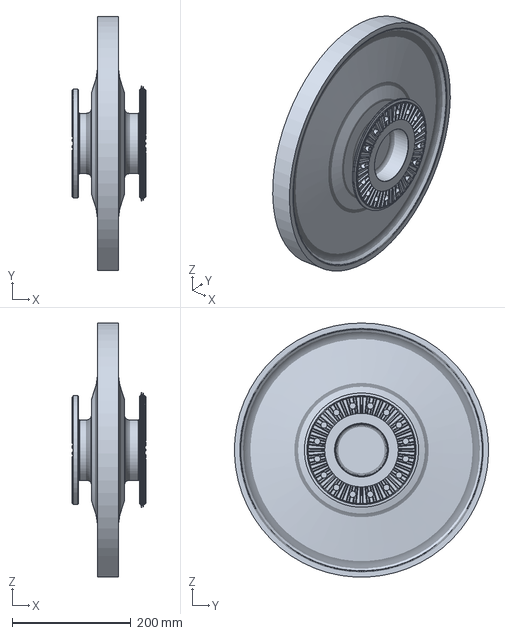
[picture p107: CAD file, 2026-11-01]
fusion/A1000_rotor/A1000_R1_disc_with_arms__cast_MAR_M247.step
124.1 x 428.3 x 428.2 mm
