ahmadreza221/aurora-cchp/fusion/A1000C/A1000_C1_blade.step

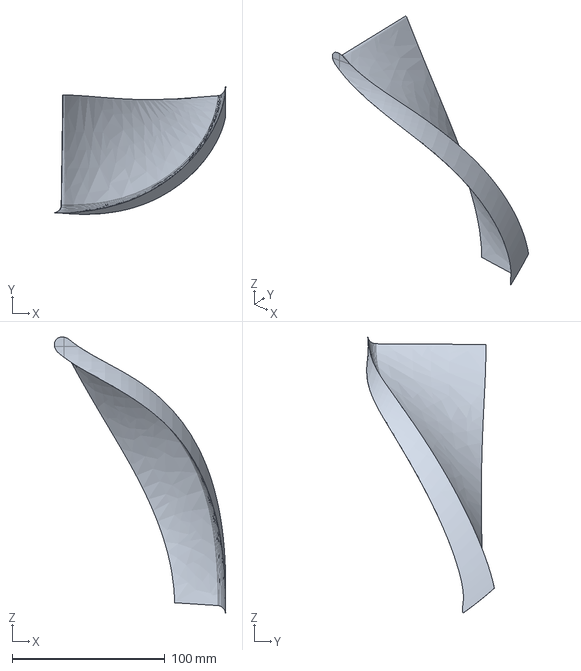
[picture p108: CAD file, 2026-10-30]
fusion/A1000C/A1000_C1_blade.step
112.1 x 83.7 x 180.7 mm
