ahmadreza221/aurora-cchp/fusion/E1/E1_disc_boreless_final.step

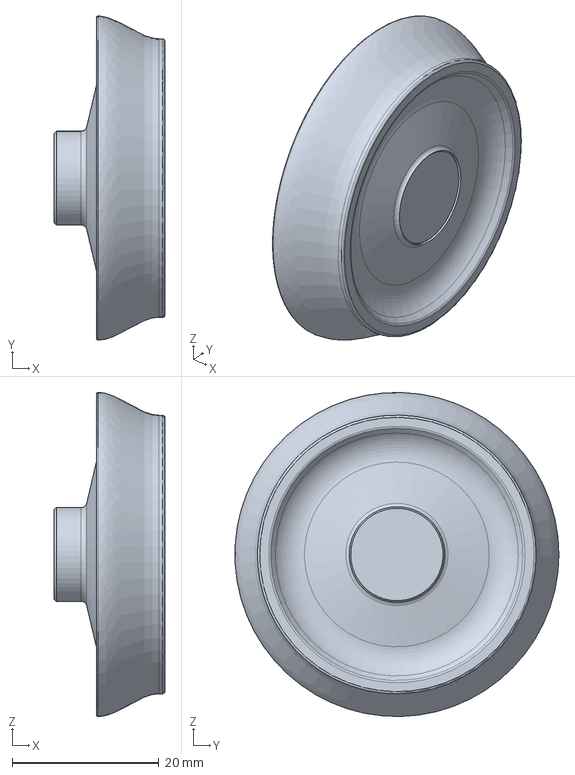
[picture p109: CAD file, 2026-10-22]
fusion/E1/E1_disc_boreless_final.step
15.1 x 44.2 x 44.2 mm
