ahmadreza221/aurora-cchp/fusion/A1000/A1000_R1_blade.step

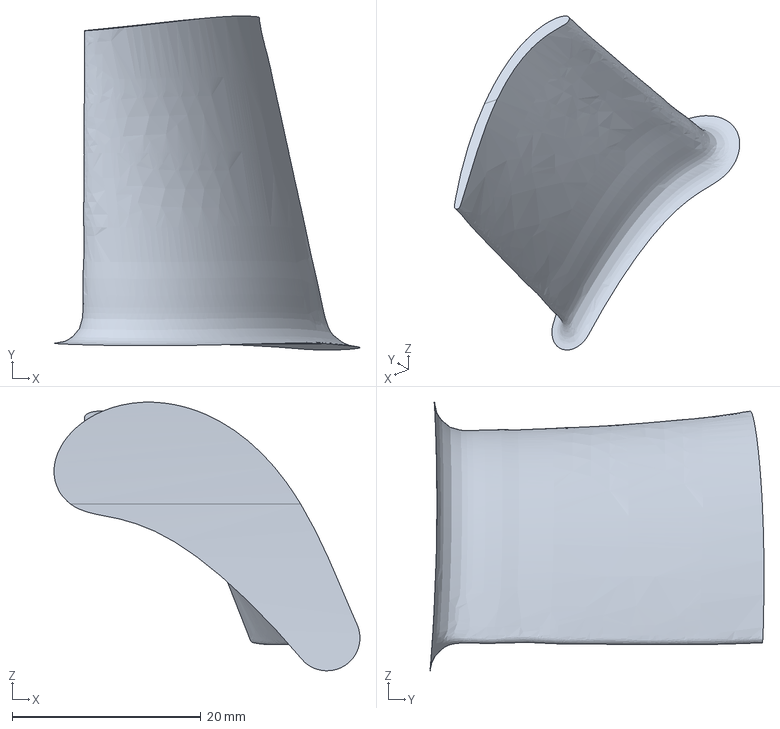
[picture p110: CAD file, 2026-10-29]
fusion/A1000/A1000_R1_blade.step
32.4 x 35.4 x 28.4 mm
