ahmadreza221/aurora-cchp/fusion/A1000_comb/CB_333_Scroll_insulation_cassettes.step

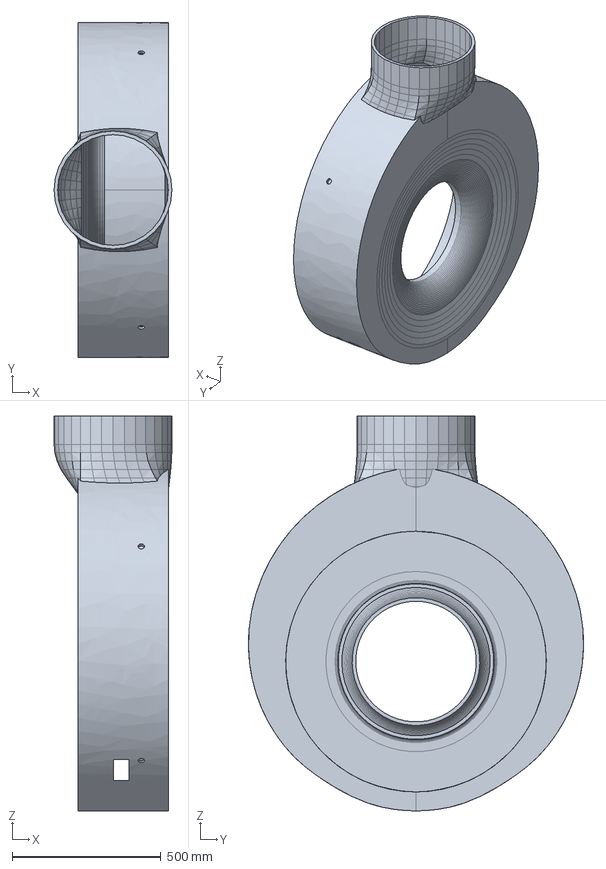
[picture p111: CAD file, 2026-10-30]
fusion/A1000_comb/CB_333_Scroll_insulation_cassettes.step
395.9 x 1125.7 x 1327.0 mm
