ahmadreza221/aurora-cchp/fusion/A1000_exh/EX_414_Rear_leaf_seal__Haynes_25.step

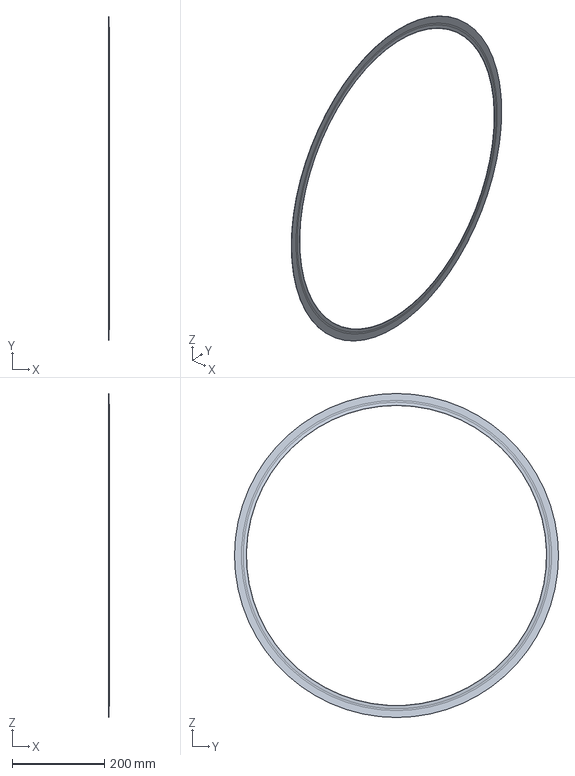
[picture p112: CAD file, 2026-10-31]
fusion/A1000_exh/EX_414_Rear_leaf_seal__Haynes_25.step
1.90 x 704.0 x 704.0 mm
