ahmadreza221/aurora-cchp/fusion/A1000_hot/HS_220_Shroud_carrier_C2__NGV2___R2__1_4828.step

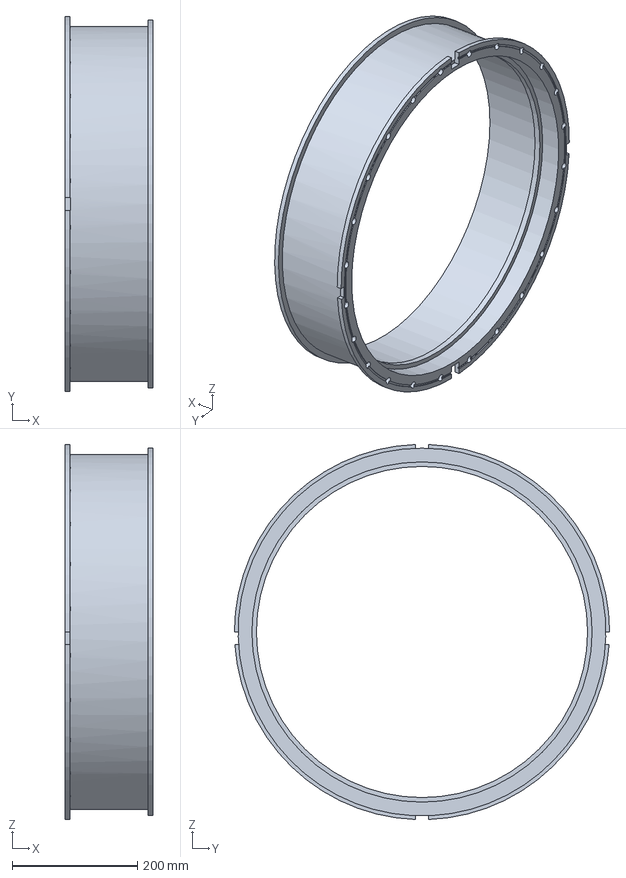
[picture p113: CAD file, 2026-10-31]
fusion/A1000_hot/HS_220_Shroud_carrier_C2__NGV2___R2__1_4828.step
141.3 x 600.0 x 599.7 mm
