ahmadreza221/aurora-cchp/fusion/A1000_pipe/PL_12_Combustor_drains_DN15___drain_pot.step

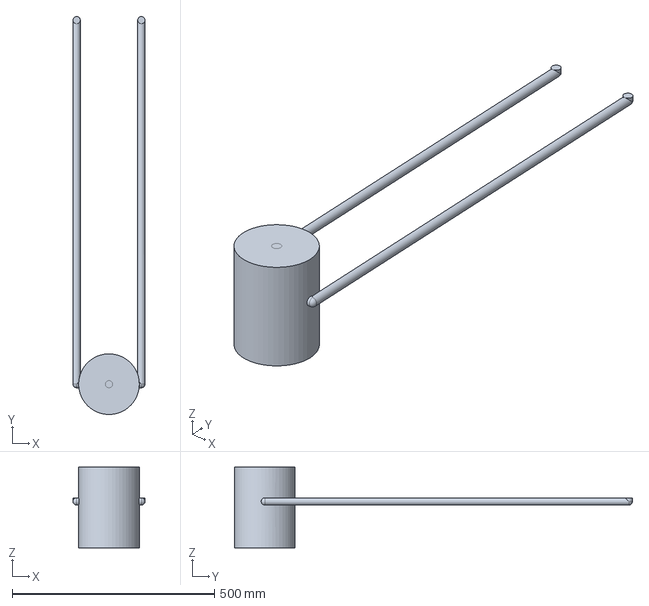
[picture p114: CAD file, 2026-10-31]
fusion/A1000_pipe/PL_12_Combustor_drains_DN15___drain_pot.step
178.0 x 984.0 x 200.0 mm
