ahmadreza221/aurora-cchp/fusion/A1000_pkg/Journal_bearing_2__tilting_pad___SFD.step

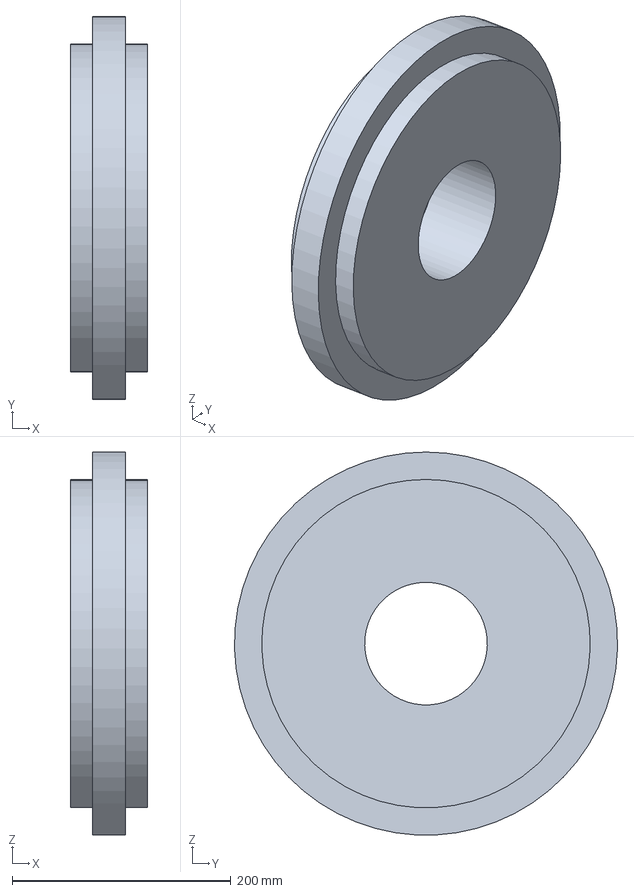
[picture p115: CAD file, 2026-10-30]
fusion/A1000_pkg/Journal_bearing_2__tilting_pad___SFD.step
70.0 x 349.9 x 349.8 mm
