ahmadreza221/aurora-cchp/fusion/A1000_rotor/RT_113_Studs___nuts_R2___rear_stub__16_x_M10.step

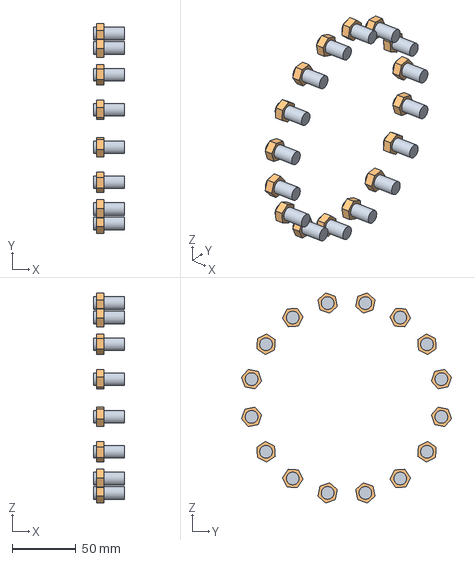
[picture p116: CAD file, 2026-11-01]
fusion/A1000_rotor/RT_113_Studs___nuts_R2___rear_stub__16_x_M10.step
24.0 x 164.9 x 164.9 mm
