ahmadreza221/aurora-cchp/fusion/A1000/A1000_N1_vane.step

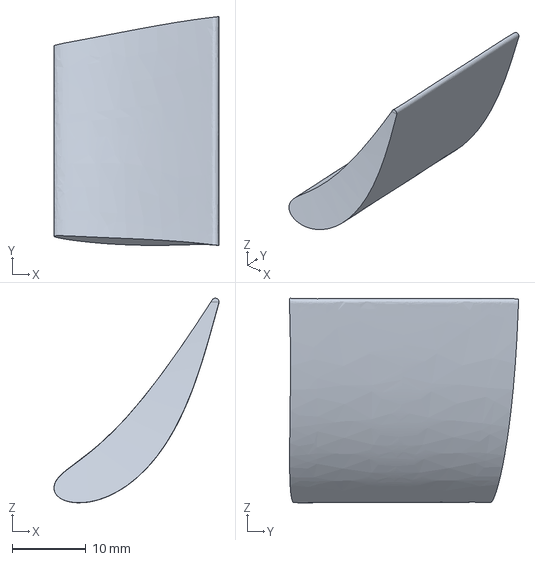
[picture p117: CAD file, 2026-10-29]
fusion/A1000/A1000_N1_vane.step
22.3 x 30.9 x 27.7 mm
