ahmadreza221/aurora-cchp/fusion/A1000_comb/CB_371_Igniter___2_UV_flame_scanners.step

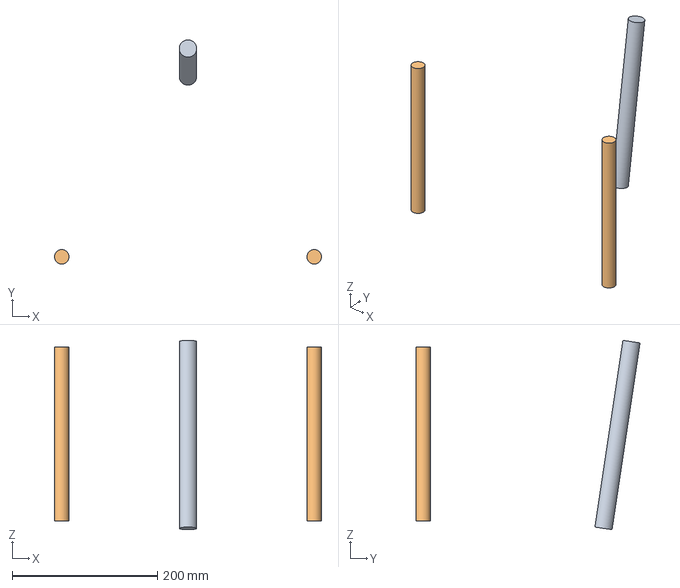
[picture p118: CAD file, 2026-10-30]
fusion/A1000_comb/CB_371_Igniter___2_UV_flame_scanners.step
367.7 x 308.7 x 260.7 mm
