ahmadreza221/aurora-cchp/fusion/A1000_exh/EX_402_Frame_pins_x7__A286.step

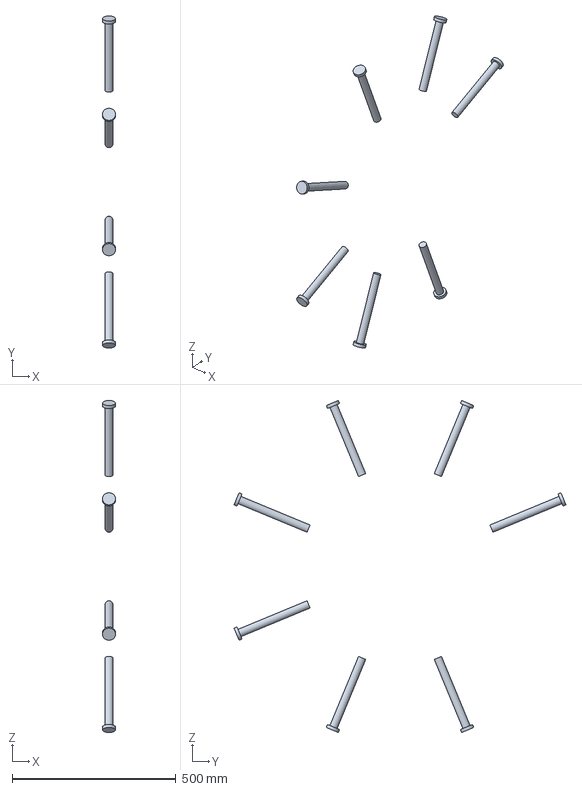
[picture p119: CAD file, 2026-10-31]
fusion/A1000_exh/EX_402_Frame_pins_x7__A286.step
40.0 x 1013.1 x 1013.1 mm
