ahmadreza221/aurora-cchp/fusion/A1000_hot/HS_240_Support_keys_x2_at_the_split__1_4980.step

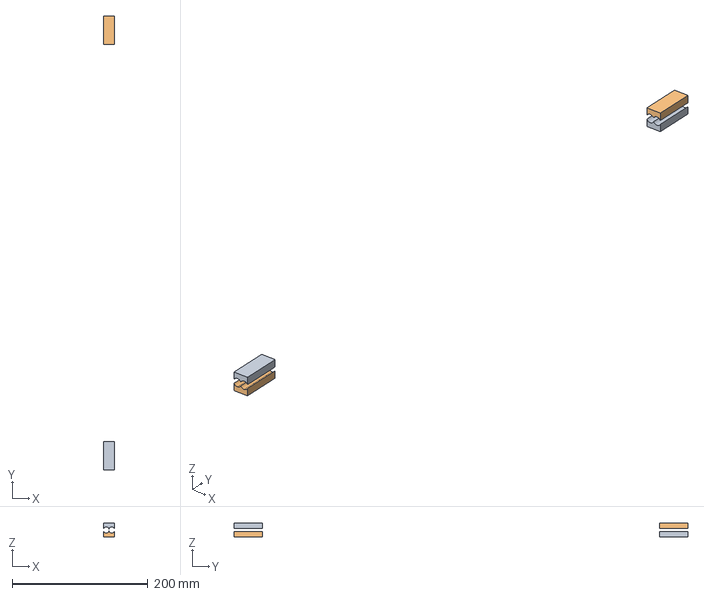
[picture p120: CAD file, 2026-10-31]
fusion/A1000_hot/HS_240_Support_keys_x2_at_the_split__1_4980.step
16.0 x 668.0 x 20.0 mm
