ahmadreza221/aurora-cchp/fusion/A1000_pipe/PL_90_Pipe_supports__posts_to_the_base_frame.step

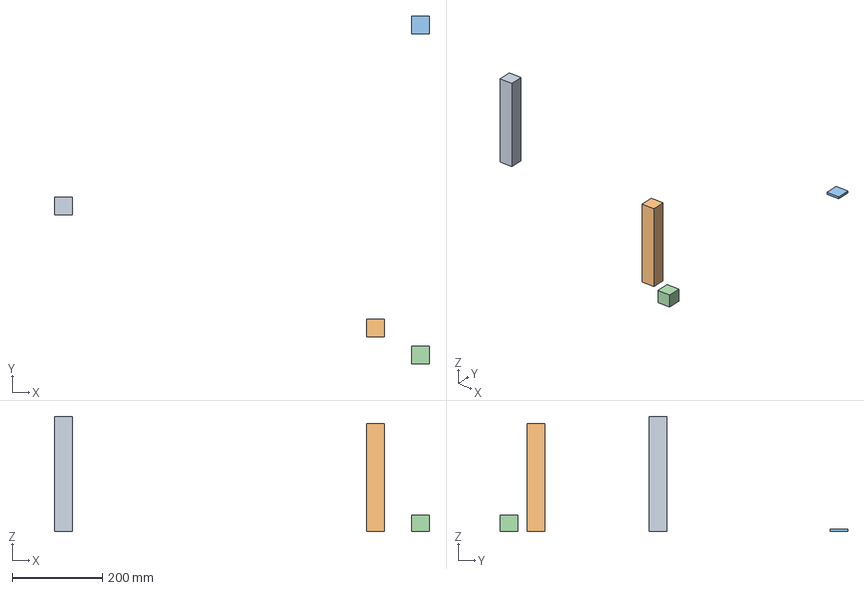
[picture p121: CAD file, 2026-10-31]
fusion/A1000_pipe/PL_90_Pipe_supports__posts_to_the_base_frame.step
830.0 x 770.0 x 255.5 mm
