ahmadreza221/aurora-cchp/fusion/A1000_pkg/Exhaust_diffuser___5_struts.step

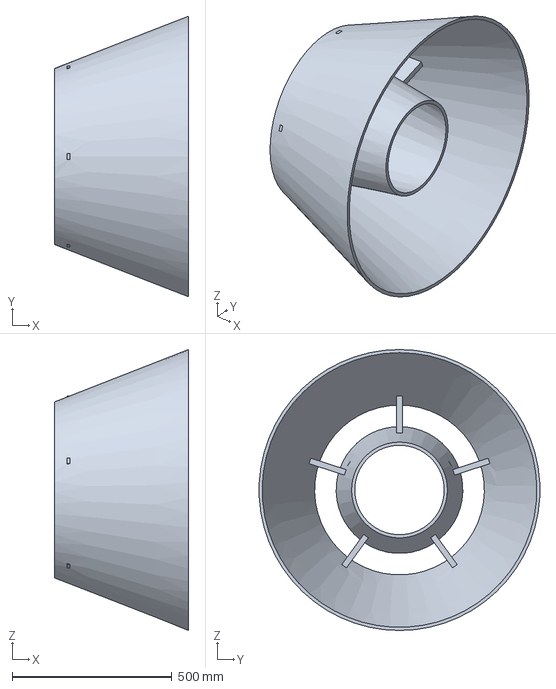
[picture p122: CAD file, 2026-10-30]
fusion/A1000_pkg/Exhaust_diffuser___5_struts.step
420.0 x 878.7 x 880.0 mm
