ahmadreza221/aurora-cchp/fusion/A1000_rotor/JB2_integral_hairpin_spring_damper_ring__ISFD__4_springs___4_pads__split____transfer_tubes.step

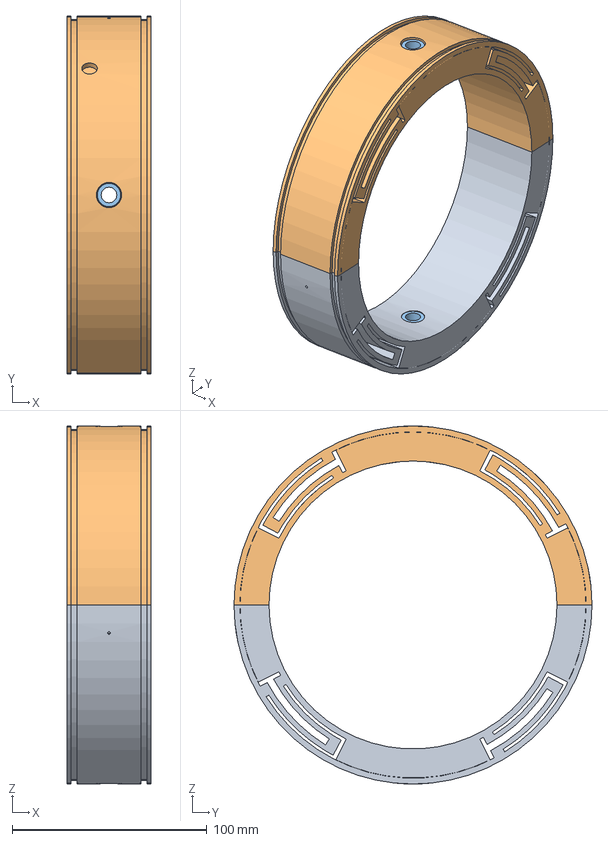
[picture p123: CAD file, 2026-10-31]
fusion/A1000_rotor/JB2_integral_hairpin_spring_damper_ring__ISFD__4_springs___4_pads__split____transfer_tubes.step
43.0 x 184.0 x 184.0 mm
