ahmadreza221/aurora-cchp/fusion/A1000_comb/CB_331_Hot_gas_casing_lower_half__Haynes_230.step

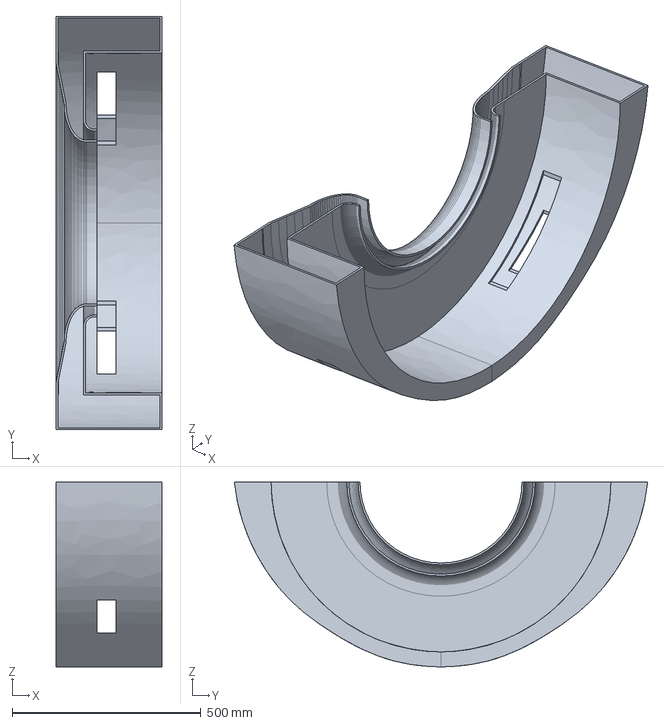
[picture p124: CAD file, 2026-10-30]
fusion/A1000_comb/CB_331_Hot_gas_casing_lower_half__Haynes_230.step
281.0 x 1095.2 x 490.0 mm
