ahmadreza221/aurora-cchp/fusion/A1000_exh/EX_410_Exhaust_frame__4_struts__1_4848_cast.step

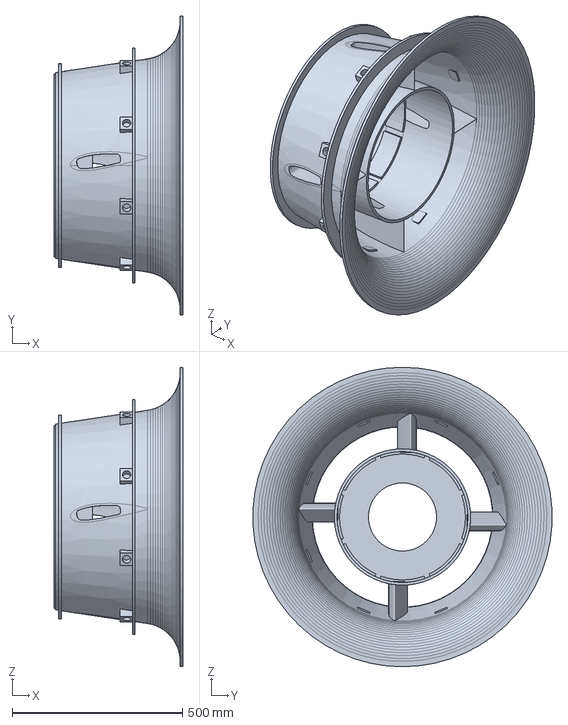
[picture p125: CAD file, 2026-10-31]
fusion/A1000_exh/EX_410_Exhaust_frame__4_struts__1_4848_cast.step
378.0 x 878.7 x 880.0 mm
