ahmadreza221/aurora-cchp/fusion/A1000_hot/HS_210_Shroud_carrier_C1__NGV1___R1__1_4828.step

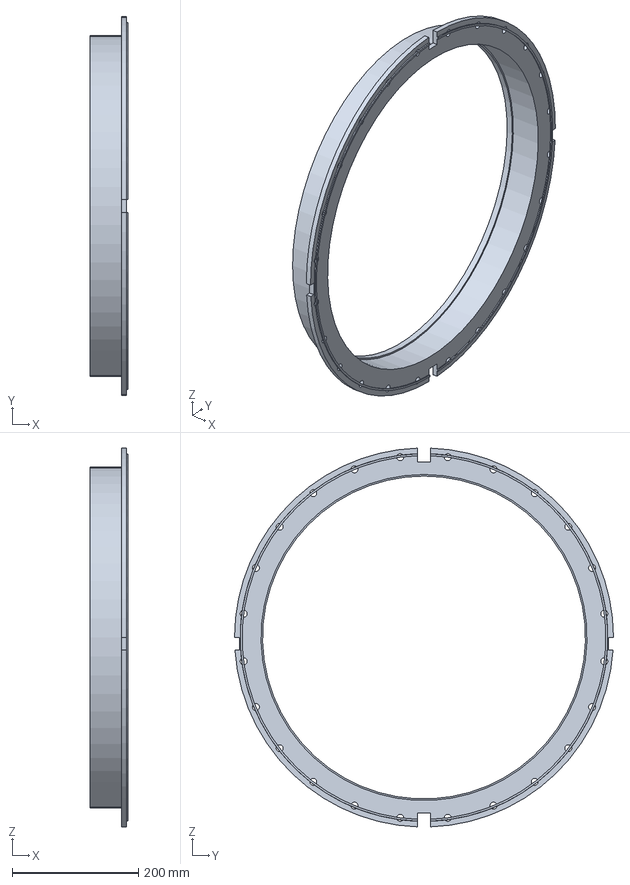
[picture p126: CAD file, 2026-10-31]
fusion/A1000_hot/HS_210_Shroud_carrier_C1__NGV1___R1__1_4828.step
59.7 x 600.0 x 599.7 mm
