ahmadreza221/aurora-cchp/fusion/A1000_pipe/PL_04_Oil_to_JB2__tube_18_x_1_5__hose_at_the_top_strut.step

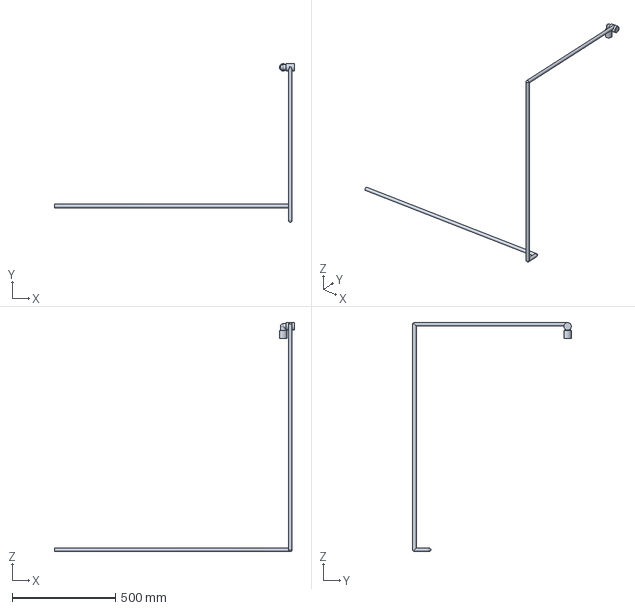
[picture p127: CAD file, 2026-10-31]
fusion/A1000_pipe/PL_04_Oil_to_JB2__tube_18_x_1_5__hose_at_the_top_strut.step
1160.0 x 767.0 x 1108.0 mm
