ahmadreza221/aurora-cchp/fusion/A1000_pkg/Compressor_casing.step

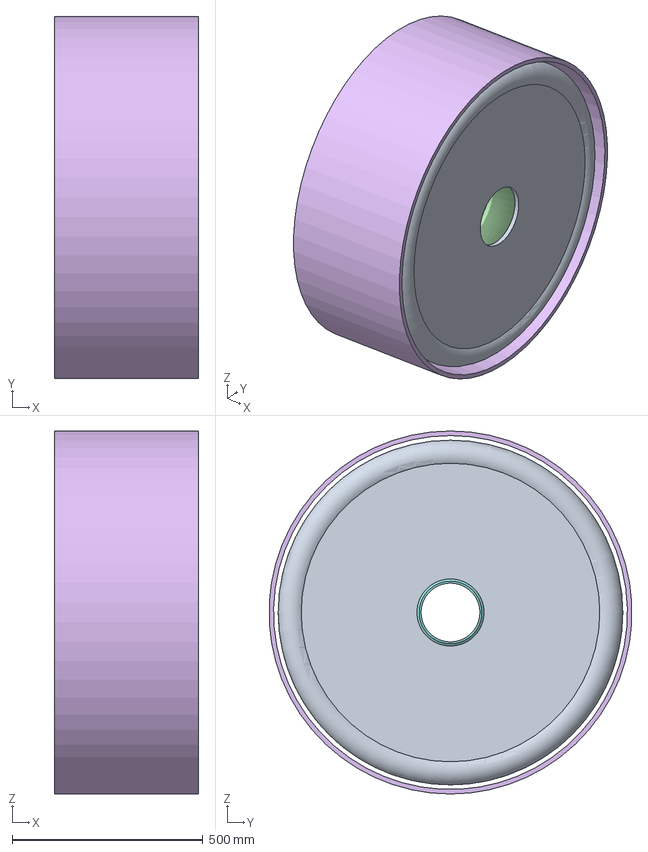
[picture p128: CAD file, 2026-10-30]
fusion/A1000_pkg/Compressor_casing.step
378.3 x 950.4 x 951.8 mm
