ahmadreza221/aurora-cchp/fusion/E1/E1_shaft_welded.step

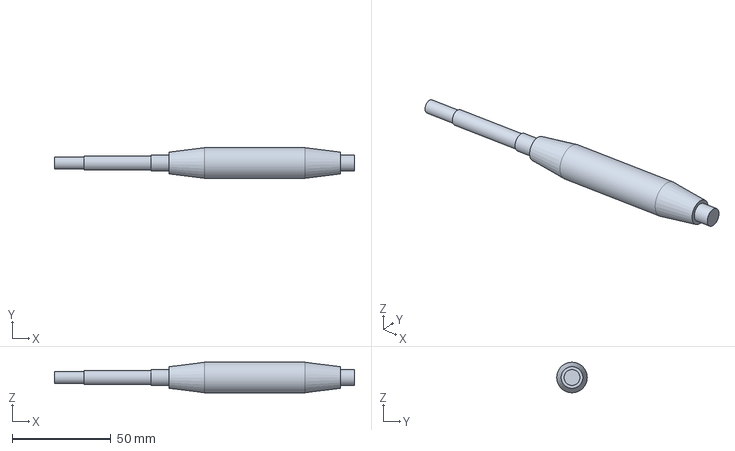
[picture p129: CAD file, 2026-10-22]
fusion/E1/E1_shaft_welded.step
152.0 x 15.5 x 15.5 mm
