ahmadreza221/aurora-cchp/fusion/A1000_comb/CB_332_Deswirl_vanes_x22__Haynes_230.step

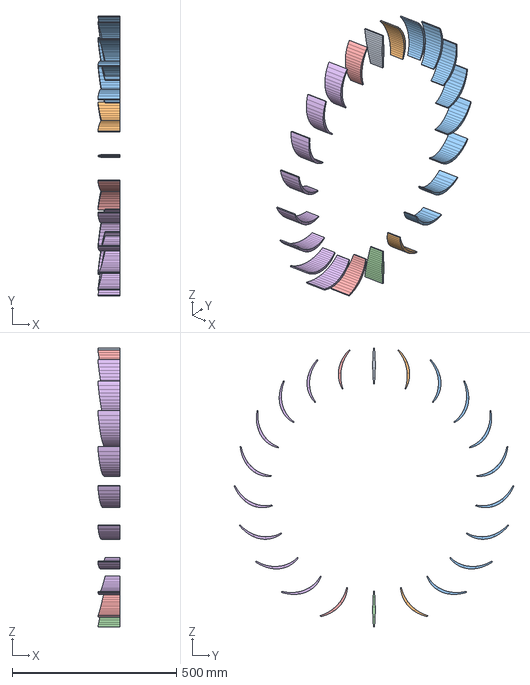
[picture p130: CAD file, 2026-10-30]
fusion/A1000_comb/CB_332_Deswirl_vanes_x22__Haynes_230.step
68.0 x 852.9 x 850.0 mm
