ahmadreza221/aurora-cchp/fusion/A1000_exh/EX_470_Economizer___stack_DN800__bought_in.step

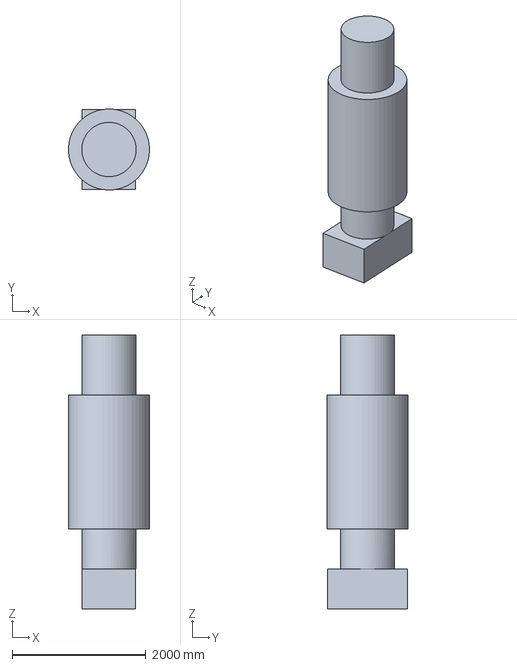
[picture p131: CAD file, 2026-10-31]
fusion/A1000_exh/EX_470_Economizer___stack_DN800__bought_in.step
1211.8 x 1212.4 x 4100.0 mm
