ahmadreza221/aurora-cchp/fusion/A1000_hot/HS_221_Shroud_backing_R2.step

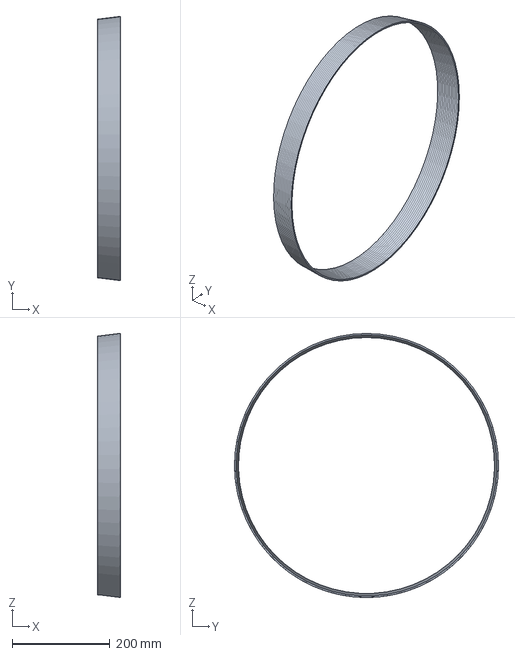
[picture p132: CAD file, 2026-10-30]
fusion/A1000_hot/HS_221_Shroud_backing_R2.step
48.0 x 541.2 x 541.2 mm
