ahmadreza221/aurora-cchp/fusion/A1000_pipe/PL_10_Fuel_hoses_P___A___B1___B2___gas_valve_block__bought_in.step

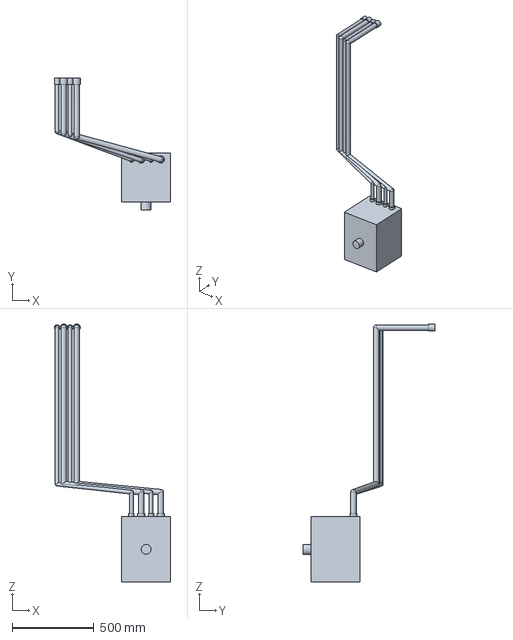
[picture p133: CAD file, 2026-10-31]
fusion/A1000_pipe/PL_10_Fuel_hoses_P___A___B1___B2___gas_valve_block__bought_in.step
712.0 x 810.0 x 1580.0 mm
