ahmadreza221/aurora-cchp/fusion/A1000_pkg/Air_inlet_plenum___bellmouth.step

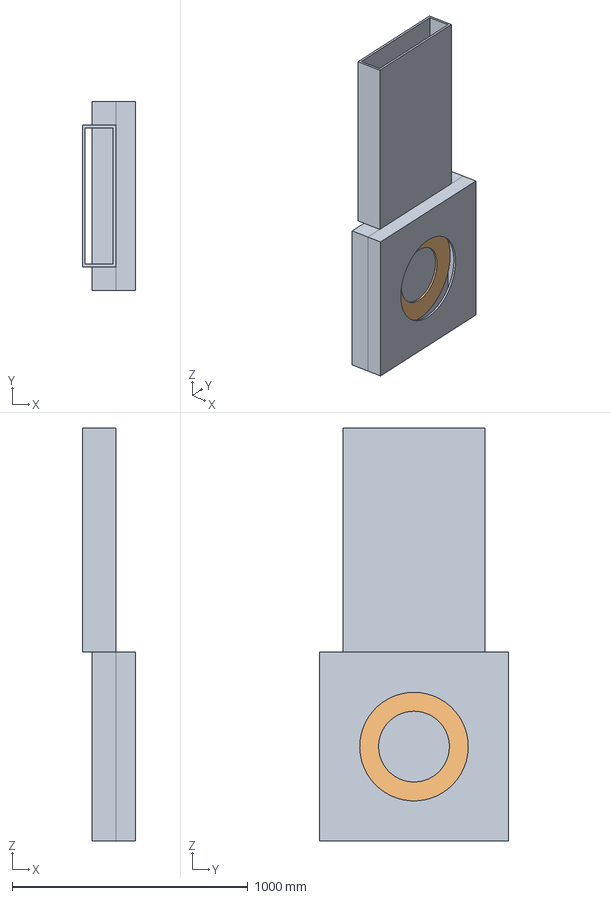
[picture p134: CAD file, 2026-10-30]
fusion/A1000_pkg/Air_inlet_plenum___bellmouth.step
226.0 x 800.0 x 1750.0 mm
