ahmadreza221/aurora-cchp/fusion/A1000_rotor/RT_101_Front_stub_shaft___thrust_collar.step

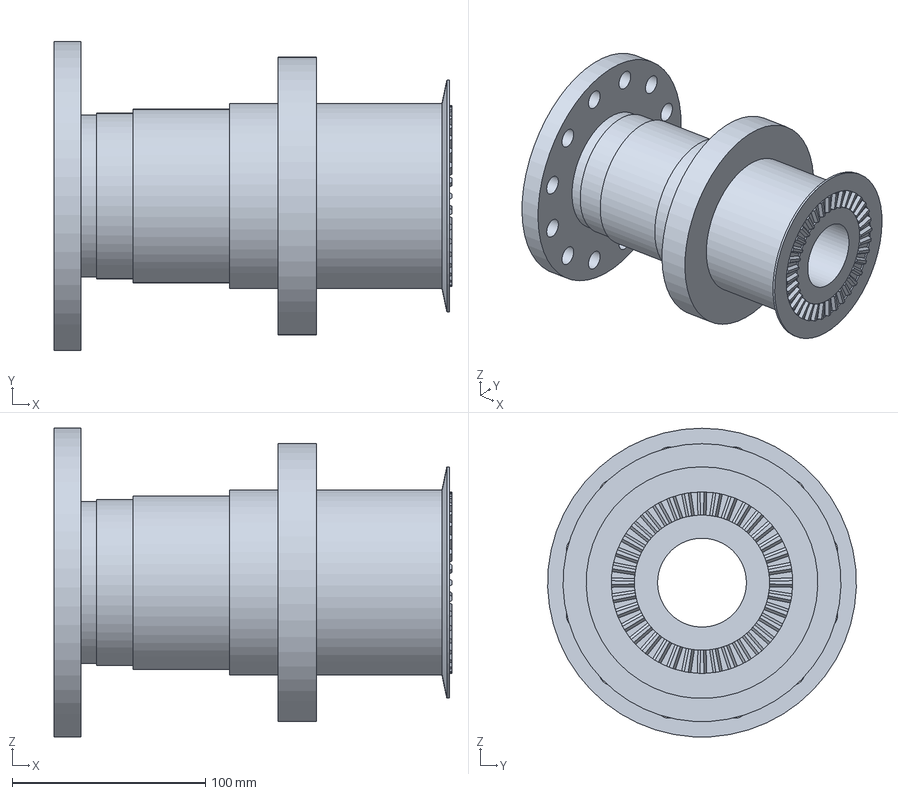
[picture p135: CAD file, 2026-10-31]
fusion/A1000_rotor/RT_101_Front_stub_shaft___thrust_collar.step
206.2 x 159.9 x 159.8 mm
