ahmadreza221/aurora-cchp/fusion/A1000_comb/CB_302_Can_base_plate__1_4948.step

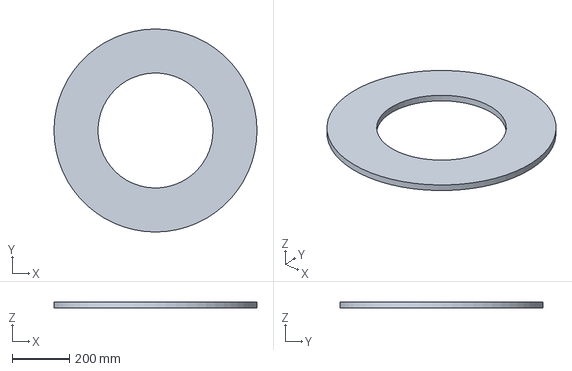
[picture p136: CAD file, 2026-10-30]
fusion/A1000_comb/CB_302_Can_base_plate__1_4948.step
710.0 x 710.0 x 20.0 mm
