ahmadreza221/aurora-cchp/fusion/A1000_exh/EX_430_Exhaust_transition___fabric_joint.step

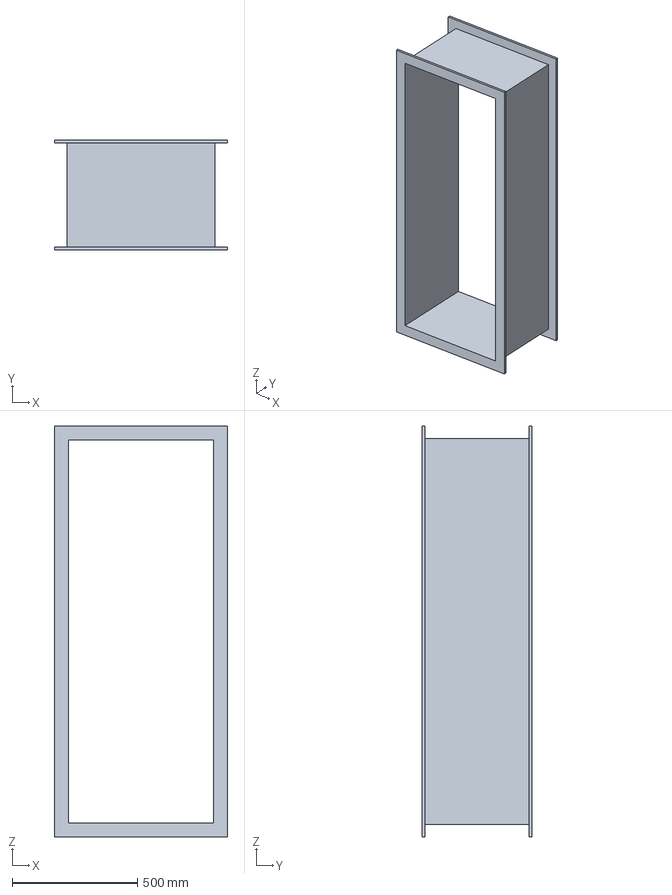
[picture p137: CAD file, 2026-10-31]
fusion/A1000_exh/EX_430_Exhaust_transition___fabric_joint.step
692.0 x 438.0 x 1642.0 mm
