ahmadreza221/aurora-cchp/fusion/A1000_pipe/PL_06_JB2_drain_DN50__hose_at_the_bottom_strut__11___fall.step

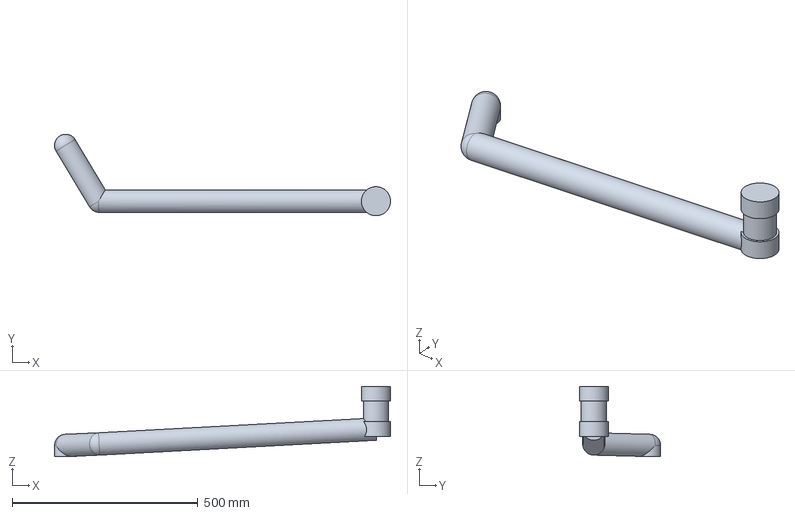
[picture p138: CAD file, 2026-10-31]
fusion/A1000_pipe/PL_06_JB2_drain_DN50__hose_at_the_bottom_strut__11___fall.step
904.3 x 219.3 x 189.1 mm
