ahmadreza221/aurora-cchp/fusion/A1000_pkg/Return_channel_vane_x17.step

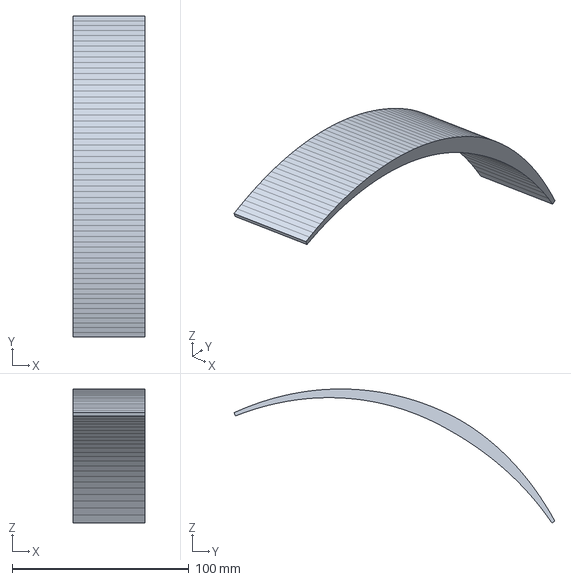
[picture p139: CAD file, 2026-10-30]
fusion/A1000_pkg/Return_channel_vane_x17.step
41.0 x 181.5 x 75.8 mm
