ahmadreza221/aurora-cchp/fusion/A1000_rotor/FB_2_Front_bearing_housing__lower_half__JB1___thrust__EN_GJS_400_18.step

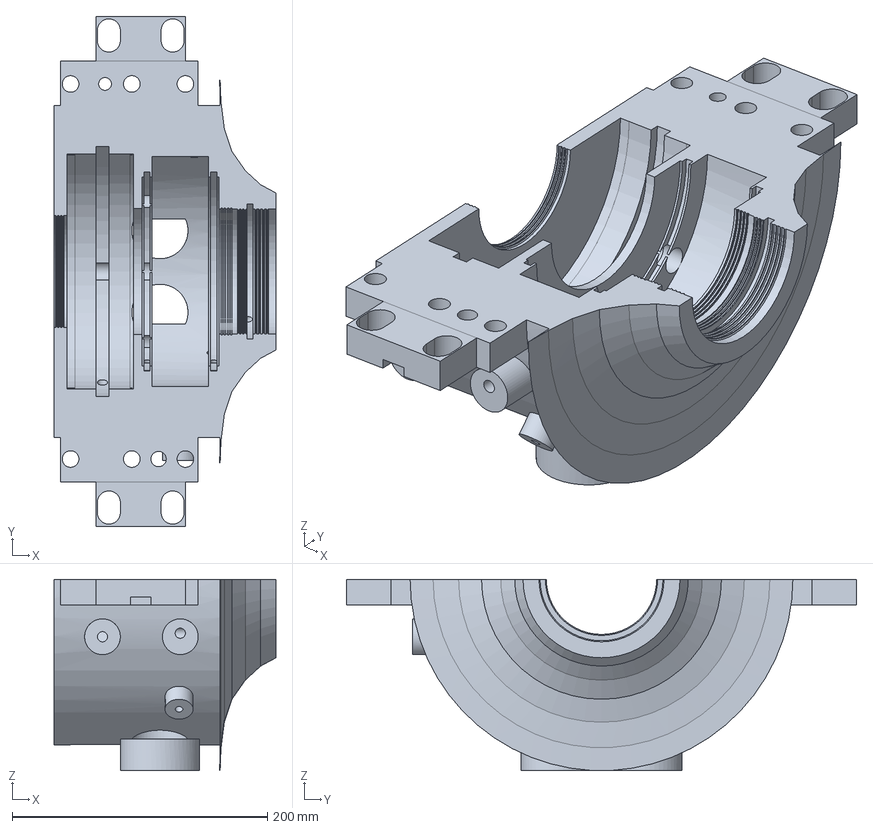
[picture p140: CAD file, 2026-10-31]
fusion/A1000_rotor/FB_2_Front_bearing_housing__lower_half__JB1___thrust__EN_GJS_400_18.step
174.0 x 400.0 x 150.0 mm
