ahmadreza221/aurora-cchp/fusion/A1000_comb/CB_350_NGV1_interface_leaf_seals.step

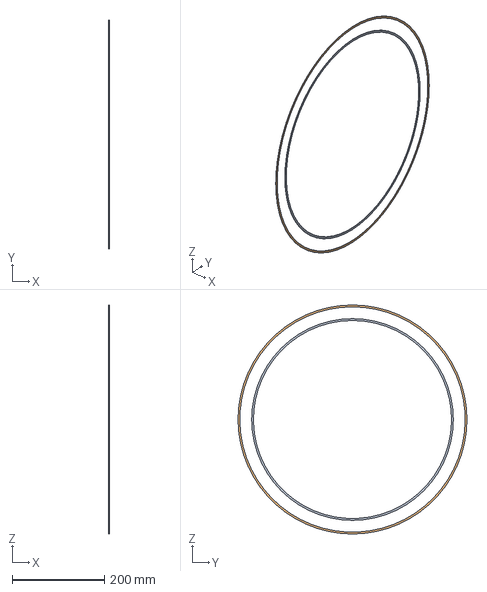
[picture p141: CAD file, 2026-10-30]
fusion/A1000_comb/CB_350_NGV1_interface_leaf_seals.step
0.8 x 497.0 x 497.0 mm
