ahmadreza221/aurora-cchp/fusion/A1000_exh/EX_413_Front_leaf_seal__Haynes_25.step

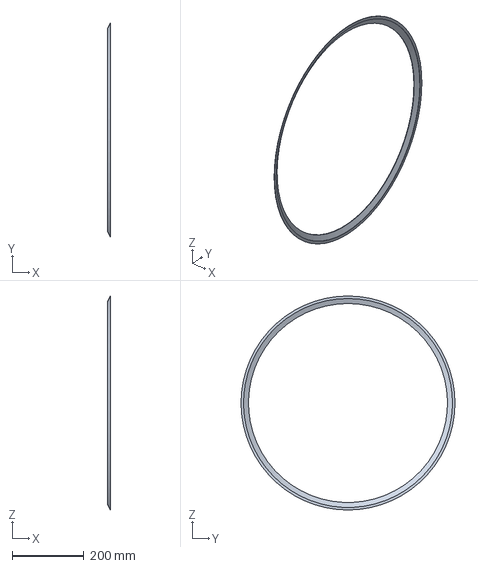
[picture p142: CAD file, 2026-10-31]
fusion/A1000_exh/EX_413_Front_leaf_seal__Haynes_25.step
9.00 x 598.0 x 598.0 mm
