ahmadreza221/aurora-cchp/fusion/A1000_hot/HS_222_Gap_liner_R1___NGV2__outer__Hastelloy_X.step

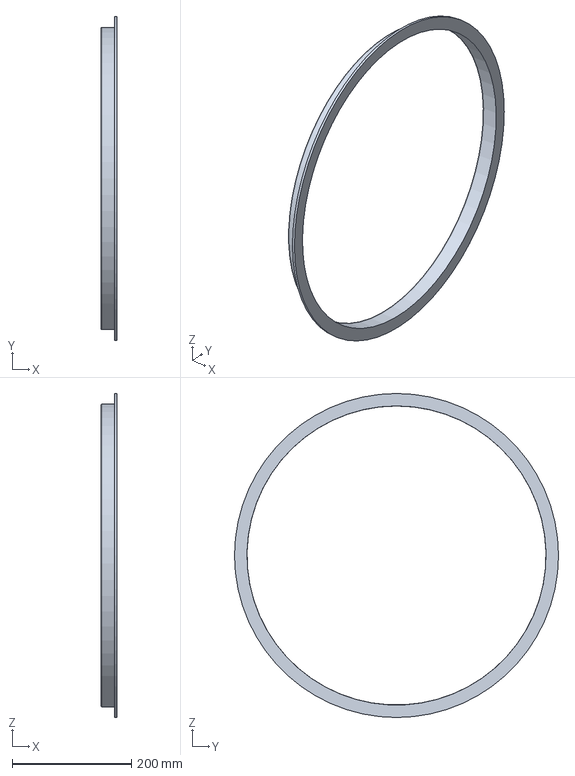
[picture p143: CAD file, 2026-10-30]
fusion/A1000_hot/HS_222_Gap_liner_R1___NGV2__outer__Hastelloy_X.step
26.0 x 543.4 x 543.4 mm
