ahmadreza221/aurora-cchp/fusion/A1000_pipe/PL_13_Gearbox_oil_feed__tube_35_x_2.step

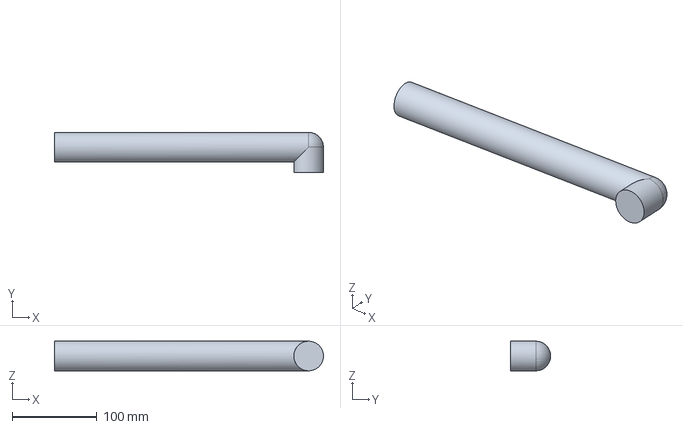
[picture p144: CAD file, 2026-10-31]
fusion/A1000_pipe/PL_13_Gearbox_oil_feed__tube_35_x_2.step
317.5 x 47.5 x 35.0 mm
