ahmadreza221/aurora-cchp/fusion/A1000_pkg/Diffuser_1_vane_x19.step

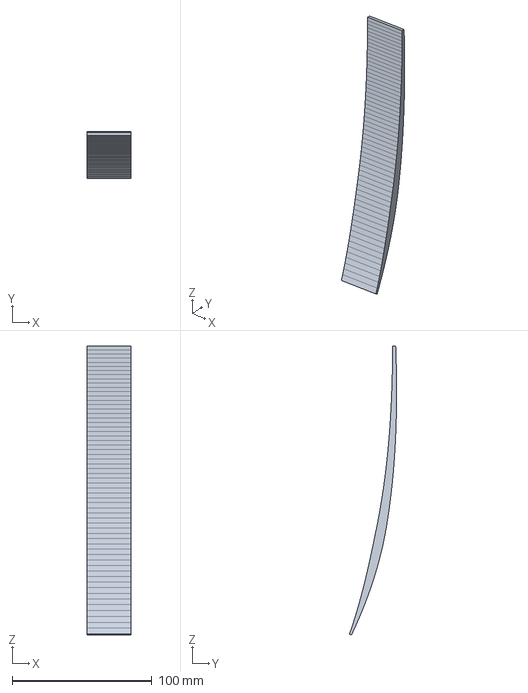
[picture p145: CAD file, 2026-10-30]
fusion/A1000_pkg/Diffuser_1_vane_x19.step
31.8 x 33.8 x 207.0 mm
