ahmadreza221/aurora-cchp/fusion/A1000_rotor/FB_1_Front_bearing_housing__upper_half__JB1___thrust__EN_GJS_400_18.step

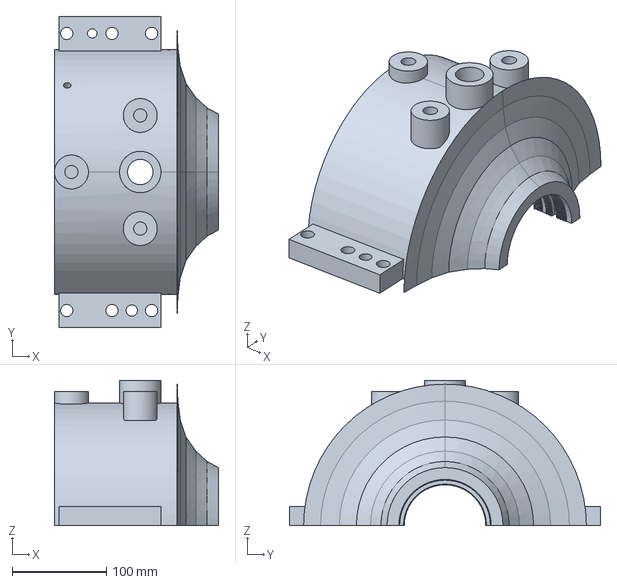
[picture p146: CAD file, 2026-10-31]
fusion/A1000_rotor/FB_1_Front_bearing_housing__upper_half__JB1___thrust__EN_GJS_400_18.step
174.0 x 330.0 x 154.0 mm
