ahmadreza221/aurora-cchp/fusion/A1000_comb/CB_321_Impingement_sleeve__Hastelloy_X.step

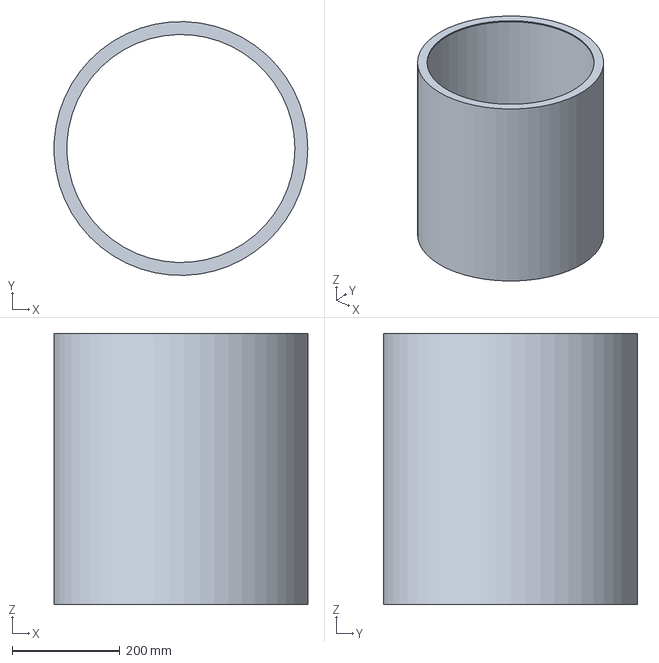
[picture p147: CAD file, 2026-10-30]
fusion/A1000_comb/CB_321_Impingement_sleeve__Hastelloy_X.step
470.8 x 471.0 x 503.0 mm
