ahmadreza221/aurora-cchp/fusion/A1000_exh/EX_441_BOV_DN125___dump_line_DN200.step

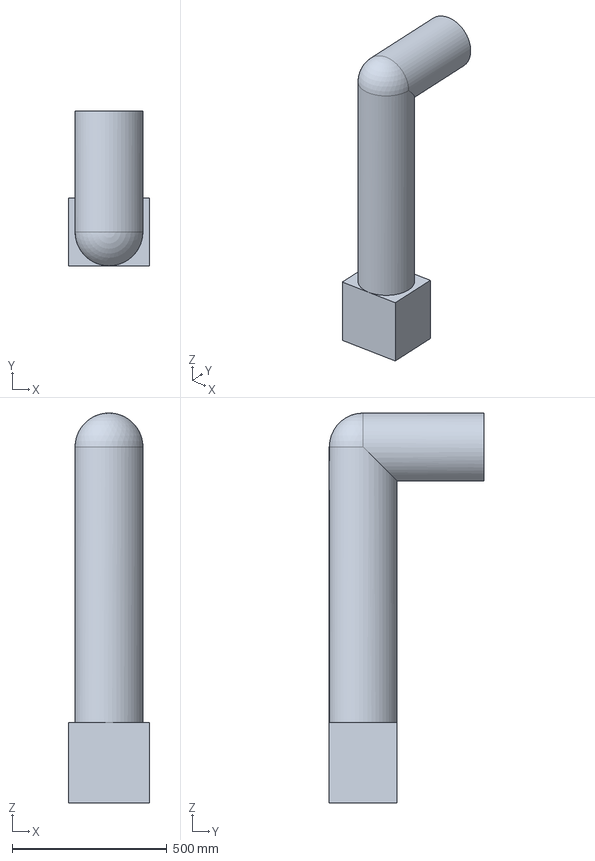
[picture p148: CAD file, 2026-10-31]
fusion/A1000_exh/EX_441_BOV_DN125___dump_line_DN200.step
260.0 x 500.0 x 1259.5 mm
