ahmadreza221/aurora-cchp/fusion/A1000_hot/HS_234_Gap_ring_R1___NGV2__inner__Hastelloy_X.step

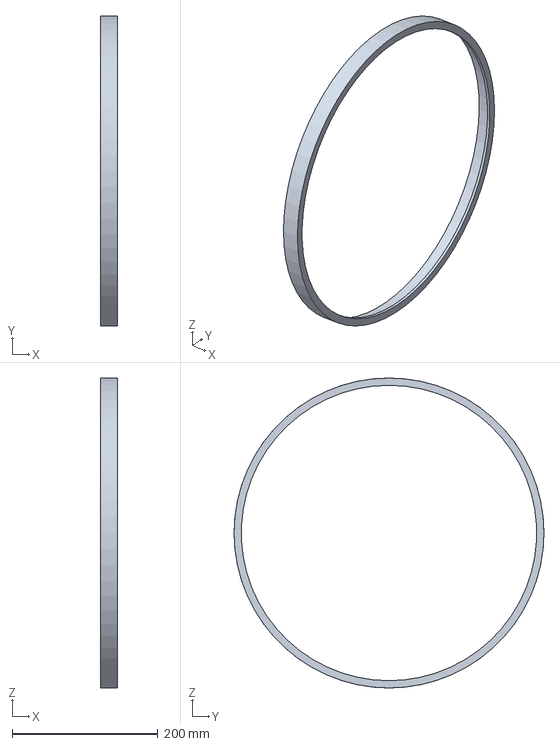
[picture p149: CAD file, 2026-10-30]
fusion/A1000_hot/HS_234_Gap_ring_R1___NGV2__inner__Hastelloy_X.step
23.5 x 425.3 x 425.3 mm
