ahmadreza221/aurora-cchp/fusion/A1000_pipe/PL_08_JB2_vent_DN32__hose_at_the__y_strut__falls_to_the_reservoir.step

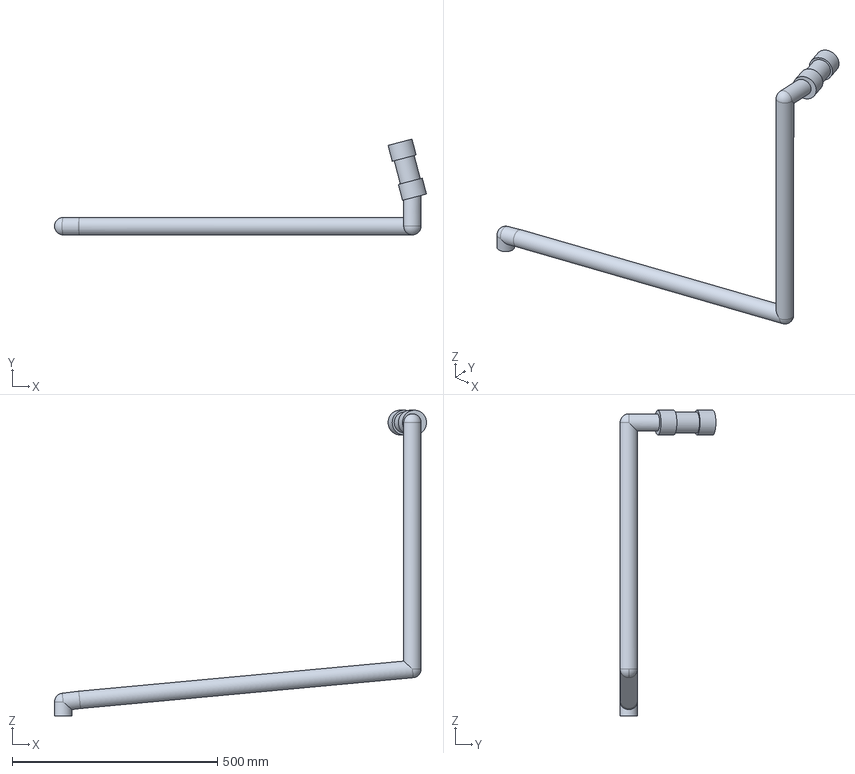
[picture p150: CAD file, 2026-10-31]
fusion/A1000_pipe/PL_08_JB2_vent_DN32__hose_at_the__y_strut__falls_to_the_reservoir.step
905.5 x 233.2 x 744.2 mm
