ahmadreza221/aurora-cchp/fusion/A1000_pkg/Diffuser_2_vane_x19.step

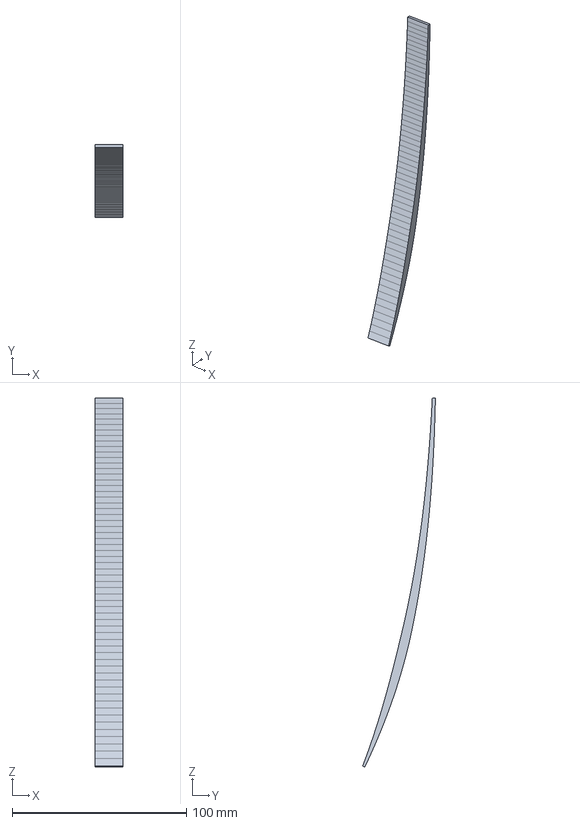
[picture p151: CAD file, 2026-10-30]
fusion/A1000_pkg/Diffuser_2_vane_x19.step
16.2 x 41.8 x 212.0 mm
