ahmadreza221/aurora-cchp/fusion/A1000_rotor/JB2_pad_carrier___end_plates__split.step

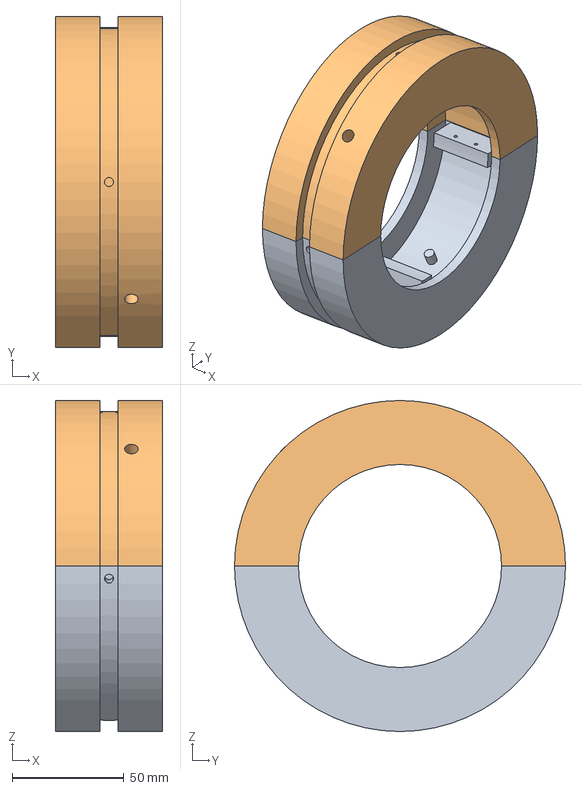
[picture p152: CAD file, 2026-10-31]
fusion/A1000_rotor/JB2_pad_carrier___end_plates__split.step
48.0 x 148.0 x 148.0 mm
