ahmadreza221/aurora-cchp/fusion/A1000_exh/EX_440_Cold_air_pipe_DN350___BOV_tee__P265GH.step

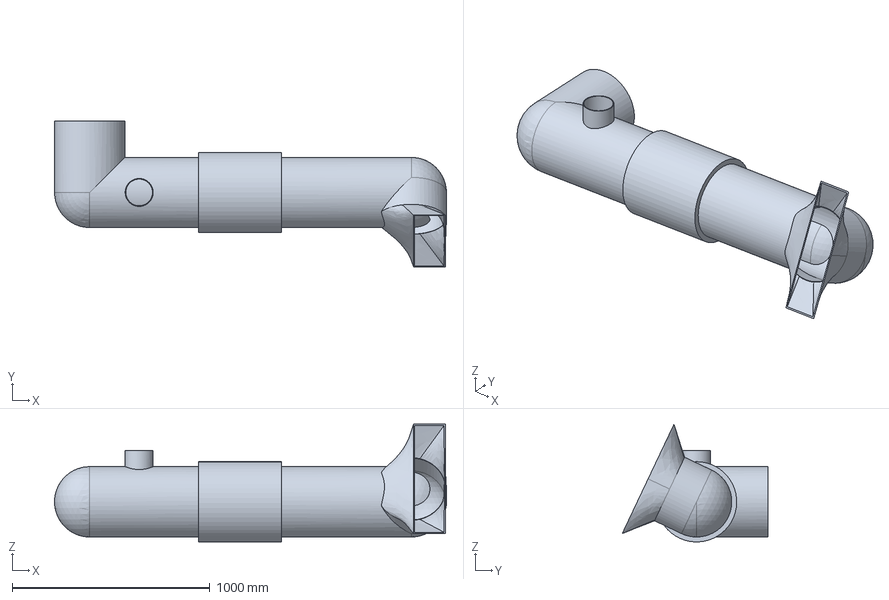
[picture p153: CAD file, 2026-10-31]
fusion/A1000_exh/EX_440_Cold_air_pipe_DN350___BOV_tee__P265GH.step
1980.6 x 735.9 x 594.9 mm
