ahmadreza221/aurora-cchp/fusion/A1000_hot/HS_211_Shroud_backing_R1.step

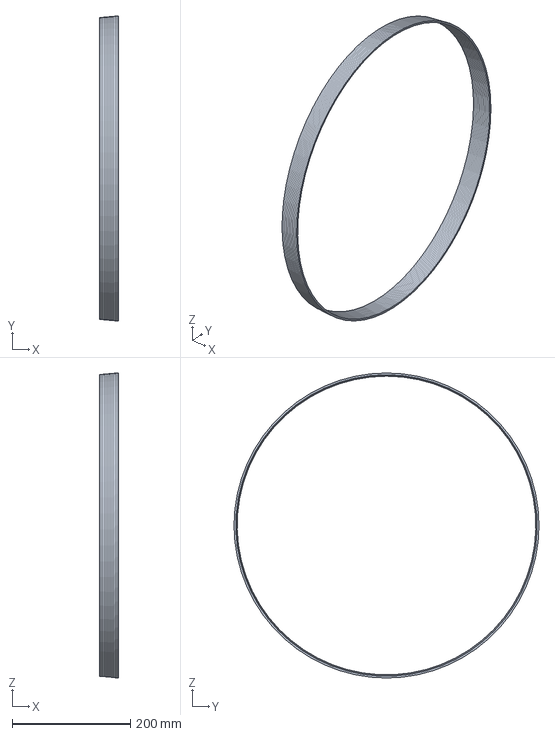
[picture p154: CAD file, 2026-10-30]
fusion/A1000_hot/HS_211_Shroud_backing_R1.step
32.0 x 515.7 x 515.7 mm
