ahmadreza221/aurora-cchp/fusion/A1000_pipe/LO_100_Oil_reservoir_in_the_base_frame__338_l.step

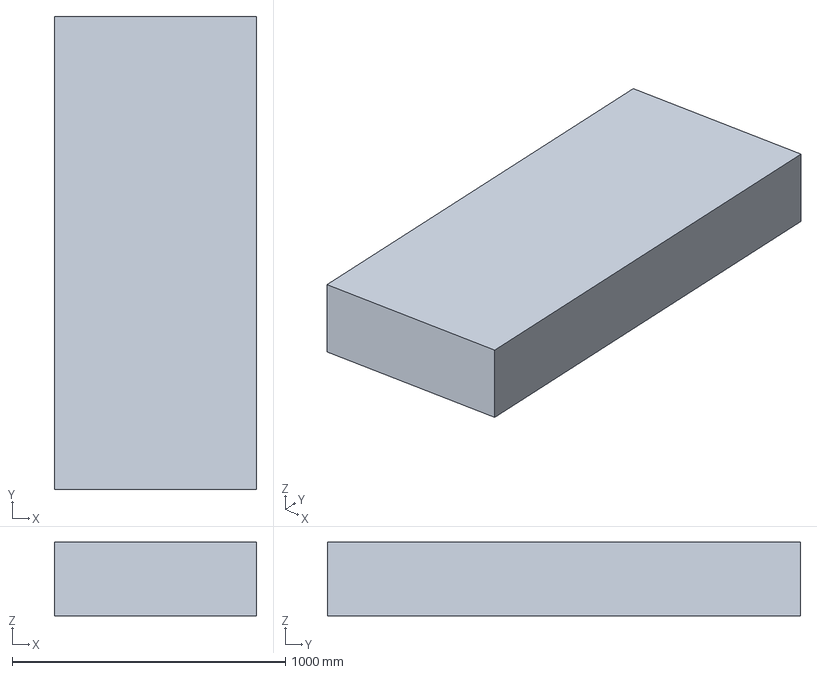
[picture p155: CAD file, 2026-10-31]
fusion/A1000_pipe/LO_100_Oil_reservoir_in_the_base_frame__338_l.step
740.0 x 1730.0 x 270.0 mm
