ahmadreza221/aurora-cchp/fusion/A1000_pkg/Coupling_shaft.step

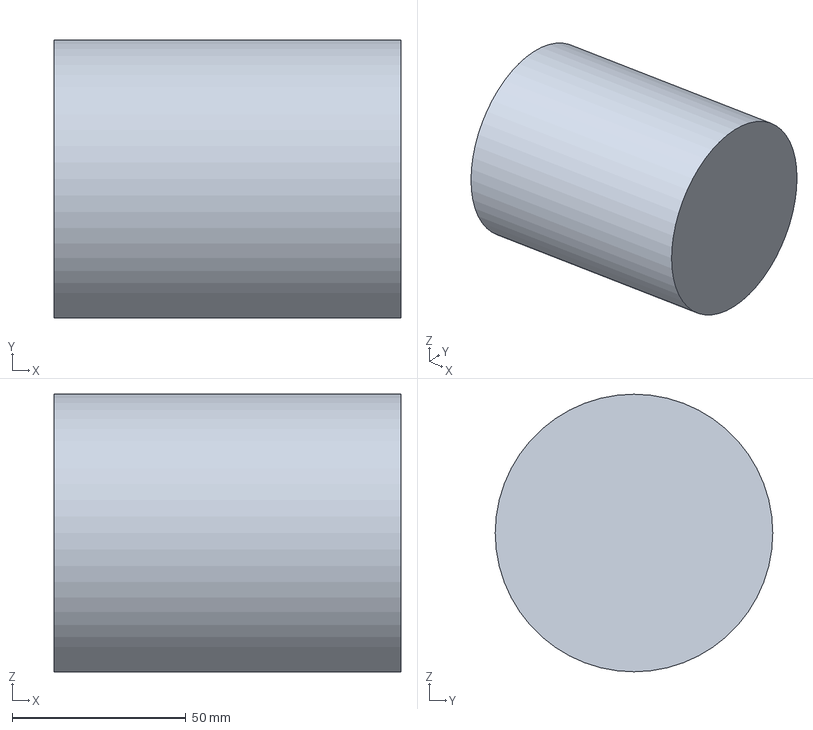
[picture p156: CAD file, 2026-10-30]
fusion/A1000_pkg/Coupling_shaft.step
100.0 x 80.0 x 80.0 mm
