ahmadreza221/aurora-cchp/fusion/A1000_rotor/JB2_front_seal_ring__split__labyrinth___buffer___windback.step

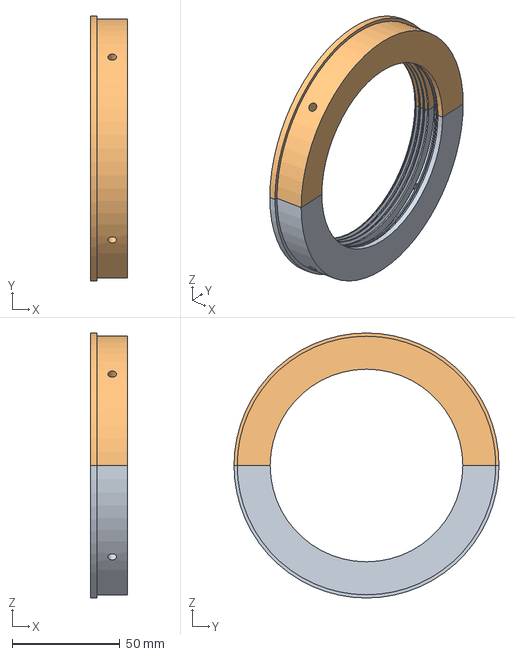
[picture p157: CAD file, 2026-10-31]
fusion/A1000_rotor/JB2_front_seal_ring__split__labyrinth___buffer___windback.step
17.0 x 123.0 x 123.0 mm
