ahmadreza221/aurora-cchp/fusion/A1000_comb/CB_330_Hot_gas_casing_upper_half__Haynes_230.step

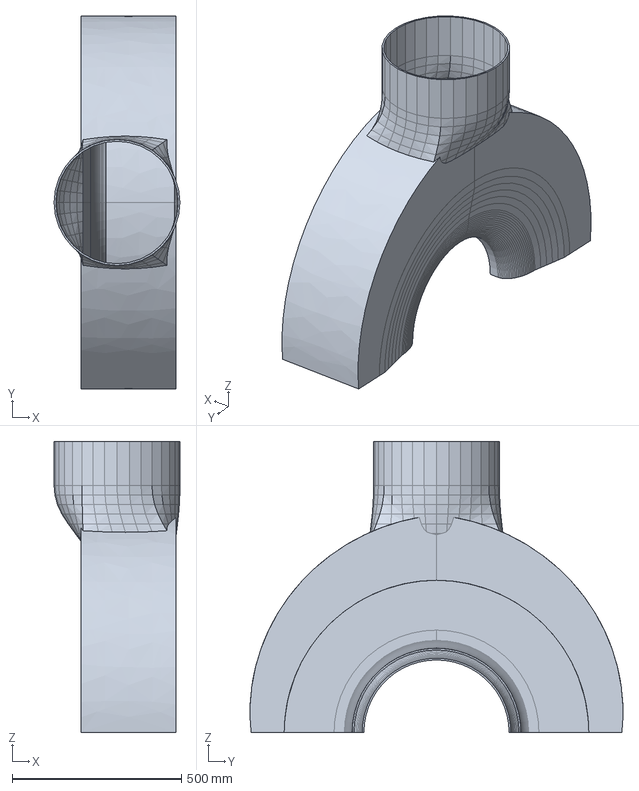
[picture p158: CAD file, 2026-10-30]
fusion/A1000_comb/CB_330_Hot_gas_casing_upper_half__Haynes_230.step
371.8 x 1101.8 x 860.0 mm
