ahmadreza221/aurora-cchp/fusion/A1000_exh/EX_412_JB2_support_ring___8_keys__1_4313.step

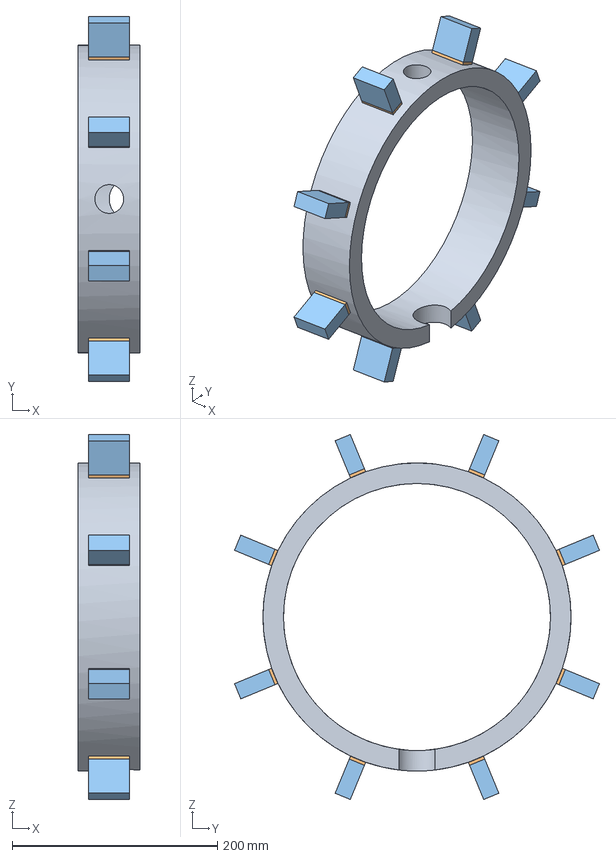
[picture p159: CAD file, 2026-10-31]
fusion/A1000_exh/EX_412_JB2_support_ring___8_keys__1_4313.step
60.0 x 355.3 x 355.3 mm
