ahmadreza221/aurora-cchp/fusion/A1000_hot/HS_211_Honeycomb_shroud_R1__Hastelloy_X.step

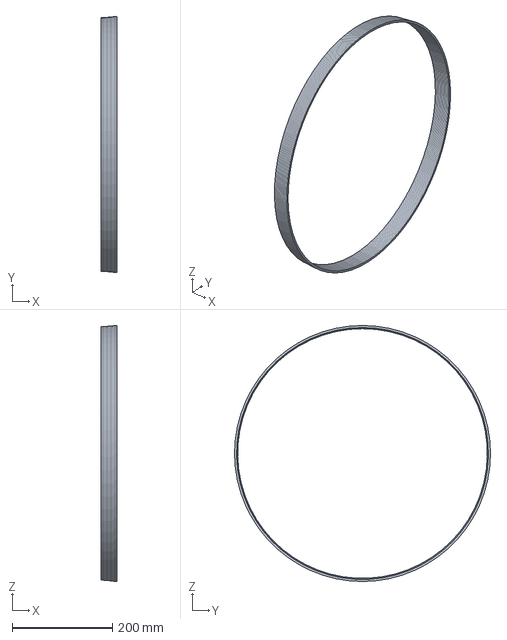
[picture p160: CAD file, 2026-10-30]
fusion/A1000_hot/HS_211_Honeycomb_shroud_R1__Hastelloy_X.step
32.0 x 509.7 x 509.7 mm
