ahmadreza221/aurora-cchp/fusion/A1000_pipe/PL_01_Oil_supply_header___distribution_block__tube_35_x_2.step

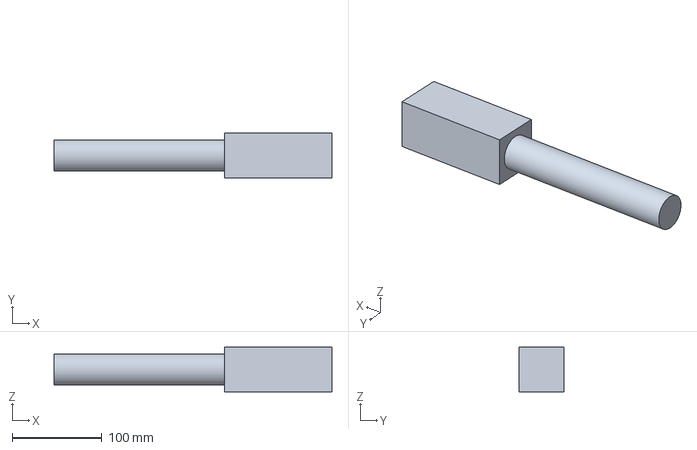
[picture p161: CAD file, 2026-10-31]
fusion/A1000_pipe/PL_01_Oil_supply_header___distribution_block__tube_35_x_2.step
310.0 x 50.0 x 50.0 mm
