ahmadreza221/aurora-cchp/fusion/A1000_pkg/Synchronous_generator.step

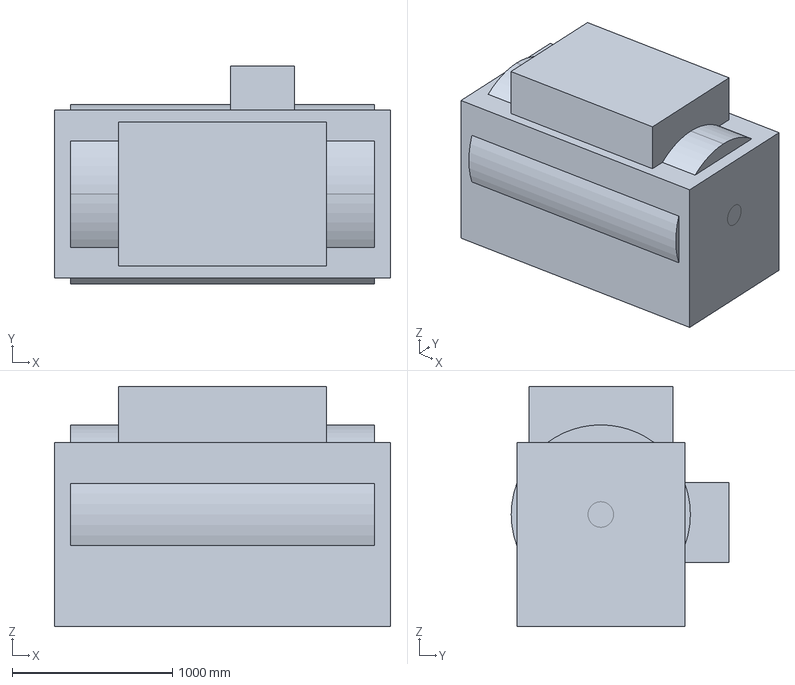
[picture p162: CAD file, 2026-10-30]
fusion/A1000_pkg/Synchronous_generator.step
2100.0 x 1360.0 x 1500.0 mm
