ahmadreza221/aurora-cchp/fusion/A1000_rotor/JB1_tilting_pads_x4__steel___babbitt.step

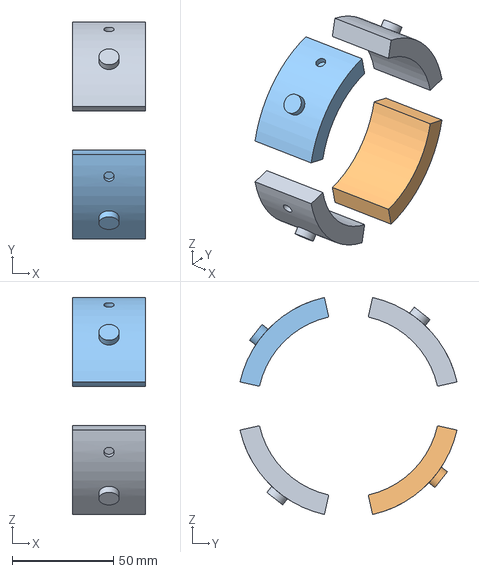
[picture p163: CAD file, 2026-10-31]
fusion/A1000_rotor/JB1_tilting_pads_x4__steel___babbitt.step
36.0 x 107.4 x 107.4 mm
