ahmadreza221/aurora-cchp/fusion/A1000_comb/CB_360_Scroll_support_pins_x4__1_4980.step

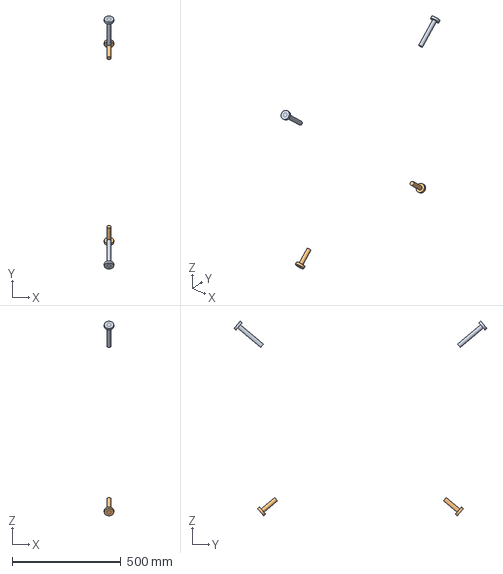
[picture p164: CAD file, 2026-10-30]
fusion/A1000_comb/CB_360_Scroll_support_pins_x4__1_4980.step
44.0 x 1165.4 x 897.0 mm
