ahmadreza221/aurora-cchp/fusion/A1000_pkg/Base_frame__skid.step

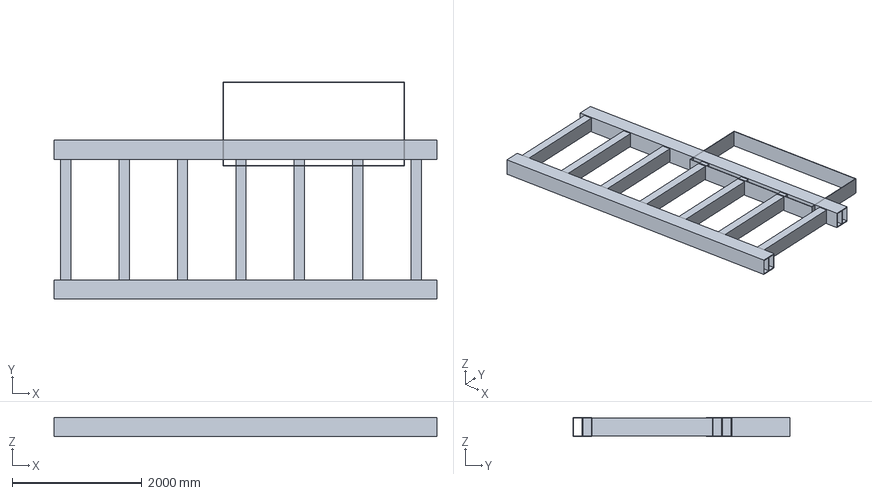
[picture p165: CAD file, 2026-10-30]
fusion/A1000_pkg/Base_frame__skid.step
5900.0 x 3350.0 x 300.0 mm
