ahmadreza221/aurora-cchp/fusion/A1000_rotor/JB2_bearing_cartridge_housing__one_piece__from_the_rear.step

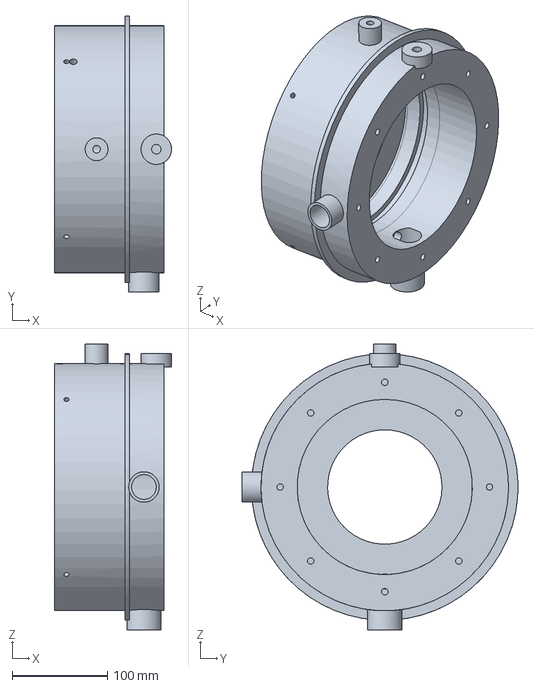
[picture p166: CAD file, 2026-10-31]
fusion/A1000_rotor/JB2_bearing_cartridge_housing__one_piece__from_the_rear.step
123.0 x 289.9 x 300.0 mm
