ahmadreza221/aurora-cchp/fusion/A1000_pkg/Low_speed_coupling.step

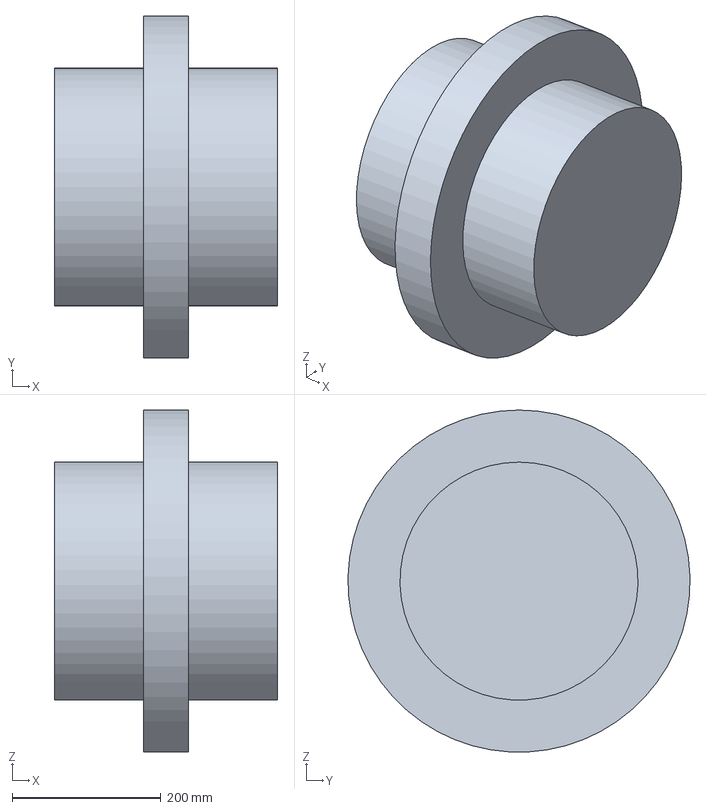
[picture p167: CAD file, 2026-10-30]
fusion/A1000_pkg/Low_speed_coupling.step
300.0 x 459.8 x 459.7 mm
