ahmadreza221/aurora-cchp/fusion/A1000_pkg/Thrust_collar.step

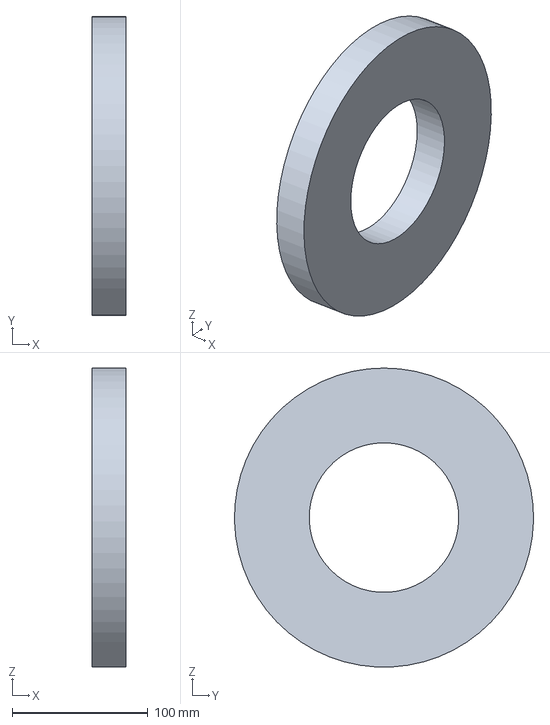
[picture p168: CAD file, 2026-10-30]
fusion/A1000_pkg/Thrust_collar.step
25.0 x 219.9 x 219.8 mm
