ahmadreza221/aurora-cchp/fusion/A1000_rotor/TB_carrier_rings__split.step

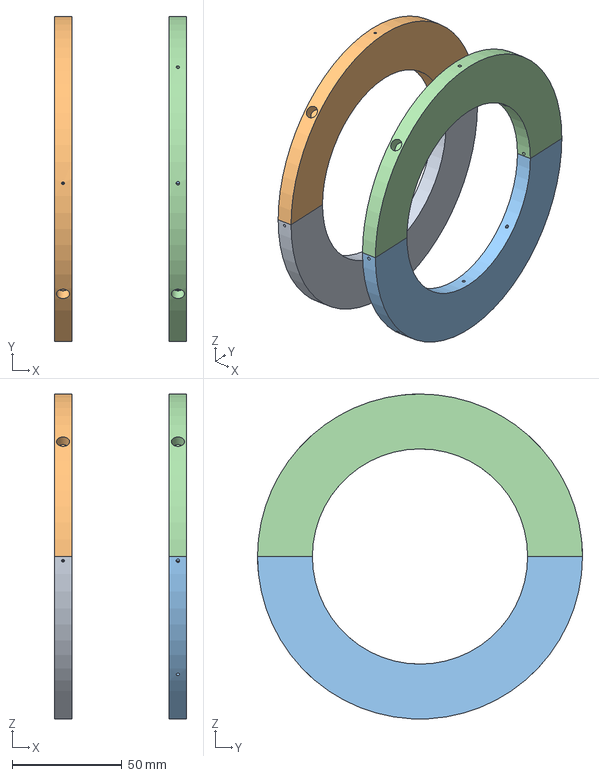
[picture p169: CAD file, 2026-10-31]
fusion/A1000_rotor/TB_carrier_rings__split.step
60.3 x 148.0 x 148.0 mm
