ahmadreza221/aurora-cchp/fusion/A1000_rotor/JB2_end_cover.step

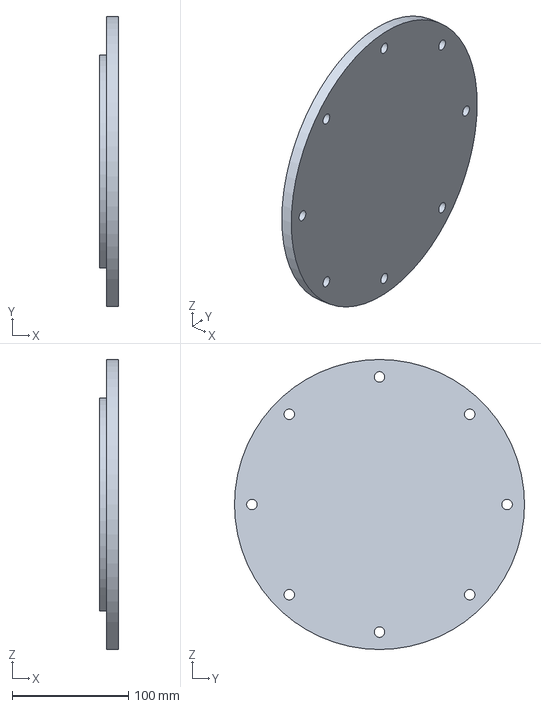
[picture p170: CAD file, 2026-10-31]
fusion/A1000_rotor/JB2_end_cover.step
16.0 x 250.0 x 250.0 mm
