ahmadreza221/aurora-cchp/fusion/A1000_pkg/Interstage_spacer.step

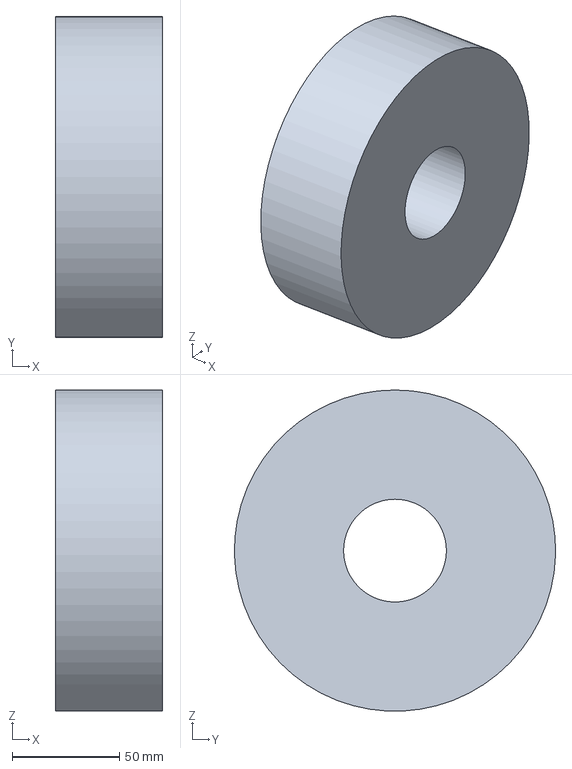
[picture p171: CAD file, 2026-10-30]
fusion/A1000_pkg/Interstage_spacer.step
50.0 x 149.9 x 149.9 mm
