ahmadreza221/aurora-cchp/fusion/A1000_pkg/Starter_motor.step

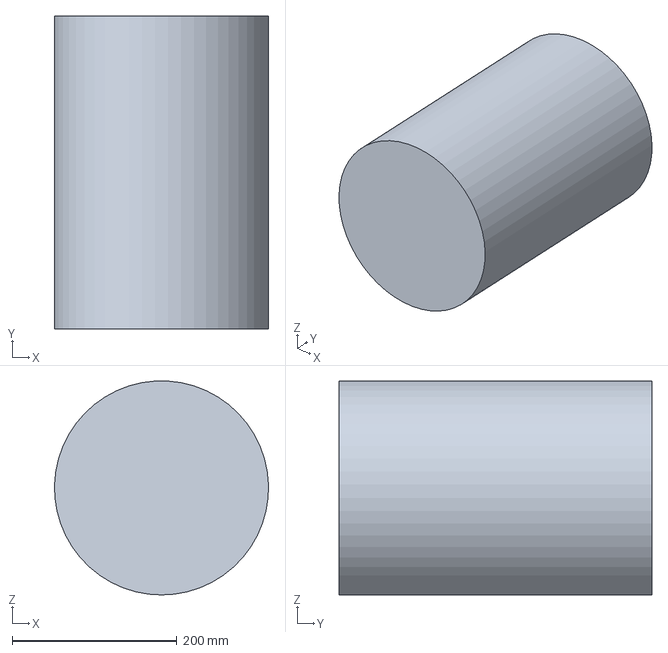
[picture p172: CAD file, 2026-10-30]
fusion/A1000_pkg/Starter_motor.step
259.9 x 380.0 x 259.8 mm
