ahmadreza221/aurora-cchp/fusion/A1000_rotor/JB2_heat_shield__ceramic_fibre_in_1_4828_foil.step

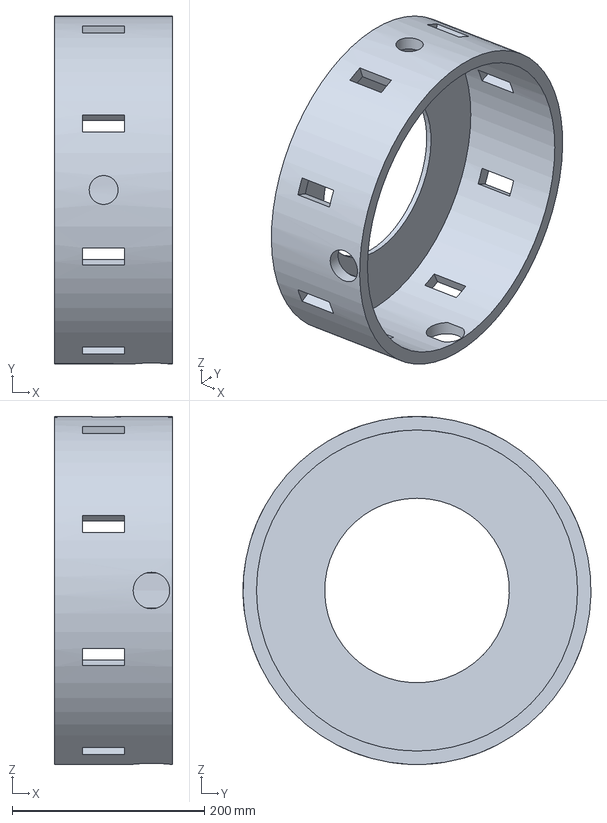
[picture p173: CAD file, 2026-10-31]
fusion/A1000_rotor/JB2_heat_shield__ceramic_fibre_in_1_4828_foil.step
123.0 x 361.9 x 362.0 mm
