ahmadreza221/aurora-cchp/fusion/A1000_pkg/Recuperator__bought_in.step

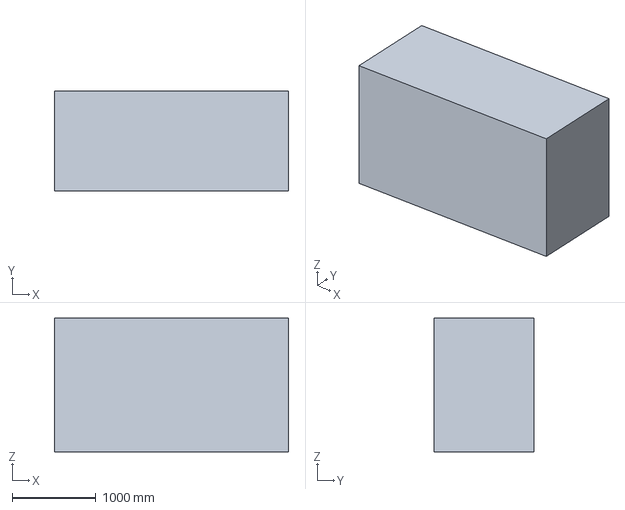
[picture p174: CAD file, 2026-10-30]
fusion/A1000_pkg/Recuperator__bought_in.step
2800.0 x 1200.0 x 1600.0 mm
