ahmadreza221/aurora-cchp/fusion/A1000_pkg/Compressor_turbine_drum.step

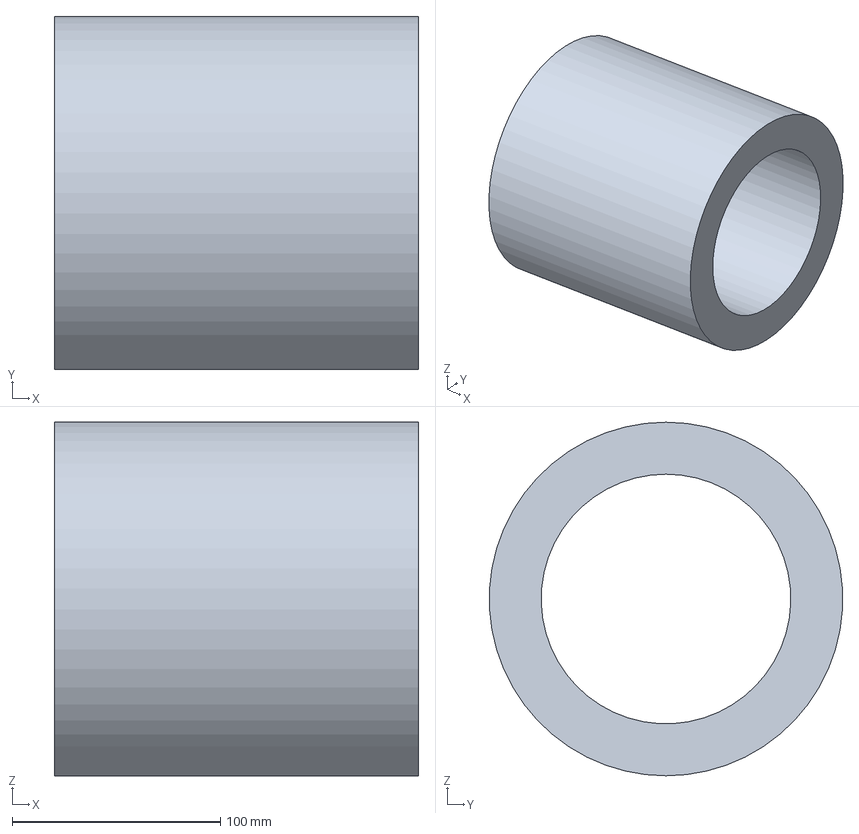
[picture p175: CAD file, 2026-10-30]
fusion/A1000_pkg/Compressor_turbine_drum.step
175.0 x 169.7 x 170.0 mm
