ahmadreza221/aurora-cchp/fusion/A1000_rotor/TB_thrust_pads_8___4__steel___babbitt.step

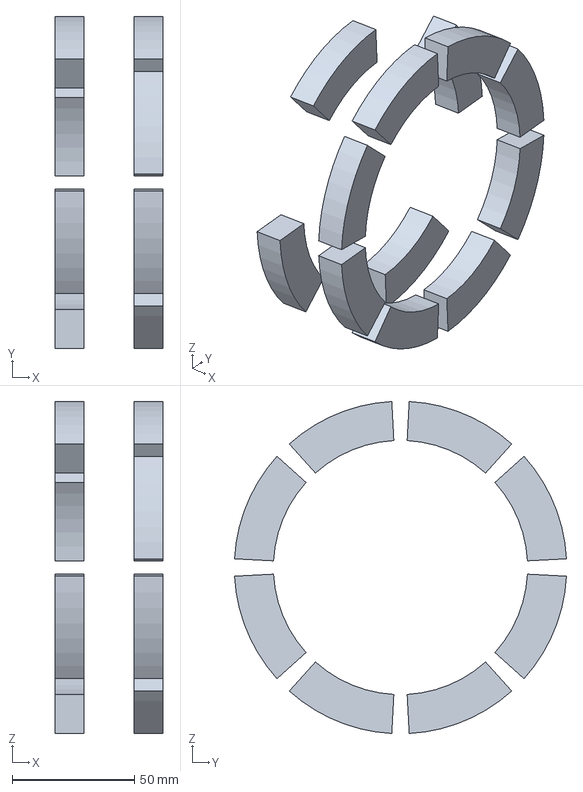
[picture p176: CAD file, 2026-10-30]
fusion/A1000_rotor/TB_thrust_pads_8___4__steel___babbitt.step
44.3 x 135.8 x 135.8 mm
