ahmadreza221/aurora-cchp/fusion/A1000_pkg/Lube_oil_module.step

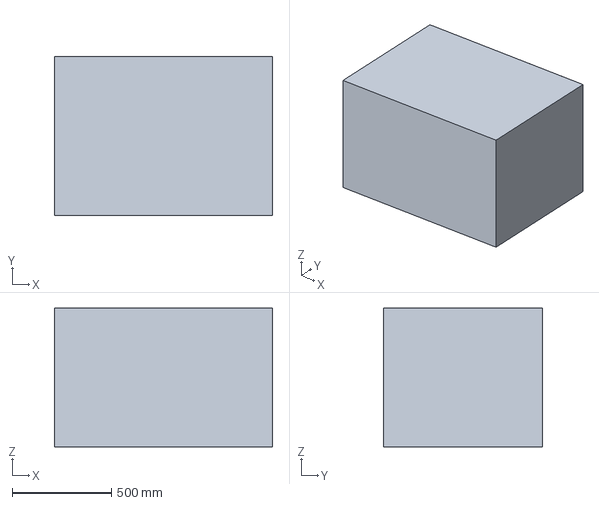
[picture p177: CAD file, 2026-10-30]
fusion/A1000_pkg/Lube_oil_module.step
1100.0 x 800.0 x 700.0 mm
