ahmadreza221/aurora-cchp/fusion/A1000_rotor/RT_104_Compressor_spacer.step

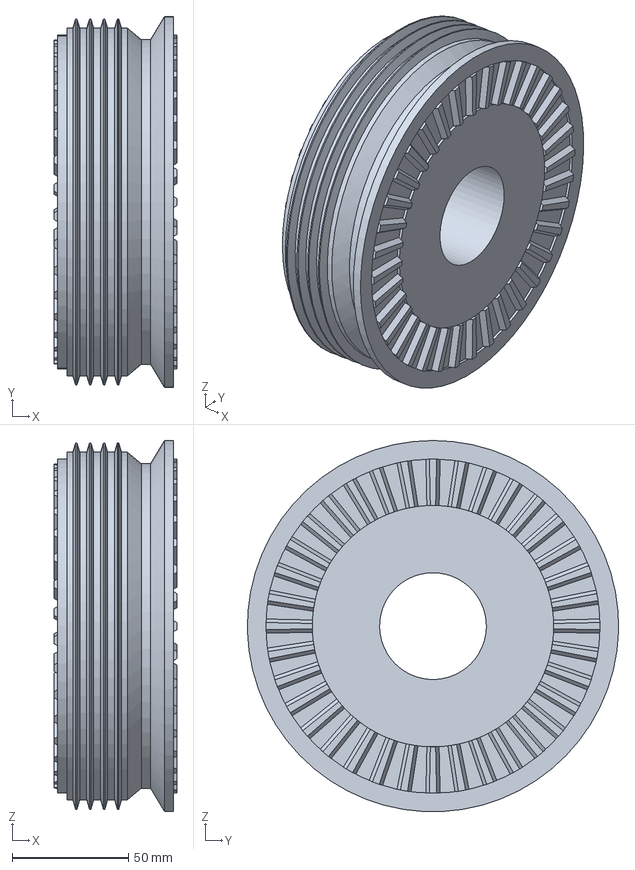
[picture p178: CAD file, 2026-10-30]
fusion/A1000_rotor/RT_104_Compressor_spacer.step
52.8 x 159.9 x 159.9 mm
