ahmadreza221/aurora-cchp/fusion/A1000_pkg/Epicyclic_gearbox_10_1.step

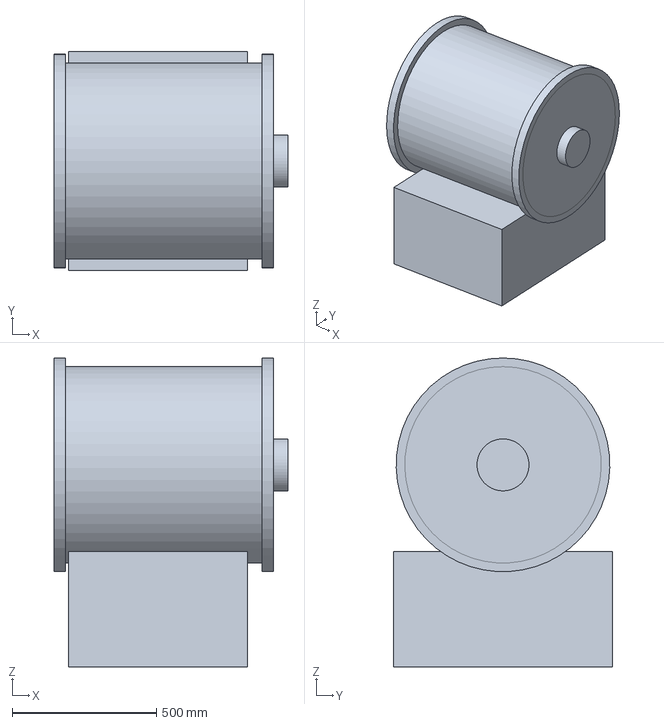
[picture p179: CAD file, 2026-10-30]
fusion/A1000_pkg/Epicyclic_gearbox_10_1.step
810.0 x 760.0 x 1070.0 mm
