ahmadreza221/aurora-cchp/fusion/A1000_pkg/High_speed_coupling.step

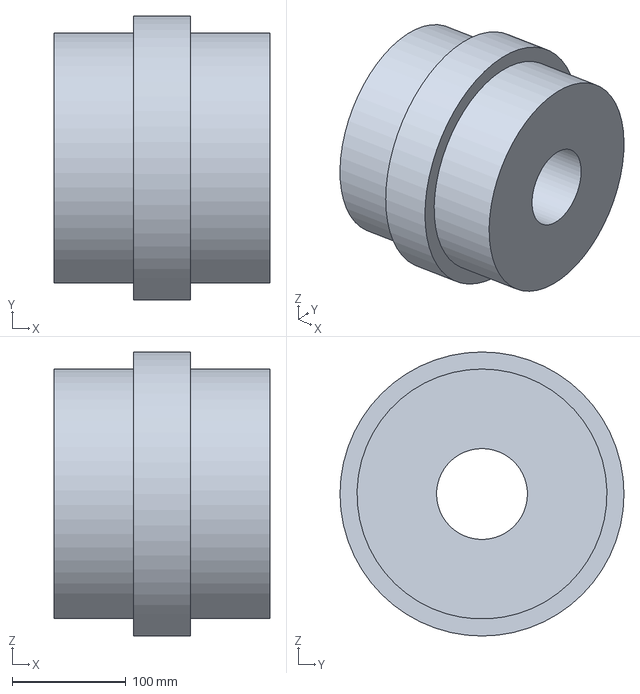
[picture p180: CAD file, 2026-10-30]
fusion/A1000_pkg/High_speed_coupling.step
190.0 x 250.0 x 250.0 mm
