ahmadreza221/aurora-cchp/fusion/A1000_rotor/TB_thrust_pads_2_x_8__steel___babbitt.step

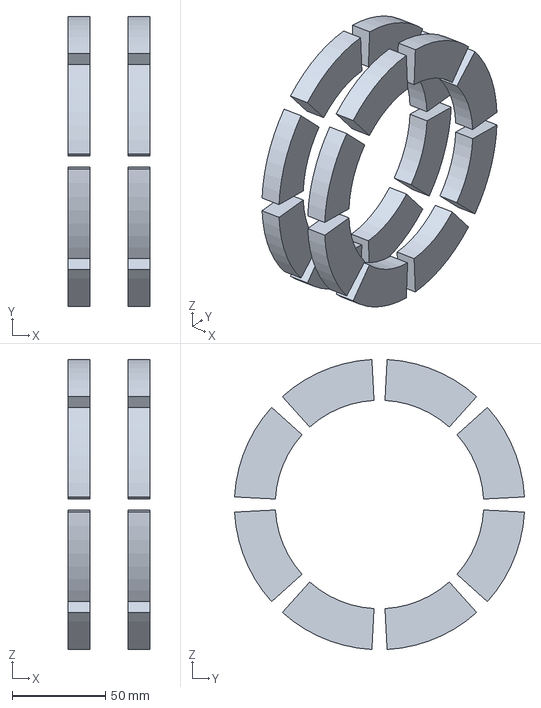
[picture p181: CAD file, 2026-10-30]
fusion/A1000_rotor/TB_thrust_pads_2_x_8__steel___babbitt.step
44.3 x 155.8 x 155.8 mm
