ahmadreza221/aurora-cchp/fusion/A1000_pkg/Journal___thrust_shaft.step

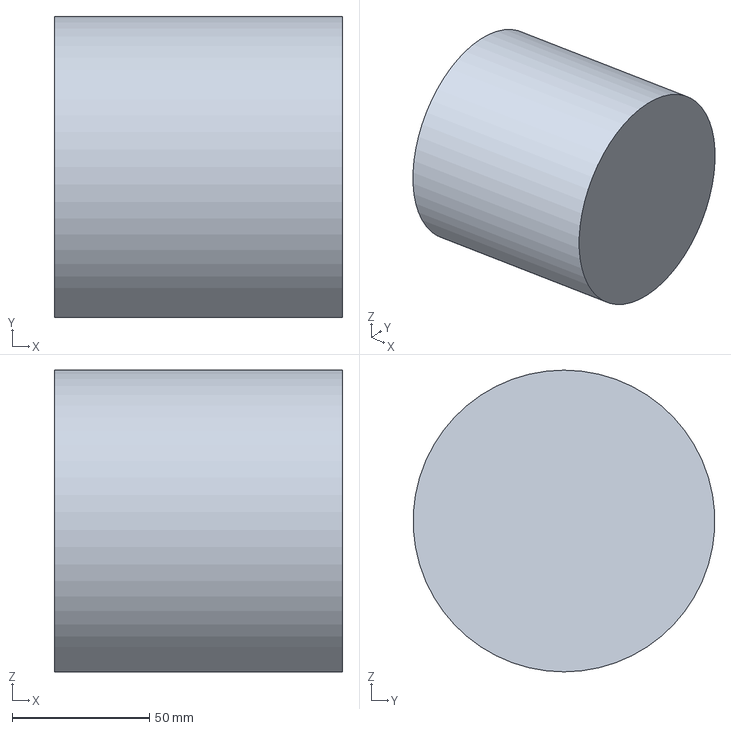
[picture p182: CAD file, 2026-10-30]
fusion/A1000_pkg/Journal___thrust_shaft.step
105.0 x 109.8 x 110.0 mm
