ahmadreza221/aurora-cchp/fusion/A1000_pkg/Thrust_bearing.step

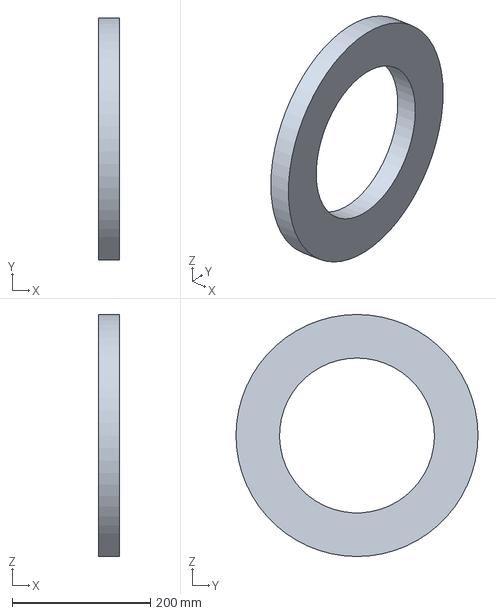
[picture p183: CAD file, 2026-10-30]
fusion/A1000_pkg/Thrust_bearing.step
31.0 x 350.0 x 350.0 mm
