ahmadreza221/aurora-cchp/(list of files, cad)

Other CAD files:
fusion/A1000_hot/HS_201_Outer_casing_upper_half__EN_GJS_400_18LT.step
fusion/E1/E1_ngv_vane_final.step
fusion/E1/E1_ngv_rings_final.step
fusion/A1000_rotor/JB1_integral_hairpin_spring_damper_ring__ISFD__4_springs___4_pads__split____transfer_tubes.step
fusion/A1000_hot/HS_221_Honeycomb_shroud_R2__Hastelloy_X.step
fusion/A1000_rotor/JB2_tilting_pads_x4__steel___babbitt.step
fusion/A1000_pkg/Journal_bearing_1__tilting_pad___SFD.step
fusion/A1000_rotor/JB1_pad_carrier___end_plates__split.step
fusion/A1000_pkg/Tie_bolt.step
fusion/A1000_rotor/RT_102_Tie_bolt_M42_IN718.step
fusion/A1000_rotor/RT_103_Tie_bolt_nut.step
