ahmadreza221/aurora-cchp/docs/engine/E1_manufacturing.md

# E1 — مشخصات ساخت پلهٔ توربین: نقشه‌ها، تلورانس‌ها، جوش اصطکاکی، بالانس، CAM

تاریخ: ۲۰۲۶-۱۰-۲۳ · مبنا: `cad/engine/gg_turbine.py` (هندسه)، `docs/engine/E1_gg_turbine.md` (طراحی و تأیید Fusion بخش ۵)، `sim/gr180_rotor.py` (دینامیک روتور) · مدل‌های Fusion: **GR180 E1 Turbine** (ماشین‌کاری‌شده) و **GR180 E1 Turbine (cast blanks)** (ریختگی با اضافه‌تراش)

> این سند متن نقشه‌هاست (یادداشت‌ها، داتوم‌ها، تلورانس‌ها). نقشه‌های Fusion از همین سند پر می‌شوند. همهٔ ابعاد mm، قاب ENG (x محور موتور، مثبت به سمت اگزوز). تلورانس‌های نوشته‌نشده: ISO 2768-fH (ماشین‌کاری)، ISO 8062-3 CT6 (ریختگی دقیق).

## ۱. قطعات و روند ساخت

| قطعه | ماده | روند | مدل |
|---|---|---|---|
| **چرخ blisk (۲۹ پره)** | IN713LC، ریخته‌گری دقیق خلأ (قالب موم)، ρ = 8.00 g/cc | ریختگی با اضافه‌تراش → HIP (توصیه) → بازرسی → ماشین‌کاری هاب و سکوها → **جوش اصطکاکی به شفت** → تراش زائده و شیار رهایی → PWHT → سنگ journalها → سنگ نوک پره‌ها Ø70.30 → بالانس | `E1_disc_boreless_*` + `E1_blade_*` |
| **حلقهٔ NGV (۲۱ وین)** | IN713LC، ریختگی دقیق خلأ | ریختگی یک‌تکه (حلقه‌ها + وین‌ها) → HIP (توصیه) → بازرسی → تراش بور shroud، OD، لبهٔ جلو، بور جان، فلنج (rib) | `E1_ngv_rings_*` + `E1_ngv_vane_*` |
| **شفت** | 42CrMo4 (1.7225) کوئنچ‌تمپر 1000–1200 MPa (HRC 32–38) | تراش کامل با ۱٫۵ mm اضافه در انتهای جوش → جوش → سنگ journalها بعد از PWHT | `E1_shaft_welded` |

**اضافه‌تراش ریختگی (`kind='cast'` در کد):** هاب: ۰٫۵ روی سطح جلوی آستین (x 104.3 → 103.8)، ۰٫۵ روی قطر آستین Ø12.8 و قطر بوس Ø13، ۰٫۵ روی سطح بوس عقب؛ سکوی جلو ۰٫۳ (x 110.1 → 109.8)؛ نوک پره ۰٫۳ شعاعی (r 35.15 → 35.45). NGV: بور shroud ۰٫۳ شعاعی **فقط پشت وین‌ها** (x 109.8..118.8، با شیب ۴۵° از بور نهایی؛ `CAST_SHROUD_STOCK_U0`)، سطح جلو ۰٫۳، جان و فلنج ۰٫۳–۰٫۵. بور shroud و OD حلقهٔ داخلی بین وین‌ها و پخ ورودی **ریختگی نهایی** هستند، چون ابزار تراش بین وین‌ها نمی‌رسد (یافتهٔ CAM در Fusion، ۲۰۲۶-۱۰-۲۳). بدون سوراخ پیلوت (دیسک بدون سوراخ، جوشی).

## ۲. نقشهٔ چرخ ماشین‌کاری‌شده (بعد از جوش به شفت = «واحد روتور توربین»)

**داتوم‌ها**
- **A:** journal عقب بلبرینگ 608، Ø8 k5، x 97.30..104.30 (روی شفت، کنار چرخ).
- **B:** journal جلو، Ø8 k5، x 3.30..10.30. محور مرجع **A–B**.
- **C:** سطح جلوی آستین هاب در x 104.30 (نشیمن رینگ داخلی 608 عقب) — پس از جوش و تراش زائده.

| ویژگی | اندازه | تلورانس | توضیح |
|---|---|---|---|
| قطر نوک پره‌ها (سنگ بعد از جوش و بالانس اولیه) | Ø70.30 | 0 / −0.03؛ لنگی به A–B ≤ 0.02 | لقی سرد 0.20 به بور Ø70.70 |
| سطح جلوی سکو (x 110.10) | 5.80 از C | ±0.03؛ تعامد به A–B 0.02 | لقی 0.30 به انتهای حلقهٔ داخلی NGV (x 109.8) |
| سطح عقب سکو (x 119.40) | 15.10 از C | ±0.05 | — |
| آستین جلو | Ø12.8 h7 × 4.3 | هم‌محوری به A 0.01 | شانهٔ رینگ داخلی 608 |
| نشیمن رینگ داخلی روی C | حلقهٔ Ø9.5..Ø12.8 | تختی 0.005؛ تعامد به A 0.01؛ Ra 0.4 | **شیار رهایی Ø9.5 × 0.5 عمق** روی سطح C داخل تماس رینگ: زائدهٔ جوش را بیرون از نشیمن نگه می‌دارد |
| بوس عقب | Ø13 h8، سطح در x 118.81 | ±0.10 | بدون رزوه و مهره (جوشی)؛ زمین بالانس |
| جان دیسک | ضخامت 6.0 (x 110.6..116.6)، فیلت R4 | ریختگی ±0.15، فیلت R4 +0.3/−0 | **ماشین‌کاری نشود** (ناحیهٔ ۶۱۵ MPa؛ برداشت بالانس ممنوع) |
| پره‌ها (ریختگی) | پروفیل طبق مدل `E1_blade_final` | پروفیل ±0.10؛ ضخامت لبهٔ فرار 0.45..0.48 ±0.05؛ شعاع لبهٔ حمله ±0.05؛ فیلت ریشه R0.8 ±0.2 | گام زاویه‌ای ۲۹ پره ±0.15°؛ انحراف لبهٔ فرار از سکو ≤ 0.1 |
| هاب بین پره‌ها (flare r 22.1 → 19.0) | طبق مدل | ±0.15 | ریختگی |
| لنگی محوری سطح جلوی سکو به C | — | 0.03 | — |
| ناراستی (runout) شعاعی سکوی جلو Ø44.2 به A–B | — | 0.03 | — |

**یادداشت‌های ریختگی چرخ و NGV:** ریخته‌گری دقیق خلأ IN713LC، دانه‌بندی هم‌محور. **HIP** (پیشنهاد: 1180 °C / 100 MPa / 4 h، یا طبق تأییدیهٔ ریخته‌گر برای IN713LC) برای بستن تخلخل. بازرسی: FPI (نفوذ فلورسنت) ۱۰۰ ٪، رادیوگرافی ۱۰۰ ٪ (ASTM E192، ریزتخلخل کلاس ≤ 2، بدون ترک و inclusion در جان و ریشهٔ پره)، آنالیز شیمیایی هر ذوب، نمونهٔ کشش هر ذوب (حداقل Rp0.2 ≥ 690 MPa در 20 °C). سطح ریختگی Ra ≤ 3.2 µm روی پره‌ها (بدون سندبلاست روی لبه‌ها). ماشین‌کاری فقط در نواحی جدول؛ پره و هاب as-cast.

## ۳. نقشهٔ حلقهٔ NGV ماشین‌کاری‌شده

**داتوم‌ها:** **D** = بور جان Ø26.0 H7 (r 13.0، x 103.3..104.8؛ روی لبهٔ تونل شفت می‌نشیند)؛ **E** = سطح جلوی حلقهٔ بیرونی x 94.80 (land).

| ویژگی | اندازه | تلورانس |
|---|---|---|
| بور shroud، ناحیهٔ وین‌ها (ریختگی) | Ø70.70 (r 35.35)، x 96.24..109.80 | ±0.15 ریختگی؛ قالب موم پس از نمونهٔ اول اصلاح شود؛ اندازه‌گیری CMM |
| بور shroud، ناحیهٔ نوک روتور (تراش) | Ø70.70 (r 35.35)، x 109.80..118.80 | +0.03 / 0؛ هم‌محوری به D 0.03؛ Ra 1.6؛ پلهٔ اتصال به بور ریختگی در x 109.8 ≤ 0.08 شعاعی |
| OD حلقهٔ بیرونی | Ø72.70 (r 36.35) | h7؛ هم‌محوری به D 0.03 |
| فلنج (rib) | Ø75.90 (r 37.95)، x 109.30..110.80 (پهنا 1.50) | ±0.03 روی پهنا؛ سطح عقب فلنج (x 110.80) تا E: 16.00 ±0.03؛ تعامد 0.02 |
| حلقهٔ داخلی | Ø44.50 / Ø42.50 (r 22.25 / 21.25)، x 94.80..109.80 | Ø44.50 بین وین‌ها ریختگی ±0.10، بقیه ±0.05؛ **سطح انتهایی x 109.80: 15.00 ±0.03 از E** (لقی 0.30 به سکوی چرخ) |
| جان | x 103.3..104.8، r 13.0..21.3 | بور D: H7؛ سطح‌ها ±0.05 |
| پخ ورودی shroud | 26° از x 94.8 تا شروع بور (x 96.24) | ریختگی |
| وین‌ها (۲۱) | پروفیل طبق `E1_ngv_vane_final`؛ لبهٔ فرار در x 108.30 (+کلاهک 0.1) | پروفیل ±0.10؛ لبهٔ فرار 0.45 ±0.05؛ فیلت R1.0 |
| **گلوگاه هر پاساژ** | مجموع ۱۱۷۵ mm² (طراحی) | هر پاساژ ±3 ٪، مجموع ±1.5 ٪ (کنترل با گیج گلوگاه؛ مبحث CFD بخش ۴ رکورد E1) |

## ۴. نقشهٔ شفت 42CrMo4

| ویژگی | اندازه | تلورانس |
|---|---|---|
| journal عقب (A) | Ø8 k5 (+0.001/+0.007)، x 97.30..104.30 | گردی 0.002، استوانه‌ای 0.003، Ra 0.2 (سنگ بعد از PWHT) |
| journal جلو (B) | Ø8 k5، x 3.30..10.30 | همان؛ لنگی A نسبت به B ≤ 0.005 |
| بدنه | Ø15.5 h8، x 28.3..79.3 | لنگی به A–B 0.01 |
| شانه‌ها | Ø11، x 10.3..28.3 و 79.3..97.3 (مخروط 18 mm بین Ø11 و Ø15.5) | ±0.05 |
| جلو | Ø7 / Ø6 پله‌ای (x −47.7..−32.7..1.3)، رزوهٔ مهرهٔ دماغه طبق `build_gr180.py` | — |
| انتهای جوش | Ø8.0، سطح در x 104.30 (بعد از جوش)؛ **بلانک: +1.5 mm طول برای burn-off** | سطح جوش تخت، Ra 1.6، بدون پخ |
| سختی | 32–38 HRC، تمپر ≥ 600 °C (بالاتر از PWHT) | گواهی ۳٫۱ |

## ۵. مشخصات جوش اصطکاکی/اینرسی IN713LC ↔ 42CrMo4

- **نوع:** جوش اصطکاکی اینرسی (ترجیح) یا درایو مستقیم؛ چرخ ثابت، شفت چرخان؛ سطح تماس Ø8 (50 mm²).
- **آماده‌سازی:** سطح جوش چرخ (x 104.30 + 0.5 اضافه → بلانک x 103.8) و انتهای شفت (+1.5 mm) تراش Ra 1.6، چربی‌زدایی با استون، بدون پخ. چرخ در فیکسچر روی بور ریختگی آستین (Ø12.8 +0.5) و سطح عقب بوس گرفته می‌شود.
- **پارامترها (شروع؛ تأیید با کوپن):** فشار اصطکاک 120–180 MPa، فشار آهنگری (forge) 250–350 MPa، burn-off کل 1.5–2.5 mm (عمدتاً از سمت فولاد)، انرژی اینرسی طبق تأمین‌کننده برای Ø8 Ni-cast/فولاد. **کوپن‌های مقدماتی:** ۳ جوش با همان ماده‌ها؛ ماکرو (بدون نفوذ ناقص، بدون ترک HAZ سمت IN713LC)، سختی عرضی، پیچش تا شکست (باید خارج از جوش بشکند).
- **بعد از جوش:** تراش زائده (flash) در دو طرف؛ **شیار رهایی Ø9.5 × 0.5** روی سطح C داخل تماس رینگ داخلی 608؛ **PWHT تنش‌زدایی 580 ±10 °C / 2 h در خلأ یا آرگون** (زیر دمای تمپر شفت؛ بی‌اثر بر IN713LC)؛ سپس سنگ journalها و نوک پره‌ها.
- **بازرسی هر قطعه:** FPI سطح جوش بعد از تراش زائده؛ **UT** (فرکانس بالا ۱۰–۱۵ MHz، از انتهای شفت در راستای محور، سطح مرجع Ø8: بدون بازتاب > ۲۰ ٪ از سوراخ مرجع Ø0.4)؛ لنگی چرخ نسبت به A بعد از جوش ≤ 0.05 (قبل از سنگ نوک)؛ **تست پیچش اثباتی** روی قطعهٔ اول هر سری: ۲× گشتاور انتقالی توربین به کمپرسور. در نقطهٔ طراحی (`sim/cycle_results.json`: کار ویژهٔ کمپرسور 158 kJ/kg × 0.41 kg/s ≈ 65 kW در 115k rpm) گشتاور ≈ **5.4 N·m**؛ تست اثباتی **11 N·m** بدون چرخش دائمی (شکست در کوپن باید خارج از جوش باشد؛ گشتاور شکست مورد انتظار Ø8 فولاد Q+T ≈ 100 N·m).
- **شناسایی:** شمارهٔ ذوب چرخ + شمارهٔ شفت + شمارهٔ جوش، حک لیزری روی سطح بوس عقب.

## ۶. مشخصات بالانس

روتور کامل (شفت + چرخ جوشی + کمپرسور + رینگ‌ها و اسپیسرها) ≈ **380 g** (`sim/gr180_rotor.py`: ۲۱۶ g دیسک‌های لامپ با چرخ قدیمی ۹۱ g + شفت ۱۳۵ g؛ چرخ جدید ۱۱۷ g). دور کار 115k rpm (ω = 12 043 rad/s)، باند 100–120k.

| درجه (ISO 21940-11) | e_per | U_per کل | هر صفحه (۲ صفحه) |
|---|---|---|---|
| G2.5 | 0.21 µm | 0.079 g·mm | 0.040 g·mm |
| **G1 (هدف docs/03)** | 0.083 µm | **0.032 g·mm** | 0.016 g·mm |
| G0.4 | 0.033 µm | 0.013 g·mm | 0.006 g·mm |

1. **واحد توربین (شفت + چرخ جوشی)، قبل از سنگ نوک:** بالانس دوصفحه‌ای روی journalهای A و B، هدف ≤ 0.02 g·mm در هر صفحه. صفحه‌های اصلاح: **سطح بوس عقب x 118.6..118.8 (Ø10..Ø13)** و **پیشانی آستین جلو (Ø9.5..Ø12.8 بیرون از نشیمن 608، عمق ≤ 0.3)**. **برداشت از جان، فیلت‌ها و پره‌ها ممنوع.** سپس سنگ نوک Ø70.30 (مرکز: A–B) و کنترل دوباره.
2. **کمپرسور** جداگانه (موجود): بالانس روی مندرل.
3. **روتور کامل** بعد از مونتاژ با رینگ‌های داخلی 608، اسپیسر و شیم: بالانس نهایی دوصفحه‌ای به **G1 (≤ 0.016 g·mm هر صفحه)** روی ماشین بالانس سرعت پایین با درایو هوا، اصلاح روی **slug بالانس دماغه (x −38.9)** و بوس عقب چرخ.
4. **تأیید در دور کار:** روی استند با چرخش هوا (VSR) تا 115k rpm: شتاب محفظهٔ یاتاقان ≤ 2 g (0–پیک) در باند 100–120k، بدون جهش در عبور از مد سوم (~98–163k طبق سفتی یاتاقان؛ میراگر O-ring جلو الزامی). جفت‌شدن قطعات (match-marking) چرخ/کمپرسور/شفت ثبت شود.

## ۷. طرح CAM (برای مرحلهٔ Fusion Manufacture)

| قطعه | عملیات | ماشین | نکته |
|---|---|---|---|
| واحد روتور (بعد از جوش) | تراش زائده، شیار رهایی Ø9.5×0.5، پیشانی C، آستین Ø12.8، بوس Ø13 و سطح x 118.81، سکوی جلو x 110.10 و عقب x 119.40 | تراش CNC، گیرش روی Ø15.5 با لونت در دماغه | سکوی جلو: ابزار پخ ۳۵° کوچک؛ فاصله تا فیلت ریشه فقط 0.18 mm → حرکت فقط در r 19.7..22.0 |
| واحد روتور | سنگ journalها Ø8 k5 (بین مرغک)، سنگ نوک Ø70.30 | سنگ‌زنی | خارج از Fusion |
| چرخ (در صورت نیاز) | فرز ۵ محوره فقط برای **تصحیح موضعی** نوک/سکو یا ساخت نمونهٔ آلومینیومی برای تست چیدمان | ۵ محوره (3+2 کافی است) | پره‌ها as-cast می‌مانند |
| حلقهٔ NGV | تراش: سطح E، OD Ø72.70، بور Ø70.70 **فقط x 109.8..118.8** (داخل‌تراش از عقب؛ بین وین‌ها ریختگی)، فلنج، بور جان Ø26 H7 (از جلو)، سطح انتهایی حلقهٔ داخلی x 109.80 (از عقب) | تراش CNC دو گیرش | گیرش ۱: روی OD ریختگی، تراش E و بور جان؛ گیرش ۲: روی بور جان، باقی |
| شفت | تراش کامل، رزوهٔ دماغه، پیش‌تراش journalها با 0.15 اضافه | تراش CNC | journalها سنگ نهایی |

## ۸. وضعیت و کارهای بعدی
- [x] تلورانس‌ها و داتوم‌ها (این سند)
- [ ] نقشه‌های Fusion (چرخ ریختگی، چرخ ماشین‌کاری، NGV ریختگی و ماشین‌کاری، شفت، جزئیات جوش) با این یادداشت‌ها
- [ ] CAM در Fusion (تراش روتور و NGV؛ ۳+۲ برای تصحیح) و شبیه‌سازی برخورد
- [x] گشتاور انتقالی برای تست پیچش: 5.4 N·m طراحی، 11 N·m اثباتی
- [ ] تطبیق HIP/PWHT با تأمین‌کنندهٔ ریخته‌گری و جوش

## ۹. برنامهٔ تست پذیرش (ping، spin، tip timing)

**۹-۱. تست ضربه (ping) روی چرخ ماشین‌کاری‌شده، پیش از جوش و بعد از آن**
- چرخ آزاد (روی فوم) و بعد واحد جوشی آویزان از journal جلو؛ چکش مینیاتوری (نوک فلزی، پهنای باند ≥ 100 kHz) روی نوک هر پره؛ میکروفن یا وایبرومتر لیزری؛ FFT تا 100 kHz، رزولوشن ≤ 5 Hz.
- هدف: (الف) فرکانس‌های خانوادهٔ پره در دمای اتاق برای کالیبرهٔ مدل؛ (ب) پراکندگی پره‌به‌پره (mistuning) — انحراف معیار F1 بین ۲۹ پره **≤ ۱٫۵ ٪**، هیچ پره‌ای > ۳ ٪ از میانگین (پرهٔ خارج از حد = عیب ریختگی یا ضخامت؛ FPI و اندازه‌گیری ضخامت).
- مرجع (مدل تک‌پره روی هاب صلب، `sim/engine/e1_blade_modal.py`؛ مقادیر 730 °C × 1.105 برای مدول دمای اتاق؛ مقدار اندازه‌گیری‌شده به‌خاطر انعطاف دیسک برای F1 چند درصد کمتر از مدل هاب صلب است):

| مد | 0 rpm، 730 °C (kHz) | 0 rpm، 20 °C (kHz) |
|---|---|---|
| F1 | 6.35 | 7.01 |
| F2 | 14.74 | 16.29 |
| F3 | 20.11 | 22.22 |
| F4 | 31.85 | 35.20 |
| F5 | 46.31 | 51.18 |
| F6 | 49.00 | 54.15 |
| F7 | 55.03 | 60.82 |
| F8 | 76.01 | 84.01 |

**مدهای کل چرخ (تقارن چرخشی، 0 rpm، دمای داغ در مدل؛ ×1.105 برای دمای اتاق):**

| قطر گرهی | خانواده‌های ۱..۳ (kHz، داغ) | دمای اتاق (kHz) |
|---|---|---|
| 1 | 3.54 / 6.27 / 12.66 | 3.92 / 6.93 / 13.99 |
| 2 | 6.15 / 11.15 / 16.32 | 6.80 / 12.33 / 18.04 |
| 3 | 6.17 / 13.26 / 17.94 | 6.82 / 14.66 / 19.83 |
| 4 | 6.17 / 13.80 / 18.69 | 6.82 / 15.25 / 20.65 |
| 7 | 6.17 / 14.13 / 19.23 | 6.82 / 15.62 / 21.26 |
| 8 | 6.17 / 14.16 / 19.29 | 6.82 / 15.65 / 21.32 |
| 13 | 6.18 / 14.23 / 19.40 | 6.83 / 15.72 / 21.45 |

- معیار پذیرش ساخت: میانگین F1 اندازه‌گیری‌شده در بازهٔ **−8 ٪ تا +3 ٪** مدل دمای اتاق (کمتر = دیسک انعطاف‌پذیر و خطای مدل؛ بیشتر از +3 ٪ = پرهٔ کلفت‌تر از نقشه → کنترل ابعادی). اگر میانگین F1 بیش از این بازه جابه‌جا شد، نقشهٔ Campbell با مقدار اندازه‌گیری‌شده بازسازی شود (`--plot` با ضریب).

**۹-۲. تست چرخش با بار اضافه (spin test)، واحد جوشی بعد از بالانس اولیه**
- در محفظهٔ خلأ یا اتاقک spin با درایو هوا/الکتریکی؛ دمای اتاق؛ **138k rpm (1.20 × طراحی، 1.15 × trip)** به مدت ۶۰ s، سه سیکل 0 → 138k → 0؛ مدل: 138k سرد = حالت `138c` در `e1_sector_stress.py` (تنش کمتر از تسلیم).
- پیش و پس از تست: اندازه‌گیری قطر نوک (۴ جهت) و قطر بوس Ø13 با دقت 2 µm — **رشد ماندگار ≤ 5 µm**؛ FPI کامل چرخ و ناحیهٔ جوش بعد از تست؛ ping دوباره (تغییر F1 ≤ 0.5 ٪).
- بالانس بعد از spin دوباره کنترل شود (تغییر ≤ 0.01 g·mm).

**۹-۳. اندازه‌گیری ارتعاش نوک پره (tip timing) روی استند**
- ۴ پروب نوری/خازنی در shroud NGV (سوراخ‌های Ø2 در حلقهٔ بیرونی، بین x 112 و 117، زاویه‌های نامساوی مثلاً 0°، 47°، 101°، 163° برای شناسایی EO بالا) + یک پروب مرجع یک‌پالس‌دردور روی شفت.
- جاروب آهستهٔ دور **90k → 120k rpm با 200 rpm/s** در دو جهت، در دمای کار؛ پردازش: دامنهٔ هم‌زمان (synchronous) هر پره در عبور از تقاطع‌های پیش‌بینی‌شده:
  - **F1 × EO4 در ~105k** (منبع EO4 نباید وجود داشته باشد؛ دامنهٔ هم‌زمان > 50 µm = ناهمگنی ۴تایی در مسیر گاز → پیدا و حذف شود)،
  - **F8 × EO42 در ~110k** و تلاقی خانواده‌های بالای چرخ با EO42 در **107k و 118k** (`e1_blisk_cyclic`)؛
  - EO7 (انژکتورها) و EO21 (NGV) در کل باند.
- معیار: دامنهٔ نوک هم‌زمان ≤ 100 µm (0–پیک) و تنش معادل از مدل مد (دامنه × نسبت تنش/جابه‌جایی مد) ≤ ۱/۳ حد خستگی پرتکرار IN713LC در 730 °C (~ 200 MPa) → **≤ 65 MPa دینامیکی**. فراتر از آن: میرایی اصطکاکی، تغییر فاصلهٔ NGV–چرخ (2.65 mm) یا تغییر تعداد پره.
- ثبت هم‌زمان: دور، T4، فشار، ارتعاش محفظه (شتاب‌سنج روی تونل)، تا اطلاعات tip timing با پاسخ اجباری CFD مقایسه شود.

**۹-۴. ترتیب پذیرش هر چرخ:** ابعاد و FPI/X-ray ریختگی → ماشین‌کاری → ping (الف) → جوش → UT جوش → تراش نهایی و بالانس اولیه → spin 138k → FPI + ابعاد + ping (ب) → سنگ نوک → بالانس نهایی روتور → استند با tip timing.
