ahmadreza221/aurora-cchp/previews/GR180_Shaft_assembly_iso.png

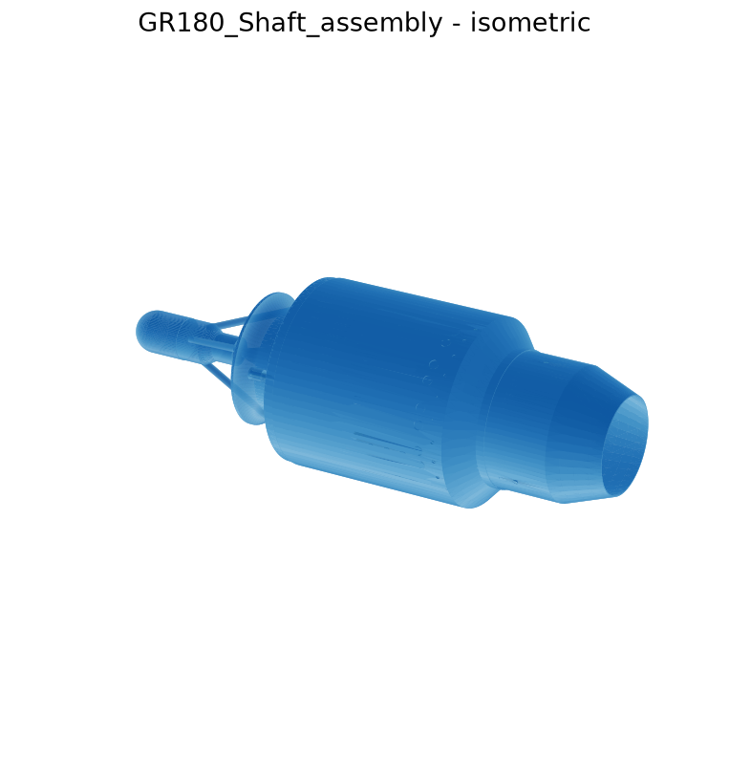
previews/GR180_Shaft_assembly_iso.png
