ahmadreza221/aurora-cchp/previews/GR180_Shaft_assembly_section.png

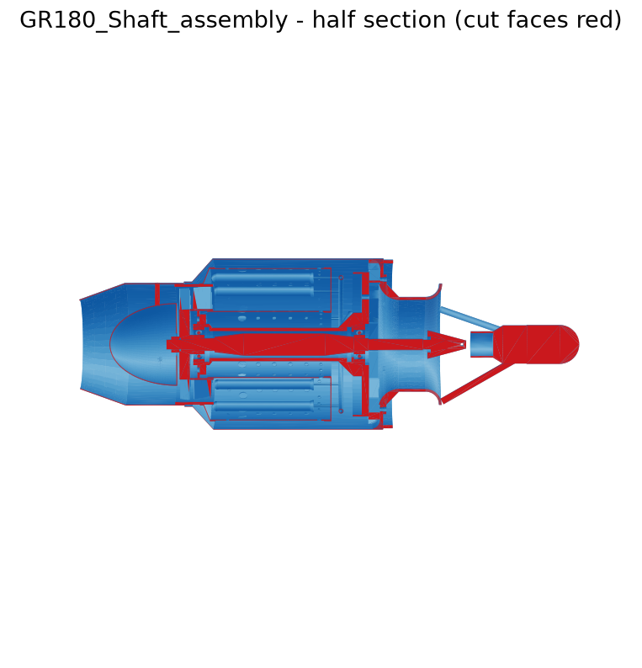
previews/GR180_Shaft_assembly_section.png
