ahmadreza221/aurora-cchp/electronics/b1_ecu/out/b1_ecu.pdf

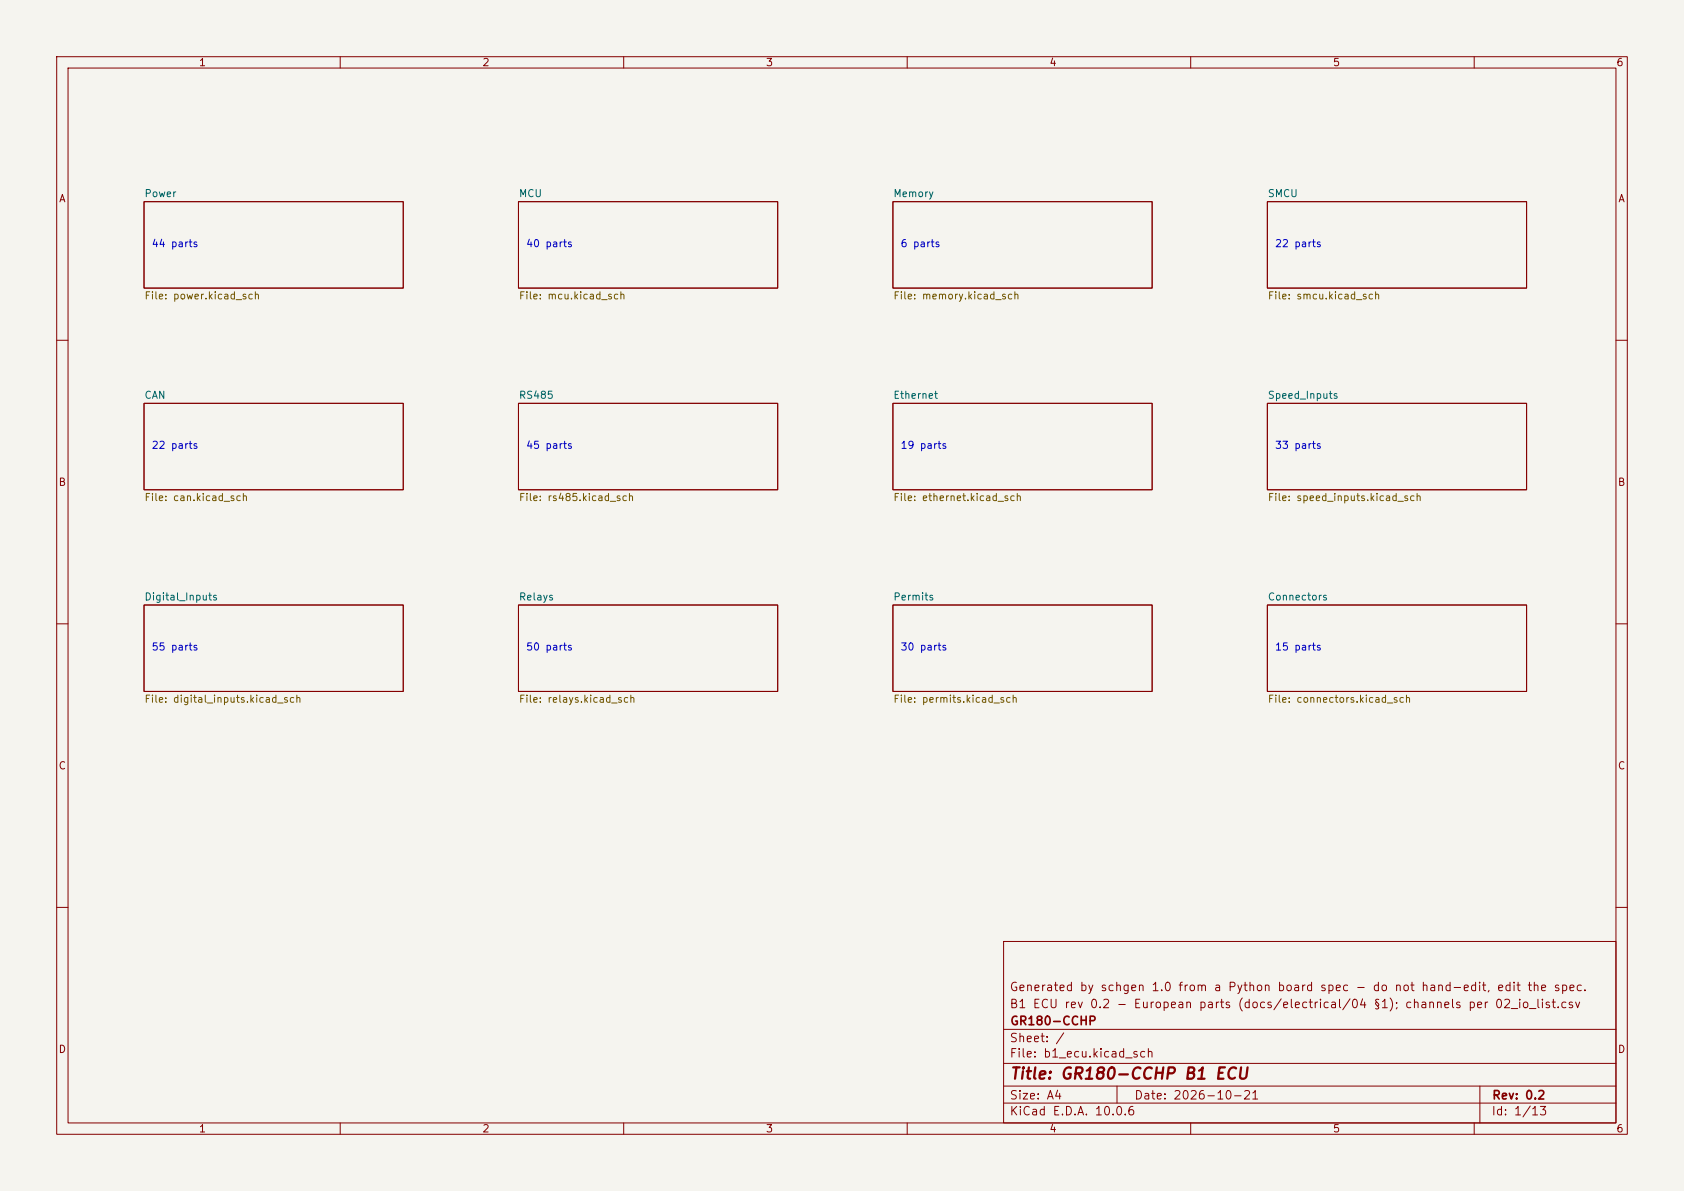
[picture p186: page 1]

Power File: power.kicad_sch CAN

File: smcu.kicad_sch Speed_Inputs File: speed_inputs.kicad_sch Connectors File: connectors.kicad_sch MCU

Generated by schgen 1.0 from a Python board spec - do not hand-edit, edit the spec.
B1 ECU rev 0.2 - European parts (docs/electrical/04 §1); channels per 02_io_list.csv
GR180-CCHP
Sheet: /
File: b1_ecu.kicad_sch
Title: GR180-CCHP B1 ECU

Size: A4 | Rev: 0.2
KiCad E.D.A. 10.0.6 | Id: 1/13

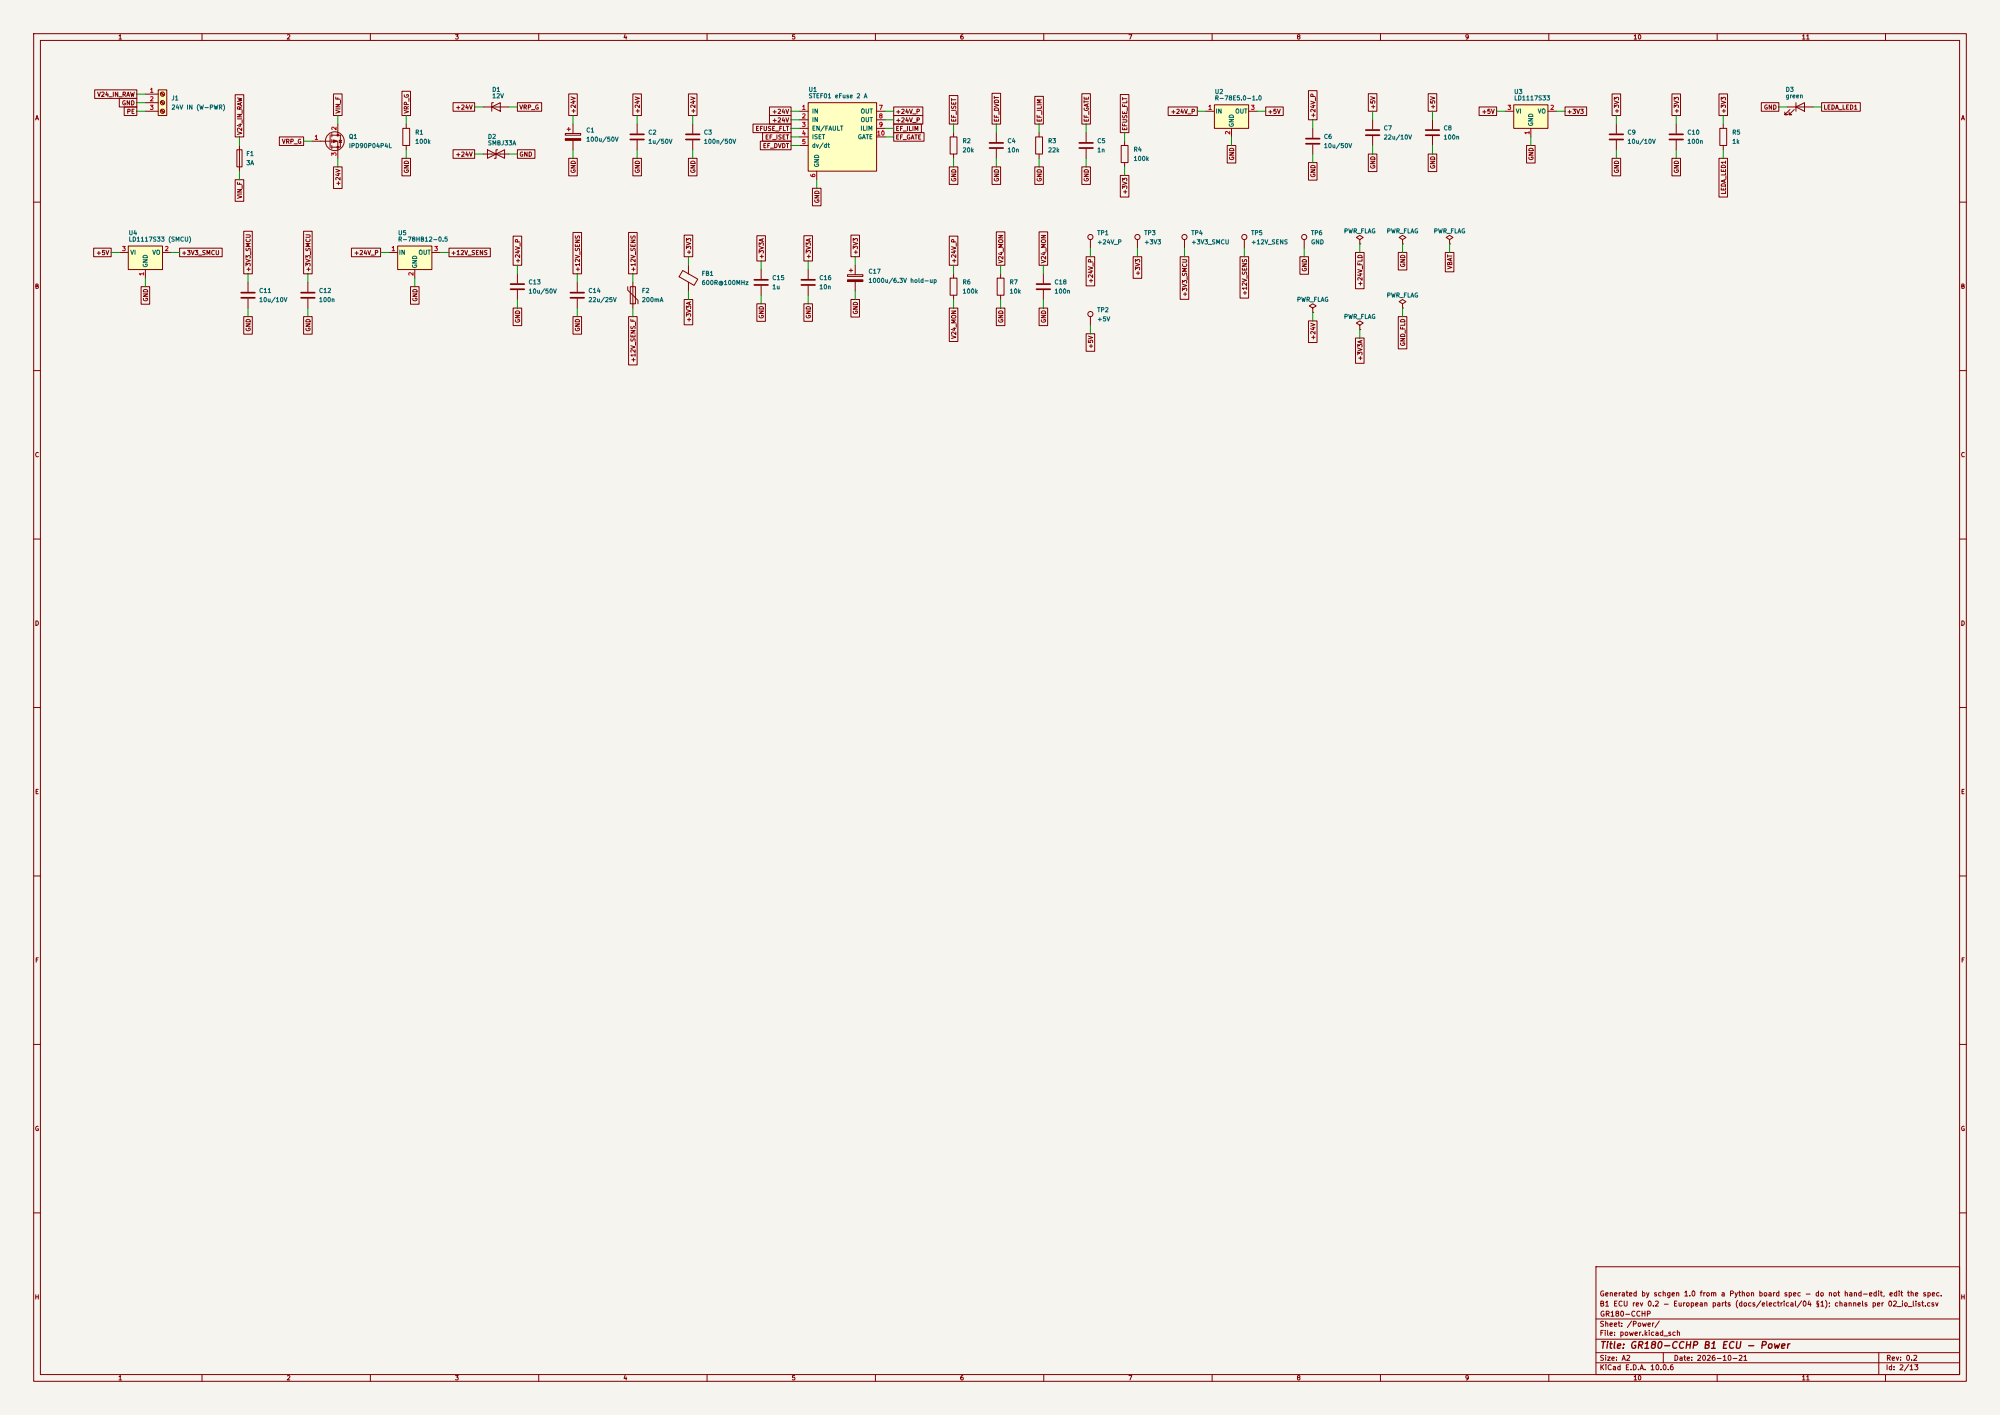
[picture p187: page 2]

Generated by schgen 1.0 from a Python board spec - do not hand-edit, edit the spec.
B1 ECU rev 0.2 - European parts (docs/electrical/04 §1); channels per 02_io_list.csv
GR180-CCHP
Sheet: /Power/
File: power.kicad_sch
Title: GR180-CCHP B1 ECU - Power

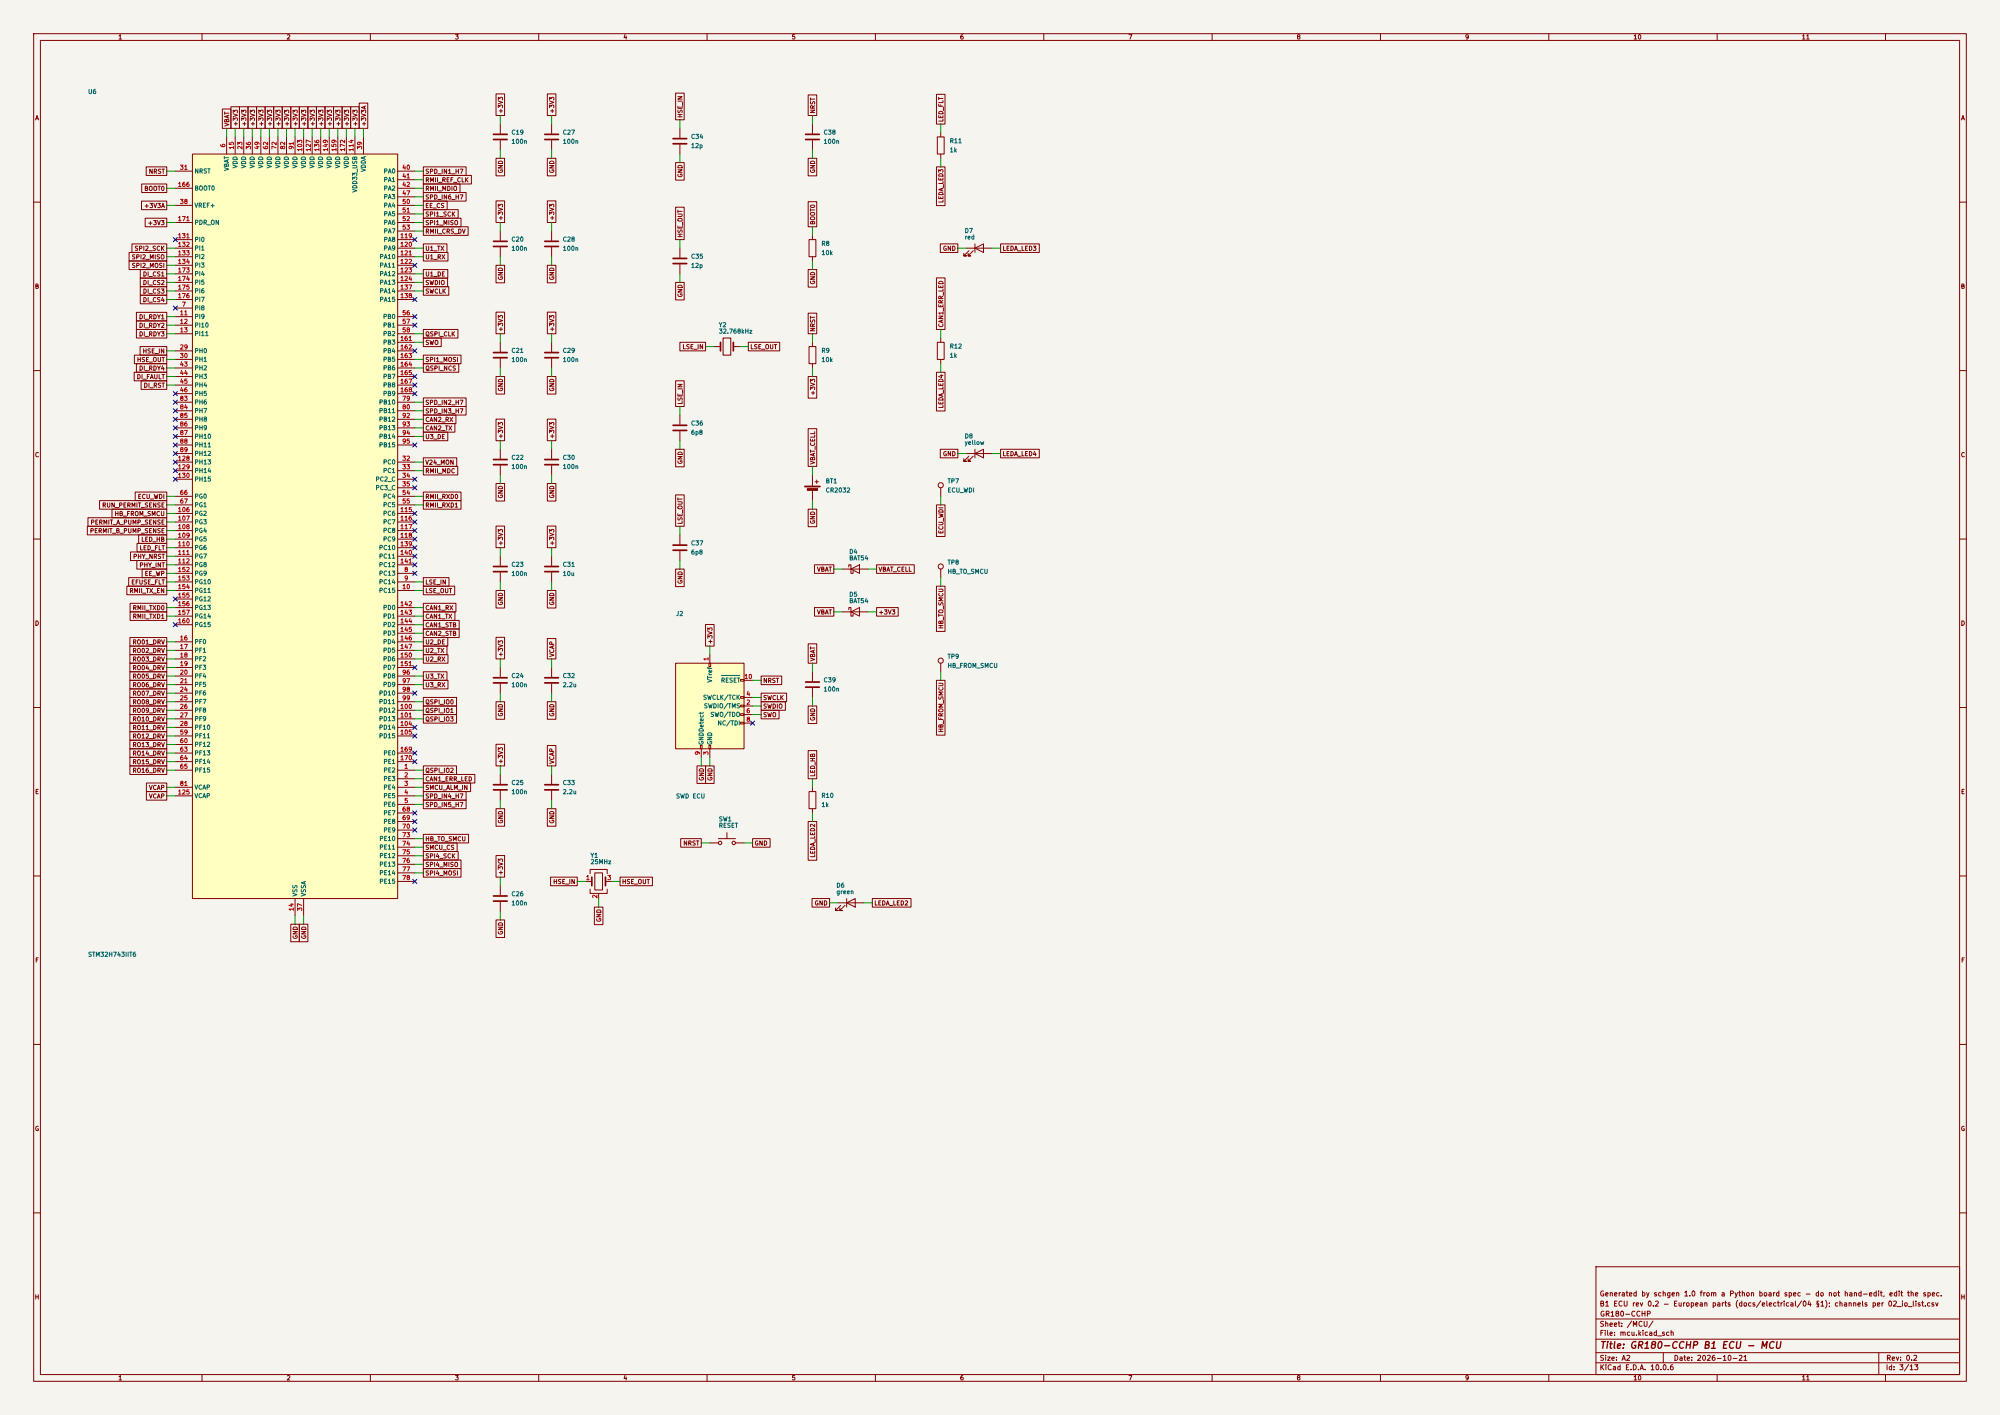
[picture p188: page 3]

Sheet: /MCU/
File: mcu.kicad_sch
Title: GR180-CCHP B1 ECU - MCU

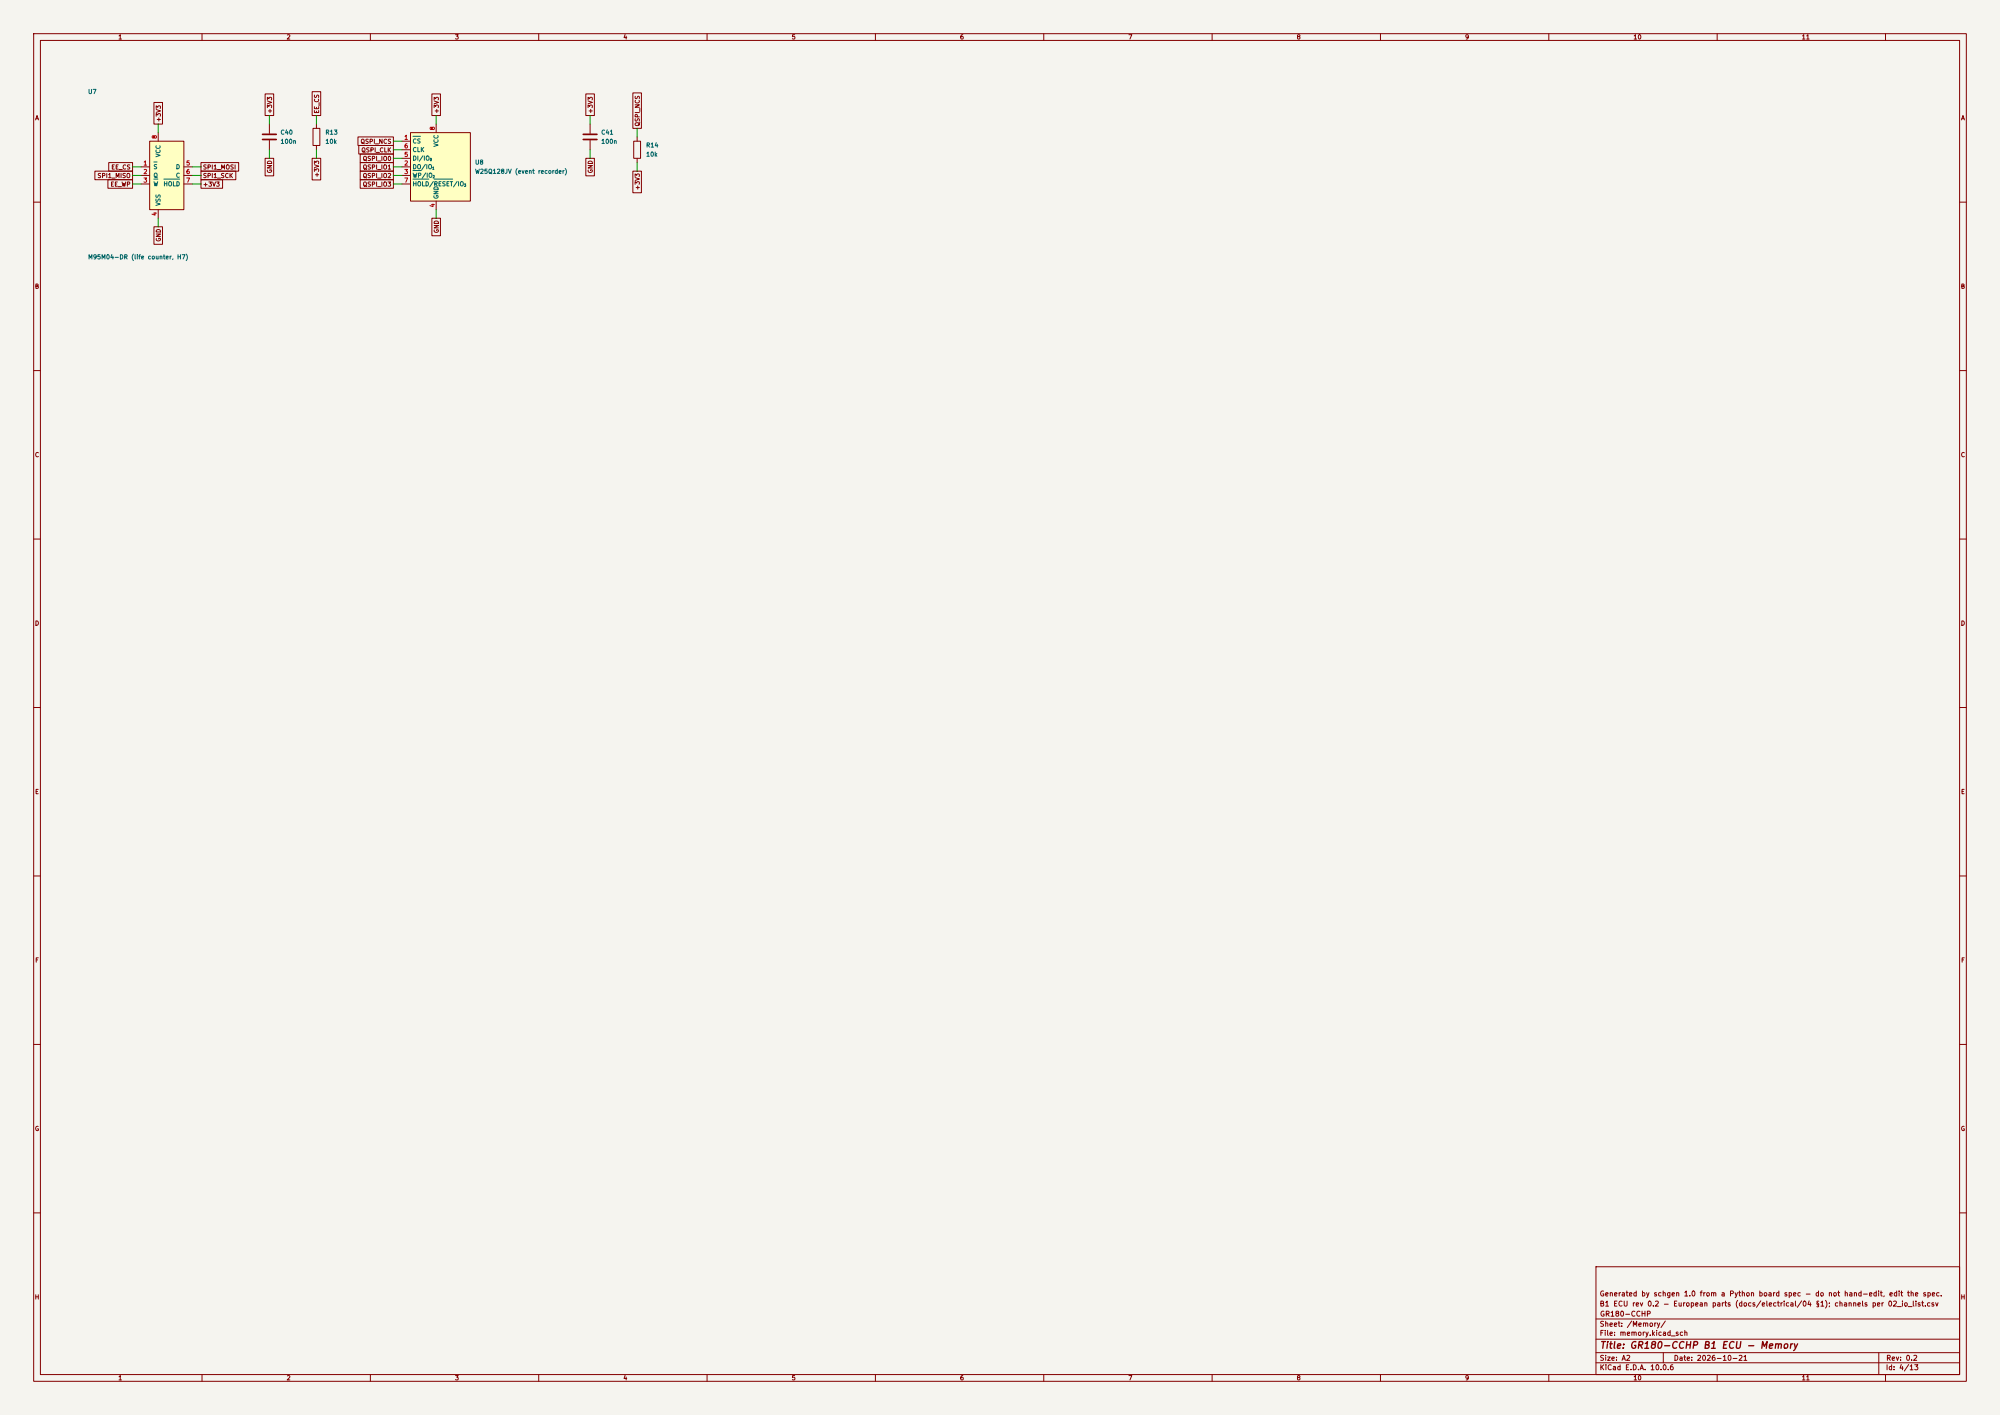
[picture p189: page 4]

4 DI/IO0 5 CLK 6 HOLD/RESET/IO3 7 VCC

Sheet: /Memory/
File: memory.kicad_sch
Title: GR180-CCHP B1 ECU - Memory

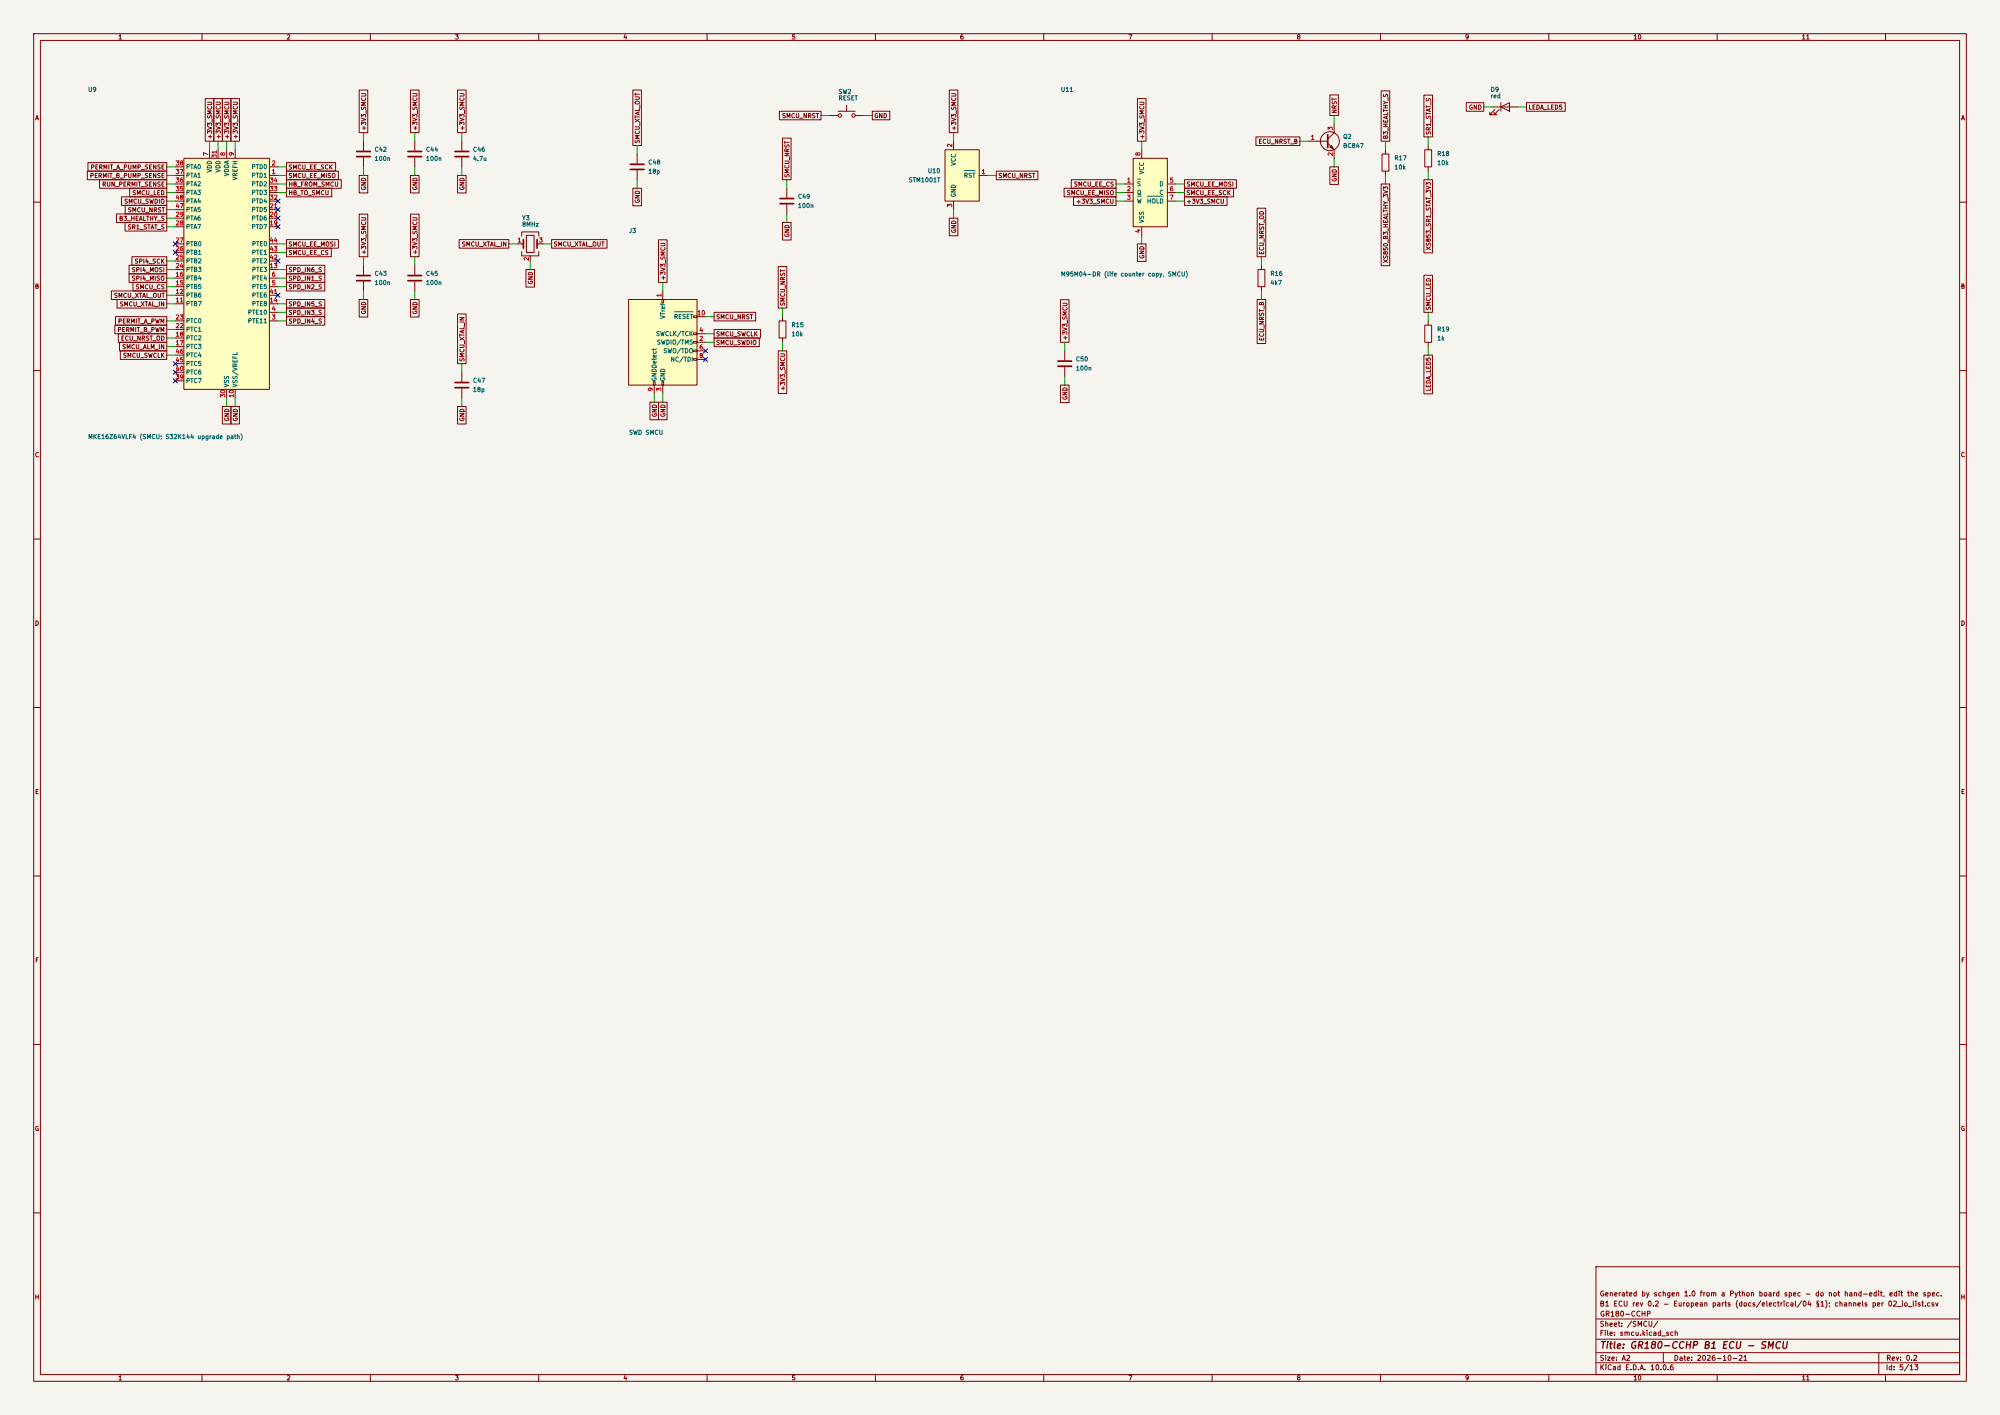
[picture p190: page 5]

9 VSS/VREFL 10 PTB7 11 PTB6 12 PTE3 13 PTE8 14 PTB5 15 PTB4 16 PTC3 17 PTC2 18 PTD7 19 PTD6 20 PTD5 21 PTC1 22 PTC0 23 PTB3 24 PTB2 25 PTB1 26 PTB0 27 PTA7 28 PTA6 29 VSS 30 VDD 31 PTD4 32 PTD3 33 PTD2 34 PTA3 35 PTA2 36 PTA1 37 PTA0 38 PTC7 39 PTC6 40 PTE6 41 PTE2 42 PTE1 43 PTE0 44 PTC5 45 PTC4 46 PTA5 47 PTA4 48 U9MKE16Z64VLF4 (SMCU; S32K144 upgrade path) SPD_IN3_S

8 U11 M95M04-DR (life counter copy, SMCU) C50

Sheet: /SMCU/
File: smcu.kicad_sch
Title: GR180-CCHP B1 ECU - SMCU

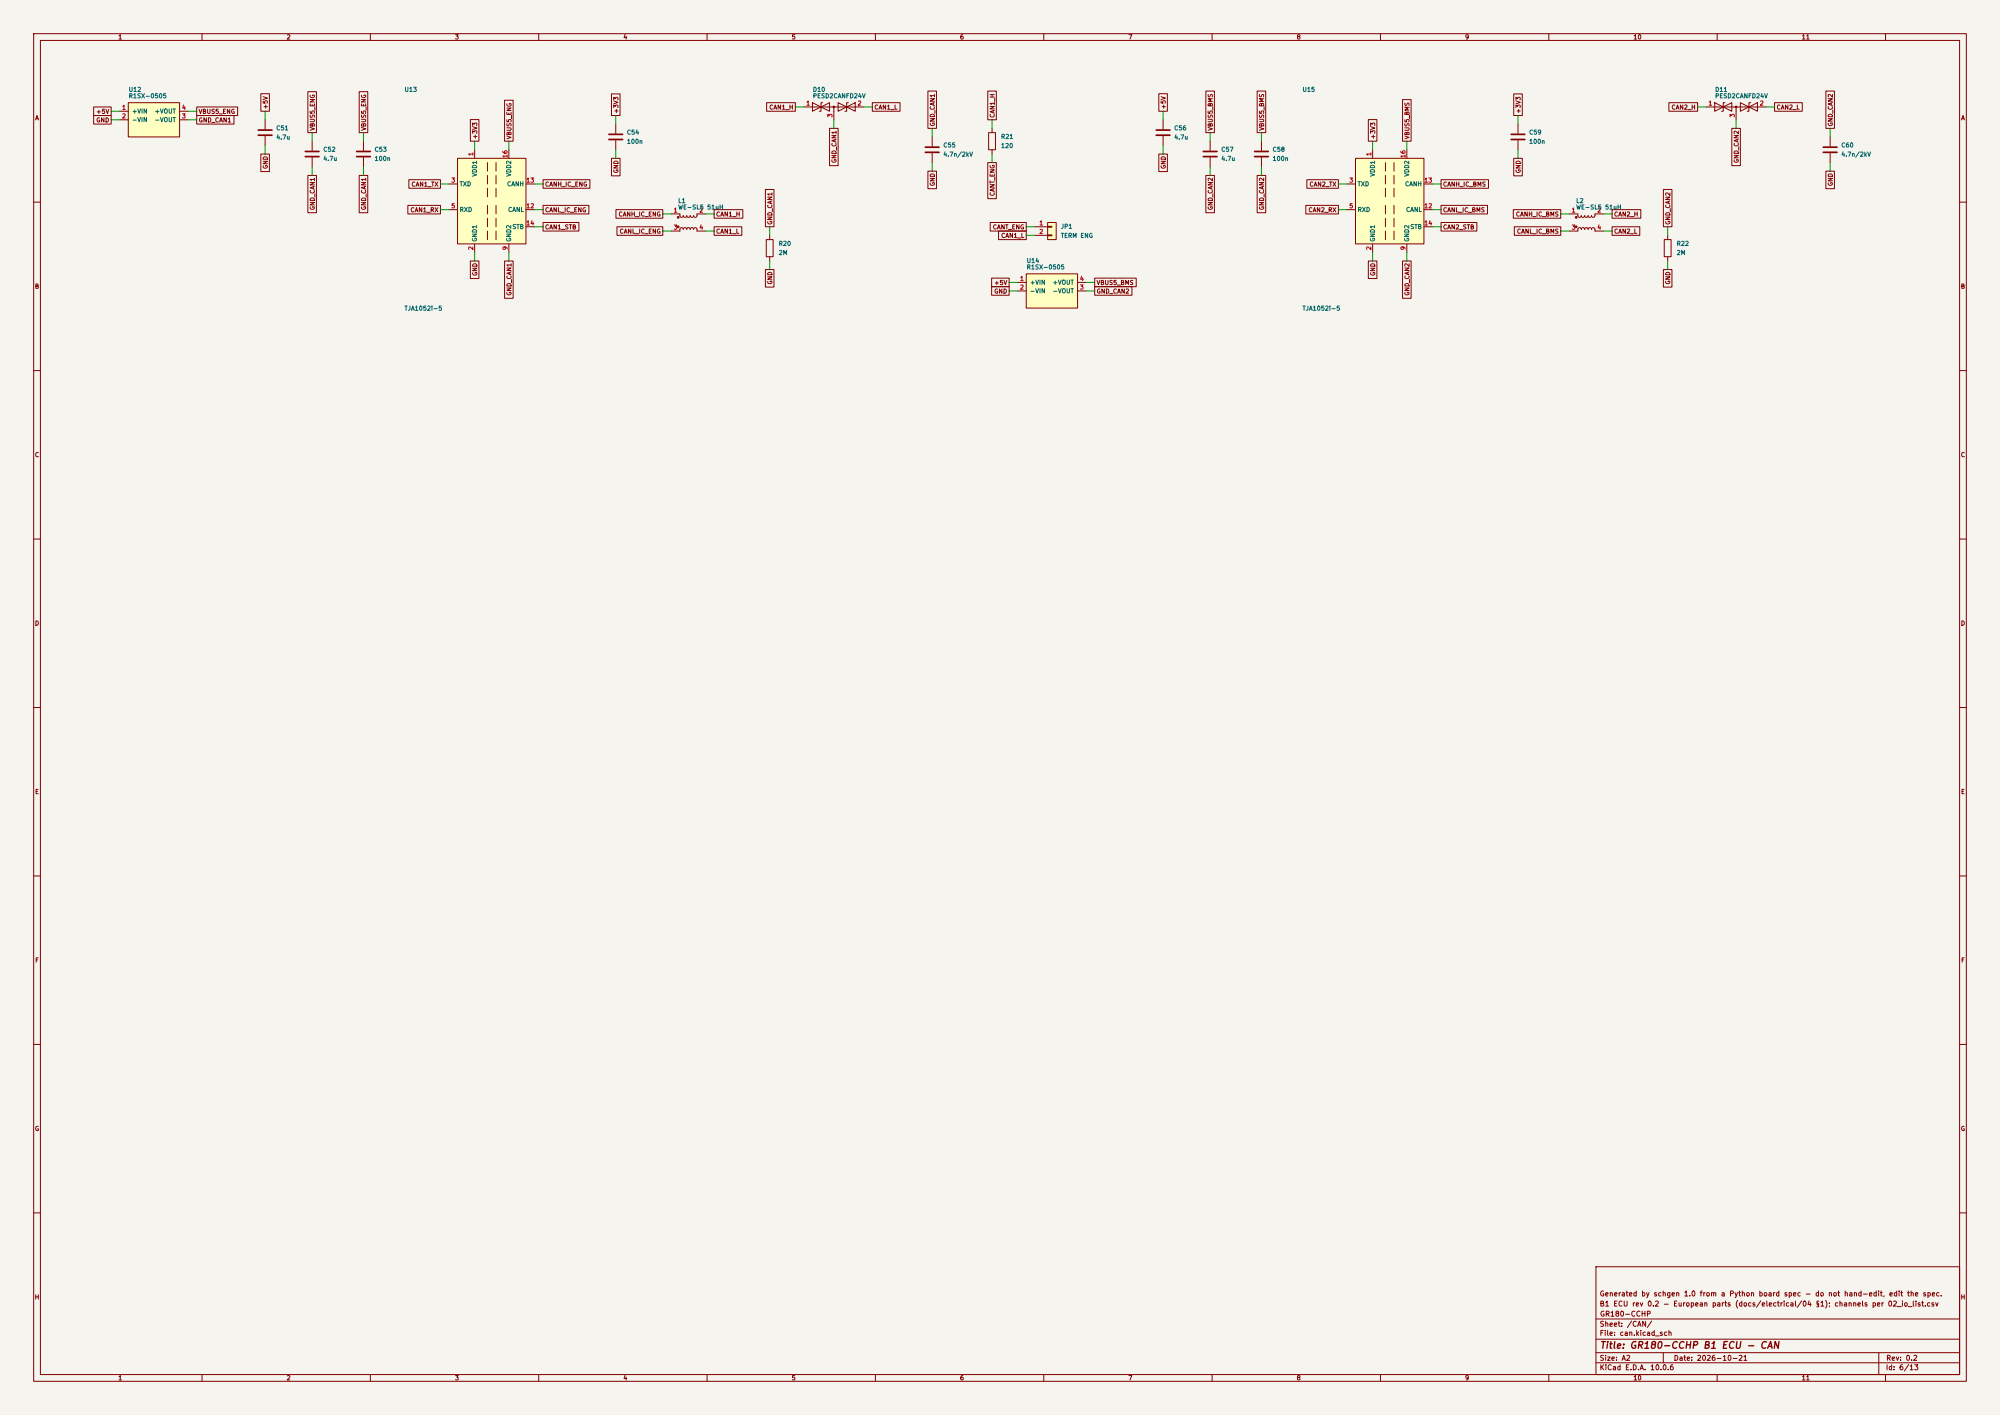
[picture p191: page 6]

Sheet: /CAN/
File: can.kicad_sch
Title: GR180-CCHP B1 ECU - CAN

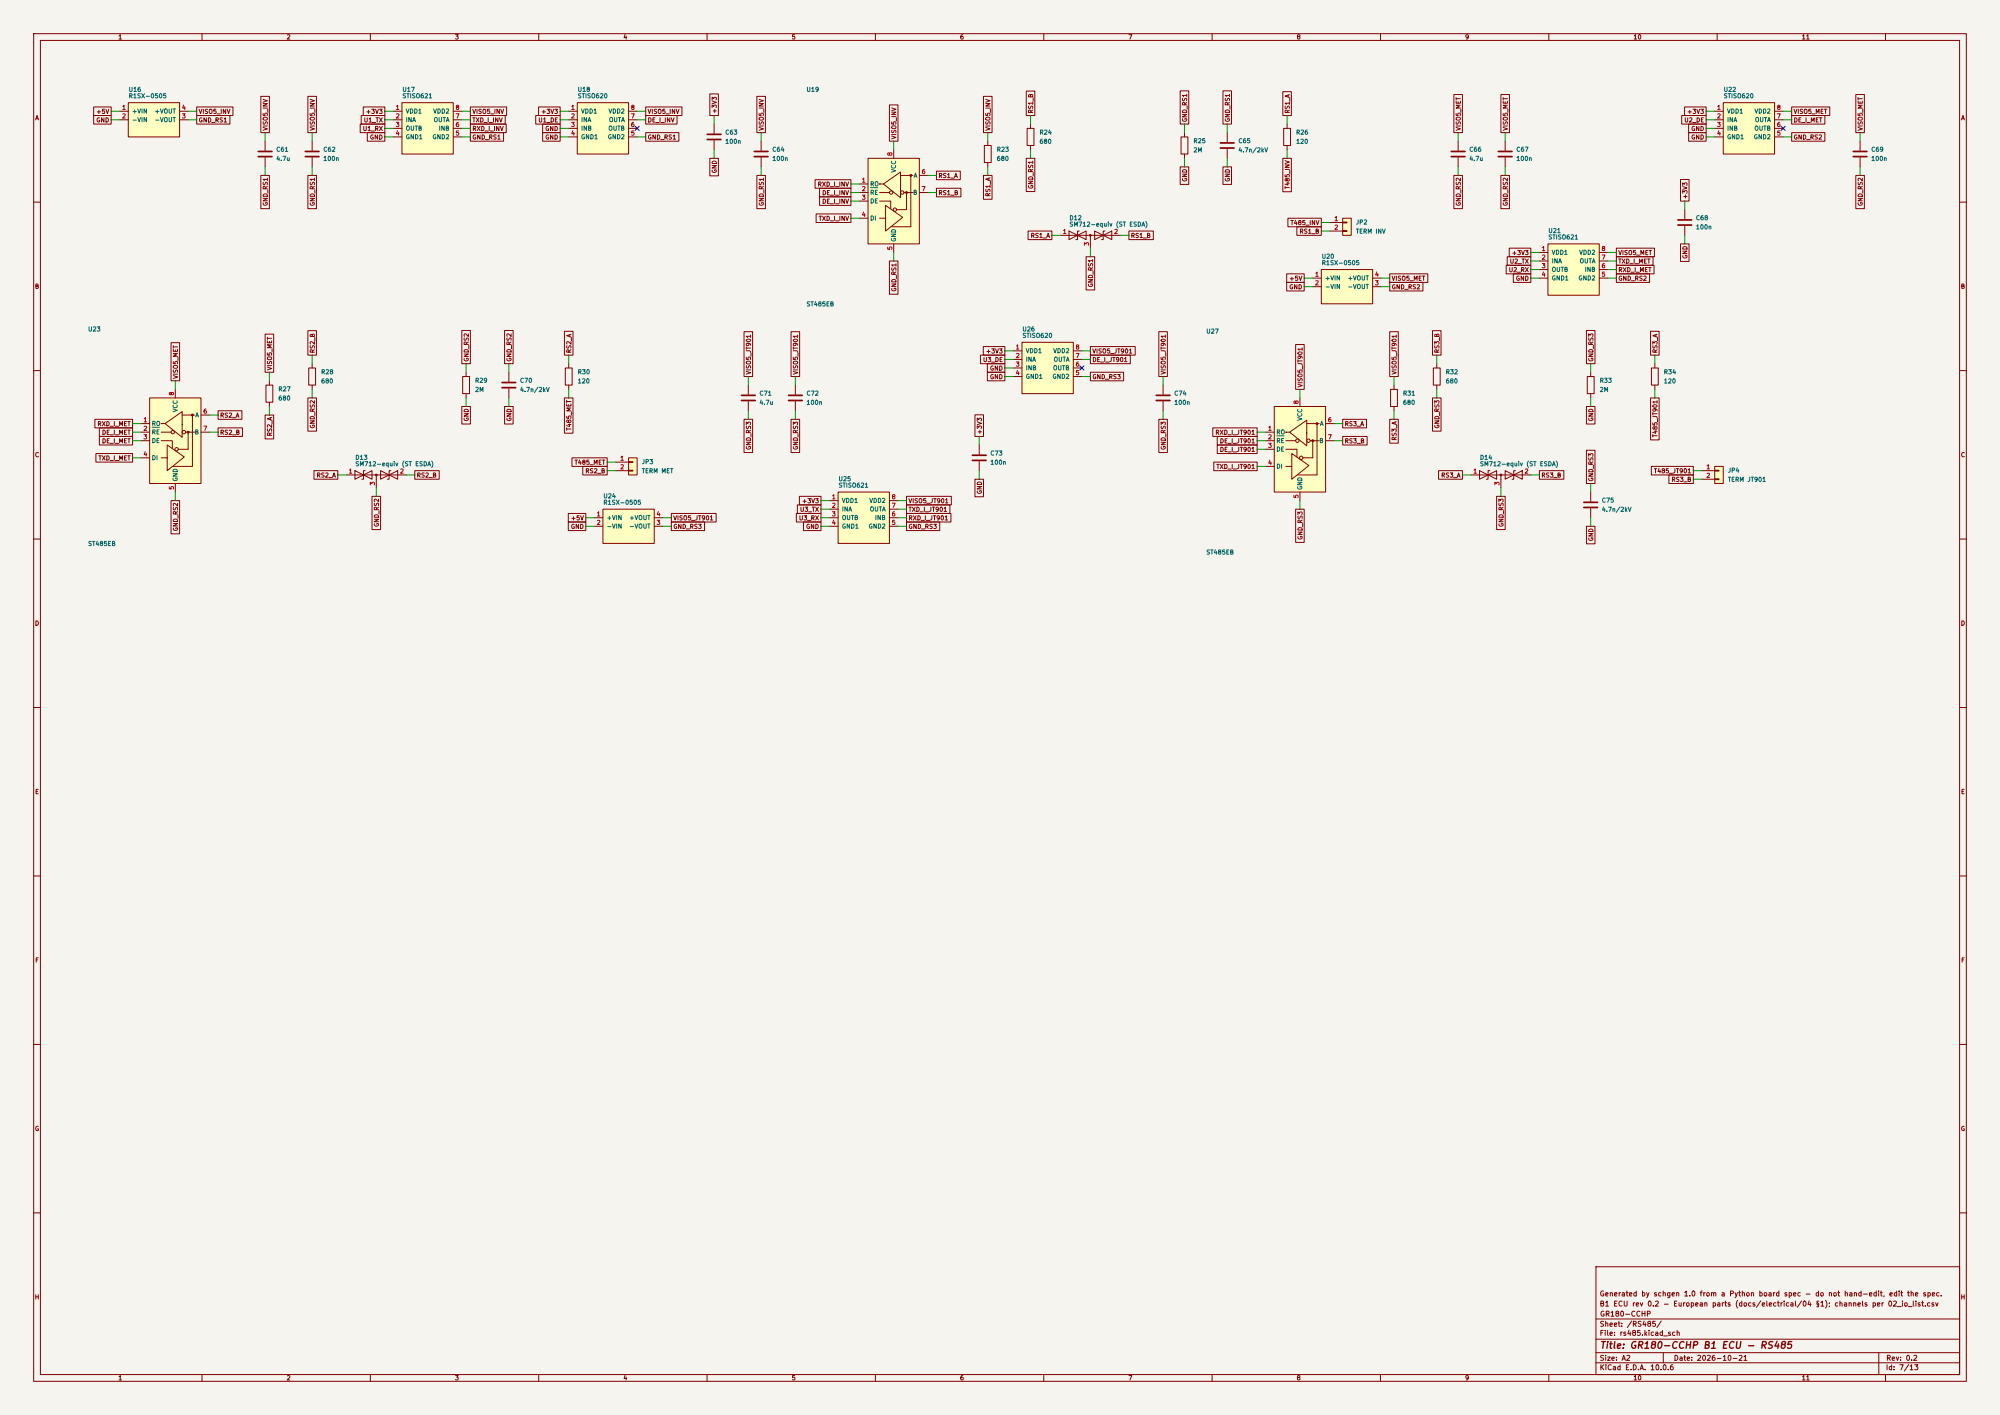
[picture p192: page 7]

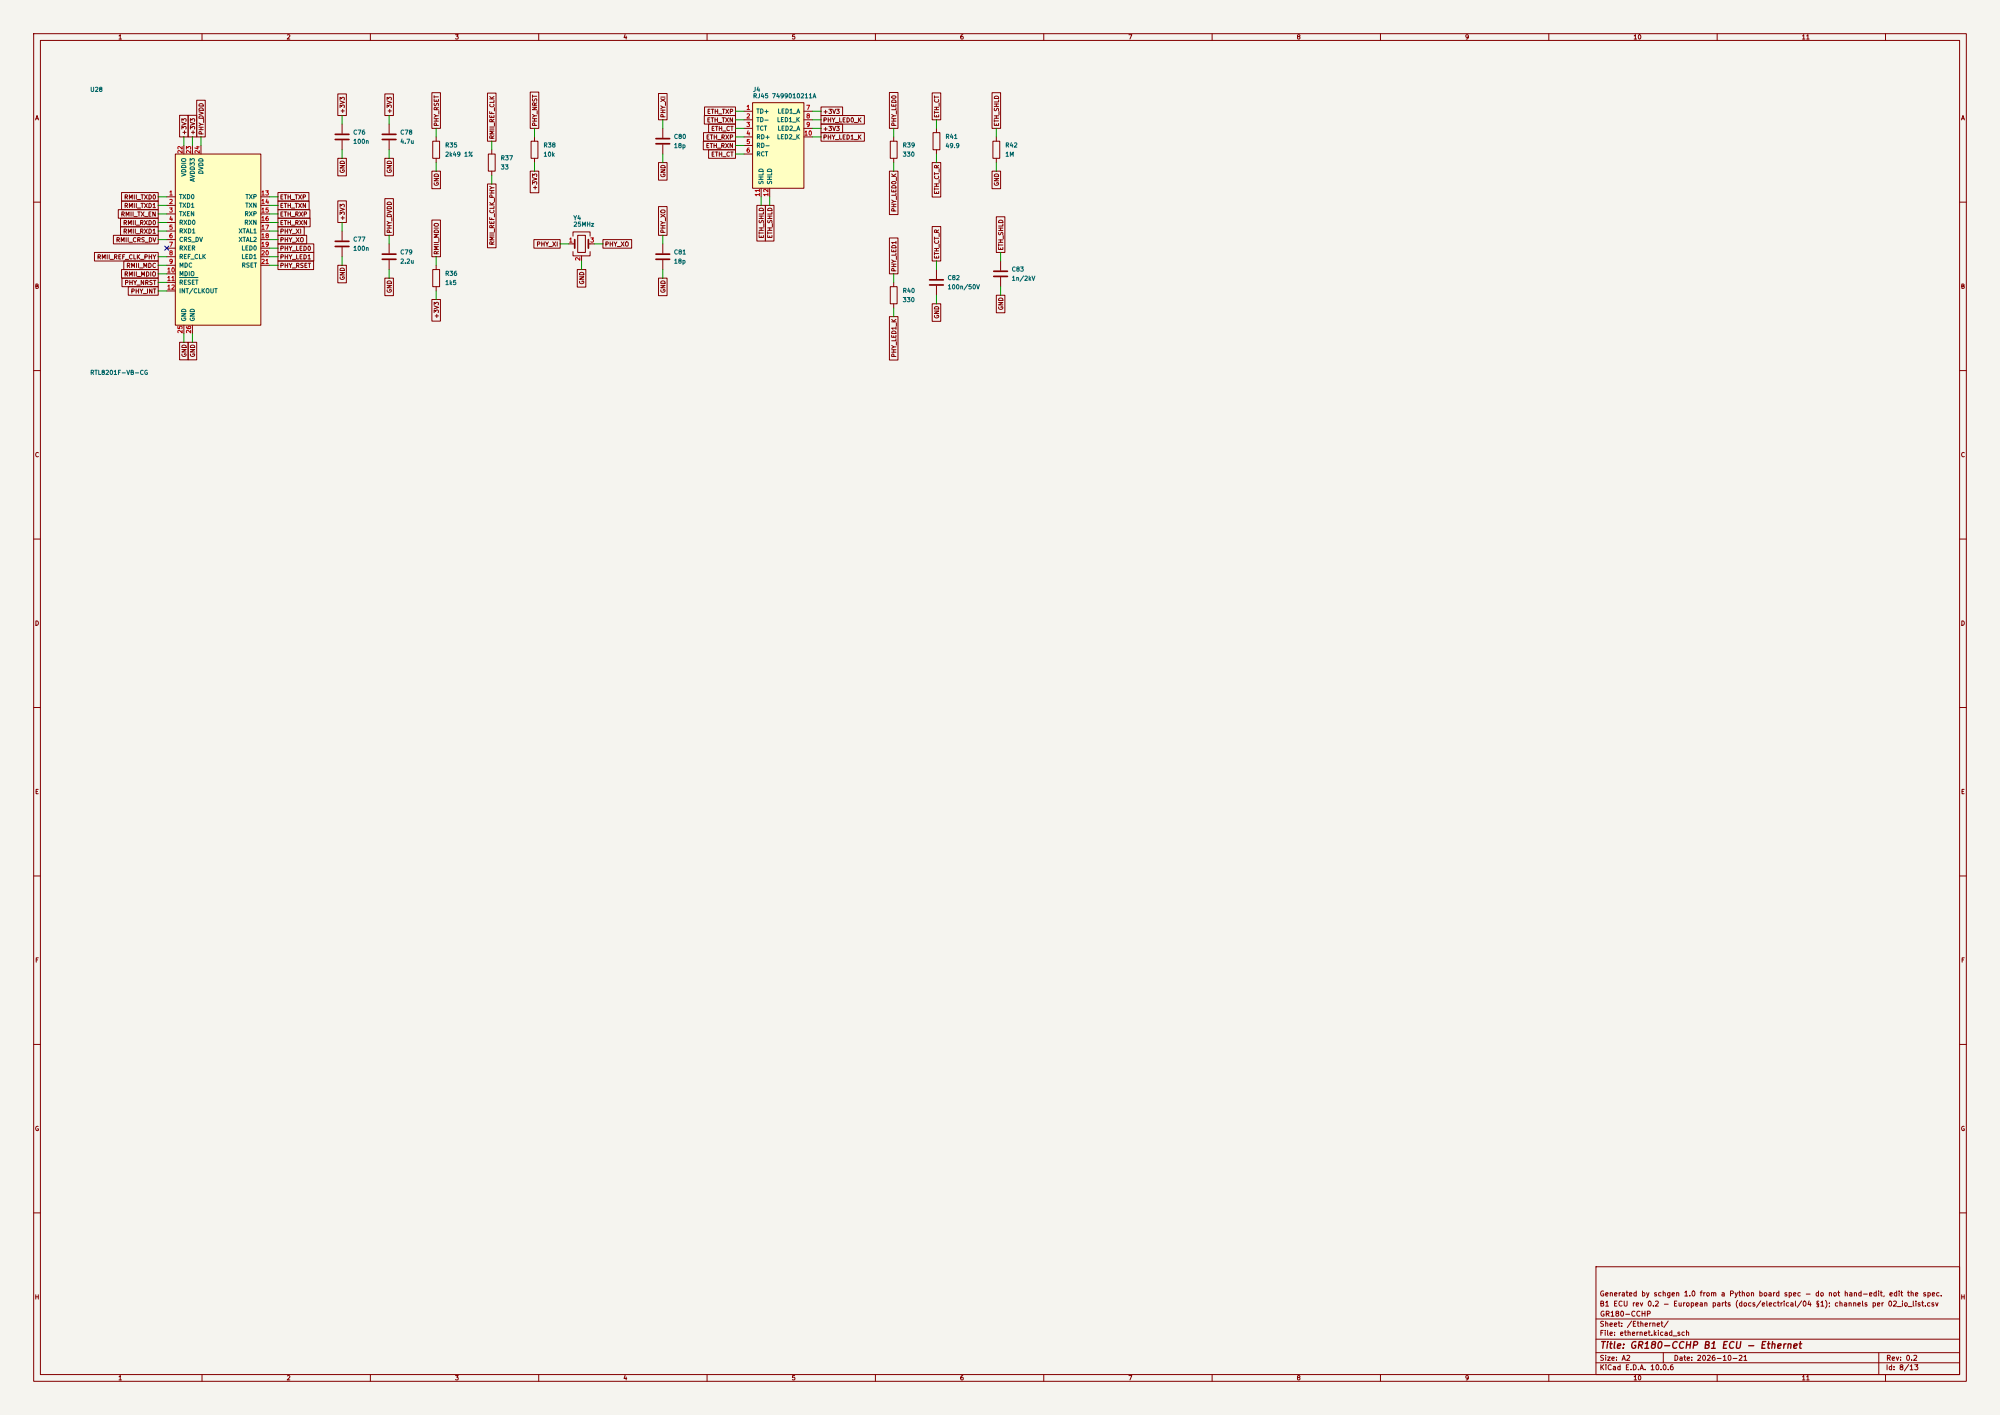
[picture p193: page 8]

Sheet: /Ethernet/
File: ethernet.kicad_sch
Title: GR180-CCHP B1 ECU - Ethernet

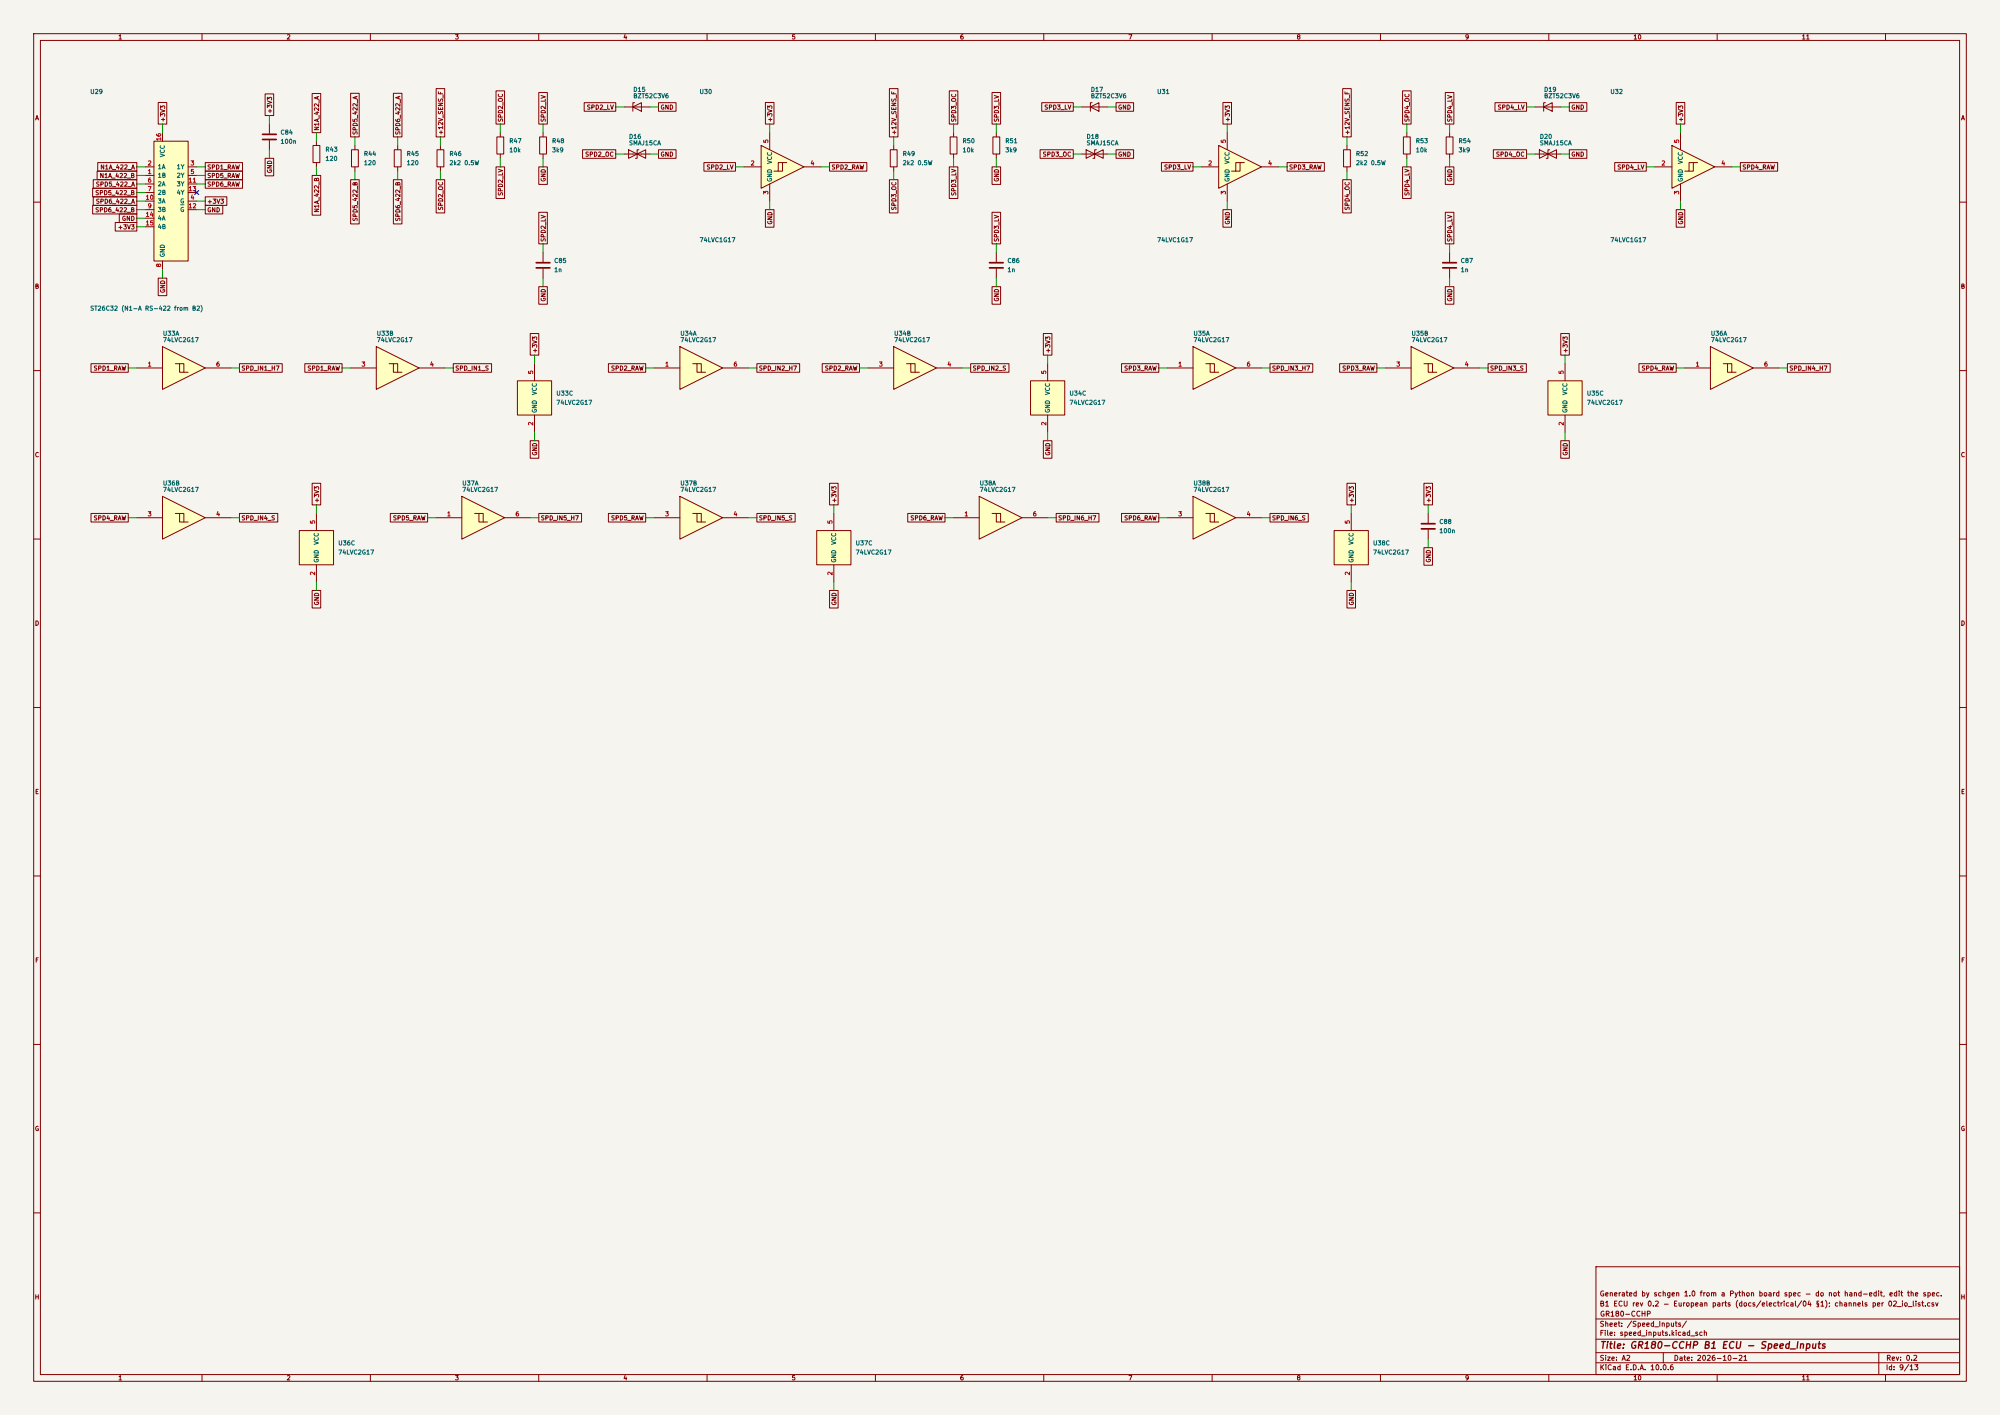
[picture p194: page 9]

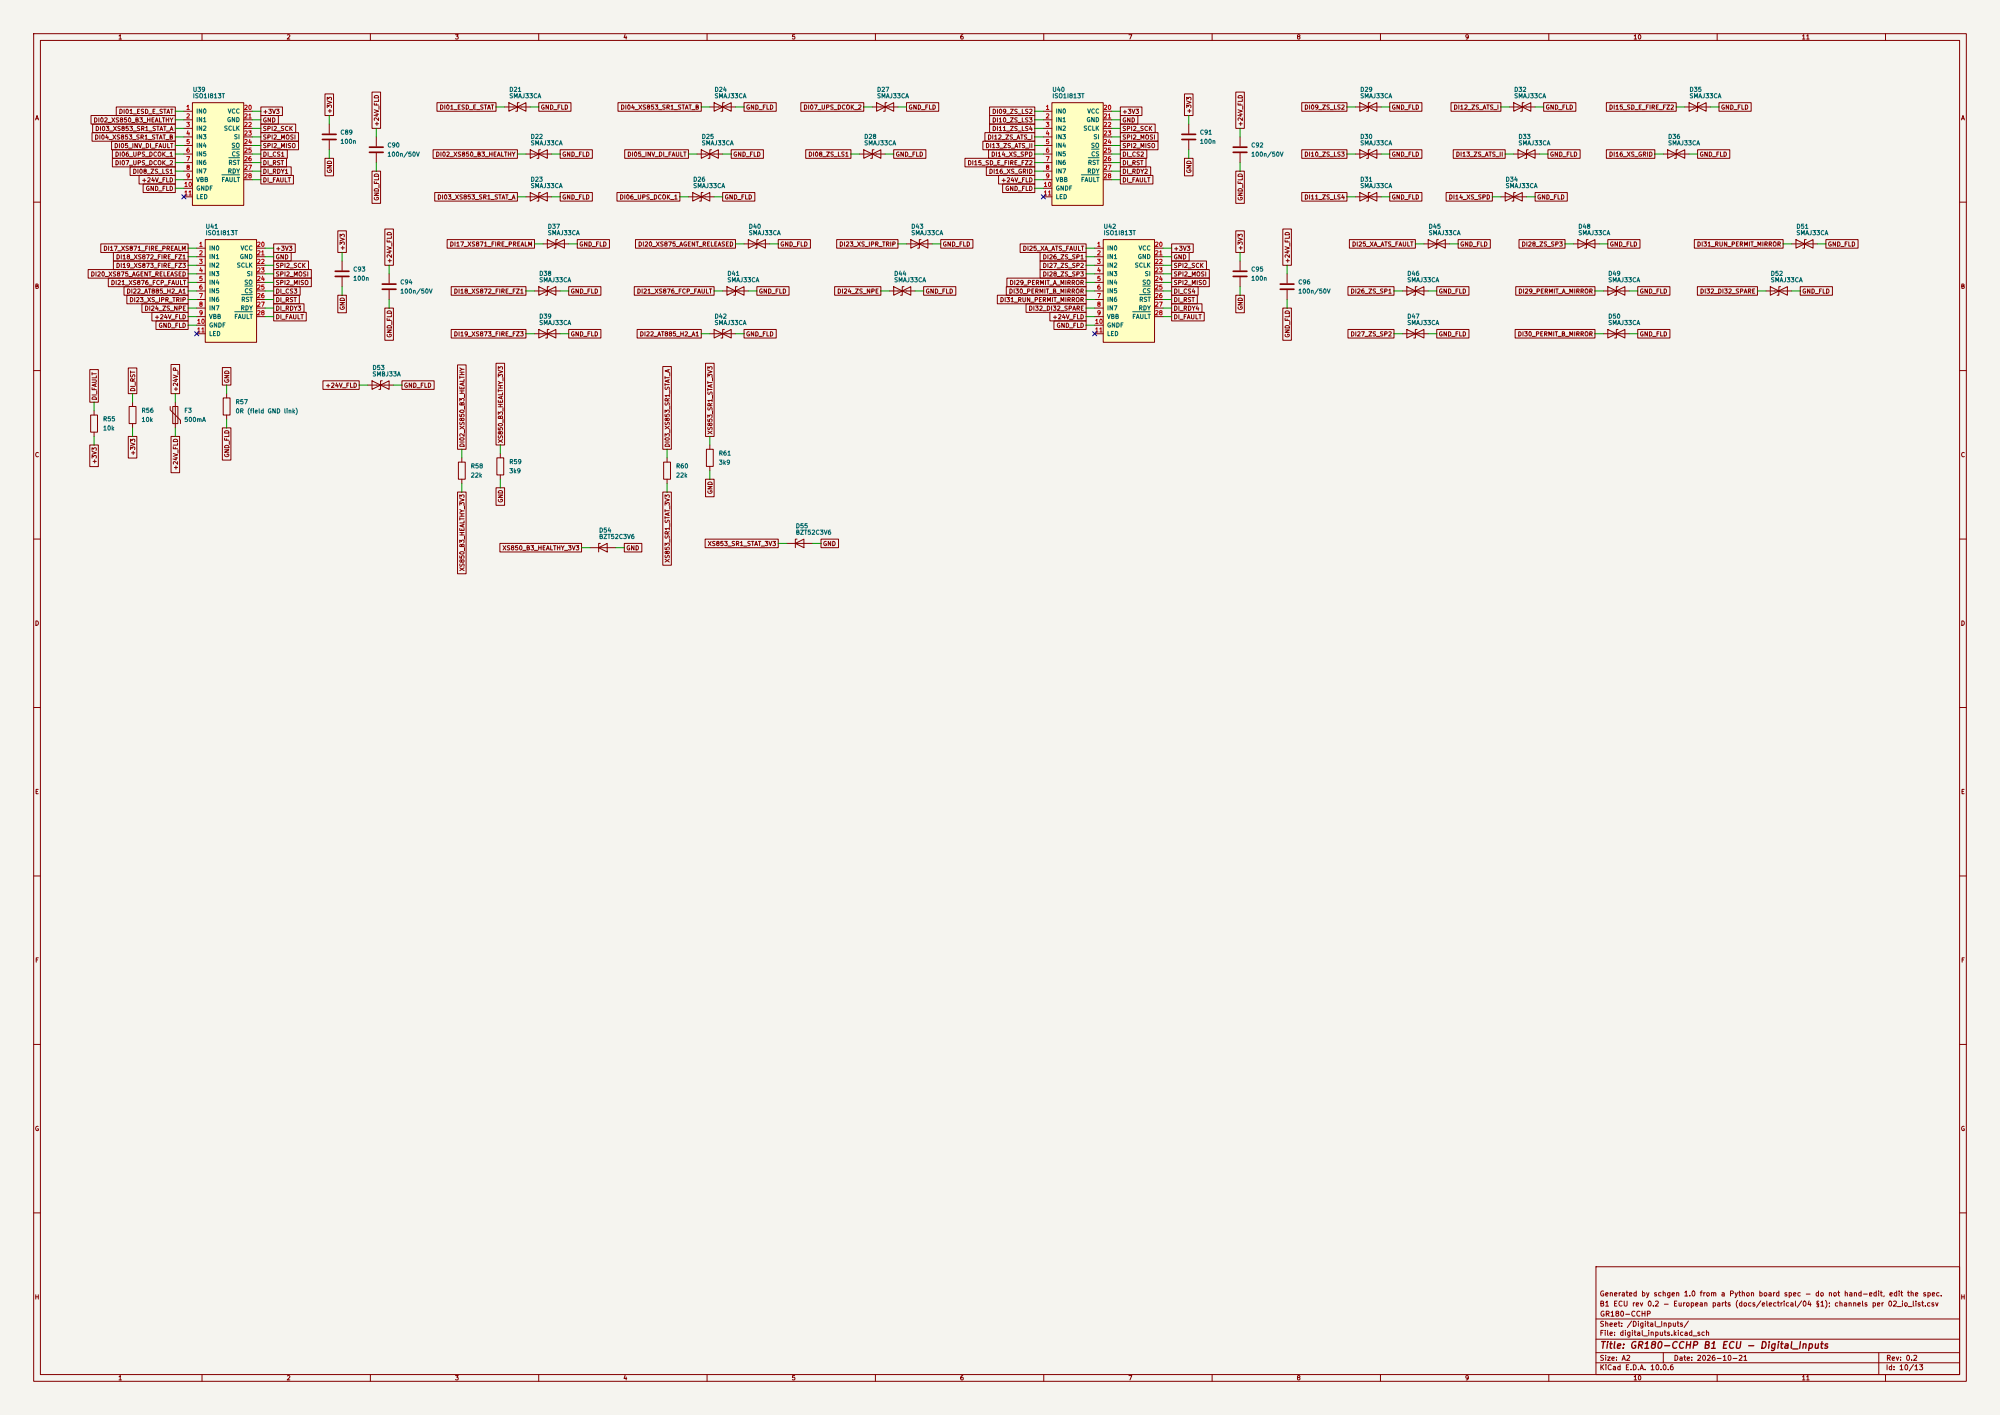
[picture p195: page 10]

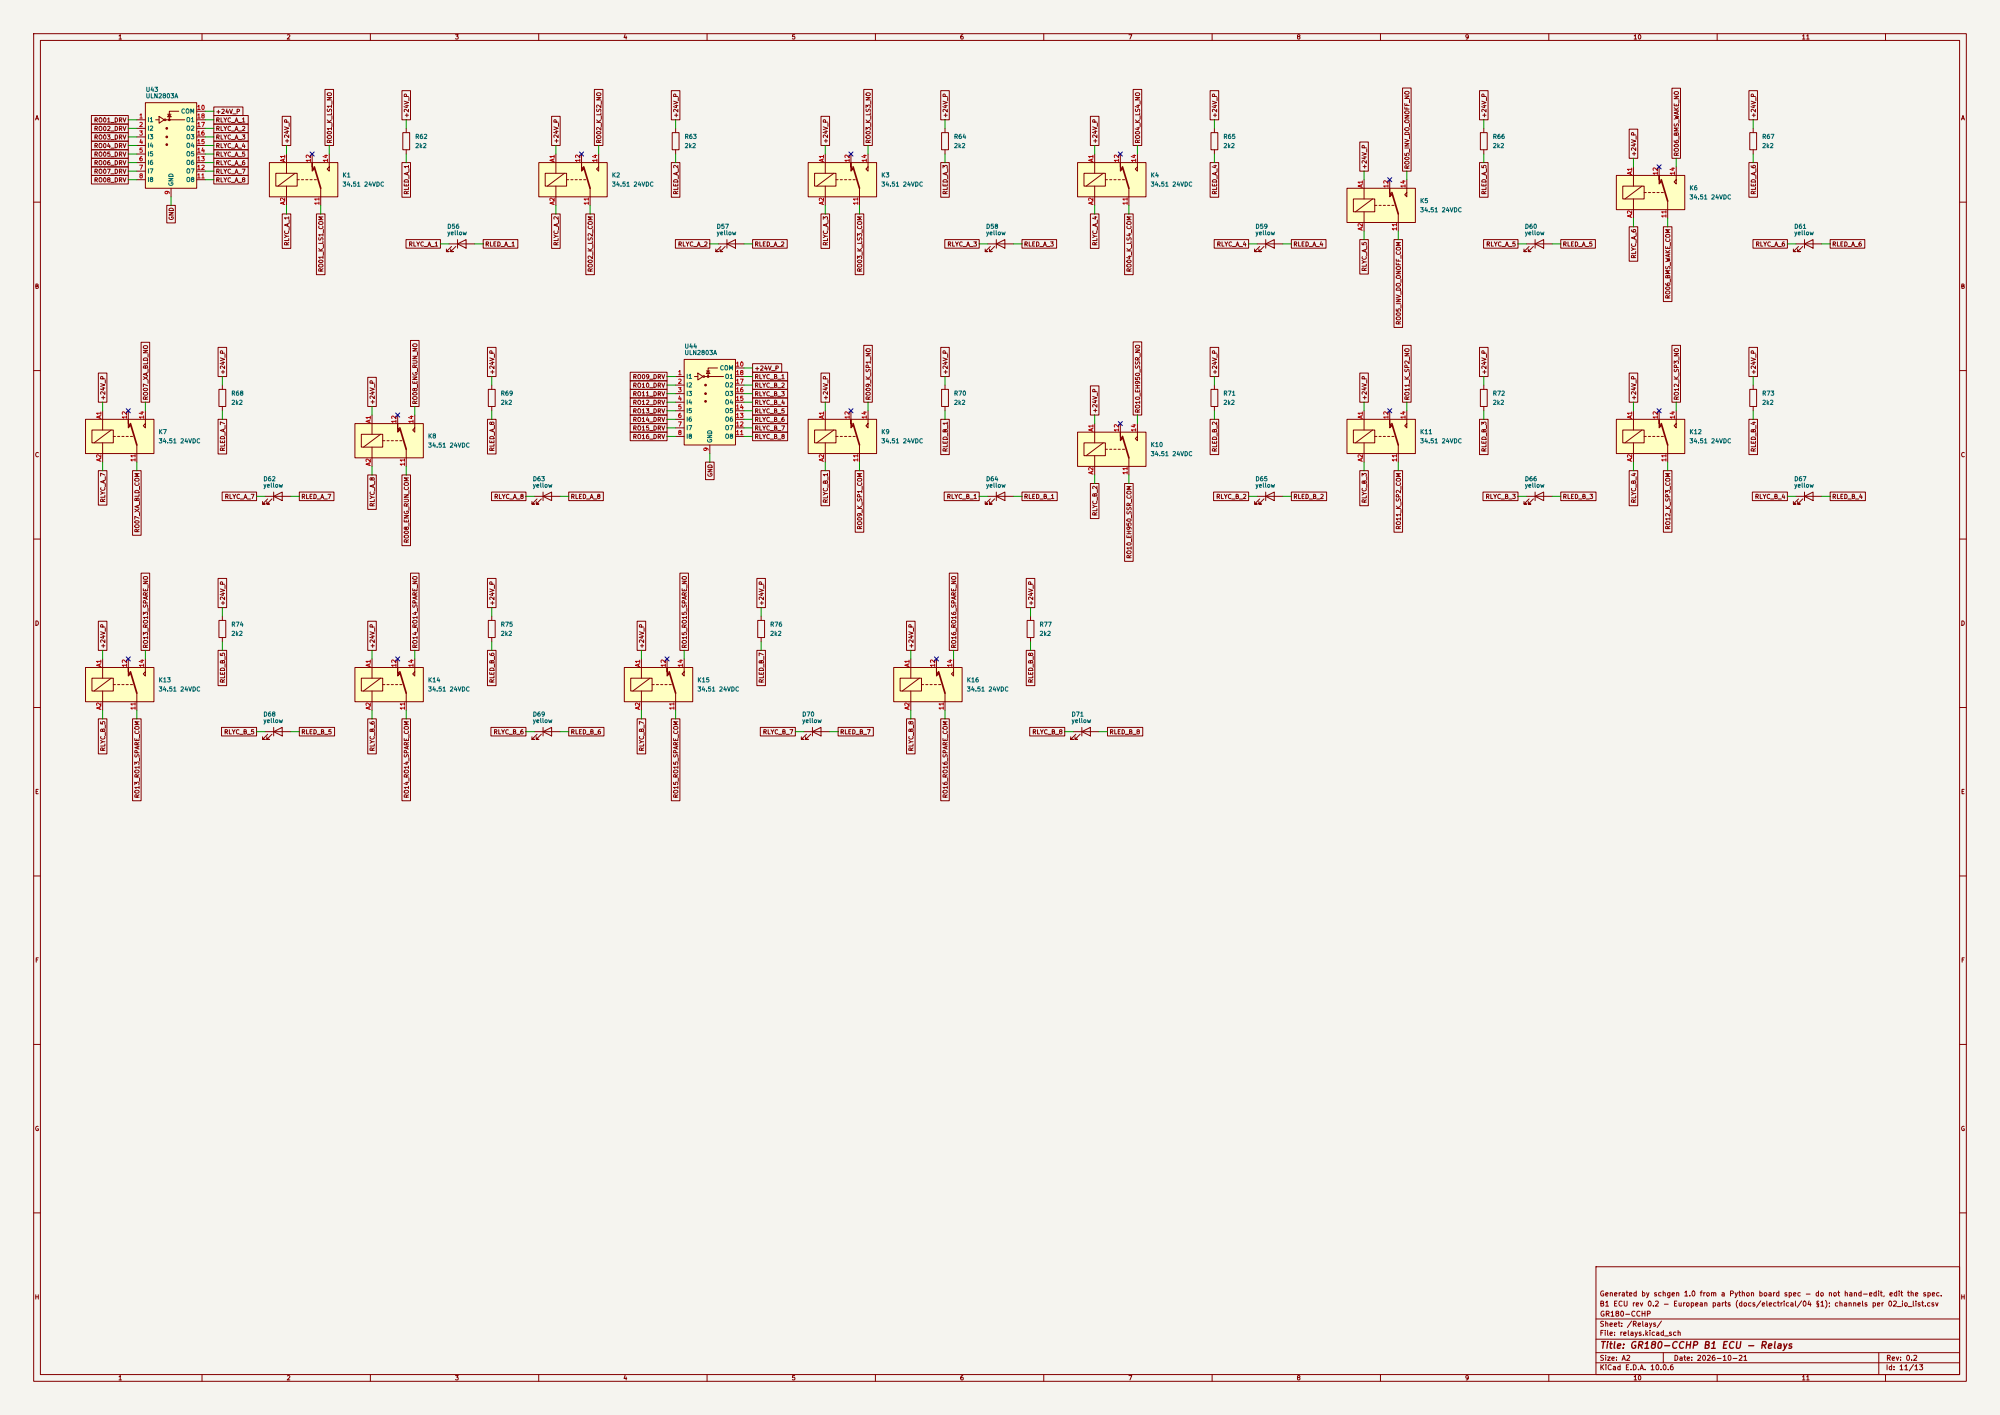
[picture p196: page 11]

Sheet: /Relays/
File: relays.kicad_sch
Title: GR180-CCHP B1 ECU - Relays

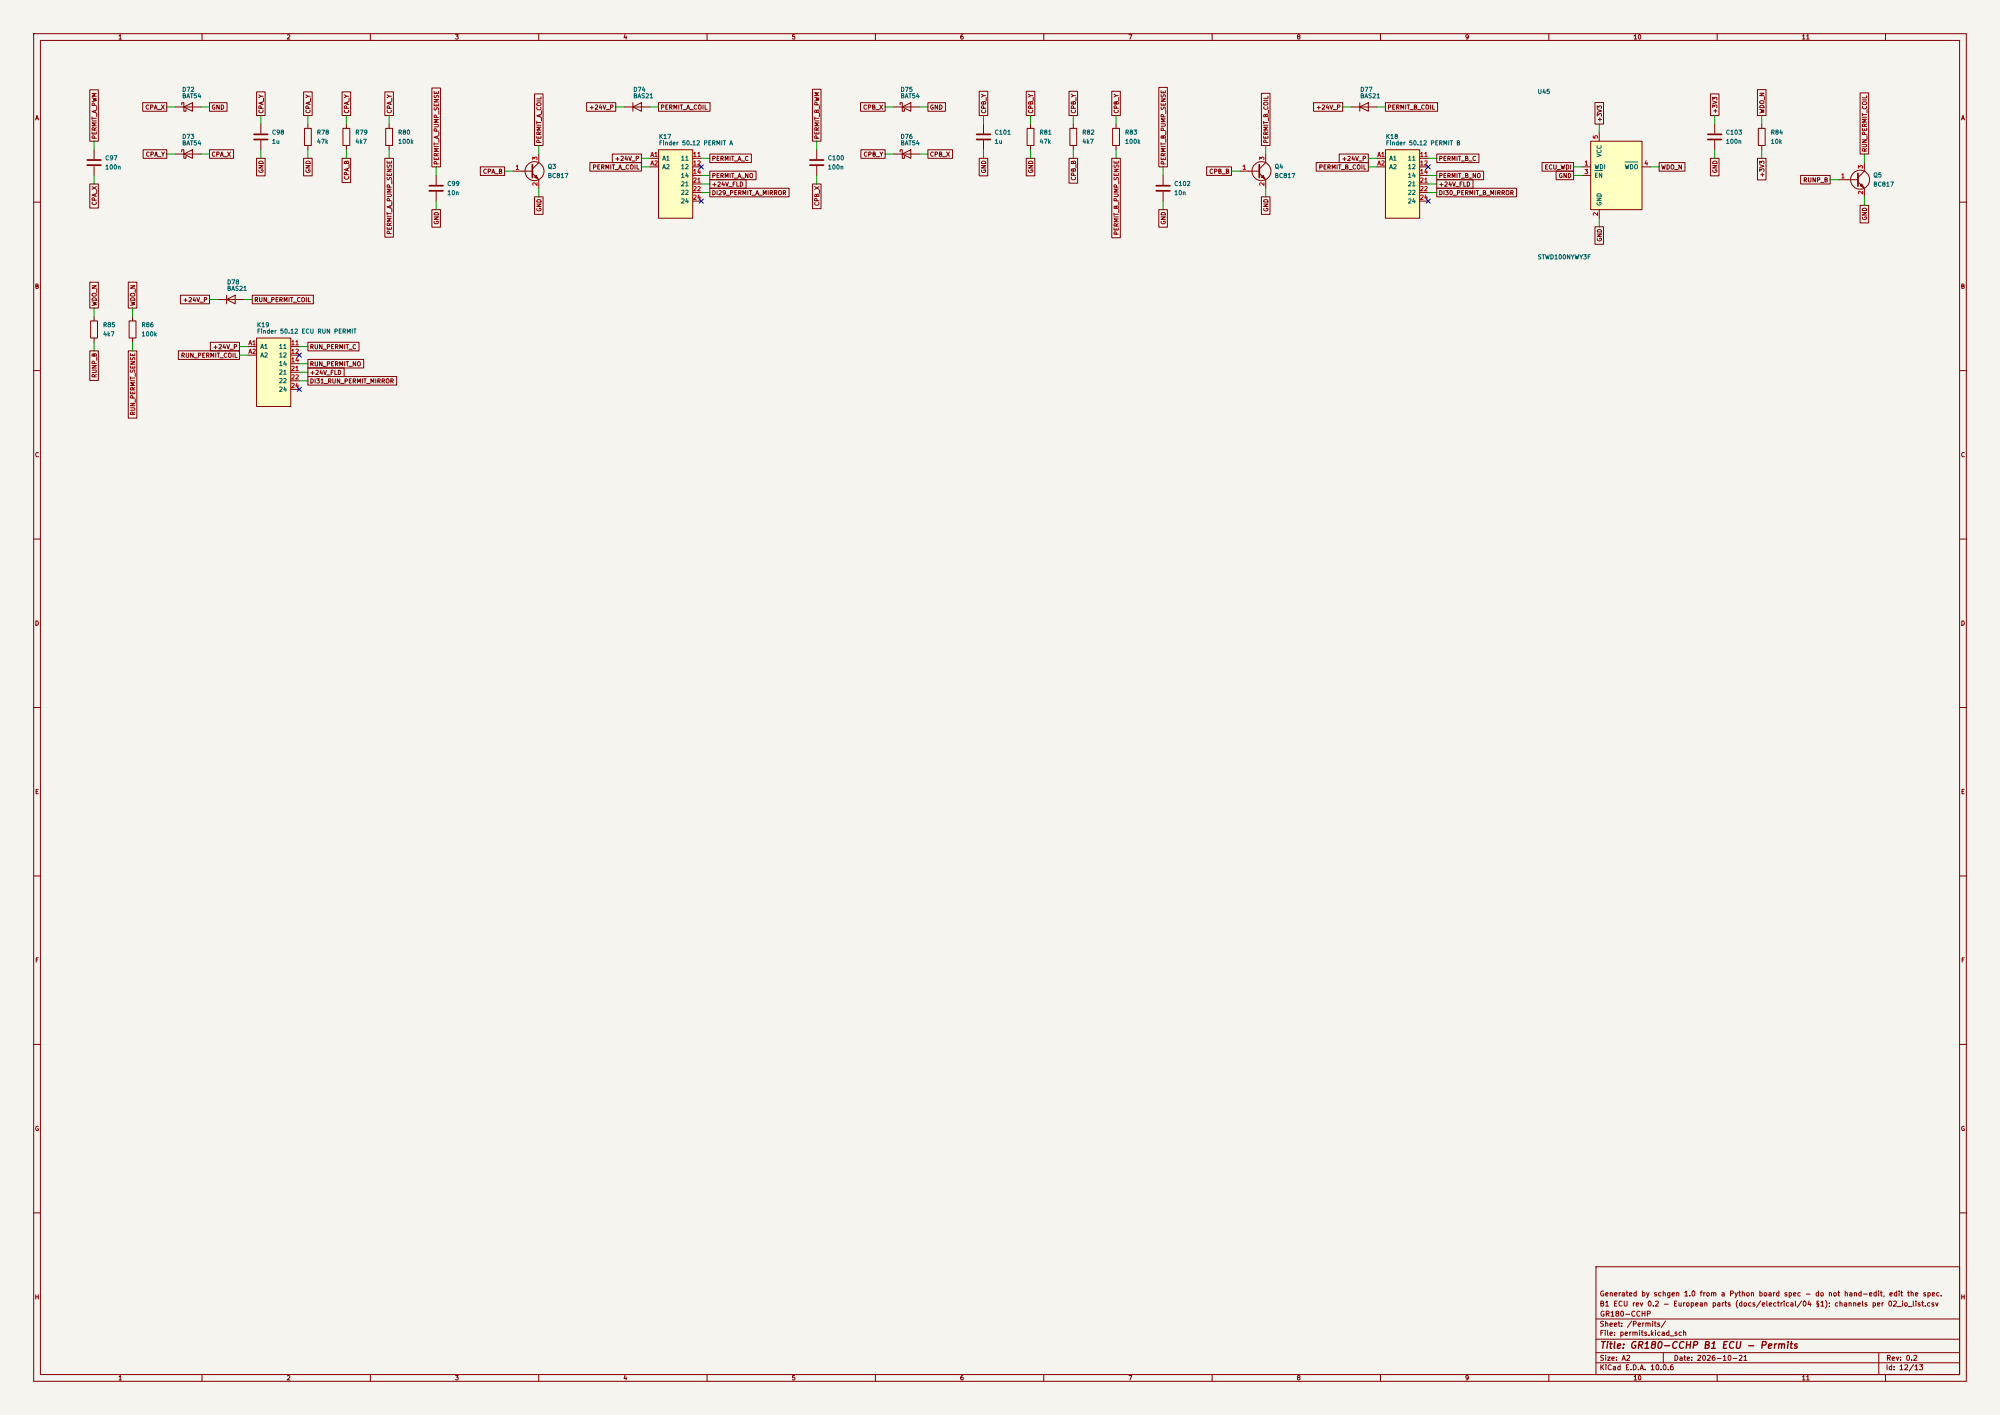
[picture p197: page 12]

Sheet: /Permits/
File: permits.kicad_sch
Title: GR180-CCHP B1 ECU - Permits

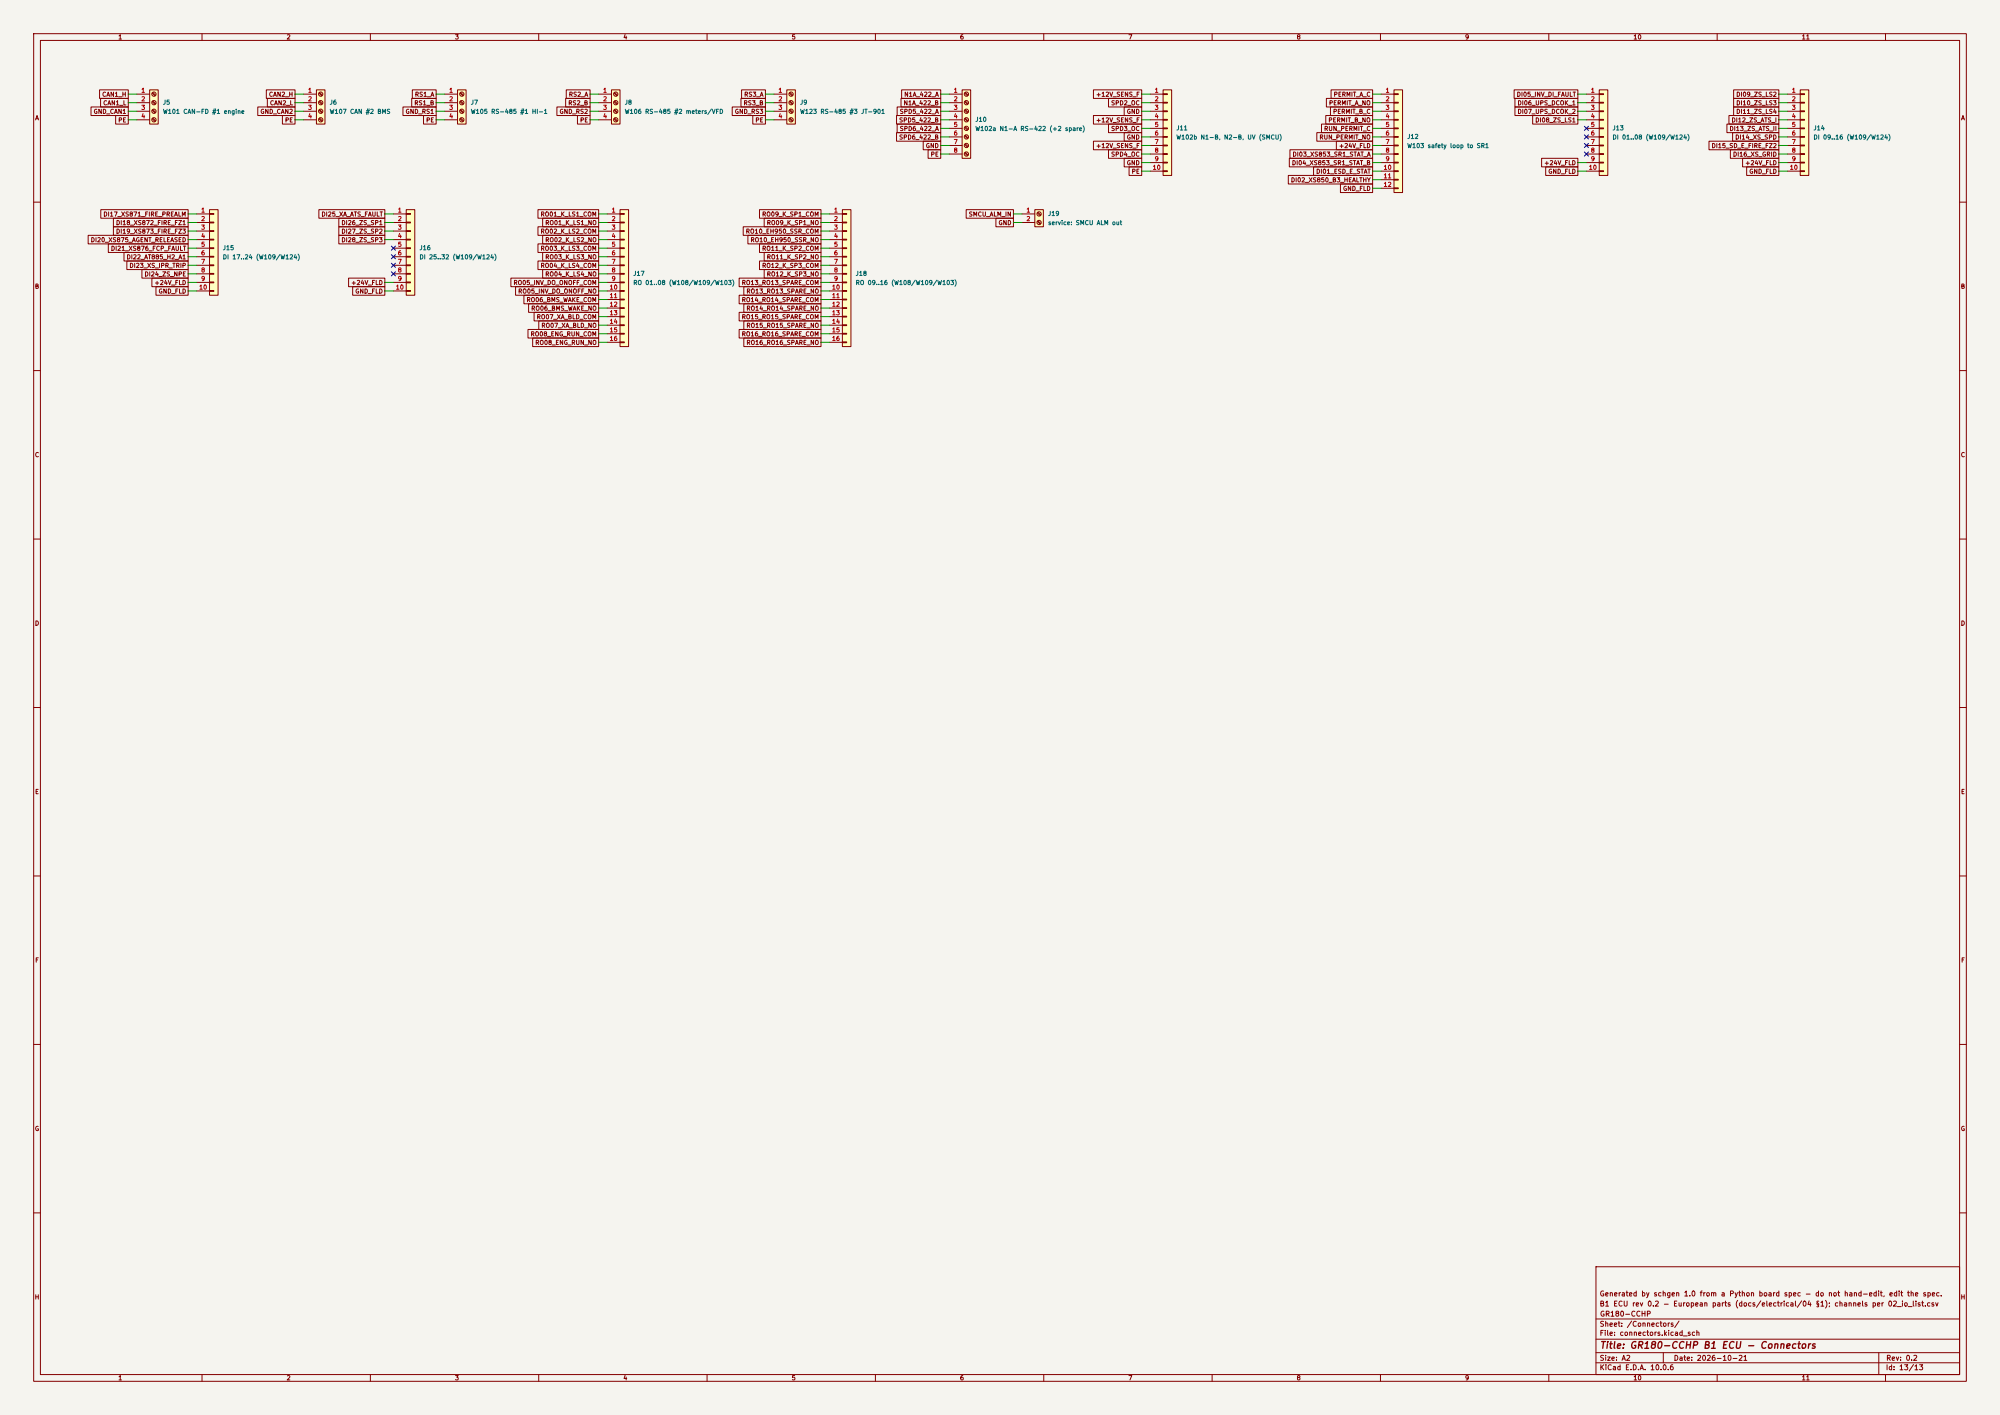
[picture p198: page 13]

Sheet: /Connectors/
File: connectors.kicad_sch
Title: GR180-CCHP B1 ECU - Connectors
