ahmadreza221/aurora-cchp/electronics/tools/example/out/schgen_example.pdf

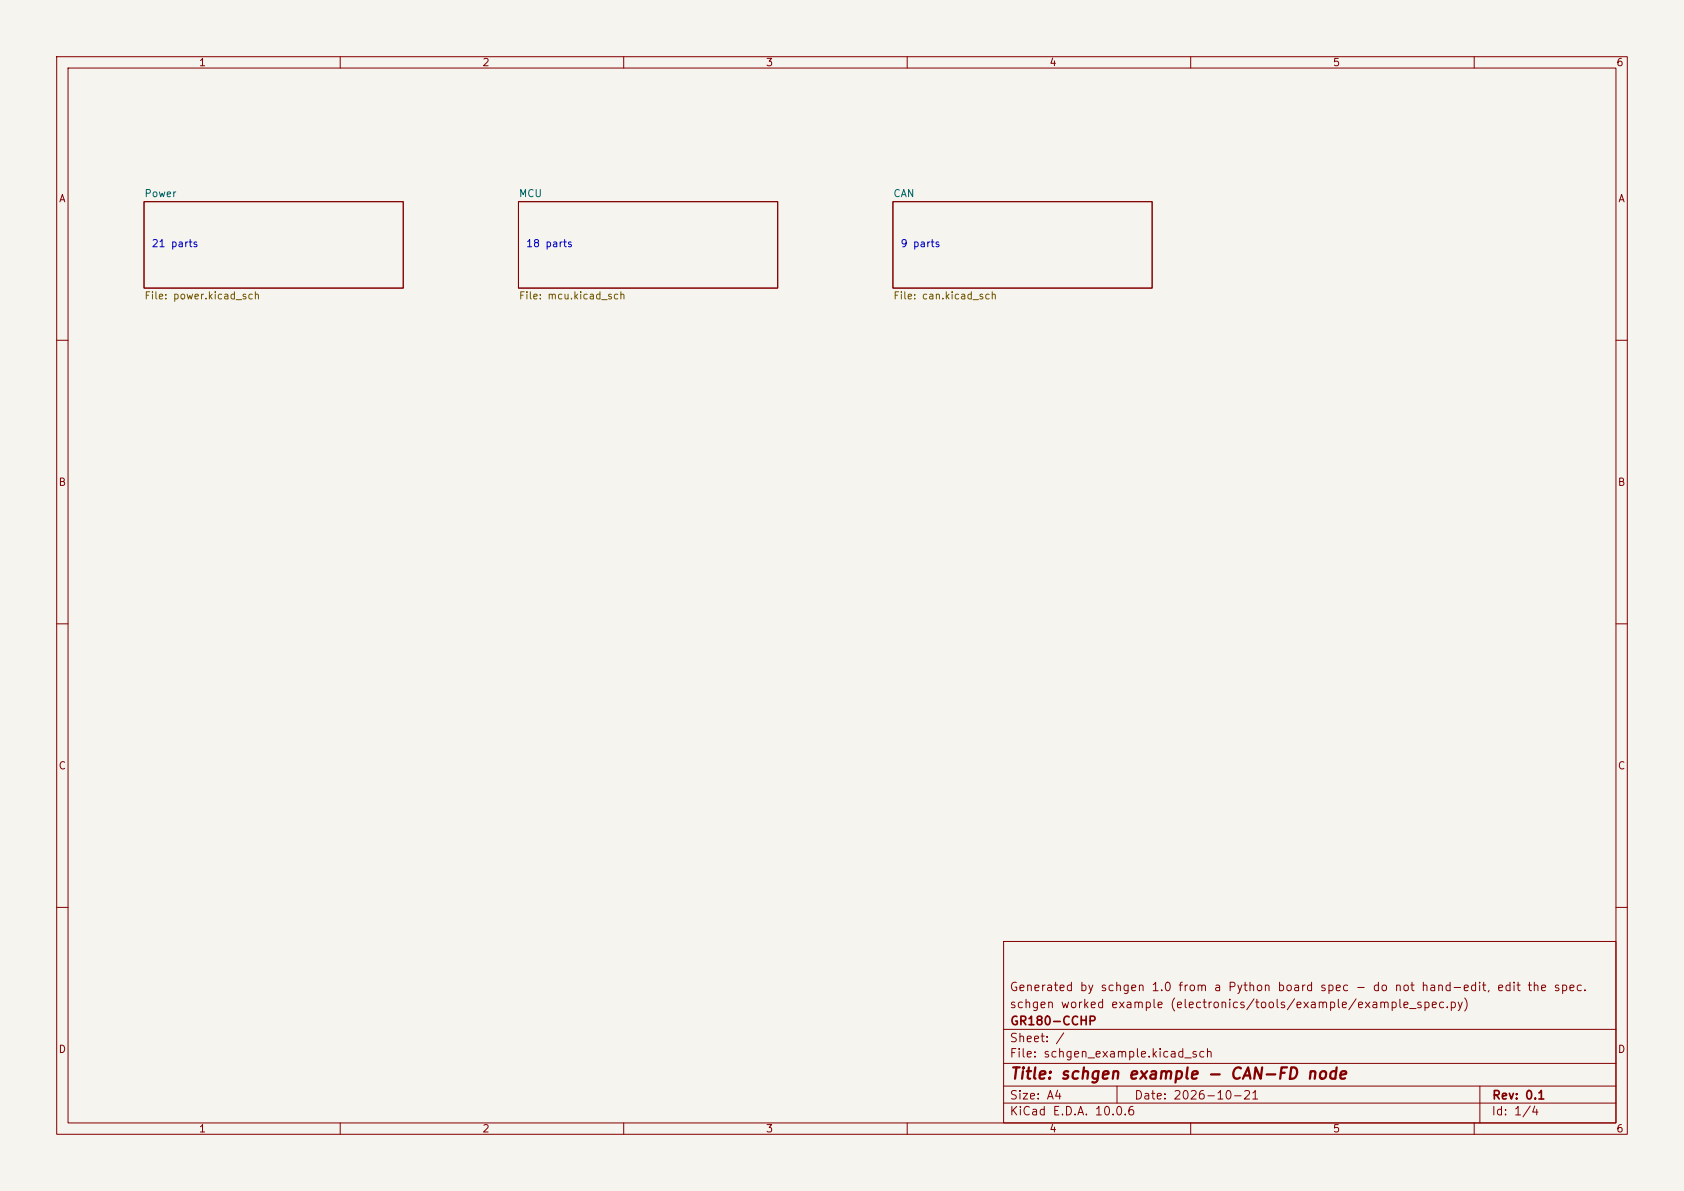
[picture p199: page 1]

Generated by schgen 1.0 from a Python board spec - do not hand-edit, edit the spec.
schgen worked example (electronics/tools/example/example_spec.py)
GR180-CCHP
Sheet: /
File: schgen_example.kicad_sch
Title: schgen example - CAN-FD node

Size: A4 | Rev: 0.1
KiCad E.D.A. 10.0.6 | Id: 1/4

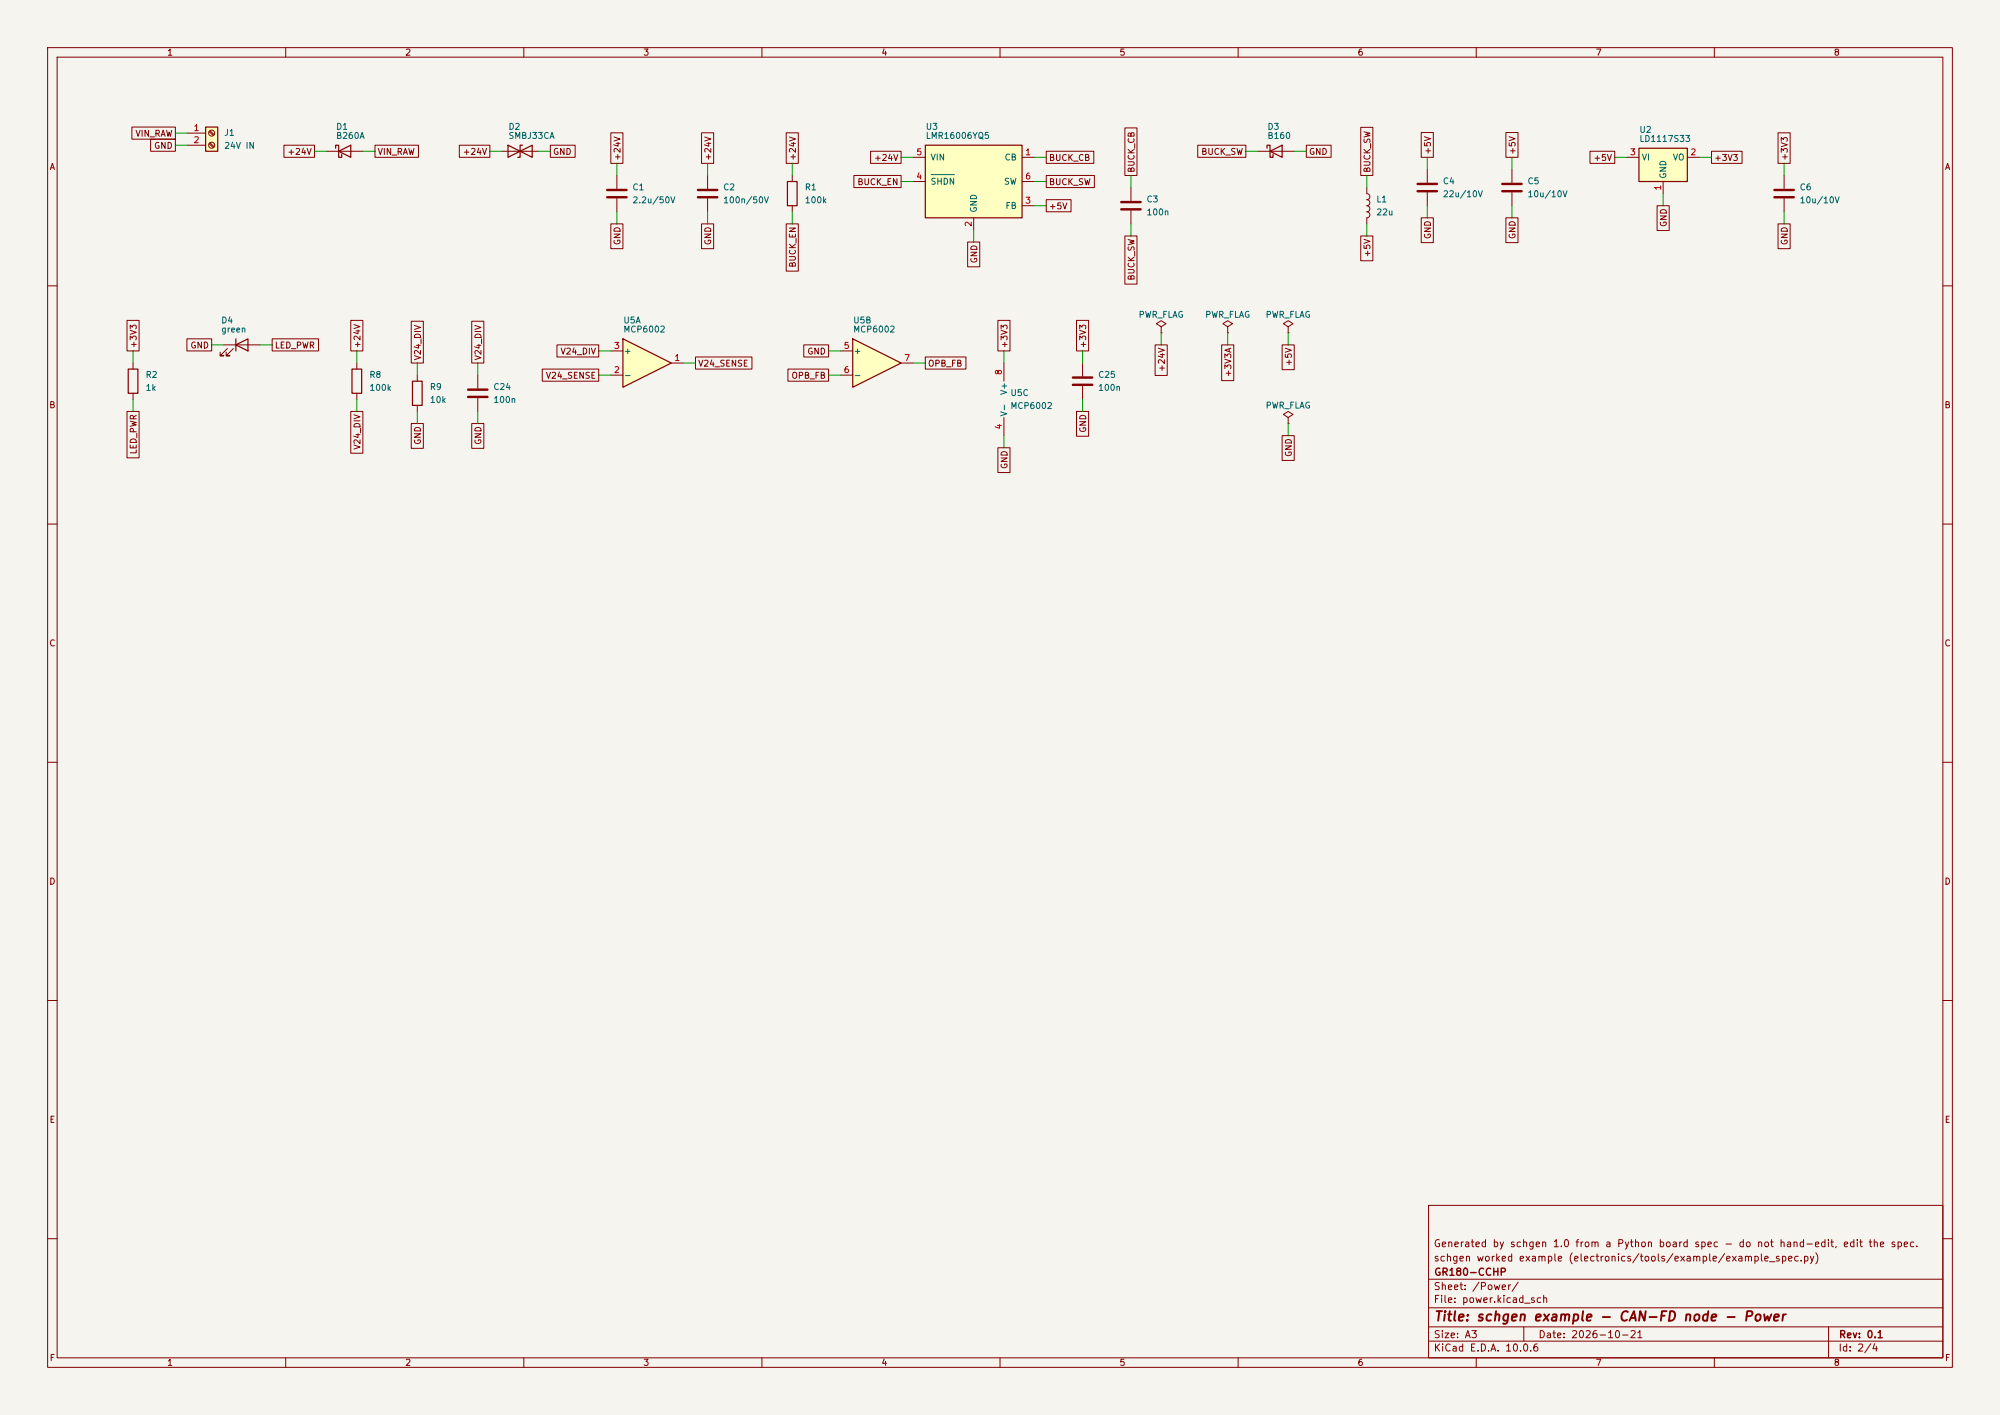
[picture p200: page 2]

Generated by schgen 1.0 from a Python board spec - do not hand-edit, edit the spec.
schgen worked example (electronics/tools/example/example_spec.py)
GR180-CCHP
Sheet: /Power/
File: power.kicad_sch
Title: schgen example - CAN-FD node - Power

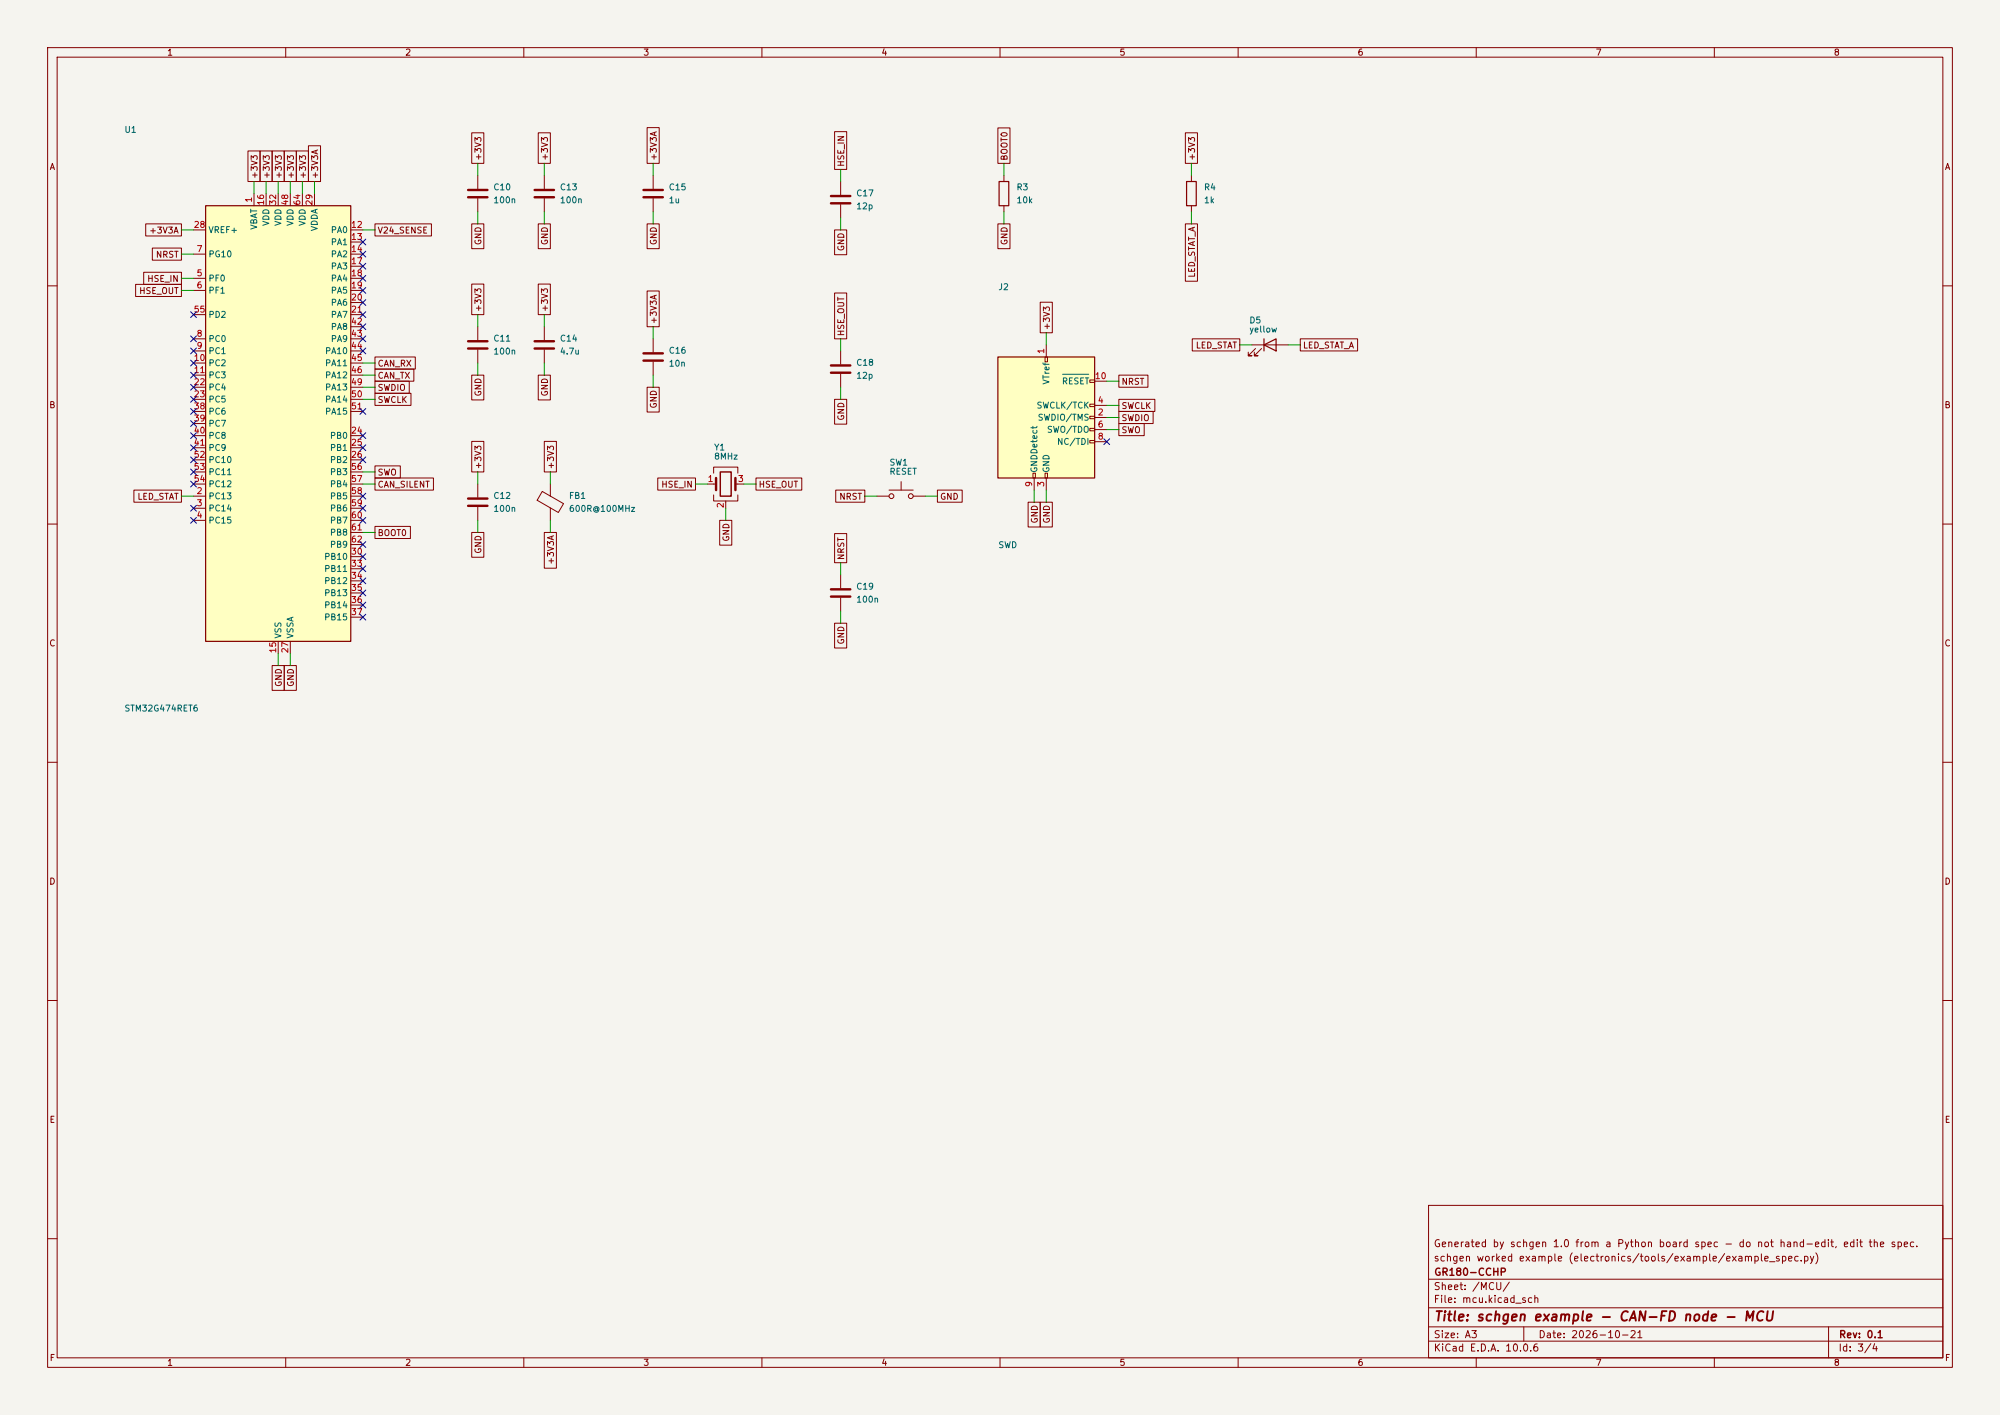
[picture p201: page 3]

Generated by schgen 1.0 from a Python board spec - do not hand-edit, edit the spec.
schgen worked example (electronics/tools/example/example_spec.py)
GR180-CCHP
Sheet: /MCU/
File: mcu.kicad_sch
Title: schgen example - CAN-FD node - MCU

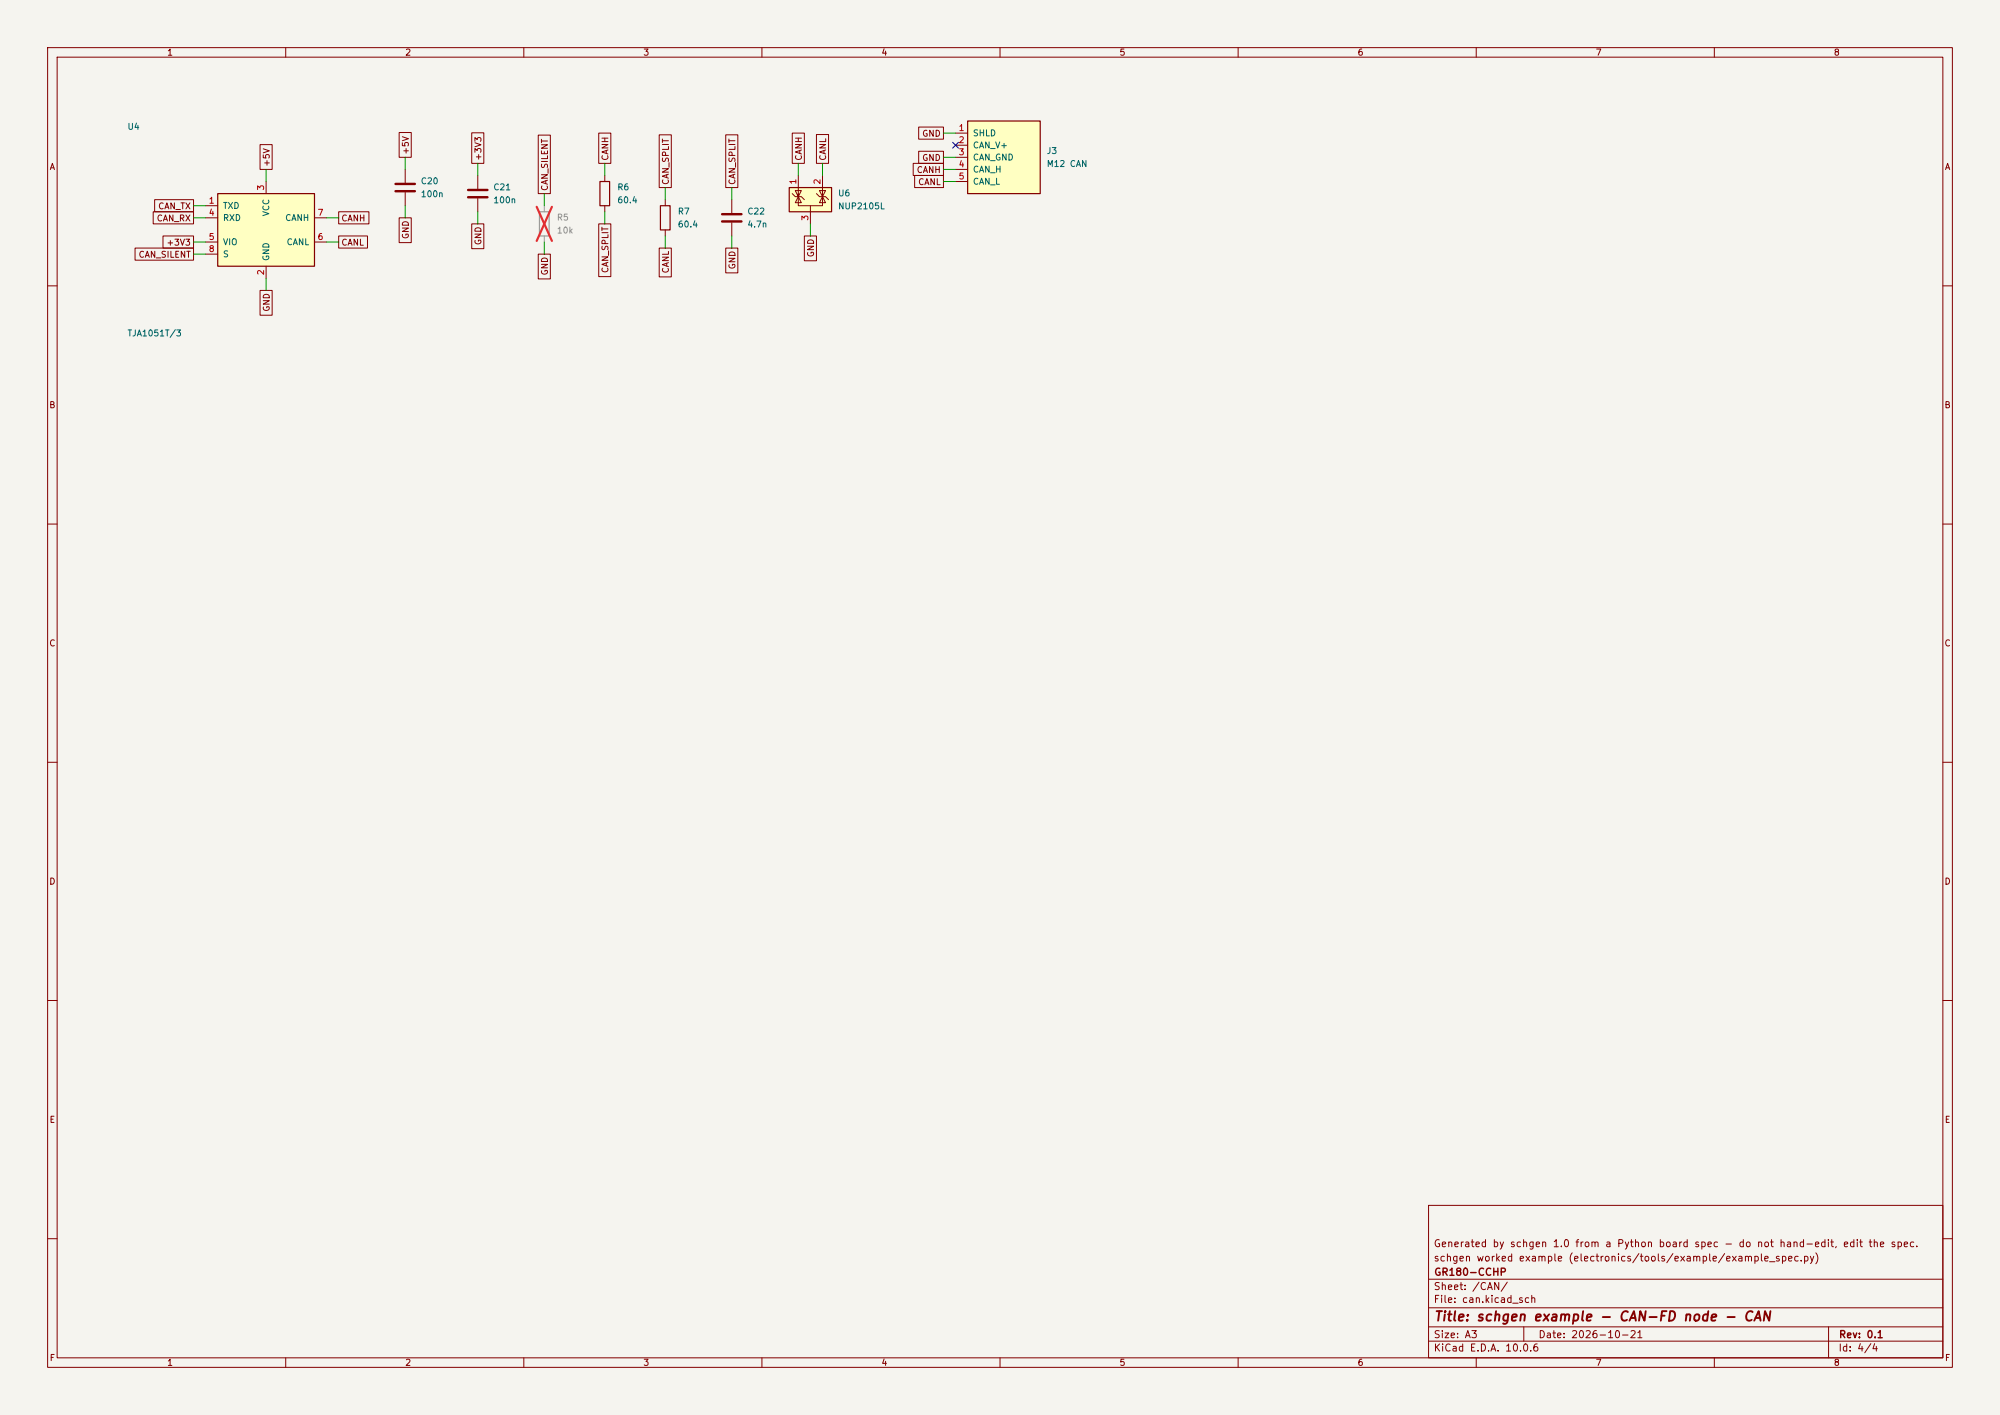
[picture p202: page 4]

Generated by schgen 1.0 from a Python board spec - do not hand-edit, edit the spec.
schgen worked example (electronics/tools/example/example_spec.py)
GR180-CCHP
Sheet: /CAN/
File: can.kicad_sch
Title: schgen example - CAN-FD node - CAN
