ahmadreza221/aurora-cchp/electronics/ecu/can_fd.kicad_sch

## KiCad design electronics/ecu/can_fd.kicad_sch (2026-10-22, an earlier design)

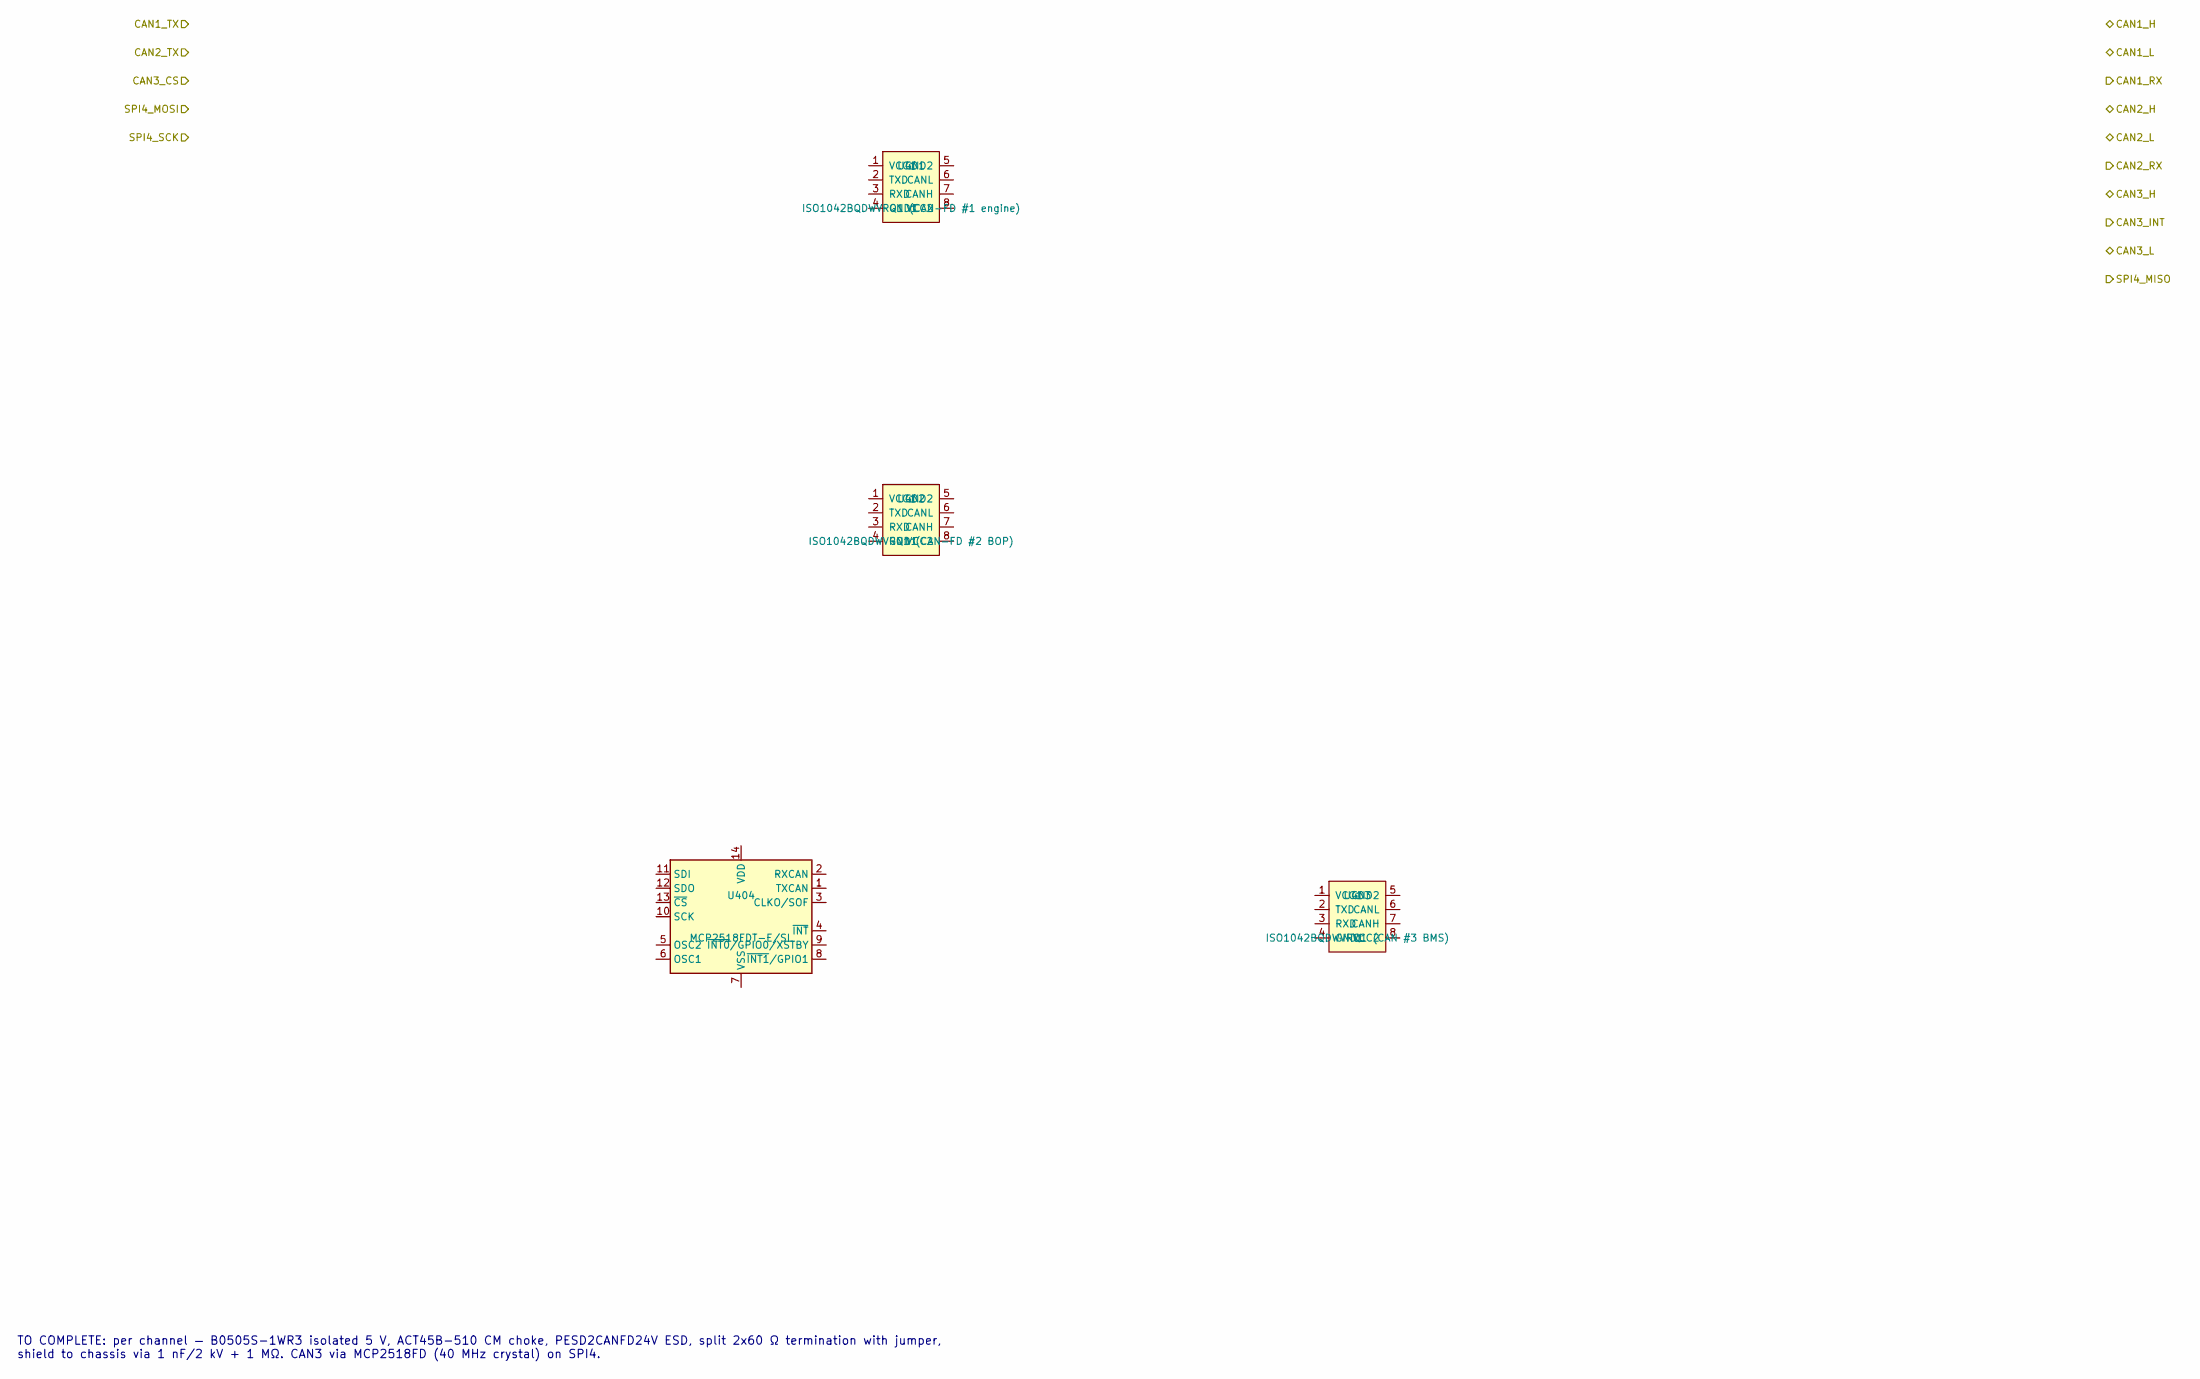
[picture p203: schematic can_fd.kicad_sch]

Parts:
U401: ISO1042BQDWVRQ1 (CAN-FD #1 engine); SOIC-8_7.5x5.85mm_P1.27mm; MPN ISO1042BQDWVRQ1; LCSC C2672259
U402: ISO1042BQDWVRQ1 (CAN-FD #2 BOP); SOIC-8_7.5x5.85mm_P1.27mm; MPN ISO1042BQDWVRQ1; LCSC C2672259
U403: ISO1042BQDWVRQ1 (CAN #3 BMS); SOIC-8_7.5x5.85mm_P1.27mm; MPN ISO1042BQDWVRQ1; LCSC C2672259
U404: MCP2518FDT-E/SL; SOIC-14_3.9x8.7mm_P1.27mm; MPN MCP2518FDT-E/SL; LCSC C626758

Connections:
unnamed: U404.7 (VSS), U404.15 (VSS)

Notes on the sheet:
TO COMPLETE: per channel — B0505S-1WR3 isolated 5 V, ACT45B-510 CM choke, PESD2CANFD24V ESD, split 2x60 Ω termination with jumper, shield to chassis via 1 nF/2 kV + 1 MΩ. CAN3 via MCP2518FD (40 MHz crystal) on SPI4.
