ahmadreza221/aurora-cchp/electronics/ecu/comms.kicad_sch

## KiCad design electronics/ecu/comms.kicad_sch (2026-10-21)

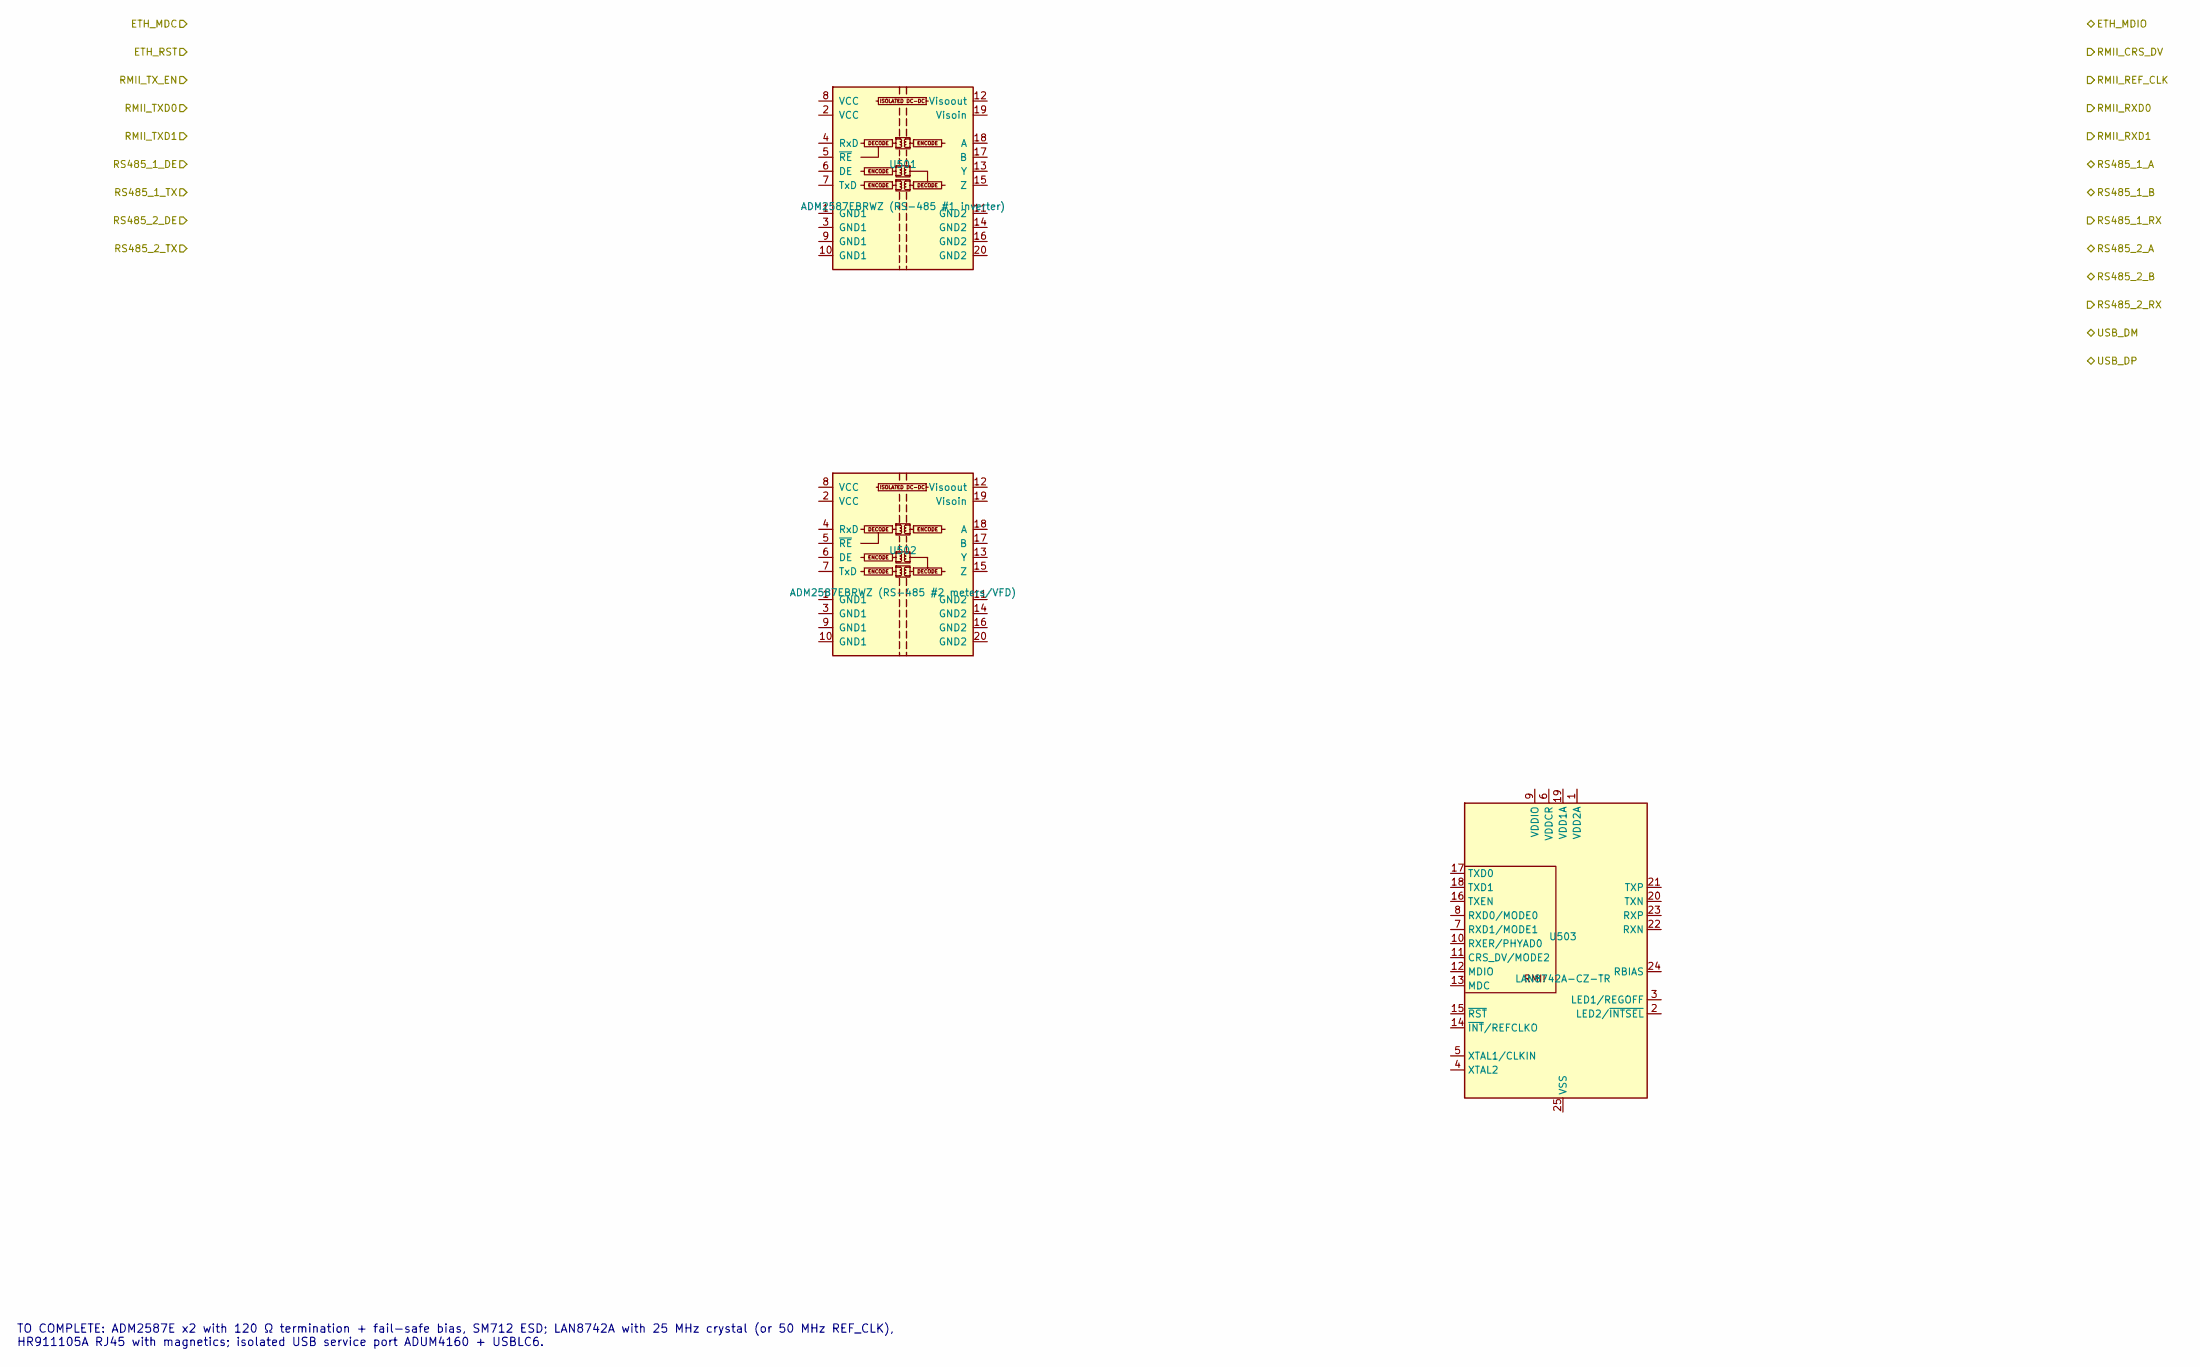
[picture p204: schematic comms.kicad_sch]

Parts:
U501: ADM2587EBRWZ (RS-485 #1 inverter); MPN ADM2587EBRWZ-REEL7; LCSC C12081
U502: ADM2587EBRWZ (RS-485 #2 meters/VFD); MPN ADM2587EBRWZ-REEL7; LCSC C12081
U503: LAN8742A-CZ-TR; MPN LAN8742A-CZ-TR; LCSC C621424

Notes on the sheet:
TO COMPLETE: ADM2587E x2 with 120 Ω termination + fail-safe bias, SM712 ESD; LAN8742A with 25 MHz crystal (or 50 MHz REF_CLK), HR911105A RJ45 with magnetics; isolated USB service port ADUM4160 + USBLC6.
