ahmadreza221/aurora-cchp/electronics/ecu/connectors.kicad_sch

## KiCad design electronics/ecu/connectors.kicad_sch (2026-10-22, an earlier design)

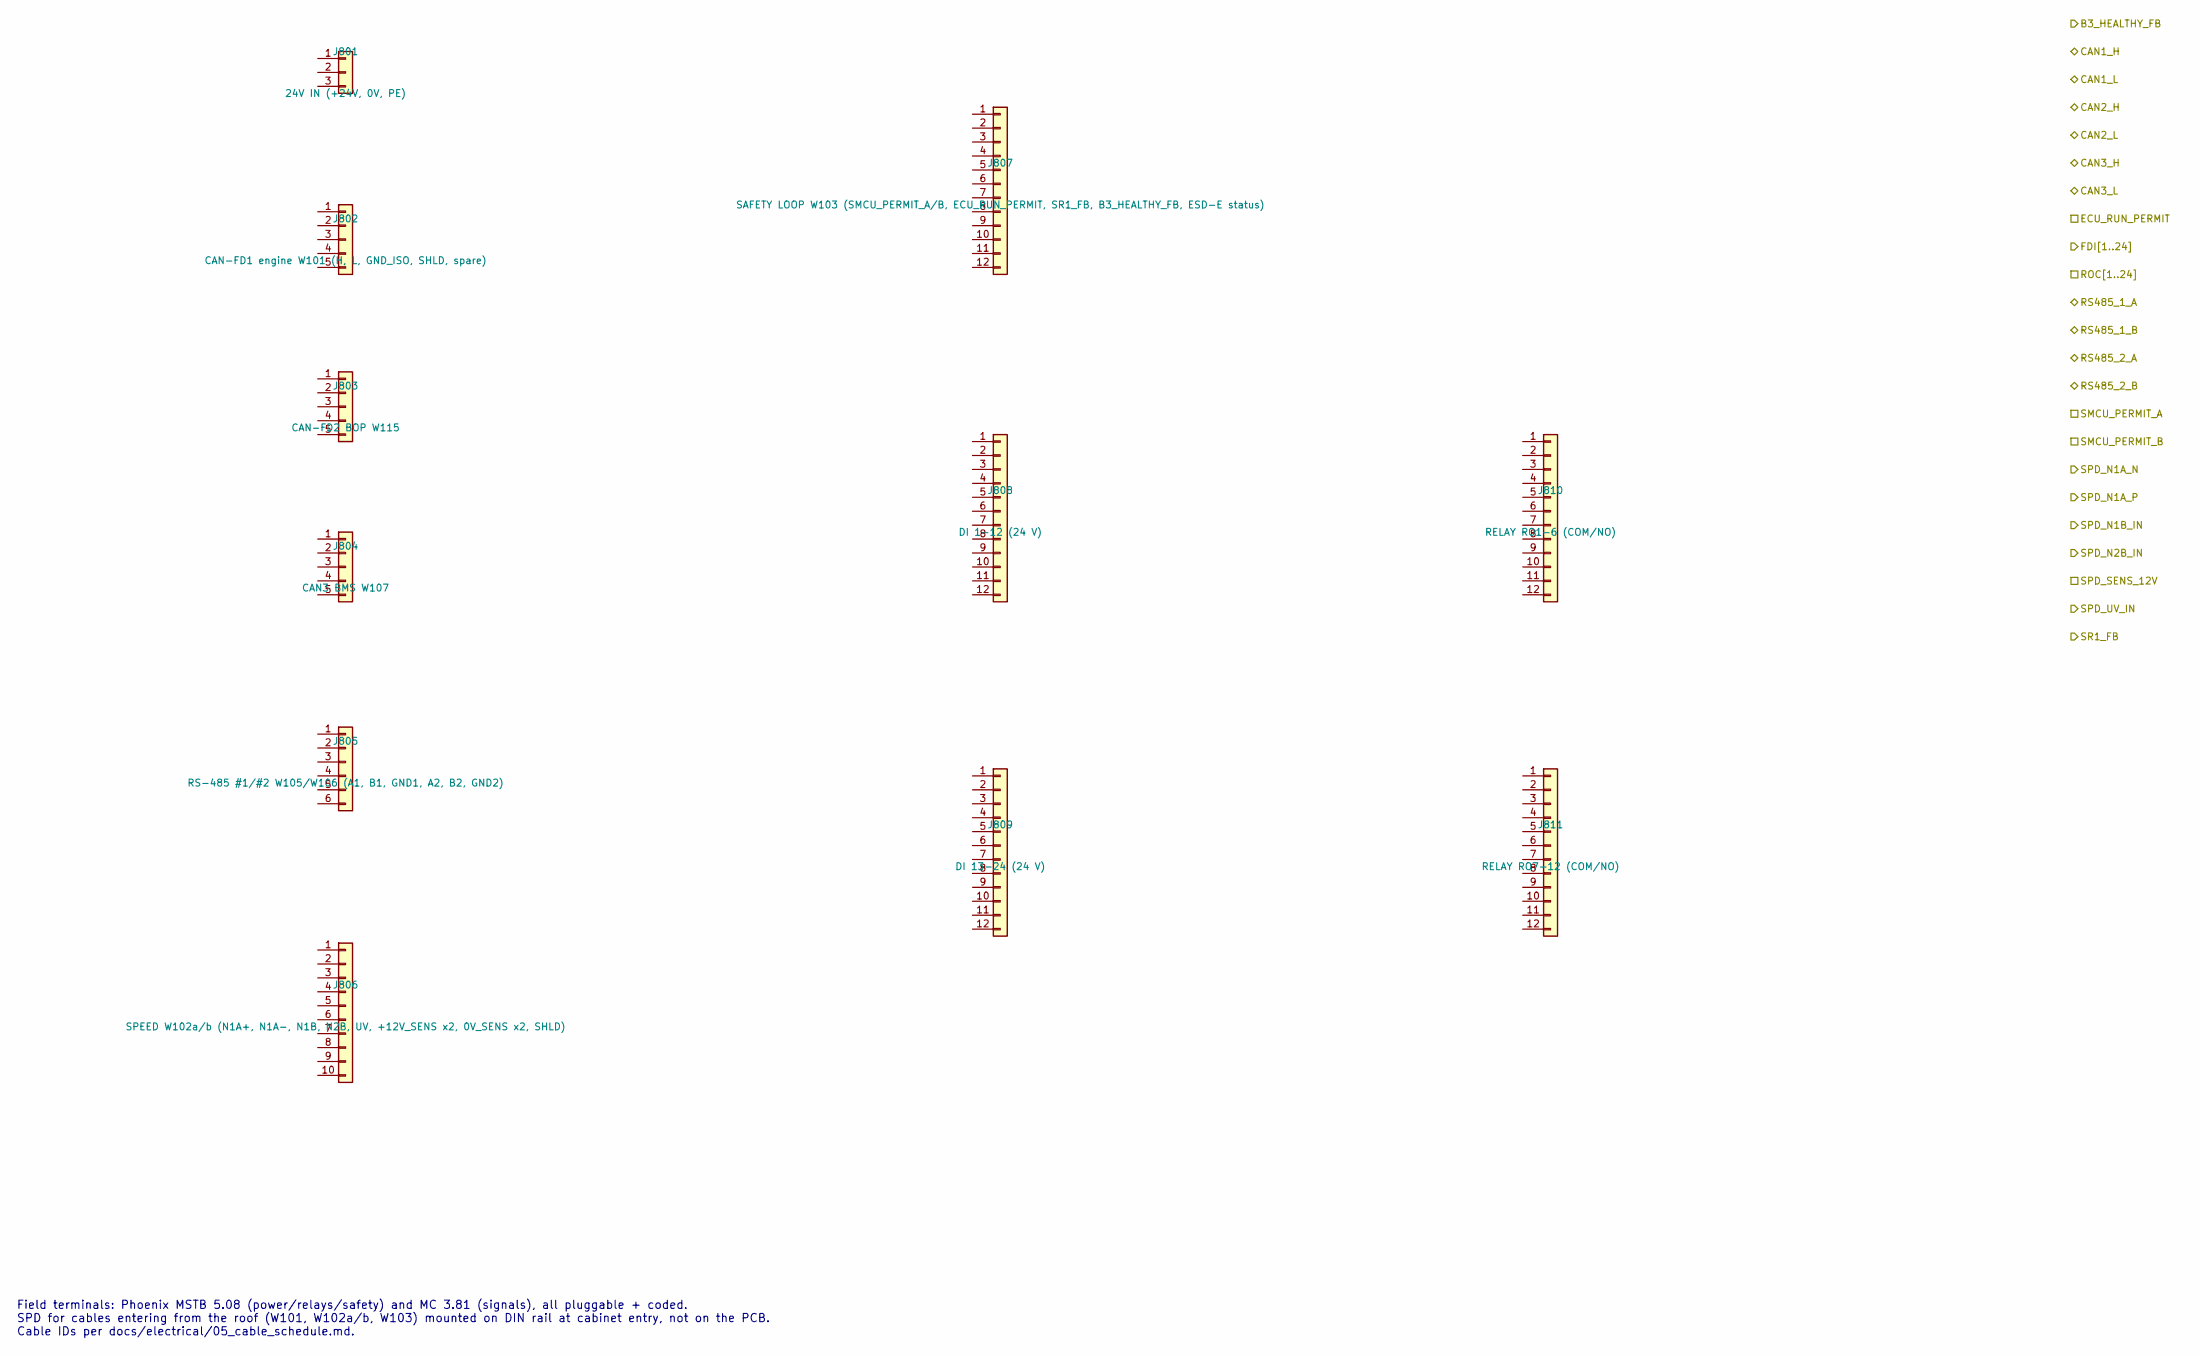
[picture p205: schematic connectors.kicad_sch]

Parts:
J801: 24V IN (+24V, 0V, PE); PhoenixContact_MSTBA_2,5_3-G-5,08_1x03_P5.08mm_Horizontal
J802: CAN-FD1 engine W101 (H, L, GND_ISO, SHLD, spare); PhoenixContact_MC_1,5_5-G-3.81_1x05_P3.81mm_Horizontal
J803: CAN-FD2 BOP W115; PhoenixContact_MC_1,5_5-G-3.81_1x05_P3.81mm_Horizontal
J804: CAN3 BMS W107; PhoenixContact_MC_1,5_5-G-3.81_1x05_P3.81mm_Horizontal
J805: RS-485 #1/#2 W105/W106 (A1, B1, GND1, A2, B2, GND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; PhoenixContact_MC_1,5_6-G-3.81_1x06_P3.81mm_Horizontal
J806: SPEED W102a/b (N1A+, N1A-, N1B, N2B, UV, +12V_SEN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; PhoenixContact_MC_1,5_10-G-3.81_1x10_P3.81mm_Horizontal
J807: SAFETY LOOP W103 (SMCU_PERMIT_A/B, ECU_RUN_PERMIT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; PhoenixContact_MSTBA_2,5_12-G-5,08_1x12_P5.08mm_Horizontal
J808: DI 1-12 (24 V); PhoenixContact_MC_1,5_12-G-3.81_1x12_P3.81mm_Horizontal
J809: DI 13-24 (24 V); PhoenixContact_MC_1,5_12-G-3.81_1x12_P3.81mm_Horizontal
J810: RELAY RO1-6 (COM/NO); PhoenixContact_MSTBA_2,5_12-G-5,08_1x12_P5.08mm_Horizontal
J811: RELAY RO7-12 (COM/NO); PhoenixContact_MSTBA_2,5_12-G-5,08_1x12_P5.08mm_Horizontal

Notes on the sheet:
Field terminals: Phoenix MSTB 5.08 (power/relays/safety) and MC 3.81 (signals), all pluggable + coded. SPD for cables entering from the roof (W101, W102a/b, W103) mounted on DIN rail at cabinet entry, not on the PCB. Cable IDs per docs/electrical/05_cable_schedule.md.
