ahmadreza221/aurora-cchp/electronics/ecu/digital_io.kicad_sch

## KiCad design electronics/ecu/digital_io.kicad_sch (2026-10-21)

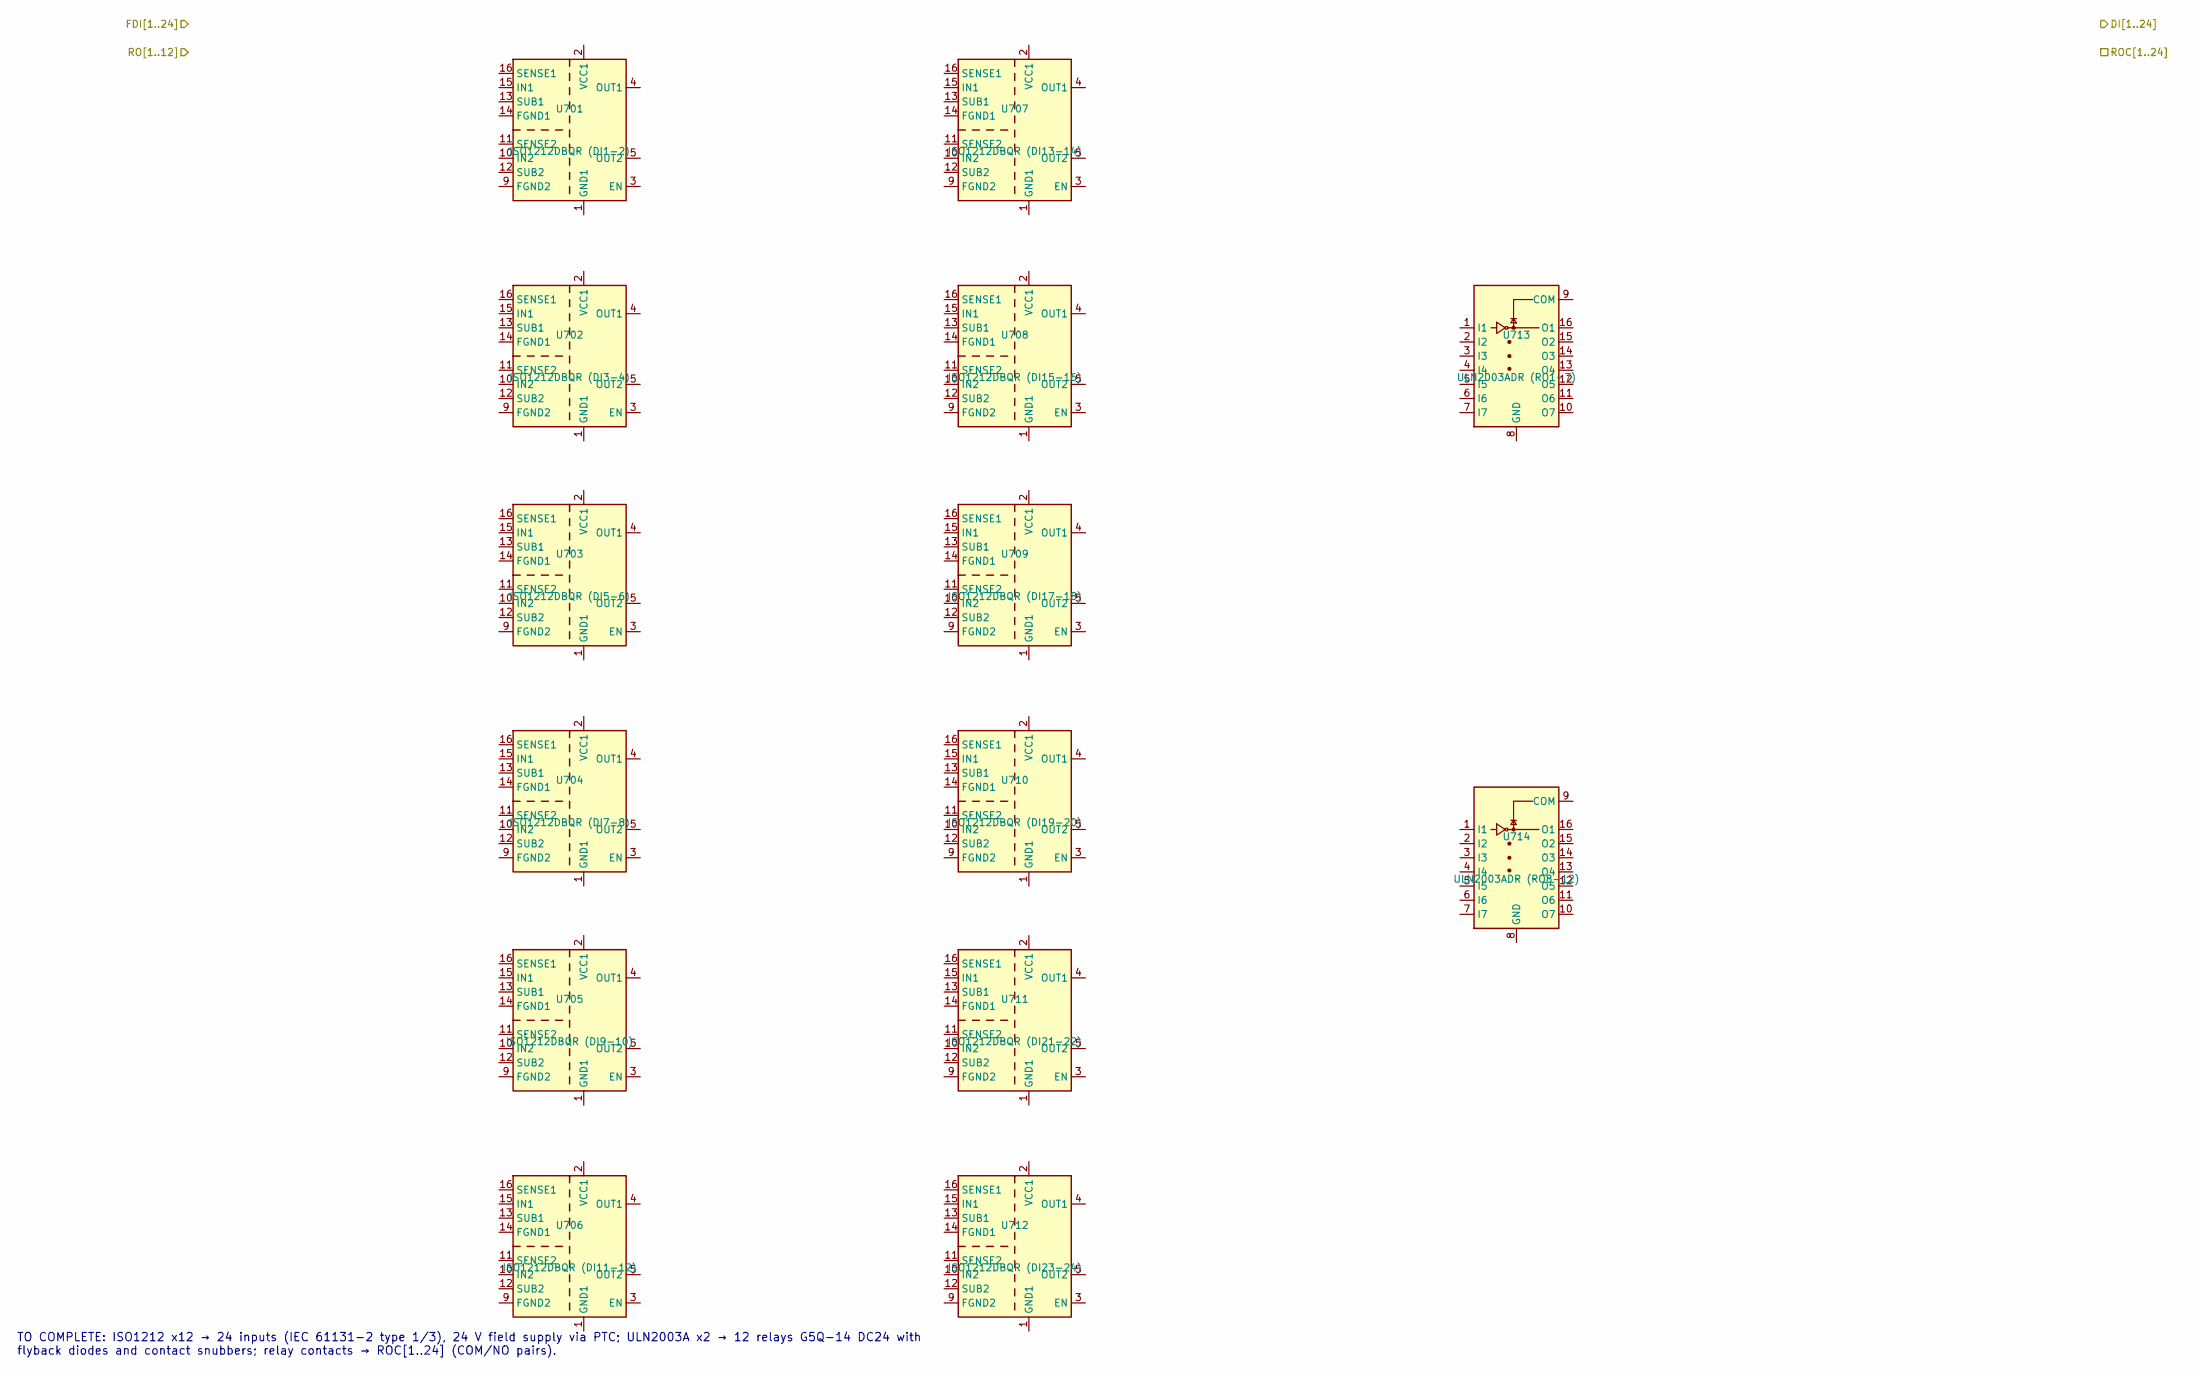
[picture p206: schematic digital_io.kicad_sch]

Parts:
U701: ISO1212DBQR (DI1-2); MPN ISO1212DBQR; LCSC C2859667
U702: ISO1212DBQR (DI3-4); MPN ISO1212DBQR; LCSC C2859667
U703: ISO1212DBQR (DI5-6); MPN ISO1212DBQR; LCSC C2859667
U704: ISO1212DBQR (DI7-8); MPN ISO1212DBQR; LCSC C2859667
U705: ISO1212DBQR (DI9-10); MPN ISO1212DBQR; LCSC C2859667
U706: ISO1212DBQR (DI11-12); MPN ISO1212DBQR; LCSC C2859667
U707: ISO1212DBQR (DI13-14); MPN ISO1212DBQR; LCSC C2859667
U708: ISO1212DBQR (DI15-16); MPN ISO1212DBQR; LCSC C2859667
U709: ISO1212DBQR (DI17-18); MPN ISO1212DBQR; LCSC C2859667
U710: ISO1212DBQR (DI19-20); MPN ISO1212DBQR; LCSC C2859667
U711: ISO1212DBQR (DI21-22); MPN ISO1212DBQR; LCSC C2859667
U712: ISO1212DBQR (DI23-24); MPN ISO1212DBQR; LCSC C2859667
U713: ULN2003ADR (RO1-7); MPN ULN2003ADR; LCSC C7512
U714: ULN2003ADR (RO8-12); MPN ULN2003ADR; LCSC C7512

Connections:
unnamed: U701.1 (GND1), U701.8 (GND1)
unnamed: U702.1 (GND1), U702.8 (GND1)
unnamed: U703.1 (GND1), U703.8 (GND1)
unnamed: U704.1 (GND1), U704.8 (GND1)
unnamed: U705.1 (GND1), U705.8 (GND1)
unnamed: U706.1 (GND1), U706.8 (GND1)
unnamed: U707.1 (GND1), U707.8 (GND1)
unnamed: U708.1 (GND1), U708.8 (GND1)
unnamed: U709.1 (GND1), U709.8 (GND1)
unnamed: U710.1 (GND1), U710.8 (GND1)
unnamed: U711.1 (GND1), U711.8 (GND1)
unnamed: U712.1 (GND1), U712.8 (GND1)

Notes on the sheet:
TO COMPLETE: ISO1212 x12 → 24 inputs (IEC 61131-2 type 1/3), 24 V field supply via PTC; ULN2003A x2 → 12 relays G5Q-14 DC24 with flyback diodes and contact snubbers; relay contacts → ROC[1..24] (COM/NO pairs).
