ahmadreza221/aurora-cchp/electronics/ecu/mcu_main.kicad_sch

## KiCad design electronics/ecu/mcu_main.kicad_sch (2026-10-21)

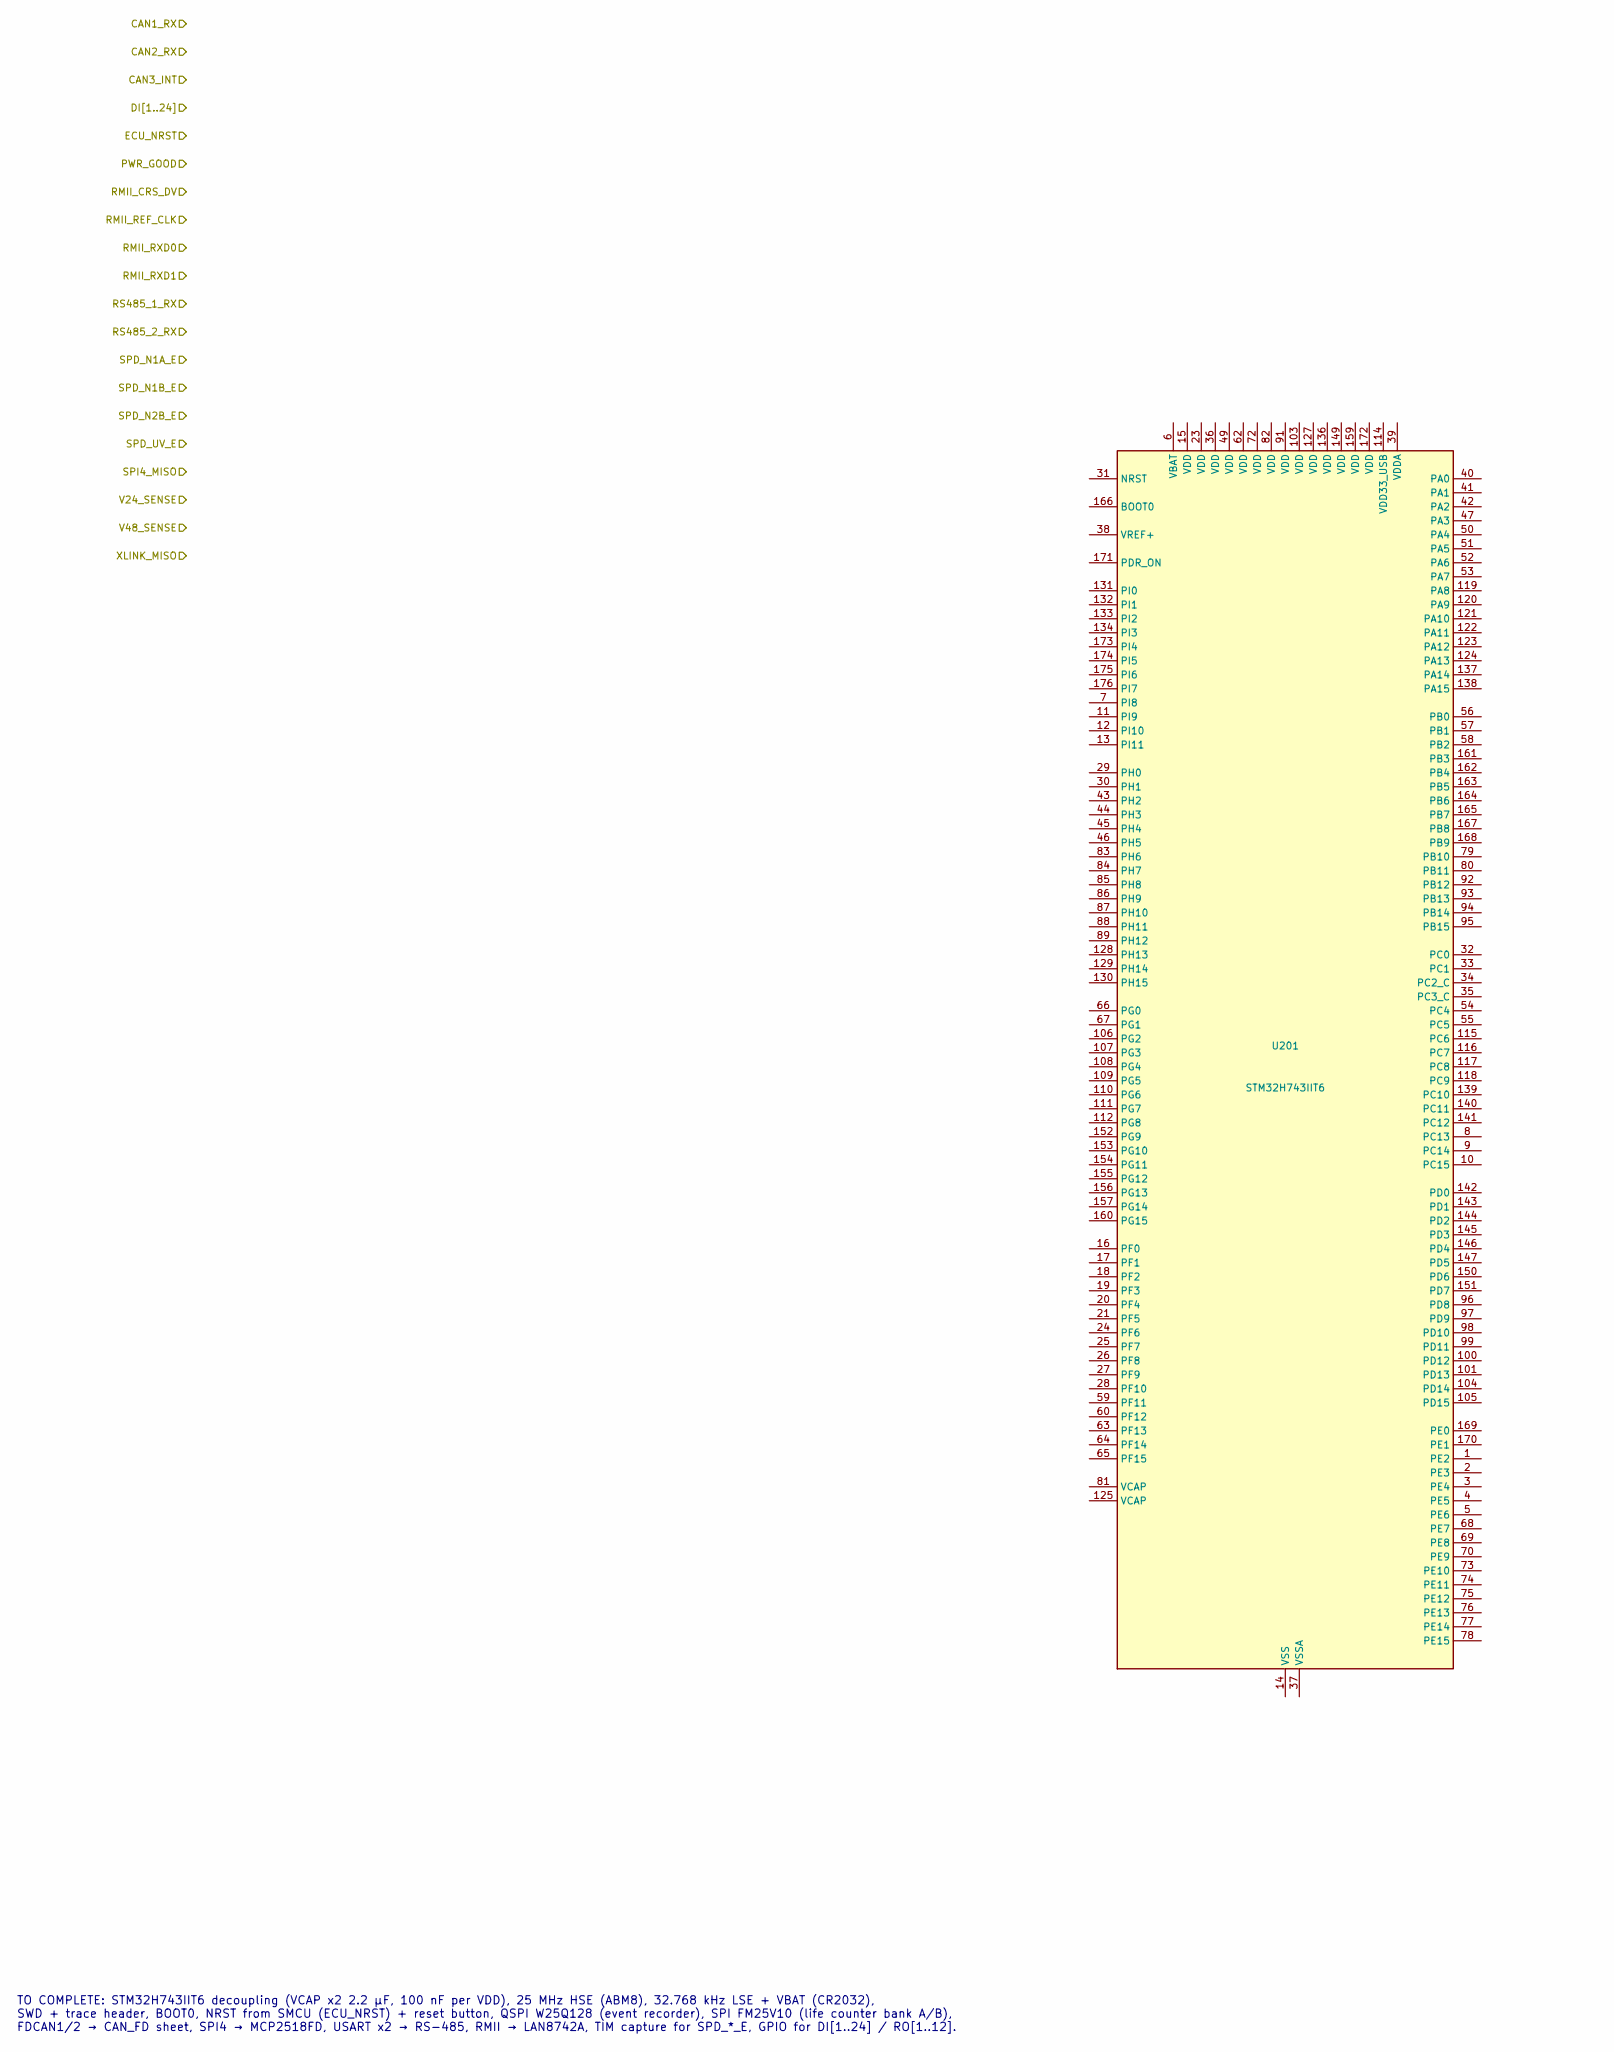
[picture p207: schematic mcu_main.kicad_sch, part in row 1, column 1]

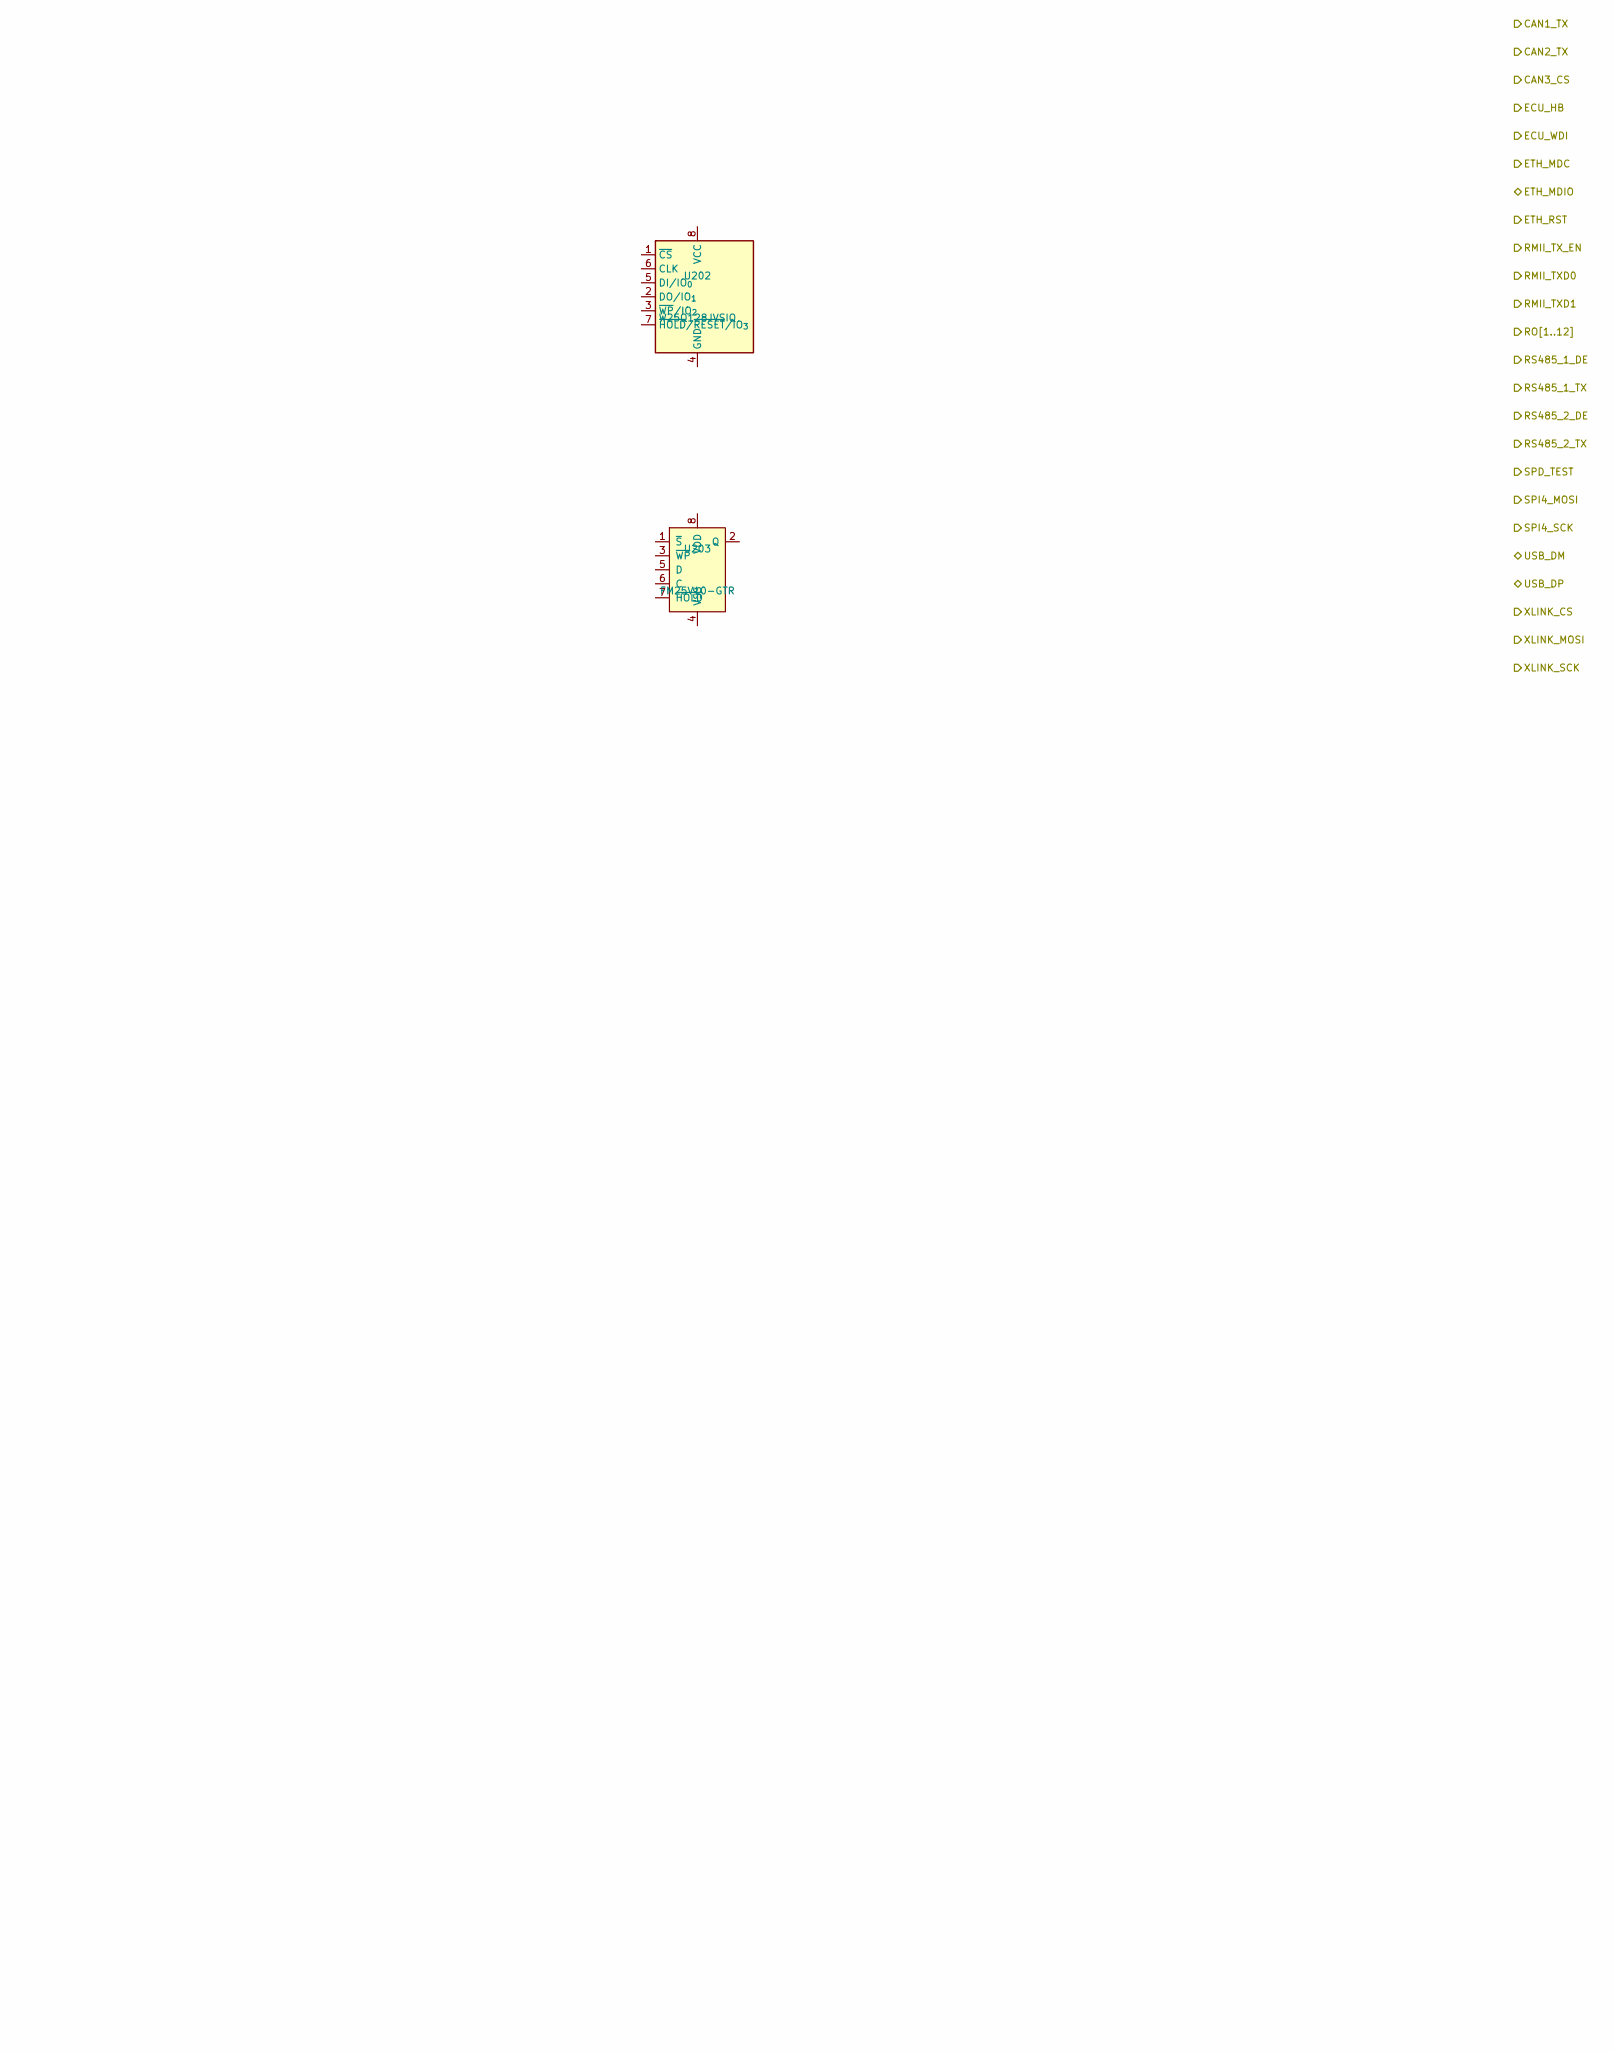
[picture p208: schematic mcu_main.kicad_sch, part in row 1, column 2]

Parts:
U201: STM32H743IIT6; LQFP-176_24x24mm_P0.5mm; MPN STM32H743IIT6; LCSC C89597
U202: W25Q128JVSIQ; SOIC-8_5.3x5.3mm_P1.27mm; MPN W25Q128JVSIQ; LCSC C97521
U203: FM25V10-GTR; SOIC-8_3.9x4.9mm_P1.27mm; MPN FM25V10-GTR; LCSC C44173

Connections:
unnamed: U201.14 (VSS), U201.22 (VSS), U201.48 (VSS), U201.61 (VSS), U201.71 (VSS), U201.90 (VSS), U201.102 (VSS), U201.113 (VSS), U201.126 (VSS), U201.135 (VSS), U201.148 (VSS), U201.158 (VSS)

Notes on the sheet:
TO COMPLETE: STM32H743IIT6 decoupling (VCAP x2 2.2 µF, 100 nF per VDD), 25 MHz HSE (ABM8), 32.768 kHz LSE + VBAT (CR2032), SWD + trace header, BOOT0, NRST from SMCU (ECU_NRST) + reset button, QSPI W25Q128 (event recorder), SPI FM25V10 (life counter bank A/B), FDCAN1/2 → CAN_FD sheet, SPI4 → MCP2518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
