ahmadreza221/aurora-cchp/electronics/ecu/power.kicad_sch

## KiCad design electronics/ecu/power.kicad_sch (2026-10-21)

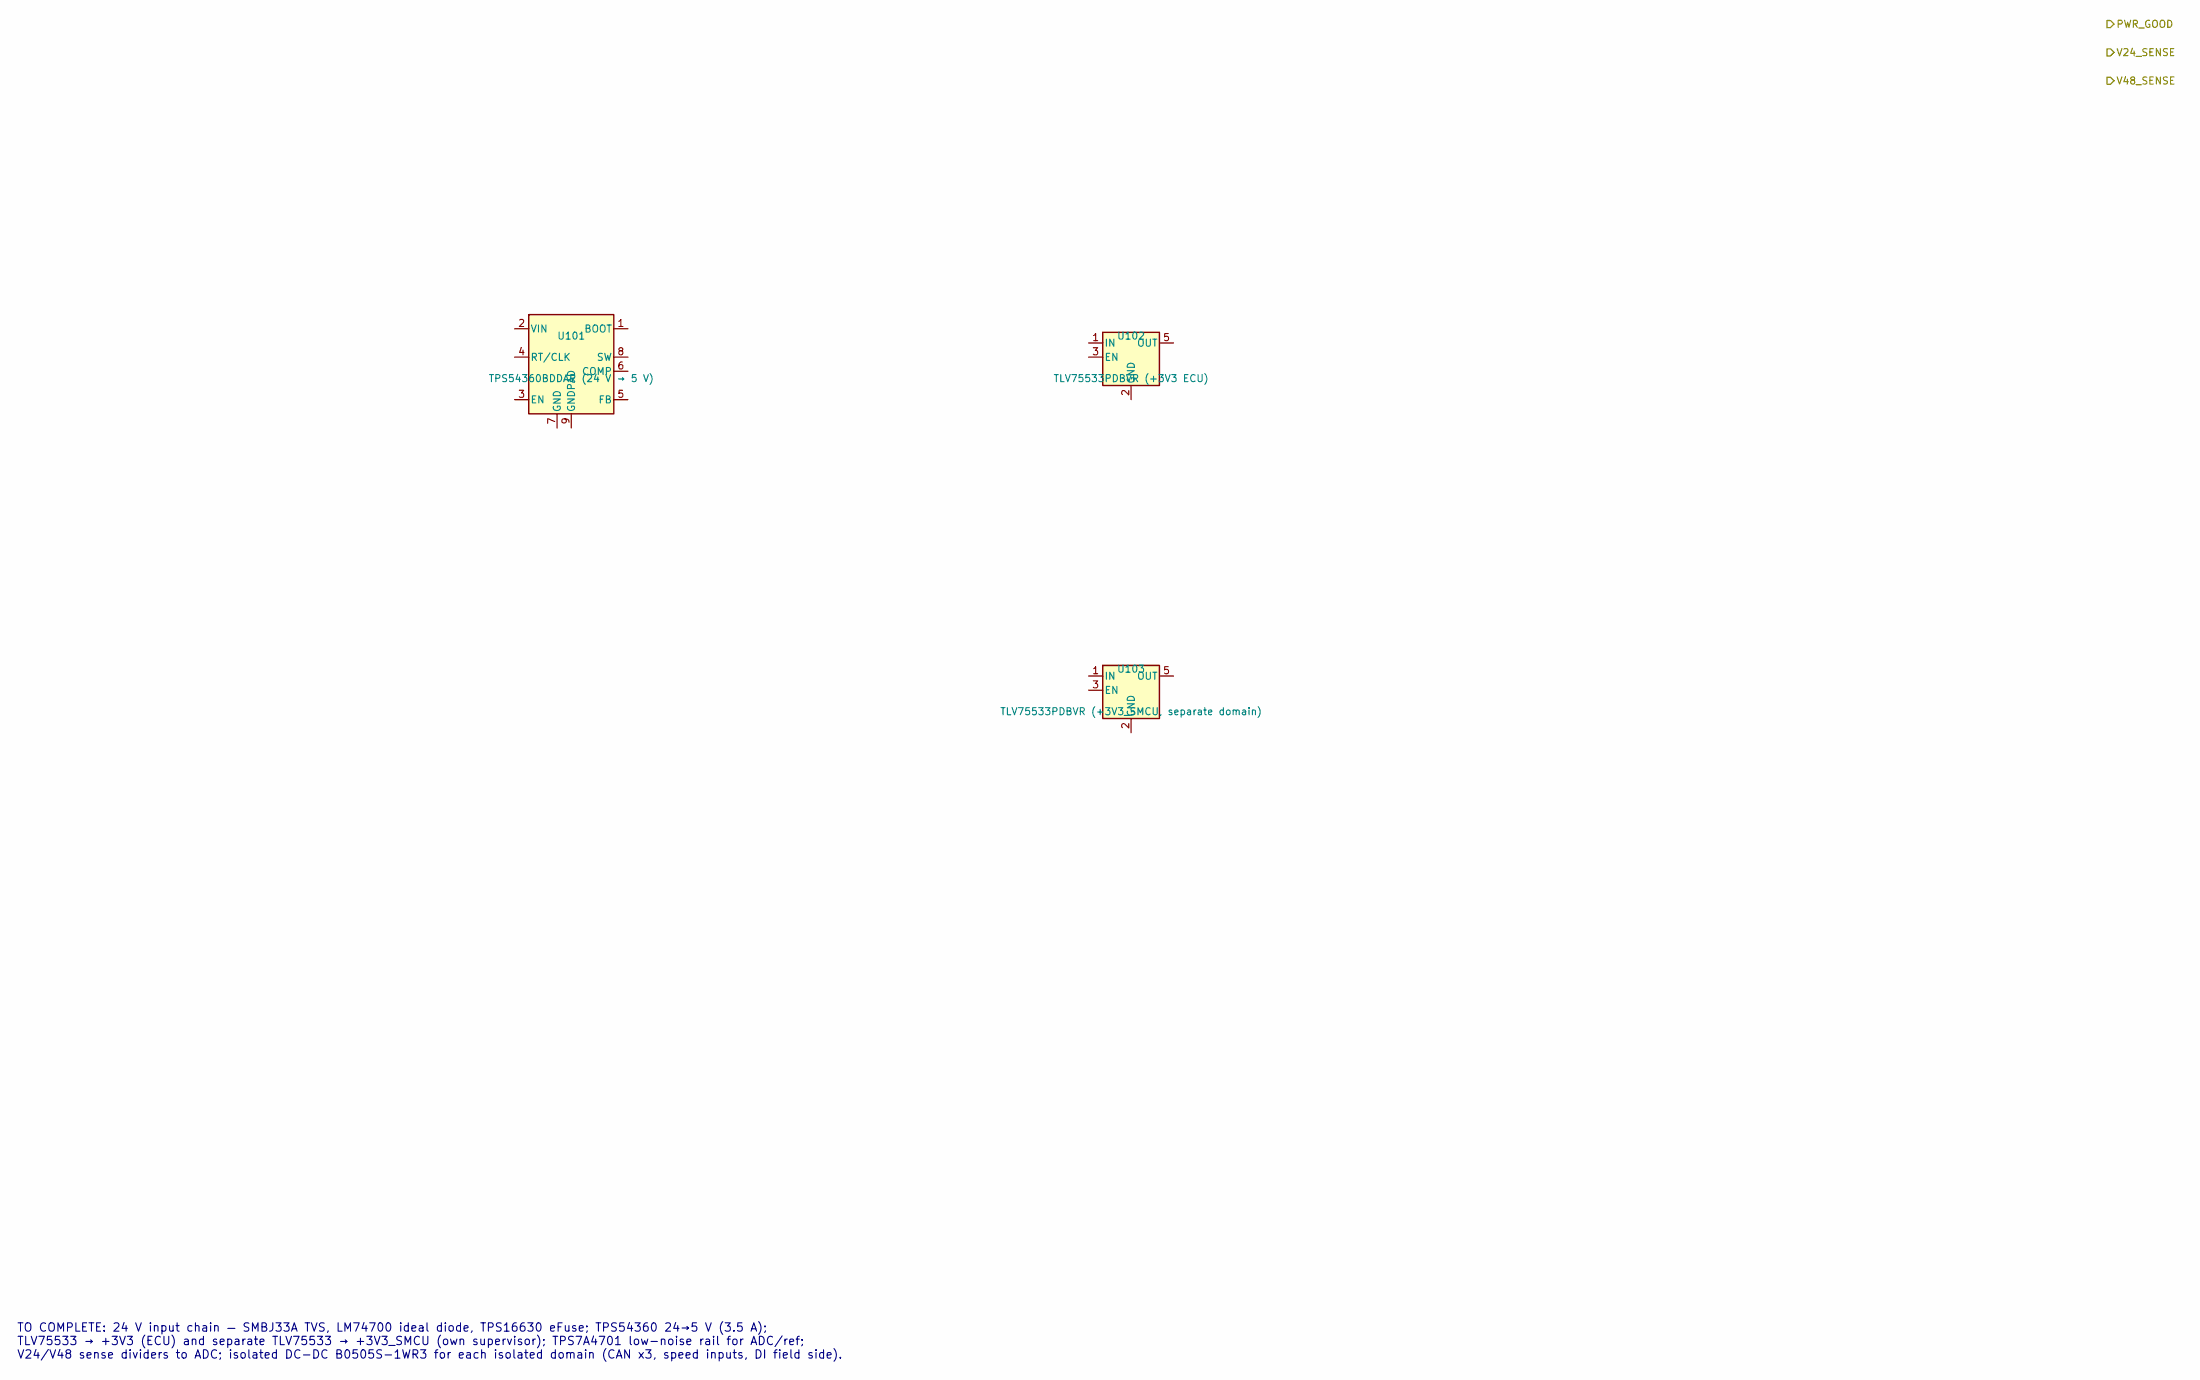
[picture p209: schematic power.kicad_sch]

Parts:
U101: TPS54360BDDAR (24 V → 5 V); MPN TPS54360BDDAR; LCSC C524806
U102: TLV75533PDBVR (+3V3 ECU); MPN TLV75533PDBVR; LCSC C404027
U103: TLV75533PDBVR (+3V3_SMCU, separate domain); MPN TLV75533PDBVR; LCSC C404027

Notes on the sheet:
TO COMPLETE: 24 V input chain — SMBJ33A TVS, LM74700 ideal diode, TPS16630 eFuse; TPS54360 24→5 V (3.5 A); TLV75533 → +3V3 (ECU) and separate TLV75533 → +3V3_SMCU (own supervisor); TPS7A4701 low-noise rail for ADC/ref; V24/V48 sense dividers to ADC; isolated DC-DC B0505S-1WR3 for each isolated doma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
