ahmadreza221/aurora-cchp/electronics/ecu/safety_mcu.kicad_sch

## KiCad design electronics/ecu/safety_mcu.kicad_sch (2026-10-21)

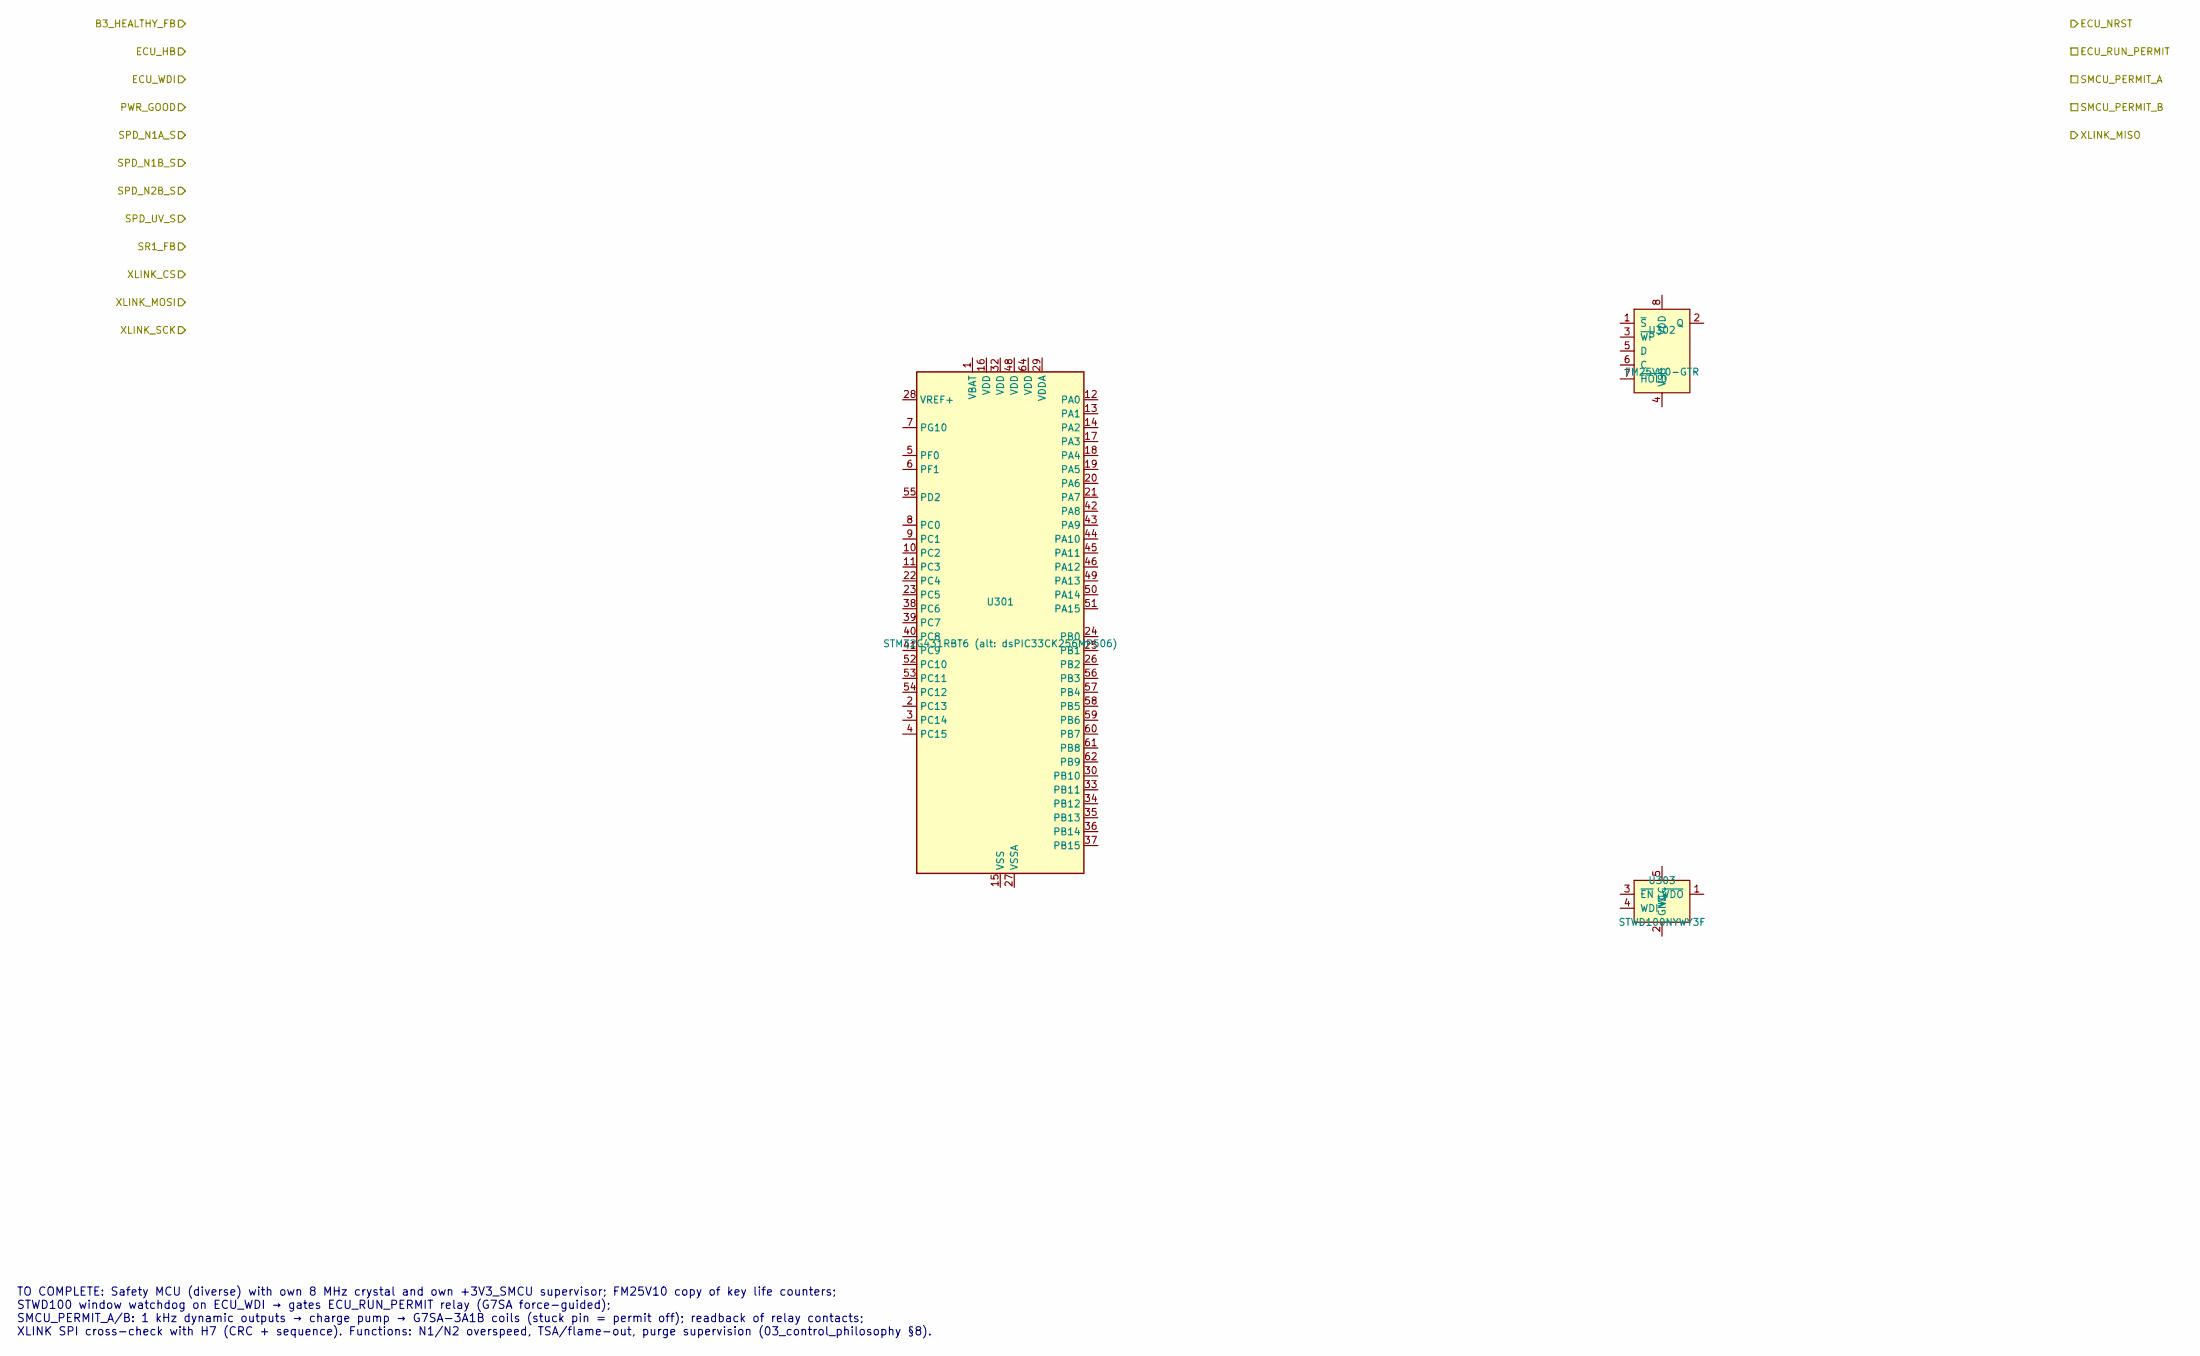
[picture p210: schematic safety_mcu.kicad_sch]

Parts:
U301: STM32G431RBT6 (alt: dsPIC33CK256MP506); LQFP-64_10x10mm_P0.5mm; MPN STM32G431RBT6; LCSC C431633
U302: FM25V10-GTR; SOIC-8_3.9x4.9mm_P1.27mm; MPN FM25V10-GTR; LCSC C44173
U303: STWD100NYWY3F; SOT-23-5; MPN STWD100NYWY3F; LCSC C46043

Connections:
unnamed: U301.15 (VSS), U301.31 (VSS), U301.47 (VSS), U301.63 (VSS)

Notes on the sheet:
TO COMPLETE: Safety MCU (diverse) with own 8 MHz crystal and own +3V3_SMCU supervisor; FM25V10 copy of key life counters; STWD100 window watchdog on ECU_WDI → gates ECU_RUN_PERMIT relay (G7SA force-guided); SMCU_PERMIT_A/B: 1 kHz dynamic outputs → charge pump → G7SA-3A1B coils (stuck pin = permit o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
