ahmadreza221/aurora-cchp/electronics/ecu/speed_inputs.kicad_sch

## KiCad design electronics/ecu/speed_inputs.kicad_sch (2026-10-21)

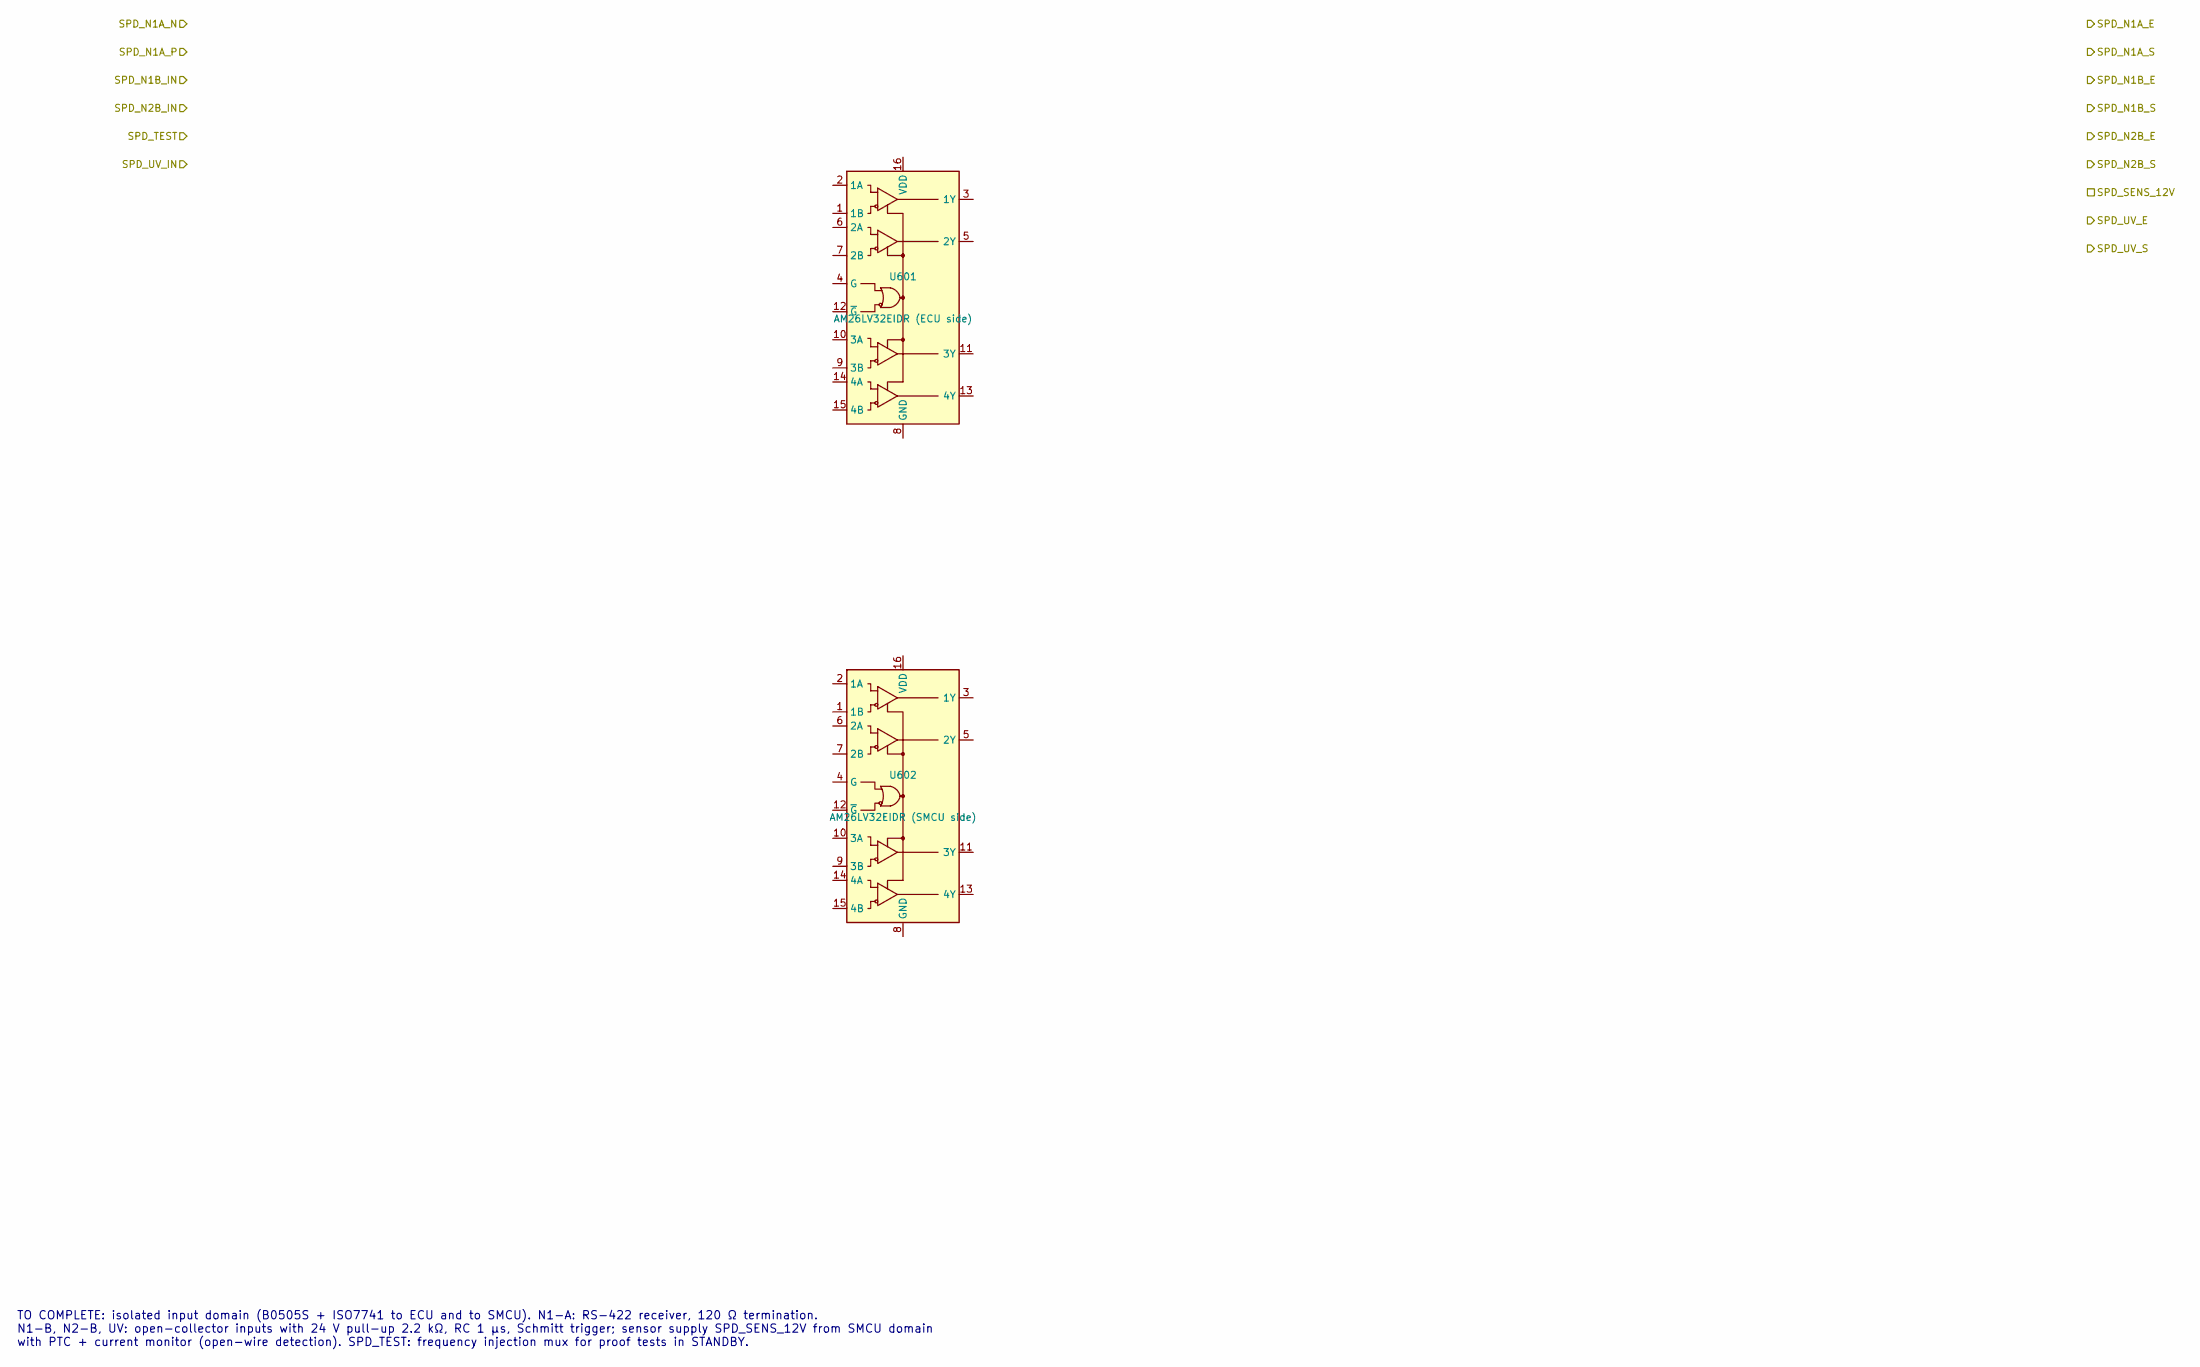
[picture p211: schematic speed_inputs.kicad_sch]

Parts:
U601: AM26LV32EIDR (ECU side); MPN AM26LV32EIDR; LCSC C527448
U602: AM26LV32EIDR (SMCU side); MPN AM26LV32EIDR; LCSC C527448

Notes on the sheet:
TO COMPLETE: isolated input domain (B0505S + ISO7741 to ECU and to SMCU). N1-A: RS-422 receiver, 120 Ω termination. N1-B, N2-B, UV: open-collector inputs with 24 V pull-up 2.2 kΩ, RC 1 µs, Schmitt trigger; sensor supply SPD_SENS_12V from SMCU domain with PTC + current monitor (open-wire detection).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
