ahmadreza221/aurora-cchp/electronics/b1_ecu/out/can.kicad_sch

## KiCad design electronics/b1_ecu/out/can.kicad_sch (2026-10-22)

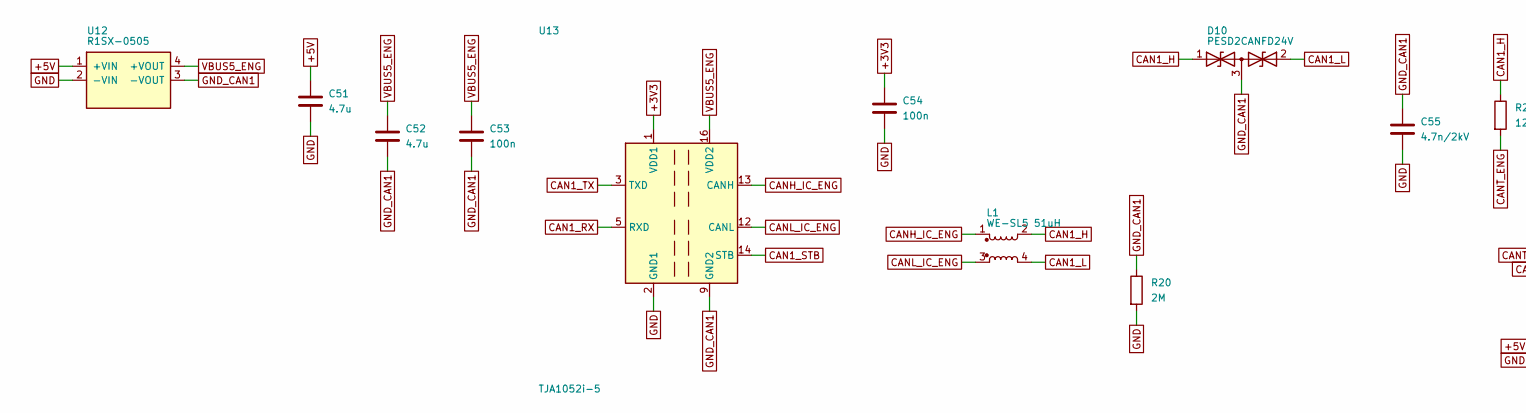
[picture p212: schematic can.kicad_sch, part in row 1, column 1]

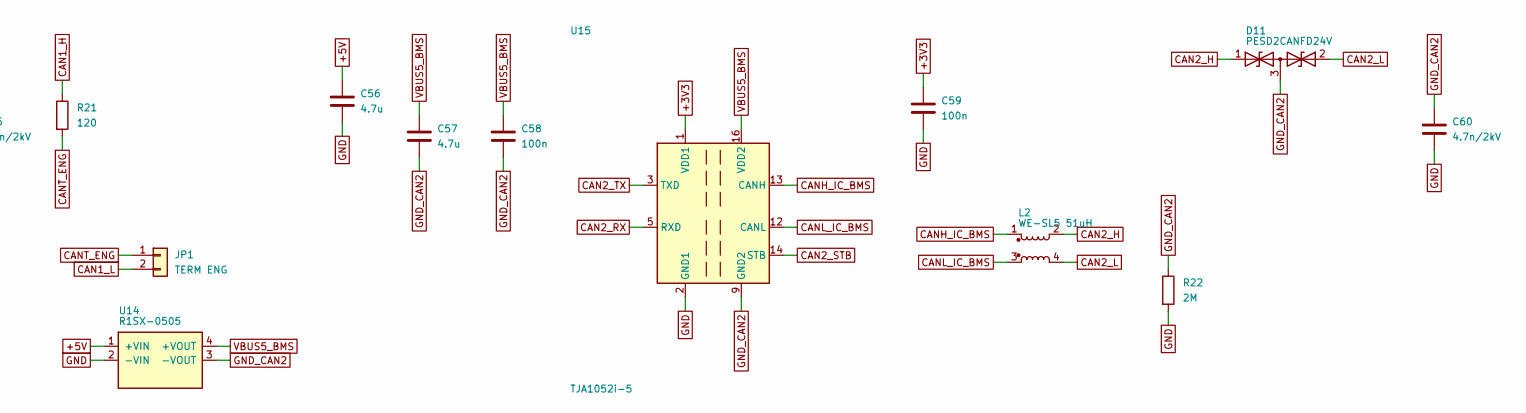
[picture p213: schematic can.kicad_sch, part in row 1, column 2]

Parts:
C51, C52, C56, C57: 4.7u; C_0805_2012Metric
C53, C54, C58, C59: 100n; C_0402_1005Metric
C55, C60: 4.7n/2kV; C_1206_3216Metric
D10, D11: PESD2CANFD24V; SOT-23; MPN PESD2CANFD24V-T; LCSC C552486
JP1: TERM ENG; PinHeader_1x02_P2.54mm_Vertical; MPN 61300211121
L1, L2: WE-SL5 51uH; MPN 744235510; LCSC C5331174
R20, R22: 2M; R_0402_1005Metric
R21: 120; R_0603_1608Metric
U12, U14: R1SX-0505; MPN R1SX-0505
U13, U15: TJA1052i-5; SOIC-16W_7.5x10.3mm_P1.27mm; MPN TJA1052IT/5Y; LCSC C92210

Connections:
+3V3: C54.1, C59.1, U13.1 (VDD1), U15.1 (VDD1)
+5V: C51.1, C56.1, U12.1 (+VIN), U14.1 (+VIN)
CAN1_H: D10.1 (A1), L1.2, R21.1
CAN1_L: D10.2 (A2), JP1.2, L1.4
CAN1_RX: U13.5 (RXD)
CAN1_STB: U13.14 (STB)
CAN1_TX: U13.3 (TXD)
CAN2_H: D11.1 (A1), L2.2
CAN2_L: D11.2 (A2), L2.4
CAN2_RX: U15.5 (RXD)
CAN2_STB: U15.14 (STB)
CAN2_TX: U15.3 (TXD)
CANH_IC_BMS: L2.1, U15.13 (CANH)
CANH_IC_ENG: L1.1, U13.13 (CANH)
CANL_IC_BMS: L2.3, U15.12 (CANL)
CANL_IC_ENG: L1.3, U13.12 (CANL)
CANT_ENG: JP1.1, R21.2
GND: C51.2, C54.2, C55.2, C56.2, C59.2, C60.2, R20.2, R22.2, U12.2 (-VIN), U13.2 (GND1), U13.7 (GND1), U13.8 (GND1), U14.2 (-VIN), U15.2 (GND1), U15.7 (GND1), U15.8 (GND1)
GND_CAN1: C52.2, C53.2, C55.1, D10.3 (common), R20.1, U12.3 (-VOUT), U13.9 (GND2), U13.10 (GND2), U13.15 (GND2)
GND_CAN2: C57.2, C58.2, C60.1, D11.3 (common), R22.1, U14.3 (-VOUT), U15.9 (GND2), U15.10 (GND2), U15.15 (GND2)
VBUS5_BMS: C57.1, C58.1, U14.4 (+VOUT), U15.11 (VDD2), U15.16 (VDD2)
VBUS5_ENG: C52.1, C53.1, U12.4 (+VOUT), U13.11 (VDD2), U13.16 (VDD2)
