ahmadreza221/aurora-cchp/electronics/b1_ecu/out/connectors.kicad_sch

## KiCad design electronics/b1_ecu/out/connectors.kicad_sch (2026-10-22)

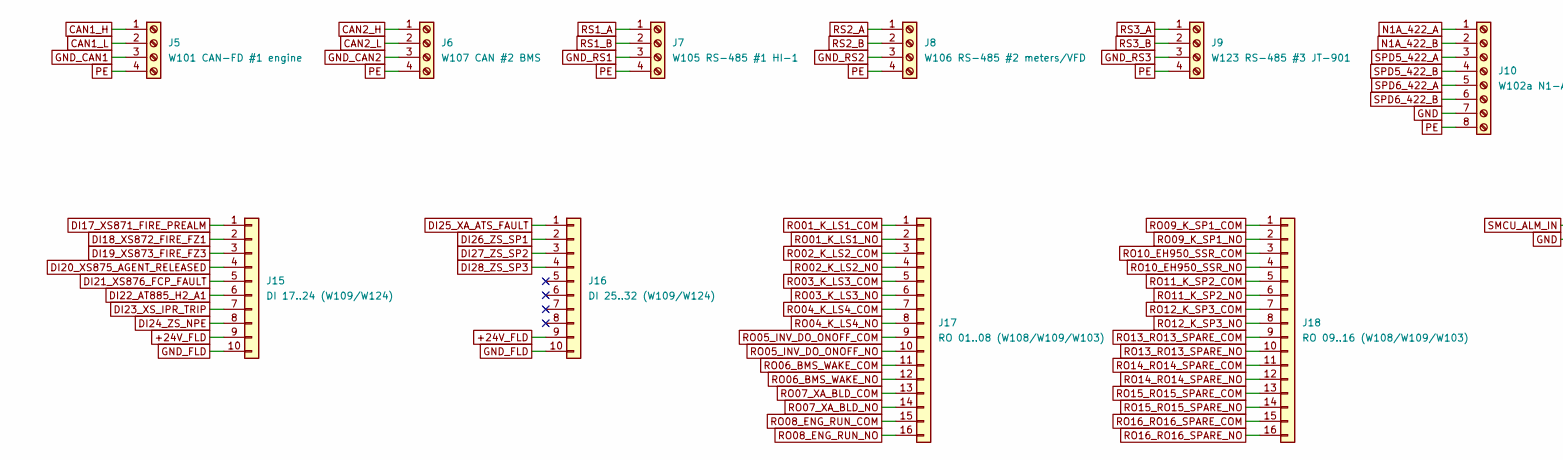
[picture p214: schematic connectors.kicad_sch, part in row 1, column 1]

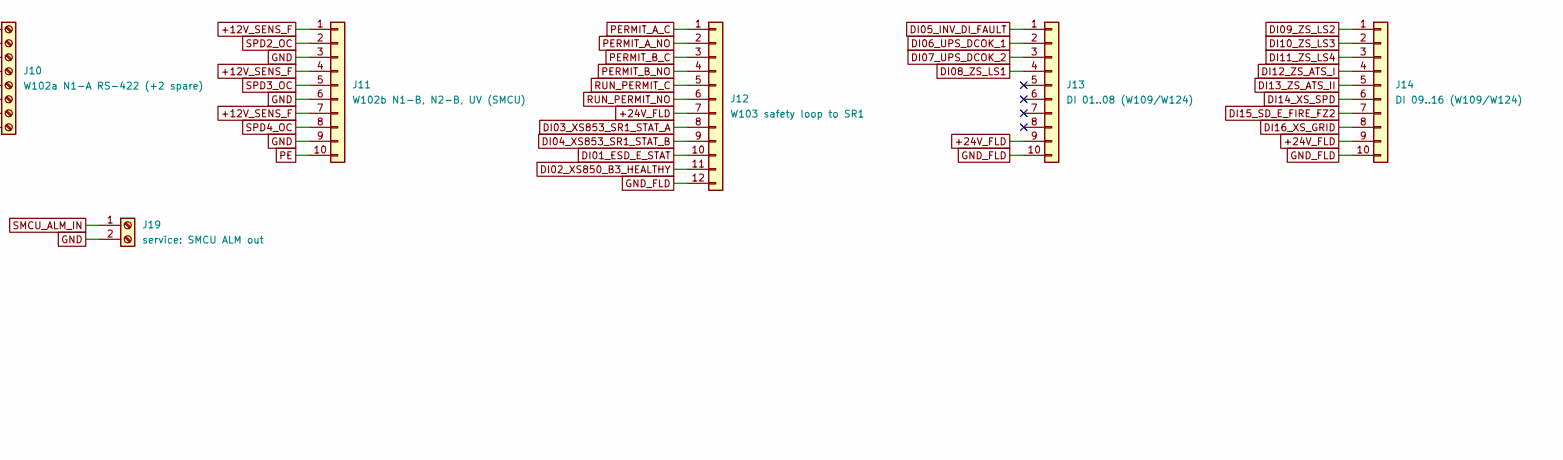
[picture p215: schematic connectors.kicad_sch, part in row 1, column 2]

Parts:
J5: W101 CAN-FD #1 engine; TerminalBlock_Phoenix_MKDS-1-4-3.81_1x04_P3.81mm_Horizontal; MPN MC 1,5/4-G-3,81
J6: W107 CAN #2 BMS; TerminalBlock_Phoenix_MKDS-1-4-3.81_1x04_P3.81mm_Horizontal; MPN MC 1,5/4-G-3,81
J7: W105 RS-485 #1 HI-1; TerminalBlock_Phoenix_MKDS-1-4-3.81_1x04_P3.81mm_Horizontal; MPN MC 1,5/4-G-3,81
J8: W106 RS-485 #2 meters/VFD; TerminalBlock_Phoenix_MKDS-1-4-3.81_1x04_P3.81mm_Horizontal; MPN MC 1,5/4-G-3,81
J9: W123 RS-485 #3 JT-901; TerminalBlock_Phoenix_MKDS-1-4-3.81_1x04_P3.81mm_Horizontal; MPN MC 1,5/4-G-3,81
J10: W102a N1-A RS-422 (+2 spare); TerminalBlock_Phoenix_MKDS-1-8-3.81_1x08_P3.81mm_Horizontal; MPN MC 1,5/8-G-3,81
J11: W102b N1-B, N2-B, UV (SMCU); TerminalBlock_Phoenix_MKDS-1-10-3.81_1x10_P3.81mm_Horizontal; MPN MC 1,5/10-G-3,81
J12: W103 safety loop to SR1; TerminalBlock_Phoenix_MKDS-1,5-12-5.08_1x12_P5.08mm_Horizon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; MPN MSTBA 2,5/12-G-5,08
J13: DI 01..08 (W109/W124); TerminalBlock_Phoenix_MKDS-1,5-10-5.08_1x10_P5.08mm_Horizon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; MPN MSTBA 2,5/10-G-5,08
J14: DI 09..16 (W109/W124); TerminalBlock_Phoenix_MKDS-1,5-10-5.08_1x10_P5.08mm_Horizon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; MPN MSTBA 2,5/10-G-5,08
J15: DI 17..24 (W109/W124); TerminalBlock_Phoenix_MKDS-1,5-10-5.08_1x10_P5.08mm_Horizon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; MPN MSTBA 2,5/10-G-5,08
J16: DI 25..32 (W109/W124); TerminalBlock_Phoenix_MKDS-1,5-10-5.08_1x10_P5.08mm_Horizon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; MPN MSTBA 2,5/10-G-5,08
J17: RO 01..08 (W108/W109/W103); TerminalBlock_Phoenix_MKDS-1,5-16-5.08_1x16_P5.08mm_Horizon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; MPN MSTBA 2,5/16-G-5,08
J18: RO 09..16 (W108/W109/W103); TerminalBlock_Phoenix_MKDS-1,5-16-5.08_1x16_P5.08mm_Horizon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; MPN MSTBA 2,5/16-G-5,08
J19: service: SMCU ALM out; TerminalBlock_Phoenix_MKDS-1-2-3.81_1x02_P3.81mm_Horizontal; MPN MC 1,5/2-G-3,81

Connections:
+12V_SENS_F: J11.1, J11.4, J11.7
+24V_FLD: J12.7, J13.9, J14.9, J15.9, J16.9
CAN1_H: J5.1
CAN1_L: J5.2
CAN2_H: J6.1
CAN2_L: J6.2
DI01_ESD_E_STAT: J12.10
DI02_XS850_B3_HEALTHY: J12.11
DI03_XS853_SR1_STAT_A: J12.8
DI04_XS853_SR1_STAT_B: J12.9
DI05_INV_DI_FAULT: J13.1
DI06_UPS_DCOK_1: J13.2
DI07_UPS_DCOK_2: J13.3
DI08_ZS_LS1: J13.4
DI09_ZS_LS2: J14.1
DI10_ZS_LS3: J14.2
DI11_ZS_LS4: J14.3
DI12_ZS_ATS_I: J14.4
DI13_ZS_ATS_II: J14.5
DI14_XS_SPD: J14.6
DI15_SD_E_FIRE_FZ2: J14.7
DI16_XS_GRID: J14.8
DI17_XS871_FIRE_PREALM: J15.1
DI18_XS872_FIRE_FZ1: J15.2
DI19_XS873_FIRE_FZ3: J15.3
DI20_XS875_AGENT_RELEASED: J15.4
DI21_XS876_FCP_FAULT: J15.5
DI22_AT885_H2_A1: J15.6
DI23_XS_IPR_TRIP: J15.7
DI24_ZS_NPE: J15.8
DI25_XA_ATS_FAULT: J16.1
DI26_ZS_SP1: J16.2
DI27_ZS_SP2: J16.3
DI28_ZS_SP3: J16.4
GND: J10.7, J11.3, J11.6, J11.9, J19.2
GND_CAN1: J5.3
GND_CAN2: J6.3
GND_FLD: J12.12, J13.10, J14.10, J15.10, J16.10
GND_RS1: J7.3
GND_RS2: J8.3
GND_RS3: J9.3
N1A_422_A: J10.1
N1A_422_B: J10.2
PE: J5.4, J6.4, J7.4, J8.4, J9.4, J10.8, J11.10
PERMIT_A_C: J12.1
PERMIT_A_NO: J12.2
PERMIT_B_C: J12.3
PERMIT_B_NO: J12.4
RO01_K_LS1_COM: J17.1
RO01_K_LS1_NO: J17.2
RO02_K_LS2_COM: J17.3
RO02_K_LS2_NO: J17.4
RO03_K_LS3_COM: J17.5
RO03_K_LS3_NO: J17.6
RO04_K_LS4_COM: J17.7
RO04_K_LS4_NO: J17.8
RO05_INV_DO_ONOFF_COM: J17.9
RO05_INV_DO_ONOFF_NO: J17.10
RO06_BMS_WAKE_COM: J17.11
RO06_BMS_WAKE_NO: J17.12
RO07_XA_BLD_COM: J17.13
RO07_XA_BLD_NO: J17.14
RO08_ENG_RUN_COM: J17.15
RO08_ENG_RUN_NO: J17.16
RO09_K_SP1_COM: J18.1
RO09_K_SP1_NO: J18.2
RO10_EH950_SSR_COM: J18.3
RO10_EH950_SSR_NO: J18.4
RO11_K_SP2_COM: J18.5
RO11_K_SP2_NO: J18.6
RO12_K_SP3_COM: J18.7
RO12_K_SP3_NO: J18.8
RO13_RO13_SPARE_COM: J18.9
RO13_RO13_SPARE_NO: J18.10
RO14_RO14_SPARE_COM: J18.11
RO14_RO14_SPARE_NO: J18.12
RO15_RO15_SPARE_COM: J18.13
RO15_RO15_SPARE_NO: J18.14
RO16_RO16_SPARE_COM: J18.15
RO16_RO16_SPARE_NO: J18.16
RS1_A: J7.1
RS1_B: J7.2
RS2_A: J8.1
RS2_B: J8.2
RS3_A: J9.1
RS3_B: J9.2
RUN_PERMIT_C: J12.5
RUN_PERMIT_NO: J12.6
SMCU_ALM_IN: J19.1
SPD2_OC: J11.2
SPD3_OC: J11.5
SPD4_OC: J11.8
SPD5_422_A: J10.3
SPD5_422_B: J10.4
SPD6_422_A: J10.5
SPD6_422_B: J10.6
