ahmadreza221/aurora-cchp/electronics/b1_ecu/out/digital_inputs.kicad_sch

## KiCad design electronics/b1_ecu/out/digital_inputs.kicad_sch (2026-10-22)

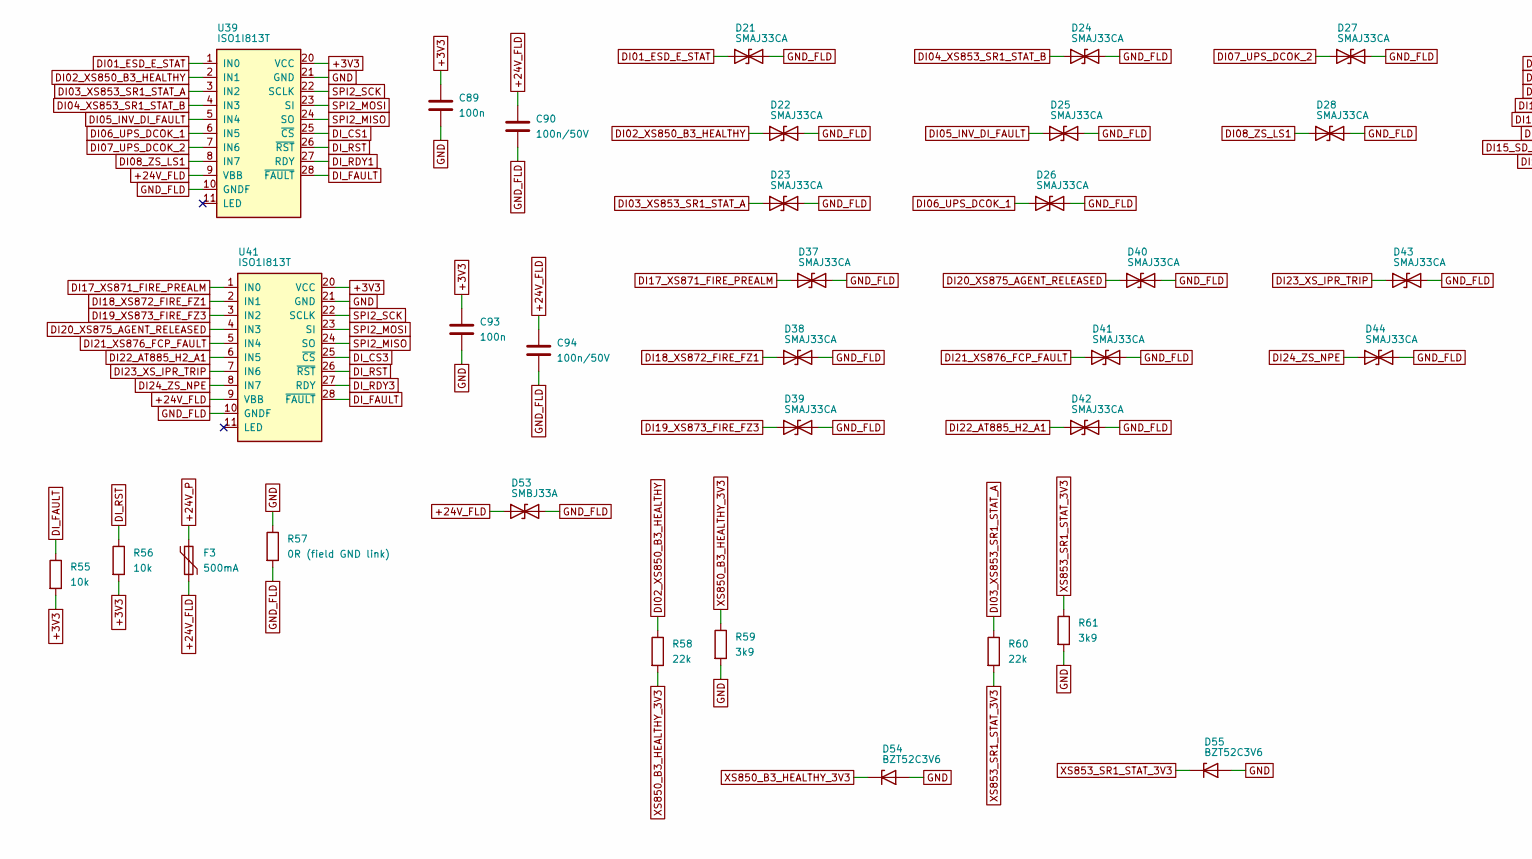
[picture p216: schematic digital_inputs.kicad_sch, part in row 1, column 1]

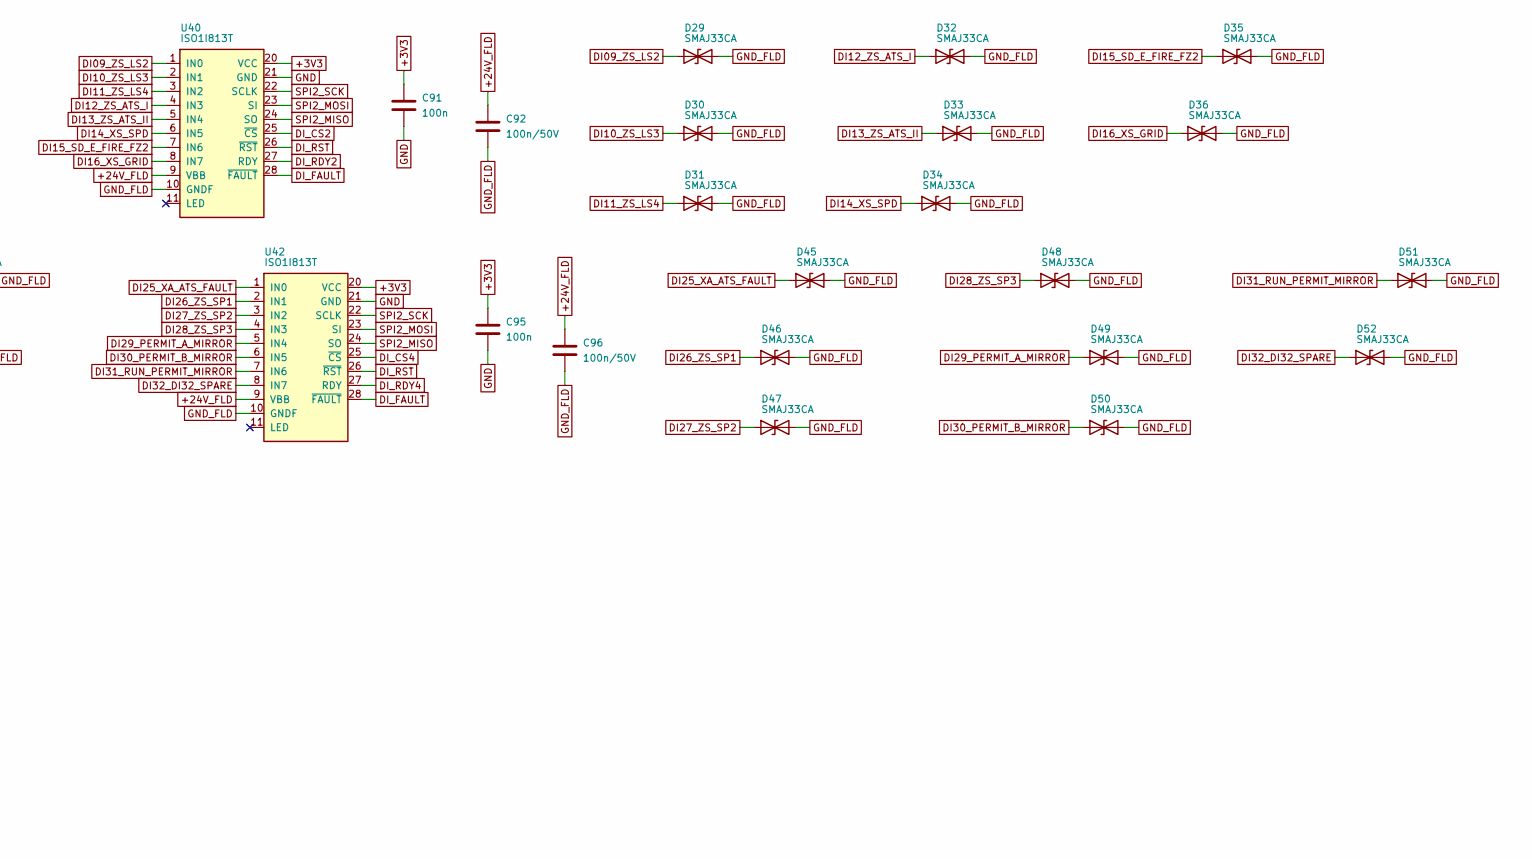
[picture p217: schematic digital_inputs.kicad_sch, part in row 1, column 2]

Parts:
C89, C91, C93, C95: 100n; C_0402_1005Metric
C90, C92, C94, C96: 100n/50V; C_0603_1608Metric
D21, D22, D23, D24, D25, D26, D27, D28, D29, D30, D31, D32, D33, D34, D35, D36, D37, D38, D39, D40, D41, D42, D43, D44, D45, D46, D47, D48, D49, D50, D51, D52: SMAJ33CA; D_SMA; MPN SMAJ33CA-TR; LCSC C115251
D53: SMBJ33A; D_SMB; MPN SMBJ33A-TR; LCSC C133662
D54, D55: BZT52C3V6; D_SOD-123; MPN BZT52H-C3V6
F3: 500mA; Fuse_1206_3216Metric; MPN PFRA.050
R55, R56: 10k; R_0402_1005Metric
R57: 0R (field GND link); R_1206_3216Metric
R58, R60: 22k; R_0603_1608Metric
R59, R61: 3k9; R_0402_1005Metric
U39, U40, U41, U42: ISO1I813T; ST_PowerSSO-36_SlugDown; MPN ISO1I813TXUMA1; LCSC C538445

Connections:
+3V3: C89.1, C91.1, C93.1, C95.1, R55.2, R56.2, U39.20 (VCC), U40.20 (VCC), U41.20 (VCC), U42.20 (VCC)
+24V_FLD: C90.1, C92.1, C94.1, C96.1, D53.1 (A1), F3.2, U39.9 (VBB), U40.9 (VBB), U41.9 (VBB), U42.9 (VBB)
+24V_P: F3.1
DI01_ESD_E_STAT: D21.1 (A1), U39.1 (IN0)
DI02_XS850_B3_HEALTHY: D22.1 (A1), R58.1, U39.2 (IN1)
DI03_XS853_SR1_STAT_A: D23.1 (A1), R60.1, U39.3 (IN2)
DI04_XS853_SR1_STAT_B: D24.1 (A1), U39.4 (IN3)
DI05_INV_DI_FAULT: D25.1 (A1), U39.5 (IN4)
DI06_UPS_DCOK_1: D26.1 (A1), U39.6 (IN5)
DI07_UPS_DCOK_2: D27.1 (A1), U39.7 (IN6)
DI08_ZS_LS1: D28.1 (A1), U39.8 (IN7)
DI09_ZS_LS2: D29.1 (A1), U40.1 (IN0)
DI10_ZS_LS3: D30.1 (A1), U40.2 (IN1)
DI11_ZS_LS4: D31.1 (A1), U40.3 (IN2)
DI12_ZS_ATS_I: D32.1 (A1), U40.4 (IN3)
DI13_ZS_ATS_II: D33.1 (A1), U40.5 (IN4)
DI14_XS_SPD: D34.1 (A1), U40.6 (IN5)
DI15_SD_E_FIRE_FZ2: D35.1 (A1), U40.7 (IN6)
DI16_XS_GRID: D36.1 (A1), U40.8 (IN7)
DI17_XS871_FIRE_PREALM: D37.1 (A1), U41.1 (IN0)
DI18_XS872_FIRE_FZ1: D38.1 (A1), U41.2 (IN1)
DI19_XS873_FIRE_FZ3: D39.1 (A1), U41.3 (IN2)
DI20_XS875_AGENT_RELEASED: D40.1 (A1), U41.4 (IN3)
DI21_XS876_FCP_FAULT: D41.1 (A1), U41.5 (IN4)
DI22_AT885_H2_A1: D42.1 (A1), U41.6 (IN5)
DI23_XS_IPR_TRIP: D43.1 (A1), U41.7 (IN6)
DI24_ZS_NPE: D44.1 (A1), U41.8 (IN7)
DI25_XA_ATS_FAULT: D45.1 (A1), U42.1 (IN0)
DI26_ZS_SP1: D46.1 (A1), U42.2 (IN1)
DI27_ZS_SP2: D47.1 (A1), U42.3 (IN2)
DI28_ZS_SP3: D48.1 (A1), U42.4 (IN3)
DI29_PERMIT_A_MIRROR: D49.1 (A1), U42.5 (IN4)
DI30_PERMIT_B_MIRROR: D50.1 (A1), U42.6 (IN5)
DI31_RUN_PERMIT_MIRROR: D51.1 (A1), U42.7 (IN6)
DI32_DI32_SPARE: D52.1 (A1), U42.8 (IN7)
DI_CS1: U39.25 (~CS)
DI_CS2: U40.25 (~CS)
DI_CS3: U41.25 (~CS)
DI_CS4: U42.25 (~CS)
DI_FAULT: R55.1, U39.28 (~FAULT), U40.28 (~FAULT), U41.28 (~FAULT), U42.28 (~FAULT)
DI_RDY1: U39.27 (RDY)
DI_RDY2: U40.27 (RDY)
DI_RDY3: U41.27 (RDY)
DI_RDY4: U42.27 (RDY)
DI_RST: R56.1, U39.26 (~RST), U40.26 (~RST), U41.26 (~RST), U42.26 (~RST)
GND: C89.2, C91.2, C93.2, C95.2, D54.2 (A), D55.2 (A), R57.1, R59.2, R61.2, U39.21 (GND), U40.21 (GND), U41.21 (GND), U42.21 (GND)
GND_FLD: C90.2, C92.2, C94.2, C96.2, D21.2 (A2), D22.2 (A2), D23.2 (A2), D24.2 (A2), D25.2 (A2), D26.2 (A2), D27.2 (A2), D28.2 (A2), D29.2 (A2), D30.2 (A2), D31.2 (A2), D32.2 (A2), D33.2 (A2), D34.2 (A2), D35.2 (A2), D36.2 (A2), D37.2 (A2), D38.2 (A2), D39.2 (A2), D40.2 (A2), D41.2 (A2), D42.2 (A2), D43.2 (A2), D44.2 (A2), D45.2 (A2), D46.2 (A2), D47.2 (A2), D48.2 (A2), D49.2 (A2), D50.2 (A2), D51.2 (A2), D52.2 (A2), D53.2 (A2), R57.2, U39.10 (GNDF), U40.10 (GNDF), U41.10 (GNDF), U42.10 (GNDF)
SPI2_MISO: U39.24 (SO), U40.24 (SO), U41.24 (SO), U42.24 (SO)
SPI2_MOSI: U39.23 (SI), U40.23 (SI), U41.23 (SI), U42.23 (SI)
SPI2_SCK: U39.22 (SCLK), U40.22 (SCLK), U41.22 (SCLK), U42.22 (SCLK)
XS850_B3_HEALTHY_3V3: D54.1 (K), R58.2, R59.1
XS853_SR1_STAT_3V3: D55.1 (K), R60.2, R61.1
