ahmadreza221/aurora-cchp/electronics/b1_ecu/out/ethernet.kicad_sch

## KiCad design electronics/b1_ecu/out/ethernet.kicad_sch (2026-10-22)

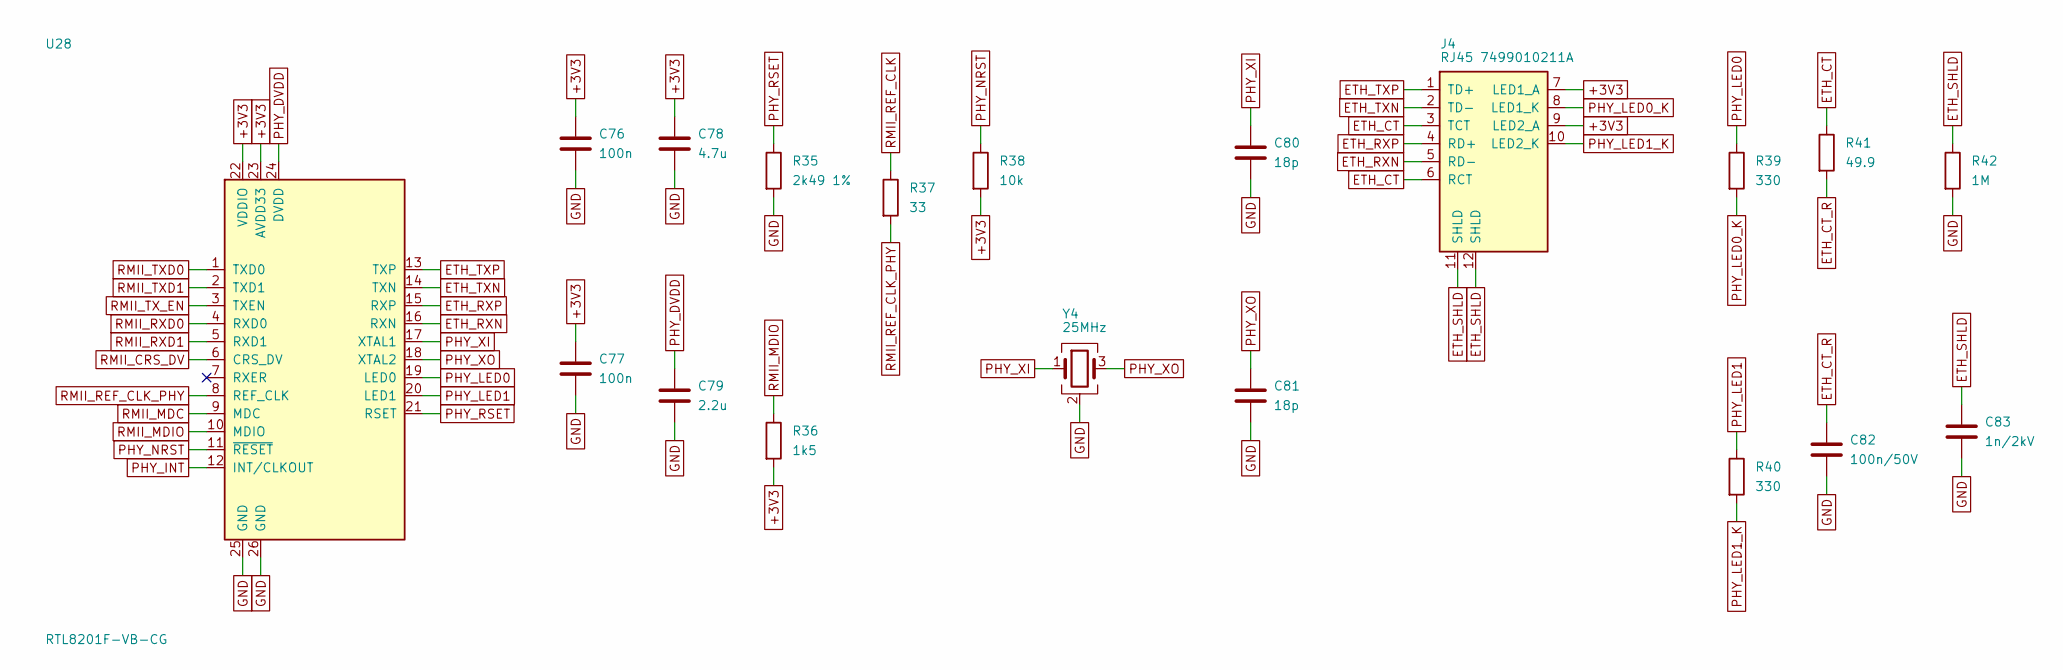
[picture p218: schematic ethernet.kicad_sch]

Parts:
C76, C77: 100n; C_0402_1005Metric
C78: 4.7u; C_0805_2012Metric
C79: 2.2u; C_0603_1608Metric
C80, C81: 18p; C_0402_1005Metric
C82: 100n/50V; C_0603_1608Metric
C83: 1n/2kV; C_1206_3216Metric
J4: RJ45 7499010211A; RJ45_Wuerth_7499010121A_Horizontal; MPN 7499010211A
R35: 2k49 1%; R_0603_1608Metric
R36: 1k5; R_0402_1005Metric
R37: 33; R_0402_1005Metric
R38: 10k; R_0402_1005Metric
R39, R40: 330; R_0402_1005Metric
R41: 49.9; R_0603_1608Metric
R42: 1M; R_0805_2012Metric
U28: RTL8201F-VB-CG; UQFN-32_5x5mm_P0.5mm; MPN RTL8201F-VB-CG; LCSC C45044
Y4: 25MHz; Crystal_SMD_3225-4Pin_3.2x2.5mm; MPN CM9V-T1A-25.000MHz

Connections:
+3V3: C76.1, C77.1, C78.1, J4.7 (LED1_A), J4.9 (LED2_A), R36.2, R38.2, U28.22 (VDDIO), U28.23 (AVDD33)
ETH_CT: J4.3 (TCT), J4.6 (RCT), R41.1
ETH_CT_R: C82.1, R41.2
ETH_RXN: J4.5 (RD-), U28.16 (RXN)
ETH_RXP: J4.4 (RD+), U28.15 (RXP)
ETH_SHLD: C83.1, J4.11 (SHLD), J4.12 (SHLD), R42.1
ETH_TXN: J4.2 (TD-), U28.14 (TXN)
ETH_TXP: J4.1 (TD+), U28.13 (TXP)
GND: C76.2, C77.2, C78.2, C79.2, C80.2, C81.2, C82.2, C83.2, R35.2, R42.2, U28.25 (GND), U28.26 (GND), Y4.2 (G), Y4.4 (G)
PHY_DVDD: C79.1, U28.24 (DVDD)
PHY_INT: U28.12 (INT/CLKOUT)
PHY_LED0: R39.1, U28.19 (LED0)
PHY_LED0_K: J4.8 (LED1_K), R39.2
PHY_LED1: R40.1, U28.20 (LED1)
PHY_LED1_K: J4.10 (LED2_K), R40.2
PHY_NRST: R38.1, U28.11 (~RESET)
PHY_RSET: R35.1, U28.21 (RSET)
PHY_XI: C80.1, U28.17 (XTAL1), Y4.1
PHY_XO: C81.1, U28.18 (XTAL2), Y4.3
RMII_CRS_DV: U28.6 (CRS_DV)
RMII_MDC: U28.9 (MDC)
RMII_MDIO: R36.1, U28.10 (MDIO)
RMII_REF_CLK: R37.1
RMII_REF_CLK_PHY: R37.2, U28.8 (REF_CLK)
RMII_RXD0: U28.4 (RXD0)
RMII_RXD1: U28.5 (RXD1)
RMII_TXD0: U28.1 (TXD0)
RMII_TXD1: U28.2 (TXD1)
RMII_TX_EN: U28.3 (TXEN)
