ahmadreza221/aurora-cchp/electronics/b1_ecu/out/mcu.kicad_sch

## KiCad design electronics/b1_ecu/out/mcu.kicad_sch (2026-10-22)

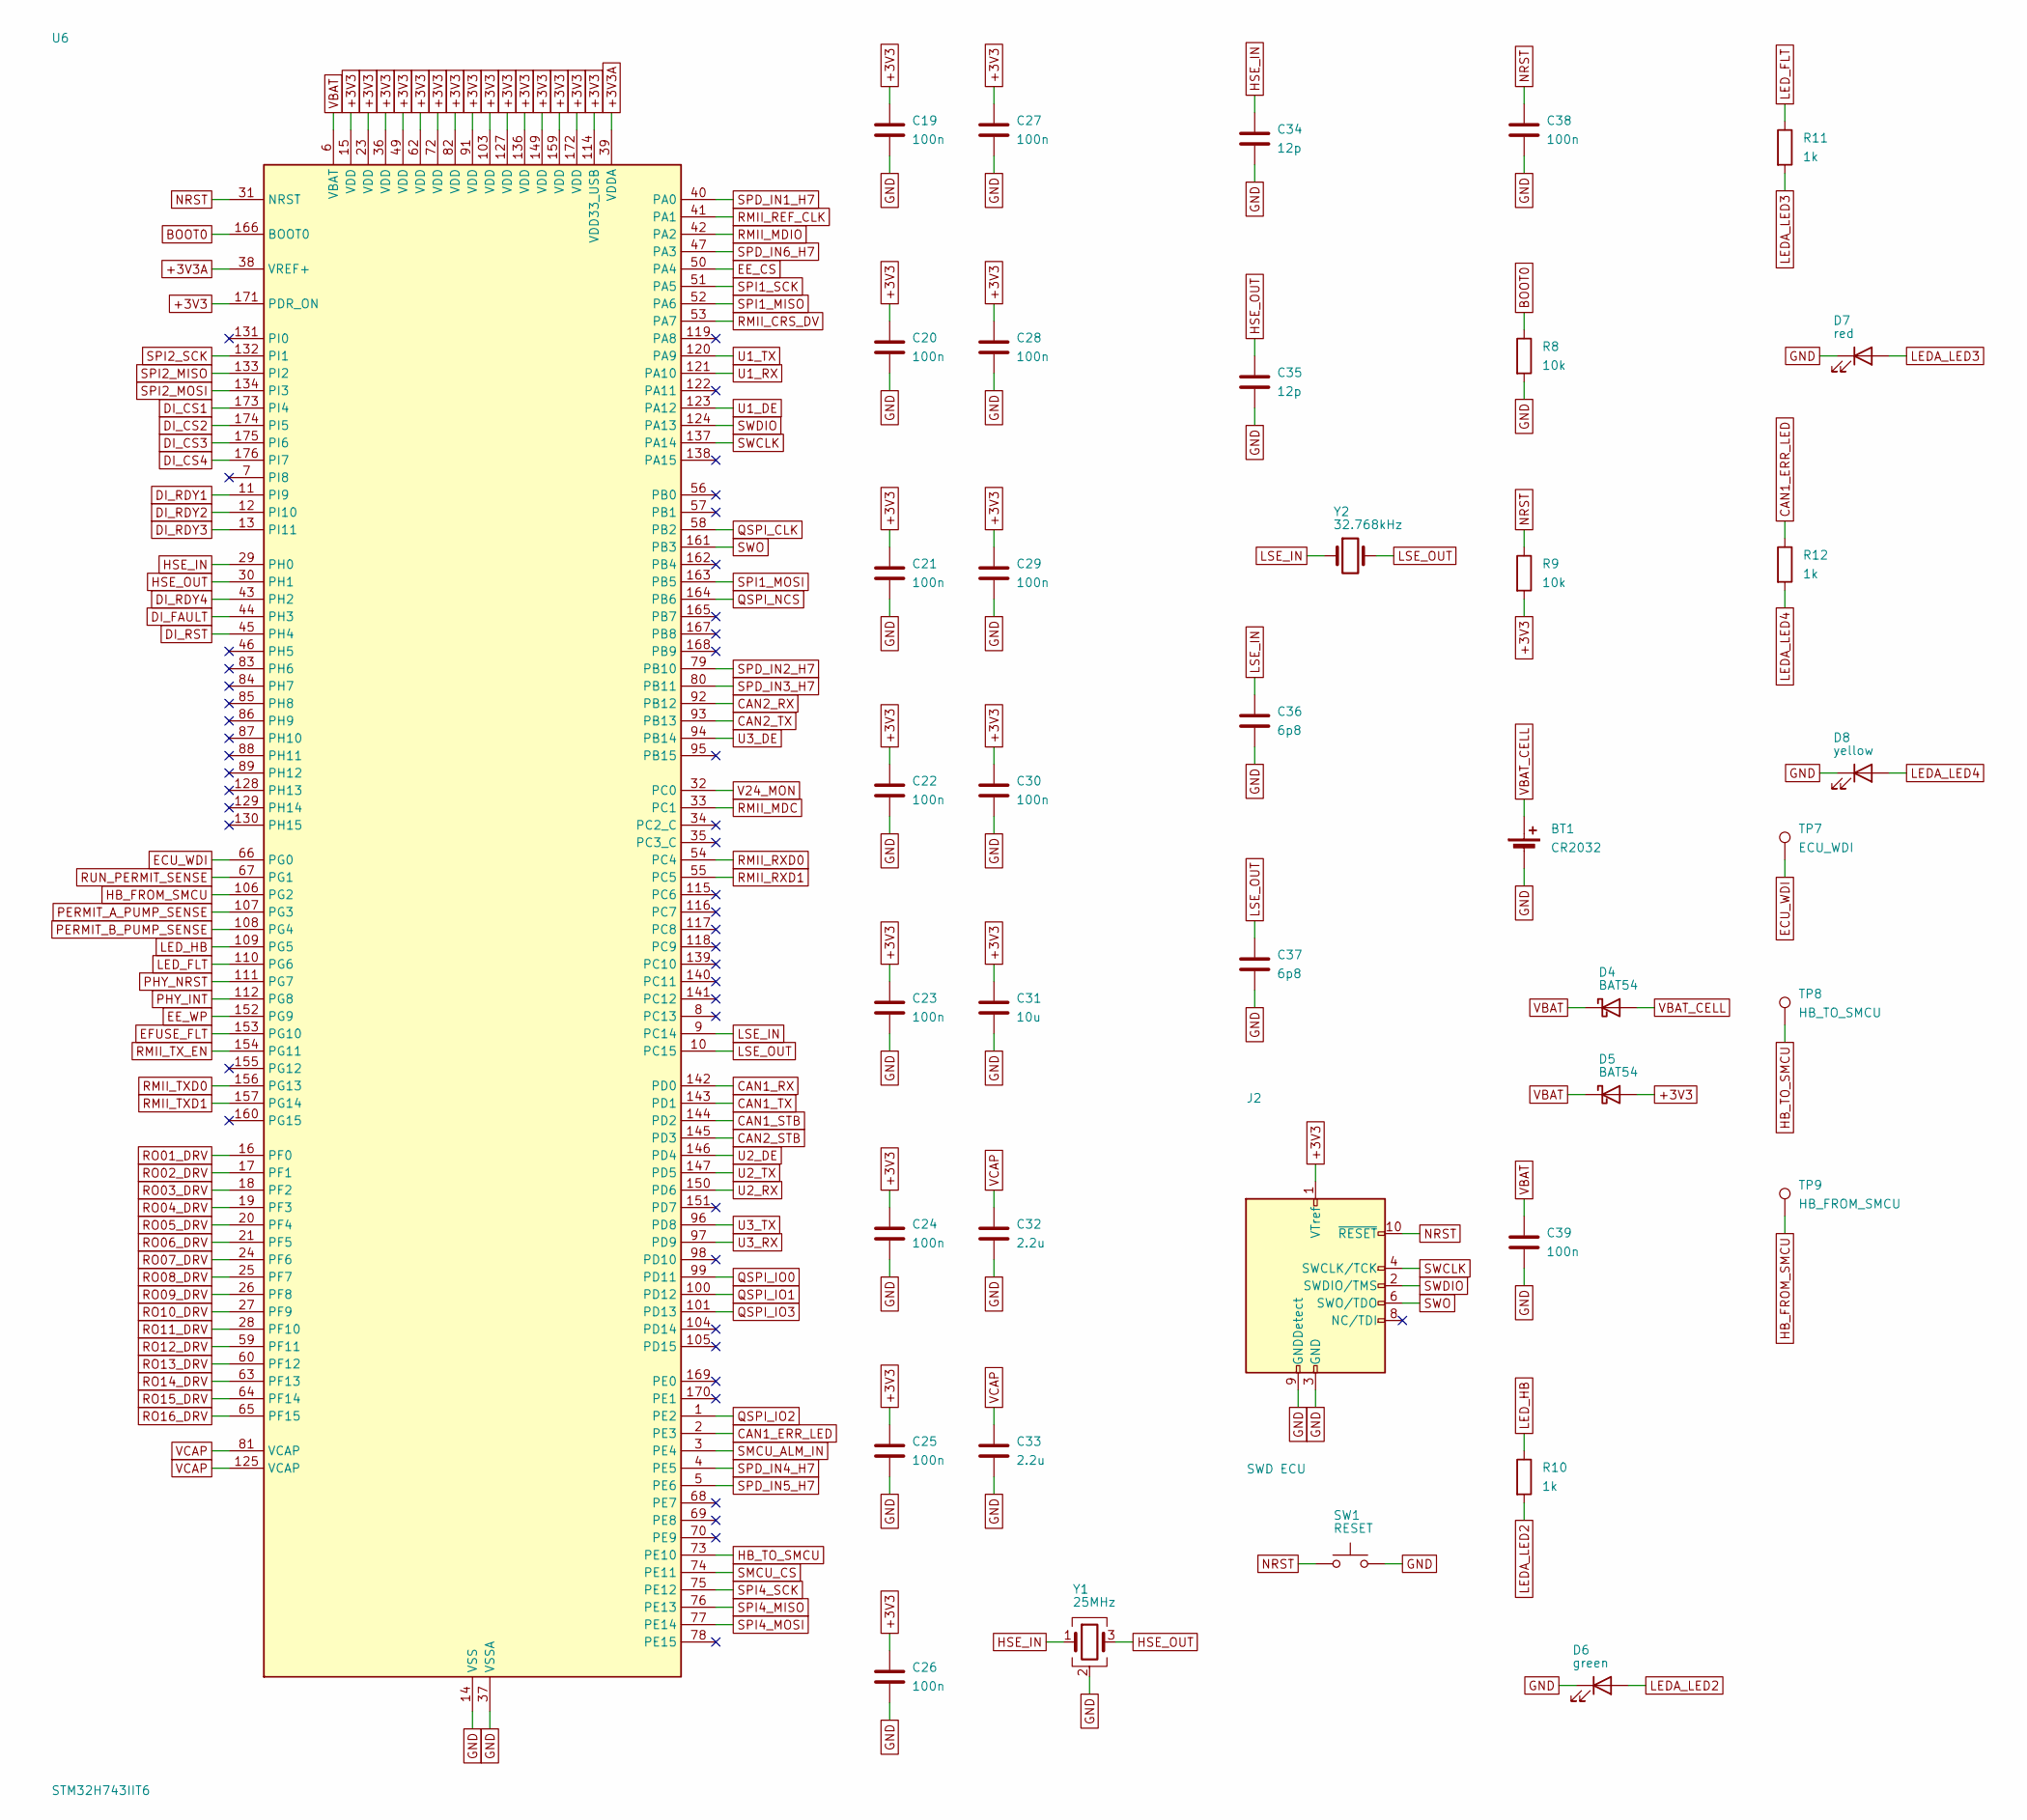
[picture p219: schematic mcu.kicad_sch]

Parts:
BT1: CR2032; BatteryHolder_Keystone_3034_1x20mm; MPN CR2032
C19, C20, C21, C22, C23, C24, C25, C26, C27, C28, C29, C30, C38, C39: 100n; C_0402_1005Metric
C31: 10u; C_0805_2012Metric
C32, C33: 2.2u; C_0603_1608Metric
C34, C35: 12p; C_0402_1005Metric
C36, C37: 6p8; C_0402_1005Metric
D4, D5: BAT54; D_SOD-123; MPN BAT54-7
D6: green; LED_0603_1608Metric
D7: red; LED_0603_1608Metric
D8: yellow; LED_0603_1608Metric
J2: SWD ECU; PinHeader_2x05_P1.27mm_Vertical_SMD; MPN 20021111-00010T4LF
R8, R9: 10k; R_0402_1005Metric
R10, R11, R12: 1k; R_0402_1005Metric
SW1: RESET; SW_SPST_TL3342; MPN PTS645SM43SMTR92
TP7: ECU_WDI; TestPoint_Pad_D1.5mm
TP8: HB_TO_SMCU; TestPoint_Pad_D1.5mm
TP9: HB_FROM_SMCU; TestPoint_Pad_D1.5mm
U6: STM32H743IIT6; LQFP-176_24x24mm_P0.5mm; MPN STM32H743IIT6; LCSC C89597
Y1: 25MHz; Crystal_SMD_3225-4Pin_3.2x2.5mm; MPN CM9V-T1A-25.000MHz
Y2: 32.768kHz; Crystal_SMD_3215-2Pin_3.2x1.5mm; MPN CM8V-T1A-32.768kHz

Connections:
+3V3: C19.1, C20.1, C21.1, C22.1, C23.1, C24.1, C25.1, C26.1, C27.1, C28.1, C29.1, C30.1, C31.1, D5.2 (A), J2.1 (VTref), R9.2, U6.15 (VDD), U6.23 (VDD), U6.36 (VDD), U6.49 (VDD), U6.62 (VDD), U6.72 (VDD), U6.82 (VDD), U6.91 (VDD), U6.103 (VDD), U6.114 (VDD33_USB), U6.127 (VDD), U6.136 (VDD), U6.149 (VDD), U6.159 (VDD), U6.171 (PDR_ON), U6.172 (VDD)
+3V3A: U6.38 (VREF+), U6.39 (VDDA)
BOOT0: R8.1, U6.166 (BOOT0)
CAN1_ERR_LED: R12.1, U6.2 (PE3)
CAN1_RX: U6.142 (PD0)
CAN1_STB: U6.144 (PD2)
CAN1_TX: U6.143 (PD1)
CAN2_RX: U6.92 (PB12)
CAN2_STB: U6.145 (PD3)
CAN2_TX: U6.93 (PB13)
DI_CS1: U6.173 (PI4)
DI_CS2: U6.174 (PI5)
DI_CS3: U6.175 (PI6)
DI_CS4: U6.176 (PI7)
DI_FAULT: U6.44 (PH3)
DI_RDY1: U6.11 (PI9)
DI_RDY2: U6.12 (PI10)
DI_RDY3: U6.13 (PI11)
DI_RDY4: U6.43 (PH2)
DI_RST: U6.45 (PH4)
ECU_WDI: TP7.1, U6.66 (PG0)
EE_CS: U6.50 (PA4)
EE_WP: U6.152 (PG9)
EFUSE_FLT: U6.153 (PG10)
GND: BT1.2 (-), C19.2, C20.2, C21.2, C22.2, C23.2, C24.2, C25.2, C26.2, C27.2, C28.2, C29.2, C30.2, C31.2, C32.2, C33.2, C34.2, C35.2, C36.2, C37.2, C38.2, C39.2, D6.1 (K), D7.1 (K), D8.1 (K), J2.3 (GND), J2.5 (GND), J2.9 (GNDDetect), R8.2, SW1.2, U6.14 (VSS), U6.22 (VSS), U6.37 (VSSA), U6.48 (VSS), U6.61 (VSS), U6.71 (VSS), U6.90 (VSS), U6.102 (VSS), U6.113 (VSS), U6.126 (VSS), U6.135 (VSS), U6.148 (VSS), U6.158 (VSS), Y1.2 (G), Y1.4 (G)
HB_FROM_SMCU: TP9.1, U6.106 (PG2)
HB_TO_SMCU: TP8.1, U6.73 (PE10)
HSE_IN: C34.1, U6.29 (PH0), Y1.1
HSE_OUT: C35.1, U6.30 (PH1), Y1.3
LEDA_LED2: D6.2 (A), R10.2
LEDA_LED3: D7.2 (A), R11.2
LEDA_LED4: D8.2 (A), R12.2
LED_FLT: R11.1, U6.110 (PG6)
LED_HB: R10.1, U6.109 (PG5)
LSE_IN: C36.1, U6.9 (PC14), Y2.1
LSE_OUT: C37.1, U6.10 (PC15), Y2.2
NRST: C38.1, J2.10 (~RESET), R9.1, SW1.1, U6.31 (NRST)
PERMIT_A_PUMP_SENSE: U6.107 (PG3)
PERMIT_B_PUMP_SENSE: U6.108 (PG4)
PHY_INT: U6.112 (PG8)
PHY_NRST: U6.111 (PG7)
QSPI_CLK: U6.58 (PB2)
QSPI_IO0: U6.99 (PD11)
QSPI_IO1: U6.100 (PD12)
QSPI_IO2: U6.1 (PE2)
QSPI_IO3: U6.101 (PD13)
QSPI_NCS: U6.164 (PB6)
RMII_CRS_DV: U6.53 (PA7)
RMII_MDC: U6.33 (PC1)
RMII_MDIO: U6.42 (PA2)
RMII_REF_CLK: U6.41 (PA1)
RMII_RXD0: U6.54 (PC4)
RMII_RXD1: U6.55 (PC5)
RMII_TXD0: U6.156 (PG13)
RMII_TXD1: U6.157 (PG14)
RMII_TX_EN: U6.154 (PG11)
RO01_DRV: U6.16 (PF0)
RO02_DRV: U6.17 (PF1)
RO03_DRV: U6.18 (PF2)
RO04_DRV: U6.19 (PF3)
RO05_DRV: U6.20 (PF4)
RO06_DRV: U6.21 (PF5)
RO07_DRV: U6.24 (PF6)
RO08_DRV: U6.25 (PF7)
RO09_DRV: U6.26 (PF8)
RO10_DRV: U6.27 (PF9)
RO11_DRV: U6.28 (PF10)
RO12_DRV: U6.59 (PF11)
RO13_DRV: U6.60 (PF12)
RO14_DRV: U6.63 (PF13)
RO15_DRV: U6.64 (PF14)
RO16_DRV: U6.65 (PF15)
RUN_PERMIT_SENSE: U6.67 (PG1)
SMCU_ALM_IN: U6.3 (PE4)
SMCU_CS: U6.74 (PE11)
SPD_IN1_H7: U6.40 (PA0)
SPD_IN2_H7: U6.79 (PB10)
SPD_IN3_H7: U6.80 (PB11)
SPD_IN4_H7: U6.4 (PE5)
SPD_IN5_H7: U6.5 (PE6)
SPD_IN6_H7: U6.47 (PA3)
SPI1_MISO: U6.52 (PA6)
SPI1_MOSI: U6.163 (PB5)
SPI1_SCK: U6.51 (PA5)
SPI2_MISO: U6.133 (PI2)
SPI2_MOSI: U6.134 (PI3)
SPI2_SCK: U6.132 (PI1)
SPI4_MISO: U6.76 (PE13)
SPI4_MOSI: U6.77 (PE14)
SPI4_SCK: U6.75 (PE12)
SWCLK: J2.4 (SWCLK/TCK), U6.137 (PA14)
SWDIO: J2.2 (SWDIO/TMS), U6.124 (PA13)
SWO: J2.6 (SWO/TDO), U6.161 (PB3)
U1_DE: U6.123 (PA12)
U1_RX: U6.121 (PA10)
U1_TX: U6.120 (PA9)
U2_DE: U6.146 (PD4)
U2_RX: U6.150 (PD6)
U2_TX: U6.147 (PD5)
U3_DE: U6.94 (PB14)
U3_RX: U6.97 (PD9)
U3_TX: U6.96 (PD8)
V24_MON: U6.32 (PC0)
VBAT: C39.1, D4.1 (K), D5.1 (K), U6.6 (VBAT)
VBAT_CELL: BT1.1 (+), D4.2 (A)
VCAP: C32.1, C33.1, U6.81 (VCAP), U6.125 (VCAP)
