ahmadreza221/aurora-cchp/electronics/b1_ecu/out/memory.kicad_sch

## KiCad design electronics/b1_ecu/out/memory.kicad_sch (2026-10-22)

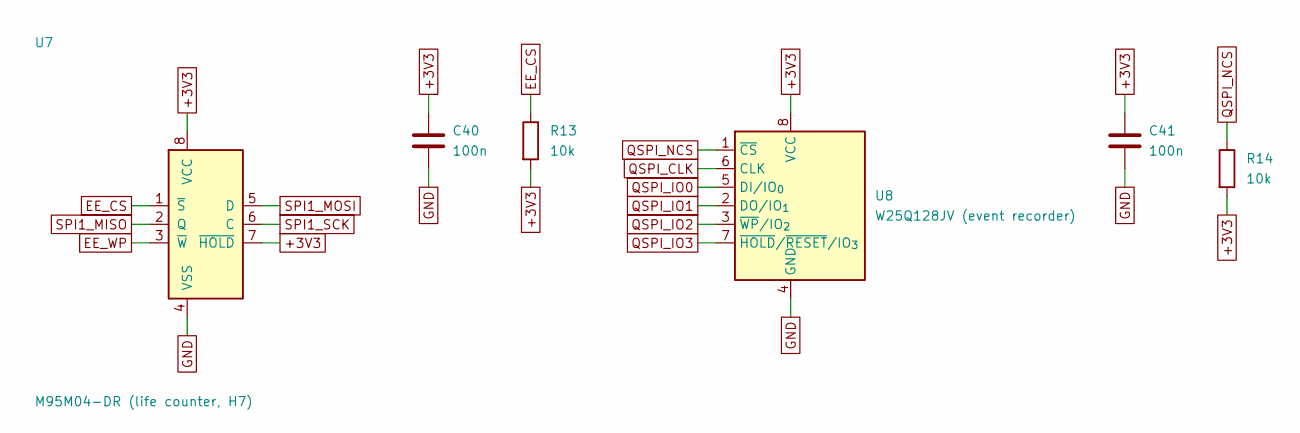
[picture p220: schematic memory.kicad_sch]

Parts:
C40, C41: 100n; C_0402_1005Metric
R13, R14: 10k; R_0402_1005Metric
U7: M95M04-DR (life counter, H7); SOIC-8_5.3x5.3mm_P1.27mm; MPN M95M04-DRMN6TP; LCSC C1852765
U8: W25Q128JV (event recorder); SOIC-8_5.3x5.3mm_P1.27mm; MPN W25Q128JVSIQ; LCSC C97521

Connections:
+3V3: C40.1, C41.1, R13.2, R14.2, U7.7 (~HOLD), U7.8 (VCC), U8.8 (VCC)
EE_CS: R13.1, U7.1 (~S)
EE_WP: U7.3 (~W)
GND: C40.2, C41.2, U7.4 (VSS), U8.4 (GND)
QSPI_CLK: U8.6 (CLK)
QSPI_IO0: U8.5 (DI/IO_{0})
QSPI_IO1: U8.2 (DO/IO_{1})
QSPI_IO2: U8.3 (~WP/IO_{2})
QSPI_IO3: U8.7 (~HOLD/~RESET/IO_{3})
QSPI_NCS: R14.1, U8.1 (~CS)
SPI1_MISO: U7.2 (Q)
SPI1_MOSI: U7.5 (D)
SPI1_SCK: U7.6 (C)
