ahmadreza221/aurora-cchp/electronics/b1_ecu/out/permits.kicad_sch

## KiCad design electronics/b1_ecu/out/permits.kicad_sch (2026-10-22)

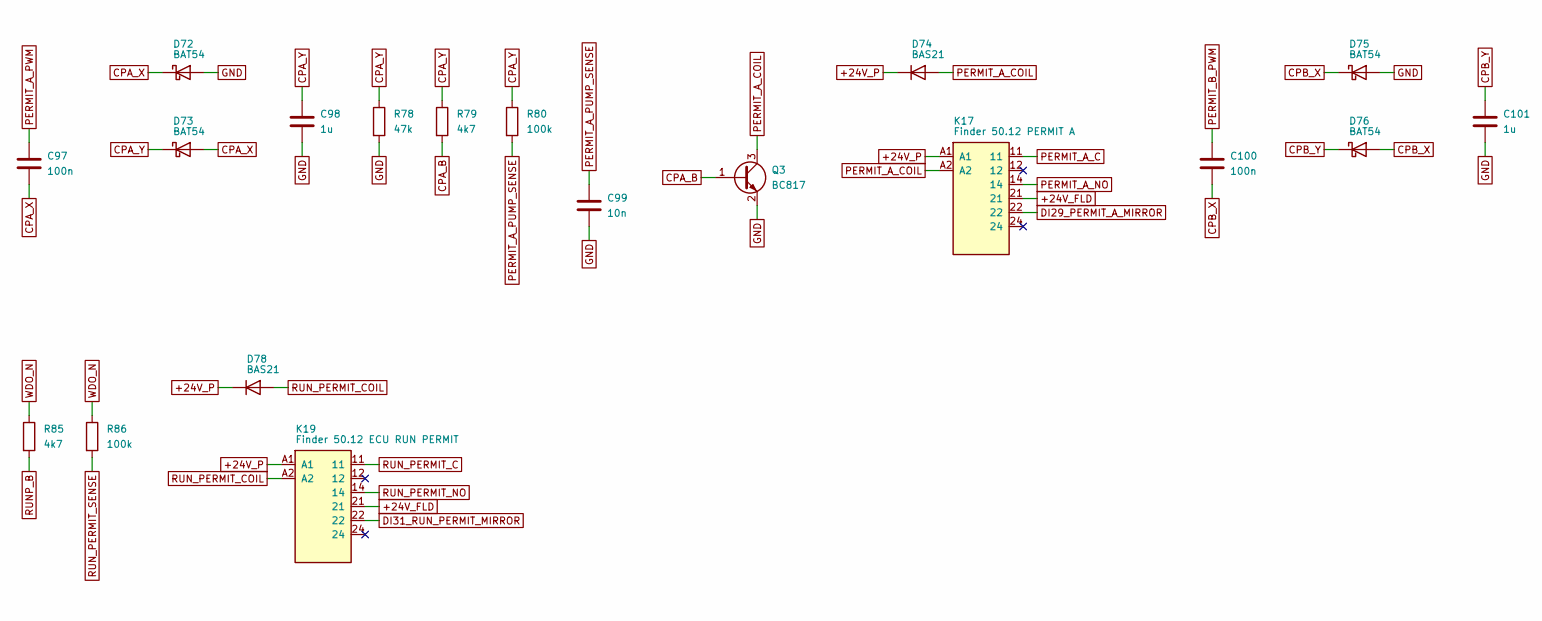
[picture p221: schematic permits.kicad_sch, part in row 1, column 1]

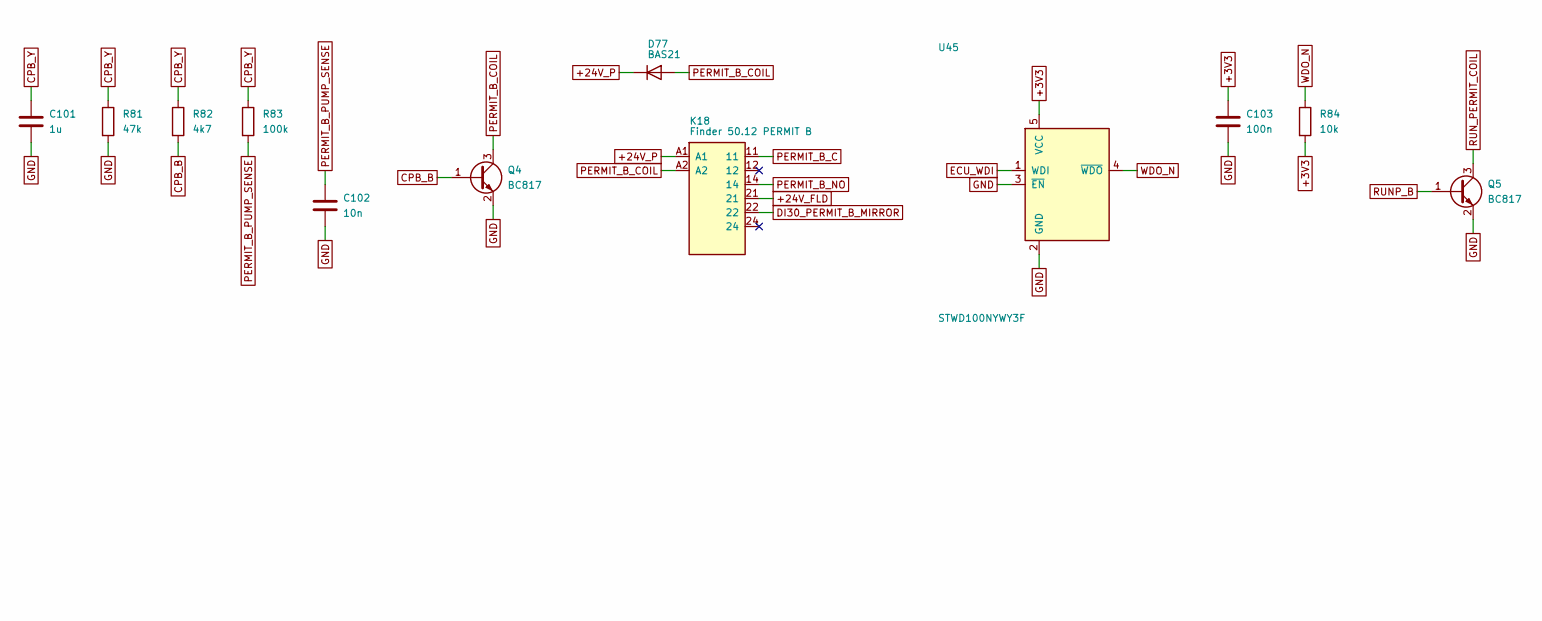
[picture p222: schematic permits.kicad_sch, part in row 1, column 2]

Parts:
C97, C100, C103: 100n; C_0402_1005Metric
C98, C101: 1u; C_0603_1608Metric
C99, C102: 10n; C_0402_1005Metric
D72, D73, D75, D76: BAT54; D_SOD-123; MPN BAT54-7
D74, D77, D78: BAS21; D_SOD-123; MPN BAS21,215
K17: Finder 50.12 PERMIT A; MPN 50.12.9.024.1000
K18: Finder 50.12 PERMIT B; MPN 50.12.9.024.1000
K19: Finder 50.12 ECU RUN PERMIT; MPN 50.12.9.024.1000
Q3, Q4, Q5: BC817; SOT-23; MPN BC817-40,215
R78, R81: 47k; R_0402_1005Metric
R79, R82, R85: 4k7; R_0402_1005Metric
R80, R83, R86: 100k; R_0402_1005Metric
R84: 10k; R_0402_1005Metric
U45: STWD100NYWY3F; SOT-23-5; MPN STWD100NYWY3F; LCSC C46043

Connections:
+3V3: C103.1, R84.2, U45.5 (VCC)
+24V_FLD: K17.21, K18.21, K19.21
+24V_P: D74.1 (K), D77.1 (K), D78.1 (K), K17.A1, K18.A1, K19.A1
CPA_B: Q3.1 (B), R79.2
CPA_X: C97.2, D72.1 (K), D73.2 (A)
CPA_Y: C98.1, D73.1 (K), R78.1, R79.1, R80.1
CPB_B: Q4.1 (B), R82.2
CPB_X: C100.2, D75.1 (K), D76.2 (A)
CPB_Y: C101.1, D76.1 (K), R81.1, R82.1, R83.1
DI29_PERMIT_A_MIRROR: K17.22
DI30_PERMIT_B_MIRROR: K18.22
DI31_RUN_PERMIT_MIRROR: K19.22
ECU_WDI: U45.1 (WDI)
GND: C98.2, C99.2, C101.2, C102.2, C103.2, D72.2 (A), D75.2 (A), Q3.2 (E), Q4.2 (E), Q5.2 (E), R78.2, R81.2, U45.2 (GND), U45.3 (~EN)
PERMIT_A_C: K17.11
PERMIT_A_COIL: D74.2 (A), K17.A2, Q3.3 (C)
PERMIT_A_NO: K17.14
PERMIT_A_PUMP_SENSE: C99.1, R80.2
PERMIT_A_PWM: C97.1
PERMIT_B_C: K18.11
PERMIT_B_COIL: D77.2 (A), K18.A2, Q4.3 (C)
PERMIT_B_NO: K18.14
PERMIT_B_PUMP_SENSE: C102.1, R83.2
PERMIT_B_PWM: C100.1
RUNP_B: Q5.1 (B), R85.2
RUN_PERMIT_C: K19.11
RUN_PERMIT_COIL: D78.2 (A), K19.A2, Q5.3 (C)
RUN_PERMIT_NO: K19.14
RUN_PERMIT_SENSE: R86.2
WDO_N: R84.1, R85.1, R86.1, U45.4 (~WDO)
