ahmadreza221/aurora-cchp/electronics/b1_ecu/out/power.kicad_sch

## KiCad design electronics/b1_ecu/out/power.kicad_sch (2026-10-22)

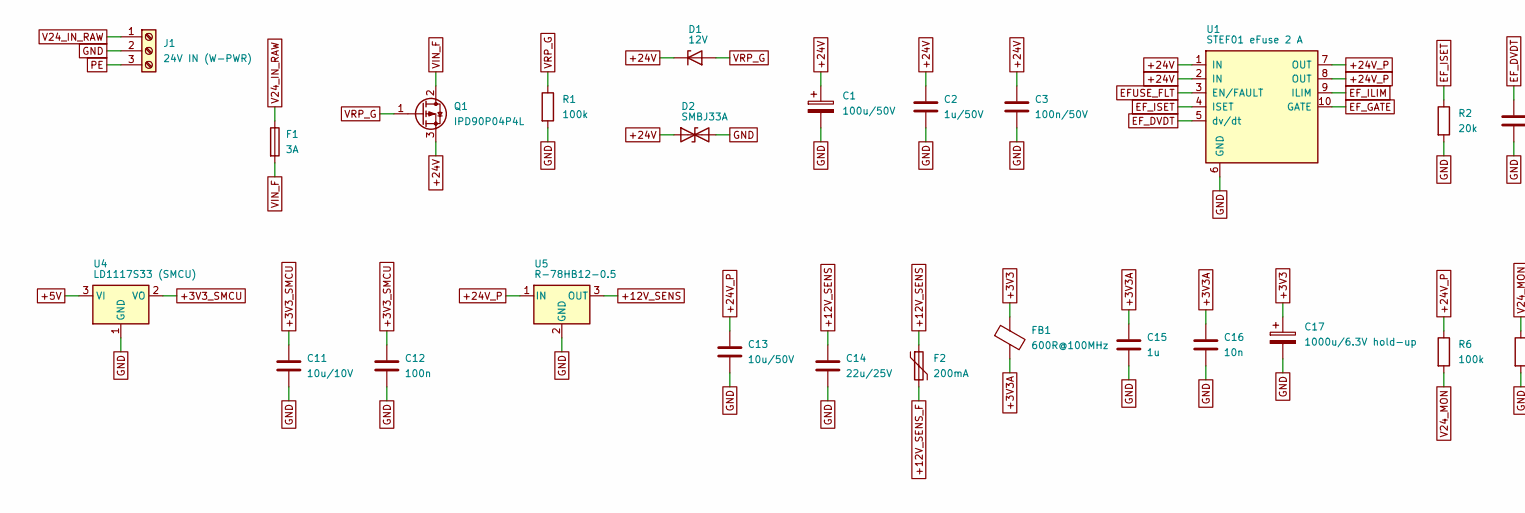
[picture p223: schematic power.kicad_sch, part in row 1, column 1]

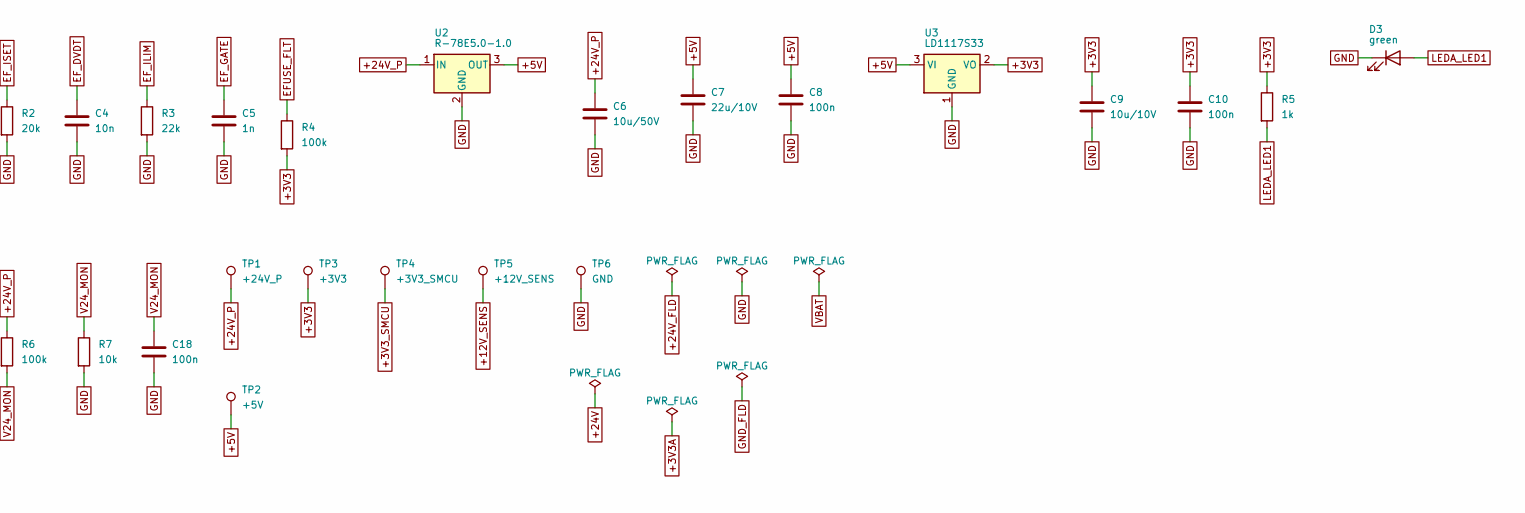
[picture p224: schematic power.kicad_sch, part in row 1, column 2]

Parts:
C1: 100u/50V; CP_Radial_D8.0mm_P3.50mm; MPN 860020675017
C2: 1u/50V; C_0805_2012Metric
C3: 100n/50V; C_0603_1608Metric
C4, C16: 10n; C_0402_1005Metric
C5: 1n; C_0402_1005Metric
C6, C13: 10u/50V; C_1206_3216Metric
C7: 22u/10V; C_0805_2012Metric
C8, C10, C12, C18: 100n; C_0402_1005Metric
C9, C11: 10u/10V; C_0805_2012Metric
C14: 22u/25V; C_1206_3216Metric
C15: 1u; C_0402_1005Metric
C17: 1000u/6.3V hold-up; CP_Radial_D10.0mm_P5.00mm; MPN 860080675015
D1: 12V; D_SOD-123; MPN BZT52H-C12
D2: SMBJ33A; D_SMB; MPN SMBJ33A-TR; LCSC C133662
D3: green; LED_0603_1608Metric
F1: 3A; Fuse_1206_3216Metric; MPN 3413.0225.26 class
F2: 200mA; Fuse_1206_3216Metric; MPN PFRA.020
FB1: 600R@100MHz; L_0603_1608Metric; MPN 742792040
J1: 24V IN (W-PWR); MPN MSTBA 2,5/3-G-5,08
Q1: IPD90P04P4L; TO-252-2; MPN IPD90P04P4L-04
R1, R4: 100k; R_0402_1005Metric
R2: 20k; R_0402_1005Metric
R3: 22k; R_0402_1005Metric
R5: 1k; R_0402_1005Metric
R6: 100k; R_0603_1608Metric
R7: 10k; R_0402_1005Metric
TP1: +24V_P; TestPoint_Pad_D1.5mm
TP2: +5V; TestPoint_Pad_D1.5mm
TP3: +3V3; TestPoint_Pad_D1.5mm
TP4: +3V3_SMCU; TestPoint_Pad_D1.5mm
TP5: +12V_SENS; TestPoint_Pad_D1.5mm
TP6: GND; TestPoint_Pad_D1.5mm
U1: STEF01 eFuse 2 A; MPN STEF01FTR
U2: R-78E5.0-1.0; Converter_DCDC_RECOM_R-78E-0.5_THT; MPN R-78E5.0-1.0
U3: LD1117S33; SOT-223-3_TabPin2; MPN LD1117S33TR; LCSC C86781
U4: LD1117S33 (SMCU); SOT-223-3_TabPin2; MPN LD1117S33TR; LCSC C86781
U5: R-78HB12-0.5; Converter_DCDC_RECOM_R-78HB-0.5_THT; MPN R-78HB12-0.5

Connections:
+3V3: C9.1, C10.1, C17.1, FB1.1, R4.2, R5.1, TP3.1, U3.2 (VO)
+3V3A: C15.1, C16.1, FB1.2
+3V3_SMCU: C11.1, C12.1, TP4.1, U4.2 (VO)
+5V: C7.1, C8.1, TP2.1, U2.3 (OUT), U3.3 (VI), U4.3 (VI)
+12V_SENS: C14.1, F2.1, TP5.1, U5.3 (OUT)
+12V_SENS_F: F2.2
+24V: C1.1, C2.1, C3.1, D1.1 (K), D2.1 (A1), Q1.3 (S), U1.1 (IN), U1.2 (IN)
+24V_P: C6.1, C13.1, R6.1, TP1.1, U1.7 (OUT), U1.8 (OUT), U2.1 (IN), U5.1 (IN)
EFUSE_FLT: R4.1, U1.3 (EN/FAULT)
EF_DVDT: C4.1, U1.5 (dv/dt)
EF_GATE: C5.1, U1.10 (GATE)
EF_ILIM: R3.1, U1.9 (ILIM)
EF_ISET: R2.1, U1.4 (ISET)
GND: C1.2, C2.2, C3.2, C4.2, C5.2, C6.2, C7.2, C8.2, C9.2, C10.2, C11.2, C12.2, C13.2, C14.2, C15.2, C16.2, C17.2, C18.2, D2.2 (A2), D3.1 (K), J1.2, R1.2, R2.2, R3.2, R7.2, TP6.1, U1.6 (GND), U2.2 (GND), U3.1 (GND), U4.1 (GND), U5.2 (GND)
LEDA_LED1: D3.2 (A), R5.2
PE: J1.3
V24_IN_RAW: F1.1, J1.1
V24_MON: C18.1, R6.2, R7.1
VIN_F: F1.2, Q1.2 (D)
VRP_G: D1.2 (A), Q1.1 (G), R1.1
