ahmadreza221/aurora-cchp/electronics/b1_ecu/out/relays.kicad_sch

## KiCad design electronics/b1_ecu/out/relays.kicad_sch (2026-10-22)

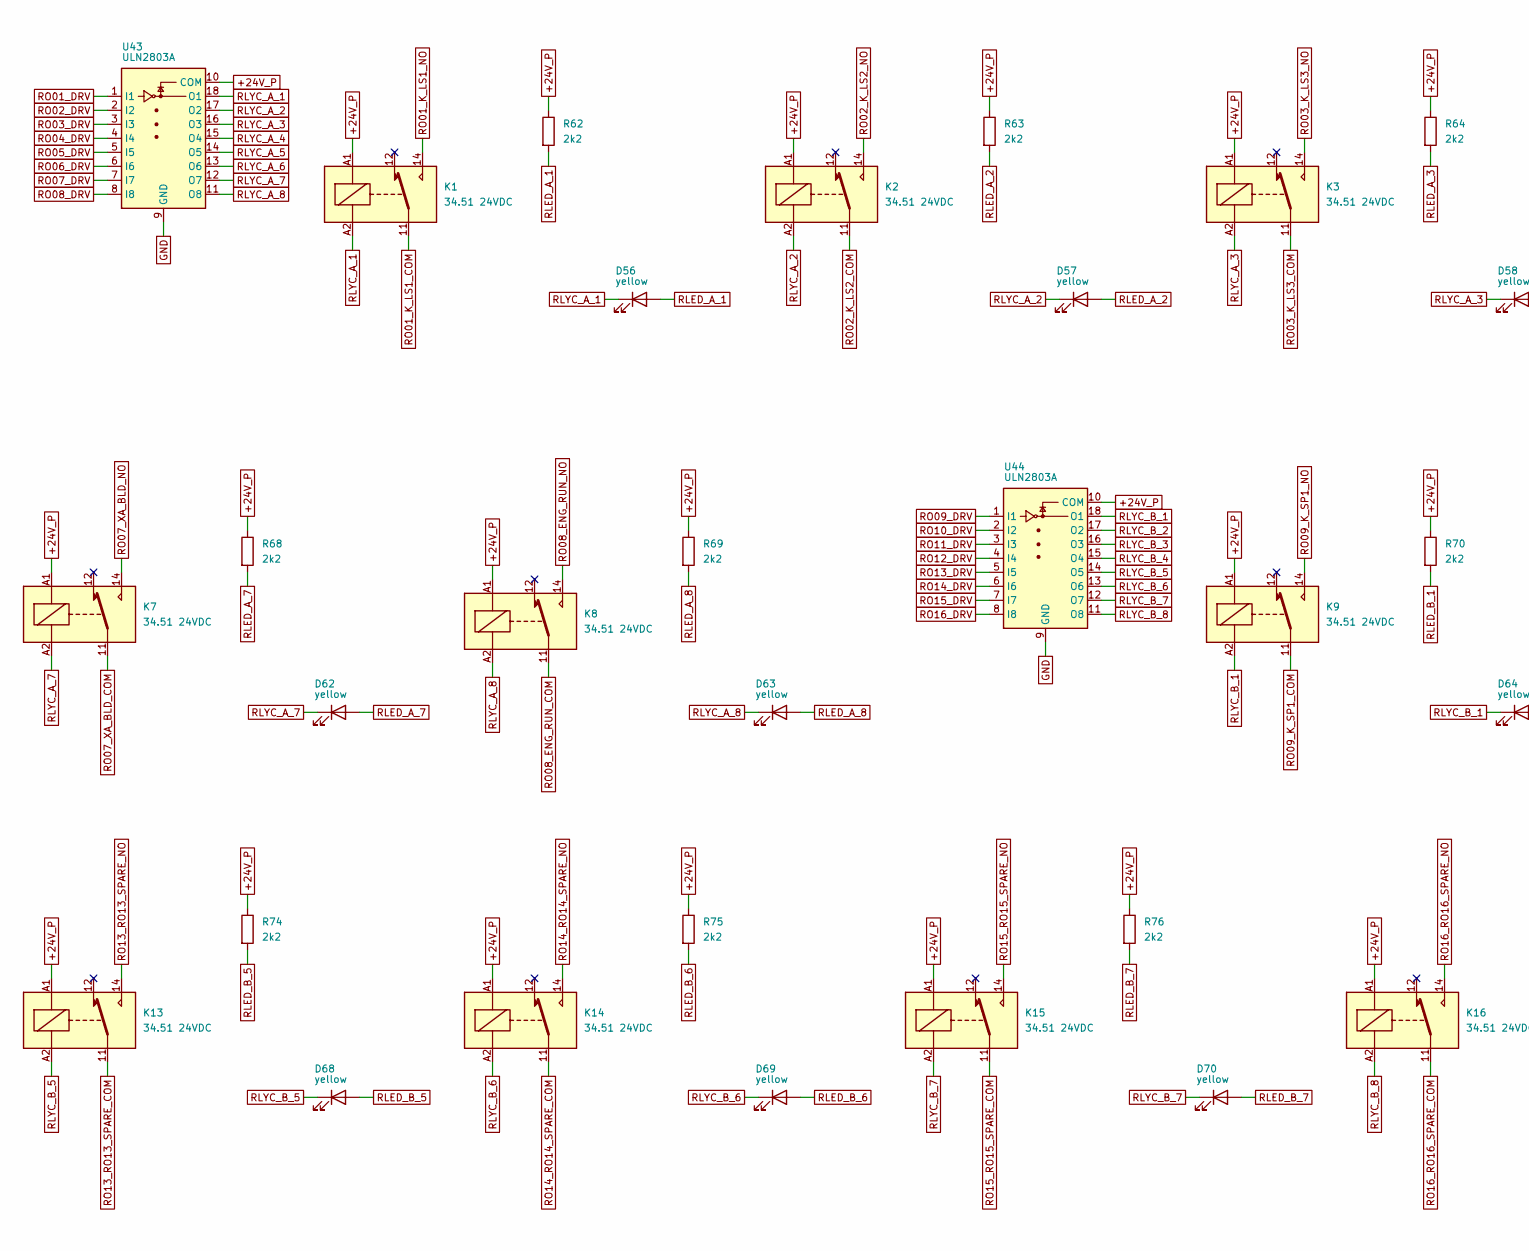
[picture p225: schematic relays.kicad_sch, part in row 1, column 1]

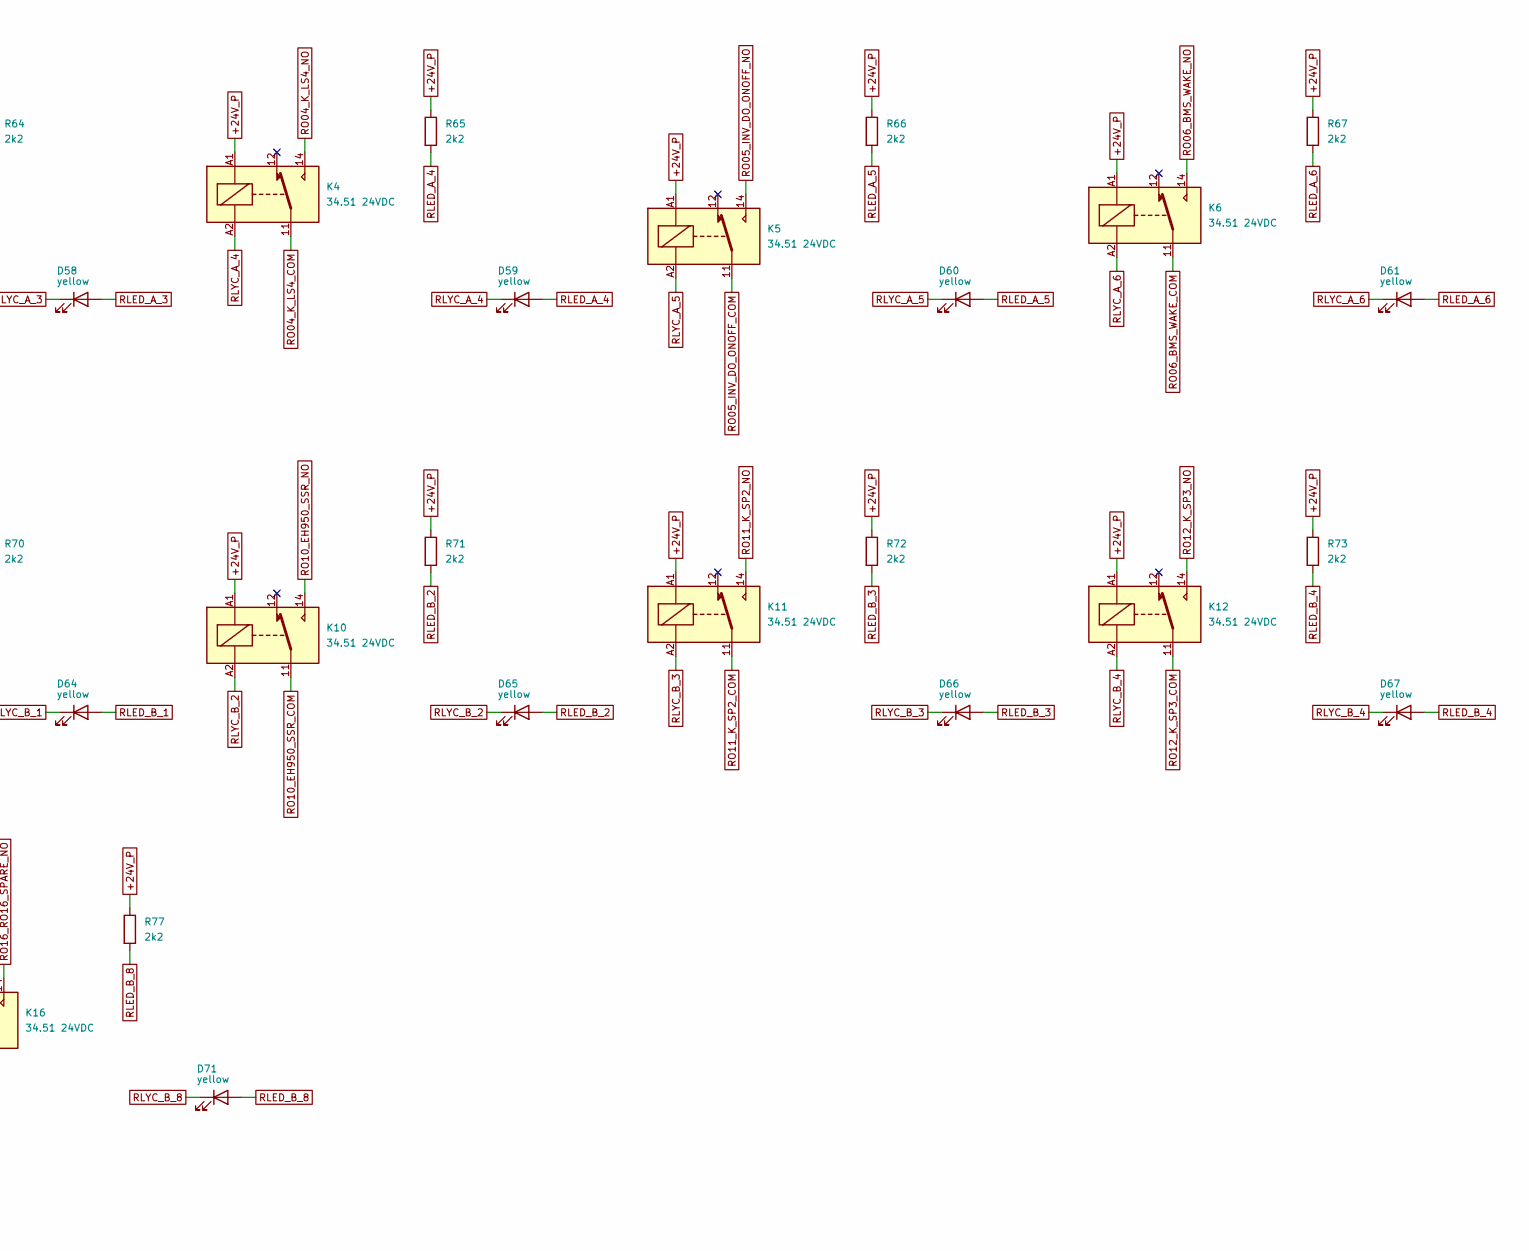
[picture p226: schematic relays.kicad_sch, part in row 1, column 2]

Parts:
D56, D57, D58, D59, D60, D61, D62, D63, D64, D65, D66, D67, D68, D69, D70, D71: yellow; LED_0603_1608Metric
K1, K2, K3, K4, K5, K6, K7, K8, K9, K10, K11, K12, K13, K14, K15, K16: 34.51 24VDC; Relay_SPDT_Finder_34.51_Vertical; MPN 34.51.7.024.0010
R62, R63, R64, R65, R66, R67, R68, R69, R70, R71, R72, R73, R74, R75, R76, R77: 2k2; R_0402_1005Metric
U43, U44: ULN2803A; SOIC-18W_7.5x11.6mm_P1.27mm; MPN ULN2803A

Connections:
+24V_P: K1.A1, K2.A1, K3.A1, K4.A1, K5.A1, K6.A1, K7.A1, K8.A1, K9.A1, K10.A1, K11.A1, K12.A1, K13.A1, K14.A1, K15.A1, K16.A1, R62.1, R63.1, R64.1, R65.1, R66.1, R67.1, R68.1, R69.1, R70.1, R71.1, R72.1, R73.1, R74.1, R75.1, R76.1, R77.1, U43.10 (COM), U44.10 (COM)
GND: U43.9 (GND), U44.9 (GND)
RLED_A_1: D56.2 (A), R62.2
RLED_A_2: D57.2 (A), R63.2
RLED_A_3: D58.2 (A), R64.2
RLED_A_4: D59.2 (A), R65.2
RLED_A_5: D60.2 (A), R66.2
RLED_A_6: D61.2 (A), R67.2
RLED_A_7: D62.2 (A), R68.2
RLED_A_8: D63.2 (A), R69.2
RLED_B_1: D64.2 (A), R70.2
RLED_B_2: D65.2 (A), R71.2
RLED_B_3: D66.2 (A), R72.2
RLED_B_4: D67.2 (A), R73.2
RLED_B_5: D68.2 (A), R74.2
RLED_B_6: D69.2 (A), R75.2
RLED_B_7: D70.2 (A), R76.2
RLED_B_8: D71.2 (A), R77.2
RLYC_A_1: D56.1 (K), K1.A2, U43.18 (O1)
RLYC_A_2: D57.1 (K), K2.A2, U43.17 (O2)
RLYC_A_3: D58.1 (K), K3.A2, U43.16 (O3)
RLYC_A_4: D59.1 (K), K4.A2, U43.15 (O4)
RLYC_A_5: D60.1 (K), K5.A2, U43.14 (O5)
RLYC_A_6: D61.1 (K), K6.A2, U43.13 (O6)
RLYC_A_7: D62.1 (K), K7.A2, U43.12 (O7)
RLYC_A_8: D63.1 (K), K8.A2, U43.11 (O8)
RLYC_B_1: D64.1 (K), K9.A2, U44.18 (O1)
RLYC_B_2: D65.1 (K), K10.A2, U44.17 (O2)
RLYC_B_3: D66.1 (K), K11.A2, U44.16 (O3)
RLYC_B_4: D67.1 (K), K12.A2, U44.15 (O4)
RLYC_B_5: D68.1 (K), K13.A2, U44.14 (O5)
RLYC_B_6: D69.1 (K), K14.A2, U44.13 (O6)
RLYC_B_7: D70.1 (K), K15.A2, U44.12 (O7)
RLYC_B_8: D71.1 (K), K16.A2, U44.11 (O8)
RO01_DRV: U43.1 (I1)
RO01_K_LS1_COM: K1.11
RO01_K_LS1_NO: K1.14
RO02_DRV: U43.2 (I2)
RO02_K_LS2_COM: K2.11
RO02_K_LS2_NO: K2.14
RO03_DRV: U43.3 (I3)
RO03_K_LS3_COM: K3.11
RO03_K_LS3_NO: K3.14
RO04_DRV: U43.4 (I4)
RO04_K_LS4_COM: K4.11
RO04_K_LS4_NO: K4.14
RO05_DRV: U43.5 (I5)
RO05_INV_DO_ONOFF_COM: K5.11
RO05_INV_DO_ONOFF_NO: K5.14
RO06_BMS_WAKE_COM: K6.11
RO06_BMS_WAKE_NO: K6.14
RO06_DRV: U43.6 (I6)
RO07_DRV: U43.7 (I7)
RO07_XA_BLD_COM: K7.11
RO07_XA_BLD_NO: K7.14
RO08_DRV: U43.8 (I8)
RO08_ENG_RUN_COM: K8.11
RO08_ENG_RUN_NO: K8.14
RO09_DRV: U44.1 (I1)
RO09_K_SP1_COM: K9.11
RO09_K_SP1_NO: K9.14
RO10_DRV: U44.2 (I2)
RO10_EH950_SSR_COM: K10.11
RO10_EH950_SSR_NO: K10.14
RO11_DRV: U44.3 (I3)
RO11_K_SP2_COM: K11.11
RO11_K_SP2_NO: K11.14
RO12_DRV: U44.4 (I4)
RO12_K_SP3_COM: K12.11
RO12_K_SP3_NO: K12.14
RO13_DRV: U44.5 (I5)
RO13_RO13_SPARE_COM: K13.11
RO13_RO13_SPARE_NO: K13.14
RO14_DRV: U44.6 (I6)
RO14_RO14_SPARE_COM: K14.11
RO14_RO14_SPARE_NO: K14.14
RO15_DRV: U44.7 (I7)
RO15_RO15_SPARE_COM: K15.11
RO15_RO15_SPARE_NO: K15.14
RO16_DRV: U44.8 (I8)
RO16_RO16_SPARE_COM: K16.11
RO16_RO16_SPARE_NO: K16.14
