ahmadreza221/aurora-cchp/electronics/b1_ecu/out/rs485.kicad_sch

## KiCad design electronics/b1_ecu/out/rs485.kicad_sch (2026-10-22)

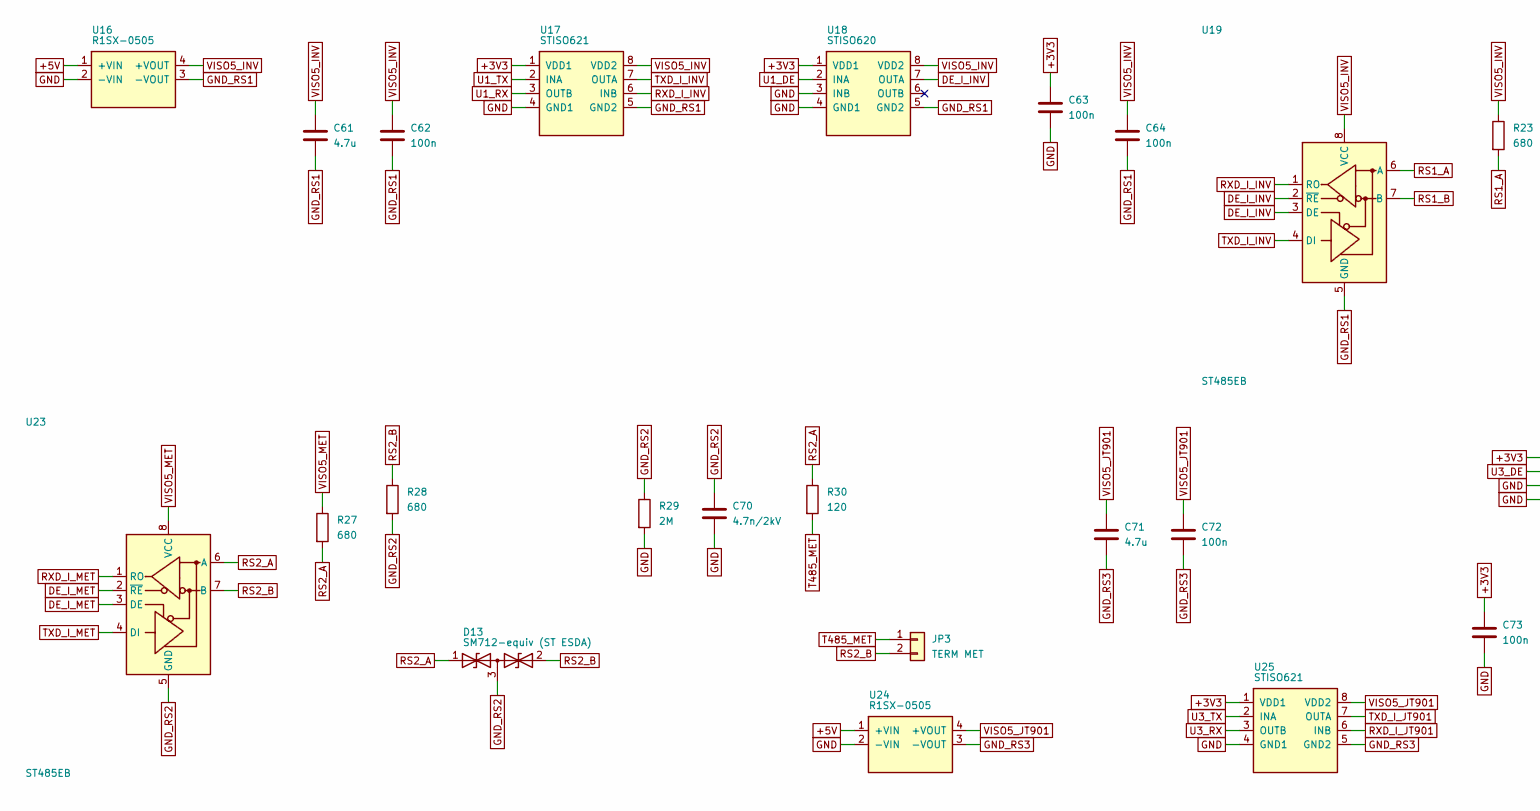
[picture p227: schematic rs485.kicad_sch, part in row 1, column 1]

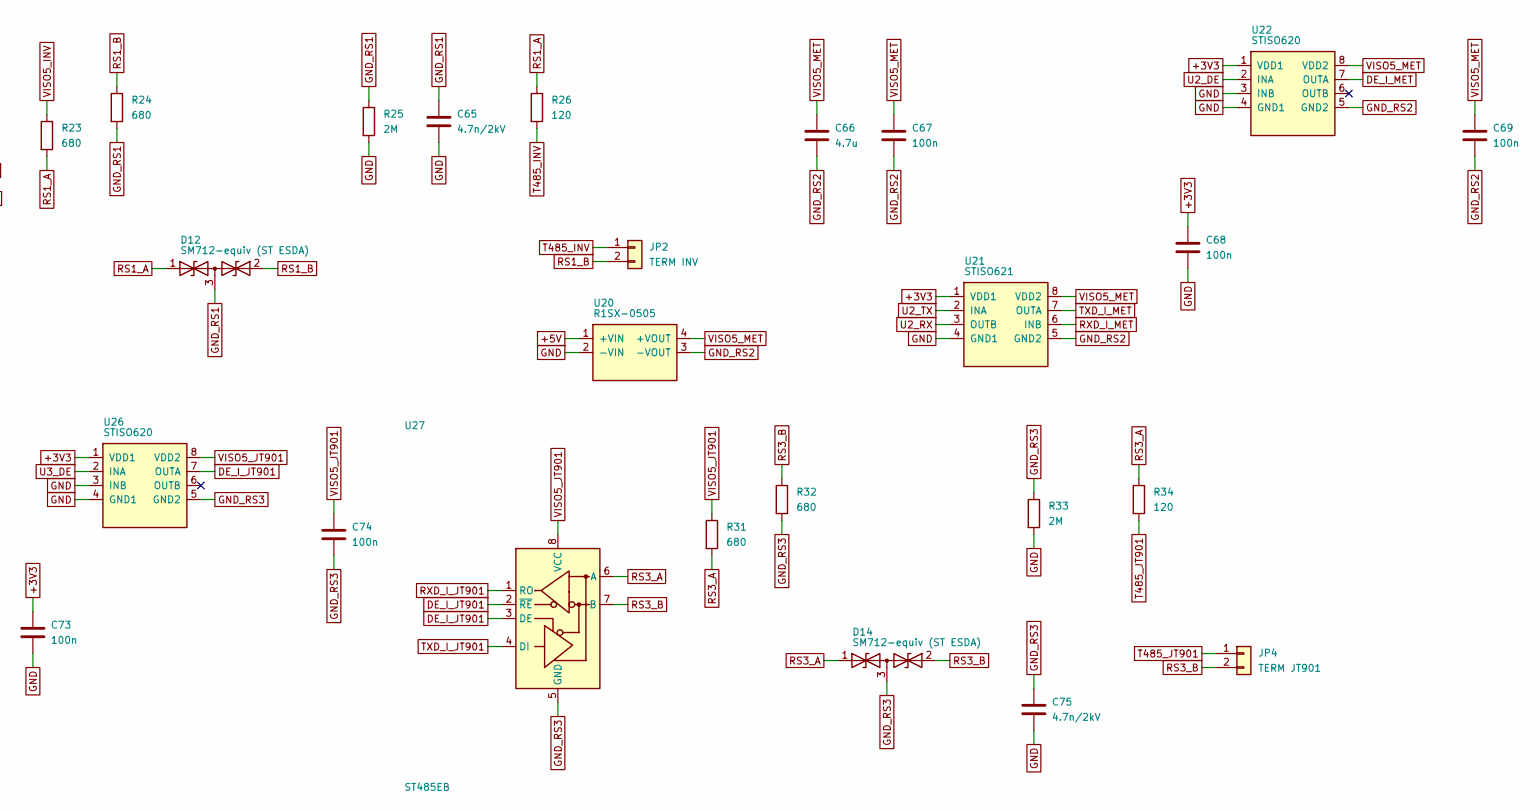
[picture p228: schematic rs485.kicad_sch, part in row 1, column 2]

Parts:
C61, C66, C71: 4.7u; C_0805_2012Metric
C62, C63, C64, C67, C68, C69, C72, C73, C74: 100n; C_0402_1005Metric
C65, C70, C75: 4.7n/2kV; C_1206_3216Metric
D12, D13, D14: SM712-equiv (ST ESDA); SOT-23; MPN ESDA25P35-1U1M? VERIFY: use a 12/7 V as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
JP2: TERM INV; PinHeader_1x02_P2.54mm_Vertical; MPN 61300211121
JP3: TERM MET; PinHeader_1x02_P2.54mm_Vertical; MPN 61300211121
JP4: TERM JT901; PinHeader_1x02_P2.54mm_Vertical; MPN 61300211121
R23, R24, R27, R28, R31, R32: 680; R_0603_1608Metric
R25, R29, R33: 2M; R_0402_1005Metric
R26, R30, R34: 120; R_0603_1608Metric
U16, U20, U24: R1SX-0505; MPN R1SX-0505
U17, U21, U25: STISO621; SOIC-8_7.5x5.85mm_P1.27mm; MPN STISO621TR; LCSC C5447162
U18, U22, U26: STISO620; SOIC-8_7.5x5.85mm_P1.27mm; MPN STISO620TR; LCSC C7089838
U19, U23, U27: ST485EB; SOIC-8_3.9x4.9mm_P1.27mm; MPN ST485EBDR; LCSC C81186

Connections:
+3V3: C63.1, C68.1, C73.1, U17.1 (VDD1), U18.1 (VDD1), U21.1 (VDD1), U22.1 (VDD1), U25.1 (VDD1), U26.1 (VDD1)
+5V: U16.1 (+VIN), U20.1 (+VIN), U24.1 (+VIN)
DE_I_INV: U18.7 (OUTA), U19.2 (~RE), U19.3 (DE)
DE_I_JT901: U26.7 (OUTA), U27.2 (~RE), U27.3 (DE)
DE_I_MET: U22.7 (OUTA), U23.2 (~RE), U23.3 (DE)
GND: C63.2, C65.2, C68.2, C70.2, C73.2, C75.2, R25.2, R29.2, R33.2, U16.2 (-VIN), U17.4 (GND1), U18.3 (INB), U18.4 (GND1), U20.2 (-VIN), U21.4 (GND1), U22.3 (INB), U22.4 (GND1), U24.2 (-VIN), U25.4 (GND1), U26.3 (INB), U26.4 (GND1)
GND_RS1: C61.2, C62.2, C64.2, C65.1, D12.3 (common), R24.2, R25.1, U16.3 (-VOUT), U17.5 (GND2), U18.5 (GND2), U19.5 (GND)
GND_RS2: C66.2, C67.2, C69.2, C70.1, D13.3 (common), R28.2, R29.1, U20.3 (-VOUT), U21.5 (GND2), U22.5 (GND2), U23.5 (GND)
GND_RS3: C71.2, C72.2, C74.2, C75.1, D14.3 (common), R32.2, R33.1, U24.3 (-VOUT), U25.5 (GND2), U26.5 (GND2), U27.5 (GND)
RS1_A: D12.1 (A1), R23.2, R26.1, U19.6 (A)
RS1_B: D12.2 (A2), JP2.2, R24.1, U19.7 (B)
RS2_A: D13.1 (A1), R27.2, R30.1, U23.6 (A)
RS2_B: D13.2 (A2), JP3.2, R28.1, U23.7 (B)
RS3_A: D14.1 (A1), R31.2, R34.1, U27.6 (A)
RS3_B: D14.2 (A2), JP4.2, R32.1, U27.7 (B)
RXD_I_INV: U17.6 (INB), U19.1 (RO)
RXD_I_JT901: U25.6 (INB), U27.1 (RO)
RXD_I_MET: U21.6 (INB), U23.1 (RO)
T485_INV: JP2.1, R26.2
T485_JT901: JP4.1, R34.2
T485_MET: JP3.1, R30.2
TXD_I_INV: U17.7 (OUTA), U19.4 (DI)
TXD_I_JT901: U25.7 (OUTA), U27.4 (DI)
TXD_I_MET: U21.7 (OUTA), U23.4 (DI)
U1_DE: U18.2 (INA)
U1_RX: U17.3 (OUTB)
U1_TX: U17.2 (INA)
U2_DE: U22.2 (INA)
U2_RX: U21.3 (OUTB)
U2_TX: U21.2 (INA)
U3_DE: U26.2 (INA)
U3_RX: U25.3 (OUTB)
U3_TX: U25.2 (INA)
VISO5_INV: C61.1, C62.1, C64.1, R23.1, U16.4 (+VOUT), U17.8 (VDD2), U18.8 (VDD2), U19.8 (VCC)
VISO5_JT901: C71.1, C72.1, C74.1, R31.1, U24.4 (+VOUT), U25.8 (VDD2), U26.8 (VDD2), U27.8 (VCC)
VISO5_MET: C66.1, C67.1, C69.1, R27.1, U20.4 (+VOUT), U21.8 (VDD2), U22.8 (VDD2), U23.8 (VCC)
