ahmadreza221/aurora-cchp/electronics/b1_ecu/out/smcu.kicad_sch

## KiCad design electronics/b1_ecu/out/smcu.kicad_sch (2026-10-22)

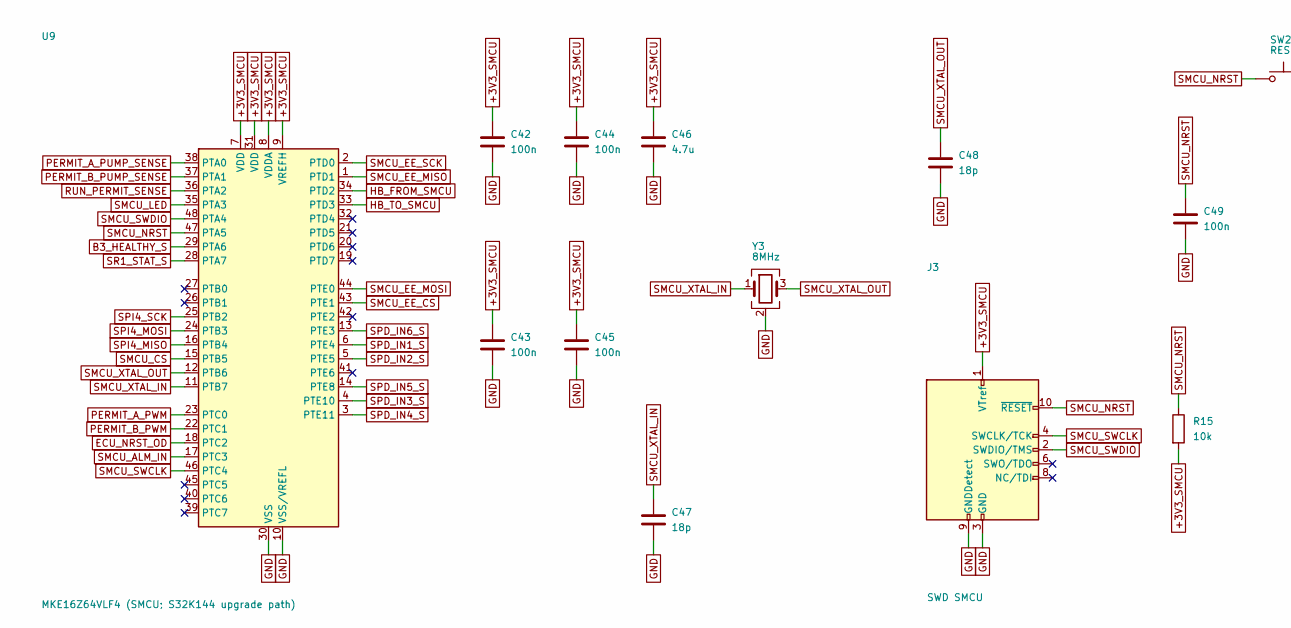
[picture p229: schematic smcu.kicad_sch, part in row 1, column 1]

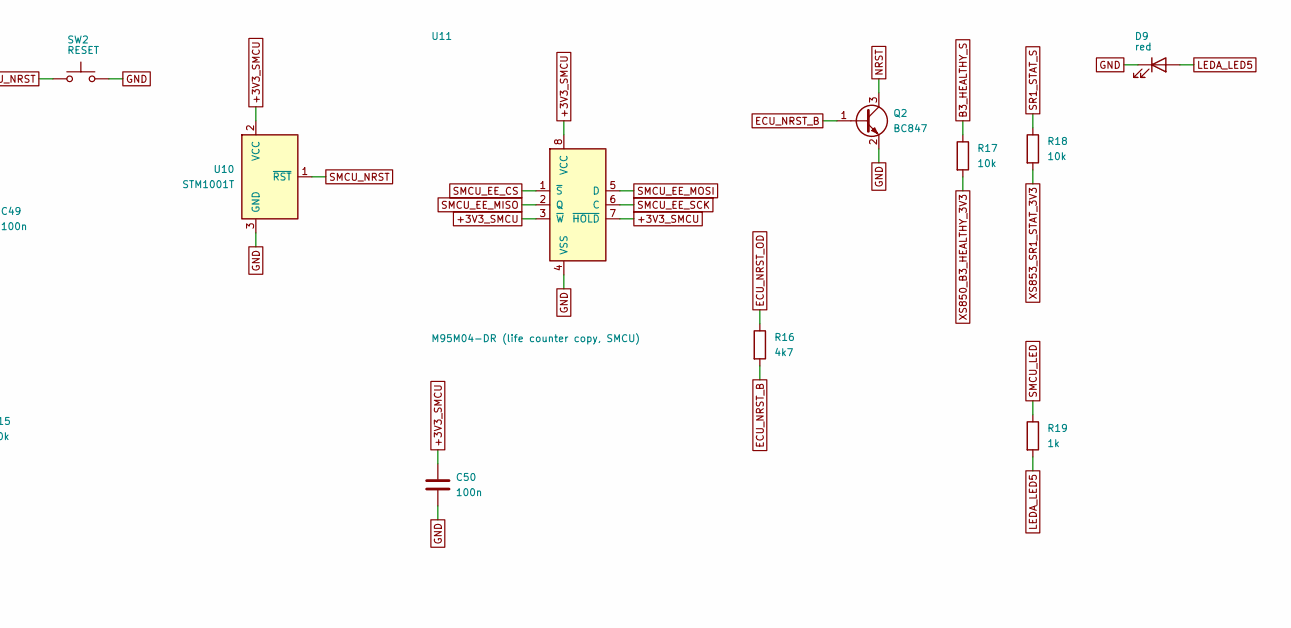
[picture p230: schematic smcu.kicad_sch, part in row 1, column 2]

Parts:
C42, C43, C44, C45, C49, C50: 100n; C_0402_1005Metric
C46: 4.7u; C_0805_2012Metric
C47, C48: 18p; C_0402_1005Metric
D9: red; LED_0603_1608Metric
J3: SWD SMCU; PinHeader_2x05_P1.27mm_Vertical_SMD; MPN 20021111-00010T4LF
Q2: BC847; SOT-23; MPN BC847B,215
R15, R17, R18: 10k; R_0402_1005Metric
R16: 4k7; R_0402_1005Metric
R19: 1k; R_0402_1005Metric
SW2: RESET; SW_SPST_TL3342; MPN PTS645SM43SMTR92
U9: MKE16Z64VLF4 (SMCU; S32K144 upgrade path); LQFP-48_7x7mm_P0.5mm; MPN MKE16Z64VLF4; LCSC C1339264
U10: STM1001T; SOT-23; MPN STM1001TWX6F
U11: M95M04-DR (life counter copy, SMCU); SOIC-8_5.3x5.3mm_P1.27mm; MPN M95M04-DRMN6TP; LCSC C1852765
Y3: 8MHz; Crystal_SMD_3225-4Pin_3.2x2.5mm; MPN CM9V-T1A-8.000MHz

Connections:
+3V3_SMCU: C42.1, C43.1, C44.1, C45.1, C46.1, C50.1, J3.1 (VTref), R15.2, U9.7 (VDD), U9.8 (VDDA), U9.9 (VREFH), U9.31 (VDD), U10.2 (VCC), U11.3 (~W), U11.7 (~HOLD), U11.8 (VCC)
B3_HEALTHY_S: R17.1, U9.29 (PTA6)
ECU_NRST_B: Q2.1 (B), R16.2
ECU_NRST_OD: R16.1, U9.18 (PTC2)
GND: C42.2, C43.2, C44.2, C45.2, C46.2, C47.2, C48.2, C49.2, C50.2, D9.1 (K), J3.3 (GND), J3.5 (GND), J3.9 (GNDDetect), Q2.2 (E), SW2.2, U9.10 (VSS/VREFL), U9.30 (VSS), U10.3 (GND), U11.4 (VSS), Y3.2 (G), Y3.4 (G)
HB_FROM_SMCU: U9.34 (PTD2)
HB_TO_SMCU: U9.33 (PTD3)
LEDA_LED5: D9.2 (A), R19.2
NRST: Q2.3 (C)
PERMIT_A_PUMP_SENSE: U9.38 (PTA0)
PERMIT_A_PWM: U9.23 (PTC0)
PERMIT_B_PUMP_SENSE: U9.37 (PTA1)
PERMIT_B_PWM: U9.22 (PTC1)
RUN_PERMIT_SENSE: U9.36 (PTA2)
SMCU_ALM_IN: U9.17 (PTC3)
SMCU_CS: U9.15 (PTB5)
SMCU_EE_CS: U9.43 (PTE1), U11.1 (~S)
SMCU_EE_MISO: U9.1 (PTD1), U11.2 (Q)
SMCU_EE_MOSI: U9.44 (PTE0), U11.5 (D)
SMCU_EE_SCK: U9.2 (PTD0), U11.6 (C)
SMCU_LED: R19.1, U9.35 (PTA3)
SMCU_NRST: C49.1, J3.10 (~RESET), R15.1, SW2.1, U9.47 (PTA5), U10.1 (~RST)
SMCU_SWCLK: J3.4 (SWCLK/TCK), U9.46 (PTC4)
SMCU_SWDIO: J3.2 (SWDIO/TMS), U9.48 (PTA4)
SMCU_XTAL_IN: C47.1, U9.11 (PTB7), Y3.1
SMCU_XTAL_OUT: C48.1, U9.12 (PTB6), Y3.3
SPD_IN1_S: U9.6 (PTE4)
SPD_IN2_S: U9.5 (PTE5)
SPD_IN3_S: U9.4 (PTE10)
SPD_IN4_S: U9.3 (PTE11)
SPD_IN5_S: U9.14 (PTE8)
SPD_IN6_S: U9.13 (PTE3)
SPI4_MISO: U9.16 (PTB4)
SPI4_MOSI: U9.24 (PTB3)
SPI4_SCK: U9.25 (PTB2)
SR1_STAT_S: R18.1, U9.28 (PTA7)
XS850_B3_HEALTHY_3V3: R17.2
XS853_SR1_STAT_3V3: R18.2
