ahmadreza221/aurora-cchp/electronics/b1_ecu/out/speed_inputs.kicad_sch

## KiCad design electronics/b1_ecu/out/speed_inputs.kicad_sch (2026-10-22)

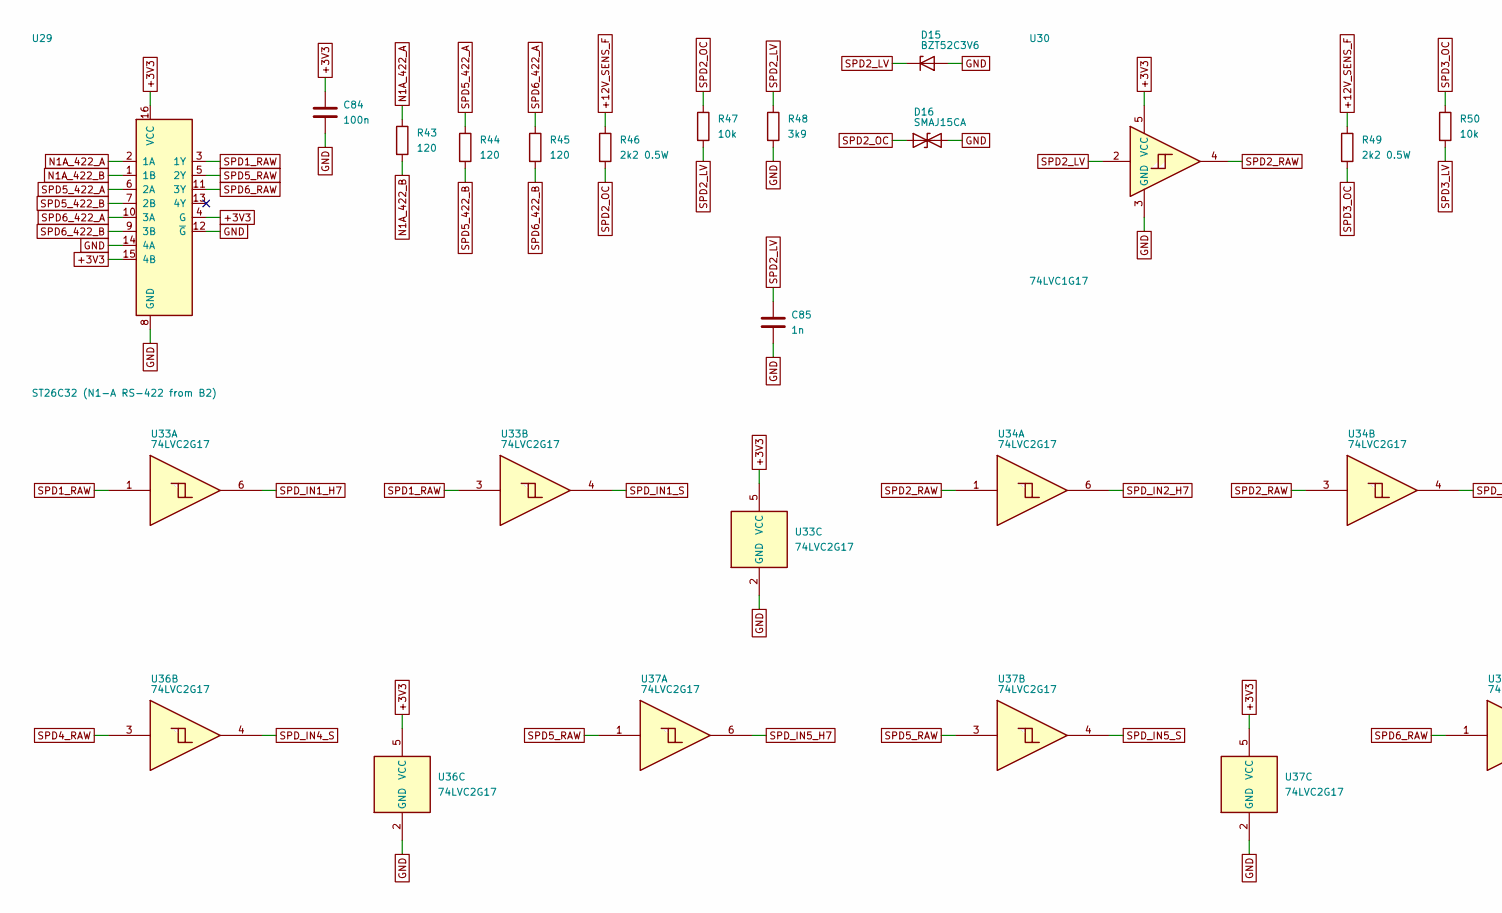
[picture p231: schematic speed_inputs.kicad_sch, part in row 1, column 1]

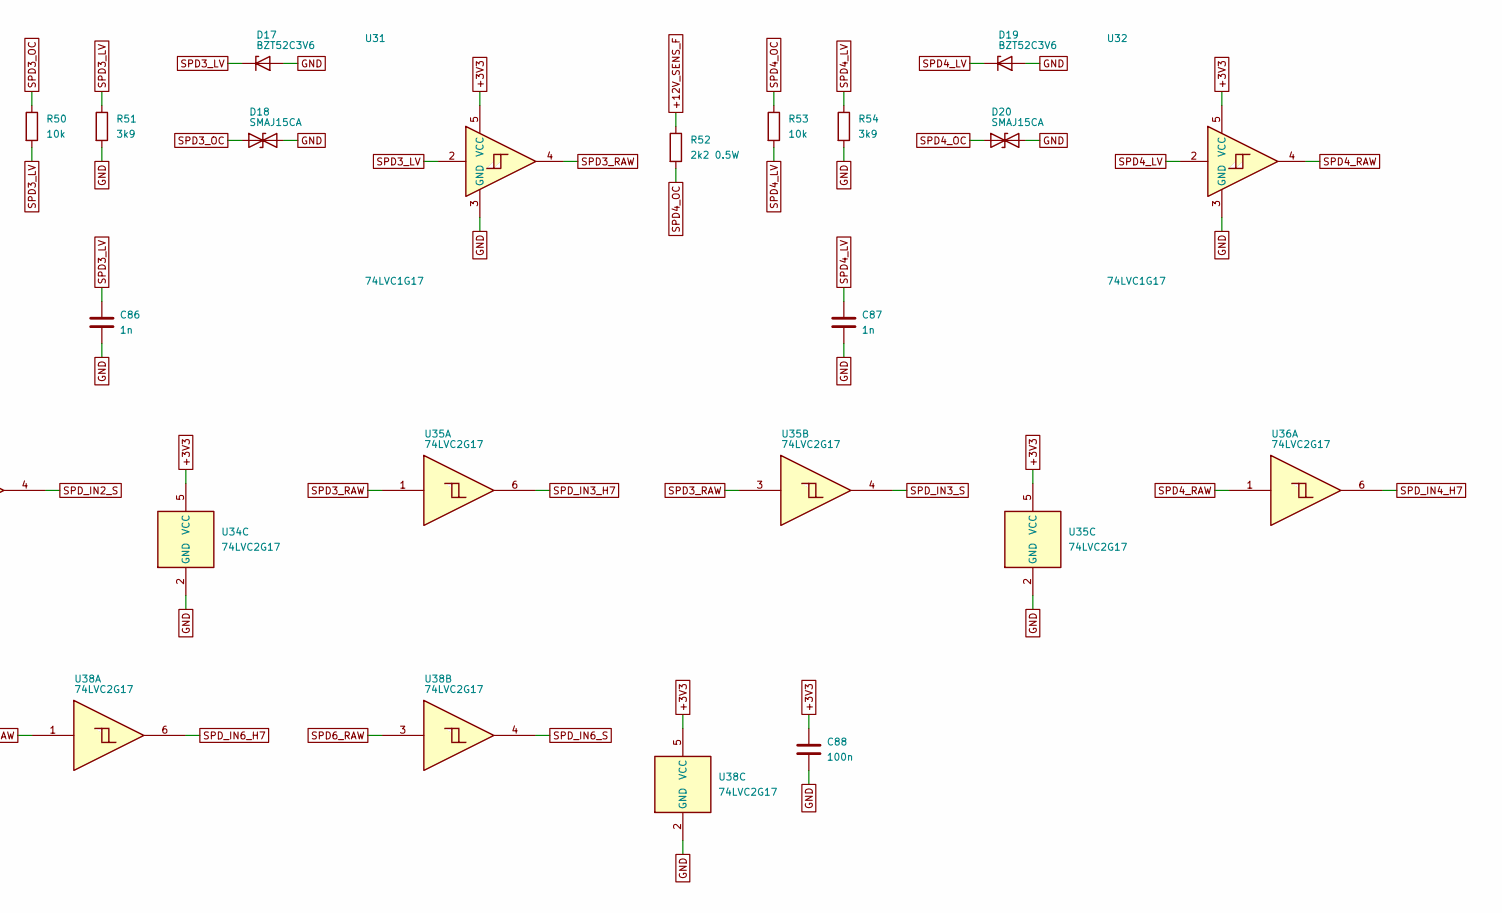
[picture p232: schematic speed_inputs.kicad_sch, part in row 1, column 2]

Parts:
C84, C88: 100n; C_0402_1005Metric
C85, C86, C87: 1n; C_0402_1005Metric
D15, D17, D19: BZT52C3V6; D_SOD-123; MPN BZT52H-C3V6
D16, D18, D20: SMAJ15CA; D_SMA; MPN SMAJ15CA-TR
R43, R44, R45: 120; R_0603_1608Metric
R46, R49, R52: 2k2 0.5W; R_1206_3216Metric
R47, R50, R53: 10k; R_0402_1005Metric
R48, R51, R54: 3k9; R_0402_1005Metric
U29: ST26C32 (N1-A RS-422 from B2); SOIC-16_3.9x9.9mm_P1.27mm; MPN ST26C32ABDR; LCSC C157432
U30, U31, U32: 74LVC1G17; SOT-353_SC-70-5; MPN 74LVC1G17GW
U33, U34, U35, U36, U37, U38: 74LVC2G17; SOT-363_SC-70-6; MPN 74LVC2G17GV

Connections:
+3V3: C84.1, C88.1, U29.4 (G), U29.15 (4B), U29.16 (VCC), U30.5 (VCC), U31.5 (VCC), U32.5 (VCC), U33.5 (VCC), U34.5 (VCC), U35.5 (VCC), U36.5 (VCC), U37.5 (VCC), U38.5 (VCC)
+12V_SENS_F: R46.1, R49.1, R52.1
GND: C84.2, C85.2, C86.2, C87.2, C88.2, D15.2 (A), D16.2 (A2), D17.2 (A), D18.2 (A2), D19.2 (A), D20.2 (A2), R48.2, R51.2, R54.2, U29.8 (GND), U29.12 (~G), U29.14 (4A), U30.3 (GND), U31.3 (GND), U32.3 (GND), U33.2 (GND), U34.2 (GND), U35.2 (GND), U36.2 (GND), U37.2 (GND), U38.2 (GND)
N1A_422_A: R43.1, U29.2 (1A)
N1A_422_B: R43.2, U29.1 (1B)
SPD1_RAW: U29.3 (1Y), U33.1, U33.3
SPD2_LV: C85.1, D15.1 (K), R47.2, R48.1, U30.2
SPD2_OC: D16.1 (A1), R46.2, R47.1
SPD2_RAW: U30.4, U34.1, U34.3
SPD3_LV: C86.1, D17.1 (K), R50.2, R51.1, U31.2
SPD3_OC: D18.1 (A1), R49.2, R50.1
SPD3_RAW: U31.4, U35.1, U35.3
SPD4_LV: C87.1, D19.1 (K), R53.2, R54.1, U32.2
SPD4_OC: D20.1 (A1), R52.2, R53.1
SPD4_RAW: U32.4, U36.1, U36.3
SPD5_422_A: R44.1, U29.6 (2A)
SPD5_422_B: R44.2, U29.7 (2B)
SPD5_RAW: U29.5 (2Y), U37.1, U37.3
SPD6_422_A: R45.1, U29.10 (3A)
SPD6_422_B: R45.2, U29.9 (3B)
SPD6_RAW: U29.11 (3Y), U38.1, U38.3
SPD_IN1_H7: U33.6
SPD_IN1_S: U33.4
SPD_IN2_H7: U34.6
SPD_IN2_S: U34.4
SPD_IN3_H7: U35.6
SPD_IN3_S: U35.4
SPD_IN4_H7: U36.6
SPD_IN4_S: U36.4
SPD_IN5_H7: U37.6
SPD_IN5_S: U37.4
SPD_IN6_H7: U38.6
SPD_IN6_S: U38.4
