ahmadreza221/aurora-cchp/electronics/b2_sio/out/afe_rtd.kicad_sch

## KiCad design electronics/b2_sio/out/afe_rtd.kicad_sch (2026-10-22)

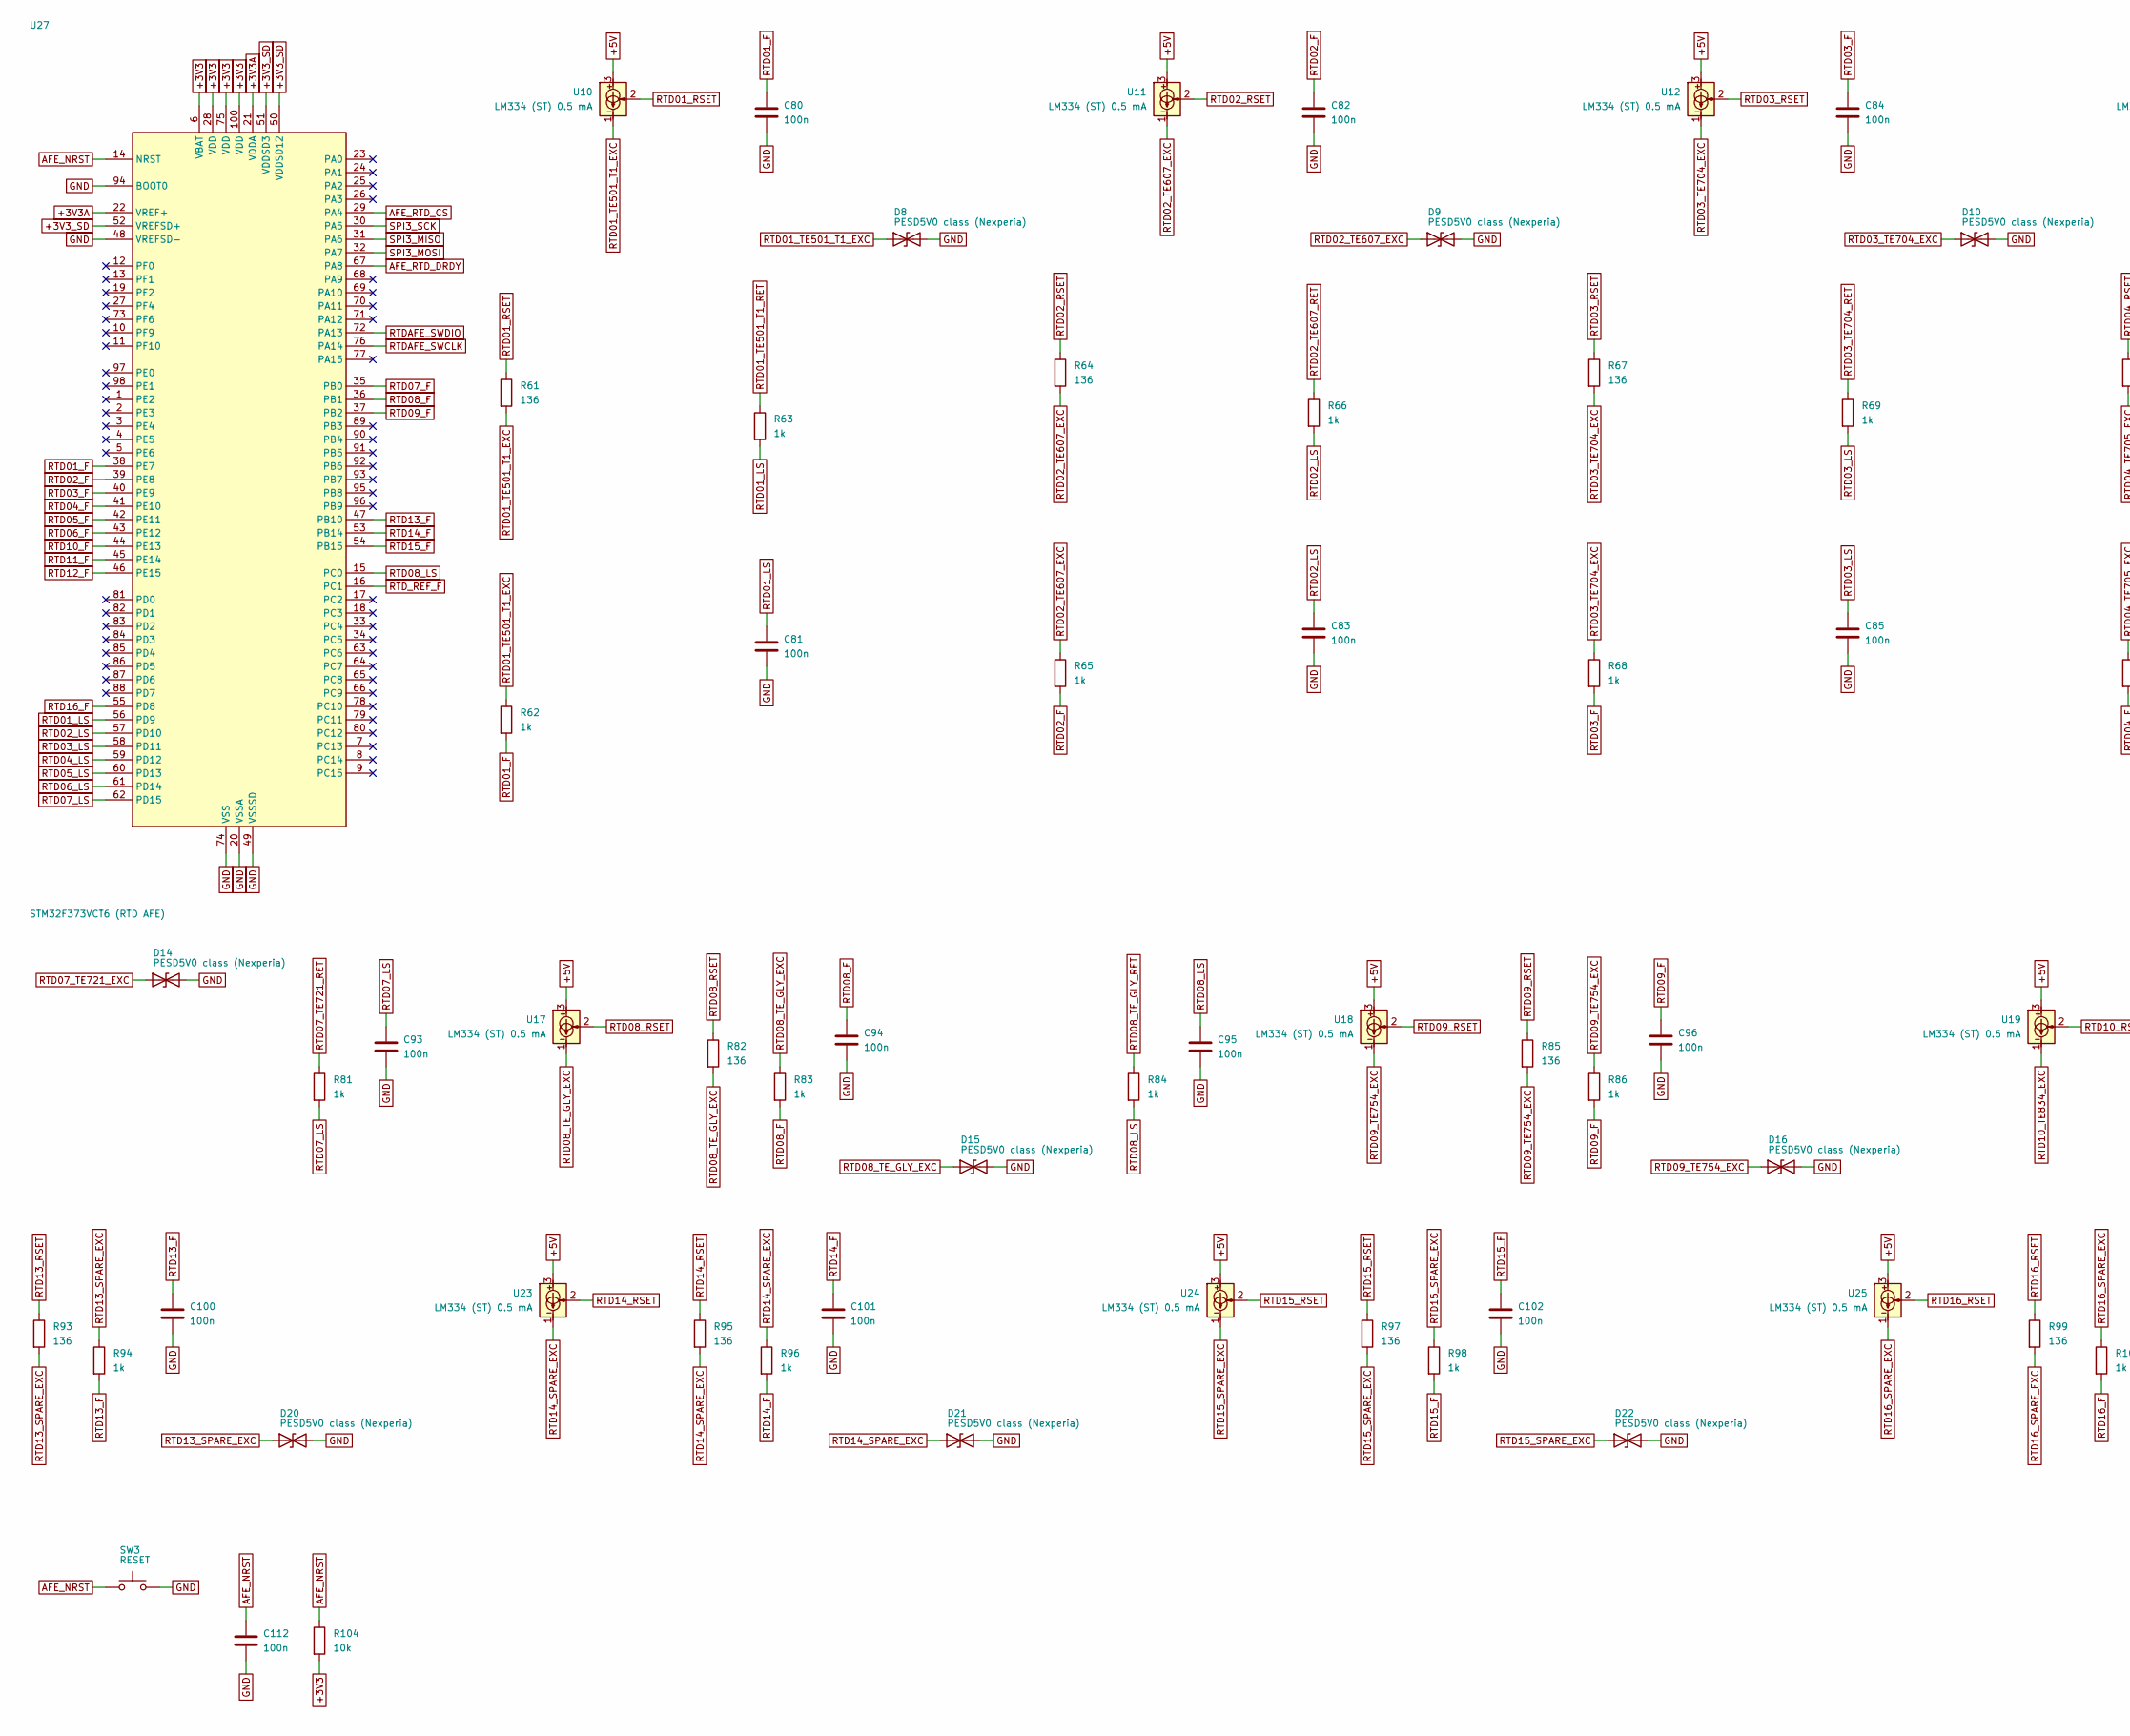
[picture p233: schematic afe_rtd.kicad_sch, part in row 1, column 1]

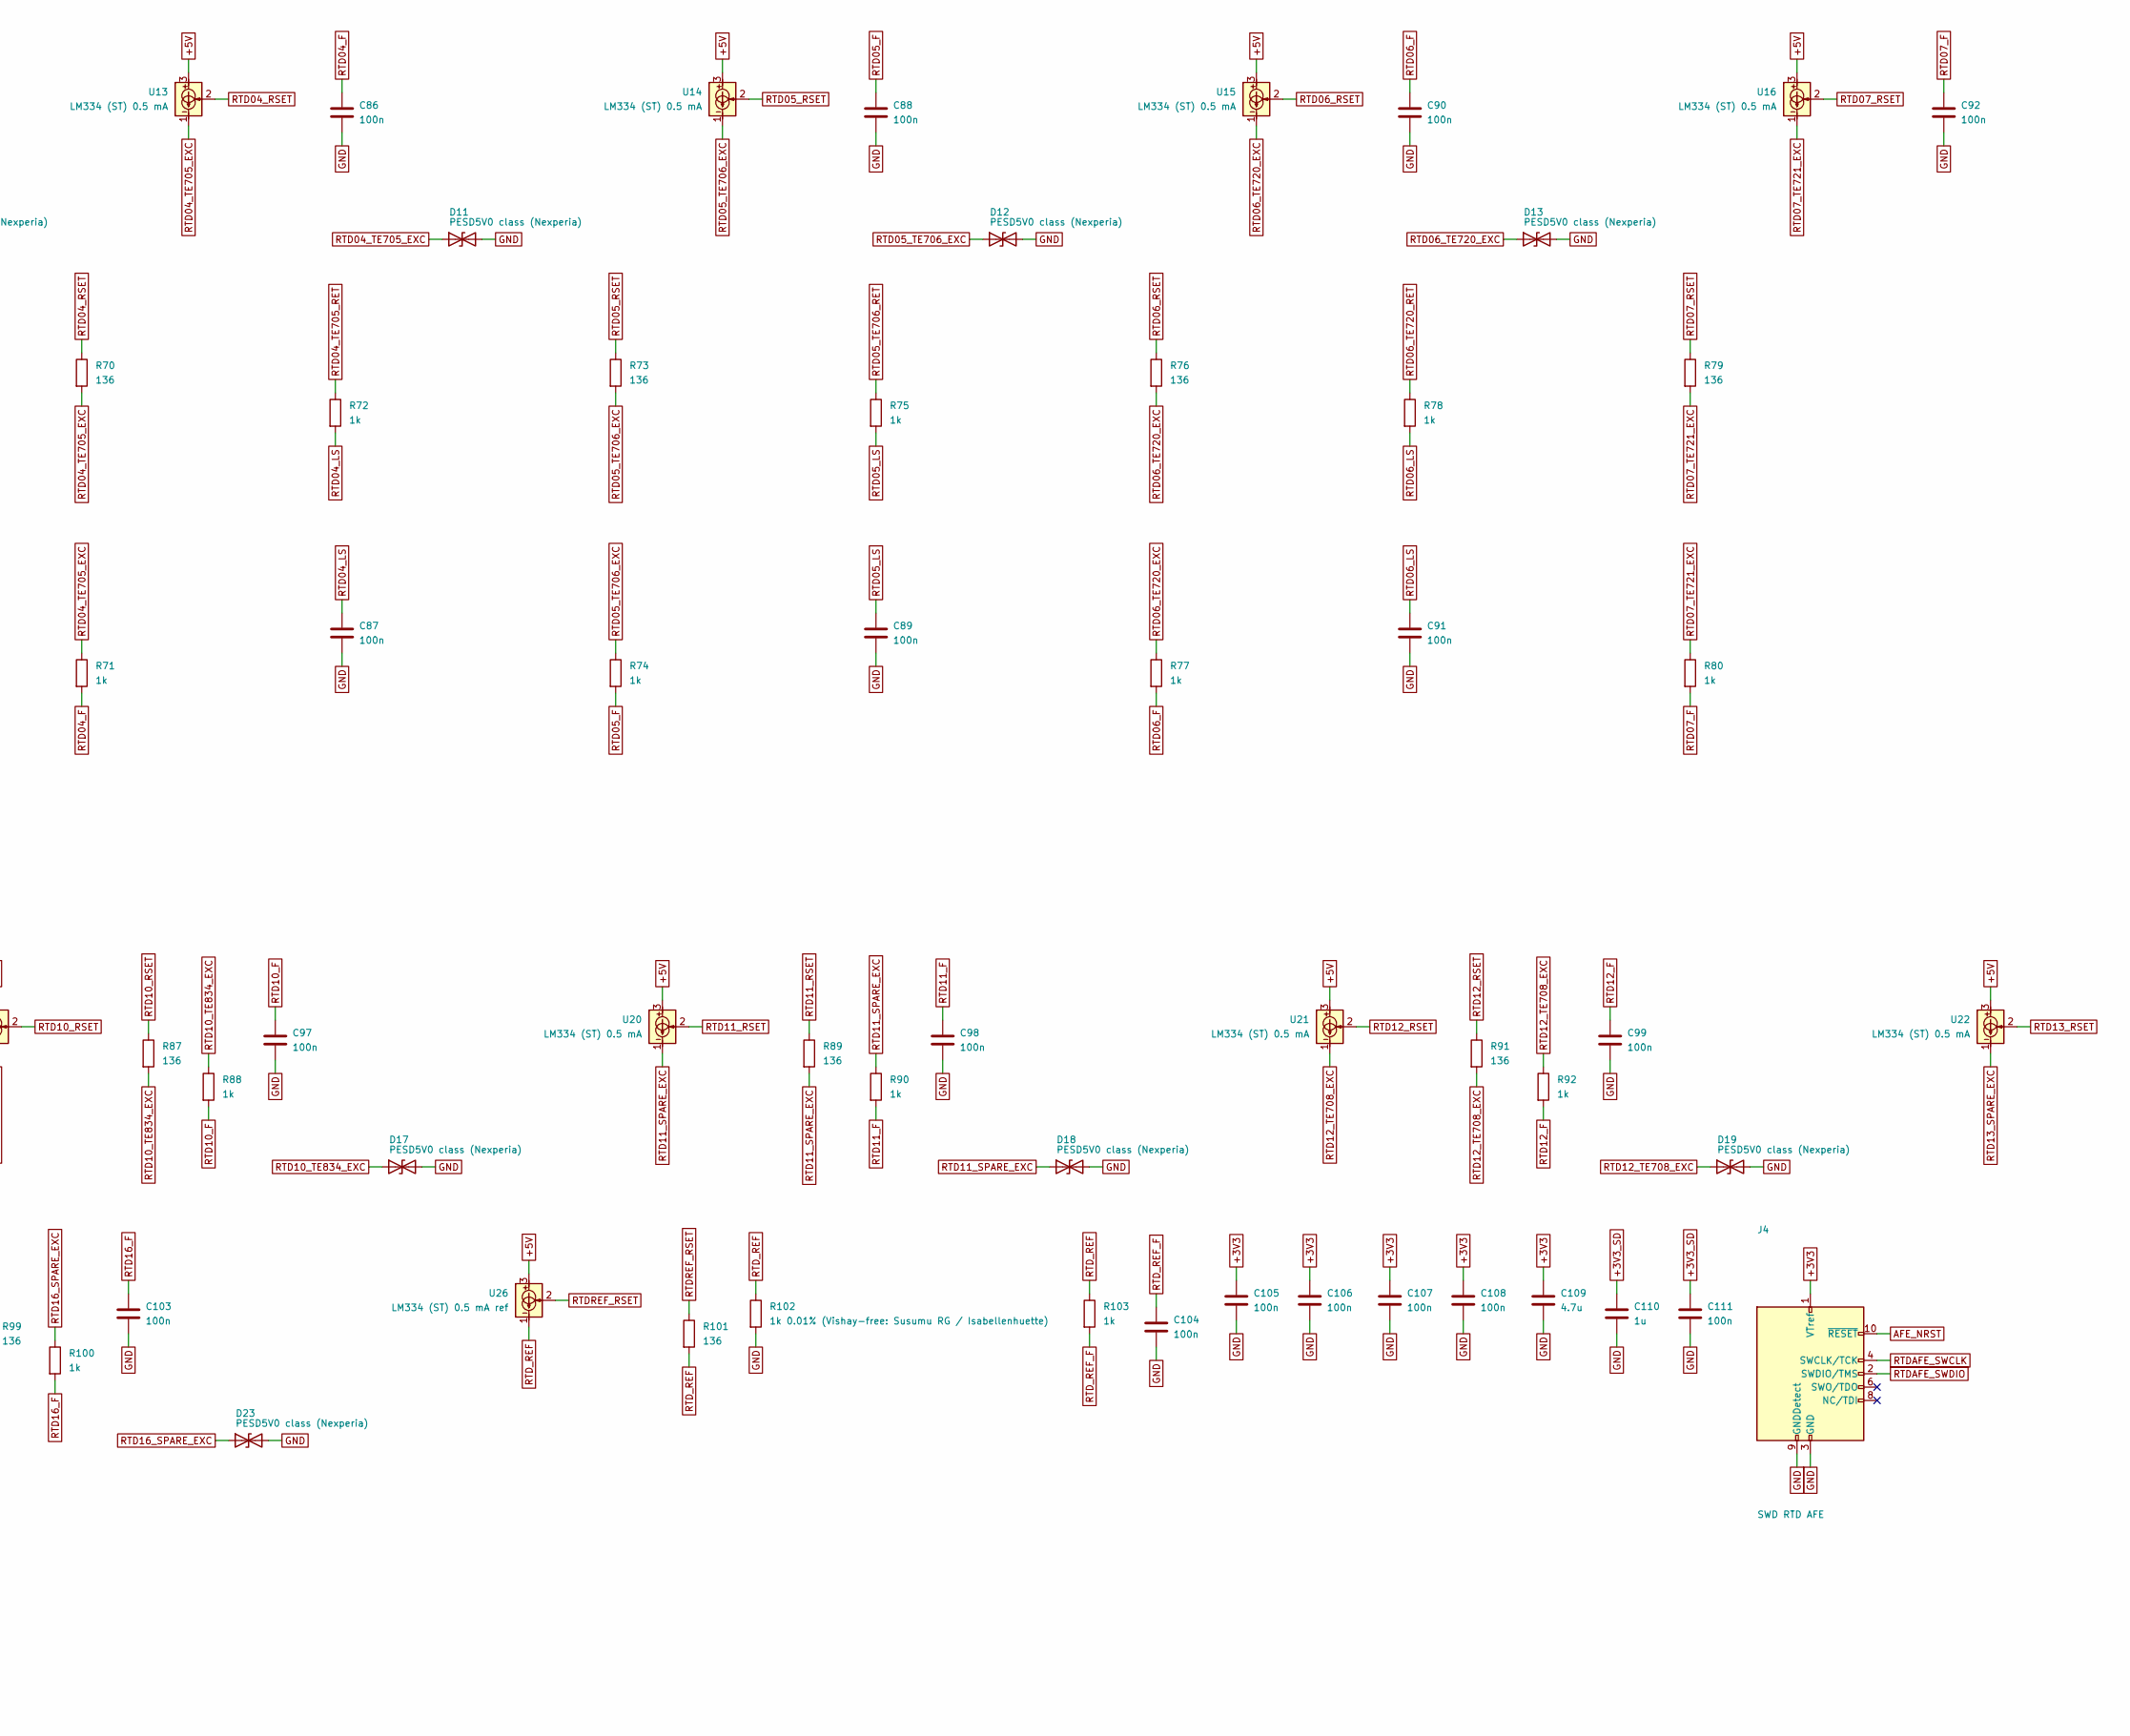
[picture p234: schematic afe_rtd.kicad_sch, part in row 1, column 2]

Parts:
C80, C81, C82, C83, C84, C85, C86, C87, C88, C89, C90, C91, C92, C93, C94, C95, C96, C97, C98, C99, C100, C101, C102, C103, C104, C105, C106, C107, C108, C111, C112: 100n; C_0402_1005Metric
C109: 4.7u; C_0805_2012Metric
C110: 1u; C_0402_1005Metric
D8, D9, D10, D11, D12, D13, D14, D15, D16, D17, D18, D19, D20, D21, D22, D23: PESD5V0 class (Nexperia); SOT-23; MPN PESD5V0S1BL
J4: SWD RTD AFE; PinHeader_2x05_P1.27mm_Vertical_SMD; MPN 20021111-00010T4LF
R61, R64, R67, R70, R73, R76, R79, R82, R85, R87, R89, R91, R93, R95, R97, R99, R101: 136; R_0603_1608Metric
R62, R63, R65, R66, R68, R69, R71, R72, R74, R75, R77, R78, R80, R81, R83, R84, R86, R88, R90, R92, R94, R96, R98, R100, R103: 1k; R_0402_1005Metric
R102: 1k 0.01% (Vishay-free: Susumu RG / Isabellenhuett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; R_0603_1608Metric
R104: 10k; R_0402_1005Metric
SW3: RESET; SW_SPST_TL3342; MPN PTS645SM43SMTR92
U10, U11, U12, U13, U14, U15, U16, U17, U18, U19, U20, U21, U22, U23, U24, U25: LM334 (ST) 0.5 mA; SOIC-8_3.9x4.9mm_P1.27mm; MPN LM334DT
U26: LM334 (ST) 0.5 mA ref; SOIC-8_3.9x4.9mm_P1.27mm; MPN LM334DT
U27: STM32F373VCT6 (RTD AFE); LQFP-100_14x14mm_P0.5mm; MPN STM32F373VCT6; LCSC C1121903

Connections:
+3V3: C105.1, C106.1, C107.1, C108.1, C109.1, J4.1 (VTref), R104.2, U27.6 (VBAT), U27.28 (VDD), U27.75 (VDD), U27.100 (VDD)
+3V3A: U27.21 (VDDA), U27.22 (VREF+)
+3V3_SD: C110.1, C111.1, U27.50 (VDDSD12), U27.51 (VDDSD3), U27.52 (VREFSD+)
+5V: U10.3, U11.3, U12.3, U13.3, U14.3, U15.3, U16.3, U17.3, U18.3, U19.3, U20.3, U21.3, U22.3, U23.3, U24.3, U25.3, U26.3
AFE_NRST: C112.1, J4.10 (~RESET), R104.1, SW3.1, U27.14 (NRST)
AFE_RTD_CS: U27.29 (PA4)
AFE_RTD_DRDY: U27.67 (PA8)
GND: C80.2, C81.2, C82.2, C83.2, C84.2, C85.2, C86.2, C87.2, C88.2, C89.2, C90.2, C91.2, C92.2, C93.2, C94.2, C95.2, C96.2, C97.2, C98.2, C99.2, C100.2, C101.2, C102.2, C103.2, C104.2, C105.2, C106.2, C107.2, C108.2, C109.2, C110.2, C111.2, C112.2, D8.2 (A2), D9.2 (A2), D10.2 (A2), D11.2 (A2), D12.2 (A2), D13.2 (A2), D14.2 (A2), D15.2 (A2), D16.2 (A2), D17.2 (A2), D18.2 (A2), D19.2 (A2), D20.2 (A2), D21.2 (A2), D22.2 (A2), D23.2 (A2), J4.3 (GND), J4.5 (GND), J4.9 (GNDDetect), R102.2, SW3.2, U27.20 (VSSA), U27.48 (VREFSD-), U27.49 (VSSSD), U27.74 (VSS), U27.94 (BOOT0), U27.99 (VSS)
RTD01_F: C80.1, R62.2, U27.38 (PE7)
RTD01_LS: C81.1, R63.2, U27.56 (PD9)
RTD01_RSET: R61.1, U10.2
RTD01_TE501_T1_EXC: D8.1 (A1), R61.2, R62.1, U10.1
RTD01_TE501_T1_RET: R63.1
RTD02_F: C82.1, R65.2, U27.39 (PE8)
RTD02_LS: C83.1, R66.2, U27.57 (PD10)
RTD02_RSET: R64.1, U11.2
RTD02_TE607_EXC: D9.1 (A1), R64.2, R65.1, U11.1
RTD02_TE607_RET: R66.1
RTD03_F: C84.1, R68.2, U27.40 (PE9)
RTD03_LS: C85.1, R69.2, U27.58 (PD11)
RTD03_RSET: R67.1, U12.2
RTD03_TE704_EXC: D10.1 (A1), R67.2, R68.1, U12.1
RTD03_TE704_RET: R69.1
RTD04_F: C86.1, R71.2, U27.41 (PE10)
RTD04_LS: C87.1, R72.2, U27.59 (PD12)
RTD04_RSET: R70.1, U13.2
RTD04_TE705_EXC: D11.1 (A1), R70.2, R71.1, U13.1
RTD04_TE705_RET: R72.1
RTD05_F: C88.1, R74.2, U27.42 (PE11)
RTD05_LS: C89.1, R75.2, U27.60 (PD13)
RTD05_RSET: R73.1, U14.2
RTD05_TE706_EXC: D12.1 (A1), R73.2, R74.1, U14.1
RTD05_TE706_RET: R75.1
RTD06_F: C90.1, R77.2, U27.43 (PE12)
RTD06_LS: C91.1, R78.2, U27.61 (PD14)
RTD06_RSET: R76.1, U15.2
RTD06_TE720_EXC: D13.1 (A1), R76.2, R77.1, U15.1
RTD06_TE720_RET: R78.1
RTD07_F: C92.1, R80.2, U27.35 (PB0)
RTD07_LS: C93.1, R81.2, U27.62 (PD15)
RTD07_RSET: R79.1, U16.2
RTD07_TE721_EXC: D14.1 (A1), R79.2, R80.1, U16.1
RTD07_TE721_RET: R81.1
RTD08_F: C94.1, R83.2, U27.36 (PB1)
RTD08_LS: C95.1, R84.2, U27.15 (PC0)
RTD08_RSET: R82.1, U17.2
RTD08_TE_GLY_EXC: D15.1 (A1), R82.2, R83.1, U17.1
RTD08_TE_GLY_RET: R84.1
RTD09_F: C96.1, R86.2, U27.37 (PB2)
RTD09_RSET: R85.1, U18.2
RTD09_TE754_EXC: D16.1 (A1), R85.2, R86.1, U18.1
RTD10_F: C97.1, R88.2, U27.44 (PE13)
RTD10_RSET: R87.1, U19.2
RTD10_TE834_EXC: D17.1 (A1), R87.2, R88.1, U19.1
RTD11_F: C98.1, R90.2, U27.45 (PE14)
RTD11_RSET: R89.1, U20.2
RTD11_SPARE_EXC: D18.1 (A1), R89.2, R90.1, U20.1
RTD12_F: C99.1, R92.2, U27.46 (PE15)
RTD12_RSET: R91.1, U21.2
RTD12_TE708_EXC: D19.1 (A1), R91.2, R92.1, U21.1
RTD13_F: C100.1, R94.2, U27.47 (PB10)
RTD13_RSET: R93.1, U22.2
RTD13_SPARE_EXC: D20.1 (A1), R93.2, R94.1, U22.1
RTD14_F: C101.1, R96.2, U27.53 (PB14)
RTD14_RSET: R95.1, U23.2
RTD14_SPARE_EXC: D21.1 (A1), R95.2, R96.1, U23.1
RTD15_F: C102.1, R98.2, U27.54 (PB15)
RTD15_RSET: R97.1, U24.2
RTD15_SPARE_EXC: D22.1 (A1), R97.2, R98.1, U24.1
RTD16_F: C103.1, R100.2, U27.55 (PD8)
RTD16_RSET: R99.1, U25.2
RTD16_SPARE_EXC: D23.1 (A1), R99.2, R100.1, U25.1
RTDAFE_SWCLK: J4.4 (SWCLK/TCK), U27.76 (PA14)
RTDAFE_SWDIO: J4.2 (SWDIO/TMS), U27.72 (PA13)
RTDREF_RSET: R101.1, U26.2
RTD_REF: R101.2, R102.1, R103.1, U26.1
RTD_REF_F: C104.1, R103.2, U27.16 (PC1)
SPI3_MISO: U27.31 (PA6)
SPI3_MOSI: U27.32 (PA7)
SPI3_SCK: U27.30 (PA5)
