ahmadreza221/aurora-cchp/electronics/b2_sio/out/afe_tc.kicad_sch

## KiCad design electronics/b2_sio/out/afe_tc.kicad_sch (2026-10-22)

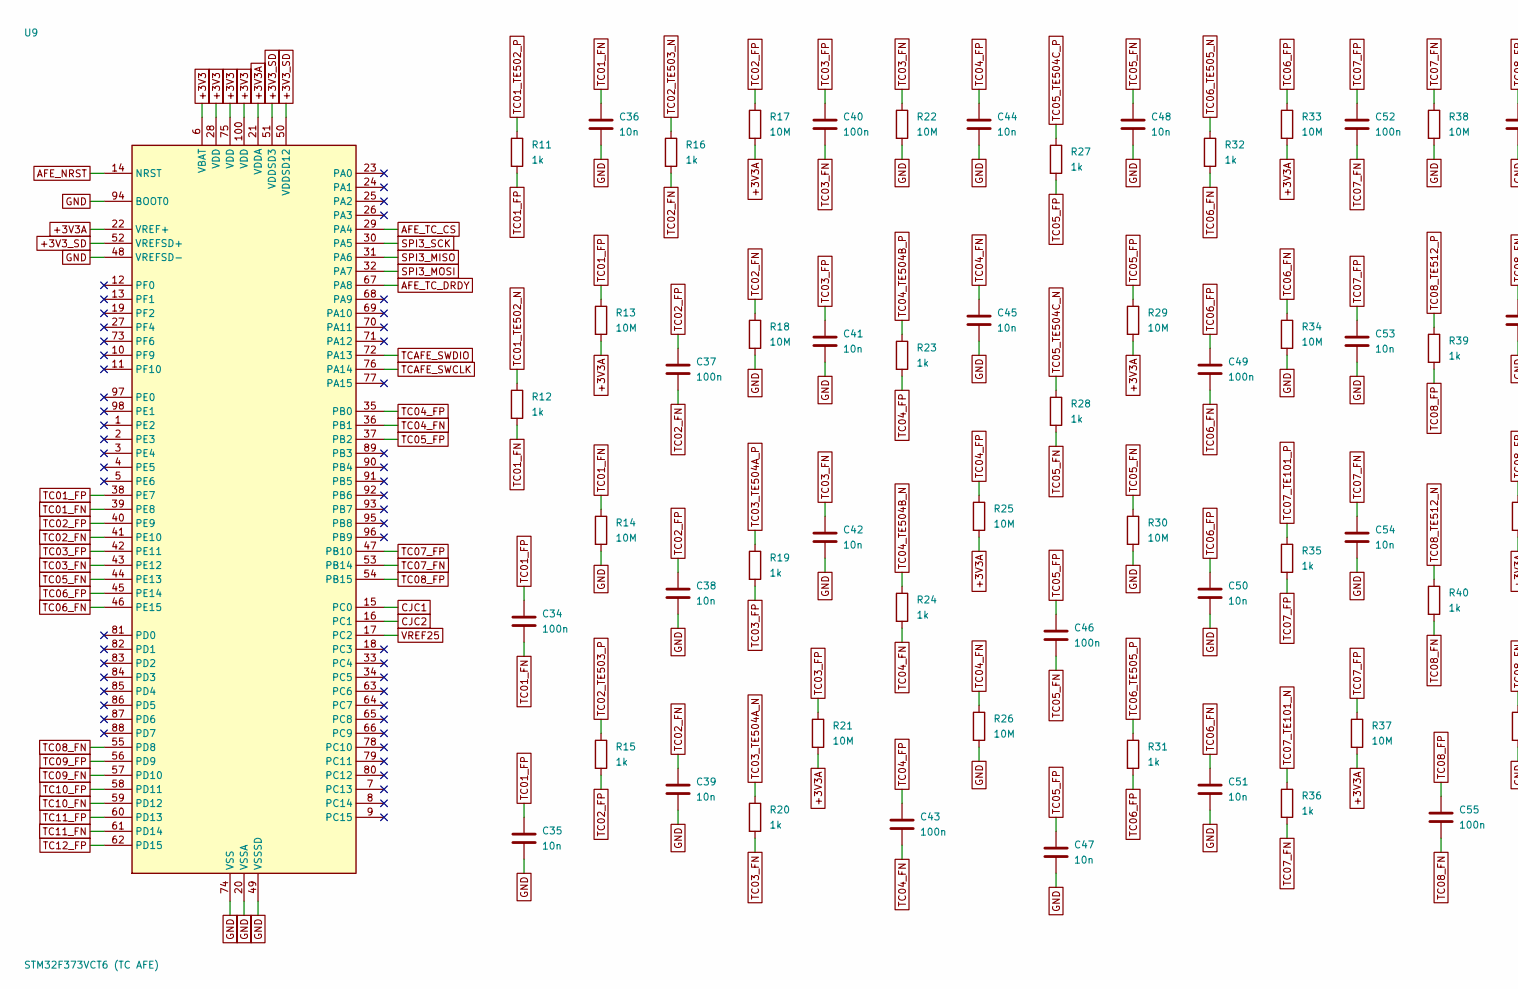
[picture p235: schematic afe_tc.kicad_sch, part in row 1, column 1]

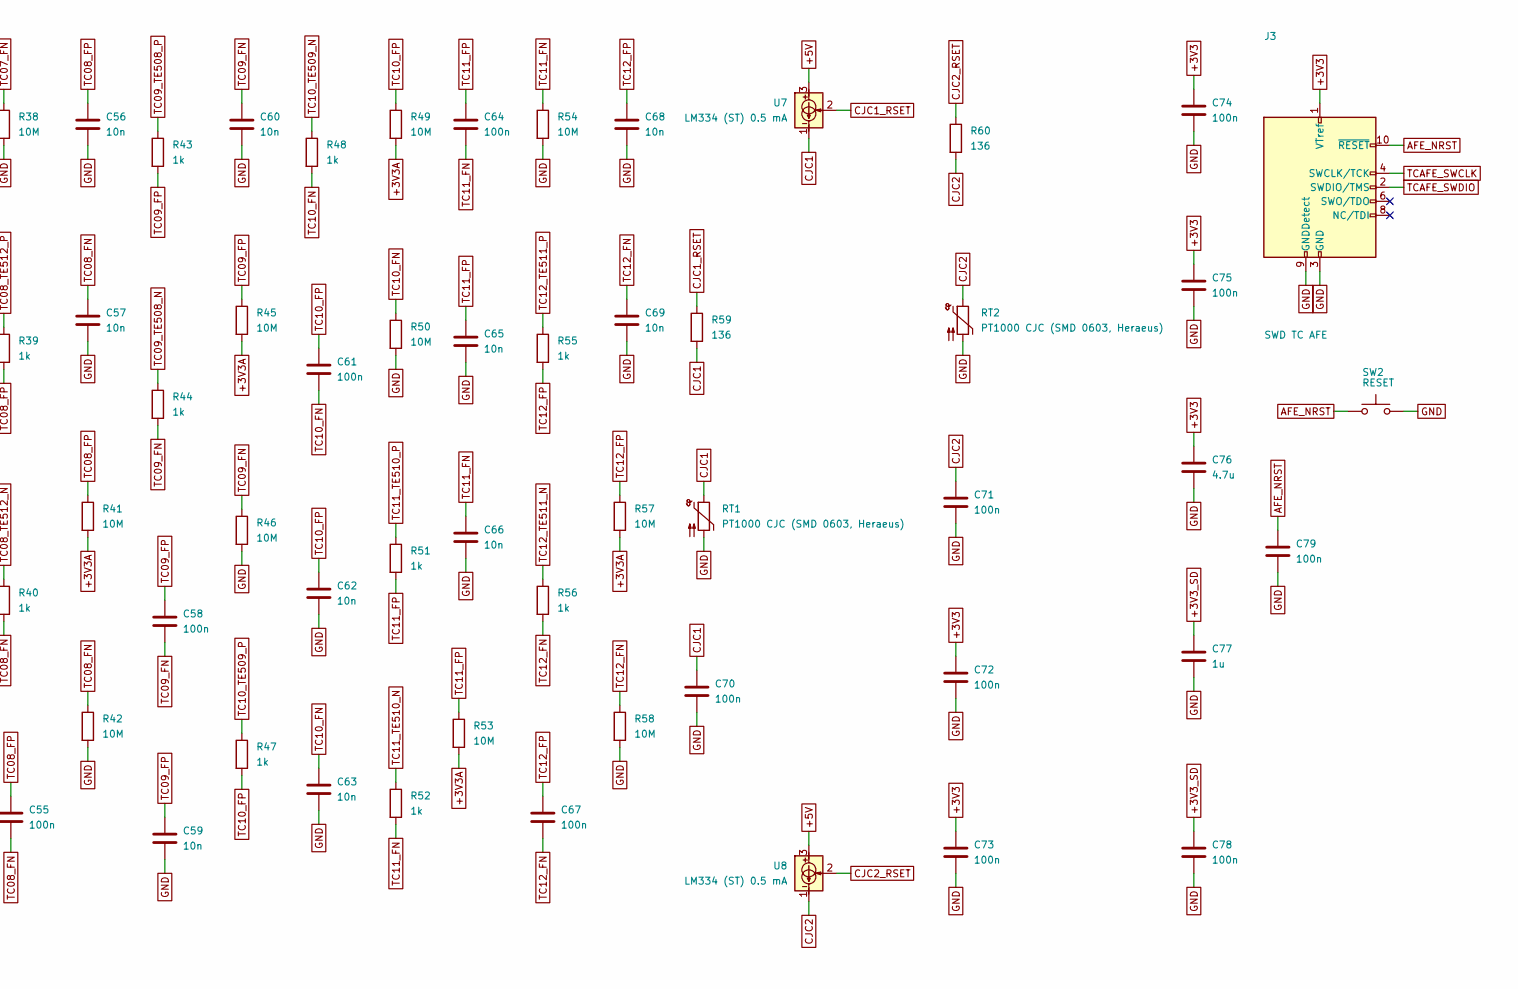
[picture p236: schematic afe_tc.kicad_sch, part in row 1, column 2]

Parts:
C34, C37, C40, C43, C46, C49, C52, C55, C58, C61, C64, C67, C70, C71, C72, C73, C74, C75, C78, C79: 100n; C_0402_1005Metric
C35, C36, C38, C39, C41, C42, C44, C45, C47, C48, C50, C51, C53, C54, C56, C57, C59, C60, C62, C63, C65, C66, C68, C69: 10n; C_0402_1005Metric
C76: 4.7u; C_0805_2012Metric
C77: 1u; C_0402_1005Metric
J3: SWD TC AFE; PinHeader_2x05_P1.27mm_Vertical_SMD; MPN 20021111-00010T4LF
R11, R12, R15, R16, R19, R20, R23, R24, R27, R28, R31, R32, R35, R36, R39, R40, R43, R44, R47, R48, R51, R52, R55, R56: 1k; R_0402_1005Metric
R13, R14, R17, R18, R21, R22, R25, R26, R29, R30, R33, R34, R37, R38, R41, R42, R45, R46, R49, R50, R53, R54, R57, R58: 10M; R_0603_1608Metric
R59, R60: 136; R_0603_1608Metric
RT1, RT2: PT1000 CJC (SMD 0603, Heraeus); R_0603_1608Metric; MPN 32208550
SW2: RESET; SW_SPST_TL3342; MPN PTS645SM43SMTR92
U7, U8: LM334 (ST) 0.5 mA; SOIC-8_3.9x4.9mm_P1.27mm; MPN LM334DT
U9: STM32F373VCT6 (TC AFE); LQFP-100_14x14mm_P0.5mm; MPN STM32F373VCT6; LCSC C1121903

Connections:
+3V3: C72.1, C73.1, C74.1, C75.1, C76.1, J3.1 (VTref), U9.6 (VBAT), U9.28 (VDD), U9.75 (VDD), U9.100 (VDD)
+3V3A: R13.2, R17.2, R21.2, R25.2, R29.2, R33.2, R37.2, R41.2, R45.2, R49.2, R53.2, R57.2, U9.21 (VDDA), U9.22 (VREF+)
+3V3_SD: C77.1, C78.1, U9.50 (VDDSD12), U9.51 (VDDSD3), U9.52 (VREFSD+)
+5V: U7.3, U8.3
AFE_NRST: C79.1, J3.10 (~RESET), SW2.1, U9.14 (NRST)
AFE_TC_CS: U9.29 (PA4)
AFE_TC_DRDY: U9.67 (PA8)
CJC1: C70.1, R59.2, RT1.1, U7.1, U9.15 (PC0)
CJC1_RSET: R59.1, U7.2
CJC2: C71.1, R60.2, RT2.1, U8.1, U9.16 (PC1)
CJC2_RSET: R60.1, U8.2
GND: C35.2, C36.2, C38.2, C39.2, C41.2, C42.2, C44.2, C45.2, C47.2, C48.2, C50.2, C51.2, C53.2, C54.2, C56.2, C57.2, C59.2, C60.2, C62.2, C63.2, C65.2, C66.2, C68.2, C69.2, C70.2, C71.2, C72.2, C73.2, C74.2, C75.2, C76.2, C77.2, C78.2, C79.2, J3.3 (GND), J3.5 (GND), J3.9 (GNDDetect), R14.2, R18.2, R22.2, R26.2, R30.2, R34.2, R38.2, R42.2, R46.2, R50.2, R54.2, R58.2, RT1.2, RT2.2, SW2.2, U9.20 (VSSA), U9.48 (VREFSD-), U9.49 (VSSSD), U9.74 (VSS), U9.94 (BOOT0), U9.99 (VSS)
SPI3_MISO: U9.31 (PA6)
SPI3_MOSI: U9.32 (PA7)
SPI3_SCK: U9.30 (PA5)
TC01_FN: C34.2, C36.1, R12.2, R14.1, U9.39 (PE8)
TC01_FP: C34.1, C35.1, R11.2, R13.1, U9.38 (PE7)
TC01_TE502_N: R12.1
TC01_TE502_P: R11.1
TC02_FN: C37.2, C39.1, R16.2, R18.1, U9.41 (PE10)
TC02_FP: C37.1, C38.1, R15.2, R17.1, U9.40 (PE9)
TC02_TE503_N: R16.1
TC02_TE503_P: R15.1
TC03_FN: C40.2, C42.1, R20.2, R22.1, U9.43 (PE12)
TC03_FP: C40.1, C41.1, R19.2, R21.1, U9.42 (PE11)
TC03_TE504A_N: R20.1
TC03_TE504A_P: R19.1
TC04_FN: C43.2, C45.1, R24.2, R26.1, U9.36 (PB1)
TC04_FP: C43.1, C44.1, R23.2, R25.1, U9.35 (PB0)
TC04_TE504B_N: R24.1
TC04_TE504B_P: R23.1
TC05_FN: C46.2, C48.1, R28.2, R30.1, U9.44 (PE13)
TC05_FP: C46.1, C47.1, R27.2, R29.1, U9.37 (PB2)
TC05_TE504C_N: R28.1
TC05_TE504C_P: R27.1
TC06_FN: C49.2, C51.1, R32.2, R34.1, U9.46 (PE15)
TC06_FP: C49.1, C50.1, R31.2, R33.1, U9.45 (PE14)
TC06_TE505_N: R32.1
TC06_TE505_P: R31.1
TC07_FN: C52.2, C54.1, R36.2, R38.1, U9.53 (PB14)
TC07_FP: C52.1, C53.1, R35.2, R37.1, U9.47 (PB10)
TC07_TE101_N: R36.1
TC07_TE101_P: R35.1
TC08_FN: C55.2, C57.1, R40.2, R42.1, U9.55 (PD8)
TC08_FP: C55.1, C56.1, R39.2, R41.1, U9.54 (PB15)
TC08_TE512_N: R40.1
TC08_TE512_P: R39.1
TC09_FN: C58.2, C60.1, R44.2, R46.1, U9.57 (PD10)
TC09_FP: C58.1, C59.1, R43.2, R45.1, U9.56 (PD9)
TC09_TE508_N: R44.1
TC09_TE508_P: R43.1
TC10_FN: C61.2, C63.1, R48.2, R50.1, U9.59 (PD12)
TC10_FP: C61.1, C62.1, R47.2, R49.1, U9.58 (PD11)
TC10_TE509_N: R48.1
TC10_TE509_P: R47.1
TC11_FN: C64.2, C66.1, R52.2, R54.1, U9.61 (PD14)
TC11_FP: C64.1, C65.1, R51.2, R53.1, U9.60 (PD13)
TC11_TE510_N: R52.1
TC11_TE510_P: R51.1
TC12_FN: C67.2, C69.1, R56.2, R58.1
TC12_FP: C67.1, C68.1, R55.2, R57.1, U9.62 (PD15)
TC12_TE511_N: R56.1
TC12_TE511_P: R55.1
TCAFE_SWCLK: J3.4 (SWCLK/TCK), U9.76 (PA14)
TCAFE_SWDIO: J3.2 (SWDIO/TMS), U9.72 (PA13)
VREF25: U9.17 (PC2)
