ahmadreza221/aurora-cchp/electronics/b2_sio/out/ai_4_20ma.kicad_sch

## KiCad design electronics/b2_sio/out/ai_4_20ma.kicad_sch (2026-10-22)

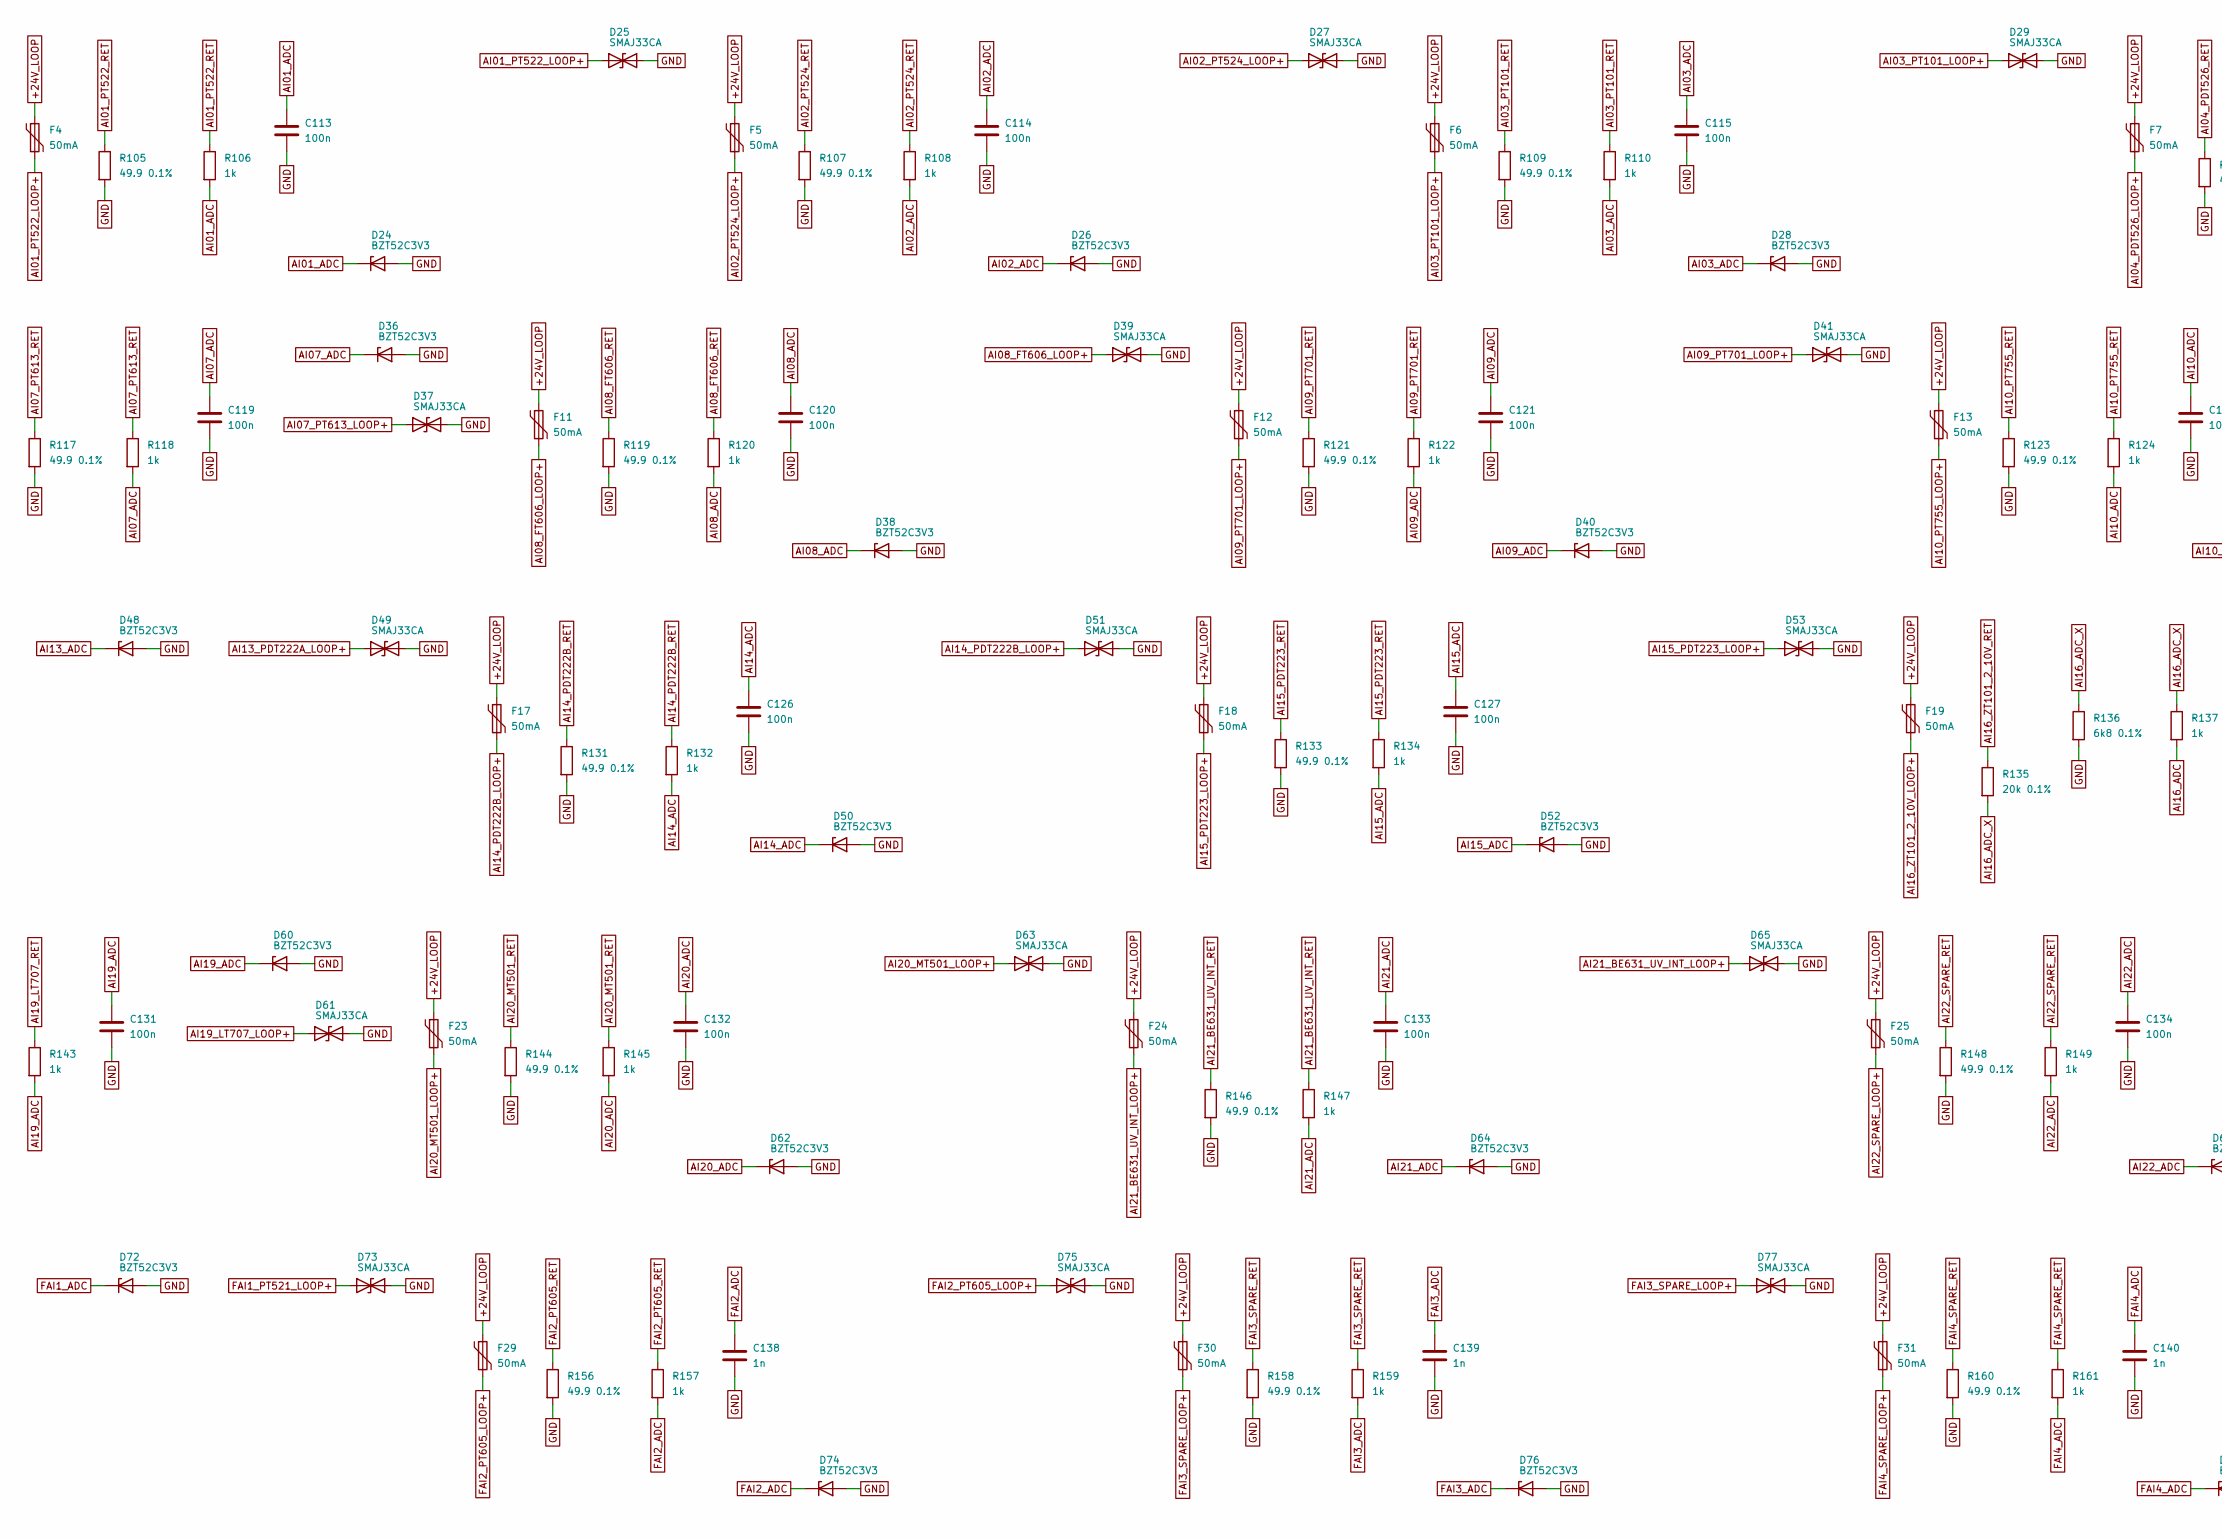
[picture p237: schematic ai_4_20ma.kicad_sch, part in row 1, column 1]

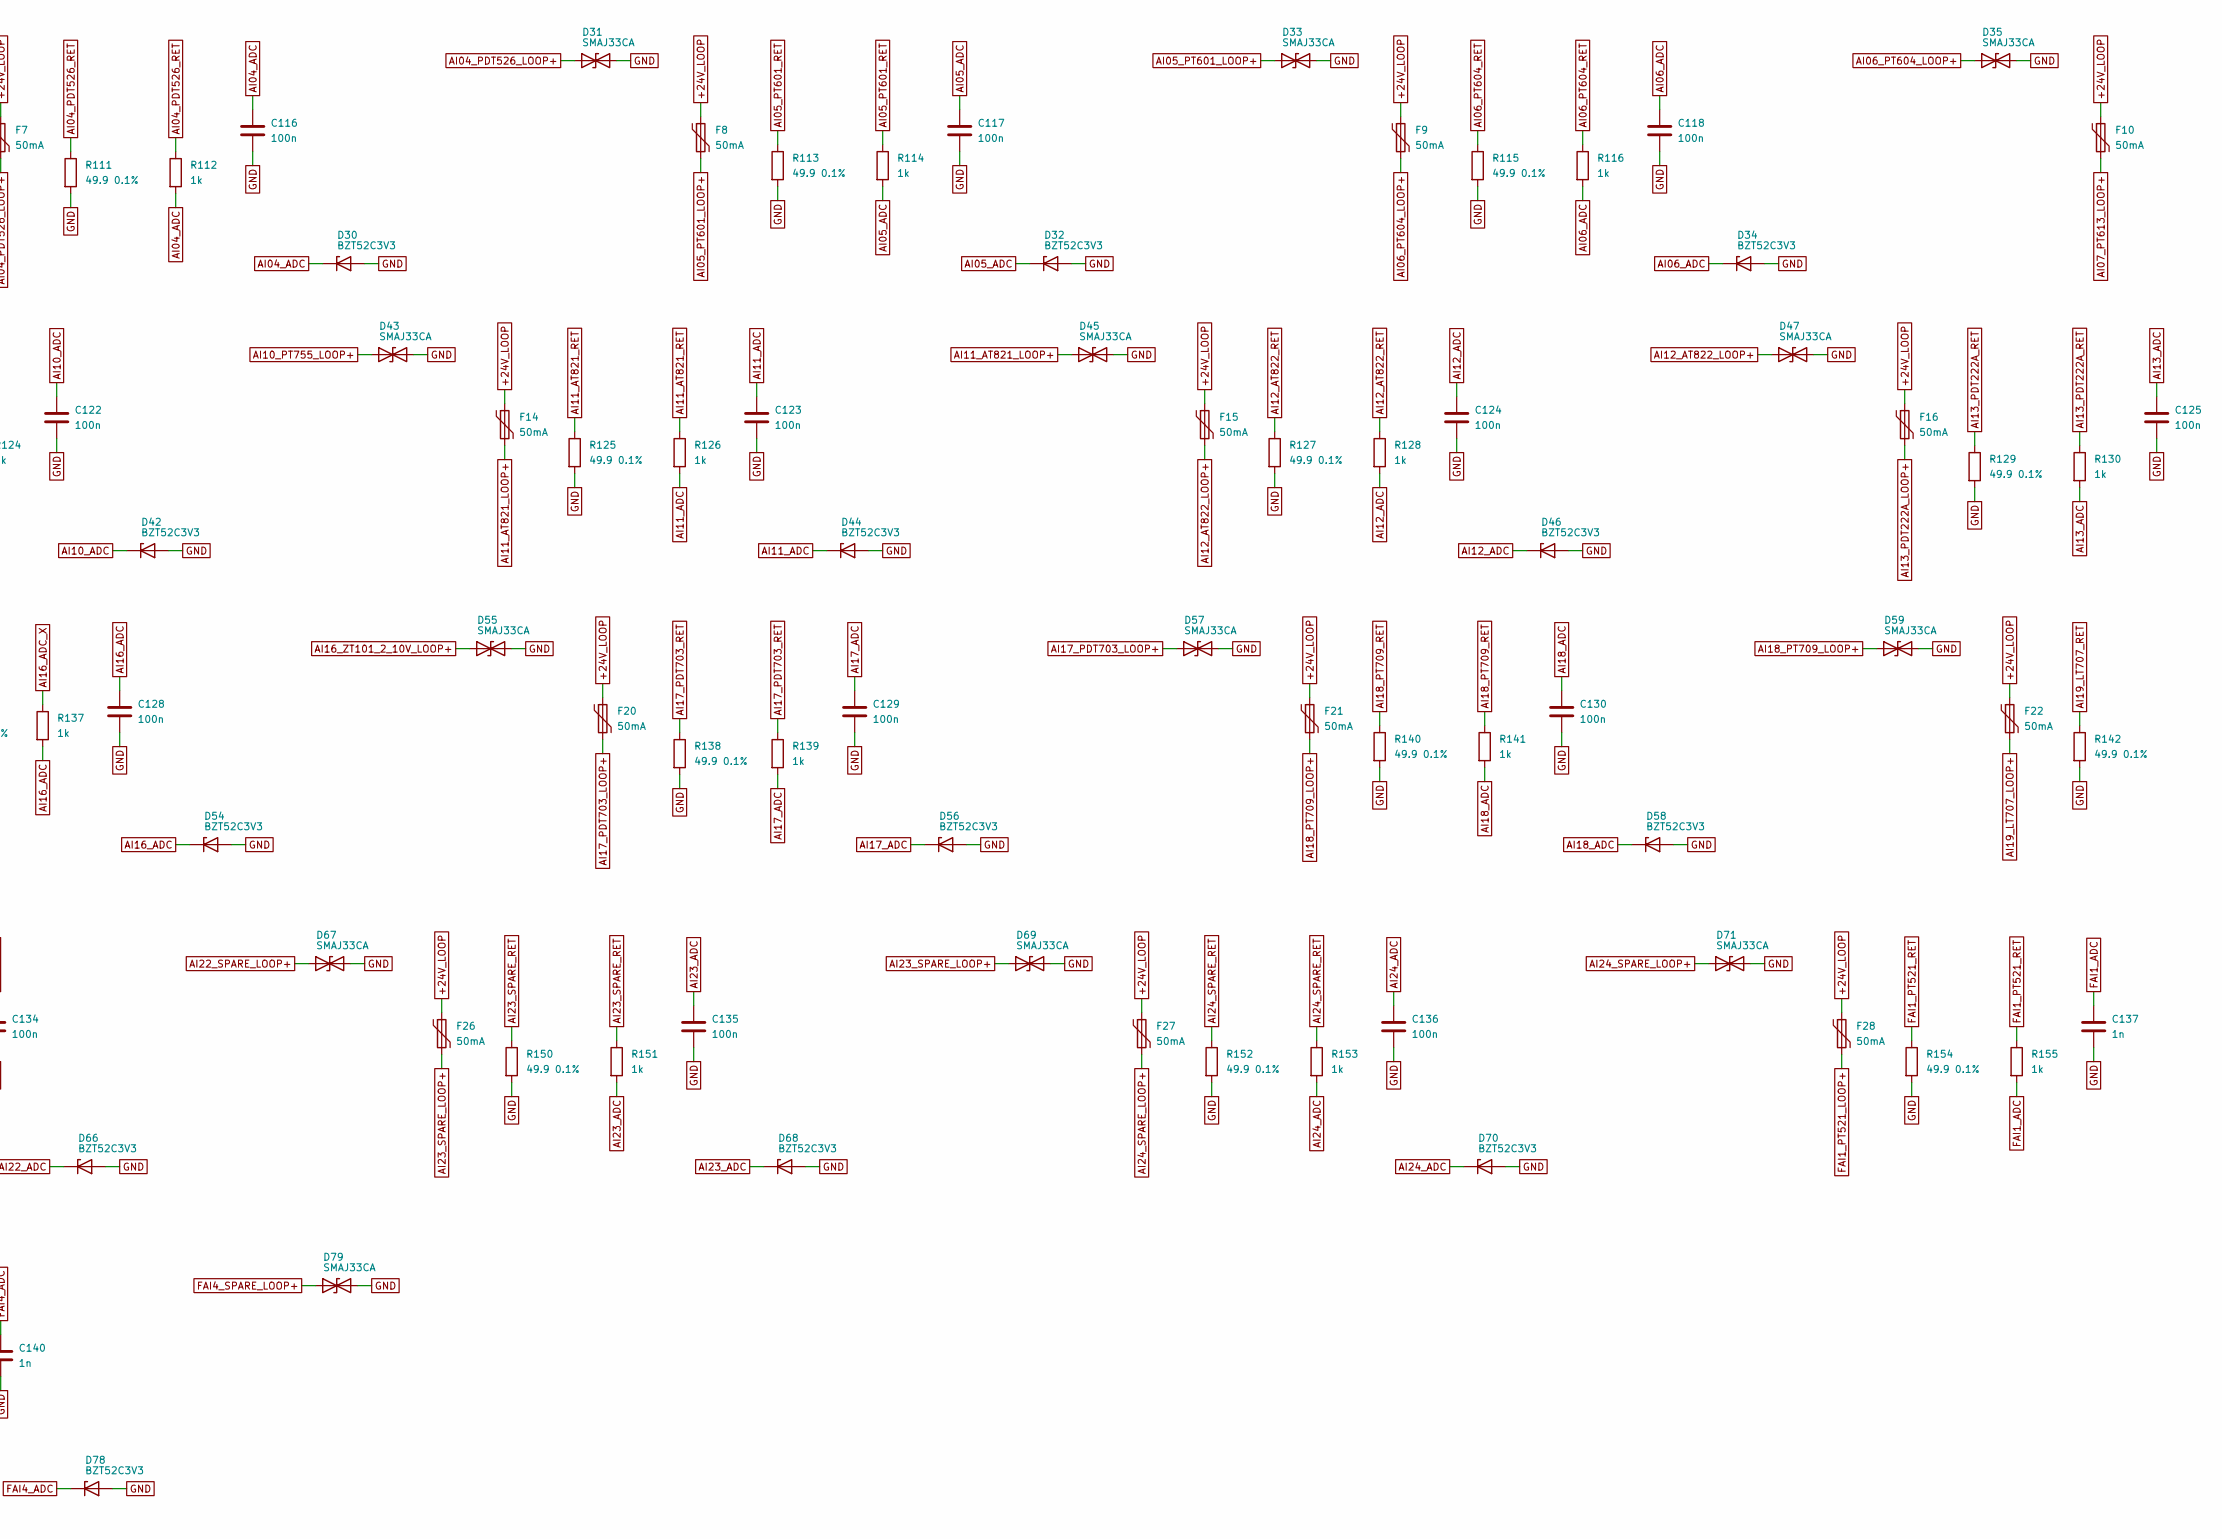
[picture p238: schematic ai_4_20ma.kicad_sch, part in row 1, column 2]

Parts:
C113, C114, C115, C116, C117, C118, C119, C120, C121, C122, C123, C124, C125, C126, C127, C128, C129, C130, C131, C132, C133, C134, C135, C136: 100n; C_0402_1005Metric
C137, C138, C139, C140: 1n; C_0402_1005Metric
D24, D26, D28, D30, D32, D34, D36, D38, D40, D42, D44, D46, D48, D50, D52, D54, D56, D58, D60, D62, D64, D66, D68, D70, D72, D74, D76, D78: BZT52C3V3; D_SOD-123; MPN BZT52H-C3V3
D25, D27, D29, D31, D33, D35, D37, D39, D41, D43, D45, D47, D49, D51, D53, D55, D57, D59, D61, D63, D65, D67, D69, D71, D73, D75, D77, D79: SMAJ33CA; D_SMA; MPN SMAJ33CA-TR; LCSC C115251
F4, F5, F6, F7, F8, F9, F10, F11, F12, F13, F14, F15, F16, F17, F18, F19, F20, F21, F22, F23, F24, F25, F26, F27, F28, F29, F30, F31: 50mA; Fuse_0805_2012Metric; MPN PFRA.005
R105, R107, R109, R111, R113, R115, R117, R119, R121, R123, R125, R127, R129, R131, R133, R138, R140, R142, R144, R146, R148, R150, R152, R154, R156, R158, R160: 49.9 0.1%; R_0805_2012Metric; MPN RG2012P-49R9-B-T5
R106, R108, R110, R112, R114, R116, R118, R120, R122, R124, R126, R128, R130, R132, R134, R137, R139, R141, R143, R145, R147, R149, R151, R153, R155, R157, R159, R161: 1k; R_0402_1005Metric
R135: 20k 0.1%; R_0603_1608Metric
R136: 6k8 0.1%; R_0603_1608Metric

Connections:
+24V_LOOP: F4.1, F5.1, F6.1, F7.1, F8.1, F9.1, F10.1, F11.1, F12.1, F13.1, F14.1, F15.1, F16.1, F17.1, F18.1, F19.1, F20.1, F21.1, F22.1, F23.1, F24.1, F25.1, F26.1, F27.1, F28.1, F29.1, F30.1, F31.1
AI01_ADC: C113.1, D24.1 (K), R106.2
AI01_PT522_LOOP+: D25.1 (A1), F4.2
AI01_PT522_RET: R105.1, R106.1
AI02_ADC: C114.1, D26.1 (K), R108.2
AI02_PT524_LOOP+: D27.1 (A1), F5.2
AI02_PT524_RET: R107.1, R108.1
AI03_ADC: C115.1, D28.1 (K), R110.2
AI03_PT101_LOOP+: D29.1 (A1), F6.2
AI03_PT101_RET: R109.1, R110.1
AI04_ADC: C116.1, D30.1 (K), R112.2
AI04_PDT526_LOOP+: D31.1 (A1), F7.2
AI04_PDT526_RET: R111.1, R112.1
AI05_ADC: C117.1, D32.1 (K), R114.2
AI05_PT601_LOOP+: D33.1 (A1), F8.2
AI05_PT601_RET: R113.1, R114.1
AI06_ADC: C118.1, D34.1 (K), R116.2
AI06_PT604_LOOP+: D35.1 (A1), F9.2
AI06_PT604_RET: R115.1, R116.1
AI07_ADC: C119.1, D36.1 (K), R118.2
AI07_PT613_LOOP+: D37.1 (A1), F10.2
AI07_PT613_RET: R117.1, R118.1
AI08_ADC: C120.1, D38.1 (K), R120.2
AI08_FT606_LOOP+: D39.1 (A1), F11.2
AI08_FT606_RET: R119.1, R120.1
AI09_ADC: C121.1, D40.1 (K), R122.2
AI09_PT701_LOOP+: D41.1 (A1), F12.2
AI09_PT701_RET: R121.1, R122.1
AI10_ADC: C122.1, D42.1 (K), R124.2
AI10_PT755_LOOP+: D43.1 (A1), F13.2
AI10_PT755_RET: R123.1, R124.1
AI11_ADC: C123.1, D44.1 (K), R126.2
AI11_AT821_LOOP+: D45.1 (A1), F14.2
AI11_AT821_RET: R125.1, R126.1
AI12_ADC: C124.1, D46.1 (K), R128.2
AI12_AT822_LOOP+: D47.1 (A1), F15.2
AI12_AT822_RET: R127.1, R128.1
AI13_ADC: C125.1, D48.1 (K), R130.2
AI13_PDT222A_LOOP+: D49.1 (A1), F16.2
AI13_PDT222A_RET: R129.1, R130.1
AI14_ADC: C126.1, D50.1 (K), R132.2
AI14_PDT222B_LOOP+: D51.1 (A1), F17.2
AI14_PDT222B_RET: R131.1, R132.1
AI15_ADC: C127.1, D52.1 (K), R134.2
AI15_PDT223_LOOP+: D53.1 (A1), F18.2
AI15_PDT223_RET: R133.1, R134.1
AI16_ADC: C128.1, D54.1 (K), R137.2
AI16_ADC_X: R135.2, R136.1, R137.1
AI16_ZT101_2_10V_LOOP+: D55.1 (A1), F19.2
AI16_ZT101_2_10V_RET: R135.1
AI17_ADC: C129.1, D56.1 (K), R139.2
AI17_PDT703_LOOP+: D57.1 (A1), F20.2
AI17_PDT703_RET: R138.1, R139.1
AI18_ADC: C130.1, D58.1 (K), R141.2
AI18_PT709_LOOP+: D59.1 (A1), F21.2
AI18_PT709_RET: R140.1, R141.1
AI19_ADC: C131.1, D60.1 (K), R143.2
AI19_LT707_LOOP+: D61.1 (A1), F22.2
AI19_LT707_RET: R142.1, R143.1
AI20_ADC: C132.1, D62.1 (K), R145.2
AI20_MT501_LOOP+: D63.1 (A1), F23.2
AI20_MT501_RET: R144.1, R145.1
AI21_ADC: C133.1, D64.1 (K), R147.2
AI21_BE631_UV_INT_LOOP+: D65.1 (A1), F24.2
AI21_BE631_UV_INT_RET: R146.1, R147.1
AI22_ADC: C134.1, D66.1 (K), R149.2
AI22_SPARE_LOOP+: D67.1 (A1), F25.2
AI22_SPARE_RET: R148.1, R149.1
AI23_ADC: C135.1, D68.1 (K), R151.2
AI23_SPARE_LOOP+: D69.1 (A1), F26.2
AI23_SPARE_RET: R150.1, R151.1
AI24_ADC: C136.1, D70.1 (K), R153.2
AI24_SPARE_LOOP+: D71.1 (A1), F27.2
AI24_SPARE_RET: R152.1, R153.1
FAI1_ADC: C137.1, D72.1 (K), R155.2
FAI1_PT521_LOOP+: D73.1 (A1), F28.2
FAI1_PT521_RET: R154.1, R155.1
FAI2_ADC: C138.1, D74.1 (K), R157.2
FAI2_PT605_LOOP+: D75.1 (A1), F29.2
FAI2_PT605_RET: R156.1, R157.1
FAI3_ADC: C139.1, D76.1 (K), R159.2
FAI3_SPARE_LOOP+: D77.1 (A1), F30.2
FAI3_SPARE_RET: R158.1, R159.1
FAI4_ADC: C140.1, D78.1 (K), R161.2
FAI4_SPARE_LOOP+: D79.1 (A1), F31.2
FAI4_SPARE_RET: R160.1, R161.1
GND: C113.2, C114.2, C115.2, C116.2, C117.2, C118.2, C119.2, C120.2, C121.2, C122.2, C123.2, C124.2, C125.2, C126.2, C127.2, C128.2, C129.2, C130.2, C131.2, C132.2, C133.2, C134.2, C135.2, C136.2, C137.2, C138.2, C139.2, C140.2, D24.2 (A), D25.2 (A2), D26.2 (A), D27.2 (A2), D28.2 (A), D29.2 (A2), D30.2 (A), D31.2 (A2), D32.2 (A), D33.2 (A2), D34.2 (A), D35.2 (A2), D36.2 (A), D37.2 (A2), D38.2 (A), D39.2 (A2), D40.2 (A), D41.2 (A2), D42.2 (A), D43.2 (A2), D44.2 (A), D45.2 (A2), D46.2 (A), D47.2 (A2), D48.2 (A), D49.2 (A2), D50.2 (A), D51.2 (A2), D52.2 (A), D53.2 (A2), D54.2 (A), D55.2 (A2), D56.2 (A), D57.2 (A2), D58.2 (A), D59.2 (A2), D60.2 (A), D61.2 (A2), D62.2 (A), D63.2 (A2), D64.2 (A), D65.2 (A2), D66.2 (A), D67.2 (A2), D68.2 (A), D69.2 (A2), D70.2 (A), D71.2 (A2), D72.2 (A), D73.2 (A2), D74.2 (A), D75.2 (A2), D76.2 (A), D77.2 (A2), D78.2 (A), D79.2 (A2), R105.2, R107.2, R109.2, R111.2, R113.2, R115.2, R117.2, R119.2, R121.2, R123.2, R125.2, R127.2, R129.2, R131.2, R133.2, R136.2, R138.2, R140.2, R142.2, R144.2, R146.2, R148.2, R150.2, R152.2, R154.2, R156.2, R158.2, R160.2
