ahmadreza221/aurora-cchp/electronics/b2_sio/out/can.kicad_sch

## KiCad design electronics/b2_sio/out/can.kicad_sch (2026-10-22)

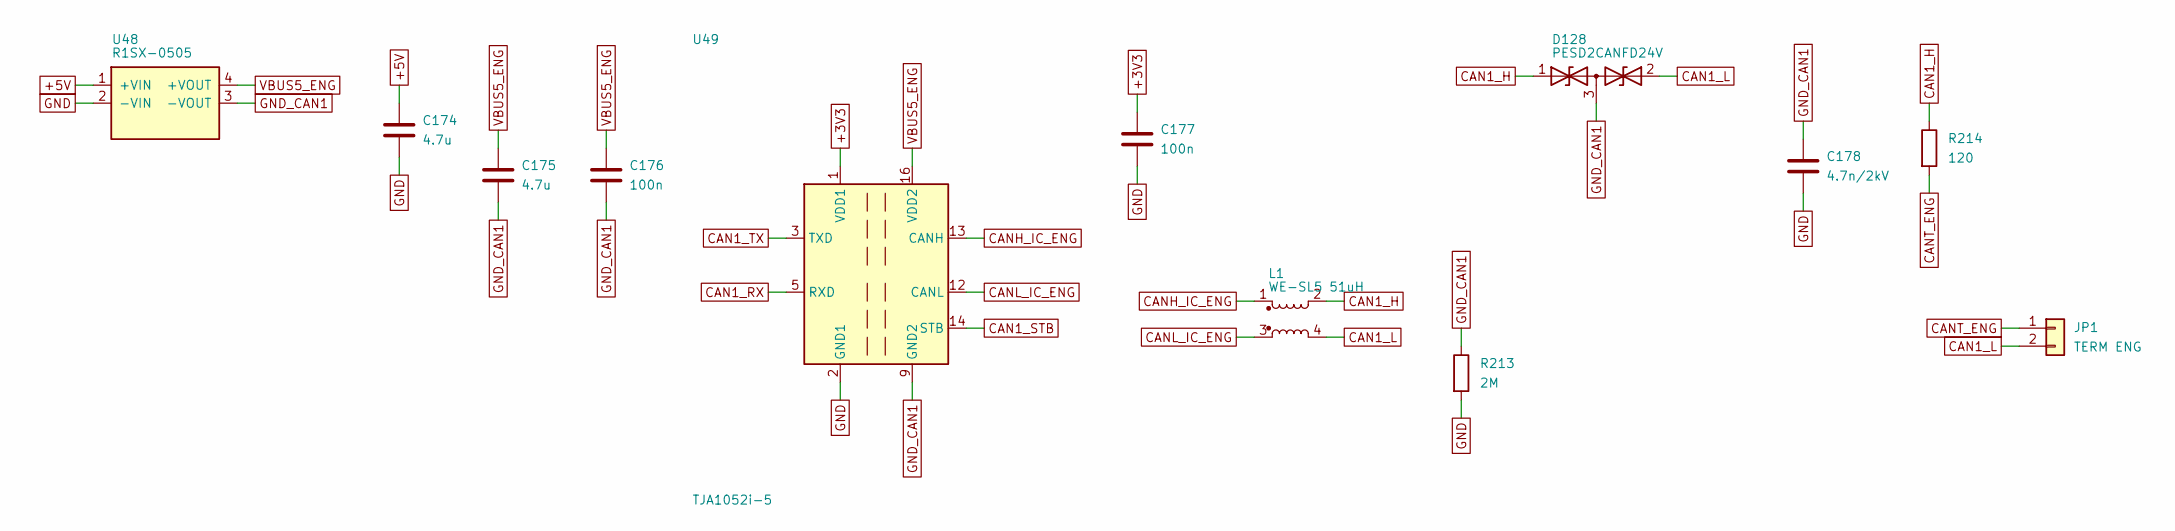
[picture p239: schematic can.kicad_sch]

Parts:
C174, C175: 4.7u; C_0805_2012Metric
C176, C177: 100n; C_0402_1005Metric
C178: 4.7n/2kV; C_1206_3216Metric
D128: PESD2CANFD24V; SOT-23; MPN PESD2CANFD24V-T; LCSC C552486
JP1: TERM ENG; PinHeader_1x02_P2.54mm_Vertical; MPN 61300211121
L1: WE-SL5 51uH; MPN 744235510; LCSC C5331174
R213: 2M; R_0402_1005Metric
R214: 120; R_0603_1608Metric
U48: R1SX-0505; MPN R1SX-0505
U49: TJA1052i-5; SOIC-16W_7.5x10.3mm_P1.27mm; MPN TJA1052IT/5Y; LCSC C92210

Connections:
+3V3: C177.1, U49.1 (VDD1)
+5V: C174.1, U48.1 (+VIN)
CAN1_H: D128.1 (A1), L1.2, R214.1
CAN1_L: D128.2 (A2), JP1.2, L1.4
CAN1_RX: U49.5 (RXD)
CAN1_STB: U49.14 (STB)
CAN1_TX: U49.3 (TXD)
CANH_IC_ENG: L1.1, U49.13 (CANH)
CANL_IC_ENG: L1.3, U49.12 (CANL)
CANT_ENG: JP1.1, R214.2
GND: C174.2, C177.2, C178.2, R213.2, U48.2 (-VIN), U49.2 (GND1), U49.7 (GND1), U49.8 (GND1)
GND_CAN1: C175.2, C176.2, C178.1, D128.3 (common), R213.1, U48.3 (-VOUT), U49.9 (GND2), U49.10 (GND2), U49.15 (GND2)
VBUS5_ENG: C175.1, C176.1, U48.4 (+VOUT), U49.11 (VDD2), U49.16 (VDD2)
