ahmadreza221/aurora-cchp/electronics/b2_sio/out/connectors.kicad_sch

## KiCad design electronics/b2_sio/out/connectors.kicad_sch (2026-10-22)

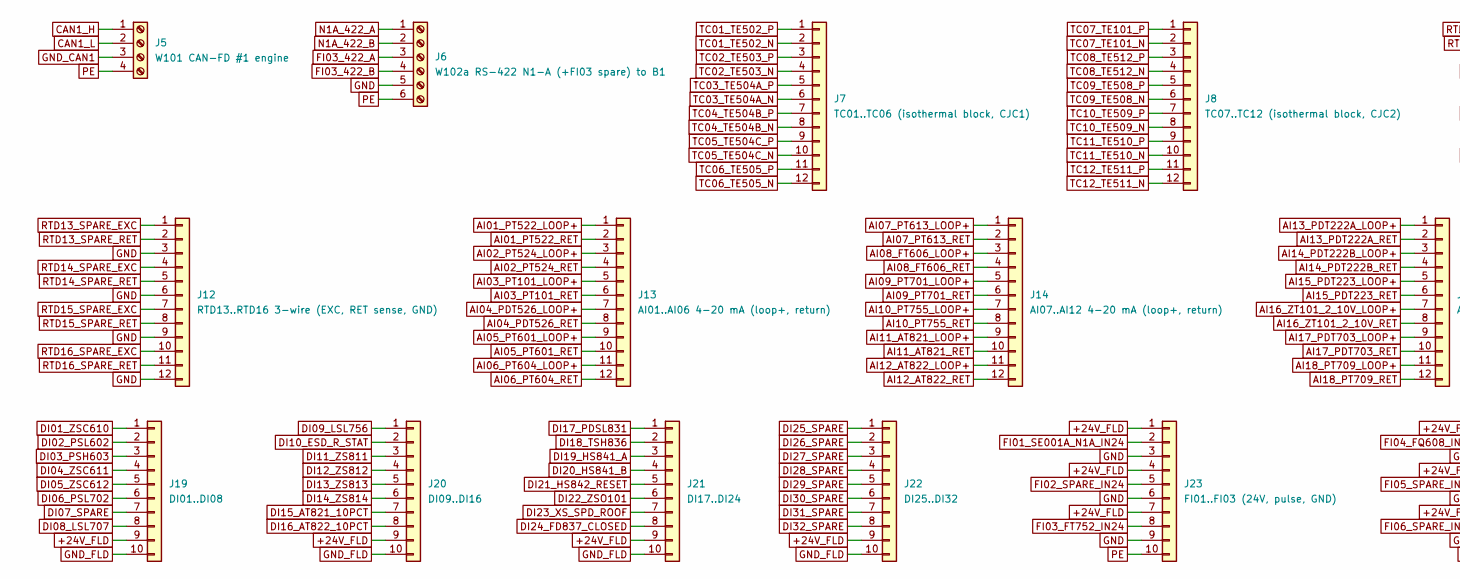
[picture p240: schematic connectors.kicad_sch, part in row 1, column 1]

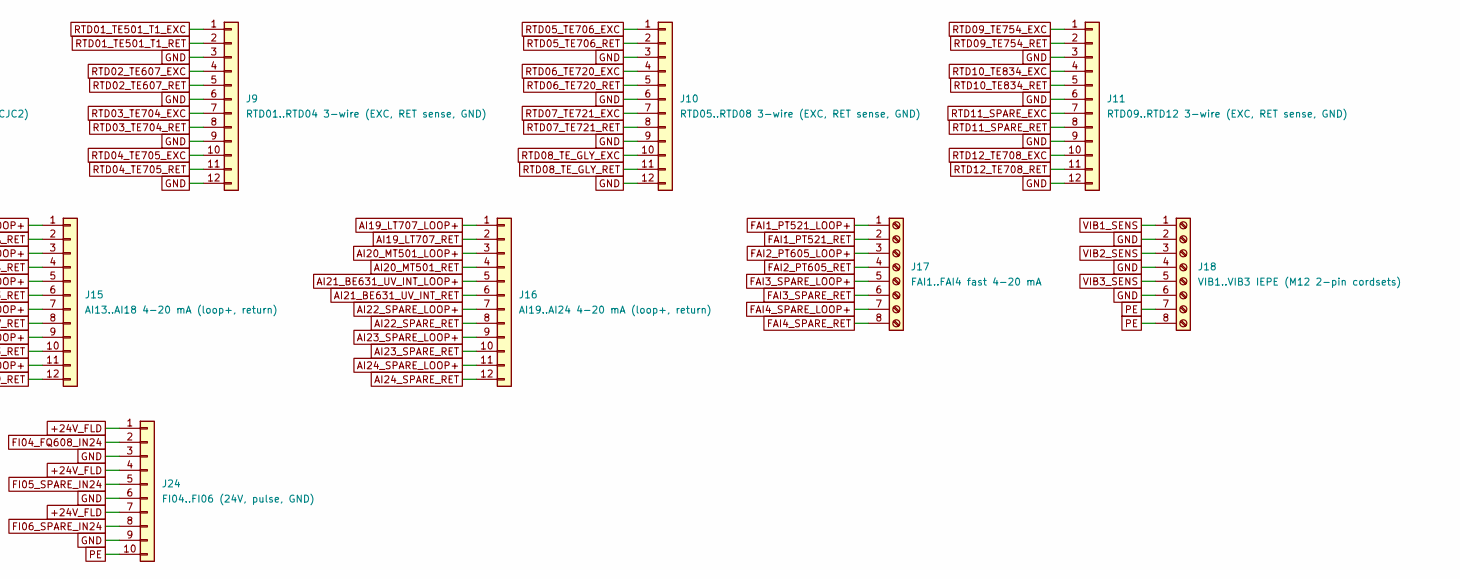
[picture p241: schematic connectors.kicad_sch, part in row 1, column 2]

Parts:
J5: W101 CAN-FD #1 engine; TerminalBlock_Phoenix_MKDS-1-4-3.81_1x04_P3.81mm_Horizontal; MPN MC 1,5/4-G-3,81
J6: W102a RS-422 N1-A (+FI03 spare) to B1; MPN MC 1,5/6-G-3,81
J7: TC01..TC06 (isothermal block, CJC1); TerminalBlock_Phoenix_MKDS-1-12-3.81_1x12_P3.81mm_Horizontal; MPN MC 1,5/12-G-3,81
J8: TC07..TC12 (isothermal block, CJC2); TerminalBlock_Phoenix_MKDS-1-12-3.81_1x12_P3.81mm_Horizontal; MPN MC 1,5/12-G-3,81
J9: RTD01..RTD04 3-wire (EXC, RET sense, GND); TerminalBlock_Phoenix_MKDS-1-12-3.81_1x12_P3.81mm_Horizontal; MPN MC 1,5/12-G-3,81
J10: RTD05..RTD08 3-wire (EXC, RET sense, GND); TerminalBlock_Phoenix_MKDS-1-12-3.81_1x12_P3.81mm_Horizontal; MPN MC 1,5/12-G-3,81
J11: RTD09..RTD12 3-wire (EXC, RET sense, GND); TerminalBlock_Phoenix_MKDS-1-12-3.81_1x12_P3.81mm_Horizontal; MPN MC 1,5/12-G-3,81
J12: RTD13..RTD16 3-wire (EXC, RET sense, GND); TerminalBlock_Phoenix_MKDS-1-12-3.81_1x12_P3.81mm_Horizontal; MPN MC 1,5/12-G-3,81
J13: AI01..AI06 4-20 mA (loop+, return); TerminalBlock_Phoenix_MKDS-1,5-12-5.08_1x12_P5.08mm_Horizon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; MPN MSTBA 2,5/12-G-5,08
J14: AI07..AI12 4-20 mA (loop+, return); TerminalBlock_Phoenix_MKDS-1,5-12-5.08_1x12_P5.08mm_Horizon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; MPN MSTBA 2,5/12-G-5,08
J15: AI13..AI18 4-20 mA (loop+, return); TerminalBlock_Phoenix_MKDS-1,5-12-5.08_1x12_P5.08mm_Horizon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; MPN MSTBA 2,5/12-G-5,08
J16: AI19..AI24 4-20 mA (loop+, return); TerminalBlock_Phoenix_MKDS-1,5-12-5.08_1x12_P5.08mm_Horizon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; MPN MSTBA 2,5/12-G-5,08
J17: FAI1..FAI4 fast 4-20 mA; TerminalBlock_Phoenix_MKDS-1,5-8-5.08_1x08_P5.08mm_Horizont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; MPN MSTBA 2,5/8-G-5,08
J18: VIB1..VIB3 IEPE (M12 2-pin cordsets); TerminalBlock_Phoenix_MKDS-1,5-8-5.08_1x08_P5.08mm_Horizont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; MPN MSTBA 2,5/8-G-5,08
J19: DI01..DI08; TerminalBlock_Phoenix_MKDS-1,5-10-5.08_1x10_P5.08mm_Horizon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; MPN MSTBA 2,5/10-G-5,08
J20: DI09..DI16; TerminalBlock_Phoenix_MKDS-1,5-10-5.08_1x10_P5.08mm_Horizon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; MPN MSTBA 2,5/10-G-5,08
J21: DI17..DI24; TerminalBlock_Phoenix_MKDS-1,5-10-5.08_1x10_P5.08mm_Horizon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; MPN MSTBA 2,5/10-G-5,08
J22: DI25..DI32; TerminalBlock_Phoenix_MKDS-1,5-10-5.08_1x10_P5.08mm_Horizon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; MPN MSTBA 2,5/10-G-5,08
J23: FI01..FI03 (24V, pulse, GND); TerminalBlock_Phoenix_MKDS-1,5-10-5.08_1x10_P5.08mm_Horizon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; MPN MSTBA 2,5/10-G-5,08
J24: FI04..FI06 (24V, pulse, GND); TerminalBlock_Phoenix_MKDS-1,5-10-5.08_1x10_P5.08mm_Horizon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; MPN MSTBA 2,5/10-G-5,08

Connections:
+24V_FLD: J19.9, J20.9, J21.9, J22.9, J23.1, J23.4, J23.7, J24.1, J24.4, J24.7
AI01_PT522_LOOP+: J13.1
AI01_PT522_RET: J13.2
AI02_PT524_LOOP+: J13.3
AI02_PT524_RET: J13.4
AI03_PT101_LOOP+: J13.5
AI03_PT101_RET: J13.6
AI04_PDT526_LOOP+: J13.7
AI04_PDT526_RET: J13.8
AI05_PT601_LOOP+: J13.9
AI05_PT601_RET: J13.10
AI06_PT604_LOOP+: J13.11
AI06_PT604_RET: J13.12
AI07_PT613_LOOP+: J14.1
AI07_PT613_RET: J14.2
AI08_FT606_LOOP+: J14.3
AI08_FT606_RET: J14.4
AI09_PT701_LOOP+: J14.5
AI09_PT701_RET: J14.6
AI10_PT755_LOOP+: J14.7
AI10_PT755_RET: J14.8
AI11_AT821_LOOP+: J14.9
AI11_AT821_RET: J14.10
AI12_AT822_LOOP+: J14.11
AI12_AT822_RET: J14.12
AI13_PDT222A_LOOP+: J15.1
AI13_PDT222A_RET: J15.2
AI14_PDT222B_LOOP+: J15.3
AI14_PDT222B_RET: J15.4
AI15_PDT223_LOOP+: J15.5
AI15_PDT223_RET: J15.6
AI16_ZT101_2_10V_LOOP+: J15.7
AI16_ZT101_2_10V_RET: J15.8
AI17_PDT703_LOOP+: J15.9
AI17_PDT703_RET: J15.10
AI18_PT709_LOOP+: J15.11
AI18_PT709_RET: J15.12
AI19_LT707_LOOP+: J16.1
AI19_LT707_RET: J16.2
AI20_MT501_LOOP+: J16.3
AI20_MT501_RET: J16.4
AI21_BE631_UV_INT_LOOP+: J16.5
AI21_BE631_UV_INT_RET: J16.6
AI22_SPARE_LOOP+: J16.7
AI22_SPARE_RET: J16.8
AI23_SPARE_LOOP+: J16.9
AI23_SPARE_RET: J16.10
AI24_SPARE_LOOP+: J16.11
AI24_SPARE_RET: J16.12
CAN1_H: J5.1
CAN1_L: J5.2
DI01_ZSC610: J19.1
DI02_PSL602: J19.2
DI03_PSH603: J19.3
DI04_ZSC611: J19.4
DI05_ZSC612: J19.5
DI06_PSL702: J19.6
DI07_SPARE: J19.7
DI08_LSL707: J19.8
DI09_LSL756: J20.1
DI10_ESD_R_STAT: J20.2
DI11_ZS811: J20.3
DI12_ZS812: J20.4
DI13_ZS813: J20.5
DI14_ZS814: J20.6
DI15_AT821_10PCT: J20.7
DI16_AT822_10PCT: J20.8
DI17_PDSL831: J21.1
DI18_TSH836: J21.2
DI19_HS841_A: J21.3
DI20_HS841_B: J21.4
DI21_HS842_RESET: J21.5
DI22_ZSO101: J21.6
DI23_XS_SPD_ROOF: J21.7
DI24_FD837_CLOSED: J21.8
DI25_SPARE: J22.1
DI26_SPARE: J22.2
DI27_SPARE: J22.3
DI28_SPARE: J22.4
DI29_SPARE: J22.5
DI30_SPARE: J22.6
DI31_SPARE: J22.7
DI32_SPARE: J22.8
FAI1_PT521_LOOP+: J17.1
FAI1_PT521_RET: J17.2
FAI2_PT605_LOOP+: J17.3
FAI2_PT605_RET: J17.4
FAI3_SPARE_LOOP+: J17.5
FAI3_SPARE_RET: J17.6
FAI4_SPARE_LOOP+: J17.7
FAI4_SPARE_RET: J17.8
FI01_SE001A_N1A_IN24: J23.2
FI02_SPARE_IN24: J23.5
FI03_422_A: J6.3
FI03_422_B: J6.4
FI03_FT752_IN24: J23.8
FI04_FQ608_IN24: J24.2
FI05_SPARE_IN24: J24.5
FI06_SPARE_IN24: J24.8
GND: J6.5, J9.3, J9.6, J9.9, J9.12, J10.3, J10.6, J10.9, J10.12, J11.3, J11.6, J11.9, J11.12, J12.3, J12.6, J12.9, J12.12, J18.2, J18.4, J18.6, J23.3, J23.6, J23.9, J24.3, J24.6, J24.9
GND_CAN1: J5.3
GND_FLD: J19.10, J20.10, J21.10, J22.10
N1A_422_A: J6.1
N1A_422_B: J6.2
PE: J5.4, J6.6, J18.7, J18.8, J23.10, J24.10
RTD01_TE501_T1_EXC: J9.1
RTD01_TE501_T1_RET: J9.2
RTD02_TE607_EXC: J9.4
RTD02_TE607_RET: J9.5
RTD03_TE704_EXC: J9.7
RTD03_TE704_RET: J9.8
RTD04_TE705_EXC: J9.10
RTD04_TE705_RET: J9.11
RTD05_TE706_EXC: J10.1
RTD05_TE706_RET: J10.2
RTD06_TE720_EXC: J10.4
RTD06_TE720_RET: J10.5
RTD07_TE721_EXC: J10.7
RTD07_TE721_RET: J10.8
RTD08_TE_GLY_EXC: J10.10
RTD08_TE_GLY_RET: J10.11
RTD09_TE754_EXC: J11.1
RTD09_TE754_RET: J11.2
RTD10_TE834_EXC: J11.4
RTD10_TE834_RET: J11.5
RTD11_SPARE_EXC: J11.7
RTD11_SPARE_RET: J11.8
RTD12_TE708_EXC: J11.10
RTD12_TE708_RET: J11.11
RTD13_SPARE_EXC: J12.1
RTD13_SPARE_RET: J12.2
RTD14_SPARE_EXC: J12.4
RTD14_SPARE_RET: J12.5
RTD15_SPARE_EXC: J12.7
RTD15_SPARE_RET: J12.8
RTD16_SPARE_EXC: J12.10
RTD16_SPARE_RET: J12.11
TC01_TE502_N: J7.2
TC01_TE502_P: J7.1
TC02_TE503_N: J7.4
TC02_TE503_P: J7.3
TC03_TE504A_N: J7.6
TC03_TE504A_P: J7.5
TC04_TE504B_N: J7.8
TC04_TE504B_P: J7.7
TC05_TE504C_N: J7.10
TC05_TE504C_P: J7.9
TC06_TE505_N: J7.12
TC06_TE505_P: J7.11
TC07_TE101_N: J8.2
TC07_TE101_P: J8.1
TC08_TE512_N: J8.4
TC08_TE512_P: J8.3
TC09_TE508_N: J8.6
TC09_TE508_P: J8.5
TC10_TE509_N: J8.8
TC10_TE509_P: J8.7
TC11_TE510_N: J8.10
TC11_TE510_P: J8.9
TC12_TE511_N: J8.12
TC12_TE511_P: J8.11
VIB1_SENS: J18.1
VIB2_SENS: J18.3
VIB3_SENS: J18.5
