ahmadreza221/aurora-cchp/electronics/b2_sio/out/digital_inputs.kicad_sch

## KiCad design electronics/b2_sio/out/digital_inputs.kicad_sch (2026-10-22)

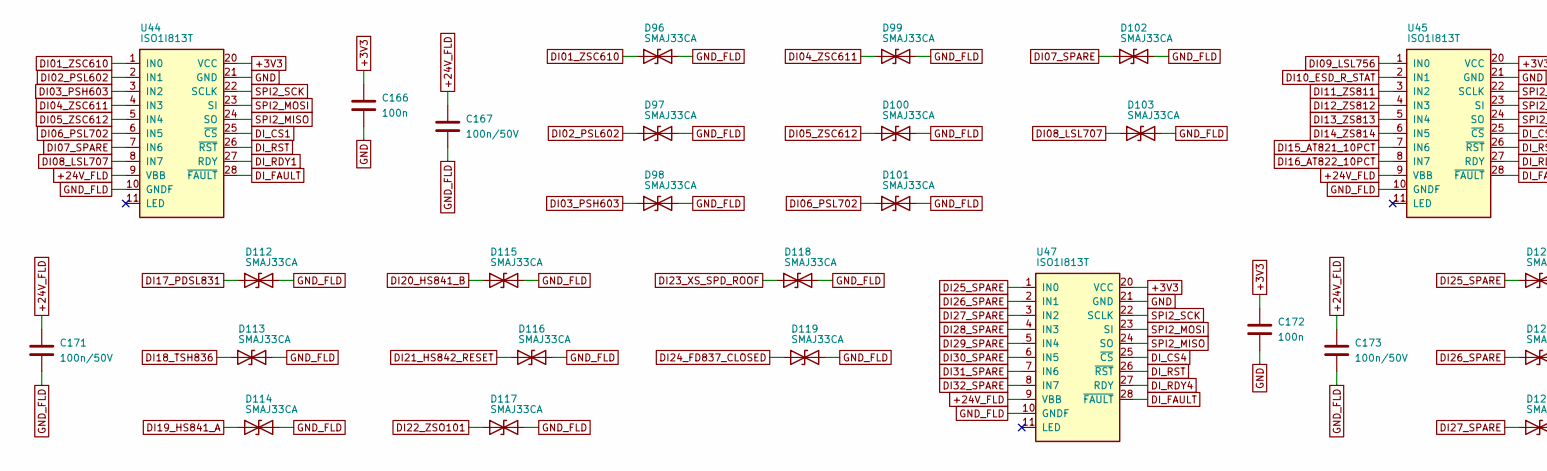
[picture p242: schematic digital_inputs.kicad_sch, part in row 1, column 1]

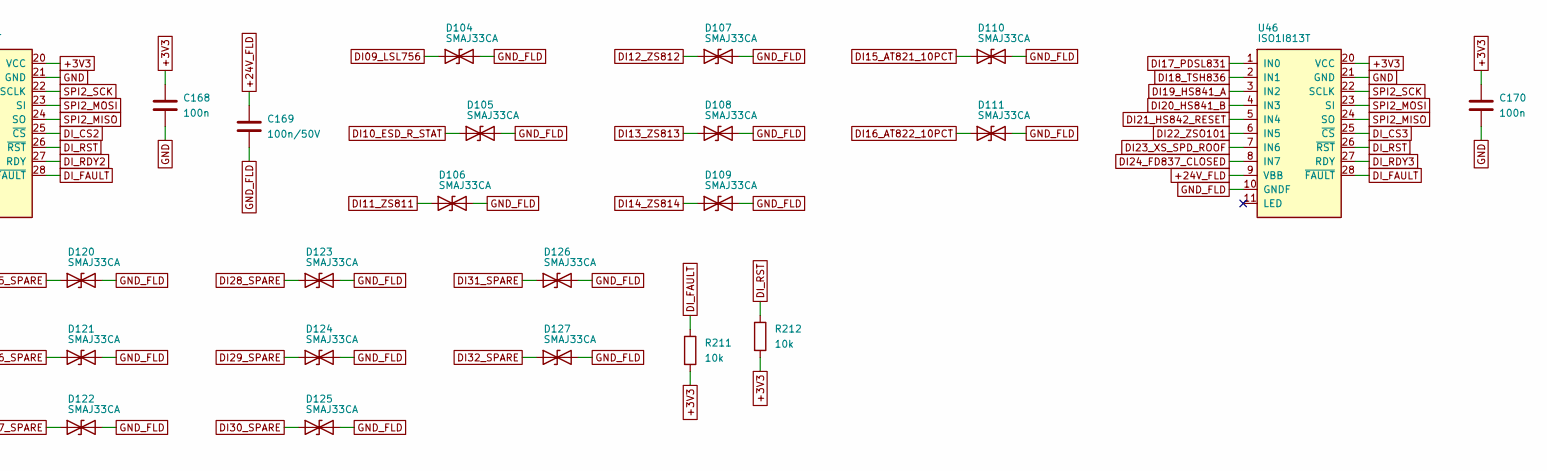
[picture p243: schematic digital_inputs.kicad_sch, part in row 1, column 2]

Parts:
C166, C168, C170, C172: 100n; C_0402_1005Metric
C167, C169, C171, C173: 100n/50V; C_0603_1608Metric
D96, D97, D98, D99, D100, D101, D102, D103, D104, D105, D106, D107, D108, D109, D110, D111, D112, D113, D114, D115, D116, D117, D118, D119, D120, D121, D122, D123, D124, D125, D126, D127: SMAJ33CA; D_SMA; MPN SMAJ33CA-TR; LCSC C115251
R211, R212: 10k; R_0402_1005Metric
U44, U45, U46, U47: ISO1I813T; ST_PowerSSO-36_SlugDown; MPN ISO1I813TXUMA1; LCSC C538445

Connections:
+3V3: C166.1, C168.1, C170.1, C172.1, R211.2, R212.2, U44.20 (VCC), U45.20 (VCC), U46.20 (VCC), U47.20 (VCC)
+24V_FLD: C167.1, C169.1, C171.1, C173.1, U44.9 (VBB), U45.9 (VBB), U46.9 (VBB), U47.9 (VBB)
DI01_ZSC610: D96.1 (A1), U44.1 (IN0)
DI02_PSL602: D97.1 (A1), U44.2 (IN1)
DI03_PSH603: D98.1 (A1), U44.3 (IN2)
DI04_ZSC611: D99.1 (A1), U44.4 (IN3)
DI05_ZSC612: D100.1 (A1), U44.5 (IN4)
DI06_PSL702: D101.1 (A1), U44.6 (IN5)
DI07_SPARE: D102.1 (A1), U44.7 (IN6)
DI08_LSL707: D103.1 (A1), U44.8 (IN7)
DI09_LSL756: D104.1 (A1), U45.1 (IN0)
DI10_ESD_R_STAT: D105.1 (A1), U45.2 (IN1)
DI11_ZS811: D106.1 (A1), U45.3 (IN2)
DI12_ZS812: D107.1 (A1), U45.4 (IN3)
DI13_ZS813: D108.1 (A1), U45.5 (IN4)
DI14_ZS814: D109.1 (A1), U45.6 (IN5)
DI15_AT821_10PCT: D110.1 (A1), U45.7 (IN6)
DI16_AT822_10PCT: D111.1 (A1), U45.8 (IN7)
DI17_PDSL831: D112.1 (A1), U46.1 (IN0)
DI18_TSH836: D113.1 (A1), U46.2 (IN1)
DI19_HS841_A: D114.1 (A1), U46.3 (IN2)
DI20_HS841_B: D115.1 (A1), U46.4 (IN3)
DI21_HS842_RESET: D116.1 (A1), U46.5 (IN4)
DI22_ZSO101: D117.1 (A1), U46.6 (IN5)
DI23_XS_SPD_ROOF: D118.1 (A1), U46.7 (IN6)
DI24_FD837_CLOSED: D119.1 (A1), U46.8 (IN7)
DI25_SPARE: D120.1 (A1), U47.1 (IN0)
DI26_SPARE: D121.1 (A1), U47.2 (IN1)
DI27_SPARE: D122.1 (A1), U47.3 (IN2)
DI28_SPARE: D123.1 (A1), U47.4 (IN3)
DI29_SPARE: D124.1 (A1), U47.5 (IN4)
DI30_SPARE: D125.1 (A1), U47.6 (IN5)
DI31_SPARE: D126.1 (A1), U47.7 (IN6)
DI32_SPARE: D127.1 (A1), U47.8 (IN7)
DI_CS1: U44.25 (~CS)
DI_CS2: U45.25 (~CS)
DI_CS3: U46.25 (~CS)
DI_CS4: U47.25 (~CS)
DI_FAULT: R211.1, U44.28 (~FAULT), U45.28 (~FAULT), U46.28 (~FAULT), U47.28 (~FAULT)
DI_RDY1: U44.27 (RDY)
DI_RDY2: U45.27 (RDY)
DI_RDY3: U46.27 (RDY)
DI_RDY4: U47.27 (RDY)
DI_RST: R212.1, U44.26 (~RST), U45.26 (~RST), U46.26 (~RST), U47.26 (~RST)
GND: C166.2, C168.2, C170.2, C172.2, U44.21 (GND), U45.21 (GND), U46.21 (GND), U47.21 (GND)
GND_FLD: C167.2, C169.2, C171.2, C173.2, D96.2 (A2), D97.2 (A2), D98.2 (A2), D99.2 (A2), D100.2 (A2), D101.2 (A2), D102.2 (A2), D103.2 (A2), D104.2 (A2), D105.2 (A2), D106.2 (A2), D107.2 (A2), D108.2 (A2), D109.2 (A2), D110.2 (A2), D111.2 (A2), D112.2 (A2), D113.2 (A2), D114.2 (A2), D115.2 (A2), D116.2 (A2), D117.2 (A2), D118.2 (A2), D119.2 (A2), D120.2 (A2), D121.2 (A2), D122.2 (A2), D123.2 (A2), D124.2 (A2), D125.2 (A2), D126.2 (A2), D127.2 (A2), U44.10 (GNDF), U45.10 (GNDF), U46.10 (GNDF), U47.10 (GNDF)
SPI2_MISO: U44.24 (SO), U45.24 (SO), U46.24 (SO), U47.24 (SO)
SPI2_MOSI: U44.23 (SI), U45.23 (SI), U46.23 (SI), U47.23 (SI)
SPI2_SCK: U44.22 (SCLK), U45.22 (SCLK), U46.22 (SCLK), U47.22 (SCLK)
