ahmadreza221/aurora-cchp/electronics/b2_sio/out/iepe.kicad_sch

## KiCad design electronics/b2_sio/out/iepe.kicad_sch (2026-10-22)

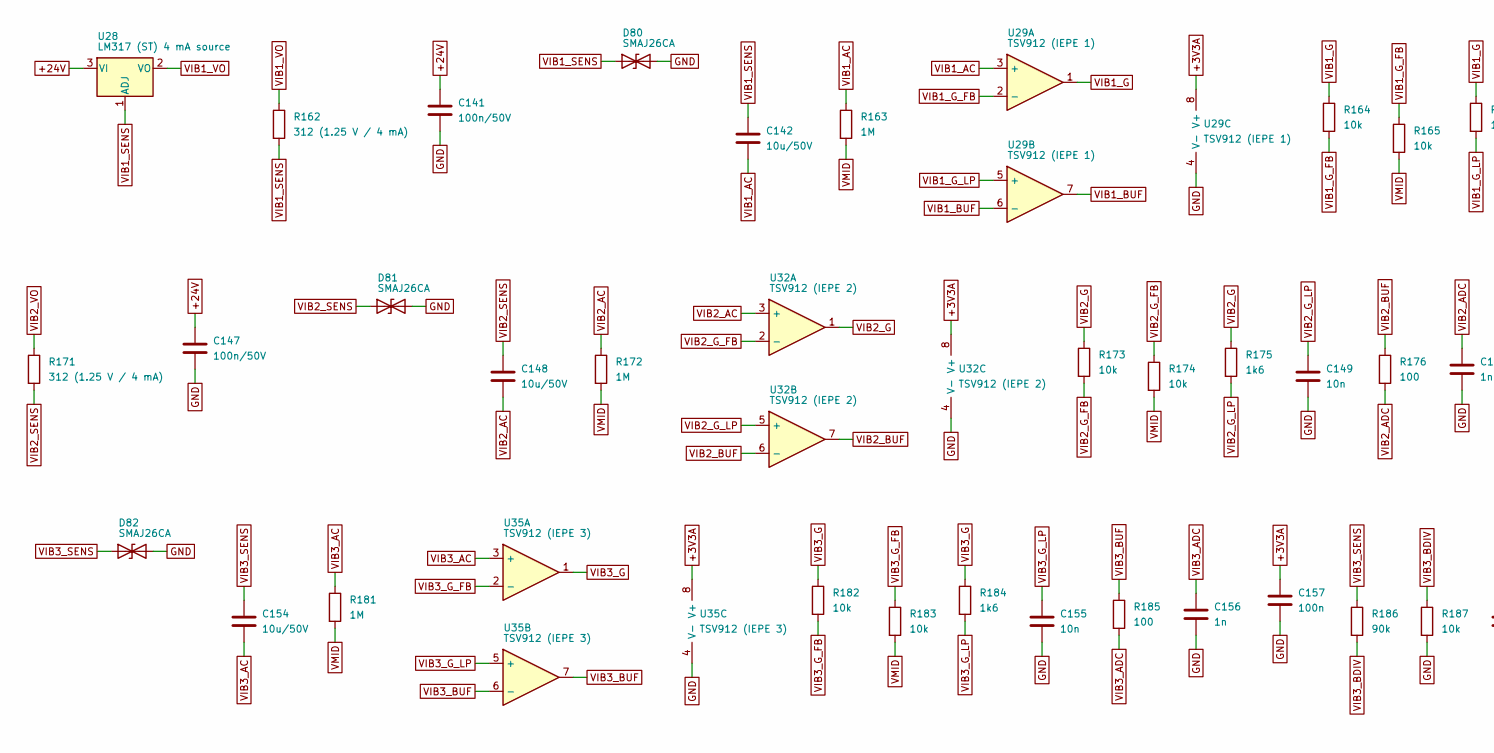
[picture p244: schematic iepe.kicad_sch, part in row 1, column 1]

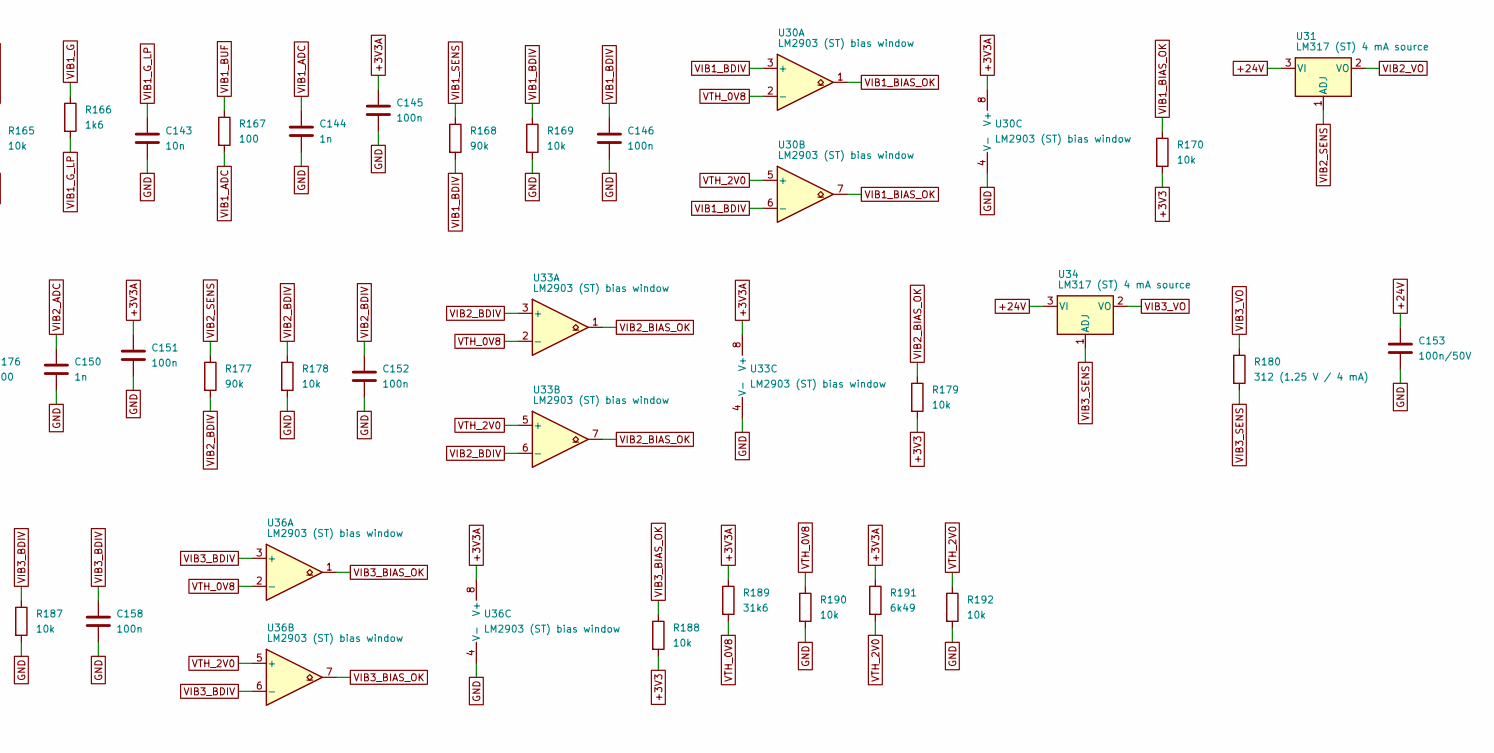
[picture p245: schematic iepe.kicad_sch, part in row 1, column 2]

Parts:
C141, C147, C153: 100n/50V; C_0603_1608Metric
C142, C148, C154: 10u/50V; C_1206_3216Metric
C143, C149, C155: 10n; C_0402_1005Metric
C144, C150, C156: 1n; C_0402_1005Metric
C145, C146, C151, C152, C157, C158: 100n; C_0402_1005Metric
D80, D81, D82: SMAJ26CA; D_SMA; MPN SMAJ26CA-TR
R162, R171, R180: 312 (1.25 V / 4 mA); R_0805_2012Metric
R163, R172, R181: 1M; R_0603_1608Metric
R164, R165, R169, R170, R173, R174, R178, R179, R182, R183, R187, R188, R190, R192: 10k; R_0402_1005Metric
R166, R175, R184: 1k6; R_0402_1005Metric
R167, R176, R185: 100; R_0402_1005Metric
R168, R177, R186: 90k; R_0603_1608Metric
R189: 31k6; R_0603_1608Metric
R191: 6k49; R_0603_1608Metric
U28, U31, U34: LM317 (ST) 4 mA source; SOT-223-3_TabPin2; MPN LM317D2T-TR; LCSC C91673
U29: TSV912 (IEPE 1); SOT-23-8; MPN TSV912IST; LCSC C2057297
U30, U33, U36: LM2903 (ST) bias window; SOIC-8_3.9x4.9mm_P1.27mm; MPN LM2903YDT
U32: TSV912 (IEPE 2); SOT-23-8; MPN TSV912IST; LCSC C2057297
U35: TSV912 (IEPE 3); SOT-23-8; MPN TSV912IST; LCSC C2057297

Connections:
+3V3: R170.2, R179.2, R188.2
+3V3A: C145.1, C151.1, C157.1, R189.1, R191.1, U29.8 (V+), U30.8 (V+), U32.8 (V+), U33.8 (V+), U35.8 (V+), U36.8 (V+)
+24V: C141.1, C147.1, C153.1, U28.3 (VI), U31.3 (VI), U34.3 (VI)
GND: C141.2, C143.2, C144.2, C145.2, C146.2, C147.2, C149.2, C150.2, C151.2, C152.2, C153.2, C155.2, C156.2, C157.2, C158.2, D80.2 (A2), D81.2 (A2), D82.2 (A2), R169.2, R178.2, R187.2, R190.2, R192.2, U29.4 (V-), U30.4 (V-), U32.4 (V-), U33.4 (V-), U35.4 (V-), U36.4 (V-)
VIB1_AC: C142.2, R163.1, U29.3 (+)
VIB1_ADC: C144.1, R167.2
VIB1_BDIV: C146.1, R168.2, R169.1, U30.3 (+), U30.6 (-)
VIB1_BIAS_OK: R170.1, U30.1, U30.7
VIB1_BUF: R167.1, U29.6 (-), U29.7
VIB1_G: R164.1, R166.1, U29.1
VIB1_G_FB: R164.2, R165.1, U29.2 (-)
VIB1_G_LP: C143.1, R166.2, U29.5 (+)
VIB1_SENS: C142.1, D80.1 (A1), R162.2, R168.1, U28.1 (ADJ)
VIB1_VO: R162.1, U28.2 (VO)
VIB2_AC: C148.2, R172.1, U32.3 (+)
VIB2_ADC: C150.1, R176.2
VIB2_BDIV: C152.1, R177.2, R178.1, U33.3 (+), U33.6 (-)
VIB2_BIAS_OK: R179.1, U33.1, U33.7
VIB2_BUF: R176.1, U32.6 (-), U32.7
VIB2_G: R173.1, R175.1, U32.1
VIB2_G_FB: R173.2, R174.1, U32.2 (-)
VIB2_G_LP: C149.1, R175.2, U32.5 (+)
VIB2_SENS: C148.1, D81.1 (A1), R171.2, R177.1, U31.1 (ADJ)
VIB2_VO: R171.1, U31.2 (VO)
VIB3_AC: C154.2, R181.1, U35.3 (+)
VIB3_ADC: C156.1, R185.2
VIB3_BDIV: C158.1, R186.2, R187.1, U36.3 (+), U36.6 (-)
VIB3_BIAS_OK: R188.1, U36.1, U36.7
VIB3_BUF: R185.1, U35.6 (-), U35.7
VIB3_G: R182.1, R184.1, U35.1
VIB3_G_FB: R182.2, R183.1, U35.2 (-)
VIB3_G_LP: C155.1, R184.2, U35.5 (+)
VIB3_SENS: C154.1, D82.1 (A1), R180.2, R186.1, U34.1 (ADJ)
VIB3_VO: R180.1, U34.2 (VO)
VMID: R163.2, R165.2, R172.2, R174.2, R181.2, R183.2
VTH_0V8: R189.2, R190.1, U30.2 (-), U33.2 (-), U36.2 (-)
VTH_2V0: R191.2, R192.1, U30.5 (+), U33.5 (+), U36.5 (+)
