ahmadreza221/aurora-cchp/electronics/b2_sio/out/mcu.kicad_sch

## KiCad design electronics/b2_sio/out/mcu.kicad_sch (2026-10-22)

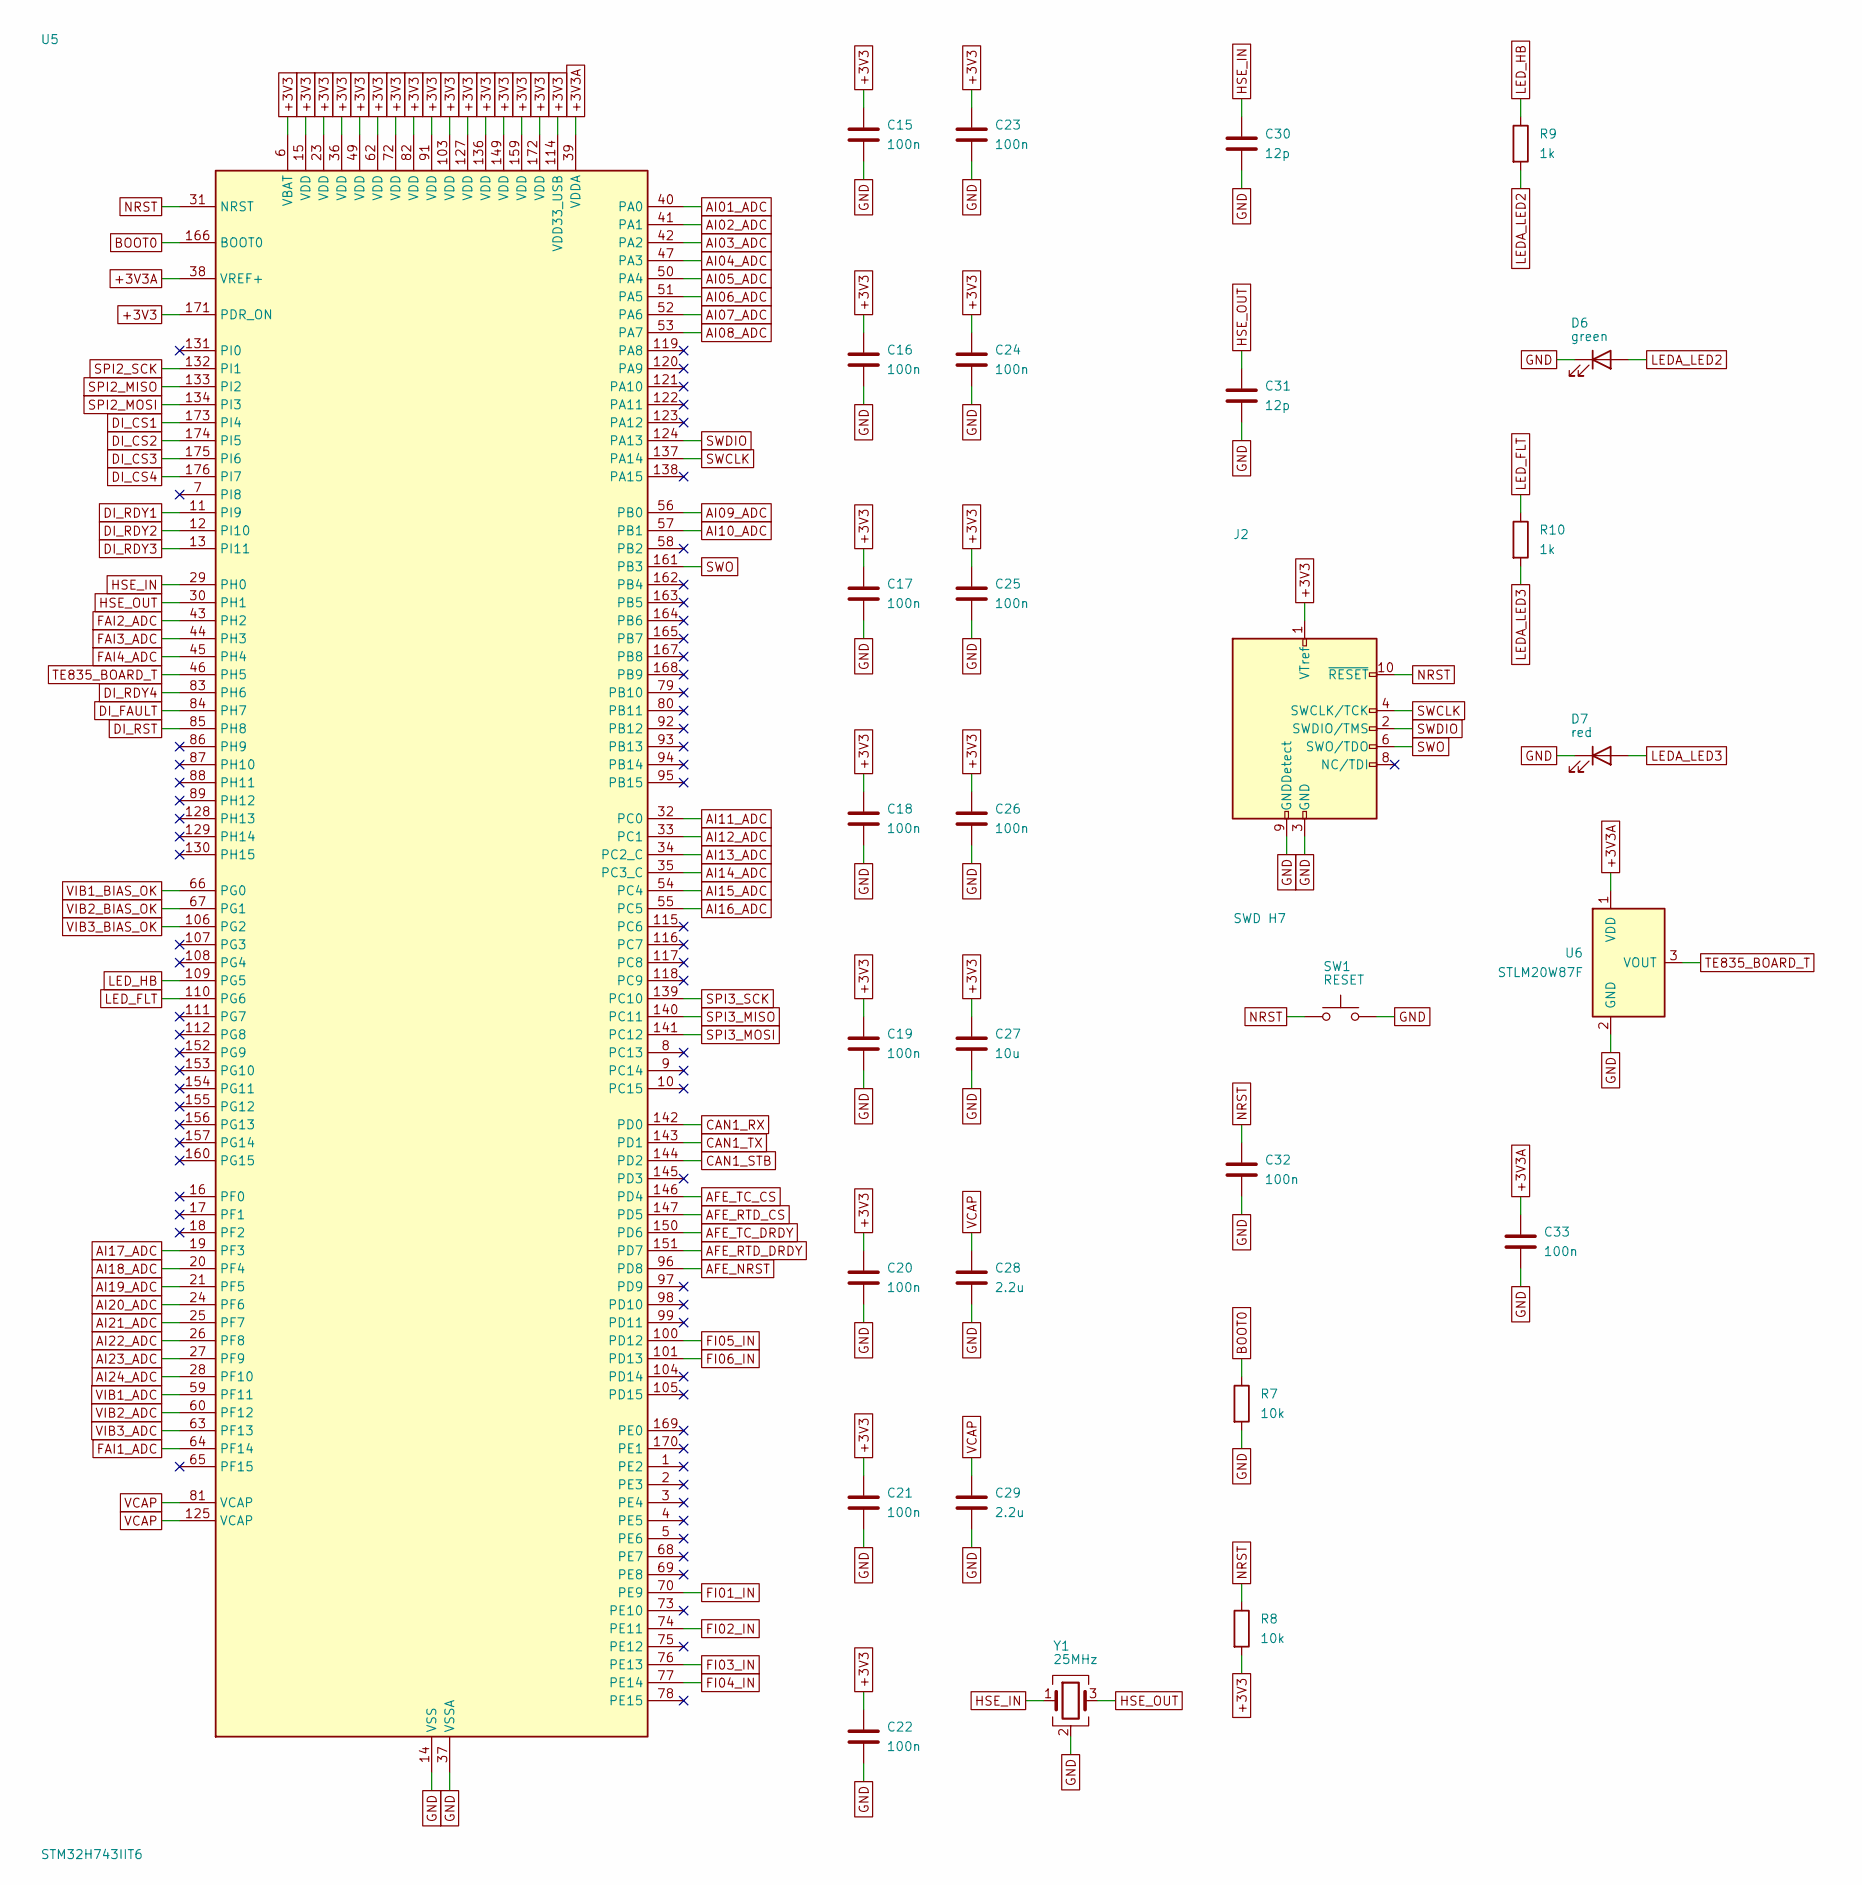
[picture p246: schematic mcu.kicad_sch]

Parts:
C15, C16, C17, C18, C19, C20, C21, C22, C23, C24, C25, C26, C32, C33: 100n; C_0402_1005Metric
C27: 10u; C_0805_2012Metric
C28, C29: 2.2u; C_0603_1608Metric
C30, C31: 12p; C_0402_1005Metric
D6: green; LED_0603_1608Metric
D7: red; LED_0603_1608Metric
J2: SWD H7; PinHeader_2x05_P1.27mm_Vertical_SMD; MPN 20021111-00010T4LF
R7, R8: 10k; R_0402_1005Metric
R9, R10: 1k; R_0402_1005Metric
SW1: RESET; SW_SPST_TL3342; MPN PTS645SM43SMTR92
U5: STM32H743IIT6; LQFP-176_24x24mm_P0.5mm; MPN STM32H743IIT6; LCSC C89597
U6: STLM20W87F; SOT-23; MPN STLM20W87F
Y1: 25MHz; Crystal_SMD_3225-4Pin_3.2x2.5mm; MPN CM9V-T1A-25.000MHz

Connections:
+3V3: C15.1, C16.1, C17.1, C18.1, C19.1, C20.1, C21.1, C22.1, C23.1, C24.1, C25.1, C26.1, C27.1, J2.1 (VTref), R8.2, U5.6 (VBAT), U5.15 (VDD), U5.23 (VDD), U5.36 (VDD), U5.49 (VDD), U5.62 (VDD), U5.72 (VDD), U5.82 (VDD), U5.91 (VDD), U5.103 (VDD), U5.114 (VDD33_USB), U5.127 (VDD), U5.136 (VDD), U5.149 (VDD), U5.159 (VDD), U5.171 (PDR_ON), U5.172 (VDD)
+3V3A: C33.1, U5.38 (VREF+), U5.39 (VDDA), U6.1 (VDD)
AFE_NRST: U5.96 (PD8)
AFE_RTD_CS: U5.147 (PD5)
AFE_RTD_DRDY: U5.151 (PD7)
AFE_TC_CS: U5.146 (PD4)
AFE_TC_DRDY: U5.150 (PD6)
AI01_ADC: U5.40 (PA0)
AI02_ADC: U5.41 (PA1)
AI03_ADC: U5.42 (PA2)
AI04_ADC: U5.47 (PA3)
AI05_ADC: U5.50 (PA4)
AI06_ADC: U5.51 (PA5)
AI07_ADC: U5.52 (PA6)
AI08_ADC: U5.53 (PA7)
AI09_ADC: U5.56 (PB0)
AI10_ADC: U5.57 (PB1)
AI11_ADC: U5.32 (PC0)
AI12_ADC: U5.33 (PC1)
AI13_ADC: U5.34 (PC2_C)
AI14_ADC: U5.35 (PC3_C)
AI15_ADC: U5.54 (PC4)
AI16_ADC: U5.55 (PC5)
AI17_ADC: U5.19 (PF3)
AI18_ADC: U5.20 (PF4)
AI19_ADC: U5.21 (PF5)
AI20_ADC: U5.24 (PF6)
AI21_ADC: U5.25 (PF7)
AI22_ADC: U5.26 (PF8)
AI23_ADC: U5.27 (PF9)
AI24_ADC: U5.28 (PF10)
BOOT0: R7.1, U5.166 (BOOT0)
CAN1_RX: U5.142 (PD0)
CAN1_STB: U5.144 (PD2)
CAN1_TX: U5.143 (PD1)
DI_CS1: U5.173 (PI4)
DI_CS2: U5.174 (PI5)
DI_CS3: U5.175 (PI6)
DI_CS4: U5.176 (PI7)
DI_FAULT: U5.84 (PH7)
DI_RDY1: U5.11 (PI9)
DI_RDY2: U5.12 (PI10)
DI_RDY3: U5.13 (PI11)
DI_RDY4: U5.83 (PH6)
DI_RST: U5.85 (PH8)
FAI1_ADC: U5.64 (PF14)
FAI2_ADC: U5.43 (PH2)
FAI3_ADC: U5.44 (PH3)
FAI4_ADC: U5.45 (PH4)
FI01_IN: U5.70 (PE9)
FI02_IN: U5.74 (PE11)
FI03_IN: U5.76 (PE13)
FI04_IN: U5.77 (PE14)
FI05_IN: U5.100 (PD12)
FI06_IN: U5.101 (PD13)
GND: C15.2, C16.2, C17.2, C18.2, C19.2, C20.2, C21.2, C22.2, C23.2, C24.2, C25.2, C26.2, C27.2, C28.2, C29.2, C30.2, C31.2, C32.2, C33.2, D6.1 (K), D7.1 (K), J2.3 (GND), J2.5 (GND), J2.9 (GNDDetect), R7.2, SW1.2, U5.14 (VSS), U5.22 (VSS), U5.37 (VSSA), U5.48 (VSS), U5.61 (VSS), U5.71 (VSS), U5.90 (VSS), U5.102 (VSS), U5.113 (VSS), U5.126 (VSS), U5.135 (VSS), U5.148 (VSS), U5.158 (VSS), U6.2 (GND), Y1.2 (G), Y1.4 (G)
HSE_IN: C30.1, U5.29 (PH0), Y1.1
HSE_OUT: C31.1, U5.30 (PH1), Y1.3
LEDA_LED2: D6.2 (A), R9.2
LEDA_LED3: D7.2 (A), R10.2
LED_FLT: R10.1, U5.110 (PG6)
LED_HB: R9.1, U5.109 (PG5)
NRST: C32.1, J2.10 (~RESET), R8.1, SW1.1, U5.31 (NRST)
SPI2_MISO: U5.133 (PI2)
SPI2_MOSI: U5.134 (PI3)
SPI2_SCK: U5.132 (PI1)
SPI3_MISO: U5.140 (PC11)
SPI3_MOSI: U5.141 (PC12)
SPI3_SCK: U5.139 (PC10)
SWCLK: J2.4 (SWCLK/TCK), U5.137 (PA14)
SWDIO: J2.2 (SWDIO/TMS), U5.124 (PA13)
SWO: J2.6 (SWO/TDO), U5.161 (PB3)
TE835_BOARD_T: U5.46 (PH5), U6.3 (VOUT)
VCAP: C28.1, C29.1, U5.81 (VCAP), U5.125 (VCAP)
VIB1_ADC: U5.59 (PF11)
VIB1_BIAS_OK: U5.66 (PG0)
VIB2_ADC: U5.60 (PF12)
VIB2_BIAS_OK: U5.67 (PG1)
VIB3_ADC: U5.63 (PF13)
VIB3_BIAS_OK: U5.106 (PG2)
