ahmadreza221/aurora-cchp/electronics/b2_sio/out/power.kicad_sch

## KiCad design electronics/b2_sio/out/power.kicad_sch (2026-10-22)

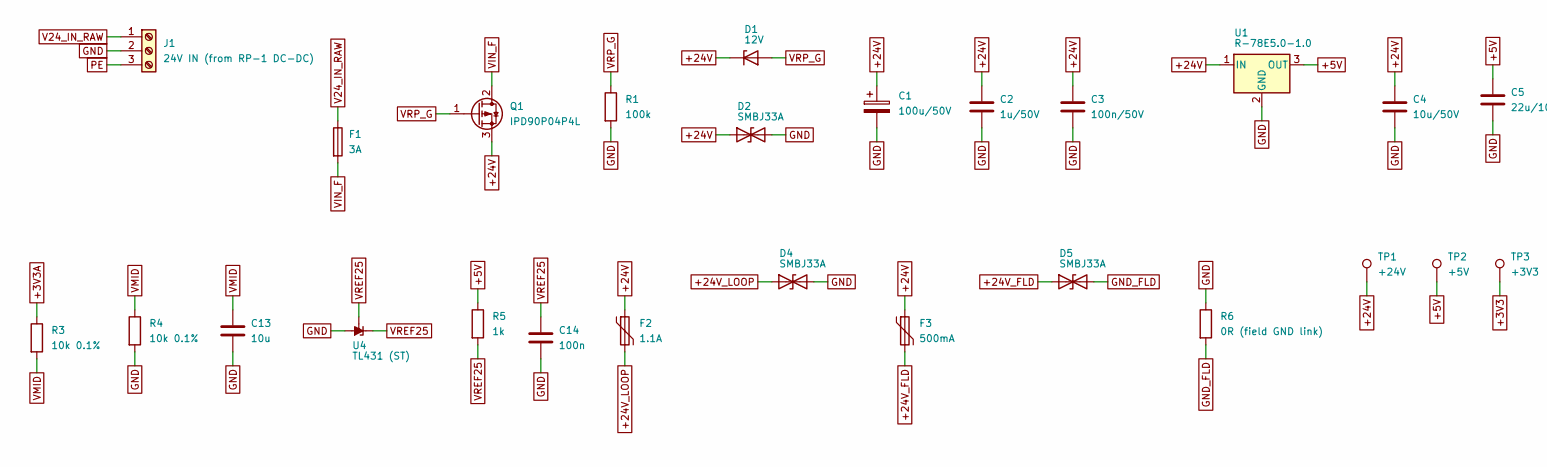
[picture p247: schematic power.kicad_sch, part in row 1, column 1]

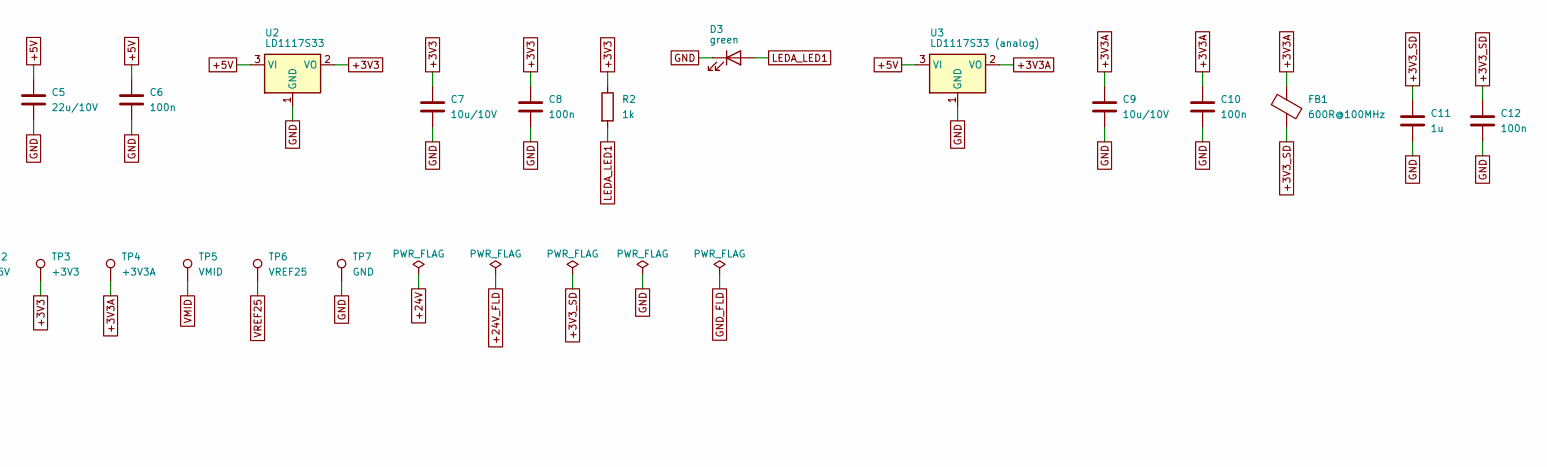
[picture p248: schematic power.kicad_sch, part in row 1, column 2]

Parts:
C1: 100u/50V; CP_Radial_D8.0mm_P3.50mm; MPN 860020675017
C2: 1u/50V; C_0805_2012Metric
C3: 100n/50V; C_0603_1608Metric
C4: 10u/50V; C_1206_3216Metric
C5: 22u/10V; C_0805_2012Metric
C6, C8, C10, C12, C14: 100n; C_0402_1005Metric
C7, C9: 10u/10V; C_0805_2012Metric
C11: 1u; C_0402_1005Metric
C13: 10u; C_0805_2012Metric
D1: 12V; D_SOD-123; MPN BZT52H-C12
D2, D4, D5: SMBJ33A; D_SMB; MPN SMBJ33A-TR; LCSC C133662
D3: green; LED_0603_1608Metric
F1: 3A; Fuse_1206_3216Metric; MPN 3413.0225.26 class
F2: 1.1A; Fuse_1812_4532Metric; MPN PFRA.110
F3: 500mA; Fuse_1206_3216Metric; MPN PFRA.050
FB1: 600R@100MHz; L_0603_1608Metric; MPN 742792040
J1: 24V IN (from RP-1 DC-DC); MPN MSTBA 2,5/3-G-5,08
Q1: IPD90P04P4L; TO-252-2; MPN IPD90P04P4L-04
R1: 100k; R_0402_1005Metric
R2, R5: 1k; R_0402_1005Metric
R3, R4: 10k 0.1%; R_0603_1608Metric
R6: 0R (field GND link); R_1206_3216Metric
TP1: +24V; TestPoint_Pad_D1.5mm
TP2: +5V; TestPoint_Pad_D1.5mm
TP3: +3V3; TestPoint_Pad_D1.5mm
TP4: +3V3A; TestPoint_Pad_D1.5mm
TP5: VMID; TestPoint_Pad_D1.5mm
TP6: VREF25; TestPoint_Pad_D1.5mm
TP7: GND; TestPoint_Pad_D1.5mm
U1: R-78E5.0-1.0; Converter_DCDC_RECOM_R-78E-0.5_THT; MPN R-78E5.0-1.0
U2: LD1117S33; SOT-223-3_TabPin2; MPN LD1117S33TR; LCSC C86781
U3: LD1117S33 (analog); SOT-223-3_TabPin2; MPN LD1117S33TR; LCSC C86781
U4: TL431 (ST); SOT-23; MPN TL431AIL3T

Connections:
+3V3: C7.1, C8.1, R2.1, TP3.1, U2.2 (VO)
+3V3A: C9.1, C10.1, FB1.1, R3.1, TP4.1, U3.2 (VO)
+3V3_SD: C11.1, C12.1, FB1.2
+5V: C5.1, C6.1, R5.1, TP2.1, U1.3 (OUT), U2.3 (VI), U3.3 (VI)
+24V: C1.1, C2.1, C3.1, C4.1, D1.1 (K), D2.1 (A1), F2.1, F3.1, Q1.3 (S), TP1.1, U1.1 (IN)
+24V_FLD: D5.1 (A1), F3.2
+24V_LOOP: D4.1 (A1), F2.2
GND: C1.2, C2.2, C3.2, C4.2, C5.2, C6.2, C7.2, C8.2, C9.2, C10.2, C11.2, C12.2, C13.2, C14.2, D2.2 (A2), D3.1 (K), D4.2 (A2), J1.2, R1.2, R4.2, R6.1, TP7.1, U1.2 (GND), U2.1 (GND), U3.1 (GND), U4.3 (A)
GND_FLD: D5.2 (A2), R6.2
LEDA_LED1: D3.2 (A), R2.2
PE: J1.3
V24_IN_RAW: F1.1, J1.1
VIN_F: F1.2, Q1.2 (D)
VMID: C13.1, R3.2, R4.1, TP5.1
VREF25: C14.1, R5.2, TP6.1, U4.1 (K), U4.2 (REF)
VRP_G: D1.2 (A), Q1.1 (G), R1.1
