ahmadreza221/aurora-cchp/electronics/b2_sio/out/pulse_inputs.kicad_sch

## KiCad design electronics/b2_sio/out/pulse_inputs.kicad_sch (2026-10-22)

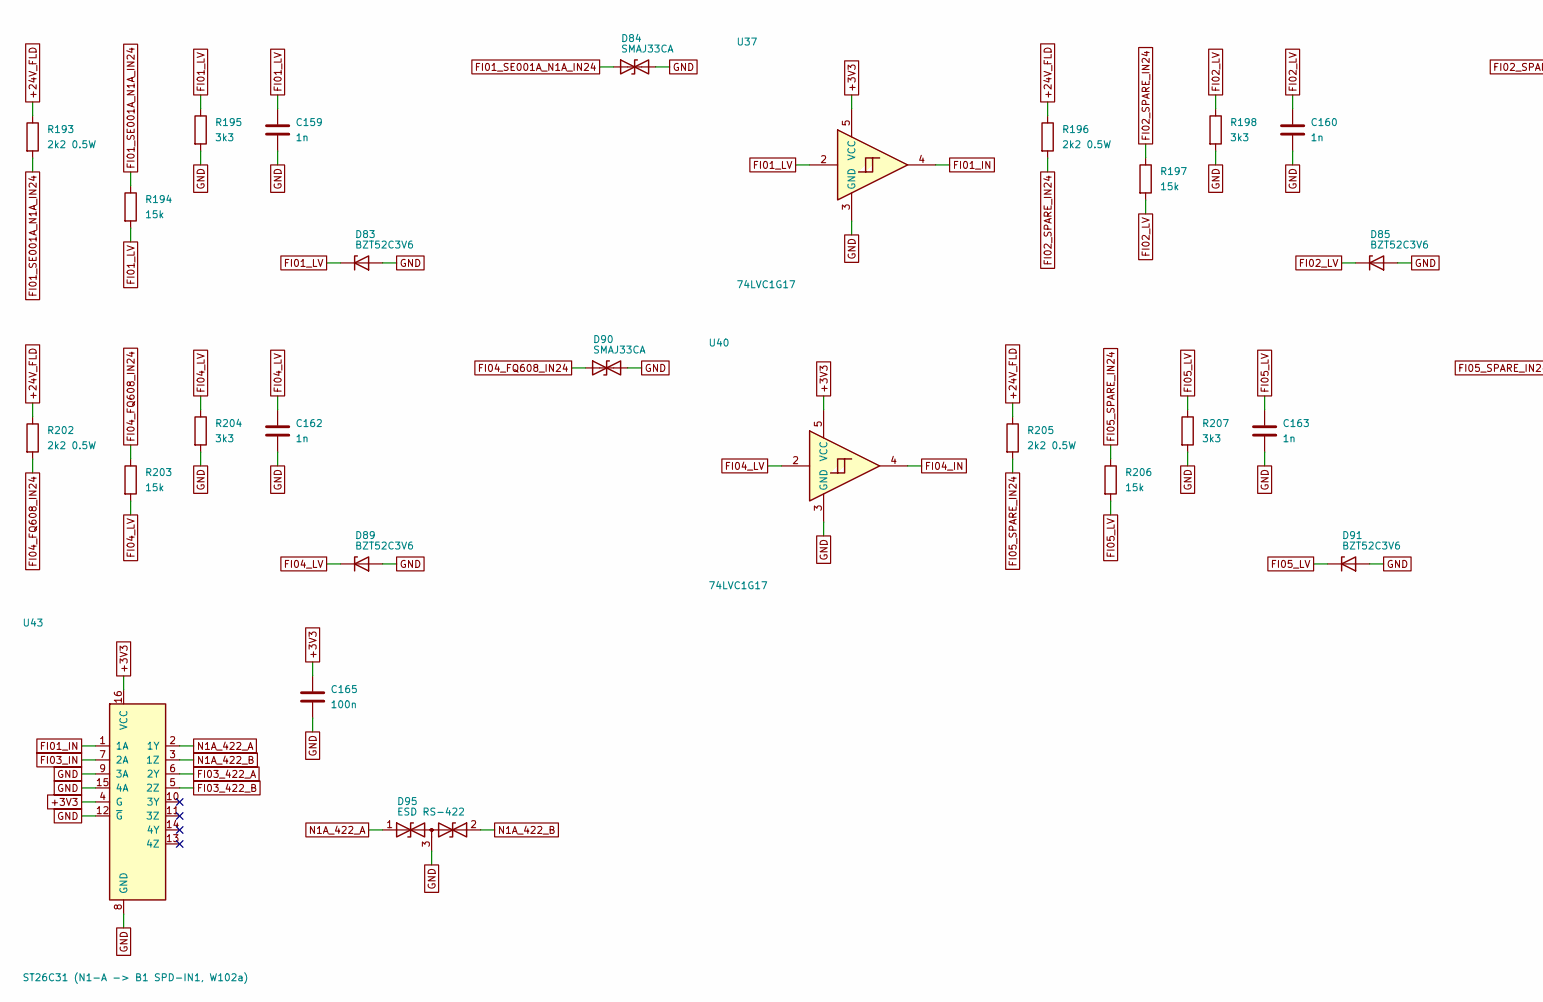
[picture p249: schematic pulse_inputs.kicad_sch, part in row 1, column 1]

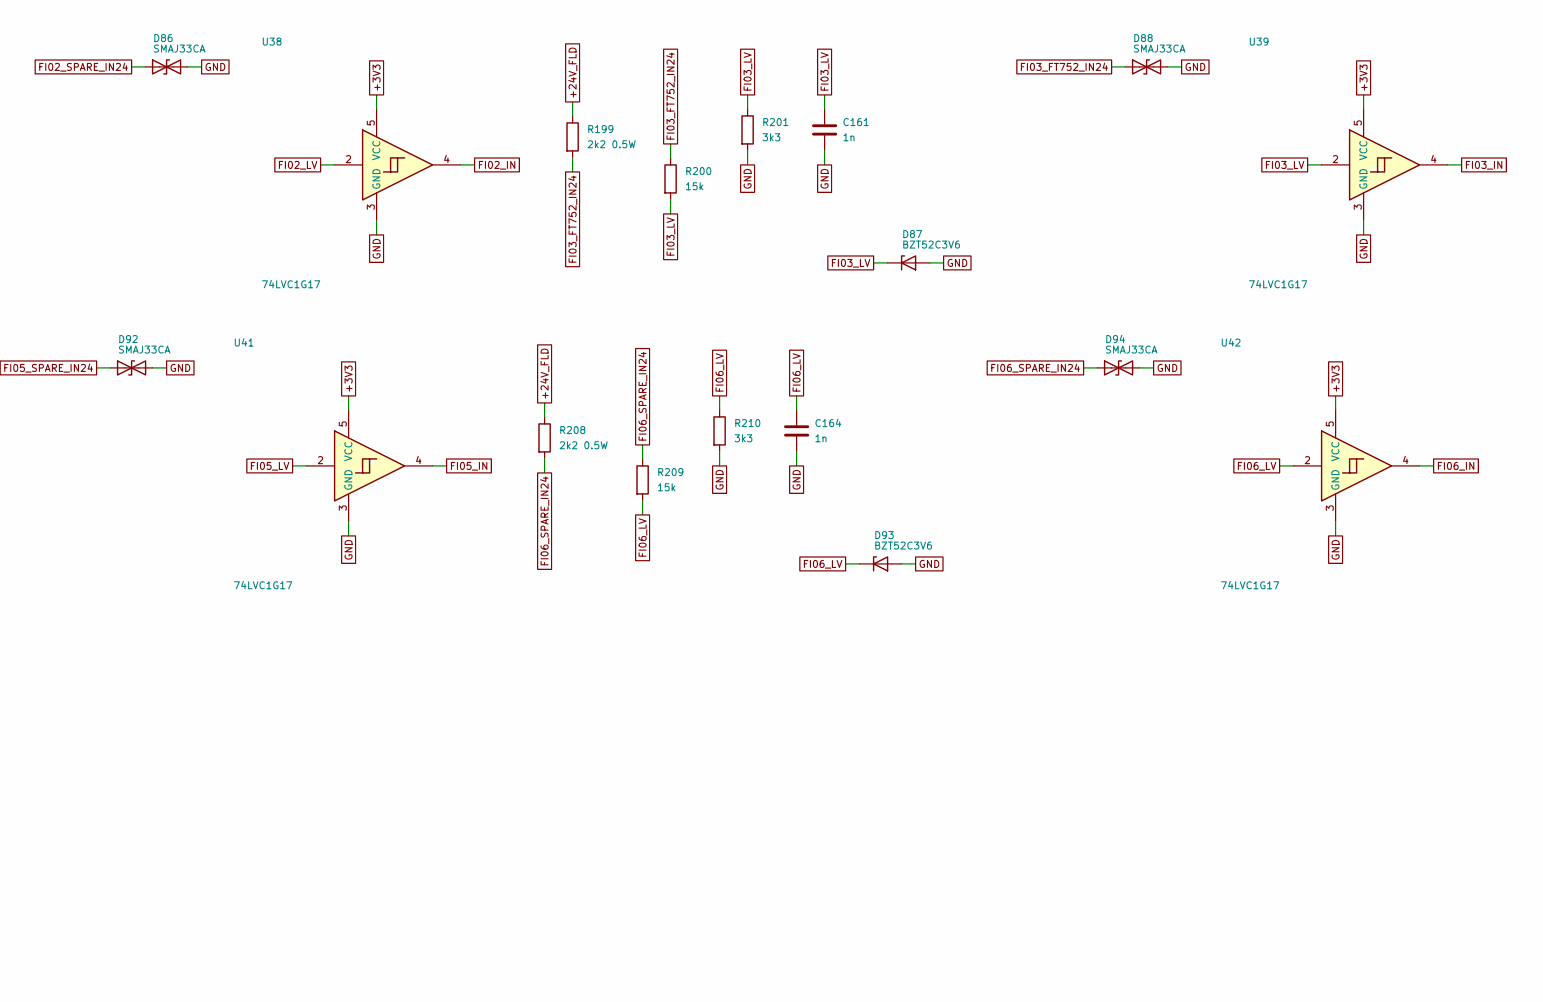
[picture p250: schematic pulse_inputs.kicad_sch, part in row 1, column 2]

Parts:
C159, C160, C161, C162, C163, C164: 1n; C_0402_1005Metric
C165: 100n; C_0402_1005Metric
D83, D85, D87, D89, D91, D93: BZT52C3V6; D_SOD-123; MPN BZT52H-C3V6
D84, D86, D88, D90, D92, D94: SMAJ33CA; D_SMA; MPN SMAJ33CA-TR; LCSC C115251
D95: ESD RS-422; SOT-23; MPN PESD5V0X2UM
R193, R196, R199, R202, R205, R208: 2k2 0.5W; R_1206_3216Metric
R194, R197, R200, R203, R206, R209: 15k; R_0402_1005Metric
R195, R198, R201, R204, R207, R210: 3k3; R_0402_1005Metric
U37, U38, U39, U40, U41, U42: 74LVC1G17; SOT-353_SC-70-5; MPN 74LVC1G17GW
U43: ST26C31 (N1-A -> B1 SPD-IN1, W102a); SOIC-16_3.9x9.9mm_P1.27mm; MPN ST26C31BDR; LCSC C94192

Connections:
+3V3: C165.1, U37.5 (VCC), U38.5 (VCC), U39.5 (VCC), U40.5 (VCC), U41.5 (VCC), U42.5 (VCC), U43.4 (G), U43.16 (VCC)
+24V_FLD: R193.1, R196.1, R199.1, R202.1, R205.1, R208.1
FI01_IN: U37.4, U43.1 (1A)
FI01_LV: C159.1, D83.1 (K), R194.2, R195.1, U37.2
FI01_SE001A_N1A_IN24: D84.1 (A1), R193.2, R194.1
FI02_IN: U38.4
FI02_LV: C160.1, D85.1 (K), R197.2, R198.1, U38.2
FI02_SPARE_IN24: D86.1 (A1), R196.2, R197.1
FI03_422_A: U43.6 (2Y)
FI03_422_B: U43.5 (2Z)
FI03_FT752_IN24: D88.1 (A1), R199.2, R200.1
FI03_IN: U39.4, U43.7 (2A)
FI03_LV: C161.1, D87.1 (K), R200.2, R201.1, U39.2
FI04_FQ608_IN24: D90.1 (A1), R202.2, R203.1
FI04_IN: U40.4
FI04_LV: C162.1, D89.1 (K), R203.2, R204.1, U40.2
FI05_IN: U41.4
FI05_LV: C163.1, D91.1 (K), R206.2, R207.1, U41.2
FI05_SPARE_IN24: D92.1 (A1), R205.2, R206.1
FI06_IN: U42.4
FI06_LV: C164.1, D93.1 (K), R209.2, R210.1, U42.2
FI06_SPARE_IN24: D94.1 (A1), R208.2, R209.1
GND: C159.2, C160.2, C161.2, C162.2, C163.2, C164.2, C165.2, D83.2 (A), D84.2 (A2), D85.2 (A), D86.2 (A2), D87.2 (A), D88.2 (A2), D89.2 (A), D90.2 (A2), D91.2 (A), D92.2 (A2), D93.2 (A), D94.2 (A2), D95.3 (common), R195.2, R198.2, R201.2, R204.2, R207.2, R210.2, U37.3 (GND), U38.3 (GND), U39.3 (GND), U40.3 (GND), U41.3 (GND), U42.3 (GND), U43.8 (GND), U43.9 (3A), U43.12 (~G), U43.15 (4A)
N1A_422_A: D95.1 (A1), U43.2 (1Y)
N1A_422_B: D95.2 (A2), U43.3 (1Z)
