ahmadreza221/aurora-cchp/electronics/tools/example/out/can.kicad_sch

## KiCad design electronics/tools/example/out/can.kicad_sch (2026-10-22)

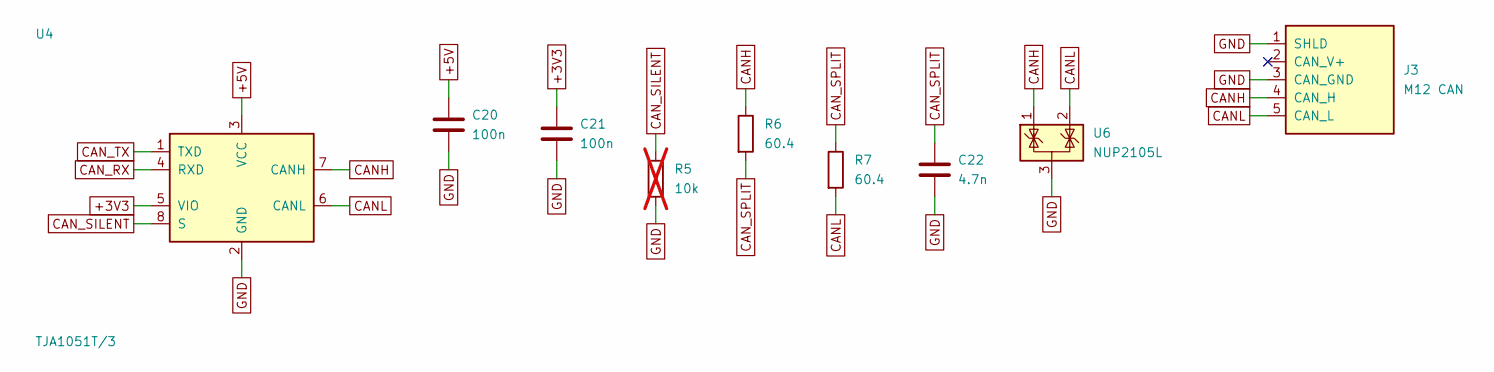
[picture p251: schematic can.kicad_sch]

Parts:
C20, C21: 100n; C_0402_1005Metric
C22: 4.7n; C_0603_1608Metric
J3: M12 CAN; MPN SACC-DSI-M12MS-5CON-L90
R5: 10k; R_0402_1005Metric; not fitted
R6, R7: 60.4; R_0603_1608Metric
U4: TJA1051T/3; SOIC-8_3.9x4.9mm_P1.27mm; MPN TJA1051T/3,118; LCSC C38695
U6: NUP2105L; SOT-23; MPN NUP2105LT1G

Connections:
+3V3: C21.1, U4.5 (VIO)
+5V: C20.1, U4.3 (VCC)
CANH: J3.4 (CAN_H), R6.1, U4.7 (CANH), U6.1 (K)
CANL: J3.5 (CAN_L), R7.2, U4.6 (CANL), U6.2 (K)
CAN_RX: U4.4 (RXD)
CAN_SILENT: R5.1, U4.8 (S)
CAN_SPLIT: C22.1, R6.2, R7.1
CAN_TX: U4.1 (TXD)
GND: C20.2, C21.2, C22.2, J3.1 (SHLD), J3.3 (CAN_GND), R5.2, U4.2 (GND), U6.3 (A)
