ahmadreza221/aurora-cchp/electronics/tools/example/out/mcu.kicad_sch

## KiCad design electronics/tools/example/out/mcu.kicad_sch (2026-10-22)

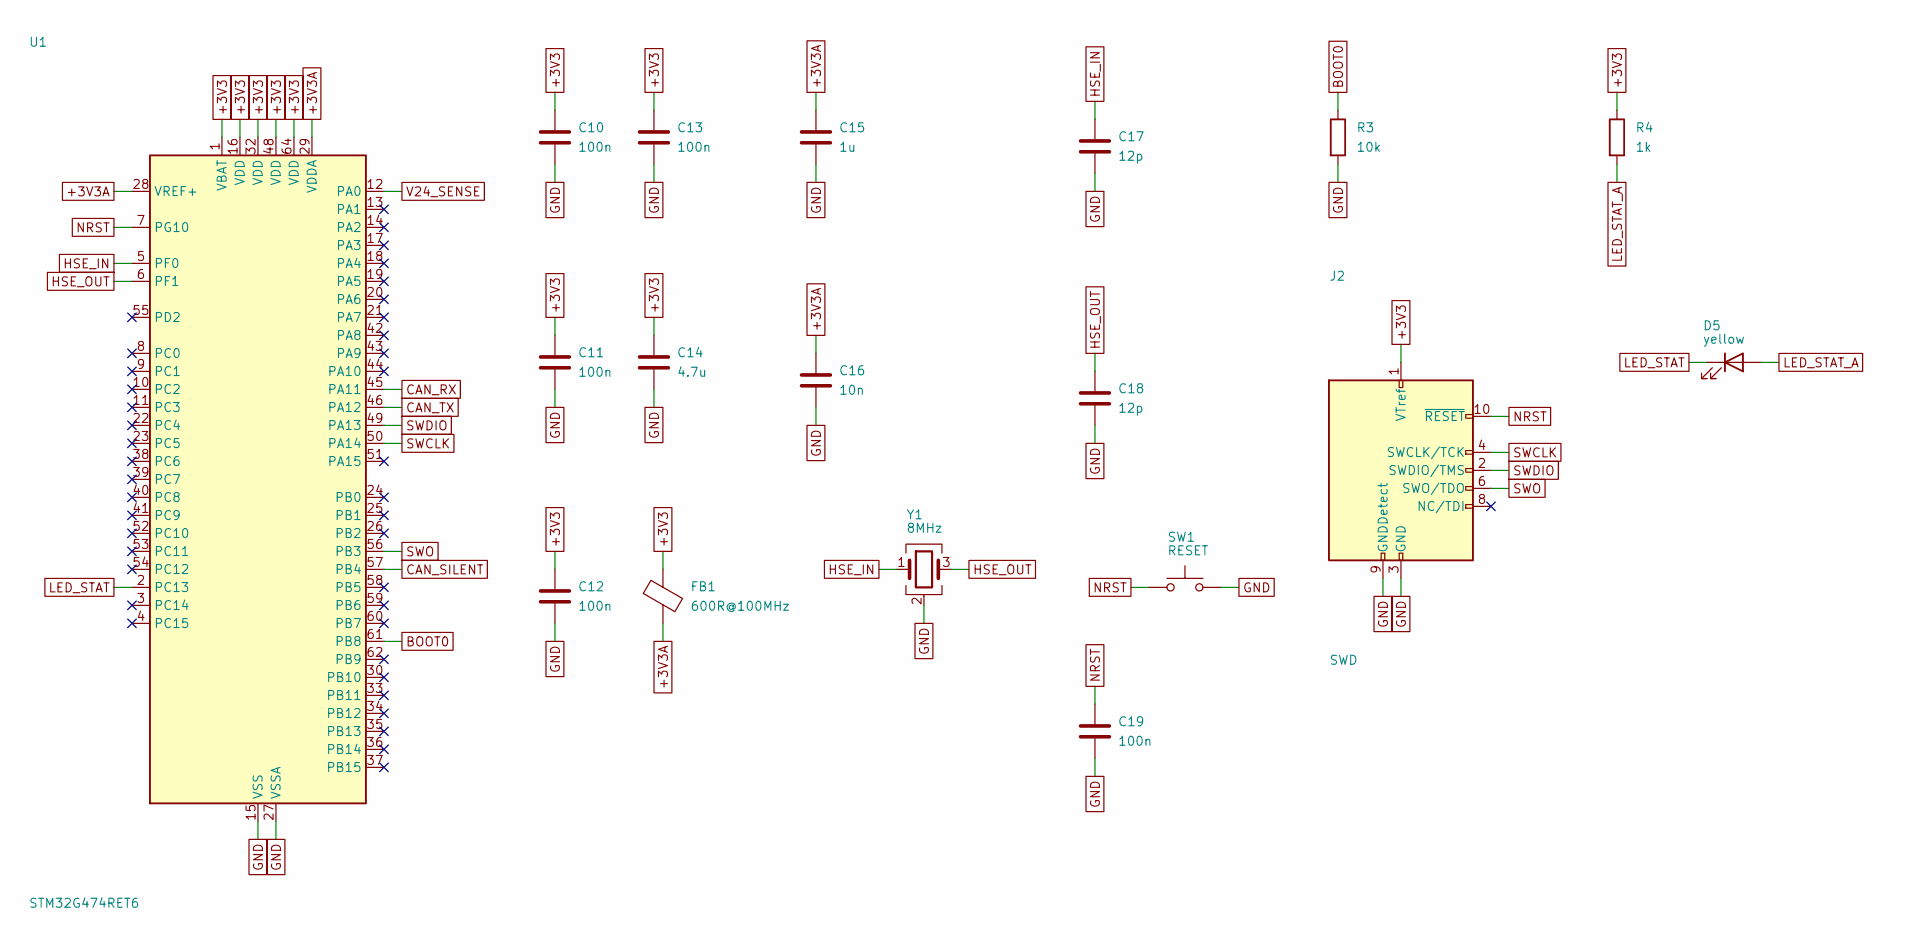
[picture p252: schematic mcu.kicad_sch]

Parts:
C10, C11, C12, C13, C19: 100n; C_0402_1005Metric
C14: 4.7u; C_0603_1608Metric
C15: 1u; C_0402_1005Metric
C16: 10n; C_0402_1005Metric
C17, C18: 12p; C_0402_1005Metric
D5: yellow; LED_0603_1608Metric
FB1: 600R@100MHz; L_0603_1608Metric; MPN BLM18AG601SN1D
J2: SWD; PinHeader_2x05_P1.27mm_Vertical_SMD; MPN FTSH-105-01-F-DV-K
R3: 10k; R_0402_1005Metric
R4: 1k; R_0402_1005Metric
SW1: RESET; SW_SPST_TL3342; MPN TL3342F160QG
U1: STM32G474RET6; LQFP-64_10x10mm_P0.5mm; MPN STM32G474RET6; LCSC C521608
Y1: 8MHz; Crystal_SMD_3225-4Pin_3.2x2.5mm; MPN NX3225GA-8.000M-STD-CRG-2

Connections:
+3V3: C10.1, C11.1, C12.1, C13.1, C14.1, FB1.1, J2.1 (VTref), R4.1, U1.1 (VBAT), U1.16 (VDD), U1.32 (VDD), U1.48 (VDD), U1.64 (VDD)
+3V3A: C15.1, C16.1, FB1.2, U1.28 (VREF+), U1.29 (VDDA)
BOOT0: R3.1, U1.61 (PB8)
CAN_RX: U1.45 (PA11)
CAN_SILENT: U1.57 (PB4)
CAN_TX: U1.46 (PA12)
GND: C10.2, C11.2, C12.2, C13.2, C14.2, C15.2, C16.2, C17.2, C18.2, C19.2, J2.3 (GND), J2.5 (GND), J2.9 (GNDDetect), R3.2, SW1.2, U1.15 (VSS), U1.27 (VSSA), U1.31 (VSS), U1.47 (VSS), U1.63 (VSS), Y1.2 (G), Y1.4 (G)
HSE_IN: C17.1, U1.5 (PF0), Y1.1
HSE_OUT: C18.1, U1.6 (PF1), Y1.3
LED_STAT: D5.1 (K), U1.2 (PC13)
LED_STAT_A: D5.2 (A), R4.2
NRST: C19.1, J2.10 (~RESET), SW1.1, U1.7 (PG10)
SWCLK: J2.4 (SWCLK/TCK), U1.50 (PA14)
SWDIO: J2.2 (SWDIO/TMS), U1.49 (PA13)
SWO: J2.6 (SWO/TDO), U1.56 (PB3)
V24_SENSE: U1.12 (PA0)
