ahmadreza221/aurora-cchp/electronics/tools/example/out/power.kicad_sch

## KiCad design electronics/tools/example/out/power.kicad_sch (2026-10-22)

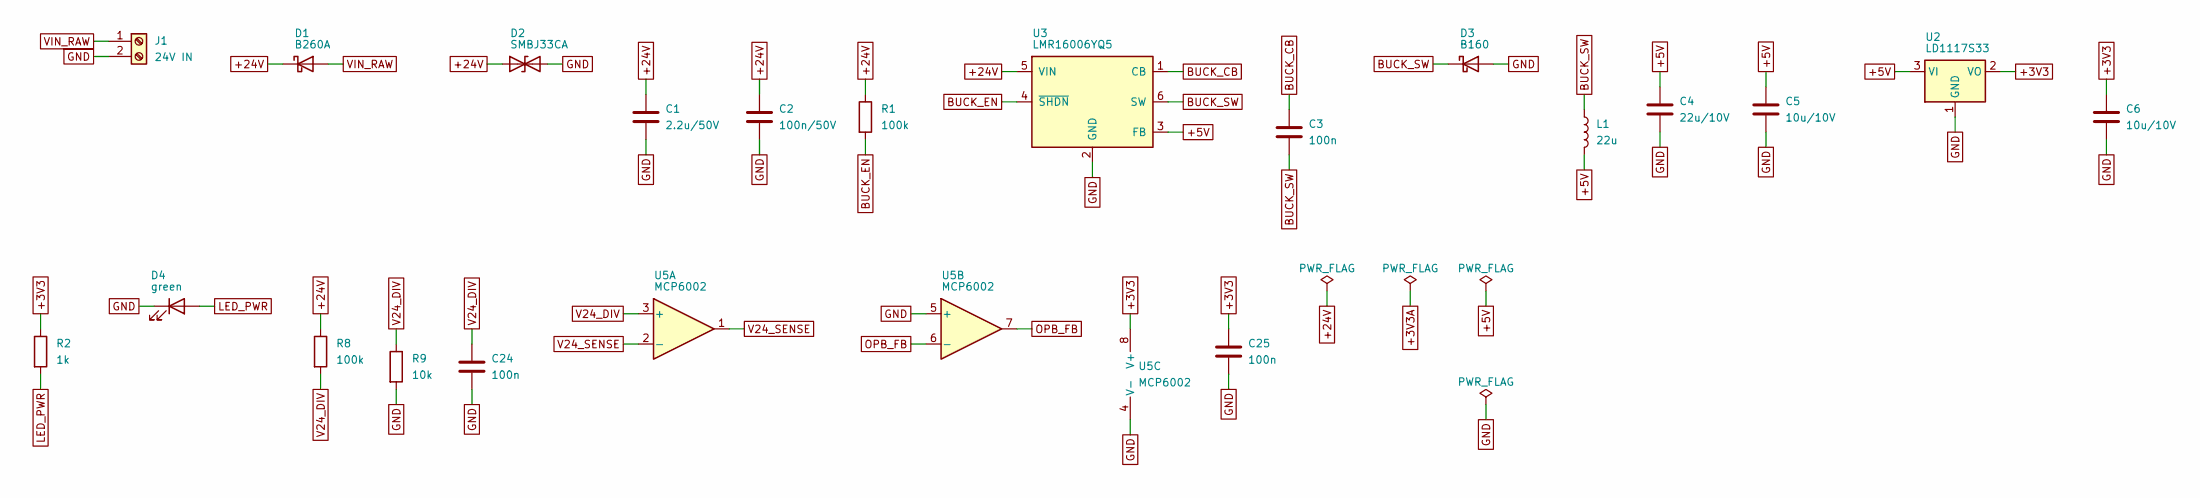
[picture p253: schematic power.kicad_sch]

Parts:
C1: 2.2u/50V; C_1206_3216Metric; MPN GRM31CR71H225KA88L
C2: 100n/50V; C_0603_1608Metric; MPN GCM188R71H104KA57D
C3, C24, C25: 100n; C_0402_1005Metric
C4: 22u/10V; C_0805_2012Metric
C5, C6: 10u/10V; C_0805_2012Metric
D1: B260A; D_SMA; MPN B260A-13-F; LCSC C79932
D2: SMBJ33CA; D_SMB; MPN SMBJ33CA
D3: B160; D_SMA; MPN B160-13-F
D4: green; LED_0603_1608Metric
J1: 24V IN; TerminalBlock_Phoenix_MKDS-1,5-2-5.08_1x02_P5.08mm_Horizont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; MPN 1715721
L1: 22u; L_Taiyo-Yuden_NR-40xx; MPN NR4018T220M
R1: 100k; R_0402_1005Metric
R2: 1k; R_0402_1005Metric
R8: 100k; R_0603_1608Metric
R9: 10k; R_0402_1005Metric
U2: LD1117S33; SOT-223-3_TabPin2; MPN LD1117S33TR; LCSC C86781
U3: LMR16006YQ5; SOT-23-6; MPN LMR16006YQ5DDCRQ1
U5: MCP6002; SOIC-8_3.9x4.9mm_P1.27mm; MPN MCP6002T-I/SN

Connections:
+3V3: C6.1, C25.1, R2.1, U2.2 (VO), U5.8 (V+)
+5V: C4.1, C5.1, L1.2, U2.3 (VI), U3.3 (FB)
+24V: C1.1, C2.1, D1.1 (K), D2.1 (A1), R1.1, R8.1, U3.5 (VIN)
BUCK_CB: C3.1, U3.1 (CB)
BUCK_EN: R1.2, U3.4 (~SHDN)
BUCK_SW: C3.2, D3.1 (K), L1.1, U3.6 (SW)
GND: C1.2, C2.2, C4.2, C5.2, C6.2, C24.2, C25.2, D2.2 (A2), D3.2 (A), D4.1 (K), J1.2, R9.2, U2.1 (GND), U3.2 (GND), U5.4 (V-), U5.5 (+)
LED_PWR: D4.2 (A), R2.2
OPB_FB: U5.6 (-), U5.7
V24_DIV: C24.1, R8.2, R9.1, U5.3 (+)
V24_SENSE: U5.1, U5.2 (-)
VIN_RAW: D1.2 (A), J1.1
