ahmadreza221/aurora-cchp/(commit log)

2026-10-21 Baseline: GR180 v12 build scripts, review docs, cycle/rotor/concept simulations
2026-10-21 Write CAD outputs to $GR180_OUT or the working folder instead of ~/Desktop/GR180-3D
2026-10-21 Add life/temperature trade-off study and integrated system spec draft
2026-10-21 Rooftop site study, hall cooling load, drawing-vs-CAD comparison report
2026-10-21 v13A: restore Rutten drawing stack (compressor b2 6.48, diffuser recess/channels, spigot, shaft Ø15.5, turbine pilot 14), CW rotation, FAST build mode
    [02_io_list.csv, io_list.csv]
2026-10-21 v13A: fix 8 auxiliary interferences (gas feed, igniter/RPM/EGT threads); full pairwise check clean
    [02_io_list.csv, io_list.csv]
2026-10-21 Add HVAC/plant design (docs/hvac, sim/hvac) and electrical/control architecture + KiCad ECU skeleton (docs/electrical, electronics) from side sessions
    [can_fd.kicad_sch, comms.kicad_sch, connectors.kicad_sch, digital_io.kicad_sch, gr180_ecu.kicad_pcb, gr180_ecu.kicad_sch, mcu_main.kicad_sch, power.kicad_sch]
2026-10-21 Phase 2: gas-generator turbine meanline design (NGV 21 / rotor 29, flared exit hub, eta_tt ~0.81 vs 0.77 legacy)
2026-10-21 Master design: frames, design point, package interfaces, work split, BOM schema
2026-10-21 Scale-up study: 210 kW class, ORC bottoming, heat to households
2026-10-22 WIP: HVAC power modes, fire suppression, insulated-hall recheck; electrical EMS, boards, 3D room model; engine E1–E4 in progress
    [02_io_list.csv, can.kicad_sch, can_fd.kicad_sch, connectors.kicad_sch, electrical_bom.csv, engine_E3_bom.csv, engine_E4_bom.csv, gr180_ecu.kicad_sch]
2026-10-22 WIP: engine E1/E2/E3 progress, board schematics B1/B2
    [afe_rtd.kicad_sch, afe_tc.kicad_sch, ai_4_20ma.kicad_sch, b1_ecu.kicad_pcb, b1_ecu.kicad_sch, b1_ecu_bom.csv, b2_sio.kicad_pcb, b2_sio.kicad_sch]
2026-10-22 Roof plant 3D model: resolve all 82 interference/clearance findings
    Clash check (FreeCAD 1.1.3): 54 solid clashes + 1 service zone + 25 walkway
    + 2 tower-ring -> 0.
    - Hall/ER CHW corridor: hall lane y 5.94 (clear of HW headers); supplies drop
    at x 5.68 (hall) / 6.80 (ER, east of the HW headers); returns stay at z 0.55
    and leave the lane east of the supply risers. HALL-R now tees into CHW-R
    (was left open), ER-R tees into HALL-R.
    - FCU-2/4 branches declared as tees at the HALL-S/H-S1 junction.
    - PS-3: CHW nozzles to TK-1 at z 0.30 (cross WK-2 under the stile, no riser in
    the walkway); HW return nozzle at header level.
    - WK-1 narrowed to 0.62 m (x 1.72-2.34) between the DC-1 pad-water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
    [plant_bom.csv]
2026-10-22 Strict check for clashes hidden by the connected-item exemption; XV-307 on B4
    - plant_lib.connected_overlap_check: overlaps between connected items are
    accepted only within 0.30 m of a nozzle or route end (dunnage, mounts and
    supports excepted); report section [1b]. It found FU-1 inside the HW-R
    header insulation and MU-1 passing through the RS-1 hood south wall:
    FU-1 moved 0.20 m south on PS-1, MU-1 now leaves RS-1 through the open west
    side above the corridor lines. All checks 0.
    - XV-307 (DC-1 adiabatic pad water valve) added to the electrical I/O list:
    B4 DO12, 24 VDC NC (was only in the HVAC list, as 24 VAC). B4 DO budget
    12 / 16.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
    [02_io_list.csv, io_list.csv, plant_bom.csv]
2026-10-22 E1 NGV geometry: fillet sections stacked per radius, planar buried caps, CCW ring profiles (WIP)
    - fc_vane: fillet sections used the end section's theta shift at every fillet
    radius, rotating them ~1 deg (~0.4 mm at the TE) off the vane at the hub;
    now TE-stacked per radius as in design_ngv.
    - fc_vane: fillet foot sunk 0.05 mm into the rings; end caps on true planes
    (normal at the section mid angle) instead of r = const (non-planar, invalid
    faces); loft order flipped instead of reverse() when the volume is negative.
    - ngv_body: profiles revolved counter-clockwise.
    Vane solid is now valid; the vane/ring fuse volume still does not match the
    expected value (work in progress).
    Co-Author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
2026-10-22 E1 NGV: resample fillet offsets (B-spline loops); NGV ring builds as a valid solid
    The two fillet sections nearest the walls (offset 1.0 / 0.47 mm) had small
    loops in their interpolating B-splines (offset spreads the TE-cap points and
    bunches the concave side). Resampled at equal arc length (resample_closed).
    With the earlier stacking/cap/orientation fixes the 21-vane NGV ring is now a
    valid single solid: machined 13 952 mm3 (mesh volume; = ring body + 21 vanes
    - 6 holes within 0.5 %), cast 16 399 mm3. Note: OCC Shape.Volume is off by
    up to ~20 % on these B-spline solids; check volumes on the tessellation.
    Claude-Session: https://claud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
2026-10-22 E1: rotor blade loft follows the design (12 spans, platform trim); disc thermal study, bore-less option
    Rotor blade
    - 12 design spans (dense at the hub) instead of 5, all used in the loft above
    the root fillet: the CAD surface strayed up to ~1 mm from the design
    between the 5 spans (visible bumps); now <= 0.04 mm for s >= 0.15
    (0.14-0.27 mm near the hub, mostly the fillet). Throats / blade pull
    unchanged.
    - blade trimmed axially to the platform (0.02 mm inside its edges): the root
    fillet overhung the platform (TE 0.35-0.65 mm into the rear cavity, LE
    sliver leaving 0.04 mm to the NGV ring instead of 0.30).
    - full wheel fused one blade at a time (single 29-shape fuse > 14 GB).
    Di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
2026-10-22 E1 rotor: 7 design spans (12 broke the 29-blade fuse)
    The 12-span loft fits the design closely but its surface breaks the OCC
    blade/disc fuse (invalid after 1-3 blades, machined and cast). 7 spans
    (0, 1/8, 1/4, 3/8, 1/2, 3/4, 1; loft from s 0.125) fuse cleanly and keep the
    surface within 0.1 mm of the design for s >= 0.19 (0.37 mm just above the
    root fillet; was 0.8-1.06 mm with 5 spans). Throats / blade pull unchanged.
    Claude-Session: https://claude.ai/code/session_01JT32Cta4cURUp5mERsZYLG
2026-10-22 E1 disc: rear-face protection study and creep FEA option
    - e1_disc_thermal_study.py --rear: heat shield / cooling bleed / both on the
    bore-less w6/R4 disc barely help (local creep 1e4 -> 2e4 h at best) and the
    bleed raises the thermal stress to yield (695 MPa): the web is heated by
    conduction from the 730 C rim, not by the rear cavity.
    - --creep: Norton law per temperature fitted to the IN713LC Larson-Miller
    curve (Monkman-Grant 0.05), 10 000 / 50 000 h creep step at 115k
    (axisym_run(creep=...)), reports creep strain, relaxed stress, rim growth.
    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
2026-10-22 graphify: rebuild the code graph for the current project (no LLM)
    `graphify update .`: 1468 nodes / 2694 edges / 85 communities (was 206 / 434 /
    13 from the v12 baseline), 92 files incl. plant, engine E1-E4, HVAC, electrical
    and board scripts. Document nodes are the previous semantic extraction (run
    /graphify --update on the Mac to re-extract docs; costs LLM tokens). New
    communities keep placeholder names until `graphify label`.
    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
2026-10-22 E1 disc creep: reference-stress method (CalculiX creep run was not valid)
    With *PLASTIC the ccx Norton model is an overstress model (creep only above
    yield) and gave zero creep below yield; Norton alone diverges. --creep now uses
    the reference-stress method (mean hoop stress, IN713LC Larson-Miller): the
    bore-less w6/R4 disc has >= 1e6 h rupture life even with 1.5 x stress at the
    hottest web temperature of the pessimistic BCs, so the local 615 MPa fillet
    peak (elastic, relaxes) is a fatigue item, not a creep-rupture limit.
    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
2026-10-22 E1: rotor blade modal analysis with centrifugal stiffening + Campbell diagram (CalculiX + gmsh)
    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
2026-10-22 E1 blade modal results: F2 x EO8 (8 injectors) at 113.8k, F5 vs EO24 (24 secondary holes) 1.7 % at 115k
    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
2026-10-22 E2: 7 injectors (8 resonated with the E1 rotor blade 2F at 113.8k)
    Blade modal analysis (sim/engine/e1_blade_modal.py): EO8 from the 8 injectors
    crossed the gas-generator rotor blade 2F at 113.8k (1 % margin at 115k) and the
    24 secondary holes sat 1.7 % from F5. Injector counts 6-14 checked: only 7
    leaves no F1-F6 crossing with EO n / 2n in 100-125k (min margin 13.2 % at
    115k). FPT (E3): EO7 falls between its 1F and 2F in its 48-65k band.
    e2_combustor_calc.py: n_inj 7, dome effusion 8 / secondary 3 / dilution 6 per
    injector (56 / 21 / 42 holes). Swirler slot 2.33 mm, gas holes 4 x 0.75 mm;
    flashback 6.8 / 11.1, autoignition margin 33 (both better than with 8).
    e2_design.json / e2_results.j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
2026-10-22 E1: bore-less disc parameters and welded rotor shaft
    DISC_BORELESS (solid hub, web 6 mm, R4 fillets; e1_disc_thermal_study.py) and
    fc_shaft_welded(): the GR180 shaft profile cut at the wheel front face
    (x 104.3), friction / inertia welded to the bore-less wheel; rear nut and
    thread removed, the compressor-end nut clamps the stack.
    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
2026-10-22 docs: E1 gas-generator turbine design record (decisions, results, fixes, open items)
    Bore-less welded disc, 7 injectors, 7 blade spans; disc stress / creep /
    blade modal / rotordynamic results; the six geometry defects fixed today;
    remaining pre-manufacture items.
    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
2026-10-22 E1: blisk cyclic-symmetry modal analysis (ND 0-14, ZZENF); sector-tool orientation fix
    sim/engine/e1_blisk_cyclic.py: 1/29 sector of the bore-less blisk (disc cut by
    radial planes about the blade-root footprint + blade piece), periodic gmsh mesh,
    CalculiX *CYCLIC SYMMETRY MODEL, held at the shaft weld face, centrifugal
    pre-stress, interference check of EO 1-4, 7, 21, 42 against their nodal
    diameters.
    gg_turbine.fc_sector_tool: loft in the other order instead of reverse().
    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
2026-10-22 E1: cyclic blisk results; smooth blade surfaces (dense even section sampling, tangent TE cap, twisted root-fillet sections); batch wheel fuse
    - e1_blisk_cyclic results: EO4 x ND4 at 101.8k (no 4-fold source), EO7 +9.3 %, EO21 +15.4 %,
    EO42 x ND13 crossings at 107.0k / 118.3k (needs forced response / tip timing)
    - B-splines through the raw cosine-clustered outline rang (curvature spikes ~90 /mm at LE/TE);
    outlines now sampled with 1500 points and resampled to 200 evenly spaced points
    - round TE cap tangent to both sides (was a semicircle with a ~7 deg kink)
    - root-fillet sections follow the blade twist (were hub-section copies -> knee above the fillet)
    - front platform trim 0.05 mm inside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
2026-10-22 Track the compact Fusion STEP parts
    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
    [E1_blade_cast.step, E1_blade_final.step, E1_disc_boreless_cast.step, E1_disc_boreless_final.step, E1_ngv_rings_cast.step, E1_ngv_rings_final.step, E1_ngv_vane_cast.step, E1_ngv_vane_final.step]
2026-10-22 Fusion: colour script for the E1 turbine stage
    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
2026-10-22 E1: Fusion verification of the turbine stage (mass, clearances), local toolchain, import-script fix
    - docs/engine/E1_gg_turbine.md section 5: masses from the Fusion B-rep (blisk 116.9 g, NGV 112.2 g,
    shaft 134.8 g at 8.00 / 7.85 g/cc), measured clearances (tip 0.200, inner ring 0.300, vane TE to
    blade LE 2.66-2.75 mid-span, fillet-to-fillet 3D minimum 1.20 mm), record correction (tip gap is
    2.55 mm, not 2.90), no stationary/rotating overlap.
    - fusion/GR180_E1_Import: STEP translator child-occurrence handling, verify json (fix made on the Mac).
    - micromamba env gr180 (FreeCAD 1.1.3, CalculiX 2.23, gmsh 4.15.2) documented; fusion/_*.json ignored.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
2026-10-22 E1: manufacturing specification (drawing notes, datums and tolerances, friction weld, balance, CAM plan)
    docs/engine/E1_manufacturing.md: cast + machined blisk, NGV ring and 42CrMo4 shaft drawing notes with datums
    (A/B journals, C hub face; D web bore, E front land), tolerances and casting stock; inertia friction-weld
    procedure (IN713LC to 42CrMo4, 0.5 mm relief, PWHT 580 C, UT/FPI/torque proof); balance grades G2.5/G1/G0.4
    at 115k rpm for the ~380 g rotor with correction planes; CAM operation plan for Fusion Manufacture.
2026-10-22 E1: cast-blank Fusion document verified, acceptance-test plan, planar-cut FEA sector tool
    - Fusion "GR180 E1 Turbine (cast blanks)" saved (Default Project): blisk 121.2 g, NGV 127.7 g, stock checked
    (0.5 hub front face, 0.3 tip, 0.3 NGV front / rib); recorded in E1_gg_turbine.md section 5.
    - E1_manufacturing.md: transmitted torque 5.4 N.m (proof 11 N.m); section 9 acceptance tests (ping test with
    room-temperature reference frequencies and mistuning limits, 138k spin test, tip timing at the predicted crossings).
    - cad/engine/e1_sector_tool.py: bore-less 1/29 sector with planar periodic cut planes centred on the blade fillet
    footprint (clearance 0.8 deg) for the 3-D sector stress / cycli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
2026-10-22 E1: 3-D sector stress (blade root, web, tip growth, LCF), hot tip clearance, OpenFOAM NGV case generator
    - sim/engine/e1_sector_stress.py: 1/29 cyclic sector (CalculiX), 115k/120k hot, 138k/115k cold; mesh converged
    (946 -> 959 MPa at 2.2x nodes). Web 642 MPa (margin 1.08, LCF 8200 cycles with 2x strain); new critical spot: blade
    root fillet at the trailing edge on the hub-flare end, elastic peak 959 MPa > YS_min 685 at 730 C, local only
    (p95 563), LCF ~1350 start-stop cycles (2x strain). Hot tip clearance 0.04 / 0.13 / 0.20 mm for shroud ring 500 /
    650 / 750 C; cold bore r 35.35 kept. Recorded in docs/engine/E1_gg_turbine.md section 6.
    - Support: weld face axial + one tangential nod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
2026-10-22 E1: blade-root TE fillet sensitivity (no effect), exact periodic sector, OpenFOAM v2606 case fixes
    - gg_turbine.py: sensitivity hooks E1_FILLET_ROT / E1_TTE_ROOT_ADD (defaults = design, geometry unchanged).
    - e1_sector_tool.py: sector = (disc + blades -1/0/+1) x wedge (exactly periodic when a fillet crosses a cut plane);
    e1_sector_stress.py: face pairing by rotated centres, mesh volume check, thread cap, tangential support node.
    - Result: R1.0 fillet + 0.2 mm thicker TE root leave the 115k hot TE-root peak unchanged (952 MPa both): it is TE
    bending + thermal (115k cold 727 MPa), not fillet Kt. Design kept; start limit <= 1000 cold starts between major
    inspections with FPI of the TE roo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
2026-10-22 E1: rotor blade forced response at the EO42 crossing (modal superposition), CFD case robustness options
    - sim/engine/e1_forced_response.py: prestressed blade modes at 109.6k (CalculiX), unit tangential pressure on one side,
    resonant stress per kPa at zeta 0.001. F8 x EO42: 3.7 MPa/kPa, 17.5 kPa needed for 65 MPa -> NGV 2nd wake harmonic
    (sub-kPa to 2-3 kPa) gives margin >= 6. F1 is the sensitive mode (100 MPa/kPa): 4/rev inlet distortion must stay below
    ~0.6 kPa; fast transit of 85-95k (F4 x EO21). Recorded in docs/engine/E1_gg_turbine.md section 7.
    - make_case.py: optional prism layers (off: wall functions), first-order / linearUpwind scheme switch, subsonic
    pressure-based formulati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
2026-10-23 E1 Fusion: cast-blank NGV vanes rebuilt, drawing/CAM helper scripts, rotor-unit turning setups, drawings procedure (docs/engine/E1_fusion_drawings.md)
    - cast-blanks document: 21 NGV vane bodies were broken (zero volume) after the STEP import; rebuilt from the
    machined vane trimmed by the cast rings (mass 130.5 g), materials/colours checked, saved as v3
    - fusion/GR180_E1_Drawings: drawing helpers (base views, dimensions, datums, FCF, notes table, PDF) and the
    per-drawing recipes; manual drawing creation needs a template, automatic mode hangs the API
    - fusion/GR180_E1_CAM: CAM helpers; rotor-unit turning setups R1/R2 (6 operations, 5 valid) saved in Fusion
    - docs/engine/E1_fusion_drawings.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
2026-10-23 E1: NGV passage CFD (OpenFOAM v2606) - flow capacity, exit angle, wake harmonics; forced response with CFD forcing (EO42 margin 13.7); NGV throat kept
    - make_case.py: SIMPLEC without p/rho under-relaxation (converges in 176 iterations)
    - ngv_results.json: stage flow 0.381 kg/s (-4.1 %, numerical loss Y 0.38 vs 0.07), exit angle 59.10 deg, EO21/42/63 harmonics
    - forced_response.json: EO42 x F8 dp 1.28 kPa -> 4.7 MPa; sector stress results committed
    - E1_gg_turbine.md section 8; geometric throat 1175 vs 1193 mm2 ideal (-1.5 %), measure flow capacity on the stand
2026-10-23 E1: cast NGV blank - shroud-bore stock only aft of the vanes (x 109.8..118.8); bore and vanes between them as cast
    The bore between the vanes cannot be turned (Fusion CAM finding). With 0.3 mm stock there the as-cast annulus would
    stay 0.3 mm short (throat about -2.3 %) with a step at the rotor inlet. CAST_SHROUD_STOCK_U0 = 15.0 (x 109.8, 45 deg ramp).
    - final part unchanged and fully inside the blank; cast vane = final vane (boolean checks); blank mass 124.4 g
    - fusion/E1/E1_ngv_rings_cast.step, E1_ngv_vane_cast.step re-exported
    - manufacturing spec, drawing recipes and E1 record updated; cast NGV mass in the record corrected (127.7 -> 130.5 g, broken vane import)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
    [E1_ngv_rings_cast.step, E1_ngv_vane_cast.step]
2026-10-23 E1 Fusion: cast NGV rebuilt with the new blank (124.6 g) in both cast documents, CAM setups for the NGV ring (N1/N2) and shaft (S1/S2), report updated
    - fusion/GR180_E1_Import/e1_rebuild_cast_ngv.py: rebuilds the cast NGV component from E1_ngv_rings_cast.step
    plus the machined vane (the cast vane STEP import is broken in Fusion 2706); re-creates the purged material
    and colour; checks the mass against the code (124.4 g)
    - Fusion: GR180 E1 Turbine (cast blanks) v5 and GR180 E1 NGV cast blank v3 at 124.58 g; NGV ring (machined) v4
    with 6 valid turning toolpaths (shroud bore x 109.8..118.8 only); Shaft 42CrMo4 v2 with 10 operations (9 valid)
    - docs/engine/E1_fusion_drawings.md: document ve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
2026-10-23 Engine web viewer: export of the current engine assembly (v13A core, E1, E3, E4, E2 when built) to glTF, three.js viewer with section cut and part data
2026-10-23 Fusion: whole-engine assembly script (core v13A, E1, E2 when built, E3, E4) in a direct design, one component per subsystem
2026-10-23 Fusion engine assembly: real E2 (combustor, casing, collector, insulation, sensors), E4 offset from its interface file, rebuild-in-place and power-only view
2026-10-23 Fusion assembly: save falls back to the Default Project when activeProject is not ready
2026-10-23 Fusion assembly: x-ray view (each part its own colour, see-through shells via component opacity)
2026-10-23 Fusion assembly: variant B mode (E2-B simple-cycle combustor section, no E4)
2026-10-23 E3-B compact exhaust (variant B): 1-D collector calc - box plenum + top DN200 outlet, dp sweep, FPT penalty, insulation, heat to PMG
2026-10-23 E3-B compact exhaust (variant B): FreeCAD model - square plenum box + rect-to-round hood + DN200 PN6 outlet up, 2-half west cover, rear unit (hub bell + disc + IN625 cone), centre-line support, insul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
    [variant_b_e3b_bom.csv]
2026-10-23 Version C (compact turbo-generator, turboprop layout): compact exhaust sized for 0.9 % loss, low base frame, Fusion variant C mode, concept doc
    [variant_c_exhaust_bom.csv]
2026-10-23 Fusion x-ray: sensors rule before liner rule (liner-wall thermocouples show as sensors)
2026-10-23 Fusion assembly: version C2 mode (E2-C2, R-C2 recuperator, hot-water HX, frame extension)
2026-10-23 Fusion: shell tool to drive Fusion through its local MCP server (scripts, assembly sections, screenshots)
2026-10-23 Fusion assembly C2: skip version-C rails (C2 welded frame replaces them)
2026-10-23 Fusion: script that loads the original GR180 v12 turbojet (repo-root STEP/STL) as one coloured design
2026-10-23 Version D concept: single-shaft turbo-generator shape (v13A core + front PMG pod no wider than the casing, quill shaft, 3 struts, radial inlet screen, exhaust diffuser); Fusion MODE D
2026-10-23 Version D radial turbine stage concept: first meanline (85 kW, PR 2.64, D4 96 mm, 13 blades, 17-vane radial nozzle) + FreeCAD shape; Fusion MODE RT
2026-10-23 Version D2 full assembly concept: radial stage behind the casing (plenum from x 118), shaft extension, exhaust diffuser behind the exducer; Fusion MODE D2
2026-10-23 Version D2 research decisions: quill coupling, 10x22x6 hybrid bearings on soft SFD with oil jet, d10 journals, off-the-shelf turbo turbine wheel D4 76-80, coaxial GT filter cartridge ID 324, DN200 ex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
2026-10-23 Version D2 intake: radial-inlet plenum around the pod rear (dish flush with the v13A intake flange, R40 fillet, tube sheet FI-1 ID 324 for the coaxial GT cartridge pair), pod tail fairing, FOD guard,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
    [variant_d2_intake_exhaust_frame_bom.csv]
2026-10-23 Version D2 compact exhaust: 2theta 16 deg L100 diffuser (D74.8 -> 102.9) + 45 deg cone + DN200 SR elbow up to a PN6 flange at x 606 / z 243; centre-line slide lugs, drain, TC + 2 static taps, 50 mm j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
    [variant_d2_intake_exhaust_frame_bom.csv]
2026-10-23 Version D2 base frame: welded RHS 60x40 frame (590 x 440, axis 369 above floor) on 4 AV mounts, fixed front saddle on the intake tube sheet, sliding centre-line plenum collar + exhaust lug pads, 4 li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
    [variant_d2_intake_exhaust_frame_bom.csv]
2026-10-23 D2R turbine: meanline for a bought turbo wheel D4 78/70 11 blades (eta_ts 0.755, 0.80 with exhaust diffuser), 17-vane nozzle ring, 7-strut turbine-end support, heat shield, plenum housing, exducer sh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
2026-10-23 Fusion D2: colours for turbine and frame parts
2026-10-23 D2R rotor & bearings: continuous engine shaft (crowned AF6 nose hex, M8x1 LH clamp, compressor bore 7->10, d10 journals, clamped d16 body sleeve, d18 stub), 10x22x6 hybrid bearings in SFD cartridges 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
2026-10-23 Version D2 intake/exhaust/frame rev 2 (user feedback): compact closed intake plenum OD180 x 128 with one +y DN150 filter port (150 mm spigot, PN6 drilling, FOD disc), struts INT-115 with radial M6 (r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
    [variant_d2_intake_exhaust_frame_bom.csv]
2026-10-23 D2R turbine back on the agreed interface (20686b0 / 7bd203a): exhaust bolted flange at x 176 (bore 70.7, OD 104, 6 x M6 PCD 94), housing OD 146 with pads at y +/-79; d2_interference.py: 0 overlaps vs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
2026-10-23 Fusion D2: rotor/generator/intake replacements, skip files being rewritten
2026-10-23 D2R generator: 2-pole Sm2Co17 PMG (rotor d36 with 3 mm carbon sleeve, stator 39/88 x 80, 12 slots, 425 V / 38 A, 28 kW cont / 31 kW peak) in an Al glycol jacket, d10 through-shaft with integral d6 x 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
    [variant_d2_rotor_bom.csv]
2026-10-23 Version D2 intake/exhaust/frame rev 3: top F7 V-cell filter box (592x592x292, alu, lift-off grille lid with 4 toggle latches, EPDM seat, corner guide rails, FOD panel, drain) on a 45 deg collar into 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
    [variant_d2_intake_exhaust_frame_bom.csv]
2026-10-23 D2A fuel: natural-gas manifold for ~7 g/s (7x0.5 ring + 12 needles 2.0x0.2 into the v13A vaporiser sticks, 8 mm feed through the existing M12x1 bulkhead; dp 0.27 bar at 15 C), gas line 15x1 under the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
2026-10-23 Fusion D2: colours for filter box, pod cradle, short exhaust
2026-10-23 D2A lubrication + generator cooling: closed-loop VG32 oil for the 4 jet bearings (3 L tank on the AUX deck, submerged pressure gear pump + scavenge pump on 24 V BLDC, 10 um spin-on filter, mist separ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
2026-10-23 Fusion D2: filter box left out for now (SHOW_FILTER_BOX switch)
2026-10-23 D2A ignition, sensors, junction box: ignition transformer IGN-630 + HT lead under the core to the kept v13A plug, UV flame sensor BE-631 on a sight tube (x 40 / 210 deg), N1 by G-203 Hall (SE-001A, g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
2026-10-23 Fusion D2: auxiliaries skid hidden for now (SHOW_AUX switch)
2026-10-23 D2 generator pod buildable detail (d2g): housing cup G-200 (shell + jacket bore + integral rear bearing wall, one-clamping bores) + front cover G-202 (end bell with all front ports) + jacket G-201 re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
2026-10-23 D2 generator BOM (44 rows: every part, fastener, pin, O-ring, insert, fitting, adhesive, service; stock sizes, ISO/DIN designations, torques, non-US suppliers); generator rows removed from the rotor 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
    [variant_d2_generator_bom.csv, variant_d2_rotor_bom.csv]
2026-10-23 D2 generator detail doc (Persian, docs/variant_d/05): part simplification with stock sizes, every joint (screws/torques/Helicoils, fits, O-rings, shrink fit, sleeve, preload, G1 balance), slide-on AF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
2026-10-23 Fusion D2: detailed generator pod (POD housing, fasteners, seals) with colours
2026-10-23 Version E cycle (250 kW continuous single-shaft GT generator): real-gas moist-air / city-gas properties, design point 3.0 kg/s PR 4.0 TIT 770 C 35,000 rpm (583 Hz 2-pole, < 600 Hz drive limit), ambie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
2026-10-23 Version E preliminary sizing: compressor meanline (D2 270 mm TC-class Al impeller 9+9 backswept, 17-vane 2.5D diffuser + scroll, eta_tt 0.85 vs 0.80 in the cycle), radial turbine for a bought TC-clas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
2026-10-23 Version E CAD (FreeCAD, 57 parts, one STEP per part in cad_out/variant_e/<SUBSYSTEM>/): ROTOR (shaft with AF24 drive hex, TC-class compressor + turbine wheel envelopes, sleeve, nut, 3 hybrid 7008), C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
2026-10-23 Version E docs: Persian overview docs/variant_e/00_overview.md (numbers table, ambient tables at 770 / 250 kW / 850 C / conservative, efficiency budget to >= 10.8 %, layout, make/buy with non-US supp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
    [variant_e_bom.csv]
2026-10-23 Version E generator (EG): EM design + FEM verification
    cad/variant_e/eg_layout.py: master numbers of the self-built PMG (Sm2Co17 ring 74/106 x 272 on a 1.5 mm CuCr1Zr eddy screen,
    7 mm CFRP sleeve, rotor OD 120, 3 mm gap, 24 open slots 126/262 x 270 NO10, 2 turns/coil form-wound compacted Litz, 2 paths).
    sim/variant_e/eg_fem2d.py: 2D nonlinear FEM (gmsh, P1, Newton) with rotating magnetisation, Arkkio torque, time-harmonic eddy.
    sim/variant_e/eg_bridge.py: generator + 6-pulse diode bridge + AFE DC link time-domain model.
    sim/variant_e/eg_em.py -> eg_em.json: E_ll 624 V (100 C), L_s 98 uH (end winding 10 uH by Neumann integrals), V_dc 682-714 V
    for 250-335 kW at 100 % speed (standard 400 V AF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
2026-10-23 Version E generator: rotor retention CFRP vs Inconel 718 (eg_sleeve)
    Orthotropic multilayer shrink-fit FE (shaft / CuCr1Zr screen / segmented Sm2Co17 / sleeve) with contact, thermal and
    centrifugal loads at standstill, 100 %, 108 % trip (hot and cold) and the 120 % hot spin test. Selected: T800S-class
    hoop-wound sleeve 7 mm, 0.563 mm diametral interference: hoop 1018 MPa at 100 % hot (40 % UTS_eff), 1060 MPa spin test,
    magnet contact >= 14 MPa at the cold trip. Inconel 718 rejected (von Mises > Rp0.2 for 5-9 mm, ~7 kW eddy loss).
    Assembly: 1:500 taper press-fit, rotor chilled to -150 C, ~320 kN, sleeve axial stress 128 MPa (+/-15 deg layers).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
2026-10-23 Version E generator: cooling system + thermal network (eg_thermal)
    Dedicated glycol loop: double-start helical jacket channel 18 x 8 mm (1.74 m/s, h 7200 W/m2K, 28 kPa), supply held at 55 C
    at every ambient by a 3-way mixing valve + EC dry cooler (UA 450 W/K, split range); filtered plenum air by an EC blower
    (<= 0.05 kg/s, 3.5 kPa, <= 350 W) through end bells and air gap, speed controlled on the rotor temperature (IR + EMF
    observer, SP 85 C). 60-node LPTN (5 slices + ends), steady 0-45 C and transients: at 335 kW winding slot 82.6-83.3 C,
    end winding 97-100 C, magnets 83-84 C for 0-45 C ambient; 30->45 C ramp < 1 K; blower or pump failure ride through
    below the alarms; alarm / trip table an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
2026-10-23 Version E generator: rotordynamics, joints, mechanical layout; EM refresh
    eg_layout: re-entrant end-bell hubs (bearings inside the end-winding envelope, span 385 mm), rear bearing kept at x -400,
    quill on a 1:10 shaft taper with a central M12 pull bolt through the hollow quill, housing / jacket / caps / guard / saddles.
    eg_rotor: coupled core + detailed generator rotor (26.7 kg): no lateral mode between 14.0k and 57.2k rpm (55-108 % empty
    for 1.5-6 N/um), free-free bending 99.6k (rigid-rotor balancing), quill torsion 163 Hz, taper capacity 716 N.m, L10m >= 104 kh,
    G1 = 7.3 g mm in 2 planes. eg_joints: screws / torques, ISO 286 fits, ISO 3601 O-rings, Helicoils, jacking threads.
    eg_em refres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
2026-10-24 Version E generator: detailed CAD (60 parts), interference check 0, BOM
    cad/variant_e/eg_generator.py: housing (bores 290/286 H7 one setting), helical glycol jacket, NO10 core with 24 open slots,
    96 Litz conductors + end windings + connection ring + leads, wedges, end plates; rotor: shaft with 1:10 quill taper,
    CuCr1Zr screen, 12 laminated Sm2Co17 segments, end rings, CFRP sleeve, nuts, speed wheel, hollow quill + pull bolt,
    bearings, SFD cartridges, wave spring, shim; re-entrant end bells, caps, hood, vented guard; terminal box, blower, F9
    filter, sensors, fittings; saddles, straps, base beam; every screw, Helicoil, dowel and O-ring as a body.
    e_layout.GEN_DETAILED switch (default True) + e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
    [variant_e_generator_bom.csv]
2026-10-24 Version E generator docs: Persian design document docs/variant_e/02_generator.md
    Summary and decisions, operating points, EM design + FEM method / results, stack trade, diode bridge / DC-link window for a
    standard 400 V AFE (hot / cold / 120 C magnets, P(V), part-load speed schedule, start, 690 V option), order specs
    (laminations, magnets, CFRP sleeve, Litz, bearings), full winding spec for the rewind shop, CFRP vs Inconel 718, losses /
    efficiency / short circuit / demagnetisation, cooling system and constant-temperature control (jacket, air path, dry
    cooler, pump, 60-node network, transients, loops, alarms / trips), parts / stock / process table, joints / torques /
    Helicoils / jacking, ISO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
    [variant_e_generator_bom.csv]
2026-10-28 AURORA-1000: 1 MWe geared recuperated gas turbine concept study
    Real-gas cycle model with the site gas-pressure limit (no booster), architecture comparison
    (simple cycle, recuperated, ICR), sizing of a 2-stage centrifugal compressor and 2-stage cast axial
    turbine vs shaft speed, blade creep life, gearbox / generator / recuperator spec, cost, layout sketch.
    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
2026-10-28 AURORA-1000: decision - recuperated GT only, exhaust heat to absorption chiller / inlet chilling / hot water (75-85 % total)
    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
2026-10-28 AURORA-1000: selected CCHP configuration (~75 % total) and first meanline design (2-stage centrifugal + 2-stage axial at 15,000 rpm)
    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
2026-10-29 AURORA-1000 turbine: 2-stage blade-row aero design, CAD (cast blisks, NGVs), blade and disc FEA scripts
    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
2026-10-29 AURORA-1000 turbine rev 2: NGV1 43 vanes, tapered rotor blades, filleted discs, fold-free blade lofts
    - NGV1 47 -> 43 vanes (2x47 = EO94 crossed the R1 6th blade mode at 15,300 rpm)
    - rotor blade taper (thickness/chord and axial chord) for the uncooled creep life
    - tapered-web disc profile with large fillets (round_polygon)
    - per-segment outline resampling and evenly spaced rotor CAD sections: the loft no
    longer folds the 1 mm trailing edge through itself, so gmsh meshes the blades
    - blade FEA: static root-stress mode, engine orders for 43 NGV1 vanes
    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
2026-10-29 AURORA-1000: rotor dynamics, slotted blisk rims, turbine render, design-check sheet
    - rotor dynamics (Timoshenko FE, gyroscopic, complex coordinates): between-bearing
    layout on tilting pads + squeeze-film dampers: rigid modes 4,000 / 6,800 rpm
    (well damped), first bending 23,700 rpm (SM 50 %, API 617 needs 24 %),
    unbalance response 2.6 um vs 22 um limit; rigid pedestals put the conical mode
    at 17,350 rpm (10 % above MCS), the overhung turbine layout is softer
    - disc FEA: rim thermal-relief slots (orthotropic band), purged R1 rim
    (slot bottom <= 710 C requirement), creep life at the critical point, rim growth
    - render of the 2-stage turbine from the CAD pieces (instanced rows, cut-a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
2026-10-29 AURORA-1000: R1 blade FEA (rev 2), cyclic blisk sector model, vane-count selection tool
    - R1 blade at 15,000 rpm: root net-section 110 MPa (rev 1: 129), peak 193 MPa
    (rev 1: 415); F2 x EO33 (NGV2 potential field) margin -7.7 % -> NGV2 count
    to be changed together with R2
    - --sector: 1/Z blisk sector (disc from r 60 mm + blade, cut through the stacking
    line, blades -1/0/+1 fused first); cyclic FE with non-matching cut faces
    (element-face independent surface)
    - vane-count tool: N1 / N2 against both rotors' modes, Zweifel and aliasing limits
    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
2026-10-29 AURORA-1000 rev 3: NGV2 33 -> 47 vanes (R2 resonance), R2 blade FEA, LCF check
    - R2 blade at 15,000 rpm (rigid hub): root net section 185 MPa, peak 378 MPa
    (yield 827 MPa at 735 C); 3rd mode 8,282 Hz sat on EO33 (NGV2 wakes, +0.4 %)
    - NGV2 47 vanes with the NGV1 axial chord (26 mm): EO47 = 11,750 Hz between R1
    F2/F3 and R2 F5/F6 (margins >= 14 %), Zweifel 0.72-1.00 as before, turbine
    11 mm shorter, NGV2 ring 1.6 kg lighter; NGV throat reported at the TE span
    - blade FEA: vane counts from the design json, --post re-check without ccx,
    error on a killed frequency step
    - disc LCF (Manson universal slopes, factors 2 on strain / 20 on life)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
2026-10-29 AURORA-1000: turbine design record (docs/08 section 12), check sheet, Fusion package
    - docs/08 section 12: final rows, the eight design changes the tests forced, blade /
    disc / rotor / tip-clearance results, 26 checks all passing, manufacturing
    requirements (HIP, EDM rim slots, purge <= 710 C, SFD bearings), limitations
    - check sheet: strong (1 x NPF, 10 %) and weak (2 x NPF, 5 %) stator orders
    - Campbell plots in docs/img; vane-count scan includes 45-55 vanes
    - fusion/A1000 compact STEP pieces + AURORA1000_Import script (coloured rows) and
    the handoff step for the Mac session
    Claude-Session: https://claude.ai/code/session_01JT32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
    [A1000_N1_rings.step, A1000_N1_vane.step, A1000_N2_rings.step, A1000_N2_vane.step, A1000_R1_blade.step, A1000_R1_disc.step, A1000_R2_blade.step, A1000_R2_disc.step]
2026-10-29 Cyclic blisk model: cut faces checked inside, not only at their vertices; atomic design json
    The first cyclic runs had family 1 at 7.7 kHz (R1) / 4.75 kHz (R2) at high nodal
    diameter, above the rigid-hub flap modes (4.55 / 2.74 kHz) and beam theory
    (5.06 / 3.14 kHz), which a flexible disc cannot do: a curved blade-skin patch whose
    vertices all lie on the cut plane was taken as a cut face. With the interior check
    both planes hold one face and the periodic (matching) mesh is used.
    The design json is written via a temporary file (a reader saw an empty file).
    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
2026-10-29 AURORA-1000 rev 4 (work in progress): review fixes to the blade-row kinematics, throats, FE checks
    From the adversarial review of the rev-3 chain:
    - rotors designed for the meanline repeating-stage swirl (C_theta3 = -0.075 U, alpha1 =
    alpha3 = -8.5 deg): psi 1.25 / R 0.45 at the mean (rev 3 delivered 1.175 / 0.41);
    NGV2 inlet -8.5 deg, signed Zweifel turning
    - throat gauging with the Ainley-Mathieson deviation (rev 3: Carter, throats 5-7 %
    below the cosine rule) and NGV exit heights at the NGV TEs: NGV1 174 cm2 / M 0.75,
    NGV2 278 cm2 / M 0.81 (rev 3: 160 / ~1.0); throat Mach in the report
    - rotor TE 1.0 mm over the whole span (castability spec)
    - blade FE: 2 x N2 order on R1, 16 R2 m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
    [A1000_N1_rings.step, A1000_N1_vane.step, A1000_N2_rings.step, A1000_N2_vane.step, A1000_R1_blade.step, A1000_R1_disc.step, A1000_R2_blade.step, A1000_R2_disc.step]
2026-10-29 AURORA-1000 rev 4 (WIP): minimum creep curve, slot-free discs, R1 taper, API unbalance, CAD/mesh fixes
    - MAR-M247 Larson-Miller master curve (typical) + design minimum (0.8 x stress, -10 %
    at P >= 28.5); rev 1-3 fit did not pass its anchors (review). Design: life on the
    minimum curve >= 1e5 h at the hub rotor-relative total temperature (865 C for R1)
    - R1 blade: tau 0.24 -> 0.055, axial-chord taper 0.30: net section P/A 117.5 -> 100 MPa
    (allowable 124 MPa); FE: 94 MPa band mean, peak 188 MPa; F6 x EO94 (2 x NGV2) at
    0.8 % in the band -> NGV2 count to be re-chosen on the full cyclic ZZENF
    - discs: rim slots and the steep purge removed (rupture judged on the primary stress:
    > 5e5 h a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
2026-10-29 AURORA-1000 rev 4 (WIP): R2 blade FE, interference rules, platform TMF, check sheet 27/28
    - R2 blade (rev 4): net section 181 MPa FE / 188 P/A at the hub T0rel 723 C (allowable
    376 MPa), peak 362 MPa; 16 modes to 31.8 kHz
    - interference: weak orders (2 x NPF, wakes through two rows) against the first 6 modes,
    the dense higher modes left to forced response / tip timing; the 2nd harmonic of the
    NGV2 potential field on R1 (exp(-4 pi g/s) = 0.026) not counted
    - disc platform TMF: strain-controlled at 690-800 C, no tensile mean-stress correction
    (out-of-phase TMF ~ isothermal strain-life at T_max, Boismier & Sehitoglu 1990)
    - remaining fail: R2 x NGV1 wakes (EO43) 4.7 % < 5 % -> NGV1 44 v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
2026-10-29 Cyclic blisk: R2 nodal diameters limited to EO 1-5 and the candidate vane orders
    The R1 full-ND run (in progress) shows a coupled blade-disc family at 9.4-13 kHz for
    ND 10-17 that the rigid-hub model does not have: EO47 (NGV2) at -3.5 %, EO48 at -12 %,
    EO44 at +11 %. R2 is solved at ND 0-5, 7-8, 11-14 (orders 43-49, 86-98).
    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
2026-10-29 R1 blisk cyclic (rev 4, all 30 nodal diameters): coupled ZZENF
    Coupled family 3 at 9.4-13 kHz for ND 10-17 (absent on the rigid hub): R1 strong orders
    pass for EO 40-44, 48, 49 and fail for 45-47, 50-52; 2 x N1 passes for N1 40-42, 49.
    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
2026-10-29 AURORA-1000 rev 5 (work in progress): R2 coupled blisk ZZENF, vane-count rescan
    - R2 cyclic blisk run (rev 4 CAD, ND 0-5 / 7-8 / 11-14): no NGV2 count in 40-55
    clears R2 (families 5-7 at ND 7-18 leave no 10 % window); 29 long-chord vanes
    (cx 40.5 mm, same Zweifel and throat) pass on both rotors. a1000_turbine.py now
    sets NGV2 29 / cx 40.5; the design json, CAD and checks are not regenerated yet
    (NGV1 count pending the R2 ND 6 / 9 / 10 run).
    - a1000_blisk_cyclic.py: A1000_ND adds nodal-diameter groups and merges them into
    the saved json; --post re-scores the saved families against the current counts.
    - a1000_vane_count.py: low counts with axial-chord scaling (Kacker-Okapuu
    aspect-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
2026-10-29 AURORA-1000 rev 5 (work in progress): NGV1 39 / NGV2 29, CAD, rotor and report rebuilt
    - Vane counts from the complete coupled-blisk scan: NGV1 43 -> 39 (cx 27 mm),
    NGV2 47 -> 29 (cx 40.5 mm, same Zweifel and throats: M 0.75 / 0.81).
    Turbine 15.5 mm longer; rotor pieces only translated (masses unchanged).
    - CAD, blisk sectors, Fusion package (fusion/export_a1000_parts.py), renders,
    rotordynamics (bending mode 23,564 rpm, SM 49.6 %), blade / blisk post
    processing regenerated for the new counts.
    - R2 cyclic ND 6 / 9 / 10 added; weak orders now checked against the coupled
    modes below 1.05 x blade mode 6 (a family index skipped blade modes at low
    ND); vane-vane interaction order with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
    [A1000_N1_rings.step, A1000_N1_vane.step, A1000_N2_rings.step, A1000_N2_vane.step, A1000_R1_blade.step, A1000_R1_disc.step, A1000_R2_blade.step, A1000_R2_disc.step]
2026-10-29 AURORA-1000 rev 5 (work in progress): vane counts NGV1 48 / NGV2 24
    R2 ND3 (10 families) and R1 ND1 (14 families) showed blade-mode families
    that the "first 6 families" weak-order rule skipped at low ND: EO39 on R2 ND3
    F7 (resonance) and 2 x 29 = EO58 on R1 ND1 F9 (+0.2 %), so 39 / 29 fails.
    Weak orders are now checked against every coupled mode below 1.05 x blade
    mode 6. The rescan gives NGV1 48 (cx 22 mm) / NGV2 24 (cx 49 mm): strong
    orders 12-18 %, one weak order at the limit (R1 2 x N1 EO96 -4.9 %).
    Design json, CAD, rotor and post-processing being regenerated; the report
    tables and the check summary follow.
    Claude-Session: https:/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
2026-10-29 AURORA-1000 rev 5: NGV1 48 / NGV2 24 rebuilt, checks and design record final
    - CAD (NGV1 48 vanes cx 22 mm, NGV2 24 vanes cx 49 mm; same throats,
    M 0.75 / 0.81), blisk sectors, renders and the Fusion package regenerated
    (blisk 1 44.4 kg, blisk 2 52.5 kg, NGV1 7.2 kg, NGV2 17.1 kg).
    - Rotordynamics: rigid modes 3,964 / 6,780 rpm, first bending 23,191 rpm
    (SM 47 % vs 24 %), API unbalance 2.5 um.
    - Check sheet: 27 of 28 pass; the open item is R1 2 x NGV1 (EO96) at
    4.9 % from ND22 F6 against the 5 % weak-order rule, left to the forced
    response analysis and tip timing (rigid-hub rows shown for reference).
    - docs/08 section 12 rewritten for rev 5: geometry, review findings and
    resoluti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
    [A1000_N1_rings.step, A1000_N1_vane.step, A1000_N2_rings.step, A1000_N2_vane.step, A1000_R1_blade.step, A1000_R1_disc.step, A1000_R2_blade.step, A1000_R2_disc.step]
2026-10-30 AURORA-1000: interactive 3-D package viewer
    cad/engine/a1000_viewer_export.py builds one glTF of the whole package in the
    rotor frame: the rev 5 turbine CAD (NGV1 48, blisk 1 59, NGV2 24, blisk 2 36,
    instanced), the rotor from the rotordynamics layout, impellers from the
    meanline, and concept envelopes for casings, can combustor and scroll,
    exhaust, bearings, recuperator and ducts, gearbox, generator, lube module and
    skid. viewer/a1000/index.html shows it with group toggles, half section,
    explode, part data and the live overall size of the visible parts. The mesh
    (viewer/a1000/a1000.json) is git-ignored like viewer/engine.
    Claude-Sessi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
2026-10-30 AURORA-1000 rev 5 in Fusion: turbine checked, whole package as a coloured assembly
    - Turbine rev 5 imported locally and saved as "AURORA-1000 Turbine rev5". Fusion masses match parts.json within 0.1 %.
    - a1000_viewer_export.py: A1000_STEP=1 writes the package parts as STEP to fusion/A1000_pkg plus pkg.json, instead of
    the glTF. Without cad_out it falls back to the fusion/A1000 pieces.
    - fusion/AURORA1000_Package: one component per group and one sub-component per part. Casings are see-through.
    43 parts, 264 bodies, saved as "AURORA-1000 Package rev5".
    [Air_inlet_plenum___bellmouth.step, Base_frame__skid.step, Can_combustor__DLE.step, Combustor_to_NGV1_scroll.step, Compressor_casing.step, Compressor_turbine_drum.step, Coupling_shaft.step, Epicyclic_gearbox_10_1.step]
2026-10-30 AURORA-1000 rotor rev 1: rotor stack, joints and bearings (calculation + CAD + Fusion)
    - Bored blisks fail (disc FEA: 771-919 MPa at the bore, LCF < 1,000 starts), so the blisks stay bore-less and get short
    cast arms + flanges. 16 x M10 IN718 studs through bolted curvics join drum - R1 - R2 - rear stub.
    - The compressor stack is clamped by one M42 IN718 tie bolt (Ø28 waisted shank). Preload is 185 kN at assembly and
    128-227 kN through cold start, steady running and hot shutdown; the required clamp is 78 kN.
    - Thrust balance: a pressurised impeller-2 back-face cavity takes the net thrust from 12.5 to 4.1 kN.
    - Bearings: tilting-pad journals D100 x 45 in ISFD damper rings; the thrust bear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
2026-10-30 AURORA-1000 rotor rev 1: curvics to the impeller detail design, design record section 13
    - Compressor curvic bands now follow the impeller inducer hubs (r 60 / 80): I1 44-58 / 50-70, I2 52-72 / 55-75.
    Impeller 1 in Al 2618 still fails at the front face (232 MPa vs 183 MPa); Ti-6Al-4V passes. 32 of 33 checks pass.
    - Front stub, spacer and drum faces were updated to the new bands; the stub to thrust-housing seal clash is fixed.
    - docs/08 section 13 (Persian): blisk joint problem and fix, tie bolt, thrust balance, bearings, rotor dynamics, losses.
    - HANDOFF: how to rebuild the rotor and package designs.
2026-10-30 AURORA-1000 package: bearing housings see-through (rotor rev 1 in the Fusion package)
2026-10-30 AURORA-1000 hot section rev 1: split casing, shroud carriers, honeycomb shrouds, diaphragms, centring pins
    - The outer casing is ductile iron, split on the horizontal plane and cooled by compressor delivery air.
    - Carriers C1 and C2 (1.4828) float on 8 radial pins. The width of the cooling channel outside each carrier (30 / 35 mm)
    sets its temperature to 549 / 498 C, which gives running tip clearances of 0.46 / 0.55 mm (targets 0.45 / 0.55).
    - Transients: no pinch on a cold start (min 0.28 mm). A hot restart 15 min to 2 h after shutdown rubs up to 0.4 mm into
    the honeycomb, so the control system needs a restart inhibit in that window.
    - Casing, split bolts, pins, NGV loads and secondary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
2026-10-30 AURORA-1000 R1 forced response: EO96 closed, EO24 start-up crossing found
    - 2-D mid-span URANS of NGV1-R1-NGV2 (OpenFOAM v2606 rhoPimpleFoam, 4:5:2
    scaled-pitch sector, cyclicPeriodicAMI sliding interfaces, quasi-3-D stream
    tube): R1 blade-pressure harmonics EO24 4.9 / EO48 6.4 / EO96 2.2 kPa
    (sim/cfd/a1000_r1_forcing).
    - Projection on the traveling-wave cyclic modes (CalculiX, ND24/11/22), own
    C3D10 mass norm, piston-theory aero damping, x1.5 mistuning
    (sim/engine/a1000_r1_forced_response.py).
    - Root stress at resonance, design-point forcing, zeta 0.05/0.1/0.3 %:
    EO96 10/5.3/1.8 MPa (PASS vs Goodman/2 15.8), EO48 58/29/10 (marginal),
    EO24 644/407/165 (FAIL, start-up crossing a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
2026-10-30 AURORA-1000 compressor rev 1: ruled Ti impellers, vaned diffusers, return channel, checks, Fusion
    Detail design of both centrifugal stages (cad/engine/a1000_impeller.py):
    - Meridional hub/shroud Bezier contours; ruled (5-axis flank-milled) blades,
    13 + 13 with 40 deg backsweep. Inducer, throat and Stanitz loading checks.
    1-D slip and loss model (Wiesner, Oh et al. 1997).
    - Meanline D2 413 / 448 mm gave PR 1.87 / 1.83: it used sigma*(1 - phi tan b2),
    while Wiesner defines c_theta2 = sigma*U2 - c_m2 tan b2, and the real exit
    blockage is higher. D2 is now 426 / 476 mm, U2 334 / 374 m/s, b2 33.5 / 16.5 mm.
    Stage PR 2.012 / 1.991 at eta 0.872 / 0.854; overall to the collector
    PR 3.805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
    [A1000_C1_blade.step, A1000_C1_hub.step, A1000_C1_splitter.step, A1000_C2_blade.step, A1000_C2_hub.step, A1000_C2_splitter.step, Air_inlet_plenum___bellmouth.step, Compressor_casing.step]
2026-10-30 AURORA-1000 rotor rev 1.1: Ti impellers, front bearings forward, inlet hub fairing; rotor/hot STEPs tracked
    - a1000_rotor_stack.py reads the impeller detail design (radii, pressures, Ti-6Al-4V). The curvic check uses the actual
    material. Net thrust is 2.5 kN; 32 of 32 checks pass.
    - Journal 1 moved from x 95 to 65 and the thrust collar from 146-166 to 116-136. The rear of the thrust housing is now the
    hub fairing of the stage-1 radial inlet (INLET_HUB, x 157-201), which frees x 157-205 for the inlet bend (compressor
    section 15.11).
    - Rotor dynamics with the real impellers: criticals 3,910 / 8,110 / 21,620 rpm (mode-3 margin 37 % vs 21 %), API
    unbalance response 3.8 um.
    - .gitignore: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
    [A1000_R1_disc_with_arms__cast_MAR_M247.step, A1000_R2_disc_with_arms__cast_MAR_M247.step, HS_201_Outer_casing_upper_half__EN_GJS_400_18LT.step, HS_202_Outer_casing_lower_half__EN_GJS_400_18LT.step, HS_210_Shroud_carrier_C1__NGV1___R1__1_4828.step, HS_211_Honeycomb_shroud_R1__Hastelloy_X.step, HS_211_Shroud_backing_R1.step, HS_220_Shroud_carrier_C2__NGV2___R2__1_4828.step]
2026-10-30 AURORA-1000 compressor rev 1.1: radial inlet on the rotor hub fairing, curvic teeth on the impeller hubs
    - Stage-1 radial inlet designed against INLET_HUB of rotor rev 1.1 (read from cad/engine/a1000_rotor.py):
    - shroud wall at x 204 with an R10 bend into the inducer, entry r 260, front wall at x 157;
    - entry area 1.60x the inducer annulus; minimum 0.91 at the steep part of the fairing (r 95-130);
    - plenum round the front bearing housings in the package export.
    - Impeller hub faces carry the mating curvic teeth: same bands, opposite side and half-pitch phase of the
    stub / spacer / drum. The clash with the rotor parts drops from 1.8-4.3 cm3 to 4-9 mm3 (flank contact).
    - Fusion: "AUROR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
    [A1000_C1_hub.step, A1000_C2_hub.step, Air_inlet_plenum___bellmouth.step, Compressor_casing.step]
2026-10-30 AURORA-1000 inlet hub fairing 5 mm fuller at r 95-130 (removes the 0.91 area dip of the compressor 1.1 inlet)
    [TB_thrust_housing___inlet_hub_fairing.step]
2026-10-30 AURORA-1000 combustion system rev 1: vertical DLE can, two-branch scroll with deswirl vanes into NGV1
    Calculation (sim/engine/a1000_combustor.py, 30 of 30 checks pass):
    - Design point from the project cycle: 6.22 kg/s air at 613 C / 3.69 bar, 277 Sm3/h city gas, overall phi 0.145.
    The budget is 4.0 % total-pressure loss to NGV1; the design uses 3.90 %.
    - Chemistry with Cantera GRI-Mech 3.0 (sim/engine/a1000_combustor_chem.py, cached JSON):
    - flames, PZ/DZ reactor network, ignition delay, PSR blow-out, staged part load.
    - Premixers: 7 (pilot + 6), phi 0.477, T_ad 1873 K, 89 m/s, swirl number 0.52, dp 2.8 %. Fuel margin without a
    booster is 0.13 bar.
    - Flashback margins are >= 24 (bounda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
    [CB_301_Can_casing__1_4948.step, CB_302_Can_base_plate__1_4948.step, CB_303_Head_cover__1_4948.step, CB_310_Premixers_x7__pilot___6_mains__IN625.step, CB_320_Liner__Hastelloy_X___TBC.step, CB_321_Impingement_sleeve__Hastelloy_X.step, CB_330_Hot_gas_casing_upper_half__Haynes_230.step, CB_331_Hot_gas_casing_lower_half__Haynes_230.step]
2026-10-30 AURORA-1000 R1 EO24 start-up crossing: four fixes compared, R1-NGV2 gap +25 mm chosen
    - Start line (new sim/engine/a1000_startup.py): unloaded matching with a generic compressor map, cold recuperator,
    row-by-row turbine meanline calibrated to the design point. At 12,270 rpm: P0 2.47 bar, NGV2 q x0.57.
    - CFD variants of make_case.py (A1000_CFD_RPM / P0 / T0 / POUT / DGAP / TAG):
    - st, the start-line state: EO24 modal force 0.63 x design.
    - st_g20, +20 mm gap: EO24 x0.12, 0.107 /mm (potential theory 0.104).
    - Resonances below the band are judged at the crossing state: start-line forcing, Goodman/2 with the UTS intercept at
    20-870 C metal (67-75 MPa). EO48 now passes (57 MPa), EO96 13 M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
2026-10-30 AURORA-1000 design-point performance with the detail results: 939 kW at TIT 950 C, R1 creep caps TIT at 970 C
    New sim/engine/a1000_performance.py: the meanline cycle at the fixed meanline air flow (6.32 kg/s), with each
    detail result put in turn:
    - Compressor: PR 3.805, eta 0.812 -> 970 kW, -1.11 pt.
    - Turbine: rev 5 chords -0.5 pt and gap +25 mm -0.02 pt -> 958 kW.
    - Combustor and scroll: dP0 3.90 % -> 960 kW.
    - Bearings and seals: 28.6 kW in place of eta_mech -> 939 kW, eta_el 35.6 % (meanline 37.8 %).
    TIT for 1,000 kW is 986 C. That puts the R1 root at 899 C, where creep life is 48,000 h on the minimum curve. The 1e5 h
    limit is TIT 970 C -> 973 kW, which leaves 27 kW to find in the compr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
2026-10-30 AURORA-1000 rev 6: R1-NGV2 gap +25 mm applied in CAD, rotor spacer RT-107, checks re-run
    - Turbine: DGAP2 = 25, NGV2 and R2 25 mm aft (gap 34 / 38 / 42 mm). The annulus is
    stretched only over the open gap, so the bladed rows stay exactly rev 5.
    - Rotor: new IN718 spacer ring RT-107 (curvics on both faces), R1/R2 arms unchanged.
    R1-R2 studs 26 -> 51 mm. Bearing 2 at x 955.25.
    - Hot section: casing x 678-903, C2 carrier, new gap liners HS-222/HS-234, diaphragm.
    Exhaust diffuser, collector and recuperator ducts follow. The combustor scroll and
    NGV1 do not move.
    - CFD at the CAD gap (start line st_g25 and design point). Rev 5 forcing kept as
    forcing_rev5.json.
    - Checks:
    - turbine 29/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
    [A1000_N2_rings.step, A1000_N2_vane.step, A1000_R1_disc_with_arms__cast_MAR_M247.step, A1000_R2_blade.step, A1000_R2_disc.step, A1000_R2_disc_with_arms__cast_MAR_M247.step, CB_340_Scroll_pressure_casing_upper_half__P355NH.step, CB_341_Scroll_pressure_casing_lower_half__P355NH.step]
2026-10-30 AURORA-1000 performance re-run on the rev 6 check results
    Only backface_recirculation_pct changes: 1.37 -> 1.26 %. This comes from a1000_hot_section.json.
    Its secondary-air block was last computed before rotor rev 1.1 (acf7a7b). The rev 6 re-run now
    uses the rotor rev 1.1 thrust state. The design point is unchanged:
    - 938.7 kW and 35.62 % el at TIT 950 C
    - 973.1 kW at TIT 970 C
    - 1,000 kW at TIT 986 C
    The -0.02 pt term for the +25 mm gap was already in.
2026-10-30 AURORA-1000 rotor rev 1.3: smaller bearings, losses 28.6 -> 15.9 kW, 985 kW at the R1 creep limit
    - journals D100 x L45 -> D90 x L36 (L/D 0.4): 13.5 -> 8.7 kW, 0.34 / 0.52 MPa, film 59 / 47 um
    - thrust pads r 56-78 -> 52-68, 8 pads on the loaded (aft) side and 4 on the inactive (forward) side:
    13.1 -> 5.2 kW; 0.77 MPa / 45 um at 1.5 x thrust; reverse capacity 4.8 kN at 2 MPa
    - new failure case in the checks: impeller 2 back-face feed lost, 10.3 kN -> 2.13 MPa, 27 um (limit 3.5 MPa, 10 um)
    - collar r 82 -> 72; stub and rear-stub lands step down with the journal; shoulder behind journal 1 moved 2 mm
    clear of the pad carrier (it touched the carrier end face before)
    - rotor 202.7 -> 199.7 kg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
    [A1000_R1_disc_with_arms__cast_MAR_M247.step, A1000_R2_disc_with_arms__cast_MAR_M247.step, JB1_bearing_cartridge_housing.step, JB1_integral_S_spring_damper_ring__ISFD__8_springs.step, JB1_pad_carrier___end_plates__split.step, JB1_tilting_pads_x5__steel___babbitt.step, JB2_bearing_cartridge_housing.step, JB2_integral_S_spring_damper_ring__ISFD__8_springs.step]
2026-10-30 AURORA-1000 Fusion: package v12 rebuilt, animation add-in (assembly sequence, spin rotor, reset)
    - "AURORA-1000 Package rev5" v12 rebuilt from fusion/A1000_pkg/pkg.json (rotor rev 1.3, rev 6 hot section
    and turbine, combustion rev 1): 82 parts, 526 bodies; rotor and bearing volumes match parts.json.
    - fusion/AURORA1000_Animate: Fusion add-in with an AURORA-1000 panel in the Design workspace. Assembly
    sequence follows the docs/08 sec. 13 build order; spin turns the rotor groups about the engine axis with
    the generator side at -1/10; reset restores every transform and light bulb exactly.
    - HANDOFF: the new section and the Fusion API lessons (start add-ins with Scripts.run, proxies for ne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
    [AURORA1000_Animate.py]
2026-10-30 AURORA-1000 HANDOFF: assembly sequence has 40 moves; all three buttons re-tested from a freshly opened package
2026-10-30 AURORA-1000 phase 1: transient axial thrust; forward 4-pad side passes, BOV DN125 needed
    New lumped transient model (sim/engine/a1000_thrust_transient.py): compressor speed lines on the
    impeller detail design, two gas volumes, row-by-row turbine table, back-face and turbine-front
    cavities with seal flows, fuel / wall / recuperator heat, shaft with gearbox + generator inertia,
    breaker and reverse-power relay. Force terms of a1000_rotor_stack.thrust() scaled to the steady
    stack (+2.46 kN at design). Cases: load rejection + trip, trip with breaker closed, surge at full
    load, start-up, normal stop, plus volume / valve / surge-depth sensitivities and bounds.
    - No case reverses the thrust; surge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
2026-10-31 AURORA-1000 phase 2: exhaust frame + collector, air manifold, recuperator ducting; computed losses, 969 kW at TIT 970 C
    - sim/engine/a1000_exhaust.py: R2 exit state, gas-path geometry, 4-strut choice (R2 EO margins: 5 and 6 struts fail),
    frame / pin / JB2 support loads and stiffness, hub buffer air, duct losses (Haaland, Crane, Idelchik, EJMA), recuperator
    core and economizer as stated vendor assumptions, thermal growth and expansion joints, volumes for the phase-1 model.
    - sim/cfd/a1000_exhaust: OpenFOAM v2506 simpleFoam k-omega SST, 360 deg, snappyHexMesh (run on the MacBook). Design loop
    A 0.537 / B 0.464 / C 0.483 (coarse); B chosen. Mesh study B: coarse 0.464, medium 0.475 (fine m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
    [EX_401_Air_manifold_casing__EN_GJS_400_18LT.step, EX_402_Frame_pins_x7__A286.step, EX_410_Exhaust_frame__4_struts__1_4848_cast.step, EX_411_Frame_heat_shield__1_4828.step, EX_412_JB2_support_ring___8_keys__1_4313.step, EX_413_Front_leaf_seal__Haynes_25.step, EX_414_Rear_leaf_seal__Haynes_25.step, EX_420_Exhaust_collector__1_4828.step]
2026-10-31 AURORA-1000 sec. 19: assembly, lubrication and piping review; split front bearing housing, 4-pad journals, JB2 from the rear, carrier keys, fuel circuits, engine piping
    - Assembly check:
    - cad/engine/a1000_assembly_check.py + a1000_assembly_seq.py move every part along its insertion path in steps and
    measure the common volume with the parts already in (FreeCAD on the MacBook), plus a static check of all pairs.
    - Old add-in order: the JB1 and thrust cartridges cannot pass the integral coupling flange and thrust collar
    (119,110 and 173,756 mm3), and the studs + nuts move hits R1 (2,042 mm3).
    - New order (62 moves): 27 of 62 moves checked so far, all without a clash; the rest foll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
    [A1000_N1_rings.step, CB_301_Can_casing__1_4948.step, CB_303_Head_cover__1_4948.step, CB_340_Scroll_pressure_casing_upper_half__P355NH.step, CB_341_Scroll_pressure_casing_lower_half__P355NH.step, CB_370_Fuel_manifolds_P___A___B1___B2__pigtails__bulkhead__1_4404.step, CB_370_Fuel_manifolds_P___A___B___lances.step, FB_1_Front_bearing_housing__upper_half__JB1___thrust__EN_GJS_400_18.step]
2026-10-31 AURORA-1000 sec. 19: front bearing housing and FB lines adapted to the phase 3 inlet (nothing at r > 130 aft of x 141)
    - FB-1 / FB-2 (cad/engine/a1000_rotor.py): drain, rear lifting boss, split lugs, vent boss and buffer-air boss moved
    forward, so nothing of FB sits at r > 130 aft of x 141 except the fairing:
    - drain 2 x DN40 at x 110, vent boss x 118, buffer boss x 125, lifting bosses (45, 0) and (118, +-60), lugs end at x 140;
    - feet with M16 slots along y and a transverse key slot; a bottom centre keyway in FB-2.
    - FB lines (cad/engine/a1000_piping.py): PL-01/02/03/05/07/09 run forward inside the plenum's dry tunnel (r 284) and
    leave at the plenum front. PL-05 is now 2 x DN40 into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
    [FB_1_Front_bearing_housing__upper_half__JB1___thrust__EN_GJS_400_18.step, FB_2_Front_bearing_housing__lower_half__JB1___thrust__EN_GJS_400_18.step, PL_01_Oil_supply_header___FB_distribution_block__tube_35_x_2.step, PL_02_Oil_to_JB1__tube_15_x_1_5__orifice_3_2_mm.step, PL_03_Oil_to_TB__tube_18_x_1_5__orifice_5_4_mm.step, PL_04_Oil_to_JB2__tube_18_x_1_5__hose_at_the_top_strut.step, PL_05_FBH_drain_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]
2026-10-31 AURORA-1000 phase 3: air inlet (plenum, radial slot + 4 struts, bellmouth); computed inlet loss, 963.1 kW at TIT 970 C
    - sim/engine/a1000_inlet.py: geometry, filter house assumed (F7 + F9, inlet-air cooler, silencer: 600 / 815 / 1030 Pa
    clean / mid-life / change-out), strut count vs impeller-1 families (4 struts, EO4 / EO8 clear), FB support stiffness
    20 x ISFD, eye state; reads the CFD and writes fea/a1000_inlet.json
    - sim/cfd/a1000_inlet: steady RANS (OpenFOAM v2506, vast NP 32), full 360 deg plenum + slot + struts + bend + eye.
    Design A zeta_eye 0.104 / 0.080 / 0.071 (GCI 10 %) (1.06 / 2.25 / 4.81 M cells). Loop: bottom splitter (B) and a turning ring in
    the bend (C) were worse. W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
    [IN_501_Inlet_casing__upper_half__EN_GJS_400_18.step, IN_502_Inlet_casing__lower_half___FB_2_foot_brackets__EN_GJS_400_18.step, IN_510_Plenum_box__upper_half___filter_house_flange__S235JR.step, IN_511_Plenum_box__lower_half___feet__S235JR.step, IN_520_Filter_house_adapter___fabric_joint.step]
2026-10-31 AURORA-1000 phase 3: IN-502 bracket pads get the transverse key slots of the FB-2 feet
    - cad/engine/a1000_inlet.py: a 16 x 6 key slot across each FB-2 foot pad at x 87-103, matching the slot under the
    FB-2 feet (sec. 19, a709525): loose key, axial location; the feet still slide in y
    - the bottom centre key of FB-2 (lateral location) gets no holder yet: the DN40 drain bosses and the buffer-air line
    block a bracket from the hub wall; left to phases 7 / 8 (docs/08 sec. 20.3, 20.11)
    - interference check unchanged: only the compressor-casing placeholder (phase 7) and a 5 mm3 contact with PL-05
    [IN_502_Inlet_casing__lower_half___FB_2_foot_brackets__EN_GJS_400_18.step]
2026-10-31 AURORA-1000 sec. 19: full 80-move assembly sweep and static check on vast; FB-2 STEP fixed, pipes rerouted for the phase 3 inlet
    - a1000_rotor.py: the FB-2 oil gallery runs 2 mm past both feed holes (a tangent hole end left an invalid face after
    STEP export); every exported STEP is read back and checked for validity
    - a1000_piping.py: hidden overlaps that showed once FB-2 booleans worked: PL-02/03 unions outside the boss face and
    clear of the IN-502 bracket, PL-07 vent over the boss (y 146, z 173), PL-09 rerouted at x -120, PL-01 header from the
    module face, PL-05 riser 3 mm off the plenum front plate
    - a1000_assembly_check.py: tunnel (T/O) and box (B/N) part splits for spools, radial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
    [FB_2_Front_bearing_housing__lower_half__JB1___thrust__EN_GJS_400_18.step, PL_01_Oil_supply_header___FB_distribution_block__tube_35_x_2.step, PL_02_Oil_to_JB1__tube_15_x_1_5__orifice_3_2_mm.step, PL_03_Oil_to_TB__tube_18_x_1_5__orifice_5_4_mm.step, PL_05_FBH_drain_2_x_DN40___DN65__forward_through_the_tunnel_to_the_reservoir.step, PL_07_FBH_vent_DN25__forward_through_the_tunnel__to_the_reservoir.st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]
2026-10-31 AURORA-1000 phase 3: plenum tunnel flange ring r 253 clears the PL-05 drain branches; inlet check clean after b697b4f
    - re-ran the inlet interference check against the fixed FB-2 STEP and the rerouted sec. 19 pipes (b697b4f): FB-1 / FB-2 0
    - the remaining 5 mm3 IN-511 / PL-05 contact was not at the plenum front plate but at x 83-88, z -250: the DN40 drain
    branches graze the inner edge of the box tunnel flange ring (r 250); the box ring now starts at r 253 (3 mm clear), the
    casing tunnel ring stays at r 250
    - IN-510 84.2 kg, IN-511 108.3 kg; only the compressor-casing placeholder (phase 7) still overlaps the inlet parts
    - docs/08 sec. 20.2, 20.9, 20.10, 20.11 updated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
    [IN_510_Plenum_box__upper_half___filter_house_flange__S235JR.step, IN_511_Plenum_box__lower_half___feet__S235JR.step]
2026-10-31 AURORA-1000 phase 5: rotor transient thermal-structural analysis; tie-bolt and stud preload histories, joint margins, disc LCF; R1-R2 studs and spacer in Waspaloy, TBC on the R1 platform, start / sto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
    - sim/engine/a1000_tiebolt_thermal.py: axisymmetric CalculiX transient heat model of the whole rotor (CAX6, 64k nodes,
    curvic bands as orthotropic layers, tie bolt as its own body, closed cavities as equivalent gas, 47 boundary zones
    driven by the phase 1 histories, cavity air from an energy balance). Spring preload model checked against the full FE
    stress model at 100 critical states (within 5 %). Phase 4 interface stiffnesses are read per joint from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
2026-10-31 AURORA-1000 phase 5: stress stage with all 7 phase 4 interface stiffnesses; sec. 22 records the phase 4 3D R1-R2 joint result
    - Re-ran the phase 5 stress stage with sim/engine/fea/a1000_joint_fea.json, now complete with R1_R2 and R2_stub.
    - The change is small: blisk LCF with the start / stop rule is R1 2,820 and R2 1,500 standard starts; the tie bolt
    stays at 116-230 kN; the clamp margins are unchanged.
    - Checks: phase 5 has 22 of 26; the rotor stack has 63 of 67. The four fails are still the blisk LCF checks.
    - docs/08 sec. 22.16: phase 4's 3D sector shows that the R1-R2 joint fails in stress at the interstage temperature
    (tooth root and stud bending); the Waspaloy change only co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
2026-10-31 AURORA-1000 phase 4: 3D FEA of the rotor joints and the ISFD rings; new ISFD (4 hairpin springs + 4 damper pads), stub - I1 curvic band r 35-47; R1-R2 fails at the interstage temperature
    - sim/engine/a1000_joint_fea.py: frictional 3D cyclic sectors (CalculiX, C3D10) of all 7 curvic interfaces, with the
    studs, built in the unrolled space so the mating flanks coincide. Cases: assembly, 15k, 18k, short circuit 6x, and
    the critical-passage bending at the damper clearance limit + 3 g. Also 2D ISFD model, mesh studies, rotor dynamics
    with the joint springs, plots.
    - ISFD as drawn: 1.36e9 N/m (43x the rotor-dynamics value) and no film gap. Now 4 hairpin springs (t 2.56) + 4 pads
    (R89 L43 c0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
    [A1000_C1_hub.step, JB1_integral_S_spring_damper_ring__ISFD__8_springs__split____transfer_tubes.step, JB1_integral_hairpin_spring_damper_ring__ISFD__4_springs___4_pads__split____transfer_tubes.step, JB2_integral_S_spring_damper_ring__ISFD__8_springs__split____transfer_tubes.step, JB2_integral_hairpin_spring_damper_ring__ISFD__4_springs___4_pads__split____transfer_tubes.step, RT_101_Front_stub_shaf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]
2026-11-01 AURORA-1000 phase 4 redesign: blisk arms and flanges (user's choice); R1-R2 one joint, RT-107 removed
    - arms r 45-51 at the flange bore: R1 front 22 mm (drum 9 mm shorter), R1-R2 2 x 25.5 mm, R2 rear r 30-36 x 15 mm
    (rear flanges 8 mm); seal fins on the R1-R2 flange rims, interstage honeycomb r 96.6-100 (SEAL12)
    - R1-R2 Waspaloy expansion nuts (12 mm skirt); assembly steps A12-A14 (R2 parked, nuts placed, R2 pulled home)
    - 3D joint FEA on the new geometry: 109 of 110 (R1-R2 all pass, R2-stub root 2.6e4; drum-R1 R1 root 9,086 short)
    - phase 5 transient on the new geometry: R1 / R2 body 2,816 -> 6,864 / 1,505 -> 5,877 (rim now governs);
    R1-R2 clamp 1.29 -> 0.88 (no Waspaloy spacer in the g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
    [A1000_R1_disc_with_arms__cast_MAR_M247.step, A1000_R2_disc_with_arms__cast_MAR_M247.step, HS_230_Front_diaphragm__Hastelloy_X.step, HS_231_Front_seal_honeycomb.step, HS_232_Interstage_diaphragm__Hastelloy_X.step, HS_233_Interstage_seal_honeycomb.step, RT_105_Drum_IN718.step, RT_106_Rear_stub_shaft.step]
